hyeunung/FSAP/docs/concept/images/mat_coil_notches.png

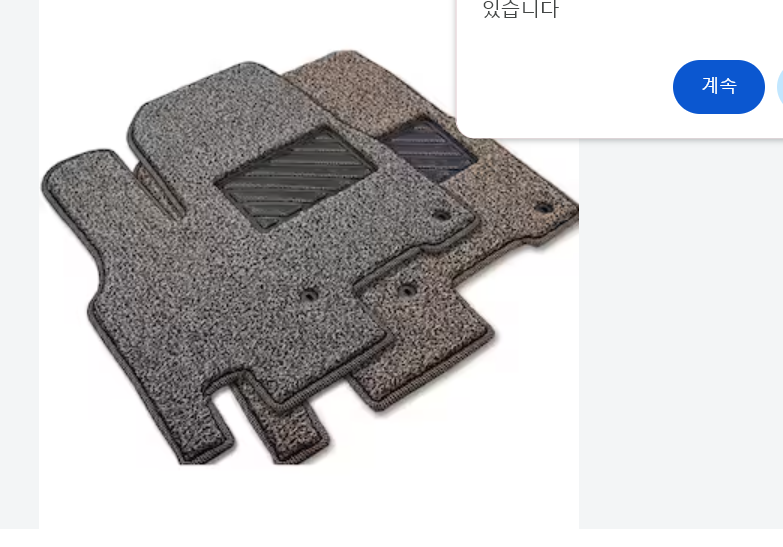
docs/concept/images/mat_coil_notches.png
