hyeunung/FSAP/docs/concept/images/mat_coil_red_pedal_slot.png

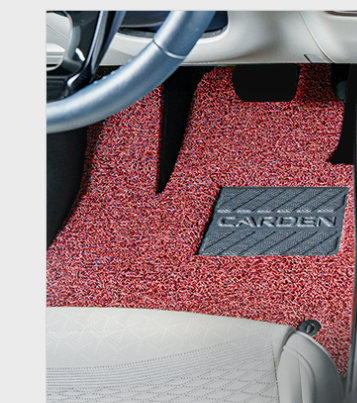
docs/concept/images/mat_coil_red_pedal_slot.png
