hyeunung/FSAP/docs/reports/queue_2026-11-06_5.md

# 과제 목록: 구동 라운드 5회차 (엔진 v3.9.3, 2026-11-06)

과제 정리부(PM). CAD는 열지 않았다(읽기만, 저장 없음). 모델·문서는 고치지 않았다.

## 읽은 것

- 요구서 5절 과제 표: 구동 M00~M08·M04R·M08R 모두 해결. 구동 후보 DC2-01~DC2-08·LITE·STEPSWAP 해결. **미해결: REG-01(구동 후보, 전체 회귀 못 본 범위), REG-02(동작 문제, 사용자 결정 대기).**
- 모델: `tools/config.json` doc = `3D_Modeling/FSAP_v2.6.5.sc`. STEP대기_ 목록은 이 문서에서 뽑은 BOM `docs/bom/FSAP_v2.6.5_purchased.csv`의 STEP대기_ 행으로 봤다(파일 열기 594 s라 이 단계에서 CAD로 다시 열지 않음. 4라운드 동안 형상 변경 0이라 BOM과 모델이 같다).
- `tools/out/step_wait.json`: waiting 6건(F39-LSGF, IR1000-01BG, MHMF022L1U2M, VRXF-PB-60-10, KC-40340, 2400.05.12PZ), login '확인 못 함'.
- runstats: 실행 14개, 가장 긴 열기 594 s(회귀). 240 s를 넘지만 지난 라운드 결과(1회차)에 LITE가 있어(v2.6.5 해결) 다시 넣지 않는다(WF-196).
- 최근 최종 보고 `docs/reports/mechanism/final_mech_2026-11-06_REG-01_3.md`, 회귀 `mech_regression_11.md`: 기준선 밖 겹침 0, 문제 0, 못 본 범위 4건.

## 과제 표

| id | 과제 | 출처 | 등급 | 직렬 | brief | 합격 기준 |
|---|---|---|---|---|---|---|
| REG-01 | 전체 회귀 못 본 범위 (U7@26 KDM10S-06_M08 F_STATES) | 구동 후보 | S | 아니오(과제 1개라 어차피 직렬) | 개념 유닛 U7 테이프(다관 커넥터 KDM10S-06_M08, U7@26) ↔ U5 대차(M03 풀리 HTPA60S5M150-A-N30). 형상 변경 없는 회귀 과제. 4라운드 동안 못 본 범위가 줄었다(2회차 F_STATES 4~34 전부 → 4회차 U7@26만). 남은 것: ① 1/128 조각 86·87·88·90 상태 0 — 한 점 > 470 s 패닉이 2라운드 이어짐(3회차 1/8 조각, 4회차 1/128로 쪼개도 같음). 네 조각에 공통인 것은 HTPA60 풀리 바디(FLANGE1·FLANGE2·HUB·SET2, mech_regression_11.md 38~42행). 같은 방법으로 다시 쪼개지 않는다(WF-123): 풀리 바디 4개를 KDM10S-06_M08과 **한 바디씩 단독**으로 근처로 좁힌 `inspect.clearance`(앱 짧은 확인 범위)로 먼저 재고, 나머지 조각은 풀리를 뺀 묶음으로 본다. ② 1/32 조각 6 상태 2~34, 조각 8 상태 1~34 ③ 가벼운 조각 상태 26~34 — 둘 다 전체 상한 때문(줄 맨 뒤). 이번 회귀는 이 범위를 줄 맨 앞에 둔다. POSE 8·9는 REG-02 사용자 결정 대기로 판정에서 뺀다 | 못 본 범위(①②③) 과제 범위 간섭 0, 못 본 범위 0(POSE 8·9 제외), 형상·부품 수 변경 0 |

STEPWAIT는 넣지 않는다: 형번이 정해진 STEP대기_(867-392342, MHMF022L1U2M, VRXF-PB-60-10, IR1000-01BG, F39-LSGF, KC-40340, 2400.05.12PZ)는 모두 step_wait.json waiting에 있고 이유가 로그인·사이트에 없음·기종 미정이다 → user_wait. 형번 미정 STEP대기_(BALL_D25, LEVELER_M8, INSERT_M3, SETSCREW·NUT·WASHER DC204, S-M5-2)는 형번 결정이 먼저라 step_wait에 세지 않는다(디테일·자료대기 D-96·D-118·D-119·D-122·D-125·D-127·D-128).

## open 표

| 항목 | 수 | 내용 |
|---|---|---|
| 열린 구동 과제 | 0 | M00~M08·M04R·M08R 해결 |
| 구동 후보 | 1 | REG-01 |
| 동작 문제 | 0 | REG-02는 사용자 결정 대기라 user_wait로 뺌 |
| 디테일 | 0 | 구동 라운드 중 0으로 둔다 |
| STEP 대기(형번 정해짐) | 0 | 남은 것은 모두 로그인·사이트에 없음 → user_wait |

## user_wait 표

| 항목 | 사용자가 줄 것 | 구동 막음 |
|---|---|---|
| D-10 재봉 헤드 기종(867-392342 STEP대기_ UPPER·NOSE·LOWER, 아랫축 서보 MHMF042L1U2M) | 견적 비교 뒤 기종 결정 + 그 기종 공식 치수·STEP | 아니오(867 PDF 임시 형상) |
| D-38 납품처 안전 기준 | 납품처 안전 기준 | 아니오 |
| REG-02 POSE 8 U7 안내 ↔ U6 캐리지 291.7 mm³ | 정의 밖 자세로 뺄지 / 높이 한 조정·틈 10 넘게 할지 결정 | 아니오(회귀 판정에서 뺌) |
| MHMF022L1U2M(×3)·MHMF042L1U2M 서보 STEP | 미스미 MSMF로 바꿀지 결정, 또는 파나소닉 CADENAS 가입(규칙 11 금지) | 아니오(임시 형상) |
| VRXF-PB-60-10 감속기 STEP | 니덱 CAD 받기(미스미에 없음) 또는 대체 형번 결정 | 아니오 |
| IR1000-01BG 레귤레이터 STEP | SMC CAD에서 받기(미스미 CAD 없음) | 아니오 |
| F39-LSGF 라이트 커튼 금구 STEP | 옴론 CAD 확인·형번 확정(미스미 미게재) | 아니오 |
| KC-40340 인장 래치 | 제조사 확인(D-121) | 아니오 |
| 2400.05.12PZ igus 끝 브래킷 | igus 형번 확정(D-115) | 아니오 |

## 로그인

구매품 CAD 사이트(미스미) 로그인: **확인 못 함**(지난 라운드 4회차 결과 login '확인 못 함', step_wait.json도 같음).
