hyeunung/FSAP/docs/reports/queue_2026-11-04_6.md

# 과제 정리: 구동 라운드 6회차 (2026-11-06)

요약
- 최신 저장본 `3D_Modeling/FSAP_v2.6.4.sc`(tools/config.json doc). CAD는 열지 않았다. 'STEP대기_' 목록은 BOM `docs/bom/FSAP_v2.6.4_purchased.csv`, `tools/out/step_wait.json`, `mech_step_wait.md`에서 읽었다.
- 요구서 5절의 구동 과제(M00~M08·M04R·M08R)는 모두 해결이다. 구동 후보 중 남은 것은 **REG-01(전체 회귀 못 본 범위)** 하나다.
- 미스미 로그인: **됨**. 사용자가 2026-11-06에 "미스미도 로그인했어 미스미 처리할거 있으면 해 또 로그인 풀리기전에"라고 했다. 그래서 로그인이 풀리기 전에 받을 미스미 표준품을 **STEPWAIT** 과제 하나로 묶어 맨 앞에 둔다.
  - 형번만 정하면 되는 것: D-96·D-118 볼, D-119·D-128 레벨러, D-127 멈춤나사·너트·와셔, D-125 M3 인서트.
  - 제조사 CAD로 다시 시도할 것: IR1000-01BG(SMC CAD), VRXF-PB-60-10(니덱).
- 순서: STEPWAIT(실물 교체) → REG-01(교체한 파일로 회귀). REG-01은 발자국이 기계 전체라 직렬이다.

## 과제 표

| id | 과제 | 출처 | 등급 | 내용·근거 | 합격 기준 |
|---|---|---|---|---|---|
| STEPWAIT | 미스미 표준품 형번 정하기·STEP 받기·실물 교체 | STEP 대기(사용자 2026-11-06 요청) | M | 미스미가 로그인돼 있는 동안 받는다. ① D-96·D-118 볼 827개(`STEP대기_BALL_D25_M04`): 1안 미스미 볼롤러 압입형, 정격 ≥ 203 N, Ø25.4, 꼭대기 Z 0. ② 레벨러: D-119 `STEP대기_LEVELER_M8_M04` ×36, D-128 `STEP대기_LEVELER_M8_M07` ×15(M8 Ø40, 같은 형번이면 함께). ③ D-127 `STEP대기_SETSCREW_M4x25_DC204_1·2`·`NUT_M4_DC204_1·2`·`WASHER_M5_DC204_1·2`. ④ D-125 `STEP대기_INSERT_M3_M06_1·_2`. ⑤ IR1000-01BG ×3(D-132, SMC CAD), VRXF-PB-60-10 ×3(D-113, 니덱 CAD). ①~④는 미스미 표기를 찾아 자료대기·결정로그에 적는다(실행 규칙 11). ⑤는 회원가입·로그인이 필요하면 멈추고 자료대기에 남긴다. 받기 전에 PartsLibrary를 먼저 본다. | 받은 형번의 STEP대기_ 0, 교체 뒤 과제 범위 새 겹침 0, 볼 꼭대기 Z 0 ± 0.1 유지, 볼 정격 ≥ 203 N |
| REG-01 | 전체 회귀 못 본 범위 이어 보기 | 구동 후보 | S | v2.6.3~v2.6.4 누계 겹침 0(mech_REG-01_model.md 4절, mech_regression_6.md 4절). 남은 범위: CYCLE_S 363~450(88), CYCLE_G1 0~514, CYCLE_G2 0~630, POSE 8~182, F_STATES 0~34. 자세는 세션을 따로 둔다(WF-183). STEPWAIT에서 바뀐 바디 둘레도 본다. | 못 본 범위 기준선 밖 겹침 0, truncated 0, 행정 막힘 0 |

## open 표

| 항목 | 수 | 내용 |
|---|---|---|
| 열린 구동 과제 | 0 | 5절 구동 행 모두 해결 |
| 구동 후보 | 1 | REG-01 |
| 회귀 동작 문제 | 0 | 본 범위 겹침 0. 못 본 범위는 REG-01이 본다 |
| 디테일 | 0 | 구동 라운드 중에는 세지 않는다 |
| 형번이 정해졌는데 STEP대기_ | 2 | IR1000-01BG ×3(미스미 CAD 없음, SMC CAD를 아직 안 봄), VRXF-PB-60-10 ×3(니덱 CAD를 아직 안 봄). STEPWAIT ⑤에서 다시 시도한다 |

- 형번이 아직 안 정해진 STEP대기_는 step_wait에 세지 않았다(STEPWAIT ①~④에서 정한다). 볼 D-96, 레벨러, DC2-04 체결품, M3 인서트, 2400.05.12PZ(임시), KC-40340, S-M5-2, F39-LSGF(기억값)가 여기에 든다.

## user_wait 표

| 항목 | 사용자가 줄 것 | 구동을 막나 |
|---|---|---|
| 재봉 헤드 기종 D-10·D-109 (`STEP대기_867-392342_UPPER·_NOSE·_LOWER`) | 견적 비교 뒤 기종 결정 + 그 기종 공식 치수·STEP | 아니오(867 임시 형상으로 진행) |
| 서보 MHMF022L1U2M ×3 (D-112·D-115) | 파나소닉 CADENAS 개인정보 입력·STEP 받기(사용자가 직접) | 아니오(□60×L80 임시) |
| 납품처 안전 기준 D-38 | 안전 거리·정지 시간 기준 | 아니오(ISO 13855 참고 임시) |
| 특허 KR102139457B1 D-102 | 변리사 확인 여부 결정 | 아니오 |

## 워크플로우 메모
- 계산된 지시는 STEPWAIT를 "형번이 정해졌고 step_wait.json waiting에 없는 STEP대기_"가 있을 때만 넣으라고 한다. 그런데 남은 STEP대기_는 모두 waiting에 있거나 형번 미정이다. 사용자 요청("미스미 처리할거 있으면 해")에 따라 형번을 정해 받는 일도 STEPWAIT에 넣었다. waiting의 not_found(미스미에 CAD 없음)가 제조사 CAD를 시도했는지와 구분되지 않아, 다시 시도할 기회가 사라진다.
