hyeunung/FSAP/docs/reports/queue_2026-11-04_2.md

# 과제 정리 — 구동 라운드 2회차 (2026-11-05)

기준 문서 `3D_Modeling/FSAP_v2.5.5.sc`(tools/config.json doc). STEP대기_ 목록은 CLI `assembly.bom`(읽기만, `tools/out/queue2/bom_out.json`)으로 뽑았다.
미스미 로그인: **됨**(사용자 2026-11-05 "미스미도 로그인했어" — 브라우저로는 아직 확인 안 함, 라운드 시작 구매부가 머리 확인). 지난 라운드 최종 확인은 풀림(2026-11-05 07:00).

## 과제 표

| id | 과제 | 출처 | 등급 | 유닛 | 합격 기준 | 직렬 |
|---|---|---|---|---|---|---|
| STEPWAIT | STEP대기_ 실물 교체 + 남은 형번 받기 | STEP 대기 | M | U1~U8 여기저기 | 받은 STEP 13형번 STEP대기_ 0, 못 받은 것 자료대기 이유, 과제 범위 간섭 0 | 라운드 시작 단계 |
| DC2-07 | U8 밸브 묶음 실물 포트 방향 (SS5Y3-20-06 + SY3120-5LZD-M5 ×6) | 구동 후보 | M | U8 | 실물 STEP 넣고 피팅·관·볼트 과제 범위 간섭 0, 피팅 서로 겹침 0, 관 11줄 + TU0805 3줄 끝이 실물 포트에 | 아니오 |
| REG-01 | 전체 회귀 못 본 범위 | 구동 후보 | S | 전체(검사만) | 못 본 범위(STATES 24-34, 연속 연구, POSE 0-182, 체결·관·둘레 바디) 간섭 0, 상한 30분 묶음 나눔 | 예 |

STEPWAIT 대상(STEP 이미 있음 — `purchased-step/`·PartsLibrary): 6200ZZ, CB3-10, CB4-12, CB4-20(M08 밸브 묶음 볼트 — DC2-07에서 같이), CB6-20, HFS8-80160-1090, HTPA60S5M150-A-N16, KDM10-06, KQ2L08-01AS, LR6-302WJBW-RYG, MGPM25-40Z, MSTH6-20, FHS-M5-10 → SFB5-10(D-117). SS5Y3-20-06·SY3120-5LZD-M5는 DC2-07이 바꾼다.
STEPWAIT 받기 시도(미스미 로그인 됨, 제조사 CAD 허용): IR1000-01BG(SMC), F3SG-4RA1520-14(옴론), HTBNS5M150-3960, KC-40340, S-M5-2, VRXF-PB-60-10(감속기 제조사), 2400.05.12PZ(igus), 형재 마감캡·HFS8-80160-1482·HFC8-80160-B.

## open 표

| 항목 | 수 | 내용 |
|---|---|---|
| 구동 과제 | 0 | M00~M08·M04R 모두 해결 |
| 구동 후보 | 2 | DC2-07, REG-01 |
| 회귀 동작 문제 | 0 | 지난 전체 회귀 문제 0(본 범위 일부 — REG-01) |
| 디테일 | 0 | 구동 라운드 중이라 0으로 둠(실제 남은 디테일 18건은 디테일링 몫) |
| STEP대기(형번 정해짐) | 22 | 위 STEP 있음 15(SS5Y3·SY3120 포함) + 받기 시도 7 |

형번 미정이라 세지 않음: BALL_D25(D-96·D-118, 827개), LEVELER, INSERT, NUT, SETSCREW, WASHER, F3SG-BRKT.

## user_wait 표

| 항목 | 필요한 것 | 구동 막나 |
|---|---|---|
| 재봉 헤드 867-392342 임시 형상(D-10·D-109) | 기종 확정·실물 도면/STEP | 아니오(임시 형상으로 진행) |
| 서보 MHMF022L1U2M STEP | 파나소닉 CADENAS 개인정보 입력은 사용자가(또는 STEP 파일 전달) | 아니오 |
| 납품처 안전 기준 D-38 (라이트 커튼 안전 거리 D-130) | 납품처 기준 | 아니오 |
| 특허 KR102139457B1 변리사 확인 D-102 | 사용자 결정 | 아니오 |
