hyeunung/FSAP/docs/reports/mechanism/mech_RX-11_fea.md

# 구동 RX-11 해석 — U5 먼 쪽 바퀴 밑 받침 X축 자유 롤러 2줄 (C-45)

## 요약

- 판정: **불합격(동작 문제 1)**. 대상 `3D_Modeling/FSAP_v2.17.0.sc`의 임시 STEP 5개(`tools/out/mech_RX-11/stepout/`). CAD 안 씀. **FEA 못 함 — 환경 없음(자료대기 D-16)**, 전부 손계산(`fea/cases/mech_RX-11_handcalc.py` → `fea/results/mech_RX-11_handcalc.json`).
- **동작 1: 새들 `P_RX11_SADDLE` ×8이 지정 조임 3 N·m(예압 3,000 N)에서 항복한다.** 볼트가 가운데를 누르고 귀 두 곳이 받치는 3점 굽힘에서 축 홈 포켓 자리(바닥 살 + 가운데 벽 2 mm) 위쪽 압축 231 ~ 250 MPa > A5052 195 → **SF 0.78 ~ 0.84**(H34 215로도 0.86 ~ 0.93). 소성 붕괴 SF는 1.67이라 부러지지는 않지만 벽 위끝이 눌려 영구 변형한다. 설계 손계산은 귀 뿌리 단면(14 × 6, 40 MPa)만 봤다.
- 고치는 법(형상 그대로): `CB5-20_RX11` ×8 조임 토크 **0.6 N·m 지정 + 중강도 나사 고정제**(DC2-05 누름판과 같은 처리). 새들 SF 3.91 ~ 4.22(+30 % 흩어짐 0.78 N·m에서 3.01), 클램프 SF 7.7, 축 자리 내려앉음 0.059 → 0.012 mm.
- 완료 판정 ④: 롤러 처짐 **0.0051 mm**(46.54 N) · **0.0143 mm**(130 N) ≤ 0.1. 696ZZ 정적 SF **14.4 · 5.15** ≥ 3 · 2(C0r 670 N 임시 — 절반이어도 7.2 · 2.58). 만족.
- 완료 판정 ⑤: `machine.json _timing` U4+U5 키를 띠 항 없이 다시 셈 — L 4.5 s **1.228**, G2 3.0 s 1.262, G1 바닥 0.8 s 1.281, V 입구1 3.0 s **1.146**(최저), 꼭짓점 1.5 s 1.175 · 1.0 s 1.237, 입구2 1.9 s 1.148. 설계 표와 9구간 모두 같음. SF ≥ 1 만족.
- 받침 합 처짐(롤러 + 축 + 판 살) 46.54 N **0.013 ~ 0.065 mm** ≤ 0.1. 130 N은 0.037 ~ 0.181(뿌리가 돌 때 상한, 디테일 기록).
- 가로대 통과 홈: STEP 윤곽 적분으로 홈 자리 남은 단면 I 419,481 mm⁴(온 단면 723,619의 58 %), 6.46 MPa **SF 22.4**. 판 W2 긴 홈 살 SF 21.3(운전) · 7.6(오설정), E2 끝 새들 SF 8.8 · 3.15 · 손 100 N 2.34.
- 모델 바꿈 2건(E-18): 판 W2 레일 사이 = 경간 160 판 → 외팔 57 두 장, 가로대 = I 하한 1.5e5 통짜 → STEP 단면. 옛 모델 값도 4·5절에 남김.
- completion_met **false**: ④·⑤는 만족이나 ②(롤러 윗면 Z 0 ± 0.1)가 새들 항복·내려앉음(3 N·m에서 탄성만 0.059 mm)에 걸려 있다. 토크 0.6 N·m로 고치면 0.012 mm.

## 근거 규칙 (원문)

- 지시문: "부러짐·영구 변형(SF < 1.2)·동작을 망가뜨리는 처짐만 kind='동작'이고, 기준 근처 미달(SF·처짐·정밀 체인)은 kind='디테일'이다." → 새들 SF 0.78은 영구 변형이라 '동작'.
- E-18: "완료 판정에 강도 항목이 있거나 하중 경로의 단면이 바뀌면 등급 S도 FEA를 돌린다 … 손계산은 형상 가정을 그대로 믿어 응력이 몰리는 실제 이음·좁은 단면을 못 본다. 손계산의 단면은 가정하지 말고 측정 자료의 최소 단면으로 쓴다." → FEA 환경이 없어 손계산이지만 단면은 STEP 글자 파싱 값(스크립트 `assert`)으로 썼다.
- E-18: "해석 모델은 부품별 표(`<fea>/models.json`)에 고정한다 … 바꾸면 이유를 적고 옛 모델도 같은 형상으로 풀어 차이를 남긴다."
- M-09: "필요 SF — 일반 3, 오조작 하중 2", "SF가 필요치의 3배 이상 남으면 과사양 결함으로 보고". 요구서 6-1 "기본값 — M-09", 6-2 "미정 — … 납품처 기준(D-08)".
- M-06: "카탈로그 허용치를 확인하고 보고서에 수치로 적는다."
- E-02(지시문): "강도 여유·정밀 체인·새 볼트 렌치 접근·판금 규칙은 디테일로 기록만 하고 수정 회차를 쓰지 않는다."
- 실행 환경(지시문): "강도는 손계산으로 하고 해석은 '해석 못 함 — 환경 없음(자료대기 D-16)'으로 기록한다."

## 1. 대상·하중·기준

| 항목 | 값 | 출처 |
|---|---|---|
| 바퀴 누름(운전) | 46.54 N | 과제 완료 판정 ④ |
| 오설정 바닥 | 130 N | 완료 판정 ④, 결정로그 RX-07-D1 |
| 손(오조작) | 100 N | `fea/models.json` P_M04_PANEL_W2(M04R) |
| 볼트 예압 | T / (0.2 · d): 3 N·m → 3,000 N | 설계·모델 보고 '죔 3 N·m' |
| 자중 | × 3 g | 지시문 |
| 재질 항복 | A5052 195, SUS304 205, A6063-T5 145 MPa | `handcalc.py` BASE, 앞 과제와 같음 |
| 기준 | 운전 SF 3, 오조작 SF 2, 영구 변형 선 1.2, 롤러 처짐 ≤ 0.1 mm | M-09, 완료 판정 ④ |

STEP에서 읽은 단면(스크립트가 `assert`로 대조):

| 부품 | 읽은 값 |
|---|---|
| `P_RX11_SADDLE` | X 두께 14(−1845 ~ −1831), 포켓 깊이 6 × 2 · 가운데 벽 2(−1839 ~ −1837), 축 홈 Y 7.9 ~ 14.1 · R 3.1 중심 Z −9.9(바닥 Z −13.0), 몸통 \|Y\| ≤ 22.5 Z −16 ~ −2, 귀 \|Y\| ≤ 26.5 Z −8 ~ −2, 구멍 Ø5.5 + 카운터보어 Ø9.5(바닥 Z −8) |
| `P_RX11_CLAMP` | 14 × 60 × 19, 가운데 윗면 Z −16.5(높이 14.5), 기둥 \|Y\| 23.5 ~ 30, 탭 밑구멍 Ø4.2 |
| `P_M04_PANEL_W2` | t 4(Z −12 ~ −8), 홈 \|Y\| ≤ 23 · X −1847 ~ −410, 볼 구멍 Ø36 Y ±50 X 피치 100, 접시 M5 Y ±100 X 피치 300 |
| `P_M04_PANEL_E2` | 홈 X −410 ~ −317, 볼 구멍 (−350, ±50), 접시 M5 X −400 Y ±50·±150·±250 |
| `HFS8-4080-560_M04_NOTCH` | 40(X) × 80(Z −92 ~ −12) × 560, 통과 홈 \|Y\| ≤ 24 · Z −23 위 |

## 2. 롤러·베어링·축 (완료 판정 ④, 구매품 몫 M-06)

| 항목 | 식·단면 | 46.54 N | 130 N | 기준 | 판정 |
|---|---|---|---|---|---|
| 롤러 처짐 | 스틸 파이프 Ø20 / Ø12(I 6,836 mm⁴), 베어링 중심 사이 195, 롤러 하나가 다 받고 가운데 | **0.0051 mm** | **0.0143 mm** | ≤ 0.1 | 합격 |
| 롤러 굽힘 | M = F · 195 / 4 | 3.3 MPa | 9.3 MPa | — | — |
| 696ZZ 정적 SF | C0r 670 N(임시), 베어링 하나가 다 받음 | **14.4** | **5.15** | 3 · 2 | 합격 |
| 같음, C0r이 절반(335 N)이라도 | | 7.2 | 2.58 | 3 · 2 | 합격 |
| 축 Ø6 굽힘 | 팔 6.25(베어링 중심 2.5 + 틈 1.0 + 물림 5.5 / 2) | 13.7 MPa | 38.3 MPa | — | — |
| 축 ↔ 홈 Hertz | R 3 ↔ R 3.1(오목), 길이 5.5 | 41.1 MPa | 68.7 MPa | 1.67 × 195 | SF 7.9 · 4.7 |
| 수명 L10 | Cr 1,730 N(임시) | 51,364 × 10⁶ 회전 | — | — | — |

- 696ZZ 정격은 NSK 치수표 기억 값(D-200 임시)이다. 정격이 절반이어도 기준을 넘는다. 카탈로그 확인은 구매부 몫으로 남는다.
- 과사양(M-09): 베어링 SF 14.4 ≥ 9. `RORLM20`의 가장 작은 축 구멍(d 6)이라 줄일 형번이 없다 — 문제로 세지 않음.

## 3. 새들·클램프 — 볼트 예압이 만드는 3점 굽힘 (동작 문제)

힘의 길: `CB5-20` 머리가 새들 카운터보어 바닥(Y 0)을 아래로 누르고, 새들 귀(\|Y\| 23 ~ 26.5)가 판 윗면에서 받친다. 클램프는 가운데 탭이 위로 당겨지고 기둥(\|Y\| 23.5 ~ 30)이 판 밑면을 받친다. 새들은 위가 압축인 3점 굽힘이다.

새들 단면(STEP):

| 자리 | 단면 | I mm⁴ | 위끝 거리 | 소성 계수 mm³ |
|---|---|---|---|---|
| Y 0 | (14 − 5.5) × 8 + (14 − 9.5) × 6 | 1,390.7 | 8.01 | 303.6 |
| Y 7.9 포켓 안쪽 끝 | 14 × 6.1 + 벽 2 × 7.9 | 999.2 | 9.86 | 235.6 |
| Y 11 포켓 가장 깊은 곳 | 14 × 3.0 + 벽 2 × 11.0 | 960.8 | 10.09 | 176.9 |
| Y 14.1 ~ 22.5 | 14 × 14 | 3,201.3 | 7.0 | 686.0 |
| 귀 뿌리 | 14 × 6 | 252.0 | 3.0 | — |

조임 3 N·m(예압 3,000 N), 반력 자리 Y 24.75(귀 받침 가운데) / 23.5(판 홈 가장자리 쪽):

| 자리 | 위 압축 MPa | 밑 인장 MPa | SF(195) | 소성 붕괴 SF |
|---|---|---|---|---|
| Y 0 | 194.6 / 183.8 | 145.5 / 137.4 | 1.00 / 1.06 | 1.86(유리 쪽) |
| **Y 7.9 포켓 안쪽 끝** | **249.5 / 231.0** | 104.7 / 96.9 | **0.78 / 0.84** | 1.82 / 1.96 |
| Y 11 | 216.7 / 197.0 | 83.9 / 76.2 | 0.90 / 0.99 | 1.67 / 1.84 |
| Y 14.1 | 157.7 / 139.2 | 66.1 / 58.4 | 1.24 / 1.40 | — |
| 귀 뿌리 | 40.2 / 17.9 | 같음 | 4.85 / 10.9 | — |

조임 토크별(반력 Y 24.75 / 23.5):

| 토크 N·m | 예압 N | 새들 최저 SF | 클램프 SF | 축 자리(Y 11) 내려앉음 mm | 머리 좌면 MPa | X 미끄럼 SF 운전 23.6 N / 손 100 N(귀만 ~ 귀 + 기둥) | 판정 |
|---|---|---|---|---|---|---|---|
| **3.0(지정)** | 3,000 | **0.78 / 0.84** | 1.53 / 1.74 | 0.059 | 90.9 | 19.0 ~ 38.1 / 4.5 ~ 9.0 | **동작(항복)** |
| 1.0 | 1,000 | 2.34 / 2.53 | 4.60 / 5.23 | 0.020 | 30.3 | 6.4 ~ 12.7 / 1.5 ~ 3.0 | 디테일(< 3) |
| 0.78(0.6 + 30 %) | 780 | 3.01 / 3.25 | 5.89 / 6.71 | 0.015 | 23.6 | 5.0 ~ 9.9 / 1.17 ~ 2.34 | 합격 |
| **0.6(권고)** | 600 | **3.91 / 4.22** | 7.66 / 8.72 | 0.012 | 18.2 | 3.8 ~ 7.6 / 0.9 ~ 1.8 | 합격 |
| 0.42(0.6 − 30 %) | 420 | 5.58 | 10.95 / 12.46 | 0.008 | 12.7 | 2.7 ~ 5.3 / 0.63 ~ 1.26 | 합격 |

- 볼트(`handcalc.calc`, M5 12.9, 물림 11.5 = 2.3d, A5052 탭): 3 N·m에서 볼트 4.69 · 좌면 2.31 · 암나사 2.64(모두 ≥ 1). 0.6 N·m에서 23.4 · 11.6 · 13.2. 외력 인장은 없다(바퀴 누름은 귀 → 판으로 간다).
- 클램프 가운데 단면 (14 − 5) × 14.5: 3 N·m에서 111.8 ~ 127.2 MPa, SF 1.53 ~ 1.74(설계 값 127.2 MPa와 같음. 설계는 항복 215로 1.69).
- 바퀴 누름만으로 새들이 받는 값은 130 N에서 10.8 MPa, 축 자리 내려앉음 0.0026 mm다. 새들을 정하는 것은 예압이다.
- 축 자리 내려앉음은 귀 받침 대비 Y 11 자리의 굽힘 + 전단 처짐(단면을 Y로 적분)이다. 롤러 윗면이 그만큼 낮아진다(완료 판정 ②의 ± 0.1 가운데 3 N·m 0.059, 0.6 N·m 0.012).
- 필요한 죔: 새들을 X로 미는 힘은 매트가 X로 미끄러질 때 롤러 2개 몫 상한 23.6 N(μ 0.5)뿐이다. 0.6 N·m에서 버팀 90 N(귀만, μ 0.15) ~ 180 N. 손으로 롤러를 축 방향 100 N으로 밀면 귀만 셀 때 SF 0.9지만 새들은 롤러 끝 틈 1.0 · 홈 끝 틈 2.0에서 멈춘다(모델 보고 RX-11-D5).

## 4. 판 W2 긴 홈 살 · E2 끝 새들 (모델 바꿈)

모델 바꿈 이유: v2.4.0 표는 '레일 ±100 사이 맑은 경간 160 긴 판'이었다. 긴 홈(\|Y\| ≤ 23)이 그 사이를 끊어 레일 안쪽 면(Y 80)에서 나온 **외팔 57 두 장**이 됐다. 새들 귀가 그 끝(Y 24.75)에 얹힌다.

| 항목 | 식 | 46.54 N(바퀴가 새들 바로 위) | 130 N | 기준 |
|---|---|---|---|---|
| 한쪽 살 몫 | F / 2 | 23.27 N | 65 N | — |
| 살 끝 처짐, 뿌리 고정 | 무한 폭 외팔판 끝 점하중 0.168 P a² / D ÷ 살 비 0.64 / 폭 50 외팔보 | 0.017 / 0.025 mm | 0.046 / 0.071 mm | — |
| 뿌리 회전 몫 | 접시 볼트 줄(Y 100)이 잡음 / 안 잡고 먼 레일(Y 300)까지 돎 | 0.009 / 0.037 mm | 0.026 / 0.102 mm | — |
| 살 끝 처짐 범위 | | 0.017 ~ 0.062 mm | 0.046 ~ 0.173 mm | — |
| 볼 구멍 줄에 선 새들(X −1838 · −758 · −542) 덧처짐 | 살 9 × t4가 구멍 36을 건넘, 고정 ~ 단순 | 0.0006 ~ 0.0024 mm | 0.0017 ~ 0.0068 mm | — |
| 뿌리 응력 | 0.509 P ÷ 0.64 / 폭 50 보 | 6.9 / 9.6 MPa, **SF 21.3** | 19.4 / 26.9 MPa, **SF 7.6** | 3 · 2 |
| 살 9 굽힘 | P · 36 / 4 | 8.7 MPa, SF 23.5 | 24.4 MPa, SF 8.4 | 3 · 2 |

손 100 N이 홈 옆 볼(Y 50) 하나에 몰릴 때:

| 모델 | σ MPa | SF | 처짐 mm |
|---|---|---|---|
| 새(외팔판, 뿌리 모멘트 계수 0.509 — 끝 하중 값이라 불리) | 19.3 | **10.6** | 0.014(뿌리에서 30) ~ 0.049 |
| 옛(경간 160 긴 판, `mech_M04R_handcalc.json`) | 13.95 | 14.69 | 0.077 |

차이: 응력 +39 %. 옛 모델은 홈으로 끊긴 형상에 맞지 않아 새 모델로 바꾼다. SF는 기준 2의 5배다.

E2 끝 새들(X −326): 귀에서 가장 가까운 받침은 가로대 CM1 +X 면(X −380)이고, 그 길에 볼 구멍(−350, ±50)이 있다. 구멍 밖 판은 세지 않고 살 9 × t4 · 길이 42 외팔로 본 상한이다. 바퀴는 X −407.5까지만 오므로(J 1380) 이 새들 몫은 57 %다.

| 하중 | 귀 하나 N | 처짐 상한 mm | σ 상한 MPa | SF | 기준 |
|---|---|---|---|---|---|
| 운전 46.54 N × 0.57 | 13.3 | 0.036 | 23.3 | 8.8 | 3 |
| 오설정 130 N × 0.57 | 37.2 | 0.099 | 65.0 | 3.15 | 2 |
| 손 100 N 새들 바로 위 | 50 | 0.133 | 87.5 | 2.34 | 2 |

받침 합 처짐(완료 판정 ④ 참고 값):

| 하중 | 롤러 가운데 | 판 살(새들 위) | 받침 합(바퀴가 롤러 가운데 ~ 새들 위) | 기준 |
|---|---|---|---|---|
| 46.54 N | 0.0051 | 0.017 ~ 0.062 | **0.013 ~ 0.065 mm** | ≤ 0.1 |
| 130 N | 0.0143 | 0.046 ~ 0.173 | 0.037 ~ 0.181 mm | 기록 |

- 130 N 상한 0.181은 판 뿌리가 레일 위에서 자유롭게 돈다고 본 값이다. 매트 없이 내린 바퀴는 롤러에서 0.859 떠 있어(검도 실측) 이 하중이 롤러에 실리지 않는다. 디테일로 기록한다(검도 RX-11-V3와 같은 항목).

## 5. 가로대 CM1 통과 홈 `HFS8-4080-560_M04_NOTCH` (모델 바꿈)

모델 바꿈 이유: 옛 표는 단면 표를 못 봐 'I 하한 1.5e5 mm⁴ 통짜'였다. 통과 홈(\|Y\| ≤ 24, Z −23 위)이 경간 가운데 윗 플랜지를 자르므로 실제 단면이 필요하다. STEP 끝면(Y −280)과 홈 벽면(Y 24) 윤곽을 적분했다(호는 유리 B-스플라인을 풀어 꺾은선으로).

| 단면 | A mm² | 도심 Z | I mm⁴ | 확인 |
|---|---|---|---|---|
| 온 단면 | 1,115.5 | −52.00 | 723,619 | A × 560 = 624,663 ↔ 모델 부피 624,561(0.02 %) |
| 홈에서 잘린 것(Z −23 위) | 202.0 | — | — | A × 48 = 9,698 ↔ 모델 홈 부피 9,713(0.15 %) |
| 홈 자리 남은 단면(Z −92 ~ −23) | 913.4 | −59.74 | **419,481**(58 %) | Z_위 11,419 · Z_밑 13,001 mm³ |

하중: 옛 모델과 같은 보수 하중(E2 전부 + W2 1/4 질량 × 3 g 등분포 747.6 N) + 가운데 점하중 153.1 N(오설정 130 N + RX-11 부품 × 3 g). 경간 560 단순보, 가운데 M 73.77 N·m.

| 모델 | I mm⁴ | σ MPa | SF(145) | 기준 |
|---|---|---|---|---|
| 새: STEP 홈 자리 남은 단면 | 419,481 | 6.46 | **22.4** | 2 |
| 온 단면(STEP, 홈 없음) | 723,619 | 4.08 | 35.6 | 2 |
| 옛: I 하한 1.5e5 · c 40 통짜 | 150,000 | 19.67 | 7.37 | 2 |

- 운전(자중 × 3 g + 46.54 N): 5.44 MPa, SF 26.7. 처짐 상한 0.078 mm(남은 단면이 온 길이라고 볼 때).
- 판 E2 접시 볼트(X −400, Y ±50)의 T너트 자리는 홈 밖 26 mm라 T홈이 남는다.
- 과사양(M-09): SF 22는 기준의 3배를 넘지만 볼 테이블 공용 형재(HFS8-4080)라 줄이지 않는다 — 문제로 세지 않음.

## 6. 회전 시간 키·SF (완료 판정 ⑤)

식: have = μ 0.4 × (F4 40 N × d₁ 0.1 + F5 40 N × d₂) / need = 볼 구름 0.02 · Rg + 원판 끌림 0.048 + 노루발 끌림 0.096 + 바퀴 밑 롤러 구름 0.05 × 40 N × d₂ + 바퀴 밖 롤러 0.18 N × Σ\|x\| × 2줄 + (I_매트 + I_원판 0.0217 + 2 × 0.219 kg × d₂²) × 4θ / t². 띠 항 μs 0.30 × 40 N × d₂는 없다. I_매트 · Rg는 앞 과제 값(`rx11design.json`), 키는 `tools/machine.json _timing`에서 읽었다. 롤러 질량 0.322 kg · 둘레 환산 0.219 kg은 다시 셈.

| 구간(U4+U5) | 키 s | SF | 설계 SF | 롤러 구름 0.10이면 | 롤러 14개가 다 매트 밑이면 | 옛 띠 키 · SF |
|---|---|---|---|---|---|---|
| CYCLE_L 모서리 90° | 4.5 | **1.228** | 1.228 | 1.077 | 1.228 | 7.5 · 1.009 |
| CYCLE_G2 모서리 90° | 3.0 | 1.262 | 1.262 | 1.107 | 1.197 | 4.5 · 1.037 |
| CYCLE_G1 출구 9.5° | 1.2 | 1.924 | 1.924 | 1.585 | 1.664 | 1.2 · 1.044 |
| CYCLE_G1 바닥 12° | 0.8 | 1.281 | 1.281 | 1.121 | 1.160 | 1.2 · 1.047 |
| CYCLE_G1 바닥 3° | 0.6 | 1.926 | 1.926 | 1.586 | 1.666 | 0.6 |
| CYCLE_V 입구1 75° | 3.0 | **1.146** | 1.146 | 1.026 | 0.992 | 4.4 · 1.027 |
| CYCLE_V 꼭짓점 25° | 1.5 | 1.175 | 1.175 | 1.050 | 1.014 | 2.0 · 1.009 |
| CYCLE_V 꼭짓점 10° | 1.0 | 1.237 | 1.237 | 1.098 | 1.059 | 1.3 · 1.022 |
| CYCLE_V 입구2 30° | 1.9 | 1.148 | 1.148 | 1.028 | 0.994 | 2.7 · 1.015 |
| CYCLE_W 4구간(임시 키 4.1 · 4.2 · 2.8 · 1.6) | — | 1.465 · 1.458 · 1.468 · 1.451 | — | 1.264 ~ 1.277 | 1.314 ~ 1.328 | RX-12-C4 |

- 9구간 모두 SF ≥ 1, 최저 1.146(V 입구1). 설계·검도 값과 같다.
- 민감도: V 매트가 X 1.5 m 밖 롤러(중심 \|x\| 1.514 · 1.73)까지 덮는다고 보면 V 입구1 · 입구2가 0.992 · 0.994다. 바퀴 밖 롤러 항은 '롤러가 안 돌고 매트가 μ 0.5로 미끄러짐' 상한이라 실제는 이보다 작다. V 매트 닿는 거리 1.50 m는 설계 값 그대로 썼다(7절 시제품에서 롤러 구름 저항과 함께 확인할 것).

## 7. 문제 목록

| 번호 | kind | 무엇 | 어디 | 수치 | 고치는 방법 | 외부 |
|---|---|---|---|---|---|---|
| RX-11-F1 | **동작** | 지정 조임 3 N·m에서 새들이 항복(위쪽 압축) | `P_RX11_SADDLE` ×8, 축 홈 포켓 Y ±7.9 ~ 11(가운데 벽 2 mm 위끝) · Y 0 카운터보어 테 | 231 ~ 250 MPa, SF 0.78 ~ 0.84(Y 0은 1.00 ~ 1.06), 축 자리 내려앉음 0.059 mm + 영구 변형 | 형상 그대로. `CB5-20_RX11` ×8 조임 토크 **0.6 N·m 지정 + 중강도 나사 고정제**를 BOM 비고·설계검토서·조립 순서에 적는다(SF 3.91, +30 % 흩어짐 3.01). 3 N·m를 꼭 써야 하면 새들을 통짜 강(S45C)으로 바꿔도 SF 1.4 ~ 1.5라 기준 3에 못 미친다 | 아니오 |
| RX-11-F2 | 디테일 | 클램프 굽힘 SF가 3 N·m에서 기준 3 미달 | `P_RX11_CLAMP` ×8 가운데 단면 9 × 14.5 | 111.8 ~ 127.2 MPa, SF 1.53 ~ 1.74 | F1의 토크 0.6 N·m로 SF 7.7 ~ 8.7(따로 고칠 것 없음) | 아니오 |
| RX-11-F3 | 디테일 | 0.6 N·m에서 손이 롤러를 축 방향 100 N으로 밀 때 새들 X 미끄럼 버팀이 오조작 2 미달 | 새들 귀 ↔ 판 윗면 | SF 0.9(귀만) ~ 1.8(귀 + 클램프 기둥). 운전 23.6 N에는 3.8 ~ 7.6 | 기록. 밀려도 롤러 끝 틈 1.0 · 홈 끝 틈 2.0에서 멈춘다. 디테일링에서 필요하면 토크 0.78 N·m(새들 SF 3.01, 흩어짐 여유 없음) 또는 새들 위치 핀 | 아니오 |
| RX-11-F4 | 디테일 | 받침 합 처짐 130 N 상한이 0.1을 넘음(판 뿌리 회전을 다 허용한 값) | `P_M04_PANEL_W2` 긴 홈 살(외팔 57) | 46.54 N 0.013 ~ 0.065 mm(합격), 130 N 0.037 ~ 0.181 mm | 기록(검도 RX-11-V3와 같음). 해석 환경이 생기면 판 W2 살 + 새들 + 클램프 접촉 FEA로 좁힌다 | 아니오 |
| RX-11-F5 | 디테일 | 696ZZ 정격(C0r 670 · Cr 1,730 N) · 롤러 외경 공차·흔들림이 임시 값 | `STEP대기_RORLM20-6-L200` ×14 | 정격 절반이어도 SF 7.2 · 2.58 | 구매부가 카탈로그 값으로 D-200에 적는다 | 예 |
| RX-11-F6 | 디테일 | FEA 못 함 — 환경 없음. 새들 포켓 모서리 응력 집중·판 살 2차원 거동은 손계산이 못 본다 | 새들·판 W2·E2 | — | 환경(D-16)이 생기면 임시 STEP 5개로 다시 푼다 | 예 |

과사양 note(문제 아님): 696ZZ SF 14.4(줄일 형번 없음), 가로대 SF 22.4 · 판 SF 21.3(공용 형재·판 t4, 다른 기능이 정함).

## 8. 완료 판정 (해석 몫)

| 항목 | 만족 | 근거 |
|---|---|---|
| ② 롤러 윗면 Z 0 ± 0.1 | 조건부(3 N·m에서는 보장 못 함) | 모델 값은 검도 −0.0002. 조임 3 N·m에서 새들 축 자리가 탄성만 0.059 mm 내려앉고 항복분이 더해진다. 0.6 N·m에서는 0.012 mm |
| ④ 롤러 처짐·베어링 | 예 | 0.0051 · 0.0143 mm ≤ 0.1, 696ZZ SF 14.4 · 5.15 ≥ 3 · 2 |
| ⑤ 시간·SF ≥ 1 | 예 | 9구간 최저 1.146, `machine.json _timing` 값과 대조 |
| ①·③·⑥ | 검도 몫 | `mech_RX-11_verify.md` |

completion_met false(②가 F1에 걸림). 등급 M은 맞다.

## 9. 문서 담당·다음 회차에 넘길 것

- BOM 비고·설계검토서·조립 순서: `CB5-20_RX11` ×8 조임 0.6 N·m + 중강도 나사 고정제(지금 '죔 3 N·m').
- 자료대기 D-200 '쓰는 곳': 696ZZ C0r 670 · Cr 1,730 N 임시 → 정적 SF 14.4 · 5.15, 롤러 파이프 안지름 12(스틸) → 처짐 0.0051 mm. D-16: RX-11 해석 못 함 — 손계산.
- 요구서 7절: 롤러 구름 저항(바퀴 밑 0.05 임시), V 매트가 덮는 롤러 범위, 조임 0.6 N·m에서 새들 풀림.
- `fea/models.json`: `P_RX11_SADDLE` · `P_RX11_CLAMP` · `CB5-20_RX11 x8` · 롤러·축(구매품 몫) · `HFS8-4080-560_M04_NOTCH` 새 행, `P_M04_PANEL_W2` · `E2`에 `v2.17.0_RX-11` 칸, `P_DC205_STRIP` · `DISC`에 '걷어 냄' 표시(고침 스크립트 `tools/out/mech_RX-11/fea_models_patch.py`).

## 10. 시간 (E-23)

| 항목 | 값 |
|---|---|
| 통로 | 없음(CAD 안 씀, STEP 글자 파싱) |
| CAD 호출 · 파일 열기 · 브라우저 | 0 · 0 · 0 |
| 손계산 실행 | 2회(수 초) |

## 워크플로우 메모

- 설계부·모델링부·검도부 세 부서가 '새들 귀 14 × 6'과 '클램프 9 × 14.5'만 다시 셈해 같은 값을 냈다. 볼트 예압이 지나는 부품은 '예압 힘의 길을 따라 가장 약한 단면'을 설계 단계 손계산 항목으로 두면 해석부까지 오지 않고 걸린다(DC2-05 누름판과 같은 유형이 두 번째다).
- SolidCraft STEP은 호를 유리 B-스플라인으로 내보내고 `FACE_OUTER_BOUND`가 없다. 형재 단면 I를 STEP 끝면 윤곽에서 바로 적분하는 도우미(이번 스크립트의 `section_faces2`)가 엔진 도구에 있으면 'I 하한 가정'을 없앨 수 있다.
- `handcalc.py`에 3점 굽힘·단면 조합(T형) 계산이 없어 케이스 스크립트에 넣었다.
