hyeunung/FSAP/docs/reports/mechanism/mech_RX-11_model1.md

# 구동 RX-11 모델링 수정 1회차 — 새들 볼트 조임 토크 3 → 0.6 N·m (형상 그대로)

## 요약

- 지적(검증·해석 RX-11-F1, kind 동작): `CB5-20_RX11` ×8을 지정 조임 3 N·m(예압 3,000 N)로 죄면 새들 `P_RX11_SADDLE` 축 홈 포켓 위쪽 압축이 231 ~ 250 MPa로 A5052 항복 195 MPa를 넘는다(SF 0.78 ~ 0.84).
- 고친 것: **형상·위치·재질·조인트는 그대로.** 볼트 컴포넌트 `CB5-20_RX11`(8 occurrence)의 부품 속성에 조임 토크 **0.6 N·m**(예압 약 600 N) + **중강도 나사 고정제(Loctite 243 상당)**, "3 N·m·표준 토크 금지"를 적었다(description의 "(3 N.m)"를 지우고 고쳐 씀, properties 조임토크·나사고정제·근거 3개 새로).
- 저장: `3D_Modeling/FSAP_v2.17.1.sc`(v2.17.0에서 마지막 자리 +1, 수정 1회차 — E-05·WF-179). `tools/config.json` doc · `tools/machine.json` doc 바꿈. 통로 MCP(앱). v2.17.0 파일은 덮어쓰지 않음.
- 형상 변화 0 확인: 저장 전 앱에서 RX-11 새·바뀐 바디 57개 bbox·부피가 서명 표와 같음. 저장본 CLI 전수 3,224바디 ↔ 서명 표 다른 것 1(`REF_NEEDLE_AXIS_MARK` 부피 반올림 0.0004 mm³ — 앞 회차와 같은 것, 안 건드림). 조인트 587 · 링크 35 · floating 0 · 오류 0 · 경고 53(v2.17.0과 같음).
- 넘기기 전 확인(E-22, 해석부와 같은 단면·받침): 0.6 N·m에서 새들 위 압축 49.9 MPa → **SF 3.91**(기준 3), 운전 누름 46.54 N을 겹쳐도 3.63, 오설정 130 N을 겹쳐 3.21(기준 2). 3 N·m는 249.4 MPa → 0.78(지적과 같음).
- `tools/machine.json`: doc와 이력 한 줄만. 조인트·행정·상태·연구·_timing 변화 없음(changed_joints false).
- 문서 담당에게: BOM 비고·설계검토서·조립 순서의 "죔 3 N·m"를 "0.6 N·m + 중강도 나사 고정제"로(6절 문장). BOM은 `CB5-20_RX11` ×8을 **따로 행**으로 둔다(다른 CB5-20에 0.6 N·m가 번지면 안 됨, 워크플로우 메모).
- 미완: 없음. 외부 조건: STEP 대기 2종(RORLM20-6-L200 · SFJ6-213) 임시 형상 그대로. FEA 못 함 — 환경 없음(D-16), 강도는 손계산.

## 근거 규칙 (원문)

- 지시문: "문제마다 원인을 고치고(형상·위치·행정·볼트), 다른 부분은 건드리지 않는다." — 원인은 조임력(예압)이므로 볼트 조임 지정만 바꿈.
- 검증 지적 fix: "형상 그대로. CB5-20_RX11 x8 조임 토크를 0.6 N·m로 지정 + 중강도 나사 고정제(DC2-05 누름판과 같은 처리)를 BOM 비고·설계검토서·조립 순서에 적는다." — 그대로 따름. 같은 처리의 앞 사례는 결정로그 DC2-05-M3(`mech_DC2-05_model1.md`: 볼트 컴포넌트 속성에 적고 BOM 비고는 문서 단계가 옮김).
- E-05: "이미 저장·커밋된 버전 파일은 덮어쓰지 않는다 … 과제 안 수정 회차도 같은 과제의 작은 변경이므로 마지막 자리 +1 새 파일로 저장한다." — v2.17.1.
- E-02: "기능이 깨지는 수준(부러짐·영구 변형·동작 중 걸림)은 동작 문제다." — 새들 항복은 영구 변형이라 이번 회차에 고침.
- E-18: "체결(볼트 지름·길이)만 바뀐 자리는 FEA 대신 손계산 표 … 손계산의 단면은 가정하지 말고 측정 자료의 최소 단면으로 쓴다." — 해석부가 STEP에서 잰 단면(Y 7.9 포켓 끝 I 999.18 mm⁴, c 9.86)을 그대로 씀.
- E-22: "모델링부는 저장 전에 검증부·해석부와 같은 도구, 같은 하중 위치·경계조건으로 바뀐 것만 먼저 본다."
- E-17: "다음 검사는 원장과 서명이 다른 것과 그 이웃 … 만 다시 본다." — 형상 서명이 바뀐 바디 0이라 틈·동작 검사는 다시 돌리지 않음(앞 회차 결과가 그대로 유효).
- 실행 규칙 2: "모델링부는 SolidCraft MCP로 그린다 … `save {}`(덮어쓰기)는 쓰지 않는다 … 저장 전에 문서 이름을 새 버전 이름으로". 실행 규칙 19: 저장 전 조인트·스케치 표시 숨김.

## 1. 바뀐 것 (전 → 후)

| 대상 | 전(v2.17.0) | 후(v2.17.1) | 이유(문제 수치 → 결과 수치) |
|---|---|---|---|
| `CB5-20_RX11` description | "Misumi CB5-20 STEP, RX-11 saddle to clamp through panel slot (3 N.m)" | "… slot. THESE 8 ONLY (CB5-20_RX11): tightening torque 0.6 N*m (preload approx 600 N; NOT 3 N*m or standard torque - saddle yields), medium-strength threadlocker (Loctite 243 equiv.)" | 3 N·m 새들 SF 0.78 ~ 0.84 → 0.6 N·m SF 3.91 ~ 4.22 |
| `CB5-20_RX11` properties | 없음 | 조임토크 "CB5-20_RX11 ×8(RX-11 새들 볼트)만: 0.6 N·m (예압 약 600 N). 3 N·m·표준 토크 금지 — … 다른 CB5-20에는 해당 없음" · 나사고정제 "CB5-20_RX11 ×8만: 중강도 (Loctite 243 상당)" · 근거(수정 1회차 수치, `fea/results/mech_RX-11_handcalc.json`) | 풀림은 예압 대신 나사 고정제로 막음 |
| 문서 이름 · 설명 | `FSAP_v2.17.0` | `FSAP_v2.17.1` · "RX-11 mechanism fix1: CB5-20_RX11 x8 tightening torque 3 -> 0.6 N.m + medium threadlocker (saddle yield), no shape change" | 실행 규칙 2 |
| `tools/config.json` doc · `tools/machine.json` doc | v2.17.0 | v2.17.1 | E-05 |
| `tools/machine.json` 이력 | — | "2026-11-13 RX-11 수정1 v2.17.1: 형상·조인트·행정·상태·연구·_timing 변화 없음. CB5-20_RX11 ×8 조임 토크 지정 3 → 0.6 N·m …" 한 줄 | E-15 기록 |
| 형상 · 좌표 · 재질 · 조인트 · 동작 연구 · _timing | — | **바뀜 없음** | — |

- 그대로인 자리(다시 적음): 새들 `P_RX11_SADDLE` ×8 X −1838 · −1622 · −1406 · −1190 · −974 · −758 · −542 · −326(14 × 53 × 14, 부피 7,338.96 mm³), 클램프 `P_RX11_CLAMP` ×8, 볼트 `CB5-20_RX11` ×8 머리 밑 Z −8 · 끝 Z −28 · 탭 물림 11.5, 롤러 14 윗면 Z 0.000.
- 0.6 N·m 근거: 예압 F ≈ T / (K d) = 0.6 / (0.2 × 0.005) = 600 N. 볼트에는 외력 인장이 없다(바퀴 누름은 새들 귀 → 판으로 감). 볼트가 할 일은 새들 X 자리 잡기뿐이고 운전 중 X로 미는 힘 상한 23.6 N에 버팀 90 ~ 180 N(해석 보고 3절).
- 형상을 바꾸지 않은 이유: 지적의 fix가 형상 그대로이고, 재질을 S45C로 바꿔 3 N·m를 유지해도 SF 1.4 ~ 1.5로 기준 3 미달(검증 근거). 새들을 두껍게 하면 판 홈·롤러 틈·클램프까지 따라 바뀌어 더 큰 변경이다.

## 2. 통로·순서

| 항목 | 값 |
|---|---|
| 통로 | MCP(앱 --control 27878). `running` 빈 목록 확인 뒤 시작. 큰 응답은 `tools/out/mech_RX-11/model/mcp_send.py`로 받아 파일에 둠 |
| 문서 확인 | 앱에 v2.17.0이 열려 있음(path 일치), dirty false, 피처 3,687 · 오류 0 · 경고 53. 다시 열지 않음(file_opens 0 — 같은 경로 open은 디스크를 다시 읽지 않는다) |
| 원복(E-08) | 수정 회차라 하지 않음(첫 회차만). `edit.checkpoint` 68을 편집 전에 찍음 |
| 순서 | `edit.checkpoint` → `motion.play REST 0`(moved false) → `component.rename` 루트 `FSAP_v2.17.1` · `document.metadata.set` 설명 → `save {path: v2.17.1}` → 열린 문서 path = v2.17.1 확인 → config · machine doc → `component.metadata.set`(볼트 속성) → 저장 전 검사 → `motion.play REST 0` · 조인트·스케치 표시 숨김 → `save {path: v2.17.1}` → dirty false → 저장본 CLI 확인 → 서명 고침 |
| 저장을 한 번 더 함 | 속성 문구를 한 번 고쳤다: 처음 저장한 뒤 `assembly.bom`(flat)이 품번 CB5-20 22개 컴포넌트(49개)를 한 줄로 묶으며 이 컴포넌트의 properties를 그 줄에 실어 보여 주는 것을 봤다. 0.6 N·m가 다른 CB5-20 41개의 지정처럼 읽히지 않게 값 앞에 "CB5-20_RX11 ×8만"을 넣고 같은 경로로 다시 `save {path}`. 마지막 저장 뒤에는 편집하지 않음. 먼저 돌리던 저장본 CLI 확인은 멈추고 마지막 저장본으로 다시 돌림 |
| 원본 | `tools/out/mech_RX-11/model1/` — `stage_0_name.json` · `stage_1_torque.json` · `stage_9_presave.json`(보낸 명령), `r01_inspect.json` · `r02_presave.json` · `r04_final.json`(앱 결과), `savecheck_out.json` · `savecheck_summary.json`(저장본 CLI), `fix1calc.json`(손계산), `sig_parts.json` · `sig_bolts.json`(서명 조각) |

## 3. 검사 (수치)

| 검사 | 방법 | 결과 |
|---|---|---|
| 형상 변화 0(저장 전, 앱) | `measure` RX-11 새 것 52 + 판 2 + 가로대 3(따낸 것 1 · 안 건드린 두 자리 2) = 57바디(측정 65회) ↔ `tools/out/signatures.json` | bbox(0.05) · 부피(1e-4) 다른 것 **0**. 새들 7,338.9649 mm³, bbox X −1845 ~ −1831 · Y ±26.5 · Z −16 ~ −2 |
| 속성 되읽기 | `component.metadata {CB5-20_RX11}` | description · properties 3개가 1절 값과 같음, part_number CB5-20 · bom_type purchased 그대로 |
| 리지드 그룹·안 묶인 부품(E-11) | `joint.list` | joints 587 · links 35 · fixed 2 · **floating 0** · conflicts 0 · errors 0 (v2.17.0과 같음) |
| 타임라인 | `inspect_design` | 피처 3,687 · 오류 0 · 경고 53 · 정의 바디 876 (v2.17.0과 같음) |
| 숨김(E-11) | `inspect_design` bodies visible false | 98개, 이름 목록이 v2.17.0 저장 때(`model/r33_dirty.json`)와 **같음**(새로 숨기거나 켠 것 0) |
| 재질(E-09) | `matcheck.py`(`out/mach_props.json`, 재질 명령 없음) | 앞 회차와 같음: 불일치 2건은 작업 전부터 있던 `P_M02/M03_WHEEL_TREAD` 표기(Urethane_A70 ↔ '우레탄 A70'), `P_RX11_SADDLE` · `P_RX11_CLAMP`는 'BOM에 없는 부품'(BOM은 문서 담당이 v2.17.1로 씀). 새들·클램프 A5052 그대로 |
| 저장 상태 | `motion.play REST 0` → moved false, `browser.visibility` joints · sketches false | 대기 자세, 조인트·스케치 표시 숨김 |
| 저장 확인(앱) | 마지막 `save {path}` 뒤 `inspect_design` | name `FSAP_v2.17.1`, path `…/3D_Modeling/FSAP_v2.17.1.sc`, **dirty false**, 5,667,858 바이트 |
| 저장 확인(저장본 CLI) | `solidcraft-cli run model1/savecheck_probe.json --in 3D_Modeling/FSAP_v2.17.1.sc --results`(저장 안 함, 백그라운드 1,013(열기 약 909 + 계산 104) s) | ① `inspect.measure` 전수 **3,224바디** ↔ 서명 표 3,224: 없는 것 0 · 남는 것 0 · bbox(0.05)·부피(1e-4) 다른 것 1 = `REF_NEEDLE_AXIS_MARK`(부피 차 0.0004 mm³, 서명 반올림 자리 — 앞 회차 저장 확인에서도 같은 1건, 이번에 안 건드림) → **형상·위치 변화 0** ② `joint.list` joints 587 · links 35 · floating 0 · errors 0 ③ `component.metadata {CB5-20_RX11}`: 조임토크·나사고정제·근거 속성과 고친 description이 저장본에 들어 있음 ④ `document.metadata` 설명 = fix1 문구 |
| 볼트 검사(안내서 '볼트 검사') | 저장본 CLI, 프로브 Ø8.5 × 30(머리 윗면 Z −3 → Z 27, 볼트 1 · 4 · 8) | 34쌍, truncated false, unchecked 0. 기계 부품과 겹침 **0**. 겹친 9쌍은 모두 로딩 자리의 매트·테이프 모형(`MAT_L·G·V·W`, `TP_V_20a`·`TP_G_21a`)으로 앞 회차와 같음(매트를 내리면 위가 열림). 프로브 ↔ 새들 카운터보어 벽 0.5(Ø9.5 − Ø8.5). 볼트 자리·길이·방향은 그대로라 삽입 길·렌치 접근·물림 11.5(2.3d) 판정은 앞 회차 그대로 |
| 조인트 자기 점검 · 과제 범위 틈(E-15 · E-22) | 다시 돌리지 않음 | 형상 서명이 바뀐 바디 0, 조인트 변화 0 → 앞 회차 값이 그대로 유효(REST 새 것 × 주변 475쌍 겹침 0, J_U5_X 5점 × LIFT −10 트레드 ↔ 롤러 0.859, LIFT 30 40.55 — `mech_RX-11_model.md` 5절, 검도 `mech_RX-11_verify.md`) |
| 스크린샷 | 새로 찍지 않음 | 겉모양이 같아 `tools/out/mech_RX-11/shot_v2.17.0_model.png`가 그대로 유효(열어 보지 않음, E-16) |

## 4. 넘기기 전 확인 — 새들 3점 굽힘 손계산 (E-22)

해석부와 같은 모델: 볼트 예압 F가 가운데를 누르고 귀 두 곳(받침 가운데 Y ±24.75, 불리한 쪽)이 받친다. 단면은 해석부가 STEP에서 잰 Y 7.9 포켓 끝(I 999.18 mm⁴, c_위 9.86 mm). σ_위 = (F / 2) × (24.75 − 7.9) × c / I. 항복 195 MPa(A5052, 해석부와 같은 값). 바퀴 누름 항은 해석부 '새들 — 바퀴 누름 130 N만' 최대 10.8 MPa를 자리와 상관없이 더했다(불리). 원본 `tools/out/mech_RX-11/model1/fix1calc.json`.

| 조임 N·m | 예압 N | M N·mm | σ_위 MPa | SF(예압만) | SF(+ 운전 누름 46.54 N) | SF(+ 오설정 130 N) | 판정 |
|---|---|---|---|---|---|---|---|
| 3.0(앞 지정) | 3,000 | 25,275 | 249.4 | **0.78** | 0.77 | 0.75 | 항복(지적과 같음) |
| 0.78(0.6 + 30 %) | 780 | 6,572 | 64.8 | 3.01 | 2.84 | 2.58 | 흩어짐 위쪽 끝, 아래 디테일 |
| **0.6(지정)** | 600 | 5,055 | 49.9 | **3.91** | **3.63** | **3.21** | 합격(운전 기준 3 · 오설정 기준 2) |
| 0.42(0.6 − 30 %) | 420 | 3,539 | 34.9 | 5.58 | 5.03 | 4.27 | 합격 |

- 해석부 값과 대조: 0.6 N·m 최저 SF 3.91(Y 24.75 받침) ~ 4.22(Y 23.5 받침), 클램프 가운데 굽힘 25.4 MPa SF 7.66, 축 자리(Y 11) 내려앉음 0.0118 mm(완료 판정 ② ±0.1 안), 머리 좌면 18.2 MPa, 볼트 `handcalc.calc` 조임 볼트 응력 23.43 · 좌면 11.55 · 암나사 전단 13.21(`fea/results/mech_RX-11_handcalc.json` '조임 0.60 N·m'). 내 계산 3.91과 같다.
- 디테일(기록만, E-02): 토크가 +30 % 흩어지고(0.78 N·m) 운전 누름까지 겹치면 SF 2.84로 기준 3에 5 % 모자란다(항복까지는 2.8배 여유, 영구 변형 아님). 손 조임보다 흩어짐이 작은 토크 드라이버(0.6 N·m 설정)로 죄게 한다. 설계검토서 조립 순서에 '토크 드라이버' 한마디를 넣는다 → 디테일 후보 **RX-11-D(토크 흩어짐)**.
- 디테일(해석 RX-11-F3 그대로): 0.6 N·m에서 손이 롤러를 축 방향 100 N으로 밀면 새들 X 미끄럼 버팀 SF 0.9(귀만) ~ 1.8. 밀려도 롤러 끝 틈 1.0 · 홈 끝 틈 2.0에서 멈춘다. 기록만.

## 5. 서명·기록

| 항목 | 값 |
|---|---|
| 서명 고침(E-17) | 마지막 저장 뒤 `ledger.py sigpatch --project tools --parts model1/sig_parts.json --bolts model1/sig_bolts.json` → "서명 고침: 바뀜 8, 없어짐 0, 전체 3224"(볼트 8개를 저장본 측정값으로 다시 씀 — 값은 그대로). 서명 doc = `3D_Modeling/FSAP_v2.17.1.sc`, doc_hash `0d1cc33a3dfa49ed`, bolts_stale 없음. `ledger.py sigcheck` → reuse("문서·해시가 같다"). `ledger.py scope`(원장 대비) → 바뀜 0 · 새로 0 · 없어짐 0 · 이웃 0(`model1/scope_after.json`). `tools/out/bolts.json` 1,219개 중 `CB5-20_RX11` 8개 torque_Nm 0.6 |
| 바뀐 체결 | `tools/out/mech_RX-11/model1/sig_bolts.json`: `CB5-20_RX11` 8개 torque_Nm 3 → **0.6**, preload_N 600, threadlocker '중강도(Loctite 243 상당)'. 위치·축·물림 11.5는 그대로 |
| 명령 기록(E-25 재료) | `tools/out/mech_RX-11/edit.json` 7단계(이번 회차: 이름·설명 3 + 속성 1 + 저장 전 3), `edit_meta.json` {base v2.17.0, result v2.17.1}. 앞 회차 기록은 `edit_r0.json` · `edit_meta_r0.json`(v2.16.0 → v2.17.0, 131단계)로 남김 |
| 임시 STEP(해석용) | 다시 내보내지 않음 — 형상이 같아 앞 회차 파일이 그대로 유효: `tools/out/mech_RX-11/stepout/P_RX11_SADDLE.step` · `P_RX11_CLAMP.step` · `P_M04_PANEL_W2.step` · `P_M04_PANEL_E2.step` · `HFS8-4080-560_M04_NOTCH.step`. 해석부는 하중 조건만 예압 600 N(0.6 N·m)으로 |

## 6. 문서 담당·해석부에 넘길 것

- BOM(v2.17.1, 구매품): `CB5-20` RX-11 몫 8개를 **따로 행**으로(`CB5-20_RX11`), 비고 "RX-11: 새로. 이 8개만 조임 0.6 N·m + 중강도 나사 고정제(Loctite 243 상당), 3 N·m·표준 토크 금지(새들 항복). X −1838 · −1622 · −1406 · −1190 · −974 · −758 · −542 · −326, Y 0" — DC2-05 때 `CB5-12_DC205` 행과 같은 방식.
- 설계검토서 조립 순서(앞 보고 `mech_RX-11_model.md` 192행의 "죔 3 N·m"를 대신함): "판·형재 → 새들을 위에서 끼우고 밑에서 클램프를 대어 CB5-20을 **토크 드라이버 0.6 N·m + 중강도 나사 고정제**로 죔(3 N·m 금지 — 새들 항복) → 롤러에 축을 꿰어 위에서 내려놓음 → 새들 X를 맞춰 죔. 롤러 교체는 그 롤러만 위로 든다(M-02)."
- 결정로그: RX-11 수정 1회차 — 결정 "CB5-20_RX11 ×8 조임 0.6 N·m + 중강도 나사 고정제, 형상 그대로", 이유 "3 N·m에서 새들 SF 0.78 ~ 0.84(항복) → 0.6 N·m SF 3.91 ~ 4.22, 클램프 7.7, 축 자리 내려앉음 0.059 → 0.012 mm. S45C로 바꿔도 3 N·m에서 1.4 ~ 1.5", 근거 `fea/results/mech_RX-11_handcalc.json` · `tools/out/mech_RX-11/model1/fix1calc.json` · 이 보고서.
- 제어 순서 제약(U-09): 새로 없음. 앞 회차 것 그대로(U4+U5 회전 시간 키, U5는 매트 위에서만 내림 — 매트 없이 내리면 롤러 위 0.86에서 멈춤).
- 요구서 7절 기록에 더할 것: 조임 0.6 N·m + 나사 고정제에서 새들 풀림·X 밀림(진동·롤러 교체 반복 뒤).
- 못 한 것(앞 회차 그대로): STEP 대기 2종(RORLM20-6-L200 · SFJ6-213), 가격, 롤러 외경 공차·흔들림, FEA(D-16).
- 자료대기: 바뀐 것 없음(D-200 · D-97은 앞 회차 문구 그대로).

## 7. 미완·못 한 것

- 미완(unfinished): 없음.
- 외부 조건: `STEP대기_RORLM20-6-L200` ×14 · `STEP대기_SFJ6-213` ×14는 실물 STEP 미수령(임시 형상 유지, 이번 회차에 받기를 다시 시도하지 않음 — 실행 규칙 10).
- FEA 못 함 — 환경 없음(D-16). 강도는 손계산(4절).

## 8. 시간 (E-23)

| 항목 | 값 |
|---|---|
| 걸린 시간 | 약 23분(1374 s). 그 가운데 저장본 CLI 확인 기다림이 약 22분(첫 확인 약 5분은 속성 문구를 고치며 버림 + 다시 돌린 것 1,013 s). 그리기·저장은 2분 안쪽 |
| CAD 호출 | MCP 22(앱) + CLI 2 |
| 파일 열기 | 앱 0(이미 열려 있던 v2.17.0에서 이어 함) + 저장본 CLI 2(첫 것은 속성 문구를 고치며 멈춤) |
| 가장 긴 저장본 열기 | 약 909 s(저장본 CLI, 5.67 MB). 상한 240 s를 넘음 — 앞 회차 약 785 s와 같은 수준(모델 무게, E-04 WF-196. LITE는 실행 지시 (f)로 이번 실행에 넣지 않음) |
| 앱 다시 켬 | 없음 |

## 워크플로우 메모

- 수정 회차의 고칠 것이 '형상 그대로, 조임 토크 지정'일 때도 지시문은 새 번호 파일 + version_bump 'last'를 요구하고 'none'이면 위반으로 올린다. 형상이 같은 새 버전 파일(5.7 MB)과 저장본 CLI 확인 약 14분이 든다 · 근거: 이 회차(바뀐 것은 부품 속성 한 곳), DC2-05 수정 1회차도 같았다 · 검증 문제의 fix가 문서·지정만이면 모델링부 대신 문서 담당으로 보내거나(`docs_only`), 속성만 바뀐 저장은 'none'을 허용하는 갈래가 있으면 좋겠다.
- 조임 토크·나사 고정제를 담을 자리가 서명 표에 없다(체결 기록 `sig_bolts.json` torque_Nm과 부품 속성으로만 전달) · 근거: DC2-05 수정 1회차 메모와 같음(반복) · 체결 목록(`bolts.json`)의 torque_Nm을 검도·문서가 읽는 정식 칸으로 두면 좋겠다.
- `assembly.bom`(flat)은 품번으로 묶으면서 한 컴포넌트의 properties를 묶인 줄 전체에 싣는다(CB5-20 49개 줄에 RX11 8개의 조임토크가 보임) · 근거: `model1/r02_presave.json` bom · 특정 자리에만 해당하는 지정은 값 안에 대상을 적거나, BOM을 컴포넌트별로 뽑아 문서 담당이 따로 행으로 쓴다.
- MCP `batch`에 `motion.play`를 넣으면 `verbose: false`여도 조인트 값 전체(수천 줄)가 응답으로 온다 · 근거: 이 회차 첫 batch · 큰 응답이 나는 명령은 `mcp_send.py`처럼 파일로 받는 길을 안내서에 적어 두면 좋겠다.
