hyeunung/FSAP/docs/reports/mechanism/mech_RX-12_donecheck.md

# 구동 RX-12 원칙 감사 — 완료 판정 확인 (설계안 RX-12-D1)

## 요약

- 판정: **합격(ok = true)**. 완료 판정 ①~⑤ 모두 설계 단계에서 요구되는 만큼 만족한다. 고칠 자리 없음.
- 방법: CAD를 쓰지 않고 설계안의 자세 파일(`cycle_w.json` 1,169자세)·연구 키·서명(`tools/out/signatures.json`, v2.15.2)·측정부 `motion_list.json`을 감사 스크립트(`tools/out/mech_RX-12/donecheck/audit.py`, 격자 5 mm·꼭짓점 계산 — 설계자의 다각형 자르기와 다른 방법)로 다시 계산했다.
- 다시 계산한 값: X 최대 1052.1(W1 488), +X 넓이 550,000 mm²(W1 439), 볼 받침 밖 323,625(설계 323,536, 격자 오차 0.03 %, W1 425), 포켓 282,550(설계 282,556, W1 420), +X 기둥까지 104.1(W1 482), 범위 X −1646.7~1052.1 · Y ±1493.5 — 설계안과 같다.
- 매트 높이 층(Z 0~10)에서 휘두름 범위(X −1650~1055 · Y ±1495) 안에 걸치는 기계 바디(서명 REST, 작업 대상 제외)는 `TL_FEED` 하나뿐(기준선 75 mm³).
- 기존 연구 9개의 기존 키 변화 0(측정부 `motion_list.json`과 점·값 대조 차이 0), 더해진 것은 `J_WP_W_X·Y·ROT` 0 키뿐.
- 남는 것(문제 아님, 검도가 볼 것): 새 매트의 CAD 전 구간 `motion.interference`(truncated false), 볼록 모서리 앞뒤 50 mm 안의 직선 간격이 25 mm인 것(아래 ① 메모).

## 항목별 확인

| 항목 | 판정 | 다시 계산한 근거 |
|---|---|---|
| ① 새 매트 한 사이클 전 구간 과제 범위 간섭 0(간격 6-4) | 만족(설계 근거. CAD 전 구간은 모델링 뒤 검도) | 바늘 점이 땀 길(외곽 안쪽 6.5) 위를 벗어난 자세 0 / 1,169. 이웃 자세 사이 최대 이동 25.0 mm · 최대 회전 1.0°, 오목 모서리 4곳 둘레 50 mm 안에서 5 mm 넘는 걸음 0. 서명에서 Z 0~10 · 휘두름 범위에 걸치는 기계 바디 = `TL_FEED`(X −2.5~7.5 · Y −9~−1.5 · Z −1~11, machine.json baseline_overlaps에 있음) 1개뿐, +X 기둥(X 1150~1230 · Y 120~320)은 범위 밖 최소 104.1. 바늘 −30 꿰뚫음도 기준선(machine.json "U3_NEEDLE_PIN(-30)") |
| ② 뒷면이 전 구간 받침 위(아니면 넓이·자리를 후보로) | 만족(후보로 올림) | 받침(볼 중심 + 50: X −2100~400 · Y ±1500, X 400~900 · Y −200~1500) 밖 최대 323,625 mm²(W1 425), 포켓(X > 400 · Y < −300) 282,550(W1 420), X > 900 73,850 · X > 975 21,325(격자 5 mm 값, 설계 정확값 74,550 · 22,050 = 31.5 × 700과 맞음). 결정로그 RX-12-C1·C2에 좌표·넓이가 적혀 있다(4145~4146행) |
| ③ +X 최대(X 좌표·넓이)를 결정로그에 | 만족 | 결정로그 RX-12-S1(4134행): X 1052.1 · 550,000 mm²(61.1 %). 다시 계산값과 같음. 손 확인: W1 439(ROT 270)에서 매트가 X −493.5~1006.5, X > 6.5 넓이 = 1000 × 700 − 오목 500 × 300 = 550,000 |
| ④ 0-8-5 고칠 안(결과 수치 포함) | 만족(설계 단계 몫) | 보고서 7절·결정로그 RX-12-S4(4137행)에 문장과 수치(1052.1 · 550,000 · 323,536 · 282,556). 설계검토서·요구서 반영은 문서 담당 몫으로 미완에 적혀 있다 |
| ⑤ machine.json에 새 매트, 기존 연구 키 변화 0 | 만족(지시서) | 지시서 6절 7에 joints·units·studies·states·workpiece_stages·baseline. `study_others.json` 9개 연구를 `motion_list.json`과 대조: 단계 수 같음, 기존 키 점·값 차이 0, 더해진 키는 `J_WP_W_X·Y·ROT` 0뿐. `CYCLE_W1`(583)·`W2`(585) 키를 걸음마다 보간한 값과 자세 파일의 차이 최대 0.0001(X·Y·ROT·U5 LIFT·U5 X·바늘·노루발) — 회전 구간 X·Y 키가 1°마다 있어 호를 벗어나지 않는다. 키 조인트 31개 = `CYCLE_V`의 기계 조인트 28 + 새 3(다른 매트 조각 `J_TP_*`를 안 넣는 것은 `CYCLE_V`와 같은 약속) |

### 바퀴 접점(0-8-2 ③ "내리는 조건: 바퀴 밑에 매트가 있고 …")

- U4(d₁ 100, 폭 25 · Y ±3 9점): 노루발 내린 전 자세에서 매트 밖 0.
- U5(d₂ 440): `J_U5_LIFT` < 30인 866자세에서 매트 밖 0. 가장자리 여유 최소 3.5(볼록 모서리에서 Y 쪽: e 6.5 − 3, 기존 매트와 같은 값), 들기·내림 정지 자세의 여유 47.0(W1 84~85, W2 499~500) · 71.4(W1 516→517 ROT 225, W2 66→67 ROT 135). 대차가 움직이는 동안(`J_U5_X` ≠ 1360) 내린 자세 0.

### ① 메모(검도에 넘김, 수정 요구 아님)

- 요구서 6-4 "바늘 둘레 반경 50 mm 안·홈 안·모서리 회전 구간은 5 mm·1°". 설계안은 회전은 모두 1°, 오목 모서리 4곳 앞뒤 50 mm는 5 mm이지만 **볼록 모서리 4곳 앞뒤 50 mm의 직선 걸음은 약 24.5 mm**(16걸음, 예: W1 102~103, 198~199)다. 그 구간에서 매트 높이 층에 새로 들어오는 기계 바디가 없고(위 서명 확인) 기존 `CYCLE_L`·`V`와 같은 약속이라 완료 판정 미달로 보지 않았다. 검도가 CAD 전 구간 결과에서 이 구간을 따로 볼 필요는 없다.
- 이 감사는 평면 계산 + 서명(REST 자세) 확인이다. 움직이는 바디(U4·U5 바퀴, 노루발, 슈)가 매트 윗면에 닿는 값은 기존 연구와 같은 키라 기준선으로 보았고, CAD 값은 검도가 낸다.

## 워크플로우 메모

- 과제 문구의 문서 버전(v2.13.0)과 config.json doc(v2.15.2)가 다르다. 설계안·서명 모두 v2.15.2 기준이라 그대로 따랐다.
- 완료 판정 ⑤ "기존 연구 5개"는 지금 9개다(REST·MAINT·SEAM 포함). 9개 모두 대조했다.

## 파일

- `tools/out/mech_RX-12/donecheck/audit.py` · `audit.json` — 감사 계산과 결과
