hyeunung/FSAP/docs/reports/mechanism/mech_RX-06-C2_model1.md

# RX-06-C2 모델링 수정 1회차 — 카세트 관 브래킷 볼트 CB5-16 → CB5-12 (모델링부, 2026-11-13)

요약(10줄 안):
- 저장: `FSAP_v2.15.1.sc` → **`3D_Modeling/FSAP_v2.15.2.sc`**(마지막 자리 +1, 수정 1회차, 새로 생기거나 없어진 컴포넌트 0). 통로 MCP(앱). `tools/config.json` doc 고침. 저장 상태 REST step 0, 조인트·스케치 숨김, 문서 이름 FSAP_v2.15.2.
- **고친 것(검도 지적 1건):** 관 브래킷 `P_M08_TUBE_BRKT_CST_V`를 카세트 판에 무는 볼트 `CB5-16_M05_1:2 · :3`(끝 X 46~50이 고정부 `P_M05_HOLDER` +X 벽 살을 뚫음, 계산 78.5 mm³ × 2)을 지우고 같은 머리 자리에 **`CB5-12_M05_7:2 · :3`**(CB5-12 실물 STEP의 occurrence)을 놓았다.
- 새 볼트: 받침면 X 62(그대로) · Y −152.5 · Z 304 / 320, bbox X **50.0**~67.0, 부피 476.413 mm³. 끝 X 50.0 = 판 뒷면. 물림 = 판 두께 8 mm = 1.6d ≥ 1.5d(M-01).
- **HOLDER와 겹침 0**(앱 REST · J_U7_HGT 5점 · MAINT_U7 6단계, 저장본 CLI REST). HOLDER 쌍은 이제 unchecked가 아니라 계산된 맞닿음 0.0이다.
- `CB5-16_M05_1:4 · :5`(끝 X 48~50, 판 뒷면 밖 2 mm): 끝 자리에 다른 바디 없음(가장 가까운 것 관 24.4 mm) → **그대로 둠**.
- 형상 값 변화 0: 피처 3,709 그대로(피처 목록 · 컴포넌트 682 · 조인트 584 · 재질 · 숨김이 v2.15.1과 같음). 바뀐 것은 occurrence 2개 지움 + 2개 더함뿐. 타임라인 error 0 · warning 54 → 54.
- BOM: CB5-16 492 → 490(−2), CB5-12 +2(`assembly.bom` 행 77 → 79).
- 디테일 2건(기록만, E-02): 볼트 끝이 판 뒷면과 같은 면(여유 0), 위 볼트 머리 앞 접근 프로브가 관 `TU0604_M08P_U7C_FEED_A`와 66.9 mm³ 겹침(머리 자리는 앞 버전과 같음).
- 미완 없음. 예외 요청 없음. 조인트·행정·기계 정의 변화 없음.

## 0. 근거 규칙

| 규칙 | 원문 | 이번 |
|---|---|---|
| M-01 | "상대 부품의 탭 또는 너트가 실제로 있음, 물림 ≥ 1.5d" · "모델에 볼트를 꽂아만 두는 것은 결함이다" | 볼트 끝 4 mm가 탭·구멍 없는 HOLDER 벽 살에 들어가 있었다 → 길이를 12로. 판 관통 탭 물림 8 = 1.6d |
| M-08 | "정상 겹침: 볼트 나사부의 탭 물림" | 남은 unchecked 2쌍은 새 볼트 ↔ `P_M05_CST_PLATE`(Ø4.2 탭 구멍에 Ø5 자루, 물림 자리)뿐 |
| E-03 | "과제 안 = 과제 범위 간섭 0" | 완료 판정 ④ 미달이던 쌍(볼트 ↔ HOLDER)을 없앰. 5절 |
| E-05 | "이미 저장·커밋된 버전 파일은 덮어쓰지 않는다 … 과제 안 수정 회차도 … 마지막 자리 +1 새 파일" | v2.15.2 새 파일. v2.15.1은 5,632,661 B · 12:49 그대로 |
| E-10 · U-07 | "구매품은 구매처에서 받은 실제 STEP을 기준으로" | CB5-12 실물 STEP(stepcheck '있음')으로 들어와 있는 `CB5-12_M05_7`의 occurrence를 더함. CB5-14는 stepcheck '없음'이라 쓰지 않음 |
| E-15 | "기계의 모든 움직임은 CAD 조인트로" | 자세는 `joint.drive` · `motion.play`(MAINT_U7 · REST)로만 |
| E-02 | "구동 단계에서 새로 본 디테일은 기록만 하고 수정 회차를 쓰지 않는다" | 6절 디테일 2건 |
| 실행 규칙 2 | "모델링부는 SolidCraft MCP로 그린다" · "`save {}`(덮어쓰기)는 쓰지 않는다" · "저장 뒤에는 편집하지 않는다" | MCP. `save {path: v2.15.2}` 한 번, 그 뒤 편집 0 |

## 1. 문서 확인

- `running` 빈 목록. 앱에 `FSAP_v2.15.1`이 열려 있었다(`inspect_design`: path v2.15.1, **dirty false**, 피처 3,709, error 0, warning 54). `open`은 다시 부르지 않았다(안내서 '원복' "같은 경로를 다시 `open`해도 디스크에서 다시 읽지 않는다").
- 편집 전 `edit.checkpoint` 58. 동작 상태 초기화는 `motion.play REST 0`.
- stepcheck: CB5-12 있음 · CB5-16 있음 · CB5-14 없음.
- 절차 2의 "먼저 다른 이름으로 저장 → 그 파일에서 고치고 끝에 save"는 실행 규칙 2("저장 뒤에는 편집하지 않는다", "`save {}`는 쓰지 않는다")와 맞지 않아, 앞 회차와 같이 **편집 → `save {path: 새 번호}` 한 번**으로 했다. v2.15.1을 덮어쓰지 않는다는 기준(E-05)은 같다.

## 2. 고친 것

| 전 | 후 | 바꾼 이유(문제 수치 → 결과 수치) |
|---|---|---|
| `CB5-16_M05_1:2`(occurrence 96424) bbox X 46.0~67.0 · Y −156.75~−148.25 · Z 299.75~308.25, 554.85 mm³ | `CB5-12_M05_7:2`(occurrence 98293) bbox X **50.0**~67.0 · Y −156.75~−148.25 · Z 299.75~308.25, 476.413 mm³, SCM435 | 끝 X 46~50이 HOLDER +X 벽(X 46~50) 살과 겹침(계산 π·2.5²·4 ≈ 78.5 mm³) → 끝 X 50.0, HOLDER와 맞닿음 0.0 · 겹침 0 |
| `CB5-16_M05_1:3`(occurrence 96426) Z 315.75~324.25 | `CB5-12_M05_7:3`(occurrence 98294) bbox X 50.0~67.0 · Y −156.75~−148.25 · Z 315.75~324.25, 476.413 mm³ | 같음 |

- 방법: `selection.delete {occurrences: [96424, 96426]}` → `occurrence.copy {occurrence: "CB5-12_M05_7:1", parent: "U7_CASSETTE", in_place: true, translate: [1, −12.5, 42]}` · `[1, −12.5, 58]`.
- 원본 `CB5-12_M05_7:1`: 자루 원통 원점 (61, −140, 262) · 축 −X · 길이 12(`body_topology`), 머리 X 61~66. 옮긴 뒤 받침면 (62, −152.5, 304) · (62, −152.5, 320) = 지운 볼트의 받침면과 같다(`tools/out/bolts.json` 옛 값 pos [62, −152.5, 304 · 320]).
- 체결 사슬(X): 머리 62~67 → 브래킷 `P_M08_TUBE_BRKT_CST_V` 58~62(t4) → 판 `P_M05_CST_PLATE` 50~58(M5 관통 탭 8) → 끝 50.0. 물림 8 mm = 1.6d. 판 탭 물림 길이는 CB5-16일 때와 같다(판 두께 전부).
- 리지드: 새 occurrence의 부모는 U7_CASSETTE(지운 것과 같음). `joint.list` floating 0, 조인트 584개가 편집 전 목록과 이름·값 차이 0.
- 만든 가공품 · 지운 가공품 없음. 구멍·탭 변화 없음(판 탭 `TAP_P_M05_CST_PLATE_1·2`와 브래킷 구멍 그대로 씀 → 빈 구멍 0).

### 지시 2: CB5-16_M05_1:4 · :5 확인 — 그대로 둠

| 볼트 | bbox | 끝 자리(X 48~50)의 가장 가까운 바디 | 판정 |
|---|---|---|---|
| `CB5-16_M05_1:4` | X 48~69 · Y −195.75~−187.25 · Z 157.75~166.25 | 판(물림) · 브래킷 `P_M08_TUBE_BRKT_CST_O`(머리 자리 0.0) 다음이 `TU0604_M08P_U7C_TUCK_A` 24.39 mm | 닿는 것 없음 |
| `CB5-16_M05_1:5` | Z 193.75~202.25 | 같음, 다음이 `TU0604_M08P_U7C_CUT_A` 26.91 mm | 닿는 것 없음 |

- 앱 `inspect.clearance {clearance 2, nearest 4}`(16.1 s), overlaps 0. 측정 표(서명) bbox로 끝 자리 X 46~50 · Y −195.75~−187.25 · Z ±4.25 둘레 1 mm 안을 찾아도 판 · 자기 자신 · bbox가 큰 관 4개뿐이다(관 실거리는 위 값).
- 끝이 판 뒷면 밖으로 2 mm 나오지만 그 자리는 빈 공간이다(HOLDER는 Z 285~334에만 있음). CB5-12로 바꾸면 귀 t6 + 판 8 = 14 > 12라 물림 6 mm = 1.2d가 되므로 바꾸지 않는다.

## 3. 저장 전 검사

| 항목 | 결과 |
|---|---|
| 타임라인 | 피처 3,709 → 3,709(id 순서까지 같음), error 0, warning 54 → 54(새 것 0 · 없어진 것 0 · 글 바뀐 것 0), suppressed 0 |
| 바디 | 앱 정의 바디 879 그대로. occurrence 2,918 → 2,918(−2 +2) |
| 숨김(E-11) | 숨긴 바디 97 · occurrence 0 · 조인트 771 · 스케치 304(앞 버전과 같음) |
| 리지드 그룹 · 안 묶인 부품(E-11) | `joint.list` floating 0, errors 0, conflicts 0 |
| 재질(E-09) | 새 볼트 SCM435(원본 바디의 재질 그대로). 재질 표 · 컴포넌트가 v2.15.1 `document.json`과 같음 → 새 불일치 0(가공품 변화 없음) |
| BOM(`assembly.bom` flat) | CB5-16 490(v2.15.1 492), CB5-12 행 79(같은 컴포넌트의 v2.15.1 occurrence 77) |
| 조인트 자기 점검(E-15) | J_U7_HGT −4 → 6, MAINT_U7 2 → 13 모두 요청 값 = 도달 값, errors 0 · conflicts 0. 조인트 · 행정 · 스토퍼는 안 바꿈 |

## 4. 넘기기 전 확인(E-22) — 새 볼트 2 × 이웃 (`inspect.clearance`)

### 4-1. REST (앱, 14.6 s) — 상대 13: HOLDER · CST_PLATE · TUBE_BRKT_CST_V · CB5-12_M05_9 · _10 · 카세트 관 5 · U8 관 3

| 쌍 | 결과 |
|---|---|
| 새 볼트 ↔ `P_M05_HOLDER` | **겹침 0, 거리 0.0(끝 면 X 50 = 벽 면 X 50 맞닿음), unchecked 아님** |
| 새 볼트 ↔ `P_M08_TUBE_BRKT_CST_V` | 겹침 0, 거리 0.0(머리 받침면 X 62) |
| 새 볼트 ↔ `P_M05_CST_PLATE` | unchecked 2("boolean Intersect: no result") — 탭 Ø4.2에 자루 Ø5가 물린 자리(M-08 나사 물림, 겹침 계산값 π(2.5² − 2.1²)·8 ≈ 46.2 mm³) |
| 새 볼트 ↔ `CB5-12_M05_10` | 6.74 mm(:2) · 4.47 mm(:3) |
| overlaps | 0, truncated false |

### 4-2. 자세(앱) — 상대 5: HOLDER · U8 관 `TU0604_M08P_U7_4_A · 5_A · 6_A` · 걸쇠 `STEP대기_KC-40340_M05_HOOK` (측정 표 bbox로 볼트가 지나는 길 3 mm 안의 함께 안 움직이는 바디)

| 자세 | 겹침 | HOLDER까지 | 그다음 가까운 것 |
|---|---|---|---|
| J_U7_HGT −4 · −1.5 · 1 · 3.5 · 6 (0 · 25 · 50 · 75 · 100 %) | 0 · 0 · 0 · 0 · 0 | 0.0(함께 오르내림) | HOOK 10.52(:3) · 21.56(:2) |
| MAINT_U7 2단계(CST_X 12.5) | 0 | 12.5 | HOOK 18.25 |
| MAINT_U7 3단계(CST_X 25) | 0 | 25.0 | HOOK 18.25 |
| MAINT_U7 6 · 8 · 11 · 13단계(CST_Y … 250) | 0 · 0 · 0 · 0 | 35.4 · 79.1 · 152.1 · 201.6 | HOOK 18.25 |

- unchecked 0, truncated false(모든 자세). 걸린 시간 자세마다 0.02~0.45 s.
- 새 볼트는 옛 볼트 자리(X 46~67)의 안쪽(X 50~67)이라 어느 자세에서도 옛 볼트보다 새로 닿을 것이 없다.
- 끝난 뒤 `motion.play REST 0` · `joint.drive J_U7_HGT 0` · `J_U4_X 0`으로 되돌렸다.

### 4-3. 볼트 검사(안내서 '볼트 검사', 저장본 CLI — 원본은 안 바뀜)

| 볼트 | 삽입·접근 프로브(머리 위 +X, Ø8.5 × 30 = max(30, 12 + 5)) | 결과 |
|---|---|---|
| `CB5-12_M05_7:2`(Z 304) | X 67~97 | 겹침 0. 가장 가까운 것 관 `TU0604_M08P_U7C_FEED_A` 0.70 mm, 브래킷 5.0 mm |
| `CB5-12_M05_7:3`(Z 320) | X 67~97 | **관 `TU0604_M08P_U7C_FEED_A`와 66.905 mm³ 겹침**(Ø6 유연 관). 그 밖 0 |

- 머리 자리(X 62~67)는 지운 CB5-16과 같아 이 접근 상태는 앞 버전과 같다(이번 변경이 만든 것이 아님). 구동 라운드 지시("새 볼트 렌치 접근 … 은 디테일로 기록만")에 따라 6절 디테일로 남긴다.
- 상대 탭: 판 M5 관통 탭 있음, 물림 8 = 1.6d. 빈 구멍 0, 같은 자리 중복 볼트 0(지운 2 · 더한 2).

## 5. 저장 · 저장 확인

| 항목 | 값 |
|---|---|
| 순서 | 편집 → `component.rename {0, FSAP_v2.15.2}` → `document.metadata.set` 설명 → `motion.play REST 0` → `joint.drive J_U7_HGT 0` · `J_U4_X 0` → 조인트 · 스케치 숨김 → `save {path}` |
| 저장 응답 | 5,632,607 B, name FSAP_v2.15.2, path `3D_Modeling/FSAP_v2.15.2.sc` |
| 저장 뒤 앱 | name FSAP_v2.15.2, path v2.15.2, **dirty false**, 피처 3,709, error 0, warning 54. 저장 뒤 편집 0 |
| v2.15.1 | 5,632,661 B · 2026-11-13 12:49 그대로(덮어쓰지 않음) |
| 저장본 대조(`document.json`, v2.15.1 ↔ v2.15.2) | appearances · assembly(조인트 584 · 링크 35 · 연구 9) · components · features · materials · visibility 등 **모두 같음**. 다른 것은 name · 설명 · occurrences(없어짐 96424 · 96426, 새로 98293 · 98294, 나머지 2,916개 변환 포함 같음)뿐 → 부품 위치 · 대기 포즈 그대로 |
| 저장본 CLI 측정(`fix1/saved_a_out.json`) | 바디 3,188개. 측정 표(서명)와 이름이 안 맞는 것은 지운 2 · 더한 2뿐, 나머지 3,186개는 부피(상대 1e-4) · bbox(0.05 mm) 차이 0. 새 볼트 bbox X 50.0~67.0 · 476.413 mm³ ×2. 새 볼트 × 13 상대 clearance: overlaps 0, HOLDER 0.0 맞닿음, unchecked는 판 ↔ 새 볼트 2쌍(나사 물림)뿐 |
| 측정 표(서명) · 체결 목록 | `ledger.py sigpatch --parts fix1/sig_changed.json --removed <옛 볼트 2 + 옛 체결 이름 2> --bolts fix1/bolts_changed.json`: 바뀜 2 · 없어짐 4 · 전체 3,188, 문서 · 해시 v2.15.2. `sigcheck` reuse, bolts_stale 없음. `tools/out/bolts.json` 1,219개(옛 `CB5-16_M05_1_PNEU01_52 · 53` → `CB5-12_M05_7:2 · :3`, engage 8). 이 뒤 저장 안 함 |
| 변경 범위(`ledger.py scope`) | 새로 2 · 없어짐 2 · 이웃 11, "이동 유닛 부품이 바뀜: U7_TAPE" |
| 다시 실행 재료(E-25) | `tools/out/mech_RX-06-C2/edit.json`(명령 10개: 편집 3 + 마무리 7) · `edit_meta.json`(base v2.15.1 → result v2.15.2) · `model/stage_fix1_1 · 2.json`. 생성기 `tools/gen_rx06c2_fix1.py`. 앞 회차 기록은 `edit_r0.json` · `edit_meta_r0.json` |
| 임시 STEP | 없음. 새로 힘을 받는 가공품 없음(가공품 형상 값 변화 0) |
| 스크린샷 | `tools/out/mech_RX-06-C2/shot_v2152_iso.png`(저장본 CLI snapshot 700 × 500, 사람용 — 열어 보지 않음) |

## 6. 디테일(기록만, E-02 — 수정 회차 대상 아님)

| id | 무엇 | 자리 | 근거 | 고칠 것 |
|---|---|---|---|---|
| RX-06-C2-D1 | 새 볼트 끝이 판 뒷면과 같은 면(X 50.0)이라 HOLDER 벽과 여유 0. 볼트 길이 · 판 · 브래킷 두께 공차가 + 쪽이면 끝이 나와 카세트 판이 HOLDER 벽에 덜 붙을 수 있다(볼트 길이 공차 값은 확인 못 함 — 규격표 확인 필요) | `CB5-12_M05_7:2 · :3` 끝 (50, −152.5, 304 · 320) ↔ `P_M05_HOLDER` +X 벽 | 앱 · 저장본 clearance 거리 0.0, 겹침 0 | 디테일링에서 HOLDER 벽에 릴리프 구멍(이웃 볼트 `CB5-12_M05_9 · 10` 자리 Y −180 · −164 · Z 314에는 이미 구멍이 있음 — 검도 `holder_topology.json`) 또는 머리 밑 평 와셔 + 탭 물림 재확인. HOLDER는 이번 과제 완료 판정 ①(형상 값 변화 0) 대상이라 이번에 손대지 않음 |
| RX-06-C2-D2 | 위 볼트 머리 앞 접근 프로브(Ø8.5 × 30, +X)가 유연 관과 겹침. 아래 볼트는 틈 0.70 mm | `CB5-12_M05_7:3` 머리 앞 X 67~97 ↔ `TU0604_M08P_U7C_FEED_A` | 66.905 mm³(저장본 CLI). 머리 자리는 PNEU-01 수정 2회차(v2.8.8)부터 같음 | 관 길을 머리 축에서 Ø8.5 밖으로 비키거나 관 클램프 자리 조정(M-01 렌치 접근) |

## 7. 못 한 것

없음.

| 검도 지적 · 완료 판정 | 결과 |
|---|---|
| CB5-16_M05_1:2 · :3 → CB5-12, HOLDER와 겹침 0 확인 | 함(2 · 4절) |
| CB5-16_M05_1:4 · :5 끝 자리 확인, 닿으면 교체 | 확인함 — 닿는 것 없음, 그대로(2절) |
| ① REST에서 대상 바디 부피 · bbox 변화 0 | 가공품 · 피처 변화 0(`document.json` features 같음, 저장본 측정 차이 0) |
| ② 끝 자세에서 부피 같고 bbox가 강체 이동 | 앞 회차 그대로(피처 · 조인트 변화 0). 새 볼트는 카세트를 따라감(MAINT_U7에서 HOLDER까지 12.5 → 201.6으로 멀어짐) |
| ③ 타임라인 error 0 · 새 warning 0, Box326 · Combine41 없음 | 만족(피처 목록이 v2.15.1과 같음) |
| ④ 과제 범위 간섭 0 | 볼트 ↔ HOLDER 겹침 없어짐. 남은 unchecked는 판 탭 물림뿐 |

## 8. 문서 담당에게 넘길 것

- BOM(구매품): CB5-16 **−2**, CB5-12 **+2**(카세트 관 브래킷 `P_M08_TUBE_BRKT_CST_V` 고정 볼트). 형번 · STEP 새로 받을 것 없음.
- 결정로그: RX-06-C2 수정 1회차 — 검도가 찾은 볼트 끝 ↔ HOLDER 겹침(v2.8.8부터)과 고친 방법, `CB5-16_M05_1:4 · :5`는 닿는 것이 없어 그대로 둔 것. 디테일 RX-06-C2-D1 · D2.
- 판정 기억(`tools/out/judged.json`): 옛 쌍 `P_M05_HOLDER ↔ CB5-16_M05_1:2 · :3`(나사 물림으로 적혀 있었다면)은 틀린 판정이었다 — 검도가 지우거나 다시 판정.
- 설계검토서: 조인트 · 행정 · 기계 정의(`tools/machine.json`) 변화 없음.

## 9. 시간

| 항목 | 값 |
|---|---|
| 통로 | MCP(편집 · 자세 · 측정 · 저장) + 저장본 CLI(읽기 3 + 실패 1) |
| 파일 열기 | MCP `open` 0(이미 열려 있었음), CLI 4(확인 1번 실패 뒤 2개로 나눠 다시 + 스냅샷). 가장 긴 열기 약 1,010 s(CLI 3개 동시), 혼자 돌 때 약 780 s |
| 앱 편집 시간 | 지우기 + 놓기 3단계 0.73 s(occurrence만 바꿔 타임라인 재계산 없음) |
| 앱 막힘 · 재시작 | 없음 |
| 걸린 시간 | 약 44분(예산 120분, 등급 S 예상 30분의 2배 안). 앱 작업은 약 6분, 나머지는 저장본 CLI 열기를 기다린 시간 |
| 예상보다 긴 이유 | 저장본 CLI 확인이 한 번 실패(프로브 바디 이름을 `name`으로 줌 — `body_name`이어야 함, 실패하면 앞 단계 결과도 안 나옴)해 열기 약 15분을 한 번 더 씀 |

## 워크플로우 메모

- 모델링 지시문 절차 2("먼저 다른 이름으로 저장해 새 파일을 만든다 … 그 파일에서 고치고 끝에 save")가 프로젝트 실행 규칙 2("저장 뒤에는 편집하지 않는다", "`save {}`는 쓰지 않는다")와 SolidCraft 안내서 '원복'("저장 뒤에는 편집하지 않는다")에 맞지 않는다 → SolidCraft일 때는 "편집 → `save {path: 새 번호}` 한 번"으로 적으면 좋겠다.
- `solidcraft-cli run … --results`는 한 단계가 실패하면 앞 단계 결과를 하나도 내지 않는다(열기 15분을 잃음). 저장 확인 측정과 프로브 검사를 스크립트 둘로 나누거나, 스크립트를 가벼운 파일에 먼저 시험하면 좋겠다. `solid.cylinder`의 새 바디 이름은 `name`(피처 이름)이 아니라 `body_name`이다 — 안내서 '볼트 검사' 3에 적으면 좋겠다.
- `selection.delete {occurrences}`는 지워도 `deleted: []`를 돌려준다(dry_run도 같음). 지워졌는지는 `occurrence.properties`가 "no occurrence"를 내는지로 확인했다.
- `inspect.clearance`의 unchecked("boolean Intersect: no result")를 '탭 물림'으로 읽어 온 쌍 가운데 실제로는 탭이 없는 살을 뚫은 것이 있었다(이번 건, v2.8.8부터). unchecked 쌍은 상대 바디에 그 자리 구멍이 있는지(`body_topology` 원통 목록)까지 봐야 물림으로 판정할 수 있다 — 검도 · 체결 절차에 넣으면 좋겠다.
- 볼트가 한 컴포넌트의 여러 occurrence일 때 측정 표(서명) 키(`… (U7_CASSETTE:1/CB5-12_M05_7:2)`)와 체결 목록 이름(`CB5-12_M05_7:2`, 옛 것은 `CB5-16_M05_1_PNEU01_52`)이 서로 달라 `sigpatch --removed`에 두 이름을 다 줘야 했다.
