hyeunung/FSAP/docs/reports/mechanism/mech_M02R_model.md

# M02R 모델링 4회차 — U4 그네 잔재 정리(스프링 탭 볼트·빈 컴포넌트·팔에 떨어진 조각) (모델링부, 2026-11-13)

요약(10줄 안):
- 저장: `3D_Modeling/FSAP_v2.13.0.sc` → **`FSAP_v2.14.0.sc`**(컴포넌트 22개가 없어져 가운데 자리 +1, E-05). 통로 MCP(앱), 저장본 확인만 CLI. `tools/config.json` doc·`tools/machine.json`·서명 표·체결 목록 고침.
- ① 스프링 탭 볼트 `CB5-12_M02S_BASE_5~8` X −302·−288·−192·−178 → **−307·−283·−197·−173**(s±12), 탭 `P_M02S_SPRING_TAB_1·_2` 날개 X s±12 → **s±16.5**(33 × 20 × t4), 탭 구멍 Ø5.5·base M5 탭 4개도 같은 자리(피처 정의를 고쳐 메운 자국 없음). 윗고리 ↔ 볼트 머리 **틈 1.75·2.75 mm, 겹침 0**.
- ② 옛 크랭크 U4 빈 컴포넌트 **21개 + `CB5-12_M02_2` = 22개 지움**(컴포넌트 704 → 682, 피처 3,742 → 3,717). `joint.list` **floating 0·errors 0·conflicts 0**.
- ③ 팔에 떨어진 조각의 원인은 '메움·탭 피처를 들림 자세(13.006°)에서 θ0 좌표로 만들어 13° 빗나간 것'이었다. 메움 4개·옆판 P 탭 2개를 θ0 좌표로 바로잡고, 탭이 없는 ARM_TIE 메움 2개는 지웠다. `P_M02_ARM_SIDE_N·_P·ARM_TIE` **셸 3·2·3 → 1·1·1**, 타임라인 'joined piece doesn't touch' 5건 없어짐(경고 61 → 55, 오류 0).
- 같이 드러나 고친 것: 옆판 P에 그네 볼트 `CB5-16_M02S_1·_2`의 M5 탭이 없었다(빗나간 자리에 있었음) → 볼트 자리 (−300, Z 100)·(−166, Z 120)(θ0)에 탭이 생김. 옆판 P의 빗나간 메움 혹(그네 세운 판 자리로 튀어나옴)도 없어짐.
- 바뀐 바디는 10개뿐: 전 바디 3,195개를 다시 재서 서명 표와 대조, 나머지 3,185개 bbox ≤ 0.05 mm·부피 ≤ 1e-4 그대로.
- 손계산: 볼트 물림 8 mm(1.6d), 날개 가장자리 살 X 1.75·Y 7.25 mm, 탭 굽힘 3.4 MPa(SF 60). 그네 값은 팔 무게 모멘트 +2.25 N·mm → 접지 힘 +0.019 N(0.05 %): 회전 SF 1.013·1.047·1.079, 누름 SF 1.96, 들기 SF 1.79 그대로(자국 SF 두께 16은 1.0128 → 1.0124).
- 자세 검사: REST(13.006)는 앱에서 겹침 0. 3.751·0·0.95+STOP 20·−4.11은 저장본 CLI — 저장본 CLI에서 모두 겹침 0(5절).
- 미완·알릴 것: 날개 가장자리 살 1.75 mm < M-03 기본 2.5(예외 요청), 남은 빈 컴포넌트 20개는 조인트 받침·STEP 하위 노드·복사 원본(`CB5-12_M02_1`)이라 지우지 않음(2절).

## 0. 근거 규칙·번호

| 규칙 | 원문 | 이번 |
|---|---|---|
| E-05 | "이번 저장에서 새 컴포넌트(유닛·부품 묶음)가 생기거나 없어졌으면 가운데 +1·마지막 0", "이미 저장·커밋된 버전 파일은 덮어쓰지 않는다 … 예외는 앞 과제가 형상을 바꾸지 못하고 새 이름으로만 저장한 빈 버전(직전 번호와 형상이 같다)" | 컴포넌트 22개 없어짐 → **v2.14.0**. 지시 절차 2는 'v2.13.0에 그대로 save'라 했으나 v2.13.0은 RX-07 형상(IR1000 :2)이 든 저장본이라 빈 버전이 아니다 → 실행 규칙 3 "이미 있는 버전 파일은 덮어쓰지 않는다"대로 새 번호 |
| 결정로그 M02R-E03 | "빈 컴포넌트 21개 … 다른 과제로 미루지도 않는다. M02R 수정 회차에서 지운다" | 21개 모두 지움(+ 같은 성격 1개) |
| E-11 | "보이는 부품은 모두 접지·부모에 접지·리지드 그룹·조인트로 바닥(root)까지 이어져야 한다" | floating 2묶음 → 0. 옮긴 볼트 4개는 U4_WHEEL_N에 다시 강체(조인트 98231~98234) |
| M-01 | "상대 부품의 탭 또는 너트가 실제로 있음, 물림 ≥ 1.5d" | 탭 볼트 8 mm = 1.6d. 옆판 P의 그네 볼트 탭이 없던 것을 바로잡음 |
| M-03 | "구멍에서 바깥면까지 살은 2.5 mm 이상을 기본으로 둔다" | 지시 치수(s±16.5)로는 X 쪽 살 1.75 mm → 스스로 정하지 않고 예외 요청(E-14) |
| U-10 | "금지: 덧대기(국부 혹·귀) … 메운 구멍 자국" | 옛 탭을 메우지 않고 탭 피처의 자리를 고침. 옆판 P의 혹 없어짐. 메운 구멍은 판 면에 테두리 면이 남지 않음(면 수 31 → 23) |
| E-15 | "조인트·행정·유닛이 바뀌면 기계 정의를 같이 고친다" | 조인트·행정·상태 변화 없음. `machine.json` U4_WHEEL_N에서 없어진 부품 접두 4·컴포넌트 2만 뺌 |
| 실행 규칙 19 | 저장 전 조인트·스케치 숨김 | joints 587·sketches 298 숨김 |

## 1. 스프링 탭 볼트(지시 1)

먼저 잰 것(지시 "옮긴 자리가 RX-06·RX-08이 낸 구멍과 겹치지 않는지"): `P_M02_BASE`의 Y 50 줄 구멍은 X −302·−288·−232·−215·−192·−178·−150(모두 r 2.1). 새 자리 −307·−283·−197·−173에서 가장 가까운 남의 구멍은 (−215, 50)로 중심 거리 18(살 13.8), base 끝(X −330)까지 23. 주변 바디(bbox 5 mm 안): base, 스프링 윗조각, 그네, `P_RX06_CARRIAGE`, 관 U4_B·U6·RX08_B_U4, `P_RX08_STOP_BRKT`.

| 부품 | 전 → 후 | 방법 | 잰 값(v2.14.0) |
|---|---|---|---|
| `CB5-12_M02S_BASE_5·_6·_7·_8` | X −302·−288·−192·−178 → **−307·−283·−197·−173**(Y 50, 머리 Z 233~238) | 리지드 조인트 97861~97864 지움 → `occurrence.move` ±5 → U4_WHEEL_N과 `joint.rigid_group`(98231~98234) | bbox X −311.25~−302.75 · −287.25~−278.75 · −201.25~−192.75 · −177.25~−168.75, 부피 476.36 그대로 |
| `P_M02S_SPRING_TAB_1` | 판 X −307~−283(24) → **−311.5~−278.5(33)**, 볼트 구멍 Ø5.5 X −302·−288 → −307·−283. 다리(X −297~−293)·고리 구멍 Ø4.5 그대로 | `timeline.edit` Box330(97729)·Cylinder1351·1352(97732·97733) | 부피 2,146.35 → **2,866.35**(계산 2,866.31), 22.73 g, SUS304, 셸 1 |
| `P_M02S_SPRING_TAB_2` | 판 X −197~−173 → **−201.5~−168.5**, 구멍 −192·−178 → −197·−173 | Box332(97740)·Cylinder1360·1361(97743·97744) | 2,866.35, 셸 1 |
| `P_M02_BASE` M5 탭 4개 | (−302·−288·−192·−178, 50) → **(−307·−283·−197·−173, 50)**, Ø4.2 관통(Z 242~250). 옛 탭은 피처째 옮겨 남지 않음 | Cylinder1322~1325(97686~97689) | 면 재기: Ø4.2 중심 (−307, 50)·(−197, 50)·(−173, 50), 부피 380,841.9 → 380,844.1(+2.2 mm³, Box342 불리언 재시도 경고가 없어진 차이·서명 허용 안), 셸 1 |

틈(앱 `inspect.clearance`, REST): 윗고리 ↔ BASE_5 **1.75**, ↔ BASE_7 **1.75**, ↔ BASE_6 **2.75**, ↔ BASE_8 **2.75** mm(검도 때 0·겹침). 탭 ↔ 윗조각 1.0(그대로), 탭 ↔ base 0(맞닿음), 볼트 머리 ↔ 탭 0(좌면), BASE_7·_8 끝 ↔ `P_RX06_CARRIAGE` 밑면 0(Z 250 맞닿음 — 옛 자리에서도 같음, 볼트 끝 = base 윗면), 탭 2 ↔ 관 RX08_B_U4 7.0, 탭 1 ↔ 관 U6 18.5. 겹침 0. base ↔ 볼트 4쌍은 불리언 실패(나사부가 탭에 든 물림, 기준선)로 `unchecked`.

## 2. 빈 컴포넌트(지시 2)

큰 파일에서 피처 하나를 고치거나 지우면 그 뒤 피처를 모두 다시 계산한다(실측: Box330 고침 1번에 뒤 235개·130 s, 앞쪽 피처면 약 30분). 그래서 **타임라인 마커를 가장 앞 피처(위치 277, `CDM2C20-25Z` import) 앞으로 내려 놓고**(`timeline.rollback`, 0.3 s) 고침·지우기를 모두 한 뒤 한 번만 끝까지 올렸다. 마커 뒤에서는 `timeline.edit` 1.4~4.2 s, `component.delete` 0.6~1.9 s. 지시의 '사본에서 1개 시간 재기'는 이 방법에서 1.4 s로 재서(첫 `component.delete`) 나머지 12개를 한 번에 보냈다.

| 지운 것 | 내용 |
|---|---|
| 옛 바디를 지운 피처 | `Remove83`(97670, 옛 U4 구매품 바디 21개) — 지시대로 먼저 `timeline.delete` |
| 옛 관 피처 | `SK_TU0604_M08P_U4C_B_M02R`·`Pipe107`·`BodyTransfer549`, `SK_…U4C_A_M02R`·`Pipe108`·`BodyTransfer550`(97620~97622·97625~97627) |
| 컴포넌트 21 | `CDM2C20-25Z`(밑 `U4_CYL`·`U4_CYL_CLEVIS`·`U4_ROD`·`U4_ROD_NUT`·`KQ2L06-01AS_M08_U4_1·_2`·`TU0604_M08P_U4C_A·_B`), `I-020B_M02`, `CB5-16_M02R_1~4`, `CB5-20_M02R_1·2`, `CB4-12_M02R_CLV·_CRK`, `CB4-12_M02_PIV`, `CB5-12_M02_PIV`, `CB5-16_M02_10` — import 피처 15개와 리지드 조인트 16개가 함께 없어짐 |
| 같은 성격 1 | `CB5-12_M02_2`(M02R 1회차 빈 컴포넌트, 설명 "empty component kept - delete refused"). `Remove76`의 대상에서 빼고(`P_M02_CYLBRKT`·`CB5-12_M02_1`만 남김) 지움 |

결과: 컴포넌트 704 → 682, occurrence 2,944 → 2,921, 조인트 604 → 587(없어진 17 + 볼트 4 다시), dof 2,945 → 2,922, `joint.list` floating **[]**·errors **[]**·conflicts **[]**, 구동 조인트 값 변화 0, 동작 연구 9개 그대로.

남은 '바디 0' 잎 컴포넌트 20개(지우지 않음):

| 이름 | 수 | 왜 남겼나 |
|---|---|---|
| `WP_L_X·_Y`, `WP_S_X·_Y`, `WP_G_X·_Y`, `WP_V_X·_Y`, `U7_CST_STAGE`, `U7_TAPE` | 10 | 조인트 사이 받침(매트 X·Y·회전, 카세트 X·Y). 지우면 동작이 끊김 |
| `2026_11_03_12_31_49_0588` 등 | 8 | 받은 STEP(케이블 베어)의 하위 조립 노드 |
| `SS5Y3-20-06_M08` | 1 | U6S(v2.9.0)가 phantom으로 둔 것 — 이 과제 범위 밖 |
| `CB5-12_M02_1` | 1 | M02R 1회차 잔재이나 `Move1`(4708)이 이 바디를 복사해 `CB5-12_DC205`를 만든다. 지우면 그 볼트가 없어짐 → 디테일 후보(DC205를 따로 넣고 지우기) |

## 3. 팔에 떨어진 조각 RX-06-C1(지시 3)

원인: 다섯 피처는 모두 U4_PRESS(컴포넌트 32) 안의 '구멍 메움'이다. 지시 좌표는 θ0(J_U4_PRESS 0) 기준인데 피처가 들림 자세에서 만들어져, 컴포넌트 좌표로는 축이 (0, 0.974, 0.225)(= 13.006°)로 기울고 자리가 빗나갔다(v2.13.0 실측: 옆판 N의 r 9 구멍은 θ0 (−300, Y −37~−31, Z 70)인데 메움은 (−300, −17.2, 36.5)). 같은 때 만든 옆판 P 메움 1개·탭 2개도 같은 식으로 빗나가 있었다. U4_PRESS 컴포넌트 좌표 = θ0 세계 좌표(실측으로 확인)라 정의를 θ0 값으로 고쳤다.

| 피처 | 대상 | 전(컴포넌트 좌표) → 후 | 결과 |
|---|---|---|---|
| Cylinder1208(97613) r 4.6 h 6 | ARM_SIDE_N | 밑 (−160, −28.9, 87.1)·축 기움 → **(−160, −37, 122)·축 +Y** | r 4.5 구멍(옛 핀 구멍, 쓰는 부품 없음) 메워짐 |
| Cylinder1213(97614) r 4.6 h 6 | ARM_SIDE_P | (−160, 37.3, 102.4) → **(−160, 31, 122)·+Y** | r 4.5 구멍 메워짐. 빗나간 메움은 옆판 바깥(θ0 Y 37.3~43.3)으로 튀어나온 혹이었고 X −164.6~−161 구간이 그네 세운 판(Y 37~45, X −320~−161) 자리와 겹쳤다(좌표 계산, 같은 컴포넌트라 검사에 안 잡힘) → 없어짐 |
| Cylinder1314(97678) r 9.05 h 6 | ARM_SIDE_N | (−300, −17.2, 36.5) → **(−300, −37, 70)·+Y** | 옛 부시 구멍 r 9 메워짐 |
| Cylinder1315(97679) r 9.05 h 6 | ARM_SIDE_P | (−300, 49.0, 51.8) → **(−300, 31, 70)·+Y** | 옛 부시 구멍 r 9 메워짐 |
| Cylinder1316·1317(97680·97681) r 2.15 h 12 | ARM_TIE | **지움** | ARM_TIE에는 크랭크 탭이 없다(원통 면은 길이 62 r 2.1 하나뿐) → 메울 것이 없는 잔재 |
| Cylinder1328(97692) r 2.1 빼기 | ARM_SIDE_P | (−300, 48.2, 82.4) → **(−300, 37.1, 100)·−Y** | `CB5-16_M02S_1`의 M5 탭(전에는 살을 못 만나 없었음) |
| Cylinder1329(97693) r 2.1 빼기 | ARM_SIDE_P | (−166, 43.7, 101.9) → **(−166, 37.1, 120)·−Y** | `CB5-16_M02S_2`의 M5 탭 |

| 바디 | 셸 | 부피 mm³ 전 → 후(계산) | 질량 g | 원통 면 |
|---|---|---|---|---|
| `P_M02_ARM_SIDE_N` | 3 → **1** | 77,694.36 → 77,660.19(77,660.19) | 615.85 | r 2.75 ×3, r 3 ×2(r 4.5·r 9 없어짐) |
| `P_M02_ARM_SIDE_P` | 2 → **1** | 77,685.37 → 77,494.02(77,493.94) | 614.53 | 위 + M5 탭 r 2.1 ×2: REST 좌표 (−300, 24.28, 121.06)·(−166, 28.78, 140.54), 축은 그네 구멍 Ø5.5와 같은 선 |
| `P_M02_ARM_TIE` | 3 → **1** | 24,816.02 → 24,467.55(24,467.50) | 65.57 | r 2.1 길이 62 하나 |

앱 `inspect.clearance`(팔 3 ↔ 그네·FRONT·센서 브래킷·감속기·모터·볼트 19바디, REST): 새 겹침 0. 옆판 P ↔ 그네 0(맞닿음). `ARM_SIDE_N ↔ P_M02_FRONT` 0.17 mm³(면 1,513 mm²에 걸친 맞닿음 수치 잔차, X −132~−120 — 이번에 안 바꾼 자리). 옆판 P ↔ `CB5-16_M02S_1·_2`, TIE ↔ `CB5-16_M02_9`·`CB5-20_M02S_1`은 나사부 물림이라 불리언 실패 `unchecked`(기준선).

## 4. 저장 전 검사(E-22, 수치)

| 항목 | 결과 |
|---|---|
| 타임라인 | 피처 3,742 → 3,717(지운 25: import 16·관 6·Remove83·메움 2), 오류 0, 경고 61 → 55(없어진 것: doesn't touch 5 + Box342 불리언 재시도 1). 남은 doesn't touch 1건은 `P_M05_FEED_CARR`(Box132, 이 과제 밖) |
| 전 바디 대조 | 3,195개 `measure`(요약) ↔ 서명 표: 다른 것 **10**(탭 2·볼트 4·팔 3 + base 부피 +2.2 mm³), 나머지 그대로. 바디 수 882 그대로(없어진 컴포넌트는 바디 0이었음) |
| 숨김(E-11) | 숨긴 바디 97(전과 같은 목록: 매트·테이프·이음매 모형), 숨긴 occurrence 0 |
| 리지드·안 묶인 부품 | floating 0, errors 0 |
| 재질(E-09) | 바뀐 가공품: 탭 SUS304·팔 옆판 SUS304·TIE A5052·base SUS304 — BOM 재질과 같음. `matcheck` 불일치 2건은 전부터 있던 이름 표기 차이(`Urethane_A70` ↔ '우레탄 A70', 바퀴 트레드 2), 'BOM에 없는 부품' 탭 2·`P_M04_INSERT`는 문서 담당 몫 |
| 조인트 자기 점검 | 구동 조인트·행정·연구는 안 바꿈(값 차이 0). 옮긴 볼트 4개는 U4_WHEEL_N 강체(J_U4_X를 따라감) |
| 볼트(바꾼 것만) | 5절 손계산. 렌치: 머리가 아래(Z 233), 아래 그네 윗판까지 약 80 mm — 전과 같음. 새 자리에서 머리 옆 윗고리까지 1.75 mm라 L렌치는 밑에서 곧게 꽂는다(디테일: 렌치 접근 프로브는 체결부) |
| 저장 | 대기 자세(`motion.play REST 0`, moved false) → 조인트·스케치 숨김 → 루트 이름 `FSAP_v2.14.0` → `save {path}`. 저장 뒤 앱 `dirty false`·경로 v2.14.0. 저장본 `document.json` 직접 대조: 피처 3,717·컴포넌트 681(+루트)·조인트 587, 조인트 값 차이 0, occurrence 변환이 바뀐 것은 볼트 4개뿐, 연구 9개 같음 |

## 5. 손계산(완료 판정 ④·⑤) — `tools/out/mech_M02R/handcalc6.json`

| 항목 | 값 | 판정 |
|---|---|---|
| 볼트 물림 | CB5-12: 머리 5 + 탭 판 t4(Ø5.5 통과) + base t8 M5 탭 → **8 mm = 1.6d** | ≥ 1.5d(M-01) |
| 날개 가장자리 | 볼트 중심 → 날개 끝 4.5 mm, 구멍 Ø5.5 살 **X 1.75**·Y 7.25 mm. 머리 Ø8.5는 날개 안(여유 0.25) | 살 1.75 < M-03 기본 2.5 → 예외 요청. 볼트는 인장만 받아 찢김 하중 없음 |
| 머리 ↔ 윗고리 | 머리 안쪽 끝 s±7.75, 고리·몸 s±6 → **1.75 mm**(CAD 1.75·2.75) | > 0 |
| base 탭 | 가장 가까운 구멍 (−215, 50) 살 13.8, 끝까지 23 | - |
| 탭 굽힘 | 스프링 하나 최대 30.4 N(내림 끝 합 60.8), 볼트 사이 24 단순보 가운데 하중: M 182 N·mm, Z 53.3 mm³ → **3.4 MPa**(전 14 스팬 2.0), SUS304 205 → SF 60 | 여유 큼 |
| 볼트 인장·나사산 | 볼트당 15.2 N → 1.1 MPa(SF ≈ 900), base 나사산 전단 0.24 MPa | - |
| 그네 값(⑤) | 스프링 닿는 자리(탭 다리·고리 구멍·그네 귀) 그대로 → 스프링 힘 변화 0. 팔 3바디 질량 616.12·616.05·66.51 → 615.85·614.53·65.57 g, 축 둘레 무게 모멘트 **+229.7 g·mm(+2.25 N·mm)** → 접지 힘 **+0.019 N**(25.80 → 25.82 N) | 회전 SF 1.0127·1.0466·1.0789 → 1.0132·1.0471·1.0794(표기 1.013·1.047·1.079 그대로), 누름 SF 1.961 그대로, 들기 SF 1.79 그대로, 자국 SF(두께 16) 1.0128 → 1.0124 |

해석: 못 함 — 환경 없음(자료대기 D-16). 임시 STEP은 `tools/out/mech_M02R/stepout/`에 6개(탭 2·옆판 2·TIE·base).

자세별 과제 범위 검사(바뀐 9바디 ↔ 주변 21바디, `inspect.clearance`):

| 자세 | J_U4_PRESS | J_U4_STOP | 통로 | 겹침 | 가장 가까운 쌍(맞닿음 0 빼고) | truncated |
|---|---|---|---|---|---|---|
| 들림(REST) | 13.006 | 0 | 앱 MCP + 저장본 CLI | **0** | 팔 옆판 P ↔ CB5-20_M02S_1 0.25(통과 구멍), 탭 ↔ 윗조각 1.0, 윗고리 ↔ BASE_5·_7 **1.75**, ↔ BASE_6·_8 **2.75** | false |
| 두께 16 | 3.751 | 0 | 저장본 CLI | **0** | 위와 같음 | false |
| θ0(두께 10) | 0 | 0 | 저장본 CLI | **0** | 위와 같음 | false |
| 중간 높이 스토퍼 | 0.95 | 20 | 저장본 CLI | **0** | 위와 같음 | false |
| 내림 끝 | −4.11 | 0 | 저장본 CLI | **0** | 위와 같음 | false |

- 저장본 `FSAP_v2.14.0.sc`에 대고 `solidcraft-cli run cli_pose.json --results`(저장 안 함) 한 번: 열기 약 13분, 명령 13단계 118 s(`joint.drive` 0.1~0.2 s, `inspect.clearance` 23 s씩). 대상 9바디(탭 2·볼트 4·팔 3) ↔ 21바디(base·스프링 위아래 조각 4·그네·캐리지·관 4·RX08 브래킷·블록·볼트·너트·피벗 브래킷 2·실린더 브래킷·그네 볼트 3), 자세마다 35~36쌍.
- 자세가 바뀌어도 가까운 쌍이 같다: 탭·볼트·윗고리는 모두 U4_WHEEL_N(고정 쪽)이고, 움직이는 그네·아래 스프링 조각은 어느 자세에서도 탭·볼트에서 3 mm 밖이다. 팔 3바디는 U4_PRESS 안에서 구멍을 메운 것이라 바깥 틈이 바뀌지 않았다.
- `unchecked` 7쌍(자세마다 같음)은 모두 나사부가 탭에 든 물림(불리언 실패, 기준선): base ↔ BASE_5~8, 옆판 P ↔ CB5-16_M02S_1·_2, TIE ↔ CB5-20_M02S_1.
- 같은 호출의 `measure`로 저장 확인: 저장본의 탭·볼트·팔·base bbox·부피가 앱에서 잰 값과 같고, 안 바꾼 `P_M07_BEAM`(34,452,386)·`P_M02S_SWING`(279,581.8)·`P_M02_WHEEL`(197,622.3)도 그대로.
- 전 사이클 `motion.interference`는 돌리지 않았다(E-17 과제 안 검사 범위, 라운드 끝 회귀 몫).

## 6. 고친 기록·다시 만들기

- 생성기 `tools/gen_m02r_cleanup.py` → `tools/out/mech_M02R/model6/stage_0~6.json`, `edit.json`(48단계), `edit_meta.json`(base v2.13.0 → result v2.14.0). 옛 3회차 기록은 `edit_v2103.json`·`edit_meta_v2103.json`.
- `tools/machine.json`: 유닛 U4_WHEEL_N parts에서 `CDM2C20-25Z_`·`I-020B_M02`·`KQ2L06-01AS_M08_U4`·`TU0604_M08_U4C`, components에서 `U4_CYL`·`U4_ROD`를 뺌(없어진 컴포넌트). 조인트·상태·연구 변화 없음.
- 서명 `tools/out/signatures.json`: 바뀜 10·없어짐 0(sigpatch, 저장본 해시 기준, sigcheck reuse), 체결 `tools/out/bolts.json`: BASE_5~8 자리 고침.
- 측정 원본: `tools/out/mech_M02R/model6/measure_all_after.json`·`jointlist_after.json`·`complist_after.json`·`cli_pose_out.json`.

## 미완

- 지시·완료 판정 항목 가운데 못 끝낸 것 없음.
- 해석: 못 함 — 환경 없음(자료대기 D-16). 강도는 5절 손계산, 임시 STEP 6개만 냄.
- 스크린샷: 저장하지 않음(카메라 지정 렌더가 엉뚱한 곳을 잡아 지움, 외관은 사용자가 앱에서 봄 — v2.14.0이 앱에 열려 있음).
- BOM·설계검토서·결정로그·CHANGELOG·요구서 5절 M02R 칸은 문서 담당 몫(BOM에 탭 2개가 없음, 옛 U4 구매품 21개 줄 정리).

## 디테일로 남긴 것(E-02, 수정 회차 안 씀)

| 번호 | 내용 | 근거 | 고칠 안 |
|---|---|---|---|
| M02R-D1 | 탭 날개 볼트 구멍 살 X 1.75 mm < M-03 기본 2.5 | 날개 s±16.5, 구멍 Ø5.5 @ s±12 | 날개 s±17.25 이상(예외 요청에 올림) |
| M02R-D2 | 빈 컴포넌트 `CB5-12_M02_1`(복사 원본) | `Move1`(4708) copy → `CB5-12_DC205` | DC205를 실물 STEP으로 따로 넣고 원본 지우기 |
| M02R-D3 | 옛 부품을 만든 피처가 타임라인에 남음(P_M02R_CYLBRKT·CRANK 등 + Remove76·82, 옛 U4C 관 Pipe20·21·63·64) | 바디는 없음, 열기 시간만 차지 | 디테일링 때 마커를 내려 한 번에 지움(이번 방법) |
| M02R-D4 | 설계 속성 description이 RX-06 문구 그대로 | `document.metadata` | 다음 저장 때 고침 |
| M02R-D5 | 그네 볼트 `CB5-16_M02S_1·_2`의 옆판 P 물림 6 mm = 1.2d < 1.5d(M-01) | 옆판 t6에 M5 탭, 볼트는 그네 판 t8을 지나 옆판을 2 mm 넘김 | 옆판 안쪽에 너트 또는 탭 자리 두께 7.5 이상 |

## 워크플로우 메모

- 지시 절차 2('직전 과제가 형상을 바꾸지 못하고 새 이름으로만 저장 → 그대로 save')가 실제와 달랐다(v2.13.0은 RX-07 형상이 든 저장본, '이미 됨' 판정은 저장을 하지 않음). RX-07 모델링 보고서 메모와 같은 문제 — '이미 됨'으로 건너뛴 과제 뒤에는 '빈 버전' 문구를 넣지 않아야 한다.
- 큰 파일의 타임라인 고침은 '마커를 내리고 → 고침·지우기 → 한 번에 올리기'가 맞다. 마커 뒤에서는 고침·지우기가 1~4 s이고 다시 계산은 한 번(이번 30~35분, 피처 약 3,440개)이다. 피처마다 다시 계산하면 꼬리 235개 130 s, 앞쪽 피처는 한 번에 약 30분이라 13개 지우기가 몇 시간이 된다(M02R-E03 시험이 30분 상한을 넘긴 이유). 안내서 'MCP 편집 묶음'에 이 방법이 있으면 좋겠다.
- `timeline.dependents`는 읽기 명령처럼 보이지만 피처마다 뒤를 다시 계산해 보는 듯하다: 3개를 넣은 batch가 약 16분 앱을 붙잡았다(MCP 응답은 5분에 끊김). 큰 파일에서는 쓰지 말고 저장본 `document.json`(.sc는 zip)을 읽어 참조를 찾는 편이 빠르다(이번에 그렇게 함).
- 조인트로 움직이는 컴포넌트 안의 바디에 세계 좌표로 피처를 만들 때는 그때의 자세가 좌표에 들어간다. M02R 3회차는 θ0 좌표를 들림 자세에서 넣어 메움·탭이 13° 빗나갔고, 같은 컴포넌트 안이라 `skip_within: component` 검사에 잡히지 않았다. 움직이는 유닛에 피처를 넣는 지시서는 '컴포넌트 좌표'로 쓰거나, 넣은 뒤 구멍·보스 위치를 `body_topology`로 확인하는 단계가 있어야 한다.
- `joint.delete`·`joint.rigid_group`·`motion.play` 응답에 전 조인트 dof·값 목록이 붙어 호출마다 90~600 KB다. `verbose: false`로도 줄지 않는다.
