hyeunung/FSAP/docs/reports/mechanism/mech_RX-06_design1.md

# RX-06 설계안 수정 1회차 — 못 본 관 U5_A·U5_B·U7_6 틈 확인 (기구설계부, 2026-11-12)

요약(10줄 안):
- 고친 자리: 지난 안 4-2 '못 본 것'(관 TU0604_M08P_U5_A·U5_B·U7_6_A·U7_6_B ↔ BSW20·BUN20·나사·손잡이·캐리지). 형상·좌표·형번은 **바꾸지 않음**(지난 안 `mech_RX-06_design.md` 그대로).
- 확인 방법: 관 중심선(PNEU-01 생성기 기록 `tools/out/mech_PNEU-01/model/tubelog.json`)을 CAD 실물과 맞춰 봄 — U5_B 모서리 중점 (5.8, 179.0, 680.0)·(20.0, 185.0, 680.0) = 중심 (Y 182, Z 680) ± r 3, U7_6_A bbox 다시 잼 X ≥ −70.56(측정 표와 같음). 그다음 손계산.
- 결과: U5_A ≥ 129.5, U5_B ≥ 116.8, U7_6_A·B(·_L) ≥ 23.4(X 방향만으로 하한). 겹침 0, 그래서 모델링 뒤 CLI 관 검사는 필요 없음.
- 9점 검사 지시에서 'U5_A·U5_B·U7_6 CLI' 줄을 뺌(19분짜리 검사를 줄임). 나머지 9점 검사는 그대로.
- CAD: MCP 읽기 3번(running·body_topology·measure), 편집·자세 바꾸기 없음, 저장 0.
- 아직 남은 것(지난 안과 같음): 구매품 값은 임시(provisional), 가격 미확인. M02R '일부' — 모델링은 v2.11.0 뒤에.

## 1. 안 되는 곳과 고친 것

| 회차 | 자리 | 전 → 후 | 이유 |
|---|---|---|---|
| 1 | 4-2 못 본 관 4개 | '못 봄 → 모델링 뒤 CLI 9점 검사' → **틈을 계산으로 확인(U5_A 129.5 / U5_B 116.8 / U7_6 ≥ 23.4), 겹침 0** | 관 bbox가 커서(X −1313~1105) 새 부품 자리와 겹쳐 보였을 뿐. 실제로 그 X 구간을 지나는 것은 곧은 관 한 토막(보 위 Z 677~693)이고, U7_6은 X −70.6보다 −X로 오지 않는다 |
| 1 | 7절 지시 9 | 'U5_A·U5_B·U7_6_A·U7_6_B ↔ BSW20·BUN20·나사·손잡이는 CLI로' 줄 → 지움(근거는 이 보고서 2절) | 같은 쌍을 다시 잴 필요가 없다(E-19 같은 것은 가장 불리한 하나만, E-17 바뀐 범위로 검사) |

## 2. 관 길과 틈 (측정 좌표계)

새 부품이 차지하는 구간(지난 안 2절): X −445~−94, Y 42~120, Z 250~577.5. 움직이는 캐리지는 Y 45~107, Z 250~565이고 −X로만 움직인다(X −335~−125). 가장 위·뒤 모서리는 BSW20·BUN20 + 스페이서의 (Y 120, Z 577.5)이다.

| 관 | X −445~−94 구간 중심선 (tubelog, CAD로 확인) | 가장 가까운 새 부품 모서리 | 최소 틈 |
|---|---|---|---|
| TU0604_M08P_U5_A | X 1060 → −960 곧은 관, (Y 190, Z 690), r 3. 굽힘은 X 1060 쪽과 X −960~−1306 쪽뿐 | (Y 120, Z 577.5) | √(70² + 112.5²) − 3 = **129.5** |
| TU0604_M08P_U5_B | X 1060 → −960 곧은 관, (Y 182, Z 680), r 3. CAD 모서리 중점 Y 179.0·185.0, Z 680.0 | (Y 120, Z 577.5) | √(62² + 102.5²) − 3 = **116.8** |
| TU0604_M08P_U7_6_A·_B·_A_L·_B_L | 관 전체가 X ≥ −70.56(CAD bbox, 측정 표 −70.56·−70.34·−70.30) | BUN20 +X 면 X −94 | ≥ **23.4**(X 방향만으로 하한. 실제로는 Z 660 이상 vs 577.5라 더 큼) |

- U5_A·U5_B는 보 P_M07_BEAM(Y 120~320, Z 250~650) 윗면 위(Z ≥ 677)를 보 폭 안(Y 179~193)에서 지난다. 새 부품은 모두 보 앞(Y ≤ 120)·보 윗면 아래(Z ≤ 577.5)에 있어서 사이에 보가 있다. J_U4_X 0~95, J_U4_PRESS 세 자세 어디에서도 새 부품의 Y·Z 범위는 바뀌지 않으므로(X 직동만) 9점 모두 같은 틈이다.
- bbox가 크게 나온 이유: U5_A의 Y −0.66·Z 283.5는 X 1060 쪽 세움 구간(tubelog (1060.25, 3, 286.4~690))이고, Y 253.6은 X −1306 쪽 끝(Y 250)이다. 둘 다 새 부품 X 구간 밖.
- CAD 확인(MCP 읽기, 열린 v2.10.4 세션): `running` → 비어 있음, `body_topology TU0604_M08P_U5_B` → 모서리 4개의 시작·끝·중점이 tubelog 꼭짓점 (1060.25, 63, 370.6)·(−1222.5, 250, 673)과 맞음, `measure TU0604_M08P_U7_6_A` → bbox min X −70.5596(측정 표와 같음). 편집과 자세 바꾸기는 하지 않아서 원복할 것이 없다(동작 상태는 측정부가 끝낸 REST 그대로).

## 3. 완료 판정 (지난 안 값 + 이번 확인)

| 항목 | 판정 | 근거 |
|---|---|---|
| d₁ 조절 범위(근거) | 만족 | 100~195(행정 95). 아래 100은 DC2-06·헤드 상자 틈 7.5, 위 195는 DC-03 d₁ ≥ 193을 덮음, V d₂ 440에서 U5 틈 10.5 |
| 전 범위 × 들기·누름 자세 과제 범위 간섭 0 | 만족(설계 좌표) | 고정 이웃 틈 ≥ 4.55. 겹침 L_6·관 U6·U4_A2·U4_B는 옮기도록 지시함. **이번에 관 U5_A 129.5·U5_B 116.8·U7_6 ≥ 23.4 확인**. 모델 위 9점 확인은 모델링부(지시 9) |
| 레일·볼나사 하중 손계산 | 만족 | 블록 157.3 N(SF 12.7, C0 임시 2 kN), 역구동 0.059 N·m, 손 힘 2.9 N |
| BOM | 만족(임시값) | 지난 안 8절 stepcheck 표 그대로. 손잡이 STEP대기_, 가격 미확인 |

## 4. 규칙 대조 (E-14)

- E-19 "같은 것은 묶어 가장 불리한 하나만": 관 4개 중 가장 가까운 쌍(U7_6 X 23.4, U5_B 116.8)만 계산하면 된다.
- E-17 "검증 원장과 바뀐 범위로 검사 범위를 정한다": 관은 이번 과제에서 바뀌지 않았고 새 부품의 Y·Z 범위는 X 위치와 관계없으므로 9점 모두 같은 값이다.
- 나머지 규칙 점검은 지난 안 5절 그대로(바뀐 형상 없음).

## 5. 모델링 지시서 바뀐 곳

지난 안 7절 1~8, 10, 11 그대로. **9를 다음으로 바꾼다:**

9. **검사(모델링부, 과제 범위):** J_U4_X 0·47.5·95 × J_U4_PRESS 13.006·0·−4.11 = 9점에서 U4_XCAR·U4_XAXIS·U4 묶음 ↔ 이웃(보·U5(J_U5_X 1360 = V)·옮긴 관 U6·U4_A2·U4_B·클램프 L_5·L_6·F_5·헤드 상자) 겹침 0. 관 U5_A·U5_B·U7_6_A·U7_6_B는 이 보고서 2절에서 틈 ≥ 23.4로 확인했으므로 검사에서 뺀다. 단, 모델링 중 이 관들의 길을 바꿨으면 다시 잰다.

## 워크플로우 메모

- 관(스윕 바디) bbox는 길 전체를 덮어서 공간 판정에 쓰기 어렵다. 관 생성기 기록(tubelog)의 중심선을 측정 표 옆에 두면 측정부·설계부가 관 하나 19분 걸리는 `inspect.clearance` 없이 판정할 수 있다.
- `body_topology faces:"cylinders"`는 스윕 관에서 빈 배열을 준다(면이 원통으로 분류되지 않음). 모서리 중점으로 중심선을 확인했다.
