hyeunung/FSAP/docs/reports/mechanism/mech_SIM-01_donecheck1.md

# SIM-01 완료 판정 확인 1회차 — 원칙 감사 (2026-11-11)

요약(10줄 안):
- 대상 설계안 SIM-01-A 수정 1회차(`mech_SIM-01_design1.md`), 측정 `mech_SIM-01_measure.md`, `tools/out/mech_SIM-01/unwind.json`·`anim_probe/CYCLE_L.gif`(9,826 bytes 있음 확인). CAD 사용 0, 파일 열기 0.
- 판정: **ok = true**. 완료 판정 4항목 모두 설계안 근거 수치로 다시 계산해 맞음.
- 다시 계산: 비틀림 가장자리 늘어남 0.505 %(≤ 1 %, D-169), 출구 장력 2·e^(0.3·7.16) = 17.14 N(+6 % → 18.1 N ≤ 20 N, SF 1.66), 필렛 접선 3·tan31° = 1.80 ≤ 면 높이 2.0(R 상한 3.33), 풀림 차 0.68 mm/mm × 22.06 / 5,960 = 0.252 %(≤ 1 %, D-168).
- 간섭 항목은 프레임 고정 줄(측정 S1+S2·S3B·TAPEWAY_V·설계 프로브 TWIST·LOW·FEED 겹침 0) + 조각 = 전체 TAPE_* 부분집합 논리로 성립. 전 단계 CLI 확인은 모델링 지시서 7항(U5 포함 against, 숨김 켜기, truncated 확인)으로 정해짐.
- 남길 주의(고칠 것 아님): ① D-167 근거는 카탈로그가 아니라 제품 접힘 R≈3 유추 — 테이프 기종(D-06) 정해지면 확인 ② TL_FEED↔매트 회전 중 기준선은 TL_FEED 바디(225 mm³) 안으로 한정 ③ 영상 300 samples의 호출 시간 어림이 없음 — 8분 넘으면 samples를 나눠 부를 것(E-04).
- 미완(모델링·검도 몫): 전 단계 motion.interference, 영상 10개 생성·첨부.

## 1. 항목별 확인

| 완료 판정 항목 | 설계안 근거 | 다시 계산·반박 시도 | 판정 |
|---|---|---|---|
| CYCLE_L·S·G1·G2·V 전 단계 테이프 줄·붙은 테이프 ↔ U4·U5 바퀴·슈·대차·묶음·매트 간섭 0 | 줄 프레임 고정(J_U7_FEED·CUT·TUCK·CST·HGT 사이클 중 0), 가장 불리 SHIFT 0에서 겹침 0, 최소 틈 HOLDER 1.5·바인더 0.77·캐리지 3.2·바늘판 홈 0.4·바늘 0.7. 붙은 조각 ⊂ TAPE_*, 대기 Z 2000 | 위 구간 롤→G1→TOP은 측정 S1+S2 겹침 0(롤 0.002·TOP 롤러 0.004). 대기 조각 Z 2000 − 최고점 915.5 = 1,084.5 띄움. U5 바퀴 X ≤ −400은 줄(X ≥ −11)과 멀지만 **붙은 테이프와는 같은 매트 위**라 측정 4자세 against에서 빠져 있었음 — 그러나 조각은 기존 전체 띠의 부분집합이고 U5 누름 키는 이미 띠 기준(FLOAT 11 = 테이프 위, VGR-01에서 띠 1 mm 겹침을 찾아 고친 기록, machine.json `_u5_far_off`)이라 조각으로 나누면 겹침은 줄기만 함. 지시서 7항 against에 U5 바퀴·대차가 들어 있음. 바디 수: 조각 약 117 + SEAM, 연구당 occurrences 약 45 + against ≤ 80 → 190 아래 | 맞음(전 단계 CLI 수치는 모델링·검도에서) |
| 안내점 꺾임각 ≤ 기준(새 D-번호, 테이프 카탈로그·문헌 근거) | D-167: 굽힘 R ≥ 3(안쪽 면) + 출구 장력 ≤ 20 N. G1 r19·TOP r19·가이드 출구 필렛 R3 | 각도만으로는 굽힘 정도가 정해지지 않으므로 반지름 기준으로 바꾼 것은 타당. 필렛 R3: 접선 3·tan31° = 1.80 ≤ 면 23 높이 2.0, 상한 2/tan31° = 3.33. 장력 2·e^(0.3·7.16) = 17.14 N, 롤러 핀 +6 % → 18.1 N ≤ 30/1.5 = 20 N, SF 1.66(롤러 감김까지 고정면 마찰로 넣어 보수적). 근거는 카탈로그가 아니라 제품 접힘(가장 얇은 매트 6 → R≈3) 유추 — 테이프 기종 D-06 미정이라 카탈로그를 받을 수 없고 D-167 '받을 것'에 테이프 판매처 최소 굽힘 반지름이 적혀 있음(E-12) | 맞음(근거 확인 대기는 D-167) |
| 롤 풀림량–봉제 길이 차 ≤ 기준(새 D-번호, 임시 1 %) | D-168 ≤ 1 %, ≤ 0.25 % | dR = 5,960/(2π·43) = 22.06(빈 심 L 매트, 가장 불리), 경간 변화 0.68 × 22.06 = 15.0 mm → 0.252 %. R150에서 0.072 % | 맞음 |
| 사이클 영상(화면 캡처 연속) 보고서 첨부 | 지시서 8항: 연구 5 × (GIF + 바늘 근처 PNG 프레임), samples = min(단계+1, 300), 합격 frames·bytes·stopped null, CYCLE_L 시험 GIF 3프레임 | 시험 파일 `tools/out/mech_SIM-01/anim_probe/CYCLE_L.gif` 9,826 bytes 있음. 명령·경로·카메라·합격 조건이 실행 가능하게 정해짐. 시험 호출 시간이 기록되지 않아 300프레임 호출이 E-04 "한 번의 도구 호출은 8분 안"을 넘을지 모름 → 넘으면 samples를 나눠(또는 백그라운드) 부르면 됨, 형상과 무관 | 맞음(생성·첨부는 모델링 산출물) |

## 2. 주의(problems 아님, 모델링·검도 참고)

- TL_FEED ↔ WP_MAT_* 회전 중 겹침을 기준선으로 둔 것: 강체 테이프 모형의 한계(유연 거동은 요구서 7절, CLAUDE.md "모델로 판정하지 않고 7절에 기록만")로 타당. 기준선은 TL_FEED 바디(X −2.5~7.5 · Y −9~−1.5 · Z −1~11, 225 mm³)와 그 연구 매트 쌍에만 걸고, 단계별 최대 부피를 기록한다. 다른 TL_*↔매트 겹침은 기준선이 아니다.
- 영상: 시험에서 1프레임당 시간을 재어 300 samples 호출이 8분을 넘으면 연구를 단계 범위로 나눠 내보낸다.

## 3. 규칙 근거

- E-02 "구동부 → 브래킷 → 디테일": 볼트·두께는 보지 않음(새 볼트 0).
- E-12: 모르는 값은 자료대기 D-번호 임시값으로 계속 — D-167·D-168·D-169.
- E-16 "판정은 수치로만": 영상은 첨부물, 판정은 7항 수치.
- 실행 규칙 2·16: 긴 동작 간섭은 CLI, regrun 상한 30분 — 지시서 7항이 따름.
