hyeunung/FSAP/docs/reports/mechanism/mech_drive_check.md

# 구동 후보 점검부 — FSAP_v2.8.13 (2026-11-11, 엔진 v3.9.3)

요약
- 대상은 `3D_Modeling/FSAP_v2.8.13.sc`(config doc)다. 읽기만 했고 저장 0, 바뀐 부품 0이다. **CAD 호출 0, 파일 열기 0**(E-21). 지난 점검(v2.8.12) 사본은 `tools/out/mech_drive_check/mech_drive_check_v2812.md`에 있다.
- v2.8.12 → v2.8.13에서 바뀐 것
  - DC-04: 동작 연구 5개의 `J_U3_PRESSER` 키, machine.json states 13개·`_timing` 9곳. 형상·구매품·조인트·행정은 바뀌지 않았다.
  - DC-03: 문서만 고쳤다(C-38, L·G 모서리는 U4+U5 그대로).
  - BOM v2.8.12 ↔ v2.8.13 made·purchased diff 0.
- 지난 후보 2개는 닫혔다.
  - DC-03: 요구서 5절 '해결(문서만, v2.8.13)'.
  - DC-04: '해결 v2.8.13'. 바늘 옆힘은 노루발 없이 셈해도 ≤ 17.8 N ≤ 20 N, F4 ≤ 15.86 N ≤ 18 N, SF ≥ 1.009, 회전 자세 간섭 0.
- 새로 본 것은 C-39 '노루발 누름 2단'이 공압 밸브를 하나 더 부를 때 U8 밸브 묶음에 자리가 있는지다.
  - 지금 6스테이션이 모두 쓰이고 있다.
  - 매니폴드 +X 끝(1117)에서 가장 가까운 이웃까지 31 mm가 빈다(같은 Z 대역에는 이웃이 없다).
  - 스테이션 하나는 10.5 mm라 배치를 바꾸지 않아도 들어간다. 그래서 후보가 아니다.
- **구동 후보 0개.** 다섯 항목 모두 0이다.
- 넘길 것(후보 아님, 지난 점검과 같음): BOM 수량 어긋남 6행(문서 몫), D-155 체인 채움(전장 뒤), 회귀 21의 못 본 범위(동작 문제 확인 몫), DC04-D3 피벗 누름 실제값(D-10·7절).
- 미완: 없음. 외부 값은 D-10(바늘 굵기·피벗 누름 실제값·노루발 2단을 헤드가 낼지)과 7절(μ)이다. 새 외장 단계 과제는 없다.

## 1. 근거 규칙 (원문)
- 실행 규칙 13(E-02): "구동 라운드는 디테일링이 낼 만한 구동 후보도 미리 찾는다. 높이 사슬, 볼트 렌치 접근을 막는 배치, 구매품 수량·외형처럼 배치를 바꿔야 풀리는 것은 구동 단계에서 끝낸다."
- 실행 규칙 14(E-24): "옆·뒤 커버, 가드 판넬, 외장 판금, 정비 문은 구동 과제·구동 후보로 만들지 않는다."
- E-21: "다시 부르면 이전 결과 파일부터 읽고 남은 것만." E-16: "판정은 수치로만." E-17: 검사 범위는 "검증 원장과 바뀐 범위로" 정한다.
- 지시문(점검부): "기구 동작·배치를 바꿔야 고칠 수 있는 것만 candidates에 넣는다. 볼트 지름·두께 다듬기·과사양은 넣지 않는다(디테일링 몫)."
- C-38: "L 1500 모서리는 U4+U5 유지, U4 혼자는 U5가 매트 밖인 짧은 구간만".
- C-39: "회전(피벗) 중 노루발을 다 들지 않고 낮은 누름으로 둔다 … 꼭 들어야 하는 곳은 들고, 그때는 U4 혼자 회전 금지". 헤드 견적 조건(D-10)은 바늘 Nm ≥ 180~200, 옆힘 ≥ 20 N, 노루발 누름 2단이다.

## 2. 통로·바뀐 범위
| 과제 | 바뀐 것 | 앞 부서가 이미 잰 결과 |
|---|---|---|
| DC-03 (C-38) | 문서만. machine.json `_timing` CYCLE_L 모서리 7.5 s·CYCLE_G2 4.5 s(U4+U5) 그대로 | L SF 1.014(DC-04 끌림 포함 1.009) |
| DC-04 (C-39) v2.8.13 | 연구 CYCLE_L·S·G1·G2·V `J_U3_PRESSER` 회전 구간 20 → 0. 들림 20은 로딩 0~12·배출 끝뿐이고 그동안 회전 0° | 다른 26개 키 차 0. 간섭은 모델링 7점·검도 12점·측정 30점 모두 겹침 0, 최소 틈 NOSE 0.5 mm. 손계산 결과 바이트 같음 |
| BOM | v2.8.12 ↔ v2.8.13 made·purchased diff 0 | — |
- CAD를 열지 않은 이유
  - 형상이 v2.8.12와 같다(바디 수·bbox 변경 0, 모델링·검도 보고서).
  - 노루발 자세 간섭은 앞 부서 세 곳에서 49점을 쟀다.
  - 새로 볼 것(밸브 자리)은 회귀 dump `tools/out/mech_regrun/reg23/bodies_v2812.json`의 bbox로 충분하다. 형상이 같으므로 v2.8.13에도 그대로 맞다.
  - 앱에 문서를 열지 않았으므로 원복할 것이 없다(E-08).

## 3. 다섯 항목 판정
1. **높이 사슬**: 후보 0.
   - 높이를 바꾼 부품이 없다.
   - 노루발 키 0은 봉제 높이다(한계 −4~20 안). 0-8-2 ① '매트 위 높이 여유(≥ 매트 두께 + 노루발 들림 20 + 여유)'는 들림 20 기준이고, 들림은 로딩·배출에서 그대로 쓰므로 사슬이 바뀌지 않는다.
2. **공구 접근 배치**: 후보 0.
   - 지난 선별(관 35줄 × 볼트 610) 그대로다. CB5-20_M03_10 하나는 연질 관을 2 mm 비키면 풀려 디테일(DCK-D1)이다.
   - 관 경로 변경은 0이다.
3. **구매품 수량·외형**: 후보 0.
   - BOM·바디는 바뀌지 않았다. 어긋남 6행은 6절과 같고, 모두 문서나 캡 추가로 풀린다.
   - 노루발 누름 2단 자리(아래 4-1)는 배치를 바꾸지 않고 들어간다.
4. **연결부 방향**: 후보 0.
   - J_U5_X를 건너는 관 2줄은 체인 안에 있다(v2.8.9 판정 그대로).
   - 헤드(U3)는 고정이라 누름 2단 공급관을 단다면 움직이지 않는 길이다.
5. **구동 위치**: 후보 0.
   - DC-03은 L·G 모서리를 U4+U5로 남겨 U4 혼자 L 36.6 N 경우가 판정 밖이 되었다.
   - DC-04는 U4 혼자 구간 전부(19구간)에서 바늘 옆힘 ≤ 17.8 N ≤ 20 N(노루발 몫을 빼지 않은 값), F4 ≤ 15.86 N ≤ 18 N이다.
   - 피벗 반력까지 셈에 들어가 있어 지난 점검의 '토크만 본 셈' 지적이 닫혔다.

### 4-1. 새로 본 것: 노루발 누름 2단 밸브 자리(C-39, D-10)
- 노루발 누름 2단(봉제 / 피벗 낮은 누름)은 헤드 견적 조건이다. 헤드가 자체로 내지 못하면 이쪽 U8에 밸브 1개와 정밀 레귤레이터 1개가 더 필요하다.
- 지금 밸브 묶음(`bodies_v2812.json`)
  - SS5Y3-20-06_M08 bb X 1035.0~1117.0 · Y 100~120 · Z 325.5~374.5
  - SY3120 ×6: X 1044.0~1108.0, 피치 10.5. 1 U4, 2 U5, 3 U6, 4~6 U7로 빈 스테이션이 없다.
- 끝쪽 여유
  - +X 쪽: P_M08_AIR_IN_BRKT X 1148부터다. Z 256~304라 매니폴드 Z 대역(325.5~)과 겹치지도 않는다. **빈 길이 ≥ 31 mm**로 스테이션 하나 10.5 mm(SS5Y3-20-07)보다 길다.
  - −X 쪽: TU0805_M08P_P X ~1020까지라 15 mm가 빈다.
- 레귤레이터 IR1000(W25)은 기존 2개 옆 판에 하나를 더 다는 것이다. 위치만 정하면 되는 디테일 몫이다.
- 판정: 배치를 바꾸지 않고 들어가므로 **후보가 아니다**. 헤드 견적(D-10)에서 2단을 헤드가 내는지 확인한 뒤 형번 행을 더한다. 자료대기 D-10 '쓰는 곳'에 이미 누름 2단이 적혀 있다.

## 5. 확인한 숫자 근거
- DC-04 손계산은 `tools/out/mech_DC-04/design/dc04design.json`에서 가져왔다(검도가 다시 돌렸고 바이트 같음).
  - V 입구2 U4만 12.5 s: need 1.586 N·m, SF 1.009, F4 15.86 N.
  - V 입구2 U4+U5 2.7 s: SF 1.015.
- 회전 구간 목록은 `tools/out/mech_DC-04/rot_segments.json`(19구간)이다. 노루발 0, 들림 구간 회전 0이다.
- 밸브 bbox는 4-1의 숫자다.

## 6. 넘길 것(후보 아님)
- BOM v2.8.13 수량 대 바디. BOM과 바디가 지난 점검과 같아서 결과도 같다.
  - KQ2L06-M5A: 29 대 18
  - HFC8-4080-B: 64 대 58(캡이 빠진 것인지 BOM 오류인지 확인, U-19·C-11)
  - HNTT8-5: 496 대 463
  - CB5-16: 575 대 473, CB5-12: 239 대 66
  - AS2201F-01-06SA: 바디 이름이 `STEP대기_AS2201F-01-06S_*`라 이름이 맞지 않는다(D-157). 다음 BOM 담당 몫이다.
- 회귀 21 못 본 범위: POSE 0·10·20·30, B_·H_, MAINT_U7 3~12. 동작 문제 확인 몫이다.
- 디테일 DC04-D3: 피벗 누름 실제값 ≤ 20 N(SF 여유가 얇음, 조건 ≤ 22.9 N). 외부 값 D-10·7절이다.
- 7절(기록만): 회전 중 노루발 낮은 누름으로 매트 겉면이 비틀려 끌릴 때 자국이 남는지(C-03). 유연물이라 모델로 판정하지 않는다.
- D-155(체인 채움, 전장 뒤)와 STEP대기 목록은 지난 점검 그대로다.

## 7. 외장
'외장 단계 과제'에 새로 적을 것은 없다.

## 8. 시간
- 약 3분(CAD 0, 브라우저 0)이다. 등급 S 예상 10분 안에 들었다.

## 워크플로우 메모
- 지난 메모(회전 셈에 피벗 반력 줄을 넣는 안)는 DC-04 설계에서 `dc04design.py`가 반력을 셈하는 것으로 실제로 반영되었다. 엔진의 기본 식 후보로는 그대로 남긴다(회고 몫).
- 헤드 견적 조건처럼 '헤드가 내지 못하면 이쪽 구매품이 늘어나는' 조건부 항목은 점검부 입력에 '조건부 구매품'으로 넘겨 주면 자리 확인을 빠뜨리지 않는다.
