hyeunung/FSAP/docs/reports/mechanism/mech_LITE_design.md

# 기구설계부 — LITE 2회째 설계안 (2026-11-10, 기준 v2.8.9 → 새 번호 v2.8.10)

**요약**
- 형상 변경 0으로 무거운 바디 세 개의 피처 이력만 바꾼다. 구매품·사본·조인트·부품 수는 그대로다(부품 순 증감 0).
- P_M07_BEAM: `Combine40`(탭 공구 42개를 cut 한 번)을 지운다. 대신 탭 42개를 하나씩 cut으로 넣는다. 자리는 속 빼기 `Extrude52` 바로 뒤다.
  - 옛 탭 4자리(공구 16·17·42·43)는 처음부터 새 탭 자리(−106/−94, Z 462 · 1159, Z 261/299)로 옮긴다.
  - 그래서 메움 join `Cylinder1281·1283·1284·1285`와 새 탭 cut `Cylinder1289~1292`가 필요 없어 지운다.
  - 옛 메움이 보 속(Y 128 넘는 곳)에 남긴 핀 4개(r 2.4, 길이 2.5·4.5)는 지금 형상과 같게 join으로 남긴다. 벽 안 Y 124에서 시작하므로 같은 평면이 없다.
- P_M02_FRONT·P_M03_FRONT:
  - X 구멍은 옛 cut의 r 2.75를 r 2.1로 고친다. 메움 r 2.85와 다시 뚫기 r 2.1을 지운다(판 두께 12를 관통한 결과가 같다).
  - Y 탭은 옛 cut을 남은 공동 길이 2.6(Y −21.6~−19 / 19~21.6)으로 줄이고 메움 4개를 지운다. 새 탭 cut은 그대로 둔다.
- 빈 설계 실측 비교. 같은 보에 탭 42개를 넣었다.
  - Combine으로 한 번에 넣으면 46.4~47.6 s, 공구 시작을 Y 119로 옮기면 66.0 s였다.
  - 하나씩 cut하면 Y 탭 36개가 2.1 s, Z 탭 6개가 0.2 s, 핀 4개가 0.44 s였다.
  - 원인은 '많은 공구 Combine'이다. 같은 평면은 원인이 아니었다(첫 가설 기각).
- 열기 어림: 844 s × (1,021.5 − 655 + 약 8 − 59.0 − 71.1)/1,021.5 ≈ **202 s**(상한 240 s).
- **미완:** v2.8.9에 대고 저장하지 않고 돌린 확인(`tools/out/mech_LITE/design2/try.*`)이 이 보고 시점에 아직 돌고 있다(열기만 약 844 s). 모델링부가 그 결과부터 읽는다.

## 1. 근거 (측정 mech_LITE_measure.md 1-4, v289_document.json)
| 바디 | 지금 | 바꾼 뒤 |
|---|---|---|
| P_M07_BEAM | Box16 (−2380,120,250) 3610×200×400. 속 Y 128~312·Z 258~642 R4. 끝판 Box147·148 X −2379·1221. Combine40 335.9 s(retry 44). 메움 4개 92.3 s, 새 탭 4개 226.8 s | 개별 cut 42개 + 핀 join 4개. 빈 설계 실측 약 2.8 s |
| P_M02_FRONT | Box64 (−132,−31,30) 12×62×80. 메움 8개 53.6 s, 다시 뚫기 X 4개 5.4 s | 옛 cut 8개 고침(0.02~0.14 s), 메움·다시 뚫기 지움 |
| P_M03_FRONT | Box87 (−1832,−31,30) 12×62×80. 메움 8개 65.1 s, 다시 뚫기 6.0 s | 같은 방법 |

- 형상이 같다는 근거. 보는 Y120 h10이 Y119 h11과 같고(구멍 끝 Y130/132 그대로), 핀은 메움 중 속에 남은 부분과 같다.
- 앞판 X 구멍: 메움 r 2.85(X −132~−120)가 옛 구멍 r 2.75를 판 두께 전체에서 채운다. 다시 뚫은 구멍이 r 2.1이므로 결과는 r 2.1 관통 구멍이다.
- 앞판 Y 탭: 메움 h 9.4는 옛 탭 깊이 12보다 짧다. 그래서 2.6 길이 공동이 남아 있고, 새 탭(Z 51)과 0.2 mm 겹친다. 이것도 그대로 남긴다.
- 얼굴(face) 이름으로 세 바디를 참조하는 피처는 `Fillet1`(1118, 바꾼 자리 앞) 하나뿐이다. 조인트에는 이 바디 이름이 없다(assembly 0건). 그래서 순서를 바꿔도 깨질 참조가 없다.
- 보의 nudge 7.27e-3 mm(Combine40)가 없어지면 탭 자리가 공칭으로 돌아온다. bbox 차이는 0이다(탭은 bbox 안쪽이다).

## 2. 모델링 지시서
- 명령 기록: `tools/out/mech_LITE/design2/edit_lite2.json`(생성기 `mk_edit.py`). 순서는 이렇다.
  1. `timeline.delete` 75개를 한 번에 지운다. Combine40, Cylinder1179~1220, 1281·1283·1284·1285, 1289~1292, 앞판 메움·다시 뚫기 24개다.
  2. `roll_to Cylinder221`.
  3. 앞판 옛 cut 16개를 `timeline.edit`로 고친다.
  4. `roll_to Extrude52`.
  5. 탭 cut 42개와 핀 join 4개를 넣는다.
  6. `roll_to {}`.
  7. `inspect.measure`.
- 그 뒤는 실행 규칙대로 한다.
  - `motion.play` 대기 step 0
  - `browser.visibility` joints·sketches 숨김(규칙 19)
  - 문서 이름 FSAP_v2.8.10
  - 새 번호 저장(앱이 dirty면 CLI `run --in FSAP_v2.8.9.sc --save FSAP_v2.8.10.sc`)
  - config.json doc 바꾸기
  - 열기 시간과 lite_check after 재기
- 다음 경우에는 그 자리를 옮긴다.
  - 확인에서 탭 cut 하나가 2 s를 넘으면 그 탭 묶음을 `Fillet1` 앞으로 옮기지 않는다. 핀 join은 반드시 Extrude52 뒤다. 대신 그 자리를 `Box148` 뒤로 옮겨 다시 잰다.
  - 피처가 실패하면 그 바디만 되돌리고 보고한다.
- lite_check 허용치:
  - 보: bbox ≤ 0.013, 무게중심 ≤ 0.05, 부피는 이전 값 34,452,828.9 ± 50 mm³
  - 앞판: bbox ≤ 0.01, 부피 ≤ 0.1. 0.1~1이면 테셀레이션 잡음으로 보고 기록한다.
  - BOM 179행/2,616, 바디 2,969 같음

## 3. 디테일로 남길 것(E-02, 기록만)
| 무엇 | 어디 | 고칠 것 |
|---|---|---|
| 보 속 잔여 핀 4개(r 2.4, 합 약 253 mm³) | P_M07_BEAM (−126/−114, Z 462), (1159, Z 273/287) | 디테일링에서 지움 |
| 앞판 Y 탭 옆 잔여 공동 2.6 mm, 새 탭과 0.2 mm 겹침 | P_M02/M03_FRONT Z 55·85 | 디테일링에서 메움 |
| Cylinder989 19.95 s(nudge) | P_M07_BEAM (1000,166) | 이번에는 둠 |

## 워크플로우 메모
- 엔진 안내서 '모델 무게'는 사본 묶기를 주로 말한다. 이 기계에서는 두 번 모두 원인이 '무거운 바디의 boolean'이었다. 이번에는 Combine 공구가 많은 것과 메움 join이 원인이었다.
- 개선후보: 모델링부가 무거운 바디에 탭을 넣을 때는 '공구 바디 + Combine' 대신 개별 cut을 쓴다. 메움 join 대신 옛 cut을 고친다.
