hyeunung/FSAP/docs/reports/mechanism/mech_LITE_design1.md

# 기구설계부 — LITE 2회째 수정 1회차 (2026-11-10, 기준 v2.8.9 → 새 번호 v2.8.10)

**요약**
- 고친 곳은 하나다. 완료 판정 '열기 240 s 이하 또는 줄인 만큼(전후 실측)'에 **실모델 근거**를 붙였다.
- 1회째 지시서(`design2/edit_lite2.json`)를 v2.8.9에 대고 저장 없이 돌렸더니 멈췄다(try, 1,280 s). 첫 Y 탭 cut(944,119,462)에서 `boolean Cut: no result`가 났다.
- 고친 명령 기록 `tools/out/mech_LITE/design3/edit_lite3.json`(66단계)은 실모델 try4에서 **rc 0으로 끝까지 통과**했다.
  - 보 부피 34,452,826.3 mm³(전 34,452,828.9, 차 −2.6 mm³, 허용 ±50)
  - 앞판 M02 34,586.57 / M03 30,123.22 mm³(전 34,586.6 / 30,123.2)
  - 세 바디 bbox가 전과 같다. 형상 변경 0이다.
- 바꾼 자리는 세 곳이다.
  - 보 탭 37개 + Cylinder989: `Box16` 바로 뒤에서 스케치 3장 + extrude cut 3번으로 넣는다.
  - 필렛 띠 탭 4개: 이력 끝에서 4공구 `solid.combine`으로 한다.
  - 앞판: X 구멍만 단순화하고, Y 탭 쪽은 지금 이력 그대로 둔다(try3에서 실패한 자리).
- 열기: 844 s → **약 360~430 s(−49~57 %)**. 근거는 try4 편집 뒤 재계산 실측 432 s다. 상한 240 s는 못 맞춘다. 그래서 판정은 '줄인 만큼'이고, 저장 뒤 열기 실측은 모델링부가 v2.8.10에서 잰다.
- 남은 무게: 필렛 띠 탭 Combine 119 s, Cylinder1291 21.5 s, 앞판 Y 메움 51 s. 형상을 바꿔야(탭을 띠 밖으로) 줄어들므로 디테일로 넘긴다.

## 1. 실모델 확인 (v2.8.9에 대고 `solidcraft-cli run --results --timings`, 저장 없음)
| 실행 | 결과 | 자료 |
|---|---|---|
| try (edit_lite2, 1회째) | rc 1, 1,280 s. step 26 첫 Y 탭 cut(Extrude52 뒤) no result | design2/try.* |
| try3 (edit_lite3 첫 판) | rc 1, 1,454 s. **보는 통과**. 앞판 새 탭 Cylinder860·861·870·871·880·881·890·891·Box213 실패 | design3/try3.* |
| try4 (edit_lite3 지금 판) | **rc 0**, 1,499 s(열기 약 849 + 편집 650.4) | design3/try4.* |

- try3 실패 원인: 옛 Y cut을 공동 길이 2.6(Y −21.6~−19)으로 줄이고 메움을 지웠다. 그러자 새 탭(Z51·Z89, r2.1)과 0.2 mm 겹치는 곳에서 'cut이 도구 밖을 지운다'로 거부됐다. 자리는 (−126.555, −21.087, 83.447)이다.
  - 메움 join이 남긴 면과 한 cut의 면은 위상이 달라서 같은 결과가 나오지 않는다. 그래서 앞판 Y 쪽은 지금 이력(옛 cut 13 + 메움 r2.2 h9.4 + 새 탭) 그대로 둔다.
- 보 단독 재현 모형(`design3/repro_*.json`: 기존 구멍 20·HB/HK/HT·R12 Fillet·속 빼기)으로 1회째 실패를 찾았다.
  - R12 필렛 뒤 Y120 면 boolean이 기존 구멍 있을 때 실패한다(repro_base. 실모델과 같은 탭에서 실패).
  - 구멍이 없으면 통과하지만 157 s 걸렸다(repro_noprior).
  - 탭을 Box16 바로 뒤로 옮기면 43.7 s에 통과했다(repro_sk_early).
  - 필렛 띠(Y120 면 Z250~262·638~650)에 걸리는 탭 5개를 필렛 앞에 두면 Fillet1이 실패했다(repro_beforefillet·sk_lowlate).

### try4 단계별 시간 (s)
| 단계 | s |
|---|---|
| timeline.delete 63개 | 174.3 |
| 앞판 X 옛 cut r2.1로 고치기 8개 | 8.8씩 |
| roll_to Box16 + 탭 스케치 cut 3 | 각 2 미만 |
| roll_to Extrude52 | 64.7 |
| 핀 join 4 | 3.9~4.0씩 |
| roll_to {} (Extrude52 뒤 전부) | 232.5 |
| 필렛 띠 탭 4공구 Combine | 119.2 |
| 합(편집) | 650.4 |

- 편집 뒤 모델을 Box16부터 끝까지 다시 계산한 시간: 64.7 + 16 + 232.5 + 119.2 ≈ **432 s**. 같은 CLI로 v2.8.9를 연 시간 844 s와 같은 잣대다.
- 앱 재계산 표로 다시 어림하면 다음과 같다(feat_cost289, 비율 0.826).
  - 보: 679.6 → 약 180(남은 이력 25 + 띠 Combine 119 + 1291 21.5 + 핀 16)
  - 앞판: 143.9 → 65(X 메움·다시 뚫기 78.8 줄임)
  - 그 밖: 198
  - 합 443 → 열기 약 366 s
- 그래서 저장 뒤 열기는 **약 360~430 s**로 본다.

## 2. 고친 설계 (형상 변경 0, 부품 순 0)
| 바디 | 1회째 | 수정 1회차 |
|---|---|---|
| P_M07_BEAM 탭 37 + Cylinder989 | Extrude52 뒤 개별 cut | **Box16 바로 뒤** 스케치 3장 extrude cut |
| └ 스케치 Y (원 30 깊이 → Y130, 원 1 = 1159/Z299 → Y132) | - | 평면 origin (0,119,0), x_dir +Z, y_dir +X(법선 +Y). r 2.1, 원 중심 (Z, X). cut 11 / 13 |
| └ 스케치 Z (원 7: 탭 6 + Cylinder989 (1000,166)) | - | 평면 origin (0,0,650.1), x_dir +X, y_dir −Y(법선 −Z). r 2.1, cut 10(→Z640.1) |
| 필렛 띠 탭 4 (1046/1106 Z638, 944/976 Z262) | 개별 cut | 공구 Cylinder1209~1212 그대로, 이력 끝 `solid.combine` cut |
| 1159/Z261(옛 공구 42 새 자리) | 개별 cut | 공구 42(Cylinder1219) 지우고 `Cylinder1291` 그대로 |
| 메움 1281·1283·1284·1285, 새 cut 1289·1290·1292 | 지움 | 같음(1291은 남김) |
| 속 잔여 핀 4 | Extrude52 뒤 join | 같음 |
| P_M02/M03_FRONT X 구멍 | 옛 cut r2.75 → r2.1, 메움 8·다시 뚫기 8 지움 | 같음(try4 통과) |
| P_M02/M03_FRONT Y 탭 | 옛 cut 줄이고 메움 8 지움 | **지금 이력 그대로**(try3 실패) |

- Fillet1 참조: 앞에 구멍이 38개 늘어도 try4에서 Fillet1은 그대로 통과했다. 부피와 bbox가 같다.

## 3. 모델링 지시서
- 명령 기록: `tools/out/mech_LITE/design3/edit_lite3.json`(생성기 `mk_edit3.py`, 66단계). try4에서 v2.8.9에 대고 통과한 것 그대로다. 순서는 이렇다.
  1. `timeline.delete` 63개: Combine40, 공구 38(Cylinder1179~1220 중 1209~1212 빼고), 1281·1283·1284·1285·1289·1290·1292·989, 앞판 X 메움 782~785·794~797, 다시 뚫기 786~789·798~801
  2. `roll_to Cylinder221` → `timeline.edit` 8개(Cylinder65~68·214~217 radius 2.1)
  3. `roll_to Box16` → 스케치 Y10·Y12·Z → 각각 extrude cut
  4. `roll_to Extrude52` → 핀 join 4
  5. `roll_to {}` → `solid.combine` P_M07_BEAM cut, 공구 TAP_P_M07_BEAM_32·33·34·35 → `inspect.measure`
- 그 뒤는 실행 규칙대로 한다.
  - `motion.play` step 0
  - `browser.visibility` joints·sketches 숨김(규칙 19, 새 스케치 3장 포함)
  - 문서 이름 FSAP_v2.8.10
  - 새 번호 저장: 앱에 연 v2.8.9가 dirty(undo 200)이면 CLI `solidcraft-cli run edit_lite3.json(+숨김·이름 단계) --in FSAP_v2.8.9.sc --save FSAP_v2.8.10.sc`. 이유를 보고서에 적는다.
  - config.json doc 바꾸기
  - 열기 실측(v2.8.9 844.4 s와 같은 CLI 잣대), lite_check after
- lite_check 허용치:
  - 보: bbox ≤ 0.013, 부피 34,452,828.9 ± 50 mm³(try4 −2.6)
  - 앞판: bbox ≤ 0.01, 부피 ≤ 0.1(try4 M02 −0.03, M03 +0.02)
  - BOM 179행/2,616, 바디 2,969 같음(공구 4는 Combine에서 소비)

## 4. 디테일로 남길 것(E-02, 기록만)
| 무엇 | 어디 | 고칠 것 |
|---|---|---|
| 필렛 띠 탭 5개(Z262 ×2, Z638 ×2, 1159/Z261). Combine 119 s + 1291 21.5 s | P_M07_BEAM Y120 면 | 탭을 띠 밖(Z ≥ 264.1, ≤ 635.9)으로 옮기면 Box16 뒤 스케치로 넣을 수 있다(형상 변경) |
| 앞판 Y 탭 메움 8개(51 s), 잔여 공동 2.6 mm·새 탭과 0.2 mm 겹침 | P_M02/M03_FRONT | 탭 자리 정리(형상 변경) |
| 보 속 잔여 핀 4개 | P_M07_BEAM | 지움 |
| P_M08_TUBE_COMB_KDM 22.6 s(cut 37) | U8 | 같은 스케치 한 번 cut |

## 워크플로우 메모
- 설계부가 빈 설계 모형만으로 이력 바꾸기 시간을 재면 틀린다. 1회째는 필렛·기존 구멍 없는 상자로 2.8 s를 쟀고, 실모델에서는 실패했다.
  - 개선후보: 재현 모형에는 바꿀 자리 앞의 같은 바디 이력(구멍·필렛·속 빼기)을 모두 넣는다.
  - 개선후보: 실모델 try는 보고 전에 결과를 확인한다(열기 약 850 s + 편집).
- 같은 결과라도 '메움 join + 옛 cut'과 '짧은 cut 하나'는 위상이 달라, 뒤 피처의 boolean이 실패할 수 있다(try3 앞판).
- 이번 설계부 시간은 실모델 try 3번(각 21~25분)으로 예상(25분)의 몇 배다.
