hyeunung/FSAP/docs/reports/mechanism/mech_PNEU-01_fea1.md

# PNEU-01 해석부 — 관 고정품 강도 손계산 (v2.8.7, 2026-11-10)

## 요약 (10줄)
- 대상: 새 하중 부품 관 고정품 30(대표 9바디 STEP `tools/out/mech_PNEU-01/stepout/P_M08_TUBE_FIXTURES_fix1.step`) + 새 CB5-16 볼트. 치수는 생성기 `tools/gen_v2_pneu01_fix1.py` fixtures() 상자 좌표와 서명(받침 부품 bbox).
- 해석 못 함 — 환경 없음(자료대기 D-16). 모두 손계산 `fea/cases/mech_PNEU-01_fea1_handcalc.py` → `fea/results/mech_PNEU-01_fea1_handcalc.json`. 해석 모델 표 `fea/models.json`에 2행 더함.
- **동작 문제 1**: `P_M08_TUBE_BRKT_CST_V` t4 세움 띠(폭 13, 카세트 판 윗끝 Z328 위로 외팔 192)가 관 1줄 손 당김 50 N(+X)에 σ 277 MPa, **SF 0.70**(< 1.2, 영구 변형). 35 N에서 항복. 운전은 SF 4.84이지만 처짐 3.5 mm, 강성 2.06 N/mm.
- 고치는 법: 띠를 가로판 폭(Y −160~−127, 33)으로 넓히고 t5(SF 2.79) 또는 t4 + 굽힘 날개 15(L 단면, SF 4.52). t4 폭 33만으로는 1.79(기준 2 미달).
- 그 밖 고정품 10곳 묶음(RISER·SO·KDM 빗·KDM 판·CAR·ARM_1·2·U6·블록류): 오조작 SF 14.8~253, 운전 SF ≥ 64 — 동작·디테일 문제 0. 과사양(M-09 기준의 3배 넘음)은 관 구멍 길이·볼트 자리로 정해진 두께라 note만.
- 볼트 CB5-16(가장 불리 CST_V 420 N, le 8 A5052): 외력 SF ≥ 10.7, 조임 암나사 전단 1.23 — handcalc ok. 체인 팔(SUS304) le 10에서 1.61.
- CST_V 곁가지: 가로판 끝 Z 하중이 띠 두께 방향으로 굽힘, 오조작 SF 1.69 — 기준 2 미달 디테일(위 고침으로 같이 풀림: 띠가 넓어지면 두께 방향 단면 계수 같이 커짐).
- 임시값: 오조작 50 N(근거 없음, D-38 전), 압력 펴짐 1줄 0.5 MPa × 안지름 넓이(6.3·9.8 N), 관 자중 ×3 g(300 mm 몫), M5 조임 4.5 N·m. D-16 '쓰는 곳'에 적음.
- completion_met: 이 부서 판정 범위(강도)에서 동작 문제 1이 남아 false.

## 1. 일의 크기(E-18)와 모델
- 새로 만든 하중 부품: 고정품 30(형상·하중 경로 새로). 체결만 바뀐 자리 없음. 해석 환경이 없어 FEA는 처음부터 못 하고, 얇은 판(t/L < 0.1)인 CST_V 띠(4/192 = 0.021)는 엔진 `handcalc.py beam`, 나머지는 단면 굽힘·지렛대 볼트 힘 손계산.
- 같은 꼴 묶음(E-19): COMB_ML 7개·CLAMP_F 5·CLAMP_L 6는 꽉 찬 블록 → 가장 높고 얇은 COMB_ML(높이 48·두께 16) 하나. RISER 1·2 → 외팔이 같은(127) RISER_1. SO_2·3 → 외팔 긴 SO_2.
- 모델(`fea/models.json` 새 행 `P_M08_TUBE_BRKT_CST_V`, `P_M08_TUBE_FIXTURES(...)`): 귀 = 받침 면에 볼트로 묶인 고정, 귀 끝 모서리가 지렛대 받침점(압축만), 관 구멍은 보수로 뿌리 단면에 둠. 옛 모델 없음(새 부품) → 바꾼 모델 없음.
- 기준(요구서 6-1 "기본값 — M-09", M-09 "필요 SF 일반 3, 오조작 하중 2"): 운전 SF 3, 오조작 SF 2. A5052 항복 195 MPa(앞 과제 `fea/models.json`과 같은 값), E 70 GPa. 6-2 변위는 미정(D-08) → 처짐은 기록만.

## 2. 하중(요구서 2-4·6-1)
| 경우 | 값 | 근거 |
|---|---|---|
| 운전 자중 | TU0604 18.8 g/m, TU0805 36.8 g/m × 300 mm 몫 × 3 g | PU 1.2 g/cm³, 자유 구간 ≤ 300(모델링부 실측 최대 300.0) |
| 운전 압력 펴짐 | 고정품마다 1줄이 한 방향으로 다 민다: 0.5 MPa × Ø4 넓이 = 6.3 N(TU0805 Ø5 = 9.8 N) | 요구서 0-6 공급 0.5 MPa(운전 압력 미정 2-4), 보수(실제는 관 굽힘 강성만큼, 0.01 N 수준) |
| 오조작 | 관 1줄 손 당김 50 N, 가장 먼 관 구멍, X·Y·Z 중 가장 불리 | 임시값 — 원터치 이음에서 관이 빠지기 전 손 힘 수준. 정비·카세트 교체(C-20) 때 손이 관에 걸리는 경우 |
| 볼트 | M5 조임 4.5 N·m, K 0.2(예압 4,500 N) | 앞 과제 M5 대 A5052와 같은 값 |

## 3. 결과
### 3-1. 부품 단면(가장 불리한 방향)
| 부품 | 단면 | 운전 σ / SF | 오조작 σ / SF | 판정 |
|---|---|---|---|---|
| **P_M08_TUBE_BRKT_CST_V 띠 +X** | 13 × t4, 판 윗끝 Z328 → 윗 가로판 Z520(외팔 192) | 40.3 / 4.84 | **276.9 / 0.70** | **동작**(SF < 1.2) |
| CST_V 띠 Z 하중(가로판 팔 80) | 13 × t4 두께 방향 | 16.8 / 11.6 | 115.4 / 1.69 | 디테일(기준 2 미달) |
| CST_V 띠 Y | 13 폭 방향 | 12.4 / 15.7 | 85.2 / 2.29 | 됨 |
| CST_V 가로판 뿌리 | 33 − 구멍 2 × t4 | 10.9 / 17.9 | 75.0 / 2.60 | 됨 |
| RISER_COMB_1·2 판 | 72 − 구멍 3 × t8, 외팔 127 | 3.0 / 64.6 | 12.8 / 15.2 | 됨(과사양 note) |
| CLAMP_SO_2·3 판 | 20 − 구멍 × t8, 외팔 38 | 1.7 / 115 | 13.2 / 14.8 | 됨 |
| COMB_KDM 팔 Y·웹 X | t8, 팔 56·웹 72 | ≥ 226 | 3.9·5.9 / 49.8·32.9 | 됨 |
| BRKT_KDM 판 | 80 − 구멍 2 × t8, 외팔 84 | 228 | 5.9 / 33.2 | 됨 |
| CLAMP_CAR 판 | 35 − 구멍 2 × t8, 외팔 32 | 216 | 6.8 / 28.6 | 됨 |
| BRKT_ARM_1 판 Z·귀 X·귀 비틀림 | t8 외팔 40 / 귀 t6 Y80 단면 / τ | ≥ 200 | 26.5 / 46.8 / 31.4 | 됨 |
| BRKT_ARM_2 판 Y | 36 − 구멍 × t8 | 232 | 30.7 | 됨 |
| BRKT_U6 귀 | 32 × t8 | 607 | 78.3 | 됨 |
| COMB_ML 블록(F·L 블록 대표) | 73 × 16, 높이 48 | 1,662 | 253 | 됨 |

- CST_V 띠: 강성 2.06 N/mm, 운전 처짐 3.5 mm(압력 펴짐 6.3 N를 다 받는 보수), 오조작 50 N 처짐 24 mm(탄성 보 계산, 실제는 그 전에 항복). 항복 힘 35.2 N. 서명 `P_M05_CST_PLATE` bbox Z 20~328 — 띠 Z 328~530은 아무 받침 없이 서 있다.
- 엔진 `handcalc.py beam --t 4 --b 13 --length 192 --load 50`: σ 276.92, sf 0.70, thin true, needs_fea false(기준에서 멀어 FEA로 판정이 갈리지 않음).

### 3-2. 볼트(새 CB5-16, 가장 불리 하나씩)
| 자리 | 오조작 외력(볼트 하나) | 물림 · 모재 | 외력 SF 최소 | 조임 최소 | ok |
|---|---|---|---|---|---|
| CST_V → 카세트 판(+X 당김, 받침점 Z296, 팔 8·24) | 420 N | 8 · A5052 | 10.7(분리) | 1.23 암나사 전단 | 됨 |
| COMB_ML → 보 윗면 | 300 N | 9.9 · SS400 | 15.0 | 1.90 | 됨 |
| SO_1 → 보 앞면 | 168 N | 8 · A5052 | 26.9 | 1.23 | 됨 |
| COMB_KDM → 보 앞면 | 158 N | 8 · A5052 | 28.4 | 1.23 | 됨 |
| BRKT_KDM → KDM 받침 | 131 N | 8 · A5052 | 34.3 | 1.23 | 됨 |
| ARM_1 → 체인 팔 | 125 N | 10 · SUS304(모델링부 물림 10) | 36.0 | 1.61 | 됨 |
| RISER → 보 앞면 | 122 N | 8 · A5052 | 36.9 | 1.23 | 됨 |

## 4. 문제와 고치는 법
| # | kind | 무엇·어디 | 수치 | 고치는 법 |
|---|---|---|---|---|
| F1 | 동작 | `P_M08_TUBE_BRKT_CST_V` 세움 띠 13 × t4가 카세트 판 윗끝 Z328 위로 192 외팔 | 관 1줄 50 N(+X) σ 277 MPa, SF 0.70 < 1.2(영구 변형), 항복 35 N | 띠를 Y −160~−127(가로판 폭 33)로 넓히고 **t5**(SF 2.79), 또는 t4 판금 그대로 띠 끝에 **굽힘 날개 15(L 단면)**(SF 4.52, 굽힘 하나 더 — 판금 규칙은 디테일). 아니면 띠 위끝(Z 520 근처)을 KDM 받침·카세트 다른 판에 한 점 더 묶어 외팔을 없앤다. 카세트 판 Y −159~−127 자리와 J_U7_HGT 행정 이웃 간섭은 모델링부가 다시 본다 |
| F2 | 디테일 | 같은 띠, 가로판 끝 Z 하중이 띠 두께 방향으로 굽힘(팔 80) | 오조작 SF 1.69 < 2 | F1 고침(폭 33·t5 → Z 137.5 mm³)으로 SF 6.7이 되어 같이 풀림 |

- 과사양 note(M-09 "SF가 필요치의 3배 이상 남으면 과사양"): RISER(15.2)·KDM 빗(32.9)·KDM 판(33.2)·CAR(28.6)·ARM(26.5~46.8)·U6(78)·블록류(253). 두께는 관 구멍 길이(관 받침 길이)·M5 자리파기·볼트 물림으로 정해졌고 가공품 몇십 g이라 줄여도 원가 차이 없음 → 다운사이징 안 없음(문제로 세지 않음).

## 5. 검사 범위·못 본 것
- CST_V 띠 폭을 바꾸면 J_U7_HGT 행정에서 이웃(카세트 판·KDM 받침·U7C 관)과의 틈을 다시 봐야 한다 — CAD 부서 일(이 부서 CAD 금지).
- 관 통구멍(r + 0.25)은 관을 축 방향으로 잡지 않는다. 체인 양 끝(CLAMP_CAR·ARM, 체인 고정 끝)이 관 축 힘을 받지 않으므로 강도 문제는 없지만, 케이블 체인 관은 양 끝 고정(당김 풀림)이 일반적이다 — 기능 판정은 검도부 몫으로 남김(여기서는 문제로 세지 않음).
- 관 자체(TU 우레탄)의 내압·굽힘 반경은 카탈로그 판정(모델링부·검도부). 유연한 관 거동은 요구서 7절.

## 6. 시간(E-23)
- 해석 15/40/60분(L 60분). 실제 약 9분. CAD 0, 파일 열기 0, 브라우저 0.

## 워크플로우 메모
- 지시문의 '새 하중 부품 STEP'은 대표 9바디라 블록류(COMB_ML·CLAMP_F·L)는 빠져 있다. 해석 환경 없는 컴퓨터에서는 STEP 대신 생성기 상자 좌표가 손계산 입력으로 더 빠르다(이번에 그렇게 함).
