hyeunung/FSAP/docs/reports/mechanism/mech_regfix_2.md

# 모델링부(회귀 수정) — POSE 8 P_M05_GUIDE ↔ P_M06_CARR 겹침 (v2.6.5, 고치지 않음, 2026-11-06)

## 요약
- **바뀐 부품: 없음. 저장 없음(version_bump none), config.json doc 그대로 `../3D_Modeling/FSAP_v2.6.5.sc`.**
- 멈춘 이유 둘: ① 앱에 열린 설계가 `FSAP_v2.6.4`, **dirty true, path null**, revision 635(LITE·REG-01 r4 때와 같음) — 안내서 '문서 확인' "dirty면 open 전에 멈추고 보고한다 … 버리지 않는다". ② 문제의 고침 자체가 "사용자·선정부 결정"(가·나 중 고르기)이고 (가)는 규칙 예외(E-14), (나)는 두 유닛 사이 구조 판단이다 — 모델링부가 스스로 정하지 않는다.
- CLI 읽기 확인(저장 안 함): HGT 0·SHIFT −60(REST)에서 GUIDE ↔ CARR·센서·슈 겹침 0, 4가지 HGT 엇갈림(+6/−4, +4/0, 0/−4, +2/−2)도 SHIFT −60에서는 bbox부터 떨어져 겹침 0. 겹침은 SHIFT 0일 때만 생긴다.
- 손계산 어림: 겹침 상자 Z 34~42(8 mm)를 엇갈림 10 mm로 만들었으니 같은 높이에서 둘 사이 Z 틈은 약 2 mm. 겹침 평면 X 12~18 · Y −107~−100(6×7 mm), 291.7 / 42 ≈ 6.9 mm 깊이와도 맞는다.
- SHIFT 0에서 틈·반대 엇갈림을 재는 두 번째 CLI 확인은 590 s 상한에서 끊겨 결과 없음(센서 쌍 boolean 실패로 보임, r4와 같은 쌍).
- 미완: POSE 8 동작 문제 1건 그대로. 결정이 나면 다음 회귀 수정이 고친다.

## 근거 규칙
- 안내서 '문서 확인': "앱에 연결돼 있고 열린 설계가 `dirty`(저장 안 된 변경)면 `open` 전에 멈추고 보고한다 … 그 변경은 사람이 한 것으로 보고 버리지 않는다(E-01·E-04)". 예외는 '앱 막힘' 재시작뿐이고, `running`이 빈 목록이라 막힘이 아니다.
- 안내서 '연결'(WF-121): "앱이 켜져 있으면 모델링부는 반드시 MCP로 그린다". 앱은 켜져 있고 MCP 호출은 실패하지 않았다 — CLI `run --save` 우회 조건이 아니다. 그래서 CLI로도 그리지 않았다.
- E-14: 규칙 예외는 스스로 주지 않고 올린다.
- 프로젝트 CLAUDE.md: "승인 뒤 재확인하지 않는다. 예외: 구조를 바꾸는 판단, 돈이 드는 선택, 문서에 없는 결정".
- 실행 규칙 3 "형상이 바뀌면 항상 새 번호로 저장" — 형상이 안 바뀌어 저장하지 않음.

## 1. 문서 확인·통로
- MCP `running` → `[]`(막힘 없음). `inspect_design`(joints·measure·sketches false): name `FSAP_v2.6.4`, dirty true, path null, revision 635, undo 0. open·편집·저장 하지 않음.
- 읽기 확인만 CLI(`solidcraft-cli run … --results`, `--save` 없음)로 v2.6.5 디스크 파일에 대고 2번. 앱 문서는 건드리지 않았다. 다른 부서 solidcraft-cli 프로세스는 건드리지 않았다.

## 2. CLI 읽기 확인
폴더 `tools/out/mech_regfix/r2/`.

| 스크립트 | 내용 | 결과 |
|---|---|---|
| `probe.json` → `probe_out.json`(559 s) | REST(SHIFT −60) bbox + GUIDE vs CARR·E32 센서·SHOE, HGT (0,0)(+6,−4)(+4,0)(0,−4)(+2,−2) | 겹침 0, 쌍 모두 bbox에서 걸러짐(pairs_pruned 3), truncated false |
| `probe2.json`(SHIFT 0, nearest 20, 7조합) | 같은 쌍의 틈·반대 엇갈림 | 590 s 상한에서 끊김(rc 124), 결과 없음 |

REST bbox(mm): P_M05_GUIDE X 12~50 · Y −122~−96 · Z 38~270(PA12). P_M06_CARR(SHIFT −60) X −120~−42 · Y −185~−100 · Z 21~156(PET-CF) → SHIFT 0이면 X −60~18로 GUIDE와 X 6 mm 겹친다.

## 3. 결정에 쓸 수치(손계산 어림, 실측 아님)
- 같은 높이(HGT 같은 값)에서 CARR 윗부분과 GUIDE 밑면 사이 Z 틈 약 2 mm(X 12~18 · Y −107~−100).
- 두 장공이 따로 −4~+6이라 실물에서 엇갈림은 최대 10 mm까지 가능하다(U6 +6 · U7 −4). 틈 2 mm면 엇갈림 2 mm 넘게 맞추면 SHIFT 0(작동)에서 닿는다.
- (나)안 크기: 틈을 10 mm + 여유 2 mm = 12 mm 이상으로 하려면 그 자리에서 약 10 mm를 더 비워야 한다(GUIDE 밑면을 X 12~20 · Y −109~−98 구역만 Z 48 이상으로 따내거나, CARR의 X 10 이상 부분 윗면을 10 mm 낮춤). GUIDE 밑끝은 테이프 홈·턱 인서트(M05-X9 벽 0.6) 자리라 테이프 안내 기능을 먼저 봐야 하고, CARR 쪽은 센서 E32-D36P1(X −17.5~17.5 · Y −112~−107)과 겹치는 자리라 센서 붙임을 함께 봐야 한다. 어느 쪽이든 실측(SHIFT 0)부터 다시 한다.
- (나′)안: U6·U7 높이를 한 조정으로 묶기(예: P_M06_BASE를 P_M05_HOLDER에 붙여 HGT 하나로) — 엇갈림 자체가 없어져 틈을 키울 필요 없음. 구조 변경이라 선정부·사용자 결정.

## 4. 저장 전 검사
| 항목 | 결과 |
|---|---|
| 겹침·숨김·리지드 그룹·재질 | 편집 없음 — 해당 없음 |
| 볼트·강도·임시 STEP | 새로 만들거나 옮긴 부품 없음 — exported_steps 없음 |
| 저장·커밋 | 없음(실행 규칙 4) |

## 5. 규칙 예외 요청(E-14)
- 규칙: REG-01 완료 판정 "기준선 밖 겹침 0", M-08 기준선, machine.json J_U6_HGT·J_U7_HGT "두 조인트는 같은 값".
- 자리: POSE 8(J_U6_HGT +6, J_U7_HGT −4, J_U6_SHIFT 0, 노루발 20), `P_M05_GUIDE ↔ P_M06_CARR` 291.7 mm³.
- 안: (가) 두 HGT가 다른 자세(POSE 8·9)를 정의 밖으로 보고 회귀 목록에서 빼고, 제품 교체 표준 작업(C5)에 "U6·U7 높이는 같은 눈금으로" 적기. (나) 틈 12 mm 이상(3절) 또는 (나′) 한 조정으로 묶기 — 구동 후보로.

## 6. 사람이 확인할 것
- 앱에 열린 `FSAP_v2.6.4`(dirty, path null)가 LITE부터 남아 있다. 저장할지 버릴지 사용자가 정해야 모델링부가 MCP로 다시 그릴 수 있다.

## 워크플로우 메모
- 지시서가 "문제마다 원인을 고친다"인데 넘겨받은 문제의 fix가 "사용자·선정부 결정"이다. 결정이 안 난 문제는 회귀 수정부로 보내지 말고 선정부·사용자 확인으로 먼저 보내면 이 부서 열기 시간(CLI 2회 약 19분)을 아낀다.
- 앱 dirty 문서가 세 부서째 남아 MCP 모델링 통로를 막고 있다. 최종 보고 맨 위에 올려야 한다.
- CLI `inspect.clearance … nearest 20`에 E32-D36P1 센서를 넣은 7조합 스크립트가 590 s 안에 끝나지 않았다(r4의 boolean 실패 쌍과 같음). 센서는 따로 묶거나 빼고 재야 한다.
