hyeunung/FSAP/docs/design-requirements.md

# MAT-RS-001 설계 요구서

- 양식: MechDesign_Engine `templates/design-requirements-template.md`(칸 번호를 바꾸지 않는다. 워크플로우 지시문이 이 번호로 가리킨다).
- 상태: **초안(2026-10-30, 대화 단계).** "모델링 해줘" 전까지 대화로 빈칸을 채운다.
- 비운 칸·"기본값"은 엔진 `rules/`의 규칙 번호를 따른다. 이 문서가 정한 값은 L3보다 앞선다.
- "D-nn"은 [자료대기](waiting-list.md), "C-nn"은 [결정로그](decision-log.md).

---

## 0. 무엇을 만드나

| 칸 | 내용 |
|---|---|
| 0-1 이름·한 줄 목적 | MAT-RS-001 자동차 매트 랏빠 자동 봉제기(Automotive Mat Edge Binding Sewing System). 자동차 매트 가장자리 전체에 랏빠(바인딩) 테이프를 감싸 자동으로 봉제한다. 벤치마크 RI.MA.C. R375X(C-01) |
| 0-2 작업 대상 | 자동차 **카펫** 매트(코일 매트는 범위 밖, 사용자 2026-11-03). **차종마다 형상이 다르다**(C-08). 외곽에 좁고 깊은 V자·U자 홈, 물결형 오목·볼록, 계단형 오목 모서리, 둥근 볼록 모서리가 있다. 표면 결이 두툼한 파일이라 눌리면 자국이 남을 수 있다. 크기 범위 D-01, 홈 치수 D-02·D-03, 두께·뒷면·파일 종류 D-04, 차종(형상) 수 D-11. 힐패드·고정 단추는 이 기계 범위 밖(C-05) |
| 0-3 한 사이클 동작 순서 | ① 작업자가 매트를 올리고 시작 → ② 가장자리 센서가 시작점을 찾고 매트 가장자리를 바인더에 물림 → ③ 매트를 돌리며 외곽 한 바퀴 봉제(홈 안 포함, 급하게 꺾이는 곳은 바늘을 내린 채 노루발을 낮은 누름으로 두고 회전(C-39)) → ④ 시작·끝 이음매 처리, 테이프·실 절단 → ⑤ 배출. ②~⑤는 사람 손 없이(C-05). 이음매 방식 D-07, 배출 방식 D-13 **v1.0: 0-8-4가 이 순서를 유닛별로 풀어 쓴다(헤드 이송, 이음매 겹쳐 물림·끝 접어 넣기, C-13·C-19).** |
| 0-4 생산 목표 | 미정 — D-12. 참고: R375A 앞좌석 매트 45~50초(로딩 제외). 운전: 작업자 수동 로딩, 이후 자동(C-05) |
| 0-5 크기·설치 | 미정 — 매트 최대 크기(D-01)에 매트 회전 공간을 더해 정한다. 사람이 서는 쪽: 로딩하는 쪽 하나(배치는 구상에서) **v1.0: 매트 300×200~1500×1500(C-16), 매트가 휘두르는 영역 최대 약 2.1×3.0 m(0-8-5).** |
| 0-6 사용 환경 | 미정 — 기본값 실내, 공압 0.5 MPa 공급으로 진행. 참고: R375X 220 V 50/60 Hz, 2000 W, 6 bar |
| 0-7 참고물 | R375X·R375A, 비슷한 기계·만료 특허([benchmark.md](benchmark.md)), 매트 사진(사용자 2026-10-30), 전임 의뢰 기계(퇴짜, 남아 있는지 D-09) |

### 0-8 전체 구동 개념 (모델링 시작 조건, 엔진 E-01)

**상태: 확립(v2.0, 2026-11-03, 0-8-6).** 대화 과정·이유·계산은 [v2.0 구동 개념 초안](concept/v2-drive-concept-draft.md). v1.0 개념(진공 원판 + 자유 회전 조향 + X·Y 따라가기 받침 + 에어 테이블, US6557478)은 R375X 사진을 보기 전에 세운 것이라 버리고(결정로그 C-27), R375X·R375A 제품 사진 판독([benchmark.md](benchmark.md) 「제품 사진 판독」)으로 다시 세웠다. v1.0 개념·과제는 `archive_v1/`. 대상은 **카펫 매트**(코일 매트는 범위 밖).

| 칸 | 내용 |
|---|---|
| 0-8-1 핵심 원리 | **매트를 끄는 것은 재봉 헤드다**(C-13). 헤드는 고정, 3중 이송이 가장자리 띠를 한 땀씩 끈다. **매트는 볼 트랜스퍼 테이블 위에 그냥 놓인다**(수지 볼, 잡는 장치 없음, R375X 사진). **봉제 중 매트는 늘 약한 힘으로 잡혀 있어야 한다**(사용자 "랏빠를 잘 치려면 결국 매트를 어느정도의 힘으로는 잡아주고 있어야하거든 누른 자국안날정도로") — 볼 위 매트는 너무 자유로워 잡지 않으면 테이프가 고르게 안 감긴다. 잡기·방향은 **서보 바퀴 2개**(돌리기 전동 서보, 누르기 공압)가 매트 윗면을 약하게 눌러 한다: **바늘 옆 바퀴(+ 슈)는 늘 잡고, 먼 쪽 바퀴(전폭 X 대차)는 필요할 때 뒤를 잡는다**(사용자 "바늘옆에서 하나가 잡지만 뒤도 필요시엔 잡아주는게 좋지 않아?"). 두 바퀴는 **바늘을 지나는 X선 위**에 있고(사진: 같은 Y 줄) 바퀴 속도 = **v + ω·d**(v 헤드 이송, ω 회전, d 바늘–바퀴 거리). **바퀴는 미는 장치가 아니다**: 직선은 헤드와 같은 속도로 돌며 잡기만, 곡선은 속도 차이로 방향만, 헤드가 멈춘 모서리에서만 바늘을 축으로 회전력. 바퀴는 축 방향(X)으로 잘 안 밀려 매트가 옆으로 흐르는 것을 막는다. **가장자리를 바인더에 꽉 넣기**: 바늘 옆 바퀴를 헤드보다 아주 살짝 빠르게 돌려 들어오는 가장자리가 바인더 쪽(+X)으로 붙게 하고, 바늘 앞 슈 위 가장자리 센서가 깊이를 맞춘다(C-02, US5367966 비례 조향. 사용자 "살짝 눌러 잡고 전동모터로 랏빠쪽 꽉끼게하려고 살짝 미나?"). 보조안: 바퀴 몇 도 틀기(각도 조절 자리). **모서리·홈 바닥**: 바늘 꽂고 멈춤 → 노루발 낮은 누름(C-39, 꼭 넘겨야 하는 곳만 들기) → 바퀴로 바늘 중심 회전 → 센서가 가장자리를 다시 잡으면 재개(US5367966, US5493980A). 바늘 옆 바퀴 밑은 볼 없는 자유 회전 원판(사진 약 Ø250, 볼 점자국 방지). **헤드**: 3중 이송 헤드(C-25, 기종은 견적 뒤)를 기둥 없게 — 윗헤드는 보에 매달고 아랫유닛(가마·톱니)은 테이블 밑(C-18, R375X도 기둥 없이 매달린 것으로 보임) |
| 0-8-2 간섭을 푸는 방법 | ① 테이블 윗면(볼 윗면) = 바늘판 윗면. 그 위에는 바늘 둘레 헤드 묶음·슈·두 바퀴만, 보·윗헤드 몸체·대차는 매트 위 높이 여유(임시 ≥ 매트 두께 + 노루발 들림 20 + 여유) 위. ② **좁은 U홈(폭 25, D-02·D-14)**: 홈 안을 박을 때 바늘 옆 바퀴가 홈 빈 공간 위에 오면 든다(공압), 그 구간 방향은 먼 쪽 바퀴 + 헤드 이송, 바퀴 묶음에 매트 유무 센서. 노루발·바인더 끝·슈 묶음 폭 < 가장 좁은 홈 폭, 홈 바닥 180° 회전 중 반대 벽과 틈 > 0. ③ 먼 쪽 대차: 바퀴를 들고 X를 옮긴 뒤 내림, 매트 회전 중 대차·기둥이 매트와 간섭 0. 내리는 조건: 바퀴 밑에 매트가 있고 d₂ ≥ 2·d₁ + 바퀴 묶음 폭(임시). ④ 테이프 길(롤 → 바인더)은 윗헤드 높이로 지나가 매트와 만나지 않는다. ⑤ 툴 카세트(바인더·안내·절단·접기)는 위치 결정 핀 + 원터치 클램프(C-20) |
| 0-8-3 유닛 나누기·배치 | 아래 유닛 표. 좌표: 바늘점 원점, 테이블 면 Z 0, 매트 이송 방향 +Y(작업자 반대쪽), 작업자 −Y, 매트 몸통은 −X 쪽 |
| 0-8-4 한 사이클 타이밍 | ① 작업자가 매트를 볼 테이블에 올리고 직선 구간 가장자리를 노루발 밑 표시에 맞춘 뒤 시작(C-19) → ② 노루발·바늘 옆 바퀴·슈 내림, 먼 쪽 대차는 프로그램(매트 크기)의 d₂로 X 이동해 필요하면 내림, 센서 확인 → ③ 봉제: 헤드 이송이 끌고 두 바퀴가 잡기·방향, 테이프는 바인더가 공급 → ④ 모서리·홈 바닥마다 멈춤·노루발 낮은 누름(C-39)·바퀴로 회전·재개, 좁은 홈에서는 바늘 옆 바퀴 들기 → ⑤ 끝나기 전 테이프 절단·끝 접기 → 시작부 위로 겹쳐 박기 → 자동 사절, 새 앞끝은 바인더에 남음(US6044783A·US4688499) → ⑥ 노루발·바퀴·슈 들기, 작업자가 꺼냄. 사이클 목표 D-12(참고 R375A 45~50 s) |
| 0-8-5 된다는 근거 | 상용 기계 R375X가 이 구조로 카매트를 박는다(사진). 바퀴 차동 회전은 US5493980A(소멸)·CN106757804A·CN112726042A(거절)에 있다. 매트 몸통이 바늘의 −X 쪽에만 있는 것은 볼록 외곽을 박을 때뿐이다(+X로 9.2 mm, 1500×1500이면 그 구간 휘두름 X 약 2.1 m × Y 약 3.0 m). **오목·홈을 박을 때는 큰 부분이 +X로 넘어간다(RX-12 v2.16.0, C-47, 결정로그 RX-12-R2)**: 좁은 U홈 X 929.4 · 1,095,000 mm², V홈 914.7 · 935,308 mm², 긴 매트 + 넓은 오목(임시 1500×700, 오목 500×300, D-01·D-02) X 1052.1 · 550,000 mm². 휘두름 영역 X 약 −2112~+1052(3.2 m) × Y ±1494. 볼 테이블은 +X에서 X ≤ 900(패널 975)이고 X > 400은 Y ≥ −200뿐이라 오목 벽을 박는 동안 최대 323,536 mm²가 받침 밖이다(구동 후보 RX-12-C1·C2). **먼 쪽 바퀴가 필요한 이유(개략, 가정 매트 6 kg/1.44 m², 볼 마찰 무시, 모서리 90°를 약 1 s)**: 120×120 바늘(모서리) 중심 관성 약 5.8 kg·m² → 토크 약 36 N·m → 바늘 옆 바퀴(d ≈ 0.1 m) 약 360 N(파일 면 미끄럼·자국) vs 먼 쪽 바퀴(d ≈ 0.8 m) 약 45 N. 30×20은 약 0.1 N·m로 바늘 옆 바퀴만으로 충분. 회전 시간을 늘리면 필요한 힘은 시간 제곱에 반비례. 헤드 수치(Dürkopp 867 공식 PDF, 기종 확정 전 임시 C-25): 3000 땀/분, 땀 길이 ≤ 12, 들림 20, 가마 Ø32, 암 밑 335×125. 사이클 개략: 둘레 6 m, 땀 4 mm·2000 rpm → 8 m/min → 봉제 약 45 s + 모서리. **모르는 것(자료대기 D-92~)**: 매트를 잡는 힘 범위(고르게 감기는 최소 ~ 자국 안 나는 최대), 바퀴 재질·경도·지름·누름 힘, 바인더 쪽으로 붙이는 세기(속도 차이 %·틀기 각도), 바퀴–매트 미끄럼, 볼 유닛 형번·피치·저항, 먼 쪽 바퀴 밑 받침, 두 바퀴 역할 분담(사진 추정 — 같은 Y 줄인지, 봉제 중 대차가 움직이는지; R375X 영상으로 확인), 바늘 옆 바퀴 매달기 방식, 보 앞 볼나사 X축 + 3위치 실린더 용도, 테이블 밑 아랫유닛, 분리형 헤드 구매·개조(D-10), 좁은 홈 실제 마감(7절) |
| 0-8-6 확립(사용자 동의) | **확립 2026-11-03, 사용자(hyeunung).** 원문: "응, 시작" — 질문 "이 초안대로 0-8을 확립하고 v2.0.0을 시작할까요?"에 대한 답. 그 앞 대화: "R375X방식이 맞다", 사진 판독(세션 "Rimac R375X 분석": "진공원판 안해도 되는거 아닌가...", "r375x 보니까 밑에 롤러를 두면서 조금만 롤러가 살짝 누르면서 돌아도 쉽게 이동하도록 아래 볼롤을 둬서 자국안나고 잘도나보다"), 위 0-8-1에 적은 바퀴 역할 발언들. 안을 낸 쪽: Claude(사진 판독·특허·개략 계산), 원칙·요구는 사용자. 초안에서 정한 작은 결정(좁은 홈 = 바늘 옆 바퀴 들기 + 먼 쪽 바퀴, C-03 고침, v1.0.x 동결)은 결정로그 C-27~C-30. 특허 KR102139457B1 변리사 확인은 사용자 결정 대기(D-102) |

0-8-3 유닛 표:

**원칙: 벤치마크를 거의 그대로 쓴다**(사용자 2026-11-03 "최대한 벤치마킹한거 다써야해 거진 그대로만드는 방향으로 가야 최대한 쉽지"). 벤치마크는 R375X 제품 사진(판독은 [benchmark.md](benchmark.md)), 새로 하는 것은 사진으로 안 보이는 곳·벤치마크에 없는 경우(좁은 홈)만.

| 유닛 | 하는 일 | 대략 위치·공간(mm) | 맞닿는 유닛 | 그대로 가져오는 벤치마크(출처) | 새로 하는 것(벤치마크로 안 되는 이유) |
|---|---|---|---|---|---|
| U1 프레임 + 보 | 전폭 보(브리지), 양옆 기둥, 전체 받침. 윗헤드·먼 쪽 대차 가이드를 단다 | 매트 휘두름 영역(X 약 2.1 × Y 약 3.0 m) 밖에 기둥, 보는 바늘을 지나는 X선 근처 위 | U2, U3, U5, U8 | **R375X 전체 사진**(파란 전폭 보, 양옆 기둥, 전폭 약 2.5 m) | 치수 — 1500×1500 매트(C-16) |
| U2 볼 테이블 | 매트를 받침. 타공 스테인리스 판 + 수지 볼 트랜스퍼, 윗면 = 바늘판 높이 | 휘두름 영역 전체(아랫유닛·바늘 옆 바퀴 밑 원판 자리 빼고) | U1, U3(바늘판), U4(밑 원판) | **R375X 사진**(흰 수지 볼, 타공판). 볼 유닛 후보 미스미 수지 볼 계열·Alwayse 폴리아마이드 25.4(형번 D-96) | 바늘 옆 바퀴 밑 자유 회전 원판 자리(약 Ø250) — 사진에 판은 보이나 회전 구조는 안 보임 |
| U3 재봉 헤드 | 바늘·3중 이송·노루발 들기 20·자동 사절·바인더. 윗헤드 매달기 + 아랫유닛(가마·톱니) 분리 | 바늘점 원점. 867 암 밑 335×125(공식 PDF, 임시), 테이블 위는 바늘 둘레 묶음만 | U1(매달림), U2, U4·U6(노루발 옆·앞), U7 | **R375X 사진**(M-TYPE 헤드, 기둥 없이 보에 매달림 추정), **867 공식 PDF**(임시 치수, C-25) | 분리 개조 — 사진에 테이블 밑 구조가 없음, 기종은 견적 뒤(D-10) |
| U4 바늘 옆 바퀴 | 늘 잡기 + 방향 + 가장자리를 바인더 쪽으로 붙이기 + 작은 매트 회전. 서보 + 감속기 + 고무 바퀴, 스윙 암, 공압 누름·들기, 밑 원판 | 바늘을 지나는 X선 위, 바늘에서 −X d₁(임시 약 100) | U2, U3, U6, U8 | **R375X 사진**(서보 직결 바퀴, 핀 스윙 암, 세로 공압 실린더, 바퀴 밑 원판), **CN106757804A**(노루발 옆 보조 바퀴) | 좁은 홈 들기 + 매트 유무 센서(벤치마크에 좁은 홈 없음), 바퀴 각도 조절 자리 |
| U5 먼 쪽 바퀴 | 필요할 때 뒤를 잡음(큰 매트 회전, 긴 매트 끝 흐름, 좁은 홈, 프로그램 지정). 전폭 X 가이드 + 서보 대차(d₂를 앎), 공압 승강, 서보 바퀴(토크 제어 보조) | 바늘을 지나는 X선을 따라 −X 쪽 전폭, 대차 행정 약 1.5 m(1500 매트) | U1, U2, U8 | **R375X 전체 사진**(노란 눈금 띠 전폭 가이드, 대차, 서보 + 붉은 바퀴, 보 위 케이블 체인, 작은 매트일 때 매트 밖), **CN112726042A**(먼 쪽 핀치 바퀴) | d₂ 규칙(매트 크기별), 바퀴 밑 매트 유무 센서, 토크 제어 — 사진으로 제어가 안 보임 |
| U6 가장자리 센서 + 슈 | 바늘 앞 가장자리 위치, 매트를 바늘 앞에서 평평하게 | 바늘 앞(+Y), 바퀴와 바늘 사이 | U3, U4, U8 | **R375X 사진**(스테인리스 슈 + 슈 위 광센서 블록, 비키는 가로 실린더), **US5367966**(비례 조향) | 없음 |
| U7 테이프 | 롤 → 안내 → 바인더, 절단·끝 접기, 앞끝 남기기 | 윗헤드 옆·위, 테이블 위 높이 여유 안 | U1, U3, U8 | **R375X**(테이프 커팅 유닛·열절단 옵션, 헤드 위 실린더), **867 바인더**, **US6044783A**, **US4688499** | 툴 카세트 원터치 교체·식별(C-20, 공개 사례 없음) |
| U8 공압·안전 | 레귤레이터 3개(바퀴 2·슈), 밸브, 라이트 커튼, 경광등, HMI 자리 | 보 앞판(레귤레이터), 기계 양옆(라이트 커튼) | U1, U4, U5, U6 | **R375X 사진**(게이지 달린 레귤레이터 3, 솔레노이드, 노란 라이트 커튼, 경광등, 터치패널) | 없음(제어·전장은 기구 뒤, U-09) |

빠진 것(v1.0): 진공 원판·이젝터·진공관, 조향 회전축, X·Y 따라가기 받침(볼나사·서보·케이블 베어), 에어 테이블·송풍기·사슬 보관. 로딩(v1.0 U9)은 U2 위 올리는 표시로 M00에서 다룬다.

## 1. 우선순위 (충돌하면 위가 이긴다)

| 칸 | 내용 |
|---|---|
| 1-1 비용보다 앞서는 것 | ① **좁은 홈·오목 모서리를 포함한 외곽 전체의 마감 품질**(대기업 납품 제품, 사용자 2026-10-30) ② **영구 눌림자국 없음**(눌렸다 복원되면 OK, 전임 기계 퇴짜 사유, C-03·C-04). 판정 기준은 납품처 기준·한도견본(D-08) ③ **이음매가 최대한 티 안 나게**: 시작·끝이 겹쳐 물리고 끝의 자른 면은 접어 넣음(C-19) ④ 좁고 깊은 U홈까지(C-17) ⑤ 테이프 폭 툴 교체로 여러 아이템(C-20). |
| 1-2 과사양 기준 | 기본값 — U-05, U-02 |
| 1-3 비교 방식 | 기본값 — M-10, U-06 |
| 1-4 작업 순서 | 엔진 규칙(E-02·E-03). 이 기계에서 먼저 끝낼 구동 과제: T01 매트 잡기·회전, T02 헤드 묶음 홈 진입(가장 좁은 홈이 헤드 주변 크기의 한계를 정한다) |
| 1-5 마감 기준 | 기본값 — U-10, U-11. 추가: **알루미늄 프로파일(형재)을 쓰면 열린 끝마다 마감캡을 단다**(사용자 2026-10-30 "프로파일 사용시 항상 마감캡 써줬으면 좋겠어", C-11). 다른 부품·브래킷에 맞대 막힌 끝은 빼고, 캡은 미스미 형번으로 BOM에 넣는다 |

## 2. 만드는 법

| 칸 | 내용 |
|---|---|
| 2-1 가공 방식 | 기본값 — U-05, U-18. 판금 재질 미정 — 접목기 값 SUS304로 진행 |
| 2-2 체결 정책 | 기본값 — U-12. 지름 미정 — 접목기 값 M5로 진행 |
| 2-3 정비성 | 기본값 — M-02. 바늘·노루발·바인더·테이프 롤처럼 자주 바꾸는 것은 브래킷을 떼지 않고 바꾼다 |
| 2-4 공압·구동 | 매트 회전·이송, 헤드 회전처럼 가장자리 센서를 따라 위치를 계속 바꾸는 축은 전동(서보·스텝, C-02). 들어 올리기·누르기·자르기 같은 끝점 동작은 기본값 U-05(둥근 실린더). 운전 압력 미정 |

## 3. 사는 곳

| 칸 | 내용 |
|---|---|
| 3-1 구매처·가격 기준 | 기본값 — U-08(미스미 표준가, 모르면 "미확인"). 재봉 헤드·바인더는 미스미에 없다 → 기종·구매처 D-10 |
| 3-2 STEP | 크롬(Claude in Chrome)에 미스미 로그인이 돼 있다(사용자 2026-10-30 "크롬에 misumi 로그인해놨다 참고"). **에이전트의 미스미 STEP 다운로드와 CAD 약관 동의를 허락한다**(사용자 2026-10-30 "받아도돼", "무조건 받아도돼"). 크롬에서 받아 `purchased-step/<형번>/`에 둔다. 주문·결제는 하지 않는다. **STEP 받기에 돈이 드는 것(유료 CAD·유료 회원 전용·포인트 차감 등)은 받지 않는다**(사용자 2026-10-30 "step파일 받는데 돈드느건 그냥 하지마") — 무료 STEP과 같게 E-10 임시 형상 + 자료대기 D-번호로 두고 "유료"라고 적는다. 로그인이 풀리면 다시 로그인하지 않고(비밀번호 입력 안 함) 못 받은 형번을 자료대기에 D-번호로 남긴다. 못 받으면 E-10 임시 형상(`STEP대기_<형번>`)으로 진행하고 자료대기에 적는다 |
| 3-3 재사용 | 전임 의뢰 기계 부품 재사용 여부 미정 — D-09 |

## 4. 하지 말 것

| 칸 | 내용 |
|---|---|
| 4-1 금지 부품·방식 | 기본값 — U-14, U-12. 추가: **매트 파일 면을 롤러·바퀴로 세게 눌러 잡거나 끄는 방식**(전임 기계 실패, C-03 → C-28). 바퀴 자체는 금지하지 않는다 — v2.0은 서보 바퀴 2개가 약하게(공압 조절) 눌러 잡고, 자국 한도는 시제품에서 정한다 |
| 4-2 손대지 말 것 | 없음 |

## 5. 과제 목록

구동 과제를 먼저 둔다(1-4). 구동 과제마다 0-8의 유닛(U1~U8, 0-8-3 유닛 표)에 속한다. 0-8에 없는 유닛·원리(커버·외장 포함)는 구동 과제로 두지 않는다. 합격 기준의 수치 중 측정이 필요한 것은 D-번호로 가리키고, 값이 들어오기 전에는 임시값으로 진행한다(E-12).

**v2.0 과제(2026-11-03, 0-8 v2 확립).** v1.0 과제 N00~N08·DC-01~DC-08은 `archive_v1/docs/task-list-v1.md`(참고만).

| id | 과제 | 무엇이 돼야 하나(brief) | 합격 기준(수치) | 종류 | 상태 |
|---|---|---|---|---|---|
| M00 | 전체 골격 (U1~U8) | 빈 파일에서 시작. 0-8-3 유닛 8개를 차지 공간 상자로 한 파일에 놓고(위치·공간은 0-8-3 표·0-8-5), 조인트(바늘 옆 바퀴 회전·누름, 먼 쪽 대차 X·승강·바퀴 회전, 노루발 들기, 바늘)와 매트 모형 3장(1500×1500, 300×200, 좁은 U홈 매트 — 자료대기 0절 임시값)을 넣는다. 매트는 볼 위 평면 운동(모형용 X·Y·회전, 기계 축 아님)으로 0-8-4 한 사이클을 동작 연구로. 기계 전체 크기, 보 높이, 볼 테이블 크기, d₁, 대차 행정, 작업면 높이를 정한다. 저장 `FSAP_v2.0.0.sc` | 매트 3장 한 사이클 전체 간섭 0(전체 회귀), 휘두름 영역 안에 U1 기둥 없음, 대차 행정이 1500 매트의 d₂ 범위를 덮음, 정한 치수를 결정로그에 | 구동 | 해결 v2.0.1(과제 범위 간섭 0, 전체 회귀는 라운드 끝. 디테일 M00-X6) |
| M01 | U3 헤드 개조 + 좁은 홈 묶음 | 3중 이송 헤드(C-25, 기종 확정 전 867 공식 PDF 치수로 `STEP대기_`) 윗헤드 매달기 + 아랫유닛(가마·톱니) 분리, 테이블 위는 바늘 둘레 묶음만. 노루발·바인더 끝·슈 자리가 가장 좁은 홈(폭 25·R12.5 임시)에 들어가게. v1.0 N01(`archive_v1/`)은 참고 | 좁은 U홈 매트로 홈 전 구간 간섭 0, 홈 바닥 바늘 중심 180° 회전 중 반대 벽과 틈 > 0, 홈 건너편 매트 몸통이 헤드 밑을 지남(간섭 0) | 구동 | 해결 v2.0.2(과제 범위 간섭 0, 전체 회귀는 라운드 끝. 디테일 M01-X4·F1~F4, STEP대기 D-109·D-110) |
| M02 | U4 바늘 옆 바퀴 | R375X 사진 그대로: 서보 + 감속기 + 고무 바퀴, 핀 스윙 암, 세로 공압 누름·들기, 바퀴 밑 자유 회전 원판(약 Ø250). 바늘을 지나는 X선 위 d₁. 매트 유무 센서 자리, 바퀴 각도 조절 자리(몇 도) | 매트 3장 전 구간 간섭 0, 좁은 홈에서 바퀴 든 자세 간섭 0, 누름 힘 범위(D-92 임시)로 실린더 크기 손계산, 작은 매트 모서리 회전 토크 손계산(0-8-5) | 구동 | 해결 v2.1.0(매트 3장 과제 범위 간섭 0, 홈 들림 간섭 0, 실린더 Ø20 SF 1.42, 작은 매트 모서리 0.296 N·m. 디테일 M02-X1~X9·F1~F6) |
| M03 | U5 먼 쪽 바퀴 대차 | R375X 사진 그대로: 바늘을 지나는 X선을 따라가는 전폭 가이드(행정 약 1.5 m) + 서보 대차, 공압 승강, 서보 바퀴, 대차 케이블 체인. 매트 유무 센서 자리 | d₂ 전 범위·매트 3장 회전 중 간섭 0, 120×120 모서리 회전 토크 손계산(0-8-5, 미끄럼 SF), 바퀴 든 자세에서 매트와 틈 > 0 | 구동 | 해결(v2.1.2, 디테일 M03-V1~V7·X1~X9) |
| M04 | U2 볼 테이블 | 타공 스테인리스 판 + 수지 볼 트랜스퍼(형번 D-96), 윗면 = 바늘판 높이, 바늘 옆 원판·아랫유닛 자리, 받침 | 휘두름 영역 전체를 덮음, 매트 3장 전 구간 뒷면이 볼 위, 판 처짐 손계산(매트 + 바퀴 누름) | 구동 | 해결(v2.1.5, 설계검토서 FSAP_v2.1.5_review.md. 디테일 M04-F2~F5·X2·X9·X10 남음) |
| M05 | U7 테이프 툴 카세트 | 바인더 + 안내 + 절단(R375X 커팅) + 끝 접어 넣기(US6044783A) + 앞끝 남기기(US4688499)를 한 덩어리, 원터치 교체 | 이음매 단계(0-8-4 ⑤) 동작 간섭 0, 카세트 탈착 길 확보, 좁은 홈 묶음(M01) 안에 듦 | 구동 | 해결(v2.2.0, 2026-11-04; 이음매·탈착 겹침 0, 디테일 M05-X1~X14, STEP대기 MSTH6-20·KC-40340·S-M5-2 D-120~D-122) |
| M06 | U6 센서 + 슈, U7 롤 걸이 | R375X 사진 그대로: 바늘 앞 스테인리스 슈 + 슈 위 광센서, 비키는 실린더. 테이프 롤 걸이·안내 | 직선·모서리·홈 안에서 센서 시야가 가장자리에 걸림, 슈 비킨 자세 간섭 0, 테이프 길이 매트와 간섭 0 | 구동 | 해결(v2.3.0, 2026-11-04. 작은 매트 시작 구간은 시작점 규칙 D-123, 디테일 M06-D1~D4) |
| M07 | U1 프레임 + 보 | 전폭 보·양옆 기둥, 윗헤드·대차 가이드 붙는 자리, 기둥은 휘두름 영역 밖 | 전 구간 간섭 0, 바늘점 흔들림·보 처짐 손계산(끌림·누름 하중, D-08 임시) | 구동 | 해결(v2.3.4) — 디테일 M07-D9·F1. 구동 후보 M07-K1 해결(v2.5.3, 디테일 M07K-D1~D5) |
| M08 | U8 공압·안전 자리 | 레귤레이터 3개·밸브·라이트 커튼·경광등·HMI 자리, 배관 길 | 작업자 손 닿는 범위, 라이트 커튼 시야가 로딩 면을 덮음, 간섭 0 | 구동 | 해결(v2.5.2, 2026-11-05 `docs/review/FSAP_v2.5.2_review.md` — v2.5.0 모델·v2.5.1 수정 1·v2.5.2 움직인 자세 측정, 최종 판정 pass, 디테일 M08-X1~X7, STEP 대기 D-132~D-141) |
| M04R | U2 볼 테이블 사진대로 다시 (C-31) | 사용자 2026-11-04 지적("매트에 볼 너무 많은거 아니야", "가운데 저 네모난판은 뭐야? 사진엔 저런거 없었잖아"). R375X 사진(benchmark 39·43·70행: 타공 스테인리스 판에 흰 볼 **수백 개**, 바늘 옆 둥근 원판 둘레는 회색 테두리 틈 다음 바로 볼)대로: ① 볼 피치 50(2,624개, D-96 임시·근거 없음)을 줄여 수백 개로 — 임시 피치 100 격자(약 650개), 사진 비례 실측 전까지 D-96 임시값 ② 센터판 `P_M04_INSERT`(A5052 t40, 525×600)를 빼고 원판 테두리 바로 밖까지 볼 ③ 먼 쪽 바퀴 길 받침 띠(DC2-05 `P_DC205_STRIP`)와 고하중 볼 줄은 그 자리 유지(필요하면 피치 맞춰 조정) ④ 매트 모형 WP_MAT_*·WP_TAPE_* 등 작업 대상 모형은 기계와 구분해 기본 숨김 | 매트 3장 전 구간 뒷면 받침(볼·원판·바늘판·받침 띠 위, 작은 매트는 원판 + 둘레 볼 — 볼 0개 자세는 받침 면적 비율로 판정하고 결과를 결정로그에), 볼 하나 하중 손계산(바퀴 누름 D-92 임시), 사진과 같은 구성(사각 센터판 없음), 간섭 0 | 구동 | 해결(v2.4.0, 설계검토서 FSAP_v2.4.0_review.md. 볼 827·센터판 0. 디테일 M04R-V1·V2·F1·H1·H2, STEP대기 D-117·D-118) |
| DC2-01 | 윗헤드 매달기 공구 접근 | 매달기 판이 헤드·보 사이 틈 0으로 끼어 체결·정렬 조정 공구 불가(열린 띠 Z 560~650 90뿐). 매달기를 헤드 윗면 위 브래킷으로 하거나 보와 헤드 사이를 렌치 길만큼 띄움 | 체결·조정 나사에 위·앞에서 공구 닿음, 간섭 0 | 구동 후보 | 해결(확인 2026-11-03, mech_DC2-01_measure.md) — v2.0.2 M01 매달기 L판 + 헤드 뒤–보 틈 Y 90~120, 렌치 길 10개 막힘 0 |
| DC2-02 | 레귤레이터 앞 롤 가림 | U8_REG 앞을 U7_ROLL이 가림(X 55 %·Z 83 %, Y 틈 20). 레귤레이터 X 830~1150로 또는 롤을 Z ≥ 560 | 손잡이·게이지·배관 구에 손 닿음, 롤 교체 길 | 구동 후보 | 해결(확인 2026-11-03, v2.3.2 — M06 v2.3.0에서 롤 Z 600~900. 손 길·롤 교체 길 겹침 0 mm³, mech_DC2-02_measure.md) |
| DC2-03 | 아랫유닛 북 교체 길 | 가마·북 칸 사방 막힘. −Y 서랍 + U2_SUB·U1_BASE 앞 개구, 또는 바늘판 +X 끼움판 | 북 빼는 길 간섭 0 | 구동 후보 | **해결(FSAP_v2.5.5)**: LOWER −Y 북 문, 받이 판 P_DC203_TRAY 양끝 받침, 포켓 바닥 비움. 디테일 DC203-D1~D6(결정로그 '구동 DC2-03 결과') |
| DC2-04 | 매트 두께 높이 사슬 | 바퀴 내림 끝·슈·바인더·노루발 바닥이 두께 10에 고정. 누름 행정 = 두께 범위 + 들림 여유, 접촉 추종, 슈·바인더 높이 조절 자리. M00-X6 함께 | 두께 범위(D-04) 전체에서 누름 > 0·걸림 0 | 구동 후보 | 해결(v2.3.2, 임시 두께 6~16 D-04, 디테일 DC2-04-T1~T6) |
| DC2-05 | 먼 쪽 바퀴 밑 받침 | 바퀴 폭 25 < 볼 피치 50 → 볼 0~1개에 누름 약 90 N 몰림(C-03 자국 위험). 바퀴 길 밑 저마찰 평판 띠 또는 촘촘한 볼 띠 | 바퀴 길 전 구간 받침 연속 | 구동 후보 | 해결(v2.2.0, 2026-11-03; A5052 평판 띠 P_DC205_STRIP t8 + 누름판 + CB5-12 ×8(0.6 N·m), 바퀴 길 전 구간 받침 연속·간섭 0, 디테일 4건, 띠 마찰은 7절) |
| DC2-06 | 바늘 옆 바퀴 마운트 ↔ 머리판 | U4_MOUNT가 헤드 −X 면과 틈 10 → 머리판·바늘대 조정 길 막힘. 통째 떼는 마운트 또는 약 60 띄움(d₁ 100 유지) | 머리판 탈착 길 간섭 0 | 구동 후보 | 해결 v2.1.1(정비 상태 MAINT_HEAD, 머리판 통로 간섭 0·틈 1.14, d₁ 100. 디테일 DC2-06-D1·D2, 머리판 실치수 D-10) |
| DC2-07 | 밸브 묶음 실물 포트 방향 | 6스테이션 밸브 묶음(SS5Y3-20-06 + SY3120-5LZD-M5 ×6) 실물은 밸브가 매니폴드 위로 32.8 더 나가고 A·B 포트 간격 10 — 임시 엘보 KQ2L06-M5A 11개(18.5 > 10, 8.5 겹침)·관 11줄 재배치. 받침 L판 + 밸브 길이 방향 Z, A +Z·B −Z 또는 스트레이트 KQ2H06-M5A | 실물 STEP 넣고 피팅·관 간섭 0 | 구동 후보 | 해결(확인 2026-11-04, v2.5.7 — STEPSWAP SW-R1·R4·R5, mech_DC2-07_measure.md) |
| DC2-08 | 다관 커넥터 소켓 J_U7_HGT 따라가기 | KDM10 소켓·받침은 U8 고정, 플러그는 J_U7_HGT(−4~+6)로 움직여 두께 6·16에서 Z 4~6 어긋남. 소켓 받침을 U7_FIXED(HOLDER) 위로 | J_U7_HGT −4·0·+6 × CST_X 0·25 짝 축 어긋남 0, 과제 범위 간섭 0(관 TU0604_M08K_U7 포함), 받침 체결 공구 막힘 0 | 구동 후보 | 해결(v2.6.2, 설계검토서 FSAP_v2.6.2_review.md. 디테일 DC2-08-X1~X6) |
| REG-01 | 전체 회귀 못 본 범위 | v2.5.5 전체 회귀가 상한에 끊김: STATES 24-34(THICK_6·16, SEAM_U7, MAINT_U7, J_U5_X 1380), 연속 연구 CYCLE_*·SEAM/MAINT, POSE 0-182, 체결 169·관 44·둘레 29 바디 미검사 | 못 본 범위 간섭 0 | 구동 후보 | 해결(확인 2026-11-08, mech_REG-01_measure.md·결정로그 REG-01-C1) — `FSAP_v2.6.7.sc` 형상 변경 없음. 마지막 못 본 범위 F_STATES U7@26 35상태 겹침 0·unchecked 0. 이전: 미해결 — v2.6.3: 연구 U7 키 넣어 넘어옴 0, CYCLE_L 79~634 등 593단계 겹침 0. 못 본 범위(CYCLE_L 0~78·635~716 일부, G1·G2·S, STATES, MAINT, POSE, F_STATES)는 다음 회귀(mech_REG-01_model1.md 3절). v2.6.4 r3: CYCLE_S 43~362·STATES 25·33·34·POSE 0~7 겹침 0. 못 본 범위 CYCLE_S 363~450, G1 0~514, G2 0~630, MAINT_U7 9, POSE 8~182, F_STATES 0~34(mech_REG-01_model.md 4절) |
| STEPSWAP | STEP대기 실물 교체 | HTPA60S5M150-A-N16·6200ZZ·HTBO-S5M150-792·MGPM25-40Z·CB6-20·SFB5-10·SFB5-12·MSTH6-20·CB3-10·HFS8-80160-1090·KQ2L08-01AS·SS5Y3-20-06·SY3120-5LZD-M5·LR6-302WJBW-RYG·KDM10-06·CB4-20·CB4-12 STEP대기_를 실물로 | 이 형번들의 STEP대기_ 0, 교체 뒤 새 겹침 0 | 구매품 실물 교체 | **해결(v2.5.7)** — 결정로그 SW-R1~R12, 디테일 SW-D1~D8; r2 CB6-16·CB4-25 **해결(v2.5.9)** SW3-R1, 디테일 SW3-D1·D2; r3 CB5-6 **해결(v2.6.4)**, 디테일 M08R-D1(기존); r4 IR1000-01BG **해결(v2.6.8)**, 디테일 SW4-D1·D2 |
| LITE | 모델 무게 줄이기 (WF-196) | 열기 493 s(상한 240 s). 무거운 바디 피처 이력 정리, 형상·부품 수·BOM 그대로 | 열기 ≤ 240 s, lite_check 전후 같음 | 구동 후보(모델 표현) | **해결(v2.6.5) → 다시 무거워져 v2.8.10에서 다시 함: 해결(줄인 만큼)** — 열기 844 → 397 s(−53 %, 상한 240 s 못 맞춤·판정 '줄인 만큼'), 바디 2,969·BOM 179행/2,616·bbox 차 0, 형상 변경 0. 남은 무게(필렛 띠 Combine 약 118 s)는 디테일(mech_LITE_model.md·verify.md, FSAP_v2.8.10_review.md) |
| REG-02 | POSE 8 U7 안내 ↔ U6 캐리지 겹침 | 전체 회귀(REG-01 r4)에서 POSE 8(J_U6_HGT +6, J_U7_HGT −4, 노루발 20) P_M05_GUIDE ↔ P_M06_CARR 291.7 mm³(X 12~18·Y −107~−100·Z 34~42). 두 HGT 다른 맞춤 잘못 자세 | 결정로그 C-34: J_U6_HGT·J_U7_HGT를 한 높이 조정으로 묶음(같은 값만 가능), POSE 8 같은 어긋난 자세는 정의에서 뺌. −4·0·+6 전부 겹침 0·GUIDE↔CARR 정적 틈 ≥ 2(REG02-E01) | 동작 문제 | 해결 — `FSAP_v2.6.7.sc`(C-34, REG02-E01·F01·R01) |
| RGSEE | 구동 회귀 못 본 범위 확인 | 지난 전체 회귀가 상한·오류로 못 본 범위(POSE 0-7·12-180, CYCLE_L·S·G1·G2·SEAM_U7·MAINT_HEAD·MAINT_U7, F_STATES U3~U7) | 못 본 범위 새 겹침 0, 라운드 끝 전체 회귀 못 본 범위 0 | 구동 후보 | 해결(확인 2026-11-08, mech_RGSEE_measure.md·결정로그 RGSEE-C1) — `FSAP_v2.6.7.sc` 형상 변경 없음. 직접 230점 겹침 0, 나머지 쌍 같음(E-17). 라운드 끝 회귀는 쌍 재사용을 본 범위로 센다(RGSEE-C2) |
| M08R | 라이트 커튼 짧게 (C-32) | 사용자 2026-11-05 "쓸데없이 올라온 기둥같은 프로파일들 다 제거해 길이 맞추던지 필요없는거면 없애" → "커튼 짧게". F3SG-4RA1520-14는 없는 형번(미스미 -14형: 0320·0800·1040·1120·1200·1280·1360). 앞·옆 커튼 2쌍을 실제 있는 짧은 형번(1안 F3SG-4RA0800-14)으로 바꾸고 기둥 3개(HFS8-4080-2370_M08_FL·1900_M08_FR·1900_M08_R)를 커튼 위끝에 맞춰 줄인다. 커튼 위로 손이 넘어 들어가는지 ISO 13855(넘어 닿기 거리 C_RO) 손계산 | 실제 있는 형번, 기둥 위끝 ≤ 커튼 위끝 + 캡, 넘어 닿기 판정 손계산을 결정로그에, 간섭 0 | 구동 | 해결(v2.6.0, 디테일 M08R-D1·STEP대기 F39-LSGF·CB5-6 남음) |
| MOT-01 | 모터·감속기 체결 빠짐 | 사용자 2026-11-09 "모터쪽에 나사빠진것도 많고". U3 아랫축 서보, U4 바늘 옆 바퀴 서보·감속기 VRXF, U5 대차 X·먼 쪽 바퀴 서보·감속기, 그 밖 구동기(실린더·풀리·벨트 클램프)의 플랜지·브래킷 체결을 하나씩 세어 빠진 볼트·와셔·너트·키·멈춤나사를 넣는다. 볼트 수·크기·자리는 형번 카탈로그 외형도(서보 □60 플랜지 4-Ø5.5 P.C.D 70 등 공식 도면) 그대로, 체결 길이·물림은 엔진 체결 규칙. **서보·감속기를 C-36 형번으로 바꾼다(STEP 받아 둠, purchased-step)**: MHMF022L1U2M ×3 → 미쓰비시 HG-KR23, 아랫축 MHMF042L1U2M → HG-KR43, 감속기 VRXF-PB-60-10 → ATG PGX62-H-10. STEP대기_ 바디를 실물로 바꾸고 바뀐 외형도(PGX62-H-1_drawing.pdf 등)대로 플랜지·어댑터 체결. 관성비·토크·회전수는 FUNC-01 ③에서 확인(안 맞으면 감속비·출력 조정) | 구동기 체결 자리 전부에 체결 부품 있음(빈 구멍·빈 탭 0), 물림 ≥ 엔진 기준, 공구 닿음, 간섭 0, BOM 반영 | 구동 | 일부(v2.7.0 — 디테일 MOT-01-D1·D2) |
| COLOR-01 | 모델 색 통일 | 사용자 2026-11-09 "컬러도 대부분 다 통일해서 넣어줘 볼트 그리고 흑색으로 하지마". 재질·역할별 색표 하나를 정해(예: 형재·알루미늄 판 = 은회색, 스테인리스 = 밝은 은색, 가공 강철 = 회색, 수지 = 흰색·연회색, 구매 기구품 = 받은 STEP 색 유지 또는 회색, 공압 관 = 반투명 파랑, 안전 = 노랑) 모든 바디에 적용. **볼트·너트·와셔 등 체결 부품은 흑색 금지** — 밝은 금속 회색(아연 도금·스테인리스 느낌) 하나로 통일. 색표는 결정로그에 | 색표 밖 색 바디 0(구매품 STEP 원색 예외는 목록), 체결 부품 흑색 0, 형상·BOM 변화 없음 | 구동 후보(모델 표현) | 해결(v2.8.2, 디테일 COLOR-D1) |
| PNEU-01 | 공압 연질 튜브 연결·고정 | 사용자 2026-11-09 "에어 호스 연결 끊긴것도 있고 고정어떻게 해야할지도… 모델링처럼 저렇게 직각으로 못하잖아". 공압은 경질 배관이 아니라 **연질 우레탄 튜브(예: SMC TU 계열 Ø4·Ø6·Ø8) + 원터치 피팅**으로 한다(사용자 2026-11-09 "그냥 연질 그 튜브"). 레귤레이터·밸브 → 실린더·진공·바인더 카세트까지 모든 호스를 하나씩 따라가 ① 양 끝이 실제 피팅(원터치 이음·스피드 컨트롤러 포트)에 꽂혀 있게(끊긴 곳·빈 포트 0) ② 꺾임은 호스 형번의 최소 굽힘 반경 이상(카탈로그 값, 직각 꺾임 금지) — 필요하면 엘보 피팅으로 ③ 고정: 튜브 클립·케이블 타이 마운트(형재 T홈용)·스파이럴/튜브 묶음를 일정 간격으로 형재·판에 두고, 움직이는 축(대차·승강·회전)을 건너는 호스는 케이블 체인 안 또는 늘어짐 고리로 행정 전 구간에서 당김·꺾임·간섭 0 ④ 호스 지름·길이·피팅·고정품을 BOM에. 형번은 미스미·SMC STEP 우선 | 끊긴 호스·빈 포트 0, 굽힘 반경 미달 0, 고정 간격 기준(카탈로그·엔진 규칙) 충족, 행정 전 구간 간섭 0, BOM 반영 | 구동 | 일부 v2.8.8(관–구멍 벽 겹침 2쌍 0.06·0.03 남음, 디테일 6 — 결정로그 '구동 PNEU-01 결과') |
| VGR-01 | 좁은 V자 홈 검증 | 요구서 0-2·1-1(좁은 V자 홈 마감)인데 시험 매트는 U홈(폭 25·R12.5)뿐이라 V홈은 한 번도 검사하지 않았다. 사용자 2026-11-09 "v모양의 좁은거 하는것도 문제 없다는거지?". 실측 V 각도·바닥 반경이 없으니(D-02·D-03) 문헌·사진 근거 있는 불리한 가정(좁은 각도, 바닥 반경 작게)을 D-번호로 잡아 V홈 시험 매트를 모델에 넣는다(같이: FUNC-01 구동 후보 F01-C1 — 시험 매트 땀–가장자리 e 0 → 6.5). ① 입구·꼭짓점·출구에서 바늘 꽂고 회전(0-8-1 절차) 중 묶음·바퀴·매트 간섭 0, 반대 벽 틈 > 0 ② 꼭짓점에서 남는 테이프 안쪽 날개(T05 계산 r0 꺾임당 약 15.7)를 어떻게 처리하는지(꼭짓점 접어 넣기·땀 간격·바인더 동작) 기구·순서로 정하고 손계산 ③ 바늘 옆 바퀴 들기·먼 쪽 바퀴 방향 유지 힘(FUNC-01 ⑥ 방식). **C-37(2026-11-10) 고쳐 적음:** U5가 매트 밖·테이프 띠 위인 꼭짓점 −35→−75(40°)·입구2 −75→−30(45°)은 U4 혼자 — d₁ 100 그대로, 볼 구름 ≤ 0.02(D-96 선정 조건), 땀 피벗(정지→정지) 단위로 셈 — 꼭짓점 땀마다 25° 피벗: U4+U5 75→−35 피벗 1.2 s×4 + 10° 1.0 s(최저 SF 1.291), ROT −35에서 U5 들기(수정 2회차: U5 접지면이 −37부터 테이프 띠 10 안, `design/vsweep2b.json`), U4만 −35→−50 15° 3.5 s(1.056)·−50→−75 25° 4.5 s(1.053), 입구2 U4만 −75→−30 9 s(1.028, 피벗 I 6.146)·U4+U5 −30→0 1.5 s(1.227), 입구1 2.5 s(1.336). U4 혼자 각가속도 ≤ 0.1039(꼭짓점)·0.0459(입구2) rad/s², 각속도 ≤ 11.1 °/s(`tools/out/mech_VGR-01/design/c37design1.json`, 수정 1회차 — 2회차의 연속 회전 셈 6 s SF 1.115·4 s SF 2.52는 피벗으로 나누면 0.932·0.689라 대체). **수정 1회차(모델링, 2026-11-10, 검도 지적):** U5 바퀴 밑 고정 PTFE 띠(P_DC205_STRIP) 미끄럼 μs·40 N·0.44(D-97 높은 쪽 0.30)와 U4 밑 원판 끌림을 넣어 U4+U5 시간 키를 늘림 — 입구1 75° 2.5→4.1 s, 꼭짓점 25° 1.2→2.0 s ×4, 10° 1.0→1.3 s, 입구2 30° 1.5→2.6 s, 입구2 U4만 9.0→9.5 s(원판 끌림 포함 최소 9.1). 최저 SF 1.009(입구1 m2 피벗), U4 혼자 1.012~1.022(`tools/out/mech_VGR-01/fix1calc.json`). 형상 변경 없음(v2.8.5) | V홈 매트로 ①~③ 성립(여유율)·간섭 0, 테이프 처리 방법이 결정로그에. 실제 주름·뭉침은 7절(시제품) | 구동 | 모델 반영(v2.8.4 — WP_V·J_WP_V_X·Y·ROT·CYCLE_V 486단계, 30자세 새 겹침 0, 바늘–벽 틈 5.7, U4 혼자 8.0·9.0 s SF ≥ 1.028; 검도 v2.8.4 487자세 새 겹침 0 · 반대 벽 틈 ≥ 5.7; 수정 1회차 v2.8.5 시간 키만 — U5 밑 띠 μs 0.30 넣어 최저 SF 1.009) — **해결(v2.8.5, 2026-11-10)**: 검도 487자세 새 겹침 0·반대 벽 틈 ≥ 5.7, U4 혼자 SF ≥ 1.044, U4+U5 ≥ 2.673 |
| FUNC-01 | 기능 이론 검증 — 매트가 돌고 랏빠가 감기는 게 이론상 성립하나 | 사용자 2026-11-09 "이론상으로도 존나 잘될거같이 해야한다", "이론상으로라도". 간섭 0만으로는 '된다'가 아니다. 지금 모델(v2.6.7)의 실제 부품 치수·형번으로 0-8-1·0-8-4 한 사이클의 각 기능이 물리적으로 성립하는지 손계산·기하로 따진다. 모르는 값(D-92~D-96 등)은 근거 있는 문헌·카탈로그 범위로 상·하한을 잡고 **불리한 쪽**으로 본다(지어내지 않음, 가정은 D-번호로). ① 잡기 vs 자국: 바퀴·슈·노루발 접촉 면압(누름 힘 / 접촉 면적, 바퀴 지름·폭·경도) ≤ 파일 면 허용 면압 가정 상한, 동시에 테이프가 고르게 감길 최소 잡는 힘 이상 — 두 사이 창이 레귤레이터(IR1000 0.005~0.2 MPa) 조정 범위 안 ② 미끄럼: 바퀴 마찰력(μ 하한 × 누름) ≥ 필요한 접선력(볼 구름 저항 × 매트 무게 + 가속 + 모서리 회전력), 모서리 회전은 큰 매트 먼 쪽 바퀴·작은 매트 바늘 옆 바퀴 각각. **DC-02(2026-11-10) 고쳐 적음:** 큰 매트 모서리 옛 "4.5 s 1.15 성립"은 U5 밑 띠 미끄럼이 빠진 셈(넣으면 0.823) → U4+U5 7.5 s, U5 밑 띠 μs 0.30·원판 포함 SF 1.014(DC-02, `tools/out/mech_DC-02/design/dc02design.json`). G 1200 보통 모서리는 U4+U5 4.5 s(SF 1.045). **DC-03(C-38, 2026-11-11) 고쳐 적음:** 큰·긴 매트 모서리(L 1500·G 1200)는 U4+U5로 돌리고, U4 혼자는 U5가 매트 밖인 짧은 구간(G1 바닥·출구, V 꼭짓점·입구2)만이다 — DC-03 설계의 G 안(U4 혼자 12.0 s, μ ≥ 0.5 선정 조건)과 L U4 혼자(정적 SF 0.518)는 쓰지 않는다. 그 구간 성립은 7절 실측 구름 c ≤ c_max(지금 키, μ 0.4·면밀도 6에서 0.0202~0.0207, `tools/out/mech_DC-03/close/dc03close.json`)로 판정 ③ 속도 동기: 바퀴 속도 v + ω·d가 최고 봉제 속도(3000 땀/분·땀 길이)에서 서보 회전수·감속비·바퀴 지름으로 나오고, 엔코더 분해능이 땀 길이보다 충분히 작음 ④ 가장자리 추종: 센서–바늘 거리 ÷ 최고 속도 ≥ 센서·제어·서보 응답 시간 합, 바인더 깊이 허용차 대비 센서 분해능, 볼록·오목 모서리 최소 반경에서 따라감 ⑤ 테이프 길·바인더: 테이프 사양 D-06이 없으니 흔한 카매트 바인딩 테이프 범위(폭·두께·소재, 판매처·문헌 근거)로 가정하고(C-35) 지금 임시 상자인 867 바인더를 실제로 테이프를 U자로 접는 형상(입구 폭·접는 깔때기 단면·출구–바늘 거리)으로 설계해 모델에 넣는다. 롤 → 안내 → 바인더 굽힘 반경·꺾임 각이 테이프 두께·폭에 무리 없음, 롤 브레이크 장력 범위, 땀당 공급 길이 = 3중 이송 길이, 절단·끝 접기·겹쳐 박기 타이밍이 0-8-4 ⑤ 순서로 성립 ⑥ 좁은 U홈(폭 25): 홈 안 바퀴 든 구간에서 먼 쪽 바퀴 + 헤드 이송만으로 방향 유지 가능한 힘·거리. **C-37(2026-11-10) 고쳐 적음:** 옛 SF 1.43은 U5가 회전 내내 닿는 가정이었다. CYCLE_G1 바닥 마지막 69°(ROT −21→−90)는 U5가 매트 밖이라 U4 혼자 — 구름 ≤ 0.02(D-96)·μ 0.4·40 N에서 땀 피벗(r 19에서 12°/땀) 단위로 −21→−30 9° 3.0 s·−30→−90 12°×5 각 3.4 s, U4 혼자 합 20 s에서 최저 SF 1.057(각가속도 ≤ 0.0902 rad/s²), U4+U5 90→−21 피벗 0.8 s SF 1.908(VGR-01 수정 1회차 `c37design1.json`; 2회차 연속 69° 8 s SF 1.048은 대체) ⑦ 사이클 시간: 둘레·모서리 수·회전 시간 합 vs D-12(참고 45~50 s). **DC-02 고쳐 적음:** 최대 1500×1500 73.0 → 85.0 s(모서리 4 × 8.5 s). **DC-04(2026-11-10, C-39) 고쳐 적음:** ② 회전(피벗) 중 노루발은 봉제 높이에 낮은 누름 Fp ≤ 20 N(임시, 2단의 피벗 쪽)으로 남아 끌림 T_f = 0.8 × 20 × 0.006 = 0.096 N·m(위·아래 두 면 μ 0.4, 평균 반경 6.0)를 회전 need에 더한다. U4 혼자 시간 키 V 꼭짓점 3.5→4.0·4.5→5.2 s, V 입구2 9.5→12.5 s, G1 바닥 3.0→3.4·3.4→4.0 s ×5, G1 출구 11.0→14.5 s, U4+U5 V 입구1 4.1→4.4 s·V 입구2 −30→0 2.6→2.7 s(수정 1회차, 끌림 포함 0.998→1.015) — 끌림 포함 최저 SF 1.009(U4 혼자)·1.009(U4+U5 L·V 꼭짓점 25°), U4 혼자 F4 ≤ 15.9 N(≤ 18 N 제어 제약), 피벗 옆힘 합 ≤ 17.8 N 중 노루발 몫 8 N·바늘 ≤ 9.8 N(노루발 없으면 ≤ 17.8 N, 둘 다 ≤ 견적 조건 20 N). ⑦ CYCLE_V +4.6 s·CYCLE_G1 +6.9 s(`tools/out/mech_DC-04/design/dc04design.json`). **⑦ DC-03(C-38, 2026-11-11):** 사이클 변화 0 — L 85.0 s(모서리 U4+U5 7.5 s ×4) 그대로, G2 모서리 4.5 s ×4 그대로, DC-03 설계의 홈 매트 160.8 s(G 모서리 U4 혼자 14.0 s ×5)는 채택 안 함, G1 출구는 DC-03 설계 11.0 s가 아니라 DC-04 14.5 s. **②·⑥·⑦ RX-11(C-45, v2.17.1, 2026-11-13):** U5 밑 띠를 롤러 2줄로 바꿔 띠 미끄럼 항(μs 0.30 × 40 N × d₂)이 없어지고 롤러 항(구름 0.05 × 40 N × d₂ + 바퀴 밖 롤러 0.18 N × Σ\|x\| × 2줄 + 롤러 관성)이 들어감 — U4+U5 시간 키 L 모서리 7.5 → 4.5 s(SF 1.228), G2 모서리 4.5 → 3.0(1.262), G1 바닥 1.2 → 0.8 ×9(1.281), V 입구1 4.4 → 3.0(1.146)·꼭짓점 2.0 ×4·1.3 → 1.5 ×4·1.0(1.175·1.237)·입구2 2.7 → 1.9(1.148). 사이클 L 85.0 → 73.0 s · G2 −6.0 · G1 −3.6 · V −4.5 s. U4 혼자 구간 키는 그대로(결정로그 RX-11-R3, `machine.json _timing`). 성립 안 하는 항목은 모델·형번을 고친다(구조 바꿈은 결정로그에 이유) | ①~⑦ 각각 성립(여유율 수치)·근거·가정 D-번호를 결정로그와 `docs/reports/mechanism/mech_FUNC-01_calc.md`에. 불성립 항목 0(고친 뒤), 고친 모델 간섭 0. 유연물 실제 거동은 계속 7절(시제품) | 구동 | 일부(v2.8.1 — 불성립 0, 디테일 F01-D1~D8; 구동 후보 F01-C1 해결 v2.8.3 — 매트 가장자리 바늘 +X 6.5, 새 겹침 0) |
| DC-01 (VGR) | 매트 끝 300 안 홈 회전 중 먼 쪽 바퀴(U5)가 매트 밖 — U4 혼자 회전력 모자람 | 2026-11-09 구동 후보 점검. CYCLE_G1 321단계~(바닥 마지막 69°), V30 꼭짓점 35°·입구2 45°(d2 440). U4 40 N×μ0.4×0.1 m = 1.60 N·m < 구름 저항 2.80 N·m(정적 SF 0.57, 자국 한도 51.6 N에서도 0.74). 사용자 결정 D-154: (가) d1 100 → ≥ 175(U4 묶음 이동, 추천) (나) 먼 쪽 바퀴 X선 밖도 잡기(0-8-1 변경) (다) 볼 구름 저항 ≤ 0.02 + 회전 ≥ 6 s | 그 구간 회전 SF ≥ 1(가속 포함)·간섭 0, FUNC-01 ⑥ 고쳐 적음 | 구동 후보 | 설계 반영(VGR-01 2회차) — C-37(다): d₁ 100 유지, 구름 ≤ 0.02(D-96), U4 혼자 회전을 땀 피벗 단위로 꼭짓점 10° 3.0 s·25° 4.5 s(SF 1.082·1.054)·입구2 45° 9 s(1.028)·G1 바닥 12° 3.4 s ×5 + 9° 3.0 s(최저 1.057), U4+U5 피벗 최저 1.227(가속 포함, 수정 1회차 c37design1.json), FUNC-01 ⑥·VGR-01 ③ 고쳐 적음. CYCLE_V 간섭 0은 모델링·검도 뒤. VGR-01 수정 1회차(v2.8.5): U5 밑 PTFE 띠 미끄럼 μs 0.30을 넣어 CYCLE_V U4+U5 키 4.1·2.0×4·1.3·2.6 s, 입구2 U4만 9.5 s — 최저 SF 1.009. CYCLE_G1·L·S·G 모서리의 같은 띠 저항은 구동 후보(해석부 VGR-01) → **해결(DC-01 v2.8.9, 2026-11-10, 검도 동작 문제 0 — 디테일 1건 D-96 여유 문구는 고쳐 적음, 검토서 FSAP_v2.8.9_review.md)**: CYCLE_G1 바닥(연구 210~390, ROT 1°/단계) U4 혼자 321~390(−21→−90, 69°) 시간 키 3.0 + 3.4×5 = 20 s 그대로 — 구름 0.02 판정 조건 SF 1.057, U4 밑 원판 끌림 포함 1.024. 같은 바닥의 U4+U5 피벗 키 0.8 → 1.2 s(띠 μs 0.30 포함 SF 0.836 → 1.054). 자세 그대로, 과제 범위 5점(321·338·356·373·390) 새 겹침 0. 계산 `tools/out/mech_DC-01/g1calc.json`, FUNC-01 ⑥·⑦ 고쳐 적음 |
| DC-02 | 보통 모서리 U5 밑 PTFE 띠 미끄럼 | 2026-11-10 구동 후보 점검. CYCLE_L·G 보통 모서리 U4+U5 회전에 U5 밑 고정 띠 P_DC205_STRIP 미끄럼(μs·40 N·d₂)이 빠짐. 구름 0.02·μs 0.30: L SF 0.823(SF1 7.12 s), G 0.847(4.04 s). (가, 추천) 시간 키 L 4.5→≥7.2 s·G 3.0→≥4.1 s, FUNC-01 ②·⑦ 고쳐 적음 (나) 띠 μs ≤ 0.15(D-97) (다) 자유 회전 원판 | 모서리 회전 SF ≥ 1(가속 포함)·간섭 0 | 구동 후보 | 모델 반영(시간 키만, 2026-11-10 — .sc 변경 없음, v2.8.10 그대로): L 모서리 U4+U5 4.5 → 7.5 s SF 1.014(SF1 7.12 s), G 보통 모서리 3.0 → 4.5 s SF 1.045(DC-03 G 안 반영 때는 U5 들림이라 띠 항 없음 → 닫음), `machine.json _timing.CYCLE_L_모서리·CYCLE_G2_모서리`, FUNC-01 ②·⑦ 고쳐 적음. **RX-11(v2.17.1, 2026-11-13): 띠를 롤러 2줄로 바꿔 띠 항이 없어짐 — L 모서리 7.5 → 4.5 s SF 1.228, G2 4.5 → 3.0 s SF 1.262(결정로그 RX-11-R3).** **일부(v2.8.10, 2026-11-10 문서 확정)** — 검도 동작 문제 0·SF 1.014/1.045 재계산 일치, 최종 판정 미합격(외부: 구름·띠 μs 실측 전 손계산, 디테일 DC02-D1·7절). L U4 혼자는 DC-03(사용자 "긴것도 혼자") 쪽 |
| DC-03 | 긴 매트도 U4 혼자 회전(사용자 "긴것도 혼자") | L 1500 모서리 U4 혼자: 잡는 1.60 < 구름 3.04 N·m, 정적 SF 0.518. SF1: 구름 ≤ 0.0102 또는 d₁ ≥ 193(누름 77 N은 C-03 자국 한도 초과로 제외). G 1200 0.997. 사용자 결정: (가) R375X 근거 말씀이면 닫음 (나) U4 d₁ ≥ 193 + 볼 구름 ≤ 0.01 | 사용자 결정 뒤 SF ≥ 1·간섭 0 | 구동 후보 | **해결(문서만, v2.8.13 그대로, 2026-11-11) — 사용자 결정 C-38(2026-11-10): (1)+(4).** L 1500 모서리 ×4는 U4+U5 7.5 s 그대로(구름 0.02·띠 μs 0.30 SF 1.014, DC-04 노루발 끌림 포함 1.009), G 1200 보통 모서리도 U4+U5 4.5 s 그대로(DC-03 설계 G 안 'U4 혼자 12.0 s·μ ≥ 0.5'는 채택 안 함). U4 혼자는 U5가 매트 밖인 짧은 구간(U홈 끝 300 안 G1 바닥 69°·G1 출구 71°, V 꼭짓점 40°·입구2 45°)만 — 지금 키(DC-04)에서 구름 0.02·μ 0.4·면밀도 6 SF 1.009~1.025. 판정 선(7절 실측): 그 구간 c ≤ c_max 0.0202~0.0207(μ 0.5면 0.026~0.028, 면밀도 2.5면 0.051~0.057), L U4+U5는 c ≤ 0.021(띠 μs 0.30). 형상·조인트·연구 키 변화 0, machine.json `_timing` 메모·`한계` c_max만(`tools/out/mech_DC-03/close/dc03close.json`, 보고서 mech_DC-03_model.md). '긴것도 혼자'는 R375X 근거였지 L 모서리 U4 혼자 요구가 아니다(C-38) 이전: 개념 재검토(2026-11-10 final_mech_2026-11-10_LITE-DC-03-DC-02-PNEU-01R-STEPWAIT.md: 구름 0.02에서 L 정적 SF 0.518, 12 s SF 1에 구름 ≤ 0.0044~0.0097 필요. 선택 (1) U4+U5 유지 (2) 휘두름 영역 강구 볼 (3) d₁ ≥ 193 (4) 7절 실측 조건부, 추천 (4)) |
| DC-04 | U4 혼자 회전 중 바늘 피벗 옆힘 | 2026-11-10 구동 후보 점검. 바퀴 하나(U4)는 짝힘이 아닌 힘이라 피벗인 바늘이 옆힘을 받는다: G 1200 12 s 최대 17.8 N, L 구름 0.02 36.6 N, 지금 모델 G1 바닥·V 약 13~15 N(어림). 바늘 Ø1.6 외팔 25에 15 N이면 933 MPa(D-10 임시). (가, 추천) 회전 중 노루발 낮은 누름 유지 — 0-8-1 순서 변경, 사용자 결정 (나) 헤드 사양에 바늘 Nm ≥ 180~200·옆힘 ≥ 20 N, F4 ≤ 18 N 제어 제약 (다) U4 혼자 구간 줄임(DC-03과 맞섬) | U4 혼자 구간 바늘 옆힘 ≤ 허용(근거 있는 값)·간섭 0, 찢김은 7절 | 구동 후보 | 미해결 — **사용자 결정 C-39(2026-11-10): (가)+(나)** 회전 중 노루발 낮은 누름(바늘+노루발 피벗, 0-8-1·0-8-4 순서 고침, 노루발 누름 2단 자리), 헤드 견적 조건 바늘 Nm ≥ 180~200·옆힘 ≥ 20 N(D-10), 제어 제약 U4 혼자 F4 ≤ 18 N. 노루발이 받는 옆힘·끌림 손계산, 연구 키(노루발 들기 값) 고침 · **모델링 v2.8.13(2026-11-11)**: 연구 CYCLE_L·S·G1·G2·V 노루발 키(회전 중 0, 들림 20은 로딩·배출만, 그동안 회전 0), states 13개, _timing 9곳 반영. 회전 자세 7점 겹침 0. **해결 v2.8.13(2026-11-11)** — 동작 문제 0, 디테일 DC04-D3(피벗 누름 ≤ 20 N 견적 조건, 외부 D-10·7절) |
| PNEU-01R | 관–구멍 벽 겹침 2쌍 | v2.8.8 남은 동작 문제: COMB_U5_2/TU0604_M08P_U5_A 0.06 mm, RISER_COMB_1/TU0604_M08P_U4_B 0.03 mm. 구멍 r 3.25→3.5 또는 꼭짓점 이동 | 관–구멍 겹침 0 | 구동 | 해결 v2.8.12(세 쌍 겹침 0, 과제 범위 간섭 0. 디테일 PNEU01R-D1) |
| M02R | U4 바퀴 누름: 보에 고정한 사각 실린더 + 그네식 스윙 브래킷(R375X) | 사용자 2026-11-11 R375X 사진 정정: "P_M07_BEAM에 사각 실린더? 엑추에이터? 사각형 저게 붙어서 심이 Y축으로 나오면서 움직이잖아 그렇게 저 롤러를 브라켓에 달아서 그네처럼 기울이면서 누르는형식" · "실린더가 앞뒤로 움직이면서 저 모터를 축연결해서 아래위로". **v2.10.2의 '모터 위 누운 실린더(X축) + 크랭크'는 틀린 해석이라 걷어 낸다**(C-41): `P_M02R_CYLBRKT`·`P_M02R_CRANK`·`_CRANK_PIN`·모터 위 CDM2C20 묶음과 J_U4_CYL_PIN·J_U4_CYL_ROD·J_U4_ROD_PIN. U8 회로 고침(1번 밸브 급기 = 주 공급, IR1000을 누름 쪽 관 사이 — 들기 SF 3.55)은 맞으니 그대로 둔다. 새 구조: ① **사각(박형) 실린더 몸을 보 `P_M07_BEAM`(Y 120~320 · Z 250~650)에 고정**, 로드가 **Y축(−Y, U4 쪽)**으로 나온다 ② 서보·감속기·바퀴를 **스윙 브래킷에 매달아**(피벗은 바퀴 위쪽, 축은 Y에 수직 — X축) ③ 로드 끝을 브래킷에 핀/축 연결 → 로드가 앞뒤(Y)로 움직이면 브래킷이 **그네처럼 기울며** 바퀴가 내려가 매트를 누르고, 반대로 가면 든다. 피벗 위치·축 방향·로드 연결점은 사진과 지금 U4 자리(바늘 X선 위 d₁, 모터 위 Z ≤ 보 밑 250)에 맞게 정한다. 실린더 형번은 보유 CDM2C20 재사용 또는 사각 박형(CQ2·CDQ2 등) — 미스미·SMC STEP. 기울면 바퀴 접지점이 Y로 움직이고 바퀴 면이 기우는 것을 손계산·자세로 확인(접지 이동량·바퀴 기울기각이 회전 SF·자국에 주는 영향). 바퀴 옆 가로 실린더(D-163)는 ② 스토퍼 자리만 | 레버비(로드 힘 → 바퀴 누름 40 N이 IR1000 0.005~0.2 MPa 안, 0.05~0.14 MPa 조정 폭), 실린더 행정 안·SF ≥ 1.5, 들기 SF, 들기·누름·낮은 누름(C-39) 전 자세 × 매트 3장·V홈 과제 범위 간섭 0, 모터 위 최고 Z ≤ 보 밑, 관 끊김·빈 포트 0·굽힘 반경 ≥ 최소, 걷어 낸 부품 잔재 0 | 구동 | **해결**(v2.14.0, 2026-11-13, `docs/review/FSAP_v2.14.0_review.md`) — v2.10.3 그네 구조 적용 뒤 남은 동작 문제 2와 구동 후보 RX-06-C1을 4회차에서 고침: 윗고리–탭 볼트 틈 1.75·2.75 mm, 빈 컴포넌트 22개 지움(floating 0), 팔 3바디 셸 1. 디테일 M02R-D1~D14(탭 날개 살 1.75 < 2.5는 예외 기각 — 열린 디테일 D5) |
| U6S | U6 슈 누름 방식·눌림자국 | 사용자 2026-11-11 R375X 사진: 바퀴 옆 파란 관 뒤 소형 실린더 → 세로 판 → 아래 은색 슈가 매트를 누르는 것으로 보임("아래 매트 누르는 저것도 무슨 실린더에 연결되어 있는거 같은데"). M06은 슈를 '비키는 실린더'로만 둠. 슈가 실린더 힘으로 매트를 누르는 경우를 넣어 ① 슈 구동 방식(세로 누름·들기 / 가로 비킴, D-164) 정하기 — 모르면 세로 누름·들기 + 누름 힘 조절(레귤레이터) 자리 ② 슈 누름 힘 범위 손계산: 바늘 앞 매트 평평하게 잡는 힘 ≥ 필요, 눌림자국(C-03, FUNC-01 ① Winkler 방식) SF ≥ 기준, 매트 움직일 때 슈 끌림이 회전력(C-37·C-39 SF)에 주는 손해 ③ 슈 들기·누름 자세 간섭 0 | 슈 누름 힘 범위가 잡음·자국 둘 다 만족(여유율), 회전 SF 다시 셈 ≥ 1, 간섭 0. 실제 자국은 7절 | 구동 | 일부 v2.9.0(세로 누름·들기 J_U6_PRESS, 잡음 1.344, 회전 SF 1.009~1.047, 과제 범위 간섭 0. 기울기 자국 SF 1.35 < 2 등 디테일 U6S-D1~D9) |
| SIM-01 | 봉제 진행 테이프 시뮬레이션 | 사용자 2026-11-11 "매트 랏빠 다 넣고 시뮬레이션도 해봐야할거같아". 지금 시험 매트 테이프(TAPE_L·S·G·V)는 처음부터 둘레 전체에 붙은 강체이고 숨김이라, 봉제 진행 중 테이프 거동은 본 적 없다. 동작 연구 CYCLE_L·S·G1·G2·V에 ① 붙은 테이프 구간을 봉제 진행(땀 위치)에 따라 단계별로 늘리고(구간 바디 표시 켜기/끄기 또는 단계별 바디) ② 롤 → 안내 롤러 → 바인더 → 바늘로 이어지는 **테이프 줄**(두께·폭 실제, 경로는 각 단계 자세에서 안내점을 잇는 직선·호)을 넣어 ③ 한 사이클 전 단계에서 테이프 줄·붙은 테이프와 바퀴(U4·U5)·슈·대차·묶음·매트 간섭 0, 테이프 줄 꺾임각이 안내점에서 기준 안(D-번호), 롤 쪽 줄 길이 변화(풀림량 = 봉제 길이) 일치 확인. 사이클 영상(화면 캡처 연속)을 보고서에 남긴다. 테이프 늘어남·주름·뭉침은 7절 | 전 단계 간섭 0, 풀림량–봉제 길이 차 ≤ 기준, 영상 | 구동 | 해결(v2.10.4, 검도 2회차 U4 묶음 5연구 겹침 0·truncated false, 영상 5연구) |
| RX-01 | 주 공기 차단·잔압 배기 밸브 + 압력 스위치 | 사용자 2026-11-11 "왜 넌 5개만? 지금 하려는건 엄청 많잖아" — R375X 사진 재판독(`docs/benchmark.md` 'R375X 사진 6장 다시 판독'·'모르는 것의 용도 추정', 번호 사진 `docs/images/r375x/annot_*.jpg`)에서 우리와 다른 것 전부. 용도는 추정(신뢰 적음) — 근거 사진 번호를 보고서에 적는다. R375X 사진1 ②·③(보 앞 DIN 코일 밸브 + 황동 소음기, 황동 이음 은색 블록, D-185). 주 공급 입구(티 앞)에 3포트 차단·배기 밸브(예: SMC VP/VHS 계열)와 압력 스위치(예: ISE 계열), 소음기. 비상정지·전원 끊김 때 잔압 배기, 압력 낮음 감지 | 형번·카탈로그 값, 회로도(포트 표) 빈 포트 0, 관 굽힘 ≥ 최소, 간섭 0, BOM | 구동 | 미해결 |
| RX-02 | 바늘 냉각 공기 노즐 | 사용자 2026-11-11 "왜 넌 5개만? 지금 하려는건 엄청 많잖아" — R375X 사진 재판독(`docs/benchmark.md` 'R375X 사진 6장 다시 판독'·'모르는 것의 용도 추정', 번호 사진 `docs/images/r375x/annot_*.jpg`)에서 우리와 다른 것 전부. 용도는 추정(신뢰 적음) — 근거 사진 번호를 보고서에 적는다. 사진1 ⑫(파란 관 끝 노즐이 바늘 쪽, D-182). 노즐(예: 굽힘 가능 냉각 노즐) + 관 + 밸브 1구(매니폴드 빈 자리) + 속도 조절. 노즐 끝이 바늘·노루발·테이프 길·매트와 간섭 0 | 노즐 위치(바늘 끝 향함)·간섭 0, 회로 빈 포트 0, BOM | 구동 | 미해결 |
| RX-03 | 테이프 감지 센서 | 사용자 2026-11-11 "왜 넌 5개만? 지금 하려는건 엄청 많잖아" — R375X 사진 재판독(`docs/benchmark.md` 'R375X 사진 6장 다시 판독'·'모르는 것의 용도 추정', 번호 사진 `docs/images/r375x/annot_*.jpg`)에서 우리와 다른 것 전부. 용도는 추정(신뢰 적음) — 근거 사진 번호를 보고서에 적는다. 사진1 ⑪(헤드 앞 오른쪽 원통형 가로 센서, D-183). 바인더 → 바늘 사이 테이프 길을 보는 원통형 광센서(M12·M18 등) + 브래킷: 테이프 있음/끝, 한 바퀴 돌아 시작점 겹침 시점. 센서 시야가 테이프 길에 걸리고 매트·노루발과 간섭 0 | 센서 형번·시야 거리 안, 브래킷 간섭 0, 테이프 줄(SIM-01) 전 단계 시야 확인, BOM | 구동 | 보류(C-48, 2026-11-13: 근거였던 R375X 원통 센서는 접촉식 가장자리 감지용 — 사용자 판독. 테이프 떨어짐 감지가 우리 필요로 정해지면 다시 연다) |
| RX-04 | 바늘 둘레 LED 조명 | 사용자 2026-11-11 "왜 넌 5개만? 지금 하려는건 엄청 많잖아" — R375X 사진 재판독(`docs/benchmark.md` 'R375X 사진 6장 다시 판독'·'모르는 것의 용도 추정', 번호 사진 `docs/images/r375x/annot_*.jpg`)에서 우리와 다른 것 전부. 용도는 추정(신뢰 적음) — 근거 사진 번호를 보고서에 적는다. 사진1·2(노루발 밑 흰 LED). 소형 LED 조명 + 브래킷. 가장자리 센서(E32) 시야를 가리지 않고 작업자 눈부심 없는 방향 | 간섭 0, 센서 시야 가림 0, BOM | 구동 | 미해결 |
| RX-05 | U5 대차 홈 솔 덮개 | 사용자 2026-11-11 "왜 넌 5개만? 지금 하려는건 엄청 많잖아" — R375X 사진 재판독(`docs/benchmark.md` 'R375X 사진 6장 다시 판독'·'모르는 것의 용도 추정', 번호 사진 `docs/images/r375x/annot_*.jpg`)에서 우리와 다른 것 전부. 용도는 추정(신뢰 적음) — 근거 사진 번호를 보고서에 적는다. 사진1 ⑥·사진2 ④(보 밑 전폭 솔 띠, D-186). U5 대차 가이드·구동부가 드러난 곳을 솔 띠(브러시 실)로 덮어 먼지·실밥·손 끼임 막기. 대차 전 행정에서 기둥이 솔 사이를 지나감 | 대차 전 행정 간섭 0(솔 통과 부위 제외), 덮인 길이 = 행정, BOM | 구동 | 미해결 |
| RX-06 | U4 X 위치 조절축(레일 + 볼나사) | 사용자 2026-11-11 "왜 넌 5개만? 지금 하려는건 엄청 많잖아" — R375X 사진 재판독(`docs/benchmark.md` 'R375X 사진 6장 다시 판독'·'모르는 것의 용도 추정', 번호 사진 `docs/images/r375x/annot_*.jpg`)에서 우리와 다른 것 전부. 용도는 추정(신뢰 적음) — 근거 사진 번호를 보고서에 적는다. 사진1 ④·⑤(보 앞 X 볼나사·4볼트 플랜지 베어링), 사진2 ②·③(매달기 위 좌우 빨간 블록 = 가이드 블록 추정, D-181·D-184). M02R 그네 매달기 윗판을 X 레일 블록 2개에 얹고 볼나사로 X 이동 → d₁(바늘–바퀴 거리) 조절. 구동은 손잡이 수동 또는 서보 — d₁을 봉제 중 바꿀 필요가 있는지 0-8 절차로 판단해 정하고 이유를 결정로그에. **M02R이 끝난 뒤**(같은 부품을 고침) | d₁ 조절 범위(근거), 전 범위 × 들기·누름 자세 간섭 0, 레일·볼나사 하중 손계산, BOM | 구동 | 해결(v2.11.1, `docs/review/FSAP_v2.11.1_review.md`; 레일·축 STEP 교체 E4·E5와 디테일 7건 남음) |
| RX-07 | 레귤레이터 3개 — U5 누름 공압 조절 검토 | 사용자 2026-11-11 "왜 넌 5개만? 지금 하려는건 엄청 많잖아" — R375X 사진 재판독(`docs/benchmark.md` 'R375X 사진 6장 다시 판독'·'모르는 것의 용도 추정', 번호 사진 `docs/images/r375x/annot_*.jpg`)에서 우리와 다른 것 전부. 용도는 추정(신뢰 적음) — 근거 사진 번호를 보고서에 적는다. 사진1 ①·사진2 ①(레귤레이터 3개). 지금 2개(U4·U6 슈). R375X는 매트를 누르는 세 곳(U4·U5·슈)을 공압으로 조절하는 것으로 추정. 지금 U5는 스프링 플로트 44 N(F01-S2, 승강은 주 공급). U5 누름을 레귤레이터로 조절하는 안과 지금 스프링 안을 비교(힘 범위·자국 SF·조정 쉬움·부품 수)해 정하고, 공압 쪽이면 IR1000 3번째를 되살린다 | 두 안 비교표, 고른 안의 힘 범위가 자국·잡음 기준 안, 회로 빈 포트 0, 간섭 0 | 구동 | 해결(확인 2026-11-13, 결정로그 '구동 RX-07 확인' RX-07-C1~C7·`docs/reports/mechanism/mech_RX-07_measure.md`, v2.13.0) — 매트 누름은 스프링 플로트 그대로, IR1000 :2를 U5 승강 내림(머리) 관 U5_A1·U5_A2 사이에 되살려 레귤레이터 3개(U4 :1·U5 :2·U6 :3). 결정로그 RX-07-D1, `docs/reports/mechanism/mech_RX-07_design1.md`·`mech_RX-07_model.md` |
| RX-08 | U4 중간 높이 스토퍼 실린더 | 사용자 2026-11-11 "왜 넌 5개만? 지금 하려는건 엄청 많잖아" — R375X 사진 재판독(`docs/benchmark.md` 'R375X 사진 6장 다시 판독'·'모르는 것의 용도 추정', 번호 사진 `docs/images/r375x/annot_*.jpg`)에서 우리와 다른 것 전부. 용도는 추정(신뢰 적음) — 근거 사진 번호를 보고서에 적는다. 사용자 사진(U4 옆 벽에서 가로로 나오는 소형 실린더, D-163). M02R이 남긴 스토퍼 자리에 실제 소형 실린더 + 멈춤 블록: 로드가 나오면 그네가 그 각도까지만 내려감(좁은 홈·U4 혼자 구간 살짝 띄우기). **M02R 뒤** | 스토퍼 각도·바퀴 띄움 높이 근거, 실린더 힘 ≥ 누름 반력 × SF, 간섭 0, 회로 빈 포트 0 | 구동 | 해결(v2.12.2, 디테일 4 — RX-08-D1~D4) |
| RX-09 | 캐스터 | 사용자 2026-11-11 "왜 넌 5개만? 지금 하려는건 엄청 많잖아" — R375X 사진 재판독(`docs/benchmark.md` 'R375X 사진 6장 다시 판독'·'모르는 것의 용도 추정', 번호 사진 `docs/images/r375x/annot_*.jpg`)에서 우리와 다른 것 전부. 용도는 추정(신뢰 적음) — 근거 사진 번호를 보고서에 적는다. 전체 사진(캐비닛 밑 바퀴 + 레벨러). 지금은 레벨러만. 이동용 캐스터를 레벨러 옆에(설치 뒤 레벨러로 들어 고정) | 하중 손계산, 바닥 높이·레벨러 행정과 맞음, BOM | 구동 | 취소(C-49, 2026-11-13: R375X 전체 사진을 다시 보니 캐스터가 없고 레벨링 패드뿐 — 근거였던 판독이 틀림) |
| RX-10 | U6 슈 바닥 길이 늘리기(R375X 슈 크기) | 사용자 2026-11-12 모델 스샷 "사이트 이미지 보면 저기가 꽤나 넓던데 왜저렇게 작게 해놨지", "답도 없이 넓게는 또 하지말고". R375X 슈(`docs/images/r375x/annot_2_U4_hanger_shoe.jpg` ⑩)는 길쭉한 넓은 발판인데 지금 `P_M06_SHOE` 바닥은 X 23(−22~1) × Y 90(−205~−115), 닿는 면 1,506.6 mm²(유효 폭 16.7)로 작다. 해석부가 이미 미달로 남김(U6S-D6: 끌림 기울기 자국 SF 1.35 < 2, 고치는 법 "길이 ≥ 121 또는 유효 폭 ≥ 24.7"). 정할 것: ① **X 폭은 23 그대로**(0-8-2② 슈 묶음 폭 < 좁은 홈 25 — 폭으로는 못 푼다). ② **Y 길이 90 → 130**(손계산 `fea/cases/mech_U6S_handcalc.py` 식, μ 0.4·F_hi 21.59 N: 유효 폭 16.7에서 L 120 SF 1.97, 130 SF 2.19, 140 2.40 — 기준 2를 넘는 가장 짧은 10 단위). 바닥 평탄부를 넓혀 유효 폭 18 이상이 되면 L 120(SF 2.13)도 된다 — 더 길게는 하지 않는다. ③ 늘리는 쪽(−Y 끝 또는 +Y 끝)은 E32 센서(Y −112~−107)·캐리지·U7 안내·U4 바퀴와 간섭, J_U6_SHIFT −60·0 × J_U6_PRESS 끝값, 좁은 U홈 매트 전 구간(M01 판정과 같은 조건)으로 고른다. 입술 20°·장공·윗날개 탭 그대로 따라 옮김 | 자국 SF ≥ 2(μ 0.4, F_hi), 슈 X 폭 ≤ 23, 좁은 U홈 전 구간·SHIFT·PRESS 자세 간섭 0, 슈 들기 힘·잡음 비 다시 계산(무게 늘어남), BOM | 구동 | **일부**(v2.17.2, 2026-11-14, `docs/review/FSAP_v2.17.2_review.md`) — 슈 −Y로 40 늘림(Y −245~−115, 닿는 면 2,266.6 mm², X 폭 23.0), 누름 실린더 축 Y −152 → −166 · 포트 +Y, IR1000 :3 0.19 MPa(창 0.184~0.200). 완료 판정 6항목 만족: 자국 SF 2.285(0.19 MPa 2.151), 16자세 기계 부품 겹침 0, 잡음 비 1.052 · 들기 SF 5.34, E32 3.606 그대로. **남은 동작 문제 RX-10-F1**: 슈 끝에 손 100 N을 걸면 누름 실린더 로드 Ø4가 굽음(붕괴 63.9~102.6 N, SF 0.64~1.03 < 1.2) — 로드–윗날개 이음을 Z 힘만 전하게(Y 장공 ±1.8 이상 + 너트 축 틈 ≥ 0.5 또는 핀) + 슈 −Y 쪽 위 멈춤(팔 ≥ 60, 틈 0.5)으로 탭 힘 ≤ 136 N(결정로그 RX-10-R2). 디테일 RX-10-V1~V4·F2~F5 |
| RX-11 | U5 먼 쪽 바퀴 밑 받침을 롤러 2줄로 (C-45) | 사용자 2026-11-13 "2줄로가 r375x도 그렇게 되어 있잖아". R375X 사진(`docs/images/r375x/decisions/q1_u5_rollers.png`, `crops/crop_detail5_table_rollers.png`): 원판 왼쪽 테이블의 X로 긴 홈에 둥근 봉 2줄(자유 롤러로 보임, 신뢰 중간)이 원판·바퀴와 같은 Y 줄로 깔려 있다. 지금 `P_DC205_STRIP`(A5052 t8 PTFE 함침 고정 띠, D-97)을 X 축 자유 롤러 2줄(U5 바퀴가 두 롤러 사이 위에 얹힘)로 바꾼다. 롤러 지름·길이·베어링·나눔은 사진으로 모름 → 구매품에서 고르고 자료대기. 윗면 = 볼 꼭대기 높이, U5 행정 전 구간, 원판 쪽 끝 받침 | U5 행정 전 구간 받침 연속, 매트 3장 + RX-12 매트 전 구간 간섭 0, 롤러 처짐·베어링 하중 손계산(바퀴 누름), DC-02 회전 시간·SF를 띠 미끄럼 항 없이 다시 계산, BOM | 구동 | **해결**(v2.17.1, 2026-11-13, `docs/review/FSAP_v2.17.1_review.md`) — 띠 묶음 17바디 걷고 `RORLM20-6-L200` 7개 × 2줄(Ø20 × 200, Y ±11, 윗면 Z −0.0002, 나눔 틈 16 < 트레드 25) + 축 `SFJ6-213` ×14 + 새들·클램프 ×8 + `CB5-20_RX11` ×8(조임 0.6 N·m + 나사 고정제). 과제 범위 간섭 0, 롤러 처짐 0.0051 mm, 696ZZ SF 14.4, 시간 키 L 7.5 → 4.5 s(SF 1.228)·G2 3.0·G1 바닥 0.8·V 3.0/1.5·1.0/1.9(최저 SF 1.146). STEP 대기 2종(D-208·D-209), 롤러 치수 임시(D-200). 디테일 RX-11-V1-1·V1-2·F3~F8·D1·D3~D6 |
| RX-12 | 시험 매트 추가: 긴 매트 + 넓은 오목 — 매트가 바늘 오른쪽(+X)으로 넘어가는 경우 (C-47) | 사용자 2026-11-13 "오른쪽도 결국 매트가 긴 경우에는 저쪽으로 가야해서", "V자 좁은 것도 좁은 곳을 돌 때 매트가 반대로 가니까", "확인해야해". 0-8-5의 "매트는 늘 바늘의 −X 쪽"은 볼록 외곽에만 맞고, 오목·홈을 박을 때는 매트의 큰 부분이 +X로 넘어간다. 지금 시험 매트(큰 사각·작은 사각·끝 300 안 좁은 U홈·V홈)에는 R375X 사진(`decisions/q3_test_mat.png`) 같은 긴 매트 가운데 넓은 오목이 없다. 그 형상의 매트 모형과 동작 연구를 더해 +X 쪽 테이블 넓이, +X 쪽 우리 부품(카세트·테이프 걸이·기둥·HMI)과 매트의 간섭을 본다. 오목 치수는 실물이 없어 임시값(D-01·D-02) | 새 매트 전 구간 간섭 0, 뒷면이 전 구간 볼·롤러 위, +X로 넘어가는 최대 넓이를 결정로그에 적고 0-8-5 문장을 그 결과로 고침 | 구동 | **해결**(v2.16.0, 2026-11-13, `docs/review/FSAP_v2.16.0_review.md`) — 시험 매트 `MAT_W` 1500×700(오목 500×300, 임시) + `J_WP_W_X·Y·ROT` + `CYCLE_W1`·`W2`. 전 구간 간섭 0(truncated false, 겹침은 기준선 바늘 20.1 · `TL_FEED` ≤ 75.0 mm³뿐), +X 최대 X 1052.1 · 550,000 mm², 0-8-5 고침. 받침 밖 최대 323,536 mm²(포켓 282,556)는 구동 후보 RX-12-C1·C2로. 디테일 RX-12-D1(처리함) |
| RX-12-C1 | +X·−Y 포켓(작업자 자리) 위로 나가는 매트 받침 | RX-12 결과(`mech_RX-12_design.md`, 결정로그 RX-12-R3). 긴 매트의 넓은 오목 벽을 박는 동안 매트가 볼·패널이 없는 포켓(X > 400 · Y < −300, D-107) 위로 나간다: 최대 282,556 mm²(패널 기준)·323,536 mm²(볼 기준), W1 348~564. 쓸고 간 자리 X 400~1026 · Y −1146~−200(468,800 mm²). 매트 깊이 1500이면 723,858(어림). 작업자 자리와 겹치므로 받치는 방법(접이·빼는 받침, 볼 줄 늘리기 등)은 구상에서 | RX-12 매트 전 구간 받침 밖 넓이 0(또는 처짐을 7절로 넘길 근거), 작업자 로딩 자리 유지, 기존 매트 4장 간섭 0 | 구동 후보 | 미해결 |
| RX-12-C2 | 테이블 +X 끝 늘리기, +X 기둥 여유 | RX-12 결과(결정로그 RX-12-R3). 매트 X 최대 1052.1이 볼 받침 900 · 패널 975를 넘는다: X > 975 22,050 mm², 쓸고 간 자리 X 900~1052 · Y −200~805(119,600 mm²). +X 기둥(X 1150~1230 · Y 120~320)까지 104.1 — 오목 폭 700이면 1.9, 오목이 한쪽으로 치우치면(다리 300 / 700) X 1244.8로 기둥과 10,537~11,300 mm² 겹침. 실제 매트 치수(D-01·D-02)에 달림 | X > 900 받침 밖 넓이 0, 가장 불리한 오목 형상에서 기둥과 틈 > 0, HMI·보 간섭 0 | 구동 후보 | 미해결 |
| RX-12-C3 | 새 매트 `MAT_W`의 테이프 띠·조각 모형(SIM-01 방식) | RX-12에서 만들지 않음(과제 지시, 결정로그 RX-12-S6). 가공 뒤 형상 검사는 L·S·G·V만 된다 | `WP_TAPE_W`·`J_TP_W_*`·이음매, CYCLE_W1·W2 전 구간 기준선 밖 겹침 0 | 구동 후보 | 미해결 |
| RX-12-C4 | 새 매트 회전 시간 키·SF 정식 계산 | RX-12 임시 키(볼록 4.1·4.2 · 오목 입구 2.8 · 안 모서리 1.6·2.8 s, SF 약 1.05, `handcalc_w.json`)에는 받침 밖 끌림이 없다. RX-11(띠 → 롤러) 뒤 띠 미끄럼 항 없이 다시 계산 | 회전마다 미끄럼 SF·시간, `machine.json _timing`에 CYCLE_W | 구동 후보 | 미해결 |
| RX-06R | U4 X축에서 볼나사·손잡이 빼기 (C-46) | 사용자 2026-11-13 "응"(질문 `decisions/q4_u4_xaxis.png`). R375X 보 앞 볼나사·레일 2줄은 U4가 아니라 헤드 위 대차 쪽으로 이어진다(사진 추정, 신뢰 중간~높음). U4가 X 레일 블록 위에 있다는 것은 형제 기종 사진이 뒷받침한다. RX-06(v2.11.x)의 볼나사 BSS2020·지지 유닛·손잡이·너트를 걷어 내고, 레일 + 블록 + 고정(잠금)만 남긴다. d₁ 조절 범위와 고정 방식(볼트 잠금/클램프)은 설계안에서 | 걷어 낸 뒤 전 범위 × 들기·누름·스토퍼 자세 간섭 0, 고정부가 누름 반력·바퀴 구동 반력을 받음(손계산), 관(RX-08 U4 쪽 관) 따라감 그대로, BOM | 구동 | **해결**(v2.15.0, 2026-11-13, `docs/review/FSAP_v2.15.0_review.md`) — 볼나사 축·너트·BSW20·BUN20·스페이서 2·손잡이·너트 볼트 4와 J_U4_XSCREW·링크를 걷어 내고 레일 SSEB13-220(실물 STEP) 2줄 + 블록 4 + 볼트 잠금(잠금 날 SUS304 t2 + 누름 판 t3 + CB5-16 ×2, 3 N·m)만 남김. d₁ 100~195 그대로(J_U4_X 0~95, 손으로 밀기). 24자세 과제 범위 새 겹침 0, 잠금 유지력 SF 8.21(204.3 N)·3.03(553.1 N). 디테일 RX-06R-D1~D8(날 조임 굽힘 SF 2.26 < 3 → t1.2 권고 등) |
| RX-13 | U4 누름 실린더를 보 앞면 앞·모터 바로 위로 옮기기 (C-50) | 사용자 2026-11-13 "파랗게 면 표기한 저쪽에서 실린더가 나와서 저 모터를 아래로 내리는 용도로 쓰던데 넌 왤케 뒤에 놔뒀어"(보 앞면을 고른 화면 + R375X 사진에 빨간 상자로 실린더 몸 표시). R375X: 사각 실린더 몸이 보 앞면 쪽에서 앞(−Y)으로 나와 서보·감속기 바로 위에 있다(`docs/images/r375x/crops/crop_detail1_u4_cylinder_redblock.png`). 우리: M02R 설계에서 몸을 보 밑면에 L 브래킷 `P_M02S_CYL_BRKT`로 매달아 Y 177.9~222.4 · Z 205~241(보 앞면 Y 120보다 58~102 뒤, 설계값 — 지금 값은 측정부가 잰다). 그네 원리·로드 Y축(C-41)은 그대로, 실린더 몸·브래킷·핀 받는 자리만 앞으로. 사진에서 못 읽는 치수는 지어내지 않고 자료대기로 | 실린더 몸이 보 앞면보다 앞(−Y)·모터 위에 있고 앞에서 보임(사진과 나란히 비교한 그림), 누름 힘 창·자국 SF·회전 SF·행정 여유는 M02R 기준 그대로 다시 계산, J_U4_X 전 범위 × 들기·누름·스토퍼 자세 과제 범위 간섭 0, RX-08 스토퍼·관·U6 따라감 그대로, 회로 빈 포트 0, 옛 브래킷 잔재 0, BOM | 구동 | 미해결 |
| RX-06-C2 | 움직이는 컴포넌트 바디를 고치는 루트 피처를 그 컴포넌트로 옮기기 (U5_CAR·U7_CASSETTE·U4_WHEEL_N) | `mech_RX-06_verify1.md` 5절·결정로그 '구동 RX-06 결과' 디테일 3. 움직이는 컴포넌트의 바디를 루트 피처(탭 구멍 cut 등)가 고치면 조인트로 움직인 자세에서 그 피처가 제자리에 남아 형상이 틀린다. 대상 U5_CAR Combine43·44, U7_CASSETTE Cylinder351·352·Combine45, U4_WHEEL_N Box326·Combine41(빈 피처) | ① REST 대상 바디 부피·bbox 변화 0 ② J_U5_X·J_U7_CST_X·Y·J_U7_HGT 끝 자세에서 부피 = REST, bbox = 강체 이동 ③ 타임라인 error 0·새 warning 0, Box326·Combine41 없음 ④ 과제 범위 간섭 0 | 구동 후보 | **해결**(v2.15.2, 2026-11-13, `docs/review/FSAP_v2.15.2_review.md`) — 루트 피처를 컴포넌트로 옮김(Combine은 지우고 Cylinder cut 10개로 다시), 같은 꼴 7피처(CST_O·U7_FIXED·U6_SENSOR) 함께, 빈 피처 지움. 형상 값 변화 0, 끝 자세에서 구멍이 따라감, `joint.drive` J_U4_X 465~574 s → 0.36 s. 수정 1회차: 관 브래킷 볼트 CB5-16 ×2 → CB5-12(끝이 `P_M05_HOLDER` 벽을 4 mm 뚫던 것). 디테일 RX-06-C2-D1·D2 |
| RX-06-C3 | 같은 꼴 남은 것: 테이프 모형 Split·U6_SHOE 피처·루트 Move14 | RX-06-C2 모델링·검도가 찾음(`mech_RX-06-C2_model.md` 6절, `_verify.md`). ① 매트와 함께 움직이는 테이프 모형 `WP_TAPE_S·L·G·V` 바디를 루트 Split 27개가 자름(J_WP_*) — 움직인 자세에서 조각 형상이 맞는지 재지 않음 ② U6_SHOE 피처가 U6_PRESS 바디를 고쳐 J_U6_PRESS 구동 한 번 395·460 s(형상은 맞게 따라감) ③ 루트 Move14(U3_NEEDLE_PIN) | CYCLE 연구 한 단계에서 테이프 조각(TP_S_07a 등) 부피 = REST(다르면 Split을 WP_TAPE_*로), J_U6_PRESS 구동 시간 1 s 안팎, 형상 값 변화 0, 타임라인 error 0·새 warning 0 | 구동 후보 | 미해결 |

순서(C-22 방식): M00 → M01 → M02·M03·M04 → M05 → M06 → M07·M08 → M04R(2026-11-04 추가, M08과 겹치지 않으면 동시). 겹치지 않는 과제는 동시에(E-25).

## 6. 판정 수치

| 칸 | 내용 |
|---|---|
| 6-1 강도 | 기본값 — M-09 |
| 6-2 변위·정밀 | 미정 — 봉제점에서 매트 가장자리까지 위치 오차 한도는 납품처 기준(D-08)에서 정한다 |
| 6-3 질량·하중 한도 | 기본값 — M-06 |
| 6-4 동작 검사 범위 | 기본값 E-03에 따라 대상 매트 3가지: 가장 큰 매트, 가장 작은 매트, 가장 좁은 홈이 있는 매트(실물 형상 D-01·D-02). 상태: 직선, 볼록 모서리, 오목 모서리, 홈 입구, 홈 바닥 꺾임, 시작·끝 이음매. **검사 간격(v1.0, 사용자 2026-11-03 시간 줄이기):** 이송 행정(X·Y) 25 mm, 원판 회전 5°, 바늘 둘레 반경 50 mm 안·홈 안·모서리 회전 구간은 5 mm·1°, 짧은 행정(노루발·바늘 등 15 mm 이하)은 양 끝 + 가운데. **전체 회귀 상한 30분**(엔진 v3.7.0 E-17, `regrun.py`) |

## 7. 모델로 못 잡는 것(시제품 확인)

- 소재별 허용 접촉압과 눌림 복원(D-05)
- 오목 곡선에서 테이프 날개 늘어남, 볼록 모서리에서 주름
- 봉제 품질: 땀 간격·위치, 테이프 들뜸, 이음매 마감
  - 이음매 마감(T06, v0.5.0): 겹 구간 테이프 두 겹(두께 2)이 침판 위에 앉는 모양과 매트 가장자리 들뜸, 꼬리 6.8 들뜸·앞끝 38 깔림, 절단면 품질과 칼–침판 홈 맞날 틈 0.1, 끌어내기 D 30/40 맞춤(T06-S07·T06-X01·T06-D04)
- 파일 결에서 가장자리 센서 검출 안정성
- 봉제 중 매트 미끄럼·밀림
- v2.0 바퀴(C-28): 매트를 잡는 힘 범위(테이프가 고르게 감기는 최소 ~ 파일 면 자국이 안 나는 최대, D-92), 바퀴 재질·경도별 자국, 바퀴–매트 미끄럼(직선 속도 어긋남, 모서리 회전력), 가장자리를 바인더에 붙이는 세기(바퀴 속도 차이 %·틀기 각도, D-94), 볼 테이블 볼 점자국, 작은 매트 끝 흔들림(먼 쪽 바퀴 없이)
- 진공 배관 회전부 건너기(T17, v0.8.5): Ø6 관 ±180° 반복 꼬임 수명, C클립 미끄럼 마모, Y판 밑 처짐 h15가 매번 되돌아오는지 / 꼬임 구간에서 T17 관(r15~22)과 T11 묶음(r ≤ 10)이 함께 꼬일 때 비빔 / 링1 굴림 고리 옆 흔들림(T17-S 선정 8절)
- N04-T2 에어 테이블 사슬(N04 수정 2회차, v1.0.15): 슬랫 사슬의 꺾임(Y ±915)·보관 U턴 R 21.75 굽힘·드럼 감김 형상·처짐, 꼬리 러그(6×3)가 옆벽 홈을 지나는 마찰·걸림, 안쪽 끝 막대 러그가 판 벽 홈(폭 1.5)에 물리는 소리·마모, NP 홈이 윗면에 남기는 폭 1.5 틈과 PN 옆 홈의 매트 자국 여부(영구 눌림자국 금지 C-03). 모델은 프로브 상자(N04-E02)로 자리만 본다
- DC-03 U4 혼자 구간 판정(C-38, 2026-11-11): 매트 면밀도(D-04·D-145), 바퀴–파일 μ(D-95), 볼 테이블 위 매트 구름 저항 계수 c(D-96, 저울로 끄는 힘 ÷ 무게)를 재서, U5가 매트 밖인 U4 혼자 구간(G1 바닥·출구, V 꼭짓점·입구2) c ≤ c_max(μ 0.4·면밀도 6에서 0.0202, μ·면밀도별 표 `tools/machine.json _timing.한계.U4혼자_구름_c_max`)인지 본다. 넘으면 그 구간 시간 키를 늘리거나(c_max는 시간에 약하게만 늘어남) U4 누름·d₁을 다시 따진다. L·G 모서리 U4+U5는 c ≤ 0.021(띠 μs 0.30)
- PNEU-01 통구멍 관 고정품(결정로그 PNEU01-E03, v2.8.8): 틈 0.25 통구멍에서 우레탄 관이 축 방향으로 밀려 움직이는 축 여유 고리(J_U4_PRESS·J_U7_HGT·U5 승강) 길이가 바뀌는지, 관 꿰기 쉬움(조립: 블록 볼트 조임 → 관 꿰기 → 원터치 이음 꽂기 / 정비: 이음 2개 빼고 관을 당겨 뺌). 모델로 판정하지 않는다
- M02R 그네 누름(C-41, v2.10.3): 바퀴 접지점 Y 이동(두께 6 +1.19·16 −4.32 mm, 바퀴 면 기울기각 0°)이 만드는 옆 미끄럼(90° 모서리당 1.9·6.8 mm)과 그 자국, 실린더 패킹 정지 마찰 f 실측(임시 CDQ2YA20-25DMZ f ≤ 9.42 N 가정, D-188)과 그에 따른 실제 내려앉은 바퀴 힘(설계 두께 6 40.6·10 41.5·16 44.7 N, 마찰 풀리면 명목 47.2·48.0·51.0 N ≤ 51.6), 스프링 초장력 실측(D-189). 모델로 판정하지 않는다
- RX-12 긴 매트 + 넓은 오목(C-47, v2.16.0): ① 받침 밖으로 나간 매트(오목 벽을 박는 동안 +X·−Y 포켓 위 최대 282,556 mm², X > 975 22,050 mm²)의 처짐·끌림과 그 때문에 생기는 땀 어긋남 — 구조는 구동 후보 RX-12-C1·C2 ② R 0 오목 안 모서리에서 테이프 굽음: 모서리 앞 직선 20 mm와 바늘 빼기 단계에서도 바늘 앞 테이프 조각 모형 `TL_FEED`가 매트 옆면과 겹친다(최대 75.0 mm³, 딱딱한 바인더는 3.0 위) — 실제 오목 모서리 반경(D-03)에서 테이프가 주름 없이 감기는지 ③ U5를 든 U4 혼자 구간(오목 뒤 가운데·오목 바닥)의 방향 유지
- RX-11 U5 밑 롤러 2줄(C-45, v2.17.1): ① 받침선 간격 22(롤러 꼭대기 선 Y ±11)에서 바퀴 누름 46.54 N이 만드는 매트 눌림·자국(영구 눌림자국 금지, C-03) ② 두 롤러 사이 틈 2·나눔 틈 16에 파일·테이프 끼임 ③ 롤러 구름 저항 실측(임시 계수 0.05, 바퀴 밖 롤러 0.18 N)과 매트의 X 방향 미끄럼 — 시간 키(L 모서리 4.5 s 등)의 전제 ④ 모서리 회전 끝 자세(매트 끝 Y 6.5): +Y 줄 롤러 꼭대기 선(Y 11)이 매트 밖이라 바퀴 밑 받침이 −Y 줄 한 줄 — 매트 끝 처짐(닿을 때까지 최대 1.07)·자국·바퀴 접지(검도 RX-11-V1, 문제면 롤러 2줄 가운데를 Y −6으로 옮기는 구동 과제) ⑤ 새들 볼트 0.6 N·m + 나사 고정제의 풀림(진동) ⑥ 롤러 외경 흔들림이 윗면 Z 0 ± 0.1 안인지(D-200)
- RX-10 U6 슈 바닥 130(C-43, v2.17.2): ① 슈 자국 — 직선 끌림(손계산 SF 2.15~2.29, 허용 30 kPa 임시 D-165)과 슈를 누른 채 매트가 바늘 둘레로 도는 곡선 구간 가로 끌림(손계산 45° 1.93~2.28, 90° 1.62~1.86, 디테일 RX-10-F2) ② 매트 가장자리 말림을 잡는 데 필요한 누름 힘 실측(임시 9.36 N, D-164) — IR1000 :3 설정 0.19 MPa(창 0.184~0.200)가 맞는지

## 8. 작업 규칙

| 칸 | 내용 |
|---|---|
| 8-1 언어 | 기본값 — U-17(한글, 폴더·파일 이름 영문) |
| 8-2 버전·저장 | SolidCraft 설계 파일 `3D_Modeling/FSAP_v<주>.<부>.<수>.sc`(사용자가 앱에서 만든 이름·폴더). **v0.0.0에서 시작**(빈 설계, 사용자 2026-10-30 "v0.0.0부터 시작해보자"). 잠금 파일 `.~*.lock`은 깃 제외. 형상이 바뀌면 다른 이름으로 저장(E-05): 작은 변경은 수 번호 +1, 구동 방식·개념 교체는 부 번호 +1. BOM은 `docs/bom/`, 설계검토서는 `docs/review/`, 파일 이름에 같은 버전 번호 |
| 8-3 출력 | `deliverables/<문서 번호>/`. 완성본일 때만(E-06) |
| 8-4 묻는 것 | 기본값 — E-01(큰 돈이 드는 선택, 이 문서에 없는 구조 결정만. 모아서 최종 보고에) |
| 8-5 기록 | 결정로그 `docs/decision-log.md`. Git: **설계 버전이 바뀔 때만(새 번호 .sc를 저장했을 때) 커밋하고 푸시한다**(사용자 2026-10-30 "깃은 버전 바뀔때만 커밋 푸시 하면되고"). 그 커밋에 그 버전의 .sc와 함께 바뀐 문서(BOM·설계검토서·결정로그·보고서)를 넣는다. 버전이 바뀌지 않은 문서만의 변경은 다음 버전 커밋에 함께 넣는다. 브랜치는 작업 브랜치 `modeling/mat-rs-001`(`main` 직접 커밋 금지), 푸시는 그 브랜치로 |
| 8-6 환경 | **CAD: SolidCraft**(사용자 2026-10-30, C-09). 방법은 엔진 `engine/cad/solidcraft.md`. 설계 파일은 8-2, `tools/config.json`의 `cad`·`doc`. 동작 상태 초기화: 설계 안 대기 동작 연구의 0단계(`motion.play`, 워크플로우 인자 `resetCall`). 실행 컴퓨터 준비 상태는 D-16 |
