hyeunung/FSAP/reports/매트 바인딩기 벤치마크 조사.md

# 만료 특허를 엮어 새 매트 바인딩기를 그린다

조사일 2026-11-03. 공개 웹 자료만 썼다(회사 문의·카탈로그 입수 없음). 표기: 본문에서 출처를 붙인 문장은 **확인된 사실**이고, "(추정)"을 붙인 문장은 이 보고서의 판단이다. "[검색요약]"은 원 페이지가 403 등으로 열리지 않아 검색엔진 요약으로만 본 내용이라 원문 대조가 필요하다. 특허 권리 상태는 Google Patents 표시값이며 Google 스스로 법적 결론이 아니라고 적는다. 이 보고서는 FTO(실시 자유) 판단이 아니다.

공개 자료로 보면 새 기계(헤드 고정, 매트가 헤드 밑을 지나며 회전, 바늘 앞 센서 추종, 파일 면 롤러 누름 금지, 시작·끝이 겹치고 자른 면이 숨는 이음매)의 **구동 개념은 거의 전부 만료·소멸 특허에 이미 공개돼 있다**. 매트를 끄는 힘은 재봉 헤드 자체 이송이 내고 매트 받침은 자유 회전·부유하며 따라가는 구조(US6557478, US5367966)가 있다. 코너에서는 바늘을 꽂은 채 노루발을 들고 돌린 뒤 센서가 가장자리를 다시 잡으면 재개한다(US5367966). 이음매는 테이프를 약 1인치 길게 잘라 폭 방향으로 접어 넣고 앞끝 위에 꿰매는 자동 시퀀스(US6044783A)가 있다. 하지만 **상용 기계와 특허 어디에도 안쪽 반경 30 mm보다 좁은 V·U 홈을 테이프로 감싼 공개 사례가 없다**. 공개된 최소값은 Van de Wiele TITAN 2530AG의 안쪽 반경 30 mm다([검색요약] [DirectIndustry](https://www.directindustry.com/prod/van-de-wiele/product-172691-2046145.html)). 벤치마크 R375X는 이송·잡기·회전 기구, 센서 종류, 홈 처리를 하나도 공개하지 않는다([rimac.it R375X](https://www.rimac.it/en/products/r375x/)). 그래서 새 기계의 진짜 설계 과제는 셋으로 좁혀진다. 롤러 없이 매트를 잡고 바늘 둘레로 돌리는 받침, 좁은 홈에서 바인더·노루발·센서가 들어갈 공간, 테이프 폭이 바뀌어도 바인더·커터·접이 기구를 한 묶음으로 바꾸는 툴 교체다. 나머지는 검증된 공지 기술을 조합하면 된다.

## R375X는 무엇을 하는지만 밝히고 어떻게 하는지는 숨긴다

벤치마크 RI.MA.C. R375X는 외곽 판독(profile reading)과 자동 매트 회전을 함께 써서 복잡한 형상을 처리하고, 재봉 헤드 구조를 고쳐 봉제 중 매트가 자유롭게 움직이게 했으며, "modified feeding system"과 새 테이프 커팅 유닛으로 매트가 헤드 밑을 지나가 회전 공간을 늘렸다고 적는다([rimac.it R375X](https://www.rimac.it/en/products/r375x/)). 공개 수치는 **매트 20×30~120×120 cm(요청 시 150×150), 최대 2000 rpm, 220 V·2000 W, 공기 6 bar**이고, 작업자가 손으로 올려 시작하며 한 사람이 최대 3대를 본다. 형상별 프로그램이 필요 없고, 열절단(Hot tape cutting)은 올 풀림 테이프용 옵션이다([rimac.it R375X](https://www.rimac.it/en/products/r375x/)). 이송 기구의 종류, 잡는 방식, 회전 중심, 센서 종류·위치, 테이프 폭, 사이클, 홈 처리는 공개되지 않았다. 브로셔·영상도 찾지 못했다.

이전 모델 R375A는 정보가 조금 더 있다. 헤드는 **Durkopp 867-290342를 바인딩용으로 개조**했고 2000 rpm, 매트 최대 80×60 cm, 사이클은 봉제만 **앞좌석 약 45~50 s, 뒷좌석 약 35~40 s**다. R375A는 기계 뒤로 자동 배출하고 R375A-SC는 수동 배출이며, 옵션으로 테이프 열절단과 누벅 테이프 장력을 줄여 매트를 평평하게 하는 "Habraken system"이 있다([rimac.it R375](https://www.rimac.it/en/products/r375/)). Dürkopp Adler 품번 규칙상 867-290xxx는 2본침이고([DA 867-M ECO PDF](https://partner.duerkopp-adler.com/commons/download/public/867-M/DA_867-M-ECO_deen_12-2020.pdf)), 중고 매물에도 "2 Nadeln"으로 나온다([maschinensucher](https://www.maschinensucher.de/d%C3%BCrkopp+adler-867-290342-100/i-20729477)). 그래서 R375A 헤드는 2본침 평판으로 보인다(추정, 신뢰 높음). DA 공식 서브클래스 페이지는 404라 원래 사양은 확인하지 못했다.

다른 상용기는 기구를 조금씩 드러낸다. 아래 표는 수치가 있는 기계만 모았다.

| 기계 | 공정 | 이송·잡기 | 코너·오목 | 시작·끝 | 공개 수치 | 출처 |
|---|---|---|---|---|---|---|
| RI.MA.C. R375X | 테이프 바인딩 | 미공개("modified feeding system") | 미공개 | 테이프 커팅 유닛, 열절단 옵션 | 위 본문 | [rimac.it](https://www.rimac.it/en/products/r375x/) |
| RI.MA.C. R375A / -SC | 테이프 바인딩 | "edge reading and car-mat moving", 헤드 867-290342 개조 | 미공개 | 열절단 옵션 | 위 본문 | [rimac.it](https://www.rimac.it/en/products/r375/) |
| Richpeace 자동 매트 바인딩기 | 바인딩·라벨 | 공급 트레이 자동 상승 + 매니퓰레이터 로딩, 가변 센서 신호로 **상하 프레스 휠**이 방향 제어 | 미공개 | 자동 트리머, 라벨 길이 당김·절단 | 6 kW 3상 380 V, 설치 4300×2400×2300 mm, 2000 rpm | [richpeace.com](https://www.richpeace.com/cnc_sewing_for_hometextile-show-1286.html) |
| Van de Wiele TITAN 2530AG/AHC | 카매트 테이프 바인딩 | 미공개 | 안팎 코너 모두 테이프, **최소 안쪽 반경 30 mm**, 코너마다 노루발·바늘 올려 정지 | 미공개 | 테이프 최대 32 mm(2530AHC) 또는 35 mm(2530AG 목록) | [검색요약] [DirectIndustry 2530AG](https://www.directindustry.com/prod/van-de-wiele/product-172691-2046145.html), [2530AHC PDF](https://pdf.directindustry.com/pdf/vandewiele/titan-2530ahc/172691-1134622.html) |
| Van de Wiele 테이프 바인딩군 | 카펫 테이프 바인딩 | — | — | — | 테이프 22~150 mm | [vandewiele.com](https://vandewiele.com/textile-solutions/sewing/tape-binding) |
| TITAN DK4640S / 5540 | 오버에징(실 감침) | 매트를 **에어 테이블**에 놓고 로봇 팔이 헤드로 공급, 형상 프로그램 없이 매트를 찾아 시작 | 안팎 곡선 | 로봇이 매트를 당기고 실을 자른 뒤 **마지막 땀을 뒷면에서 초음파 용착** | DK4640S 60×100 cm, 3200 땀/분 | [검색요약] [wotol](https://www.wotol.com/product/titan-dk4650-60-x-100-cm-automatic-overedging-system-for-car-mats/1810328), [5540 PDF](https://pdf.directindustry.com/pdf/vandewiele/titan-5540/172691-1134635.html) |
| 중국 무명 전자동 매트 오버에징기 | 오버에징 | 미공개 | — | — | 350 pcs/h, 380 V 5 kW, 900×200×200 cm, 1450 kg, US$93,400~98,070 | [검색요약] [china.org.ru](https://china.org.ru/product/60663811226) |

이 표에서 두 가지가 드러난다. 첫째, TITAN 로봇형과 중국 무명기는 오버에징이라 테이프 공급·이음매 문제가 없다(추정). 테이프 바인딩을 완전 자동으로 공개한 상용기는 R375 계열과 Richpeace뿐이다. 둘째, Richpeace의 "상하 프레스 휠"은 매트를 위아래로 무는 휠로 읽히므로 파일 면을 누를 가능성이 높다(추정). 전임 기계가 퇴짜맞은 방식(결정로그 C-03)과 같은 계열이다. 한국에서는 상용 자동 카매트 바인딩기를 찾지 못했다. Willems(네덜란드)와 Handsaeme(벨기에) 자동기는 페이지를 열지 못했다.

## 특허 22건 중 유효로 확인된 것은 미국·유럽 3건뿐이다(한국·중국 일부 미확인)

요청받은 7건은 모두 소멸 또는 미등록이다. 추가로 찾은 특허 가운데 권리가 살아 있을 수 있는 것은 Maples US7533621B2(2027-02-02 예상 만료), ACG Kinna EP4051489B1(2025-05-28 등록), Atlanta Attachment US7383780B1(2026-11-23 조정 만료, 조사일 기준 20일 남음), 그리고 상태를 확인하지 못한 한국 픽스로봇 계열이다. 중국 쑤저우 업체의 발명 출원은 대부분 공개 후 거절됐다.

| 특허 | 권리자(출원인) | 대상 | 핵심 기구 | 상태(Google Patents 표시) | 만료·종료 |
|---|---|---|---|---|---|
| [US6557478B2](https://patents.google.com/patent/US6557478B2/en) | Sherwin(개인) | 카펫 패드·러그·**자동차 매트** 바인딩 | 자유회전 진공 원판 + 헤드 쪽 직선 밀기 + 헤드 회전 테이블, 스프링 감지 암 2개 | 소멸(Expired - Fee Related) | 2007-05-06 연차료 미납 소멸(예상 만료 2021-10-12) |
| [US5367966A](https://patents.google.com/patent/US5367966A/en) | Charles Stark Draper Lab | 자동차 시트 표피 가장자리 | 상하 판 클램프, 무게중심 자유 회전 + 직선 부유, 바늘축 조향, 바늘 앞 재귀반사 센서 | 소멸(Fee Related) | 2006 연차료 미납(예상 만료 2014-06-08) |
| [US5216969A](https://patents.google.com/patent/US5216969A/en) | L&P Products | 카펫 샘플 4변 바인딩 | 펜스 정렬, 로봇 패드 누름, 스플라인 휠, 90° 회전 기구, 공압 가위 | 소멸(Fee Related) | 2001-06-08(예상 만료 2011-12-23) |
| [US5209171A](https://patents.google.com/patent/US5209171A/en) | Anderson → National Flooring Equipment | 휴대형 카펫 바인더 | 파일 면 톱니 구동 롤러, 테이프 포머 | 만료(Expired - Lifetime) | 2012-04-21 |
| [CN207958657U](https://patents.google.com/patent/CN207958657U/zh) | 苏州工匠智能科技 | 자동 바인딩 봉합 | 흡착 공급, 작두식 테이프 절단, 나팔구·곡관 접기, 서보 벨트 공급, 라벨 접기 | 소멸(Fee Related) | 연차료 미납 종료(종료일 표기 애매, 예상 만료 2027-12-28) |
| [CN215051175U](https://patents.google.com/patent/CN215051175U/zh) | 东莞市赐宏机械 | 가방·장갑 등 바인딩(매트 언급 없음) | XY 갠트리 + 누름판 + 회전 스테핑모터 | 소멸(Fee Related) | 2024-08-02 연차료 미납(예상 만료 2031-08-11) |
| [WO1996023626A1](https://patents.google.com/patent/WO1996023626A1/en) | USM España / BUSM | 신발 갑피 가장자리 감지 | 레이저 라인 + 경사 카메라, 저장 경로 전체 보정 | Ceased(유럽 단계 미진입 1998) | 국내 등록 확인 안 됨 |
| [US5493980A](https://patents.google.com/patent/US5493980A/en) | Matsuka(일본) | **바닥 매트** 가장자리 봉제 | C자 스윙암 + 로터리 엔코더 센서, 정·역회전 이송 롤러, 3위치 누름 롤러 | 소멸(Fee Related) | 2000-02-27 |
| [KR102139457B1](https://patents.google.com/patent/KR102139457B1/en) | 픽스로봇(한국) | 매트용 스티치 | 감지봉 + 스프링 + 엔코더, 위아래 롤러 4개 속도차 조향 | **상태 미확인**(같은 계열 KR102459825B1 등 다수) | 확인 필요 |
| [US4688499A](https://patents.google.com/patent/US4688499A/en) | Collins & Aikman | 욕실 러그 자동 제작 | 로봇 진공 흡착헤드로 들고 회전, V자 칼, 360° 넘게 돌아 끝이 시작부 덮음 | 만료(Lifetime) | 2006-12-01 |
| [US7533621B2](https://patents.google.com/patent/US7533621B2/en) | Maples Industries | 러그 봉제 | 갠트리 + 템플릿, 테이프 끝 접어 넣는 폴더, 초음파 절단·봉함(약 20 kHz) | **유효(Active)** | 2027-02-02 예상 |
| [US6848378B2](https://patents.google.com/patent/US6848378B2/en) | Jet Sew | 재료 가장자리 바인딩 | 스풀 브레이크, 핸드휠 연동 테이프 구동, 가열 칼날 절단·융착 | 소멸(Fee Related) | 2009-02-01 |
| [US6044783A](https://patents.google.com/patent/US6044783A/en) | Klear-Vu | 카펫·러그·방석 테이프 끝 자동 마감 | 길게 자른 끝을 폭 방향으로 접어 플로우에 밀어 넣기 | 소멸(Fee Related) | 2004-04-04 |
| [WO2021083570A1](https://patents.google.com/patent/WO2021083570A1/en) / EP4051489B1 | ACG Kinna(스웨덴) | 직물 제품 가장자리 바인딩 | 회전 없이 직선 운동, 모서리 테이프 끝 열봉함(초음파 선호) | WO Ceased, **EP4051489B1 등록(2025-05-28)**, CA·ES 대응 | EP 유효로 보임(존속기간 확인 필요) |
| [US7383780B1](https://patents.google.com/patent/US7383780) | Atlanta Attachment | 매트리스 테이프 에지 | 상류 센서 + 땀 수로 모서리 도착 계산, 회전암 약 90° | **유효(Active)** | 2026-11-23 조정 만료 |
| [US4062307A](https://patents.google.com/patent/US4062307A/en) | Janser | 휴대형 카펫 바인더 | 원뿔 누름 롤러를 바늘 쪽으로 옮겨 작은 R | 만료 | — |
| [CN209114134U](https://patents.google.com/patent/CN209114134U/en) | 苏州工匠 계열 | 바닥매트 테이핑 | 서보 롤러 프레임 고무 벨트가 매트 면 누름, 바늘 중심 회전 레버, 헤링본 날 절단 후 두 겹 접기 | 소멸 | 2018 출원 |
| [CN106436044A](https://patents.google.com/patent/CN106436044A/en) | 苏州工匠 | **자동차 매트** 자동 바인딩 | 흡착 적재, 하강 회전모터가 매트 눌러 회전, XY 프로그램 경로 | 표시 Pending, 2023-06-09 공개 후 **거절** 기록 | — |
| [CN106757804A](https://patents.google.com/patent/CN106757804A/en) | 苏州工匠/匠博 | 바닥 매트 오버로크 | 노루발 옆 보조 밀기 바퀴 역회전으로 바늘 둘레 회전, 초음파 실 태우기 | 공개 후 거절 | — |
| [CN108118461A](https://patents.google.com/patent/CN108118461A/en) | 같은 출원인 | 발매트 자동 조향 감지 | 확산반사 스위치 3개로 직선·안쪽 호·바깥 호 판정 | 2024-09-10 거절(실용신안 짝 CN207958680U 상태 미확인) | — |
| [CN112726042A](https://patents.google.com/patent/CN112726042A/en) | 苏州琼派瑞特 | 비정형 바닥매트 바인딩 | 회전 디스크 + 핀치 롤러 역회전 90°, 회전 중 롤러 살짝 들기 | 2025-10-14 거절(짝 CN215051172U 상태 미확인) | — |
| [WO2025035577A1](https://patents.google.com/patent/WO2025035577A1/en) | 苏州穹派瑞特 | 2헤드 회전 바인딩 | 회전 누름판 360°, 테이프 꼬리 안쪽 접어 넣기, 초음파 모서리 라운딩 | Ceased 표시(중국 대응 출원 미확인) | 2023 우선일, 확인 필요 |

이 표가 주는 실무 결론은 간단하다. 새 기계가 쓰려는 핵심 개념인 진공 원판·자유 회전·바늘 앞 센서·바늘 내림 코너 회전·테이프 끝 접어 넣기는 소멸 특허에 공개돼 있다. 그래서 이 문서들은 권리 장애가 아니라 공지기술 근거가 된다(추정). 주의할 것은 네 갈래다. 하나는 Maples US7533621B2의 "테이프 끝 접어 넣기 폴더 + 초음파 절단·봉함" 조합이다. 둘째는 ACG Kinna EP4051489B1의 모서리 열봉함이고, 셋째는 한국 픽스로봇 계열(KR102139457B1, KR102093407B1, KR102110255B1, KR102459825B1, KR102465016B1, KR102907791B1, [유사문헌 목록](https://patents.google.com/patent/KR102139457B1/en))이다. 넷째는 상태를 보지 못한 중국 실용신안 짝들이다. 한국 실시를 전제로 한 청구항 대조는 변리사 확인 과제로 남는다.

## 매트를 끄는 힘은 헤드가 내고, 받침은 따라가며 버틴다

### 이송 주체: 헤드 자체 이송 + 수동 부유 받침이 롤러 없는 유일한 선례다

매트를 누가 움직이는지에서 공개 사례는 세 갈래로 나뉜다. 첫째 갈래는 **재봉 헤드 자체 이송이 매트를 끌고 기계 축은 위치만 맞추는** 방식이다. US6557478은 매트를 도는 구동이 아예 없다. 원판이 자유 회전하고, 바늘과 노루발이 매트를 끌어당기는 힘으로 매트가 원판 위에서 돈다. 직선 액추에이터는 원판을 헤드 쪽으로 밀어 가장자리를 감지 암 영점에 붙잡아 둘 뿐이다([US6557478](https://patents.google.com/patent/US6557478B2/en)). US5367966도 피드독과 노루발이 작업물을 보내고, 클램프 조립체는 무게중심 축 둘레를 수동 회전하며 바늘축 방향으로 수동 직선 이동(float)한다([US5367966](https://patents.google.com/patent/US5367966A/en)). 둘째 갈래는 **롤러·벨트·바퀴가 매트 면을 물어 끄는** 방식이다. Matsuka US5493980의 정·역회전 이송 롤러와 누름 롤러([US5493980A](https://patents.google.com/patent/US5493980A/en)), 픽스로봇의 위아래 롤러 4개([KR102139457B1](https://patents.google.com/patent/KR102139457B1/en)), CN209114134U의 고무 벨트가 여기 속한다. CN209114134U의 벨트는 "매트 원단 면에 직접 눌린다"고 적혀 있다([CN209114134U](https://patents.google.com/patent/CN209114134U/en)). 셋째 갈래는 **로봇·갠트리가 물건을 쥐고 움직이는** 방식이다. US4688499의 진공 흡착헤드 로봇([US4688499A](https://patents.google.com/patent/US4688499A/en)), CN215051175U의 누름판 갠트리([CN215051175U](https://patents.google.com/patent/CN215051175U/zh)), TITAN 로봇 팔([검색요약] [TITAN 5540 PDF](https://pdf.directindustry.com/pdf/vandewiele/titan-5540/172691-1134635.html))이 그 예다.

새 기계는 둘째 갈래를 쓸 수 없다(C-03). 셋째 갈래 중 누름판형은 파일 면을 판으로 누르므로 압력·면적·시간을 검증해야 한다. 그래서 **첫째 갈래, 곧 헤드 이송이 접선 방향 힘을 내고 매트 받침은 배킹 면 진공으로 잡은 채 자유 회전·반경 방향 부유로 따라가는 구조**가 C-03과 R375X 구조(C-01)를 둘 다 만족하는 유일한 공개 선례다(추정). DA 867 매트 바인딩 사양의 이송은 하송·바늘이송·교대 노루발 상송의 3중 이송이고, 교대 노루발 행정은 최대 9 mm다([DA 867-M SPECIALS PDF](https://cdn.shopify.com/s/files/1/0719/8408/7323/files/Castle_Sewing.pdf)). 노루발이 누르는 곳은 테이프가 덮일 가장자리 띠라서 노출 파일 면 누름과는 다른 문제다(추정). 다만 노루발 압력과 밑면 형상 자료는 찾지 못했으므로 노루발 자국은 시제품 확인 항목이다. 퓰러(바늘 뒤 홈 롤러)는 원리상 소재를 물고 누른다([US5875723](https://patents.google.com/patent/US5875723)). DA 매트 바인딩 사양의 장비 표에는 퓰러 항목이 없다([DA 867-M SPECIALS PDF](https://cdn.shopify.com/s/files/1/0719/8408/7323/files/Castle_Sewing.pdf)). 포럼 실무 의견도 자동차 카펫에 퓰러가 늘 필요하지는 않다고 본다([Leatherworker.net](https://leatherworker.net/forum/topic/92952-sewing-machine-models-for-carpet-bindingauto-upholstery)). 퓰러는 쓰지 않는 쪽이 맞다(추정).

남는 위험은 큰 매트(120×120 cm급)의 관성과 마찰을 헤드 이송만으로 끌 수 있느냐다. 공개 자료에서 찾은 대책은 셋이다. US6557478은 매트 위에 추를 올릴 수 있다고 적는다. US6155186은 매트와 봉제면 사이에 마찰 저감 부재를 둔다([검색요약] [US6155186 PDF](https://image-ppubs.uspto.gov/dirsearch-public/print/downloadPdf/6155186)). TITAN은 에어 테이블을 쓴다([검색요약] [TITAN 5540 PDF](https://pdf.directindustry.com/pdf/vandewiele/titan-5540/172691-1134635.html)). 큰 매트에서 순수 수동 받침이 버티지 못하면, 받침 회전축과 반경축을 서보로 하되 토크·위치를 헤드 이송에 동기시켜 "끌림을 돕는" 능동 추종으로 가는 것이 자연스러운 확장이다(추정). ACG Kinna는 반대로 큰 물건을 돌리면 크기에 비례해 느려진다고 보고 회전을 아예 없앴다([WO2021083570A1](https://patents.google.com/patent/WO2021083570A1/en)). 새 기계는 회전을 전제로 하므로 사이클 비교 기준은 R375A의 앞좌석 45~50 s다(추정).

### 잡기: 배킹 면 진공이 파일 면을 지키는 공개 해법이다

잡는 방식을 공개한 사례 가운데 파일 면을 건드리지 않는 것은 진공 흡착뿐이다. US6557478은 원판에 구멍을 뚫어 진공펌프로 매트를 흡착하고, 대안으로 솔레노이드 가압 암을 적는다. 작업자는 매트를 테이블 중심에서 **3~4 in 이내**로 대충 놓고 양손 버튼을 누른다. 그러면 1초 뒤 진공이 켜지고 액추에이터가 전진한다. 360° 검출 스위치가 원판을 원점으로 돌리면 진공이 풀린다([US6557478](https://patents.google.com/patent/US6557478B2/en)). "작업자는 매트만 올리고 이후 자동"이라는 요구와 가장 가깝다. US4688499는 로봇 흡착헤드로 러그를 들고 돈다([US4688499A](https://patents.google.com/patent/US4688499A/en)). 다만 이번 조사에서 "진공 테이블 자체가 바늘 둘레로 돌며 봉제"를 청구한 특허는 찾지 못했다. 흡착 받침과 바늘 중심 회전의 결합은 새 기계의 차별점 후보다(추정). 롤러 쪽 특허 출원인들도 약점을 알았다. Matsuka는 국부 응력을 줄이려 누름 롤러 대신 볼을 쓰는 변형을 두고([US5493980A](https://patents.google.com/patent/US5493980A/en)), CN112726042A는 회전 중 핀치 롤러를 살짝 들어 주름을 막는다([CN112726042A](https://patents.google.com/patent/CN112726042A/en)).

### 베드와 받침의 공간 나누기: 평판 베드 위에 받침이 같은 높이로 붙고 바늘 둘레를 비운다

DA 867 매트 바인딩 사양은 **평판(flatbed) 본봉**이다. 공식 표의 수치는 암 밑 공간 **335 mm(폭)×125 mm(높이)**, 노루발 밑 통과 높이 **봉제 중 최대 10 mm·들었을 때 최대 20 mm**(공압)다. 훅은 **수직 XXL Ø 32 mm로 바늘 왼쪽**에 있고, 헤드 무게는 55~58 kg, 공기는 6 bar다([DA 867-M SPECIALS PDF](https://cdn.shopify.com/s/files/1/0719/8408/7323/files/Castle_Sewing.pdf), [DA 867-M ECO PDF](https://partner.duerkopp-adler.com/commons/download/public/867-M/DA_867-M-ECO_deen_12-2020.pdf)). 공식 사진을 보면 이동식(차동) 바인더는 노루발 바로 앞 오른쪽 **베드판 위**에 있다. 테이프는 베드판 오른쪽 뒤의 세로 핀 4~5개짜리 가이드를 거쳐 들어간다. 2본침 세트는 베드판 위 회전 레일(swivel rail)로 바인더를 젖혀 뺀다([DA 867-M SPECIALS PDF](https://cdn.shopify.com/s/files/1/0719/8408/7323/files/Castle_Sewing.pdf), [DA Binding PDF](https://partner.duerkopp-adler.com/commons/news/downloads/Duerkopp-Adler_Binding_DIN-A4_EN.pdf)). **베드판 외형, 테이블 위 베드 높이, 바늘에서 베드 끝까지 거리, 바늘판 크기는 세 공식 PDF 어디에도 없다.** 사용설명서의 테이블 가공도나 대리점 도면으로 받아야 한다(자료대기 대상).

이 사실에서 나오는 공간 구성은 다음과 같다(추정). 평판 베드에서는 바늘판 밑에 훅·이송 톱니가 깔리므로 베드가 홈 안으로 들어갈 수 없다. 홈 안으로 들어갈 수 있는 것은 바늘·노루발·바인더 끝뿐이다. 매트 받침(진공판)은 바늘판 면과 같은 높이이거나 그보다 조금 낮게 겹쳐야 한다. 바늘판·톱니 영역과 바인더 아래 날개가 지나는 길은 받침 가장자리가 비켜야 한다. 사진상 바인더·테이프 가이드·회전 레일이 바늘 오른쪽 앞·뒤를 차지한다. 그러니 매트 본체와 받침 회전 영역은 그 반대쪽에 놓인다. 바늘 앞 가장자리 센서는 바인더 몸체와 같은 좁은 공간을 다툰다. R375X가 굳이 "헤드 구조를 고쳤다"고 쓴 것도 표준 평판 헤드 주변 공간이 매트 회전에 모자랐기 때문으로 보인다(추정, 근거는 문구뿐). 포스트베드(DA 868-M)는 바늘 밑이 기둥으로 좁아져 받침과 공간을 나누기에 원리상 유리하다. 그러나 DA는 868-M을 시트커버·대시보드용으로만 적고 매트 바인딩용으로 내지 않는다([Babylock DA868-M 카탈로그](https://corporate.babylock.co.jp/wp-content/uploads/2022/04/DA868-M　カタログ.pdf)). 기둥 치수도 찾지 못했다. 평판 기준으로 공간을 잡고 포스트베드는 대안으로만 두는 편이 근거에 맞다(추정).

## 코너는 풀렸고, 좁은 홈은 아무도 공개하지 않았다

### 바깥 모서리: 바늘을 꽂고 노루발을 든 채 돌리는 순서가 이미 정해져 있다

US5367966은 코너 시퀀스를 그대로 적는다. 코너 센서(일반 재귀반사 광전센서)가 다가오는 코너를 보는 동안 카운터가 증가하고, 그 솔기의 저장된 코너 값에 이르면 재봉·조향 모터가 정지한다. 이어 바늘을 내려 꽂은 채 노루발을 들고, 가장자리 센서가 만족될 때까지 작업물을 반시계로 돌린 뒤 다음 솔기를 박는다([US5367966](https://patents.google.com/patent/US5367966A/en)). Atlanta Attachment는 바늘 상류 센서가 모서리를 본 뒤 땀 수로 바늘 도착 시점을 계산해 회전암을 돌리고, 회전 중 봉제를 늦춘다([US7383780B1](https://patents.google.com/patent/US7383780)). Matsuka는 볼록 모서리에서 이송 피치를 줄이고 이송 롤러를 역회전해 바늘 둘레로 약 90° 돌린다. 작업자가 모서리 수(실시예 5개)를 넣고, 마지막 모서리 뒤에는 타이머로 멈춘다([US5493980A](https://patents.google.com/patent/US5493980A/en)). US6557478은 별도 코너 루틴 없이 연속 추종하고, 작은 반경에서 센서 신호로 속도만 낮춘다([US6557478](https://patents.google.com/patent/US6557478B2/en)). TITAN 2530AG의 "코너마다 노루발·바늘을 올린 채 자동 정지"([검색요약] [DirectIndustry](https://www.directindustry.com/prod/van-de-wiele/product-172691-2046145.html))는 작업자가 매트를 돌리는 반자동 동작으로 읽힌다(추정).

새 기계에 주는 함의는 회전 중심이다(추정). 바늘을 꽂은 채 돌리면 실제 회전 중심은 바늘이다. 그런데 받침 원판의 회전축은 매트 중심 근처에 있다. US5367966은 이 차이를 수동 회전과 반경 방향 직선 부유로 흡수한다. 받침 회전을 능동 서보로 하면 바늘 둘레 회전을 만들기 위해 반경·접선 직선축을 동시에 보정해야 한다. CN215051175U의 "누름판 + 회전 스테핑모터 + XY 갠트리"는 회전 중심을 임의 점으로 옮길 수 있는 구조의 공개 예다([CN215051175U](https://patents.google.com/patent/CN215051175U/zh)). 받침이 θ와 XY를 갖되 코너에서는 수동 부유(클러치 해제)로 바뀌는 혼합 방식도 가능하다(추정). 어느 쪽이 맞는지는 공개 자료로 판정할 수 없다.

### 센서: 접촉 암은 홈에 못 들어가고, 광센서는 파일에 속는다

센서 선택은 좁은 홈과 직결된다. Matsuka는 쓰러진 파일이 광센서를 헷갈리게 해서 **기계식 스윙암을 주 센서로 하고 광센서는 보조**로 둔다고 적는다([US5493980A](https://patents.google.com/patent/US5493980A/en)). 픽스로봇도 감지봉 + 스프링 + 엔코더를 쓴다. 감지봉과 봉제 유닛의 간격은 감지와 조향 사이 지연을 감안해 정한다([KR102139457B1](https://patents.google.com/patent/KR102139457B1/en)). 1970년대 특허는 센서를 바늘보다 **약 한 땀 앞**에 두라고 한다([검색요약] [US3609373A](https://patents.google.com/patent/US3609373A/enExample), [US3693561A](https://patents.google.com/patent/US3693561A/OSRAM)). US5367966은 아날로그 재귀반사 센서(예 Datalogic RTO-0-3)에 원통렌즈로 길쭉한 시야를 만들고, 반사 매체를 바늘축 바로 앞 베이스에 둔다. 학습 모드에서 만든 룩업 테이블과 비교해 비례 조향한다([US5367966](https://patents.google.com/patent/US5367966A/en)). WO1996023626은 3 mW 레이저 라인과 45° 경사 카메라로 높이 단차가 만드는 선의 불연속을 본다. 반사율이 아니라 단차를 보므로 표면 색에 덜 민감하다. 실측 가장자리로 저장 경로 전체를 보정해 지그재그 땀을 막는다([WO1996023626](https://patents.google.com/patent/WO1996023626A1/en)). 어떤 특허도 센서-바늘 거리 수치를 주지 않는다.

정리하면 이렇다(추정). 접촉 암은 파일에 강하지만 좁은 V·U 홈 안으로 들어가기 어렵다. 위에서 보는 반사형 광센서는 파일과 검정 고무 배킹에 약하다. US5367966식으로 베드 쪽 반사 매체를 매트가 가리는 비율을 아래에서 읽는 투과·차폐형이나, WO1996023626식 레이저 단차 측정이 두 약점을 피하는 후보다. 좁은 홈처럼 센서가 가장자리를 순간 놓치는 구간은 "사전 스캔으로 경로를 만들고 봉제 중 보정"하는 2단 구조로 덮을 수 있다. 다만 요구서가 정한 "바늘 앞 센서로 봉제 중 추종"(C-02)을 바꾸는 것이 아니라 보조로 두는 것이다.

### 오목 모서리와 좁은 홈: 공개 최소는 안쪽 반경 30 mm다

오목 처리에 대해 공개된 것은 속도·피치 조절 수준이다. Matsuka 청구항 14는 "볼록 = 작은 피치·느린 회전, 오목 = 큰 피치·빠른 회전"이다([US5493980A](https://patents.google.com/patent/US5493980A/en)). CN112726042A는 안쪽 필렛에서 가속한다([CN112726042A](https://patents.google.com/patent/CN112726042A/en)). US4062307A는 원뿔 누름 롤러를 바늘 쪽으로 옮겨 작은 안팎 R을 돈다([US4062307A](https://patents.google.com/patent/US4062307A/en)). DA 867-392342는 좁은 안팎 R에서 고른 땀을 내려고 **두 번째 땀길이를 미리 선택**하게 한다. 차동 이동식 바인더로 안쪽·바깥쪽 곡선에서 테이프 장력을 낮게 유지한다([DA 867-392342](https://partner.duerkopp-adler.com/en/main/products/MS_01_flatbed_1_specials/0867-392342.html)). 상용 전용기의 공개 한계는 TITAN 2530AG/AHC의 **최소 안쪽 반경 30 mm**다([검색요약] [DirectIndustry](https://www.directindustry.com/prod/van-de-wiele/product-172691-2046145.html), [2530AHC PDF](https://pdf.directindustry.com/pdf/vandewiele/titan-2530ahc/172691-1134622.html)). TITAN 4510AHC는 "좁은 안쪽 곡선용"이라는 문구만 있다([검색요약] [DirectIndustry 4510AHC](https://www.directindustry.com/prod/vandewiele/product-172691-2826734.html)). R375X의 최소 오목 반경은 공개되지 않았다(자료대기 D-14 그대로).

좁은 홈 바닥에서 테이프를 접어 겹치는 방법(미터링), 회전 중 테이프 공급량을 보정하는 방법은 공개 자료가 없다. 안쪽 R에서 테이프 바깥 날개와 안쪽 날개의 둘레 길이가 달라져 생기는 주름·늘어남에 대한 대책도 찾지 못했다. 따라서 **좁은 V·U 홈 마감은 업계 공개 범위 밖의 과제**다(추정). 기구 쪽에서 할 수 있는 일은 공간을 남기는 것이다. 바인더 출구와 노루발 앞끝을 홈 폭보다 작게 만들고, 바늘 둘레 회전 시 받침·센서가 홈 벽에 닿지 않게 하며, 두 번째 땀길이·속도 저하·차동 바인더 조정을 제어 쪽에 넘긴다. 실제 마감 품질은 요구서 7절 시제품 확인으로 가야 한다. 한편 공개 선례가 없다는 점은 특허 출원 후보라는 뜻이기도 하다(추정).

## 테이프 공급과 이음매는 만료 특허의 시퀀스로 조립된다

### 공급·장력·절단: 무장력 차동 바인더와 봉제 동기 공급이 기준이다

DA 867 매트 사양의 핵심은 **장력 없는 테이프 공급을 위한 차동 이동식 바인더**다. 버튼으로 차동 단계를 고르고, 한쪽·양쪽 접힘 테이프와 오픈엣지 테이프를 받는다. 실 트리머와 자동 되박음이 있다([DA 867-392342](https://partner.duerkopp-adler.com/en/main/products/MS_01_flatbed_1_specials/0867-392342.html)). 867-394342는 바인더 바로 앞에서 소재 가장자리를 다듬는 전환식 커터를 단다([DA 867-M SPECIALS PDF](https://cdn.shopify.com/s/files/1/0719/8408/7323/files/Castle_Sewing.pdf)). Jet Sew는 공급 쪽을 자세히 적었다. 스풀 브레이크는 헤드가 관성으로 멈출 때 테이프가 더 풀리지 않게 하고, 구동 롤러는 헤드 핸드휠에 연동돼 봉제 중에만 테이프를 낸다. 텐셔너가 물림력, 곧 공급량을 정한다([US6848378B2](https://patents.google.com/patent/US6848378B2/en)). CN207958657U는 모터 롤러 송출 → 누름 실린더가 날 앞에서 테이프를 폄 → 크랭크 회전날의 작두식 절단 → 나팔구·곡관 접기 → 서보 벨트가 테이프를 가이드 홈에 눌러 밀어 이송 속도를 정하는 흐름이다([CN207958657U](https://patents.google.com/patent/CN207958657U/zh)). RI.MA.C.은 열절단과 누벅 테이프 장력 저감(Habraken)을 옵션으로 둔다([rimac.it R375](https://www.rimac.it/en/products/r375/)).

새 기계에서는 테이프 공급을 헤드 이송에 전자적으로 동기시키고, 코너·홈에서 차동 단계를 바꾸는 구성이 이 근거들의 합이다(추정). 테이프 장력의 구체적 제어 수치는 어느 자료에도 없다. 늘어남·주름 판정은 모델로 하지 않고 7절 시제품 항목으로 둔다(CLAUDE.md 규칙과 같음).

### 이음매: "길게 잘라 → 폭 방향으로 접어 → 앞끝 위에 꿰매기"가 요구서와 정확히 맞는다

요구서의 이음매 조건은 시작·끝이 겹쳐 물리고 자른 면이 보이지 않는 것이다. 이에 가장 직접 맞는 공개 기술은 **Klear-Vu US6044783A(2004 소멸)**다. 이 특허가 푸는 문제부터 같다. 롤에서 자른 테이프는 양 끝이 날것이라 끝을 앞끝 위에 꿰매면 앞끝은 숨지만 끝은 드러난다. 시퀀스는 이렇다. 가장자리 대부분을 꿰맨 뒤 트리머가 테이프를 **가장자리보다 약 1인치 길게** 자른다. 수평 공압 실린더가 가이드를 플로우 입구로 내밀어, 잘린 끝을 나온 막대 둘레로 감아 폭 방향으로 자기 위에 접으며 입구에 넣는다. 막대가 빠지면 가이드가 접힌 끝을 붙잡아 플로우를 통과시킨다. 그러면 접힌 끝이 앞끝 위에 꿰매져 마감된 가장자리만 보인다([US6044783A](https://patents.google.com/patent/US6044783A/en)). 다만 앞끝을 다시 꿰는 일은 작업자가 하고, 길이를 재는 센서·계산은 적혀 있지 않다.

빈 곳은 다른 특허가 메운다. 앞끝 자동 재삽입은 Collins & Aikman의 방법이 가장 가깝다. 공압 V자 칼이 테이프 가운데 일부를 남기고 잘라, 물건에 닿을 때 장력으로 끊기게 한다. 그래서 앞끝은 가이드에 남아 다음 조각에 이어진다. 로봇이 **360°보다 조금 더 돌아** 여분 테이프가 봉제 시작부를 덮는다([US4688499A](https://patents.google.com/patent/US4688499A/en)). 절단 시점은 Atlanta Attachment의 "센서에서 바늘까지를 땀 수로 환산" 방식으로 계산할 수 있다([US7383780B1](https://patents.google.com/patent/US7383780)). Matsuka의 "모서리 수 + 마지막 모서리 뒤 타이머"도 끝 판정 방법이다([US5493980A](https://patents.google.com/patent/US5493980A/en)). Atlanta는 봉제를 첫 변 중간에서 시작한다. US6044783A도 직선 구간에서 끝나는 경우를 전제로 한다. 따라서 **이음 위치는 직선 구간에 둔다**는 것이 접어 넣기 이음의 전제 조건이다(추정). 형상 추종으로 직선 구간을 찾아 시작점을 고르는 판단이 제어 쪽 요구가 된다.

열·초음파 처리는 대안이자 보조다. Maples는 위 앤빌 + 아래 초음파 분리·봉함기(약 20 kHz)로 자르면서 녹여 봉해 테이프와 실 체인이 풀리지 않게 한다. 폴더로 U자 테이프의 끝을 접어 넣어 "clean finish"를 낸다([US7533621B2](https://patents.google.com/patent/US7533621B2/en)). 이 특허는 **2027-02-02까지 유효로 표시**되므로 같은 조합을 미국에서 쓰려면 확인이 필요하다. Jet Sew는 가열 칼날 **약 750~850°F(800°F 선호)**로 테이프와 실을 한 번에 자르고 녹여 붙인다. 낮으면 실오라기가 남고 높으면 테이프가 탄다([US6848378B2](https://patents.google.com/patent/US6848378B2/en)). ACG Kinna는 모서리마다 돌출 테이프 끝을 두 블록 사이 제한 슬롯으로 당겨 초음파로 봉하고 잘라, 봉함부 돌출을 **약 2 mm 미만(바람직하게 1 mm 미만)**으로 한다([WO2021083570A1](https://patents.google.com/patent/WO2021083570A1/en)). TITAN 로봇은 마지막 땀을 뒷면에서 초음파 용착으로 고정한다([검색요약] [wotol](https://www.wotol.com/product/titan-dk4650-60-x-100-cm-automatic-overedging-system-for-car-mats/1810328)). 그러나 초음파·열절단 끝은 날 끝이 보이는 맞대기·겹침이다. 대기업 납품 외관 기준에서는 "접어 넣은 끝"이 주 방식이고, 열절단은 접히는 끝의 올 풀림을 막는 보조로 쓰는 것이 요구서에 맞다(추정). 테이프가 열가소성이 아니면 열 처리는 효과가 없으므로 테이프 재질 확인이 먼저다.

이를 하나로 엮으면 새 기계의 이음 시퀀스 후보가 된다(추정). 첫째, 앞끝이 바인더에 꿰인 채 직선 구간 중간에서 봉제를 시작한다. 둘째, 둘레 추종 뒤 땀 수로 남은 길이를 계산해 겹침 여유를 두고 절단한다(필요하면 열절단). 셋째, 잘린 끝을 폭 방향으로 접어 바인더 입구에 밀어 넣는다. 넷째, 시작부 위를 겹쳐 꿰매고 되박음·실 트리밍으로 끝낸다. 다섯째, 다음 매트용 앞끝은 V자 부분 절단처럼 바인더에 남긴다. 겹침 길이는 특허 실시예 값(약 1인치)뿐이므로 테이프 폭·두께별 값은 시제품으로 정한다.

## 툴 교체는 바인더 하나가 아니라 테이프 경로 전체를 한 카세트로 바꾸는 일이다

테이프 폭별 대응을 직접 다룬 공개 자료는 적다. DA는 테이프와 소재 구조에 맞춘 **표준 바인딩 어태치먼트 여러 종과 맞춤 어태치먼트**를 낸다([DA 867-392342](https://partner.duerkopp-adler.com/en/main/products/MS_01_flatbed_1_specials/0867-392342.html)). 2본침 세트는 바늘 간격 4 mm(0867 V92772)·6 mm(0867 V92789)로 나뉘고, 회전 레일로 빠르게 전환한다([DA Binding PDF](https://partner.duerkopp-adler.com/commons/news/downloads/Duerkopp-Adler_Binding_DIN-A4_EN.pdf)). Van de Wiele 제품군은 테이프 22~150 mm를 다룬다([vandewiele.com](https://vandewiele.com/textile-solutions/sewing/tape-binding)). CN207958657U의 테이프 조립체는 2층 직선가이드로 X·Y를 조정한다([CN207958657U](https://patents.google.com/patent/CN207958657U/zh)). 일반 바인더는 헤드 쪽이나 베드 쪽 장착 구멍에 붙인다([US985257](https://patents.google.com/patent/US985257)). Sailrite는 바인더를 노루발에 최대한 가깝게 두라고 권한다([검색요약] [Sailrite](https://www.sailrite.com/Tips-for-Binding-Curves-on-Carpet-and-Flooring)). R375X의 테이프 폭과 교체 방식은 공개되지 않았다.

새 기계에서 테이프 폭이 바뀌면 영향받는 부품은 바인더(깔때기)만이 아니다. 테이프 가이드, 공급 롤러·벨트 폭, 커터 날 폭, 이음 접이 기구(막대·가이드), 그리고 2본침이면 바늘판·노루발·바늘 간격까지 바뀐다(추정). 그래서 이들을 **베드판 위 기준 레일에 위치 결정 핀으로 한 번에 앉는 카세트**로 묶고, 바늘 기준 위치를 카세트 쪽에 두는 것이 툴 교체의 기본 개념이 된다(추정). DA의 회전 레일은 바인더를 젖혀 빼는 공개 선례로 쓸 수 있다. 센서 위치도 테이프 폭에 따라 가장자리 기준선이 바뀌므로, 카세트에 센서 기준을 함께 넣거나 소프트웨어 오프셋으로 처리해야 한다(추정).

## 결론

조사가 바꾼 그림은 이렇다. 처음에는 R375X를 따라잡는 것이 목표처럼 보였지만, R375X는 기구를 공개하지 않는다. 대신 Sherwin·Draper·Klear-Vu·Collins & Aikman의 소멸 특허가 받침(진공 자유 회전 + 반경 부유), 코너(바늘 꽂고 노루발 들어 회전), 이음매(길게 잘라 폭 방향 접어 넣기, 360° 넘겨 덮기, 앞끝 남기기)를 이미 다 공개했다. 그래서 새 기계는 "남의 기계 역설계"가 아니라 "공지 기술의 조합 + 좁은 홈이라는 빈칸 하나"의 문제다. 조합 자체는 권리 장애가 낮다. 다만 Maples(초음파 절단 + 끝 접기 폴더, 2027-02 만료 예상), ACG Kinna EP4051489B1(모서리 열봉함), 한국 픽스로봇 계열은 실시 전에 청구항을 봐야 한다.

구동 개념 설계에 바로 넘길 판단은 넷이다(모두 추정). 첫째, 이송의 주체는 헤드 3중 이송이고, 받침은 배킹 진공으로 잡되 수동 부유를 기본으로 하며 큰 매트용 능동 보조를 옵션으로 둔다. 둘째, 베드는 평판 867급을 기준으로 받침을 같은 높이에 붙이고, 바인더·테이프 경로·센서를 바늘 한쪽에 몰아 받침 회전 영역과 나눈다. 이를 위해 867 베드판·테이블 컷아웃 도면을 자료대기로 받아야 한다. 셋째, 이음은 접어 넣기를 주 방식으로 하고 열절단은 보조로 둔다. 이음 위치는 직선 구간으로 제어 요구에 넘긴다. 넷째, 테이프 폭 교체는 바인더·가이드·커터·접이 기구를 한 카세트로 묶는다. 좁은 V·U 홈은 공개 한계(안쪽 R 30 mm) 밖이므로 기구는 공간 여유만 확보하고 판정은 7절 시제품으로 넘긴다. 이 빈칸이 기술 위험이자 특허 출원 후보라는 점을 결정로그에 남겨 둘 가치가 있다.
