hyeunung/FSAP/docs/reports/engine-candidates.md

# 엔진 개선 후보 (FSAP에서 발견, 엔진에 옮기기 전)

엔진 폴더는 읽기만 한다(사용자 2026-10-30). 엔진 `engine/improvement-candidates.md` "미반영" 표와 같은 형식이다. 번호는 엔진 표의 마지막(WF-050) 다음부터.

## 미반영

| ID | 우선 | 제목 | 반복 | 영향 | 제안 수정 | 증거 |
|---|---|---|---|---|---|---|
| WF-051 | 신규 | **준비부 지시가 서로 어긋나 다 만들고도 실행이 멈춤** — 준비 지시 "요구서에 값이 없으면 지어내지 말고 자료대기에 남기고 done=false"와 실행 추가 규칙 (6) "D-번호 임시값으로 진행"이 함께 주어짐 | 1 | 준비 점검이 빠졌다고 한 11가지를 모두 만들어 v0.1.0 저장했는데 결과는 "준비 못 함", T01~T07 7과제 0건 진행 | modeling-round "준비" 단계 지시와 E-08(자료대기) 사이에 한 문장: "D-번호 임시값으로 만든 준비물은 done=true(임시값 목록 첨부)로 내고 과제를 돌린다. done=false는 만들 수 없을 때만" | FSAP MAT-RS-001 `docs/reports/mechanism/mech_prep.md:133`, 커밋 6c52b0e, 발견: 엔진 v2.3.0, FSAP MAT-RS-001, mech_2026-10-30_T01-T02-T03-T04-T05-T06-T07(중단: 준비 못 함) |
| WF-052 | 신규 | **작업 대상 수치(요구서 0-2)가 비어 있는 채 "모델링 해줘"가 시작됨**(E-01 시작 질문의 빈칸) | 1 | D-01~D-07 전부 미정, 작업 대상 모형 치수 대부분이 근거 없는 자리값 | 시작 질문 목록(templates)의 0-2 항목에 "모르면 대략값(±)으로라도"를 넣고, 0-2가 비면 시작 전에 한 번 묻는다 | FSAP MAT-RS-001 `mech_prep.md:132`, 발견: 엔진 v2.3.0, FSAP MAT-RS-001, mech_2026-10-30_T01-T02-T03-T04-T05-T06-T07(중단: 준비 못 함) |
| WF-053 | 신규 | **요구서 양식 6-4 상태 목록이 0-3 사이클 전 단계를 덮는지 확인하는 안내가 없음** | 1 | 6-4가 0-3의 ③·④ 이음매만 덮어 동작 연구 단계를 준비부가 추정 | 요구서 양식 6-4에 "0-3 각 단계가 6-4 상태 하나 이상에 대응"을 넣고 대화 단계에서 확인 | FSAP MAT-RS-001 `mech_prep_check.md:84`, 발견: 엔진 v2.3.0, FSAP MAT-RS-001, mech_2026-10-30_T01-T02-T03-T04-T05-T06-T07(중단: 준비 못 함) |
| WF-054 | 신규 | **동작 상태 초기화 인자가 대기 동작 연구가 없는 설계에도 그대로 주어짐** | 1 | 준비 점검 끝 초기화(`motion.play` step 0) 대상 없음 | 안내서 `engine/cad/solidcraft.md` '동작 상태 초기화'와 스크립트 resetCall 단계에 "연구가 없으면 건너뛰고 적는다" | FSAP MAT-RS-001 `mech_prep_check.md:81`, 발견: 엔진 v2.3.0, FSAP MAT-RS-001, mech_2026-10-30_T01-T02-T03-T04-T05-T06-T07(중단: 준비 못 함) |
| WF-055 | 신규 | **SolidCraft 안내서에 CLI 0.26.1 함정이 빠짐** — `motion.interference` 기본 예산에서 끊김(`truncated: true`), 슬라이더 방향은 원점 z(`flip`), `sketch.offset` 체인·호 붕괴, `eval --json-out`은 마지막 측정만(단계별은 `run --results`), `timeline.inspect`는 빈 설계에서 못 부름 | 1 | 각 부서가 같은 함정을 따로 시험해 찾음(준비부·준비 점검부 각각) | 안내서 '동작 검사'(budget_s 필수, 슬라이더 z), '연결'(eval vs run --results), '문서 확인'(document.inspect), 모델링 함정(sketch.offset) 줄 추가 | FSAP MAT-RS-001 `mech_prep.md:134-137`, `mech_prep_check.md:82-83`, 발견: 엔진 v2.3.0, FSAP MAT-RS-001, mech_2026-10-30_T01-T02-T03-T04-T05-T06-T07(중단: 준비 못 함) |
| WF-056 | 신규 | **matcheck.py가 가공품 BOM이 없으면 예외로 멈춤** | 1 | 첫 실행(가공품 0개)에서 재질 점검 결과 없음 | 가공품 0개면 "검사 대상 없음"으로 통과·보고 | FSAP MAT-RS-001 `mech_prep.md:136`(RuntimeError 가공품 BOM이 없다), 발견: 엔진 v2.3.0, FSAP MAT-RS-001, mech_2026-10-30_T01-T02-T03-T04-T05-T06-T07(중단: 준비 못 함) |
| WF-080 | 신규 | **구매부가 미스미 로그인 풀림을 조용히 넘김** — 로그인이 풀리면 재로그인 금지(요구서 3-2)라 `STEP대기_` 임시 형상으로 진행하는데, 사용자는 실행이 끝나도 그 사실을 모름 | 2 | T04 화이버 머리 E32-D36P1, T05 CJ2B10-15·PSFJ16-100·CB5 볼트 STEP 못 받음(미스미 화면 '로그인 / 회원가입') | 구매부 결과 스키마에 `login`(true/false)을 넣고, 최종 보고 맨 위에 "미스미 로그인: 됨/풀림 + 로그인 문제로 못 받은 형번"을 쓰게 한다. 실행 시작 전에도 한 번 확인 | FSAP `docs/decision-log.md` "구동 T04 결과"(E32-D36P1 로그인 풀림), T05 구매부 결과, 사용자 2026-10-31 "플로우 마지막에 항상 로그인되어있나 확인해줘", 발견: 엔진 v3.2.1, FSAP MAT-RS-001, 실행 wf_d0aef4d2-9be(T05 뒤 사용자 요청으로 중단); mech_2026-10-31_S01-T06-T07-S02: 로그인 풀림(login: false)을 T06·T07·S02 구매부가 매번 보고했으나 S02 모델링 수정 회차가 다시 돌아 할 일 없이 끝남(mech_S02_model1.md 워크플로우 메모, 커밋 13af9e3), FSAP MAT-RS-001 |
| WF-081 | 신규 | **`STEP대기_` 임시 형상을 다시 실물로 바꾸는 단계가 없음** — 구매품은 그 과제의 `needs_step`만 받는다. 앞 과제에서 못 받은 형번은 다음 과제·다음 실행에서 다시 찾지 않는다 | 1 | T01 이후 SV2R20 레일·CJ2B16·DGM200R·ZH10DS 등이 계속 임시 형상. v0.3.1 교체는 따로 한 작업. 실물 치수가 다르면(LHFR16 L42→37, 레일 높이) 앞 과제 검증을 다시 해야 함 | 실행 마지막(또는 각 과제 구매품 단계)에 "STEP 대기 재시도"를 둔다: 모델의 `STEP대기_` 목록을 stepcheck로 대조해 받을 수 있으면 받고 교체·간섭 재검사. 없으면 건너뜀 | FSAP `docs/waiting-list.md` D-18~D-34, 결정로그 V031-01~05, 이번 우회: `tools/workflow-args.json` 과제 T08·T09, 발견: 엔진 v3.2.1, FSAP MAT-RS-001, 실행 wf_d0aef4d2-9be |
| WF-082 | 신규 | **SolidCraft 앱이 켜져 있어도 모델링부가 MCP 대신 CLI(`run --save`)로 그림** — 엔진은 "모델링부만 MCP"(L1 '부서 지시문', 안내서 '연결')인데, 실행 인자(shellNote)의 CLI 편집 안내와 "앱에 연 파일 덮어쓰지 않기"가 겹치자 모델링부가 CLI를 골랐다. 사용자는 모델링을 화면으로 보지 못함 | 2 | T04·T05 모델링부 MCP 호출 0회(T04 에이전트 기록에는 MCP 도구 이름도 없음) | 모델링부 지시문에 "MCP Backend가 앱이면 반드시 MCP로 open → 그림 → save {path: 새 번호}. CLI `run --save`는 MCP가 없을 때만"을 명시하고, 모델링 보고서에 쓴 통로(MCP/CLI)를 적게 한다 | 실행 wf_d0aef4d2-9be 에이전트 기록(T04·T05 모델링부 Bash만), 사용자 2026-10-31 "왜 모델링 하는게 실시간으로 안보이지", 발견: 엔진 v3.2.1, FSAP MAT-RS-001; mech_2026-10-31_S01-T06-T07-S02: T06·S02 모델링부는 MCP 안내 'Backend: headless'를 보고 CLI로 그렸고, T07에서는 같은 안내인데 호출이 앱으로 이어짐 — headless 판정을 안내문으로 하면 틀림(mech_T06_model.md·mech_T07_model.md·mech_S02_model.md 워크플로우 메모), FSAP MAT-RS-001 |
| WF-083 | 신규 | **과제 문서·커밋이 다음 과제 측정과 동시에 돌아, 실행을 과제 경계에서 멈추면 앞 과제 문서가 끊김** | 2 | T06 측정 시작 때 멈췄더니 T05 문서·커밋(설계검토서 v0.4.1·결정로그 "T05 결과"·요구서 상태)이 중간에 끊김. 최종 보고·회고·실행 기록도 남지 않음 | 실행을 멈출 수 있는 지점(과제 경계)에서 앞 과제 문서 job을 기다린 뒤 다음 과제로 가거나, 다음 실행 시작 때 "문서 안 된 과제"를 찾아 문서부터 돌린다(E-21 이어서 재시도와 묶기) | 실행 wf_d0aef4d2-9be journal(T05 문서·커밋 started, result 없음), 발견: 엔진 v3.2.1, FSAP MAT-RS-001; mech_2026-10-31_S01-T06-T07-S02: T06-X03(v0.5.1) 지정 수정이 남은 채 T07 측정·구상이 v0.5.0으로 돎(mech_T07_select.md 워크플로우 메모, 커밋 0eedf44에 T07 보고서 함께), FSAP MAT-RS-001 |
| WF-084 | 신규 | **외부 조건(로그인 풀림) 때문에 남은 문제에도 모델링 수정 회차를 돌림** — 모델링부가 다시 불려도 할 일이 없음 | 1 | S02 수정 1회차가 STEP 4종 미수령으로 같은 결과(open_problems 5건 '이번 회차에 끝낸다' 그대로) | 검도/PM이 open_problems의 원인이 login:false·STEP 미수령이면 수정 회차를 건너뛰고 '사람이 할 일'로 넘긴다(구동부 워크플로우 수정 루프 진입 조건, E-21) | mech_S02_model1.md 워크플로우 메모, 결과 JSON S02 open_problems, 발견: 엔진 v3.2.1, FSAP MAT-RS-001, mech_2026-10-31_S01-T06-T07-S02 |
| WF-085 | 신규 | **엔진 파이썬 도구가 Windows 콘솔(cp1252/cp949)에서 한글 출력 중 UnicodeEncodeError로 멈춤** | 1 | excerpt·stepcheck·ledger·brief·handcalc 모두, 이번 실행 보고서 13개 이상이 같은 메모(부서마다 우회 시도) | 엔진 tools/*.py 시작부에 sys.stdout.reconfigure(encoding='utf-8'), 또는 실행 환경 줄에 PYTHONIOENCODING=utf-8 | mech_T06_concept1~3·T06_fea·T07_concept1·T07_fea·T07_verify·S02_measure·S02_concept1~3·S02_model1.md 워크플로우 메모, 발견: 엔진 v3.2.1, FSAP MAT-RS-001, mech_2026-10-31_S01-T06-T07-S02 |
| WF-086 | 신규 | **지시문이 기계 정의 tools/machine.json(E-15)을 가리키지만 이 프로젝트에 없음** | 1 | T06·T07·S02 측정·구상·검도가 매번 motion_states.json으로 대신함, ledger.py scope 유닛 판정이 machine.json을 읽음 | 준비 점검부가 machine.json 유무를 확인해 없으면 만들거나, 지시문 기계 정의 경로를 config로 받는다(E-15) | mech_T06_measure·T06_concept3·T06_verify·S02_measure·S02_select·mech_regression.md 워크플로우 메모, 발견: 엔진 v3.2.1, FSAP MAT-RS-001, mech_2026-10-31_S01-T06-T07-S02 |
| WF-087 | 신규 | **motion.interference 표본 상한 1000·단계 범위 인자 없음 → 1000단계 넘는 연구를 전 단계로 못 봄** | 1 | S01 open_problems: 4개 연구 전 단계 미완(직렬 추정 약 3시간), 수정 1회차에서 20병렬 약 56분으로 메움. T07 검도는 clearance 청크 약 25분 | 안내서 '동작 검사'에 '1000단계 초과 연구는 occurrences 분할 병렬 또는 inspect.clearance 청크'를 적고, 검도 단계 기본 절차로 둔다 | mech_S01_model1·T06_model·T07_model·T07_verify·S02_model·mech_regression.md 워크플로우 메모, 발견: 엔진 v3.2.1, FSAP MAT-RS-001, mech_2026-10-31_S01-T06-T07-S02 |
| WF-088 | 신규 | **구상 지시가 'python -B -I로 gmsh bbox'를 전제하나 이 컴퓨터에 gmsh가 없음** | 2 | T06·T07·S02 구상 7개 부서가 ModuleNotFoundError, 앞 보고서 값으로 대신. T06 선정이 축 끝 탭·플랜지 구멍을 놓침 | 준비 점검에서 gmsh 유무를 확인해 지시문을 '측정부 r_out.json bbox/부피 표 사용'으로 바꾸고, 측정 요약에 bbox 표 경로를 넣는다 | mech_T06_concept1~3·T06_select·T07_concept1·T07_concept3·S02_concept1~3.md 워크플로우 메모, 발견: 엔진 v3.2.1, FSAP MAT-RS-001, mech_2026-10-31_S01-T06-T07-S02 / FSAP MAT-RS-001 mech_2026-11-10_DC-04-DC-03-STEPWAIT(엔진 v4.0.0): mech_STEPLITE_model.md:77 — gmsh 없어 stepinfo measure·compare 못 돌림 |
| WF-089 | 신규 | **구매품 STEP bbox가 실제보다 크게 나와 측정·구상이 외곽을 잘못 잡음**(엔진 WF-017 계열) | 1 | HFS8-4080-1900 bbox ±1425 대 실제 ±950, 측정·구상 셋이 BASE·배출 자리를 틀리게 잡았다가 선정에서 부피로 바로잡음 | 측정부 안내에 '구매품 STEP은 bbox 대신 부피÷단면 또는 끝면 프로브로 길이 확인'을 넣는다 | mech_T07_select·T07_concept1~3·S02_measure.md 워크플로우 메모, 발견: 엔진 v3.2.1, FSAP MAT-RS-001, mech_2026-10-31_S01-T06-T07-S02 |
| WF-090 | 신규 | **예외 판정 PM이 CAD로 그릴 수 있는지 확인하지 않고 승인** | 1 | T07-X02(캡 끼움 자리 비움) 승인 → 캡 STEP 불리언 'no result'로 그대로 못 그려 S02에서 상자 축소로 바꿈(커밋 3dbd4ed) | 예외 판정 PM 단계에서 승인 전 CLI 시험 1회(불리언 성공 여부)를 거치게 한다(E-14) | mech_S02_select.md 워크플로우 메모, 결정로그 T07-X02, 발견: 엔진 v3.2.1, FSAP MAT-RS-001, mech_2026-10-31_S01-T06-T07-S02 |
| WF-091 | 신규 | **버전 저장 뒤 ledger.py commit이 빠져 다음 과제 검사 범위가 부풀음** | 1 | S01(v0.4.2) 뒤 commit 없음 → T06 scope에 S01 부품 100여 개가 새로·없어짐으로 올라옴. signatures.json에 T05 바디도 빠짐 | 버전을 저장하는 단계(모델링 끝 또는 최종 회귀)에 ledger.py commit을 필수 단계로 넣는다(E-17) | mech_T06_verify·T06_measure·T07_measure.md 워크플로우 메모, 발견: 엔진 v3.2.1, FSAP MAT-RS-001, mech_2026-10-31_S01-T06-T07-S02 |
| WF-170 | 신규 | **과제 지시문의 '현재 상태'가 준비부가 끝난 뒤의 설계 상태로 다시 만들어지지 않음** — 준비부가 이미 저장·커밋한 버전 파일을 '아직 없음, 새로 만들라'로 적어 측정·구상 3안·선정·모델링 6개 부서가 따로 어긋남을 판단 | 2 | 6개 부서 보고서가 같은 어긋남을 적음, 저장 번호를 선정이 바꿔 지시 | 과제 정리 단계(modeling_round.js)에서 '현재 상태'를 준비부 결과 뒤 config doc·원장으로 다시 계산해 넣고, 측정 요약과 다르면 측정 요약을 우선한다고 L1 부서 지시문에 적기 | mech_N00_measure.md:162, mech_N00_concept1.md:191, concept2.md:199, concept3.md:146, mech_N00_select.md:182, mech_N00_model.md:90 (발견: 엔진 v3.7.1, FSAP MAT-RS-001, mech_2026-11-03_N00); mech_M00_design.md·mech_M00_measure.md·mech_M00_model.md·mech_M00_donecheck.md 워크플로우 메모: 준비부가 저장·커밋한 v2.0.0을 지시문이 아직 없음·new_design으로 적음, 완료 판정 문구도 같은 어긋남 (발견: 엔진 v3.8.1, FSAP MAT-RS-001, mech_2026-11-03_M00) |
| WF-171 | 신규 | **joint.sweep 접촉 없음 판정이 같은 사슬의 움직이는 컴포넌트끼리 겹침을 못 봄** — 회귀가 놓친 겹침을 뒤의 구동 점검이 clearance로 잡음 | 1 | 행정 끝에서 겹침 2곳(구동 점검이 찾음) | E-17 회귀 절차: 스윕 뒤 행정 양 끝 자세에서 움직이는 바디끼리 inspect.clearance를 한 번 더, 스윕은 기준선 바디를 빼고 부르기(첫 접촉에서 멈춤) | mech_drive_check.md:77, mech_regression.md:64 (발견: 엔진 v3.7.1, FSAP MAT-RS-001, mech_2026-11-03_N00) |
| WF-172 | 신규 | **batch 안에서 만든 edit.checkpoint가 다음 호출에서 사라짐** — 읽기 부서의 원복 절차(실행 규칙 '원복 주의')가 동작하지 않음 | 5 | 측정·검도 2개 부서에서 no checkpoint; FSAP MAT-RS-001 mech_2026-11-08: checkpoint 16개 한도로 첫 checkpoint 복원 실패(mech_MOT-01_verify.md:78) | engine/cad/solidcraft.md '연결': 읽기 부서는 대기 포즈 step 0 + dirty 확인으로 원복, checkpoint는 같은 호출 안에서만 유효하다고 적기 | mech_N00_measure.md:163, mech_N00_verify.md:71 (발견: 엔진 v3.7.1, FSAP MAT-RS-001, mech_2026-11-03_N00); mech_M00_verify.md 워크플로우 메모: batch 안 joint.sweep 실패 뒤 rollback이 edit.checkpoint까지 되돌려 restore 시 no checkpoint (발견: 엔진 v3.8.1, FSAP MAT-RS-001, mech_2026-11-03_M00); FSAP MAT-RS-001 mech_REG-02_model1.md:76, mech_REG-02_verify1.md:62 체크포인트 최근 16개만 남고 느린 joint.drive가 여러 개 써서 처음 체크포인트가 사라짐(모델링·검도 2부서) — 엔진 v3.9.3, mech_2026-11-08_STEPWAIT-REG-02-REG-01 / FSAP MAT-RS-001 mech_2026-11-10_VGR-01-PNEU-01-DC-01-STEPWAIT(엔진 v3.9.3): PNEU-01 측정부: 묶음 안 체크포인트가 묶음이 끊기면 남지 않아 restore 실패(mech_PNEU-01_measure.md 워크플로우 메모) |
| WF-173 | 신규 | **머리말의 공통 블록(STEP 대기 임시 형상 등)이 그 과제에 해당 없을 때도 붙어 과제 지시와 부딪힘** | 1 | 모델링부가 선정 지시와 머리말 중 판단 | 지시문 조립(workflows/*.js)에서 그 과제 needs_step이 있을 때만 블록을 붙이기 | mech_N00_model.md:91 (발견: 엔진 v3.7.1, FSAP MAT-RS-001, mech_2026-11-03_N00) |
| WF-174 | 신규 | **선정 단계가 규칙 예외(움직이는 것을 바디·조인트 없이 계산 판정)를 원문 인용·예외 요청 없이 스스로 정함 — CAD 검사가 못 보고 검도 프로브로만 겹침이 나와 예외 판정이 한 과제에 몰림** | 1 | N04 사슬 길 겹침 29,670·2,040 mm³가 CAD 검사 2,279단계·25자세에 안 나옴, 같은 과제에서 E-15 예외 판정 6건(기각 3·승인 2·고침 1), 수정 회차 추가 | 선정 지시문(modeling_round 선정 단계)에 '움직이는 부품을 그리지 않거나 조인트 없이 두려면 E-14 예외 요청을 내고 규칙 원문을 인용한다'를 넣고, 선정 산출 점검에서 조인트·바디 없는 움직임 항목을 찾아 예외 판정 PM으로 먼저 보낸다(E-14·E-15) | mech_N04_select.md 125·205행, 결정로그 '구동 N04 예외 판정 (2026-11-03)' N04-E01~E07, 최종 보고서 '규칙 예외 판정 (N04)', 발견: 엔진 v3.7.2, FSAP MAT-RS-001, mech_2026-11-03_N01-DC-05-DC-04-N02-DC-02-DC-06-N03-DC-03-N04-DC-01 |
| WF-175 | 신규 | **새 조인트·동작 연구를 만드는 과제가 M으로 매겨져 실행 중 L로 재판정됨** | 2 | 이번 실행 과제 2개(DC-04·N04) 모두 M→L 재판정, 검사 범위를 실행 중에 넓힘; FSAP MAT-RS-001 mech_2026-11-08: FUNC-01 M→L 재판정(새 조인트·유닛 4개, 최종 보고 결과 JSON) | 과제 정리·구상 단계에서 구상안이 새 조인트·연구를 내면 E-18 표대로 등급을 자동으로 L로 올리고 지시문 검사 범위도 그때 정한다(E-18·E-17) | 결과 JSON regrade DC-04·N04, 발견: 엔진 v3.7.2, FSAP MAT-RS-001, mech_2026-11-03_N01-DC-05-DC-04-N02-DC-02-DC-06-N03-DC-03-N04-DC-01 |
| WF-176 | 신규 | **motion.play·넓은 inspect.clearance 결과가 단계마다 전체 자세·근접 목록을 돌려줘 MCP 응답 한도를 넘음** — 부서마다 결과를 파일로 받아 요약 스크립트를 따로 씀 | 2 | 응답 62 KB(측정), 5점 묶음 10만 자 넘음(검도), clearance batch 37만 자 넘어 잘림(모델링) — 3개 부서; FSAP MAT-RS-001 mech_2026-11-08: motion.play 1.2 MB·inspect.measure 약 1 MB(mech_MOT-01_verify.md:79, mech_MOT-01_design.md:137) | engine/cad/solidcraft.md '연결': 자세·근접 목록이 긴 명령은 요약 인자(또는 결과 파일+엔진 요약 도구)로 부르라고 적고, 엔진 도구에 공통 요약기(자세·clearance 결과 → 15줄)를 둔다(E-20) | mech_M00_measure.md·mech_M00_model.md·mech_M00_verify.md 워크플로우 메모 (발견: 엔진 v3.8.1, FSAP MAT-RS-001, mech_2026-11-03_M00) |
| WF-177 | 신규 | **기계 정의의 기준선 겹침(의도된 접촉) 값을 준비부가 실측 없이 적어 검도 실측과 맞지 않음** | 1 | 기준선 '깊이 1 mm·부피 0' 대 실측 87~234 mm³·깊이 2 mm, 기준선에 없던 쌍 포함 12쌍을 검도가 paircache 판정으로 따로 남김, 디테일 1건 | 준비 단계(기계 정의 만들 때)에 기준선 쌍을 대기·사이클 대표 자세에서 inspect.interference로 재 부피·깊이·쌍 목록을 실측값으로 적게 하고, 검도는 기준선 대비 초과만 판정(E-15·E-17) | 결과 JSON detail_items(machine.json baseline_overlaps), final_mech_2026-11-03_M00.md (발견: 엔진 v3.8.1, FSAP MAT-RS-001, mech_2026-11-03_M00) |
| WF-178 | 신규 | **전체 회귀 실행기가 묶음마다 설계 파일을 새로 열어, 파일 열기 시간이 회귀 시간 상한을 먹는다** | 5 | FSAP MAT-RS-001 final_mech_2026-11-04_M04R-M08-M07-K1-DC2-03-STEPWAIT.md:13-36·:128 — 단계당 연구 5.1 s·자세 17.5 s에 비해 파일 열기 230 s(저장 캐시 거부), 시험 4번 1,560 s 중 timeout 5묶음, 못 본 범위 STATES 24-34·연속 연구 대부분. 발견: 엔진 v3.9.2, FSAP MAT-RS-001, mech_2026-11-04_M04R-M08-M07-K1-DC2-03-STEPWAIT; FSAP MAT-RS-001 mech_2026-11-08_STEPWAIT final 5절: 전체 회귀 열기 12회·open_s 370, 본 범위 361점뿐(상한 30분, 어림 4시간)으로 못 본 범위 남음 | 상한 30분 중 묶음당 230 s가 열기로 감, 호출 7개 끊김 | regrun.py: 시험 단계에서 파일 열기 시간을 따로 재어 어림·묶음 크기에 넣고, 열기가 단계 몫보다 크면 묶음 수를 줄이거나 한 세션에서 연속 실행(캐시 거부 원인을 결과에 적기). E-17 '전체 회귀 실행 절차'에 열기 시간 포함 명시; FSAP MAT-RS-001 final_mech_2026-11-04_STEPWAIT-REG-01_2.md:33-48 — REG-01 모델링부 설계 파일 10번 열기·2,800 s, 전체 회귀 세션 8개·상한 1,801 s에 2,481단계 중 283단계만 봄(mech_2026-11-04_STEPWAIT-REG-01); FSAP MAT-RS-001 final_mech_2026-11-06_REG-01.md:13 전체 회귀 파일 열기 18회 — 발견 엔진 v3.9.3, FSAP MAT-RS-001, mech_2026-11-06_REG-01 |
| WF-181 | 신규 | **저장·전체 회귀 권한이 없는 부서에 회귀 과제(못 본 범위 0)가 주어져, 완료 판정을 채우려고 이름만 바꾼 후보를 등록했다가 다음 회차에 되돌림** | 1 | 수정 회차 1회가 등록·삭제 왕복에 쓰였고 과제는 수정 상한으로 미달 | 과제 정리 단계: 회귀 과제는 회귀 실행 부서(저장본에 대고 regrun)로 보내고, 저장 권한 없는 부서에는 주지 않는다. 완료 판정 '또는 구동 후보로 등록' 문구에 '같은 범위를 이름만 바꾼 후보는 등록으로 치지 않는다'(실행 규칙 13 취지)를 L1 E-03 판정 칸에 명시 | FSAP MAT-RS-001 final_mech_2026-11-04_STEPWAIT-DC2-07-REG-01 결과 JSON REG-01 revisions 1·2(REG-01-X2 등록 → 삭제). 발견: 엔진 v3.9.2, FSAP MAT-RS-001, mech_2026-11-04_STEPWAIT-DC2-07-REG-01 | 반복 근거: FSAP MAT-RS-001 mech_2026-11-04_STEPWAIT-DC2-07-REG-01 REG-01 2회차 — 열기 254~420 s로 호출이 480 s를 넘어 묶음을 (480 − 열기 − 여유) ÷ 2.5069 s/단계로 손으로 다시 셈, 남은 1,655단계 실행 1~2.5시간 어림 |
| WF-182 | 신규 | **최종 보고 지시의 커밋 대상·시점이 프로젝트 요구서의 커밋 규칙과 어긋남** — 지시문은 문서 커밋을 고정 문구로 시키나, 요구서는 설계 버전이 바뀔 때만 커밋하고 문서만의 변경은 다음 버전 커밋에 넣는다 | 1 | 최종 보고 담당이 판정 갈림을 직접 풀어야 함, 보고서가 작업본에 미커밋으로 남음(최종 보고서 1건·측정 보고 2건) | 워크플로우 최종 보고·회고 단계 지시문의 커밋 문구를 고정하지 말고 "커밋·푸시는 요구서 8-5(버전 변경 시만)를 따르고, 새 버전이 없으면 다음 버전 커밋으로 미룬다"로 바꾼다(L1 E-06·Git 칸) | FSAP MAT-RS-001 `docs/reports/mechanism/final_mech_2026-11-04_STEPWAIT-M08R-DC2-08.md` '## 워크플로우 메모'·'## 커밋', 발견: 엔진 v3.9.3, FSAP MAT-RS-001, mech_2026-11-04_STEPWAIT-M08R-DC2-08 |
| WF-183 | 신규 | **전체 회귀 실행기가 한 세션을 연구·자세 묶음에 이어 쓰면서, 앞 묶음이 움직인 조인트(연구 키가 아닌 손 조정 조인트)가 다음 묶음에 남아 거짓 겹침·넘어옴이 생김** — 묶음 앞에 연구 키가 아닌 조인트를 대기값으로 되돌리는 절차가 없고, 묶음 결과에 세션 표시가 없어 오염 원인을 호출 시간 대조로만 찾음 | 1 | 같은 꼴의 넘어옴이 두 회귀(4·5)에 걸쳐 나와 원인 추적과 재실행에 회차를 씀, 상한 30분 안에 282단계만 봄 | regrun.py: 묶음마다 '연구 키가 아닌 모든 조인트를 대기값으로' 모는 단계를 기본으로 넣거나 명세에 '묶음 앞 대기값으로 몰 조인트' 칸을 두고, 자세 묶음은 연구와 다른 세션으로 돌림. 묶음 summary에 세션 포트를 적음(E-17 '전체 회귀 실행 절차') | FSAP MAT-RS-001 docs/reports/mechanism/mech_regression_5.md:66-68(mech_regression_4와 같은 꼴, 묶음 도구가 두 조인트만 수동으로 대기값 처리). 발견: 엔진 v3.9.3, FSAP MAT-RS-001, mech_2026-11-04_STEPWAIT-REG-01 |
| WF-184 | 신규 | **구매품 실물 교체로 컴포넌트가 생기거나 없어졌는데 버전 번호를 마지막 자리로 올림** — 교체 과제의 번호 결정에 컴포넌트 수 변화 확인이 없다 | 3 | 버전 규칙 위반 1건(최종 보고서가 사후에 잡음), 형상 변경 크기를 버전으로 못 읽음 | modeling_round 모델링부(교체 과제) 저장 전: 저장본과 이전본의 컴포넌트 이름 목록 차이를 세어 0이 아니면 가운데 자리로 올리도록 E-05 판정을 지시문·점검 스크립트에 넣는다 | FSAP MAT-RS-001 final_mech_2026-11-04_STEPWAIT-REG-01_2.md:35-37, 커밋 334d03e(v2.6.4) — 발견 엔진 v3.9.3, mech_2026-11-04_STEPWAIT-REG-01; FSAP MAT-RS-001 final_mech_2026-11-08_STEPWAIT-REG-02-REG-01.md:144 컴포넌트 더하고 뺐는데 마지막 자리 올림(v2.6.6·v2.6.7) — 엔진 v3.9.3, mech_2026-11-08_STEPWAIT-REG-02-REG-01 / FSAP MAT-RS-001 mech_2026-11-10_VGR-01-PNEU-01-DC-01-STEPWAIT(엔진 v3.9.3): VGR-01(컴포넌트 추가)·PNEU-01(관·피팅·고정품 컴포넌트 37개 추가) 모두 마지막 자리로 올림 — final_mech_2026-11-10_…STEPWAIT.md '규칙을 어긴 통로 사용' |
| WF-179 | 반영(엔진 v3.9.3) | **앱(MCP)에 끝나지 않는 요청이 걸리면 모든 부서가 CLI로 우회해 큰 파일을 반복해서 연다** — 막힌 요청을 감지·정리하는 절차가 없다. 우회는 MCP 우선 원칙을 깨고, 열기 시간 때문에 과제 하나가 몇 시간으로 늘어난다 | 1 | STEPSWAP 모델링부 2시간 24분·수정1 1시간 30분. 앱에 다른 연결의 engine.batch가 4.7~7.1시간 실행 중, CLI로 v2.5.7(피처 1,978, 열기 약 9분)을 6번 열었다. 그 뒤 앱 다운 | ① MCP 사용 전 `running` 확인 ② 다른 요청이 상한(예: 30분)을 넘으면 앱을 다시 켜고 최신 저장본을 열어 MCP로 이어 감 ③ MCP batch 크기 상한(약 5분) ④ 보고서에 막힘·재시작 기록 | mech_STEPSWAP_model1.md, 실행 wf_e0381f55-c8d, 사용자 2026-11-05 "이거 또 발생하면 문제가 좀 심각한거 같은데", 발견: 엔진 v3.9.2, FSAP MAT-RS-001 |
| WF-180 | 반영(엔진 v3.9.3) | **같은 구매품 사본이 많은 모델에서 전체 정적 간섭 검사가 예산을 넘기고, 모델 열기도 느려진다** — 사본마다 따로 재고(볼 827·볼트 수백), 모델 무게를 재거나 줄이는 단계가 없다 | 1 | STEPSWAP 전체 inspect.interference 1,800 s 예산 초과 2회 → 수정1에서 사본 125개 × 이웃 514쌍을 따로 잼. v2.5.7 열기 약 9분 | ① 과제 안 검사는 scope + neighbors만, clearance 먼저 ② 같은 부품 사본은 대표 1개 + 이웃과 bbox가 닿는 사본만 ③ 보고서 timing에 열기 시간 ④ 열기 시간이 상한을 넘으면 같은 부품을 바디 하나 + 패턴으로 묶는 과제를 만든다 | mech_STEPSWAP_model.md·model1.md, FSAP 실행 규칙 21·과제 LITE-01, 발견: 엔진 v3.9.2, FSAP MAT-RS-001 |
| WF-131 | 반영(엔진 v3.4.0 WF-132) | **측정부가 앱이 켜져 있어도 CLI로 저장본을 여러 번 다시 열어 잰다** — 호출마다 큰 설계 파일을 처음부터 불러와서 측정 한 번이 수십 분 걸린다. MCP 우선 규칙(WF-121)은 모델링부에만 걸려 있고, L1 '부서 지시문'은 그 밖의 부서를 CLI로 정해 두었다(프로젝트 규칙 파일도 그대로 따랐다) | 1 | 엔진 v3.3.0 full_run 첫 과제 측정부 26분, CLI 호출 16회(12 MB 파일, 호출마다 다시 읽기). 그동안 모델링 0 | 읽기만 하는 부서(측정·검도)도 앱이 켜져 있으면 MCP 한 세션에서 연속으로 재거나, CLI라면 잴 것을 한 스크립트로 묶어 한 번만 불러온다. 측정 보고서에 호출 횟수·걸린 시간을 적게 한다 | mech_T18_measure.md, 실행 wf_520fe448-efa 측정부 기록, 사용자 2026-11-01 "구동부 모델링을 왜안하고 있는거냐고", 발견: 엔진 v3.3.0, FSAP MAT-RS-001 |
| WF-132 | 반영(엔진 v3.4.0 WF-134) | **선정 PM이 구상 뒤에 구매품 카탈로그를 새로 조사한다** — 구상 3안이 형번·규격을 확정하지 않고 넘겨서 선정 단계가 사이트를 수십 번 연다. 구상(병렬)에서 할 일이 직렬 단계로 밀린다 | 1 | 선정 PM 브라우저 호출 약 40회(이동 16·스크립트 15), 12분 이상. 측정+구상+선정까지 과제 하나에 약 1시간, 그린 형상 0 | 구상부 결과 스키마에 구매품 형번·카탈로그 허용치(출처 URL)를 필수로 넣고, 선정은 비교·판정만 한다. 빠진 값은 선정이 조사하지 말고 임시값(E-12)으로 판정 | 실행 wf_520fe448-efa 'T18 PM·감사 선정' 기록, 발견: 엔진 v3.3.0, FSAP MAT-RS-001 |
| WF-153 | 반영(엔진 v3.7.0 WF-153·WF-154) | **라운드 끝 전체 회귀가 범위·시간 상한 없이 3시간 넘게 돈다** — 지시문의 '행정 5 mm 간격'이 행정 길이와 상관없이 모든 연구·모든 조인트 전 행정에 걸려 단계 수가 수만이 되고, '호출마다 8분 안'은 지켜지지 않으며(호출 하나 95분), CAD 커널 패닉으로 묶음이 다 실패해도 끝날 때까지 기다린다. 시험 실행·전체 상한·오류 즉시 확인이 없다 | 1 | v0.10.1 전체 회귀: 5 mm 보충 약 47,000단계 5묶음, 95분 뒤 전 묶음 `panicked`(tolerance 1e-6) 실패 → 줄인 판 다시 31~55분, 3시간 지나 사용자가 멈춤 | ① 간격을 행정 길이·좁은 곳에 따라 나눔(요구서 6-4가 정함) ② 묶음 띄우기 전 앞 20단계 시험·시간 어림 ③ 호출 8분 넘으면 끊고 반으로 ④ err의 패닉을 바로 보고 그 단계만 뺌 ⑤ 전체 상한(예: 30분) 넘으면 본 범위·못 본 범위를 보고하고 라운드를 넘김 |
| WF-185 | 신규 | **검증 과제의 기구설계부 완료 판정에 회귀 결과 항목(겹침 0·끊김 0·막힘 0)이 들어가, 회귀를 돌리지 않는 부서가 수정 회차로 채울 수 없다** | 2 | 수정 회차 2회 모두 상한까지 쓰고 '설계 미달(수정 상한)' | modeling_round 과제 정리·기구설계부 판정: 검증 과제는 설계부 합격을 '판정 도구·범위가 정해지고 측정 범위와 같은가'로, 결과 항목은 회귀 담당 판정으로 나눈다(E-03·E-17) | FSAP MAT-RS-001 mech_REG-01_design1.md:34-35, mech_REG-01_design2.md:36-37(같은 메모 2회) — 발견 엔진 v3.9.3, mech_2026-11-04_STEPWAIT-REG-01; FSAP MAT-RS-001 mech_REG-02_fea.md:59, mech_REG-02_fea1.md:63 해석부 completion_met에 해석 밖 항목(틈·공구 막힘)이 섞여 남의 측정을 옮겨 적음 — 엔진 v3.9.3, mech_2026-11-08_STEPWAIT-REG-02-REG-01 |
| WF-186 | 신규 | **이전 실행이 남긴 저장 안 된 문서가 CAD 앱에 열려 있어 읽기 부서가 MCP로 열지 못하고 CLI로 우회** | 3 | 읽기 한 번 CLI 240 s | 워크플로우 시작 단계: 앱 열린 문서 dirty 확인 후 처리 지시(버릴지)를 한 번 정해 모든 부서에 전달; 끝 부서는 실행 종료 때 열린 문서를 저장본으로 되돌린다(engine/cad/solidcraft.md '연결') | FSAP MAT-RS-001 mech_REG-01_design.md:88-90 — 발견 엔진 v3.9.3, mech_2026-11-04_STEPWAIT-REG-01; FSAP MAT-RS-001 mech_REG-01_model.md·mech_regfix_2.md 워크플로우 메모 — dirty 문서(path null)가 LITE부터 세 부서째 남아 MCP 모델링 통로를 막음, 발견 엔진 v3.9.3, mech_2026-11-06_LITE-STEPWAIT-REG-01 / FSAP MAT-RS-001 mech_2026-11-10_DC-04-DC-03-STEPWAIT(엔진 v4.0.0): mech_DC-03_measure.md:164·mech_DC-03_design.md:131 — dirty 문서 남아 측정·구상 CLI 우회 |
| WF-197 | 신규 | **전체 회귀 실행기의 시험 단계가 세션 첫 점(열기·데우기 포함)으로 단계 시간을 어림해 4~5배 크게 잡고, 상한 안에서 볼 수 있는 범위를 미리 잘라 버림** | 2 | 자세 시험 280~369 s/점 대 정상 44~75 s/점, 자세 묶음 상한 30분 중 1,096~1,267 s만 쓰고 끝남 | engine/tools/regrun.py 시험: 첫 점을 빼고 2점째 이후로 per_step을 재거나, 실행 중 실측으로 어림을 고쳐 남은 시간을 채운다(E-17 전체 회귀 실행 절차) | FSAP MAT-RS-001 mech_REG-01_model.md·mech_regression_8.md 워크플로우 메모, final_mech_2026-11-06_LITE-STEPWAIT-REG-01.md:10 — 발견 엔진 v3.9.3, FSAP MAT-RS-001, mech_2026-11-06_LITE-STEPWAIT-REG-01; FSAP MAT-RS-001 final_mech_2026-11-06_REG-01.md:14·21 어림 5,136 s 대 실제 1,801 s, 시험 1점 65~235 s — 발견 엔진 v3.9.3, FSAP MAT-RS-001, mech_2026-11-06_REG-01 |
| WF-198 | 신규 | **수정안이 사용자·선정 결정에 달린 문제를 회귀 수정부로 보내, 고칠 수 없는 부서가 설계 파일만 열고 끝남** | 1 | 회귀 수정부 CLI 열기 2회 약 19분, 결과 빈 저장(empty_save) | modeling_round 회귀 문제 배분 단계: 문제의 fix가 결정 필요이면 수정부로 보내지 말고 사용자 결정 목록·선정부로 먼저 보낸다(E-01·E-14) | FSAP MAT-RS-001 mech_regfix_2.md 워크플로우 메모, 결과 JSON REG-01 empty_save:true — 발견 엔진 v3.9.3, FSAP MAT-RS-001, mech_2026-11-06_LITE-STEPWAIT-REG-01 |
| WF-199 | 신규 | **병렬 CAD worker를 띄우는 실행 스크립트가 셸 전체 wait·끝 quit에 걸려 멈춤** — 데우기 뒤 wait가 worker 끝까지 기다리고, 끝 quit가 끝나지 않아 프로세스를 손으로 골라 멈춤 | 1 | 회귀 시작 약 10분 지연, quit 5분 넘게 멈춤 → worker 24개 PID로 수동 정리 | engine/tools/regrun.py(또는 worker 실행 틀): PID 목록으로만 wait, quit에 시간 상한·강제 종료, 자기 PID만 정리(engine/cad/solidcraft.md 연결) | FSAP MAT-RS-001 mech_regression_8.md·mech_REG-01_model.md 워크플로우 메모 — 발견 엔진 v3.9.3, FSAP MAT-RS-001, mech_2026-11-06_LITE-STEPWAIT-REG-01 |
| WF-200 | 신규 | **점검부가 넘긴 문서 문제(BOM 중복 합산)를 문서부가 받는 길이 없어 두 실행째 그대로 남음** | 1 | BOM 중복 5형번, 점검부 지적 2회 | 점검부 결과의 문서 결함을 다음 문서 단계 입력(JSON 항목)으로 자동 연결하고, 처리 안 되면 최종 보고 남은 문제에 올린다 | FSAP MAT-RS-001 mech_drive_check.md 워크플로우 메모 — 발견 엔진 v3.9.3, FSAP MAT-RS-001, mech_2026-11-06_LITE-STEPWAIT-REG-01 |
| WF-201 | 신규 | **전체 회귀 실행기가 묶음 크기를 바디 수와 상관없이 잡아, 한 점이 호출 상한(8분)을 넘는 묶음은 끊기기만 하고 못 본 범위로 남는다** | 5 | 끊은 호출 9, 전체 475단계 중 308조각 못 봄 / FSAP MAT-RS-001 mech_2026-11-06_REG-01(3회째): U7@26 조각 4개 각 472 s panic, 못 본 범위 4 | engine/tools/regrun.py: 시험에서 묶음별 점 시간을 재 8분을 넘으면 occurrences를 바디 수 기준으로 더 잘게 나눠 다시 묶는다(E-17 전체 회귀 실행 절차, E-04) | FSAP MAT-RS-001 final_mech_2026-11-06_REG-01.md:22·92·98 — 발견 엔진 v3.9.3, FSAP MAT-RS-001, mech_2026-11-06_REG-01; FSAP MAT-RS-001 final_mech_2026-11-06_REG-01_2.md:21-22 한 점 >470 s 묶음 7개 다시 끊김(같은 범위 2실행째) — 엔진 v3.9.3, mech_2026-11-06_REG-01 재시작; FSAP MAT-RS-001 final_mech_2026-11-08_STEPWAIT-REG-02-REG-01.md:146 회귀 호출 3건 8분 끊김, 시험 어림이 실제보다 작음 — 엔진 v3.9.3, mech_2026-11-08_STEPWAIT-REG-02-REG-01 / FSAP MAT-RS-001 mech_2026-11-10_VGR-01-PNEU-01-DC-01-STEPWAIT(엔진 v3.9.3): 전체 회귀 MAINT_U7.H 3(8조각) 470 s timeout, run2 시험 POSE 0·CYCLE_V 20도 470 s timeout, 끊은 호출 10 — 같은 보고서 '전체 회귀 범위와 시간' |
| WF-202 | 신규 | **전체 회귀 실행기가 끊긴 호출의 세션을 다음 묶음에 다시 주고, 소켓 시간 초과를 커널 패닉으로 센다** | 2 | 끊긴 세션을 받은 묶음도 밀림(cut 6) | engine/tools/regrun.py: 끊은 세션은 죽음으로 표시하고 새로 띄우며, 시간 초과와 패닉을 따로 센다(E-17) | FSAP MAT-RS-001 mech_REG-01_model.md:66-67 워크플로우 메모 — 발견 엔진 v3.9.3, FSAP MAT-RS-001, mech_2026-11-06_REG-01; FSAP MAT-RS-001 final_mech_2026-11-06_REG-01_2.md:21-22 호출 상한 끊김을 panic으로 표기 — 엔진 v3.9.3, mech_2026-11-06_REG-01 재시작 |
| WF-203 | 신규 | **최종 보고 부서에 브라우저 도구가 없어 프로젝트 규칙이 시킨 사이트 로그인 확인을 못 한다** | 4 | 로그인 확인 못 함 1회(browser_calls 0) / FSAP MAT-RS-001 mech_2026-11-06_REG-01(3회째): 최종 보고 로그인 확인 못 함 | workflows 최종 보고 단계: 프로젝트 규칙에 사이트 확인이 있으면 브라우저 도구를 주거나 구매부 결과의 login 값을 넘긴다(E-13) | FSAP MAT-RS-001 final_mech_2026-11-06_REG-01.md:12·99 — 발견 엔진 v3.9.3, FSAP MAT-RS-001, mech_2026-11-06_REG-01; FSAP MAT-RS-001 final_mech_2026-11-06_REG-01_2.md:4 로그인 확인 못 함 2회째 — 엔진 v3.9.3, mech_2026-11-06_REG-01 재시작 ; FSAP MAT-RS-001 final_mech_2026-11-08_STEPWAIT_4.md:3 — 브라우저 확장 응답 시간 초과로 로그인 확인 못 함, 엔진 v3.9.3, mech_2026-11-08_STEPWAIT |
| WF-204 | 신규 | **형상 변경이 없는 회귀 이어 보기 과제를 모델링부로 보내, 빈 저장으로 새 버전 번호를 만들고 큰 설계 파일 열기를 반복한다** | 4 | 모델링부 2500 s·파일 열기 20(가장 긴 594 s), 형상 변경 0인 새 버전 1개 / FSAP MAT-RS-001 mech_2026-11-06_REG-01(3회째): 빈 저장 v2.6.5, 모델링부 file_opens 16 | workflows 과제 배정: 수정안이 "못 본 범위 이어 보기"뿐이면 모델링부를 건너뛰고 전체 회귀 실행기(regrun)에 남은 범위만 넘긴다; 형상 변경이 없으면 새 번호 저장·커밋을 하지 않는다(E-05, E-17, E-04) | FSAP MAT-RS-001 final_mech_2026-11-06_REG-01_2.md:39·54·62 (empty_save true, v2.6.5) — 발견 엔진 v3.9.3, FSAP MAT-RS-001, mech_2026-11-06_REG-01; FSAP MAT-RS-001 final_mech_2026-11-08_RGSEE.md:4·15 — 이미 해결 확인뿐인 과제에 측정부가 설계 파일 8번 엶, 발견 엔진 v3.9.3, mech_2026-11-08_RGSEE / FSAP MAT-RS-001 mech_2026-11-10_DC-04-DC-03-STEPWAIT(엔진 v4.0.0): mech_DC-03_model.md:60 — 형상 변경 0 과제에 다른 이름 저장 단계 고정, STEPLITE empty_save true |
| WF-205 | 신규 | **CAD MCP 응답 제한(약 300 s)을 넘는 batch는 결과가 사라지고 pending으로도 못 받아, 느린 조인트 구동이 섞인 검사가 통째로 다시 돌아간다** | 2 | 느린 구동 1회 60~85 s, 측정부 파일 열기 3회(앱 막혀 재시작) | engine/cad/solidcraft.md '연결'·L1 E-04: MCP batch는 어림 시간(구동 수×구동 시간)이 응답 제한의 절반을 넘으면 나누거나 CLI로 보내게 적고, 지시문에 구동 시간 실측을 넘긴다 | FSAP MAT-RS-001 mech_REG-02_verify.md:77, final_mech_2026-11-08_STEPWAIT-REG-02-REG-01.md:139·145 — 발견 엔진 v3.9.3, FSAP MAT-RS-001, mech_2026-11-08_STEPWAIT-REG-02-REG-01 / FSAP MAT-RS-001 mech_2026-11-10_VGR-01-PNEU-01-DC-01-STEPWAIT(엔진 v3.9.3): PNEU-01 모델링 수정1: MCP 호출 약 5분에 응답 끊김, 탭 cut 묶음 약 10분은 따로 보내야 했음(mech_PNEU-01_model1.md 워크플로우 메모), 측정부 joint.drive 수 분·undo 236 s(mech_PNEU-01_measure.md) |
| WF-206 | 신규 | **과제 결정(완료 판정)에 근거 규칙·사용자 말에 없는 수치 기준이 들어가, 구조로 이미 막힌 위험 몫인데도 두 부서가 같은 예외 요청을 올렸다** | 1 | 같은 규칙 예외 요청 2건(설계 변경 없이 기준만 바꿔 승인·같은 요청 기각) | modeling_round 과제 정리·결정 기록 단계: 완료 판정 수치마다 출처(규칙 번호·요구서 칸·사용자 원문)를 적게 하고 출처 없는 수치는 '임시 기준'으로 표시; 같은 과제의 같은 규칙 예외 요청은 한 번에 모아 판정(E-14·E-19) | FSAP MAT-RS-001 결과 JSON REG-02 exception_requests 2건·decisions(REG02-E01 승인, 안 ② 기각) — 발견 엔진 v3.9.3, FSAP MAT-RS-001, mech_2026-11-08_STEPWAIT-REG-02-REG-01 |
| WF-207 | 신규 | **루트 타임라인에서 다른 컴포넌트 바디에 원기둥 cut을 하면 구멍이 세계 좌표에 남아 조인트로 움직일 때 따라가지 않았는데, 0 자세 검사로는 안 보였다** | 1 | 0이 아닌 자세에서 겹침 50.3 mm³ 1건, 수정 회차 1 | engine/cad/solidcraft.md 모델링 주의: 움직이는 부품의 구멍은 그 컴포넌트 안에서 만들고(피처 옮기기), 구멍↔끼움 부품은 조인트 양 끝 자세에서 다시 잰다; 부품을 지울 때 이어진 피처(dependents)를 함께 본다 | FSAP MAT-RS-001 mech_REG-02_model.md:94-95 — 발견 엔진 v3.9.3, FSAP MAT-RS-001, mech_2026-11-08_STEPWAIT-REG-02-REG-01 |
| WF-208 | 신규 | **라운드 끝 전체 회귀가 시험 단계 전 세션 열기에서 끊겨 본 범위 0으로 끝나도, 다시 시도 없이 최종 보고로 넘어간다** | 1 | 전체 회귀 실제 0 s, 2,853단계 전부 못 본 범위, 완료 판정 불가 | workflows 전체 회귀 단계·regrun: 세션 열기 실패는 앱/CLI 재시작 뒤 한 번 다시 시도하고, 그래도 실패하면 원인(열기 시간·오류)을 결과에 남긴다(E-17, E-03) | FSAP MAT-RS-001 final_mech_2026-11-08_RGSEE.md:7·14 — 발견 엔진 v3.9.3, FSAP MAT-RS-001, mech_2026-11-08_RGSEE |
| WF-210 | 신규 | **전체 회귀에서 무거운 자세 하나가 CAD 세션을 죽이면 그 뒤 자세가 전부 못 본 범위로 남고, 다음 실행도 같은 순서로 돌아 같은 곳에서 멈춘다** | 4 | 회귀 2회 연속 본 범위 13점에서 멈춤; 3회째 184점이나 세션 첫 자세 호출 315~473 s로 18조각 상한 끊김(호출 8분 넘김) | regrun·전체 회귀 단계: 세션을 죽인 자세를 원장에 표시해 다음 실행은 맨 뒤 별도 세션(또는 나눈 바디 묶음)으로 돌리고, 나머지 자세는 새 세션에서 이어 본다(E-17) | FSAP MAT-RS-001 final_mech_2026-11-08_STEPWAIT_2.md:100-101, mech_regression_15·16 — 발견 엔진 v3.9.3, FSAP MAT-RS-001, mech_2026-11-08_STEPWAIT; 3회째: final_mech_2026-11-08_STEPWAIT_3.md:8,36, mech_regression_17.md — '무거운 점'은 세션마다 첫 자세 호출이 느린 것(다음 조각 10~60 s), 제안 보탬: 세션마다 가벼운 자세로 데운 뒤 무거운 점을 넣고 첫 호출 시간을 시험 단계 어림에 따로 넣는다 ; 4회째: final_mech_2026-11-08_STEPWAIT_4.md:5,40-44 — 같은 무거운 자세(POSE.H 130·132·137 등)가 다시 470 s 넘김·패닉 4, 엔진 v3.9.3, mech_2026-11-08_STEPWAIT / FSAP MAT-RS-001 mech_2026-11-10_VGR-01-PNEU-01-DC-01-STEPWAIT(엔진 v3.9.3): 전체 회귀 MAINT_U7 3·6·9·12에서 세션 5개 사망, 나머지 자세 못 본 범위 — 같은 보고서 |
| WF-209 | 신규 | **간격 검사에서 불리언 실패(unchecked)로 남은 쌍을 다음 단계가 겹침 없음처럼 넘겨, 공구 접근 막힘이 검도에서야 드러남** | 3 | FSAP MAT-RS-001 mech_2026-11-08 (엔진 v3.9.3): mech_MOT-01_measure.md:104 unchecked 9~10쌍, 최종 보고 MOT-01 디테일(탐침 boolean 실패 unchecked, bbox 겹침) | 같은 과제 디테일 1건 늦게 발견 | 측정·검도 지시문(E-16)에 unchecked 쌍은 bbox 겹침이면 "미판정"으로 따로 세고, 다른 방법(탐침 바꿈·단면 거리)으로 다시 재기 전엔 합격 처리 금지 / FSAP MAT-RS-001 mech_2026-11-10_VGR-01-PNEU-01-DC-01-STEPWAIT(엔진 v3.9.3): PNEU-01 옮긴 볼트 4 ↔ 보 inspect.clearance unchecked 4건(boolean Intersect no result)이 디테일로만 남음 — 결과 JSON detail_items / FSAP MAT-RS-001 mech_2026-11-10_LITE-DC-03-DC-02-PNEU-01R-STEPWAIT(엔진 v3.9.3): LITE 보 ↔ 볼트 26쌍 inspect.interference budget 420 s 안에 모두 not checked, 손계산으로 판정하고 디테일로 남김 |
| WF-211 | 신규 | **이전 실행에서 이미 적용·저장된 과제가 실행 지시문에 남은 과제로 다시 실려, 부서들이 빈 결과로 돌고 지시문과 실제 상태가 어긋난다** | 1 | 과제 결과 빈 배열, 이미 적용된 과제 1건 재지시 | 실행 시작 단계: 과제 목록을 지시문 요약이 아니라 결정로그·설계 버전 이력에서 다시 읽어, 저장본에 이미 반영된 과제는 "해결됨"으로 빼고 시작한다(E-21, E-01) | FSAP MAT-RS-001 final_mech_2026-11-08_STEPWAIT_4.md:7 (REG-02 이미 v2.6.6 적용) — 발견 엔진 v3.9.3, FSAP MAT-RS-001, mech_2026-11-08_STEPWAIT |
| WF-212 | 신규 | **저장 전 화면 표시 정리(보조 형상 숨김)가 저장 단계의 검사 항목이 아니라, 보조 형상이 켜진 채 저장돼 사용자가 잡았다** | 1 | 사용자 지적 1건, 저장본 표시만 다시 저장 1회(형상 변화 없음) | 모델링 저장 단계(L1 저장 절차·engine/cad/solidcraft.md): 저장 직전 조인트·스케치 등 보조 표시 폴더를 숨기고, inspect로 보이는 보조 형상 수 0을 확인한 뒤 저장한다 | FSAP MAT-RS-001 실행 지시문 (a)(v2.8.2 스케치 숨겨 다시 저장), run-rules 19 — 발견 엔진 v3.9.3, FSAP MAT-RS-001, mech_2026-11-09_F01-C1-VGR-01-STEPWAIT |
| WF-213 | 신규 | **배관·배선처럼 줄 수가 많은 과제를 L 하나로 두어, 모델링 한 회차 예산 안에 다 들어가지 않고 수정 회차가 길어진다** | 1 | PNEU-01(관 26줄·고정품 35·볼트 62·체인 행정 모형) 모델링부 10,800 s, 수정1 6,300 s, 결과 '모델 반영·문제 남음' | 과제 정리 단계(L1 E-02·크기 매김)에서 줄 수·고정품 수가 기준을 넘는 배관·배선 과제는 '경로·이음'과 '고정품·이동 축 건넘'으로 나눠 과제를 만든다 | FSAP MAT-RS-001 mech_2026-11-10_VGR-01-PNEU-01-DC-01-STEPWAIT(엔진 v3.9.3): mech_PNEU-01_model.md 워크플로우 메모('한 회차 180분에 다 들어가지 않는다'), final 보고서 '가장 오래 걸린 단계 셋' |
| WF-214 | 신규 | **판을 비스듬히 지나는 관·축의 구멍을 bbox로 판정·지시해, 겹침이 없는데 겹쳐 보이거나 지시 기준을 기하상 못 맞춰 예외 요청이 생긴다** | 1 | PNEU-01 수정 회차 2회, 예외 요청·결정 2건(구멍 bbox ±0.5), 같은 지적이 설계안2·완료 판정1·2 메모에 반복 | 설계안·완료 판정 지시 양식(E-03 판정)에 비스듬한 구멍은 '구멍 중심 ±허용 + 채운 단면 교집합/윤곽 거리'로 판정하라고 적고, 관–구멍 감사 도구는 판의 면 영역으로 걸러 같은 관이 두 번 지나는 자국을 섞지 않게 한다. 관 굽힘 원호가 고정품 두께 안에 드는지도 같은 도구로 본다 | FSAP MAT-RS-001 mech_2026-11-10_VGR-01-PNEU-01-DC-01-STEPWAIT(엔진 v3.9.3): mech_PNEU-01_design2.md:77, mech_PNEU-01_donecheck1.md:82, mech_PNEU-01_donecheck2.md:74·90, 결과 JSON PNEU-01 decisions(PNEU01-E02)·open_problems 2(굽힘 원호가 구멍 벽과 겹침) |
| WF-215 | 신규 | **검도·체결 부서가 설계 파일을 여러 번 다시 열어 E-04(부서마다 한 번)를 어긴다** | 2 | VGR-01 검도·체결 22번, PNEU-01 검도·체결1 7번 열기 | 검도·체결 지시문에 잴 것을 스크립트 하나로 묶어 MCP 세션 한 번(또는 CLI 한 번)으로 재라고 명시하고, E-23 file_opens가 1을 넘으면 최종 보고가 아니라 그 부서 끝에서 경고한다 | FSAP MAT-RS-001 mech_2026-11-10_VGR-01-PNEU-01-DC-01-STEPWAIT(엔진 v3.9.3): final 보고서 '규칙을 어긴 통로 사용'; 반복 근거: FSAP MAT-RS-001 mech_2026-11-11_M02R-SIM-01-STEPWAIT 구상 부서(SIM-01 수정1)가 CLI로 설계 파일 11번 열기(final 보고 워크플로우 메모) |
| WF-216 | 신규 | **간격 검사(clearance)에 시간 예산이 없어 한 호출이 수십 분 끝나지 않고 손으로 중단해야 함** — 8분 상한(E-04)이 도구 쪽에서 강제되지 않는다 | 1 | 한 호출 45분 넘게 진행 후 수동 중단, 결과 없음 | engine/cad/solidcraft.md 연결·측정 지시문: clearance에도 budget_s 필수, 상한 넘으면 쌍을 나눠 재거나 미판정으로 기록 | FSAP MAT-RS-001 최종 보고 LITE detail_items(inspect.clearance vA 45분 넘게 끝나지 않아 중단), 발견 엔진 v3.9.3, FSAP MAT-RS-001, mech_2026-11-10_LITE-DC-03-DC-02-PNEU-01R-STEPWAIT |
| WF-217 | 신규 | **과제 지시서의 완료 기준 수치가 같은 실행 앞 과제가 갱신한 값을 따라가지 않아, 낡은 기준과 새 값이 섞임** | 1 | 완료 판정 기준 1건 혼동(문서 정정 필요) | workflows 과제 지시 생성: 앞 과제 결과 JSON의 갱신 수치를 다음 과제 완료 기준에 다시 넣거나, 기준을 "앞 과제 최신 값"으로 참조(E-21) | FSAP MAT-RS-001 mech_DC-03_model.md:61 — 발견 엔진 v4.0.0, FSAP MAT-RS-001, mech_2026-11-10_DC-04-DC-03-STEPWAIT |
| WF-218 | 신규 | **결정로그 방안 id를 과제 번호만으로 매겨, 새 시작(버전 재시작) 뒤 같은 과제 번호의 옛 행과 id가 겹침** | 1 | 중복 id 3쌍, 문서 정정 디테일 1건 | 결정로그 id 규칙(L1 결정 기록)에 버전 구간 접두 또는 기존 id grep 확인을 넣고, 문서 부서 점검에 중복 id 검사 추가 | FSAP MAT-RS-001 결과 JSON DC-03 detail_items(decision-log.md 줄 1974~1976 vs 3661~3664) — 발견 엔진 v4.0.0, FSAP MAT-RS-001, mech_2026-11-10_DC-04-DC-03-STEPWAIT |

| WF-219 | 신규 | **기구설계 1회차 점검표에 구매품 내부 저항(패킹 마찰 등 카탈로그 값) 항목이 없어, 여유가 거의 0인 힘 판정을 완료 판정이 마지막 회차에야 뒤집음** | 1 | M02R 수정 2회 모두 상한까지 쓰고 설계 미달, 회전 SF 1.001 → f 반영 시 0.727 | modeling_round 기구설계부 지시·완료 판정: 힘 균형에 들어가는 구매품마다 카탈로그 마찰·최저 사용 압력을 1회차 필수 입력으로(M-06), 여유 < 5 % 판정은 그 항목 근거 없으면 합격 불가(L2) | FSAP MAT-RS-001 final_mech_2026-11-11_M02R-SIM-01-STEPWAIT.md:113, 결과 JSON M02R open_problems. 발견: 엔진 v4.0.0, FSAP MAT-RS-001, mech_2026-11-11_M02R-SIM-01-STEPWAIT |
| WF-220 | 신규 | **벤치마크 사진에서 읽은 구동 배치를 사용자 확인 없이 모델링·커밋까지 진행해, 다음 실행에서 사용자 정정으로 통째로 걷어 냄** | 1 | 저장·커밋된 1개 버전(v2.10.2) 구동 형상 폐기, 과제 재실행 1회 | L1 E-01 시작 질문·modeling_round 구상 단계: 벤치마크 사진 해석으로 정한 매다는 방식·축 방향은 구상 끝에 그림 한 장으로 사용자 확인을 받고, 확인 전에는 결정로그에 "사진 해석, 미확인"으로 표시 | FSAP MAT-RS-001 커밋 5bfc23e → 결정로그 C-41(사용자 정정). 발견: 엔진 v4.0.0, FSAP MAT-RS-001, mech_2026-11-11_M02R-SIM-01-STEPWAIT |
