hyeunung/FSAP/docs/reports/queue_2026-11-11_1.md

# 과제 정리 — 구동 라운드 1회차 (2026-11-11 3차 실행)

엔진 v3.9.3 이후 · 최신 문서 `3D_Modeling/FSAP_v2.10.2.sc`(tools/config.json doc, 커밋 5bfc23e) · 구매품 CAD 사이트 로그인: **확인 못 함**(step_wait.json에는 '됨'이지만 2026-11-10 확인값이고, 13:05 Windows 재부팅 뒤 다시 확인하지 않음 — 실행 지시 (d))

## 읽은 것
- 요구서 5절: 해결이 아닌 구동 행은 **M02R(다시, C-41)**과 **SIM-01(미해결)** 두 개. U6S·MOT-01·PNEU-01·FUNC-01은 '일부'다. '일부'는 구동이 끝난 것이고, 남은 미달은 디테일링 몫이라(WF-169) 과제로 다시 넣지 않는다. 남은 미달은 U6S-D1~D9, MOT-01-D1·D2, PNEU-01 디테일 6, F01-D1~D8이다. DC-04는 해결 v2.8.13. 구동 후보 행은 모두 해결됐다. 커버·외장 행은 없다.
- 모델 STEP대기_ 목록: CLI로 열면 약 10~11.5분이 걸려(M02R·SIM-01 모델링 보고) CAD를 열지 않았다. v2.9.0 구매 BOM(모델에서 뽑은 것)에 그 뒤 모델링 보고에 적힌 변화를 더해 읽었다. SIM-01(v2.10.0·v2.10.1)은 새 구매품이 0이고, M02R(v2.10.2)은 `STEP대기_KQ2R06-08A_2`를 넣었다(D-170).
- `tools/out/step_wait.json`(v2.10.1 재확인)의 waiting에는 9개 형번(로그인과 무관하게 '구매부로 넘김')과 F39-LSGF·KC-40340(not_found)이 있다. **SS5Y3-20-07(D-166)과 KQ2R06-08A(D-170)는 waiting에 없다.** 아직 다시 받아 보지 않은 것이라 STEPWAIT 과제로 넣는다.
- runstats: 실행 25개, 가장 긴 열기 1,575 s(회귀). LITE는 v2.6.5·v2.8.10에서 두 번 했는데도 넘는다. 규칙상 LITE를 다시 넣지 않는다. STEPLITE도 실행 지시 (c)에 따라 넣지 않는다.
- 지난 전체 회귀(라운드 3, v2.8.13)는 ok이고 동작 문제는 0이다. U6S(v2.9.0)·SIM-01(v2.10.x)·M02R 뒤의 라운드 끝 전체 회귀는 아직 돌지 않았다.

## 과제 표 (E-02 순서: 구동)

| id | 과제 | 유닛 | 등급 | 출처 | 합격 기준(요약) | 발자국 상자 [x0,x1,y0,y1,z0,z1] mm | 구매품 종류 |
|---|---|---|---|---|---|---|---|
| M02R | U4 누름: 보 고정 사각 실린더 + 그네식 스윙 브래킷(C-41) | U4(+U8 연결) | L | 요구서 과제 | 걷어 낸 부품 잔재 0, 레버비 손계산(40 N이 IR1000 0.005~0.2 MPa 안·0.05~0.14 MPa 조정 폭), 실린더 행정 안·SF ≥ 1.5, 들기 SF ≥ 1.5, 기울기 손계산(접지점 Y 이동·바퀴 기울기각 → 회전 SF ≥ 1·자국 SF), 들기·누름·낮은 누름 × 매트 3장·V홈 과제 범위 간섭 0, 모터 위 최고 Z ≤ 보 밑 250, 관 끊김·빈 포트 0·굽힘 R ≥ 15 | [-450,1130,-200,330,-15,650] | 공압 실린더(사각 박형, 또는 보유 CDM2C20 재사용), 로드 끝 클레비스·핀·부시, 스윙 피벗 축·베어링(플랜지 부시), 원터치 피팅 |
| SIM-01 | 봉제 진행 테이프 시뮬레이션 — 검도·완료 판정 | U7(+U4·U5·U6 확인) | L | 요구서 과제 | 5연구 전 단계 테이프 줄·조각 과제 범위 간섭 0(TL_FEED↔매트 기준선 225 mm³ 제외), 굽힘 R ≥ 3(D-167), 풀림 차 ≤ 1 %(D-168), 비틀림 ≤ 1 %(D-169), 영상 5연구 | [-2100,830,-1600,1500,0,2011] | 없음 |
| STEPWAIT | SS5Y3-20-07·KQ2R06-08A 실물 STEP 받기·교체 | U8 | S | STEP 대기 | 실물 바디로 바꿈, 매니폴드 장착 구멍·밸브 7 자리·줄임 이음–티2·REG1_SUP 맞음, 과제 범위 겹침 0 | [830,1130,95,125,270,380] | 매니폴드, 원터치 피팅(줄임) |

- **M02R**: 기준은 `FSAP_v2.10.2.sc`다. 걷어 낼 것은 `P_M02R_CYLBRKT`·`P_M02R_CRANK`·`P_M02R_CRANK_PIN`·`P_M02R_CRANK_WASHER`, 모터 위 CDM2C20-25Z 묶음(BODY·CLEVIS·ROD·NUT)·I-020B_M02·포트 엘보, CB5-16 ×4·CB5-20 ×2·CB4-12 ×2, 관 U4C_A·U4C_B, 조인트 J_U4_CYL_PIN·J_U4_CYL_ROD·J_U4_ROD_PIN이다(mech_M02R_model.md). U8 쪽(KQ2L06-01AS_M08R_IN_1, STEP대기_KQ2R06-08A_2, 관 U4_A1·U4_A2·U4_B·REG1_SUP, 클램프 F_6)은 C-41에 따라 그대로 둔다. 다만 U4_A2·U4_B는 새 실린더 포트까지 다시 잇는다. 새 구조는 사각 실린더 몸을 `P_M07_BEAM`(Y 120~320 · Z 250~650)에 고정하고, 로드가 −Y로 나와 스윙 브래킷(서보·감속기·바퀴를 매단 것, 바퀴 위쪽 X축 피벗)을 기울이는 것이다. 피벗 위치·로드 연결점은 바늘 X선 위 d₁ 100과 모터 위 Z ≤ 250에 맞춘다. 바퀴 옆 가로 실린더(D-163)는 스토퍼 자리만 둔다. 앞의 설계안(mech_M02R_design*.md)은 틀린 해석이라 instructions는 비운다(설계부터). 같은 이유로 막힌 것이 아니라 사용자 정정으로 다시 하는 것이다(WF-123 해당 없음).
- **SIM-01**: v2.10.0 모델링과 v2.10.1 고침은 끝났고, 완료 판정 확인 1회차는 ok다(mech_SIM-01_donecheck1.md). 남은 것은 전 단계 `motion.interference`(U5 포함, 숨김 켜기, truncated 확인)와 영상 5연구다. M02R이 U4를 바꾸므로 **M02R 저장본에 대고** 검도한다.
- **STEPWAIT**: `STEP대기_SS5Y3-20-07_M08`(D-166)과 `STEP대기_KQ2R06-08A_2`(D-170)를 받는다. 받기 전에 PartsLibrary/index.csv를 먼저 본다(지금 SS5Y3-20-06만 있음). 로그인이 풀려 있으면 임시 형상을 그대로 두고 지나간다.
- **직렬 권장**: M02R과 SIM-01은 U4·바늘 근처에서 상자가 겹친다. SIM-01 검도가 M02R 결과를 기준으로 하므로 M02R → SIM-01 순서다. STEPWAIT 상자도 M02R 상자(U8 관 연결) 안에 들어 M02R 뒤로 둔다.

## open 표

| 항목 | 수 | 내용 |
|---|---|---|
| 열린 구동 과제 | 2 | M02R, SIM-01 |
| 구동 후보 | 0 | — |
| 회귀 동작 문제 | 0 | 지난 전체 회귀 ok. 이번 라운드 끝 회귀가 U6S·SIM-01·M02R 연구 키를 처음 본다 |
| 디테일 | 0 | 구동 라운드 중이라 0 |
| STEP 대기(형번 정해짐) | 11 | waiting 9(SCXW46-14-15, AS2201F-01-06SA, SY30M-38-1A-C6, KQ2E08-00A, KQ2T08-00A, KQ2H08-01AS, AN110-01, M-5P, KQ2P-06 — 로그인 문제 아님, 구매부로 넘김)에 새로 생긴 SS5Y3-20-07·KQ2R06-08A(STEPWAIT 과제)를 더한 수 |

형번이 정해지지 않아 세지 않은 것: PSCS16, 2400.05.12PZ, TPH-01, S-M5-2, BALL(D-96), LEVELER, 체결품(INSERT·SETSCREW·NUT·WASHER·FH4·SPRING), 867-392342(D-10), F3SG-BRKT. TU0604·TU0805는 관이라 STEP이 없다. 다른 일부 과제(U6S·MOT-01·PNEU-01·FUNC-01)의 남은 미달은 디테일링 몫이라 열린 구동 과제로 세지 않는다.

## user_wait 표

| 항목 | 사용자가 줄 것 | 구동을 막나 |
|---|---|---|
| 재봉 헤드 기종 D-10(C-25, 867 임시, 견적 조건 C-39) | 견적 뒤 기종·실치수 | 아니오 |
| 납품처 안전 기준 D-38 | 납품처 기준 | 아니오(외장·안전 단계) |
| F39-LSGF(D-135) STEP | 옴론 CAD 확인(미스미에 없음) | 아니오 |
| KC-40340(D-121) STEP | 제조사 확인(사이트에 없음) | 아니오 |
| R375X 바퀴 옆 가로 실린더 용도 D-163 | 영상·사진 | 아니오(M02R은 스토퍼 자리만) |
| R375X 슈 구동 방식·누름 힘 D-164 | 영상·사진·실물 | 아니오 |
| 7절 실측: 면밀도·μ·구름 c(D-04·D-95·D-96·D-145) | 시제품 실측 | 아니오(C-38 조건부) |
| 테이프 기종 D-06(D-167 굽힘 R 근거) | 테이프 판매처 최소 굽힘 반지름 | 아니오(R ≥ 3 임시) |
| 특허 KR102139457B1 변리사 확인 D-102 | 사용자 결정 | 아니오 |

## 워크플로우 메모
- 실행 지시 (c)는 MOT-01·FUNC-01·PNEU-01 '일부'를 '완료 판정까지'라고 적었다. 그러나 과제 정리 규칙(WF-169)은 '일부'를 구동이 끝난 것으로 보고 다시 넣지 않는다. 그래서 이 셋은 과제로 넣지 않았고, 남은 미달은 디테일링 몫으로 둔다. U6S도 같다.
- STEP대기_ 목록은 CAD를 열지 않고 BOM과 모델링 보고로 맞췄다. v2.10.2의 구매 BOM이 아직 없기 때문이다(v2.9.0이 마지막).
- 사용자 원문 "이거 안보이냐고;;"는 M02R 사진 판독(C-41)에 대한 지적으로 읽었다. 모터 위 실린더 안을 버리고, 보 고정 사각 실린더 + 그네식 스윙 브래킷을 첫 과제로 둔다.
