hyeunung/FSAP/docs/reports/queue_2026-11-11_2.md

# 과제 정리 — 구동 라운드 2회차 (2026-11-11 3차 실행)

최신 문서 `3D_Modeling/FSAP_v2.10.2.sc`(tools/config.json doc, 커밋 5bfc23e) — 1회차는 새 저장본 없음 · 구매품 CAD 사이트 로그인: **확인 못 함**(지난 라운드 결과 login '확인 못 함', 재부팅 뒤 미확인)

## 읽은 것
- 지난 라운드(1회차): M02R·SIM-01 모두 '설계 미달(수정 상한)', 저장본 없음, 전체 회귀 안 돌림, regrade·serial_next 없음, 구동 후보 없음.
- 요구서 5절: 해결이 아닌 구동 행 = **M02R(다시, C-41)**, **SIM-01(미해결)**, 그리고 1회차 과제 정리 뒤 새로 들어온 **RX-01~RX-09(미해결, C-42 — R375X 사진 재판독에서 우리와 다른 것 전부)**. U6S·MOT-01·PNEU-01·FUNC-01은 '일부' — 구동은 끝났고 남은 미달은 디테일링 몫(WF-169)이라 넣지 않는다. DC-04는 해결 v2.8.13, 구동 후보 행은 모두 해결·반영. 종류 '구동 아님(외장·안전)' 행은 없다. RX-05(U5 대차 홈 솔 덮개)는 C-42에서 사용자가 종류 '구동'으로 넣은 행이라 그대로 넣는다(대차 가이드 보호, 대차 전 행정 간섭이 합격 기준).
- 모델 STEP대기_ 목록: 1회차에 저장본이 바뀌지 않아 v2.10.2 그대로다. CLI 열기 약 10~17분이라 CAD는 다시 열지 않고 v2.9.0 구매 BOM + 이후 모델링 보고(SIM-01 새 구매품 0, M02R v2.10.2가 `STEP대기_KQ2R06-08A_2` 추가)로 맞췄다.
- `tools/out/step_wait.json`(3차 재확인, '이전 목록 유지'): waiting 9개(로그인 문제 아님, 구매부로 넘김) + F39-LSGF·KC-40340(not_found) + TU0604·TU0805(관). **SS5Y3-20-07(D-166)·KQ2R06-08A(D-170)는 여전히 waiting에 없다**(1회차 STEPWAIT 재시도 60 s, 받기 시도 없음) → STEPWAIT 과제로 다시 넣는다.
- runstats: 실행 26개, 가장 긴 열기 1,575 s(회귀). LITE는 v2.6.5·v2.8.10에 두 번 했는데도 넘어 다시 넣지 않는다. STEPLITE는 실행 지시 (c)로 넣지 않는다.
- 남은 회귀 동작 문제: 지난 전체 회귀(v2.8.13) ok, 0건. U6S·SIM-01·M02R 뒤 라운드 끝 전체 회귀는 아직 안 돌았다.

## 과제 표 (E-02 순서: 구동, 직렬 권장)

| 순서 | id | 과제 | 유닛 | 등급 | 출처 | 합격 기준(요약) | 발자국 상자 [x0,x1,y0,y1,z0,z1] mm | 구매품 종류 |
|---|---|---|---|---|---|---|---|---|
| 1 | M02R | U4 누름: 보 고정 사각 실린더 + 그네식 스윙 브래킷(C-41) — 마찰 f 넣어 다시 | U4(+U8) | L | 요구서 과제 | 잔재 0, f 넣은 회전 SF ≥ 1(두께 6·10·16), 누름 SF ≥ 1.5, 자국 N ≤ 51.6, 들기 SF ≥ 1.5, 행정 안, 모터 위 Z ≤ 250, 과제 범위 간섭 0, 관 끊김·빈 포트 0·R ≥ 15 | [-450,1130,-200,330,-15,650] | 공압 실린더(사각 박형, 저마찰 사양 후보), 인장 스프링, 피벗 축·부시, 원터치 피팅 |
| 2 | STEPWAIT | SS5Y3-20-07·KQ2R06-08A 실물 STEP | U8 | S | STEP 대기 | 실물 바디, 장착 구멍·밸브 7 자리·REG1_SUP 맞음, 과제 범위 겹침 0 | [830,1130,95,125,270,380] | 매니폴드, 원터치 피팅 |
| 3 | SIM-01 | 봉제 진행 테이프 시뮬레이션 — M02R 저장본에서 검도·영상 | U7(+U4·U5·U6) | L | 요구서 과제 | 5연구 전 단계 과제 범위 간섭 0(truncated false), R ≥ 3(D-167), 풀림 차 ≤ 1 %(D-168), 비틀림 ≤ 1 %(D-169), 영상 5연구 | [-2100,830,-1600,1500,0,2011] | 없음 |
| 4 | RX-06 | U4 X 위치 조절축(레일 + 볼나사) | U4 | L | 요구서 과제 | d₁ 조절 범위 근거, 전 범위 × 들기·누름 간섭 0, 레일·볼나사 하중 손계산 | (모름 — 직렬) | 직동 가이드, 볼나사·지지 유닛, 손잡이 또는 서보 |
| 5 | RX-08 | U4 중간 높이 스토퍼 실린더 | U4(+U8) | M | 요구서 과제 | 스토퍼 각도·띄움 높이 근거, 실린더 힘 ≥ 반력 × SF, 간섭 0, 빈 포트 0 | (모름 — 직렬) | 소형 공압 실린더, 멈춤 블록, 원터치 피팅 |
| 6 | RX-07 | 레귤레이터 3개 — U5 누름 공압 조절 검토 | U5·U8 | M | 요구서 과제 | 두 안 비교표, 힘 범위가 자국·잡음 기준 안, 빈 포트 0, 간섭 0 | (모름 — 직렬) | 정밀 레귤레이터, 원터치 피팅 |
| 7 | RX-01 | 주 공기 차단·잔압 배기 밸브 + 압력 스위치 | U8 | M | 요구서 과제 | 형번·카탈로그 값, 포트 표 빈 포트 0, 관 R ≥ 최소, 간섭 0, BOM | (모름 — 직렬) | 3포트 차단·배기 밸브, 압력 스위치, 소음기, 피팅 |
| 8 | RX-02 | 바늘 냉각 공기 노즐 | U3·U8 | M | 요구서 과제 | 노즐이 바늘 끝 향함, 간섭 0, 빈 포트 0, BOM | (모름 — 직렬) | 굽힘 노즐, 속도 조절 이음, 솔레노이드 밸브(매니폴드 빈 자리) |
| 9 | RX-03 | 테이프 감지 센서 | U7 | M | 요구서 과제 | 시야 거리 안, 브래킷 간섭 0, SIM-01 테이프 줄 전 단계 시야, BOM | (모름 — 직렬) | 원통형 광센서, 센서 브래킷 |
| 10 | RX-04 | 바늘 둘레 LED 조명 | U3 | S | 요구서 과제 | 간섭 0, E32 시야 가림 0, BOM | (모름 — 직렬) | 소형 LED 조명 |
| 11 | RX-05 | U5 대차 홈 솔 덮개 | U5 | M | 요구서 과제 | 대차 전 행정 간섭 0(솔 통과 제외), 덮인 길이 = 행정, BOM | (모름 — 직렬) | 브러시 실(솔 띠) |
| 12 | RX-09 | 캐스터 | U1 | M | 요구서 과제 | 하중 손계산, 바닥 높이·레벨러 행정 맞음, BOM | (모름 — 직렬) | 캐스터, 레벨러 |

- **M02R**: 같은 이유로 그대로 다시 넣는 것이 아니다(WF-123). 1회차 완료 판정(mech_M02R_donecheck2.md 3절)이 고칠 자리를 정했다 — 회전 SF 식에 로드 마찰 f를 넣고(N_land = N_free + (N/MPa)·p − g·f), (a)(b)(c) 세 조건을 함께 맞춘다. f는 카탈로그 값(M-06), 없으면 새 D-번호 임시값. CDQ2A20-25DMZ의 최저 사용 압력 0.05 MPa(f 15.7 N)면 창이 닫히므로 같은 외형의 저마찰 사양(최저 사용 압력 ≤ 0.03 MPa급, f ≤ 9.4 N)을 임시 형번으로 두고 진행한다(E-12). 형번 변경은 돈이 드는 선택이라 user_wait에 결정 항목으로 남긴다(구동은 막지 않음). 걷어 낼 것 목록·U8 회로 유지는 1회차 정리(queue_2026-11-11_1.md)와 같다. 바퀴 기울기(접지점 Y 이동·기울기각)가 회전 SF·자국에 주는 영향은 손계산하고 7절에 적는다.
- **SIM-01**: 1회차는 M02R 저장본이 없어 막혔다. M02R이 이번에 저장되면 풀리므로 M02R 뒤 직렬로 둔다. 남은 일은 check4(U4 묶음 against, budget_s 600)와 영상 5연구(frames ≥ 150)뿐이다. 구상 부서는 설계 파일을 한 번만 연다(1회차 11번, E-04 위반).
- **RX-06·RX-08**은 요구서에 'M02R 뒤'(같은 부품)라 적혀 있다. RX-03은 SIM-01 테이프 줄로 시야를 본다. RX 과제 발자국(바디·상자)은 모델 목록에서 확인하지 못해 bodies를 비웠다 — 모두 직렬.
- 사용자 원문 "이거 안보이냐고;;": 1회차가 새 형상을 그리지 못해 앱에는 옛 크랭크 U4(v2.10.2)가 그대로 보인다. 이번 라운드 첫 과제 M02R을 앱(MCP)에서 그려 저장해야 사용자 화면에 정정이 보인다.

## open 표

| 항목 | 수 | 내용 |
|---|---|---|
| 열린 구동 과제 | 11 | M02R, SIM-01, RX-01~RX-09 |
| 구동 후보 | 0 | — |
| 회귀 동작 문제 | 0 | 지난 전체 회귀(v2.8.13) ok. 이번 라운드 끝 회귀가 U6S·SIM-01·M02R 키를 처음 본다 |
| 디테일 | 0 | 구동 라운드 중이라 0 |
| STEP 대기(형번 정해짐) | 11 | waiting 9(SCXW46-14-15, AS2201F-01-06SA, SY30M-38-1A-C6, KQ2E08-00A, KQ2T08-00A, KQ2H08-01AS, AN110-01, M-5P, KQ2P-06 — 로그인 문제 아님) + STEPWAIT 2(SS5Y3-20-07, KQ2R06-08A) |

세지 않은 것: 형번 미정(PSCS16, 2400.05.12PZ, TPH-01, S-M5-2, BALL D-96, LEVELER, 체결품, 867-392342 D-10, F3SG-BRKT), 관 TU0604·TU0805, 사이트에 없는 F39-LSGF·KC-40340(user_wait). '일부' 과제(U6S·MOT-01·PNEU-01·FUNC-01)의 남은 미달은 디테일링 몫.

## user_wait 표

| 항목 | 사용자가 줄 것 | 구동을 막나 |
|---|---|---|
| M02R 실린더 사양: CDQ2A20-25DMZ 유지(마찰 근거 없음) 또는 저마찰 사양 형번 변경 | 형번 결정, 패킹 정지 마찰(최저 작동 압력) 카탈로그 값 | 아니오(임시 저마찰 사양으로 진행) |
| 재봉 헤드 기종 D-10(C-25, 867 임시) | 견적 뒤 기종·실치수 | 아니오 |
| 납품처 안전 기준 D-38 | 납품처 기준 | 아니오 |
| F39-LSGF STEP(D-135) | 옴론 CAD 확인(미스미에 없음) | 아니오 |
| KC-40340 STEP(D-121) | 제조사 확인 | 아니오 |
| 미스미 로그인 상태(재부팅 뒤 미확인) | 로그인 확인(풀렸으면 사용자가 로그인) | 아니오(STEP대기_ 임시 형상) |
| R375X 부품 용도 D-163·D-181~D-187(RX 과제 근거, 신뢰 적음) | 영상·실물·사용자 확인 | 아니오(추정 용도로 진행) |
| R375X 슈 구동 방식·힘 D-164 | 영상·사진·실물 | 아니오 |
| 7절 실측 D-04·D-95·D-96·D-145 | 시제품 실측 | 아니오 |
| 테이프 기종 D-06(D-167 굽힘 R 근거) | 최소 굽힘 반지름 | 아니오 |
| 특허 KR102139457B1 변리사 확인 D-102 | 사용자 결정 | 아니오 |

## 워크플로우 메모
- 1회차 과제 정리 뒤 요구서 5절에 RX-01~09(C-42)가 들어와 열린 구동 과제가 2 → 11로 늘었다. 과제 정리가 라운드 사이에 요구서를 다시 읽어 잡았다.
- STEP대기_ 목록은 저장본이 그대로라 CAD를 열지 않고 BOM·보고서로 맞췄다(v2.10.2 구매 BOM 없음, v2.9.0이 마지막).
- RX 과제는 모델 바디 이름을 확인하지 못해 발자국을 비웠다 — 동시 묶음 없이 직렬.
