hyeunung/FSAP/docs/reports/queue_2026-11-10_2.md

# 과제 정리 — 구동 라운드 2회차 (2026-11-10 2차 실행, 다시 정리 2026-11-11)

엔진 v3.9.3 · 최신 문서 `3D_Modeling/FSAP_v2.10.1.sc`(tools/config.json doc, **아직 커밋 안 됨** — git: config.json·machine.json 수정, v2.10.1 추적 안 됨) · 구매품 CAD 사이트 로그인: **됨**(지난 라운드 결과 login, step_wait.json login 됨)

같은 이름으로 02:20에 만든 정리(v2.8.13 기준, M02R·U6S·SIM-01)를 지금 상태로 바꿔 쓴다. 그 뒤 U6S가 v2.9.0, SIM-01이 v2.10.0(+ v2.10.1 고침)으로 모델링됐고 M02R은 앱 dirty로 멈췄다.

## 읽은 것
- 요구서 5절: 해결이 아닌 구동 행 **M02R(미해결)·U6S(일부 v2.9.0)·SIM-01(미해결)**, 그리고 MOT-01·PNEU-01·FUNC-01·DC-02 '일부'. '일부'는 구동이 끝난 것이고 남은 미달은 디테일링 몫이라(WF-169) 다시 넣지 않는다 — U6S도 여기에 든다(디테일 U6S-D1~D9). DC-03·DC-04·PNEU-01R 해결. 커버·외장 행 없음.
- 모델 STEP대기_ 목록: 앱·CLI로 v2.10.1을 열지 않았다(CLI 열기 약 11.5분, SIM-01 모델링 보고). v2.9.0 BOM(`docs/bom/FSAP_v2.9.0_purchased.csv`, 모델에서 뽑은 것)으로 읽었다. v2.10.0·v2.10.1은 새 구매품 0(mech_SIM-01_model.md)이라 목록이 같다.
- `tools/out/step_wait.json`(2026-11-11 02:23, v2.8.13 기준), `docs/waiting-list.md` D-121·D-135·D-143·D-157·D-163·D-164·D-166~D-169.
- runstats: 실행 25개, 가장 긴 열기 1,575 s(회귀). LITE는 v2.6.5·v2.8.10에서 두 번 했고 그래도 넘음 → 규칙대로 LITE를 다시 넣지 않는다.
- 지난 라운드 전체 회귀: ok, 동작 문제 0. 이번 라운드(M02R·U6S·SIM-01) 끝 전체 회귀는 아직 안 돌았다.

## 과제 표 (E-02 순서: 구동)

| id | 과제 | 유닛 | 등급 | 출처 | 합격 기준(요약) | 발자국 상자 [x0,x1,y0,y1,z0,z1] mm | 구매품 종류 |
|---|---|---|---|---|---|---|---|
| M02R | U4 바퀴 누름을 R375X식 누운 실린더 + 핀 축 레버로 (C-40) | U4(+U8 회로) | L | 요구서 과제 | 레버 비율·실린더 지름 손계산(누름 힘 범위 ⊂ IR1000 조정 범위, SF), 들기·누름·낮은 누름 × 매트 3장·V홈 과제 범위 간섭 0, 모터 위 높이 ≤ 지금, 관 연결 PNEU-01 기준 | [-320,1070,-200,210,-15,500] | 공압 실린더(소형·클레비스), 클레비스 핀·부시, 원터치 피팅·줄임 이음 |
| SIM-01 | 봉제 진행 테이프 시뮬레이션 — v2.10.1 검도·완료 판정 | U7(+U4·U5·U6 확인) | L | 요구서 과제 | 5연구 전 단계 테이프 줄·조각 과제 범위 간섭 0(TL_FEED↔매트 기준선 제외), 굽힘 R ≥ 3(D-167), 풀림 차 ≤ 1 %(D-168), 비틀림 ≤ 1 %(D-169), 영상 5연구 | [-2100,830,-1600,1500,0,2011] | 없음 |
| STEPWAIT | SS5Y3-20-07 실물 STEP 받기·교체 | U8 | S | STEP 대기 | 실물 바디로 바꿈, 장착 구멍·밸브 7 자리 맞음, 과제 범위 겹침 0 | [1030,1130,95,125,320,380] | 매니폴드 |

- M02R: 지난번 막힌 이유는 앱 문서 dirty(mech_M02R_model.md)였다. 그 뒤 SIM-01 모델링부가 v2.9.0을 dirty false로 열어 저장했으므로 같은 이유가 아니다(WF-123 해당 없음). 단 설계안(mech_M02R_design.md·design1.md)은 v2.8.13 기준이고 U6S가 U8 회로(7번 밸브·SS5Y3-20-07·U6P 관)를 바꿨으므로 수정안을 그대로 쓰지 않고 v2.10.1에서 차이를 다시 잰다(instructions 비움).
- SIM-01: v2.10.0 모델링 끝(5연구 겹침 0, 영상 167 samples), v2.10.1에서 L 조각 16을 16·16B로 나눔(machine.json J_TP_L_16B). 검도·완료 판정이 남았다. 붙은 조각 대기 Z 2000~2011이 발자국 상자에 든다.
- M02R과 SIM-01은 U4·바늘 근처에서 상자가 겹치고, SIM-01은 연구 CYCLE_* 키, M02R은 J_U4_PRESS 키를 바꿔 연구가 겹친다 → 직렬 권장(E-25 판단은 라운드 시작 단계).

## open 표

| 항목 | 수 | 내용 |
|---|---|---|
| 열린 구동 과제 | 2 | M02R, SIM-01 |
| 구동 후보 | 0 | — |
| 회귀 동작 문제 | 0 | 지난 전체 회귀 ok(못 본 범위는 문제 아님). 이번 라운드 끝 회귀가 새 연구 키로 다시 봄 |
| 디테일 | 0 | 구동 라운드 중이라 0 |
| STEP 대기(형번 정해짐) | 10 | step_wait.json waiting 9(SCXW46-14-15, AS2201F-01-06SA, SY30M-38-1A-C6, KQ2E08-00A, KQ2T08-00A, KQ2H08-01AS, AN110-01, M-5P, KQ2P-06 — 이유 '구매부로 넘김', 로그인 아님) + 새 SS5Y3-20-07(U6S, D-166, 아직 재시도 안 함 → STEPWAIT 과제) |

형번 미정이라 빼고 센 것: TPH-01, BALL-D25.4(D-96), LEVELER-M8, S-M5-2, PSCS16(임시), 스프링, 인서트 M3, 867-392342(D-10) 등. M02R이 넣을 KQ2R06-08A는 아직 모델에 없다. TU0604·TU0805는 관이라 STEP 없음.

## user_wait 표

| 항목 | 사용자가 줄 것 | 구동을 막나 |
|---|---|---|
| 재봉 헤드 기종 D-10(C-25, 867 임시, 견적 조건 C-39) | 견적 뒤 기종·실치수 | 아니오 |
| 납품처 안전 기준 D-38 | 납품처 기준 | 아니오(외장·안전 단계) |
| F39-LSGF(D-135) STEP | 옴론 CAD 확인(미스미에 없음) | 아니오 |
| KC-40340(D-121) STEP | 제조사 확인(사이트에 없음) | 아니오 |
| R375X 바퀴 옆 가로 실린더 용도 D-163 | 영상·사진 | 아니오 |
| R375X 슈 구동 방식·누름 힘 D-164 | 영상·사진·실물 | 아니오 |
| 7절 실측: 면밀도·μ·구름 c(D-04·D-95·D-96·D-145) | 시제품 실측 | 아니오(C-38 조건부) |
| 테이프 기종 D-06(D-167 굽힘 R 근거) | 테이프 판매처 최소 굽힘 반지름 | 아니오(R ≥ 3 임시) |

## 워크플로우 메모
- 실행 인자 (a)는 'v2.8.12에서 이어서'인데 실제 최신은 v2.10.1이다. 이 정리는 config.json doc(v2.10.1) 기준이다. v2.10.1은 아직 커밋 전이라 모델링부가 이어 쓰기 전에 버전 커밋(규칙 4)을 확인해야 한다.
- STEPLITE에 대해(사용자 질문 "step lite를 진행하는게 의미가 없다는거야?"): 의미가 없다는 뜻이 아니다. 지난 STEPLITE는 F3SG 라이트 커튼 STEP을 간이 형상으로 바꾸는 과제였는데, 그 부품이 열기 시간에서 차지하는 몫이 약 0.1 %여서 '모델 무게를 줄이는 효과'가 거의 없다고 보고 다시 넣지 않은 것이다. 지금 무거운 곳은 다른 데다: 보 필렛 띠 Combine 약 118 s(LITE v2.8.10 보고), SIM-01 테이프 조각 122 컴포넌트 이후 CLI 열기 약 11.5분. 무게를 줄이려면 이쪽을 노리는 LITE가 맞고, 규칙상 LITE는 두 번 해서 다시 넣지 않았으므로 할지는 사용자가 정한다.
- runstats '가장 긴 열기'는 회귀 CLI 열기(1,575 s)라 LITE 기준(240 s)과 통로가 다르다.
