hyeunung/FSAP/docs/reports/queue_2026-11-10_1.md

# 과제 목록 — 구동 라운드 1회차 (2026-11-10 2차 실행, 엔진 v4.0.0)

엔진이 v4.0.0으로 바뀌었다(사용자 "엔진 바꿨어"). 과제 정리에 닿는 것은 WF-218 간이 형상 하나다: 원본 그대로 들어간 무거운 구매품 STEP(2 MB 또는 면 2,000 넘음)은 라운드 시작 'STEP 대기 재시도'가 찾아 과제 STEPLITE(10형번씩)로 만든다. 과제 정리부가 만드는 과제가 아니라 이 표에는 넣지 않았다. 가장 긴 열기 1575 s가 240 s를 넘는 데 STEPLITE가 도움이 될 수 있다(첫 실행에서 열기·회귀 시간 변화를 잰다). STEPWAIT로 받는 STEP도 무거우면 `LITE_<형번>`으로 넣는다.

기준 모델 `3D_Modeling/FSAP_v2.8.12.sc`(tools/config.json doc). 과제 정리부라서 CAD는 열지 않았다. STEP대기_ 목록은 BOM `docs/bom/FSAP_v2.8.9_purchased.csv`의 STEP대기_ 행으로 봤다(v2.8.9 → v2.8.12 바디 이름·수 변화 0, 회귀 21 `compare23.json`).
읽은 것은 다음과 같다.
- 요구서 5절, 결정로그 C-38·C-39
- `tools/out/step_wait.json`(login 풀림, 2026-11-10 라운드 2)
- runstats(실행 24개, 가장 긴 열기 1575 s)
- 최종 보고 `final_full_2026-11-10.md`, 전체 회귀 21회차 `mech_regression_21.md`

사용자 결정 2026-11-10 '추천대로'는 두 가지다.
- C-38(DC-03): L 모서리는 U4+U5 유지, U4 혼자는 U5가 매트 밖인 짧은 구간만, 7절 실측 조건부. 형상 변경 0, 문서만 고쳐 닫는다.
- C-39(DC-04): 회전 중 노루발 낮은 누름, 헤드 견적 조건, F4 ≤ 18 N.

## 과제 표 (순서 E-02)

| 순서 | id | 과제 | 유닛 | 출처 | 등급 | 합격 기준 | 직렬 |
|---|---|---|---|---|---|---|---|
| 1 | DC-04 | U4 혼자 회전 중 바늘 피벗 옆힘 — 노루발 낮은 누름(C-39) | U3(노루발 J_U3_PRESSER)·U4 | 구동 후보 | M | 연구 회전 구간 노루발 값 = 봉제 높이(들림 20 아님, 꼭 들 곳만 20이고 그때 U4 혼자 0), 바늘 옆힘 ≤ 20 N·U4 혼자 F4 ≤ 18 N 손계산, 노루발 끌림을 넣어도 회전 SF ≥ 1, 과제 범위 간섭 0 | 아니오 |
| 2 | DC-03 | 긴 매트 모서리 — C-38대로 문서 닫기 | U4·U5 | 구동 후보 | S | 형상 변경 0. 요구서·FUNC-01 ②·⑦·D-96(c_max)·7절·machine.json _timing(G1 출구 11.0 s 포함) 고쳐 적음, U4 혼자 구간 SF ≥ 1 | 예(발자국 없음, machine.json을 DC-04와 같이 씀) |
| 3 | STEPWAIT | STEP대기 실물 교체(로그인 다시 확인 뒤, 무거우면 간이 형상 WF-218) | U3·U8 | STEP 대기 | S | 받은 형번 STEP대기_ 0, 교체 뒤 새 겹침 0, LITE_로 넣은 것은 `out/lite/<형번>.json` pass | 라운드 시작 단계 |

다시 넣지 않은 것은 아래와 같다.
- MOT-01·FUNC-01·PNEU-01·DC-02: 지난 결과가 '일부'다. 남은 미달은 디테일링 몫이다(WF-169).
- VGR-01·DC-01·PNEU-01R: 해결됐다.
- LITE: v2.6.5와 v2.8.10에 이미 두 번 했다. 열기가 1575 s(회귀 20)에서 598~678 s(회귀 21)로 줄었지만 240 s는 못 맞췄다. 규칙('한 번 했는데도 넘으면 다시 넣지 않는다')대로 넣지 않는다.
- 디테일 과제 전부, 커버·외장.

STEPWAIT 받을 것: 9형번(아래 open 표) + 이번 실행 지시 (d)의 TU0604·TU0805. 관 두 가지는 모델에서 pipe(경로 관)라 STEP은 받아 purchased-step·PartsLibrary에 두기만 하고 관 형상은 그대로(BOM D-162).

STEPWAIT를 넣은 이유: step_wait.json은 이 형번들을 login 이유로 waiting에 두고 있다. 이번 실행 지시 (d)는 미스미 로그인이 화면상 유지된다고 한다(2026-11-10 확인). 그래서 로그인 때문에 아직 다시 받아 보지 않은 것으로 보고 과제로 넣었다. 구매부는 받기 전에 머리 '로그인 / 회원가입'을 먼저 본다. 풀려 있으면 받지 않고 임시 형상을 유지한다(규칙 12).

## open 표

| 칸 | 수 | 내용 |
|---|---|---|
| 열린 구동 과제 | 0 | M00~M08·M04R·M08R·PNEU-01R 해결, MOT-01·FUNC-01·PNEU-01 일부(디테일링 몫) |
| 구동 후보 | 2 | DC-03(결정 C-38, 문서로 닫기), DC-04(결정 C-39) |
| 회귀 동작 문제 | 0 | 회귀 21 본 범위 85점에서 새 겹침 0(못 본 범위는 아래 참고) |
| 디테일 | 0 | 구동 라운드 중에는 세지 않는다 |
| STEP 대기(형번 정해짐) | 9 | SCXW46-14-15, AS2201F-01-06SA, SY30M-38-1A-C6, KQ2E08-00A, KQ2T08-00A, KQ2H08-01AS, AN110-01, M-5P, KQ2P-06 |

참고(회귀 21이 못 본 범위): 다음은 상한(30분) 또는 470 s timeout으로 못 봤다. 라운드 끝 회귀가 against를 나눠 다시 본다.
- POSE 0·10·20·30(470 s timeout)
- 연구 20·10단계 오프셋 209점
- SEAM_U7 4·12·20·28
- H_·Y_·B_(보 P_M07_BEAM 대 움직이는 것, 한 점 250 s)
- MAINT_U7

## user_wait 표

| 항목 | 사용자가 줄 것 | 구동 막음 |
|---|---|---|
| 재봉 헤드 기종(STEP대기_867-392342, D-10·D-109) | 분리형 3중 이송 헤드 견적·기종. C-39 견적 조건: 바늘 Nm ≥ 180~200, 회전 중 옆힘 ≥ 20 N, 노루발 누름 2단 | 아니오(867 임시 형상) |
| 납품처 안전 기준(D-38) | 기준 문서 | 아니오 |
| 사이트에 CAD 없음: F39-LSGF(D-135, 옴론 CAD), KC-40340(D-121, 제조사 미확인) | 제조사 CAD 또는 대체 형번 | 아니오 |
| 미스미 로그인(다시 풀리면) — STEPWAIT 형번, TPH-01(형번 임시) | 미스미 재로그인 | 아니오(임시 형상) |
| 형번 미정 구매품: 볼 D-96, 레벨러 D-119·D-128, PSCS16 D-147, 스프링 D-149, S-M5-2 D-122, 2400.05.12PZ D-115, 인서트·멈춤나사·너트·와셔·스터드 D-125·D-127·D-142 | 형번 확정(대부분 디테일링 몫) | 아니오 |
| 7절 실측: 매트 면밀도·바퀴–파일 μ·볼 구름 c(C-38 판정 선 c ≤ c_max), U5 밑 띠 μs(D-97) | 시제품 실측값 | 아니오(불리 가정으로 진행) |

구매품 CAD 사이트 로그인: step_wait.json 기준 '풀림'(라운드 2). 이번 실행 지시는 '화면상 유지'라고 하므로 라운드 시작 구매부가 다시 확인한다.
