hyeunung/FSAP/docs/reports/final_full_2026-11-10.md

# 전체 최종 보고 2026-11-10 — "잘 도는데 긴것도 혼자"

**상태: 구동 개념 재검토 — DC-03**

미스미 로그인: **풀림** (라운드 2 구매부 확인 기준. 재로그인은 하지 않았다)

## 1. 개념 재검토 (사용자가 정함, E-02)

| 과제 | 개념의 무엇 | 왜 |
|---|---|---|
| DC-03 (DC-03-S1) | 0-8-3 U5 역할 '큰 매트 회전', 0-8-5 '먼 쪽 바퀴가 필요한 이유', 0-8-1 '수지 볼' | L 1500 모서리를 U4 혼자(d₁ 100, 누름 40 N) 돌리면 근거 있는 선정 조건으로 SF ≥ 1이 안 된다. 불리 가정(면밀도 6 kg/m², 원판 끌림·가속 포함)에서 필요한 볼 구름 저항은 정적 ≤ 0.0102(μ 0.4)~0.0155(μ 0.6), 12 s 회전이면 ≤ 0.0044~0.0097. 수지 볼 문헌값은 0.01~0.03이고, 선정 조건 0.02에서는 μ 0.6에서도 정적 SF 0.777 |

고를 수 있는 안:

| 안 | 내용 | 영향 |
|---|---|---|
| (1) 현행 유지 | L 모서리는 U4+U5 | '긴 것도 혼자'는 못 맞춤 |
| (2) 볼 바꿈 | 휘두름 영역 수지 볼 → 강구+베어링 지지형(c ≤ 0.005) | μ 0.5면 10.3 s, μ 0.6이면 8.9 s. 매트 뒷면 점자국 위험(C-03), 볼 827개 형번·비용 바뀜 |
| (3) d₁ ≥ 193 | C-37 (가), 구조 변경 | 이번 지시(C-37 (다))로 하지 않음 |
| (4) 7절 실측 조건부 허용 | 면밀도·μ·c 실측값으로 판정. 12 s에서 c ≤ c_max(실측) | 예로 4 kg/m²·μ 0.6이면 c ≤ 0.0174. R375X가 실제로 도는 것은 실물 값이 이쪽에 있다는 뜻으로 볼 수 있음. 실측이 못 넘으면 U4+U5 7.5 s로 되돌림 |

## 2. 사용자 자료 대기

| 무엇 | 사용자가 줄 것 | 구동을 막나 |
|---|---|---|
| 재봉 헤드 기종(STEP대기_867-392342, D-10·D-109) | 분리형 3중 이송 헤드 견적·기종 | 아니오 |
| 납품처 안전 기준(D-38) | 기준 문서 | 아니오 |
| 미스미 로그인 풀림: AS2201F-01-06SA·AS2201F-01-06S·TPH-01·KQ2E08-00A·KQ2H08-01AS·AN110-01·SY30M-38-1A-C6·KQ2P-06 STEP 못 받음 | 미스미 재로그인 | 아니오 |
| 사이트에 CAD 없음: SCXW46-14-15(D-143), F39-LSGF(D-135) | 제조사 CAD 또는 대체 형번 확인 | 아니오 |
| 형번 미정 구매품(볼 D-96, 레벨러 D-119·D-128, PSCS16 D-147, 스프링 D-149, KC-40340 D-121, S-M5-2 D-122, 2400.05.12PZ D-115, 인서트·멈춤나사·너트·와셔·스터드 D-125·D-127·D-142) | 형번 확정 | 아니오 |
| DC-03 구조 변경 d₁ ≥ 193 | 구조 변경 승인(C-37 재결정) | 아니오 |

## 3. 구매품 CAD 사이트 로그인

| 라운드 | 상태 | 로그인 문제로 못 받은 형번 |
|---|---|---|
| 1 | 풀림 | TU0604, TU0805, AS2201F-01-06SA, AS2201F-01-06S, TPH-01, KQ2E08-00A, KQ2H08-01AS, AN110-01, SY30M-38-1A-C6, KQ2P-06 |
| 2 | 풀림 | SCXW46-14-15, AS2201F-01-06SA, SY30M-38-1A-C6, KQ2E08-00A, KQ2T08-00A, KQ2H08-01AS, AN110-01, M-5P, KQ2P-06, F39-LSGF, KC-40340 |

## 4. 남은 것

| 칸 | 수 | 항목 |
|---|---|---|
| 열린 구동 과제 | 1 | DC-03(개념 재검토) |
| 구동 후보 | 2 | DC-03, DC-04 |
| 동작 문제 | 2 | 공압 관–구멍 겹침(PNEU-01R은 라운드 2에서 v2.8.12로 해결, 다음 회귀로 확인) |
| 디테일 | 0 | — (구동 끝난 뒤 한 번) |
| STEP대기(형번 정해짐) | 2 | KQ2T08-00A, M-5P (로그인 풀림) |

DC-02(보통 모서리 U5 밑 PTFE 띠)는 라운드 2에서 '모델 반영·해석 못 함'. DC-03 결정에 따라 남는 모서리만 다시 판정한다.

### 구동 후보

| id | 무엇 | 근거 | 제안 |
|---|---|---|---|
| DC-03 | L 1500 모서리 U4 혼자는 회전력 모자람. G 1200 U4 혼자 안(12.0 s, μ ≥ 0.5)은 설계만, 모델 키(CYCLE_G2_모서리)는 아직 U4+U5 4.5 s | L 정적 잡는 1.60 N·m 대 필요 3.09 N·m, SF 0.518 (dc03design.json) | (가, 추천) 7절 실측 조건부 허용, 실측 미달이면 U4+U5 7.5 s. 형상 변경 0. (나) 강구 볼 L 10.3 s. (다) d₁ ≥ 193은 C-37에서 안 하기로 함 |
| DC-04 | U4 혼자 회전 때 피벗인 바늘이 바퀴 힘을 옆힘으로 받음(지금까지 셈에 빠짐) | G 1200 12 s 바늘 옆힘 최대 17.8 N, L 구름 0.02이면 36.6 N. 바늘 Ø1.6 외팔 25 mm·15 N이면 933 MPa, 처짐 1.16 mm (check_v2812.json, 바늘 굵기 임시 D-10) | (가, 추천) 회전 중 노루발을 낮은 누름으로 두어 바늘+노루발 함께 피벗(0-8-1 순서 바뀜, 사용자 결정). (나) 헤드 사양에 바늘 Nm ≥ 180~200·옆힘 ≥ 20 N, 회전 F4 ≤ 18 N. (다) U4 혼자 구간을 줄임(DC-03 요청과 맞섬) |

### 전체 회귀가 못 본 범위 (WF-153)

| 라운드 | 못 본 범위 |
|---|---|
| 1 | MAINT_U7 3 8조각(470 s 넘음, 세션 사망) / MAINT_U7 6·9·12 못 돌림 |
| 1 | POSE 0·CYCLE_V 20: 시험 timeout 470 s |
| 1 | CYCLE_V 1~486, CYCLE_L 0~716, CYCLE_S 0~450, CYCLE_G1 0~514, CYCLE_G2 0~630, SEAM_U7 0~32, MAINT_HEAD 0~1: 전체 상한 |
| 1 | X_CYCLE_L·S·G1·G2·V, X_POSE(바뀐 관·체인·고정품 대 움직이는 것): 전체 상한 |
| 1 | POSE 0~180(9 제외): 전체 상한 |
| 1 | 명세에서 뺌: F_STATES 0~34, MAINT_U7 1·2·4·5·7·8·10·11·13, 연구 10단계 사이 조밀 범위 |
| 1 | U7 묶음 움직임 판정(dump22): 1,500 s 끊김, 이름 규칙만 씀 |
| 2 | POSE 0·10·20·30: 470 s timeout(세션 사망 3) |
| 2 | 연구 20·10단계 오프셋: CYCLE_V 36, CYCLE_L 54, CYCLE_S 33, CYCLE_G1 39, CYCLE_G2 47점 — 전체 상한 |
| 2 | SEAM_U7 4·12·20·28 — 전체 상한 |
| 2 | POSE 1~180(9 빼고) — 전체 상한·어림 초과 |
| 2 | H_(관 고정품 25 대 움직이는 것) 연구 5개×3점 — 전체 상한(겹침 수 미기록) |
| 2 | Y_(바뀐 바디 5) 연구 5개 양 끝, Y_POSE 0~180 20간격 — 전체 상한 |
| 2 | B_(P_M07_BEAM 대 움직이는 것) CYCLE_V 0·CYCLE_L 358·CYCLE_G2 315 ×8조각 — 어림 초과 |
| 2 | MAINT_U7 3·6·9·12 16조각 — 어림 초과 |
| 2 | 명세에서 뺌: F_STATES 0~34, MAINT_U7 1·2·4·5·7·8·10·11·13, 연구 10단계 사이 조밀 범위 |

## 5. 라운드별 결과

| 라운드 | 과제 | 결과 | 출력 토큰 | 최종 보고 |
|---|---|---|---|---|
| 1 | VGR-01, PNEU-01, DC-01, STEPWAIT | VGR-01 완료(v2.8.5), PNEU-01 모델 반영·문제 남음(v2.8.8), DC-01 모델 반영·해석 못 함(v2.8.9), 회귀 ok | 1,735,951 | docs/reports/mechanism/final_mech_2026-11-10_VGR-01-PNEU-01-DC-01-STEPWAIT.md |
| 2 | LITE, DC-03, DC-02, PNEU-01R, STEPWAIT | LITE 완료(v2.8.10), DC-03 개념 재검토, DC-02 모델 반영·해석 못 함(새 저장 없음), PNEU-01R 완료(v2.8.12), 회귀 ok | 500,857 | docs/reports/mechanism/final_mech_2026-11-10_LITE-DC-03-DC-02-PNEU-01R-STEPWAIT.md |

부서별 시간·토큰: `runs/mech_2026-11-10_VGR-01-PNEU-01-DC-01-STEPWAIT/summary.json`, `runs/mech_2026-11-10_LITE-DC-03-DC-02-PNEU-01R-STEPWAIT/summary.json`. 디테일링: 돌지 않음(구동 미완, 규칙 13).

최신 설계: `3D_Modeling/FSAP_v2.8.12.sc`.

## 6. 사용자 결정

| 항목 | 고를 것 | 추천 |
|---|---|---|
| DC-03 긴 매트 U4 혼자 | (1) 현행 U4+U5 / (2) 강구 볼 / (3) d₁ ≥ 193 / (4) 7절 실측 조건부 | (4) |
| DC-04 회전 중 피벗 옆힘 | (가) 노루발 낮은 누름 유지 / (나) 헤드 사양 조건+F4 제한 / (다) U4 혼자 구간 축소 | (가) |
| 볼 재질(D-96) | 수지 유지 또는 휘두름 영역 강구 | DC-03 결정에 따름 |

## 사람이 할 일

| 할 일 | 왜 |
|---|---|
| 미스미 재로그인 | 공압 피팅 등 11개 형번 STEP 받기 |
| 7절 저울 시험: 매트 면밀도·바퀴 μ·볼 구름 저항 c 실측 | DC-03 (4) 판정 선 |
| 재봉 헤드 견적(D-10), 바늘 굵기·옆힘 조건 포함 | DC-04, 헤드 STEP |
| 납품처 안전 기준(D-38) 전달 | 외장 단계 |
| SCXW46-14-15·F39-LSGF 대체 형번 또는 제조사 CAD 확인 | STEP 없음 |
