hyeunung/FSAP/docs/reports/final_full_2026-11-09.md

# 전체 최종 보고 — 2026-11-09 (엔진 v3.9.3)

**미스미 로그인: 확인 못 함** (2026-11-10 새 탭으로 열었으나 봇 확인 페이지가 떠 넘기지 않음. 라운드 결과도 '확인 못 함'). 로그인 문제로 못 받은 형번: 없음(기록된 것 없음).

## 1. 상태

**구동 개념 재검토 — VGR-01**

| 과제 | 개념의 무엇을 | 왜 |
|---|---|---|
| VGR-01 (VGR-01-S1) | 0-8-1·0-8-5: 큰 매트 회전을 먼 쪽 바퀴(U5, 바늘을 지나는 X선 위)에 맡김 | 매트 끝에서 300 안의 홈에서는 회전 일부(V30 꼭짓점 ROT −40→−75 35°, 입구2 −75→−30 45°, U홈 CYCLE_G1 바닥 마지막 69°) 동안 X선이 매트 끝으로 빠진다. d₂ 420~1800 어디서도 U5가 매트 밖이고(d2scan), d₂ < 420 자리에는 U4 묶음(X −330~−50)이 있다. 그 구간은 U4 혼자 돌려야 하는데 40 N × μ0.4 × d₁ 0.1 = 1.60 N·m, 구름 저항 2.80 N·m(정적 SF 0.57). 자국 한도 51.6 N(C-03)까지 눌러도 2.06 N·m(SF 0.74). d₂ 440으로 구간을 줄일 수는 있지만 없애지 못한다 |

개념을 고치는 것은 사용자다(E-02). 결정 D-154는 6절.

## 2. 사용자 자료 대기

| 무엇 | 사용자가 줄 것 | 구동을 막나 |
|---|---|---|
| 재봉 헤드 기종 D-10(C-25), 아랫축 실치수 D-143 | 견적 뒤 기종·STEP·아랫축 치수 | 아니오 |
| 납품처 안전 기준 D-38 | 안전 기준 문서 | 아니오 |
| 실제 좁은 V홈·U홈 치수 D-02·D-03 | 가장 좁은 홈 매트 실측(각도·바닥 반경·폭) | 아니오 |
| KC-40340 인장 래치 STEP D-121 | 제조사 확인 또는 STEP | 아니오 |
| F39-LSGF 라이트 커튼 금구 STEP D-135 | 옴론 CAD(로그인 필요하면 사용자) | 아니오 |
| 2400.05.12PZ igus 체인 끝 브래킷 D-115 | igus 형번 확정·STEP | 아니오 |

## 3. 구매품 CAD 사이트 로그인

| 사이트 | 상태 | 로그인 문제로 못 받은 형번 |
|---|---|---|
| 미스미 | 확인 못 함(봇 확인 페이지) | 없음(기록 없음) |

## 4. 남은 것

| 칸 | 수 | 항목 |
|---|---|---|
| 열린 구동 과제 | 1 | VGR-01(개념 재검토, D-154) |
| 구동 후보 | 1 | DC-01 |
| 동작 문제(회귀) | 0 | — |
| 디테일 | 0 | — |
| STEP대기(형번 정해짐) | 2 | STEP대기_SCXW46-14-15(D-143), STEP대기_PSCS16 ×4(D-147) — STEPWAIT 진전 없음 |

### 구동 후보

| id | 종류 | 무엇 | 어디 | 근거 | 제안 |
|---|---|---|---|---|---|
| DC-01 | 구동 위치 | 매트 끝 300 안 홈 바닥 회전 중 U5가 매트 밖으로 나가 U4 혼자 돌려야 하는데 회전력이 모자람. FUNC-01 ⑥은 이 구간을 따로 보지 않음 | U4_WHEEL_N ↔ MAT_G. CYCLE_G1 321단계(ROT −21°)부터 U5_LIFT 30, 바닥 마지막 69°. V홈은 꼭짓점 35°·입구2 45°(d₂ 440) | SF 정적 0.57, 자국 한도 0.74, 가속(4 s) 0.43~0.46. SF 1 조건: U4 70.1 N(자국 한도 넘음) 또는 d₁ ≥ 0.136 m(51.6 N)·0.175 m(40 N) 또는 구름 저항 ≤ 0.0285. tools/out/mech_VGR-01/design/vcalc.json, mech_VGR-01_measure.md | D-154로 VGR-01 ③과 함께. 점검부 추천 (가) d₁ ≥ 175. FUNC-01 ⑥ 판정에 이 구간을 더해 고쳐 적음 |

### 전체 회귀가 못 본 범위 (WF-153)

| 범위 | 이유 |
|---|---|
| MAINT_U7 3·6·9·12 | 오류(패닉 471 s, 4회 연속) |
| POSE 0·4·6·7·8·11~14 | 한 단계가 호출 상한을 넘김 |
| POSE 2·10 | 오류 단계 |
| POSE 16·17·20·45~129·131·134·141~153·156~180 | 전체 상한 |
| F_STATES 0~34 전 유닛 | 명세에서 뺌(시작 전) |
| POSE 133·135·136·138·139·140·154·155 | 명세에서 뺌(v2.8.2에서 봄) |
| MAINT_U7 1·2·4·5·7·8·10·11·13 | 명세에서 뺌 |
| 연구 조밀(10단계 사이) CYCLE_L 644·S 405·G1 462·G2 567·SEAM_U7 24단계 | 명세에서 뺌 |

## 5. 라운드

| 라운드 | 과제 | 결과 | 출력 토큰 | 시간 | 최종 보고 |
|---|---|---|---|---|---|
| 1 | F01-C1 | 끝남 — v2.8.3 저장(3D_Modeling/FSAP_v2.8.3.sc) | 446,170(라운드) / 471,037(실행 전체) | 9,421 s(실행 전체, 21부서) | docs/reports/mechanism/final_mech_2026-11-09_F01-C1-VGR-01-STEPWAIT.md |
| 1 | VGR-01 | 개념 재검토(D-154) | | | 〃 |
| 1 | STEPWAIT | 진전 없음(STEP대기 2 남음) | | | 〃 |

부서별 시간·토큰: runs/mech_2026-11-09_F01-C1-VGR-01-STEPWAIT/summary.json. 디테일링: 하지 않음(구동 미완, 규칙 13).

## 6. 사용자 결정

| id | 무엇 | 선택지 |
|---|---|---|
| D-154 | VGR-01-S1·DC-01: 매트 끝 300 안 회전에서 U4 혼자 회전력 부족 | (가) d₁ 100 → ≥ 175 — U4 묶음 전체 이동(구조 변경, 점검부 추천) / (나) 먼 쪽 바퀴가 회전 중 X선 밖(Y로 비킨 자리)도 잡게 — 0-8-1 변경 / (다) 볼 유닛 구름 저항 ≤ 0.02 선정 조건 + 회전 ≥ 6 s(SF 1.05~1.12, 실측 필요) |

## 사람이 할 일

| 할 일 | 이유 |
|---|---|
| D-154 선택 | 구동 개념 변경은 사용자 결정(E-02) |
| 미스미 로그인 상태 확인(봇 확인 페이지 통과) | 자동으로 넘기지 않음 |
| 2절 자료 제공 | 사용자 자료로만 풀림 |
