hyeunung/FSAP/docs/reports/queue_2026-11-08_5.md

# 과제 목록: 구동 라운드 5회차 (2026-11-09, 엔진 v3.9.3)

- 기준 모델: `3D_Modeling/FSAP_v2.8.2.sc` (tools/config.json doc). 지시문의 "최신 v2.6.5"는 지난 기록이다. v2.6.7(REG-02)·v2.6.8(STEPSWAP)·v2.7.0(MOT-01)·v2.8.0~v2.8.1(FUNC-01)·v2.8.2(COLOR-01)가 그 뒤에 저장됐다.
- STEP대기_ 목록: BOM `docs/bom/FSAP_v2.8.2_purchased.csv`의 '모델 바디' 칸에서 읽었다(PM은 CAD를 열지 않음. 이 파일은 v2.8.2 모델링부가 모델 목록으로 만든 것).
- 구매품 CAD 사이트 로그인: **풀림**(지난 라운드 결과 login 값). 사용자가 2026-11-08 미스미에 다시 로그인했다고 했으므로 라운드 시작 STEP 재시도가 받기 전에 화면 머리로 다시 확인한다.
- REG-02: 해결(v2.6.7, 결정로그 C-34 — J_U6_HGT·J_U7_HGT 한 높이 조정, POSE 8 정의에서 뺌). 사용자의 "가장 이상적인 방향"은 이 C-34로 이미 반영돼 있다. 다시 넣지 않는다.
- REG-01·RGSEE: 해결(확인). 지난 라운드 전체 회귀는 regression_ok, 본 범위 겹침 0. 못 본 범위는 라운드 끝 전체 회귀(regrun, 상한 30분, RGSEE-C2)가 본다. 같은 이유로 다시 넣지 않는다(WF-123).
- MOT-01·FUNC-01: '일부(완료 판정 미달)' — 구동은 끝났고 남은 미달(MOT-01-D1·D2, F01-D1~D8)은 디테일링 몫(E-02, WF-169). 다시 넣지 않는다.
- LITE: 넣지 않음. runstats 가장 긴 열기 711 s(회귀) > 240 s이나 LITE는 이미 한 번 함(v2.6.5, 요구서 5절) — "한 번 했는데도 넘으면 다시 넣지 않는다".
- 서보(지시 f): BOM v2.8.2에서 MHMF022L1U2M·MHMF042L1U2M는 이미 C-36으로 HG-KR23 ×3·HG-KR43 ×1 실물 STEP으로 바뀌어 있다. MSMF 결정은 더 이상 모델을 막지 않는다.

## 1. 과제 표 (순서 E-02)

| id | 제목 | 유닛 | 등급 | 출처 | 합격 기준 |
|---|---|---|---|---|---|
| STEPWAIT | STEP대기 재시도: SCXW46-14-15 (+ PSCS16·AS2201F-01-06SA 미스미 표기 확인) | U3 아랫축 커플링, U5 플로트 | S | STEP 대기 | 형번 정해진 STEP대기_ 중 받은 것 0 남음, 교체 뒤 과제 범위 간섭 0, BOM·자료대기 반영 |

- SCXW46-14-15: `STEP대기_SCXW46-14-15` Ø46×44, X 368~412·축 (Y 0, Z −90)(D-143, v2.7.0). 지난 라운드 로그인 풀림으로 못 받음, step_wait.json waiting에 없음 → 재시도.
- PSCS16(형번 임시, D-147): `STEP대기_PSCS16_F01_HANG_N/P`·`_TOP_N/P` Ø32/Ø16 t12, U5_FLOAT. 미스미 고정 칼라 Ø16 t12 표기를 찾아 정해지면 받는다.
- AS2201F-01-06SA(후보, D-148): 바디 없음(지금 이음 자리). 받으면 그 자리에 넣는다.
- 형번 미정 STEP대기_(볼 D-96·레벨러 D-119·D-128·인서트 D-125·멈춤나사·너트·와셔 D-127·스터드·너트 D-142·스프링 D-149·S-M5-2 D-122)는 형번이 정해지지 않아 세지 않는다(디테일링에서 형번 확정).

## 2. open 표

| 항목 | 수 | 내용 |
|---|---|---|
| 열린 구동 과제 | 0 | 요구서 5절 구동 행 모두 해결 또는 '일부'(디테일 몫) |
| 구동 후보 | 0 | DC2-01~08·REG-01·RGSEE·LITE·COLOR-01 해결, 지난 라운드 새 후보 없음 |
| 동작 문제(회귀) | 0 | REG-02 해결(C-34), 지난 라운드 regression_ok·본 범위 겹침 0 |
| 디테일 | 0 | 구동 라운드 중 0으로 둠 |
| STEP대기(형번 정함, 재시도 전) | 1 | SCXW46-14-15 (STEPWAIT) |

## 3. user_wait 표

| 항목 | 사용자가 줄 것 | 구동을 막나 |
|---|---|---|
| 재봉 헤드 기종 D-10(C-25) — STEP대기_867-392342_UPPER·_NOSE·_LOWER, 아랫축 축선·지름(D-143) | 견적 뒤 기종·STEP·머리판·아랫축 실치수 | 아니오(867 PDF 임시 형상) |
| 납품처 안전 기준 D-38 | 안전 기준 문서 | 아니오 |
| KC-40340 인장 래치 STEP (D-121) | 제조사 확인 또는 STEP | 아니오 |
| F39-LSGF 라이트 커튼 금구 STEP (D-135) | 옴론 CAD(로그인 필요 시 사용자) | 아니오 |
| 2400.05.12PZ igus 체인 끝 브래킷 (D-115) | igus 형번 확정·STEP | 아니오 |
| 미스미 로그인 상태 | 풀렸으면 재로그인(사용자) | 아니오(풀리면 임시 형상 유지) |
