hyeunung/FSAP/docs/reports/queue_2026-11-09_1.md

# 과제 목록: 구동 라운드 1회차 (2026-11-09, 엔진 v3.9.3)

- 기준 모델: `3D_Modeling/FSAP_v2.8.2.sc`(tools/config.json doc). 스케치 전부 숨겨 같은 이름으로 저장됨, 형상 변화 없음. PM은 CAD를 열지 않았다. STEP대기_ 목록은 BOM `docs/bom/FSAP_v2.8.2_purchased.csv`의 모델 바디 칸으로 읽었다(안내서 '목록·볼트 집계'의 BOM 경로).
- 지난 라운드 결과(JSON): 없음(이번 실행 첫 라운드).
- 새 구동 과제 VGR-01(요구서 5절, 미해결)과 FUNC-01의 구동 후보 F01-C1을 넣는다.
- MOT-01·FUNC-01은 요구서 5절에서 '일부(완료 판정 미달)'다. 구동은 끝났고 남은 미달(MOT-01-D1·D2, F01-D1~D8)은 디테일링 몫이다(E-02, WF-169). 그래서 다시 넣지 않고 세지 않는다. 디테일링에서 완료 판정까지 이어 간다.
- STEPWAIT: 모델에 형번이 정해진 `STEP대기_SCXW46-14-15`(D-143)와 `STEP대기_PSCS16_F01_*` ×4(D-147)가 있다. 둘 다 `tools/out/step_wait.json` waiting에 없다(waiting은 v2.6.8 때 목록이다. MHMF·VRXF는 C-36에서 이미 실물로 바뀌었다). 그래서 STEPWAIT를 넣는다. `purchased-step/`·PartsLibrary에는 SCXW46-12-19·SCXW46-15-19만 있다.
- LITE: 넣지 않음. runstats '가장 긴 열기'는 764 s(회귀)로 240 s를 넘지만, LITE는 이미 한 번 했다(v2.6.5). 한 번 했는데도 넘으면 다시 넣지 않는다.
- 회귀 동작 문제: 0. 지난 회귀가 못 본 범위는 회귀 실행기 문제다(무거운 자세 호출이 470 s를 넘김, WF-210). 이번 라운드 끝 전체 회귀는 470 s 넘는 점(POSE 130·132·137, CYCLE_L 106)의 against를 나눠 본다(지시 g).
- 커버·외장은 넣지 않음(규칙 14).

## 1. 과제 표 (순서 E-02)

| id | 제목 | 유닛 | 등급 | 출처 | 합격 기준 |
|---|---|---|---|---|---|
| F01-C1 | 작업 대상 모형 땀–가장자리 거리 e 0 → 6.5 | 작업 대상(WP_L·S·G), U3·U6·U7 관계 | M | 구동 후보 | 매트 3장 모형 가장자리가 바늘 +X 6.5(D-144). 연구 CYCLE_L·S·G1·G2·SEAM_U7을 옮긴 모형에 맞춤. 과제 범위 간섭 0. 회귀 기준선(baseline_overlaps) 갱신. machine.json 갱신 |
| VGR-01 | 좁은 V자 홈 검증 | U3 바늘 둘레 묶음·U4·U5·U6·U7, 작업 대상 V홈 매트 | L | 요구서 과제 | V홈 시험 매트(불리한 가정 D-번호, e 6.5): ① 입구·꼭짓점·출구에서 바늘을 꽂고 회전하는 동안 과제 범위 간섭 0, 반대 벽과 틈 > 0 ② 꼭짓점에서 남는 테이프 날개(r0 꺾임당 약 15.7) 처리 방법을 기구·순서로 정하고 손계산(여유율), 결정로그에 기록 ③ 바늘 옆 바퀴 들기, 먼 쪽 바퀴 방향 유지 힘 SF ≥ 1(FUNC-01 ⑥ 방식). 실제 주름은 7절 |
| STEPWAIT | STEP대기 재시도: SCXW46-14-15, PSCS16, AS2201F-01-06SA, 스프링 | U3 아랫축 커플링, U5 플로트 | S | STEP 대기 | 받은 형번의 STEP대기_ 0. 교체 뒤 과제 범위 간섭 0. BOM·자료대기(D-143·D-147·D-148·D-149) 반영. step_wait.json을 v2.8.2 BOM 기준으로 다시 씀 |

- F01-C1 근거: `mech_FUNC-01_design.md` 151행, `mech_FUNC-01_calc.md` 101행. 지금 모형(D-78 e 0)은 바늘이 접힘선에 꽂혀 테이프가 감기지 않는 자리다. VGR-01 V홈 매트도 e 6.5로 만들어야 하므로 F01-C1을 먼저 한다(발자국이 겹쳐 직렬).
- VGR-01 근거: 요구서 0-2·1-1, 5절 VGR-01, D-02·D-03(U홈만 있음, V 각도·바닥 반경 실측 없음 → 새 D-150~: 좁은 각도·작은 바닥 반경의 불리한 가정, 근거 문헌·사진). 새 작업 대상 WP_V(MAT_V·TAPE_V·SEAM_V), 조인트 J_WP_V_X·Y·ROT(모형용), 새 연구(예: CYCLE_V). 모서리 절차는 0-8-1(바늘 꽂고 → 노루발 들기 → 바퀴로 바늘 중심 회전 → 재개), 테이프 날개 15.7은 T05 계산(D-03).
- STEPWAIT: 받기 전 `PartsLibrary/index.csv`를 먼저 본다. 미스미 화면 머리에서 로그인을 확인하고, 풀려 있으면 임시 형상을 유지한다. 봇 확인 페이지는 넘기지 않는다. SCXW46 14–15 구멍 조합이 없으면 같은 사양의 미스미 표기를 자료대기에 적는다. AS2201F는 지금 바디가 없으니 받으면 U5 승강 실린더 이음 자리에 넣는다. 스프링은 형번부터 정해야 한다(D-149, 특주 가능).

## 2. open 표

| 항목 | 수 | 내용 |
|---|---|---|
| 열린 구동 과제 | 1 | VGR-01 |
| 구동 후보 | 1 | F01-C1 |
| 동작 문제(회귀) | 0 | 회귀 18까지 본 범위에서 새 겹침 0. 못 본 범위는 라운드 끝 회귀가 본다 |
| 디테일 | 0 | 구동 라운드 중이라 0으로 둠(MOT-01-D1·D2, F01-D1~D8 등은 디테일링 몫) |
| STEP대기(형번 정함, 재시도 전) | 2 | SCXW46-14-15, PSCS16 (AS2201F는 바디가 없고 스프링은 형번 미정이라 세지 않음) |

## 3. user_wait 표

| 항목 | 사용자가 줄 것 | 구동을 막나 |
|---|---|---|
| 재봉 헤드 기종 D-10(C-25), 아랫축 실치수 D-143 | 견적 뒤 기종·STEP·아랫축 치수 | 아니오(867 PDF 임시 형상) |
| 납품처 안전 기준 D-38 | 안전 기준 문서 | 아니오 |
| 실제 V홈·U홈 치수 D-02·D-03(VGR-01) | 가장 좁은 홈 매트 실측(각도·바닥 반경·폭) | 아니오(불리한 가정 임시값) |
| KC-40340 인장 래치 STEP (D-121) | 제조사 확인 또는 STEP | 아니오 |
| F39-LSGF 라이트 커튼 금구 STEP (D-135) | 옴론 CAD(로그인 필요하면 사용자) | 아니오 |
| 2400.05.12PZ igus 체인 끝 브래킷 (D-115) | igus 형번 확정·STEP | 아니오 |

- 미스미 로그인: step_wait.json 값은 '확인 못 함'이다. 이번 실행 지시에는 사용자가 2026-11-09 다시 로그인했다고 적혀 있다. 구매부가 받기 전에 화면 머리로 확인한다.
- step_wait.json의 MHMF022/042·VRXF-PB-60-10은 C-36에서 HG-KR·PGX62 실물로 바뀌어 모델에 없다. 그래서 대기에서 뺀다.

## 워크플로우 메모

- step_wait.json이 v2.6.8 목록(이미 바뀐 MHMF·VRXF 포함) 그대로다. 그런데 source 문구는 'v2.8.2 BOM'이라 최신처럼 보인다. 재시도 단계는 config doc의 BOM으로 목록을 다시 만들어야 한다(지난 실행 5~7회차 반복).
