hyeunung/FSAP/docs/reports/final_full_2026-11-08.md

# 전체 최종 보고 — 2026-11-08 실행 (엔진 v3.9.3)

**상태: 미완 — 같은 과제(STEPWAIT)가 세 라운드를 돌아도 안 풀림 — 진전 없음**

- 최신 설계: `3D_Modeling/FSAP_v2.8.2.sc` (tools/config.json doc)
- REG-02(POSE 8 겹침): 결정로그 C-34대로 J_U6_HGT·J_U7_HGT를 한 높이 조정으로 묶어 v2.6.7에서 처리.

## 1. 사용자 자료 대기

| 무엇 | 사용자가 줄 것 | 구동을 막나 |
|---|---|---|
| 재봉 헤드 기종 D-10(C-25), 아랫축 실치수 D-143 | 견적 뒤 기종·STEP·아랫축 치수 | 아니오 |
| 납품처 안전 기준 D-38 | 안전 기준 문서 | 아니오 |
| KC-40340 인장 래치 STEP D-121 | 제조사 확인 또는 STEP | 아니오 |
| F39-LSGF 라이트 커튼 금구 STEP D-135 | 옴론 CAD(로그인 필요 시 사용자) | 아니오 |
| 2400.05.12PZ igus 체인 끝 브래킷 D-115 | igus 형번 확정·STEP | 아니오 |
| 서보 MSMF 대체 여부 | 사용자 결정 | 아니오 |
| 미스미 로그인 상태 | 재로그인(사용자) | 아니오 |

## 2. 구매품 CAD 사이트 로그인

| 사이트 | 상태(2026-11-09 Chrome 새 탭 확인) |
|---|---|
| 미스미(kr.misumi-ec.com) | **풀림** — 머리에 '로그인 / 회원가입' 표시 |

로그인 문제로 못 받은 형번:

| 형번 | 쓰는 곳 | 지금 |
|---|---|---|
| SCXW46-14-15 | U3 아랫축 커플링(D-143) | STEP대기_ 임시 형상 |
| PSCS16(형번 임시) ×4 | U5 플로트 고정 칼라(D-147) | STEP대기_ 임시 형상 |
| AS2201F-01-06SA | U5 승강 실린더 이음(D-148) | 바디 없음 |
| SPRING_d1.6_OD44_L132(형번 미정) | U5 플로트 스프링 | STEP대기_ 임시 형상 |

5~7회차 STEPWAIT는 낡은 step_wait.json(v2.6.8 목록)을 다시 써서 받기 시도가 0이었다. 다음 STEPWAIT는 `docs/bom/FSAP_v2.8.2_purchased.csv`로 목록을 새로 만든다.

## 3. 남은 것

| 칸 | 수 | 항목 |
|---|---|---|
| 열린 구동 과제 | 0 | — |
| 구동 후보 | 0 | — |
| 동작 문제(회귀) | 0 | — |
| 디테일 | 0 | 디테일링은 아직 돌지 않음 |
| STEP대기 | 2 | SCXW46-14-15, PSCS16 (+ AS2201F-01-06SA 바디 없음) |

### 전체 회귀가 못 본 범위 (마지막 라운드 7 기준, WF-153)

| 이유 | 범위 |
|---|---|
| 오류·호출 상한(데운 세션에서도 470 s 넘김) | POSE.H 130 H0~H2, 132 H0~H2, 137 H1; CYCLE_L 106 H1; POSE 1; MAINT_U7 3; F_STATES U7_TAPE#4/8 0 |
| 전체 상한·세션 부족 | MAINT_U7 6·9·12·13; F_STATES 0~3 남은 칸(U3·U4·U5·U7#0~#7 일부) |
| 어림 초과(시작 전) | F_STATES 4~34 전 유닛; MAINT_U7 1·2·4·5·7·8·10·11; POSE 15~21·23~41·43~123·125·128·129·134; 연구 조밀 CYCLE_L 646·CYCLE_S 426·G1 488·G2 598·SEAM_U7 24단계 |

v2.8.1(FUNC-01)·v2.8.2(COLOR-01) 뒤 바뀐 유닛(U3·U5·U7·U8)의 POSE·연구 전 구간은 아직 다시 보지 못했다.

## 4. 라운드별 결과

| 라운드 | 과제 | 결과 | 설계 파일 | 출력 토큰 | 최종 보고 |
|---|---|---|---|---|---|
| 1 | STEPWAIT·REG-02·REG-01 | REG-02 처리, REG-01 이미 해결(확인) | v2.6.7 | 516,026 | docs/reports/mechanism/final_mech_2026-11-08_STEPWAIT-REG-02-REG-01.md |
| 2 | RGSEE | 이미 해결(확인) | — | 89,220 | docs/reports/mechanism/final_mech_2026-11-08_RGSEE.md |
| 3 | STEPWAIT | STEPSWAP 처리 | v2.6.8 | 232,060 | docs/reports/mechanism/final_mech_2026-11-08_STEPWAIT.md |
| 4 | MOT-01·FUNC-01·COLOR-01 | MOT-01·FUNC-01 일부(판정 미달, FUNC-01 M→L), COLOR-01 처리 | v2.7.0·v2.8.1·v2.8.2 | 1,450,869 | docs/reports/mechanism/final_mech_2026-11-08_MOT-01-FUNC-01-COLOR-01.md |
| 5 | STEPWAIT | 결과 없음(받기 시도 0) | — | 62,217 | docs/reports/mechanism/final_mech_2026-11-08_STEPWAIT_2.md |
| 6 | STEPWAIT | 결과 없음 | — | 56,700 | docs/reports/mechanism/final_mech_2026-11-08_STEPWAIT_3.md |
| 7 | STEPWAIT | 결과 없음 | — | 66,208 | docs/reports/mechanism/final_mech_2026-11-08_STEPWAIT_4.md |
| 합계 | | | | 2,473,300 | |

부서별 시간·토큰: `runs/<실행>/summary.json` (예: runs/mech_2026-11-08_STEPWAIT).

## 5. 사용자 결정

| 결정 | 선택지 | 막는 것 |
|---|---|---|
| 서보 MHMF022L1U2M·MHMF042L1U2M → 미스미 MSMF 대체 | 대체 / 유지(파나소닉 CADENAS) | STEP 교체만 |
| 대차 벨트 재질 HTBO(폴리우레탄) vs HTBOG(고무) | 기본값 폴리우레탄 유지 / 변경 | 없음 |
| 특허 KR102139457B1 변리사 확인(D-102) | — | 없음 |

## 6. 사람이 할 일

| 할 일 | 이유 |
|---|---|
| 미스미 재로그인 | 2026-11-09 확인 시 풀려 있음 — STEPWAIT 3형번이 이것 때문에 못 받음 |
| 재봉 헤드 견적·기종 확정(D-10, D-143) | 헤드·아랫축 실물 치수 |
| 납품처 안전 기준 문서(D-38) | 외장·안전 단계 |
| KC-40340·F39-LSGF·2400.05.12PZ STEP 확보 | 사이트 로그인·제조사 확인 필요 |
