hyeunung/FSAP/docs/reports/queue_2026-11-08_4.md

# 과제 목록: 구동 라운드 4회차 (2026-11-09, 엔진 v3.9.3)

- 기준 모델: `3D_Modeling/FSAP_v2.6.8.sc` (tools/config.json doc)
- 구매품 CAD 사이트 로그인: 확인 못 함 (지난 라운드 결과 login 값. 사용자는 2026-11-08 미스미 재로그인했다고 함, 라운드 끝 최종 보고가 Chrome으로 다시 확인)
- REG-02: 해결(v2.6.7, 결정로그 C-34 — J_U6_HGT·J_U7_HGT 한 높이 조정, POSE 8 정의에서 뺌). 다시 넣지 않는다.
- REG-01·RGSEE: 해결(확인). 회귀 못 본 범위는 라운드 끝 전체 회귀(regrun, 상한 30분, RGSEE-C2)가 본다. 같은 이유로 다시 넣지 않는다(WF-123).
- LITE: 넣지 않음. runstats 가장 긴 열기 594 s(회귀) > 240 s이나 LITE는 이미 한 번 함(v2.6.5, mech_LITE_model.md) — "한 번 했는데도 넘으면 다시 넣지 않는다".
- STEPWAIT: 넣지 않음. 형번이 정해진 STEP대기_ 중 MHMF022L1U2M·MHMF042L1U2M·VRXF-PB-60-10은 C-36으로 HG-KR23·HG-KR43·PGX62-H-10으로 바꾸고 STEP을 받아 둠(purchased-step·PartsLibrary 2026-11-09) → MOT-01에서 실물 교체. 나머지(KC-40340·F39-LSGF·2400.05.12PZ)는 step_wait.json waiting에 not_found(사이트에 없음) → 사용자 자료 대기. 형번 미정 STEP대기_(볼·레벨러·인서트·와셔·너트·스터드)는 형번이 정해지지 않아 세지 않음.

## 1. 과제 표 (순서 E-02)

| id | 제목 | 유닛 | 등급 | 출처 | 합격 기준 |
|---|---|---|---|---|---|
| MOT-01 | 모터·감속기 체결 빠짐 + 서보·감속기 C-36 실물 교체 | U3(아랫축)·U4·U5 | M | 요구서 과제 | STEP대기_MHMF·VRXF 0, 구동기 체결 자리 빈 구멍·빈 탭 0, 물림 ≥ 엔진 기준, 공구 닿음, 과제 범위 간섭 0, BOM 반영 |
| FUNC-01 | 기능 이론 검증(①~⑦) + 바인더 실제 접는 형상 | U3·U4·U5·U6·U7 | M | 요구서 과제 | ①~⑦ 성립(여유율 수치)·근거·가정 D-번호, 불성립 0(고친 뒤), 바인더 형상 모델에, 과제 범위 간섭 0 |
| COLOR-01 | 모델 색 통일(체결 부품 흑색 금지) | 전체(모델 표현) | S | 구동 후보 | 색표 밖 색 바디 0(구매품 원색 예외 목록), 체결 부품 흑색 0, 형상·BOM·바디 수 변화 0 |

동시 묶음: MOT-01과 FUNC-01은 U4 바퀴 축(속도 동기 ③이 HG-KR23·PGX62-H-10 형번에 기댐)이 겹쳐 MOT-01 먼저. COLOR-01은 전체 바디를 건드려 마지막에 직렬.

## 2. open 표

| 항목 | 수 | 내용 |
|---|---|---|
| 열린 구동 과제 | 2 | MOT-01, FUNC-01 |
| 구동 후보 | 1 | COLOR-01 |
| 동작 문제(회귀) | 0 | REG-02 해결(C-34), 지난 라운드 regression_ok, 기준선 밖 새 겹침 0 |
| 디테일 | 0 | 구동 라운드 중 0으로 둠 |
| STEP대기(형번 정함, 재시도 전) | 0 | MHMF·VRXF는 MOT-01 안 |

## 3. user_wait 표

| 항목 | 사용자가 줄 것 | 구동을 막나 |
|---|---|---|
| 재봉 헤드 기종 D-10(C-25) — STEP대기_867-392342_UPPER·_NOSE·_LOWER | 견적 뒤 기종·STEP·머리판 실치수 | 아니오(867 PDF 임시 형상) |
| 납품처 안전 기준 D-38 | 안전 기준 문서 | 아니오 |
| KC-40340 인장 래치 STEP (D-121) | 제조사 확인 또는 STEP | 아니오 |
| F39-LSGF 라이트 커튼 금구 STEP (D-135) | 옴론 CAD(로그인 필요 시 사용자) | 아니오 |
| 2400.05.12PZ igus 체인 끝 브래킷 (D-115) | igus 형번 확정·STEP | 아니오 |
| 미스미 로그인 상태 | 풀렸으면 재로그인(사용자) | 아니오 |
