hyeunung/FSAP/docs/reports/queue_2026-11-08_2.md

# 과제 정리 — 구동 라운드 2회차 앞 (2026-11-08 실행, 엔진 v3.9.3)

대상: `3D_Modeling/FSAP_v2.6.7.sc`(tools/config.json doc). CAD는 열지 않았다. 형번 목록은 BOM `docs/bom/FSAP_v2.6.7_purchased.csv`의 `STEP대기_` 행으로 읽었다. 이 BOM은 원장(2,660바디)과 맞춰 본 것이다(mech_drive_check.md). 모델·문서는 고치지 않았다.

## 요약
- **다음 구동 라운드 과제 0개.**
- 요구서 5절에서 구동·브래킷·구동 후보 행은 모두 '해결'이다. M00~M08, M04R, M08R, DC2-01~08, REG-01·REG-02, STEPSWAP, LITE가 여기에 든다.
- 구동 후보 점검(mech_drive_check.md, v2.6.7)에서 새 후보는 0개였다.
- 지난 라운드 결과
  - REG-02: 완료(v2.6.7)
  - REG-01: 이미 해결된 것을 확인
  - regrade 없음, serial_next 없음
- 라운드 끝 전체 회귀(mech_regression_12.md): 동작 문제 0, 외부 조건 문제 0. **못 본 범위가 남았다**(아래 표).
  - 이 범위는 E-17·E-24에 따라 다음 라운드의 회귀가 먼저 본다.
  - `full_run`이 확인 과제 RGSEE로 만든다(L1 E-24 "못 본 범위만 남았으면 확인 과제(RGSEE…)를 만들어").
  - 그래서 여기서 REG-01을 다시 넣지 않았다. 같은 이유로 막힌 과제를 다시 넣지 않는다는 규칙(WF-123)도 따랐다.
- LITE는 넣지 않았다(WF-196). runstats의 가장 긴 열기는 594초(회귀)로 240초를 넘었다. 그러나 LITE는 이미 한 번 했다(mech_2026-11-06_LITE-STEPWAIT-REG-01, v2.6.5). 한 번 했는데도 넘으면 다시 넣지 않는다.
- STEPWAIT는 넣지 않았다. 형번이 정해진 `STEP대기_` 6형번이 모두 `tools/out/step_wait.json`의 waiting에 있다. 이유는 사이트 로그인이거나 사이트에 없는 것이라서 user_wait로 보냈다.
  - 형번이 '미정·임시'인 것은 STEP 대기로 세지 않는다. 형번 확정은 디테일·구매 몫이다. 해당: BALL-D25.4, LEVELER-M8 ×2종, S-M5-2, M3 인서트, DC2-04·REG-02 멈춤나사·너트·와셔·스터드.
  - 867 헤드는 D-10(기종 미정)이다.
- 미스미·CAD 사이트 로그인: **확인 못 함**(지난 라운드 결과 login).
  - 사용자는 2026-11-08에 미스미에 다시 로그인했다고 했다. 하지만 지난 최종 확인 때는 봇 확인 페이지가 떠서 상태를 볼 수 없었다.

## 과제 표

| id | 과제 | 출처 | 등급 | 직렬 |
|---|---|---|---|---|
| (없음) | — | — | — | — |

## open 표

| 항목 | 수 | 근거 |
|---|---|---|
| 열린 구동 과제 | 0 | 요구서 5절 구동 행 모두 해결 |
| 구동 후보 | 0 | mech_drive_check.md(v2.6.7) |
| 회귀 동작 문제 | 0 | mech_regression_12.md: 기준선 밖 겹침 0 |
| 디테일 | 0 | 구동 라운드 중이라 0으로 둠 |
| 형번이 정해졌는데 STEP대기_ | 0 | 6형번 모두 waiting(로그인·사이트에 없음) → user_wait |

참고: 못 본 범위는 동작 문제가 아니지만 완료(1차 완료 = 못 본 범위 0)를 막는다.

| 못 본 범위(다음 회귀가 먼저) |
|---|
| POSE 전체 검사 0-7·12-180 |
| 연구 전체 검사 CYCLE_L 23-716, CYCLE_S 0-450, CYCLE_G1 0-514, CYCLE_G2 0-630, SEAM_U7 0-32, MAINT_HEAD 0-1, MAINT_U7 0-13 |
| F_STATES U6_SENSOR·U6_SHOE·U7#0~#4/8 12-34, U7#5~#7/8 11-34 |
| F_STATES U3_HEAD·U4_WHEEL_N 1-34, U5_WHEEL_F 0-34 |

## user_wait 표

| 항목 | 사용자가 줄 것 | 구동을 막나 |
|---|---|---|
| 재봉 헤드 기종 D-10(STEP대기_867-392342_UPPER·NOSE·LOWER) | 분리형 3중 이송 헤드 기종 확정·견적·STEP(C-25) | 아니오(867 PDF 임시 형상) |
| 서보 MHMF022L1U2M ×3 (·MHMF042 계열) D-111·D-112·D-115 | 미스미 MSMF로 대체할지 결정, 아니면 파나소닉 CADENAS 가입(규칙 11 금지) | 아니오(□60×L80 임시) |
| 감속기 VRXF-PB-60-10 ×3 D-113 | 니덱 CAD STEP(미스미 아님) | 아니오 |
| 정밀 레귤레이터 IR1000-01BG ×3 D-129·D-132 | SMC CAD STEP(미스미 CAD 없음) | 아니오 |
| 라이트 커튼 금구 F39-LSGF ×8 D-135 | 옴론 CAD STEP(미스미 미게재) | 아니오 |
| 인장 래치 KC-40340 D-121 | 제조사·STEP | 아니오 |
| igus 체인 끝 브래킷 2400.05.12PZ D-115 | igus 형번 확정·STEP | 아니오 |
| 납품처 안전 기준 D-38 | 납품처 안전 기준 | 아니오(외장·안전은 구동 뒤) |
| 미스미 로그인 상태 | 봇 확인 페이지가 아닌 상태로 로그인 유지(최종 확인 담당이 다시 봄) | 아니오 |

## 워크플로우 메모
- 과제 0개 + 못 본 범위만 남은 경우, 과제 정리부 지시문에는 '못 본 범위를 과제로 넣을지'가 없다. E-24는 full_run이 RGSEE를 만든다고 한다. 그래서 여기서는 넣지 않고 표로만 넘겼다.
- runstats의 가장 긴 열기 594초는 회귀 CLI 세션 12병렬에서 나왔다. 모델 무게(LITE)와 병렬 열기 경합을 runstats가 나눠 보이지 않는다.
