hyeunung/FSAP/docs/reports/queue_2026-11-08_3.md

# 과제 정리 — 구동 라운드 3회차 앞 (2026-11-09 실행, 엔진 v3.9.3)

대상은 `3D_Modeling/FSAP_v2.6.7.sc`(tools/config.json doc)다. CAD는 열지 않았다. 형번 목록은 원장 `tools/out/ledger.json`(2,660바디)과 BOM `docs/bom/FSAP_v2.6.7_purchased.csv`의 `STEP대기_` 행으로 읽었다. 모델과 문서는 고치지 않았다.

## 요약
- **다음 구동 라운드 과제는 1개(STEPWAIT)다.**
  - `IR1000-01BG` 실물 STEP이 2026-11-09 00:51에 들어왔다. 받은 곳은 한국SMC CAD System(CADENAS)이다. 파일은 `purchased-step/IR1000-01BG/IR1000-01BG.stp`이고 PartsLibrary `index.csv` 80행에도 올라 있다.
  - `tools/out/step_wait.json`(00:27)은 그보다 먼저 만들어져 이 형번을 아직 waiting(not_found)으로 적고 있다. 대기 이유가 없어졌으므로 이 형번은 '다시 받아 보지 않은 것'과 같이 보고 STEPWAIT로 넣는다. 라운드 시작 단계는 받지 말고, 이미 있는 파일로 바꿔 끼우기만 하면 된다.
- 요구서 5절의 구동·브래킷·구동 후보 행은 모두 '해결'이다. M00~M08, M04R, M08R, DC2-01~08, REG-01, REG-02, RGSEE, STEPSWAP, LITE가 여기에 든다.
- 구동 후보 점검(mech_drive_check.md, v2.6.7, 2026-11-09 재호출)에서 새 후보는 0개였다.
- 지난 라운드 결과
  - REG-02는 완료됐다(v2.6.7, C-34, REG02-E01). 틈 기준 ≥ 10은 '정적 틈 ≥ 2이고 겹침 0'으로 바뀌어 승인됐다.
  - REG-01과 RGSEE는 이미 해결된 것을 확인했다.
  - regrade와 serial_next는 없다.
- 회귀 동작 문제는 0이다(mech_regression_12). 회귀 13은 세션을 여는 중에 끊겨 새로 본 범위가 0이다. **못 본 범위가 남았다.**
  - 지난 라운드처럼 이 범위는 E-24에 따라 full_run의 확인 과제나 라운드 끝 regrun이 본다.
  - 같은 이유로 막힌 과제를 다시 넣지 않는다(WF-123). 그래서 REG-01과 RGSEE는 다시 넣지 않았다.
  - 회귀 13의 준비물(`tools/out/mech_regrun/reg15/spec15.json`)은 그대로 쓰면 된다.
- LITE는 넣지 않았다. runstats의 가장 긴 열기는 594초(회귀)로 240초를 넘지만, LITE는 v2.6.5에서 한 번 했다(WF-196 "한 번 했는데도 넘으면 다시 넣지 않는다").
- 구매품 CAD 사이트 로그인은 **확인 못 함**이다. 지난 라운드 결과 login과 step_wait.json login이 모두 '확인 못 함'이다.
  - 사용자는 2026-11-08에 미스미에 다시 로그인했다고 했다.
  - IR1000 STEP이 로그인이 필요한 SMC CAD에서 받아진 것으로 보아, 그 뒤 로그인 상태는 좋았던 것으로 보인다. 다만 이번 부서는 브라우저를 열지 않았다.

## 과제 표

| id | 과제 | 출처 | 등급 | 직렬 | 합격 기준 |
|---|---|---|---|---|---|
| STEPWAIT | `STEP대기_IR1000-01BG_M08_N/F/S`(+`_BRKT`) ×3 → 실물 STEP | STEP 대기 | M | 아니오 | 임시 6바디 → 실물 3개, 과제 범위 간섭 0, 게이지 시선 틈 다시 잼(M08-X6), BOM·자료대기 D-132 갱신 |

STEPWAIT 상세
- 개념 유닛은 U8 공압·안전(0-8-3, 보 앞판 레귤레이터 3개: 바퀴 N·F·슈)이다.
- 지금 임시 형상의 bbox(원장 기준)
  - N: X 686~714 · Y 47.6~117.6 · Z 475~565
  - F: X 786~814
  - S: X 886~914
  - 브래킷 3개(_BRKT): Y 117.6~119.9, Z 475~535
- 받은 STEP은 브래킷이 붙은 것이다. 그러니 임시 _BRKT 바디는 실물 브래킷으로 대신한다. 장착 구멍과 볼트 자리는 실물에 맞추고, 포트 피팅·관 길(KQ2 계열)도 실물 포트 방향에 따른다.
- 발자국 상자(여유 포함)는 X 660~940 · Y 30~140 · Z 460~580이다.

## open 표

| 항목 | 수 | 근거 |
|---|---|---|
| 열린 구동 과제 | 0 | 요구서 5절 구동 행이 모두 해결이다 |
| 구동 후보 | 0 | mech_drive_check.md(v2.6.7, 11-09 재호출) |
| 회귀 동작 문제 | 0 | mech_regression_12.md: 기준선 밖 겹침 0. 회귀 13은 새로 본 것 0 |
| 디테일 | 0 | 구동 라운드 중이라 0으로 둔다 |
| 형번이 정해졌는데 STEP대기_ | 1 | IR1000-01BG(STEP 있음 → STEPWAIT). 나머지 5형번은 user_wait |

참고로 못 본 범위는 동작 문제가 아니다. 그래도 완료(못 본 범위 0)를 막는다.

| 못 본 범위(다음 회귀가 먼저 본다) |
|---|
| POSE 전체 검사 0-7·12-180 |
| 연구 전체 검사 CYCLE_L 23-716, CYCLE_S 0-450, CYCLE_G1 0-514, CYCLE_G2 0-630, SEAM_U7 0-32, MAINT_HEAD 0-1, MAINT_U7 0-13 |
| F_STATES U6_SENSOR·U6_SHOE·U7#0~#4/8 12-34, U7#5~#7/8 11-34 |
| F_STATES U3_HEAD·U4_WHEEL_N 1-34, U5_WHEEL_F 0-34 |

## user_wait 표

| 항목 | 사용자가 줄 것 | 구동을 막나 |
|---|---|---|
| 재봉 헤드 기종 D-10(STEP대기_867-392342_UPPER·NOSE·LOWER) | 분리형 3중 이송 헤드의 기종 확정·견적·STEP(C-25) | 아니오(867 PDF 임시 형상) |
| 서보 MHMF022L1U2M ×3(·MHMF042 계열) D-111·D-112·D-115 | 미스미 MSMF로 바꿀지 결정. 아니면 파나소닉 CADENAS 가입이 필요한데, 가입은 규칙 11로 금지다 | 아니오(□60×L80 임시) |
| 감속기 VRXF-PB-60-10 ×3 D-113 | 니덱 CAD STEP(미스미 아님) | 아니오 |
| 라이트 커튼 금구 F39-LSGF ×8 D-135 | 옴론 CAD STEP(미스미 미게재) | 아니오 |
| 인장 래치 KC-40340 D-121 | 제조사와 STEP | 아니오 |
| igus 체인 끝 브래킷 2400.05.12PZ D-115 | igus 형번 확정과 STEP | 아니오 |
| 납품처 안전 기준 D-38 | 납품처 안전 기준 | 아니오(외장·안전은 구동 뒤) |
| 구매품 CAD 사이트 로그인 상태 | 최종 보고 담당이 새 탭으로 다시 확인한다. 봇 확인 페이지는 넘기지 않는다 | 아니오 |

## 워크플로우 메모
- step_wait.json(00:27)보다 늦게(00:51) 받은 STEP이 있었다. 그런데 waiting 목록이 갱신되지 않아, 지시문 규칙대로라면 user_wait로 빠질 뻔했다. 과제 정리부가 stepcheck(`purchased-step/<형번>/` 유무)를 step_wait.json보다 먼저 보게 하는 안이 회고 몫이다.
