hyeunung/FSAP/docs/reports/queue_2026-11-06_2.md

# 과제 정리: 구동 라운드 2회차 (엔진 v3.9.3, 2026-11-06)

요약
- 최신 저장본: `3D_Modeling/FSAP_v2.6.5.sc`(tools/config.json doc). 과제 정리부는 CAD를 열지 않았다. 'STEP대기_' 목록은 같은 저장본의 BOM `docs/bom/FSAP_v2.6.5_purchased.csv`로 읽었다. 구동 후보 점검부(`mech_drive_check.md`)의 lite_check 결과로 v2.6.4 → v2.6.5에서 구매품·배치가 그대로임을 확인했다.
- 요구서 5절: 구동 과제 M00~M08·M04R·M08R, 구동 후보 DC2-01~DC2-08·LITE·STEPSWAP은 모두 해결이다. 남은 것은 두 가지다.
  - **REG-01**(구동 후보, 전체 회귀 못 본 범위): 미해결.
  - **REG-02**(동작 문제, POSE 8 GUIDE↔CARR): 사용자 결정 대기.
- 지난 라운드 결과
  - LITE 완료(v2.6.5). REG-01 '모델링 안 됨'(읽기 전용 회귀, 막힌 것은 아니고 범위가 늘었다).
  - regrade·serial_next 없음. 그래서 등급 재조정·직렬 복귀 과제는 없다.
- **LITE(모델 무게):** runstats 가장 긴 열기 493 s는 지난 실행 기록 값이다. 지난 라운드 history에 LITE가 있어 다시 넣지 않는다(열기 242 → 약 100 s).
- **STEPWAIT:** 넣지 않는다.
  - 형번이 정해진 `STEP대기_` 구매품은 모두 `tools/out/step_wait.json` waiting에 있다: MHMF022L1U2M, VRXF-PB-60-10, IR1000-01BG, F39-LSGF, KC-40340, 2400.05.12PZ. 867 헤드는 D-10이다.
  - waiting 이유는 로그인 풀림 또는 사이트 미게재이므로 user_wait로 보낸다.
  - 형번 미정 STEP대기는 볼·레벨러 2종·인서트·멈춤나사·너트·와셔·S-M5-2다. 지난 라운드 STEPWAIT가 로그인 풀림으로 진전이 없었고 지금도 로그인이 풀린 상태라, 같은 이유로 다시 넣지 않는다(WF-123).
- **과제는 REG-01 하나다.** 구동 과제가 0이므로 이 회차는 회귀 이어 보기만 한다.

## 과제 표

| 순서 | id | 과제 | 출처 | 등급 | 유닛(0-8-3) | 내용·근거 | 합격 기준 |
|---|---|---|---|---|---|---|---|
| 1 | REG-01 | 전체 회귀 못 본 범위 이어 보기 | 구동 후보 | S | 기계 전체(U1~U8, 읽기만) | 아래 'REG-01 상세' | 못 본 범위의 기준선 밖 새 겹침 0, truncated·unmoved·stopped 0. POSE 8·9(REG-02)는 판정에서 뺀다 |

### REG-01 상세

지금 상태(누계 v2.6.3~v2.6.5, `mech_regression_8.md` 4절, `mech_REG-01_model.md`)
- 다 본 범위(새 겹침 0): CYCLE_L, CYCLE_S, CYCLE_G1 0~514, STATES, MAINT(MAINT_U7 9 빼고), POSE 0~82 중 대부분.
- 예외: POSE 8에서 P_M05_GUIDE ↔ P_M06_CARR 291.7 mm³ → REG-02(사용자 결정 대기).
- 못 본 범위:
  - CYCLE_G2 254·258~259·263~264·268~269·273~274·278~279·283~284·288~289·293~294·297~299·301~422(전체 상한에 걸림)
  - CYCLE_G2 423~630, MAINT_U7 9(어림 초과, 시작 전)
  - POSE 83~167·169~171·173~175·177~181(96점), F_STATES 0~34(어림 초과, 시작 전)
- 지난 회귀 실측: 연구 약 54 s/단계(12병렬 → 실효 4.5 s/단계), 자세 280 s/점, 상한 30분(요구서 6-4).

instructions
- 구상·수정 회차 없이 회귀만 한다(WF-185).
- 저장본은 `FSAP_v2.6.5.sc`이고 형상을 바꾸지 않는다(저장 0).
- `engine/tools/regrun.py run`으로 못 본 범위만 앞에서부터 본다. 순서는 G2 띄엄 단계 → G2 301~630 → MAINT_U7 9 → POSE 83~181 → F_STATES. 상한은 30분.
- 이미 본 줄(G1 전부, G2 0~300 본 단계, POSE 0~82)은 다시 보지 않는다(E-17·E-21).
- 어림은 지난 회귀 실측(54 s/단계 12병렬, 280 s/점)으로 잡는다. 세션 첫 점 과대 어림은 쓰지 않는다(WF-197).
- POSE 8·9의 GUIDE↔CARR 겹침은 REG-02로 이미 올라가 있다. 회귀 수정부로 보내지 않는다(WF-198).
- 이 과제가 곧 이번 라운드의 회귀다. 라운드 끝 전체 회귀가 같은 범위를 다시 열지 않게, 결과(본·못 본 범위)를 원장에 남긴다.

## open 표

| 항목 | 수 | 내용 |
|---|---|---|
| 열린 구동 과제 | 0 | M00~M08·M04R·M08R 모두 해결 |
| 구동 후보 | 1 | REG-01 |
| 동작 문제 | 0 | REG-02는 사용자 결정으로만 풀려 user_wait로 뺐다 |
| 디테일 | 0 | 구동 라운드 중이라 0으로 둔다 |
| 형번 정해진 STEP대기 | 0 | 모두 step_wait waiting(로그인·사이트 미게재) → user_wait |

## user_wait 표

| 건 | 사용자가 줄 것 | 구동을 막나 |
|---|---|---|
| REG-02 POSE 8·9(J_U6_HGT +6·J_U7_HGT −4) P_M05_GUIDE↔P_M06_CARR 291.7 mm³ | (가) 정의 밖 자세로 회귀 목록에서 뺌, 또는 (나) U6·U7 높이를 한 조정으로 묶거나 GUIDE↔CARR 틈 10 mm 넘게(구조 변경) | 예 — 동작 문제 종결에 결정 필요 |
| 서보 MHMF022L1U2M ×3(MHMF042L1U2M 포함) | 미스미 MSMF로 바꿀지 결정, 또는 파나소닉 CADENAS 가입해 STEP 받기 | 아니오(□60×L80 임시 형상) |
| F39-LSGF ×8(D-135) | 미스미 재로그인 또는 옴론 CAD STEP | 아니오 |
| IR1000-01BG ×3(D-129) | 미스미 재로그인/SMC CAD STEP | 아니오 |
| VRXF-PB-60-10 ×3(D-113) | 니덱 CAD STEP(미스미 아님) | 아니오 |
| KC-40340(D-121) | 제조사·형번 확인 | 아니오 |
| 2400.05.12PZ ×2(D-115) | igus 형번 확정·STEP | 아니오 |
| 형번 미정 STEP대기: 볼 Ø25.4 ×827(D-96·D-118), 레벨러 M8 ×36·×15(D-119·D-128), M3 인서트(D-125), 멈춤나사·너트·와셔(D-127), S-M5-2(D-122) | 미스미 로그인 상태에서 형번 표기 확정·STEP 받기 | 아니오(임시 형상) |
| 재봉 헤드 867 분리 개조(D-10·C-25) | 기종 견적 | 아니오(867 PDF 임시 형상) |
| 납품처 안전 기준(D-38) | 기준 문서 | 아니오(외장 단계) |
| 미스미 로그인 | 재로그인(지난 라운드 끝 '풀림') | 아니오 |

구매품 CAD 사이트 로그인: **풀림**(지난 라운드 결과 login).
