hyeunung/FSAP/docs/reports/queue_2026-11-06_3.md

# 과제 정리: 구동 라운드 3회차 (엔진 v3.9.3, 2026-11-06)

요약
- 최신 저장본은 `3D_Modeling/FSAP_v2.6.5.sc`다(tools/config.json doc). 지난 두 라운드 모두 형상 변경이 0이었다.
  - 과제 정리부는 CAD를 열지 않았다.
  - 'STEP대기_' 목록은 같은 저장본의 BOM `docs/bom/FSAP_v2.6.5_purchased.csv`로 읽었다.
- 요구서 5절 상태
  - 구동 과제 M00~M08·M04R·M08R, 구동 후보 DC2-01~DC2-08·LITE는 모두 해결이다.
  - **REG-01**(구동 후보, 전체 회귀 못 본 범위)은 미해결이다.
  - **REG-02**(동작 문제, POSE 8·9 GUIDE↔CARR)는 사용자 결정을 기다린다.
- 지난 라운드(2회차) 결과
  - REG-01은 '모델링 안 됨'이다. 읽기 전용 회귀라 형상은 그대로다.
  - 범위는 늘었다. POSE 0~181을 다 봤다(POSE 8·9는 REG-02라 판정에서 뺐다). CYCLE_G2·MAINT_U7 9도 다 봤다. 본 범위에서 새 겹침은 0이다.
  - **남은 못 본 범위는 F_STATES(체결 자세)뿐이다.**
  - regrade·serial_next는 없다. 그래서 등급 재조정·직렬 복귀 과제도 없다.
- **LITE(모델 무게):** runstats의 '가장 긴 열기'는 571 s로 240 s를 넘는다. 그래도 넣지 않는다.
  - 1회차 history에 LITE가 있다(완료 v2.6.5, 열기 242 → 약 100 s).
  - 한 번 한 과제는 넘어도 다시 넣지 않는다.
  - 571 s는 REG-01 모델링부의 열기 합이다(20회 열기).
- **STEPWAIT:** 넣지 않는다.
  - 형번이 정해진 `STEP대기_` 구매품은 모두 `tools/out/step_wait.json` waiting에 있다: MHMF022L1U2M, VRXF-PB-60-10, IR1000-01BG, F39-LSGF, KC-40340, 2400.05.12PZ.
  - 이유는 둘 중 하나다: 사이트 가입 필요, 또는 미스미 미게재·제조사·형번 미확인. 그래서 user_wait로 보낸다.
  - MHMF042L1U2M은 v2.6.5 BOM에 STEP대기 행이 없다.
  - 867 헤드는 D-10이다.
  - 형번 미정 `STEP대기_`는 디테일링 몫(구매품 형번 고르기)이라 open에 세지 않는다: 볼 Ø25.4, 레벨러 M8 2종, M3 인서트, 멈춤나사·너트·와셔, S-M5-2.
- **과제는 REG-01 하나다.** 열린 구동 과제가 0이라 이번 회차는 F_STATES 회귀만 이어 본다.

## 과제 표

| 순서 | id | 과제 | 출처 | 등급 | 유닛(0-8-3) | 내용·근거 | 합격 기준 |
|---|---|---|---|---|---|---|---|
| 1 | REG-01 | 전체 회귀 못 본 범위(F_STATES) 이어 보기 | 구동 후보 | S | 기계 전체(U1~U8 체결 자세, 읽기만) | 아래 'REG-01 상세' | 1. F_STATES 못 본 범위에서 기준선 밖 새 겹침 0<br>2. truncated·unmoved·stopped 0<br>3. 호출 하나 ≤ 8분<br>4. POSE 8·9(REG-02)는 판정에서 뺀다 |

### REG-01 상세

지금 상태(누계 v2.6.5, 출처는 `mech_regression_9.md` 3절과 `final_mech_2026-11-06_REG-01.md` 1절)

다 본 범위(새 겹침 0)
- CYCLE_L, CYCLE_S, CYCLE_G1, CYCLE_G2
- STATES, MAINT
- POSE 0~181(8·9 빼고)
- F_STATES 일부:
  - U4·U5·U6_SHOE·U6_SENSOR 0~3
  - U3_HEAD 0~2
  - U7 조각 #1·#3·#4·#5·#7 0~2
  - U7 조각 #0 0·1·3, #6 0·2

못 본 범위

| 범위 | 못 본 이유 |
|---|---|
| F_STATES 0~3 U7_TAPE 조각#2 | 바디 약 7개. 호출 하나가 8분을 넘어 4번 끊김 |
| F_STATES 0~3 일부(U3_HEAD 3, U7#0 2, #6 1·3, #1·#3·#4·#5·#7 3) | 전체 상한·끊김 |
| F_STATES 4~34 모든 유닛 | 어림 초과로 시작 전에 뺌 |

실측(회귀 9)
- 점당 시간: U5 267 s, U3 145 s, U6 42~44 s, U4 19 s, U7 조각 0.3~56 s, U7#2는 480 s를 넘음.
- 한 상태(13조각)는 1,200 s를 넘는다. 35상태를 5병렬로 돌리면 약 2.3시간이다.
- 따라서 이번 상한 30분 안에 F_STATES를 다 볼 수는 없다. 여러 라운드에 걸쳐 앞에서부터 이어 본다.

instructions(지난 라운드와 막힌 이유가 다르게 방법을 바꾼다, WF-123)
- 구상·수정 회차 없이 회귀만 한다(WF-185).
- 저장본은 `FSAP_v2.6.5.sc`다. 형상을 바꾸지 않는다(저장 0).
- `engine/tools/regrun.py run`으로 F_STATES 못 본 범위만 앞에서부터 본다.
- 순서
  1. F_STATES 0~3의 남은 점
  2. U7_TAPE 조각#2를 바디 1~2개씩 더 잘게 나눈 것(`chunk8.py` 나누기 기준만 바꿈, 검사 내용 같음)
  3. F_STATES 4~34
- 조각 크기는 실측 점당 시간으로 정한다. 호출 하나의 어림이 480 s 안에 들게 자른다(WF-201).
- 회귀 시험 어림은 회귀 9 실측 점당 시간으로 잡는다. 세션 첫 점 과대 어림은 쓰지 않는다(WF-197).
- 상한은 30분(요구서 6-4).
- 이미 본 줄은 다시 보지 않는다(E-17·E-21): CYCLE_*·STATES·MAINT·POSE 전부, 위 F_STATES 본 조각.
  - 못 본 범위는 지시문이 아니라 `ledger.json`의 최신 통과 항목으로 다시 센다(회귀 9 워크플로우 메모).
- 끊긴 세션은 다시 쓰지 않고 새로 연다. 시간 초과는 패닉으로 세지 않는다(WF-202).
- POSE 8·9의 GUIDE↔CARR 겹침은 REG-02로 이미 올라가 있다. 회귀 수정부로 보내지 않는다(WF-198).
- 이 과제가 곧 이번 라운드의 회귀다.
  - 결과(본 범위·못 본 범위)는 `ledger.py commit`으로 원장에 남긴다.
  - 라운드 끝 전체 회귀는 같은 범위를 다시 열지 않는다.
- 참고(검사 범위): STATES 0~25·31~34는 일반 검사(움직이는 바디 둘레)로 이미 겹침 0을 봤다. F_STATES 빠른 검사가 상한과 맞지 않는 점은 회귀 9 워크플로우 메모에 있다.
  - 검사 정의를 줄이는 것은 문서에 없는 결정이다. 그래서 이 과제에서 정하지 않고, 지금 정의 그대로 이어 본다.

## open 표

| 항목 | 수 | 내용 |
|---|---|---|
| 열린 구동 과제 | 0 | M00~M08·M04R·M08R 모두 해결 |
| 구동 후보 | 1 | REG-01(F_STATES 못 본 범위) |
| 동작 문제 | 0 | REG-02는 사용자 결정으로만 풀린다. 그래서 user_wait로 뺐다 |
| 디테일 | 0 | 구동 라운드 중이라 0으로 둔다 |
| 형번 정해진 STEP대기 | 0 | 모두 step_wait waiting(가입 필요·사이트 미게재·형번 미확인) → user_wait |

## user_wait 표

| 건 | 사용자가 줄 것 | 구동을 막나 |
|---|---|---|
| REG-02 POSE 8·9(J_U6_HGT +6·J_U7_HGT −4)<br>P_M05_GUIDE↔P_M06_CARR 291.7 mm³ | 둘 중 하나를 정한다.<br>(가) 정의 밖 자세로 보고 회귀 목록에서 뺀다<br>(나) U6·U7 높이를 한 조정으로 묶거나 GUIDE↔CARR 틈을 10 mm 넘게 둔다(구조 변경) | 예 — 동작 문제를 닫으려면 결정이 필요 |
| 서보 MHMF022L1U2M ×3(D-111·D-112·D-115) | 미스미 MSMF로 바꿀지 결정, 또는 파나소닉 CADENAS에 가입해 STEP 받기 | 아니오(□60×L80 임시 형상) |
| F39-LSGF ×8(D-135) | 옴론 CAD STEP(미스미 미게재) | 아니오 |
| IR1000-01BG ×3(D-129) | SMC CAD STEP(미스미 CAD 없음) | 아니오 |
| VRXF-PB-60-10 ×3(D-113) | 니덱 CAD STEP(미스미 아님) | 아니오 |
| KC-40340(D-121) | 제조사·형번 확인 | 아니오 |
| 2400.05.12PZ ×2(D-115) | igus 형번 확정·STEP | 아니오 |
| 재봉 헤드 867 분리 개조(D-10·C-25) | 기종 견적 | 아니오(867 PDF 임시 형상) |
| 납품처 안전 기준(D-38) | 기준 문서 | 아니오(외장 단계) |

구매품 CAD 사이트 로그인: **확인 못 함**.
- 지난 라운드 결과의 login이 '확인 못 함'이다.
- 실행 지시 (c)에 따르면 2026-11-06에 사용자가 미스미에 로그인해 두었다. 실제 상태는 최종 보고 담당이 확인한다.
