hyeunung/FSAP/docs/reports/queue_2026-11-06_4.md

# 과제 정리: 구동 라운드 4회차 (엔진 v3.9.3, 2026-11-06)

요약
- 최신 저장본은 `3D_Modeling/FSAP_v2.6.5.sc`다(tools/config.json doc). 2·3회차 모두 형상 변경 0이다. 과제 정리부는 CAD를 열지 않았다(STEP대기_ 목록은 3회차 정리와 같은 저장본·BOM `docs/bom/FSAP_v2.6.5_purchased.csv` 기준).
- 요구서 5절: 구동 과제 M00~M08·M04R·M08R, 구동 후보 DC2-01~DC2-08·LITE 모두 해결. **REG-01**(구동 후보, 회귀 못 본 범위) 미해결, **REG-02**(동작 문제 POSE 8·9) 사용자 결정 대기.
- 3회차 결과: REG-01 '모델링 안 됨'(읽기 전용 회귀), regrade·serial_next 없음 → 등급 재조정·직렬 복귀 과제 없음. 본 범위 새 겹침 0. 남은 못 본 범위는 F_STATES 일부뿐이다.
- **LITE:** runstats '가장 긴 열기' 594 s > 240 s지만 1회차 history에 LITE가 있다(v2.6.5 완료). 한 번 한 과제라 다시 넣지 않는다.
- **STEPWAIT:** 넣지 않는다. 형번 정해진 `STEP대기_`(MHMF022L1U2M, VRXF-PB-60-10, IR1000-01BG, F39-LSGF, KC-40340, 2400.05.12PZ)는 모두 `tools/out/step_wait.json` waiting에 있고 이유가 사이트 가입·사이트 미게재·형번 미확인이다 → user_wait.
- **과제는 REG-01 하나.** 3회차와 같은 이유(한 점 > 470 s)로 막혔으므로 나누는 방법을 바꿔 넣는다(WF-123).

## 과제 표

| 순서 | id | 과제 | 출처 | 등급 | 유닛(0-8-3) | 내용·근거 | 합격 기준 |
|---|---|---|---|---|---|---|---|
| 1 | REG-01 | 전체 회귀 못 본 범위(F_STATES 남은 것) 이어 보기 | 구동 후보 | S | 기계 전체 체결 자세(U5·U7 중심, 읽기만) | 아래 'REG-01 상세' | 1. 못 본 범위에서 기준선 밖 새 겹침 0<br>2. truncated·unmoved·stopped 0<br>3. 호출 하나 ≤ 8분<br>4. POSE 8·9(REG-02)는 판정에서 뺀다 |

### REG-01 상세

누계(v2.6.5, `final_mech_2026-11-06_REG-01_2.md`, `mech_regression_10.md`)
- 다 봄(겹침 0): CYCLE_L·S·G1·G2, STATES, MAINT, POSE 0~181(8·9 빼고), F_STATES 0~32의 대부분 유닛.
- 못 본 범위
  | 범위 | 3회차 못 본 이유 |
  |---|---|
  | F_STATES U7@26(KDM10S-06_M08) 0~34 | against 1/8 조각 0·2·6·7 한 점 > 470 s, 상태 1~34 전체 상한 |
  | F_STATES U5_WHEEL_F 24·25·26 | 한 점 > 470 s |
  | F_STATES U5_WHEEL_F 32 | 전체 상한 끊김 |
  | F_STATES 모든 유닛 33·34 | 전체 상한 |

instructions(방법 바꿈, WF-123)
- 구상·수정 없이 회귀만(WF-185). 저장본 `FSAP_v2.6.5.sc`, 저장 0.
- 못 본 범위는 `ledger.json` 최신 통과 항목으로 다시 센다(회귀 9·10 메모).
- 순서: ① 모든 유닛 33·34와 U5 32(점당 시간이 상한 안인 것 먼저) ② U5_WHEEL_F 24~26을 against 바디 묶음으로 나눔 ③ U7@26 against를 1/8 → 1/32로 더 잘게(검사 내용 같고 나누기 기준만 바꿈).
- regrun 시험은 묶음 id(유닛)마다 한 점씩 재서 어림을 잡는다(회귀 10 메모, WF-178). 호출 하나 어림 ≤ 480 s(WF-201). 상한 30분(요구서 6-4). 끊긴 세션은 새로 연다, 시간 초과는 패닉으로 세지 않는다(WF-202).
- 결과는 `ledger.py commit`. 이 과제가 곧 라운드 회귀다(같은 범위 다시 열지 않음).
- 참고: U7@26 35상태 × 32조각 규모는 한 라운드 30분에 다 못 본다. F_STATES(빠른 검사)를 완료 판정에 넣을지는 검사 범위 결정(문서에 없는 결정)이라 이 과제에서 정하지 않고 user_wait에 올린다. STATES(일반 검사)는 0~25·31~34를 이미 겹침 0으로 봤다.

## open 표

| 항목 | 수 | 내용 |
|---|---|---|
| 열린 구동 과제 | 0 | M00~M08·M04R·M08R 해결 |
| 구동 후보 | 1 | REG-01(F_STATES 남은 범위) |
| 동작 문제 | 0 | REG-02는 사용자 결정으로만 풀림 → user_wait |
| 디테일 | 0 | 구동 라운드 중 |
| 형번 정해진 STEP대기 | 0 | 모두 step_wait waiting(가입·미게재·형번 미확인) → user_wait |

## user_wait 표

| 건 | 사용자가 줄 것 | 구동을 막나 |
|---|---|---|
| REG-02 POSE 8·9 P_M05_GUIDE↔P_M06_CARR 291.7 mm³ | (가) 정의 밖 자세로 회귀에서 뺀다 / (나) U6·U7 높이 한 조정 또는 틈 10 넘게(구조 변경) | 예 |
| F_STATES 빠른 검사를 완료 판정에 넣을지(U7@26·U5 한 점이 호출 상한을 넘어 여러 라운드 걸림) | 검사 범위 결정: 그대로 이어 보기 / STATES 일반 검사로 갈음 | 아니오(이어 보기는 진행) |
| 서보 MHMF022L1U2M·MHMF042L1U2M | 미스미 MSMF로 바꿀지, 또는 파나소닉 CADENAS 가입 | 아니오(임시 형상) |
| F39-LSGF(D-135) | 옴론 CAD STEP | 아니오 |
| IR1000-01BG(D-129) | SMC CAD STEP | 아니오 |
| VRXF-PB-60-10(D-113) | 니덱 CAD STEP | 아니오 |
| KC-40340(D-121) | 제조사·형번 확인 | 아니오 |
| 2400.05.12PZ(D-115) | igus 형번 확정·STEP | 아니오 |
| 재봉 헤드 867 분리 개조(D-10·C-25) | 기종 견적 | 아니오(867 PDF 임시 형상) |
| 납품처 안전 기준(D-38) | 기준 문서 | 아니오(외장 단계) |

구매품 CAD 사이트 로그인: **확인 못 함**(3회차 결과 login). 실행 지시 (c)대로 사용자가 2026-11-06 미스미에 로그인해 두었고, 실제 상태는 최종 보고 담당이 확인한다.
