hyeunung/FSAP/docs/reports/queue_2026-11-08_1.md

# 과제 목록: 구동 라운드 1회차 (엔진 v3.9.3, 2026-11-08)

과제 정리부(PM). CAD는 열지 않았다(읽기만, 저장 없음). 모델·문서는 고치지 않았다.

## 읽은 것

- 요구서 5절: 구동 M00~M08·M04R·M08R 모두 해결. 구동 후보 DC2-01~DC2-08·LITE·STEPSWAP 해결. **미해결: REG-01(구동 후보, 전체 회귀 못 본 범위), REG-02(동작 문제 — 2026-11-08 사용자 결정으로 결정로그 C-34, 모델 반영 대기).**
- 결정로그 C-34: J_U6_HGT·J_U7_HGT를 한 높이 조정(공통 판·장공 하나, 값 = 두께 − 10, −4~+6)으로 묶고, 두 값이 어긋난 자세(POSE 8 등)는 회귀 자세 정의에서 뺀다. −4·0·+6에서 P_M05_GUIDE ↔ P_M06_CARR 틈 ≥ 10.
- `tools/machine.json`: J_U6_HGT 원점 (−51, −90, 180), P_M06_BASE 장공 Z 174~184, CB5-12_M06_1·2. J_U7_HGT 원점 (27, −90, 310), P_M05_HOLDER 날개 A 장공 Z 304~314, CB5-12_M05_11·12, 미는 볼트 M4×25 ×2(DC2-04 수정 1). KDM10 소켓·받침(DC2-08)은 U7_FIXED 자식이라 J_U7_HGT를 따라간다.
- 모델: `tools/config.json` doc = `3D_Modeling/FSAP_v2.6.5.sc`. STEP대기_ 목록은 이 문서의 BOM `docs/bom/FSAP_v2.6.5_purchased.csv` STEP대기_ 행으로 봤다(열기 594 s, 지난 4라운드 형상 변경 0이라 BOM = 모델).
- `tools/out/step_wait.json`(2026-11-06): waiting 6건, login '확인 못 함'. 다만 2026-11-06 최종 보고는 같은 형번을 '로그인 문제로 못 받은 형번'으로 적었고, 사용자가 2026-11-08 미스미에 다시 로그인했다 → 막힌 이유가 바뀌었으니 한 번 다시 받아 본다(WF-123 아님).
- runstats: 실행 14개, 가장 긴 열기 594 s(회귀). 240 s를 넘지만 LITE는 2026-11-06에 이미 했다(v2.6.5) → 다시 넣지 않는다(WF-196).
- 최근 최종 보고 `docs/reports/final_full_2026-11-06.md`: REG-01 4라운드 '모델링 안 됨', 못 본 범위는 F_STATES U7@26만 남음. 다음 방법으로 'HTPA60 풀리 바디 단독 clearance' 제안.

## 과제 표 (순서: REG-02 → REG-01, STEPWAIT는 라운드 시작 단계)

| id | 과제 | 출처 | 등급 | 직렬 | brief | 합격 기준 |
|---|---|---|---|---|---|---|
| STEPWAIT | STEP대기 실물 교체 재시도 | STEP 대기 | S | 아니오 | 미스미 재로그인(2026-11-08) 뒤 다시 받아 봄: F39-LSGF(U8, 옴론), IR1000-01BG(U8, SMC), VRXF-PB-60-10(U4·U5, 니덱). PartsLibrary/index.csv 먼저. 미스미에 없으면 제조사 CAD(로그인 없이)까지. 못 받으면 STEP대기_ 유지하고 기다리지 않음 | 받은 형번 STEP대기_ 0, 교체 뒤 새 겹침 0 |
| REG-02 | U6·U7 높이 조정 하나로 묶기 (C-34) | 회귀 동작 문제 | M | 아니오 | U6 센서+슈·U7 카세트 걸이. 지금 J_U6_HGT(P_M06_BASE 장공 Z 174~184)·J_U7_HGT(P_M05_HOLDER 장공 Z 304~314) 따로. POSE 8(U6 +6·U7 −4)에서 P_M05_GUIDE ↔ P_M06_CARR 291.7 mm³(X 12~18·Y −107~−100·Z 34~42) | J_U6_HGT·J_U7_HGT −4·0·+6 같은 값에서 과제 범위 간섭 0, GUIDE↔CARR 틈 ≥ 10, 두 값이 다를 수 없음, 회귀 자세 정의에 어긋난 자세 0, 체결 공구 막힘 0 |
| REG-01 | 전체 회귀 못 본 범위 (U7@26 KDM10S-06_M08 F_STATES) | 구동 후보 | S | 예 | 형상 변경 없음. REG-02가 U7_FIXED(KDM10 소켓 부모)를 바꾸므로 그 뒤 직렬. 지난 방법(조각 쪼개기)은 다시 안 씀(WF-123): HTPA60 풀리 바디 4개(FLANGE1·FLANGE2·HUB·SET2) ↔ KDM10S-06_M08 단독 근처 clearance 먼저, 남은 조각은 regrun 줄 맨 앞 | 못 본 범위 과제 범위 간섭 0, 못 본 범위 0, 형상·부품 수 변경 0 |

## open 표

| 항목 | 수 | 내용 |
|---|---|---|
| 열린 구동 과제 | 0 | M00~M08·M04R·M08R 해결 |
| 구동 후보 | 1 | REG-01 |
| 동작 문제 | 1 | REG-02(사용자 결정 C-34로 풀림, 모델 반영) |
| 디테일 | 0 | 구동 라운드 중 0 |
| STEP 대기(형번 정해짐) | 3 | F39-LSGF, IR1000-01BG, VRXF-PB-60-10 |

## user_wait 표

| 항목 | 사용자가 줄 것 | 구동 막음 |
|---|---|---|
| D-10 재봉 헤드 기종(867-392342 STEP대기_, 아랫축 서보 MHMF042L1U2M) | 견적 뒤 기종 결정 + 공식 치수·STEP | 아니오(867 PDF 임시 형상) |
| D-38 납품처 안전 기준 | 납품처 안전 기준 | 아니오 |
| MHMF022L1U2M(×3)·MHMF042L1U2M 서보 STEP | 미스미 MSMF 대체 결정(또는 파나소닉 CADENAS 가입 — 규칙 11 금지) | 아니오(임시 형상) |
| KC-40340 인장 래치 | 제조사 확인(D-121) | 아니오 |
| 2400.05.12PZ igus 끝 브래킷 | igus 형번 확정(D-115) | 아니오 |

형번 미정 STEP대기_(BALL_D25, LEVELER_M8, INSERT_M3, DC204 멈춤나사·너트·와셔, S-M5-2)는 형번 결정이 먼저라 STEP 대기로 세지 않는다(D-96·D-118·D-119·D-122·D-125·D-127·D-128).

## 로그인

구매품 CAD 사이트(미스미): **확인 못 함**(step_wait.json login '확인 못 함'). 사용자가 2026-11-08 다시 로그인했다고 알림 — 구매부가 받기 전에 화면 머리로 확인한다.
