hyeunung/FSAP/docs/reports/final_full_2026-11-06.md

# 전체 최종 보고 — 2026-11-06 (엔진 v3.9.3 다시 켬)

**상태: 미완 — 같은 과제(REG-01)가 세 라운드를 돌아도 안 풀림 — 진전 없음**

최신 설계: `3D_Modeling/FSAP_v2.6.5.sc` (라운드 1 LITE에서 v2.6.4 → v2.6.5)

## 1. 사용자 자료 대기

| 항목 | 사용자가 줄 것 | 구동을 막나 |
|---|---|---|
| D-10 재봉 헤드 기종 (867-392342 STEP대기_, 아랫축 서보 MHMF042L1U2M) | 견적 비교 뒤 기종 결정 + 공식 치수·STEP | 아니오 |
| D-38 납품처 안전 기준 | 납품처 안전 기준 | 아니오 |
| REG-02 POSE 8 U7 안내 ↔ U6 캐리지 291.7 mm³ | 정의 밖 자세로 뺄지 / 높이 한 조정·틈 10 넘게 할지 결정 | 아니오 |
| MHMF022L1U2M·MHMF042L1U2M 서보 STEP | 미스미 MSMF 대체 결정 (파나소닉 CADENAS 가입 필요) | 아니오 |
| VRXF-PB-60-10 감속기 STEP | 니덱 CAD 자료 또는 대체 형번 결정 | 아니오 |
| IR1000-01BG 레귤레이터 STEP | SMC CAD 자료 (미스미 CAD 없음) | 아니오 |
| F39-LSGF 라이트 커튼 금구 STEP | 옴론 CAD 확인·형번 확정 | 아니오 |
| KC-40340 인장 래치 | 제조사 확인 (D-121) | 아니오 |
| 2400.05.12PZ igus 끝 브래킷 | igus 형번 확정 (D-115) | 아니오 |

## 2. 구매품 CAD 사이트 로그인

| 항목 | 내용 |
|---|---|
| 미스미 로그인 (최종 확인, Chrome 새 탭 2026-11-06) | **풀림** (머리에 '로그인 / 회원가입' 표시) |
| 로그인 문제로 못 받은 형번 (라운드 1) | F39-LSGF, IR1000-01BG, MHMF022L1U2M, MHMF042L1U2M, VRXF-PB-60-10, KC-40340, 2400.05.12PZ |
| 라운드 2~4 | 확인 못 함 (STEP 받기 과제 없음) |

## 3. 남은 것

| 칸 | 수 | 항목 |
|---|---|---|
| 열린 구동 과제 | 0 | — |
| 구동 후보 | 1 | REG-01 |
| 동작 문제(회귀) | 0 | — |
| 디테일 | 0 | — |
| STEP대기 (형번 정해짐) | 0 | (위 형번들은 사용자 자료 대기로 분류) |

### 구동 후보

| id | 제목 | 할 것 | 완료 기준 |
|---|---|---|---|
| REG-01 | 전체 회귀 못 본 범위 (U7@26 KDM10S-06_M08 F_STATES) | 형상 변경 없음. HTPA60 풀리 바디 4개(FLANGE1·FLANGE2·HUB·SET2) ↔ KDM10S-06_M08 단독 근처 clearance 먼저, 그다음 남은 조각을 regrun 줄 맨 앞에. 같은 방법으로 다시 쪼개지 않음(WF-123) | 못 본 범위 간섭 0, 못 본 범위 0(POSE 8·9 제외), 형상·부품 수 변경 0 |

### 전체 회귀 못 본 범위 (마지막 라운드 4 기준)

| 범위 | 이유 |
|---|---|
| F_STATES U7@26 1/128 조각 86·87·88·90 상태 0 | 한 점 > 470 s (HTPA60 풀리 바디 추정), 2라운드 연속 |
| F_STATES U7@26 1/32 조각 6 상태 2~34, 조각 8 상태 1~34 | 전체 상한 |
| F_STATES U7@26 가벼운 조각 상태 26~34 | 전체 상한, 어림 초과 |
| POSE 8·9 | REG-02 사용자 결정 대기, 판정에서 뺌 |

라운드별 못 본 범위 변화: R1 CYCLE_G2·MAINT_U7·POSE·F_STATES 넓게 → R2 F_STATES 일부 → R3 U7@26·U5 일부 → R4 U7@26만. 범위는 줄었으나 REG-01 자체는 4라운드 모두 '모델링 안 됨'.

## 4. 라운드별

| 라운드 | 과제 | 결과 | 회귀 ok | 출력 토큰 | 최종 보고 | 실행 기록 (summary.json) |
|---|---|---|---|---|---|---|
| 1 | LITE, STEPWAIT, REG-01 | LITE 완료(v2.6.5), REG-01 모델링 안 됨 | 아니오 | 264,282 | docs/reports/mechanism/final_mech_2026-11-06_LITE-STEPWAIT-REG-01.md | runs/mech_2026-11-06_LITE-STEPWAIT-REG-01 |
| 2 | REG-01 | 모델링 안 됨 | 예 | 91,697 | docs/reports/mechanism/final_mech_2026-11-06_REG-01.md | runs/mech_2026-11-06_REG-01 |
| 3 | REG-01 | 모델링 안 됨 | 예 | 86,997 | docs/reports/mechanism/final_mech_2026-11-06_REG-01_2.md | runs/mech_2026-11-06_REG-01_2 |
| 4 | REG-01 | 모델링 안 됨 | 예 | 83,640 | docs/reports/mechanism/final_mech_2026-11-06_REG-01_3.md | runs/mech_2026-11-06_REG-01_3 |
| 합계 | | | | 526,616 | | |

디테일링: 돌지 않음 (구동 후보가 남아 규칙 13 순서대로 보류).

## 5. 사용자 결정

| 결정 | 선택지 | 막는 것 |
|---|---|---|
| REG-02 POSE 8 | 정의 밖 자세로 뺌 / 높이 조정·틈 10 넘게 | POSE 8·9 회귀 판정 |
| 서보 MHMF → MSMF 대체 | 미스미 MSMF로 바꿈 / 파나소닉 가입해 MHMF STEP | 서보 STEP 실물 교체 |
| VRXF-PB-60-10 감속기 | 니덱 자료 / 대체 형번 | 감속기 STEP |
| D-10 재봉 헤드 기종 | 견적 비교 뒤 결정 | 헤드 실물 형상 |
| REG-01 진행 방식 | 다음 라운드에 풀리 단독 clearance 방식으로 한 번 더 / 남은 U7@26 범위를 위험 수용 | 구동 '완료' 판정 |

## 6. 사람이 할 일

| 할 일 | 이유 |
|---|---|
| 미스미 다시 로그인 | 최종 확인에서 풀림. 재로그인은 사람이 함 |
| SMC·옴론·igus·제조사 CAD 자료 확인 (IR1000-01BG, F39-LSGF, 2400.05.12PZ, KC-40340) | 회원가입·로그인 없이 받을 STEP 없음 |
| 납품처 안전 기준(D-38) 받기 | 외장·안전 단계 조건 |
