hyeunung/FSAP/docs/reports/queue_2026-11-04_7.md

# 과제 정리: 구동 라운드 7회차 (2026-11-06)

요약
- 최신 저장본은 `3D_Modeling/FSAP_v2.6.4.sc`(tools/config.json doc)이다. 6회차에는 형상이 바뀌지 않았다. CAD는 열지 않았다.
- 'STEP대기_' 목록의 출처: BOM `docs/bom/FSAP_v2.6.4_purchased.csv`, `tools/out/step_wait.json`, `mech_step_wait.md`, PartsLibrary `index.csv`.
- 요구서 5절의 구동 과제(M00~M08·M04R·M08R)와 구동 후보 DC2-01~DC2-08은 모두 해결이다. 남은 구동 후보는 **REG-01(전체 회귀 못 본 범위)** 하나다.
- 미스미 로그인: **됨**. 근거는 사용자 말이다(2026-11-06 "미스미도 로그인했어 미스미 처리할거 있으면 해 또 로그인 풀리기전에"). 과제 정리부는 브라우저로 확인하지 않았고, 구매부가 받기 전에 머리 표시로 다시 확인한다.
- 6회차 STEP 재시도(로그인 풀림)에서 못 받은 것과 형번 미정 표준품을 **STEPWAIT** 하나로 묶어 맨 앞에 둔다.
- 순서는 STEPWAIT(실물 교체, 새 버전) → REG-01(교체한 파일로 못 본 범위만 회귀). REG-01은 발자국이 기계 전체라 직렬이다.
- REG-01은 6회차에 '설계 미달(수정 상한)'로 끝났다. 남은 항목이 회귀 결과로만 풀리기 때문이다(WF-185). 같은 이유로 막히지 않게 이번에는 구상·수정 회차 없이 회귀 실행만 하도록 instructions를 정했다(WF-123).

## 과제 표

| id | 과제 | 출처 | 등급 | 유닛 | 내용·근거 | 합격 기준 |
|---|---|---|---|---|---|---|
| STEPWAIT | 미스미 로그인 중 STEP 받기·형번 정하기·실물 교체 | STEP 대기(사용자 2026-11-06 요청) | M | U2·U4·U5·U5·U6·U8 | 받기 전에 PartsLibrary를 먼저 본다. 미스미 머리에 '로그인 / 회원가입'이 떠 있으면 받지 않고 임시 형상을 유지한다(실행 규칙 10·12). 항목은 아래 ①~⑥. | 받은 형번의 STEP대기_ 0, 교체 뒤 과제 범위 새 겹침 0, 볼 꼭대기 Z 0 ± 0.1 유지, 볼 정격 ≥ 203 N, 레벨러 물림 ≥ 5.5 유지 |
| REG-01 | 전체 회귀 못 본 범위 이어 보기 | 구동 후보 | S | 기계 전체 | 6회차까지 본 범위는 모두 겹침 0이다: v2.6.3 CYCLE_L·STATES·MAINT, v2.6.4 CYCLE_S 43~450·CYCLE_G1 0~128·STATES 24. 남은 범위는 아래 'REG-01 남은 범위'. | 못 본 범위 기준선 밖 겹침 0, truncated 0, unmoved 0, 행정 막힘 0 |

STEPWAIT 항목

| 번호 | 형번(자료대기) | 모델 바디 | 할 일 |
|---|---|---|---|
| ① | 볼 트랜스퍼 Ø25.4 압입형 ×827(D-96·D-118) | `STEP대기_BALL_D25_M04` | 1안 미스미 볼롤러 압입형, 정격 ≥ 203 N |
| ② | 레벨러 M8 Ø40(D-119 ×36, D-128 ×15) | `STEP대기_LEVELER_M8_M04`, `STEP대기_LEVELER_M8_M07` | 같은 형번이면 함께 |
| ③ | 멈춤나사 M4×25·너트 M4·와셔 M5(D-127) | `STEP대기_SETSCREW_M4x25_DC204_1·2`, `STEP대기_NUT_M4_DC204_1·2`, `STEP대기_WASHER_M5_DC204_1·2` | 미스미 표기로 형번 정함 |
| ④ | M3 열압입 인서트(D-125) | `STEP대기_INSERT_M3_M06_1·_2` | 미스미 표기로 형번 정함 |
| ⑤ | F39-LSGF ×8(D-135) | `STEP대기_F39-LSGF_M08_*` | 지난번은 로그인 풀림으로 못 봄. 미스미에 없으면 옴론 CAD |
| ⑥ | IR1000-01BG ×3(D-129·D-132), VRXF-PB-60-10 ×3(D-113) | `STEP대기_IR1000-01BG_M08_N/F/S`, `STEP대기_VRXF-PB-60-10`·`_U5X`·`_U5W` | 제조사 CAD로 받기(SMC CAD, 니덱) |

- ①~④는 정한 미스미 표기를 자료대기·결정로그에 적는다(실행 규칙 11).
- 회원가입·로그인·개인정보 입력이 필요하면 멈추고 자료대기에 남긴다.

REG-01 남은 범위

| 범위 | 근거 |
|---|---|
| CYCLE_G1 129~514, CYCLE_G2 0~630 | 어림 초과로 시작 전에 뺌 |
| STATES 33·34, POSE 0~182 | 자세. 점당 300 s라 따로 묶는다 |
| F_STATES 0~34 | 명세에서 뺐다 |
| STEPWAIT에서 바뀐 바디 둘레 | STEPWAIT 결과에 따라 정한다 |

- 근거 문서: `final_mech_2026-11-04_STEPWAIT-REG-01_3.md`, `mech_REG-01_model.md` 4절, `mech_regression_7.md`.

REG-01 instructions: 구상·수정 회차는 없다. 회귀 실행만 한다. 6회차 도구 `tools/out/mech_REG-01/r4/chunk7.py`·`judge.py`로 못 본 범위만 묶음별 호출 ≤ 480 s로 나누고 regrun 상한 30분 안에서 앞에서부터 이어 본다. 합격 여부는 judge.py가 bad·truncated·unmoved·stopped 0으로 기계적으로 낸다. 이번에도 못 본 범위가 남으면 그 범위만 다음 회귀로 넘긴다.

## open 표

| 항목 | 수 | 내용 |
|---|---|---|
| 열린 구동 과제 | 0 | 5절 구동 행 모두 해결 |
| 구동 후보 | 1 | REG-01 |
| 회귀 동작 문제 | 0 | 본 범위 겹침 0. 못 본 범위는 REG-01이 본다 |
| 디테일 | 0 | 구동 라운드 중에는 세지 않는다 |
| 형번이 정해졌는데 STEP대기_ | 3 | F39-LSGF ×8: 로그인 풀림 사유가 사용자 로그인으로 풀려 다시 시도한다. IR1000-01BG ×3: SMC CAD를 아직 안 봄. VRXF-PB-60-10 ×3: 니덱 CAD를 아직 안 봄. 셋 다 STEPWAIT ⑤·⑥에서 다시 시도한다 |

- 형번 미정이라 step_wait에 세지 않은 STEP대기_
  - STEPWAIT ①~④에서 정할 것: 볼 D-96, 레벨러 D-119·D-128, DC2-04 체결품 D-127, M3 인서트 D-125.
  - 아직 정하지 않는 것: KC-40340(제조사 미확인 D-121), S-M5-2(D-122), 2400.05.12PZ(igus 형번 임시 D-115), 867 헤드(D-10).
- MHMF022L1U2M ×3은 user_wait로 뺐다.

## user_wait 표

| 항목 | 사용자가 줄 것 | 구동을 막나 |
|---|---|---|
| 재봉 헤드 기종 D-10·D-109 (`STEP대기_867-392342_UPPER·_NOSE·_LOWER`) | 견적 비교 뒤 기종 결정 + 그 기종 공식 치수·STEP | 아니오(867 임시 형상으로 진행) |
| 서보 MHMF022L1U2M ×3 (D-111·D-112·D-115) | 파나소닉 CADENAS 개인정보 입력·STEP 받기(사용자가 직접) | 아니오(□60×L80 임시) |
| 납품처 안전 기준 D-38 | 안전 거리·정지 시간 기준 | 아니오(ISO 13855 참고 임시) |
| 특허 KR102139457B1 D-102 | 변리사 확인 여부 결정 | 아니오 |

## 워크플로우 메모
- 계산된 지시에 따르면 login은 지난 라운드 결과(풀림)에서 가져와야 한다. 사용자가 로그인했다고 알려 '됨'으로 적었다. 결과 JSON의 login이 사용자 알림보다 오래된 값일 때 무엇을 쓸지 정해 둔 규칙이 없다.
- REG-01처럼 검증만 하는 과제가 설계부 수정 회차를 거치면 '설계 미달(수정 상한)'로 끝난다(WF-185 반복). 이번에는 instructions로 회귀 실행만 하게 했다.
