hyeunung/FSAP/docs/reports/queue_2026-11-06_1.md

# 과제 정리: 구동 라운드 1회차 (엔진 v3.9.3 다시 켬, 2026-11-06)

요약
- 최신 저장본은 `3D_Modeling/FSAP_v2.6.4.sc`(tools/config.json doc)이다. 과제 정리부는 CAD를 열지 않았다. 열기만 약 8분(실행 기록 가장 긴 열기 493초)이라, 'STEP대기_' 목록은 같은 저장본의 BOM `docs/bom/FSAP_v2.6.4_purchased.csv`로 갈음했다. 지난 STEP 재시도(`mech_step_wait.md`)도 같은 방법이었다.
- 요구서 5절의 구동 과제(M00~M08·M04R·M08R)와 구동 후보 DC2-01~DC2-08은 모두 해결이다. 남은 구동 후보는 **REG-01(전체 회귀 못 본 범위)** 하나다.
- 지난 실행(v3.9.2)은 '미완 — REG-01·STEPWAIT 진전 없음'으로 끝났다(`final_full_2026-11-04.md`). 같은 이유로 다시 막히지 않게(WF-123) 이번에는 두 가지가 다르다.
  - **LITE(모델 무게)를 맨 앞에 둔다.** 엔진 v3.9.3 WF-196의 새 과제다. 지난 회귀가 느렸던 원인은 세션 열기 377~429 s, 단계당 60 s였다. 열기를 줄이면 REG-01이 한 회차에 보는 범위가 늘어난다.
  - **STEPWAIT.** 2026-11-06 사용자가 미스미에 로그인해 두었다(실행 지시 (c)). 지난번 막힌 이유(로그인 풀림)가 사라졌다.
- 순서: LITE → STEPWAIT → REG-01. 세 과제 모두 기계 전체에 걸쳐 바디가 겹치므로 직렬이다.
- 지난 라운드 결과 JSON이 비어 있다(`[]`). 등급 재조정·직렬 복귀는 없다.

## 과제 표

| 순서 | id | 과제 | 출처 | 등급 | 유닛(0-8-3) | 내용·근거 | 합격 기준 |
|---|---|---|---|---|---|---|---|
| 1 | LITE | 모델 무게 줄이기 | 모델 무게 | M | U1·U2(사본 많은 구매품) | 아래 'LITE 상세' | 아래 'LITE 상세' |
| 2 | STEPWAIT | 형번 정하기·STEP 받기·실물 교체 | STEP 대기 | M | U2·U1·U4·U5·U6·U8 | 아래 'STEPWAIT 상세' | 받은 형번의 STEP대기_ 0, 교체 뒤 과제 범위 새 겹침 0, 볼 꼭대기 Z 0 ± 0.1 유지, 볼 정격 ≥ 203 N, 레벨러 물림 ≥ 5.5 유지 |
| 3 | REG-01 | 전체 회귀 못 본 범위 이어 보기 | 구동 후보 | S | 기계 전체(읽기만) | 아래 'REG-01 상세' | 못 본 범위의 기준선 밖 겹침 0, truncated·unmoved·stopped 0 |

### LITE 상세

내용·근거
- **열기 시간:** runstats 가장 긴 열기 493초(모델링). 지난 회귀 세션 8개 열기 377~429 s. 상한 240 s(엔진 안내서 '연결' 모델 무게, WF-196). 지난 실행 기록(history)에 LITE가 없다.
- **사본이 많은 구매품(서명 무리, BOM v2.6.4):**

| 형번 | 사본 수 | 모델 바디 |
|---|---|---|
| 볼 트랜스퍼 | 827 | `STEP대기_BALL_D25_M04` |
| CB5-16 | 310 | `CB5-16_M07K_*` 110, `CB5-16_M04K_*` 188 등 |
| HNTT8-5 | 188 + 168 + 132 | `HNTT8-5_M04K_*`, `HNTT8-5_M07_*`, `HNTT8-5_M04` |
| SFB5-10 | 102 | `SFB5-10_M04`·`_M04R` |
| HFC8-4080-B | 48 | |
| CB5-12 | 각 37~40 | M03·M05·M06·DC205 |
| 레벨러 | 36 + 15 | `HNTT8-8_M04`(레벨러 너트 36) 포함 |
| 판금 L 브래킷(가공품) | 72 + 42 + 22 | `P_M04_LBRKC_*`, `P_M07_LBRK_*`, `P_M04_LBRK_*` |

할 일
- ① 열기 시간을 무엇이 차지하는지 잰다.
- ② 같은 구매품 사본을 바디 하나 + 패턴, 또는 한 컴포넌트의 여러 occurrence로 바꾼다.
- 조인트로 따로 움직이는 사본은 occurrence로 둔다.
- 볼은 다음 STEPWAIT에서 실물로 바뀐다. 묶을 때 씨앗 바디 하나만 바꾸면 되게 해 둔다.

합격 기준
- 열기 240초 이하. 못 미치면 줄인 만큼을 보고한다.
- 부품 수·자리·`assembly.bom` 수량·사본별 bbox·무게중심, 모델 전체 bbox가 전후로 같아야 한다(`tools/out/lite_check.json`).
- 새 번호로 저장한다(v2.6.5).

### STEPWAIT 상세

모델 바디·형번은 BOM v2.6.4 기준이다. 형번 미정인 ①~④는 `step_wait.json` waiting에 없다(지난 재시도에서 형번 미정이라 뺐다). 그래서 다시 받아 보지 않은 것으로 보고 과제로 넣는다.

| 번호 | 형번(자료대기) | 모델 바디 | 할 일 |
|---|---|---|---|
| ① | 볼 트랜스퍼 Ø25.4 압입형 ×827(D-96·D-118) | `STEP대기_BALL_D25_M04` | 미스미 볼롤러 압입형 표기를 정한다. 정격 ≥ 203 N |
| ② | 레벨러 M8 Ø40(D-119 ×36, D-128 ×15) | `STEP대기_LEVELER_M8_M04`, `STEP대기_LEVELER_M8_M07` | 같은 형번이면 함께 정한다 |
| ③ | 멈춤나사 M4×25·너트 M4·와셔 M5(D-127) | `STEP대기_SETSCREW_M4x25_DC204_1·2`, `STEP대기_NUT_M4_DC204_1·2`, `STEP대기_WASHER_M5_DC204_1·2` | 미스미 표기로 형번을 정한다 |
| ④ | M3 열압입 인서트(D-125) | `STEP대기_INSERT_M3_M06_1·_2` | 미스미 표기로 형번을 정한다 |
| ⑤ | F39-LSGF ×8(D-135) | `STEP대기_F39-LSGF_M08_*` | step_wait waiting(미스미 미게재). 라운드 시작 STEP 재시도가 옴론 CAD로 본다 |
| ⑥ | IR1000-01BG ×3(D-129), VRXF-PB-60-10 ×3(D-113) | `STEP대기_IR1000-01BG_M08_N/F/S`, `STEP대기_VRXF-PB-60-10`·`_U5X`·`_U5W` | step_wait waiting. SMC CAD·니덱 CAD는 아직 안 봤다(실행 규칙 11로 허용) |

- 받기 전에 PartsLibrary `index.csv`를 먼저 본다.
- 미스미 머리에 '로그인 / 회원가입'이 떠 있으면 받지 않는다. 그때는 카탈로그 치수로 임시 형상을 유지하고 계속한다(실행 규칙 10·12).
- 회원가입·개인정보 입력·봇 확인 페이지가 나오면 넘기지 않고 자료대기에 남긴다.
- 정한 미스미 표기는 자료대기·결정로그에 적는다.
- LITE로 묶은 사본은 씨앗 바디만 바꿔 묶음을 유지한다.

### REG-01 상세

내용·근거
- v2.6.4에서 본 범위는 모두 기준선 밖 겹침 0이다: CYCLE_S 43~450, CYCLE_G1 0~128, STATES 24·25·33·34 일부, POSE 0~7. v2.6.3에서는 CYCLE_L·STATES·MAINT를 다 봤다(`mech_regression_7.md`, `mech_REG-01_model.md` 4절).
- 못 본 범위:
  - CYCLE_G1 129~514, CYCLE_G2 0~630
  - STATES 33·34, POSE 8~182(자세, 점당 300 s)
  - F_STATES 0~34(명세에서 뺐다)
  - MAINT_U7 일부
  - LITE·STEPWAIT로 바뀐 바디의 둘레

instructions
- 구상·수정 회차 없이 회귀 실행만 한다(WF-185).
- LITE·STEPWAIT를 반영한 새 저장본에 `mech_regrun8` 도구·`spec9.json`을 쓴다. 이미 본 줄을 빼고, 못 본 범위만 앞에서부터 regrun 상한 30분 안에서 이어 본다. 순서는 바뀐 바디 둘레 → G1 → G2 → 자세.
- 합격은 judge가 bad·truncated·unmoved·stopped 0으로 기계적으로 낸다.
- 남은 범위는 다음 회귀로 넘긴다.

## open 표

| 항목 | 수 | 내용 |
|---|---|---|
| 열린 구동 과제 | 0 | 5절 구동 행이 모두 해결 |
| 구동 후보 | 1 | REG-01 |
| 회귀 동작 문제 | 0 | 본 범위 겹침 0. 못 본 범위는 REG-01이 본다 |
| 디테일 | 0 | 구동 라운드 중에는 세지 않는다 |
| 형번이 정해졌는데 STEP대기_ | 3 | F39-LSGF ×8, IR1000-01BG ×3, VRXF-PB-60-10 ×3. step_wait waiting에 있다. 이유가 미스미 미게재라도 제조사 CAD(옴론·SMC·니덱)는 아직 안 봤다. 사용자 자료로만 풀리는 것이 아니어서 open에 센다 |

- LITE는 open에 세지 않는다(WF-196).
- 형번 미정·임시라 step_wait에 세지 않은 것
  - STEPWAIT ①~④에서 정할 것: 볼, 레벨러, DC2-04 체결품, M3 인서트.
  - 아직 정하지 않는 것: KC-40340(제조사 미확인 D-121), S-M5-2(D-122), 2400.05.12PZ(igus 형번 임시 D-115), 867 헤드(D-10).

## user_wait 표

| 항목 | 사용자가 줄 것 | 구동을 막나 |
|---|---|---|
| 재봉 헤드 기종 D-10·D-109 (`STEP대기_867-392342_UPPER·_NOSE·_LOWER`) | 견적 비교 뒤 기종 결정 + 그 기종 공식 치수·STEP | 아니오(867 임시 형상) |
| 서보 MHMF022L1U2M ×3·MHMF042L1U2M (D-111·D-112·D-115) | 파나소닉 CADENAS 가입 뒤 STEP을 직접 받거나, 미스미 MSMF로 바꿀지 결정 | 아니오(□60×L80 임시) |
| 납품처 안전 기준 D-38 | 안전 거리·정지 시간 기준 | 아니오(ISO 13855 참고 임시) |
| 특허 KR102139457B1 D-102 | 변리사 확인 여부 결정 | 아니오 |
| REG-01 자세 범위(POSE·F_STATES) 진행 방식 | 30분 상한 안에서 자세(점당 300 s)를 이어 볼지, 자세만 따로 도는 실행·상한 조정을 할지 | 아니오(LITE 뒤 회귀로 이어 본다) |

## 미스미 로그인

- 결과 값은 **풀림**이다. 지난 라운드 결과가 없어서 `tools/out/step_wait.json`의 login 값(2026-11-06 10:32 확인)을 규칙대로 썼다.
- 실행 지시 (c)에는 그 뒤 사용자가 로그인해 두었다고 되어 있다. 과제 정리부는 브라우저로 확인하지 않았다. 구매부가 받기 전에 머리 표시로 다시 확인한다.

## 워크플로우 메모

- 규칙대로 login을 step_wait.json(풀림)에서 가져오면, 그 뒤 사용자가 다시 로그인한 사실이 반영되지 않는다. 지난 정리부와 같은 메모로, 반복이다.
- 'STEP대기_ 목록은 모델에서 읽기만'은 열기가 8분인 모델에서 정리부 시간을 크게 쓴다. 같은 저장본의 BOM으로 갈음해도 되는지 기준이 없다.
