hyeunung/FSAP/docs/reports/final_full_2026-11-04.md

# 전체 최종 보고 — MAT-RS-001 구동 라운드 (엔진 v3.9.2, 2026-11-04~06)

**상태: 미완 — 같은 과제(REG-01, STEPWAIT)가 세 라운드를 돌아도 안 풀림 — 진전 없음**

최신 설계 파일: `3D_Modeling/FSAP_v2.6.4.sc`

## 1. 사용자 자료 대기

| 항목 | 사용자가 줄 것 | 구동을 막나 |
|---|---|---|
| 재봉 헤드 기종 D-10·D-109 (STEP대기_867-392342_UPPER·_NOSE·_LOWER) | 견적 비교 뒤 기종 결정, 그 기종 공식 치수·STEP | 아니오 |
| 서보 MHMF022L1U2M ×3 (D-111·D-112·D-115) | 파나소닉 CADENAS에서 개인정보 입력 뒤 STEP 받기(직접) | 아니오 |
| 납품처 안전 기준 D-38 | 안전 거리·정지 시간 기준 | 아니오 |
| 특허 KR102139457B1 D-102 | 변리사 확인 여부 결정 | 아니오 |

## 2. 구매품 CAD 사이트 로그인

| 사이트 | 상태 (보고 시각 Chrome 새 탭 확인) |
|---|---|
| 미스미 | **풀림** — 머리에 '로그인 / 회원가입'이 떠 있음 (2026-11-06 확인) |

라운드별 로그인 문제로 못 받은 형번:

| 라운드 | 로그인 | 못 받은 형번(missing) | 막힘(blocked) |
|---|---|---|---|
| 1 | 풀림 | 볼 트랜스퍼 Ø25.4 압입형(D-96), FHS-M5-10(SFB5-10), IR1000-01BG, SS5Y3-20-06, SY3120-5LZD-M5, F3SG-4RA1520-14, LR6-302WJBW-RYG, KDM10-06, KQ2L08-01AS, HFS8-4080-2370, CB4-20, CB4-12 | MHMF022L1U2M |
| 2 | 됨 | — | — |
| 3 | 풀림 | F39-LSGF, CB5-6, HFS8-4080-1650, HFS8-4080-1175 | IR1000-01BG |
| 4 | 확인 못 함 | — | CB5-6, IR1000-01BG |
| 5 | 됨 | — | — |
| 6 | 풀림 | F39-LSGF, IR1000-01BG, MHMF022L1U2M, VRXF-PB-60-10, KC-40340, 2400.05.12PZ | — |

## 3. 남은 것

| 칸 | 수 | 항목 |
|---|---|---|
| 열린 구동 과제 | 0 | — |
| 구동 후보 | 1 | REG-01 전체 회귀 못 본 범위 이어 보기 |
| 동작 문제 | 0 | — |
| 디테일 | 0 | (디테일링 아직 안 함) |
| STEP대기 구매품 | 3 | F39-LSGF, IR1000-01BG, VRXF-PB-60-10 (그 밖 STEPWAIT 대상: 볼 Ø25.4 ×827, 레벨러 M8 ×51, 멈춤나사·너트·와셔 DC2-04, 인서트 M3 M06) |

다음 과제(정리부 안): STEPWAIT(M) — 미스미 로그인 중 STEP 받기·실물 교체 / REG-01(S) — 못 본 범위만 회귀.

구동 후보:

| id | 무엇 | 끝 조건 |
|---|---|---|
| REG-01 | 6회차 '설계 미달(수정 상한)'. 본 범위는 모두 겹침 0. 못 본 범위만 남음 | 못 본 범위 겹침 0, truncated·unmoved·행정 막힘 0 |

전체 회귀가 못 본 범위(마지막 라운드 6 기준):

| 범위 | 이유 |
|---|---|
| CYCLE_G1 129~514 | 어림 초과(시작 전) |
| CYCLE_G2 0~630 | 어림 초과(시작 전) |
| STATES 33·34, POSE 0~182 | 자세 어림 초과(점당 300 s) |
| CYCLE_L 0~716, STATES 0~23·31~32, MAINT_HEAD 0~1, MAINT_U7 0~8·10~13 | v2.6.4 어림 초과 (v2.6.3에서 다 봤고 겹침 0, 차이는 U8 고정 볼트 2개) |
| F_STATES 0~34 | 명세에서 뺌(자세) |
| STEPWAIT로 바뀐 바디 둘레 | 다음 교체 뒤 |

## 4. 라운드별 결과

| 라운드 | 과제 | 결과 | 출력 토큰 | 최종 보고 |
|---|---|---|---|---|
| 1 | M04R, M08, M07-K1, DC2-03, STEPWAIT | M04R 완료(v2.4.0), M08 완료(v2.5.2), M07-K1 완료(v2.5.3), DC2-03 완료(v2.5.5, 크기 M→L). 후보 DC2-07 | 2,025,041 | `docs/reports/mechanism/final_mech_2026-11-04_M04R-M08-M07-K1-DC2-03-STEPWAIT.md` |
| 2 | STEPWAIT, DC2-07, REG-01 | STEPSWAP 완료(v2.5.7), DC2-07 이미 해결, REG-01 설계 미달. 후보 DC2-08 | 703,247 | `docs/reports/mechanism/final_mech_2026-11-04_STEPWAIT-DC2-07-REG-01.md` |
| 3 | STEPWAIT, M08R, DC2-08 | STEPSWAP 완료(v2.5.9), M08R 완료(v2.6.0), DC2-08 완료(v2.6.2) | 666,665 | `docs/reports/mechanism/final_mech_2026-11-04_STEPWAIT-M08R-DC2-08.md` |
| 4 | STEPWAIT, REG-01 | REG-01 모델 반영·문제 남음(v2.6.3) | 184,552 | `docs/reports/mechanism/final_mech_2026-11-04_STEPWAIT-REG-01.md` |
| 5 | STEPWAIT, REG-01 | STEPSWAP 완료(v2.6.4), REG-01 모델링 안 됨 | 140,457 | `docs/reports/mechanism/final_mech_2026-11-04_STEPWAIT-REG-01_2.md` |
| 6 | STEPWAIT, REG-01 | REG-01 설계 미달(수정 상한) | 93,956 | `docs/reports/mechanism/final_mech_2026-11-04_STEPWAIT-REG-01_3.md` |

합계 출력 토큰 3,813,918. 부서별 시간·토큰은 `runs/<실행>/summary.json`. 디테일링: 안 함(구동 미완).

## 5. 사용자 결정

| 결정 | 내용 |
|---|---|
| REG-01 진행 방식 | 회귀 결과로만 풀리는 과제가 세 라운드 반복됨. 못 본 범위를 회귀 전용 실행으로만 이어 볼지, 자세(POSE·F_STATES) 범위를 이 기계 회귀에서 뺄지 |
| 재봉 헤드 기종 | D-10 견적 비교 뒤 결정 |
| 특허 D-102 | 변리사 확인 여부 |

## 6. 사람이 할 일

| 할 일 | 이유 |
|---|---|
| 미스미 다시 로그인 | 보고 시각 로그인 풀림. STEPWAIT(볼·레벨러·F39-LSGF 등) 받기에 필요 |
| 파나소닉 CADENAS에서 MHMF022L1U2M STEP 받기 | 개인정보 입력 필요 |
| 오리엔탈모터·니덱 등 로그인 필요한 사이트 STEP | 로그인 필요 형번(VRXF-PB-60-10 등) |
| 납품처 안전 기준 D-38 전달 | 외장·안전 단계 |
