hyeunung/FSAP/docs/reports/queue_2026-11-04_5.md

# 과제 정리 — 구동 라운드 5회차 앞 (2026-11-06)

대상 문서 `3D_Modeling/FSAP_v2.6.3.sc`(tools/config.json doc). 과제 정리부는 CAD를 열지 않았다. STEP대기_ 목록은 전체 회귀가 같은 파일에서 뽑은 바디 표 `tools/out/mech_regrun6/bodies_v263.json`(2,649바디)에서 읽었다. v2.6.2와 형상이 같다(`compare_v262_v263.json`, 추가·삭제·이동 0). 저장한 것은 없다.

## 요약
- 요구서 5절의 구동 과제 M00~M08·M04R·M08R은 모두 해결됐다. 구동 후보 DC2-01~DC2-08도 해결됐다. **남은 구동 후보는 REG-01(전체 회귀 못 본 범위) 하나다.**
- 4회차 REG-01은 '모델 반영·문제 남음'이다. 동작 문제는 0이고, 못 본 범위만 남았다.
  - v2.6.3에서 CYCLE_L 0~716 전 구간은 겹침 0으로 다 봤다(mech_regression_5.md).
  - 지난 라운드 결과에 등급 재조정·직렬 복귀는 없다. 구동 후보 점검(mech_drive_check.md, v2.6.3)이 낸 새 후보도 0이다.
- 형번이 정해졌는데 `STEP대기_`로 남은 구매품은 두 형번이다.
  - CB5-6 ×2
  - IR1000-01BG ×3(+ 받침 3)
  - 둘 다 step_wait.json의 waiting에 있다. 사유는 blocked(미스미 봇 확인 페이지)이고, 로그인이나 사이트에 없는 것이 이유가 아니다. 그래서 open.step_wait에 2로 센다.
- 사용자가 이번 요청에서 "미스미도 로그인했어 미스미 처리할거 있으면 해 또 로그인 풀리기전에"라고 했다. 그래서 STEPWAIT 과제를 넣어 라운드 시작에 바로 받게 한다. 사용자 요청이 우선이다.
- 미스미 로그인은 **됨**이다(사용자 알림, 4회차 최종 보고도 됨). 라운드 시작 구매부가 화면 머리에서 다시 확인한다(실행 규칙 12).

## 과제 표

| id | 과제 | 출처 | 등급 | 직렬 | 합격 기준 |
|---|---|---|---|---|---|
| STEPWAIT | STEP대기 실물 교체 r5: CB5-6 ×2, IR1000-01BG ×3(+받침). 받을 수 있으면 함께: KC-40340, F39-LSGF 형번 확인 | STEP 대기 | M | 아니오 | 받은 형번의 STEP대기_ 0, 교체 뒤 과제 범위 새 겹침 0, IR1000 실물로 게이지 시선 틈 다시 잼(M08-X6) |
| REG-01 | 전체 회귀 못 본 범위 r3: CYCLE_S 나머지 → G1 → G2 → MAINT_U7 9 → 자세 | 구동 후보 | M | 아니오(모델 안 바꾸는 검증, 발자국 빈칸이라 사실상 혼자) | 본 범위 기준선 밖 겹침 0·truncated 0·행정 막힘 0, 손 조정 조인트 오염 0 |

### STEPWAIT
- 유닛: U8 공압·안전(0-8-3 표)
  - 보 앞판 레귤레이터 3개: `STEP대기_IR1000-01BG_M08_N/F/S` + `_BRKT`. X 675~925 · Y 47.6~119.9 · Z 475~565, D-132.
  - 옆 라이트 커튼 2E 금구 볼트: `STEP대기_CB5-6_M08_PY_LC2F` ×2. X −2319~−2311 · Y −1566~−1555 · Z 96~104 / 696~704, D-135.
- 지난 시도(4회차, mech_step_wait.md): 미스미 검색에 봇 확인 페이지가 떠서 넘기지 않았다. 로그인이 된 지금 다시 받는다. 봇 페이지가 다시 뜨면 넘기지 않고 waiting에 남긴다. 임시 형상은 그대로 둔다(실행 규칙 10).
- 공용 창고: PartsLibrary `index.csv`·`STEP/`에 CB5-6·IR1000-01BG가 없다(2026-11-06 확인).
  - 같은 시각 별도 작업이 받은 형번이 들어와 있을 수 있다. 받기 전에 다시 본다.
  - 새로 받으면 `purchased-step/<형번>/`에 넣는다. PartsLibrary에도 복사하고 index.csv에 한 줄을 더해 커밋·푸시한다.
- 받을 수 있으면 함께 볼 것(open에는 세지 않는다)
  - `STEP대기_KC-40340_M05`·`_HOOK`(D-121): 4회차에서 '형번 미정'으로 뺐다. 미스미·제조사에서 같은 형번이 나오면 받는다. 갈고리는 J_U7_LATCH를 유지한다.
  - `STEP대기_F39-LSGF_M08_*` ×8(D-135): 형번이 기억값이다. 옴론 CAD에서 F3SG-4RA0800-14 기본 금구 형번을 확인한다.
  - BALL(D-96·D-118)과 LEVELER(D-119): 형번이 아직 정해지지 않았다. 미스미 1안 후보 형번만 자료대기에 적고, 모델 교체는 하지 않는다. 827개·51개라 돈이 드는 선택이다.
- 근거: `tools/out/step_wait.json`, mech_step_wait.md, final_mech_2026-11-04_STEPWAIT-REG-01.md '남은 문제', 자료대기 D-132·D-135.

### REG-01
- 유닛: 기계 전체(0-8-3 U1~U8). 개념을 바꾸지 않는다. 0-8-4 한 사이클 동작 연구의 검증이다.
- 현재 상태(mech_regression_5.md)
  - 본 범위: CYCLE_L 0~716 전부, CYCLE_S 0~42 일부, STATES 0~24·31·32, MAINT_HEAD 0~1, MAINT_U7 0·3·4·7·8·12·13. 모두 겹침 0.
  - 못 본 범위
    - CYCLE_S 43~44·49·53~54·58~59·62~64·67~69·71~450
    - CYCLE_G1 0~514, CYCLE_G2 0~630
    - MAINT_U7 9
    - STATES 25·33·34, POSE 0~182, F_STATES 0~34
- 이번에 다르게 하는 것(WF-123: 같은 이유로 막히지 않게)
  - 지난 회귀의 명세(`tools/out/mech_regrun6/spec6.json`)에서 다 본 줄(CYCLE_L·STATES 연구·MAINT_HEAD)을 뺀다. 묶음 순서는 CYCLE_S 43~450 → CYCLE_G1 → CYCLE_G2 → MAINT_U7 9 → 자세다.
  - 세션을 다시 쓰는 묶음은 `chunk7.py` 방식을 쓴다. 단계 앞에 연구 키가 아닌 손 조정 조인트 J_U6_HGT·J_U7_HGT를 0으로 몬다. 자세 묶음은 따로 세션을 둔다(WF-183 오염).
  - 상한 30분(요구서 6-4) 회귀 한 번에 약 300단계를 본다. 남은 연구 약 1,540단계와 자세 186점(점당 300 s)은 이번에도 다 못 볼 수 있다. 그러면 남은 것을 못 본 범위로 적고 다음 라운드로 넘긴다. 상한은 넘기지 않는다.
- 근거: mech_regression_5.md 5절, 요구서 5절 REG-01 행, 요구서 6-4.

## open 표

| 항목 | 수 | 내용 |
|---|---|---|
| 열린 구동 과제 | 0 | M00~M08·M04R·M08R 모두 해결 |
| 구동 후보 | 1 | REG-01 |
| 회귀 동작 문제 | 0 | v2.6.3 회귀 본 범위 겹침 0·행정 막힘 0. 오염 24단계는 다시 재서 0. 못 본 범위는 REG-01 몫 |
| 디테일 | 0 | 구동 라운드 중이라 0으로 둔다(디테일링 몫) |
| 형번 정해진 STEP대기_ | 2 | CB5-6 ×2, IR1000-01BG ×3. 둘 다 봇 확인 페이지로 막혔고, 이번 STEPWAIT에서 재시도 |

## user_wait 표

| 항목 | 사용자가 줄 것 | 구동을 막나 |
|---|---|---|
| 재봉 헤드 기종 D-10(`STEP대기_867-392342` UPPER·NOSE·LOWER 임시) | 분리 개조 3중 이송 헤드 견적·기종·STEP | 아니오(867 PDF 임시 형상) |
| 납품처 안전 기준 D-38(라이트 커튼·외장) | 납품처 안전 규격 | 아니오 |
| MHMF022L1U2M ×3(파나소닉 CADENAS) | 개인정보 입력이 필요한 사이트라 사용자가 직접 받기 | 아니오(□60×L80 임시) |
| VRXF-PB-60-10 ×3(니덱, 미스미 아님) | 니덱 CAD에서 STEP 받기 또는 형번 확인 | 아니오(□60 L75 임시) |
| 2400.05.12PZ ×2(igus 끝 브래킷, 형번 임시) | igus 형번 확인·STEP | 아니오 |
