hyeunung/FSAP/docs/reports/queue_2026-11-04_4.md

# 과제 정리 — 구동 라운드 4회차 앞 (2026-11-06)

대상 문서 `3D_Modeling/FSAP_v2.6.2.sc`(tools/config.json doc). 과제 정리부는 CAD를 열지 않았다. STEP대기_ 목록은 전체 회귀가 같은 파일에서 뽑은 바디 표 `tools/out/mech_regrun5/bodies_v262.json`(2,649바디)에서 읽었다. 저장한 것은 없다.

## 요약
- 요구서 5절의 구동 과제 M00~M08·M04R·M08R은 모두 해결됐다. 구동 후보 DC2-01~DC2-08도 해결됐다. **남은 구동 후보는 REG-01(전체 회귀 못 본 범위) 하나다.**
- 지난 라운드 결과에는 등급 재조정이 없고(DC2-03은 1회차에서 L로 처리), 직렬 복귀도 없다. 구동 후보 점검(mech_drive_check.md, v2.6.2)이 낸 새 후보도 0이다.
- 형번이 정해졌는데 `STEP대기_`로 남은 구매품은 CB5-6 ×2(미스미, step_wait.json의 waiting에 없음)와 IR1000-01BG ×3(waiting, 사유 blocked: 봇 확인 페이지)이다. 그래서 STEPWAIT 과제를 넣는다.
- 미스미 로그인: 지난 라운드 끝에는 **풀림**이었다. 그 뒤 사용자가 "미스미도 로그인했어"라고 알렸으므로 **됨**으로 적는다. 라운드 시작 구매부가 화면 머리에서 다시 확인한다(실행 규칙 12).

## 과제 표

| id | 과제 | 출처 | 등급 | 직렬 | 합격 기준 |
|---|---|---|---|---|---|
| STEPWAIT | STEP대기 실물 교체 r4: CB5-6 ×2, IR1000-01BG ×3(+F39-LSGF 형번 확인, HFS8-4080-1650·1175 실물) | STEP 대기 | M | 아니오 | 받은 형번의 STEP대기_ 0, 교체 뒤 과제 범위 새 겹침 0 |
| REG-01 | 전체 회귀 못 본 범위: 사이클 연구에 U7 조인트 키 넣고 못 본 범위 보기 | 구동 후보 | M | 아니오(발자국 빈칸이라 사실상 혼자) | 못 본 범위 간섭 0, U7 상태 넘어옴 0 |

### STEPWAIT
- 유닛: U8 공압·안전(0-8-3 표, 보 앞판 레귤레이터 3개·기계 옆 라이트 커튼).
- 현재 상태
  - `STEP대기_CB5-6_M08_PY_LC2F:1·:2`(M5×6, 옆 커튼 LC2F 판 → F39 탭 판, 머리 −Y, Y −1630~−1566, 물림 3, 디테일 M08R-D1). 지난 라운드에 로그인이 풀려 못 받았다.
  - `STEP대기_IR1000-01BG_M08_N/F/S`(+`_BRKT`)(W25×D45×H90 + 게이지 Ø26, 몸통 Z 475~547, D-132). 2026-11-05에 Akamai 봇 확인 페이지가 떠서 받지 않았다. 봇 페이지가 다시 뜨면 넘기지 않고 다시 waiting에 둔다.
- 같이 볼 것(받을 수 있으면)
  - `STEP대기_F39-LSGF_M08_*` ×8: 형번이 기억값이다(D-135). 옴론 CAD에서 F3SG-4RA0800-14용 기본 금구 형번을 확인하고 STEP을 받는다(실행 규칙 11, 제조사 사이트 허용). 확인하지 못하면 임시 형상을 유지한다.
  - HFS8-4080-1650_M08_FL·1175_M08_FR·_R: 지금은 1900 STEP 끝면을 오프셋해 만들었다(실행 규칙 18). 실물 STEP을 받을 수 있으면 받는다. 못 받아도 열린 수에 세지 않는다.
- 공용 창고: PartsLibrary에 CB5-6·IR1000-01BG·F39-LSGF·HFS8-4080-1650/1175가 없는 것을 확인했다(2026-11-06). 새로 받으면 PartsLibrary에 복사하고 index.csv에 한 줄을 더한다.
- 근거: BOM `docs/bom/FSAP_v2.6.2_purchased.csv` 109·110행, `tools/out/step_wait.json`, final_mech_2026-11-04_STEPWAIT-M08R-DC2-08.md 맨 위 요약, mech_drive_check.md 2-3.

### REG-01
- 유닛: 기계 전체(0-8-3 U1~U8). 개념을 바꾸는 과제가 아니다. 0-8-4 한 사이클 동작 연구가 대기 자세에서 맞게 도는지 보는 검증이다.
- 현재 상태: 요구서 5절 기준 미해결. 2회차는 수정 상한에서 '설계 미달'로 끝났다. 3회차 회귀(mech_regression_4.md, v2.6.2)에서 본 범위는 겹침 0·동작 문제 0이다. 하지만 못 본 범위가 크다.
  - 자세: POSE 0~182, STATES 24·25·33·34, F_STATES 0~34
  - 사이클: CYCLE_L 79~694, CYCLE_G1 0~514, CYCLE_G2 0~630, CYCLE_S 0~450
  - 그 밖: STATES 6~23·32, MAINT_U7 0·3·4·7~9·12·13
  - 의심 범위 117단계의 U7 바디
- 이번에 다르게 하는 것(WF-123: 같은 이유로 다시 막히지 않게)
  - 3회차 회귀가 원인을 찾았다. CYCLE_L·S·G1·G2·MAINT_HEAD 연구는 U7 조인트 6개(CST_X·CST_Y·CUT·TUCK·FEED·LATCH, 5004~5009)를 키로 잡지 않는다. 그래서 같은 세션에서 앞 연구(SEAM_U7·MAINT_U7)의 값이 넘어온다.
  - ① 모델링: 이 연구들에 U7 조인트 6개를 대기값 0 키로 넣는다. 반대로 SEAM_U7·MAINT_U7에는 서로 잡지 않는 U7 조인트를 0 키로 넣는다. 형상·조인트 정의는 바꾸지 않는다. 새 번호로 저장한다.
  - ② 회귀: 실측 단계당 시간(40~60 s, 자세 135~265 s)으로 시험 단계 수와 묶음을 정한다. 상한 30분 안에서 못 본 범위를 먼저 본다(사이클 연구 우선). 그래도 남는 범위는 못 본 범위로 적는다.
- 근거: mech_regression_4.md 3·5절, 요구서 5절 REG-01 행, 요구서 6-4.

## open 표

| 항목 | 수 | 내용 |
|---|---|---|
| 열린 구동 과제 | 0 | M00~M08·M04R·M08R 모두 해결 |
| 구동 후보 | 1 | REG-01 |
| 회귀 동작 문제 | 0 | v2.6.2 회귀 본 범위 겹침 0·행정 막힘 0. 못 본 범위는 REG-01 몫 |
| 디테일 | 0 | 구동 라운드 중이라 0으로 둔다(디테일링 몫) |
| 형번 정해진 STEP대기_ | 2 | CB5-6 ×2(아직 다시 받아 보지 않음), IR1000-01BG ×3(봇 확인 페이지로 막힘) |

## user_wait 표

| 항목 | 사용자가 줄 것 | 구동을 막나 |
|---|---|---|
| 재봉 헤드 기종 D-10(867-392342 UPPER·NOSE·LOWER 임시) | 분리 개조 3중 이송 헤드 견적·기종·STEP | 아니오(867 PDF 임시 형상) |
| 납품처 안전 기준 D-38(라이트 커튼·외장) | 납품처 안전 규격 | 아니오 |
| MHMF022L1U2M ×3(파나소닉 CADENAS) | 개인정보 입력이 필요한 사이트라 사용자가 직접 받기 | 아니오(□60×L80 임시) |
| VRXF-PB-60-10 ×3(니덱, 미스미 아님) | 니덱 CAD에서 STEP 받기 또는 형번 확인 | 아니오(□60 L75 임시) |
| 2400.05.12PZ ×2(igus 끝 브래킷, 형번 임시) | igus 형번 확인·STEP | 아니오 |
| 볼 트랜스퍼 D-96·D-118 ×827(형번 미확정) | 형번 결정(1안 미스미 볼롤러 압입형, 정격 ≥ 203 N). 돈이 드는 선택 | 아니오(임시 외형) |
| 특허 KR102139457B1 D-102 | 변리사 확인 여부 결정 | 아니오 |

형번이 아직 정해지지 않은 STEP대기_(LEVELER_M8 D-119·D-128, INSERT_M3 D-125, KC-40340 D-121, S-M5-2 D-122, SETSCREW·NUT·WASHER D-127)는 open.step_wait에 세지 않는다. 형번을 고르는 것은 디테일링 몫이다.

## 워크플로우 메모
- 지시문은 로그인 상태를 지난 라운드 결과에서 가져오라고 한다. 이번에는 사용자가 실행 직전에 "미스미도 로그인했어"라고 알렸다. 사용자 말이 더 최근이라 그것을 따랐다.
