hyeunung/FSAP/docs/reports/queue_2026-11-04_3.md

# 과제 정리 — 구동 라운드 3회차 (2026-11-05)

과제 정리부(PM). 읽기만 했다(CAD 열지 않음, 모델·문서 수정 없음). 최신 문서 `3D_Modeling/FSAP_v2.5.8.sc`(tools/config.json doc).

**미스미 로그인: 됨** (지난 라운드 결과 login 됨, 2026-11-04 23시 확인. 사용자도 이번 실행 앞에 로그인했다고 알림).

## 읽은 것
- 요구서 5절 과제 표: 해결 아닌 구동 행은 **M08R**(라이트 커튼 짧게, C-32) 하나. 구동 후보 행 REG-01은 '미해결'로 남아 있으나 결정로그 REG-02(2026-11-04)가 못 본 범위 약 1,900단계를 디테일로 넘기고 다음 회귀에서 보게 했다. DC2-03·DC2-07·STEPSWAP은 해결.
- 구동 후보: `docs/reports/mechanism/mech_drive_check.md`(v2.5.8, 2026-11-05)의 **DC2-08** — 요구서 표에 아직 행이 없다.
- 모델의 `STEP대기_` 목록: CAD를 다시 열지 않고 같은 파일의 회귀 바디 덤프 `tools/out/mech_regrun4/bodies_v258.json`(2,641바디, v2.5.7→v2.5.8 바디 변화 0)에서 셌다.
- `tools/out/step_wait.json`: waiting = MHMF022L1U2M(login), VRXF-PB-60-10(not_found, 니덱 CAD), IR1000-01BG(not_found, 브라우저 안 씀), F3SG-4RA1520-14(not_found).
- runstats: 실행 6개, 직전 8.2 h. 시간 큰 부서 모델링 39 %.
- 최종 보고 `final_mech_2026-11-04_STEPWAIT-DC2-07-REG-01.md`: 본 범위 문제 0, 남은 회귀 동작 문제 0.

## 과제 표
| id | 과제 | 출처 | 등급 | 유닛(0-8-3) | 합격 기준 | 직렬 |
|---|---|---|---|---|---|---|
| STEPWAIT | STEP대기 실물 교체 | STEP 대기 | S | U5·U7·U8 | 아래 형번 STEP대기_ 0, 교체 뒤 과제 범위 새 겹침 0 | 아니오 |
| M08R | 라이트 커튼 짧게 + 기둥 줄임 (C-32) | 요구서 과제 | M | U8 | 실제 있는 형번(F3SG-4RA0800-14 실물 STEP), 기둥 위끝 ≤ 커튼 위끝 + 캡, ISO 13855 넘어 닿기 손계산 결정로그에, 과제 범위 간섭 0 | 아니오 |
| DC2-08 | KDM10 소켓을 높이 조정 따라가게 | 구동 후보 | M | U7·U8 | J_U7_HGT −4·0·+6 × J_U7_CST_X 0·25에서 플러그–소켓 짝 축 어긋남 0, 과제 범위 간섭 0 | 아니오 |

STEPWAIT 형번(step_wait.json waiting에 없음, 형번 정해짐):
- CB6-16 ×2(`STEP대기_CB6-16_M03_1·2`), CB4-25 ×4(`STEP대기_CB4-25_M08`): 실물 STEP이 `purchased-step/`·PartsLibrary에 있다(외형 같음, 교체만).
- KC-40340(`STEP대기_KC-40340_M05`·`_HOOK`, D-121), igus 2400.05.12PZ(`STEP대기_2400.05.12PZ_F·_M`): 저장소에 없음 — 로그인 된 지금 받는다.
- 덧붙여 재시도: IR1000-01BG ×3(waiting 이유가 '브라우저 안 씀'이라 지금 미스미/SMC CAD로 받을 수 있음), VRXF-PB-60-10 ×3(니덱 CAD).

## open 표
| 칸 | 수 | 내용 |
|---|---|---|
| 구동 과제 | 1 | M08R |
| 구동 후보 | 1 | DC2-08 |
| 회귀 동작 문제 | 0 | 본 범위 문제 0. REG-01 못 본 범위는 REG-02로 디테일·다음 라운드 끝 전체 회귀 몫 |
| 디테일 | 0 | 구동 라운드 중 0으로 둔다 |
| STEP 대기 | 6 | CB6-16, CB4-25, KC-40340, 2400.05.12PZ, IR1000-01BG, VRXF-PB-60-10 (F3SG-4RA1520-14는 없는 형번이라 M08R로 대체) |

## user_wait 표
| 항목 | 사용자가 줄 것 | 구동 막음 |
|---|---|---|
| 재봉 헤드 기종 D-10(STEP대기_867-392342 UPPER·NOSE·LOWER) | 견적 뒤 기종·실물 치수·STEP | 아니오(867 PDF 임시 형상) |
| 납품처 안전 기준 D-38(라이트 커튼 안전 거리·외장) | 납품처 기준 | 아니오(ISO 13855 참고 임시) |
| MHMF022L1U2M ×3 STEP(파나소닉 CADENAS 개인정보 입력) | 직접 받기 또는 입력 허락 | 아니오 |
| 규칙 18의 STEP 없는 형번(CRBH5013AUUC1 IKO 502, AZM66AC-PS25·VB-004-E2 로그인) — v2.0에서 쓰일 때만 | 사이트 로그인·받은 파일 | 아니오 |
| 볼 트랜스퍼 형번 D-96·D-118(STEP대기_BALL_D25 ×827), 레벨링 패드 D-119(×51) | 형번 확정(사진 비례·카탈로그) | 아니오 |
| 특허 KR102139457B1 변리사 확인 D-102 | 사용자 결정 | 아니오 |

## 메모
- REG-01은 같은 이유(호출 시간·상한)로 막혀 다시 넣지 않았다(WF-123). 라운드 끝 전체 회귀가 v2.5.8 spec_v258_A1·A2/B1~B6로 남은 범위를 이어 본다.
- DC2-08은 요구서 5절 표에 행이 없다 — 이번 라운드 문서 담당이 '구동 후보' 행으로 넣는다.
- M08R 실물 단면 38.7 × 42.5 × 866.5(임시 30 × 30 × 1560보다 굵음): 금구 `STEP대기_F3SG-BRKT_M08_*` 8개도 실물 금구로 바꾸고 기둥 HFS8-4080 면 자리를 다시 본다.
- M08R과 DC2-08은 공간 상자가 겹친다(DC2-08 X 10~142가 M08R X −2343~400 안). 실제 바디는 떨어져 있으나(M08R 기둥·커튼 X ≤ −2230 또는 ≥ 330), 상자로만 보면 동시 묶음에서 직렬로 갈 수 있다.
