hyeunung/FSAP/docs/reports/queue_2026-11-04_1.md

# 과제 정리 — 구동 라운드 1회차 (2026-11-04, 엔진 v3.9.2)

- 기준 모델: `3D_Modeling/FSAP_v2.3.4.sc`(tools/config.json doc). 읽기만(CLI `document.inspect`, 바디 4,141개, 저장 안 함, 결과 `tools/out/queue_1104/inspect_out.json`).
- 미스미 로그인: **됨** — 사용자 메시지("미스미도 로그인했어") 기준. 지난 라운드 결과 없음, `tools/out/step_wait.json`은 v2.0.1 때 것이라 '확인 못 함'으로 남아 있음. 구매부는 받기 전에 머리의 '로그인 / 회원가입'을 다시 본다(실행 규칙 12).
- runstats: 실행 4개, 최근 M00(v3.8.1) 1.2 h. M01~M07 실행 기록은 runs에 없음. 시간 큰 부서는 모델링 27 %, 기구설계 18 %, 회귀 12 %.
- 남은 회귀 동작 문제: 없음(M07-Z04 "실패·남은 동작 문제: 없음"). 라운드 끝 전체 회귀는 아직 안 함.
- `tools/out/mech_M08/`(지난 실행 중간 산출물, catalog.md·cand.json 프로브)은 참고만 한다. M08은 처음부터 다시.

## 과제 표

| id | 과제 | 유닛(0-8-3) | 출처 | 등급 | 직렬 | 합격 기준 |
|---|---|---|---|---|---|---|
| M04R | U2 볼 테이블 사진대로 다시(C-31) | U2 | 요구서 과제 | M | 아니오 | 볼 피치 100 격자(약 650개, D-96 임시), `P_M04_INSERT` 없음, 받침 띠 `P_DC205_STRIP` 유지, 매트 3장 전 구간 뒷면 받침(볼 0개 자세는 받침 면적 비율로 판정하고 결정로그에 적음), 볼 하나 하중 손계산(D-92 임시 누름) SF ≥ 2, WP_* 기본 숨김, 과제 범위 간섭 0 |
| M08 | U8 공압·안전 자리 | U8 | 요구서 과제 | M | 아니오 | 레귤레이터 3·밸브·라이트 커튼 2쌍·경광등·HMI 자리, 손잡이·게이지까지 손 거리 ≤ 600(D-82), 라이트 커튼 시야가 로딩 면(Y −1605~−1555) 전폭·높이를 덮음, 배관 길 막힘 0, 과제 범위 간섭 0 |
| M07-K1 | 받침틀 브래킷 교체(M5, 렌치 길) | U1(+U2 받침) | 구동 후보 | M | 아니오 | HBLFSN8_M07 ×55 → 판금 L SUS304 t6 + CB5-16 + HNTT8-5, M04 HBLFSN8 ×88·CB8-16 ×176 같은 기준 확인·교체, 새 볼트 빼는 길 max(30, L+5)×머리 지름 겹침 0, 물림 ≥ 1.5d, 손계산 SF ≥ 2, 과제 범위 간섭 0, floating 0 |
| DC2-03 | 아랫유닛 북 교체 길 | U3(+U2) | 직렬 복귀 | M | 예 | 북 빼는 길·떨어뜨림 길·팔 길 겹침 0, 손 거리 ≤ 600(D-82), 테이블 윗면 이음 추가 없음, 과제 범위 간섭 0 |
| STEPWAIT | STEP대기_ 실물 교체 | U1·U3·U4·U5·U6·U7 | STEP 대기 | S | 아니오 | 받은 형번의 STEP대기_ 바디 0, 바꾼 바디 위치·자리 이전과 같음(겹침 0), 못 받은 것은 이유와 함께 step_wait.json waiting |

### 과제별 메모

- **M04R**: 지금 볼 2,596 + 고하중 28(실측: `STEP대기_BALL_D25H_M04` 1개 바디 + D-118 기록 28), 패널 `P_M04_PANEL_E1~E3·W1~W3`(Z −12~−8), 센터판 `P_M04_INSERT` X −400~125·Y ±315·Z −40~0, 접시머리 `STEP대기_FHS-M5-10_M04` ×108, 받침 띠 X −1826~−391·Y ±25. 생성기 `tools/gen_v2_m04.py`. 센터판이 빠지면 DC2-03 북 길 자리가 바뀌므로 DC2-03을 그 뒤에 직렬로 둔다.
- **M08**: 자리 상자 `U8_REG`(X 600~1000·Y 40~120·Z 300~600), `U8_LC_L`·`U8_LC_R`, `U8_LAMP`, `U8_HMI`. 후보 형번(지난 중간 카탈로그, 임시): SMC AW20-02BG-A ×3, SY3120-5LZD-M5 ×3 + SS5Y3-20-05, Omron F3SG-4RA1520-14 ×2, PATLITE LR6 계열. 안전 거리 기준은 D-38 임시(ISO 13855 참고). 커버·가드 판넬은 넣지 않는다(실행 규칙 14).
- **M07-K1**: 결정로그 '구동 후보 M07-K1' 1~5항이 수정안이다(instructions에 옮김).
- **DC2-03**: 지난 안(mech_DC2-03_design.md)은 v2.0.2의 `U2_SUB`·`U2_PLATE` 기준인데, 지금은 M04 패널·센터판으로 바뀌었다. M04R 뒤 형상에 맞춰 다시 잡는다.
- **STEPWAIT**: step_wait.json(v2.0.1 때)의 waiting이 비어 있어 아직 다시 받아 보지 않은 것으로 본다. 형번이 정해진 것 13종: 2400.05.12PZ(F·M), 6200ZZ ×2, CB3-10 ×2, CB6-20 ×8, CB8-15 ×8, CB8-16 ×176(M07-K1이 CB5-16으로 바꾸면 빠짐), HFS8-80160-1090 ×2, HTBNS5M150-3960, HTPA60S5M150-A-N16, KC-40340, MGPM25-40Z, MSTH6-20 ×2, VRXF-PB-60-10 ×3. 표기 확인 필요: FHS-M5-10(D-117), S-M5-2(D-122). 형번 미정이지만 미스미에서 고를 수 있는 것: 레벨링 패드 M8(D-119), M3 열압입 인서트(D-125), M4 멈춤나사·너트·M5 와셔(D-127). 같은 시각 별도 작업이 HTPA60S5M150-A-N16·6200ZZ·HTBNS5M150-3960·MGPM25-40Z·CB6-20·CB8-16·CB8-15·CB3-10·MSTH6-20·HFS8-80160-1090을 받는 중이라, PartsLibrary를 먼저 본다(이 정리 시각에는 아직 들어오지 않음).

## open 표

| 항목 | 수 | 무엇 |
|---|---|---|
| 열린 구동 과제 | 2 | M08, M04R |
| 구동 후보 | 2 | DC2-03(직렬), M07-K1 |
| 회귀 동작 문제 | 0 | M07-Z04 |
| 디테일 | 0 | 구동 라운드 중이라 세지 않음 |
| STEP대기(형번 정해짐) | 13 | STEPWAIT 표 |

## user_wait 표

| 항목 | 사용자가 줄 것 | 구동을 막나 |
|---|---|---|
| 재봉 헤드 기종 D-10(STEP대기_867-392342_*, 아랫유닛 D-101) | 견적 뒤 기종·STEP·머리판 실치수 | 아니오(867 PDF 임시 형상) |
| 납품처 안전 기준 D-38(M08 라이트 커튼 거리·검출 능력) | 납품처 안전 기준 | 아니오(ISO 13855 참고 임시) |
| 파나소닉 서보 MHMF022L1U2M ×3·MHMF042L1U2M STEP | CADENAS 개인정보 입력은 사용자가 직접 | 아니오(임시 형상) |
| 볼 트랜스퍼 형번 D-96(STEP대기_BALL_D25*) | 형번·피치 결정 또는 R375X 사진 실측 | 아니오(피치 100 임시) |
| 특허 KR102139457B1 확인 D-102 | 변리사 확인 여부 | 아니오 |
