hyeunung/FSAP/docs/reports/queue_2026-11-03_2.md

# 과제 정리 — v2.0 구동 라운드 2회차 앞 (2026-11-03)

- 기준 설계: `tools/config.json` doc = `3D_Modeling/FSAP_v2.0.1.sc` (M00 결과, 44바디)
- 읽은 것: 요구서 0-8(구동 개념 v2)·5절, 최종 보고 `docs/reports/mechanism/final_mech_2026-11-03_M00.md`, `tools/out/step_wait.json`, `docs/waiting-list.md`, `tools/machine.json`(조인트 16), runstats(실행 4개, M00 1.2 h·수정 0·실패 0)
- 모델 목록: CLI `solidcraft-cli eval`(assembly.bom flat, document.inspect — 읽기만, 저장 없음) → `tools/out/queue_r2v2/bom_out.json`·`doc_out.json`. 앱(MCP)은 건드리지 않았다
- STEP대기_ 바디: **0**(44바디 모두 U1~U8 차지 상자·매트 모형). step_wait.json waiting 비어 있음 → STEPWAIT 과제 없음
- 지난 라운드: M00 완료(해결 v2.0.1), regrade 0, serial_next 0, '일부' 0. 전체 회귀 ok(2484단계, 동작 문제 0, 못 본 범위 없음)
- 이전 v1.0 큐(같은 파일 이름)는 v1.0 과제(DC-07·N05~N08)였다. v2.0은 규칙 20대로 새로 시작해 그 내용은 가져오지 않았다(기록은 `archive_v1/`)

## 과제 표 (순서 E-02: M01 → M02·M03·M04 → M05 → M06 → M07·M08, 구동 후보는 해당 과제 옆)

| 순서 | id | 출처 | 유닛(0-8-3) | 등급 | 무엇 | 합격 기준 |
|---|---|---|---|---|---|---|
| 1 | M01 | 요구서 과제 | U3 헤드 | L | 윗헤드 매달기 + 아랫유닛 분리, 867 공식 PDF 치수 `STEP대기_` 임시 형상, 테이블 위는 바늘 둘레 묶음만, 좁은 홈 묶음 | 좁은 U홈 매트 홈 전 구간 과제 범위 간섭 0, 홈 바닥 바늘 중심 180° 회전 중 반대 벽 틈 > 0, 노루발·바인더 끝·슈 묶음 폭 < 25(D-02·D-14 임시) |
| 2 | DC2-01 | 구동 후보 | U3↔U1 매달기 | M | 매달기 판 틈 0 → 헤드 윗면 위 브래킷(보 앞면 Z 560~650·보 윗면 체결) 또는 보–헤드 렌치 길 | 체결·조정 나사 전부 위·앞 공구 길 겹침 0, 과제 범위 간섭 0 |
| 3 | DC2-03 | 구동 후보 | U3 아랫유닛↔U2·U1 | M | 북 교체·가마 정비 길(−Y 서랍 + U2_SUB·U1_BASE 앞 개구 X 40~520) | 북 빼는 길 과제 범위 간섭 0, 손·공구 길 열린 단면 ≥ 북 케이스+여유 |
| 4 | M02 | 요구서 과제 | U4 바늘 옆 바퀴 | L | R375X 그대로: 서보+감속기+고무 바퀴, 핀 스윙 암, 세로 공압 누름·들기, 밑 원판 Ø250, 매트 유무 센서·각도 조절 자리 | 매트 3장 과제 범위 간섭 0, 좁은 홈 든 자세 간섭 0, 실린더 크기 손계산(D-92 30~100 N), 작은 매트 모서리 토크 손계산 |
| 5 | DC2-06 | 구동 후보 | U4↔U3 머리판 | M | U4 마운트를 위치핀+원터치로 통째 떼거나 헤드 −X 면에서 약 60 띄움(d₁ 100 유지) | 머리판 탈착 길 과제 범위 간섭 0, d₁ 100 ± 0 |
| 6 | M03 | 요구서 과제 | U5 먼 쪽 바퀴 대차 | L | 전폭 X 가이드(J_U5_X 0~1380) + 서보 대차, 공압 승강, 서보 바퀴, 케이블 체인, 매트 유무 센서 | d₂ 420~1800·매트 3장 회전 중 과제 범위 간섭 0, 120×120 모서리 토크 손계산(미끄럼 SF ≥ 1.5, μ 0.5 D-95), 든 자세 매트 틈 > 0 |
| 7 | M04 | 요구서 과제 | U2 볼 테이블 | M | 타공 스테인리스 판 + 수지 볼(D-96 임시 Ø25.4·피치 50), 윗면 = 바늘판, 원판·아랫유닛 자리, 받침 | 휘두름 영역 전체 덮음, 매트 3장 전 구간 뒷면 볼 위, 판 처짐 손계산(매트+바퀴 누름 100 N) ≤ 0.2 mm(임시) |
| 8 | DC2-05 | 구동 후보 | U2↔U5 바퀴 길 | M | 먼 쪽 바퀴 길(Y ±30·X −1830~−390) 밑 저마찰 평판 띠 또는 촘촘한 볼 띠 | 바퀴 길 전 구간 받침 연속(빈 띠 0), 띠 윗면 = 볼 윗면 ± 0.1, 과제 범위 간섭 0 |
| 9 | M05 | 요구서 과제 | U7 테이프 툴 카세트 | L | 바인더+안내+절단+끝 접기+앞끝 남기기 한 덩어리, 핀+원터치 | 이음매 단계(0-8-4 ⑤) 과제 범위 간섭 0, 카세트 탈착 길 간섭 0, 좁은 홈 묶음(M01) 폭 안 |
| 10 | M06 | 요구서 과제 | U6 센서+슈, U7 롤 걸이 | L | 바늘 앞 슈+광센서, 비키는 실린더, 롤 걸이·안내 | 직선·모서리·홈 안 자세 센서 시야가 가장자리에 걸림, 슈 비킨 자세 간섭 0, 테이프 길↔매트 간섭 0 |
| 11 | DC2-04 | 구동 후보 | U3·U4·U5·U6·U7 높이 사슬 | M | 누름 행정 = 두께 범위 + 들림 여유, 내림 끝을 가장 얇은 매트 윗면 아래로(접촉 추종), 슈·바인더 높이 조절 자리, M00-X6 함께 | D-04 임시 두께 범위 양 끝 매트 모형에서 두 바퀴 누름 접촉 > 0, 슈·바인더·노루발 걸림 0, machine.json 기준선 바퀴↔테이프 겹침 정리 |
| 12 | DC2-02 | 구동 후보 | U8↔U7 롤 | M | 레귤레이터를 X 830~1150로 또는 롤을 Z ≥ 560 | 손잡이·게이지·배관 구 앞 손 길 겹침 0, 롤 교체 길 간섭 0 |
| 13 | M07 | 요구서 과제 | U1 프레임+보 | M | 전폭 보·양옆 기둥·바닥틀을 상자 → 형재·판 실물(마감캡), 윗헤드·대차 가이드 자리 | 과제 범위 간섭 0, 기둥 휘두름 영역 밖(틈 ≥ 177), 바늘점 흔들림·보 처짐 손계산(D-08 임시) |
| 14 | M08 | 요구서 과제 | U8 공압·안전 자리 | M | 레귤레이터 3·밸브·라이트 커튼·경광등·HMI 자리, 배관 길 | 작업자 손 닿는 범위 안, 라이트 커튼 시야가 로딩 면 덮음(D-38 임시), 과제 범위 간섭 0 |

## open 표 (R2 완료 조건)

| 항목 | 수 | 내용 |
|---|---|---|
| 열린 구동 과제 | 8 | M01~M08 |
| 구동 후보 | 6 | DC2-01~DC2-06 |
| 회귀 동작 문제 | 0 | M00 전체 회귀 ok |
| 디테일 | 0 | 구동 라운드 중(M00-X6은 DC2-04에서 함께) |
| 형번 정해진 STEP대기_ | 0 | 모델에 STEP대기_ 바디 없음 |

## user_wait 표 (사용자 자료로만 풀림, open에서 뺌)

| 항목 | 필요한 것 | 구동 막음 |
|---|---|---|
| D-10 재봉 헤드 기종·STEP | 견적 뒤 기종 확정·헤드 STEP·머리판 체결 방향 | 아니오(867 PDF 임시 형상) |
| D-101 아랫유닛 구조·동기 | 기종 확정 뒤 가마 방향·동기 방식 | 아니오(임시 상자) |
| D-04 매트 두께 범위 | 납품 매트 두께 최소~최대 | 아니오(임시 범위) |
| D-97 먼 쪽 바퀴 밑 받침 | 볼 위 그대로/평판 띠 선택 확인 | 아니오(DC2-05 임시안) |
| D-38 납품처 안전 기준 | 안전 거리·커튼 검출 능력 | 아니오(ISO 13855 참고 임시) |
| D-92·D-95 잡는 힘·미끄럼 | 시제품 시험값 | 아니오(임시 30~100 N, μ 0.5) |
| 미스미 로그인 | 로그인 상태(확인 못 함) | 아니오(STEP대기_ 임시 형상) |
