hyeunung/FSAP/docs/reports/queue_2026-11-03_1.md

# 과제 정리 — 구동 라운드 1회차 (v2.0 첫 실행, 2026-11-03)

과제 정리부(PM). CAD는 열지 않았다(아래 '모델' 참고). 모델·요구서·결정로그·자료대기는 고치지 않았다. 이 파일은 같은 날 v1.0 실행의 같은 이름 과제표를 v2.0 첫 실행 것으로 바꿔 쓴 것이다(v1.0 것은 git 이력 `9233d89` 이전 커밋에 있다).

## 읽은 것

- 요구서 0-8: v2.0 확립(2026-11-03, 0-8-6 사용자 "응, 시작"). 볼 테이블 + 서보 바퀴 2개 + 매단 헤드, 유닛 U1~U8.
- 요구서 5절: v2.0 과제 M00~M08, 모두 '구동'·미해결. '구동 아님(외장·안전)' 행 없음. 구동 후보 행 없음(v1.0 DC-01~DC-08은 실행 규칙 20에 따라 가져오지 않음). 디테일 과제 없음.
- 모델: `tools/config.json` doc = `3D_Modeling/FSAP_v2.0.0.sc` — **아직 없음**(`3D_Modeling/`에는 남은 잠금 파일 `.~FSAP_v0.7.0.sc.lock`뿐, 손대지 않음). M00이 빈 설계(`new_design`)로 처음 만든다. 그래서 `STEP대기_` 목록·볼트 집계는 0(읽을 파일 없음).
- `tools/out/step_wait.json`: 없음. 지난 라운드 결과: 빈 배열 → 구매품 CAD 사이트 로그인 '확인 못 함'.
- 자료대기: v2.0 D-92~D-103(바퀴 힘·재질·볼 유닛·대차·매달기 등)은 모두 임시값이 있어 진행을 막지 않음(E-12). D-10(헤드 기종)은 867 공식 PDF 임시 치수로 진행. D-80·D-88·D-90·D-91은 v1.0 모델의 STEP 대기라 v2.0에서 쓰일 때만 적용(규칙 20).
- runstats: 실행 3개(v0.x 14.1 h, v1.0 N00 1.9 h, v1.0 N01~ 묶음 18.9 h). 모두 v2.0 이전 모델의 실행 → **v2.0 남은 회귀 동작 문제 0**.

## 이번 라운드 과제

순서(요구서 5절, 실행 지시 (a)): **M00 하나.** M01 이하는 M00이 저장한 `FSAP_v2.0.0.sc`에서 이어 번호를 올리므로 다음 라운드부터. 단독 과제라 발자국 겹침 판정은 필요 없음(직렬과 같음).

| id | 과제 | 유닛 | 출처 | 등급 | 합격 기준 |
|---|---|---|---|---|---|
| M00 | 전체 골격 (U1~U8) | U1~U8 전부 | 요구서 과제 | L | 매트 3장(1500×1500, 300×200, 좁은 U홈 25) 0-8-4 한 사이클 과제 범위 간섭 0, 휘두름 영역(약 X 2.1 × Y 3.0 m) 안 U1 기둥 0개, 먼 쪽 대차 행정이 1500 매트 d₂ 범위(약 1.5 m)를 덮음, d₂ ≥ 2·d₁ + 바퀴 묶음 폭(임시), 보·윗헤드·대차 밑 높이 ≥ 매트 두께 + 노루발 들림 20 + 여유, 볼 윗면 = 바늘판 윗면(Z 0), 정한 치수(기계 크기·보 높이·볼 테이블 크기·d₁·대차 행정·작업면 높이)를 결정로그에, `FSAP_v2.0.0.sc` 저장·문서 이름 FSAP_v2.0.0 |

발자국(E-25): 바디 `U1_FRAME`·`U2_TABLE`·`U3_HEAD`·`U4_WHEEL_N`·`U5_WHEEL_F`·`U6_SENSOR`·`U7_TAPE`·`U8_PNEU`(새로 만듦), 매트 모형 3장. 공간: 기계 전체(개략 X −2300~+500, Y −1600~+1600, Z −900~+1300, 0-8-3·0-8-5의 휘두름 영역 2.1×3.0 m + 기둥·보, 정확한 값은 M00이 정함). 조인트: 바늘 옆 바퀴 회전·누름, 먼 쪽 대차 X·승강·바퀴 회전, 노루발 들기, 바늘, 매트 모형 평면 운동 X·Y·회전(모형용). 구매품: 없음(차지 공간 상자).

## open 표

| 항목 | 수 | 내용 |
|---|---|---|
| 열린 구동 과제 | 9 | M00~M08 모두 미해결(이번 라운드는 M00) |
| 구동 후보 | 0 | v2.0 후보 아직 없음 |
| 회귀 동작 문제 | 0 | v2.0 회귀 아직 없음 |
| 디테일 | 0 | 구동 라운드 중이라 0 |
| STEP 대기(형번 정해짐) | 0 | v2.0 모델 아직 없음 |

## user_wait 표 (사용자 자료로만 풀림, open에서 뺌)

| 항목 | 사용자가 줄 것 | 구동을 막나 |
|---|---|---|
| D-10 재봉 헤드 기종(3중 이송, 분리 개조) | 대리점 견적 비교 뒤 기종 결정(C-25) | 아니오 — 867 공식 PDF 치수로 `STEP대기_` 임시 형상 |
| D-38 납품처 안전 기준 | 안전 거리·정지 시간·커튼 검출 능력 기준 | 아니오 — M08은 자리만, 외장은 뒤 |
| D-98 두 바퀴 역할 분담 확인 | R375X 동작 영상(Rimac 요청) | 아니오 — 사진 추정 임시값 |
| D-102 특허 KR102139457B1 청구항 | 변리사 확인 여부 결정(비용) | 아니오 — 납품 전 확인 |
| 구매품 CAD 사이트 로그인 | 미스미 로그인 상태 확인(재로그인은 사용자) | 아니오 — 상자·임시 형상으로 진행 |

미스미 로그인: 확인 못 함(step_wait.json 없음, 지난 라운드 결과 없음).
