hyeunung/FSAP/docs/concept/v1-drive-concept-discussion.md

# v1.0 구동 개념 대화 기록 (2026-11-02~03)

이 문서는 v1.0 전체 구동 개념(요구서 0-8)을 세운 대화의 **과정과 이유**를 남긴다. 결론은 요구서 0-8과 결정로그 C-12~C-24, 조사 원문은 [벤치마크 보고서](../../reports/매트%20바인딩기%20벤치마크%20조사.md)와 `research_notes/매트 바인딩기 벤치마크 조사/`(노트 4개)에 있다. 세션이 끊기면 이 문서부터 읽고 이어간다.

## 0. 이어가는 법

1. 이 문서 → 요구서 0-8(상태 칸: 동의 전/확립) → 결정로그 C-12~C-24 → 자료대기 0절(v1.0 임시값).
2. 0-8-6에 동의가 없으면 엔진을 돌리지 않는다(엔진 E-01). 사용자에게 0-8 초안을 보여 주고 동의를 받는다.
3. 동의 뒤 할 일: v0.x 파일을 보관 폴더로, 요구서 5절 과제 목록을 T00 전체 골격 + 유닛 과제로 바꿈, v1.0.0 시작(C-22).

## 1. 왜 v0.x를 버렸나 (C-12)

- v0.1.0~v0.10.1은 전체 구동 개념 없이 과제를 하나씩 풀었다. 과제를 풀 때마다 다음 과제(볼나사·캐리어·배관·바닥 다리·헤드 받침)가 생겼다.
- 핵심 가정이 틀렸다: T02 과제에서 엔진이 헤드 조건에 **"이송 없음"**을 달았고(결정로그 T02-S03 U-T02-1), 그래서 기계가 X·Y·회전 볼나사 서보로 매트를 한 땀씩 옮기는 구조가 됐다. 벤치마크(R375A·US6557478)는 반대로 **헤드가 매트를 끈다**.
- 사용자: "처음부터 뭔가 잘못된느낌인데 지금까지 모델링한걸 싹 다 지워야할까?" → 파일은 지우지 않고 보관, v1.0.0을 빈 파일에서 새로(git 이력 그대로).
- 기성품 STEP 36형번은 지우지 않고 공용 창고 PartsLibrary로(C-24).

## 2. 목표 (사용자와 정한 것)

| 목표 | 사용자 말 | 기록 |
|---|---|---|
| 마감 품질 최우선, 영구 눌림자국 없음 | (10-30) 대기업 납품 | 1-1 ①② |
| 이음매 최대한 티 안 나게 | "최대한 티안나고 깔끔해야해 대기업납품이라" | C-19 |
| 시작·끝이 한 번 물린 채 마감 | "끝과끝이 한번 물린채로 마감되어야하겠지?" | C-19 |
| 테이프 폭 고정 안 함, 툴 교체로 여러 아이템 | "툴형식으로 교체해서 여러아이템에도 쓸 수있도록" | C-20 |
| 2열 매트처럼 큰 것도, R375X 기준 | "R375X기준으로 해줘", "2열처럼 큰것도 되지않아?" | C-16 |
| 사진 같은 좁은 홈까지 | "저런 좁은곳도 되야하는데"(사진) | C-17 |
| 카펫 매트만, 코일은 나중 | "일단 카펫매트라 생각하고 진행하자" | C-15 |
| 벤치마크를 거의 그대로 | "거진 그대로만드는 방향으로 가야 최대한 쉽지" | C-14 |

아직 안 정한 목표: 사이클 타임(D-12, 참고 R375A 45~50 s), 작업자 1명당 대수, 납품처 합격 기준(D-08), 몇 대·예산, 일정.

## 3. 재봉기가 매트를 끄는 원리 (C-13)

Dürkopp 867(R375A가 개조한 헤드)은 **3중 이송**이다(867 공식 PDF: 아래 톱니 + 바늘 이송 + 교대 노루발).

한 땀 동안:
1. 바늘이 매트를 뚫고 내려온다.
2. 아래 톱니가 바늘판 구멍으로 올라와 매트 밑면을 물고 한 땀만큼 뒤로 간다.
3. 바늘도 꽂힌 채 같이 간다(바늘 이송).
4. 위 안쪽 노루발도 누른 채 같이 간다(교대 노루발) → 위·아래·바늘이 샌드위치로 물고 함께 밀어 두꺼운 매트도 위아래가 따로 놀지 않는다.
5. 바늘이 빠지고 톱니는 내려가고 안쪽 노루발은 들리며, 바깥 노루발이 매트를 제자리에 잡는다.
6. 톱니·안쪽 노루발이 앞으로 돌아간다. 분당 최대 3000번.

이 기계에서 중요한 점:
- 물리는 곳은 **바늘 옆 1~2 cm, 테이프로 감싸는 가장자리 띠뿐**이다. 노루발은 테이프 위를, 톱니는 뒷면 가장자리를 문다 → 넓은 파일 면에 눌림자국이 생기지 않는다(전임 기계의 롤러 방식과 다름, C-03).
- 매트 몸통은 진공 원판이 받치고, 원판은 **따로 돌리지 않고 자유롭게** 둔다(US6557478). 헤드가 끌면 원판이 따라 돈다.
- 기계가 하는 일: ① 센서를 보고 원판을 살짝 돌려 방향 잡기(조향, R375X "자동 회전") ② 큰 매트일 때 따라가는 힘 보조.
- "헤드 고정"(몸체가 안 움직임)과 "헤드 자체 이송"(톱니가 원단을 밈)은 다른 말이다. R375X도 헤드는 고정이고, 매트를 보내는 힘은 헤드 이송에서 나온다(사용자 질문 "r375x도 헤드 안움직이는거 아니야?"에 대한 답).

## 4. 매트 잡기: 왜 작은 진공 원판 + 에어 테이블인가 (C-21)

- 원판 하나를 크게 만들면 안 된다: 원판은 늘 매트 안쪽에 숨어 있어야 한다. 작은 매트(300×200)일 때 큰 원판이 매트 밖으로 나와 바늘 밑 베드와 부딪힌다.
- 그래서: **가운데 작은 진공 원판**(가장 작은 매트에 맞춤) + **둘레 전체 에어 테이블**(바늘판 높이, 바닥 구멍에서 공기 → 매트 뒷면을 살짝 띄움).
  - 큰 매트도 거의 마찰 없이 미끄러져 헤드가 끌 수 있다.
  - 공기는 뒷면에만 닿아 파일 면 자국 없음.
  - 벤치마크: Van de Wiele TITAN이 매트를 에어 테이블에 올려 다룬다.
- 판 교체 없이 300×200~1500×1500을 한 기계로.
- 코일 매트는 뒷면이 막혀 있지 않으면 진공이 새서 못 잡는다 → 코일은 범위 밖(C-15), 나중에 따로.

## 5. 크기·행정 계산 (C-16)

계산: `tools/concept/sweep.py`(결과 `tools/concept/sweep_result.txt`). 가정: 사각 매트, 바늘 = 원점, 이송 방향 +Y, 매트 몸은 바늘 왼쪽, 직선 구간은 헤드가 끌고 모서리는 바늘 중심 90° 회전.

| 매트 | 원판 중심 범위 X × Y | 매트가 휘두르는 영역 |
|---|---|---|
| 300×200 | 80 × 300 mm | 0.36 × 0.6 m |
| 1200×500(2열형) | 400 × 1200 mm | 1.3 × 2.4 m |
| 1500×600(2열형, 같은 식으로 어림) | 약 510 × 1500 mm | 약 1.6 × 3.0 m |
| 1200×1200(R375X 기본 최대) | 250 × 1200 mm | 1.7 × 2.4 m |
| 1500×1500(R375X 요청 최대) | 310 × 1500 mm | 2.1 × 3.0 m |

읽는 법: X·Y 받침은 앞뒤(Y)로 매트 한 변 길이만큼(최대 1.5 m), 좌우(X)는 0.3~0.5 m. 원판은 한 사이클에 360° 돈다. 기계는 바닥에서 대략 3 m 안팎(참고 Richpeace 설치 4.3×2.4 m).

사이클 개략: 150×150 둘레 6 m, 땀 4 mm(임시)·2000 rpm → 8 m/min → 봉제 약 45 s + 모서리. R375A 45~50 s와 비슷.

## 6. 좁은 홈과 기둥 없는 헤드 (C-17, C-18)

사용자 사진: `images/mat_carpet_narrow_u_slot.webp`(카펫 매트, 위쪽에 길고 좁은 U홈, 오른쪽 계단형 오목 모서리, 고정 단추 구멍), `images/mat_coil_red_pedal_slot.png`·`images/mat_coil_black_closeup.webp`·`images/mat_coil_notches.png`(코일 매트, 페달 쪽 홈·파임).

- 사진 비율로 추정한 가장 좁은 U홈: 폭 2~4 cm, 깊이 10~20 cm, 바닥 반원 → 임시 폭 25·깊이 150·R12.5(D-02·D-03, 실측 필요). 공개 기계 최소는 TITAN 2530AG 안쪽 R30(검색 요약) → 우리 목표가 더 좁을 수 있음 = 차별점이자 최대 위험(시제품 확인).
- **문제:** 직선 가장자리에서는 매트가 바늘 한쪽에만 있다. 홈 안을 박을 때는 **홈 건너편 매트도 바늘 반대쪽, 헤드 암 밑으로** 들어간다. 홈 바닥을 돌아 나오면 반대가 된다 → 홈 양쪽 매트가 한 번씩 다 암 밑을 지나야 한다.

```
   매트 A쪽 │ 홈 │ 매트 B쪽 ─────────────→ (B쪽이 계속 이어짐)
   (박는 쪽) │ ● │            헤드 암 ══════════╗
             │바늘│                              ║ 기둥 ← B쪽 매트가 부딪힘
```

- 사진의 왼쪽 혀(발판 쪽) 안벽을 박을 때 홈 건너편 매트 몸통 50~60 cm 이상이 암 밑으로 간다. 867은 바늘–기둥 335(암 밑 335×125, 공식 PDF) → 부딪힘. v0.x에서 엔진이 "바늘–기둥 ≥ 620"을 단 것도 이 때문이지만 620으로도 큰 매트는 못 막는다.
- **해결: 작업면에 기둥이 없게.** 윗헤드(바늘·노루발·위 이송·바인더)는 위 브리지에 매달고, 아랫유닛(가마·톱니)은 바늘 밑 작은 받침에만, 위아래 동기. R375X 설명 "재봉 헤드 구조를 고쳐 매트가 헤드 밑을 지나며 자유롭게 움직이고 회전 공간이 늘었다"가 바로 이것으로 본다(추정). 갠트리 퀼팅기가 윗헤드와 아랫가마를 따로 돌리는 예.
- 대가: 상용 헤드를 그대로 못 쓰고 개조(또는 분리형). 사진 같은 홈을 하려면 피할 수 없다고 판단.
- 홈 폭이 정하는 것: 홈 안에서 노루발·바인더 끝·센서가 홈 폭 안에 다 들어가야 하고, 홈 바닥 반원에서 바늘 중심 180° 회전 중 반대 벽에 닿으면 안 된다 → **가장 좁은 홈 폭이 헤드 묶음 크기의 상한**.

## 7. 모서리·홈 바닥 순서 (US5367966)

바늘을 꽂은 채 멈춤 → 노루발 들기 → 매트를 **바늘 중심으로** 회전(이때만 X·Y·회전 위치 모드: 판 중심이 아니라 바늘 중심이어야 해서 X·Y가 회전과 함께 움직임) → 가장자리 센서가 다시 잡으면 재개. 원문에 이 순서가 적혀 있다(코너 센서로 땀 수를 세다 정지).

## 8. 테이프 길과 툴 카세트 (C-20)

처음 제안(서보 공급 롤러 + 장력 댄서)은 벤치마크 원칙(C-14)에 따라 뺐다. **Dürkopp 867-392342 차 매트 바인딩 모델의 바인더가 테이프를 장력 없이 공급하고 안·밖 곡선을 차동 조절**한다(공식 PDF) → 그대로 쓴다.

길: 테이프 롤(롤 걸이) → 867 테이프 안내(베드 뒤 오른쪽 세운 핀, 사진 판독) → 867 바인더 → 바늘.

툴 카세트(테이프 폭별 교체): 바인더 + 테이프 안내 + 절단 + 접기를 한 덩어리로, 위치 결정 핀 + 원터치 클램프, 툴 식별(기계가 어떤 툴인지 알게). 기계 쪽(헤드·매트 잡기·롤 걸이)은 고정, 폭 범위 안에서 조절만.

바인더 접기: 4번 접기(테이프 옆면 자른 끝까지 안으로)가 마감에 좋다. 867 바인더는 한쪽 접힘·양쪽 접힘·열린 끝 테이프를 다 받는다(공식).

## 9. 이음매 (C-19)

검토한 방식:

| 방식 | 어떻게 | 장점 | 단점 |
|---|---|---|---|
| ① 겹쳐 박기 | 끝이 시작 위로 20~40 mm 겹쳐 박고 자름 | 단순, 자동화 쉬움 | 겹친 곳 두툼, 자른 면 보임 |
| ② 겹쳐 박기 + 열절단 | ①을 열로 잘라 끝을 녹여 막음 | 올 안 풀림, R375X 옵션 | 녹은 자국 |
| ③ 끝 접어 넣기 | 끝을 안으로 접어 자른 면 숨기고 겹쳐 박음 | 가장 깔끔 | 자동이 어려움 |
| ④ 맞대기 | 딱 맞대고 박음 | 두께 차 없음 | 틈 벌어지기 쉬움 → 대기업용 위험 |

정한 것: **시작과 끝이 한 번 겹쳐 물림(①/③), 끝의 자른 면만 접어 넣음.**
- 시작 끝은 한 바퀴 돌아온 끝 테이프가 덮으므로 따로 접지 않는다 → 접기는 끝 한 곳만.
- 겹침 구간은 두 겹을 같이 박아 물리게, 끝에서 되박음 또는 땀 겹침 후 자동 사절.
- 조건: 겹침 구간 두 겹 두께를 바인더·노루발이 넘김, 끝 테이프를 '겹침 + 접어 넣는 길이'로 정확히 남겨 자름 → 바인더 앞에서 미리 자르는 방식, 남은 둘레 계산 필요. 겹침 길이 임시 20~30 mm(D-07, 시제품).
- 벤치마크: **US6044783A**(Klear-Vu, 만료) 테이프를 가장자리보다 약 1인치 길게 잘라, 공압 안내가 끝을 막대에 감아 폭 방향으로 접고 깔때기 폴더로 밀어 넣어 시작부 위에 박음 — 우리 조건과 정확히 맞음. **US4688499**(만료) 360°보다 조금 더 돌아 끝이 시작을 덮고, V날로 테이프를 잘라 다음 앞끝을 안내에 남김. 대안: 열절단(R375X 옵션), 초음파(US7533621B2는 2027-02 만료 전 유효 → 피하거나 확인).
- 이음매 위치: 눈에 안 띄는 직선 구간(작업자가 매트를 표시에 맞춰 올림).

## 10. 가장자리 센서

- 처음 제안(위에서 레이저 단차 측정, WO1996023626)은 벤치마크 원칙에 따라 **US5367966 방식으로 바꿈**: 아날로그 재귀반사형 광센서 + 바늘 바로 앞 반사면, 원통렌즈로 시야를 길쭉하게, 비례 조향 + 학습 모드 룩업 테이블.
- 참고: 접촉식 스윙 암(US5493980, KR 픽스로봇)은 좁은 홈에 못 들어감. 위에서 보는 광센서는 눌린 파일에 속을 수 있다(US5493980 원문 지적).

## 11. 벤치마크 → 유닛 대응 (C-14)

| 유닛 | 그대로 가져오는 것 | 새로 하는 것 |
|---|---|---|
| U1 재봉 헤드 | Dürkopp 867-392342 차 매트 바인딩 모델(3중 이송, 공압 들기 20, 사절, 바인더). R375A가 867 개조 | 기둥 없게 개조(C-18) |
| U2 브리지·틀 | — | 브리지 |
| U3 진공 원판 + 회전 | US6557478(자유 회전 진공 원판, 원판을 헤드 쪽으로 미는 직선 액추에이터), US5367966(받침 쪽 조향) | 조향 서보 |
| U4 X·Y 따라가기 받침 | US5367966(받침 자유 회전 + 직선 이동) | 행정 X 0.5·Y 1.5 m |
| U5 에어 테이블 | Van de Wiele TITAN | — |
| U6 가장자리 센서 | US5367966 재귀반사 | — |
| U7 테이프 공급 | 867 바인더 자체 공급(차동) | 롤 걸이 |
| U8 툴 카세트 | 867 바인더, R375X 커팅·열절단, US6044783A, US4688499 | 원터치 교체·식별 |
| U9 로딩 | R375X 수동 로딩 | 올리는 표시 |

쓰면 안 되는 벤치마크: US5209171(톱니 롤러가 파일 면을 눌러 끎), US5216969(스펀지 패드 판으로 눌러 이동), 중국 특허들의 누름판·누름 휠(CN215051175U 등), Richpeace 상하 프레스 휠 → 모두 파일 면을 누름(C-03).

## 12. 배치 그림 (위에서, 개략)

- 헤드: 바늘점 고정. (867 그대로면 기둥이 오른쪽, 암 밑 335 — v1.0에서는 기둥을 작업면에서 치움, C-18)
- 매트: 바늘 한쪽(그림에서는 왼쪽)에 몸통, 가장자리만 바늘 밑. 이송 방향은 작업자 반대쪽(+Y).
- 진공 원판(매트 가운데) 밑에 X·Y 따라가기 받침, 둘레 에어 테이블.
- 테이프: 롤 → 안내 → 바인더(노루발 앞).
- 작업자: 앞(−Y)에서 올리고 꺼냄.
- 정할 것: 매트가 바늘 어느 쪽인지(867 바인더 방향 그대로), 원판–바늘 최소 거리(베드판 치수 D-10), 기계 전체 크기(5절 휘두름 영역).

## 13. 모델링 순서 (C-22)

1. **T00 전체 골격**: 9유닛을 상자(차지 공간)로 한 파일에, 축(원판 회전·X·Y·노루발·바늘)과 매트 모형 3장(최대·최소·좁은 홈)으로 한 사이클 간섭 → 기계 크기·브리지 높이·원판–바늘 거리 결정.
2. 위험 큰 유닛부터 실물로: U1 헤드 개조 + 좁은 홈 묶음 → U3·U4·U5 매트 잡기 → U8 툴 카세트 → U6·U7 → U2·U9. 겹치지 않는 유닛은 동시에.
3. 유닛 과제는 0-8을 바꾸지 못한다(엔진 v3.6.0). 바꿔야만 풀리면 엔진이 멈추고 보고 → 대화로.
4. 0-8에 없는 유닛(커버·외장)은 구동 과제로 만들지 않는다.

## 14. 실행 시간 문제와 엔진 (C-23)

- v0.10.1 라운드 끝 전체 회귀가 3시간 넘게 돎(2026-11-02 20:41~23:43, 사용자가 멈춤). 원인: 모든 연구·모든 조인트 전 행정 5 mm 간격 약 47,000단계 5묶음, 호출 하나 95분(안내서 8분 넘김), CAD 커널 패닉 `tolerance must be no less than 1e-6`으로 5묶음 모두 실패한 것을 95분 뒤에야 앎, 줄인 판 다시 31~55분. 기록: `tools/out/mech_regression_v0101/`(times.txt, times2.txt, res/).
- FSAP에서 막음: 요구서 6-4 간격(X·Y 25 mm, 회전 5°, 좁은 곳 5 mm·1°), 실행 규칙 16(시험 실행, 호출 8분, 패닉 즉시, 전체 30분).
- 엔진 근본 수정은 엔진 세션에 요청 → **엔진 v3.7.0에 반영**(2026-11-03, `regrun.py`가 시험·호출 8분·패닉 즉시·전체 상한 강제, 0-8-3 벤치마크 두 칸). 요청문: `docs/reports/engine-change-prompt_regression.md`(개선 후보 WF-153). 사용자 "다른데서도 이 엔진을 쓰니까 근본적인곳에 문제가 있으면 엔진을 고쳐야해서".

## 15. 남은 질문

| 무엇 | 왜 필요한가 | 지금 임시 |
|---|---|---|
| 가장 좁은 홈 폭·깊이·바닥 반경 실측 | 헤드 묶음 크기 상한 | 25·150·R12.5(사진 추정) |
| 카펫 매트 두께·뒷면(막힘 여부) | 진공 잡기, 노루발 밑 10 mm 안인지 | 뒷면 막힘 가정 |
| Dürkopp 867 베드판 치수·바늘–베드 끝 거리 | 원판–바늘 최소 거리 | 미확인(판매점·DA 도면 요청) |
| 헤드 이송이 원판·받침을 끄는 힘 | 따라가기 저항 한도, 서보 보조 여부 | 계산 예정 |
| 사이클 타임 목표, 작업자당 대수 | 속도·자동화 수준 | R375A 45~50 s |
| 테이프 폭 범위, 다른 아이템 종류 | 툴 카세트 범위 | 미정 |
| 납품처 합격 기준·한도견본 | 마감 판정 | D-08 |
| 이음매 사진(사람이 박은 것) | 이음매 목표 모양 | 미정 |

작은 결정(0-8 동의 때 같이): 센서 = US5367966 그대로 / 이음매 위치 = 작업자가 표시에 맞춰 올려 직선 구간에서 시작 / 매트 도는 방향 = 867 바인더 방향 그대로.
