hyeunung/FSAP/docs/reports/queue_2026-11-02_1.md

# 과제 정리 — 구동 라운드 1회차 (2026-11-02, 엔진 v3.4.0, v0.8.2)

- 모델: `3D_Modeling/FSAP_v0.8.2.sc`(tools/config.json doc). 읽기만 했다. CAD는 새로 열지 않았다. 바디 목록은 멈춘 실행의 측정부가 v0.8.2에 대고 뽑은 `tools/out/mech_T17/bodies.json`(387바디)을 썼다. 파일 SHA256 `4df86211…ce19d22`가 `tools/out/mech_T17/sha_after.txt`와 같아서 그대로 쓸 수 있다.
- 지난 실행(엔진 v3.3.0, wf_520fe448-efa)에서 T18은 v0.8.0에서 일부, T15는 v0.8.1에서 일부, T14는 v0.8.2에서 해결됐다. T17은 측정 도중에 멈췄다. T18·T15의 '일부'로 남은 항목은 이번에 과제로 다시 올렸다(실행 메모 a).
- 지난 라운드 결과는 없다([]). 그래서 등급 재조정·직렬 복귀 과제도 없다. runstats에는 실행 1개(mech_2026-10-31_S01-T06-T07-S02, v3.2.1, 완료)만 있다. wf_520fe448 실행은 `runs/`에 기록되지 않았다.
- 미스미 로그인: **확인 못 함**. 지난 라운드 결과가 없어서 `tools/out/step_wait.json`의 login 값을 그대로 옮겼다. 그 값은 봇 확인 페이지 때문에 확인하지 못했다는 뜻이다.
- 커버·가드·라이트 커튼·외장(T12, X-01·X-02)은 과제로 넣지 않았다(규칙 14).

## 과제 표 (E-02 순서: 구매품 실물 → 구동 유닛 → 배관·케이블 길 → 받침)

| 순서 | id | 과제 | 등급 | 근거·현재 상태(v0.8.2) | 합격 기준 | 출처 |
|---|---|---|---|---|---|---|
| 0 | STEPWAIT | 아직 다시 받아 보지 않은 형번이 정해진 STEP대기_ 4형번 | M | 바디 `STEP대기_BSS2020-1240`(X 75~95·Y −964.5~275.5·Z −458~−438), `STEP대기_BSS2520-1443`(X −616~827·Y −422.5~−397.5·Z −567.5~−542.5), `STEP대기_CB8-35_T18_BSW15_1·2/BUN15_1·2`, `STEP대기_CB8-25_T18_XNUT_1~4`. 넷 다 step_wait.json의 waiting에 없다. 자료대기는 D-53·D-56, 결정은 T18-X02·T18-R04 | 받은 것은 실물 STEP으로 바꾼다. 축단 스냅 링 홈·어깨를 유닛에 맞추고, 지지 간격은 Y 1181.5·X 1366 ≤ 1370. 못 받은 것은 형번과 이유를 step_wait.json에 남긴다. 과제 범위 간섭 0 | STEP 대기 |
| 1 | T18 | X·Y 이송 너트 하중 경로 강화(T18-X04) | M | 오조작 2364 N(서보 최대)에서 `P_T18_YNB`(X 50~120·Y −678~−610·Z −476~−370, MAT_Y) SF 0.72, `P_T18_XNP`(X 170~178·Y −460~−360·Z −581~−408, MAT_X) SF 0.89. CB5-16→Y판 0.66, CB8-25→XNP 0.71. v0.8.0~0.8.2에 강화가 들어가지 않았다(T18-R03) | 2364 N에서 YNB·XNP와 체결(YNB→Y판, YNUT 물림 ≥ 7.5, X 너트 CB8-25 물림 ≥ 12, XNP→1300_R) 모두 손계산 SF ≥ 2. XNP +X 두께 증가 0, 행정 끝 틈 X 6·5, Y 109·65.5 유지. J_MAT_X −620~620·J_MAT_Y −860~40 그대로. YNB 볼트 끝–받침 틈 ≥ 2.0(T14-S03). 새·옮긴 볼트 렌치 M-01·M-02 결함 0. 덧댄 리브·용접 없음. 과제 범위 간섭 0 | 요구서 과제(회귀 동작 문제 T18-R03) |
| 2 | T15 | T05 SNJ 스패너 자리 최종 판정 재확인 | S | v0.8.1의 `P_T05_GUIDE`(X −152~−80·Y 553~612·Z 36~89.5)·`P_T05_PAD`에서 스패너 21×4 겹침 0, SF 3.80. 최종 판정은 joint.sweep J_T05_PAD 결과가 없어 미합격이었다. 수정 1회차의 임시 분리 sweep에서는 −12.5→0 막힘이 없었다(최소 0.30, mech_T15_model1.md) | J_T05_PAD −12.5→0 전 구간 막힘 0(최소 틈 ≥ 0.30). 스패너 21×4 겹침 0. 패드 안내 틈 0.3/0.3/0.0 유지. 과제 범위 간섭 0. 판정 pass | 요구서 과제(회귀 동작 문제 T15-R03) |
| 3 | T17 | 진공 배관 회전부 건너기 | L | 측정 결과(mech_T17_measure.md, v0.8.2): 진공 길이 없다. 원판 가운데가 막혀 있고 링1에는 포트가 없다. 이젝터 `ZH10DSA-06-06-08_T1/T2`(BASE, Y 300~361.7·Z −672~−639.6)의 VAC Ø6은 어디에도 이어지지 않았다. 통로로 쓸 수 있는 곳: 기둥 속 r10~19.9, Z −420~−241 꼬임 고리. 피할 곳: r ≥ 70에서 Z > −59(작은매트 사이클에서 SEWHEAD와 겹침), 허브 볼트 머리 r77.5, Y판 밑 +Y 길(Z ≤ −400에서 Y ≤ −497). 이젝터를 옮길 자리는 MAT_Y 위 X 105~195·Y −940~−460·Z −359.5~−245. 측정에서 끊긴 곳(이젝터 포트 면 위치)은 다시 잰다 | 원판 진공 면(또는 링1)까지 진공 길을 연다. 진공 밀봉면 유지. J_MAT_ROT −360~0에서 꼬임 늘음 ≤ 관 길이 여유. 관 굽힘 반경 ≥ D-46 임시 R10, Ø6은 새 자료대기 임시값으로 기록. 위 금지 구역 침범 0. 과제 범위 간섭 0 | 구동 후보(T11-S07) |
| 4 | T16 | X·Y 이송 배관·케이블 캐리어(분기·밸브 자리) | L | T11-S07·S03의 후보다. 출발점은 Y판 결속 (±10, −590)이고, K_T16 예약 상자는 모델에 없다. 실을 것: 링 관 6줄(또는 MAT_Y 밸브 + 공급 1줄), DGM 모터 케이블, T18 서보 케이블 2(`STEP대기_MHMF082L1U2M_X/Y`), 진공 2줄(T17). 경로를 정하지 않아 건드릴 바디를 모른다 → 직렬 | X·Y 행정 전 구간에서 캐리어 굽힘 반경 ≥ 카탈로그 최소. 관·케이블 길이 여유 ≥ 0. 분기 KQ2T04-00A·밸브 자리 확정. 캐리어는 실물 STEP. 과제 범위 간섭 0 | 구동 후보(T11-S07) |
| 5 | T19 | 바닥틀 다리·조절발(X 레일 받침) | M | T18이 가로 이음 `HFS8-4080-1140_T18_XM`(X −607~−527)·`_XP`(X 796~876)를 넣었다(Y −980~160·Z −640~−600, HBLFSN8 ×8). 그 볼트가 없는 것은 디테일 #5다. Z −680 아래에는 바디가 없다. 다리·조절발이 없다(T07-S04, D-39). 형재 끝은 X ±950 | 다리·조절발을 D-39 임시 작업 높이로 둔다(값은 자료대기에 기록). X 레일 두 줄 높이 차는 SV2RL28 허용치 안. 다리 손계산 SF ≥ 2. 렌치 결함 0. 새 형재는 실물 STEP과 마감캡. 과제 범위 간섭 0 | 구동 후보(지난 queue) |
| 6 | T13 | 헤드 받침 강성·배치 | M | 기둥 `HFS8-4080-460_P1/P2`(X ±(50~90)·Y 700~780·Z −600~−140)가 `580_T1/T2`(Y 200~780·Z −680~−600)에 얹혀 있다. 580은 `1900_B`(Y 160~200)에서 외팔로 나와 있다. 참고값(v0.7.1, mech_T13_measure): 흔들림 2.970, 기준 0.657의 4.5배. 안 ② X ±170은 0.504, ④+②는 0.245. 이젝터(T17)를 피하고, T19 다리와 함께 본다. 외장 형재에는 기대지 않는다 | 끌림 20 N에서 바늘점 X 흔들림 ≤ 0.657(D-08 임시, 580 굽힘 포함 손계산). 브래킷은 실물 STEP. 과제 범위 간섭 0 | 요구서 과제 |

## STEP 대기(형번 정해짐, v0.8.2 바디 실측)

| 형번 | 바디 수 | 자료대기 | 상태 |
|---|---|---|---|
| BSS2020-1240 | 1 | D-53 | 다시 받아 보지 않음 → STEPWAIT |
| BSS2520-1443 | 1 | D-53 | 다시 받아 보지 않음 → STEPWAIT |
| CB8-35 | 4 | D-56 | 다시 받아 보지 않음 → STEPWAIT |
| CB8-25 | 4 | D-56 | 다시 받아 보지 않음 → STEPWAIT(T18과 겹침) |
| CB3-8 | 8 | D-37·D-43 | step_wait waiting(봇 확인 페이지) |
| CB3-10 | 5 | — | 같음 |
| CB4-16 | 24 | D-37 | 같음 |
| CB5-18 | 12 | — | 같음 |
| CB6-18 | 6 | — | 같음 |
| CJ2B16-30SZ | 2 | D-37 | 같음, SMC CAD 대안 |
| HNTT8-5 | 8 | D-41 | 같음, 미스미 표기 확인 |
| KQ2L04-M5A | 6 | D-45 | 같음 |
| LBNR5 | 2 | D-37 | 같음 |
| NTJ-015C | 1 | D-37 | 같음 |
| PSFJT16-150-M5 | 6 | D-21 | 같음 |
| SSE2BZ12-120 | 3 | D-44 | 같음, 미스미 표기 확인 |
| MHMF082L1U2M | 2 | D-55 | 미스미 판매 없음, 파나소닉 CAD는 개인정보 양식 → user_wait |

- waiting 12형번은 막힌 이유가 봇 확인 페이지다. 로그인이 풀린 것도, 사이트에 없는 것도 아니어서 open.step_wait에 셌다. 다음 재시도 때 다시 받는다.
- step_wait.json waiting 중 PSFJT16-100-M5·LBNR4·MS3-8·HFS8-4080-1580/2850/680은 v0.8.2에 바디가 없어서 세지 않았다.
- SEWHEAD(본체·노루발대·바늘대)·NEEDLE은 형번 미정(D-10)이라 user_wait로 보냈다.

## open 표

| 항목 | 수 | 메모 |
|---|---|---|
| 구동 과제 | 3 | T13(열림), T15(일부), T18(일부) |
| 구동 후보 | 3 | T16·T17(T11-S07), T19(바닥틀 다리) |
| 회귀 동작 문제 | 2 | T18-R03(오조작 항복), T15-R03(sweep 판정 재확인). 각각 T18·T15 과제에서 푼다 |
| 디테일 | 0 | 구동 라운드 중이라 0으로 둔다 |
| STEP 대기(형번 정해짐) | 16 | STEPWAIT 4 + waiting 12. MHMF는 user_wait |

## user_wait 표

| 항목 | 사용자가 줄 것 | 구동을 막나 |
|---|---|---|
| 재봉 헤드 기종 D-10(`STEP대기_SEWHEAD`·`_PRESSERBAR`·`_NEEDLEBAR`·`STEP대기_NEEDLE`) | 기종·바인더·STEP | 아니오(E-10 임시 형상) |
| 서보 `MHMF082L1U2M` ×2 STEP(D-55) | 파나소닉/CADENAS 양식(개인정보)으로 받은 STEP, 또는 다른 서보 지정 | 아니오(임시 형상 80각) |
| 빈 이동 속도 280 / 300 mm/s(D-52) | (a) 280 유지 / (b) 비표준 축단 견적 / (c) 랙·피니언 중 선택 | 아니오(280으로 진행) |
| 바늘점 흔들림 한도 D-08(T13 기준) | 납품처 품질 기준 | 아니오(0.657 임시) |
| 작업 높이 D-39(T19·T13) | 바닥 ↔ 매트면 높이 | 아니오(임시 높이) |
| 가장자리 센서 구매처 U-T04-1·D-32 | 구매처 또는 안 선택 | 아니오 |
| 생산 목표 사이클 D-12 | 매트 한 장 사이클 타임 | 아니오(임시값) |
| 납품처 안전 기준 D-38 | 안전 거리·정지 시간 | 아니오(외장 단계 몫, 구동 아님) |
| 미스미 봇 확인 페이지 | 사용자가 브라우저에서 통과하거나 로그인 확인 | 아니오(STEP대기_ 임시 형상으로 진행) |

## 넣지 않은 것

- T12 옆·뒤 커버, T07 가드틀·라이트 커튼(X-01·X-02): 외장이라 넣지 않았다(규칙 14).
- 디테일 과제(T18 디테일 14건 중 구동 몫인 #11·#12를 뺀 나머지, T14 디테일 3건, DL-D40 등): 디테일링 몫이다.
- T14-C1(링1 포켓): DG 허용 관성(D-17)이 모자랄 때만 다시 여는 조건부 후보다. 지금은 그 조건이 아니어서 넣지 않았다.
- `mech_STEPSWAP_model.md`는 실행 메모 (b)대로 무시했다.

## 워크플로우 메모

- 멈춘 실행 wf_520fe448의 결과가 `runs/`에 없어서 runstats에 나오지 않는다. 멈춘 실행도 기록이 남으면 다음 과제 정리부가 진행 상태를 덜 추측하게 된다.
- T19(바닥틀 이음·다리)는 지난 queue에서 후보로 올렸지만 요구서 5절·결정로그에 행이 없다. 후보를 요구서 표에 올리는 단계가 빠졌다.
