hyeunung/FSAP/docs/reports/queue_2026-11-01_1.md

# 과제 정리 — 구동 라운드 1회차 (2026-11-01, v0.7.2)

- 모델: `3D_Modeling/FSAP_v0.7.2.sc`(tools/config.json doc). 읽기만 했다. CLI `solidcraft-cli eval`로 `document.inspect`만 불렀고(약 3분 20초), 결과는 `tools/out/queue2/insp_out.json`에 있다. 바디 279개, 저장하지 않았다. MCP는 쓰지 않았다.
- 사용자 지시로 외장을 뺐다. v0.7.1에서 T12 옆·뒤 커버(V071-01~04), v0.7.2에서 T07 고정 가드틀(V072-01~03)을 뺐다. 그래서 T12, D-41·D-48·D-49, 가드·라이트 커튼 자리는 과제로 넣지 않았다(실행 규칙 14).
- 이 파일의 예전 판(v0.7.1 기준)은 이 판으로 바꿨다. v0.7.2에서 다르게 본 것은 네 가지다. (1) T07 형재(2850·680·1580)가 빠져서 STEP 대기 형번이 12종이 됐다. (2) step_wait.json이 생겨서 STEPWAIT 과제를 넣지 않았다. (3) X·Y 이송 구동이 모델에 없다. (4) 바닥틀에 가로 이음과 다리가 없다. (3)과 (4)는 새 구동 후보 T18·T19로 올렸다.
- 지난 라운드 결과는 없다([]). runstats는 실행 1개(mech_2026-10-31_S01-T06-T07-S02, 완료)를 보여 준다. 남은 회귀 동작 문제는 T11-R03·T12-R03 기준으로 0이다. v0.7.1·v0.7.2는 부품을 뺀 것뿐이고 조인트·연구는 그대로다.
- 미스미 로그인: **됨**. `tools/out/step_wait.json`의 login 값이고, 실행 메모 (d)의 2026-11-01 사용자 확인과도 같다.

## 과제 표 (E-02 순서: 구동 유닛 → 배관·케이블 길 → 받침)

| 순서 | id | 과제 | 근거·현재 상태 | 합격 기준 | 출처 |
|---|---|---|---|---|---|
| 1 | T18 | X·Y 이송 구동 유닛(볼나사·지지 유닛·너트 받침·커플링·서보·모터 브래킷) | 결정로그 S-03은 "볼나사 지지·너트 브래킷·커플링·서보·모터 브래킷(형번 미정 12개)은 공간만 비운다"고 했다. D-24·D-25: BSS2020-1100(Y)·-1450(X)의 STEP은 `purchased-step/`에 있지만 짝 부품 형번이 미정이라 모델에 없다. v0.7.2 바디 279개 중 X·Y 볼나사·모터가 0개다. 비워 둔 공간: Y 축 X +85·Z −440, 너트 받침 X 48~122·MAT_Y 로컬 Y +30~+100·Z −477~−370, 지지 유닛은 460_F·_B 윗면 X 47.5~122.5·Y −977~−937 / 203~243·Z −478~−400(S01-S02·T08-M07). 비울 공간: DGM 모터 쓸림 X ±42.5·Z ≥ −419, 커넥터 케이블 X ±20·Z −478~−419. X 볼나사 공간은 T01-X01 그대로다. 속도·가속은 D-12 임시값(빈 이동 300 mm/s)을 쓴다 | J_MAT_X −620~620·J_MAT_Y −860~40 행정이 그대로일 것. 볼나사 위험 속도·좌굴, 서보 토크·관성비를 카탈로그 허용치와 비교한 손계산 SF ≥ 2(M-09, 허용치가 없으면 임시값을 자료대기에 적는다). 새 구매품은 처음부터 실물 STEP으로 넣는다. 지지 유닛·브래킷 볼트 렌치 접근 M-01·M-02 결함 0. 동작 연구 전 구간 간섭 0 | 구동 후보 |
| 2 | T15 | T05 SNJ 스패너 자리 | 요구서 T15가 열려 있다(T05-W1·T10-S05·T10-M04). `CJ2B10-15Z_T05_SNJ`는 X −133.3~−120.5·Y 567~578·Z 81.5~85.5, `P_T05_GUIDE`는 X −152~−80·Y 553~612·Z 36~89.5에 있다(v0.7.2 실측). 스패너 판 21×4가 앞벽 뿌리 R3과 91.94 mm³ 겹친다. 주머니 벽은 Y 562.2/582.8이다. 고치면 앞벽 오조작B(417.5 N, SF 2.96, DP-3)를 다시 따져야 한다 | 스패너 판 21×4 겹침 0(M-01·M-02). 패드 안내 틈 유지. 앞벽 오조작 손계산 SF ≥ 2. 간섭 0. 옮긴 DP-3 체결도 함께 옮긴다 | 요구서 과제 |
| 3 | T14 | 회전부 높이 사슬 | 요구서 T14가 열려 있다(DF-13·스파이더, DL-X02 "링1·Y판·원판 두께 — 구동 과제 후보 예"). v0.7.2 실측: 링1 Z −10.5~−0.5(t10), 링2 Z −7~−2(t5), 원판 Z −12.5~−0.5, Y판 Z −370~−355(t15), 허브 Z −241~−233(t8), 스파이더 Z −233~−95.5, 너트판 Z −104.5~−98.5. 매트 밑면은 Z 0이다 | 매트 높이 기준(매트 밑면 Z 0) 변화 0. 진공 밀봉면 유지. 줄인 부재 손계산 SF ≥ 2(M-09). 동작 연구 전 구간 간섭 0. 옮겨지는 DP-1~3 체결(너트판·CB4-16·PSFJT16 등)도 함께 옮긴다 | 요구서 과제 |
| 4 | T17 | 진공 배관 회전부 건너기 | 결정로그 T11-S07의 구동 후보다. 진공 이젝터 `ZH10DSA-06-06-08_T1/T2`는 BASE 580 안쪽 X ±(33.4~50)·Y 300~361.7·Z −672~−639.6에 있다(v0.7.2 실측). 여기서 MAT_X·MAT_Y를 거쳐 원판(기둥 위끝)과 링1로 가야 한다. 회전 J_MAT_ROT −360~0. 기둥 속 Ø40 중 T11 묶음 r10 밖 r10~19.9가 남아 있다(mech_T11_select 180행). T13에서 이젝터를 옮길 수 있으니 자리를 함께 본다 | 회전 전 구간 진공 배관 꼬임·당김이 허용치 안일 것(로터리 조인트 또는 꼬임 구간, 관 굽힘 반경 D-46 임시 R10 등 임시값 기록). 진공 밀봉면 유지. 간섭 0 | 구동 후보 |
| 5 | T16 | X·Y 이송 배관·케이블 캐리어(분기·밸브 자리 포함) | 결정로그 T11-S07·T11-R03의 구동 후보다. 출발점은 Y판 결속 (±10, −590)이다. T11 예약 K_T16(MAT_Y, X −10~10·Y −590~−450·Z −385~−370)은 저장하지 않은 프로브라 v0.7.2에 없다. T12의 `K_T12_T16_L/R`도 커버와 함께 빠졌다. 실을 것: 링1·링2 관 6줄(또는 MAT_Y에 밸브를 실어 공급 1줄), DGM 모터 케이블, T18 서보 케이블, 진공 2줄(T17). 분기 `KQ2T04-00A`·밸브 자리도 여기서 정한다(T11-S03). 관 TU0425 굽힘 반경 D-46 임시 R10 | X·Y 행정 전 구간에서 캐리어 굽힘 반경 ≥ 카탈로그 최소(없으면 임시값 기록). 배관·케이블 길이 여유 ≥ 0. 분기·밸브 자리 확정. 캐리어는 실물 STEP으로 넣는다. 동작 연구 전 구간 간섭 0 | 구동 후보 |
| 6 | T19 | 바닥틀 가로 이음·다리(X 레일 받침) | `HFS8-4080-1900_F`(Y −1020~−980)와 `_B`(Y 160~200)를 서로 잇는 형재가 v0.7.2에 없다. Z −680 아래에도 바디가 없다(가장 낮은 바디가 1900·580 밑면 −680, v0.7.2 실측). 두 형재 위에 X 레일 SV2RL28-1800 F·B가 따로 얹혀 있다. 결정로그 T07-S04는 "BASE에도 다리가 없다 … 받침은 BASE 다리와 함께 D-39에서 정한다"고 했다. 그때 묶어 주던 T07 틀은 v0.7.2에서 빠졌다. 작업 높이는 D-39 임시값으로 진행한다(E-12). 형재 실제 끝은 X ±950이다(bbox ±1425는 WF-128) | 1900_F·_B를 형재 가로 이음으로 묶는다(새 형재는 실물 STEP과 마감캡). 다리·조절발은 D-39 임시 높이로 둔다. X 레일 두 줄 평행·높이 차는 SV2RL28 카탈로그 허용치 안(없으면 임시값 기록). 다리·이음 손계산 SF ≥ 2(M-09). 체결 렌치 접근 결함 0. 동작 연구 전 구간 간섭 0 | 구동 후보 |
| 7 | T13 | 헤드 받침 강성·배치 | 요구서 T13이 열려 있다. 기둥 `HFS8-4080-460_P1/P2`는 X ±(50~90)·Y 700~780·Z −600~−140, 밑 `580_T1/T2`는 Y 200~780·Z −680~−600이다. 이 580이 `1900_B`(Y 160~200)에서 외팔로 나와 있다(v0.7.2 실측, T02 그대로). 참고(mech_T13_measure, v0.7.1): 580 굽힘을 넣은 흔들림 2.970이고 기준 0.657의 4.5배다. ② 기둥 X ±170은 0.504, ①+② X ±170은 0.354, ④+② 580 뒤끝 다리+X ±150은 0.245다. 넓힐 때는 ZH10DSA 이젝터(T17)를 피한다. 움직이는 것은 Y ≤ 460.4에 있다. 실행 메모 (b)대로 v0.7.2에서 측정부터 다시 한다. 커버·가드 형재에는 기대지 않는다. T19 바닥틀·다리와 함께 본다. HBLFSN8 STEP은 `purchased-step/`에 있다(D-31) | 끌림 20 N에서 바늘점 X 흔들림(580 굽힘 포함 손계산) ≤ 0.657(T02 D3 값, D-08 임시). 헤드·매트 동작 전 구간 간섭 0. 커버·외장 형재에 기대지 않는다. 브래킷은 실물 STEP으로 넣는다 | 요구서 과제 |

- STEPWAIT 과제는 넣지 않았다. 형번이 정해진 STEP대기_ 12종이 모두 `step_wait.json`의 waiting에 있다(아래 표). 이유는 "로그인은 됨 — 이번 재시도에서 받지 못함(받기 대상)"이다. 로그인이나 사이트에 없는 것 때문이 아니므로 open.step_wait에 센다. 실행 규칙 11대로 구매부가 라운드마다 이어 받는다.
- step_wait.json의 swap 12종(DGM200R·HFS8 1300/1900/460/580·LHFR16·PSFJ16·CJ2B10-15Z·CJ2B16-60SZ·SV2RL28)은 v0.7.2 바디 이름에 이미 STEP대기_가 없다. 실물로 들어가 있고, document.json 이력에만 옛 이름이 남은 것이다. 그래서 세지 않았다.
- S02(일부): 남은 것은 위 STEP 대기와 같다. T07의 2850·680·1580은 가드틀과 함께 빠졌다. 따로 과제로 넣지 않았다.

## STEP 대기(형번 정해짐, v0.7.2 바디 실측)

| 형번 | 바디 수 | 자료대기 | step_wait 이유 |
|---|---|---|---|
| CB3-8 | 8 | D-37·D-43 | 받기 대상, 이번 재시도에서 못 받음 |
| CB3-10 | 5 | — | 같음 |
| CB4-16 | 24 | D-37 | 같음 |
| CB5-18 | 12 | — | 같음 |
| CB6-18 | 6 | — | 같음 |
| CJ2B16-30SZ | 2(몸통·로드) | D-37 | 같음, SMC 웹카탈로그 오류 페이지 |
| HNTT8-5 | 8 | D-41(보류 행에 있음, T08 몫은 남음) | 같음, 미스미 표기 확인 |
| KQ2L04-M5A | 6 | D-45 | 같음 |
| LBNR5 | 2 | D-37 | 같음 |
| NTJ-015C | 1 | D-37 | 같음 |
| PSFJT16-150-M5 | 6 | D-21·DL-D12 | 같음 |
| SSE2BZ12-120 | 3(레일+블록 2) | D-44 | 같음, 미스미 표기 확인 |

SEWHEAD(본체·노루발대·바늘대)·NEEDLE은 형번 미정(D-10)이라 user_wait로 보냈다.

## open 표

| 항목 | 수 | 메모 |
|---|---|---|
| 구동 과제 | 3 | T13·T14·T15 |
| 구동 후보 | 4 | T16·T17(T11-S07), T18(X·Y 이송 구동, S-03·D-24·D-25), T19(바닥틀 이음·다리, T07-S04·D-39) |
| 회귀 동작 문제 | 0 | T11-R03·T12-R03. v0.7.1·v0.7.2는 부품을 뺀 것뿐이다 |
| 디테일 | 0 | 구동 라운드 중이라 0으로 둔다 |
| STEP 대기(형번 정해짐) | 12 | 위 표. 형번 종류 수. 재봉 헤드·바늘(D-10)은 뺐다 |

## user_wait 표

| 항목 | 사용자가 줄 것 | 구동을 막나 |
|---|---|---|
| 재봉 헤드 기종 D-10(`STEP대기_SEWHEAD`·`_PRESSERBAR`·`_NEEDLEBAR`·`STEP대기_NEEDLE`) | 기종·바인더·STEP | 아니오(E-10 임시 형상) |
| 바늘점 흔들림·땀 위치 한도 D-08(T13 기준) | 납품처 품질 기준·한도견본 | 아니오(T02 값 0.657 임시) |
| 작업 높이·다리·조절발 D-39(T19·T13) | 바닥 ↔ 매트면 작업 높이 | 아니오(임시 높이로 진행) |
| 가장자리 센서 형번·구매처 U-T04-1·D-32 | 다른 구매처 / 차순위 C1 / C3 옆 열림 주머니 중 선택(돈·구조) | 아니오(C2 주머니로 진행 중, E-10) |
| 생산 목표 사이클 D-12(T18 서보·볼나사 선정) | 매트 한 장 사이클 타임 | 아니오(빈 이동 300 mm/s 등 임시값) |
| 납품처 안전 기준 D-38(T12 커버·T07 가드·라이트 커튼, 외장 단계) | 안전 거리·정지 시간 기준 | 아니오(커버·가드는 구동 아님) |

## 넣지 않은 것

- T12 옆·뒤 커버, T07 가드틀·라이트 커튼 자리, D-41·D-48·D-49: 구동이 아니라 외장·안전이다. 보류(규칙 14, V071·V072).
- 디테일 과제(T08·T09 등에 남은 디테일, DL-D40·DL-D49 등): 디테일링 몫이다.
- `mech_STEPSWAP_model.md`: 실행 메모 (e)대로 쓰지 않았다.

## 워크플로우 메모

- 모델 STEP대기_ 목록을 document.json 문자열로 뽑으면 이력(타임라인 primitive·material 표)에 남은 옛 이름까지 잡힌다. 그 결과가 step_wait.json의 swap 12종이고, 이미 실물인 부품이다. 바디 목록(`document.inspect` bodies)으로 세야 맞다.
- `assembly.bom` 대신 `document.inspect`를 썼고 약 200초 걸렸다.
