hyeunung/FSAP/docs/reports/engine-change-prompt_standalone.md

엔진 작업이다. MechDesign_Engine(v3.2.1)을 고친다. 아래 내용은 실제 프로젝트 실행(자동 봉제기 기구 개발)에서 나온 문제다. 프로젝트 파일은 이 PC에 없으니 찾지 말고, 아래 내용만으로 엔진을 고친다.

## 1. 완료될 때까지 스스로 이어 돌기 (roadmap R3·R2·R1)

배경: modeling_round(mechanism)가 끝나면 실행이 멈췄다. roadmap R3에 "R3 보류: 구동부 워크플로우가 끝나면 멈추고, 사용자가 '디테일링 시작해'라고 하면 시작"이라고 되어 있기 때문이다. 요구서 과제는 전부 '해결'이었지만 디테일 30건 이상, 구동 후보 여러 건, STEP대기_ 10개가 남아 제품으로 낼 상태가 아니었다. 사용자: "구동부 끝이라는게 완전히 완료되는거 말하는거야 제품으로 나가도되겠다 이프로젝트의 구동부가 100%끝났다".

- R3: 보류를 푼다. "모델링 해줘"를 받으면 구동부를 먼저 100% 끝낸다.
  - modeling_round(mechanism)를 구동 과제·구동 후보가 0이 될 때까지 거듭 부른다.
  - 그다음에 detailing_round를 한 번 부른다.
  - 구동 ↔ 디테일링을 번갈아 돌지 않는다. 사용자: "구동부 하나 하고 디테일링하고 또 구동부 하나 하고 디테일링하고 이것도 하지 말라고 했잖아. 구동부 다 완료가 되고 나면 디테일링을 하라니까".
  - 합친 스크립트든 세션 절차든 된다. 라운드마다 사용량은 보고하되 멈추지 않는다.
- mechanism 라운드의 측정·검증이 디테일링에서나 드러나던 구동 후보를 미리 찾게 한다.
  - 배치 때문에 막히는 볼트 렌치 접근
  - 구매품 수량·외형이 BOM과 맞는지(예: 레일마다 블록 2개인 BOM인데 모델엔 1개)
  - 높이 사슬(레일·블록·받침·판 두께 누적)
  - 이번 실행에서 디테일링이 구동 후보 7건을 냈다: X 받침 볼트 렌치 접근 불가, 레일 블록 수, 레일 높이 사슬, 칼 팔 축 위치, 패드 위치, 옆·뒤 커버, 공압 포트 방향. 구동 단계가 놓친 것이다.
- R2 완료(출시 가능) 조건: 아래가 모두 0.
  1. 요구서 5절 열린 구동 과제
  2. 디테일링이 낸 구동 후보(motion_task_candidate)
  3. 마지막 전체 회귀의 동작 문제
  4. 디테일(SF·체결·빈 구멍·판금)
  5. 형번이 정해졌는데 STEP대기_로 남은 구매품
  - 사용자 자료로만 풀리는 것(기종 미정, 납품처 안전 기준, 사이트 로그인)만 남으면 '사용자 자료 대기'로 멈추고 그 목록을 최종 보고 맨 위에 적는다. '완료'라고 쓰지 않는다.
- R1: tasks를 args JSON으로 손으로 쓰지 않는다. 요구서 5절 과제 목록, 디테일링 구동 후보, 모델의 STEP대기_ 목록을 워크플로우가 직접 읽어 다음 라운드 과제를 만든다.
- E-02 순서(구동 → 브래킷 → 디테일)는 그대로 둔다.

## 2. 프로젝트 규칙 파일 인자 rulesFile

배경: 프로젝트 고정 규칙(엔진 읽기만, MCP/CLI 나눔, 새 번호 저장, Git, 구매 사이트 규칙, 로그인 확인, 완료 기준 등 13개, 약 5천 자)을 매 실행 shellNote에 통째로 복사했다.

- modeling_round·detailing_round 둘 다 인자 rulesFile(예: <root>/tools/run-rules.md)을 받아 그 내용을 모든 부서 지시문 머리에 붙인다.
- shellNote는 실행마다 바뀌는 것(과제, 그 실행만의 기본값)만 받는다. 둘 다 주면 둘 다 붙인다.
- rulesFile을 줬는데 파일이 없으면 시작하지 않고 알린다.
- templates/project-layout.md 인자 표에 추가하고, 프로젝트 템플릿에 tools/run-rules.md 자리를 둔다.

## 3. 개선후보 반영

각 항목을 고친 뒤 engine/improvement-candidates.md '반영' 표로 옮긴다.

| ID | 문제 | 고칠 것 |
|---|---|---|
| WF-080 (반복 3) | 구매부가 미스미 로그인 풀림을 조용히 넘긴다. 재로그인 금지라 STEP대기_ 임시 형상으로 가는데 사용자는 끝나도 모른다 | 구매부 결과 스키마에 login(true/false). 받기 전에 화면 머리 '로그인 / 회원가입'을 먼저 확인. 최종 보고 맨 위에 "미스미 로그인: 됨/풀림 + 로그인 문제로 못 받은 형번" |
| WF-081 (반복 2) | STEP대기_ 임시 형상을 실물로 다시 바꾸는 단계가 없다. 앞 과제에서 못 받은 형번은 다시 찾지 않는다. 실물 치수가 달라 앞 검증을 다시 해야 한 적도 있다 | 라운드 시작 또는 끝에 "STEP 대기 재시도": 모델의 STEP대기_ 목록을 모아 다시 받고, 받으면 실물로 바꾸고 치수가 달라진 곳을 회귀 대상으로 |
| WF-082 (반복 3) | SolidCraft 앱이 켜져 있어도 모델링부가 CLI(run --save)로 그린다. MCP backend 판정을 안내문 기준으로 해서 틀린다. 사용자가 실시간으로 못 본다 | 판정을 실제 연결 상태(mcp running/inspect)로. 앱이 켜져 있으면 모델링부는 반드시 MCP: open 이전 버전 → inspect_design(dirty면 멈춤) → 그림 → 대기 포즈 → save {path: 새 번호}. 덮어쓰기 save {} 금지 |
| WF-083 (반복 3) | 과제 문서·커밋이 다음 과제 측정과 동시에 돌아, 과제 경계에서 멈추면 앞 과제 문서가 끊긴다 | 과제 경계에서 앞 과제 문서 job을 기다린 뒤 다음 과제로. 또는 다음 실행 시작 때 "문서 안 된 과제"를 찾아 문서부터 |
| WF-084 | 로그인 풀림·STEP 미수령 같은 외부 조건이 원인인 남은 문제에도 모델링 수정 회차를 돌려 헛돈다 | 검도/PM이 open_problems 원인이 login:false·STEP 미수령이면 수정 회차를 건너뛰고 '사람이 할 일'로 넘김 |
| WF-085 | 엔진 tools/*.py가 Windows 콘솔(cp949)에서 한글 출력 중 UnicodeEncodeError로 멈춘다(excerpt·stepcheck·ledger·brief·handcalc) | 각 도구 시작부에 sys.stdout.reconfigure(encoding='utf-8'), 실행 환경 줄에 PYTHONIOENCODING=utf-8 |
| WF-086 | 지시문은 tools/machine.json(E-15)을 가리키는데 프로젝트엔 motion_states.json만 있다. ledger.py scope도 machine.json을 읽는다 | 준비 점검부가 machine.json 유무를 확인해 없으면 만들거나, 기계 정의 경로를 config로 받는다. 없으면 motion_states.json으로 대신 |
| WF-087 | motion.interference 표본 상한 1000·단계 범위 인자 없음 → 1000단계 넘는 연구를 전 단계로 못 본다(직렬 약 3시간) | 안내서 '동작 검사'에 "1000단계 초과 연구는 occurrences 분할 병렬 또는 inspect.clearance 청크"를 적고 검도 기본 절차로 |
| WF-088 | 구상 지시가 python -I로 gmsh bbox를 전제하나 gmsh가 없는 PC가 있다 | 준비 점검에서 gmsh 유무 확인, 없으면 '측정부 bbox/부피 표 사용'으로 지시 변경. 측정 요약에 bbox 표 경로 |
| WF-089 | 구매품 STEP bbox가 실제보다 크게 나온다(예: 길이 ±1425 대 실제 ±950) | 측정부 안내에 "구매품 STEP은 bbox 대신 부피÷단면 또는 끝면 프로브로 길이 확인" |
| WF-090 | 예외 판정 PM이 CAD로 그릴 수 있는지 확인하지 않고 승인한다(캡 STEP 불리언 'no result'로 못 그림) | 예외 승인 전 CLI 시험 1회(불리언 성공 여부) 필수(E-14) |
| WF-091 | 버전 저장 뒤 ledger.py commit이 빠져 다음 과제 scope에 앞 과제 부품 100여 개가 새로·없어짐으로 올라온다 | 버전 저장 단계(모델링 끝 또는 최종 회귀)에 ledger.py commit 필수(E-17) |
| WF-051 | 준비부 지시 "값이 없으면 자료대기에 남기고 done=false"와 "D-번호 임시값으로 진행"이 충돌해, 다 만들고도 "준비 못 함"으로 멈췄다 | "D-번호 임시값으로 만든 준비물은 ready=true, done=true(임시값 목록 첨부). false는 아예 만들 수 없을 때만" |
| WF-052 | 요구서 0-2(작업 대상 수치)가 비어 있는 채 "모델링 해줘"가 시작됐다 | 시작 질문 템플릿 0-2에 "모르면 대략값(±)으로라도", 0-2가 비면 시작 전에 한 번 묻기 |
| WF-053 | 요구서 6-4 상태 목록이 0-3 사이클 전 단계를 덮는지 확인 안내가 없다 | 양식 6-4에 "0-3 각 단계가 6-4 상태 하나 이상에 대응"을 넣고 대화 단계에서 확인 |
| WF-054 | 동작 상태 초기화(motion.play step 0)가 동작 연구 없는 설계에도 주어진다 | 안내서 '동작 상태 초기화'와 resetCall 단계에 "연구가 없으면 건너뛰고 적는다" |
| WF-055 | SolidCraft 안내서에 CLI 함정이 빠짐 | 안내서에 추가: motion.interference는 budget_s 필수·truncated 확인 / 슬라이더 방향은 원점 z, flip 없으면 뒤집힘 / sketch.offset은 체인을 다 못 잡고 시계 방향 호가 섞이면 붕괴 → 직접 계산 / eval --json-out은 마지막 측정만, 단계별은 run --results(--save 없이) / timeline.inspect는 빈 설계에서 못 부름 → document.inspect / motion.study 회전 키는 도(°) / 바깥면이 같은 평면인 상자 둘 join은 거부 → 한 스케치로 |
| WF-056 | matcheck.py가 가공품 BOM이 없으면 예외로 멈춘다 | 가공품 0개면 "검사 대상 없음(BOM 없음)"으로 통과·보고 |

## 4. 마무리

- 엔진 버전을 올리고 engine/CHANGELOG.md에 적는다.
- 가짜 에이전트 시험 `node workflows/run_tests_node.js`를 통과시킨다. R3 이어 돌기(구동 후보가 있으면 구동 라운드 반복, 0이면 디테일링 1회)와 rulesFile 붙이기에 시험 사례를 추가한다.
