hyeunung/FSAP/docs/reports/engine-change-request_2026-11-01.md

# 엔진 수정 요청 — FSAP에서 (2026-11-01)

엔진 MechDesign_Engine v3.2.1을 고칠 때 가져갈 정리다. FSAP 세션은 엔진을 건드리지 않았다(CLAUDE.md). 각 개선후보의 자세한 증거는 `docs/reports/engine-candidates.md`에 있다.

## 1. 왜 고치나

- **사용자가 지적한 것(2026-11-01):**
  - "왜 계속 안해 끝났어?"
  - "계속 엔진 돌려야지 지금 그럼 니가 모델링한걸로 제품출시해도돼?"
  - "구동부 끝이라는게 완전히 완료되는거 말하는거야 제품으로 나가도되겠다 이프로젝트의 구동부가 100%끝났다"
- **실제로 일어난 일:**
  - S01·T06·T07·S02 구동 라운드(`modeling_round` mechanism)가 끝나고 실행이 멈췄다. 요구서 5절 과제는 전부 '해결'이었다.
  - 그런데 남은 것이 있었다.
    - 디테일 30건 이상: 빈 구멍 15, 칼 팔 SF 1.22, 체결 없는 판 등
    - 구동 후보 4건: 옆·뒤 커버, 칼 팔 축 이동, T05 패드 위치, 링2 포트 방향
    - STEP대기_ 10개
  - 제품으로 낼 수 있는 상태가 아니었다.
- **원인:** 엔진 `engine/roadmap.md` R3에 "R3 보류(사용자 2026-10-30): 구동부 워크플로우가 끝나면 멈추고, 사용자가 '디테일링 시작해'라고 하면 시작"이라고 되어 있다. 단계 사이를 사람이 잇게 되어 있다.

## 2. 핵심 수정 — 완료될 때까지 스스로 이어 돌기

| 로드맵 | 지금 | 바꿀 것 |
|---|---|---|
| **R3 상위 실행 규칙** | 보류. 구동 → 디테일링을 사람이 잇는다 | 보류를 푼다. "모델링 해줘"를 받은 세션이 구동 → 디테일링 → 구동 후보가 있으면 다시 구동 → 디테일링 … 을 아래 완료 조건까지 차례로 부른다. 하나로 합친 스크립트로 해도 되고, 세션 절차로 해도 된다. 토큰 한도를 보려면 라운드마다 사용량을 보고하는 정도로 둔다. 멈추지는 않는다 |
| **R2 완료 조건 명문화** | '구동 확정' = 요구서 과제가 전부 '해결' | **완료(출시 가능) = 아래가 모두 0**<br>① 요구서 5절 열린 구동 과제<br>② 디테일링이 낸 구동 후보(`motion_task_candidate`)<br>③ 마지막 전체 회귀의 동작 문제<br>④ 디테일(SF·체결·빈 구멍·판금)<br>⑤ 형번이 정해졌는데 STEP대기_로 남은 구매품<br>사용자 자료가 있어야 풀리는 것(재봉 헤드 기종, 납품처 안전 기준, 사이트 로그인)만 남으면 "사용자 자료 대기로 멈춤"이다. 이때 무엇이 남았는지를 최종 보고 맨 위에 적는다. '완료'라고 쓰지 않는다 |
| **R1 과제 대기열** | `tasks`를 사람이 손으로 쓴다(args JSON) | 요구서 5절 과제 목록, 디테일링 구동 후보, STEP대기_ 목록을 워크플로우가 직접 읽어 다음 라운드 과제를 만든다 |

E-02 순서(구동 → 브래킷 → 디테일)는 그대로 둔다. 바뀌는 것은 단계마다 사람이 시작 신호를 주지 않아도 된다는 점뿐이다.

**구동과 디테일링을 번갈아 돌지 않는다.** 사용자 2026-11-01: "구동부 하나 하고 디테일링하고 또 구동부 하나 하고 디테일링하고 이것도 하지 말라고 했잖아. 구동부 다 완료가 되고 나면 디테일링을 하라니까". 구동 라운드를 구동 과제·구동 후보가 0이 될 때까지 거듭하고, 그 뒤에 디테일링을 한 번 한다.

- 이번 FSAP 디테일링에서 구동 후보 7건이 나왔다(`docs/reports/detailing/detail_plan.md` 5절).
  - X 받침 볼트 렌치 접근 불가
  - 레일 블록이 레일마다 1개뿐
  - 레일 높이 사슬
  - 칼 팔 축 위치
  - T05 패드 위치
  - 옆·뒤 커버
  - 링2 포트 방향
- 이것들은 구동 단계에서 찾았어야 했다. mechanism 라운드의 측정·검증에 다음을 미리 보는 항목을 넣는다.
  - 배치 때문에 막히는 렌치 접근
  - 구매품 수량·외형이 BOM과 맞는지
  - 높이 사슬

## 3. 함께 고칠 것 — 이번 실행들에서 반복된 문제

| ID | 문제(한 줄) | 반복 |
|---|---|---|
| WF-080 | 구매부가 미스미 로그인 풀림을 조용히 넘긴다. 실행 끝에 로그인 상태와 못 받은 형번을 보고하는 단계가 엔진에 없다(FSAP는 shellNote 규칙 12로 땜질했다) | 3 |
| WF-081 | STEP대기_ 임시 형상을 다시 실물로 바꾸는 단계가 없다. 앞 과제에서 못 받은 형번은 다시 찾지 않는다(FSAP는 S01·S02 과제를 손으로 넣었다) | 2 |
| WF-082 | SolidCraft 앱이 켜져 있어도 모델링부가 CLI로 그린다. MCP backend 판정이 안내문 기준이라 틀린다. 사용자가 실시간으로 못 본다 | 3 |
| WF-083 | 문서·커밋이 다음 과제 측정과 동시에 돌아서, 실행을 멈추면 앞 과제 문서가 끊긴다 | 3 |
| WF-084 | 로그인 풀림 같은 외부 조건으로 남은 문제에도 모델링 수정 회차를 돌린다(헛돈다) | 1 |
| WF-085 | 엔진 파이썬 도구가 Windows 콘솔에서 한글을 출력하다 UnicodeEncodeError로 멈춘다. `sys.stdout.reconfigure(encoding='utf-8')`나 PYTHONIOENCODING으로 고친다 | 1 |
| WF-086 | 지시문은 `tools/machine.json`(E-15)을 가리키는데 프로젝트에는 `motion_states.json`만 있다 | 1 |
| WF-087 | `motion.interference` 표본 상한 1000이고 단계 범위 인자가 없어서, 1000단계가 넘는 연구를 전 단계로 못 본다 | 1 |
| WF-088 | 구상 지시가 gmsh를 전제하는데 이 컴퓨터에 없다 | 1 |
| WF-089 | 구매품 STEP bbox가 실제보다 크게 나와 외곽을 잘못 잡는다 | 1 |
| WF-090 | 예외 판정 PM이 CAD로 그릴 수 있는지 확인하지 않고 승인한다 | 1 |
| WF-091 | 버전 저장 뒤 `ledger.py commit`이 빠져서 다음 과제 검사 범위가 부풀어 오른다 | 1 |
| WF-051~056 | 준비부 지시 모순, 0-2 빈칸 시작, 6-4 상태 목록, 초기화 대상 없음, CLI 함정, matcheck BOM 없음 | 1 |

## 4. 덧붙여 — 실행 인자 다루기

- 이번 실행들의 `shellNote`는 약 5천 자다. 규칙 (1)~(13)은 사실상 프로젝트 고정 규칙인데 매 실행 손으로 복사했다.
  - 프로젝트 규칙: 엔진 읽기만, MCP/CLI 나눔, 새 번호 저장, Git, 미스미 규칙, 로그인 확인
  - 실행마다 바뀌는 것: 과제·기본값
- 제안:
  - 엔진이 프로젝트 파일(예: `tools/run-rules.md`)을 읽어 지시문 머리에 붙이게 한다.
  - 실행마다 바뀌는 것만 인자로 받는다.
  - `modeling_round`과 `detailing_round`가 같은 파일을 쓴다.

## 5. FSAP 쪽 현재 상태(참고)

- 최신 모델: v0.6.10.
  - 디테일링 DP-1~DP-3은 v0.6.4~v0.6.10으로 끝났다.
  - 구동 후보가 남은 채 디테일링을 띄운 것이 잘못이었다. 그래서 DP-4에서 멈췄다.
- 지금 구동 라운드(wf_199b1477-323)가 돈다. 디테일링이 낸 구동 후보 7건을 요구서 5절 T08~T14로 넣었고, STEP 교체 S03도 함께 돈다.
- 엔진을 고치기 전까지는 FSAP 세션이 지금 엔진으로 라운드를 손으로 잇는다. 구동 라운드를 구동 과제·후보가 0이 될 때까지 거듭하고, 그 뒤 디테일링을 한 번 한다(메모리 "구동부 100% 완료까지 계속").
- 규칙 전문은 이제 shellNote에 붙여 넣지 않는다. shellNote에 "`tools/run-rules.md`를 먼저 읽어라"라고만 쓴다. 엔진의 `rulesFile` 인자가 생기면 그것으로 바꾼다.
- 사용자 자료 대기:
  - 재봉 헤드 기종 D-10
  - 미스미 재로그인(STEP 10개): CJ2B16-30SZ, HFS8-4080-2850·680·1580, HNTT8-5, CB4-16, LBNR4, LBNR5, PSFJT16-100-M□, NTJ-015C
  - 납품처 안전 기준 D-38
