hyeunung/FSAP/docs/reports/mechanism/mech_RX-10_design.md

# RX-10 설계안 — U6 슈 바닥 Y 90 → 130 + 누름 실린더 작용점 맞춤 (기구설계부, 2026-11-13)

요약(10줄 안):
- 기준 `tools/config.json` doc(FSAP_v2.17.1), 측정 `mech_RX-10_measure.md`. 출발점: 0-8-3 U6 "R375X 사진(스테인리스 슈 + 슈 위 광센서 블록)" + 결정로그 C-43(Y 130, X 23 그대로).
- 슈 `P_M06_SHOE`: −Y 끝으로만 40 늘림(단면 그대로, 벽·윗날개도 같은 길이). bbox X −82~−59 · **Y −245~−115** · Z 17~54.5, 평탄 19.0 × 119.295 = **2,266.6 mm²**, 약 139.8 g(+46.9).
- **측정부가 넘긴 '로드 편심 22.65'는 그대로 두면 안 된다**: 슈는 칼라 2개가 같은 Z라 기울기가 자유(U6S 해석부 모델) → 로드가 Y −152에 있으면 닿는 면만 늘려도 실제 미끄럼 SF 1.53~1.72(정지 1.38) < 2. 그래서 **누름 실린더 축을 Y −152 → −166(−Y 14)**으로 옮긴다(편심 22.65 → 8.65, SF 2.07~2.90).
- 실린더를 −Y로 옮기면 포트 −Y 쪽 피팅이 SHIFT 0에서 U7 고정 관 `TU0604_M08P_U7C_CUT_A`(Y −184.9~−178.9 · Z 97~103)에 걸린다(CAD: 겹침 985.6 mm³). → **실린더를 180° 돌려 포트를 +Y로**, 피팅 2개는 옛 실린더 자리로, 관 2개는 새 길로(CAD 프로브 겹침 0, 4 mm 안 없음).
- 브래킷 `P_M06_PCYL_BRKT` Y −176~−122 → −184.5~−122, 벽 볼트 Y −170 → **−177**(−128 그대로), 캐리지 인서트 자리 같이 옮김. 옛 미달 U6S-D1(볼트 렌치 길이 피팅에 막힘)이 같이 풀린다.
- 완료 판정: ① 같은 식 SF **2.285**(F_hi 21.59)·2.151(0.19 MPa F_hi 22.94) ② X 23.0 ③ 프로브 겹침 0 ④ 잡음 비 0.975(0.18) → **IR1000 :3 설정 0.19 MPa에서 1.052**, 들기 SF 5.34, 창 0.184~0.200 ⑤ +Y 끝 Y −115 그대로 → 가림 0 ⑥ BOM 값 9절.
- 새 구매품 0, 부품 수 변화 0, 조인트·행정·연구 키 변화 0. 바뀌거나 옮기는 바디 14(가공품 3 + 구매품 사본 9 + 관 2).
- 미완: 관 2개 새 길은 프로브 상자(겹침 0)까지만 확인 — 실제 관 바디의 틈은 모델링부 자기 점검. 매트 연구 자세는 CAD로 돌리지 않음(슈–매트는 Z 관계뿐, 측정 3절).

## 0. 통로·원복·시간

| 항목 | 값 |
|---|---|
| 통로 | MCP(앱에 v2.17.1 dirty false로 열려 있어 다시 열지 않음, 파일 열기 0). 읽기만, 저장 0 |
| 잰 것 | `body_topology` 5(브래킷·캐리지 원통면, 관 3), `sketch.inspect` 2(관 A·B 길), 프로브 `batch` 6(상자 40개 + `inspect.clearance` 11), `document.inspect` 3 |
| 원복(E-08) | `edit.checkpoint` 92 → 프로브 → `restore` true, 95 → 프로브 → `restore` true. 끝: dirty false · 바디 876 · 타임라인 3,687 · PRB 0 · `motion.play REST 0` moved false · sigcheck `reuse` |
| 앱 막힘 | 첫 `batch`(상자 15 + clearance 2)가 MCP 응답 한도(약 300 s)를 넘겨 연결이 끊김. `running`으로 기다려 약 9분에 끝남 → 같은 clearance를 다시 불러 읽음(pairs_reused, 43 ms). 앱 재시작 없음, 버린 것 없음 |
| 결과 파일 | `tools/out/mech_RX-10/design/probe_design.json`(프로브), `handcalc_design.py`·`.json`(손계산), `prefilter.json`(bbox 거르기) |

좌표는 모두 REST(J_U6_SHIFT −60, J_U6_PRESS +4.5, J_U7_HGT 0). 작동 자세(SHIFT 0)는 U6_SHOE·U6_PRESS 묶음 X +60.

## 1. 왜 실린더까지 옮기나 (작용점)

측정부 요약: "−Y로만 늘리면 로드(Y −152)가 평탄 중심에서 22.65 편심 … 구상이 로드 구멍·실린더 자리를 그대로 둘지 정할 때 쓸 수치다."

- 슈 안내는 칼라 2개(같은 Z 32.5)와 세로 장공이다. U6S 해석부(`mech_U6S_fea.md` 2-1): "팔 20.5 mm의 모멘트 F_d·20.5는 칼라가 받지 못한다(같은 Z라 짝힘 없음, 장공이 Z로 열려 있음). 로드 Ø4는 부시 틈(약 0.006 rad)이 … 커서 거의 받지 않는다. 그래서 모멘트는 바닥 압력 기울기로만 받는다." → 슈는 기울기가 자유라 **압력 중심 = 로드 자리 − μ·20.5(끌림)**이다. 로드가 닿는 면 중심에서 벗어난 만큼 압력이 한쪽으로 몰린다.
- 완료 판정 ①의 식(1 + 6·μ·h/L)은 로드가 닿는 면 중심 가까이 있을 때(지금 편심 2.65)의 식이다. 로드를 두고 −Y로만 40 늘리면 식은 2.285가 나오지만 실제 분포는 아래와 같다(`handcalc_design.json`, 평탄 길이 119.295, F_hi 22.94 N @0.19 MPa, 허용 30 kPa).

| 경우 | 편심 e | 정지 SF | 끌림 μ 0.2 | μ 0.3 | μ 0.4 |
|---|---|---|---|---|---|
| 지금(L 90, 로드 −152, 21.59 N) | 2.65 | 1.744 | 1.886 | 1.655 | 1.474 |
| L 130, 로드 −152 그대로 | 22.65(들뜸) | **1.379** | **1.534** | 1.620 | 1.717 |
| **L 130, 로드 −166(이 안)** | 8.65 | 2.066 | 2.413 | 2.634 | 2.899 |
| 같음, 레귤레이터 최대 0.20 MPa(23.79 N) | 8.65 | 1.992 | 2.326 | 2.539 | 2.795 |

- 로드를 그대로 두면 최저 SF가 1.47 → 1.53으로 거의 안 오른다(μ 0.2에서는 1.89 → 1.53으로 내려간다). 길이를 늘린 효과를 받으려면 작용점이 닿는 면 중심(Y −174.65)에서 +Y로 0~8.2(= μ·h) 안팎에 있어야 한다. 정지 자국은 미끄럼 한도(30 kPa, D-165)가 아니라 짧은 접촉 한도(100 kPa, D-145) 쪽이라 정지 1.99~2.07은 참고 값이다.
- 규칙: 실행 규칙 13 "구동 라운드는 디테일링이 낼 만한 구동 후보도 미리 찾는다", E-24 "구동 후보 점검부가 … 구동 축·작용점 위치를 미리 찾는다". 요구서 1-1 ② "영구 눌림자국 없음".

옮기는 양 −14를 고른 이유(CAD 수치):

| 걸리는 것 | 수치 | 정한 값 |
|---|---|---|
| U7 고정 관 `U7C_CUT_A`(SHIFT 0에서 실린더 바로 −Y, 겉 Y −178.9) | −Y 20이면 실린더 상자와 틈 1.65 | −Y 14 → 틈 약 7.6 |
| 포트 방향 −Y 그대로 | 피팅 :2 끝 Y −176.7 ↔ 관 겉 −178.9 = 2.2 → 2.2 넘게 못 옮김, −Y 20은 겹침 985.6 mm³ | 포트 +Y(실린더 180° 돌림) |
| 브래킷 볼트 | 포트 +Y면 피팅 :2(Y −163~−141.3 · Z 81~100)가 Y −156 볼트 렌치 길을 막음 | 볼트 Y −177·−128(실린더 양옆), 렌치 길 겹침 0 |
| 캐리지 끝 Y −185 | 인서트 Ø6.8 @ −177 → 끝까지 살 4.6, 브래킷 끝 −184.5(구멍–끝 4.75 ≥ 1.5t 4.5) | 볼트 −177. 실린더 −15면 볼트 머리 자리와 몸통이 0.25 겹쳐 −14 |
| 편심 | −14 → e 8.65(끌림 0.45~4.55), −9 미만이면 μ 0.2 끌림 SF < 2 | −14 |

## 2. 설계안

### 2-1. 구동 방식·행정·순서 (바뀌지 않음)

- 슈 세로 누름·들기 `J_U6_PRESS`(slide Z, −5.0~+4.5, 대기 +4.5), 가로 비킴 `J_U6_SHIFT`(−60 대기 · 0 작동). 조인트·행정·동작 연구 키는 그대로.
- 순서(U6S-Q1~Q3 그대로): 피벗 전 슈 들기, 누름은 SHIFT 0 뒤, 들기 뒤 SHIFT −60.
- 바뀌는 것은 레귤레이터 IR1000-01BG :3 설정 0.18 → **0.19 MPa**(창 0.184~0.200)뿐.

### 2-2. 부품 (REST 좌표)

| 부품 | 전 | 후 | 만드는 법(잠정) |
|---|---|---|---|
| `P_M06_SHOE`(U6_PRESS, SUS304 t2) | bbox Y −205~−115, 평탄 Y −194.29~−115(79.29), 벽·윗날개 Y −195~−115, 로드 구멍 Ø6 (−68, −152), 92.9 g | bbox **Y −245~−115**, 평탄 X −78~−59 · Y −234.295~−115(119.295), 입술(R 안 2 + 20° 올림) Y −245~−234.295, 벽 X −82~−80 · Y −235~−115 · Z 21~50.5, 윗날개 X −78~−62 · Y −235~−115 · Z 52.5~54.5, 로드 구멍 Ø6 **(−68, −166)**, 장공 7.1 × 17.1 ×2 그대로(Y −135·−175), 약 139.8 g | 판금(레이저 + 굽힘 4, 지금과 같음) |
| `P_M06_PCYL_BRKT`(U6_SHOE, SUS304 t3) | Y −176~−122, Ø8.5 (−68, −152), Ø5.5 Y −170·−128(Z 86) | **Y −184.5~−122**(62.5), Ø8.5 **(−68, −166)**, Ø5.5 **Y −177**·−128(Z 86). 단면(판 Z 74.3~77.3, 벽 X −82~−79 · Z ~94, 굽힘 R 안 3) 그대로, 약 51.9 g | 판금 |
| `P_M06_CARR`(U6_SHOE, PET-CF) | 인서트 자리 (Y −170, Z 86)·(Y −128, Z 86) | (Y −170, Z 86) 자리를 **(Y −177, Z 86)**으로(Ø6.8 × 8 + Ø5.2 × 3, 면 X −82). 옛 자리 구멍은 남기지 않는다 | 3D 출력 |
| `CJ2B10-15Z_M06P` 몸 + `_NUT_MNT` | 축 (−68, −152), 포트 −Y | 축 **(−68, −166)**, **포트 +Y**(Z 축으로 180°). 몸 X −74~−62 · Y −172~−160 · Z 69.3~138.3 | 구매품(있는 것) |
| `_ROD` + `_NUT_ROD` ×2 (U6_PRESS) | Y −157~−147 | Y −171~−161(평행 이동 −14) | 구매품 |
| `KQ2L06-M5A_M06` :2(로드 쪽, 출구 +Z) | Y −176.7~−155 | X −73.2~−62.8 · **Y −163~−141.3** · Z 81.2~99.7, 출구 (−68, −146.5, 99.7) | 구매품 |
| `KQ2L06-M5A_M06` :3(머리 쪽, 출구 +X) | Y −176.7~−155 | X −72~−53.5 · **Y −163~−141.3** · Z 130~140.4, 출구 (−53.5, −146.5, 135.2) | 구매품 |
| `CB5-12_M06_3` :2 + `MBIS5-6.5-8_M06_1` :2 | Y −170 | **Y −177**(Z 86 그대로) | 구매품 |
| `TU0604_M08P_U6P_A`·`_B` | 시작 Y −171.5 | 새 길(3절 6) — 끝점·끝 방향은 그대로 | 관(그림) |

- 실린더 몸·피팅 2개의 새 자리는 지금 자리를 평면 **Y = −159**에 거울로 옮긴 것과 같다(몸은 축 대칭, 피팅은 나사 축 둘레로 돌릴 수 있어 실물로 같은 자세가 된다).
- 캐리지·센서·칼라·칼라 볼트·장공·`J_U6_SHIFT` 실린더는 그대로.

### 2-3. 손계산 (`tools/out/mech_RX-10/design/handcalc_design.py`)

식은 `fea/cases/mech_U6S_handcalc.py` 1절과 `tools/out/mech_U6S/model/u6s_calc_model.json`의 누름 띠 그대로. 닿는 면은 측정부가 잰 평탄 폭 19.0 × (L − 10.705).

| 항목 | 값 |
|---|---|
| 닿는 면 | 19.0 × 119.295 = 2,266.6 mm² (지금 1,506.6) |
| 슈 질량 | 92.883 → 139.78 g(끝면 단면 147.85 mm² × 40 × 7.93e-3 = +46.9 g), 움직이는 무게 1.010 → 1.470 N |
| **자국 SF(같은 식, μ 0.4, F_hi 21.59 N)** | 30 ÷ (21.59 ÷ 2,266.6 × 1.378) = **2.285** (지금 1.354) |
| 잡음 필요 힘 | 3·EI·δ/a³ × 0.130 = 9.36 N (지금 6.48, D-164 임시값) |

| P MPa | F_lo N | F_hi N | 잡음 비 | 자국 SF(같은 식) | 직선 끌림 N(μ 0.4) |
|---|---|---|---|---|---|
| 0.18(지금 설정) | 9.13 | 22.08 | **0.975** | 2.234 | 8.83 |
| 0.184 | 9.42 | 22.43 | 1.006 | 2.200 | 8.97 |
| **0.19(새 설정)** | 9.85 | 22.94 | **1.052** | **2.151** | 9.18 |
| 0.20(IR1000 상한) | 10.56 | 23.79 | 1.129 | 2.073 | 9.52 |

- 설정 창: 잡음 비 ≥ 1 최저 0.1832 MPa ~ 자국 SF ≥ 2 최고 0.2102(레귤레이터 상한 0.20이 먼저) → **0.184~0.200, 설정 0.19**. IR1000-01BG 범위 0.005~0.2 MPa 안.
- 레귤레이터를 끝까지 올려도(0.20) 자국 SF 2.07 → 옛 미달 U6S-D8("레귤레이터 최대 0.2 MPa 평균 SF 1.94")이 같이 없어진다.
- 들기: 0.5 MPa 32.99 N ÷ (1.470 + 4.71) = **SF 5.34**(지금 5.77).
- 직선 끌림 ÷ U4 견인: 0.54 → 0.574(1 미만).
- 브래킷 볼트(옮긴 것, 손 100 N 오조작, 축 X −68 ↔ 벽면 X −82 팔 14): 인장 합 175 N(받침 Z 94, 팔 8) → 가까운 볼트가 다 받아도 인서트 뽑힘 임시 1,000 N ÷ 175 = SF 5.7(운전 들기 57.7 N SF 17). 전단은 양쪽 볼트 사이 하중(11 : 38) → 가까운 볼트 77.6 N, 인서트 받음 1.49 MPa. 벽 굽힘 853 N·mm ÷ (3 × 13.7² ÷ 6) = 9.1 MPa(SF 22.6).
- 슈 윗날개 탭·바닥 판: 단면과 팔(벽 X −80 → 로드 X −68)이 그대로라 U6S 값 그대로.
- 해석: FEA 못 함 — 환경 없음(D-16). 완료 판정 ①은 접촉 압력 손계산(같은 식 +14 %, 기준 ±10 % 밖 — E-18 "손계산 값이 기준 ±10% 안이면 그때만 FEA로 다시 확인").

### 2-4. 상태별 틈 (CAD 프로브, 5절)

| 상태 | 무엇 | 틈 |
|---|---|---|
| SHIFT −60·0, PRESS −5.0~+4.5 | 슈 늘린 자리 Y −245~−205 | 겹침 0, 15 mm 안 기계 부품 0(측정부) |
| 같음 | 슈 +Y 끝 ↔ E32 감지면 | 3.606 그대로(끝 Y −115 안 바뀜) |
| SHIFT −60 | 새 실린더 기둥 ↔ 칼라 볼트 `CB5-12_M06_3` | 3.22 (칼라 4.64) |
| SHIFT −60~0 쓸림 | 새 실린더·피팅 ↔ BASE·HGT_PLATE·UPPER·U7 부품 | 5 mm 안 없음 |
| SHIFT 0 | 새 실린더 ↔ `U7C_CUT_A` 관 | 약 7.6(−Y 20 실측 1.65 + 6) |
| SHIFT −60 | 관 A·B 새 길 ↔ BASE 가로 날개(Z 148~151) | 관 윗면 138.2 → 9.8 |
| SHIFT 0 | 관 B 낮은 길(Z 112~118) ↔ `P_M05_CYL_BRKT`(X ≥ 14, Z ≤ 110) | 4.0 |
| SHIFT 0 | 관 A·B 새 길 ↔ U7C 관 4개 | 4 mm 안 없음 |
| 매트 | 슈 바닥 Z 12.1(누름 키) ↔ 이음매 윗면 12.0 | 0.1 그대로. 좁은 U홈 회전은 PRESS +4.5(매트 위 5.0 이상), X 폭 그대로 |

## 3. 모델링 지시서

대기 자세(REST)에서 그린다. 수치는 REST 월드 좌표. 관 스케치는 U6_SHOE 안 좌표(= 월드 X + 60).

1. **`P_M06_SHOE`** — 판금 기능 그대로 고친다(다시 그리지 않는다, U-10 "덧대지 말고 처음부터 한 덩어리로").
   - 바닥 스케치 `SK_M06_SHOE`의 −Y 변을 Y −194.2947 → **−234.2947**(평탄 X −78~−59 그대로). 벽(`EdgeFlange4`)·입술(`EdgeFlange5`)·윗날개(`U6S_SHOE_TOP`)는 바닥 변을 따라 같은 길이로 늘어나야 한다. 안 따라오면 그 피처 너비를 같은 Y 범위로 맞춘다.
   - 장공 2개(`Extrude42`·`U6S_SHOE_SLOT`)는 Y −135·−175, Z 중심 32~42 그대로(움직이지 않는다).
   - 윗날개 로드 구멍 Ø6: (X −68, Y −152) → **(X −68, Y −166)**.
   - 기대값: bbox X −82~−59 · Y −245~−115 · Z 17~54.5(±0.05), 바닥 평탄 면 2,266.6 mm²(±1), 부피 약 17,627 mm³·질량 약 139.8 g(±1 %), 재질 SUS304. `sheet.flat_pattern`이 전개돼야 한다.
2. **실린더 묶음** — 지금 자리를 평면 Y = −159에 거울로 옮긴 자리(= 축 −Y 14 + Z 축 180°).
   - `CJ2B10-15Z_M06P`: 축 (−68, −166), 포트 +Y, bbox X −74~−62 · Y −172~−160 · Z 69.3~138.3. `_NUT_MNT`: Y −172.4~−159.6 · Z 70.3~74.3.
   - `_ROD`(U6_PRESS): X −73~−63 · Y −171~−161 · Z 49.3~109.8. `_NUT_ROD` ×2: Y −170~−162, Z 54.5~57.7 · 49.3~52.5.
   - `KQ2L06-M5A_M06` :2 bbox X −73.2~−62.8 · Y −163~−141.3 · Z 81.2~99.7, :3 bbox X −72~−53.5 · Y −163~−141.3 · Z 130~140.4.
3. **`P_M06_PCYL_BRKT`** — 스케치 `SK_M06_PCYL_BRKT`의 −Y 변 −176 → **−184.5**(+Y 변 −122 그대로), `SK_M06_PCYL_BRKT_H`의 Ø8.5 중심 Y −152 → **−166**, 벽 구멍 Ø5.5 Y −170 → **−177**(Z 86, −128 그대로). 기대 bbox X −82~−60 · Y −184.5~−122 · Z 74.3~94.
4. **`P_M06_CARR`** — 인서트 자리(Ø6.8 깊이 8 + Ø5.2 깊이 3, 면 X −82에서 −X) (Y −170, Z 86) → **(Y −177, Z 86)**. 그 구멍 피처의 자리를 바꾼다(옛 구멍을 메우고 새로 뚫지 않는다 — U-10 "메운 구멍 자국" 금지). (Y −128, Z 86)·칼라 자리는 그대로.
5. **볼트·인서트** — `CB5-12_M06_3` :2 → 기대 bbox X −91~−74 · Y −181.2~−172.8 · Z 81.8~90.2, `MBIS5-6.5-8_M06_1` :2 → X −90~−82 · Y −180.4~−173.6 · Z 82.6~89.4. 축 −X, 머리 +X 쪽. U6_SHOE 리지드 그룹 그대로.
6. **관**(U6_SHOE 스케치 좌표, R 15, Ø6) — 시작점은 옮긴 피팅 출구 중심으로 맞춘다(±1 안에서 고쳐도 된다). 끝점·끝 방향은 지금 그대로.
   - `SK_TU0604_M08P_U6P_A`: (6.5, −146.5, 135.2)에서 +X → 호(중심 (6.5, −161.5, 135.2), 90°) → (21.5, −161.5, 135.2) → 곧게 (21.5, −186.5, 135.2) → 지금 길 그대로[호 중심 (21.5, −186.5, 150.2) → (21.5, −201.5, 150.2) → (21.5, −201.5, 200) → 호 → (6.5, −201.5, 215) → (−40, −201.5, 215)].
   - `SK_TU0604_M08P_U6P_B`: (−8, −146.5, 99.7) → (−8, −146.5, 100) → 호 1(세운 평면, 방향 (0.7071, −0.7071, 0), 중심 (2.607, −157.107, 100), 90°) → (2.607, −157.107, 115) → 호 2(Z 115 평면, 중심 (−8, −167.713, 115), 45°) → (7, −167.713, 115) → 곧게 (7, −171, 115) → 호 3(중심 (7, −171, 130), 90°) → (7, −186, 130) → 곧게 (7, −186, 200) → 호 4(중심 (−8, −186, 200), 90°) → (−8, −186, 215) → 곧게 (−40, −186, 215).
   - 지킬 것(길을 고칠 때의 기준): 굽힘 R ≥ 15, 이웃과 틈 ≥ 3(SHIFT −60·0 둘 다), 관 중심 Z ≤ 142인 채로 Y −172보다 −Y로 빠져나온 뒤 올린다(BASE 가로 날개 Z 148~151 · Y ≥ −172), SHIFT 0 월드 X ≥ 12 쪽(U7 부품)으로 나가지 않는다, `U7C_CUT_A` 첫 구간(월드 SHIFT 0: X −7~14.5 · Y −181.9 · Z 100.25, Ø6)은 Z 110 위로 넘는다, 새 실린더 몸(Ø12, 축 (−8, −166) 스케치 좌표)과 틈 ≥ 3(권장 길 4.3).
7. **조인트·묶음** — 새 조인트 없음. `J_U6_PRESS`·`J_U6_SHIFT` 정의·한계 그대로(M-07 "조인트·리지드 그룹은 실제로 함께 움직이는 관계대로"). 옮긴 뒤 `joint.inspect J_U6_PRESS`가 풀리는지, `J_U6_PRESS` −5.0~+4.5에서 따라 움직이는 것이 슈 + 로드 + 로드 너트 2개뿐인지 본다(E-15). 몸·마운트 너트·피팅·관·볼트·인서트는 U6_SHOE.
8. **자기 점검(저장 전)** — 바뀐·옮긴 14바디를 SHIFT −60·0 × PRESS −5.0·+4.5에서 이웃(`tools/out/mech_RX-10/neighbors.json` against + `P_M06_BASE`·`P_REG02_HGT_PLATE`·`STEP대기_867-392342_UPPER`·U7C 관 4개)과 `inspect.clearance`. 겹침 0(슈 윗날개 ↔ 로드 통과 구멍, 볼트 ↔ 인서트 나사 물림 같은 뜻한 맞닿음 제외). 좁은 U홈 매트(MAT_G·TP_G)도 넣는다. 재질 검사(E-09), 안 묶인 부품 0(E-11).
9. **문서 담당에 넘길 값(BOM 가공품)** — `P_M06_SHOE`: 치수 X −22~1 · Y −245~−115(SHIFT 0 표기), 로드 구멍 Y −166, 질량 모델 값. `P_M06_PCYL_BRKT`: Y −184.5~−122, 구멍 Ø8.5 (Y −166) + Ø5.5 ×2(Y −177·−128). `P_M06_CARR` 비고: 인서트 자리 Y −177·−128. 구매품 수량 변화 0.
10. **기계 정의·설계검토서(U-09)** — `tools/machine.json` `J_U6_PRESS._note`: 실린더 축 Y −166, IR1000-01BG(:3) 설정 0.19 MPa(창 0.184~0.200), 누름 띠 9.85~22.94 N. 제어 순서 제약 U6S-Q1~Q3은 그대로 두고 Q3의 압력 창만 0.167~0.192 → 0.184~0.200으로 고친다.
11. **저장** — 대기 포즈(`motion.play` REST 0), 조인트·스케치 표시 숨김, 새 번호로(컴포넌트 신설·삭제 없음).

stepcheck(`python -B engine/tools/stepcheck.py --project tools …`):

| 형번 | 판정 | 근거 |
|---|---|---|
| CB5-12 | 있음 | CB5-12\CB5-12.stp |
| MBIS5-6.5-8 | 있음 | MBIS5-6.5-8\MBIS5-6.5-8.stp |
| CJ2B10-15Z | 있음 | CJ2B10-15Z\CJ2B10-15Z.stp |
| KQ2L06-M5A | 있음 | KQ2L06-M5A\KQ2L06-M5A.stp |
| IR1000-01BG | 있음 | IR1000-01BG\IR1000-01BG.stp |
| TU0604 | 없음 | 관은 STEP이 아니라 모델 안 파이프 피처(지금도 같음) — 새로 넣는 것 아님 |

새로 사는 것·새로 넣는 STEP은 없다(모두 모델에 있는 바디를 옮긴다). needs_step 없음.

## 4. 규칙 자기 점검

| 규칙(원문) | 판정 | 근거 |
|---|---|---|
| E-03 "작업 대상을 넣은 전 구간 동작과 간섭 0" | 과제 범위 만족(프로브) | 2-4 표. 전체 사이클은 라운드 끝 회귀 |
| 0-8-2 ② "노루발·바인더 끝·슈 묶음 폭 < 가장 좁은 홈 폭" | 만족 | 슈 X 폭 23.0 그대로 < 25 |
| C-43 "Y 길이 90 → 130 … X 폭 23은 그대로", 사용자 "답도 없이 넓게는 또 하지말고" | 만족 | 130에서 멈춤. 더 길게 하지 않음 |
| M-06 "카탈로그 허용치를 확인하고 보고서에 수치로" | 임시값으로 판정 | CJ2B10 Ø10·로드 Ø4(누름 78.54 · 들기 65.97 mm²), 최저 사용 압력 0.06 MPa → 마찰 띠 ±4.71 N(D-165 임시). IR1000-01BG 0.005~0.2 MPa. 새 값 없음 |
| U-14 "로봇까지 할 건 아니야 절대" | 해당 없음 | 로봇 부품 없음 |
| U-12 "평범한 육각 렌치 볼트 하나의 지름으로" | 만족 | 옮기는 볼트 CB5-12(M5) 그대로 |
| M-01 "렌치 접근: 머리 위 축 방향 빈 공간 ≥ 볼트 길이 + 5 mm" | 만족(옮긴 볼트) | Y −177 볼트 머리 + 17 mm 길 겹침 0, 새 실린더 몸과 Y 0.75. Y −128 볼트는 새 피팅(Y ≤ −141.3)과 9.0 |
| M-02 "조립 순서 제약으로만 풀리는 볼트는 결함" | 좋아짐 | 옛 U6S-D1(피팅이 Y −170 볼트 렌치 길을 막아 조립 순서로만 풂)이 없어짐 |
| M-03 "구멍에서 바깥면까지 살은 2.5 mm 이상" | 만족 | 인서트 자리 Ø6.8 @ Y −177 → 캐리지 끝 Y −185까지 4.6 |
| M-04 "구멍–판 끝 ≥ 1.5t" · "억지 판금" 금지 | 새 구멍 만족 | 브래킷 Ø5.5 @ −177 → 끝 −184.5 4.75 ≥ 4.5, Ø8.5 → 끝 14.25. 슈는 단면·굽힘 그대로(길이만). 옛 미달 U6S-D2(벽 구멍–굽힘선)는 Z 86을 안 바꿔 그대로 남음(디테일) |
| U-10 "덧대기 … 단차 … 메운 구멍 자국" 금지 | 만족 | 슈는 같은 단면으로 전체 길이, 캐리지 옛 인서트 구멍은 자리 이동(남기지 않음) |
| U-07·E-10 "추정 형상 금지" | 만족 | 새 구매품·임시 형상 없음 |
| U-01 "핵심 기능의 정밀도는 비용으로 깎지 않는다" | 만족 | 자국(요구서 1-1 ②) 때문에 실린더 재배치까지 함. 비용 줄이려 빼지 않음 |
| M-12 "끼우는 길" | 만족(순서) | 슈 + 칼라 2 → 브래킷 볼트 2(+X에서) → 실린더를 브래킷 구멍에 위에서 + 마운트 너트 → 로드를 윗날개 구멍에 + 너트 2 → 피팅 2(+Y에서) → 관. 뒤 순서가 앞 볼트를 막지 않는다 |
| E-14 예외 | 없음 | exception_request 0 |

## 5. CAD 확인(feasibility) 요약

`tools/out/mech_RX-10/design/probe_design.json`. 프로브 = `solid.box` + `inspect.clearance`(clearance 4~5), REST 상자와 X +60 쓸림 상자.

| 확인 | 결과 |
|---|---|
| 새 실린더 기둥(X −74~−62 · Y −173.4~−160.6 · Z 39.8~138.3) | 겹침 = 슈 윗날개 307.2 mm³(로드 지나는 자리)뿐. 칼라 볼트 3.22, BASE·캐리지·HGT_PLATE·UPPER 5 mm 안 없음. 쓸림 상자도 없음 |
| 새 피팅 자리 2곳(Y −164~−142.3) | REST·쓸림 겹침 0, 5 mm 안 없음 |
| 새 인서트 자리(Y −180.4~−173.6, X −93~−82) | 캐리지 안 508.64 mm³ = 상자 전체(살 있음). 붙임면 뒤(Y −184~−176) 115.2 = 전체 |
| 새 볼트 머리 + 렌치 길 17 mm | 겹침 0 |
| 브래킷 늘린 자리(Y −184.5~−176) | 겹침 0, 캐리지 붙임면과 0.0 |
| 관 A 새 길 상자·관 B 낮은 길·세운 길 상자 | 겹침 0(BASE 날개와는 상자 모서리 Y −172~−171만 — 관은 그 높이에서 Y −189~−183). `P_M05_CYL_BRKT` 4.0, U7C 관 4개 4 mm 안 없음 |
| 지시 좌표 ↔ 실제 면 | 브래킷 구멍 (−68, −152)·Y −170·−128 @ Z 86, 굽힘 축 (X −76, Z 80.3), 캐리지 인서트 Ø6.8 × 8 + Ø5.2 × 3 @ 면 X −82 — `body_topology`로 읽은 값과 지시서 '전' 값 일치. 관 길은 `sketch.inspect` 값 |
| 높이 사슬 | 실린더·브래킷·슈 Z 치수 변화 0(Y로만 옮김) |
| 구매품 수량·외형·연결부 방향 | 수량 변화 0. 포트 +Y, 피팅 :2 출구 +Z · :3 출구 +X(지금과 같은 방향) |

## 6. 완료 판정

| 항목 | 만족 | 근거 |
|---|---|---|
| ① 자국 SF ≥ 2(μ 0.4, F_hi, 같은 식, 잰 면) | 예 | 2.285(F_hi 21.59 N, 면 2,266.6 mm² — 모델링 뒤 다시 잼). 새 설정 0.19 MPa F_hi 22.94 N에서도 2.151, 레귤레이터 최대 2.073. 작용점 편심을 넣은 모델로도 2.07~2.90(1절) |
| ② 슈 X 폭 ≤ 23 | 예 | 23.0(안 바뀜) |
| ③ 좁은 U홈·SHIFT −60·0 × PRESS −5.0·+4.5 과제 범위 간섭 0 | 예(프로브) | 2-4·5절. 매트와는 Z 관계(누름 12.1 ↔ 12.0), 홈 회전은 +4.5. 실제 바디는 모델링 자기 점검·검도 |
| ④ 들기 힘·잡음 비·IR1000 :3 다시 계산 | 예 | W 1.470 N, 0.18 MPa면 0.975 → **설정 0.19 MPa: 잡음 비 1.052**, 들기 SF 5.34, 창 0.184~0.200(상한 0.2 안) |
| ⑤ E32 시야 가림 0 | 예 | 슈 +Y 끝 Y −115 그대로(센서 앞 3.606). 늘린 것은 −Y뿐 |
| ⑥ BOM(가공품) 고침 | 예(값 지시) | 3절 9. 고치는 것은 문서 담당 |

## 7. 부품 수·비용

- 부품 수 증감 0(더한 것 0, 뺀 것 0). 컴포넌트 신설·삭제 없음.
- 세트 비용: 슈 판금 재료 +46.9 g(SUS304 t2 전개 약 +40 × 74 mm), 브래킷 +7 g, 굽힘 수·구멍 수·볼트·구매품 그대로. 가격 미확인(가격표에 가공품 단가 없음).
- 만드는 법 4가지 비교(M-13)·판금성 표는 디테일링에서.

## 8. 위험·남는 것

- 관 A·B 새 길은 상자 프로브까지만 확인했다. 실제 파이프 바디의 틈(특히 관 B ↔ 새 실린더 몸 4.3, ↔ `P_M05_CYL_BRKT` 4.0)은 모델링부가 잰다. 안 맞으면 3절 6의 기준 안에서 길을 고친다.
- Y −177 볼트 머리 자리와 새 실린더 몸 사이 Y 0.75(겹침은 아님) — 디테일 기록.
- 잡음 필요 힘 9.36 N은 D-164 임시값(EI·δ·a)과 "슈 길이에 비례" 가정이다. 설정이 0.19 MPa로 레귤레이터 상한(0.2)의 95 %다. 실제 필요 힘이 더 크면 상한에 걸린다 → 시제품 확인(요구서 7절, 눌림·잡음은 모델로 판정하지 않음).
- 자국 허용 30 kPa(D-165)·μ 0.2~0.4는 임시값.
- 옛 디테일 U6S-D2(브래킷 벽 구멍–굽힘선), U6S-D3(고정 쪽 관 길 미완), U6S-D7·D9는 그대로 남는다. U6S-D1·D6·D8은 이 안으로 없어진다(검도·해석 확인 뒤 닫음).

## 워크플로우 메모

- 과제가 '가공품 하나 길이 수정(등급 S)'로 정해졌지만, 누름 작용점이 닿는 면 중심에서 벗어나면 완료 판정 식(중심 하중 가정)이 실제와 달라진다. 바뀌는 바디가 14개(실린더·브래킷·캐리지·피팅·관)로 등급 M에 가깝다. 과제 정리부가 '닿는 면을 한쪽으로 늘리는' 과제를 낼 때 작용점 위치를 완료 판정에 넣으면 등급이 처음부터 맞는다.
- 지시문 (a)·(g)는 대상을 v2.13.0이라고 적었지만 `config.json` doc와 앱에 열린 것은 v2.17.1이다(측정 보고서도 v2.17.1). config.json을 따랐다.
- MCP `batch` 하나(상자 15 + clearance 2)가 응답 한도를 넘겨 연결이 끊기고 결과를 잃었다. 다시 부른 같은 clearance는 43 ms(pairs_reused)라 어느 쌍이 느렸는지 알 수 없다. `batch`가 끝난 요청의 결과를 `pending`으로 다시 받을 수 있으면(끊긴 연결 것 포함) 다시 재지 않아도 된다.
- `edit.restore_checkpoint`·`motion.play`·`document.inspect` 응답이 1.3~1.4 MB라 결과가 파일로만 온다(측정부 메모와 같은 것, 반복).
