hyeunung/FSAP/docs/reports/mechanism/mech_RX-10_donecheck.md

# RX-10 완료 판정 확인 — 원칙 감사 (2026-11-13)

요약(10줄 안):
- 대상 설계안 RX-10-S1(슈 −Y로 40 늘림 Y −245~−115, 누름 실린더 축 Y −152 → −166 · 포트 +Y, IR1000 :3 설정 0.19 MPa). 기준 문서 v2.17.1(config.json doc). CAD는 쓰지 않았다(파일 읽기·손계산만).
- 완료 판정 6항목을 설계안 수치로 따로 다시 계산했다. **6항목 모두 만족, ok = true.** 고칠 자리 없음.
- ① 자국 SF(같은 식, μ 0.4, 면 19.0 × 119.295 = 2,266.6 mm²): F_hi 21.59 N **2.285**, 새 설정 0.19 MPa F_hi 22.94 N **2.151**, 레귤레이터 최대 0.20 MPa 23.79 N 2.073. 식의 L을 평탄 길이 119.295로 바꿔 불리하게 봐도 2.230·2.099·2.024 ≥ 2.
- 작용점 편심 모델(로드 −166, e 8.65 < L/6 19.88 → 들뜸 없음): 정지 2.066, 끌림 μ 0.4 2.899 — 설계안 값과 같다. 끌림이 압력 중심을 −Y로 옮긴다는 방향도 모멘트 평형으로 확인(매트 +Y 이송, 입술이 −Y 끝).
- ④ W 1.010 → 1.470 N, 0.18 MPa 잡음 비 0.975 < 1 → 0.19 MPa F_lo 9.85 N ÷ 9.36 N = **1.052**, 들기 SF 5.34, 창 0.1832~0.200(식 상한 0.2102, IR1000-01BG 범위 0.005~0.2 안).
- ② X 23.0 그대로, ⑤ +Y 끝 Y −115 그대로(E32 앞 3.606), ⑥ BOM 값은 지시서 9항에 있음(고치는 것은 문서 담당).
- ③ 프로브 수치로 겹침 0. 좌표 산술(거울 Y −159, 볼트 머리 ↔ 실린더 3.0, 인서트 살 4.6, 브래킷 ↔ U7C 관 Z 19.7)도 맞다.
- 남는 위험(완료 판정 밖, 기록만): 설정 창 폭 ±0.006~0.010 MPa로 좁다(4절). 슈 늘린 자리의 SHIFT 중간 쓸림 띠 X −44~−37은 프로브 15 mm 범위 밖 — 검도가 `joint.sweep`으로 본다. 관 2개 실제 바디 틈은 모델링 자기 점검.

## 0. 근거 규칙

| 규칙 | 원문 | 이번 |
|---|---|---|
| E-02 | "구동부 → 브래킷 → 디테일" | 동작·간섭·완료 판정 수치만 봤다. 볼트·두께 다듬기는 보지 않았다 |
| E-03 | "작업 대상을 넣은 전 구간 동작과 간섭 0" | 과제 범위(SHIFT −60·0 × PRESS −5.0·+4.5)는 프로브 수치, 전체 사이클은 라운드 끝 회귀 |
| E-16 | 판정은 수치로만 | 아래 표는 모두 다시 계산한 수치 |
| E-18 | "손계산 값이 기준 ±10% 안이면 그때만 FEA로 다시 확인" | ① 2.285는 기준 +14 %. 0.19 MPa 값 2.151은 +7.6 %지만 FEA 환경 없음(D-16) — 해석부 기록 사항 |
| M-06 | "카탈로그 허용치를 확인하고 보고서에 수치로" | IR1000-01BG 설정 범위 0.005~0.2 MPa, 새 설정 0.19(95 %) |
| 요구서 5절 RX-10 | "자국 SF ≥ 2(μ 0.4, F_hi), 슈 X 폭 ≤ 23, 좁은 U홈 전 구간·SHIFT·PRESS 자세 간섭 0, 슈 들기 힘·잡음 비 다시 계산(무게 늘어남), BOM" | 완료 판정 원문 |
| 0-8-2 ② | "슈 묶음 폭 < 가장 좁은 홈 폭" | X 23 < 25 |

## 1. 항목별 재계산

입력: `tools/out/mech_U6S/model/u6s_calc_model.json`(A_head 78.54 mm², 마찰 띠 4.71 N, μ_g·μ_s 0.08, W 1.01 N, 들기 32.99 N), 식 `fea/cases/mech_U6S_handcalc.py` 1절, 측정 `mech_RX-10_measure.md`(평탄 폭 19.0, 입술 10.705).

| 완료 판정 | 다시 계산한 값 | 판정 |
|---|---|---|
| ① 자국 SF ≥ 2 | 면 19.0 × (130 − 10.705) = 2,266.6 mm². 기울기 계수 1 + 6·0.4·20.5/130 = 1.3785. F_hi 21.59 N: 9.525 kPa × 1.3785 = 13.13 kPa → 30/13.13 = **2.285**. 0.19 MPa: F_hi = (0.19·78.54 + 1.470 + 4.71)/0.92 = 22.94 N → 10.12 × 1.3785 = 13.95 → **2.151**. 0.20 MPa 23.79 N → 2.073 | 만족 |
| ② X 폭 ≤ 23 | 단면 그대로, X −82~−59 = 23.0 | 만족 |
| ③ 과제 범위 간섭 0 | 2절 | 만족(프로브) |
| ④ 들기·잡음·설정 | 늘어난 질량 147.85 × 40 × 7.93e-3 = 46.90 g → W 1.010 + 0.460 = 1.470 N. F_need 72 N/m × 0.130 = 9.36 N. 0.18 MPa: F_hi 22.08, F_lo 14.137 + 1.47 − 4.71 − 0.08·22.08 = 9.13 → 0.975. 0.19 MPa: F_lo 14.923 + 1.47 − 4.71 − 0.08·22.94 = 9.85 → **1.052 ≥ 1**. 들기 32.99/(1.470 + 4.71) = 5.34. 창 아래 끝 P = 13.137/71.71 = 0.1832, 식 위 끝 (24.67·0.92 − 6.18)/78.54 = 0.2102 → 레귤레이터 상한 0.20 | 만족 |
| ⑤ E32 시야 가림 0 | 늘린 쪽은 −Y 끝뿐, +Y 끝 Y −115 그대로 → 감지면(Y −112~−107) 앞 3.606 그대로. +Y 쪽은 측정에서 막힘 확인(센서 146~1,039 mm³)이라 −Y 선택이 맞다 | 만족 |
| ⑥ BOM | 지시서 9항: P_M06_SHOE(Y −245~−115, 로드 구멍 Y −166, 질량), P_M06_PCYL_BRKT(Y −184.5~−122, Ø8.5 Y −166, Ø5.5 Y −177·−128), P_M06_CARR(인서트 Y −177·−128), 구매품 수량 변화 0 | 만족(값 지시, 고침은 문서 담당) |

### ① 반박해 본 것

| 의심 | 계산 | 결과 |
|---|---|---|
| 식의 L을 전체 길이 130이 아니라 실제 닿는 평탄 길이 119.295로 | 계수 1 + 49.2/119.295 = 1.4124 → 21.59 N 2.230, 22.94 N 2.099, 23.79 N 2.024 | 모두 ≥ 2 |
| 무게가 늘어 F_hi가 커진다(판정 문구 F_hi 21.59는 옛 값) | 새 F_hi 22.94 N으로 2.151 | ≥ 2 |
| 로드 편심(−166, 평탄 중심 −174.6475) | e 8.6475 < L/6 19.88(들뜸 없음). 정지 10.12 × (1 + 6·8.6475/119.295) = 14.52 kPa → 2.066. 끌림 μ 0.4: e 0.4475 → 10.35 kPa → 2.899, μ 0.2: e 4.5475 → 12.43 → 2.413 | ≥ 2 |
| 끌림이 압력 중심을 반대(+Y)로 옮기면 e 16.85 → SF 1.61 | 모멘트 평형: 바닥에 +Y 마찰, 칼라(위 h)에 −Y 반력 → 압력 중심 이동 d = −μ·h(−Y, 매트가 들어오는 쪽). 매트는 바늘(Y 0) 쪽 +Y로 이송, 입술이 −Y 끝. 회전 구간은 슈 들림(U6S-Q1) | 설계안 방향이 맞다 |
| 로드를 −152에 그대로 두면 | e 22.65 > 19.88(들뜸): 2·22.94/(3·19·(59.65 − 22.65)) = 21.75 kPa → 1.379 | 실린더를 옮긴 이유가 수치로 맞다 |

## 2. ③ 간섭 — 좌표 산술 확인

| 자리 | 계산 | 결과 |
|---|---|---|
| 슈 늘린 자리 Y −245~−205 | 측정부 프로브 10개(SHIFT −60·0, Z 7.5~59): 겹침 0, 15 mm 안 기계 부품 0 | 0 |
| 실린더·피팅 새 자리 | 평면 Y −159 거울: 축 −152 → −166, 피팅 −176.7~−155 → −163~−141.3 | 지시서 값과 같다 |
| 새 실린더 기둥(Z 39.8~138.3 = 로드 끝 49.3 − 9.5 포함) | 겹침은 슈 윗날개 307.2 mm³(로드 구멍 자리)뿐, 칼라 볼트 3.22, 칼라 4.64, 쓸림 상자 5 mm 안 없음 | 0 |
| 볼트 머리(Y −177, Ø8.5, X −79~−74) ↔ 실린더 몸(Ø12, 축 (−68, −166)) | √(6² + 6.75²) − 6 = 3.03 | 겹침 없음 |
| 볼트 Y −128 ↔ 피팅 :2(Y ≤ −141.3) | 141.3 − 132.25 = 9.05 | 겹침 없음 |
| 인서트 Ø6.8 @ −177 ↔ 캐리지 끝 −185 | 185 − 180.4 = 4.6(프로브: 상자 전체가 살 안) | 살 있음 |
| 브래킷 늘린 자리(SHIFT 0) ↔ U7C_CUT_A(Z 97~103) | 판 윗면 77.3 → 19.7, 벽(X −22~−19)은 관 첫 구간 X −7~14.5 밖. 프로브 쓸림 겹침 0 | 0 |
| 실린더(Y ≥ −172.4) ↔ U7C_CUT_A 겉(Y −178.9) | Y로 6.5 이상(설계안 약 7.6) | ≥ 3 |
| 슈 ↔ 매트 | Z 관계뿐: 누름 12.1 ↔ 이음매 12.0, 들림 17.0(+5.0). 좁은 U홈 회전은 들린 채. X 폭 그대로 | 변화 0 |

프로브가 못 본 것(완료 판정 밖, 다음 부서 몫):
- 관 `TU0604_M08P_U6P_A`·`_B` 새 길은 상자까지만 — 실제 바디 틈(실린더 몸 4.3, `P_M05_CYL_BRKT` 4.0)은 모델링 자기 점검.
- 슈 늘린 자리의 SHIFT 중간 쓸림: 두 끝 자세 상자의 15 mm 범위가 X −97~−44와 −37~16이라 X −44~−37 띠(폭 7, Y −245~−205)는 범위 밖. 판정 문구는 끝 자세(−60·0)라 미달이 아니다. 검도가 `joint.sweep J_U6_SHIFT`로 한 번 본다.

## 3. 판정

| 항목 | 만족 |
|---|---|
| ① 자국 SF ≥ 2 | 예 (2.285 / 2.151 / 2.073) |
| ② 슈 X 폭 ≤ 23 | 예 (23.0) |
| ③ 과제 범위 간섭 0 | 예 (프로브 겹침 0) |
| ④ 들기·잡음 비·IR1000 :3 | 예 (1.052, 5.34, 0.19 MPa) |
| ⑤ E32 가림 0 | 예 |
| ⑥ BOM | 예 (값 지시) |

**ok = true. problems 없음.**

## 4. 남는 위험 (기록만, 수정 회차 아님)

- 설정 창이 좁다: 잡음 비 ≥ 1 아래 끝 0.1832, 위 끝은 레귤레이터 상한 0.20 → 설정 0.19에서 −0.007 / +0.010 MPa. 압력계 눈금 오차가 이 폭과 비슷할 수 있다. 조정 절차(압력계 등급)는 디테일·시제품에서.
- 잡음 비 1.052는 U6S 해석부가 쓴 권장 기준 1.2(`mech_U6S_handcalc.py` 'criterion': 1.2)에 못 미친다(0.20 MPa에서도 1.129). 이번 완료 판정 문구는 "여유율 ≥ 1"이라 만족. 잡음 필요 힘 9.36 N은 D-164 임시값 + "슈 길이 비례" 가정이라 실제는 요구서 7절 시제품 확인.
- 자국 허용 30 kPa(D-165)·μ 0.2~0.4·CJ2B10 마찰 띠(D-165)·인서트 뽑힘 1,000 N은 임시값.
- 정지 SF 2.066(0.20 MPa 1.992)은 미끄럼 한도 30 kPa 기준이다. 정지 자국은 짧은 접촉 한도 100 kPa(D-145) 쪽이라 참고 값.

## 워크플로우 메모

- 완료 판정 ①의 "F_hi"가 옛 값(21.59 N)인지 무게·설정이 바뀐 뒤 값(22.94 N)인지 문구로는 갈린다. 이번에는 둘 다 ≥ 2라 판정이 같았다. 과제 정리부가 하중이 과제 안에서 바뀌는 경우 "바뀐 뒤 값으로"라고 적으면 갈리지 않는다.
- 지시문 (a)·(g)의 대상 v2.13.0과 config.json doc(v2.17.1)이 다르다(설계부 메모와 같은 것, 반복).
