hyeunung/FSAP/docs/reports/mechanism/mech_RX-10_fea.md

# 구동 RX-10 해석 — U6 슈 바닥 Y 90 → 130 (해석부, 2026-11-14, v2.17.2)

## 요약

- 해석 못 함 — 환경 없음(D-16, `engine/fea/.venv`·numpy·gmsh 없음). 손계산 `fea/cases/mech_RX-10_handcalc.py` → `fea/results/mech_RX-10_handcalc.json`. CAD 안 씀. 형상은 임시 STEP 3개에서 면·원통을 직접 읽었다(바닥 평탄 면 19.0 × 119.295 = **2,266.599 mm²** = 모델링부 실측, 로드 구멍 (−68, −166), 편심 e_y +8.647 · e_x +0.5).
- 완료 판정 ① 자국 SF(같은 식, μ 0.4, 잰 면): F_hi 21.59 N **2.285**, 새 설정 0.19 MPa(22.94 N) **2.151**, 레귤레이터 상한 0.20 MPa **2.073** — 모두 ≥ 2(옛 형상 1.354). 식의 L을 평탄 길이 119.3으로 엄격히 넣어도 2.230 · 2.099 · 2.024.
- 완료 판정 ④ 0.19 MPa: 누름 띠 9.85~22.94 N, 잡음 비 **1.052**(≥ 1), 들기 SF 5.34(안내 마찰 넣으면 4.12). IR1000-01BG :3 창 **0.184~0.200 MPa**, 설정 0.19.
- 실제 분포(로드 자리 편심 + 가로 편심, 강체 판 기울기 자유): 직선 끌림 μ 0.2~0.4에서 최저 **2.21**(0.19) · **2.14**(0.20) ≥ 2. 강체 판·기울기 자유 가정은 수치로 맞음(슈 처짐 0.0001~0.002 mm ≪ 파일 눌림 0.21 mm).
- **동작 문제 1건(RX-10-F1) → pass false.** 해석 모델에 하중 경우를 하나 더했다(아래 '해석 모델을 바꾼 것'): 오조작 손 100 N을 **슈 끝(입술 모서리)**에 걸면 슈 앞뒤 기울기를 꽉 물린 누름 실린더 로드 Ø4가 굽힘으로 받는다. 붕괴 손 힘 64~103 N(SF **0.64~1.03 < 1.2**), 첫 항복 33~46 N. 옛 형상은 95~153 N(0.95~1.53)이었다 — 슈가 −Y로 40 길어져 팔이 53 → 79가 된 만큼 내려갔다.
- 바뀐 하중 부품(옛 모델 = 손 힘이 로드 선으로): 브래킷 판 오조작 SF 4.88, 벽 볼트 인서트 5.71, 슈 윗날개 탭 2.72 — 통과.
- 디테일 3건(기록만): 곡선 구간 가로 끌림 자국 SF 1.62~1.93(k 0.05), 잡음 비·압력 창 여유(아래 6.8 kPa), 들림 자세 매달린 무게가 로드에 거는 모멘트 15.2 N·mm(M-06 허용 옆하중 미확인). 외부 1건: FEA 못 함.
- 미완: 30 kPa·μ·k·손 100 N은 임시값(D-165·D-145·D-79). 실제 자국은 요구서 7절.

### 해석 모델을 바꾼 것(이유, 옛 모델 값)

- 바꾼 것: `fea/models.json` `P_M06_SHOE`의 오조작 하중에 **(b) 입술 모서리 점하중**(M06 때부터 표에 있던 경우)을 U6S 뒤의 받침(칼라 2개 + 로드)으로 다시 풀었다. U6S 해석은 손 100 N이 **로드 선으로** 들어온다고만 봤다(`load_U6S` "손 100 N(오조작)").
- 이유: 슈가 길어지면 끝에 걸린 힘의 팔이 커진다(이 과제가 바꾼 것). 칼라 2개가 같은 Z(32.5)라 앞뒤 기울기는 자유이고(`contact_U6S` "칼라 2개가 같은 Z, 장공이 Z로 열림"), 그 기울기를 막는 것은 너트 2개로 윗날개에 꽉 물린 로드뿐이다.
- 옛 모델(손 100 N 로드 선, 같은 새 형상): 탭 SF 2.72, 브래킷 판 4.88, 인서트 5.71 — 통과. 새 경우: 로드 굽힘 SF 0.64~1.03(붕괴). 차이는 4절.
- 자국은 모델을 바꾸지 않았다(U6S의 Winkler 강체 판 그대로). 편심·가로 끌림은 같은 모델에 실제 로드 자리·칼라 틈을 넣은 검토다.

## 0. 근거·지시

| 항목 | 값 |
|---|---|
| 과제 | RX-10, 등급 S. 완료 판정 ① "자국 SF ≥ 2(μ 0.4, F_hi — 같은 손계산 식, 닿는 면은 모델에서 잰 값)" ④ "슈 무게 늘어난 값으로 들기 힘·잡음 비(여유율 ≥ 1, 지금 1.344)·IR1000 :3 설정 다시 계산" |
| 입력 | STEP `tools/out/mech_RX-10/stepout/P_M06_SHOE.step`(bbox X −82~−59 · Y −245~−115 · Z 17~54.5) · `P_M06_PCYL_BRKT.step`(X −82~−60 · Y −184.5~−122 · Z 74.3~94) · `P_M06_CARR.step`(X −120~−42 · Y −185~−100 · Z 21~156), 모두 REST 자세. 누름 띠 식·임시값 `tools/out/mech_U6S/model/u6s_calc_model.json`. 모델링부 실측(면 2,266.599 mm², 139.782 g), 검도 요약 |
| 해석 환경 | 없음 → 손계산. '해석 못 함 — 환경 없음(D-16)' |
| 판정 기준 | 요구서 6-1(M-09 기본값) 운전 SF 3 · 오조작 SF 2(SUS304 205, PET-CF 60). 자국 30 kPa(D-165 임시)에 SF ≥ 2. 영구 변형 선 1.2 |
| 해석 모델 표 | `fea/models.json`: `P_M06_SHOE`·`P_M06_PCYL_BRKT`·`P_M06_CARR`에 `*_RX-10` 칸 더함 |

규칙 원문:
- E-18 "완료 판정에 강도 항목이 있거나 하중 경로의 단면이 바뀌면 등급 S도 FEA를 돌린다", "손계산 값이 기준 ±10% 안이면 그때만 FEA로 다시 확인한다", "손계산의 단면은 가정하지 말고 측정 자료의 최소 단면으로 쓴다" → 환경이 없어 손계산, 치수는 STEP에서 읽음.
- E-02 "구동 단계에서 새로 본 디테일은 기록만 하고 수정 회차를 쓰지 않는다. 단 기능이 깨지는 수준(부러짐·영구 변형·동작 중 걸림)은 동작 문제다."
- M-09 "필요 SF | 일반 3, 오조작 하중 2", "하중은 운전 힘과 오조작 힘을 따로 둔다". M-06 "카탈로그 허용치를 확인하고 보고서에 수치로 적는다."
- 지시 "모델을 바꿔야 하면 이유를 보고서 맨 위에 적고 옛 모델도 같은 형상으로 풀어 차이를 남긴다."

## 1. 자국 (완료 판정 ①)

### 1-1. 같은 식 — 30 ÷ (F ÷ A × (1 + 6·μ·h ÷ L)), μ 0.4 · h 20.5 · A 2,266.599

| 힘 | F N | 평균 kPa | SF(L 130, 판정) | SF(L = 평탄 119.295) | SF(평균, 옛 모델) |
|---|---|---|---|---|---|
| F_hi 21.59(과제 문구, 0.18 MPa 옛 띠) | 21.59 | 9.53 | **2.285** | 2.230 | 3.150 |
| 0.18 MPa, 새 무게 | 22.08 | 9.74 | 2.234 | 2.180 | 3.079 |
| **0.19 MPa(새 설정)** | 22.94 | 10.12 | **2.151** | 2.099 | 2.964 |
| 0.20 MPa(레귤레이터 상한) | 23.79 | 10.50 | **2.073** | 2.024 | 2.858 |
| 옛 형상(L 90, 면 1,506.6, 21.59 N) | 21.59 | 14.33 | 1.354 | — | 2.09 |

- 판정 ①: 2.285(문구의 F_hi), 새 설정에서도 2.151 ≥ 2 → **만족**. 기준 대비 +3.7~+14 %로 ±10 % 안에 걸친다 → E-18로는 FEA 확인 대상이나 환경 없음(RX-10-F5).
- 옛 미달 U6S-D6(1.35)·U6S-D8(레귤레이터 최대 평균 1.94)은 이 형상에서 2.073 이상으로 없어진다.

### 1-2. 실제 분포 — 로드 자리 편심 + 가로 편심 (강체 판, 기울기 자유)

압력 중심 = 로드 자리 − μ·20.5(끌림, +Y 이송). 가로(X)는 로드 X 편심 +0.5, 안내 마찰(벽 X −81 선), 무게 중심(X −75)의 합.

| 경우 | F N | e_y mm | e_x mm | SF(Y만, 설계 표) | SF(Y + X) | 필요 기울기 rad(k 0.05 / 0.02) |
|---|---|---|---|---|---|---|
| 0.19 정지 | 21.10 | 8.65 | 0.0 | 2.246 | 2.243(100 kPa 한도로는 7.48) | 0.0014 / 0.0034 |
| 0.19 끌림 μ 0.2 | 21.98 | 4.55 | −0.50 | 2.518 | 2.229 | 0.0007 / 0.0019 |
| 0.19 끌림 μ 0.3 | 22.45 | 2.50 | −0.75 | 2.691 | 2.221 | 0.0004 / 0.0010 |
| 0.19 끌림 μ 0.4 | 22.94 | 0.45 | −1.00 | 2.899 | **2.213** | 0.0001 / 0.0002 |
| 0.20 끌림 μ 0.4 | 23.79 | 0.45 | −0.99 | 2.795 | **2.142** | — |

- 최저 2.14 ≥ 2. 설계 표(Y만 2.41~2.90)보다 낮은 것은 가로 편심(안내 마찰이 벽 선에 걸림) 때문이다.
- 가정 확인(4-0): 필요한 앞뒤 기울기 ≤ 0.0035 rad → 로드 끝 옆 이동 0.07 mm ≤ 틈 0.15 mm(칼라 ±0.05 + 부시 0.006 rad × 16.5). 운전 중에는 로드에 굽힘이 안 걸린다.

### 1-3. 곡선 구간 가로 끌림 (상한 검토, 0.19 MPa · μ 0.4) — 디테일 RX-10-F2

슈를 누른 채 매트가 바늘 둘레로 돌면 끌림에 X 성분이 생긴다. 가로 기울기는 칼라 축 틈 0.1(벽 2.0 / 축 2.1) ÷ 턱 Ø12 = 0.0083 rad에서 막히므로 가장자리 압력 더하기는 k × 0.0083 × 9.5까지다.

| 끌림 방향 | k 0.05 (더하기 3.96 kPa) | k 0.02 (1.58 kPa) |
|---|---|---|
| 0°(직선) | 2.899 | 2.899 |
| 45°(곡선 반경이 슈 거리 175 안팎) | **1.932** | 2.281 |
| 90°(순수 가로) | **1.623** | 1.863 |

- 지금 시험 매트(모서리 R 0)는 피벗 전에 슈를 들기 때문에(U6S-Q1) 이 경우가 없다. 실제 매트가 완만한 곡선을 누른 채 박을 때의 값이다(D-01~D-03). 옛 형상(L 90)도 같은 항이 있었고 값은 더 낮다. 기록만.

## 2. 누름 띠·잡음 비·레귤레이터·들기 (완료 판정 ④)

움직이는 무게 1.010 → **1.470 N**(슈 92.883 → 139.782 g). 잡음 필요 힘 3·EI·δ/a³ × 0.130 = **9.36 N**(D-164 임시).

| P MPa | F_lo N | F_hi N | 잡음 비 | 자국 SF(같은 식) | 자국 SF(L 평탄) | 직선 끌림 N |
|---|---|---|---|---|---|---|
| 0.18(옛 설정) | 9.13 | 22.08 | 0.975 | 2.234 | 2.180 | 8.83 |
| 0.184 | 9.42 | 22.43 | 1.006 | 2.200 | 2.147 | 8.97 |
| **0.19** | 9.85 | 22.94 | **1.052** | **2.151** | 2.099 | 9.18 |
| 0.195 | 10.21 | 23.36 | 1.090 | 2.111 | 2.061 | 9.35 |
| 0.20(상한) | 10.56 | 23.79 | 1.129 | 2.073 | 2.024 | 9.52 |

- 창: 잡음 비 ≥ 1 최저 0.1832 ~ 자국 SF ≥ 2 최고 0.2102(L 평탄 0.2032) → IR1000-01BG 상한 0.20이 먼저. **0.184~0.200, 설정 0.19** — 모델링부·검도 값과 같다. 판정 ④ **만족**.
- 들기 0.5 MPa 32.98 N: SF 5.34(무게 + 패킹), 안내 마찰까지 4.12(옛 5.76 · 4.43).
- 직선 끌림 ÷ U4 견인 0.54 → 0.574.
- 기록(RX-10-F3): 설정에서 창 아래 끝까지 6.8 kPa(3.6 %), 위는 레귤레이터 상한까지 10 kPa. 잡음 비 1.2(U6S 때 기준)는 0.2094 MPa가 필요해 이 레귤레이터로는 못 낸다(이 과제 기준은 ≥ 1).

## 3. 바뀐 하중 부품 (옛 모델 — 힘이 로드 선으로)

### 3-0. 가정 확인

| 확인 | 값 |
|---|---|
| 슈 세로 보 처짐(단면 I 23,918 mm⁴, 긴 쪽 68.3) | 0.00012 mm |
| 바닥 판 가로 외팔 처짐(팔 22) | 0.0024 mm |
| 파일 눌림(k 0.05, 0.20 MPa) | 0.21 mm → 처짐 ≪ 눌림, 강체 판 맞음 |

### 3-1. `P_M06_PCYL_BRKT` 판 (SUS304 t3, 외팔 13, 유효 폭 28, 굽힘 계수 1.3)

축 ~ 판 −Y 끝 18.5 ≥ 반쪽 14 → 유효 폭 그대로.

| 경우 | F N | σ MPa | SF | 기준 |
|---|---|---|---|---|
| 운전 들기 0.5 MPa | 37.4 | 15.0 | 13.62 | 3 |
| 운전 누름 멈춤 0.20 MPa | 20.1 | 8.1 | 25.32 | 3 |
| 오조작 레귤레이터 우회 | 43.7 | 17.6 | 11.66 | 2 |
| 오조작 손 100 N | 104.4 | 42.0 | **4.88** | 2 |

- note(과사양 아님, 지배 4.88 < 6): t2로 줄이면 오조작 2.17(U6S 때와 같음).

### 3-2. 벽 볼트 `CB5-12_M06_3` ×2 → MBIS5 인서트 (Y −177 · −128, Z 86, 축에서 11 : 38, 벽면 ~ 축 팔 14)

| 경우 | 인장 합 N(위 / 아래 지렛대) | 인서트 뽑힘 SF(임시 1,000 N, 가까운 볼트가 다 받음) | 가까운 볼트 전단 N | PET-CF 받음 SF |
|---|---|---|---|---|
| 운전 들기 | 57.7 / 39.5 | 17.3 | 25.6 | 122 |
| 오조작 손 100 N | 175.0 / 119.7 | **5.71** | 77.6 | 40.2 |
| 오조작 우회 | 68.7 / 47.0 | 14.6 | 30.5 | 102 |

- 벽 굽힘(볼트 사이 단순보, 손 100 N): 853 N·mm, 9.1 MPa, SF 22.6.
- `P_M06_CARR`: 인서트 구멍 Ø6.8(Y −177) ~ 캐리지 −Y 끝 살 **4.6 mm**(STEP). 다리 단면·C턱은 그대로(M06 값). 인서트 뽑힘 1,000 N은 임시값 그대로.

### 3-3. `P_M06_SHOE` 윗날개 탭 (t2, 벽 안쪽 면 X −80 → 로드 X −68 팔 12, 유효 폭 31)

| 경우 | F N | SF | 기준 |
|---|---|---|---|
| 운전 들기 | 33.0 | 8.23 | 3 |
| 운전 누름 F_hi 0.20 MPa | 23.8 | 11.42 | 3 |
| 오조작 우회 | 39.3 | 6.92 | 2 |
| 오조작 손 100 N(로드 선) | 100 | **2.72** | 2 |

- 입술 모서리 판 굽힘(M06-D4, SF 1.82): 벽 끝 밖 내밈 10이 그대로라 값도 그대로(전부터 있던 디테일).

## 4. 오조작 — 슈 끝에 손 힘 (RX-10-F1, 동작)

받침: 칼라 2개(Y −135 · −175, 같은 Z 32.5)는 Y만 잡고 앞뒤 기울기는 놓아준다. 로드 Ø4(끝 M4)는 너트 2개로 윗날개에 꽉 물려 있어, 슈가 θ 기울면 로드 끝이 **각 θ + 옆 이동 25.2·θ**(너트 윗면이 칼라 선 위 25.2)를 강제로 받는다.

| 값 | 수치 |
|---|---|
| 로드 굽힘 한도(SUS304 205 가정) | Ø4: 항복 1,288 · 소성 2,187 N·mm / M4 골 Ø3.14: 624 · 1,059 N·mm |
| 들림 자세(내민 길이 11.6): 버팀 모멘트(칼라 선 둘레) | 첫 항복 3,633 N·mm(틈 뒤 0.0003 rad) · 소성 붕괴 8,109 N·mm(옆힘 280 N) |
| 누름 자세(내민 길이 16.5) | 첫 항복 2,612 · 붕괴 5,052 N·mm |
| 끝을 눌러 평탄 끝이 매트에 닿는 기울기 | 0.0705 rad → 로드 끝 옆 이동 1.78 mm(틈 0.12) |
| 끝을 들어 −Y 칼라 장공 아래 끝(틈 0.6)에 닿는 기울기 | 0.0667 rad |

| 자세 · 방향 | 팔 mm | 첫 항복 손 힘 N | 붕괴 손 힘 N | SF 붕괴(손 100 N) | 옛 형상(로드 −152, 끝 −205) 붕괴 N |
|---|---|---|---|---|---|
| 들림 · 끝 들기 | 79 | 46.0 | 102.6 | **1.03** | 153.0(팔 53) |
| 들림 · 끝 누르기(+Y 칼라 둘레, 공기 붙듦 8.9 N 포함) | 110 | 41.9 | 82.6 | **0.83** | 123.5(팔 70) |
| 누름 · 끝 들기 | 79 | 33.1 | 63.9 | **0.64** | 95.3 |

- 판정: 붕괴 기준으로도 SF 0.64~1.03 < 1.2, 첫 항복은 0.33~0.46 → 손 100 N(D-79 임시)에서 로드가 영구히 굽는다. 굽은 로드는 패킹 마찰 띠(±4.71 N)를 키워 누름 띠(자국·잡음 창 16.8 kPa)를 깬다. 손 힘을 50 N으로 봐도 붕괴 SF 1.3~2.1, 첫 항복 0.66~0.92.
- 옛 형상은 들림 자세 1.23~1.53(누름 자세 0.95)이었다. 이 과제가 팔을 53 → 79, 70 → 110으로 늘려 약 1/3 내려갔다.
- 가정: 부시를 고정단으로 봄(주변 강체) — 탄성 기울기는 실제보다 작게 나오지만 붕괴 힘(소성 힌지 2개)은 주변 강성과 무관하다. 가공 경화는 넣지 않았다(실제 붕괴 힘은 더 높을 수 있으나 첫 항복 뒤 영구 굽음은 남는다). 로드 재질·허용 옆하중은 SMC 카탈로그 미확인.
- 이음만 풀어서는(뜬 이음) 끝 들기가 안 풀린다: 로드(후퇴 끝) ↔ −Y 칼라 팔이 9 mm(Y −166 ↔ −175)라 손 100 N에 칼라 878 N · 로드 축 978 N, 윗날개 탭 SF 0.28. 옛 형상은 팔 23(330 N, 탭 0.82).

## 5. 문제·고칠 것

| id | kind | 무엇 | 어디 | 근거 | 고치는 법 |
|---|---|---|---|---|---|
| RX-10-F1 | 동작 | 오조작 손 100 N을 슈 끝에 걸면 누름 실린더 로드 Ø4가 영구히 굽음 | `CJ2B10-15Z_M06P_ROD` ↔ `P_M06_SHOE` 윗날개(너트 2개 꽉 물림, 로드 Y −166), 슈 끝 Y −245 | 붕괴 손 힘 63.9~102.6 N(SF 0.64~1.03 < 1.2), 첫 항복 33.1~46.0 N. 옛 형상 95.3~153.0 N. `mech_RX-10_handcalc.json` `misuse_rod` | ① 로드–윗날개 이음을 Z 힘만 전하게(윗날개 구멍 Ø6 → Y 장공 ±1.8 이상 + 너트 축 틈 합 ≥ 0.5, 또는 핀 + Y 장공) — 로드 굽힘 없앰 ② 끝 들기 짝힘 팔 9 mm를 같이 풀 것: 슈 −Y 쪽 위 멈춤(로드에서 팔 ≥ 60, 틈 0.5)이나 +Y 끝이 먼저 받치는 배치 — 탭이 받는 힘 ≤ 136 N(SF 2)이 목표. 고친 뒤 4절 표를 다시 셈 |
| RX-10-F2 | 디테일 | 곡선 구간 가로 끌림에서 자국 SF 1.62~1.93(k 0.05), 1.86~2.28(k 0.02) | `P_M06_SHOE` 바닥 가장자리, 칼라 축 틈 0.1 | 1-3 표 | 요구서 7절 시제품 확인. 필요하면 칼라 축 길이 2.1 → 2.05(가로 기울기 상한 절반) |
| RX-10-F3 | 디테일 | 잡음 비 1.052, 설정에서 창 아래 끝까지 6.8 kPa(3.6 %) | IR1000-01BG :3(0.19 MPa) | 2절 표. 잡음 비 1.2는 0.2094 MPa(레귤레이터 범위 밖) | 게이지 급수 확인, 설정 잠금·표시. F_need 9.36 N은 D-164 임시 — 시제품에서 잼 |
| RX-10-F4 | 디테일 | 들림 자세에서 매달린 슈 무게가 로드에 15.2 N·mm(옆힘 어림 0.61 N, 옛 4.2 N·mm) | 로드 Y −166 ↔ 슈 무게 중심 Y −177.1 | `hang`. CJ2B10 허용 옆하중 미확인(M-06) | F1 ①을 하면 없어짐. 카탈로그 값을 자료대기에 |
| RX-10-F5 (외부) | 디테일 | FEA 못 함 — 환경 없음(D-16). 자국 SF가 기준 +3.7~+14 %, 접촉 압력 실제 분포·로드 굽힘은 손계산 | `P_M06_SHOE`·로드 | 엔진 해석 환경 없음 | 환경이 생기면 임시 STEP 3개로 접촉 FEA |

- 과사양: 없음(브래킷 판 지배 SF 4.88, t2면 2.17 — note).
- 예외 요청: 없음.

## 6. 완료 판정 (해석부 몫)

| 항목 | 값 | 판정 |
|---|---|---|
| ① 자국 SF ≥ 2(같은 식, 잰 면) | 2.285(F_hi 21.59) · 2.151(0.19 MPa) · 2.073(0.20 MPa) | 만족 |
| ④ 들기 힘·잡음 비 ≥ 1·IR1000 :3 | 들기 SF 5.34 · 잡음 비 1.052 · 설정 0.19(창 0.184~0.200) | 만족 |
| ②③⑤ | 검도 값 그대로(X 폭 23.0, 자세 점 간섭 0, E32 3.606) | 검도 몫 |
| ⑥ BOM | 문서 담당 몫 | — |

- completion_met true(해석부가 보는 ①·④). pass false(동작 RX-10-F1).
- 등급 S는 맞다(새 구매품·조인트 변화 없음). 작용점이 옮겨져 E-18 강도 조건에 걸리지만 환경이 없어 손계산으로 했다.

## 7. 기록

- 임시값: 자국 허용 30 kPa · μs 0.2~0.4 · μg 0.2 · 패킹 띠 4.71 N(D-165), 파일 강성 0.02~0.05 N/mm³(D-145), 잡음 필요 힘(D-164), 손 100 N(D-79), 인서트 뽑힘 1,000 N, 로드 SUS304 205 · 부시 틈 0.006 rad(U6S 값).
- 요구서 7절에 올릴 것: 슈 자국(직선·곡선 끌림), 잡음 필요 힘 실측.
- 파일: `fea/cases/mech_RX-10_handcalc.py`, `fea/results/mech_RX-10_handcalc.json`, `fea/models.json`(`*_RX-10` 칸).

## 워크플로우 메모

- U6S 해석이 손 100 N을 로드 선으로만 넣어 입술 모서리 경우(`P_M06_SHOE` load (b))가 받침이 바뀐 뒤 다시 풀리지 않았다. 받침(고정) 칸이 바뀐 부품은 표에 있던 하중 경우를 모두 다시 푸는 확인이 있으면 좋겠다.
- 이 STEP(SolidCraft)은 면 고리를 모두 `FACE_BOUND`로 쓴다(`FACE_OUTER_BOUND` 없음). 면 넓이를 STEP에서 읽을 때 가장 큰 고리를 바깥으로 봤다.
- 걸린 시간 약 21분(등급 S 예상 15분, 2배 안). 해석 환경이 없어 손계산 스크립트를 STEP 읽기부터 새로 짰다.
