hyeunung/FSAP/docs/reports/mechanism/mech_RX-10_model.md

# 구동 RX-10 모델링 — U6 슈 바닥 Y 90 → 130 + 누름 실린더 작용점 맞춤 (모델링부, 2026-11-13~14)

## 요약

- 저장: `3D_Modeling/FSAP_v2.17.2.sc`(v2.17.1에서 마지막 자리 +1 — 컴포넌트 신설·삭제 없음, E-05). `tools/config.json` doc · `tools/machine.json` doc 바꿈. 통로 MCP(앱), 저장 확인만 CLI 1번.
- 고친 것 14바디(새로 0 · 지움 0): 가공품 3(`P_M06_SHOE` · `P_M06_PCYL_BRKT` · `P_M06_CARR`) + 구매품 사본 9(실린더 몸·마운트 너트·로드·로드 너트 2·피팅 2·벽 볼트 1·인서트 1) + 관 2(`TU0604_M08P_U6P_A`·`_B`).
- 슈: bbox X −82~−59 · **Y −245~−115** · Z 17~54.5(REST), 바닥 평탄 면 **2,266.599 mm²**, 부피 17,626.997 mm³, **139.782 g**(SUS304), X 폭 23.0, 전개됨(굽힘 3). 지시 기대값과 모두 일치.
- 실린더 축 Y −152 → **−166**, 포트 +Y(포트 면 Y −160.433). 브래킷 Y −184.5~−122, 벽 볼트·인서트·캐리지 인서트 자리 Y −170 → **−177**. 관 2개 지시 길 그대로.
- 틈(앱, 저장 전): SHIFT −60·−45·−30·−15·0 × PRESS +4.5, SHIFT −60·0 × PRESS −5.0, SHIFT 0 × PRESS −0.4(누름 키) 8자세 — 기계 부품끼리 **겹침 0**, 관은 자기 피팅 말고 3 mm 안 없음. PRESS −5.0(매트 없을 때만 가는 아래 끝)에서만 매트 모형 `MAT_G` 5,465.9 · `TP_G_34a` 1,144.1 mm³(슈 바닥 Z 7.5 < 매트 윗면 10).
- 완료 판정 입력(잰 값으로 같은 식): ① 자국 SF **2.285**(F_hi 21.59 N) ② X 폭 23.0 ④ 0.19 MPa에서 잡음 비 1.052 · 자국 SF 2.151 · 들기 SF 5.34 ⑤ 슈 ↔ E32 3.606(그대로).
- 조인트 587 · 링크 35 · 떠 있는 부품 0 그대로, 타임라인 오류 0 · 경고 53 그대로, `J_U6_PRESS`·`J_U6_SHIFT` 정의·한계·연구 키 그대로.
- 저장본 CLI 확인: 3,224바디 전부 서명 표와 같음(다른 것 0), REST 자세. 서명 14바디·체결 1 고침, `sigcheck` reuse.
- 미완·한계: PRESS 25 % · 75 % 점과 좁은 U홈 매트 전 구간은 재지 않음(4절 — `J_U6_PRESS` 구동 한 번이 이력 742피처를 다시 계산해 약 13분, 구동 후보 RX-06-C3 ②). FEA 못 함 — 환경 없음(D-16).

## 근거 규칙 (원문)

- E-05: "작은 형상 변경은 마지막 자리 +1 … 부품 묶음 신설·삭제는 가운데 자리를 올린다".
- E-15: "저장 전에 바꾼 유닛의 조인트를 전 행정 구동해(자기 점검) 따라 움직인 부품이 그 유닛 부품 전부인지 … 수치로 확인한다".
- E-16: "판정은 수치로만". E-22: "저장 전에 검증부·해석부와 같은 도구, 같은 하중 위치·경계조건으로 바뀐 것만 먼저 본다".
- U-10(지시서 인용): "덧대지 말고 처음부터 한 덩어리로", "메운 구멍 자국" 금지 — 슈는 판금 기능 그대로 바닥 스케치를 늘렸고, 캐리지 인서트 구멍은 피처 자리를 옮겼다.
- 요구서 0-8-2 ②: "노루발·바인더 끝·슈 묶음 폭 < 가장 좁은 홈 폭" — 슈 X 폭 23.0 그대로.
- 실행 규칙 2: "모델링부는 SolidCraft MCP로 그린다 … `save {}`(덮어쓰기)는 쓰지 않는다". 실행 규칙 19: 저장 전 조인트·스케치 표시 숨김.

## 1. 통로·순서·시간

| 항목 | 값 |
|---|---|
| 통로 | MCP(앱 --control 27878). 큰 응답은 `tools/out/mech_RX-10/model/mcp_send.py`(MCP 서버를 표준 입출력으로 띄워 결과를 파일로 받음, RX-11·RX-12와 같은 방법) |
| 문서 확인 | 처음: v2.17.1 열려 있음, dirty false, 피처 3,687 · 바디 876 · 오류 0 · 경고 53. 다시 열지 않음(MCP open 0) |
| 순서 | `edit.checkpoint` → `motion.play REST 0` → 이름 `FSAP_v2.17.2`·설명 → `save {path: v2.17.2}` → config doc → 편집(아래) → 검사 → 임시 STEP → REST·표시 숨김 → `save {path: v2.17.2}` → 서명 고침 → 저장본 CLI 확인 |
| 편집 순서(다시 계산을 한 번으로) | marker를 `EdgeFlange5` 뒤(913)로 내림(0.5 s) → 슈 스케치·입술 변 → marker를 `BodyTransfer398` 뒤(2970)로 올림(약 12분) → 로드 구멍·브래킷·캐리지·관·occurrence 옮김(각 0.5~2.7 s) → marker 끝으로(약 13분) |
| 앱 막힘 | 다른 연결 막힘 없음, 재시작 0. 이 부서 요청이 MCP 응답 한도를 넘긴 것 7번(이력 다시 계산) — `running`으로 끝을 기다림: 첫 시험 편집 약 10분, marker 올리기 2번(약 12분·13분), `joint.drive J_U6_PRESS` 4번(−5.0 · +4.5 · −0.4 · +4.5, 약 13 · 13 · 14 · 9분) |
| 걸린 시간 | 약 115분(예산 180분). 그 가운데 이력 다시 계산 기다림 약 75분 |

## 2. 고친 것 (전 → 후, REST 월드 좌표 mm)

REST = J_U6_SHIFT −60 · J_U6_PRESS +4.5 · J_U7_HGT 0. 작동 자세(SHIFT 0)는 X +60. 피처·2D 스케치 좌표는 U6_SHOE 안 좌표(= 월드 X + 60).

| 대상 | 한 것 | 전 → 후 |
|---|---|---|
| `P_M06_SHOE`(U6_PRESS, SUS304 t2 판금) | `SK_M06_SHOE` 점 `l1.start`·`l1.end` Y −195 → −235(스케치 좌표, 평탄 X −22~1 그대로). 벽 `EdgeFlange4`·윗날개 `U6S_SHOE_TOP`은 그대로 따라 늘어남. 입술 `EdgeFlange5`도 따라왔고 집는 점을 (−9, −195, 14.5) → (−9, −235, 14.5)로 맞춤. 로드 구멍 `Cylinder789` base (−8, −152, 46.5) → (−8, −166, 46.5). 장공 스케치 2개는 안 건드림 | bbox Y −205~−115 → **−245~−115**, 부피 11,712.865 → **17,626.997**, 92.883 → **139.782 g**, 면 40 |
| `P_M06_PCYL_BRKT`(U6_SHOE, SUS304 t3 판금) | `SK_M06_PCYL_BRKT` 점 `p1`·`p2` Y −176 → −184.5, `Cylinder800` base (−8, −152, 74) → (−8, −166, 74), `SK_M06_PCYL_BRKT_H` `c1` 중심 (−170, 86) → (−177, 86) | bbox Y −176~−122 → **−184.5~−122**, 부피 5,643.657 → **6,581.238**, 44.754 → **52.189 g** |
| `P_M06_CARR`(U6_SHOE, PET-CF) | `Cylinder801`(Ø6.8 × 8) base (−30, −170, 86) → (−30, −177, 86), `Cylinder1179`(Ø5.2 × 3) base (−33, −170, 86) → (−33, −177, 86) — 구멍 피처 자리 이동(옛 구멍 없음) | bbox·부피 190,110.727 · 256.649 g 그대로(자리만 바뀜) |
| `CJ2B10-15Z_M06P` 몸 + `_NUT_MNT` | `occurrence.move` 96789: Z축 180°, 원점 (−68, −159) | 몸 Y −158~−146 → **−172~−160**(X −74~−62 · Z 69.3~138.3), 너트 Y −172.351~−159.649 · Z 70.3~74.3. 포트 면 Y −160.433(+Y 쪽), 포트 Z 85.3 · 133.3 |
| `_ROD` + `_NUT_ROD` ×2(U6_PRESS) | `occurrence.move` 96793·96795·96796: Y −14 | 로드 X −73~−63 · Y −171~−161 · Z 49.3~109.8, 너트 Y −170.041~−161.959 · Z 54.5~57.7 / 49.3~52.5 |
| `KQ2L06-M5A_M06` :2(출구 +Z) | `occurrence.move` 96811: Z축 180°, 원점 (−68, −159) | X −73.2~−62.8 · **Y −163~−141.3** · Z 81.159~99.7, 출구 (−68, −146.5, 99.7) |
| `KQ2L06-M5A_M06` :3(출구 +X) | `occurrence.move` 96812: X축 180°, 원점 (Y −159, Z 135.2) | X −72.041~−53.5 · **Y −163~−141.3** · Z 130~140.4, 출구 (−53.5, −146.5, 135.2) |
| `CB5-12_M06_3` :2 · `MBIS5-6.5-8_M06_1` :2 | `occurrence.move` 96805·96807: Y −7 | 볼트 X −91~−74 · Y −181.25~−172.75 · Z 81.75~90.25, 인서트 X −90~−82 · Y −180.4~−173.6 · Z 82.6~89.4 |
| `TU0604_M08P_U6P_A` | 스케치 `w1` 지우고 호(중심 (6.5, −161.5, 135.2), 90°) + 곧은 선 (21.5, −161.5) → (21.5, −186.5) 그림, `Pipe105` path = [새 2, w2~w5] | bbox X −100.127~−35.5 · Y −204.504~**−143.5** · Z 132.2~218.0, 부피 4,718.167 → 5,422.977 |
| `TU0604_M08P_U6P_B` | 스케치 `w1~w7` 지우고 지시 길 8구간(곧은 선 4 + 호 4, R 15) 그림, `Pipe106` path = 새 8 | bbox X −100.104~−49.999 · Y −189.001~**−143.498** · Z 99.7~218.0, 부피 4,114.772 → 5,313.49 |

- 관 스케치로 읽은 호: A 새 호 반지름 15.000, B 호 1 반지름 15.000 · 90.000°, 호 2 14.9997 · 45.001°, 호 3·4 15.000 · 90.000°. 끝점 A (−40, −201.5, 215) · B (−40, −186, 215)(스케치 좌표) 그대로.
- 컴포넌트 691개 그대로(신설·삭제 0), 바디 876 그대로, BOM 수량 변화 0(`CJ2B10-15Z` 3 · `KQ2L06-M5A` 24 · `MBIS5-6.5-8` 19 그대로).
- 생성기: `tools/gen_rx10.py` → `tools/out/mech_RX-10/edit.json`(명령 53개).

## 3. 검증 수치 (모델에서 읽은 값)

| 확인 | 값 | 판정 |
|---|---|---|
| 슈 바닥 평탄 면(법선 −Z, Z 17) | 2,266.599 mm²(중심 Y −174.647) — 지시 2,266.6 ± 1 | 맞음 |
| 슈 벽·윗날개 길이 | 벽 끝면 Y −235 · −115, 윗날개 끝면 Y −235 · −115, 입술 Y −245~−234.295(20°) | 맞음 |
| 슈 장공 | 원통면 축 Y −135 · −175(반지름 3.55), 안 움직임 | 맞음 |
| 슈 로드 구멍 Ø6 | 축 (−68, −166) | 맞음 |
| 슈 전개 `sheet.flat_pattern` | 굽힘 3(벽 90° 길이 119.295, 입술 20° 길이 19.0, 윗날개 90°), 규칙 SUS304_t2 | 전개됨 |
| 브래킷 구멍 | Ø8.5 축 (−68, −166), Ø5.5 (Y −177, Z 86) · (Y −128, Z 86), 굽힘 R 안 3 축 (X −76, Z 80.3) | 맞음 |
| 브래킷 전개 | 굽힘 1(90°, 길이 62.5), 규칙 SUS304_t3 | 전개됨 |
| 캐리지 인서트 자리 | Ø6.8 축 (Y −177, Z 86) · (Y −128, Z 86), Ø5.2 같은 축. Y −170 구멍 없음(빈 구멍 0) | 맞음 |
| 볼트·인서트 동축 | 볼트·인서트 중심 (Y −177, Z 86) = 브래킷 구멍 = 캐리지 자리 | 맞음 |
| 재질(E-09) | 슈·브래킷 SUS304, 캐리지 PET-CF(BOM과 같음). `matcheck`: 이 과제 부품 불일치 0(남은 2건은 전부터 있던 바퀴 트레드 표기 `Urethane_A70` ↔ '우레탄 A70') | 맞음 |
| 타임라인 | 피처 3,687, 오류 0, 경고 53(전과 같음), 스케치 풀림 정상 | 맞음 |

## 4. 간섭·틈 (앱, `inspect.clearance` clearance 3)

대상 = 바뀐 14바디, against = `neighbors.json` 67 + `P_M06_BASE` · `P_REG02_HGT_PLATE` · `STEP대기_867-392342_UPPER` · U7C 관 4개 + 바뀐 14바디끼리(77) + 좁은 U홈 매트 모형 `MAT_G` · `TP_G_33a·34a·35a`. 원본 `tools/out/mech_RX-10/model/r20_static.json` · `r22_poses.json` · `r24_poses.json` · `r34_pressed.json`.

| 자세(SHIFT, PRESS) | 잰 쌍 | 겹침 | 새로 가까워진 쌍(REST와 다른 것) |
|---|---|---|---|
| −60, +4.5 (REST) | 72 | 0 | — |
| −45 · −30 · −15, +4.5 | 73 · 75 · 79 | 0 | — |
| 0, +4.5 | 95 | 0 | `P_M05_GUIDE` ↔ `P_M06_CARR` 2.0(캐리지 겉은 안 바뀜 — 전부터 있던 틈) |
| 0, −0.4 (누름 키) | 98 | 0 | 슈 ↔ `TP_G_34a` 1.1, 슈 ↔ `MAT_G` 2.1(누름 자세의 뜻한 틈), 위와 같은 2.0 |
| −60, −5.0 | 74 | 매트 모형 1: `MAT_G` 5,465.9 mm³ | — |
| 0, −5.0 | 99 | 매트 모형 2: `MAT_G` 5,465.9 · `TP_G_34a` 1,144.1 mm³ | 위와 같은 2.0 |

- PRESS −5.0의 겹침은 매트 모형뿐이다(슈 바닥 Z 7.5 < 매트 윗면 Z 10 · 테이프 윗면 Z 11). `machine.json` J_U6_PRESS: "−5.0 = 칼라가 장공 윗끝(매트 없을 때만)", 실제 접촉 −2.5 · 모형 누름 키 −0.4. 기계 부품과는 겹침 0.
- 계산 못 한 쌍 6(모든 자세 같음, 뜻한 나사 물림·동축 끼움): 로드 ↔ 로드 너트 2, 벽 볼트 ↔ 인서트, 피팅 2 ↔ 실린더 포트, 실린더 ↔ 마운트 너트("boolean Intersect … no result").
- 뜻한 맞닿음(0.0): 브래킷 ↔ 캐리지 면, 브래킷 ↔ 볼트 머리·인서트·실린더 어깨·마운트 너트, 로드 ↔ 실린더, 관 ↔ 자기 피팅.
- 관 A·B: 자기 피팅 말고 3 mm 안 쌍 없음(8자세 모두) — 새 실린더 몸, `P_M05_CYL_BRKT`, `P_M06_BASE` 가로 날개, U7C 관 4개와 모두 3 이상.
- 가까운 쌍(값이 자세마다 같음): 벽 볼트 :2 ↔ 새 실린더 몸 2.371, 슈 ↔ 로드 1.0(Ø4 로드 ↔ Ø6 구멍), 슈 ↔ 로드 너트 0.03, 슈 ↔ 칼라 0.05, 슈 ↔ `CB5-12_M06_3·_4` 머리 1.05, 슈 ↔ `MBIS5` 0.335, 브래킷 ↔ 로드 2.25.
- 슈 ↔ `E32-D36P1_2M_M06`: 3.606(PRESS +4.5), 3.905(−0.4) — 슈 +Y 끝 Y −115 그대로라 가림 변화 없음.
- 볼트 검사(옮긴 `CB5-12_M06_3` :2): 머리 윗면 X −74에서 +X로 Ø8.5 × 30 프로브 — 겹침 0, 가장 가까운 것 새 실린더 몸 **0.75**. 프로브는 지움(바디 876 그대로).
- 숨김(E-11): 숨긴 바디 98개(다른 매트·테이프 모형, 전과 같음). `inspect.clearance`는 숨긴 `MAT_G`도 쟀다.

**재지 않은 것:** ① `J_U6_PRESS` 25 %(−2.625)·75 %(+2.125) 점 — 앱에서 이 조인트를 한 번 몰 때마다 `U6S_SHOE_SLOT`부터 뒤 742피처가 다시 계산돼 약 13분 걸린다(요구서 5절 구동 후보 RX-06-C3 ② "U6_SHOE 피처가 U6_PRESS 바디를 고쳐 J_U6_PRESS 구동 한 번 395·460 s"). `joint.sweep J_U6_PRESS`는 "motion exceeds contact sweep collision budget"으로 거부됐다(간격 2.375 · 0.25 · 기본값 모두). 그래서 0 %(−5.0) · 약 50 %(−0.4) · 100 %(+4.5) 세 점만 쟀다. ② 좁은 U홈 매트 전 구간(연구 CYCLE_G1·G2)은 지시 6-1대로 돌리지 않았다(검도·라운드 끝 회귀).

## 5. 조인트 자기 점검·묶음

| 확인 | 값 |
|---|---|
| `joint.inspect J_U6_PRESS` | a(U6_SHOE)·b(U6_PRESS) 모두 resolves true, errors 0, 한계 −5.0~+4.5, 값 +4.5. 원점은 점 스냅 (−8, −152, 69.3)이라 실린더를 옮겨도 안 바뀜(지시: 정의 그대로) |
| PRESS +4.5 → −5.0에서 따라 움직인 것 | 슈·로드·로드 너트 2개(Z −9.5: 슈 Z 17~54.5 → 7.5~45.0, 로드 49.3~109.8 → 39.8~100.3). 실린더 몸·마운트 너트·피팅·관·볼트·인서트·브래킷은 Z 그대로 |
| SHIFT −60 → 0에서 따라 움직인 것 | U6_SHOE 27바디 + U6_PRESS 4바디 모두 X +60(예: 실린더 X −74~−62 → −14~−2, 슈 −82~−59 → −22~1) |
| `joint.list` | 조인트 587 · 링크 35 · floating 0 · errors 0 — 편집 전과 한 줄도 다르지 않음 |
| 묶음 | 옮긴 구매품은 전과 같은 부모(실린더·피팅·볼트·인서트·관 = U6_SHOE 아래, 로드·로드 너트 = U6_PRESS 아래). 새 조인트 0 |
| 끝 자세 | `motion.play REST 0` moved false, SHIFT −60 · PRESS +4.5 · HGT 0 |

## 6. 완료 판정 입력 (잰 값으로 같은 식, `tools/out/mech_RX-10/model/handcalc_model.py`)

식은 설계 `handcalc_design.py`와 같다(자국 = 30 kPa ÷ (F ÷ A × (1 + 6·μ·h ÷ L)), μ 0.4 · h 20.5 · L 130). 넣은 값: 닿는 면 2,266.599 mm², 슈 질량 139.782 g → 움직이는 무게 1.470 N.

| 항목 | 값 | 기준 |
|---|---|---|
| ① 자국 SF(F_hi 21.59 N) | **2.285** | ≥ 2 |
| ② 슈 X 폭 | 23.0(−82~−59) | ≤ 23 |
| ④ 0.18 MPa(지금 설정) | F_lo 9.13 · F_hi 22.08 N, 잡음 비 0.975, 자국 SF 2.234 | 잡음 비 < 1 → 설정 올림 |
| ④ **0.19 MPa(새 설정)** | F_lo 9.85 · F_hi 22.94 N, 잡음 비 **1.052**, 자국 SF **2.151** | 둘 다 만족 |
| ④ 0.184 / 0.20 MPa(창 끝) | 잡음 비 1.006 / 1.129, 자국 SF 2.200 / 2.073 | 창 0.184~0.200 |
| ④ 들기 SF(0.5 MPa 32.99 N) | 5.34 | — |
| ⑤ E32 시야 | 슈 ↔ 센서 3.606 그대로 | 가림 0 |

해석: FEA 못 함 — 환경 없음(D-16). 임시 STEP은 7절.

## 7. 저장·확인·기록

| 항목 | 값 |
|---|---|
| 저장 | `save {path: FSAP_v2.17.2.sc}` 5,671,380 bytes, dirty false, 문서 이름 `FSAP_v2.17.2`, 설명 "RX-10 mechanism: U6 shoe sole Y 90 -> 130 (-Y end), press cylinder axis Y -152 -> -166 turned 180 deg, bracket/insert/tubes follow" |
| 저장 횟수 | 같은 새 번호 파일에 4번(처음 이름 저장, 검사 전 중간 저장, 검사 뒤 저장, 누름 자세 검사 뒤 마지막 저장). 뒤 두 저장본은 sha1이 같다(e6927e24…) |
| 저장본 CLI 확인 | `solidcraft-cli run model/savecheck_probe.json --in FSAP_v2.17.2.sc --results` 1,123 s(앱 다시 계산과 겹침, 열기 약 1,020 s): `inspect.measure` 3,224바디를 서명 표와 대조 — bbox(0.05)·부피(1e-4) 다른 것 0, 서명에 없는 바디 0, 조인트 587 · floating 0, SHIFT −60 · PRESS +4.5 |
| 서명(E-17) | `ledger.py sigpatch --parts model/sig_parts.json --bolts model/sig_bolts.json` → 바뀜 14, 없어짐 0, 전체 3,224. 마지막 저장 뒤 `sigcheck` reuse. `P_M06_CARR`는 bbox·부피가 같아 서명 값은 그대로다(인서트 자리만 옮김) |
| 임시 STEP(E-06 예외) | `tools/out/mech_RX-10/stepout/P_M06_SHOE.step` · `P_M06_PCYL_BRKT.step` · `P_M06_CARR.step`(REST 자세) |
| 스크린샷 | `tools/out/mech_RX-10/rx10_model_v2.17.2.png`(저장만) |
| 다시 실행 기록(E-25) | `tools/out/mech_RX-10/edit.json` · `edit_meta.json`(base v2.17.1 → result v2.17.2). 실제 실행에서는 관 A 스케치에 좌표를 한 번 잘못 넣어 지운 선(w6·w7)이 있어 새 선 id가 w8·w9다. 기록은 깨끗이 다시 돌릴 때의 id(w6·w7)로 적었다 |
| 기계 정의(E-15) | `tools/machine.json`: doc v2.17.2, `J_U6_PRESS._note`(실린더 축 Y −166, IR1000-01BG :3 설정 0.19 MPa · 창 0.184~0.200, 누름 띠 9.85~22.94 N, Q3 압력 창), `_history` 한 줄. 조인트·행정·상태·연구 키는 그대로(`model/patch_machine.py`) |

## 8. 문서 담당에 넘길 값

- BOM 가공품: `P_M06_SHOE` 치수 X −22~1 · Y −245~−115(SHIFT 0 표기) · Z 12.5~50(PRESS 0), 로드 구멍 Ø6 Y −166, 질량 139.8 g / `P_M06_PCYL_BRKT` Y −184.5~−122, Ø8.5 (Y −166) + Ø5.5 ×2(Y −177 · −128), 52.2 g / `P_M06_CARR` 비고 인서트 자리 Y −177 · −128. 구매품 수량 변화 0.
- 설계검토서(제어 순서 제약): U6S-Q1~Q3 그대로, Q3 압력 창 0.167~0.192 → 0.184~0.200, IR1000-01BG(:3) 설정 0.19 MPa.
- `tools/out/bolts.json`: `CB5-12_M06_3` :2 자리 (−19, −177, 86)(SHIFT 0 표기)로 고침.

## 9. 지시와 다른 것·디테일 기록·미완

| 종류 | 내용 |
|---|---|
| 지시와 다른 것 | ① 지시 "바닥 스케치 −Y 변 Y −194.2947 → −234.2947": 실제 `SK_M06_SHOE`는 23 × 80 사각(−195~−115)이고 −194.29는 입술 굽힘이 시작되는 평탄 끝이다. 스케치 변을 −195 → −235로 옮겼고 평탄 끝이 −234.295가 됐다(지시 기대값과 같음) ② 3D 스케치 명령(`sketch.line3d`·`arc3d`)은 월드 좌표를 받는다 — 지시의 스케치 좌표에서 X 60을 빼서 넣었다(읽은 값은 지시와 같음) |
| 디테일(기록만) | ① 벽 볼트 :2 렌치 길(Ø8.5 × 30) ↔ 새 실린더 몸 0.75(겹침 0, 설계 8절과 같음) ② 피팅 :3 나사 축 Z 135.2 ↔ 실린더 머리 쪽 포트 Z 133.3, 어긋남 1.9 — 옮기기 전에도 같았던 것(거울 자리 그대로). 관 A 시작 Z 135.2는 피팅 출구에 맞음 ③ 브래킷 벽 구멍–굽힘선(옛 U6S-D2)은 Z 86을 안 바꿔 그대로 |
| 미완 | PRESS 25 % · 75 % 점 미측정(4절, RX-06-C3 ②와 `joint.sweep` 거부). 좁은 U홈 매트 전 구간은 검도·회귀 몫 |
| 외부 조건 | 없음(새 STEP 0) |

## 워크플로우 메모

1. **`J_U6_PRESS`를 앱에서 한 번 몰 때마다 742피처가 다시 계산된다(이번 4번: 피처 계산 합 801 s, 기다린 시간 약 13 · 13 · 14 · 9분).** 구동 후보 RX-06-C3 ②가 아직 열려 있어, 이 유닛을 고치는 과제의 과제 안 검사(0·25·50·75·100 % 점)는 점마다 13분이다. 검도가 같은 값에 걸린다 — RX-06-C3을 U6_PRESS를 건드리는 과제보다 먼저 두면 좋겠다.
2. **`joint.sweep`이 "motion exceeds contact sweep collision budget"으로 거부됐다**(occurrence 하나 ↔ 둘, 간격을 줄여도 같음). 안내서 '조인트 자기 점검'이 이 명령을 기본으로 적는데, 이 크기 모델에서는 못 쓴다. 대신 쓸 방법(끝값 `joint.drive` + `inspect.clearance`)을 안내서에 적으면 시도를 줄인다.
3. **이력 앞쪽 피처 하나를 고치면 뒤 전체가 다시 계산된다(3,687개 가운데 909번째 → 약 25분).** `timeline.roll_to`로 marker를 내려 고치고 한 번에 올리면 다시 계산이 한 번이다(내리기 0.5 s, marker 뒤 피처 편집은 0.5~2.7 s). 처음에 끝에서 피처 하나(`Cylinder801`)를 시험으로 고쳐 10분을 썼다 — 안내서 'MCP 편집 묶음'에 "여러 피처를 고칠 때는 가장 앞 피처 앞으로 marker를 내리고 고친 뒤 한 번 올린다"를 적으면 좋겠다.
4. **3D 스케치 그리기 명령은 월드 좌표, `sketch.inspect`는 스케치(컴포넌트) 좌표로 답한다.** 움직이는 컴포넌트 안 관 스케치를 대기 자세에서 고칠 때 X 60이 어긋났다(한 번 잘못 그리고 지움). 설계안 지시서가 "스케치 좌표"를 줄 때 넣는 좌표계를 같이 적으면 좋겠다.
5. 과제 등급 S(예상 30분)로 왔지만 바뀐 바디 14 · 이력 다시 계산 기다림 약 75분으로 M~L이었다(설계 보고서 메모와 같은 것, 반복).
