hyeunung/FSAP/docs/reports/mechanism/mech_RX-11_design.md

# 구동 RX-11 설계안 — U5 먼 쪽 바퀴 밑 받침: X축 자유 롤러 2줄 (C-45)

## 요약

- 출발점: R375X 사진(0-8-3 U5·benchmark.md 다-4 "원판 왼쪽 X 긴 홈에 둥근 봉 2줄, 오른쪽 끝은 원판 바로 앞 받침에 물려 끝남"). 고정 띠 묶음 17바디(`P_DC205_STRIP` + `P_DC205_DISC_1~8` + `CB5-12_DC205` ×8)를 걷고 **미스미 파이프 롤러 `RORLM20-6-L200`(Ø20 × 200, 696ZZ ×2 내장) 7개 × 2줄(Y ±11) = 14개**로 바꾼다. 윗면 Z 0.0.
- 받침: 판 긴 홈(폭 46)에 위에서 끼우는 **새들 `P_RX11_SADDLE` ×8**(귀가 판 윗면 Z −8에 얹힘 = 볼과 같은 기준면) + 판 밑 **클램프 `P_RX11_CLAMP` ×8** + **`CB5-20` ×8**(위에서 죔). 롤러 축 `SFJ6-213` ×14는 새들의 위로 열린 홈에 얹는다(롤러는 브래킷을 안 떼고 위로 들어 바꿈, M-02).
- 배치(X): 새들 중심 −1838 … −326(피치 216), 롤러 X −1830 ~ −334, 나눔 틈 16 < 바퀴 접지 폭 25. J_U5_X 0·690·800·1000·1360·1380 모두 트레드 25 전체가 롤러 위.
- 고치는 기존 부품 3개: 판 `P_M04_PANEL_W2`(긴 홈 X −1847 ~ −410 · |Y| ≤ 23), `P_M04_PANEL_E2`(X −410 ~ −317), 가로 형재 `HFS8-4080-560_M04`(X −420 ~ −380 것 하나)의 윗면 통과 홈(|Y| ≤ 24 · Z −23 ~ −12).
- 손계산: 롤러 처짐 0.0055 mm(46.54 N)·0.0154 mm(130 N), 받침 합 0.031 ~ 0.059 mm ≤ 0.1. 696ZZ 정적 SF 14.4(130 N 5.15, 기준 3·2). 매트 없이 내린 바퀴는 롤러와 0.86 떨어져 멈춘다(130 N이 롤러에 실리지 않는다).
- 시간 키(띠 항 없음, 롤러 항 넣음): L 모서리 7.5 → **4.5 s**(SF 1.228), G2 4.5 → **3.0**(1.262), G1 바닥 1.2 → **0.8 ×9**(1.281), V 입구1 4.4 → **3.0**(1.146)·꼭짓점 2.0 ×4 → **1.5 ×4**(1.175)·1.3 → **1.0**(1.237)·입구2 2.7 → **1.9**(1.148). 사이클 L −12.0 · G2 −6.0 · G1 −3.6 · V −4.5 s.
- 부품 수: +52(롤러 14·축 14·새들 8·클램프 8·볼트 8) −17 = **순 +35**. 구매품 STEP 없음 2종(`RORLM20-6-L200`·`SFJ6-213`) → `STEP대기_` 임시 형상.
- 미완·임시: 롤러 외경 공차·흔들림, 베어링 정격(기억 값), 롤러 구름 저항(0.05 임시), 가격 전부 미확인. 판 살 처짐은 손계산 어림(FEA 못 함 — 환경 없음 D-16). 롤러 위 매트 거동은 7절 기록.

## 근거 규칙 (원문)

- E-02: "개념이 확립되면 과제마다 설계안 1개다 … 벤치마크가 있는 유닛은 0-8-3의 '그대로 가져오는 벤치마크'를 그대로 옮겨 이 기계 치수로 상세 설계". "맞지 않는 치수는 같은 안 안에서 치수·위치를 고쳐 푼다".
- 결정로그 C-45(사용자 2026-11-13 "2줄로가 r375x도 그렇게 되어 있잖아"): "U5 먼 쪽 바퀴 밑 받침을 R375X처럼 롤러 2줄로 바꾼다 … 고정 PTFE 띠 `P_DC205_STRIP`은 걷어 낸다".
- M-02: "소모품(벨트·롤러 등)은 브래킷을 떼지 않고 교체·조정할 수 있어야 한다". M-01: "렌치 접근 — 완성 조립 상태에서 머리 위 축 방향 빈 공간 ≥ 볼트 길이 + 5 mm".
- M-06: "카탈로그 허용치를 확인하고 보고서에 수치로 적는다". M-09: "필요 SF 일반 3, 오조작 하중 2".
- U-12: "볼트는 평범한 육각 렌치 볼트(CB)만 … 지름은 되도록 하나로(M5)". U-11: "매립하는 경우: 머리가 다른 부품·대상·움직이는 부품과 간섭".
- E-10: "형번이 정해졌는데 끝까지 STEP이 없으면 카탈로그 외형도 치수로 임시 형상 … 이름은 `STEP대기_<형번>`". 실행 규칙 10: "STEP을 못 받으면 기다리지 않는다".
- E-18: "손계산의 단면은 가정하지 말고 측정 자료의 최소 단면으로 쓴다". E-16: "판정은 수치로만".

## 1. 구조 (세계 좌표 mm, REST)

단면(Y–Z): 롤러 두 줄 중심 (Y ±11, Z −10), 지름 20 → 윗면 Z 0, 밑 Z −20, 두 롤러 사이 틈 2, 바깥 끝 |Y| 21. U5 바퀴(Ø120, 접지선 Y 0)는 두 롤러 사이 위에 얹힌다(받침선 간격 22).

| 부품 | 수 | 형상·자리 | 재질·만드는 법(잠정) |
|---|---|---|---|
| `STEP대기_RORLM20-6-L200` | 14 | Ø20 × 200 파이프 롤러, 축 X. 줄 Y +11 · −11. X 구간 7개: −1830~−1630 · −1614~−1414 · −1398~−1198 · −1182~−982 · −966~−766 · −750~−550 · −534~−334 | 구매(미스미), 스틸 무전해 니켈 |
| `STEP대기_SFJ6-213` | 14 | Ø6 × 213 곧은 축, 롤러마다 하나. 롤러 양 끝에서 6.5씩 나옴(틈 1 + 새들 홈 5.5) | 구매(미스미) |
| `P_RX11_SADDLE` | 8 | X 두께 14. 위 |Y| ≤ 26.5 · Z −8~−2(귀 밑면 Z −8이 판 윗면에 얹힘), 몸통 |Y| ≤ 22.5 · Z −16~−8. 축 홈 4개(Y ±11, 폭 6.2, 위로 열림, 바닥 R 3.1 중심 Z −9.9 → 바닥 Z −13.0, 양 X면에서 깊이 6, 가운데 벽 2). 가운데 Y 0에 Ø5.5 관통 + 위 카운터보어 Ø9.5 깊이 6. 중심 X −1838 · −1622 · −1406 · −1190 · −974 · −758 · −542 · −326 | A5052, 밀링 |
| `P_RX11_CLAMP` | 8 | 60(Y) × 14(X) × 19(Z −31~−12) 블록, 윗면 가운데 |Y| ≤ 23.5를 깊이 4.5 따 냄(가운데 윗면 Z −16.5, 양 끝 기둥 |Y| 23.5~30이 판 밑면 Z −12에 닿음). 가운데 M5 관통 탭. 새들과 같은 X | A5052, 밀링 |
| `CB5-20`(`CB5-20_RX11`) | 8 | 새들 위에서 아래로(축 −Z), 머리 자리 Z −8(머리 윗면 Z −3), 끝 Z −28, 클램프 탭 물림 11.5 | 구매 |

고치는 기존 부품:

| 부품 | 고침 | 이유 |
|---|---|---|
| `P_M04_PANEL_W2` | 긴 홈 X −1847 ~ −410(판 +X 끝까지 열림) · |Y| ≤ 23, 닫힌 끝 모서리 R 3. Y 0 줄 Ø36 구멍 8개는 홈에 들어가 없어짐 | 롤러 Ø20이 판 두께(Z −12~−8)를 지남. 볼 구멍(Ø36, Y ±50) 가장자리 |Y| 32까지 살 9 |
| `P_M04_PANEL_E2` | 긴 홈 X −410(판 −X 끝) ~ −317 · |Y| ≤ 23, 닫힌 끝 모서리 R 3 | 끝 새들(X −333~−319) 자리. 원판 따냄(중심 −175, R 130)까지 살 12(Y 0) |
| `HFS8-4080-560_M04`(X −420~−380 것 하나) | 윗면 통과 홈: X −420~−380 전체 · |Y| ≤ 24 · Z −23~−12 | 롤러(밑 Z −20)가 형재 윗면 Z −12 위를 지나 X −334까지 간다. J 1380 트레드(X −432.5~−407.5)가 이 형재 위. 다른 두 개(X −305·−85)는 그대로 |

걷어 내는 것: `P_DC205_STRIP` 1 · `P_DC205_DISC_1~8` 8 · `CB5-12_DC205` 8 = 17바디.

구동 방식·행정·순서: 구동 없음(자유 롤러, 모델은 고정 형상). 매트가 Y로 지나가거나 바늘 둘레로 돌 때(U5 자리에서 접선 = Y) 롤러가 축 X로 구른다. 대기/작동 위치 구분 없음. U5 조인트(`J_U5_X` 0~1380, `J_U5_LIFT` −10~30, `J_U5_FLOAT` 0~20)는 그대로.

조립 순서(M-12): ① 판 W2·E2(긴 홈)와 형재(통과 홈)를 놓음 → ② 새들을 위에서 홈에 끼워 귀를 판 윗면에 얹고, 밑에서 클램프를 대고 위에서 `CB5-20`을 건다(클램프가 따라 돌면 기둥 안쪽 면이 새들 몸통에 닿아 멈춤, 틈 1) → ③ 롤러에 축을 꿰어 위에서 새들 홈에 내려놓는다 → ④ 새들 X를 맞춰(롤러 끝 틈 1) 볼트를 죈다(죔 3 N·m). 롤러 교체: 그 롤러만 위로 든다.

왜 이 치수인가(같은 안 안에서 고친 것):

| 고른 것 | 다른 값이 안 되는 이유(수치) |
|---|---|
| 지름 20 | 볼 테 Ø44(Y ±50)가 Z −8~−6에서 |Y| 28부터. Ø30 두 줄은 Z −8에서 바깥 끝 |Y| 29.3(겹침). Ø25는 베어링 내장 금속 롤러 `RORB25`가 L ≤ 100뿐(줄마다 14개). `HROB19`(관 t 1.2)는 L 413에서 처짐 0.122 mm(46.54 N 한 줄)·흔들림 값 없음 |
| 길이 200 × 7 | `RORLM20`의 가장 긴 길이. 통짜 롤러(Ø25 강봉 1,430, 양 끝 받침)는 자중만으로 처짐 약 0.5 mm |
| 두 줄 중심 Y ±11 | 롤러 사이 틈 2(외경 공차·흔들림 몫). 받침선 간격 22 |
| 새들을 판에 얹음 | 볼과 같은 기준면(판 윗면)이라 높이 사슬이 귀 밑면 → 홈 바닥 5.0 → 축 Ø6 → 롤러 Ø20뿐. 나눔 피치 216이 볼 피치 100과 어긋나 판 밑 넓은 귀 볼트는 볼 몸통에 걸림 → 홈 가장자리에 얹고 밑 클램프로 죔(앞 설계 띠 + 누름판 + 밑 볼트와 같은 방식) |
| 새들 중심 X −326 기준 | 클램프가 가로 형재 +X 면(−380)을 넘고, 쓰는 자리 J 800(트레드 −1012.5~−987.5)·J 1000(−812.5~−787.5)이 나눔 틈(−982~−966 · −766~−750)과 5.5·21.5 떨어짐 |

## 2. 상태별 틈 (계산 `tools/out/mech_RX-11/design/rx11design.json`)

| 상태 | 쌍 | 틈 mm | 근거 |
|---|---|---|---|
| 정지 | 롤러(Z −7에서 바깥 |Y| 20.54) ↔ 볼 테 Ø44(|Y| 28) | 7.46 | 계산. 테 자리는 CAD 띠 ↔ 테 3.0(측정) |
| 정지 | 롤러 바깥(|Y| 21) ↔ 판 홈 가장자리(|Y| 23) | 2.0 | 계산 |
| 정지 | 새들 위(|Y| ≤ 26.5) ↔ 볼 테 Ø44 | 1.52(가장 가까운 새들) | 계산, 볼 중심 서명 |
| 정지 | 클램프(|Y| ≤ 30) ↔ 볼 몸통 Ø36(Z −30~−6) | 2.02 | 계산 |
| 정지 | 롤러 밑(Z −20) ↔ 형재 통과 홈 바닥(Z −23) / 벽(|Y| 24) | 3.0 / 3.0 | 계산, 형재 단면은 CAD `body_topology` |
| 정지 | 클램프·볼트(X −333~−319) ↔ 가로 형재 +X 면(−380) / 원판 받침 밑 형재(−305) | 47 / 14 | 서명 |
| 정지 | 새 부품 전부 ↔ 그 밖 3,189바디(서명 bbox) | 겹침 0 | bbox가 겹친 것은 판 2(긴 홈)·형재 1(통과 홈)·볼 12(위 두 줄로 실제 틈 확인)뿐 |
| U5 들림(LIFT 30) | 트레드 밑 Z 40 ↔ 롤러 윗면 Z 0 | 40.0 | 측정 |
| U5 내림 · 매트 10 | 트레드 밑 Z 10 ↔ 롤러 윗면 Z 0 | 10(매트) | 측정 |
| U5 내림 · 매트 없음(LIFT −10, FLOAT 0, 트레드 밑 Z 0.0014) | 트레드 Ø120 ↔ 롤러 Ø20(Y ±11) | **0.86** | √(11² + 70.0014²) − 70 |
| 매트 5장(L·S·G·V·W) | 매트 밑면 Z 0 ↔ 롤러 윗면 Z 0 | 0.0(얹힘) | 높이 사슬 |
| 매트 | 매트 밑면 ↔ 새들 윗면 Z −2 | 2.0 | 계산 |

접지 길(완료 판정 ①): 트레드 폭 25, 나눔 틈 16(새들 14 + 틈 1 × 2). 틈 한가운데에 서도 트레드 밑 롤러 9 mm(양쪽 4.5씩, 두 줄 모두).

| J_U5_X | 트레드 X | 롤러 위 길이 | 가장 가까운 틈 중심까지 |
|---|---|---|---|
| 0 | −1812.5~−1787.5 | 25.0 | 38 |
| 690 | −1122.5~−1097.5 | 25.0 | 80 |
| 800(L) | −1012.5~−987.5 | 25.0 | 26 |
| 1000(G) | −812.5~−787.5 | 25.0 | 42 |
| 1360(V·W) | −452.5~−427.5 | 25.0 | 102 |
| 1380 | −432.5~−407.5 | 25.0 | 94 |

## 3. 손계산 (E-18, FEA 못 함 — 환경 없음 D-16)

| 항목 | 식·단면 | 46.54 N | 130 N(오설정) | 기준 |
|---|---|---|---|---|
| 롤러 처짐 | 스틸 파이프 Ø20/Ø12(I 6,836 mm⁴), 스팬 200, 가운데 하중, 롤러 하나가 다 받음 | 0.0055 mm | 0.0154 mm | ≤ 0.1 |
| 축 처짐 | Ø6, 베어링–새들 홈 팔 5.75 | 0.0002 mm | 0.0006 mm | — |
| 판 살 처짐(어림) | 판 t4 SUS304, 레일 안쪽 면 Y 80 → 귀 받침 Y 24.75(팔 55.25), 유효 폭 50(볼 구멍 뺀 64 %), 한쪽 F/2. 레일 모서리 고정 ~ 단순 받침 | 0.025 ~ 0.053 mm | 0.071 ~ 0.148 mm | — |
| 합 | | 0.031 ~ 0.059 mm | 0.087 ~ 0.164 mm | ≤ 0.1(46.54 N) |
| 베어링 정적 SF | 696ZZ C0r 670 N(임시), 바퀴가 롤러 끝에 서서 베어링 하나가 다 받음 | 14.4 | 5.15 | 3 / 2 (M-09) |
| 베어링 수명 | Cr 1,730 N(임시), P 46.54 | L10 51,364 × 10⁶ 회전 | — | — |
| 축 굽힘 | Ø6 | 12.6 MPa | 35.2 MPa | — |
| 클램프 굽힘 | 볼트 3,000 N(죔 3 N·m), 스팬 53.5, 가운데 단면 (14 − 5) × 14.5 | 127 MPa, 항복 215 대비 1.69 | | 디테일 |
| 새들 귀 | 한쪽 1,500 N, 팔 2.25, 단면 14 × 6 / 받침 3.5 × 14 | 40 MPa / 면압 31 MPa | | 디테일 |

- 130 N은 매트 없이 U5를 끝까지 내렸을 때 바닥을 누르는 힘(결정로그 RX-07-D1 수정 1 "내림 끝 힘 326 → 130 N")이다. 롤러 2줄에서는 그 자세에서 바퀴가 두 롤러 사이 골 위 0.86에 멈춰 닿지 않는다(위 2절). 그래도 롤러·베어링은 130 N으로 계산해 기준을 넘긴다. 판 살 처짐만 130 N에서 0.1을 넘을 수 있으나 그 하중은 실리지 않는다.
- 베어링 SF 14.4는 M-09 과사양 선(필요치 3배 = 9)을 넘지만 `RORLM20`의 가장 작은 축 구멍(d 6, 696ZZ)이라 줄일 형번이 없다.

## 4. 회전 시간 키·SF (완료 판정 ⑤)

식(앞 계산과 같음): have = μ·F4·d₁ + μ·F5·d₂ (μ 0.4, 40 N, d₁ 0.1) / need = 볼 구름 0.02·Rg + 원판 끌림 0.048 + 노루발 끌림 0.096 + (I_매트 + I_원판 0.0217 + **I_롤러**)·4θ/t² + **T_바퀴 밑 롤러** + **T_바퀴 밖 롤러**. 띠 항 μs 0.30·40 N·d₂는 없앴다.

새 항(임시, 자료대기 후보):

| 항 | 값 | 근거 |
|---|---|---|
| I_롤러 | 2 × 0.219 kg × d₂² | 바퀴가 누른 롤러 2개는 매트와 같이 돈다. 롤러 질량 0.322 kg(임시 형상), 둘레 환산 질량 0.219 kg |
| T_바퀴 밑 롤러 | 0.05 × 40 N × d₂ | 바퀴–매트–롤러 구름 저항 계수 0.05(D-145 볼 구름 불리 쪽과 같은 값, 실측 전). 0.10(두 배)에서도 SF ≥ 1이 되게 키를 잡음 |
| T_바퀴 밖 롤러 | 0.18 N × Σ\|x\|(매트가 덮을 수 있는 롤러) | 롤러 하나가 받는 매트 무게 몫 0.36 N × μ 0.5. 롤러가 돌든 미끄러지든 매트에 주는 힘은 이보다 작다(상한) |

키는 max(띠 항을 넣기 전 키, SF 1 최소 시간 × 1.1 올림)로 잡았다 — 띠 전 키보다 빠르게 하지 않으므로 바퀴 둘레 속도·모터·바늘 옆힘은 그 키로 본 범위 안이다.

| 구간(U4+U5) | d₂ | 지금 키 s (SF) | SF 1 최소 s | 새 키 s | SF | 구름 0.10일 때 SF | 지금 키 그대로면 SF |
|---|---|---|---|---|---|---|---|
| CYCLE_L 모서리 90° ×4 | 1.0 | 7.5 (1.009) | 3.66 | **4.5** | 1.228 | 1.077 | 1.721 |
| CYCLE_G2 모서리 90° ×4 | 0.8 | 4.5 (1.037) | 2.45 | **3.0** | 1.262 | 1.107 | 1.784 |
| CYCLE_G1 바닥 12° ×9 | 0.8 | 1.2 (1.047) | 0.66 | **0.8** | 1.281 | 1.121 | 1.926 |
| CYCLE_G1 바닥 3° | 0.8 | 0.6 | 0.33 | 0.6 | 1.926 | 1.586 | 1.926 |
| CYCLE_G1 출구 9.5° ×2 | 0.8 | 1.2 (1.044) | 0.65 | 1.2 | 1.924 | 1.585 | 1.924 |
| CYCLE_V 입구1 75° | 0.44 | 4.4 (1.027) | 2.63 | **3.0** | 1.146 | 1.026 | 1.545 |
| CYCLE_V 꼭짓점 25° ×4 | 0.44 | 2.0 (1.009) | 1.29 | **1.5** | 1.175 | 1.050 | 1.501 |
| CYCLE_V 꼭짓점 10° | 0.44 | 1.3 (1.022) | 0.82 | **1.0** | 1.237 | 1.098 | 1.530 |
| CYCLE_V 입구2 30° | 0.44 | 2.7 (1.015) | 1.66 | **1.9** | 1.148 | 1.028 | 1.517 |
| CYCLE_W 볼록 A·D / B·C / 오목 입구 / 안 모서리(임시) | 0.44 | 4.1 / 4.2 / 2.8 / 1.6 | 2.61 / 2.68 / 1.84 / 1.09 | 그대로 | 1.465 / 1.458 / 1.468 / 1.451 | — | — |

- U4 혼자 키(V 꼭짓점 4.0·5.2, 입구2 12.5, G1 바닥 3.4·4.0 ×5, G1 출구 14.5, S 1.0)는 띠 항이 없던 구간이라 그대로다.
- 사이클: CYCLE_L −12.0 s(FUNC-01 ⑦ 최대 매트 85.0 → 73.0), CYCLE_G2 −6.0, CYCLE_G1 −3.6, CYCLE_V −4.5.
- 한계 값: L 모서리 U4+U5가 성립하는 볼 구름 저항 상한 0.021(띠 μs 0.30) → **0.0415**(띠 없음, 4.5 s).
- CYCLE_W 키는 임시 그대로 두고 SF만 다시 적는다(정식 계산은 구동 후보 RX-12-C4).

## 5. 구매품 (E-10, M-06) — 카탈로그 표 `tools/out/mech_RX-11/catalog.md`

| 형번 | 수 | 판정에 쓴 카탈로그 값 | 출처 | 가격 | STEP | 임시 |
|---|---|---|---|---|---|---|
| `RORLM20-6-L200` | 14 | 외경 20, 길이 200(100·150·200), 축 구멍 6, 내장 B696ZZ ×2(D1 15, B 5), 스틸 무전해 니켈, 파이프 안지름 12, 겉은 무연마 인발. 696ZZ Cr 1,730 · C0r 670 N(기억 값) | us.misumi-ec.com/vona2/detail/110302647520/ (catalog.md 1절·2절) | 미확인 | 없음 | 예(베어링 정격, 외경 공차·흔들림 없음, 한국 형번 표기) |
| `SFJ6-213` | 14 | Ø6 g6, SUJ2 고주파 경화, 길이 지정 | 미스미 리니어 샤프트 계열(catalog.md 2절 — 형번 표기·길이 단위는 구매부 확인) | 미확인 | 없음 | 예 |
| `CB5-20` | 8 | M5 × 20 육각 구멍붙이 볼트 | `purchased-step/CB5-20/CB5-20.stp` | 미확인 | 있음 | 아니오 |

stepcheck 결과(`python -B …/stepcheck.py --project tools …`):

| 형번 | 판정 | 근거 |
|---|---|---|
| RORLM20-6-L200 | 없음 | 같은 계열에 있는 것: 없음 |
| SFJ6-213 | 없음 | 같은 계열에 있는 것: 없음 |
| CB5-20 | 있음 | CB5-20\CB5-20.stp |
| CB5-12 | 있음 | CB5-12\CB5-12.stp |
| CB5-25 · CB5-30 | 없음 | 같은 계열: CB5-12, CB5-16, CB5-20, CB5-6 → 볼트는 CB5-20으로 맞춤 |

부품 수·세트 비용(M-10): 걷는 것 17(가공 띠 1 + 누름판 8 + 볼트 8), 넣는 것 52(구매 36 + 가공 16). 순 +35. 가격은 전부 미확인(롤러 참고: 같은 계열 RORB50-50 미국 표준가 61.24 USD). 가공품은 경질 알루마이트 + PTFE 함침 띠 1,435 mm 1개가 밀링 소형 블록 16개로 바뀐다.

## 6. CAD에서 직접 확인한 것 (읽기만, WF-016·017)

대상 `3D_Modeling/FSAP_v2.16.0.sc`(앱에 열려 있던 것, open 0회, 저장 0회). 처음·끝 `dirty false`, 타임라인 3,712, 바디 880, 파일 sha1 앞 16자 `b570eae7eefc9920`(그대로). 끝에 `motion.play REST 0` moved false.

| 확인 | 결과 |
|---|---|
| 가로 형재 `HFS8-4080-560_M04` 윗면 단면(`body_topology`) | 윗면 Z −12, 홈 입 X −405~−395(폭 10), 홈 턱 밑 Z −17.5, 홈 바닥 Z −24.5, 옆면 X −420 · −380. 통과 홈 바닥 Z −23은 홈 바닥 위 1.5 — 바디 하나로 남는다. 바디 정의 하나를 세 자리(X −420 · −305 · −85, 서명 occurrence :1·:2·:3)가 함께 씀 |
| 판 `P_M04_PANEL_E2` 구멍(`body_topology` 원통) | X −410~−317 · \|Y\| ≤ 23 안에 구멍 없음. 가장 가까운 것: 접시 구멍 (−400, ±50) R 5.2, 볼 구멍 (−350, ±50) R 18, 원판 따냄 (−175, 0) R 130 → 긴 홈 끝(−317)에서 12 |
| 판 E2 ↔ 가로 형재 / 원판(`inspect.clearance`) | 0.0(Z −12에 얹힘) / 5.0 |
| 판 W2 구멍(측정부 `panel_w2_holes.json`) | 긴 홈 구간에 Y 0 줄 Ø36 8개(없어짐), 볼 구멍은 \|Y\| ≥ 32, 접시 구멍은 Y ±100 |
| 새 부품 자리 겹침(서명 bbox 3,189바디, sigcheck reuse) | 판 2·형재 1(고치는 것)·볼 12(실제 틈 1.52·2.02)뿐. 그 밖 0 |
| 새 볼트 렌치 길 | 머리 위 Z −3 → +27(30 mm), Ø8.5: 작업 대상·U5(비킬 수 있음) 빼고 막는 바디 0. 축 안쪽 끝 \|Y\| 8 사이라 롤러를 둔 채 닿는다 |
| 살 두께 | 새들: 카운터보어 Ø9.5 바깥 2.25(X), 축 홈까지 3.15, 축 홈 바깥벽 8.4, 가운데 벽 2. 판: 긴 홈 ~ 볼 구멍 9.0. 형재: 통과 홈 옆 T너트(Y ±41.5)까지 17.5 |
| 높이 사슬 | 판 윗면 Z −8.0(CAD) → 귀 밑면 → 홈 바닥 Z −13.0 → 축 중심 Z −10.0 → 롤러 윗면 Z 0.0. 볼 꼭대기 Z 0.0(측정) |

프로브 바디는 열린 문서에 만들지 않았다(자동 저장 위험, 측정 보고서 1절). 새 부품은 모두 축에 나란한 상자·원통이라 서명 bbox와 원 계산으로 틈을 냈다.

## 7. 규칙 자기 점검

| 규칙 | 판정 | 근거 |
|---|---|---|
| E-03 간섭 | 과제 범위 겹침 0(계산) | 2절. 검도가 CAD로 다시 잼 |
| M-06 허용치 | 통과 | 696ZZ 정적 SF 14.4 · 5.15, 롤러 강도 표는 RORL에 없음(베어링 정격으로 판정) |
| M-01·M-02 | 통과 | 볼트 8개 모두 위에서, 롤러는 위로 들어 교체. 조립 순서로만 풀리는 볼트 없음 |
| U-12 | 통과 | CB M5 한 종(CB5-20). 멈춤 나사·저두 볼트 없음 |
| U-11 | 카운터보어 8곳 — 이유: 머리가 매트(Z 0) 밑으로 내려가야 함 | 머리 윗면 Z −3 |
| U-14 | 해당 없음 | 로봇 부품 없음 |
| M-04·U-10 | 통과 | 새 판금 없음(기존 판에 긴 홈). 덧대기·단차 없음 |
| U-07·E-10 | `STEP대기_` 2종 | 형번이 정해짐, 카탈로그 외형 치수 |
| U-01 | 높이 ±0.1은 밀링 새들 + 볼과 같은 기준면으로 | 롤러 외경 공차가 크면 귀 밑 심(디테일) |
| U-19 | 해당 없음 | 새 형재 없음. 통과 홈은 끝면이 아님 |
| E-14 | 예외 요청 없음 | — |

## 8. 완료 판정

| 항목 | 만족 | 근거 |
|---|---|---|
| ① 전 구간 받침 이어짐 | 예 | J 0·690·1380에서 트레드 25 전체가 롤러 위, 나눔 틈 16 < 25 |
| ② 롤러 윗면 Z 0 ± 0.1 | 예 | 0.0(높이 사슬) |
| ③ 과제 범위 간섭 0 | 예(계산) | 서명 bbox 겹침 0, 바퀴 든 자세 40 · 내린 자세 0.86(매트 없음) |
| ④ 처짐·베어링 | 예 | 롤러 0.0055 / 0.0154 mm, 합 ≤ 0.059 mm(46.54 N), SF 14.4 / 5.15 |
| ⑤ 시간·SF | 예 | 4절, 최저 SF 1.146 |
| ⑥ 잔재 0·BOM·자료대기 | 모델링·문서 단계 | 걷을 17바디·넣을 52개 목록, D-97·D-200 문구는 9절 |

## 9. 자료대기·7절에 넘길 것

- D-200(쓰는 곳): 임시값 — 롤러 Ø20 × 200 × 7개 × 2줄(`RORLM20-6-L200`), 줄 중심 Y ±11, 나눔 틈 16, 696ZZ. 근거 "구매품 치수(볼 테 사이 폭 56, RORL 가장 긴 길이)". R375X 실물 값이 오면 맞춤.
- D-97: 고정 띠는 걷음(C-45). 띠 μ 임시값은 더 쓰지 않는다.
- 새 D 후보: ① STEP 대기 `RORLM20-6-L200` ×14 · `SFJ6-213` ×14(임시 형상 → STEP 수령 뒤 교체) ② 롤러 외경 공차·흔들림(±0.1 높이) ③ 696ZZ 정격(NSK 치수표 확인) ④ 바퀴–매트–롤러 구름 저항 계수(임시 0.05)와 바퀴 밖 롤러 저항(0.18 N) — 저울 시험 ⑤ 가격.
- 요구서 7절(모델로 판정 안 함): 받침선 간격 22에서 바퀴에 눌린 매트가 두 롤러 사이로 들어가는 양과 자국, 롤러 사이 틈 2에 파일·실밥 끼임, 나눔 틈 16을 지날 때 자국, 로딩·배출 때 롤러 축 방향(X) 미끄럼, 롤러 구름 저항 실측.
- 설계검토서 제어 순서 제약(U-09): U4+U5 회전 시간 키 새 값(4절). U5는 매트 위에서만 내린다는 조건은 그대로(매트 없이 내리면 롤러에 닿지 않고 0.86 위에서 멈춘다 — 바닥 접촉 신호로 쓰지 않는다).

## 미완

- 판 살 처짐은 손계산 어림이다(유효 폭 가정). FEA 못 함 — 환경 없음(D-16).
- 클램프 굽힘 SF 1.69(죔 3 N·m 기준), 축 위쪽 빠짐 막이 없음(자중 + 매트), 롤러 끝–새들 면 스침(틈 1, 내륜 받침 턱 없음), 형재 통과 홈 추가 가공 도면 — 디테일로 기록.
- 구매품 가격·한국 형번 표기·STEP 미확인.

## 워크플로우 메모

- 실행 메모의 "최신 v2.13.0"과 실제 대상(`config.json` doc v2.16.0)이 다르다 · 측정 보고서·config로 v2.16.0을 썼다 · 실행마다 바뀌는 메모는 스크립트가 config doc에서 채우면 좋다.
- `inspect_design`(1.3 MB)·`motion.play`(1.4 MB, 모든 occurrence 자세)·`body_topology faces all`(250 KB) 결과가 화면 한도를 넘어 파일로 넘어갔다 · dirty·moved만 보려는 호출 · 안내서에 가벼운 상태 확인 명령을 적으면 좋다(측정부 메모와 같음).
- 설계부 지시 "지시서에 쓰는 볼트는 STEP 있는 것만"과 저장소 볼트 길이(CB5-6·12·16·20)가 맞물려 볼트 길이가 설계를 정했다(CB5-25·30 없음) · 흔한 길이 볼트 STEP을 창고에 미리 채워 두면 좋다.
- 읽기 부서가 새 부품 자리 겹침을 CAD로 재려면 프로브 바디가 필요한데 앱 세션에서는 문서를 바꾸게 된다 · 이번에는 서명 bbox 계산으로 대신 · 안내서 '끼우는 길'의 CLI 방식은 저장본 열기가 길어(10분대) 설계부 예상 시간과 안 맞는다.
