hyeunung/FSAP/docs/reports/mechanism/mech_RX-11_donecheck.md

# 구동 RX-11 완료 판정 확인(원칙 감사) — 설계안 RX-11-S1

## 요약

- 판정: **ok(완료 판정 ①~⑥ 모두 만족, 고칠 자리 없음).** CAD는 쓰지 않았다(서명 `tools/out/signatures.json` v2.16.0과 설계안 수치로 다시 계산).
- ① 접지: J_U5_X 0~1380을 0.1 간격으로 훑어 트레드(폭 25) 밑 롤러 길이 최소 **9.0 mm**(나눔 틈 16 < 25). 0이 되는 자리 없음.
- ② 높이 사슬: 판 윗면 −8.0 → 홈 바닥 −13.0 → 축 중심 −10.0 → 롤러 윗면 **0.0**.
- ③ 자리: X −1850~−315 · |Y| ≤ 31 · Z −32~0.5 안의 바디를 서명 bbox로 다시 뽑음 → 걷을 17바디, 고칠 판 2·형재 1, 볼 bbox, 매트·테이프(Z ≥ 0)뿐. 볼 실제 틈 1.52·2.0 다시 계산해 같음. 바퀴 내림(매트 없음) 0.86 같음.
- ④ 롤러 처짐 0.0055 mm(46.54 N)·0.0154(130 N), 받침 합 0.031~0.059 mm, 696ZZ 정적 SF 14.4·5.15(기준 3·2) — 다시 계산해 같음.
- ⑤ L 모서리 4.5 s SF 1.228, V 입구1 3.0 s SF 1.146을 손으로 다시 계산해 같음. 최저 1.146 ≥ 1.
- ⑥ 걷을 17바디·넣을 52개 목록과 D-97·D-200 문구가 설계안에 있음(실행은 모델링·문서).
- 미완(판정 밖, 기록): 간섭은 계산값이라 검도가 CAD로 다시 잰다. 베어링 정격·롤러 외경 공차·구름 저항 0.05는 임시값.

## 근거 규칙 (원문)

- E-02: "강도 여유·정밀 체인·새 볼트 렌치 접근·판금 규칙은 디테일로 기록만". 디테일은 보지 않았다.
- E-16: "판정은 수치로만". M-06: "카탈로그 허용치를 확인하고 보고서에 수치로 적는다. 허용치를 넘으면 결함이다". M-09: "필요 SF 일반 3, 오조작 하중 2".
- 요구서 5절 RX-11 완료 판정: "U5 행정 전 구간 받침 연속, 매트 3장 + RX-12 매트 전 구간 간섭 0, 롤러 처짐·베어링 하중 손계산(바퀴 누름), DC-02 회전 시간·SF를 띠 미끄럼 항 없이 다시 계산, BOM".

## 항목별 다시 계산

| 항목 | 다시 계산 | 설계안 값 | 판정 |
|---|---|---|---|
| ① 받침 이어짐 | 새들 중심 −326 − 216k, 롤러 7구간 −1830~−334. 트레드 중심 −1800 + J, J 0~1380(0.1 간격 13,801점) 롤러 위 길이 최소 9.0. J 0 트레드 −1812.5~−1787.5(1번 롤러 안), J 1380 −432.5~−407.5(7번 롤러 안) | 최소 9, 끝 자리 25 | 만족 |
| ② 윗면 Z 0 ± 0.1 | −8 − 5.0(홈 바닥) + 3(축 반지름) + 10(롤러 반지름) = 0.0. 볼 bbox 윗면 0.0(서명) | 0.0 | 만족(공칭). 롤러 외경 공차는 자료대기 |
| ③ 간섭 0 | 서명 bbox 구역 조회: 뜻밖의 바디 0. 형재 :1 Z −92~−12(통과 홈 대상), :2·:3은 X −305~−265·−85~−45 · Z −132~−52라 클램프(X ≤ −319, Z ≥ −31)와 14 떨어짐. 볼 (−550, ±50) 테 R 22 ↔ 새들 귀(X −549~−535, \|Y\| 26.5): 50 − √(22² − 1²) − 26.5 = 1.52. 볼 몸통 R 18 ↔ 클램프 \|Y\| 30: 2.0. 바퀴 Ø120 ↔ 롤러 Ø20: √(11² + 70.0014²) − 70 = 0.86. 롤러 ↔ 형재 통과 홈 3.0·3.0, 판 홈 2.0. 축 끝 ↔ 새들 가운데 벽 0.5 | 같음 | 만족(계산) |
| ④ 처짐·베어링 | I = π(20⁴ − 12⁴)/64 = 6,836. δ = 46.54·200³/(48·206,000·6,836) = 0.0055, 130 N 0.0154. 판 살 외팔보 23.27·55.25³/(3·193,000·266.7) = 0.0254(고정)~0.053. 합 0.031~0.059. 670/46.54 = 14.4, 670/130 = 5.15 | 같음 | 만족 |
| ⑤ 시간·SF | L: have 17.6, 볼 3.04 + 0.048 + 0.096 + 바퀴 밑 2.0 + 바퀴 밖 2.727 + 관성 20.71·4·(π/2)/4.5² 6.426 = 14.337 → 1.228. V 입구1: have 8.64, need 3.901 + 3.637 = 7.538 → 1.146. 띠 항 포함 옛 식으로 지금 키 SF 1.009가 재현돼 식이 앞 계산과 같음 | 같음 | 만족 |
| ⑥ 잔재·BOM·자료대기 | 서명에 DC205 17바디(띠 1·누름판 8·볼트 8) 확인, 설계안 목록과 같음 | 17 / 52 | 설계 단계 몫 만족 |

## 기록만(문제 아님)

- 130 N에서 받침 합 처짐 상한 0.164 mm(판 살 단순 받침 가정)는 0.1을 넘는다. 완료 판정은 '롤러 처짐'(0.0154 mm)이라 만족이고, 매트 없이 내리면 바퀴가 롤러에 닿지 않는다(0.86). 얇은 매트 + 압력 오설정이면 이 하중이 실릴 수 있으니 검도·디테일에서 판 살을 다시 본다.
- 베어링 정적 SF 14.4는 M-09 과사양 선(9)을 넘지만 계열 최소 형번이라 줄일 것이 없다(설계안 3절).
- 간섭 ③은 정지 자세 bbox·원 계산이다. 검도가 저장본에서 CAD로 잰다.

## 워크플로우 메모

- 실행 메모의 '최신 v2.13.0'과 config doc(v2.16.0)이 다르다 · 설계·측정은 v2.16.0 기준 · 감사도 서명 v2.16.0을 썼다.
