hyeunung/FSAP/docs/reports/mechanism/mech_RX-11_fea1.md

# 구동 RX-11 해석 (수정 1회차) — 새들 볼트 조임 0.6 N·m 확인

## 요약

- 판정: **합격(동작 문제 0)**. 대상 `3D_Modeling/FSAP_v2.17.1.sc`(형상은 v2.17.0과 같음 — 임시 STEP 5개 그대로, 해시 1절). CAD 안 씀. **FEA 못 함 — 환경 없음(자료대기 D-16)**, 손계산 `fea/cases/mech_RX-11_fea1_handcalc.py` → `fea/results/mech_RX-11_fea1_handcalc.json`.
- 지난 동작 문제 RX-11-F1(3 N·m에서 새들 항복) **없어짐**: 지정 0.6 N·m(예압 600 N)에서 새들 `P_RX11_SADDLE` 위쪽 압축 **51.9 MPa → SF 3.76**(유리한 받침 4.06) ≥ 3. 운전 누름 46.54 N을 겹쳐 3.46, 오설정 130 N 3.03 · 손 100 N 3.17(기준 2).
- 앞 회차 값 고침: 새들 단면을 Y 전 구간(0.02 간격)으로 훑으니 가장 약한 자리는 Y 7.9가 아니라 **Y 8.15 ~ 8.2**(홈 바닥 호가 내려가 살이 얇아지는 곳)다. 3 N·m는 259.6 MPa SF 0.75(앞 표 0.78), 0.6 N·m는 3.76(앞 표 3.91). 4 % 차이, 판정은 같다.
- 클램프 SF 7.66 ~ 8.72, 볼트 23.4 · 좌면 11.6 · 암나사 13.2. 지난 디테일 F2(클램프 SF 1.53)도 없어짐.
- 새로 본 것: 귀 반력 자리(판 윗면)와 클램프 기둥 반력 자리(판 밑면)가 Y로 어긋나면 판 살에 짝힘이 걸려 새들이 내려앉는다. 0.6 N·m에서 0 ~ 0.018(뿌리 고정) ~ 0.035 mm(상한).
- 완료 판정 ② 사슬(무부하 롤러 윗면 낮아짐 = 모델 0.0002 + 새들 축 자리 0.012 + 판 살 짝힘): **0.012 ~ 0.047 mm ≤ 0.1**. 3 N·m였으면 0.059 ~ 0.233이었다.
- 완료 판정 ④·⑤: 앞 회차 케이스를 다시 돌려 **다른 값 0**(STEP 같음, `machine.json _timing` 같음). 롤러 처짐 0.0051 · 0.0143 mm, 696ZZ SF 14.4 · 5.15, 시간 키 최저 SF 1.146(V 입구1).
- 디테일 6건(수정 회차 안 씀): 예압 흩어짐에서 새들 SF 2.25 ~ 2.89(F7), 판 살 짝힘(F8), 앞 회차 F3 ~ F6 그대로.
- completion_met **true**(해석 몫 ②·④·⑤ 만족). ⑥의 BOM·자료대기 문구는 문서 담당 차례.

## 근거 규칙 (원문)

- E-21: "이전 시도가 남긴 결과 파일(…해석 결과 json…)을 먼저 읽고 남은 것만 한다." → 앞 회차 케이스를 같은 입력으로 다시 돌려 재현만 확인하고, 바뀐 조임값에 걸리는 것만 새로 셈.
- E-18: "체결(볼트 지름·길이)만 바뀐 자리는 FEA 대신 손계산 표 … 손계산 값이 기준 ±10% 안이면 그때만 FEA로 다시 확인한다." "손계산의 단면은 가정하지 말고 측정 자료의 최소 단면으로 쓴다." → 단면을 전 구간으로 훑어 최소 자리를 다시 찾음. 지정값 SF 3.76은 기준 3보다 25 % 위.
- E-18: "해석 모델은 부품별 표(`<fea>/models.json`)에 고정한다 … 바꾸면 이유를 적고 옛 모델도 같은 형상으로 풀어 차이를 남긴다." → `fea/models.json` RX-11 행에 `v2.17.1_RX-11 수정1` 칸을 더함(옛 칸 그대로).
- M-09: "필요 SF — 일반 3, 오조작 하중 2", "SF가 필요치의 3배 이상 남으면 과사양". 요구서 6-1 "기본값 — M-09", 6-2 "미정 — … 납품처 기준(D-08)".
- 지시문: "부러짐·영구 변형(SF < 1.2)·동작을 망가뜨리는 처짐만 kind='동작'이고, 기준 근처 미달(SF·처짐·정밀 체인)은 kind='디테일'이다."
- E-02(지시문): "강도 여유·정밀 체인·새 볼트 렌치 접근·판금 규칙은 디테일로 기록만 하고 수정 회차를 쓰지 않는다."

## 1. 앞 회차 재현 (E-21)

| 확인 | 결과 |
|---|---|
| 임시 STEP 5개 sha256 앞 16자 | SADDLE 33b1bae37f61b332 · CLAMP f26c38da8846da90 · PANEL_W2 2fc5b994e6098ef7 · PANEL_E2 23e2900fb0deb239 · NOTCH a4da892cf5398316 (2026-11-13 20:49 내보낸 것 그대로. 모델링 수정 1회차·검도 1회차가 '형상 서명 다른 것 0' 확인) |
| `tools/machine.json` doc | `../3D_Modeling/FSAP_v2.17.1.sc` |
| `mech_RX-11_handcalc.py` 다시 실행 ↔ 앞 회차 json | **다른 값 0** (롤러·베어링, 판 W2·E2, 가로대 통과 홈, 회전 시간 키 9구간 + W 4구간 모두) |

그래서 앞 보고서(`mech_RX-11_fea.md`) 2·4·5·6절 값은 그대로 유효하다.

## 2. 새들 — 지정 0.6 N·m (예압 600 N)

단면을 Y −y_r ~ +y_r 전 구간 0.02 간격으로 훑었다. 하중은 볼트 머리 좌면(고리 도심 Y ±2.23) 예압 + 바퀴 누름(축 홈 Y ±11). 모두 위 압축 굽힘이라 더해진다.

| 하중 | σ 최대 MPa(받침 Y 24.75 불리) | 자리 | SF | 받침 Y 23.5(유리) SF | 기준 |
|---|---|---|---|---|---|
| 예압만 | **51.9** | Y 8.15 위 | **3.76** | 4.06 | 3 |
| + 운전 46.54 N(두 줄 반씩) | 55.2 | Y 8.15 | 3.53 | 3.82 | 3 |
| + 운전 46.54 N(한 줄이 다) | 56.3 | Y 8.17 | 3.46 | 3.74 | 3 |
| + 오설정 130 N(두 줄 반씩) | 61.2 | Y 8.17 | 3.18 | 3.45 | 2 |
| + 오설정 130 N(한 줄이 다) | 64.3 | Y 8.21 | 3.03 | 3.28 | 2 |
| + 손 100 N(한 줄이 다) | 61.5 | Y 8.19 | 3.17 | 3.43 | 2 |

- 같은 훑기로 3 N·m(예압 3,000 N): 259.6 MPa SF **0.75**(유리 0.81) — 앞 회차 표(Y 7.9 자리 0.78 ~ 0.84)보다 4 % 낮다. 앞 회차는 여섯 자리(Y 0 · 4 · 7.9 · 11 · 14.1 · 22.5)만 봤다.
- 과사양 아님(SF 3.76 < 9).

예압 흩어짐(받침 불리):

| 경우 | 예압 N | 새들 SF 예압만 | + 운전(한 줄) | + 오설정 130 N | 클램프 SF | 축 자리 내려앉음 mm |
|---|---|---|---|---|---|---|
| K 0.25(마른 면) | 480 | 4.70 | 4.24 | 3.61 | 9.58 | 0.009 |
| **K 0.20(지정 계산값)** | 600 | **3.76** | 3.46 | 3.03 | 7.66 | 0.012 |
| K 0.15 | 800 | 2.82 | 2.65 | 2.39 | 5.75 | 0.016 |
| K 0.12(나사 고정제가 윤활할 때, 가정) | 1,000 | 2.25 | 2.14 | 1.97 | 4.60 | 0.020 |
| 토크 +30 %(0.78 N·m) | 780 | 2.89 | 2.71 | 2.44 | 5.89 | 0.015 |
| 토크 +30 % · K 0.15 | 1,040 | 2.17 | 2.07 | 1.90 | 4.42 | 0.020 |

한계(새들, 예압만): SF 3 = 751 N(K 0.2로 0.75 N·m) · SF 2 = 1,127 N · **SF 1.2 = 1,878 N(1.88 N·m, K 0.12면 1.13 N·m)** · 항복 = 2,254 N(2.25 N·m, K 0.12면 1.35 N·m). 흩어짐을 다 겹쳐도 영구 변형 선 1.2 위(최저 1.90)다. M5 표준 토크(약 3 ~ 5.7 N·m)로 죄면 항복하므로 부품 속성·BOM의 '이 8개만 0.6 N·m' 문구가 지켜져야 한다.

볼트(`handcalc.calc`, M5 12.9, 물림 11.5 = 2.3d, A5052 탭, 0.6 N·m): 볼트 23.43 · 좌면 11.55 · 암나사 13.21, 외력 인장 없음. X 미끄럼 버팀은 앞 회차 값 그대로(90 ~ 180 N: 운전 23.6 N에 3.8 ~ 7.6, 손 100 N에 0.9 ~ 1.8).

## 3. 판 살에 걸리는 짝힘 (새로 본 것)

새들 귀는 판 윗면 \|Y\| 23 ~ 26.5(도심 24.75)를 아래로, 클램프 기둥은 판 밑면 \|Y\| 23.5 ~ 30(고른 면압 도심 26.75)을 위로 민다. 힘은 같고 방향이 반대라 판 살(레일 안쪽 면 Y 80에서 나온 외팔 57, SUS304 t 4)에 알짜 힘은 없지만, 두 도심이 e만큼 어긋나면 짝힘 P/2 × e가 남아 살 끝이 내려간다. 클램프가 굽으면 기둥 안쪽 끝(23.5)이 더 세게 닿으므로 e는 0 ~ 2.0 사이다. 모델은 앞 회차와 같은 '폭 50 외팔보'(상한)다.

| 예압 | 짝힘 N·mm(e 2.0) | 새들 자리 내려앉음 mm: 뿌리 고정 | 뿌리 회전 몫(볼트 줄이 잡음 / 안 잡음) | 상한 | 판 살 굽힘 MPa |
|---|---|---|---|---|---|
| 600 N(0.6 N·m) | 600 | 0.018 | 0.004 / 0.017 | **0.035** | 4.5 |
| 800 N(K 0.15) | 800 | 0.024 | 0.006 / 0.023 | 0.047 | 6.0 |
| 1,000 N(K 0.12 가정) | 1,000 | 0.030 | 0.007 / 0.029 | 0.058 | 7.5 |
| 3,000 N(앞 지정 3 N·m) | 3,000 | 0.089 | 0.022 / 0.085 | 0.174 | 22.5 |

- 귀 면압 6.1 MPa · 기둥 면압 3.3 MPa(600 N).
- E2 끝 새들(X −326)은 받침 길이 X 방향이라 이 짝힘이 살 9 × t 4를 비튼다: 0.0025 rad, 귀 자리 0.009 mm(긴 홈 닫힌 끝을 안 센 상한).

## 4. 완료 판정 ② 사슬 — 롤러 윗면 Z 0 ± 0.1

무부하에서 롤러 윗면이 낮아지는 양 = 모델 값 0.0002(검도 `mech_RX-11_verify1.md`) + 새들 축 자리 내려앉음 + 판 살 짝힘 몫.

| 조임 | 하한(짝힘 0) | 뿌리 고정 | 상한 | 한도 | 판정 |
|---|---|---|---|---|---|
| **0.6 N·m K 0.20** | 0.012 | 0.030 | **0.047** | 0.1 | 만족 |
| 0.6 N·m K 0.15 | 0.016 | 0.040 | 0.062 | 0.1 | 만족 |
| 0.6 N·m K 0.12(가정) | 0.020 | 0.049 | 0.078 | 0.1 | 만족 |
| 3 N·m(앞 지정, 탄성분만) | 0.059 | 0.148 | 0.233 | 0.1 | 미달(+ 항복분) |

바퀴가 누를 때의 받침 합 처짐(46.54 N 0.013 ~ 0.065 mm, 130 N 0.037 ~ 0.181 mm)은 앞 회차 값 그대로다(F4).

## 5. 문제 목록

| 번호 | kind | 무엇 | 어디 | 수치 | 고치는 방법 | 외부 |
|---|---|---|---|---|---|---|
| RX-11-F1 | (없어짐) | 3 N·m 새들 항복 | `P_RX11_SADDLE` ×8 | 0.6 N·m에서 SF 3.76 ~ 4.06 | — | — |
| RX-11-F2 | (없어짐) | 클램프 SF 1.53 | `P_RX11_CLAMP` ×8 | 0.6 N·m에서 SF 7.66 ~ 8.72 | — | — |
| RX-11-F3 | 디테일 | 손이 롤러를 축 방향 100 N으로 밀 때 새들 X 미끄럼(앞 회차 그대로, 검도 V1-2) | 새들 귀 ↔ 판 윗면 | SF 0.9 ~ 1.8, 운전 23.6 N에는 3.8 ~ 7.6 | 기록. 틈 1.0 · 2.0에서 멈춤. 디테일링에서 위치 핀 Ø3 또는 맞댐 턱 | 아니오 |
| RX-11-F4 | 디테일 | 받침 합 처짐 130 N 상한이 0.1을 넘음(앞 회차 그대로) | `P_M04_PANEL_W2` 긴 홈 살 | 46.54 N 0.013 ~ 0.065(만족), 130 N 0.037 ~ 0.181 mm | 기록. 해석 환경이 생기면 접촉 FEA | 아니오 |
| RX-11-F5 | 디테일 | 696ZZ 정격·롤러 공차 임시(앞 회차 그대로) | `STEP대기_RORLM20-6-L200` ×14 | 정격 절반이어도 SF 7.2 · 2.58 | 구매부가 카탈로그 값으로 D-200에 | 예 |
| RX-11-F6 | 디테일 | FEA 못 함 — 환경 없음 | 새들 포켓 모서리·판 살 | — | D-16 환경이 생기면 임시 STEP 5개로 다시 풂 | 예 |
| RX-11-F7 | 디테일 | 예압 흩어짐에서 새들 SF가 기준 3 미달(검도 V1-1과 같은 항목, 값 고침) | `P_RX11_SADDLE` ×8 축 홈 포켓 Y 8.15 ~ 8.2 | K 0.15 2.82(+ 운전 2.65), K 0.12 가정 2.25, 토크 +30 % 2.89, 둘 겹쳐 2.17(+ 오설정 1.90). 항복은 2,254 N(2.25 N·m) | 기록. 디테일링에서 ① 홈 바닥 살 +1 mm(새들 밑면 Z −16 → −17, 클램프와 틈 0.5라 클램프 윗면도 같이) 또는 ② 지정 0.5 N·m. 조립은 토크 드라이버로 | 아니오 |
| RX-11-F8 | 디테일 | 귀 ↔ 기둥 반력 자리 어긋남으로 판 살에 짝힘, 롤러 윗면이 더 낮아짐 | `P_M04_PANEL_W2` 긴 홈 살 ↔ `P_RX11_CLAMP` 기둥(\|Y\| 23.5 ~ 30) | 0.6 N·m 0 ~ 0.035 mm, 사슬 합 0.012 ~ 0.047(K 0.12 가정 0.078) ≤ 0.1 | 기록. 디테일링에서 클램프 기둥 닿는 면을 귀와 같은 \|Y\| 23.5 ~ 26.5로 줄이면(바깥 3.5는 0.2 낮춤) 도심이 맞아 짝힘이 없어진다 | 아니오 |

과사양 note(문제 아님, 앞 회차 그대로): 696ZZ SF 14.4(줄일 형번 없음), 가로대 SF 22.4 · 판 SF 21.3(공용 형재·판 t 4).

## 6. 완료 판정 (해석 몫)

| 항목 | 만족 | 근거 |
|---|---|---|
| ② 롤러 윗면 Z 0 ± 0.1 | 예 | 모델 −0.0002(검도). 0.6 N·m 조임 뒤 낮아짐 0.012 ~ 0.047 mm, 항복 없음(SF 3.76) |
| ④ 롤러 처짐·베어링 | 예 | 0.0051 · 0.0143 mm ≤ 0.1, 696ZZ SF 14.4 · 5.15 ≥ 3 · 2 (재현, 다른 값 0) |
| ⑤ 시간·SF ≥ 1 | 예 | 9구간 최저 1.146(V 입구1), `machine.json _timing` 그대로 (재현, 다른 값 0) |
| ①·③ | 검도 몫 | `mech_RX-11_verify1.md` 합격 |
| ⑥ | 문서 담당 차례 | BOM·자료대기 D-97·D-200 문구 |

completion_met true. 등급 M 맞음.

## 7. 문서 담당에게 넘길 것

- BOM: `CB5-20_RX11` ×8을 따로 행으로, 비고 "조임 0.6 N·m(토크 드라이버) + 중강도 나사 고정제. 표준 토크 금지 — 2.25 N·m에서 새들 항복".
- 설계검토서: 새들 SF **3.76**(0.6 N·m, 앞 문서 값 3.91은 Y 7.9 자리 값), 클램프 7.66, 롤러 윗면 조임 뒤 낮아짐 0.012 ~ 0.047 mm.
- 요구서 7절(시제품 확인): 조임 0.6 N·m에서 새들 풀림·밀림, 조임 뒤 롤러 윗면 높이(볼 꼭대기 대비) 실측.
- 자료대기: D-200 '쓰는 곳'(696ZZ C0r 670 · Cr 1,730 N 임시), D-16(RX-11 수정 1회차 해석 못 함 — 손계산).
- `fea/models.json`: `P_RX11_SADDLE` · `P_RX11_CLAMP` · `CB5-20_RX11 x8` · `P_M04_PANEL_W2`에 `v2.17.1_RX-11 수정1` 칸을 더했다(`tools/out/mech_RX-11/fea1_models_patch.py`).

## 8. 시간 (E-23)

| 항목 | 값 |
|---|---|
| 통로 | 없음(CAD 안 씀) |
| CAD 호출 · 파일 열기 · 브라우저 | 0 · 0 · 0 |
| 손계산 실행 | 3회(수 초) |
| 예상(해석 M 40분) | 안쪽 |

## 워크플로우 메모

- 앞 회차 손계산이 단면을 '눈에 띄는 자리 여섯 곳'만 봐서 최대 자리(홈 바닥 호 초입)를 4 % 놓쳤다. 손계산 도구에 '단면 함수를 주면 전 구간을 훑어 최대 자리를 내는' 도우미가 있으면 자리 고르기 실수가 없어진다(`handcalc.py`에 없음, 이번 스크립트의 `sweep`).
- 볼트로 판을 사이에 끼워 죄는 두 부품(새들 귀 · 클램프 기둥)은 닿는 면의 도심이 어긋나면 판에 짝힘이 남는다. 설계 단계 자기 점검 항목으로 '끼워 죄는 두 면의 도심 차'를 두면 해석부까지 오지 않는다.
- 조임 토크처럼 형상이 안 바뀌는 수정 회차는 모델링·검도·해석이 같은 식을 세 번 다시 셈한다. 해석부 케이스 스크립트에 토크 인자만 주고 한 번 돌려 세 부서가 같은 json을 읽게 하면 줄어든다.
