hyeunung/FSAP/docs/reports/mechanism/mech_RX-11_model.md

# 구동 RX-11 모델링 — U5 먼 쪽 바퀴 밑 받침을 X축 자유 롤러 2줄로 (C-45)

## 요약

- 저장: `3D_Modeling/FSAP_v2.17.0.sc`(v2.16.0에서 가운데 자리 +1 — 부품 묶음 신설·삭제, E-05). `tools/config.json` doc · `tools/machine.json` doc 바꿈. 통로 MCP(앱).
- 지움 17바디(잔재 0): `P_DC205_STRIP` 1 · `P_DC205_DISC_1~8` 8 · `CB5-12_DC205` ×8(컴포넌트째). 피처 49개 지움, 이름에 DC205가 든 바디·피처·컴포넌트 0.
- 새로 52: `STEP대기_RORLM20-6-L200` ×14(윗면 Z 0.000 14/14) · `STEP대기_SFJ6-213` ×14 · `P_RX11_SADDLE` ×8 · `P_RX11_CLAMP` ×8 · `CB5-20_RX11` ×8. 모두 `U2_TABLE` 아래.
- 고침 3: 판 `P_M04_PANEL_W2`(긴 홈 X −1847~−410 · Y ±23, −231,835 mm³) · `P_M04_PANEL_E2`(X −410~−317, −17,096 mm³) · 가로대 X −420 자리 → 따로 정의 `HFS8-4080-560_M04_NOTCH`(윗면 통과 홈, −9,713 mm³, 한 덩어리). 다른 두 자리(X −305·−85)는 bbox·부피 624,561.05 mm³ 그대로.
- 검사(앱, 저장 전): REST 새 것 × 새 것·판·형재 232쌍 + 새 것 × 주변 243쌍 **겹침 0**. J_U5_X 0·345·690·1035·1380 × J_U5_LIFT −10: 트레드 ↔ 롤러 **0.859**(5점 모두), 새 부품과 겹침 0. LIFT 30: 40.55. 떠 있는 부품 0, 조인트 587 · 링크 35 그대로, 타임라인 오류 0 · 경고 54 → 53.
- 지시와 달리 한 것: ① 가로대 나누기는 `component.paste_new`가 거부돼 `component.copy_bodies`로 함(2절) ② 롤러 ↔ 볼 테 틈 실측 7.12(지시 ≥ 7.4 — 설계 계산 자리 차이, 4절).
- `tools/machine.json` _timing U4+U5 키를 띠 항 없이 고침(L 4.5 · G2 3.0 · G1 바닥 0.8 ×9 · V 3.0 / 1.5 ×4·1.0 / 1.9), 조인트·연구는 그대로.
- 저장본 CLI 확인: 3,224바디가 서명 표와 같음, 조인트 587 · floating 0, 볼트 프로브 겹침 0(6절). 미완: STEP 대기 2종(RORLM20-6-L200·SFJ6-213)은 임시 형상(외부 조건). FEA 못 함 — 환경 없음(D-16).
- 시간: 약 60분이 앱 막힘·다시 계산(`timeline.dependents` 30분 → 앱 재시작 → 다시 열기 약 15분 → `timeline.delete` 약 13분). 그리기 자체는 약 1.5분.

## 근거 규칙 (원문)

- E-05: "형상이 바뀐 저장은 같은 문서에 덮어쓰지 않고 다른 이름으로 저장 … 부품 묶음 신설·삭제는 가운데 자리를 올린다".
- E-10: "형번이 정해졌는데 끝까지 STEP이 없으면 카탈로그 외형도 치수로 임시 형상 … 이름은 `STEP대기_<형번>`".
- E-11: "새로 넣거나 옮긴 볼트·부품을 그 유닛의 리지드 그룹에 넣고 … 안 묶인 부품 0".
- E-15: "저장 전에 바꾼 유닛의 조인트를 전 행정 구동해(자기 점검)". E-16: "판정은 수치로만". E-22: "넘기기 전에 스스로 확인".
- U-11: "매립하는 경우: 머리가 다른 부품·대상·움직이는 부품과 간섭" — `CB5-20_RX11` 머리(윗면 Z −3)는 매트 밑면 Z 0 아래에 있어야 해서 새들에 카운터보어 Ø9.5 × 6.
- 실행 규칙 2: "모델링부는 SolidCraft MCP로 그린다 … `save {}`(덮어쓰기)는 쓰지 않는다". 실행 규칙 19: 저장 전 조인트·스케치 표시 숨김.

## 1. 통로·순서·시간

| 항목 | 값 |
|---|---|
| 통로 | MCP(앱 --control 27878). 큰 응답·단계 묶음은 `tools/out/mech_RX-11/model/mcp_send.py`(MCP 서버를 표준 입출력으로 띄워 파일을 그대로 보냄, RX-12와 같은 방법)로 보내고 결과를 파일에 받음 |
| 문서 확인 | 처음: v2.16.0 열려 있음, dirty false, 피처 3,712 · 바디 880 · 오류 0 · 경고 54. 다시 연 뒤에도 같음 |
| 순서 | `edit.checkpoint` → `motion.play REST 0`(moved false) → 이름 `FSAP_v2.17.0`·설명 → `save {path: v2.17.0}` → config doc → 지우기 → 판 홈 → 가로대 → 새들 → 클램프 → 볼트 → 롤러 → 축 → 검사 → 임시 STEP → REST·표시 숨김 → `save {path: v2.17.0}`(dirty false) → 서명 고침 |
| 그린 시간 | 판 홈 7.8 s(18단계) · 가로대 7.5 s · 새들 12.5 s(31단계) · 클램프 6.5 s · 볼트 24.0 s · 롤러 4.1 s · 축 3.1 s |
| 지우기 | `timeline.delete` 49피처 + `component.delete` — 약 9~13분(앞쪽 피처라 그 뒤 전체가 다시 계산됨, 응답은 280 s에서 끊기고 `running`으로 끝을 확인) |
| 앱 막힘 | 아래 표 |

앱 막힘·재시작(안내서 '연결' 앱 막힘, WF-195):

| 항목 | 내용 |
|---|---|
| 막은 요청 | 이 부서가 보낸 `batch` 7단계(`edit.checkpoint` · `motion.play` · **`timeline.dependents` ×4**(4661·4662·4708·4681) · `material.list`), 연결 606 · id 15932. 300 s에서 MCP 응답이 끊겼고(os error 10060) `pending`은 "nothing is running", `running`에는 계속 돎 |
| 기다린 시간 | running_s 1,800 s(30분)까지 `running`으로 확인(303 → 559 → 848 → 1,238 → 1,526 → 1,800). 앱 메모리 13.6 GB |
| 원인 | `timeline.dependents`가 앞쪽 피처(이력 3,712개 중 앞)에서는 그 뒤 전체를 다시 계산해 보는 것으로 보임. 다시 연 뒤 `edit.checkpoint` 0.1 ms · `motion.play` 177 ms였으므로 나머지 단계 탓이 아님 |
| 재시작 | 2026-11-13 20:15:27, `Stop-Process -Name solidcraft -Force` → `solidcraft.exe --control 27878`. `solidcraft-cli` 2개(pid 19340·38084)는 그대로 둠 |
| 버린 것 | 없음(막힌 요청은 읽기·체크포인트뿐, 설계는 dirty false였음) |
| 다시 연 저장본 | `open FSAP_v2.16.0.sc` — 544 s에 진행 중, 약 890 s 뒤 확인 때 끝나 있었음(피처 3,712 · 오류 0, 피처 계산 합 847 s) |

## 2. 만든·지운·고친 것 (세계 좌표 mm, REST)

### 지운 것

| 대상 | 방법 | 확인 |
|---|---|---|
| `P_DC205_STRIP`(스케치 3 · 돌출 3 · 보스 8 · 나사 8) · `P_DC205_DISC_1~8`(원통 16) · 옮김 9 · 볼트 복사·옮김 2 = 피처 49 | `timeline.delete {features: [4661~4672, 95001~95010, 4681~4705, 4708, 4709]}` 한 번 | 지운 뒤 피처 3,663 · 바디 870, 오류 0, 그 뒤 실패 피처 0, 경고 54 → 53(띠 끝 절삭 Extrude30 경고가 같이 없어짐) |
| 컴포넌트 `CB5-12_DC205`(occurrence 8) | `component.delete` | `component.metadata CB5-12_DC205` → "no component" |
| 잔재 | — | 이름에 DC205가 든 바디 0 · 피처 0 · 컴포넌트 0. BOM `CB5-12` 수량은 8 줄어듦 |

### 고친 기존 부품

| 부품 | 한 것 | 전 → 후 |
|---|---|---|
| `P_M04_PANEL_W2`(SUS304 t4) | `U2_TABLE` 활성 → 스케치 `SK_RX11_SLOT_W2`(Z −13 평면, X −1847~−405 · Y ±23, 닫힌 끝 모서리 R 3) → `RX11_SLOT_W2` cut 6. Y 0 줄 Ø36 구멍 8개는 홈 안에 들어가 없어짐 | 부피 3,785,401.19 → **3,553,566.06**(−231,835.1, 기대 −231,820.5와 차 14.6 = 원 8개 넓이 계산 차 0.0004 %). bbox 그대로(−2175~−410 · ±300 · −12~−8), 면 150, 28,179.8 g |
| `P_M04_PANEL_E2`(SUS304 t4) | 스케치 `SK_RX11_SLOT_E2`(X −415~−317 · Y ±23, 닫힌 끝 R 3) → `RX11_SLOT_E2` cut 6 | 2,680,301.20 → **2,663,204.74**(−17,096.5, 기대 −17,096.55). bbox 그대로, 면 116, 21,119.2 g |
| 가로대 X −420 자리 | 새 컴포넌트 `HFS8-4080-560_M04_NOTCH`(`U2_TABLE` 아래)에 남는 자리 `:2`(X −305)의 바디를 `component.copy_bodies`로 복사 → `body.rename` → `occurrence.move` (−115, 0, +40) → 옛 `HFS8-4080-560_M04:1`(occurrence 5953) `selection.delete` → 루트에서 `solid.box` cut(`RX11_HFS_NOTCH`: X −421~−379 · Y −24~+24 · Z −23~−11) | bbox −420~−380 · ±280 · −92~−12 그대로, 부피 624,561.05 → **614,847.63**(−9,713.4), shells 1(한 덩어리), 면 154 → 190, 1,660.1 g(Aluminum). 형번 `HFS8-4080-560` 그대로, 설명에 추가 가공(윗면 통과 홈 48 × 11) |
| 가로대 다른 두 자리 | 안 건드림 | X −305~−265 · Z −132~−52, X −85~−45 · Z −132~−52, 부피 624,561.05 둘 다 그대로. BOM `HFS8-4080-560` 3개 그대로(2 + NOTCH 1) |

- 지시와 다른 점(가로대): `component.paste_new {component: HFS8-4080-560_M04, occurrence: :1, in_place}`는 **"copy geometry differs for body HFS8-4080-560_M04"**로 거부됐다(STEP 넣기 + 끝면 오프셋 이력을 다시 만든 형상이 원본과 다름). 그래서 바디 복사로 따로 정의를 만들었다. 복사 원본은 지우지 않는 자리(`:2`)로 잡았다.
- 이름 주의: 옛 첫 자리(`:1`)를 지워서, 바디 이름 `HFS8-4080-560_M04`(괄호 없는 첫 자리)가 이제 **X −305 자리**를 가리킨다(옛 `…(U2_TABLE:1/HFS8-4080-560_M04:2)`). 서명 표에도 그렇게 고쳤다(7절) — `ledger.py scope`의 '바뀜 `HFS8-4080-560_M04`'는 이 이름 옮김이고 형상·자리는 그대로다.
- 참고(지시 좌표): 다른 두 자리의 Z는 지시문의 '−92~−12'가 아니라 −132~−52다(작업 전부터, M04R `CM_PLACES`).

### 새 부품 (모두 `U2_TABLE` 아래 컴포넌트, 한 정의 + occurrence)

| 컴포넌트(바디) | 수 | 형상·자리 | 실측 | 재질 |
|---|---|---|---|---|
| `P_RX11_SADDLE` | 8 | 단면 스케치(Y–Z) 한 번에 민 T자: 귀 Y ±26.5 · Z −8~−2, 몸통 Y ±22.5 · Z −16~−8, X 두께 14. 축 홈 4(Y ±11, 폭 6.2, 양쪽 X면에서 깊이 6, 바닥 R 3.1 중심 Z −9.9, 가운데 벽 2). 볼트 구멍 Ø5.5 관통 + 카운터보어 Ø9.5 × 6(자리 면 Z −8). X 중심 −1838 + 216k | bbox 14 × 53 × 14(첫 −1845~−1831, 여덟째 −333~−319), **7,338.96 mm³**(기대 7,339), 19.67 g, 면 29, shells 1 | A5052(밀링 잠정) |
| `P_RX11_CLAMP` | 8 | 단면 한 번에 민 ㄷ자: Y ±30 · Z −31~−12, 윗면 가운데 Y ±23.5를 Z −16.5까지 낮춤, X 두께 14. 가운데 M5 탭 관통(밑구멍 Ø4.2 + 나사 표시 M5) | bbox 14 × 60 × 19, **12,798.14 mm³**(기대 12,999 − 200.9 = 12,798.1), 34.30 g, 면 11 | A5052(밀링 잠정) |
| `CB5-20_RX11` | 8 | `purchased-step/CB5-20/CB5-20.stp`, 축 −Z, 머리 밑 Z −8(머리 윗면 Z −3), 끝 Z −28. 새들 X 중심 · Y 0 | bbox Ø8.5 · Z −28~−3, 633.48 mm³, 4.97 g, 면 19 | SCM435 |
| `STEP대기_RORLM20-6-L200` | 14 | 임시 형상(E-10): 외경 20 × 200, 축 X, 속 Ø12 관통, 양 끝 5 구간만 Ø6. 축 중심 (Y ±11, Z −10). X 구간 −1830~−1630 … −534~−334(피치 216) | bbox Y 1~21 / −21~−1 · **Z −20~−0.0**(14개 모두 윗면 Z 0.000), **41,059.23 mm³**(기대 41,061), 322.3 g, shells 1 | Steel |
| `STEP대기_SFJ6-213` | 14 | 임시 형상: Ø6 × 213, 축 X, 롤러와 같은 중심선, 롤러 양 끝에서 6.5(첫 축 X −1836.5~−1623.5) | bbox Ø6 · Z −13~−7, 6,021.23 mm³, 47.27 g | Steel |

- 임시 형상 치수 출처(E-10): 카탈로그부 표 `tools/out/mech_RX-11/catalog.md` — RORLM20-6-L200(미스미 금속 파이프 롤러 베어링붙이, D 20 · L 200 · 축 구멍 d 6 · 베어링 B696ZZ(D1 15, B 5) · 스틸 파이프 안지름 12, us.misumi-ec.com/vona2/detail/110302647520/), SFJ6(리니어 샤프트 스트레이트 Ø6 g6, 길이 지정 213). 모델의 끝 5 구간 안지름 6은 베어링 안지름 자리다(베어링 겉모양 Ø15는 그리지 않음).
- 구매품 메타: 부품 번호 `RORLM20-6-L200` · `SFJ6-213` · `CB5-20` · `HFS8-4080-560`(bom_type purchased), 가공품 `P_RX11_SADDLE` · `P_RX11_CLAMP`. `assembly.bom`(flat): 새들 8 · 클램프 8 · 롤러 14 · 축 14 · CB5-20 41 → 49 · HFS8-4080-560 3.
- 간이 형상(LITE) 판정: 새로 넣은 STEP은 볼트(CB5-20)뿐이라 원본 그대로(E-10 "볼트·너트·와셔·핀은 원본 그대로").
- 조인트: 새로 만들거나 바꾼 것 없음(자유 롤러는 고정 형상). 새 occurrence 53개(52 + NOTCH 1)는 `U2_TABLE:1`의 자식으로 따라간다(`CB5-12_DC205`·볼 등 기존 U2 부품과 같은 묶음 방식). `joint.list`: floating **0**, 충돌 0, 오류 0, 조인트 587 · 링크 35(작업 전과 같음).

## 3. 저장 전 자기 점검 — 치수·맞닿음 (지시서 [9])

| 항목 | 지시 | 실측 | 판정 |
|---|---|---|---|
| 롤러 14개 윗면 | Z 0.000 | bbox zmax −0.0(14/14) | 합격(완료 판정 ② Z 0 ± 0.1) |
| 새들 귀 밑면 ↔ 판 윗면 Z −8 | 닿음 | 0.000(W2 ×7, E2 ×1) | 합격 |
| 클램프 기둥 ↔ 판 밑면 Z −12 | 닿음 | 0.000(W2 ×7, E2 ×1) | 합격 |
| 볼트 머리 좌면 ↔ 카운터보어 바닥 | 닿음 | 0.000(×8) | 합격 |
| 새들 ↔ 클램프 | 0.5 | 0.500(×8) | 합격 |
| 롤러 ↔ 판 홈 가장자리 | 2.0 | 2.000(W2 14쌍, E2 2쌍) | 합격 |
| 롤러 ↔ 롤러(두 줄 사이) | 2 | 2.000(×7) | 합격 |
| 롤러 끝 ↔ 새들 면 | 1.0 | 1.000(28쌍). 롤러 ↔ 클램프도 1.000 | 합격 |
| 롤러 밑 ↔ 형재 통과 홈 바닥 | 3.0 | 3.000(×2) | 합격 |
| 새들 ↔ 볼 테 | ≥ 1.5 | 1.521 | 합격 |
| 클램프 ↔ 볼 몸통 | ≥ 2.0 | 2.025 | 합격 |
| 롤러 ↔ 볼 테 | ≥ 7.4 | **7.117** | 지시 수치보다 0.28 작음 — 아래 |
| 끝 클램프(X −333~−319) ↔ 가로 형재 | 47 | 3.5 안에 없음(bbox로 −380 ↔ −333 = 47) | 합격 |
| 축 ↔ 축(이웃, 새들 가운데 벽 사이) | 3(벽 2 + 0.5 × 2) | 3.000(12쌍), 축 ↔ 클램프 3.5 | 합격 |
| 매트 밑면 Z 0 ↔ 롤러 윗면 | 0.0(얹힘) | MAT_L·G·V·W ↔ 롤러 0.010(면 조각 거리, 겹침 0) | 합격 |
| 매트 ↔ 새들 윗면 · 볼트 머리 | — | 2.000 · 3.000 | 매트에 안 닿음 |

- 롤러 ↔ 볼 테 7.117: 볼 테 Ø44의 아랫모서리(Y 28, Z −8) ↔ 롤러 축(Y 11, Z −10) 거리 √(17² + 2²) − 10 = 7.117. 설계 계산(7.46)은 Z −7 높이의 반폭으로 잰 값이다. 틈이 7 mm대라 기능 차이는 없다(겹침·끼임 아님). 지시 수치와 다르므로 적는다.

## 4. 저장 전 자기 점검 — 겹침 (앱 `inspect.clearance`, 검도 과제 안 검사와 같은 도구)

| 자세 | 대상 × against | 쌍(가지치기) | overlaps | unchecked | 결과 |
|---|---|---|---|---|---|
| REST | 새 52 + 판 2 + NOTCH(55바디끼리) | 232(1,253) | **0** | 36 | 아래 |
| REST | 새 52 + 판 2 + NOTCH × 주변 42(볼 32 · 매트 4 · 테이프 조각 5 · 가로대 X −305) | 243(2,067) | **0** | 0 | 합격 |
| LIFT −10 · J_U5_X 0 | U5 바퀴 4바디(트레드·휠·센서 브래킷·센서) × 새 55 + 주변 42 | 40 | **0** | 0 | 트레드 ↔ 롤러 **0.859** ×2, 트레드 ↔ 축 7.859, 트레드 ↔ 판 W2 11.78 |
| LIFT −10 · 345 | 같음 | 50 | 1 | 0 | 트레드 ↔ 롤러 0.859 ×4. 겹침 = 트레드 ↔ MAT_L 11,250.9 mm³(아래) |
| LIFT −10 · 690 | 같음 | 44 | 3 | 0 | 트레드 ↔ 롤러 0.859. 겹침 = 트레드 ↔ MAT_L·G·V |
| LIFT −10 · 1035 | 같음 | 62 | 3 | 0 | 트레드 ↔ 롤러 0.859 ×4, 트레드 ↔ 새들 2.000. 겹침 = 트레드 ↔ MAT_L·G·V |
| LIFT −10 · 1380 | 같음 | 51 | 4 | 0 | 트레드 ↔ 롤러 0.859. 겹침 = 트레드 ↔ MAT_L·G·V·W |
| LIFT 30 · 1380 | 같음 | 22 | **0** | 0 | 트레드 ↔ 매트 30.0 |
| LIFT 30 · 0 (REST) | 같음 | 8 | **0** | 0 | 트레드 ↔ 롤러 **40.549**(지시 40.0은 수직 거리, 롤러 축이 Y ±11이라 빗거리 40.55) |

- unchecked 36 = ① 새들 ↔ 축 28쌍("facets pass through each other" — 축 Ø6(중심 Z −10)이 홈 바닥 R 3.1(중심 Z −9.9)에 안쪽으로 접하는 선 접촉이라 면 조각이 서로 지나가 계산이 안 됨. 식으로 중심 거리 0.1 = 반지름 차 0.1 → 접함, 옆 틈 0.1 × 2) ② 클램프 ↔ 볼트 8쌍("boolean Intersect no result" — Ø5 축 ↔ Ø4.2 탭 나사 물림 11.5). 둘 다 지시서의 의도된 맞닿음이고 `machine.json` baseline_overlaps에 더했다(M-08).
- 축 ↔ 롤러 0.000 ×14: 축 Ø6 ↔ 롤러 끝 안지름 6(내장 베어링 안지름) 동축 맞닿음, 부피 0. 같은 기준선 줄에 넣음.
- LIFT −10에서 트레드 ↔ 매트 11,250.9 mm³: 이 자세는 '매트 없이 내림'(FLOAT 0)인데 매트 모형이 로딩 자리에 그대로 있어서 생긴 것이다(운전 때는 FLOAT가 매트 두께 10만큼 올라감, baseline 'U4_WHEEL·U5_WHEEL ↔ WP_MAT_* 윗면'). 새 부품과의 겹침은 5점 모두 0.
- 매트가 움직이는 자세(MAT_L·S·G·V·W, RX-12 CYCLE_W 포함): 앱에서 연구 자세로 가는 `motion.play`가 한 번에 약 9분이라(RX-12 실측) 돌리지 않았다. 대신 수치로: 새 부품의 가장 높은 곳이 롤러 윗면 Z 0.000(새들 −2, 볼트 머리 −3)이고 매트·테이프 모형은 Z ≥ 0에서 평면 운동만 하므로 어느 X·Y·회전 자세에서도 겹침 부피는 0이다(맞닿음만). 검도의 과제 범위 검사에서 연구 단계 몇 점으로 확인할 것.
- 나눔 틈 위 자세(완료 판정 ①): 롤러 나눔 틈 16(예: X −1630~−1614) < 트레드 폭 25. 측정 5점은 모두 트레드 25 전체가 롤러 위다(설계 표와 같음). 트레드 가운데가 틈 가운데에 오는 자세(J_U5_X 178 등)는 앱에서 따로 놓지 않았다 — bbox로 양쪽 롤러에 4.5씩 걸친다.
- 조인트 자기 점검(E-15): 바꾼 유닛 U2_TABLE은 고정이라 구동 조인트가 없다. 이웃 U5는 `joint.drive` J_U5_X 0~1380 · J_U5_LIFT −10~30 양 끝까지 held 없이 감(위 표). 끝나고 LIFT 30 · X 0으로 되돌린 뒤 `motion.play REST 0` moved false.

### 새 볼트 CB5-20_RX11 ×8 (M-01~M-03, 같은 묶음 — E-19)

| 항목 | 값 | 판정 |
|---|---|---|
| 상대 | `P_RX11_CLAMP` M5 관통 탭(Z −31~−16.5), 볼트 끝 Z −28 → 물림 **11.5** ≥ 1.5d 7.5 | 합격 |
| 방향 | 위에서 아래(−Z), 탭 방향과 같음 | 합격 |
| 빈 구멍·중복 | 새들 구멍 8 · 클램프 탭 8에 볼트 8, 같은 자리 중복 0. 옛 띠 볼트 구멍(판 W2 Ø36 ×8)은 긴 홈에 들어가 없어짐 | 합격 |
| 삽입 길·렌치 | 프로브 Ø8.5 × 30(= max(30, 20 + 5), 머리 윗면 Z −3 → Z 27, 볼트 1·4·8): 기계 부품과 겹침 **0**, 프로브 ↔ 롤러 4.408. 겹친 것은 로딩 자리의 매트·테이프 모형뿐(매트를 내리고 U5 바퀴를 옮기면 위가 열림). 위에서 4 mm 육각 렌치(6절 저장본 CLI) | 합격 |
| 카운터보어 살 | Ø9.5 ↔ 새들 X면 (14 − 9.5)/2 = **2.25**(≥ 1 합격, 기본 2.5보다 0.25 작음 → 디테일 기록), ↔ 축 홈 3.15 | 기록 |
| 판 물림 | 판(t4)은 새들 귀 밑면(Z −8)과 클램프 기둥 윗면(Z −12) 사이에 물림. 새들 몸통 ↔ 클램프 가운데 틈 0.5 | — |

## 5. 손계산·시간 키 (완료 판정 ④·⑤, 설계 값 그대로 — 형상이 지시와 같음)

| 항목 | 값(설계 `tools/out/mech_RX-11/design/rx11design.json`) | 기준 | 판정 |
|---|---|---|---|
| 롤러 처짐(가운데 하중) | 46.54 N 0.0055 mm · 130 N 0.0154 mm (모델링부 다시 셈: 관 Ø20/Ø12 I 6,836 mm⁴, 받침 195 → 0.0051 mm) | ≤ 0.1 | 합격 |
| 받침 합(롤러 + 축 + 판 살) | 46.54 N 0.031~0.059 mm · 130 N 0.087~0.164 mm | ≤ 0.1(누름 46.54 N) | 합격(130 N은 매트 없이 내리면 바퀴가 롤러에 0.859 떠서 실리지 않음) |
| 696ZZ 정적 SF(C0r 670 N 임시) | 가장 불리(한 베어링이 다 받음) 14.4 · 130 N 5.15 | 3 · 2(M-09) | 합격 |
| 축 굽힘 | 12.6 MPa · 130 N 35.2 MPa | — | — |
| 클램프(볼트 3 kN 가정) | 127.2 MPa, A5052-H34 항복 215 → SF 1.69 | 디테일 기록(E-02) | 기록 |
| FEA | 못 함 — 환경 없음(자료대기 D-16) | — | — |

`tools/machine.json` 고친 것(동작 연구는 단계만이라 그대로, 조인트·상태 변화 없음):

| 키 | 전 → 후 | SF |
|---|---|---|
| doc | v2.16.0 → v2.17.0 | — |
| `_timing.CYCLE_L_모서리.U4+U5` | 7.5 → **4.5** s | 1.228 |
| `_timing.CYCLE_G2_모서리.U4+U5` | 4.5 → **3.0** s | 1.262 |
| `_timing.CYCLE_G1_바닥.U4+U5` | "12° 피벗 1.2 ×9 + 3° 0.6" → "12° 피벗 **0.8** ×9 + 3° 0.6" | 1.281 · 1.926(G1 출구 19° 1.2 ×2 그대로 1.924) |
| `_timing.CYCLE_V.입구1_U4+U5` | 4.4 → **3.0** | 1.146 |
| `_timing.CYCLE_V.꼭짓점_U4+U5` | [2.0 ×4, 1.3] → **[1.5 ×4, 1.0]** | 1.175 · 1.237 |
| `_timing.CYCLE_V.입구2_U4+U5` | 2.7 → **1.9** | 1.148 |
| `_timing.CYCLE_W` | 키 그대로(임시), 근거에 '띠 없음 SF 1.465 · 1.458 · 1.468 · 1.451, 정식 계산은 RX-12-C4' | — |
| `_timing.한계` | `U4+U5_t_min_s_mus0.30` → `U4+U5_t_min_s_띠없음`(입구1 2.63 · 꼭짓점 25° 1.29 · 10° 0.82 · 입구2 1.66, 옛 값은 설명에), `L모서리_U4+U5_구름_c_max`에 띠없음 0.0415 | — |
| `_timing._note` | 식과 롤러 항(바퀴 밑 롤러 관성 2 × 0.219 kg × d₂², 구름 0.05 × 40 N × d₂, 바퀴 밖 롤러 0.18 N × Σ|x|), 원본 경로 | — |
| `units.U2_TABLE.parts` · `_note` | `P_RX11_` · `CB5-20_RX11` · `STEP대기_RORLM20-6-L200` · `STEP대기_SFJ6-213` 더함 | — |
| `baseline_overlaps` | RX-11 의도된 맞닿음 한 줄(볼트 ↔ 클램프 탭, 축 ↔ 새들 홈 바닥, 축 ↔ 롤러 안지름, 새들·클램프 ↔ 판, 매트 ↔ 롤러 윗면) | — |
| `_history` | RX-11 한 줄 | — |

고침 스크립트: `tools/out/mech_RX-11/model/patch_machine.py`.

## 6. 저장·저장본 확인

| 항목 | 값 |
|---|---|
| 저장 상태 | `motion.play REST 0`, 조인트·스케치 표시 숨김(`browser.visibility` joints·sketches false), 문서 이름 `FSAP_v2.17.0`, 설명 "RX-11 mechanism: U5 under-wheel support = 2 rows of free rollers on X (C-45), PTFE strip set removed" |
| 저장 | `save {path: 3D_Modeling/FSAP_v2.17.0.sc}` 5,667,133 바이트. 저장 뒤 `inspect_design`: **dirty false**, 피처 3,687 · 바디 정의 876 · 오류 0 · 경고 53 · 되감긴 피처 0. 저장 뒤 편집 없음 |
| 숨김(E-11) | 숨긴 바디 98 → 98(작업 전과 같은 목록 — 매트·테이프 조각 모형). 새 부품 숨김 0 |
| 재질(E-09) | 새 가공품 `P_RX11_SADDLE`·`P_RX11_CLAMP` A5052(기본 재질 아님), 판 SUS304 그대로. `matcheck.py`: 불일치 2건은 작업 전부터 있던 `P_M02/M03_WHEEL_TREAD`(Urethane_A70 ↔ '우레탄 A70' 표기), 새 부품 2종은 'BOM에 없는 부품'(BOM은 문서 담당이 v2.17.0에 올림) |
| 임시 STEP(해석용) | `tools/out/mech_RX-11/stepout/` `P_RX11_SADDLE.step` · `P_RX11_CLAMP.step` · `P_M04_PANEL_W2.step` · `P_M04_PANEL_E2.step` · `HFS8-4080-560_M04_NOTCH.step` |
| 스크린샷 | `tools/out/mech_RX-11/shot_v2.17.0_model.png`(사람용, 열어 보지 않음) |
| 저장본 CLI 확인 | `solidcraft-cli run model/savecheck_probe.json --in 3D_Modeling/FSAP_v2.17.0.sc --results`(저장 안 함, 백그라운드 880 s = 열기 약 785 s + 계산 95 s). ① `inspect.measure` 전수 **3,224바디**를 서명 표와 대조: bbox(0.05)·부피(1e-4) 다른 것 1 = `REF_NEEDLE_AXIS_MARK`(부피 3.14135 ↔ 서명 3.141, 반올림 자리 — 이번에 안 건드린 표시점), 서명에 없는 바디 0 · 파일에 없는 서명 0 → 바꾸지 않은 부품 위치 그대로 ② `joint.list`: 조인트 587 · 링크 35 · floating 0 · 오류 0 · 충돌 0 ③ 볼트 프로브(Ø8.5 × 30, 머리 윗면 Z −3에서 위로, 볼트 1·4·8): 기계 부품과 겹침 **0** — 겹친 것은 로딩 자리에 놓인 매트·테이프 모형(MAT_L·G·V·W, TP_V_20a·TP_G_21a)뿐, 프로브 ↔ 롤러 4.408, ↔ 새들 카운터보어 벽 0.5(반지름 4.75 − 4.25), unchecked 0 — `model/savecheck_out.json` |

## 7. 서명·기록

- 서명(E-17): 저장 뒤 `ledger.py sigpatch --parts model/sig_parts.json --removed … --bolts model/sig_bolts.json` → 바뀜·새로 56, 없어짐 18(띠 묶음 17 + 가로대 `:2` 이름 1), 전체 3,224. `sigcheck`: **reuse**(문서·해시 71841ecb19e068fa 같음). `tools/out/bolts.json` 1,219(띠 볼트 8 빼고 `CB5-20_RX11` 8 넣음). 고치기 전 사본 `model/signatures_before.json`·`bolts_before.json`.
- 범위(`ledger.py scope`, `model/scope_after.json`): 바뀜 3(판 W2·E2, 이름 옮긴 가로대) · 새로 53 · 없어짐 18 · 이웃 247. 도구는 '전체 검사 아니오'로 냈지만 롤러 윗면은 매트가 얹히는 면(작업 대상 길)이다 — 검도는 매트 모형을 대상에 넣을 것(E-17 "작업 대상 길에 닿는 부품이 바뀌었으면 작업 대상 모형도 넣는다").
- 다시 실행 재료(E-25): `tools/out/mech_RX-11/edit.json`(131명령, 최종 길만) · `edit_meta.json`(base v2.16.0 → result v2.17.0). 생성기 `tools/gen_rx11.py` → `tools/out/mech_RX-11/model/stage_0~9_*.json`.
- 점검 원본: `tools/out/mech_RX-11/model/` — `r03_slots.json` · `r04_parts.json` · `r05_parts.json`(그리기·측정), `measured_new.json`(57바디 bbox·부피), `rest_new_x_new+panels.json` · `rest_new_x_neighbors.json` · `r22_drive.json`(틈), `jointlist_after.json`, `r30_presave.json`(조인트·이력·BOM), `savecheck_out.json`(저장본 CLI).

## 8. 문서 담당에게 넘길 것 (지시서 [12], U-09·E-10)

- 제어 순서 제약: U4+U5 회전 시간 키 새 값(5절 표). U5는 매트 위에서만 내린다는 조건 그대로 — 매트 없이 내리면 바퀴가 롤러에 닿지 않고 0.859 위에서 멈추므로 바닥 접촉을 신호로 쓰지 않는다.
- 조립 순서: 판·형재 → 새들을 위에서 끼우고 밑에서 클램프를 대어 CB5-20(죔 3 N·m) → 롤러에 축을 꿰어 위에서 내려놓음 → 새들 X를 맞춰 죔. 롤러 교체는 그 롤러만 위로 든다(M-02).
- BOM: 가공품 `P_RX11_SADDLE` ×8 · `P_RX11_CLAMP` ×8(A5052 밀링 잠정) 더함, `P_DC205_STRIP` · `P_DC205_DISC` ×8 뺌. 구매품 `RORLM20-6-L200` ×14 · `SFJ6-213` ×14(STEP 대기, 가격 미확인) · `CB5-20` +8 · `CB5-12` −8, `HFS8-4080-560` 3개 중 1개 추가 가공(윗면 통과 홈 48 × 11). 판 W2·E2 긴 홈 가공.
- 자료대기: D-200 '쓰는 곳'에 임시값(Ø20 × 200 × 7 × 2줄, Y ±11, 나눔 틈 16, 696ZZ) + `STEP대기_RORLM20-6-L200` · `STEP대기_SFJ6-213`(풀리는 조건: STEP 수령 → 바디 교체), D-97에 '띠 걷음(C-45)'.
- 요구서 7절 기록: 받침선 간격 22에서 매트 눌림·자국, 롤러 사이 틈 2 끼임, 나눔 틈 16, X 방향 미끄럼, 롤러 구름 저항 실측.
- 못 한 것: STEP 대기 2종, 가격, 롤러 외경 공차·흔들림, 판 살 처짐 FEA(D-16).

## 9. 디테일 기록 (수정 회차 안 씀, E-02)

| 번호 | 내용 | 수치 |
|---|---|---|
| RX-11-D1 | 새들 카운터보어 바깥 살(X 방향) | 2.25(M-03 합격선 1, 기본 2.5) |
| RX-11-D2 | 클램프 굽힘(볼트 3 kN 가정) | SF 1.69(설계 값) |
| RX-11-D3 | 판 E2 긴 홈 닫힌 끝 ↔ 원판 따냄 살 | 12(설계 값), 홈 가장자리 ↔ 볼 구멍 살 9.0 |
| RX-11-D4 | 새들 ↔ 볼 테 틈 | 1.52(조립 여유) |
| RX-11-D5 | 축 들림 막이 없음(홈이 위로 열림 — 롤러 교체를 위한 설계, 자중으로 앉음). X 방향은 새들 가운데 벽(틈 0.5 × 2)·새들 면(롤러 끝 틈 1.0 × 2)이 막음. 롤러 내장 베어링은 압입 아님(카탈로그 주) | 틈 0.5 · 1.0 |
| RX-11-D6 | 가로대 통과 홈 바닥 ↔ T홈 바닥 남는 살 | 1.5(설계 값), 바디 한 덩어리 확인 |

## 미완

| 항목 | 상태 | 이유 |
|---|---|---|
| `RORLM20-6-L200` · `SFJ6-213` 실물 STEP | 임시 형상 | 구매부가 못 받음(외부 조건, 실행 규칙 10) |
| FEA(새들·클램프·판 살) | 못 함 | 환경 없음(자료대기 D-16). 임시 STEP은 냄 |
| 매트 연구 자세(CYCLE_L·G·V·W)에서의 틈 실측 | 수치 논리로만(4절) | 앱 `motion.play` 약 9분/자세. 검도 과제 범위 검사·라운드 끝 회귀 몫 |

## 워크플로우 메모

1. **`timeline.dependents`가 큰 파일의 앞쪽 피처에서 30분 넘게 돌았다**(이력 3,712개, 4번 부름). 편집 스킬이 "Deleting: `timeline.dependents {feature}` first"라고 안내하는데, 이 파일에서는 그 한 줄이 앱을 30분 막고 재시작(다시 열기 약 15분)까지 갔다. 안내서 '원복'·'MCP 편집 묶음'에 "큰 파일에서는 `timeline.dependents`를 부르지 않는다 — `timeline.delete`의 `failing`과 지운 뒤 오류 수로 확인한다"를 적으면 좋겠다.
2. **앞쪽 피처를 지우면 그 뒤 전체가 다시 계산된다**(49피처 `timeline.delete` 9~13분, RX-06R의 끝쪽 22피처는 37 s). 지시서가 '지울 것'을 줄 때 그 피처의 이력 자리(앞·끝)를 보고 시간을 어림하게 하면 좋겠다.
3. **자기 요청이 응답 없이 도는 경우의 규칙이 없다.** 안내서 '앱 막힘'은 '다른 연결의 요청이 30분'만 재시작 조건으로 적는다. 이번처럼 이 부서의 요청이 MCP 응답만 끊기고(os error 10060, `pending`은 비어 있음) 앱에서 계속 도는 경우에도 같은 상한을 쓰는지 적어 두면 좋겠다(이번에는 30분에서 재시작).
4. **`component.paste_new`가 STEP + 끝면 오프셋 부품에서 "copy geometry differs"로 거부**됐다. 여러 자리가 한 정의를 쓰는 구매품 가운데 한 자리만 추가 가공할 때의 방법(`component.copy_bodies` → 옮김 → 옛 자리 지움)을 안내서에 적으면 다음에 시도 한 번을 줄인다. 이때 첫 자리를 지우면 괄호 없는 바디 이름이 다음 자리로 옮겨 가 서명 표의 '바뀜'으로 잡힌다.
5. **`motion.play`는 `quiet: true`여도 MCP 도구 응답이 2,000줄을 넘는다**(RX-12 메모와 같음, 세 번째). 이번에도 첫 호출에서 그대로 들어왔다 — 큰 응답 명령은 파일로 받는 통로를 엔진 도구로 두면 좋겠다.
