hyeunung/FSAP/docs/reports/mechanism/mech_RX-12_design.md

# 구동 RX-12 설계안 — 시험 매트 '긴 매트 + 넓은 오목'(WP_W, CYCLE_W1·W2)

## 요약

- **새로 만드는 것**: 작업 대상 모형 `MAT_W` 1500×700×10(긴 변 가운데 오목 500×300, 모서리 R 0 — 모두 임시 D-01·D-02·D-03), 컴포넌트 `WP_W_X`·`WP_W_Y`·`WP_MAT_W`, 모형용 조인트 `J_WP_W_X·Y·ROT`, 연구 `CYCLE_W1` 583단계 · `CYCLE_W2` 585단계(한 사이클 1,168단계를 오목 바닥 가운데에서 나눔, WF-126). 기계 부품·구매품·볼트 변경 0.
- **결과(평면 강체 계산 전 구간 + CAD 5자세 확인)**: +X로 넘어가는 최대 **X 1052.1**(W1 488단계, 오목 안 모서리2 회전 ROT 253°), +X 넓이 최대 **550,000 mm²**(매트 900,000의 61.1 %, W1 439). 매트 높이 층의 고정 바디 14개와 겹침 0, +X 기둥까지 최소 **104.1**, 라이트커튼 1R·기둥 FR까지 325.4.
- **테이블이 모자란다(구동 후보)**: 볼 받침 밖 최대 **323,536 mm²**, 그 가운데 +X·−Y 포켓(작업자 자리) 위 **282,556 mm²**(W1 420~425, 오목 입구2 회전), X > 975(패널 끝 밖) 22,050 mm². 한 사이클 동안 받침 밖을 쓸고 가는 자리: 포켓 X 400~1026 · Y −1146~−200(468,800 mm²), +X 끝 X 900~1052 · Y −200~805(119,600 mm²). 이 과제에서는 고치지 않고 **RX-12-C1·C2**로 올린다.
- **먼 쪽 바퀴(U5)**: d₂ 440(J_U5_X 1360) 하나로 돈다. 오목 뒤 가운데 500 구간(매트 깊이 393.5 < d₂ 하한 420)과 오목 바닥에서는 매트 밖이라 들고, 오목 안 모서리 두 곳은 회전 45°에서 정지해 들기·내림(연구 정지 단계 W1 85·517, W2 67·500). 바늘 옆 바퀴(U4)는 전 구간 매트 위(들 일 없음).
- **0-8-5 고칠 안**: "매트는 늘 바늘의 −X 쪽"을 "볼록 외곽에서만 −X, 오목·홈에서는 +X로 최대 X 1052·넓이 55만~110만 mm²"로(7절).
- CAD 확인(읽기만, v2.15.2, MCP 14회): 이름 충돌 0, `MAT_L` 판을 새 매트 5자세에 덮어 놓은 틈 검사 겹침은 `TL_FEED` 75 mm³(기준선)뿐, 운동 약속(bbox) 계산값과 같음. 원복 뒤 dirty false · sha1 같음.
- 미완: 새 매트의 CAD 전 구간 간섭(모델링 뒤 검도), 테이프 조각 모형(RX-12-C3), 회전 시간 키 정식 계산(RX-12-C4, RX-11 뒤).

## 1. 출발점과 범위

| 항목 | 내용 |
|---|---|
| 출발점(basis) | 벤치마크 없음 — 작업 대상 모형은 0-8-3 유닛이 아니다. 형상 비례만 R375X 사진 `docs/images/r375x/decisions/q3_test_mat.png`(길이 : 깊이 약 2.3 : 1, 오목 폭 약 1/3, 오목 깊이 약 0.45 — 측정 보고서 4-2)을 임시값의 근거로 쓴다(실행 규칙 6 "경쟁 기계 사양을 우리 사양처럼 쓰지 않는다" → 자료대기 D-01·D-02 '쓰는 곳'). 모형·조인트·연구를 만드는 법은 앞 과제 VGR-01(`tools/gen_v2_vgr01.py`)·v2.15.2의 `CYCLE_V`·`CYCLE_L` 키 약속 그대로 |
| 구동 개념(0-8) | 바꾸지 않는다. 0-8-4 순서 그대로: ① 로딩 → ② 내림 → ③ 봉제 → ④ 모서리마다 바늘 꽂고 멈춤·노루발 낮은 누름(C-39)·바늘 중심 회전 → ⑤ 겹쳐 박기 → ⑥ 들기·배출. 0-8-2 ③ "내리는 조건: 바퀴 밑에 매트가 있고 d₂ ≥ 2·d₁ + 바퀴 묶음 폭" 그대로 |
| 하지 않는 것 | 테이블·포켓·기둥 구조 수정(과제 지시 "구조를 고치지 않고 구동 후보로"), 덮개(실행 규칙 14), 테이프 띠·조각 모형(과제 지시 "만들지 않아도 된다"), 구매품 |
| 규칙 | E-15 "기계의 모든 움직임은 CAD 조인트(슬라이드·회전)…로 정의한다", E-03 "동작 검사에는 항상 실제 작업 대상 모형…을 넣고", E-12 "모델로 확인할 수 없는 것(요구서 7)은 결함으로 붙잡지 않고 시제품 확인 항목으로 기록만", 요구서 6-4 "이송 행정(X·Y) 25 mm … 모서리 회전 구간은 5 mm·1°" |

## 2. 매트 형상(임시값)

매트 좌표(중심 원점, th 0에서 세계와 나란함). 대기 중심 **PARK (−343.5, −300)** — 시작 변(오목 없는 긴 변)이 X +6.5(땀–가장자리 e 6.5, D-78·D-144), 로딩 자리는 시작점에서 −Y 300(D-106).

| 항목 | 값 | 근거·임시 |
|---|---|---|
| 바깥 | 매트 x ±350(깊이 700) × y ±750(길이 1500), 두께 10 | 길이 1500 = D-01 최대, 깊이 700 = 사진 비례 2.3 : 1 가까운 값(1500 ÷ 2.3 = 652 → 700). 두께 D-04 |
| 오목 | 매트 −x 변 가운데, y ±250(폭 500) × x −350~−50(깊이 300), 모서리 R 0 | 폭 = 길이의 1/3, 깊이 = 매트 깊이의 0.43. R 0은 휘두름이 넉넉한 쪽(D-03 임시 볼록 R30·오목 R10보다 불리) |
| 다리 | 양쪽 500×300(오목 옆), 몸통 깊이 400 | 위에서 따라 나옴 |
| REST bbox | X −693.5~6.5 · Y −1050~450 · Z 0~10, 부피 9,000,000 mm³, 넓이 900,000 mm² | `MAT_L` REST(X −1493.5~6.5 · Y −1050~450) 안에 들어간다 — 로딩 자리는 새 문제 없음 |
| 오목 빈 곳(REST) | X −693.5~−393.5 · Y −550~−50 | |
| 땀 점(매트 좌표) | 시작 S0 (343.5, 0) → S2 (343.5, −743.5) → S3 (−343.5, −743.5) → S4 (−343.5, −256.5) → S5 (−43.5, −256.5) → 나눔 (−43.5, 0) → S6 (−43.5, 256.5) → S7 (−343.5, 256.5) → S8 (−343.5, 743.5) → S1 (343.5, 743.5) → 끝 (343.5, −30) | 외곽 안쪽 6.5. 땀 길이 4,978 mm(겹침 30 포함) |

민감도(측정 보고서 4-2, 같은 계산): 오목 폭 700이면 X 최대 1148.1(기둥 X 1150까지 1.9), 오목이 한쪽으로 치우치면(다리 300 / 700) X 최대 1244.8로 +X 기둥과 10,537~11,300 mm² 겹친다. 이 안은 가운데 오목 하나만 모형으로 넣고, 치우친 경우는 RX-12-C2의 수치로 남긴다.

## 3. 구동 방식·순서·자세

- 구동: 모형용 조인트 3개(`J_WP_W_X` 슬라이드 → `J_WP_W_Y` 슬라이드 → `J_WP_W_ROT` 회전, 원점 PARK, 한계 ±3000 mm · −360~720°, `model_only`). 매트 중심 c = −R(ROT)·p(p = 바늘 밑 땀 점), X = c_x + 343.5, Y = c_y + 300. 시계 방향으로 돈다(볼록 +90°, 오목 −90°): ROT 0 → 90 → 180 → 270 → 180 → 90 → 180 → 270 → 360.
- 단계 간격: 직선 25 mm, 오목 모서리 4곳(입구 2·안 모서리 2) 앞뒤 50 mm는 5 mm, 회전은 모두 1°(요구서 6-4).
- 다른 조인트 키는 v2.15.2 `CYCLE_V`와 같은 약속: 노루발 20 → 0(12~14) 뒤 끝까지 0(피벗 중에도 낮은 누름, C-39), 바늘 피벗 중 −30, `J_U6_PRESS` 봉제 −0.4 / 피벗 4.5, `J_U6_SHIFT` 0, `J_U4_PRESS` 0(전 구간), `J_U5_X` 1360, `J_U5_LIFT`·`FLOAT` 내림 −10·10 / 들림 30·0, `J_U7_*` 0, 다른 매트 `J_WP_L·S·G·V_*` 0.

| 연구 · 단계 | 구간 | ROT | X 최대 | +X 넓이 | 볼 받침 밖 | 포켓(X>400, Y<−300) | U5 |
|---|---|---|---|---|---|---|---|
| W1 0~12 | ① 로딩 → 시작(Y +300) | 0 | 6.5 | 0 | 0 | 0 | 들림 |
| W1 13~16 | ② 노루발·슈·U4 내림 | 0 | 6.5 | 0 | 0 | 0 | 들림 |
| W1 17~71 | ② 먼 쪽 대차 → J_U5_X 1360(바퀴는 든 채) | 0 | 6.5 | 0 | 0 | 0 | 들림 |
| W1 72~83 | ③ 뒤 긴 변 앞 반(오목 뒤 300) | 0 | 6.5 | 0 | 0 | 0 | 들림(밑이 오목 빈 곳) |
| W1 84~85 | 정지·U5 내림 | 0 | | | | | 내림 |
| W1 86~103 | ③ 뒤 긴 변(다리2 뒤 443.5) | 0 | 6.5 | 0 | 0 | 0 | 내림 |
| W1 104~197 | ④ 볼록 모서리 A | 0→90 | 9.2 | 7 | 0 | 0 | 내림 |
| W1 198~225 | ③ 옆 변 A 687 | 90 | 6.5 | 0 | 0 | 0 | 내림 |
| W1 226~319 | ④ 볼록 모서리 B | 90→180 | 9.2 | 7 | 0 | 0 | 내림 |
| W1 320~347 | ③ 다리2 끝 변 487 | 180 | 6.5 | 0 | 0 | 0 | 내림 |
| W1 348~441 | ④ 오목 입구2(볼록) | 180→270 | 1006.5 | **550,000** | **323,536** | **282,556** | 내림 |
| W1 442~469 | ③ 오목 벽2 300 | 270 | 1006.5 | 550,000 | 309,375 | 235,625 | 내림 |
| W1 470~516 | ④ 오목 안 모서리2 앞 45° | 270→225 | **1052.1** | 549,468 | 275,909 | 234,804 | 내림 |
| W1 517 | 정지·U5 들기(ROT 225) | 225 | 928.4 | 517,665 | 244,106 | 222,391 | 들기 |
| W1 518~564 | ④ 오목 안 모서리2 뒤 45°(U4 혼자) | 225→180 | 919.7 | 516,468 | 237,869 | 218,144 | 들림 |
| W1 565~583 | ③ 오목 바닥 앞 반 256.5 | 180 | 306.5 | 300,000 | 0 | 0 | 들림 |
| W2 0~19 | ③ 오목 바닥 뒤 반 256.5 | 180 | 306.5 | 300,000 | 0 | 0 | 들림 |
| W2 20~66 | ④ 오목 안 모서리1 앞 45°(U4 혼자) | 180→135 | 928.4 | 517,665 | 808 | 0 | 들림 |
| W2 67 | 정지·U5 내림(ROT 135) | 135 | | | | | 내림 |
| W2 68~114 | ④ 오목 안 모서리1 뒤 45° | 135→90 | 1052.1 | 550,000 | 116,458 | 3,250 | 내림 |
| W2 115~142 | ③ 오목 벽1 300 | 90 | 1006.5 | 550,000 | 114,490 | 750 | 내림 |
| W2 143~236 | ④ 오목 입구1(볼록) | 90→180 | 1006.5 | 550,000 | 74,550 | 0 | 내림 |
| W2 237~264 | ③ 다리1 끝 변 487 | 180 | 6.5 | 0 | 0 | 0 | 내림 |
| W2 265~358 | ④ 볼록 모서리 C | 180→270 | 9.2 | 7 | 0 | 0 | 내림 |
| W2 359~386 | ③ 옆 변 B 687 | 270 | 6.5 | 0 | 0 | 0 | 내림 |
| W2 387~480 | ④ 볼록 모서리 D | 270→360 | 9.2 | 7 | 0 | 0 | 내림 |
| W2 481~498 | ③ 뒤 긴 변(다리1 뒤 443.5) | 360 | 6.5 | 0 | 0 | 0 | 내림 |
| W2 499~500 | 정지·U5 들기 | 360 | | | | | 들기 |
| W2 501~514 | ③⑤ 뒤 긴 변(오목 뒤 300) + 겹쳐 박기 30 | 360 | 6.5 | 0 | 0 | 0 | 들림 |
| W2 515~518 | ⑥ 노루발·슈·U4 들기 | 360 | | | | | 들림 |
| W2 519~573 | ⑥ 먼 쪽 대차 → 0 | 360 | | | | | 들림 |
| W2 574~585 | ⑥ 배출(−Y 300) | 360 | 6.5 | 0 | 0 | 0 | 들림 |

넓이 단위 mm². 전체 범위: X −1646.7(W1 170)~1052.1(W1 488), Y −1493.5(W1 317)~1493.5(W1 103). 원본 `tools/out/mech_RX-12/design/envelope_w.json`(자세마다), `cycle_w.json`(자세·구간).

## 4. 근거 계산

### 4-1. 매트 ↔ 매트 높이 층 고정 바디(평면, 전 1,169자세)

매트(Z 0~10)에 닿을 수 있는 기계 바디는 측정 보고서 3-2의 14개(Z 0.5~18 층)뿐이다. 그 가운데 서 있는 기둥류 6묶음과 매트 외곽(5 mm 간격 점)의 최소 거리:

| 바디(평면 자리) | 겹침 mm² | 최소 거리 mm | 그 자세 |
|---|---|---|---|
| U1 기둥 +X `HFS8-80160-1090_M07:2` + `HFS8-4080-1090_M07_PX`(X 1150~1230 · Y 120~320) | 0 | **104.1** | W1 482(오목 안 모서리2, ROT 259) |
| U8 라이트커튼 `1R` + 기둥 `FR`(X 325~400 · Y −1640~−1560) | 0 | 325.4 | W1 317(볼록 모서리 B 끝) |
| U8 라이트커튼 `2R` + 기둥 `R`(X −2340~−2295 · Y 5~120) | 0 | 648.3 | W1 170 |
| U1 기둥 −X(X −2380~−2300 · Y 120~320) | 0 | 656.5 | W1 249 |
| U8 라이트커튼 `1E` + 기둥 `FL` · `2E` | 0 | 1070.7 · 1106.2 | W1 287 · 285 |

바늘 둘레: 바인더 Z 13(매트 윗면에서 3.0), 슈·노루발·바퀴는 매트 윗면 Z 10 맞닿음(기준선). `TL_FEED` ↔ 매트는 회전 중 75 mm³(기준선 "TL_FEED ↔ WP_MAT_* 회전·피벗 중").

### 4-2. 받침(완료 판정 ②)

| 정의 | 최대 넓이 mm² | 그 자세 | 한 사이클 동안 쓸고 간 자리(10 mm 격자) |
|---|---|---|---|
| 볼 받침 밖(볼 중심 + 반 피치 50) | **323,536** | W1 425(오목 입구2, ROT 256) | 588,400 mm², X 400~1052 · Y −1146~805 |
| 그 가운데 포켓(X > 400 · Y < −200, 볼 없음) | 323,536 | W1 425 | **468,800 mm²**, X 400~1026 · Y −1146~−200 |
| 포켓(X > 400 · Y < −300, 패널도 없음) | **282,556** | W1 420(ROT 251) | |
| 그 가운데 +X 끝(X > 900 · Y ≥ −200) | 116,458(W2 68~114) | W2 112 | 119,600 mm², X 900~1052 · Y −200~805 |
| X > 900 | 74,550 | W1 439 | |
| X > 975(패널·프레임 끝 밖) | 22,050 | W1 439 | |

받침 밖은 0이 아니다 → 과제 지시대로 구조를 고치지 않고 구동 후보 RX-12-C1(포켓)·C2(+X 끝)로 올린다(9절). 받침 없는 매트의 처짐·끌림은 모델로 판정하지 않는다(요구서 7절 기록, E-12).

### 4-3. 바퀴 접점이 매트 위인가

접점 선(바퀴 폭 25 = X −d ± 12.5, Y ± 3)의 9점이 모두 매트 안인지 전 자세에서 봤다(`cycle_w.json`).

| 바퀴 | 결과 | 근거 |
|---|---|---|
| U4(d₁ 100) | 내린 전 구간 매트 위(밖 0자세) | 오목 바닥에서도 몸통 깊이 393.5 > 112.5 |
| U5(d₂ 440) | 내린 전 구간 매트 위(밖 0자세). 든 구간: W1 0~84, W1 517~W2 66, W2 500~ | 오목 뒤 가운데 500 구간·오목 바닥은 매트 깊이 393.5 < d₂ 하한 420(J_U5_X 최대 1380)이라 어떤 d₂로도 매트 밖. 다리 쪽은 가장자리까지 41(493.5 − 452.5) |
| 정지 단계 | W1 85(시작 변, 땀 점이 오목 벽 선에서 50 지난 곳), W1 517(ROT 225), W2 67(ROT 135), W2 500(벽 선 50 앞) | 오목 안 모서리에서 U5 접점은 회전 약 63°에서 뒤 변을 넘는다(sin⁻¹(393.5 ÷ 440)) → 45°에서 들기, 반대쪽도 약 27°부터 매트 위 → 45°에서 내림 |

### 4-4. 회전력 손계산(참고 — 완료 판정 항목 아님)

식은 `tools/out/mech_VGR-01/fix1calc.py`와 같다(면밀도 6 kg/m², 바퀴 μ 0.4, U4 40 N·0.1 m, U5 40 N·0.44 m, 볼 구름 0.02, U5 밑 띠 μs 0.30, 원판 끌림·관성, 노루발 끌림 0.096 N·m, 정지→정지 삼각 속도). 매트 5.4 kg. `handcalc_w.json`.

| 회전 | 바퀴 | 땀 점 둘레 관성 kg·m² | 남는 토크 N·m | SF 1 최소 시간 s | 띠 없을 때(RX-11 뒤) s | 임시 시간 키(×1.1, SF 약 1.05) s |
|---|---|---|---|---|---|---|
| 볼록 모서리 A·D 90° | U4+U5 | 4.876 | 2.308 | 3.65 | 2.01 | 4.1 |
| 볼록 모서리 B·C 90° | U4+U5 | 5.123 | 2.279 | 3.77 | 2.07 | 4.2 |
| 오목 입구2·1 90° | U4+U5 | 2.493 | 2.542 | 2.49 | 1.42 | 2.8 |
| 오목 안 모서리 45°(U5 내린 쪽) | U4+U5 | 1.758 | 2.677 | 1.45 | 0.84 | 1.6 |
| 오목 안 모서리 45°(U4 혼자) | U4 | 1.758 | 0.917 | 2.47 | 2.47 | 2.8 |

회전 합 약 31.0 s, 봉제 4,978 mm ÷ 133 mm/s 약 37 s. 형상·하중 경로가 바뀐 가공품이 없어 FEA 대상 없음(E-18), 환경도 없음(D-16). 받침 밖으로 나간 넓이(최대 36 %)의 끌림은 이 식에 없다 → 시간 키는 임시이고 RX-12-C4로 올린다.

## 5. CAD에서 직접 확인한 것(읽기만, WF-016·017)

대상 `3D_Modeling/FSAP_v2.15.2.sc`(config.json doc, 앱에 열려 있던 것 — 같은 경로라 `open`은 다시 부르지 않음), MCP 14회(명령 목록 5 · 조회 5 · 체크포인트 1 · 측정 묶음 1 · 원복 2), 파일 열기 0.

| 확인 | 결과 |
|---|---|
| 문서 | 처음: name `FSAP_v2.15.2`, dirty false, 타임라인 3,709(오류 0), `running` 빈 목록 |
| 이름 충돌 | `MAT_W`·`WP_W_*`·`WP_MAT_W`·`J_WP_W_*`·`CYCLE_W*` 0건(설계 조회 1.3 MB·`motion_list.json` 검색) |
| 운동 약속 | `MAT_L`을 `J_WP_L_X·Y·ROT` (1000, −443.5, 270)에 → bbox X −493.5~1006.5 · Y −1493.5~6.5(계산과 같음), (859.125, −199.115, 253) → X −820.9~**1052.13**(계산 1052.1) |
| 틈 검사 5자세 | `MAT_L`(1500×1500 — 새 매트를 매트 x +400 치우쳐 덮는 판)을 W1 439 · W1 488 · W2 112 · W1 170 · W1 317 자세에 놓고 `inspect.clearance {bodies:[MAT_L], against: 40바디, clearance: 30}`. 쌍 31~36, unchecked 0. **겹침은 `TL_FEED` 75.0 mm³(X 6.5~7.5 · Y −9~−1.5, 기준선) 3자세뿐, 나머지 2자세 0.** 맞닿음 0.0: `P_DC205_STRIP`·`STEP대기_867-392342_LOWER`·`P_M02_DISK`(밑면 Z 0). 가까운 것: 원판 볼트 0.5(아래), **바인더 3.0**, 슈 7.0(REST), 바늘 9.0(REST), **카세트 판 10.0** — 측정부 값과 같다 |
| against 40 | 서명(v2.15.2)에서 5자세 판 bbox + 30 · Z −1~40에 걸치는 볼·작업 대상 아닌 바디 전부(`probe_plan.json`): +X 기둥 2, 라이트커튼 1R·FR, 바늘 둘레 36 |
| 원복(E-08) | `joint.drive` 0 복귀 → `edit.restore_checkpoint 64` restored true → `motion.play REST 0` **moved false**. 끝 조회: dirty **false**, 타임라인 3,709, 바디 정의 879, 파일 sha1 `1aa0397a928ba8bd…` 그대로 |
| 새 볼트·살 두께·렌치 길 | 해당 없음(기계 부품·볼트 0) |

원본 `tools/out/mech_RX-12/design/probe_design_v2152.json`. 판이 새 매트보다 넓어(오목과 뒤쪽 800을 덮음) 이 검사는 넉넉한 쪽이다. 새 매트 자체의 전 구간 CAD 간섭은 모델링 뒤 검도가 본다.

## 6. 모델링 지시서

구매품·볼트 형번: **없음**(stepcheck 대상 0, needs_step 없음). 가공품: 없음. 새 컴포넌트 3개(`WP_W_X`·`WP_W_Y`·`WP_MAT_W`)가 생긴다.

1. **생성기**: `tools/out/mech_RX-12/design/rx12_design.py`를 `tools/gen_rx12.py`로 옮겨(출력 폴더 `tools/out/mech_RX-12/model/`, `rx12_common.py` 경로만 고침) 돌린다. 돌리기 전에 지금 문서의 `motion.list`를 `motion_list_before.json`으로 받아 `study_others.json`을 그 값으로 다시 만든다(연구 키는 통째로 갈아 끼워진다).
2. **바디**(`stage_1_bodies.json`): `solid.box` 700×1500×10, corner (−693.5, −1050, 0), 이름 `MAT_W` → `solid.box` cut 301×500×12, corner (−694.5, −550, −1), target `MAT_W`. 기대: bbox X −693.5~6.5 · Y −1050~450 · Z 0~10, 부피 **9,000,000 mm³**, 오목 빈 곳 X −693.5~−393.5 · Y −550~−50. 재질 Default(모형), 색·표시는 `MAT_V`와 같게.
3. **컴포넌트·조인트**(`stage_2_joints.json`): 루트에 `WP_W_X`·`WP_W_Y`·`WP_MAT_W`, `MAT_W`를 `WP_MAT_W`로 옮김. `J_WP_W_X` slider `U1_FRAME:1` → `WP_W_X:1` z [1,0,0], `J_WP_W_Y` slider `WP_W_X:1` → `WP_W_Y:1` z [0,1,0], `J_WP_W_ROT` revolute `WP_W_Y:1` → `WP_MAT_W:1` z [0,0,1]. 원점 모두 (−343.5, −300, 0), `flip: true`, 한계 ±3000 · ±3000 · −360~720(실행 규칙 8 "flip을 안 주면 뒤집힌다").
4. **연구**: `motion.study` `CYCLE_W1`(583단계) · `CYCLE_W2`(585단계)를 `study_CYCLE_W1.json`·`study_CYCLE_W2.json`대로. 기존 연구 9개는 `study_others.json`(기존 키 그대로 + `J_WP_W_X·Y·ROT` 0 키)으로 — VGR-01 `_keys_WP_V`와 같은 방식. 완료 판정 ⑤ '기존 연구 5개 키 변화 0'은 **기존 키의 점·값 변화 0**으로 읽고, 적용 전후 `motion.list`를 대조해 차이가 `J_WP_W_*` 추가뿐인지 수치로 남긴다.
5. **자기 점검(E-15)**: `motion.play` 뒤 `MAT_W` bbox가 아래와 같은지(`check_poses_w.json`).

| 연구·단계 | J_WP_W_X · Y · ROT | bbox X · Y |
|---|---|---|
| W1 0 | 0 · 0 · 0 | −693.5~6.5 · −1050~450 |
| W1 85 | 0 · 600 · 0 | −693.5~6.5 · −450~1050 |
| W1 170 | −475.5092 · 302.9 · 65 | −1646.7~8.6 · −631.3~637.1 |
| W1 420 | 474.1929 · −108.2939 · 251 | −692.4~953.8 · −983.4~166.8 |
| W1 439 | 600 · −43.5 · 270 | −493.5~1006.5 · −693.5~6.5 |
| W1 488 | 576.074 · 183.4074 · 253 | −587.0~**1052.1** · −670.6~437.4 |
| W1 583 = W2 0 | 300 · 300 · 180 | −393.5~306.5 · −750~750 |
| W2 67 | 494.1137 · 512.132 · 135 | −627.2~928.4 · −565.7~989.9 |
| W2 112 | 600 · 343.5 · 90 | −493.5~1006.5 · −306.5~393.5 |
| W2 585 | 0 · 30 · 360 | −693.5~6.5 · −1020~480 |

   회전 방향 확인(W1 439는 bbox가 좌우 대칭이라 bbox로는 뒤집힘을 못 본다): W1 439에서 오목 빈 곳이 **바늘 +X 옆(X 6.5~506.5 · Y −293.5~6.5)** 에 와야 한다 → `MAT_W` ↔ `P_M05_CST_PLATE`(X 50~58 · Y −200~−40 · Z 20~) 거리가 **44.6**(√(43.5² + 10²))이어야 한다. 회전이 뒤집혔으면 매트가 판 밑에 있어 10.0이 나온다. W1 488 bbox(비대칭)도 함께 본다.
6. **과제 범위 간섭(E-17, 저장본에 CLI)**: `motion.interference` `CYCLE_W1`·`CYCLE_W2`, occurrences [`WP_MAT_W:1`], against = 작업 대상(`WP_*`) 아닌 기계 occurrence 전부, samples 단계 + 1(584 · 586), `budget_s` 넉넉히, **truncated false 확인**(실행 규칙 8). 기대: `TL_FEED` ≤ 75 mm³(회전·피벗 중, 기준선), `U3_NEEDLE_PIN` ↔ `MAT_W` 약 20 mm³(바늘 −30, 기준선), 그 밖 0. 오래 걸리면 against를 유닛 묶음으로 나눈다.
7. **machine.json**(완료 판정 ⑤): `joints`에 `J_WP_W_X·Y·ROT`(slide·slide·rotate, unit `WP_W`, origin [−343.5, −300, 0], rest 0, 한계 위와 같음, `model_only: true`), `units.WP_W`(parts [`MAT_W`], moving, workpiece), `studies.CYCLE_W1`·`CYCLE_W2`(steps, workpiece [`WP_MAT_W:1`], mat "1500x700 오목 500x300 가운데(D-01·D-02 임시)", d2 440, 구간 단계는 3절 표), 기존 연구에 `_keys_WP_W` 메모, `states`에 W1 85 · 420 · 439 · 488 · 516 · 517 · 583, W2 66 · 67 · 112 · 500 · 585, `workpiece_stages`에 "WP_W: before = MAT_W만(테이프 띠·조각 없음, RX-12-C3)", `baseline_overlaps`의 "WP_*_L·S·G·V ↔ 다른 WP_*" 줄에 W 더함, `temp_values`에 이 형상, `_timing.CYCLE_W`(4-4 표의 임시 시간 키, '임시 — RX-12-C4'), `doc`를 새 버전으로.
8. **저장 상태**: `motion.play REST 0`, 조인트·스케치 표시 숨김(실행 규칙 19), `WP_MAT_W` 표시는 `WP_MAT_V`와 같게, 문서 이름을 새 버전 이름으로. 서명 `ledger.py sigpatch`(새 바디 `MAT_W` 1개).
9. **하지 않는다**: U2 테이블·패널·포켓·기둥·HMI 수정, `TAPE_W`·`SEAM_W`·`J_TP_W_*`, 구매품 추가.

### 설계검토서에 남길 제어 순서 제약(U-09 "PLC에 넘길 동작 순서 제약…은 설계검토서에 기록")

- 먼 쪽 바퀴는 접점(X −d₂ ± 12.5)이 매트 가장자리에서 안쪽으로 있을 때만 내린다. 이 매트에서 d₂ 440이면 **오목 뒤 가운데 500 구간과 오목 바닥에서는 내리지 않는다**(매트 깊이 393.5 < d₂ 하한 420).
- 오목 안 모서리(−90°): 들어갈 때 회전 45°에서 멈춰 먼 쪽 바퀴를 든 뒤 나머지 45°는 바늘 옆 바퀴 혼자, 나올 때는 45°까지 혼자 돈 뒤 멈춰 내린다.
- 오목 벽을 박는 동안(W1 348~564, W2 68~236) 매트가 +X·−Y 포켓과 X 900 밖으로 나간다 — 그 자리에 사람·물건이 있으면 안 된다(RX-12-C1이 풀릴 때까지).

## 7. 0-8-5 고칠 안(완료 판정 ④)

지금: "매트는 늘 바늘의 −X 쪽: 1500×1500이면 휘두름 영역 X 약 2.1 m × Y 약 3.0 m = 볼 테이블 크기."

고칠 안: "**매트 몸통이 바늘의 −X 쪽에만 있는 것은 볼록 외곽(직선·볼록 모서리)을 박을 때뿐이다**(+X로는 모서리 회전 중 9.2 mm). **오목·홈을 박을 때는 매트의 큰 부분이 바늘 +X로 넘어간다**(C-47): 좁은 U홈 매트(1200×1200)는 홈 바닥을 돈 뒤 X 최대 929.4 · +X 넓이 1,095,000 mm²(매트의 76 %), V홈 매트 914.7 · 935,308 mm², 긴 매트 + 넓은 오목(임시 1500×700, 오목 500×300)은 **X 최대 1052.1 · +X 넓이 550,000 mm²(61 %)**. 휘두름 영역은 X 약 −2112~+1052(3.2 m) × Y ±1494(3.0 m). 볼 테이블은 +X 쪽에서 볼 X ≤ 900(패널 975), X > 400에서는 Y ≥ −200까지뿐이라, 오목 벽을 박는 동안 매트 최대 323,536 mm²가 받침 밖(+X·−Y 작업자 포켓 위 282,556 mm²)에 놓인다 → 구동 후보 RX-12-C1·C2." U홈·V홈 값은 측정 보고서 4-1(연구 키 계산), 새 매트 값은 이 보고서 3·4절. 검도가 CAD 전 구간으로 확인한 값으로 문서 담당이 요구서·설계검토서에 옮긴다.

## 8. 규칙 자기 점검(E-14)

| 규칙(원문) | 판정 | 근거 |
|---|---|---|
| E-03 "작업 대상·떨어진 조각·이웃 유닛과 겹치지 않고" | 맞음 | 4-1 겹침 0·최소 104.1, 5절 CAD 5자세 겹침 = 기준선뿐. 떨어지는 조각 없음(`workpiece_stages.fragments`) |
| E-15 "부품 이름 목록으로 위치를 직접 옮기지 않는다" | 맞음 | 조인트 3개 + 연구 키 |
| E-02 "핵심 원리·간섭 푸는 방법·유닛 나누기·배치·타이밍은 바꾸지 않는다" | 맞음 | 기계 부품 0. 받침 부족은 고치지 않고 후보 |
| M-06 "카탈로그 허용치를 확인하고" · U-08 · U-07 · E-10 | 해당 없음 | 구매품 0(catalog.md rows 0) |
| U-14 "로봇·로봇용 기성 유닛…은 후보로도 꺼내지 않는다" · U-12 · M-04 · U-10 | 해당 없음 | 가공품·볼트 0 |
| U-01 "핵심 기능…정밀도는 비용보다 앞선다" | 해당 없음 | 모형 |
| M-07 "조인트…는 실제로 함께 움직이는 관계대로" | 맞음 | 매트 조인트는 모형용(`model_only`, 실행 규칙 20 "모형용, 기계 축 아님") |
| 실행 규칙 6 "경쟁 기계 사양을 우리 사양처럼 쓰지 않는다" | 맞음 | 사진 비례는 임시값 근거로만, 자료대기에 적음 |
| E-12 "모델로 확인할 수 없는 것…은 … 기록만" | 맞음 | 받침 밖 매트 처짐·오목 모서리 R 0에서 테이프 굽음 → 9절 7절 기록 |

## 9. 구동 후보·7절 기록·임시값

| id | 무엇 | 자리·수치 | 지금 있는 것 |
|---|---|---|---|
| **RX-12-C1** | +X·−Y 포켓 위로 매트가 나간다(받침 없음, 작업자 자리와 겹침) | 최대 282,556 mm²(패널 기준) / 323,536 mm²(볼 기준), W1 348~564(오목 입구2 회전 ~ 벽2 ~ 안 모서리2). 쓸고 간 자리 X 400~1026 · Y −1146~−200, 468,800 mm². 측정부 어림: 1500×1500 깊이면 723,858, 1000×500이어도 58,493 | 볼·패널 없음(작업자 자리 D-107 "포켓 X 400~1160 Y ≤ −250"), 밑 가로대 `HFS8-4080-1720_M04` Z −172~−92 |
| **RX-12-C2** | 테이블 +X 끝이 모자라고 +X 기둥이 가깝다 | X 최대 1052.1(볼 받침 900에서 152.1, 패널 975에서 77.1 밖), X > 900 넓이 74,550 · X > 975 22,050 mm², 쓸고 간 자리 X 900~1052 · Y −200~805. +X 기둥까지 104.1. 오목 폭 700이면 1.9, 치우친 오목이면 겹침 10,537~11,300 mm²(측정 4-2) | 볼 중심 X ≤ 850, 패널 ≤ 975, 기둥 X 1150~1230 · Y 120~320 |
| RX-12-C3 | 새 매트의 테이프 띠·조각 모형(가공 뒤 형상, SIM-01 방식) 없음 | E-03 "가공 뒤 형상…포함" 가운데 이 매트만 before 형상 | `WP_TAPE_L·S·G·V`만 |
| RX-12-C4 | 새 매트 회전 시간 키·SF 정식 계산 | 4-4 임시 키(4.1 · 4.2 · 2.8 · 1.6 · 2.8 s). 받침 밖 끌림·RX-11 롤러(띠 μs 항 없음) 반영 필요 | `_timing`에 CYCLE_W 없음 |

요구서 7절에 더할 기록: ① 받침 밖(포켓·X > 900)으로 나간 매트의 처짐·가장자리 끌림과 그때 바늘 둘레 매트 높이 ② 날카로운 오목 안 모서리(R 0)에서 바인더가 테이프를 감는 모양(모형은 `TL_FEED` 75 mm³ 겹침으로만 나옴) ③ 오목 뒤 가운데 500 구간을 바늘 옆 바퀴 혼자 잡고 박을 때 긴 매트 끝 흐름.

임시값(자료대기에 적음): 매트 1500×700×10 · 오목 500×300 가운데 · R 0(D-01·D-02·D-03), e 6.5(D-78·D-144), d₂ 440(D-152), 로딩 −Y 300(D-106), 받침 = 볼 중심 + 반 피치 50(D-96), 회전력 손계산 값(D-95·D-96·D-97·D-145).

## 10. 부품 수·비용

| 항목 | 값 |
|---|---|
| 기계 부품 | 더함 0 · 뺌 0(순 0) |
| 모형 | 바디 +1(`MAT_W`), 컴포넌트 +3, 조인트 +3, 연구 +2 |
| 세트 비용 | 변화 없음(구매품·가공품 0) |

## 11. 완료 판정

| 항목 | 만족 | 근거 |
|---|---|---|
| ① 새 매트 한 사이클 전 구간 과제 범위 간섭 0 | 예(설계 근거, CAD 전 구간은 검도) | 평면 전 1,169자세 고정 바디 겹침 0(최소 104.1), CAD 5자세 판 검사 겹침 = `TL_FEED` 75 mm³ 기준선뿐. 간격: 직선 25 · 오목 모서리 둘레 5 mm · 회전 1° |
| ② 뒷면이 전 구간 볼·롤러·원판 위(아니면 넓이·자리를 후보로) | 예(후보로 올림) | 받침 밖 0 아님: 최대 323,536 mm², 포켓 282,556, X > 975 22,050 → RX-12-C1·C2에 좌표·넓이 |
| ③ +X 최대 넓이를 결정로그에 | 예 | X 최대 1052.1, 넓이 550,000 mm²(61.1 %) — 결정로그 '구동 RX-12 설계안' |
| ④ 0-8-5 고칠 안 | 예 | 7절, 결정로그 |
| ⑤ machine.json에 새 매트, 기존 연구 키 변화 0 | 예(지시서) | 6절 7. `study_others.json`: 기존 키 점·값 그대로(`other_studies_existing_keys_unchanged: true`) + `J_WP_W_*` 0 키 |

## 미완

- 새 매트의 CAD 전 구간 간섭(`motion.interference`)은 모형이 생긴 뒤 검도가 한다. 이 보고서의 전 구간 값은 평면 강체 계산이다.
- 설계검토서·요구서 0-8-5·7절·5절 반영은 문서 담당.
- 회전 시간 키는 임시(4-4).

## 워크플로우 메모

- 과제 지시의 '+X 쪽 부품 자리'·문서 기준이 v2.13.0 값이다(실제 최신 v2.15.2). 측정부와 같이 config.json doc를 따랐다.
- `motion.play`는 `quiet: true`·`verbose: false`여도 키 조인트 153개 값을 다 돌려준다(원복 한 번에 약 2,000줄). 값 목록을 끄는 인자가 필요하다.
- `inspect_design`이 1.3 MB라 dirty 하나를 보려고 두 번 파일로 받았다(측정부와 같은 지적). `document.revision`은 dirty·경로를 주지 않는다.
- 완료 판정 ⑤ "기존 연구 5개 키 변화 0"과 앞 과제 약속(새 매트 조인트 0 키를 다른 연구에 더함)이 글자로는 부딪힌다. '기존 키의 점·값 변화 0'으로 읽었다 — 과제 정리부가 문구를 그렇게 쓰면 다시 판단하지 않아도 된다.
- 작업 대상 모형만 더하는 과제에도 구매품·볼트·렌치 접근 점검 지시가 그대로 붙는다(대상 0).

## 파일

| 파일 | 내용 |
|---|---|
| `tools/out/mech_RX-12/design/rx12_design.py` | 설계 계산·생성기 초안(자세·키·넓이·손계산) |
| `…/design/stage_1_bodies.json` · `stage_2_joints.json` | 바디·컴포넌트·조인트 명령 |
| `…/design/study_CYCLE_W1.json` · `study_CYCLE_W2.json` · `study_others.json` | 연구 키 |
| `…/design/cycle_w.json` · `envelope_w.json` · `swept_out_w.json` · `handcalc_w.json` · `check_poses_w.json` | 자세·구간, 넓이, 쓸고 간 자리, 회전력, 점검 자세 |
| `…/design/probe_plan.json` · `probe_design_v2152.json` | CAD 틈 검사 계획·결과 |
