hyeunung/FSAP/docs/reports/mechanism/mech_RX-12_model.md

# 구동 RX-12 모델링 — 시험 매트 '긴 매트 + 넓은 오목'(WP_W, CYCLE_W1·W2) v2.15.2 → v2.16.0

## 요약

- **저장**: `3D_Modeling/FSAP_v2.16.0.sc`(5,666,022 B, sha1 `b570eae7eefc9920…`). 새 컴포넌트 3개(`WP_W_X`·`WP_W_Y`·`WP_MAT_W`)라 가운데 자리 +1(E-05). 통로 MCP(앱), 저장 1회.
- **만든 것**: 바디 `MAT_W` 1500×700×10 − 오목 500×300(부피 9,000,000 mm³, REST bbox X −693.5~6.5 · Y −1050~450 · Z 0~10), 조인트 `J_WP_W_X·Y·ROT`, 연구 `CYCLE_W1` 583단계 · `CYCLE_W2` 585단계. 기계 부품·볼트·구매품 변경 0.
- **기존 연구 9개**: `J_WP_W_*` 0 키 27개만 더함. 기존 키 537개의 점·값 변화 0(`motion.list` 전후 대조).
- **자기 점검**: 조인트 방향 3개 맞음, 점검 자세 13개의 `MAT_W` bbox가 지시 값과 모두 같음(차 ≤ 0.05), 회전 방향 확인 W1 439 `MAT_W` ↔ `P_M05_CST_PLATE` **44.63**(지시 44.6).
- **틈 검사 13자세**(매트 ↔ 매트 높이 층 44바디): 겹침은 기준선뿐 — `U3_NEEDLE_PIN` 20.1 mm³(바늘 −30), `TL_FEED` 50.0~75.0 mm³(오목 안 모서리 회전 중). 그 밖 겹침 0, 가장 가까운 것 바인더 3.0 · 카세트 판 10.0 · +X 기둥 157.0(W1 488).
- **전 구간 간섭(저장본 CLI)**: 움직이는 유닛(U3~U7, 648바디 4묶음) `motion.interference` W1·W2 **truncated false**, 서 있는 유닛·매트 높이 층 53바디는 1,013자세 `inspect.clearance`. 겹침은 기준선 2종뿐 — 바늘 20.1 mm³, `TL_FEED` ≤ 75.0 mm³. `TL_FEED`는 오목 안 모서리 앞 직선 4단계(W1 466~469, W2 16~19)에도 나온다(기준선 문구 "회전·피벗 중"보다 넓음, 5-2).
- **지시와 다른 것**: `motion.interference`를 기계 전체 against로는 못 돌렸다(648바디부터 `too many bodies`). U1·U2·U8은 자세 훑기로 대신 봤다(5절).
- `tools/machine.json`에 조인트 3·유닛 `WP_W`·연구 2·상태 12 더함, 서명 `sigpatch`(새 바디 1). 안 묶인 부품 0, 타임라인 오류 0.
- 미완: 7절.

## 1. 절차·통로

| 단계 | 한 것 |
|---|---|
| 연결 | `running` 빈 목록. 앱에 `FSAP_v2.15.2`가 열려 있었다(같은 경로라 `open`은 다시 부르지 않음 — 같은 경로 open은 디스크를 다시 읽지 않는다). `inspect_design`: dirty **false**, 타임라인 3,709(오류 0, 경고 54 = 작업 전부터 있던 STEP 볼 미수입·불리언 재시도), 바디 정의 879. 파일 sha1 `1aa0397a928ba8bd…` = 설계부가 적은 값 |
| 이름 충돌 | `MAT_W`·`WP_W_*`·`WP_MAT_W`·`J_WP_W_*`·`CYCLE_W*` 0건 |
| 원복(E-08) | `edit.checkpoint` 65 → `motion.play REST 0` **moved false**(이미 대기) |
| 생성기 | `tools/out/mech_RX-12/design/rx12_design.py` → `tools/gen_rx12.py`(출력 `tools/out/mech_RX-12/model/`, 경로만 고침). 적용 직전 `motion.list` → `motion_list_before.json`(측정부 `motion_list.json`과 같음). 생성기 출력 8개 파일이 설계부 파일과 바이트까지 같다 |
| 그리기 | MCP `batch` 2회(바디 2단계 0.69 s, 이름 바꾸기 2 + 컴포넌트 3 + 옮기기 + 조인트 3) → 연구 11개(`motion.study`, 호출당 0.2~1.5 s) |
| 저장 전 | `joint.drive` W 조인트 0 → `motion.play REST 0`(1.8 s) → `MAT_W` 숨김, 조인트 587·스케치 299 숨김(실행 규칙 19), `document.metadata.set description` |
| 저장 | `save {path: 3D_Modeling/FSAP_v2.16.0.sc}` 한 번. 문서 이름은 경로를 따라 `FSAP_v2.16.0`, 저장 뒤 dirty **false**. `tools/config.json` doc → v2.16.0 |
| 저장 뒤 | 앱 편집 없음(읽기만: `inspect_design`·`component.list`·이름 확인용 `inspect.clearance` 1회·사본에서 도는 `motion.interference` `budget_s: 1` 5회 — 끝 dirty false). 저장본에 CLI 16회(5절), `ledger.py sigpatch` |

- **절차 2 '먼저 다른 이름 저장'과 다르게 한 것**: 실행 규칙 2("저장 전 대기 포즈 → `save {path: 새 번호 .sc}`", "`save {}`(덮어쓰기)는 쓰지 않는다", "저장 뒤에는 편집하지 않는다")와 안내서 '원복'("모델링부는 저장이 마지막 단계")을 따라 **새 번호로 끝에 한 번만** 저장했다. 먼저 저장하면 같은 새 파일에 한 번 더 덮어써야 한다. v2.15.2 파일은 건드리지 않았다(sha1 그대로).
- **연구 키를 보낸 방법**: `motion.study`는 키를 통째로 갈아 끼워서 기존 연구 9개(134 KB)와 새 연구 2개(48 KB)를 인자로 다시 보내야 한다. 손으로 옮겨 적지 않고 `tools/out/mech_RX-12/model/mcp_send.py`로 같은 MCP 서버(`solidcraft-cli mcp --allow-path …`, 앱 27878에 붙음)를 표준 입출력으로 띄워 생성기 파일을 그대로 `batch`로 보냈다. 앱에 열린 설계에 적용되고 화면에 보인다(CLI `run --save`가 아니다). 응답이 큰 읽기(`motion.play`·`motion.list`·`joint.list`·`inspect_design`)도 같은 방법으로 파일에 받았다.

## 2. 만든 것

| 종류 | 이름 | 내용 | 확인 수치 |
|---|---|---|---|
| 바디 | `MAT_W` | `solid.box` 700×1500×10 corner (−693.5, −1050, 0) → `solid.box` cut 301×500×12 corner (−694.5, −550, −1). 피처 `BOX_MAT_W`(98295) · `CUT_MAT_W_NOTCH`(98296) | bbox X −693.5~6.5 · Y −1050~450 · Z 0~10, 부피 **9,000,000.0 mm³**, 면 10, 닫힘. 오목 빈 곳 X −693.5~−393.5 · Y −550~−50 |
| 컴포넌트 | `WP_W_X`(98297) · `WP_W_Y`(98299) · `WP_MAT_W`(98301) | 루트 아래, `MAT_W`를 `WP_MAT_W`로 옮김(피처 98303) | 옮긴 뒤 bbox·부피 그대로 |
| 조인트 | `J_WP_W_X`(98304) | slider `U1_FRAME:1` → `WP_W_X:1`, z [1,0,0], 원점 (−343.5, −300, 0), flip true, 한계 −3000~3000 | +100 → bbox X −593.5~106.5(+100) |
| 조인트 | `J_WP_W_Y`(98305) | slider `WP_W_X:1` → `WP_W_Y:1`, z [0,1,0], 같은 원점, 한계 −3000~3000 | +100 → bbox Y −950~550(+100) |
| 조인트 | `J_WP_W_ROT`(98306) | revolute `WP_W_Y:1` → `WP_MAT_W:1`, z [0,0,1], 같은 원점, 한계 −360~720 | +90° → bbox X −1093.5~406.5 · Y −650~50(반시계, 중심 (−343.5, −300)) |
| 연구 | `CYCLE_W1`(98307) | 583단계, 키 31조인트(`study_CYCLE_W1.json`) | 저장된 키 = 보낸 키(점 수 같음, 값 차 최대 2.3e−13) |
| 연구 | `CYCLE_W2`(98308) | 585단계, 키 31조인트(`study_CYCLE_W2.json`) | 같음(값 차 최대 4.5e−13) |
| 재질·표시 | `MAT_W` | 재질 Default(모형, `MAT_L·S·G·V`와 같음), 색 지정 없음, 표시 숨김(`MAT_V`와 같음) | 숨긴 바디 97 → 98 |

지운 것: 없음. 구매품·볼트·가공품: 없음(stepcheck 대상 0, 임시 STEP 0).

## 3. 연구 대조(완료 판정 ⑤)

`motion_list_before.json` ↔ `motion_list_after.json`.

| 연구 | 단계 | 키 전 → 후 | 기존 키 점·값 변화 | 더한 키 |
|---|---|---|---|---|
| REST | 1 | 153 → 156 | 0 | `J_WP_W_X·Y·ROT` [[0,0],[1,0]] |
| CYCLE_S | 450 | 36 → 39 | 0 | 0 키 3 |
| CYCLE_L | 716 | 72 → 75 | 0 | 0 키 3 |
| CYCLE_G1 | 514 | 64 → 67 | 0 | 0 키 3 |
| CYCLE_G2 | 630 | 64 → 67 | 0 | 0 키 3 |
| MAINT_HEAD | 1 | 28 → 31 | 0 | 0 키 3 |
| SEAM_U7 | 32 | 28 → 31 | 0 | 0 키 3 |
| MAINT_U7 | 13 | 28 → 31 | 0 | 0 키 3 |
| CYCLE_V | 486 | 64 → 67 | 0 | 0 키 3 |
| 합 | | 537 → 564 | **0 / 537** | 27 |

연구 id·단계 수·키 순서도 그대로다. 새 연구 2개만 늘었다(9 → 11). trace 목록 변화 없음.

## 4. 검증 수치

### 4-1. 자기 점검 자세(E-15)

`MAT_W` bbox(X · Y), 기대값은 `check_poses_w.json`. Z는 모든 자세 0~10.

| 자세 | J_WP_W_X · Y · ROT | 잰 bbox X · Y | 기대와 차 | 놓은 방법 |
|---|---|---|---|---|
| W1 0 | 0 · 0 · 0 | −693.5~6.5 · −1050~450 | 0 | `motion.play` |
| W1 12 | 0 · 300 · 0 | −693.5~6.5 · −750~750 | 0 | `motion.play` |
| W1 85 | 0 · 600 · 0 | −693.5~6.5 · −450~1050 | 0 | `motion.play`(약 560 s) |
| W1 170 | −475.5092 · 302.9 · 65 | −1646.7~8.6 · −631.3~637.1 | 0 | `motion.play`(약 550 s) |
| W1 317 | 0 · −443.5 · 180 | −693.5~6.5 · −1493.5~6.5 | 0 | `joint.drive` 3개 |
| W1 420 | 474.1929 · −108.2939 · 251 | −692.4~953.8 · −983.4~166.8 | 0 | `joint.drive` |
| W1 439 | 600 · −43.5 · 270 | −493.5~1006.5 · −693.5~6.5 | 0 | `joint.drive` |
| W1 488 | 576.074 · 183.4074 · 253 | −587.0~**1052.1** · −670.6~437.4 | 0 | `joint.drive` |
| W1 517 | 494.1137 · 87.868 · 225 | −627.2~928.4 · −989.9~565.7 | 0 | `joint.drive` |
| W1 583 = W2 0 | 300 · 300 · 180 | −393.5~306.5 · −750~750 | 0 | `joint.drive` |
| W2 67 | 494.1137 · 512.132 · 135 | −627.2~928.4 · −565.7~989.9 | 0 | `joint.drive` |
| W2 112 | 600 · 343.5 · 90 | −493.5~1006.5 · −306.5~393.5 | 0 | `joint.drive` |
| W2 234 | 0 · 1050 · 180 | −693.5~6.5 · −493.5~1006.5 | 0 | `joint.drive` |
| W2 500 | 0 · 0 · 360 | −693.5~6.5 · −1050~450 | 0 | `joint.drive` |
| W2 585 | 0 · 30 · 360 | −693.5~6.5 · −1020~480 | 0 | `joint.drive` |

- **회전 방향**: W1 439 자세에서 `MAT_W` ↔ `P_M05_CST_PLATE` **44.63**(지시 44.6 = √(43.5² + 10²), 뒤집혔으면 10.0), 바인더 3.0, +X 기둥 `HFS8-80160-1090_M07:2` 184.2 · `HFS8-4080-1090_M07_PX` 309.9. 비대칭 bbox(W1 420·488)도 지시 값과 같다.
- **`motion.play`가 느리다**: W1 85·170으로 가는 재생이 한 번에 약 9분 걸렸다(REST로 돌아오는 재생은 1.8 s, W 조인트만 모는 `joint.drive`는 0.2~1.7 s). 그래서 W1 317부터는 기계를 W1 170 상태(노루발 0 · 바늘 −30 · 슈 4.5 · 바늘 옆 바퀴 내림 · 먼 쪽 대차 1360 · 먼 쪽 바퀴 내림)에 둔 채 매트 조인트 3개만 연구 키 값으로 몰았다. 매트 자리는 연구 키와 같지만, 그 자세의 바늘·슈·먼 쪽 바퀴 승강 상태는 W1 170 것이다(단계마다의 기계 상태는 5절 전 구간 검사가 본다).

### 4-2. 넘기기 전 틈 검사(E-22, `inspect.clearance {bodies: [MAT_W], against: 44, clearance: 30, skip_within: component}`)

against 44 = 서명(v2.15.2)에서 점검 자세 13개의 매트 bbox + 30 · Z −1~40에 걸치는 볼·작업 대상 아닌 바디 36(먼 쪽 대차 유닛은 +1360 옮긴 자리도 봄) + 바퀴 몸통·먼 쪽 바퀴 받침 6 + +X 기둥 2. 쌍 37~42, unchecked 0, truncated false. 원본 `tools/out/mech_RX-12/model/selfcheck_clearance.json`.

| 자세 | 겹침 mm³ | 바인더 | 카세트 판 | 노루발 | 슈 | 바늘 옆 바퀴 띠 | 먼 쪽 바퀴 몸통 |
|---|---|---|---|---|---|---|---|
| W1 85(재생 상태: 바늘 0 · 슈 −0.4) | 0 | 3.00 | > 30 | 2.00 | 2.10 | 0.04 | 10.00 |
| W1 170(재생 상태: 바늘 −30 · 슈 4.5) | 바늘 20.1 | 3.00 | > 30 | 2.00 | 24.35 | 0.01 | 10.00 |
| W1 317 | 바늘 20.1 | 3.00 | > 30 | 2.00 | 7.00 | 0.01 | 10.00 |
| W1 420 | 바늘 20.1 | 3.00 | > 30 | 2.00 | 13.88 | 0.01 | 10.00 |
| W1 439 | 바늘 20.1 | 3.00 | 44.63 | 2.00 | 7.00 | 0.01 | 10.00 |
| W1 488 | 바늘 20.1 · `TL_FEED` 75.0 | 3.00 | 10.00 | 2.00 | 7.00 | 0.01 | 10.00 |
| W1 517 | 바늘 20.1 · `TL_FEED` 75.0 | 3.00 | 10.00 | 2.00 | 7.00 | 0.01 | 10.00 |
| W1 583 | 바늘 20.1 | 3.00 | > 30 | 2.00 | 7.00 | 0.01 | > 30(오목 빈 곳 위) |
| W2 67 | 바늘 20.1 · `TL_FEED` 75.0 | 3.00 | 10.00 | 2.00 | 7.00 | 0.01 | 10.00 |
| W2 112 | 바늘 20.1 · `TL_FEED` 50.0 | 3.00 | > 30 | 2.00 | 7.00 | 0.01 | 10.00 |
| W2 234 | 바늘 20.1 | 3.00 | > 30 | 2.00 | 7.00 | 0.01 | 10.00 |
| W2 500 | 바늘 20.1 | 3.00 | > 30 | 2.00 | 7.00 | 0.01 | 10.00 |
| W2 585 | 바늘 20.1 | 3.00 | > 30 | 2.00 | 7.00 | 0.01 | 10.00 |

- 겹침은 모두 기준선이다(`machine.json` baseline_overlaps "U3_NEEDLE ↔ WP_* 바늘 꽂음 20.1", "TL_FEED ↔ WP_MAT_* 회전·피벗 중"). 지시서 기대(바늘 약 20, `TL_FEED` ≤ 75)와 같다. W1 317부터의 바늘 20.1은 기계를 W1 170(바늘 −30) 상태에 둔 탓이고, 연구의 봉제 단계에서는 바늘이 0이다.
- 맞닿음 0.0(부피 0): `P_DC205_STRIP` · `P_M02_DISK` · `STEP대기_867-392342_LOWER`(매트 밑면 Z 0), `TL_FEED`(회전 0° 자세). 원판 볼트 `CB5-16_M02_19~21` 0.5(매트 아래).
- 새 겹침 0. W1 488 +X 기둥까지 157.0(설계 계산의 최소 104.1은 W1 482 — 전 구간 검사 범위).

### 4-3. 숨김·리지드·안 묶인 부품·재질(E-09·E-11)

| 항목 | 결과 |
|---|---|
| 숨김(E-11) | 숨긴 바디 98 = 작업 전 97(`MAT_S`·`MAT_G`·`MAT_V`, `SEAM_*`, `TP_S·G·V_*` 조각 — 작업 대상 모형, 표시만 끔) + `MAT_W`. 조인트 587 · 스케치 299 숨김(규칙 19). 숨긴 바디도 `inspect.clearance`에 들어간다(4-2가 `MAT_W`를 쟀다) |
| 안 묶인 부품(E-11) | `joint.list` floating **[]**, conflicts [], errors []. 조인트 584 → 587(rigid 393 · slider 185 · revolute 9). `WP_W_X`·`WP_W_Y`·`WP_MAT_W`는 `U1_FRAME:1`(접지)까지 조인트 사슬로 이어진다 |
| 리지드 그룹 | 새 볼트·부품 없음. `WP_MAT_W`에 묶을 테이프 띠 없음(RX-12-C3) |
| 재질(E-09) | 새 가공품 0. `matcheck.py`: 불일치 2건은 작업 전부터 있던 우레탄 표기(`P_M02·M03_WHEEL_TREAD` 'Urethane_A70' ↔ BOM '우레탄 A70'), 'BOM에 없는 부품 `P_M04_INSERT`'도 작업 전 그대로. 새 불일치 0 |
| 타임라인 | 3,709 → 3,712(상자 2 + 바디 옮기기 1), 오류 0, 경고 54(작업 전과 같음) |
| 대기 상태 | 저장 직전 REST: `J_U3_PRESSER` 20 · `J_U4_PRESS` 13.006 · `J_U5_X` 0 · `J_U5_LIFT` 30 · `J_WP_W_X·Y·ROT` 0. 14바디(`MAT_L·S·G·V`, 두 바퀴, 노루발, 바늘, 슈, 카세트 판, `TL_FEED`, 원판 등) bbox·부피가 서명(v2.15.2 REST)과 차 0 |

### 4-4. 저장 확인

| 항목 | 값 |
|---|---|
| 앱 | 저장 뒤 `inspect_design`: name `FSAP_v2.16.0`, path `…/3D_Modeling/FSAP_v2.16.0.sc`, dirty **false**, 타임라인 3,712, 바디 정의 880 |
| 파일 | 5,666,022 B, sha1 `b570eae7eefc9920fd1991749a31c66e5f4285ba`. v2.15.2 sha1 `1aa0397a…` 그대로 |
| 저장본 CLI | 5절 표의 '저장본 측정' 줄 |
| 서명 | `ledger.py sigpatch --parts tools/out/mech_RX-12/model/sig_parts.json` → 바뀜 1(`WP_MAT_W/MAT_W` 새로), 없어짐 0, 전체 3,189. `sigcheck`: reuse(문서·해시 같음). 볼트 변경 없음 |

## 5. 전 구간 간섭 — 저장본 CLI(지시서 6, 완료 판정 ①)

지시서 6은 `motion.interference`를 `WP_MAT_W:1` ↔ 작업 대상 아닌 기계 occurrence 전부로 돌리라고 했다. 한 번에는 안 돼서(아래 5-1) 움직이는 유닛은 `motion.interference`, 서 있는 유닛은 매트 자세 훑기(`inspect.clearance` 청크, 안내서 '동작 검사' WF-126 "`inspect.clearance`를 청크로 돈다")로 나눠 봤다. 모두 저장본 `FSAP_v2.16.0.sc`에 CLI `run --results`(저장 안 함).

### 5-1. 첫 시도 — 유닛 큰 묶음(실패, 결과 없음)

| 묶음 | against | 바디 수 | 결과 |
|---|---|---|---|
| A | U3·U4·U5·U6·U7 루트 occurrence 93개 | 648 | `too many bodies for a contact sweep` |
| B | `U1_FRAME:1` · `U8_PNEU:1` | 712 | 같은 오류 |
| C | `U2_TABLE:1` | 1,681 | 같은 오류 |

W1·W2 × 3묶음 = CLI 6개가 열기 약 25분 뒤 모두 이 오류로 끝났다(실패하면 앞 단계 결과도 안 남는다). 받는 한계를 앱에서 `budget_s: 1`로 물어 확인했다(사본에서 돌고 설계는 안 바뀜, dirty false 그대로): 164바디·209바디 묶음은 받음, 275바디는 거부.

### 5-2. 움직이는 유닛 — `motion.interference` 전 구간(`cli/mi3_CYCLE_W1.json`·`mi3_CYCLE_W2.json`, 결과 `cli/mi3_summary.json`)

occurrences [`WP_MAT_W:1`], samples 584 · 586(단계 + 1), budget_s 1200, 검사 전 `browser.visibility all true`(숨긴 매트도 보이게, 저장 안 함). 묶음 목록 `cli/groups_A.json`.

| 묶음(against) | 바디 | 쌍 | CYCLE_W1 | CYCLE_W2 |
|---|---|---|---|---|
| A1: `U3_HEAD`·`U3_PRESSER`·`U3_NEEDLE`·`U4_WHEEL_N`·`U4_PRESS`·`U4_WHEEL`·`U4_DISK`·U4 X축·M01·M02 볼트 등 38 occurrence | 164 | 37 | truncated **false**, 584표본. `U3_NEEDLE:1` 20.10 mm³(104~196 · 226~318 · 348~440 · 470~563 = 피벗 4곳, 깊이 5.0) | truncated **false**, 586표본. `U3_NEEDLE:1` 20.10 mm³(20~113 · 143~235 · 265~357 · 387~479) |
| A2a: `U5_WHEEL_F:1` | 154 | 1 | truncated false, **clear true** | truncated false, **clear true** |
| A2b: `U5_CAR`·`U5_FLOAT`·`U5_WHEEL`·`U5_LIFT`·레일·벨트·케이블 베어·M03 볼트 등 35 occurrence | 121 | 34 | truncated false, **clear true** | truncated false, **clear true** |
| A3: `U6_SENSOR`·`U6_SHOE`·`U6_PRESS`·`U7_TAPE`·`U7_FIXED`·`U7_CST_STAGE`·`U7_CASSETTE`·`U7_ROLL_MOUNT`·`U7_TAPE_LINE`·`U7_TAPE_FEED`·`U4S_*` 등 19 occurrence | 209 | 17 | truncated **false**. `U7_TAPE_FEED:1`(`TL_FEED`) 겹침 107~163 · 229~285 · 351~407 · 466~564, 가장 깊은 단계(467) 부피 55.0 mm³ | truncated **false**. `U7_TAPE_FEED:1` 16~114 · 146~202 · 268~324 · 390~446, 55.0 mm³(17) |

- 겹친 쌍은 `U3_NEEDLE`(바늘 꽂음 20.1 mm³)과 `TL_FEED` 둘뿐이고 둘 다 기준선이다(지시서 기대 "U3_NEEDLE_PIN ↔ MAT_W 약 20 mm³", "TL_FEED ≤ 75 mm³"). 바퀴·원판·노루발·슈·카세트·바인더·먼 쪽 대차는 전 구간 겹침 0(맞닿음은 충돌로 안 나옴).
- `TL_FEED` 부피는 5-3의 자세별 값이 더 자세하다: 볼록 모서리·오목 입구 회전의 앞 57~62°에서 ≤ 31.0 mm³, 오목 안 모서리 둘레에서 **75.0 mm³**(= `TL_FEED`가 통째로 매트 안).
- **기준선 문구보다 넓은 곳 하나**: `TL_FEED` 겹침이 회전 단계뿐 아니라 오목 안 모서리로 들어가는 **직선 봉제 끝 4단계(W1 466~469, W2 16~19 — 안 모서리 앞 약 20 mm)** 와 바늘 빼기 단계(W1 563~564, W2 113~114)에도 나온다. 바늘 앞 테이프 조각(X 6.5~7.5 · Y −9~−1.5)이 R 0 오목 안 모서리의 가로 벽에 먼저 닿기 때문이다. 기준선 "TL_FEED ↔ WP_MAT_* (회전·피벗 중)"의 뜻(바인더 출구에서 테이프가 굽는 곳, 모델 판정 아님)은 같지만 단계는 '회전·피벗 중' 밖이다 → 검도·문서 담당이 기준선 문구에 '오목 안 모서리 앞 20 mm'를 더할지 정한다(설계 보고서 9절 7절 기록 ② "R 0 오목 안 모서리 테이프 굽음"과 같은 자리). 딱딱한 부품인 바인더(`P_M05_BINDER`)는 전 구간 매트 위 3.0에 있다.

### 5-3. 서 있는 유닛(U1·U2·U8)과 매트 높이 층 전부 — 매트 자세 훑기(`cli/sw_0~5.json`, 결과 `cli/sweep_summary.json`)

- 대상: 한 사이클 1,169단계의 매트 자세(같은 자세가 이어지는 단계를 뺀 **1,013자세**)마다 `joint.drive` `J_WP_W_X·Y·ROT` → `inspect.clearance {bodies: [MAT_W], against: 53, clearance: 5, skip_within: component}`. 6묶음 병렬(열기 약 27분 + 훑기 1~2.5분).
- against 53 = 서명에서 Z −1~40 층에 걸치는 볼·작업 대상 아닌 바디 **전부 47**(U1 기둥 4, U8 라이트커튼·기둥 7, `P_DC205_STRIP`, U3·U4·U6·U7 바늘 둘레 35) + 바퀴 몸통·먼 쪽 바퀴 받침 6. 이 층 밖(Z > 40 또는 < −1)의 U1·U2·U8 바디는 Z 0~10 평판인 매트와 닿을 수 없어 bbox로 뺐다(E-17 "bbox가 닿는 부품"). 볼 827개는 서명 윗면 Z 최대 **0.0**(= 매트 밑면, 맞닿음)이라 뺐다.
- 기계 자세는 대기(REST)다(서 있는 바디는 자세와 무관, 내려오는 부품은 5-2가 단계별로 봄).

| 항목 | 값 |
|---|---|
| 잰 자세 | 1,013 / 1,013(빠진 것 0), `joint.drive` 멈춤(held) 0, unchecked 0, truncated 0 |
| 겹침 | `TL_FEED`뿐 — 560자세, 최대 **75.0 mm³**. W1 106~167 · 228~289 · 350~411(≤ 31.0), 466~469 · 472~516 · 518~562(75.0), W2 16~19 · 22~66 · 68~112(75.0), 145~206 · 267~328 · 389~450(≤ 31.0) |
| 5 mm 안 | 맞닿음 0.0: `P_DC205_STRIP`·`STEP대기_867-392342_LOWER`·`P_M02_DISK`(밑면 Z 0), 원판 볼트 `CB5-16_M02_19~21` 0.5(매트 아래), 바인더 **3.0** |
| 그 밖 47바디 | 전 자세 5 mm 밖 — +X 기둥·라이트커튼·카세트 판(13자세 점검에서 10.0)·U6 포함 |

### 5-4. 저장본 측정(저장 확인, `cli/res_savecheck.json`)

| 항목 | 값 |
|---|---|
| 바디 | 3,189(서명 3,188 + `MAT_W`). 서명과 이름 차이 0 |
| 안 바꾼 부품 위치 | 3,188바디 bbox 최대 차 **0.0005 mm**, 부피 차 0(허용 0.05 mm · 1e−4 밖 0건 — `REF_NEEDLE_AXIS_MARK` 부피 3.1416 ↔ 서명 반올림 3.141 한 건은 반올림 차) |
| `MAT_W` | bbox X −693.5~6.5 · Y −1050~450 · Z 0~10, 부피 9,000,000.0, 닫힘 |
| 연구 | `motion.list` 11개 = 앱에서 받은 `motion_list_after.json`과 같음 |
| 조인트 | 587, floating [], conflicts [], 표시 587개 모두 숨김. 대기 값: `J_U3_PRESSER` 20 · `J_U4_PRESS` 13.006 · `J_U5_X` 0 · `J_U5_LIFT` 30 · `J_U6_SHIFT` −60 · `J_U6_PRESS` 4.5 · `J_WP_W_*` 0 |

### 5-5. 완료 판정에 대는 값

| 완료 판정 | 모델링부가 본 것 | 남은 것 |
|---|---|---|
| ① 새 매트 전 구간 과제 범위 간섭 0 | 움직이는 유닛 4묶음 `motion.interference` W1·W2 truncated false(5-2), 매트 높이 층 53바디 1,013자세(5-3): 겹침 = 기준선 2종뿐 | 검도 판정. U1·U2·U8은 `motion.interference`가 아니라 자세 훑기로 봄(5-1 한계) |
| ② 뒷면이 볼·롤러·원판 위 | 모델로 다시 재지 않음 — 설계 평면 계산(받침 밖 최대 323,536 mm², 포켓 282,556, X > 975 22,050)과 같은 자세가 CAD에 들어감(bbox 13자세 일치) | 구동 후보 RX-12-C1·C2(문서 담당) |
| ③ +X 최대 | CAD: W1 488 `MAT_W` X 최대 **1052.1**, W1 439·W2 112 X 1006.5 | 결정로그(문서 담당) |
| ⑤ machine.json·기존 키 변화 0 | 6절, 3절(0 / 537) | — |

## 6. machine.json(완료 판정 ⑤)

`tools/out/mech_RX-12/model/patch_machine.py`로 더했다(기존 조인트·연구·상태 값은 그대로, 메모만 더함).

| 칸 | 더한 것 |
|---|---|
| doc | `../3D_Modeling/FSAP_v2.16.0.sc`(v2.15.0으로 남아 있던 것을 바로잡음) |
| joints | `J_WP_W_X`·`J_WP_W_Y`(slide) · `J_WP_W_ROT`(rotate): unit `WP_W`, origin [−343.5, −300, 0], rest 0, 한계 ±3000 · ±3000 · −360~720, `model_only: true`. 158 → 161 |
| units | `WP_W`: parts [`MAT_W`], moving, workpiece. 20 → 21 |
| studies | `CYCLE_W1`(steps 583) · `CYCLE_W2`(steps 585): workpiece [`WP_MAT_W:1`], mat "1500x700 오목 500x300 가운데(D-01·D-02 임시)", d2 440, 구간 단계(설계 보고서 3절 표와 같음). 기존 9개에 `_keys_WP_W` 메모. 9 → 11 |
| states | W1 85 · 420 · 439 · 488 · 516 · 517 · 583, W2 66 · 67 · 112 · 500 · 585(조인트 값은 `cycle_w.json` 자세). 32 → 44 |
| workpiece_stages | `WP_W`: "before = MAT_W만(테이프 띠·조각 없음, RX-12-C3)" |
| baseline_overlaps | "WP_*_L·S·G·V ↔ 다른 WP_*" 줄을 `…·W`로, 이유에 WP_W 대기 자리 |
| temp_values | "D-01·D-02·D-03(RX-12)": 이 형상과 근거 |
| _timing | `CYCLE_W`: 볼록 A·D 4.1 · B·C 4.2 · 오목 입구 2.8 · 안 모서리 U4+U5 45° 1.6 · U4 혼자 45° 2.8 s — '임시, RX-12-C4' |
| _history | RX-12 v2.16.0 한 줄 |

## 7. 못 한 것·넘기는 것

| 항목 | 상태 |
|---|---|
| 지시서 6 "against = WP_* 아닌 기계 occurrence 전부" `motion.interference` | **그대로는 못 함** — 648·712·1,681바디 묶음이 `too many bodies for a contact sweep`. 움직이는 유닛(648바디)은 4묶음으로 나눠 `motion.interference` 전 구간(truncated false), 서 있는 U1·U2·U8은 매트 높이 층 바디 전부를 1,013자세 `inspect.clearance`로 대신 봄(5절). U2 볼 827개는 CAD로 재지 않고 서명 윗면 Z 0.0으로 뺌 |
| 자기 점검 자세의 기계 상태 | `motion.play` 한 번이 약 9분이라 W1 85·170만 재생하고 나머지 11자세는 매트 조인트만 몰았다(4-1). 단계별 기계 상태는 5-2 전 구간 검사로 봄 |
| 테이프 띠·조각 모형, 회전 시간 키 정식 계산 | 지시대로 만들지 않음(구동 후보 RX-12-C3·C4) |
| 받침 밖 넓이·테이블 +X 끝 | 구조를 고치지 않음(지시). 구동 후보 RX-12-C1·C2 — 문서 담당 |
| 요구서 0-8-5·7절·설계검토서·결정로그·BOM | 문서 담당 |
| 커밋 | 하지 않음(문서 담당이 버전 커밋) |

외부 조건으로 못 한 것: 없음. 규칙 예외 요청: 없음.

## 8. 규칙 대조

| 규칙(원문) | 한 것 |
|---|---|
| E-05 "새 컴포넌트(유닛·부품 묶음)가 생기거나 없어졌으면 가운데 +1·마지막 0" | 새 컴포넌트 `WP_W_X`·`WP_W_Y`·`WP_MAT_W` → v2.15.2 → **v2.16.0**(지시와 같음). 없어진 컴포넌트 0 |
| E-15 "기계의 모든 움직임은 CAD 조인트…로 정의한다", "부품 이름 목록으로 위치를 직접 옮기지 않는다" | 조인트 3개 + 연구 키. 자기 점검도 `motion.play`·`joint.drive`로만 |
| E-16 "판정은 수치로만" | bbox·거리·부피로만. 스냅샷은 `tools/out/mech_RX-12/`에 저장만 하고 열지 않음 |
| E-08 "편집한 뒤 저장 전에는 절대 원복하지 않는다" | 체크포인트 65는 만들기만 하고 되돌리지 않음 |
| 실행 규칙 2 "`save {}`(덮어쓰기)는 쓰지 않는다", "저장 뒤에는 편집하지 않는다" | `save {path: 새 번호}` 한 번, 저장 뒤 앱은 읽기만 |
| 실행 규칙 2 "오래 걸리는 동작 간섭 검사…는 앱(MCP)에서 돌리지 않는다" | 전 구간 `motion.interference`·자세 훑기는 저장본 CLI(백그라운드). 앱에서는 인자를 받는지만 `budget_s: 1`로 물음(각 1~2 s) |
| 실행 규칙 19 "조인트 글리프를 숨긴다 … 스케치도 같다" | joints 587 · sketches 299 숨김 |
| 실행 규칙 6 "쓴 임시값과 그 근거를 보고서와 자료대기 '쓰는 곳'에 적는다" | 자료대기 'D-01·D-02·D-03 쓰는 곳(RX-12 설계)' 줄(설계부가 만든 줄)에 모델 반영(v2.16.0·생성기)을 덧붙임 |
| 지시서 9 "하지 않는다" | U2 테이블·패널·포켓·기둥·HMI 수정 0, `TAPE_W`·`SEAM_W`·`J_TP_W_*` 0, 구매품 0 |

규칙 예외 요청: 없음.

## 워크플로우 메모

- **`motion.study`가 키를 통째로 갈아 끼워 MCP 인자가 180 KB가 된다**(VGR-01·SIM-01에 이은 세 번째). 이번에는 MCP 서버를 스크립트로 띄워 파일을 그대로 보냈다(`mcp_send.py`, 11연구 약 15 s, 옮겨 적기 오류 0). 엔진에 '파일을 MCP로 보내는 도구'를 두거나 안내서에 이 방법을 적으면 좋겠다. 큰 응답(`motion.play` 2,000줄·`motion.list` 520 KB·`inspect_design` 1.3 MB)도 같은 방법으로 파일에 받아 화면에 요약만 냈다 — 처음 `motion.play`를 MCP 도구로 바로 불렀을 때는 응답 약 2,000줄이 그대로 들어왔다.
- **`motion.play`가 봉제 자세로 갈 때 한 번에 약 9분**(REST → W1 85 약 560 s, W1 85 → 170 약 550 s; REST로 돌아오기 1.8 s, 매트 조인트 `joint.drive` 0.2~1.7 s). MCP 응답 제한(약 300 s)을 넘어 결과를 못 받고 `running`으로 끝나기를 기다렸다(WF-205와 같은 문제). 반대로 `motion.interference`는 같은 연구를 앱에서 초당 18~23표본으로 돈다(`budget_s: 1` 확인). 자기 점검은 `motion.play` 대신 관련 조인트만 `joint.drive`로 놓게 지시하면 9분 × 자세 수가 없어진다.
- **지시서 6(전 구간 `motion.interference`를 모델링부가)과 절차 6-1("전 사이클 motion.interference는 돌리지 않는다")이 부딪힌다.** 설계 보고서는 '검도가 본다'고 적었다. 이번에는 CAD를 쓰는 부서가 혼자라 저장 뒤 CLI로 돌려 결과를 남겼다 — 검도가 `cli/mi3_summary.json`·`sweep_summary.json`을 읽으면 다시 열지 않아도 된다.
- **`motion.interference`의 바디 수 한계가 안내서에 없다**: 209바디 묶음은 되고 275바디는 `too many bodies for a contact sweep`. 파일을 다 연 뒤(이번 약 25분)에야 오류가 나고 앞 단계 결과도 안 남아 CLI 6개가 통째로 헛돌았다. 안내서 '동작 검사'에 "against 묶음은 약 200바디 이하, 먼저 앱에서 `budget_s: 1`로 받는지 확인"을 적으면 막을 수 있다. 한 occurrence가 1,681바디인 U2_TABLE은 이 명령으로 못 본다(자세 훑기로 대신).
- **저장본 CLI 열기가 병렬 수에 따라 15~27분**: 2개 동시 약 15분, 7개 동시 25~27분. 검사 자체는 1~2.5분(자세 169개 × 4명령)·전 구간 간섭 4묶음 약 1분이었다 — 시간의 90 %가 열기다(WF-196 '모델 무게' 상한 240 s의 4~7배). 앱에서 읽기만 하는 검사(사본에서 도는 `motion.interference`)를 100단계 넘어도 `budget_s`로 묶어 허용하면 이 과제의 저장 뒤 검사 약 70분이 몇 분으로 준다.
- 절차 2 "먼저 다른 이름으로 저장"은 SolidCraft에서 실행 규칙 2(저장은 끝에 한 번, 저장 뒤 편집 금지)와 맞지 않는다. 지시문이 CAD에 따라 "끝에 새 번호로 한 번"으로 나오면 좋겠다.
- 과제 지시의 '+X 쪽 부품 자리'·'이어서 v2.13.0' 문구가 옛 버전이다(실제 기준 v2.15.2). config.json doc와 설계 지시서를 따랐다.
- `tools/machine.json` doc가 v2.15.0으로 남아 있었다(v2.15.1·v2.15.2에서 안 고침). 이번에 v2.16.0으로 맞췄다.

## 파일

| 파일 | 내용 |
|---|---|
| `3D_Modeling/FSAP_v2.16.0.sc` | 저장본 |
| `tools/gen_rx12.py` | 생성기(바디·조인트·연구 키·넓이·손계산) |
| `tools/out/mech_RX-12/model/stage_1_bodies.json` · `stage_2_joints.json` · `stage_3_finish.json` · `study_CYCLE_W1.json` · `study_CYCLE_W2.json` · `study_others.json` | 보낸 명령 |
| `tools/out/mech_RX-12/edit.json` · `edit_meta.json` | 다시 실행 기록(27명령) · 작업 전·저장 문서 |
| `tools/out/mech_RX-12/model/motion_list_before.json` · `motion_list_after.json` | 연구 대조 |
| `tools/out/mech_RX-12/model/r20_selfcheck.json` · `r21_a.json` · `r22_drive.json` · `r23_dir_rest.json` · `selfcheck_clearance.json` | 자기 점검·틈 검사 원본 |
| `tools/out/mech_RX-12/model/inspect_presave.json` · `joint_list_edit.json` · `component_list.json` | 저장 전 설계 조회·조인트·컴포넌트 |
| `tools/out/mech_RX-12/model/cli/` | 저장본 CLI 스크립트(`mi_<연구>_<묶음>.json`)·결과(`res_*.json`)·시간(`time_*.txt`)·묶음(`groups.json`) |
| `tools/out/mech_RX-12/model/mcp_send.py` · `patch_machine.py` · `sig_parts.json` | MCP 보내기 도구 · machine.json 고치기 · 서명 조각 |
| `tools/out/mech_RX-12/snap_v2.16.0_W1_439_top.png` | 사람용 스냅샷(W1 439 자세, 위에서) |
