hyeunung/FSAP/docs/reports/mechanism/mech_RX-06R_design.md

# RX-06R 설계안 — U4 X축에서 볼나사·손잡이 빼기, 레일 + 블록 + 잠금 (기구설계부, 2026-11-13)

요약(10줄 안):
- 대상 `3D_Modeling/FSAP_v2.14.0.sc`(config.json doc, 앱에 열려 있음, 읽기만). 설계안 1개(E-02). 구동 개념(0-8)은 그대로, concept_conflict 없음.
- **걷어 냄**: 볼나사 축·너트·BSW20·BUN20·스페이서 F·S·손잡이·너트 볼트 CB6-20 ×4(15바디), 조인트 `J_U4_XSCREW`·motion link, 캐리지 웹 윗부분(Z 482~565)과 너트 귀.
- **잠금(새로)**: 보 앞면에 고정한 **잠금 날**(SUS304 t2 판금 Z자, 긴 구멍 X 183)을 캐리지 웹 앞면과 **누름 판**(SUS304 t3) 사이에 물리고 **CB5-16 ×2**(웹 M5 탭, 조임 3 N·m)로 조인다. 얇은 날이 Y로 휘어 레일 블록에 조임 힘이 실리지 않는다(블록 추가 하중 ≤ 39 N).
- **d₁ 조절 범위는 그대로 100~195**(J_U4_X 0~95, 긴 구멍이 전 범위를 끊김 없이 덮음). 손으로 밀어 옮기고 볼트 2개로 고정(4 mm 육각 렌치 하나).
- 손계산: 잠금 유지력 1,800 N — 운전 X 28.6 N SF 62.9, 손 오조작 100 N SF 18, 스토퍼 받침 반력을 X로 본 보수 204.3 N SF 8.8·553.1 N SF 3.25(M-09 기준 3·2 이상). 볼트 조임 SF 2.31~4.69.
- **레일 실물 STEP(E4)**: CAD에서 직접 해 봄 — `Remove86` 지움 → `Chamfer2` 자르기 → 그린 상자 지움 → 이름 바꿈 → `component.move_bodies`로 RAIL 컴포넌트에. 두 배치 모두 X −335~−115 · 17,180.23 mm³, 블록 4개와 겹침 **0**. 결정로그 E4의 가정(Chamfer2가 RAIL 컴포넌트 안)은 실제와 달라 **move_bodies 단계가 더 필요**하다.
- 새 구매품 없음(CB5-16·CB5-12·SSEB13-570 모두 STEP 있음). 부품 수 −10 +8 = **−2**, 바디 −15 +8.
- CAD 확인 뒤 원복: 타임라인 3,717 · 바디 882 · dirty false · PRB 0 · `motion.play REST 0` moved false. 저장 0.
- 미완: J_U4_X를 구동한 자세 검사는 하지 않음(모델링부 자기 점검·검도 몫). 해석 환경 없음(D-16) — 손계산만.

## 1. 출발점(basis)과 정한 것

| 항목 | 내용 | 근거 |
|---|---|---|
| 벤치마크 | 0-8-3 U4 "R375X 사진(서보 직결 바퀴, 핀 스윙 암, 세로 공압 실린더, 바퀴 밑 원판)" + C-46 "U4가 X 레일 블록에 실린 것은 형제 기종 R375G 사진이 뒷받침한다" — **레일 + 블록**을 그대로 가져온다 | 요구서 0-8-3, 결정로그 C-46 |
| 새로 하는 것 | 잠금(고정) 방식. 사진으로 잠금 부품은 안 보인다(benchmark.md 다-5·마-1) | C-46 "레일 블록 + 고정만 남긴다" |
| d₁ 조절 범위 | **100~195 그대로**(J_U4_X 0~95). 아래 100 = 헤드 임시 상자와 트레드 틈 7.5, 위 195 = U4 혼자 회전 SF 후보(d₁ ≥ 175·≥ 193)·V 매트 d₂ 440에서 U5 틈·원판 한계 287.5 안 | 결정로그 '구동 RX-06 설계안' — 근거가 볼나사와 무관해 그대로 유효. 범위를 바꾸면 끝 멈춤·레일·조인트 한계를 다시 정해야 하는데 바꿀 근거가 없다 |
| 조절 방법 | 손으로 밀기(셋업 축, 봉제 중 안 바꿈 — RX-06-M1 그대로). 캐리지 묶음 13.5 kg, 블록 구름 저항은 전 설계 손 힘 2.9 N 수준 | 결정로그 RX-06-M1, 측정 1-3절 |
| 고정 방식 | **볼트 잠금(얇은 날 물기)**. 레일 클램퍼 SECK13은 유지력 70 N이라 탈락, 클램프 레버 CLCM6-25-C는 STEP 없음·값 임시라 쓰지 않음 | catalog.md 표·주의 1, E-22 "구매품·볼트 형번은 … STEP이 있는 것만 고른다" |

### 왜 '얇은 날'인가 (같은 안 안에서 고친 것)

처음 생각한 형상은 레일 사이(측정 통로 ① Y 107~120, 깊이 13)에 두꺼운 고정 바를 두고 웹을 직접 조이는 것이었다. 손계산에서 걸렸다: 웹 뒷면 = 블록 윗면(Y 107)이라 고정 바 두께가 0.1 mm만 달라도 웹(t12, 블록 사이 147)을 휘어야 닿고, 그 힘이 볼트 하나에 1,520 N — 블록 4개에 760 N씩 실려 블록 SF가 5.73 → **1.8**(C0 보수 임시 2 kN)로 떨어진다(`design_calc.json` rejected_rigid_bar). 또 깊이 13 안에서는 M5 물림 1.5d(M-01)를 맞추려면 긴 구멍을 웹(폭 115)에 내야 해 조절이 끊긴다. 그래서 같은 볼트 잠금을 **Y로 잘 휘는 얇은 판(날)**으로 바꾸고 자리를 웹 윗부분 앞(Z 457~482, 관이 없는 곳)으로 옮겼다. 긴 구멍은 고정 날에, 탭은 웹(t12, 물림 10.3)에 있어 전 범위가 끊김 없이 조절된다.

## 2. 구동 방식·행정·위치·순서

| 항목 | 값 |
|---|---|
| 조인트 | `J_U4_X` 직동(축 −X) 0~95 그대로, d₁ = 100 + J. `J_U4_XSCREW`와 motion link(18°/mm)는 지움 |
| 대기 위치 | J_U4_X 0(d₁ 100), 잠금 볼트 조인 상태 |
| 조절 순서 | ① 바퀴 든 상태(J_U4_PRESS 13.006)에서 ② 잠금 볼트 2개를 1~2바퀴 풂(빼지 않음) ③ 캐리지를 손으로 밀어 d₁ 맞춤(끝 멈춤 P_RX06_STOP_A·B가 0·95에서 블록을 받음) ④ 볼트 2개 3 N·m로 조임 |
| 동작 연구 | J_U4_X 키 없음(셋업 축) 그대로. 새 조인트·새 연구 없음 |
| 제어에 넘길 제약(U-09 "PLC에 넘길 동작 순서 제약 … 은 설계검토서에 기록") | d₁ 바꾸기는 바퀴 든 상태에서만 / d₂ ≥ d₁ + 240(기존, U5 틈) / 잠금 풀림 감지 센서 없음 — d₁을 바꾼 뒤 HMI에 d₁ 값 입력(바퀴 속도 v + ω·d의 d) |

## 3. 부품별 치수·좌표 (월드, REST J_U4_X 0, 측정 좌표계)

### 3-1. 새 부품

| 부품(제작 방법 잠정, E-09) | 묶임 | X | Y | Z | 구멍·기타 | 부피·질량(어림) |
|---|---|---|---|---|---|---|
| `P_RX06R_LOCK_BLADE_판금` SUS304 t2, Z자(굽힘 2, 안쪽 R2) | U4_XAXIS(고정) | −335~−122 (213) | 매달린 다리 92.5~94.5 / 선반 92.5~120 / 고정 플랜지 118~120 | 다리 457~545 / 선반 543~545 / 플랜지 543~577 | 긴 구멍 폭 5.5, 중심 Z 468, 호 중심 X −321.5~−138.5(전체 −324.25~−135.75). 고정 구멍 Ø5.5 ×4 @ X −315·−255·−195·−135, Z 562 | 약 59,700 mm³ · 0.47 kg |
| `P_RX06R_LOCK_CLAMP_레이저` SUS304 t3 | U4_XCAR(따라감) | −237.5~−127.5 (110) | 89.3~92.3 | 458~478 | Ø5.5 ×2 @ X −225·−140, Z 468 | 6,457.5 mm³ · 51 g |
| `CB5-16_RX06R_LOCK_1·_2`(잠금 볼트) | U4_XCAR에 강체 | 중심 −225 · −140 | 머리 84.3~89.3, 끝 105.3(머리가 −Y, 작업자 쪽) | 468 | 누름 판 3 + 틈 0.2 + 날 2 + 틈 0.5 → 웹 물림 10.3(2.06d), 조이면 11.0 | — |
| `CB5-12_RX06R_BLADE_1~4`(날 고정 볼트) | U1_FRAME 쪽 강체 | −315 · −255 · −195 · −135 | 머리 113~118, 끝 130 | 562 | 플랜지 2 + 보 벽 t8 물림 8(1.6d), 관 안으로 2 나옴 | — |

- 날 다리 뒷면 Y 94.5 ↔ 웹 앞면 Y 95: **틈 0.5**(풀었을 때 미끄럼 여유, 굽힘 너머 공차 ±0.3 — M-04 "굽힘을 건넌 치수는 공차가 크다(기본 ±0.3 mm)"). 누름 판 ↔ 날 앞면 틈 0.2. 조이면 날이 0.5 휘어 웹에 붙는다.
- 긴 구멍 범위: 볼트 X = −225 − J, −140 − J (J 0~95) → −320~−140. 호 중심 −321.5~−138.5로 양 끝 1.5 여유.

### 3-2. 고치는 부품

| 부품 | 전 → 후 | 이유 |
|---|---|---|
| `P_RX06_CARRIAGE`(A5052 밀링) | 웹 윗끝 Z 565 → **482**(스케치 `SK_RX06_CARRIAGE` 점 2개), 너트 귀 `Box336`과 구멍 5개(Cylinder1388~1392) 지움, M5 탭(Ø4.2 관통) 2개 @ (X −225·−140, Z 468) 축 Y. bbox X −240~−125 · Y 45~107 · Z 250~482, 부피 514,612.3 → **383,446.3 mm³**(−349 g) | 웹 Z 453.5 위는 너트 귀만 받쳤다(측정 1-2). 덧대거나 잘라 내지 않고 스케치를 고쳐 한 덩어리로(U-10 "덧대지 말고 처음부터 한 덩어리로 다시 그린다") |
| 레일 ×2 | 그린 상자 `SSEB13-570_RX06_RAIL`(12 × 7.5 × 210) → 실물 STEP을 자른 `SSEB13-220_RX06_RAIL`(X −335~−115, 구멍 9, 17,180.23 mm³) | 완료 판정 ⑤, RX-06-E1·E4, U-07 "구매품은 구매처에서 받은 실제 STEP을 기준으로 넣는다" |
| `P_M07_BEAM` | 앞벽(Y 120~128)에 M5 탭(Ø4.2 관통) 4개 @ X −315·−255·−195·−135, Z 562 | 날 고정 |

### 3-3. 지울 것

| 무엇 | id |
|---|---|
| motion link(J_U4_X → J_U4_XSCREW, 18°/mm) | link index 35 |
| 조인트 `J_U4_XSCREW` | 98014 |
| 강체 조인트 | 97992·97993(BSW20·BUN20), 97999(너트), 98000~98003(CB6-20 :5~:8), 98012(손잡이) |
| occurrence만(컴포넌트 8723과 :1~:4는 남김, RX-06-D6) | `CB6-20_M03_CAR:5~:8` = 97906·97981·97982·97983 |
| 피처 | `RX06_SCREW_PARTS`(97905), BodyTransfer578~580(97915~97917), Cylinder1385(97918), BodyTransfer581(97919), Cylinder1386·1387(97920·97921), BodyTransfer582(97922), Box338·339(97942·97943)와 그 BodyTransfer585·586 |
| 빈 컴포넌트(M02R-E03 기준 — 남기지 않음) | `BSW20_RX06`(97903), `BUN20_RX06`(97907), `BSS2020-1100_RX06`(97909), `BSS2020-1100_RX06_NUT`(97911), `STEP대기_HANDLE_D50`(97913) |
| 캐리지 피처 | Box336(97928), Cylinder1388~1392(97929~97933) |
| 레일 | Remove86(97923), Box335(97924), BodyTransfer583(97925) — 5절 순서대로 |

## 4. 손계산 (`tools/out/mech_RX-06R/design/design_calc.py` → `design_calc.json`, `handcalc.py`)

하중은 측정 6절 값. 누름·스토퍼·무게는 Y·Z 힘이라 레일 블록이 받고 잠금은 X 힘만 받는다. 완료 판정 ③이 스토퍼 받침 반력을 들었으므로 그 값이 통째로 X로 걸린 경우도 보수로 셈했다.

| 항목 | 계산 | 값 | 기준(M-09 "필요 SF: 일반 3, 오조작 하중 2") | 판정 |
|---|---|---|---|---|
| 볼트 축력 | T/(0.2·d) = 3 N·m/(0.2 × 5 mm) | 3,000 N/개 | — | 임시 계수(catalog.md) |
| 잠금 유지력 | 면 2 × μ 0.15 × 2개 × 3,000 | **1,800 N** | — | — |
| 운전 X(바퀴 축 방향 마찰 0.4 × 71.5) | 1,800 / 28.6 | SF 62.9 | 3 | 합격 |
| 오조작 X(0.5 × 134.9) / 손 100 N | 1,800 / 67.5 · / 100 | SF 26.7 · 18.0 | 2 | 합격 |
| 보수: 스토퍼 받침 반력 204.3 N(1 g·0.2 MPa)을 X로 | 1,800 / 204.3 | SF 8.81 | 3 | 합격 |
| 보수: 받침 반력 오조작 553.1 N을 X로 | 1,800 / 553.1 | SF 3.25 | 2 | 합격 (볼트 1개면 1.63 → 2개가 필요한 근거) |
| 바퀴 구동 반력 18 N(접선 Y) | 블록이 받음(레일 직각). 날 면 수직이라 잠금에 안 걸림 | — | — | 블록 하중은 기존 값에 포함 |
| 잠금 볼트 조임(M5 12.9, 물림 10.3, A5052) | `handcalc.py --d 5 --pitch 0.8 --le 10.3 --torque 3 --base A5052 --dw 8.5 --dh 5.5` | 볼트 응력 SF 4.69, 좌면 2.31, 암나사 전단 2.37, ok true | 도구 판정 | 합격 |
| 날 휨 강성(다리 t2 × 213, 선반~볼트 75) | 3EI/L³ | 194.9 N/mm | — | — |
| 조일 때 블록에 더 실리는 힘 | 194.9 × 0.5(기준)·0.8(공차 끝) ÷ 4 | 24.4 · 39.0 N/블록 | — | — |
| 블록 SF(C0 보수 임시 2 kN) | 2,000 / (349.2 + 39.0) · 2,000 / (549.9 + 39.0) | 5.15 · 3.40 | 3 · 2 | 합격 (전 5.73 · 3.64) |
| 날 뿌리 굽힘(강제 변위 0.5 · 0.8) | 3Etδ/(2L²) | 51.5 · 82.3 MPa → SF 3.98 · 2.49(항복 205) | 3 · 2 | 합격 |
| 날 면내(553.1 N이 볼트 줄에서 X로) | 굽힘 2.74 MPa, 긴 구멍 띠 인장 17.8 MPa, 띠 좌굴 1,274 N | SF ≥ 2.3(좌굴) | 2 | 합격 |
| 날 고정 볼트 CB5-12 ×4(4 N·m, 보 t8 탭) | 미끄럼 600 N/개 ÷ 138.3 N/개 | SF 4.34 | 2 | 합격 |
| 캐리지 | 하중 길 단면(웹 뿌리 115 × 12) 그대로 — 12.5 MPa SF 15.6/2(mech_RX-06_fea.md). 잘라 낸 곳은 위 블록 위(하중 길 밖), 매달린 질량 13.54 → 약 13.2 kg | 그대로 | — | 합격 |

- 과사양 메모(M-09 "SF가 필요치의 3배 이상 남으면 과사양"): 운전 SF 62.9는 크지만 볼트를 M5 아래로 내릴 수 없고(요구서 2-2 기본 M5, U-12 "지름은 되도록 하나로"), 2개는 보수 오조작 SF ≥ 2 때문에 필요하다. 조임 토크를 1.02 N·m까지 낮춰도 보수 운전 SF 3이 된다 — 토크 지정은 디테일.
- 해석: **해석 못 함 — 환경 없음(자료대기 D-16)**. 새 하중 부품(날)은 판 두께/길이 2/75 = 0.027 < 0.1이라 보 공식 대상(E-18 "얇은 판·스프링(두께/길이 < 0.1)은 보 공식을 먼저 본다").

## 5. CAD에서 직접 확인한 것 (feasibility, 읽기만 — WF-016·017)

통로 MCP(앱 127.0.0.1:27878, `running` 빈 목록 확인 뒤). 문서 `FSAP_v2.14.0`, dirty false, 타임라인 3,717(오류 0·경고 55), 바디 882. 저장본 열기 0번(이미 열려 있음).

### 5-1. 새 부품 자리 — 프로브 6개 × 이웃 8바디 (`inspect.clearance`, truncated false, unchecked 0)

프로브는 선반을 Z 528에 둔 형상으로 쟀다(뒤에 날 굽힘 응력 때문에 선반을 Z 543으로 15 올림 — 올린 자리 Z 543~577은 측정부 프로브 Z1(482.5~577.5)·Z11(565~600)이 빈 것을 확인한 띠 안이고 보 앞면은 같은 평면이다).

| 프로브 | X / Y / Z | 결과 | 읽기 |
|---|---|---|---|
| 날 다리 | −335~−122 / 92.5~94.5 / 457~530 | 캐리지와 겹침 737.56 mm³ — 자리 X −174.5~−162.5 · Z 497~530 = **너트 귀**(지울 것). 웹과는 겹침 없음. 아이들러 브래킷 `P_M03_IDLER_BRKT`와 8.60(X 5.0) | 귀를 지우면 0 |
| 날 선반 | −335~−122 / 94.5~120 / 528~530 | 보 앞면과 거리 **0.0**(Y 120.0 맞닿음). 캐리지와 2,772 mm³ = 지금 웹 윗부분(Z 482 위, 자를 곳) | 웹을 482로 내리면 0 |
| 날 고정 플랜지 | −335~−122 / 118~120 / 530~562 | 보와 0.0(맞닿음), 캐리지와 11.0(Y) | 보 앞면이 Y 120 평면임을 확인 |
| 누름 판 쓸림(J 0~95) | −332.5~−127.5 / 89.3~92.3 / 458~478 | 겹침 0. 웹 앞면까지 **2.70**(= 날 2 + 틈 0.5 + 0.2), 아이들러 브래킷 10.97 | 웹 앞면 Y 95.0 확인 |
| 잠금 볼트 머리 + 렌치 길(J 0~95, 머리 위 21) | −324.25~−135.75 / 63.3~89.3 / 463.75~472.25 | 겹침 0, 웹까지 5.70 | M-01 "머리 위 축 방향 빈 공간 ≥ 볼트 길이 + 5 mm" 만족(16 + 5 = 21) |
| 날 고정 볼트 머리 + 렌치 길(머리 위 17) | −319.25~−130.75 / 96~118 / 543.75~552.25 | 캐리지와 10,214.9 mm³ = 지금 웹 윗부분(자를 곳), 보까지 2.0 | 웹을 내리면 0 (12 + 5 = 17) |

- F_5 클램프(X −112~−88 · Y 102~120 · Z 420~470)·`CB5-16_M08_PY:18`·위 레일·위 블록 2개는 12 mm 안에 없음(날 +X 끝 −122 ↔ F_5 −112: X 10).
- 관은 중심선으로 봄(`tube_paths.json`): 날·누름 판 X 범위(≤ −122)에서 관은 U4_B Z 430·U4_A2 Z 440(겉 Z ≤ 443, Y 67~82)이 가장 높다 → 날 밑 Z 457과 **14**, Y로도 10.5 떨어짐. U5_A2·U5_B는 Y 182·190, Z 673 위.
- 앞으로 넣을 블록 볼트(RX-06-D1, 블록 탭 Z 430·450) 머리는 Z ≤ 452.75 → 날 밑 457과 4.25, 누름 판 밑 458.

### 5-2. 레일 실물 STEP — 실제로 해 봄 (완료 판정 ⑤)

| 단계 | 명령 | 결과 |
|---|---|---|
| 1 | `timeline.delete {features:[97923]}` (Remove86) | 됨, 38.2 s |
| 2 | `component.activate {component:"RAIL_SSEB13-570", occurrence:"RAIL_SSEB13-570:1"}` → `solid.box {corner:[-115,130,280], length:400, width:40, height:40, operation:"cut", targets:["Chamfer2"]}` → `component.activate {component:0}` | changed_bodies `Chamfer2`, 0.47 s |
| 3 | `timeline.delete {features:[97925, 97924]}` (그린 상자) | 됨, 38.2 s |
| 확인 | `measure Chamfer2` | bbox X −335.0~−115.0 · Y 112.5~120.0 · Z 260~272, **17,180.23 mm³**, 면 53 |
| **가정과 다른 점** | `occurrence.properties RAIL_SSEB13-570:1 · :2` | **둘 다 바디 0** — `Chamfer2`는 RAIL 컴포넌트가 아니라 바깥에 한 번만 놓여 있다(결정로그 RX-06-E4는 '두 배치'를 기대) |
| 4 | `body.rename {body:"Chamfer2", name:"SSEB13-220_RX06_RAIL"}` (1.2 s) → `component.move_bodies {bodies:["SSEB13-220_RX06_RAIL"], component:"RAIL_SSEB13-570", component_path:[97895, 97897]}` (0.34 s, 피처 98242) | :1 = X −335~−115 · Z 260~272, :2 = Z 434~446, 각 17,180.23 mm³ · 22.16 g. `component_path`는 문자열이 아니라 **occurrence id 목록** |
| 5 | `inspect.clearance {bodies: 레일 2, against: 블록 4 · F_5 · PY:18 · 캐리지 · 멈춤 A·B}` | **overlaps 0**, unchecked 0, truncated false (15.2 s). 지금 기준선 178.87 · 178.99 ×2는 없어진다 |

### 5-3. 원복(E-08)

`edit.restore_checkpoint 15`(레일 시험 되돌림) → `undo` ×6(프로브 상자) → `motion.play REST 0`(moved false). 끝 상태 `inspect_design`: dirty **false**, 타임라인 3,717, 바디 882, PRB 0, Remove86·Box335·BodyTransfer583 그대로, 오류 0·경고 55. 저장하지 않음.

## 6. 구매품·볼트 (stepcheck, E-10)

`python -B stepcheck.py --project tools CB5-12 CB5-16 CB5-20 SSEB13-570 SSEB13-220`

| 형번 | 판정 | 근거 | 쓰임 |
|---|---|---|---|
| CB5-12 | 있음 | CB5-12\CB5-12.stp | 날 고정 ×4 |
| CB5-16 | 있음 | CB5-16\CB5-16.stp | 잠금 ×2 |
| CB5-20 | 있음 | CB5-20\CB5-20.stp | (안 씀) |
| SSEB13-570 | 있음 | SSEB13-570\SSEB13-570.stp | 레일 — 모델 안 원본을 잘라 씀(새로 넣지 않음) |
| SSEB13-220 | 없음 — 같은 계열 SSEB13-570 | 실행 규칙 18 "길이는 자르면 되는거" | BOM 형번(비고 "STEP SSEB13-570을 잘라 씀") |

| 구매품 | 수량 | 판정에 쓴 카탈로그 값 | 출처 | 임시 |
|---|---|---|---|---|
| CB5-16 | 2 | M5 12.9 응력 단면 14.2 mm², 3 N·m → 축력 3 kN(토크 계수 0.2), μ 0.15 | catalog.md '잠금 — 볼트(작은 쪽)', JIS B 1176 일반값 | 예(축력·μ) |
| CB5-12 | 4 | 같음, 4 N·m → 4 kN | 같음 | 예 |
| SSEB13-220(STEP SSEB13-570 자름) | 레일 2 + 블록 4(그대로) | 조립 높이 13, 레일 12 × 7.5, 구멍 피치 25·끝 10, C0 6 kN(표)·판정은 보수 임시 2 kN | catalog.md '직동 가이드', `sseb13_step_parse.json` | 예(정격) |

- 쓰지 않은 것: SECK13(유지력 70 N — 2개 140 N도 손 오조작 100 N에 SF 1.4), CLCM6-25-C(STEP 없음, 값 임시).
- 가격: 모두 미확인(요구서 3-1 가격표에 없음, catalog.md). 빠지는 BSS2020-1100·BSW20·BUN20·손잡이도 미확인.
- 소멸: RX-06-E5(BSW15·BUN15 교체), D-190(손잡이 STEP), D-191(축 끝 가공), RX-06-D3(지지 유닛 볼트), RX-06-D6(너트 볼트 컴포넌트 공유) — 자료대기·BOM·결정로그에 '소멸(C-46)'로.
- 자료대기 후보: SSEB13 계열 '27년 판매종료 예정'(catalog.md 주의 4) 대체 형번.

## 7. 부품 수·비용 (M-10)

| | 빠짐 | 더함 |
|---|---|---|
| 구매품 | BSS2020-1100(축 + 너트) 1, BSW20 1, BUN20 1, 손잡이(HDLC-D50 임시) 1, CB6-20 4 | CB5-16 2, CB5-12 4 |
| 가공품 | P_RX06_SPACER_F 1, _S 1 (A5052 블록 52 × 20 × 95 · 26 × 20 × 95) | P_RX06R_LOCK_BLADE(SUS304 t2 판금, 굽힘 2) 1, P_RX06R_LOCK_CLAMP(SUS304 t3 레이저) 1 |
| 합 | 10 (바디 15) | 8 (바디 8) |

순증 **−2**. 세트 비용: 금액은 미확인이지만 볼나사 + 지지 유닛 2 + 손잡이 + 밀링 블록 2가 빠지고 판금 1 + 레이저 판 1 + 볼트 6이 들어가므로 준다. 정렬 조정(볼나사 축–레일 평행) 자리도 없어진다. 만드는 법 4가지 비교·금액(M-13), 판금성 표(M-04)는 디테일링.

## 8. 규칙 자기 점검 (E-14, 원문 대조)

| 규칙 | 원문 | 이 안 | 판정 |
|---|---|---|---|
| E-03 | "작업 대상을 넣은 전 구간 동작과 간섭 0" | 새 부품은 Z 457 위·보 앞면. 매트 Z 0~10과 447 떨어짐, 떨어지는 조각 없음. 이웃 틈: 아이들러 브래킷 5.0(X), F_5 10, 관 14, U5 대차 최대 +X(X ≤ −445)와 110 | 걸리지 않음 |
| M-06 | "카탈로그 허용치를 확인하고 보고서에 수치로 적는다" | 블록 SF 5.15/3.40(C0 보수 2 kN), 행정 95 그대로(블록 끝 ↔ 멈춤 0.05) | 합격 |
| M-01 | "물림 ≥ 1.5d", "머리 위 축 방향 빈 공간 ≥ 볼트 길이 + 5 mm" | 잠금 10.3(2.06d), 날 고정 8(1.6d). 렌치 길 프로브 겹침 0 | 합격 |
| M-02 | "조립 순서 제약으로만 풀리는 볼트는 결함" | 볼트 6개 모두 앞(−Y)에서, 다른 부품을 떼지 않고 풀린다. 날을 떼도 캐리지는 그대로 | 합격 |
| U-12 | "평범한 육각 렌치 볼트(CB)만", "지름(M 규격)은 되도록 하나로" | CB5만(M6 CB6-20 4개가 빠져 U4 X축이 M5 하나로) | 합격 |
| U-11 | "기본은 매립하지 않는다" | 카운터보어 0 | 합격 |
| U-14 | "로봇·로봇용 기성 유닛 … 은 후보로도 꺼내지 않는다" | 없음 | 합격 |
| M-04 | "판금이 얇아 힘을 못 받으면 억지로 판금하지 말고", "구멍–굽힘선 ≥ 2t + R", "최소 플랜지 ≥ 4t", "나란한 두 굽힘 사이 ≥ 4t" | 날은 일부러 얇아야 하는 부품(휘어야 함), 힘은 면내로 받음(17.8 MPa). 구멍–굽힘 12.25·70.25(≥ 6), 플랜지 32·88(≥ 8), 굽힘 사이 27.5(≥ 8), 굽힘 2번 Z자(펀치 갇힘 없음) | 합격(판금 기능·전개 확인은 디테일링) |
| U-10 | "덧대기 … 계단식 브래킷, 단차 … 금지" | 캐리지는 스케치를 고쳐 한 덩어리, 날·누름 판은 두께 일정한 판 | 합격 |
| U-07·E-10 | "구매품은 … 실제 STEP을 기준으로", "추정 바디 … 금지" | 새 구매품은 STEP 있는 볼트뿐, 레일은 원본 STEP을 자름, `STEP대기_` 1개(손잡이)가 없어짐 | 합격 |
| U-01 | "핵심 기능 … 정밀도는 비용보다 앞선다" | d₁은 셋업 값(바퀴 속도 식의 상수). 잠금은 마찰이라 봉제 중 밀리지 않으면 됨 — SF 8.8 이상. 날이 Y로 휘어 레일 정밀을 건드리지 않음 | 해당 없음·영향 없음 |
| U-06 | "절감이 작으면 조립 쉬운 쪽" | 부품 −2, 정렬 조정 자리 없어짐 | 합격 |
| U-09 | "PLC에 넘길 동작 순서 제약 … 은 설계검토서에 기록" | 2절 제약 3건 | 기록 |
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
