hyeunung/FSAP/docs/reports/mechanism/mech_RX-06R_donecheck.md

# RX-06R 완료 판정 확인 — 설계안 RX-06R-1 (원칙 감사, 2026-11-13)

요약(10줄 안):
- 대상: 설계안 RX-06R-1(`mech_RX-06R_design.md`, 손계산 `tools/out/mech_RX-06R/design/design_calc.py·json`), 측정 `mech_RX-06R_measure.md`. CAD는 쓰지 않았다(파일 열기 0). 근거 수치로 다시 셈했다.
- **판정: 완료 판정 ①~⑥ 모두 만족(ok = true).** 고칠 자리 없음.
- 다시 셈해 맞은 것: 잠금 유지력 1,800 N(면 2 × 0.15 × 2 × 3,000), SF 62.9·26.7·18.0·8.81·3.25, 날 강성 194.9 N/mm, 뿌리 굽힘 51.5·82.3 MPa, 블록 SF 5.15·3.40, 캐리지 부피 383,446.3 mm³, 긴 구멍 범위(볼트 X −320~−140, 양 끝 1.5).
- 설계안 값과 다른 것 1건(판정은 그대로 합격): 날 고정 볼트 CB5-12 ×4 미끄럼 SF는 4.34가 아니라 **2.04**(보수 오조작 553.1 N, 볼트 줄 Z 562와 잠금 줄 Z 468의 어긋남 94 mm가 만드는 모멘트를 더하면). 기준 2 이상이라 합격, 운전 보수 204.3 N은 5.5(기준 3).
- 넘길 것(문제 아님): machine.json `U4_XAXIS` _note(3673줄 "축·손잡이는 J_U4_XSCREW로 돈다")·`J_U4_X` _note의 '볼나사 너트' 문구도 같이 고칠 것. 볼트 ↔ 탭(Ø4.2) 나사 겹침은 T19-M05 관례대로 의도된 겹침으로 뺀다.
- 미완(설계안이 밝힌 그대로): J_U4_X를 구동한 자세 검사와 선반을 Z 543으로 올린 뒤 형상 프로브는 모델링부·검도 몫. 해석 못 함 — 환경 없음(D-16).

## 1. 항목별 다시 계산

기준: M-09 "필요 SF: 일반 3, 오조작 하중 2", M-06 "카탈로그 허용치를 확인하고 보고서에 수치로 적는다. 허용치를 넘으면 결함이다", E-03 "작업 대상을 넣은 전 구간 동작과 간섭 0".
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
