hyeunung/FSAP/docs/reports/mechanism/mech_RX-06R_fea1.md

# RX-06R 해석 보고 — 1회차 (해석부, 2026-11-13)

요약(10줄 안):
- **판정: 합격(동작 문제 0).** 대상 `3D_Modeling/FSAP_v2.15.0.sc`의 새 하중 부품 STEP 3개(`P_RX06R_LOCK_BLADE`·`P_RX06R_LOCK_CLAMP`·`P_RX06_CARRIAGE`). CAD는 쓰지 않았다(STEP 글자 파싱 + 손계산).
- **해석 못 함 — 환경 없음(자료대기 D-16).** `engine/fea/.venv`가 없어 고체 FEA는 돌리지 않았다. 손계산 `fea/cases/mech_RX-06R_handcalc.py` → `fea/results/mech_RX-06R_handcalc.json`(판정 35개).
- 완료 판정 ③: 잠금 미끄럼 유지력 1,678 N(날 복원력을 뺀 값) — 스토퍼 받침 반력 204.3 N을 통째로 X로 봐도 **SF 8.21**(기준 3), 오조작 553.1 N **SF 3.03**(기준 2), 실제 X 힘(바퀴 축 방향 마찰 28.6 N) SF 58.7. 잠금 볼트·날 고정 볼트 `handcalc.py` ok true. **③ 만족.**
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
