hyeunung/FSAP/docs/concept/images/mat_carpet_narrow_u_slot.webp

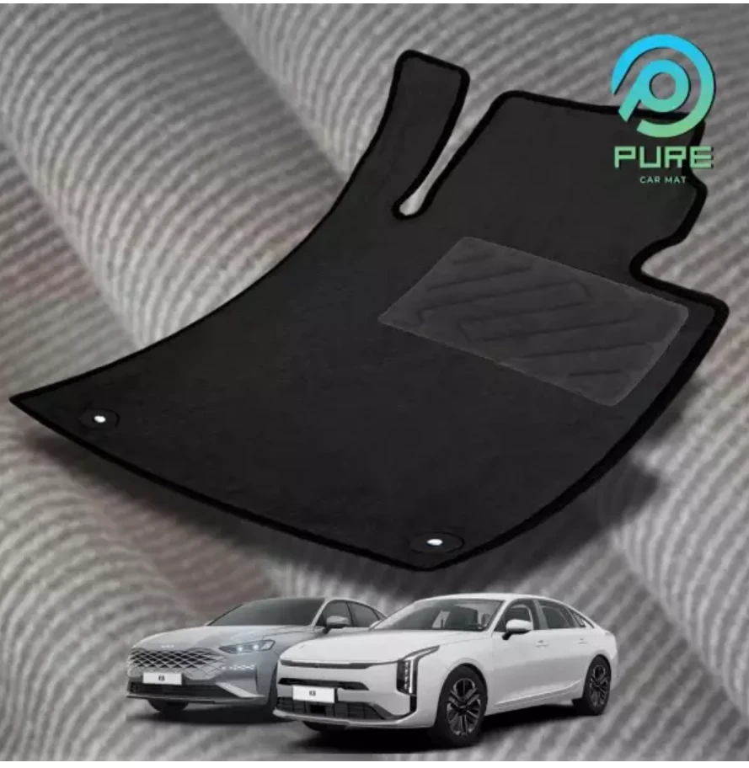
docs/concept/images/mat_carpet_narrow_u_slot.webp
