hyeunung/FSAP/docs/concept/images/mat_coil_black_closeup.webp

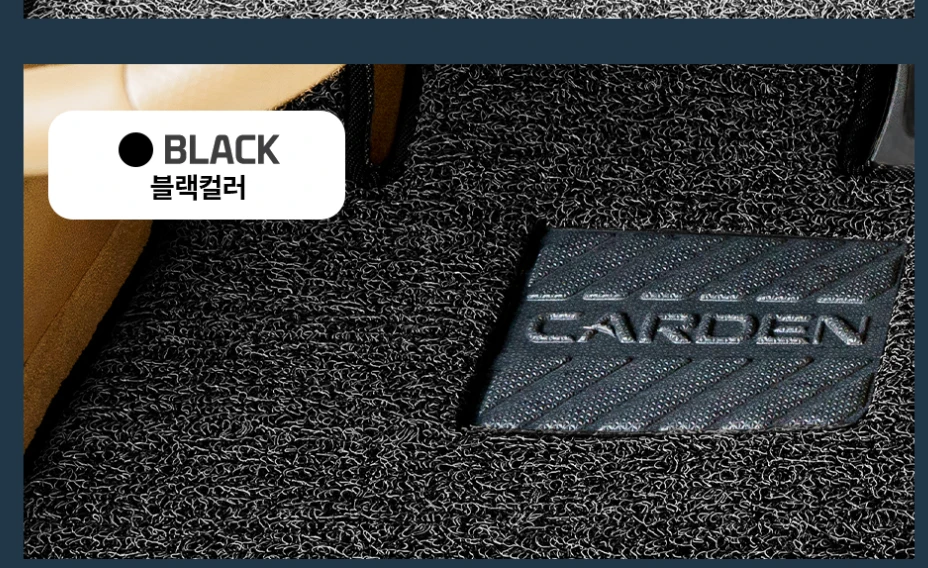
docs/concept/images/mat_coil_black_closeup.webp
