hyeunung/FSAP/docs/images/r375x/annot_1_beam_U4.jpg

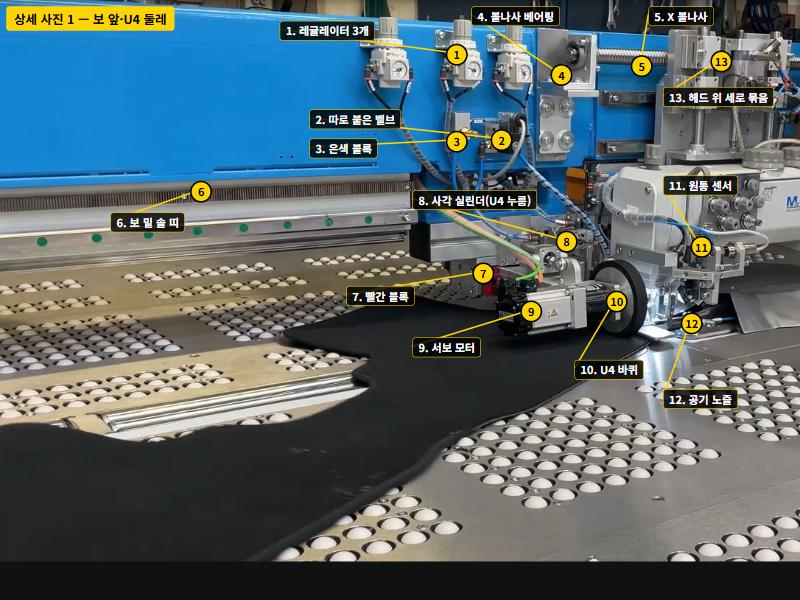
docs/images/r375x/annot_1_beam_U4.jpg
