hyeunung/FSAP/docs/images/r375x/annot_2_U4_hanger_shoe.jpg

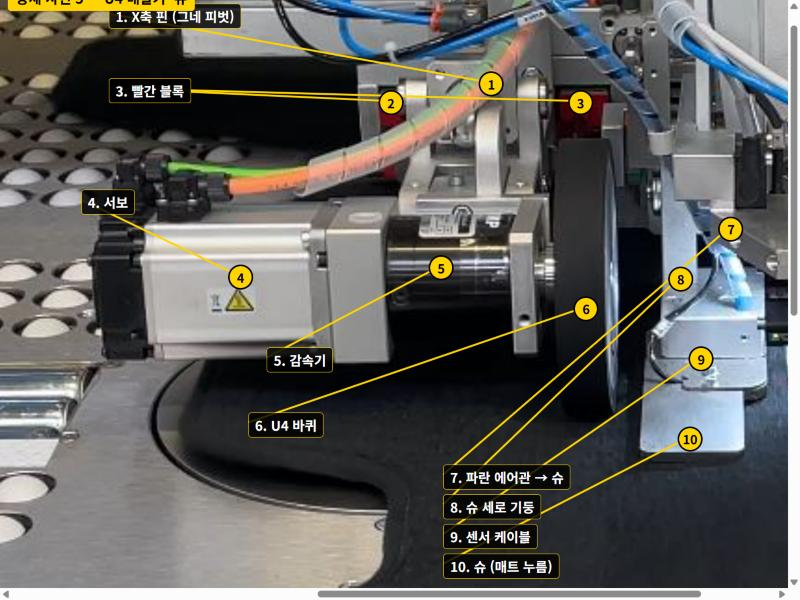
docs/images/r375x/annot_2_U4_hanger_shoe.jpg
