hyeunung/FSAP/docs/images/r375x/annot_3_needle_disc_panel.jpg

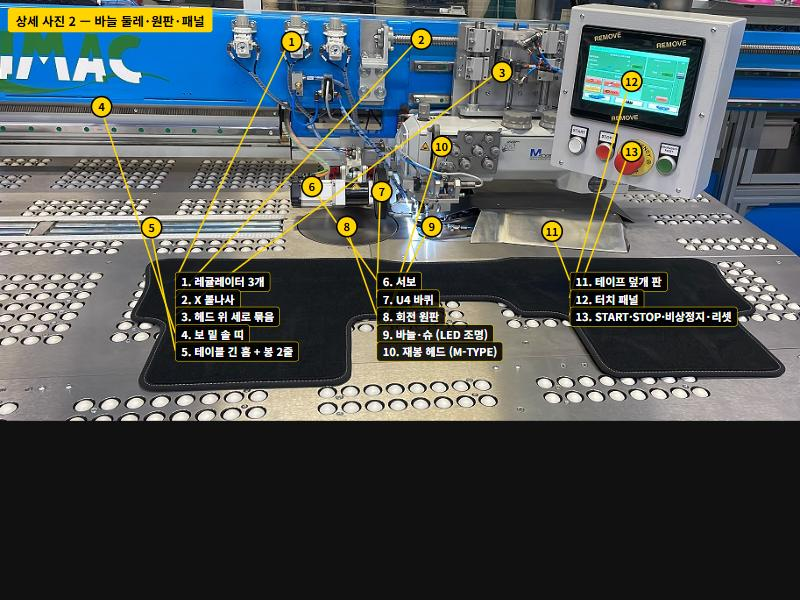
docs/images/r375x/annot_3_needle_disc_panel.jpg
