hyeunung/FSAP/docs/bom/FSAP_v2.17.2_made.csv

품번 | 이름 | 컴포넌트 | 수량 | 재질 | 만드는 법 | 가공법 | 형상 | 질량 g(1개) | 가격 | 비고
P_M01_FOOT | 노루발(좁은 홈용) | U3_PRESSER | 1 | S45C | 가공 | 밀링·드릴 | 발바닥 t2 X −10~3.5·Y −8~6·Z 12~14 + 노루발대 Ø6 Z 14~80·바늘 구멍 Ø3 | 17.2 | 미확인 | M01: 새로(옛 U3_PRESSER_BOX 대체). 867 순정 노루발 치수 오면 바꿈(D-10·D-108). 디테일 M01-F4 발바닥 t3
P_M01_HANGER | 윗헤드 매달기 L판 | U3_HEAD | 1 | SUS304 | 판금 | 레이저·굽힘 90° R8 | t8 L 400×(선반 Y −90~120 + 세운 판 Z 560~650) 장공 Ø5.5×11 ×10 | 7240 | 미확인 | M01: 새로(옛 U3_HANGER 차지 상자 대체). 전개 400×286.1. 디테일 M01-F1 강성 / M08: 윗판 M5 탭 ×2(다관 커넥터 고정 반쪽) 더함 — 물림 6, 디테일 M08-X4
P_M02_BASE | 바늘 옆 바퀴 받침 L판 | U4_WHEEL_N | 1 | SUS304 | 용접·가공 | 레이저·밀링(판금 기능 미사용) | t8 L 보 밑 다리 X −330~−140·Y −60~200 + 세운 다리 45×t8 Z 50~250 · 원호 장공 ±5° 4 · 피벗 Ø12 | 미확인 | 미확인 | M02: 새로(U4_MOUNT 상자 대체). 디테일 M02-X1·X7·F3 / MOT-01(v2.7.0): 다리 M4 탭 ×2(X −300±9, 피벗 핀 머리 CB4-12) / RX-06(v2.11.0): 보 밑 연장 X −275~−205·Y 199~266(t6, 브래킷 받침), Y≥116 윗면 248(보와 틈 2), 캐리지 볼트 M5 탭 6·브래킷 볼트 M5 탭 2, 관 장공 8×18(−161, 66~84), 옛 관 구멍(−161,94)·BASE_4 구멍 메움, BASE_4 탭 (−159,110). 보 볼트 4 없앰(캐리지에 매닮) / M02R(v2.14.0): 스프링 탭 볼트 M5 탭 4개 자리 (−302·−288·−192·−178, Y 50) → (−307·−283·−197·−173, Y 50), Ø4.2 관통 Z 242~250. 탭 피처째 옮겨 메운 자국 없음. 가장 가까운 남의 구멍 (−215, 50) 살 13.8
P_M02_CYLBRKT | 실린더 위 핀 브래킷 | U4_WHEEL_N | 1 | SUS304 | 용접 | 레이저·용접 | t4 밑판 40×60 + 귀 2 Z 253~336 · 핀 Ø9 (−161.006 325.72) | 미확인 | 미확인 | M02: 새로. 실물 실린더 길이에 맞춰 키 큰 귀(M02-M1). 디테일 M02-X6
P_M02_ARM_SIDE_N | 레버 옆판(−Y) | U4_PRESS | 1 | SUS304 | 가공 | 레이저 | t6 X −320~−120·Z 40~132 · 부시 Ø16 · 로드 핀 Ø9 | 615.85 | 미확인 | M02: 새로(U4_HOLDER 대체) / MOT-01(v2.7.0): 안면 깊이 2 홈 s −82~−2·t −30(열림)~+34·위 모서리 R3, 피벗 구멍 Ø16 → Ø18 H7(MPFZ12-10), 옆면 볼트 구멍 Z ±15 → ±19 / M02R(v2.14.0): 빗나가 있던 옛 구멍 메움 2개(핀 r 4.5 @ (−160, Z 122), 부시 r 9 @ (−300, Z 70), θ0 좌표)를 제자리로 — 셸 3 → 1, 77,660.19 mm³
P_M02_ARM_SIDE_P | 레버 옆판(+Y) | U4_PRESS | 1 | SUS304 | 가공 | 레이저 | ARM_SIDE_N 대칭 | 614.53 | 미확인 | M02: 새로 / MOT-01(v2.7.0): ARM_SIDE_N과 같음 / M02R(v2.14.0): 옛 구멍 메움 2개 제자리로(바깥으로 튀어나온 혹 없어짐), 그네 볼트 CB5-16_M02S_1·_2의 M5 탭 2개 (−300, Z 100)·(−166, Z 120)(θ0)에 생김(전에는 빗나가 없었음) — 셸 2 → 1, 77,494.02 mm³. 탭 물림 6 = 1.2d(디테일 M02R-D7), 조임 3 N·m(M02R-D10)
P_M02_FRONT | 감속기 앞판 | U4_PRESS | 1 | SUS304 | 가공 | 밀링·드릴 | t12 62×80 · 파일럿 Ø50 · 축 Ø18 · CB5 4 P.C.D 70 | 미확인 | 미확인 | M02: 새로 / MOT-01(v2.7.0): Ø50×3 자리파기·Ø18 → Ø50 H8 관통, Ø5.5 ×4 → M5 관통 탭(PCD 70), 옆면 M5 탭 Z 70±15 → ±19·깊이 10.5(Y ±20.5~±31) / LITE(v2.8.10): X 구멍 메움·다시 뚫기 지움(옛 cut r2.1로), 부피·bbox 같음
P_M02_ARM_TIE | 레버 뒤 막대 | U4_PRESS | 1 | A5052 | 가공 | 절단·탭 | □20 L62 양끝 M5 | 65.57 | 미확인 | M02: 새로 / M02R(v2.14.0): 탭이 없는 자리의 잔재 메움 2개 지움 — 셸 3 → 1, 24,467.55 mm³
P_M02_WHEEL | 바퀴 허브 | U4_WHEEL | 1 | A6061 | 가공 | 선반 | Ø100×25 + 보스 Ø36 · 축 Ø16 | 미확인 | 미확인 | M02: 새로(U4_WHEEL_TIRE 대체). 토크 체결 미정(M02-X5·F6) / MOT-01(v2.7.0): Ø16 관통 → Ø16 H7 막힌 구멍 깊이 23 + 키홈 5 JS9×2.3, 막벽 Ø5.5 + 자리파기 Ø9.5×5(CB5-12)
P_M02_WHEEL_TREAD | 바퀴 트레드 | U4_WHEEL | 1 | 우레탄 A70 | 가공 | 주형·접착 | Ø120/Ø100 ×25 | 미확인 | 미확인 | M02: 새로. 재질·경도 D-93
P_M02_SNS_BRKT | 매트 유무 센서 브래킷 | U4_PRESS | 1 | SUS304 | 판금 | 레이저·굽힘 | t2 L + 탭(M3 2) | 미확인 | 미확인 | M02: 새로. 센서 M3 나사 미모델(M02-X9) / MOT-01(v2.7.0): 볼트 구멍 Z 55/85 → 51/89
P_M02_DISK | 자유 회전 원판 | U4_DISK | 1 | A5052 | 가공 | 선반 | Ø250 t12 · 중앙 Ø20 · 카운터보어 3 | 미확인 | 미확인 | M02: 새로(U4_DISK 상자 대체). 관성 J 0.0122 kg·m²(M02-F2, t8+포켓 검토)
P_M02_DISK_SHAFT | 원판 축 | U4_DISK | 1 | S45C | 가공 | 선반·탭 | Ø20 L60 + 플랜지 Ø50 t10(M5 탭 3) | 미확인 | 미확인 | M02: 새로
P_M02_DISK_HSG | 원판 베어링 하우징 | U4_WHEEL_N | 1 | A5052 | 가공 | 선반 | 플랜지 Ø90 t8 + 보스 Ø60 · 구멍 Ø42 | 미확인 | 미확인 | M02: 새로(U4_DISK_BRG 대체)
P_M02_DISK_BASE | 원판 받침판 | U4_WHEEL_N | 1 | SUS304 | 가공 | 레이저·탭 | t8 250×270 · 중앙 Ø62 · M5 탭 4 | 미확인 | 미확인 | M02: 새로. U2_PLATE 밑면 체결
P_M03_DRV_BRKT | X 구동 브래킷(서보·감속기) | U5_WHEEL_F | 1 | SUS304 | 판금 | 레이저·굽힘 | t4 ㄷ X −2280~−2160 · 웨브 Y 86~90 파일럿 Ø50 · CB5 4 P.C.D 70 · 발 Z 314~334·446~466 | 미확인 | 미확인 | M03: 새로(U5_DRIVE 상자 대체). 감속기 볼트 렌치 길 막힘(디테일 M03-V1) / MOT-01(v2.7.0): 웨브 Y 86 → 82(t4 → t8), Ø50×? → Ø50 H8 관통, Ø5.5 ×4 → M5 관통 탭(웨브 t8, 물림 8)
P_M03_IDLER_BRKT | 아이들러 브래킷 | U5_WHEEL_F | 1 | SUS304 | 판금 | 레이저·굽힘 | t4 ㄷ X −440~−340 · 장공 ±5 ×4 · 축 Ø10.5 | 미확인 | 미확인 | M03: 새로. 미는 볼트 자리 미모델(M03-X5)
P_M03_IDLER_SHAFT | 아이들러 축 | U5_WHEEL_F | 1 | S45C | 가공 | 선반 | M10 Ø10 Y 82~94 + 어깨 Ø14 + 베어링 자리 Ø10 L20 | 미확인 | 미확인 | M03: 새로. 너트·멈춤링 미모델(M03-X2) / MOT-01(v2.7.0): Y 82~117 → 90~115, 양 끝 M5 탭(DP10·DP12)
P_M03_CAR_PLATE | 대차판 | U5_CAR | 1 | A5052 | 가공 | 밀링·드릴·탭 | t12 X −2045~−1825 · Z 160~420 · 블록 Ø5.5 4 · 클램프 Ø5.5 4 · MGP 통과 Ø6.6 4(X −1937/−1903 · Z 197/241) · 윗면 M5 탭 2 | 미확인 | 미확인 | M03: 새로(U5_CARRIAGE 상자 대체) / STEPSWAP: MGP 실물 장착으로 M6 탭 4 → Ø6.6 통과 4(뒤에서 CB6-20) / RX-06-C2(v2.15.1): 형상 값 변화 0. 이 바디를 고치던 루트 피처(탭·구멍 cut)를 이 부품의 컴포넌트 피처로 옮김(조인트로 움직일 때 구멍이 따라감)
P_M03_BELT_CLAMP_BASE | 벨트 클램프 아래 턱 | U5_CAR | 1 | PET-CF | 3D 출력 | 출력·인서트 | X −2040~−2010 · Y 92~117 · Z 325~339.35 · MBIS5 Ø6.8 2 | 미확인 | 미확인 | M03: 새로. 조임 볼트·이 홈 없음(M03-X3), 인서트 벽 3.15(M03-X6)
P_M03_BELT_CLAMP_CAP | 벨트 클램프 위 턱 | U5_CAR | 1 | PET-CF | 3D 출력 | 출력·인서트 | Z 342.75~360 · MBIS5 Ø6.8 2 | 미확인 | 미확인 | M03: 새로
P_M03_CHAIN_ARM | 체인 팔 | U5_CAR | 1 | SUS304 | 판금 | 레이저·굽힘 | t3 Z자 X −1950~−1910 · Z 420~848 · Y 80~275 | 미확인 | 미확인 | M03: 새로 / RX-06-C2(v2.15.1): 형상 값 변화 0. 이 바디를 고치던 루트 피처(탭·구멍 cut)를 이 부품의 컴포넌트 피처로 옮김(조인트로 움직일 때 구멍이 따라감)
P_M03_LIFT_TOP | 승강 윗판 | U5_LIFT | 1 | SUS304 | 가공 | 레이저·탭 | t8 X −1990~−1820 · Y −55~78 · Ø6.6 4 · M5 탭 4 | 미확인 | 미확인 | M03: 새로(U5_HOLDER 상자 대체). 옆판 볼트 물림 6 → 조임 3.5 N·m 이하(M03-V7) / STEPSWAP: Ø6.6 4 자리 MGP 끝판 탭으로(X −1959/−1881 · Y 46/72) / FUNC-01(v2.8.0): 새 U5_LIFT로. 서보 창 X −1990~−1876·Y ±33, −Y로 −70까지 넓힘, 축 구멍 Ø16.5 ×2, 옛 탭 4개 메움
P_M03_LIFT_SIDE_N | 승강 옆판(−Y) | U5_FLOAT | 1 | SUS304 | 판금 | 레이저·굽힘 | t6 L Z 30~126 · 플랜지 Y −55~−37 | 미확인 | 미확인 | M03: 새로 / MOT-01(v2.7.0): 안면 깊이 2 홈 X −1914~−1834·Z 30(열림)~104(승강 0 기준), 옆면 볼트 구멍 Z ±15 → ±19 / FUNC-01(v2.8.0): U5_FLOAT로. 위 플랜지 Z 156 → 130~136(REST), 플랜지 Ø16 H7 / FUNC-01(v2.8.1): 웹 축 여유 구멍 Ø16.5 (−1847, ±43) Z 115~130, 웹 6 → 3.75 남음(디테일 F01-D7)
P_M03_LIFT_SIDE_P | 승강 옆판(+Y) | U5_FLOAT | 1 | SUS304 | 판금 | 레이저·굽힘 | LIFT_SIDE_N 대칭 | 미확인 | 미확인 | M03: 새로 / STEPSWAP: 플랜지에 Ø6.6 2 더함(X −1959/−1881 · Y 46, CB6-20 통과) / MOT-01(v2.7.0): LIFT_SIDE_N과 같음 / FUNC-01(v2.8.0): U5_FLOAT로. 위 플랜지 Z 156 → 130~136(REST), 플랜지 Ø16 H7, CB6-20 머리 비킴 Ø12 ×2 / FUNC-01(v2.8.1): 웹 축 여유 구멍 Ø16.5 (−1847, ±43) Z 115~130, 웹 6 → 3.75 남음(디테일 F01-D7)
P_M03_FRONT | 바퀴 감속기 앞판 | U5_FLOAT | 1 | SUS304 | 가공 | 밀링·드릴 | P_M02_FRONT와 같음(X −1832~−1820) | 미확인 | 미확인 | M03: 새로(P_M02 형상 X −1700 복사) / MOT-01(v2.7.0): P_M02_FRONT와 같음 / FUNC-01(v2.8.0): U5_FLOAT로. 윗면 Z 140 → 134 / LITE(v2.8.10): P_M02_FRONT와 같음
P_M03_SNS_BRKT | 매트 유무 센서 브래킷 | U5_LIFT | 1 | SUS304 | 판금 | 레이저·굽힘 | P_M02_SNS_BRKT와 같음 | 미확인 | 미확인 | M03: 새로 / MOT-01(v2.7.0): P_M02_SNS_BRKT와 같음
P_M03_WHEEL | 바퀴 허브 | U5_WHEEL | 1 | A6061 | 가공 | 선반 | Ø100×25 · 중심 (−1800 0 70) | 미확인 | 미확인 | M03: 새로(U5_WHEEL_TIRE 대체). 감속기 볼트 렌치 길 막힘 → 공구 구멍(M03-V2) / MOT-01(v2.7.0): P_M02_WHEEL과 같음
P_M03_WHEEL_TREAD | 바퀴 트레드 | U5_WHEEL | 1 | 우레탄 A70 | 가공 | 주형·접착 | Ø120/Ø100 ×25 | 미확인 | 미확인 | M03: 새로. 재질·경도 D-93
P_M04_PANEL_W1 | 타공 판 W1 | U2_TABLE | 1 | SUS304 | 판금 | 레이저 | t4 Z −12~−8 · 압입 구멍 Ø36 ×680 · M5 자리 | 미확인 | 미확인 | M04: 새로. 볼 압입 구멍 수 = design_check.json ball_ok / M04R: 볼 구멍 Ø36 피치 100 반 칸 격자로 다시(C-31, D-96 임시)
P_M04_PANEL_W2 | 타공 판 W2 | U2_TABLE | 1 | SUS304 | 판금 | 레이저 | t4 Z −12~−8 · X −2175~−410 · 압입 구멍 Ø36 피치 100 · 롤러 긴 홈 X −1847~−410 × Y ±23(닫힌 끝 R 3, 옛 띠 보스 구멍 Ø36 ×8은 홈에 들어가 없어짐) · M5 자리 12 | 28179.8 | 미확인 | M04: 새로. 볼 압입 구멍 수 = design_check.json ball_ok. 디테일 M04-F2(바퀴 길 SF 운전 2.48·오조작 1.33) / M04R: 볼 구멍 Ø36 피치 100 반 칸 격자로 다시(C-31, D-96 임시) / RX-11(v2.17.0): 띠 보스 구멍 ×8 대신 롤러 긴 홈 가공(부피 3,785,401 → 3,553,566 mm³, bbox 그대로). 새들 귀가 홈 가장자리 윗면에 얹힘. 디테일 RX-11-F4·F8(홈 살 외팔 57 처짐·짝힘)
P_M04_PANEL_W3 | 타공 판 W3 | U2_TABLE | 1 | SUS304 | 판금 | 레이저 | t4 Z −12~−8 · 압입 구멍 Ø36 ×680 · M5 자리 | 미확인 | 미확인 | M04: 새로. 볼 압입 구멍 수 = design_check.json ball_ok / M04R: 볼 구멍 Ø36 피치 100 반 칸 격자로 다시(C-31, D-96 임시)
P_M04_PANEL_E1 | 타공 판 E1 | U2_TABLE | 1 | SUS304 | 판금 | 레이저 | t4 Z −12~−8 · 압입 구멍 Ø36 ×300 · M5 자리 | 미확인 | 미확인 | M04: 새로. 볼 압입 구멍 수 = design_check.json ball_ok. 디테일 M04-F3(판 끝 얹힘 4.5) / M04R: 볼 구멍 Ø36 피치 100 반 칸 격자로 다시(C-31, D-96 임시). 센터판 홈 메움
P_M04_PANEL_E2 | 타공 판 E2 | U2_TABLE | 1 | SUS304 | 판금 | 레이저 | t4 Z −12~−8 · X −410~975 · 원판 구멍 r130 (−175,0) · 아랫유닛 구멍 X −55~45·Y ±65 · 압입 구멍 Ø36 ×65 · M5 자리 10 · 롤러 긴 홈 X −410~−317 × Y ±23(닫힌 끝 R 3) | 21119.2 | 미확인 | M04: 새로. 볼 압입 구멍 수 = design_check.json ball_ok. 센터판 쪽 끝 X 105.05 / M04R: 볼 구멍 Ø36 피치 100 반 칸 격자로 다시(C-31, D-96 임시). 센터판 자리까지 넓힘, 21.3 kg. 디테일 M04R-F1(손 100 N 처짐 2.19) / RX-11(v2.17.0): 롤러 긴 홈 가공(부피 2,680,301 → 2,663,205 mm³, bbox 그대로). 디테일 RX-11-D3(홈 닫힌 끝 ↔ 원판 따냄 살 12)
P_M04_PANEL_E3 | 타공 판 E3 | U2_TABLE | 1 | SUS304 | 판금 | 레이저 | t4 Z −12~−8 · 압입 구멍 Ø36 ×520 · M5 자리 | 미확인 | 미확인 | M04: 새로. 볼 압입 구멍 수 = design_check.json ball_ok. 디테일 M04-F3(판 끝 얹힘 4.5) / M04R: 볼 구멍 Ø36 피치 100 반 칸 격자로 다시(C-31, D-96 임시). 센터판 홈 메움
P_M05_CST_PLATE | 카세트 판 | U7_CASSETTE | 1 | A5052 t8 | 가공 | 워터젯 | 모델 참조 | 미확인 | 미확인 | M05: 새로(U7_PATH_V 차지 상자 대체) / RX-06-C2(v2.15.1): 형상 값 변화 0. 이 바디를 고치던 루트 피처(탭·구멍 cut)를 이 부품의 컴포넌트 피처로 옮김(조인트로 움직일 때 구멍이 따라감)
P_M05_BINDER_BRKT | 바인더 브래킷 | U7_CASSETTE | 1 | A5052 | 가공 | 밀링 | 모델 참조 | 미확인 | 미확인 | M05: 새로(U7_PATH_V 차지 상자 대체)
P_M05_GUIDE | 세운 테이프 안내(홈 31×2) | U7_CASSETTE | 1 | PA12 | 출력 | 3D 출력 | 모델 참조 | 미확인 | 미확인 | M05: 새로(U7_PATH_V 차지 상자 대체)
P_M05_CUT_FIX | 고정날 | U7_CASSETTE | 1 | SK5 | 가공 | 연삭 | 모델 참조 | 미확인 | 미확인 | M05: 새로(U7_PATH_V 차지 상자 대체)
P_M05_CYL_BRKT | 칼·접기 실린더 브래킷 | U7_CASSETTE | 1 | SUS304 t3 | 판금 | 레이저·굽힘 | 모델 참조 | 미확인 | 미확인 | M05: 새로(U7_PATH_V 차지 상자 대체)
P_M05_FEED_BRKT | 보내기 실린더 브래킷 | U7_CASSETTE | 1 | SUS304 t3 | 판금 | 레이저·굽힘 | 모델 참조 | 미확인 | 미확인 | M05: 새로(U7_PATH_V 차지 상자 대체)
P_M05_CUT_HOLDER | 칼 홀더 | U7_CUT | 1 | PA12 | 출력 | 3D 출력 | 모델 참조 | 미확인 | 미확인 | M05: 새로(U7_PATH_V 차지 상자 대체)
P_M05_CUT_BLADE | 6° 경사날 | U7_CUT | 1 | SK5 | 가공 | 연삭 | 모델 참조 | 미확인 | 미확인 | M05: 새로(U7_PATH_V 차지 상자 대체)
P_M05_TUCK_HOLDER | 접기 홀더 | U7_TUCK | 1 | PA12 | 출력 | 3D 출력 | 모델 참조 | 미확인 | 미확인 | M05: 새로(U7_PATH_V 차지 상자 대체)
P_M05_TUCK_BLADE | 접기 날 | U7_TUCK | 1 | SUS304 | 가공 | 밀링 | 모델 참조 | 미확인 | 미확인 | M05: 새로(U7_PATH_V 차지 상자 대체)
P_M05_FEED_CARR | 앞끝 보내기 캐리지(휨 발톱) | U7_FEED | 1 | PA12 | 출력 | 3D 출력 | 모델 참조 | 미확인 | 미확인 | M05: 새로(U7_PATH_V 차지 상자 대체)
P_M05_HOLDER | 고정 걸이(UPPER −Y 면) | U7_FIXED | 1 | SUS304 t4 | 판금 | 레이저·굽힘 | 모델 참조 | 미확인 | 미확인 | M05: 새로(U7_PATH_V 차지 상자 대체) / DC2-04: 날개 A Ø5.5 2 → 세로 장공 Z 304~314(J_U7_HGT −4~+6), 아래 끝을 미는 볼트가 받침 / DC2-08: 날개 C 윗면에 M5 탭 관통 2 (X 26·36, Y −184.5) 더함 — 다관 커넥터 받침 발 / REG-02: 날개 A Ø4.0 스터드 구멍 2(X 27, Z 293·325) 더함, 장공 4번 자리 X 36 → 33(v2.6.7)
P_M06_BASE | 슈 실린더 받침(날개·붙임면·탭) | U6_SENSOR | 1 | SUS304 t3 | 판금 | 레이저·굽힘 R3 ×2 | X −142~−22 · Y −172~−90 · Z 120~195, 탭 구멍 Ø10.5 | 미확인 | 미확인 | M06: 새로(차지 상자 U6_SHOE_SENSOR 대체). UPPER −Y 면 CB5-12 ×2. 디테일 M06-D1 탭 구멍–굽힘 영역 3.75 < 2t 6(M-04) / DC2-04: 붙임면 Ø5.5 2 → 세로 장공 Z 174~184(J_U6_HGT −4~+6) / REG-02: 붙임면 Ø4.0 스터드 구멍 2(X −58·−44, Z 179) 더함 — 공통 판에 묶여 J_U6_HGT 없어짐(J_U7_HGT 하나)
P_M06_CARR | 슈 캐리지(C 단면 + 다리 + 센서 팔) | U6_SHOE | 1 | PET-CF | 3D 출력 | FDM·인서트 | X −60~18 · Y −185~−100 · Z 21~156 (J 0) | 미확인 | 미확인 | M06: 새로. J_U6_SHIFT −60~0. MBIS5 ×3·M3 인서트 ×2(D-125) / U6S(v2.9.0): 다리 +X 면 인서트 자리 Ø6.8×8 + Ø5.2×3 ×2(Y −170·−128, Z 86) 더함 / RX-10(v2.17.2): 누름 실린더 브래킷 인서트 자리 Y −170 → −177(Y −128 그대로, 구멍 피처 자리 이동 — 옛 구멍 없음). bbox·부피 190,110.7 mm³ 그대로, −Y 끝까지 살 4.6
P_M06_SHOE | 가장자리 슈(바늘 앞) | U6_PRESS | 1 | SUS304 t2 | 판금 | 레이저·굽힘(벽·입술 20°) | X −22~1 · Y −245~−115 · Z 12.5~50(SHIFT 0 · PRESS 0), 바닥 X 폭 23 × Y 130(평탄 19.0 × 119.295 = 2,266.6 mm²), 입술 20° Y −245~−234.3, 장공 7.1×17.1 ×2(Y −135·−175), 윗날개 X −22~−2 · Z 48~50, 로드 구멍 Ø6 (Y −166) | 139.8 | 미확인 | M06: 새로. 바닥 Z 12.5(이음매 위 0.5). 디테일 M06-D4 입술 모서리 손끝 SF 1.82 < 2 / U6S(v2.9.0): 벽 Z 45 → 50, 판금 윗날개 Y 전체, 장공 7.1×17.1(칼라 안내), 로드 구멍 Ø6. 컴포넌트 U6_PRESS(J_U6_PRESS −5.0~+4.5). 부피 8,433.8 → 11,712.9 mm³. 디테일: 바닥 유효 폭 16.7 → ≥ 24.7(기울기 자국 SF 1.35 < 2) / RX-10(v2.17.2): 바닥 Y 길이 90 → 130(−Y 끝으로만 40, X 폭 23 그대로, C-43). 벽·윗날개·입술 따라 늘어남, 로드 구멍 Y −152 → −166, 장공 그대로. 닿는 면 1,506.6 → 2,266.6 mm², 부피 11,712.9 → 17,627.0 mm³, 92.9 → 139.8 g. 자국 SF 1.354 → 2.285(F_hi 21.59 N)·2.151(0.19 MPa) — 위 U6S 디테일(유효 폭 ≥ 24.7)은 없어짐. 남은 동작 문제 RX-10-F1(슈 끝 손 100 N에 누름 실린더 로드 굽음 SF 0.64~1.03 — 로드 구멍을 Y 장공 + 뜬 이음, −Y 쪽 위 멈춤으로 고칠 것). 디테일: 장공 윗끝–윗굽힘 4.95 < 2t + R 6(전부터), RX-10-F2 곡선 구간 가로 끌림 자국
P_M06_ROLL_POST | 테이프 롤 기둥 | U7_ROLL_MOUNT | 1 | A5052 t10 | 가공 | 워터젯·탭 | X 640~700 · Y 110~120 · Z 605~780 | 미확인 | 미확인 | M06: 새로(차지 상자 U7_ROLL 대체). U1_BEAM 앞면 CB5-20 ×2
P_M06_ROLL_SHAFT | 테이프 롤 축(플랜지붙이) | U7_ROLL_MOUNT | 1 | S45C | 가공 | 선반·탭 | 플랜지 Ø50 Y 102~110, 축 Ø20 Y −142~102, 어깨 Ø25, 앞끝 M5 탭 | 미확인 | 미확인 | M06: 새로. 플랜지 CB5-16 ×3(디테일 M06-D2 렌치 접근)
P_M06_ROLL_HUB | 테이프 롤 허브 | U7_ROLL_MOUNT | 1 | PET-CF | 3D 출력 | FDM | Ø76 Y −142~−78 + 플랜지 Ø110, 베어링 자리 Ø42 ×2 | 미확인 | 미확인 | M06: 새로. 6004ZZ ×2. 롤 심 Ø76(D-124)
P_M06_ROLL_WASHER | 롤 축 끝 누름 와셔 | U7_ROLL_MOUNT | 1 | SUS304 t3 | 판금 | 레이저 | Ø24 t3, Y −145~−142 | 미확인 | 미확인 | M06: 새로. CB5-12_M06_8
P_M06_G1_BRKT | 안내 롤러 G1 브래킷 | U7_ROLL_MOUNT | 1 | SUS304 t3 | 판금 | 레이저·굽힘 L | 세운 판 X 455~530 · Z 560~650, 발 Y −88~−60 | 미확인 | 미확인 | M06: 새로. UPPER 윗면 CB5-12 ×2. 발 구멍–굽힘 영역 5.25(경계, M06-D1)
P_M06_G1_PIN | 안내 롤러 G1 핀 | U7_ROLL_MOUNT | 1 | SUS304 | 가공 | 선반 | 축 Y, (X 505, Z 625) | 미확인 | 미확인 | M06: 새로
P_M06_G1_ROLLER | 안내 롤러 G1 | U7_ROLL_MOUNT | 1 | PET-CF | 3D 출력 | FDM | 턱 Ø38, 안쪽 폭 31, Y −127.4~−91.6 | 미확인 | 미확인 | M06: 새로. 양끝 틈 0.1
P_M06_TOP_BRKT | 꼭대기 롤러 브래킷 | U7_ROLL_MOUNT | 1 | SUS304 t3 | 판금 | 레이저·굽힘 L | X 20~70 · Y −88~−60 · Z 568~620 | 미확인 | 미확인 | M06: 새로. HANGER 선반 구멍 CB5-20 ×2. 발 구멍 경계(M06-D1)
P_M06_TOP_PIN | 꼭대기 롤러 핀 | U7_ROLL_MOUNT | 1 | SUS304 | 가공 | 선반 | (X 44, Z 595) | 미확인 | 미확인 | M06: 새로
P_M06_TOP_ROLLER | 꼭대기 롤러 | U7_ROLL_MOUNT | 1 | PET-CF | 3D 출력 | FDM | G1 롤러와 같은 형식 | 미확인 | 미확인 | M06: 새로
P_DC204_PUSH_BLK | 미는 볼트 받침 블록 | U3_HEAD | 1 | SUS304 | 가공 | 밀링·탭 | UPPER −Y 면 붙임, M4 탭 2(X 14·42, 미는 볼트) · 자리파기 CB5 2(X 28, Z 257·269) | 미확인 | 미확인 | DC2-04: 새로(v2.3.2). 디테일 DC2-04-T1(렌치 접근)·T2(너트 틈)·T4(마찰 비틀림)
U3_NEEDLE_PIN | 바늘 자리 모형 | U3_HEAD | 1 | - | - | - | Z 19~116(+6) | - | - | DC2-04: +Z 6(바늘 위 끝 Z 19, D-10 기종 조건)
P_M07_BEAM | 전폭 보(각관 + 끝판 t8 ×2) | U1_FRAME | 1 | STKR400 | 가공 | 절단·용접·드릴·탭 | 각관 400×200×8 L3610 X −2380~1230 · Y 120~320 · Z 250~650 · 끝판 t8 ×2 · M5 탭 | 270460 | 미확인 | M07: 새로(U1_BEAM 차지 상자 대체). v2.3.4 끝 80이 기둥 윗면 Z 250에 얹힘. 디테일 M07-D9(뒷면 Y 320.0045 retry — LITE에서 공칭 복귀)·M07-F1(얹힘면 편심) / M08: 보 앞면 M5 탭(레귤레이터 브래킷·R3·HMI 받침판·매니폴드 CB4-20 M4) · 윗면 M4 ×3(경광등)·M5 ×4(관 빗) 더함 — 모델은 나사 물림으로 둠, 생성기 반영은 디테일 M08-X3 / LITE: 피처 이력만 바꿈(Box16 제 길이, 외곽 깎기→R12 fillet), bbox 공칭 복귀, +27.8 g / LITE(v2.8.10): 피처 이력만 바꿈(탭 38을 Box16 뒤 스케치 cut 3으로, 앞 공구 Combine40 지움, 필렛 띠 탭 4 끝 Combine), 부피 −2.6 mm³·bbox 차 0, 형상 변경 0 / RX-06R(v2.15.0): 앞벽(Y 120~128)에 M5 탭(Ø4.2 관통) 4 @ X −315·−255·−195·−135 · Z 562(잠금 날 고정). LITE의 앞쪽 탭 스케치 Sketch15에 원 4개로 넣음, 부피 −440.0 mm³(약 −3.5 g)
P_M07_SEAT_NX | 보 받침 L(NX) | U1_FRAME | 1 | SS400 t9 | 판금 | 레이저·굽힘 R9 | 가로 X −2300~−2200 · Y 130~310 · Z 241~250 + 세로 Z 150~250 · Ø5.5 ×10 | 2340 | 미확인 | M07: 새로. 가로 다리 CB5-20 → 보 밑벽 탭 · 세로 다리 CB5-20 → 기둥 홈
P_M07_SEAT_PX | 보 받침 L(PX) | U1_FRAME | 1 | SS400 t9 | 판금 | 레이저·굽힘 R9 | X 1050~1150 대칭 | 2340 | 미확인 | M07: 새로. NX와 대칭
P_M07_SPLICE_NX | 뒤 이음판 L꼴(NX) | U1_FRAME | 1 | SS400 t6 | 판금 | 레이저 | L꼴 X −2380~−2200 · Y 320~326 · Z 150~640 · Ø5.5 ×8 | 3630 | 미확인 | M07: 새로(v2.3.4 L꼴로 다시 그림). 4080 쪽 구멍 Z 175·220
P_M07_SPLICE_PX | 뒤 이음판 L꼴(PX) | U1_FRAME | 1 | SS400 t6 | 판금 | 레이저 | L꼴 X 1060~1230 · Y 320~326 · Z 150~640 · Ø5.5 ×8 | 3450 | 미확인 | M07: 새로(v2.3.4)
P_M04R_DB_SHIM_A | 원판 묶음 받침판 A | U2_TABLE | 1 | SUS304 | 판금 | 레이저 | 40×270×4 · X −285 중심 · Z −52~−48 · Ø5.5 ×2 (Y ±120) | 341 | 미확인 | M04R: 새로. 가로대 CM_A/CM_B 위 높이 맞춤 심, DISK_BASE CB5-20 ×2
P_M04R_DB_SHIM_B | 원판 묶음 받침판 B | U2_TABLE | 1 | SUS304 | 판금 | 레이저 | 40×270×4 · X −65 중심 · Z −52~−48 · Ø5.5 ×2 (Y ±120) | 341 | 미확인 | M04R: 새로. 가로대 CM_A/CM_B 위 높이 맞춤 심, DISK_BASE CB5-20 ×2
P_M08_LC_JOINT_FL_WJ | 커튼 앞왼 기둥 이음판 | U8_PNEU | 1 | A5052 | 가공 | 밀링·드릴 | t6 X −2306~−2300 · Y −1640~−1480 · Z −800~−340, Ø5.5 ×4 | 미확인 | 미확인 | M08: 새로. 앞왼 기둥 HFS8-4080-2370 ↔ 프레임 다리
P_M08_LC_BRKT_FR_SM_1~2 | 커튼 앞오른 기둥 L 브래킷 | U8_PNEU | 2 | SUS304 | 판금 | 레이저·굽힘 90° | L t4 Z −330~−250 / −88~−16, Ø5.5 ×4씩 | 미확인 | 미확인 | M08: 새로. sheet.convert(SUS304_t4)
P_M08_LC2F_BRKT_SM_1~2 | 옆 투광기 L 받침 | U8_PNEU | 2 | SUS304 | 판금 | 레이저·굽힘 90° | L t3 Z 85~115 / 1385~1415, Ø5.5 ×2씩 (날개 Y −1561~−1558) | 미확인 | 미확인 | M08: 새로. 수정 1에서 날개 −Y 3 옮겨 다시 그림
P_M08_LBRK_R1~R3_SM | 뒤 기둥 L 브래킷 | U8_PNEU | 3 | SUS304 | 판금 | 레이저·굽힘 90° | L t6 45(40)×45×폭 30, Z −300·150·600 | 미확인 | 미확인 | M08: 새로. R3는 보 앞면 M5 탭
P_M08_LBRK_H1~H2_SM | HMI 팔 L 브래킷 | U8_PNEU | 2 | SUS304 | 판금 | 레이저·굽힘 90° | L t6, 팔 윗면·밑면 ↔ 받침판 | 미확인 | 미확인 | M08: 새로
P_M08_HMI_PLATE_SM | HMI 패널 받침판(L) | U8_PNEU | 1 | SUS304 | 판금 | 레이저·굽힘 90° | 판 t2 X 1163~1442 · Y −465~−463 · Z 343~557 + 날개 X 1163~1165 · Y −463~−400 | 미확인 | 미확인 | M08: 새로. 수정 1에서 T자→L(판금 접힘)
P_M08_HMI_MOUNT_ML | HMI 팔 보 받침판 | U8_PNEU | 1 | A5052 | 가공 | 밀링·드릴·탭 | X 1160~1225 · Y 110~120 · Z 340~540, Ø5.5 ×4 + M5 탭 ×2 | 미확인 | 미확인 | M08: 새로
P_M08_TUBE_COMB_ML_1~4 | 보 윗면 관 빗 | U8_PNEU | 4 | A5052 | 가공 | 밀링·드릴 | 폭 16 × Y 124~197 × Z 650.1~697, 관 자리 Ø6.6 ×8, CB5-16 자리파기 Ø9.5 | 미확인 | 미확인 | M08: 새로(수정 1). X 250·650·−350·−950
P_M07_LBRK_*(8품번: PY_PX·NY_PX·PY_NX·NY_NX·NZ_PX·NZ_NX·NZ_PY·NZ_NY) | 받침틀 판금 L 브래킷 S형 | U1_FRAME | 42 | SUS304 t6 | 판금 | 레이저·굽힘 L R6 | 45×45×폭 30, 구멍 Ø5.5 ×2 구석에서 30/30, 전개 79.57×30 | 112.1 | 미확인 | M07-K1: 새로(HBLFSN8 대체). sheet.convert SUS304_t6, 굽힘 90° R6. YX 22·LEG 12·LEGY 4. 디테일 M07K-D1(구멍–굽힘 15.25 < 2t+R 18) / DC2-03: −3(PY_PX:7·:8·:9 지움, 포켓 바닥 비움) +7(가로대 730 K0~K6)
P_M07_LBRKT_PX_PZ·NX_PZ | 받침틀 판금 L 브래킷 T형 | U1_FRAME | 11 | SUS304 t6 | 판금 | 레이저·굽힘 L R6 | 75×45×폭 30, 구멍 60/30(Y 부재 옆 홈 Z −270) | 약 160(계산) | 미확인 | M07-K1: 새로(HBLFSN8 대체). sheet.convert SUS304_t6, 굽힘 90° R6. YM 9. 판 SF 2.27(M07K-D1·D3 FEA 권장) / DC2-03: +2(PX_PZ:9·NX_PZ:2, 받이 판 받침 HFS8-4080-300 ↔ 아래 레일 :3). 디테일 DC203-D3 가로 다리 SF 1.77 < 2
P_M07_LBRKC_*(PZ_PX·NZ_PX·PZ_NX·NZ_NX) | 받침틀 판금 L 브래킷 C형(기둥) | U1_FRAME | 8 | SUS304 t6 | 판금 | 레이저·굽힘 L R6 | 45×45×폭 30, 구멍 20/30 | 112.1 | 미확인 | M07-K1: 새로(HBLFSN8 대체). sheet.convert SUS304_t6, 굽힘 90° R6. COL 8. 디테일 M07K-D4 → t3 R3 + CB5-14 예정(M-04 5.25 < 18, 예외 기각 M07K-E01)
P_M04_LBRK_PY_PX·NY_PX | 볼 테이블 가로대 끝 판금 L(S형) | U2_TABLE | 22 | SUS304 t6 | 판금 | 레이저·굽힘 L R6 | 45×45×폭 30, 구멍 30/30 | 112.1 | 미확인 | M07-K1: 새로(HBLFSN8 대체). sheet.convert SUS304_t6, 굽힘 90° R6. M04 XB 16 + M04R 6(가로대 CM). 디테일 M07K-D5(마찰만 SF 1.27, HNTT8-5 허용 하중 D-54)
P_M04_LBRKC_PY_PZ·NY_PZ | 볼 테이블 레일–침목 판금 L(C형) | U2_TABLE | 72 | SUS304 t6 | 판금 | 레이저·굽힘 L R6 | 45×45×폭 30, 구멍 20/30(레일 아래 홈 Z −72 — 위 홈은 볼이 렌치 길 막음) | 112.1 | 미확인 | M07-K1: 새로(HBLFSN8 대체). sheet.convert SUS304_t6, 굽힘 90° R6. 디테일 M07K-D4 → t3 R3 + CB5-14 예정
P_DC203_TRAY | 북 받이 판(사방 테두리 15) | U1_FRAME | 1 | SUS304 t1.5 | 판금 | 레이저·굽힘 90° R1.5 ×4 | X −38~378 · Y −276~−40 · Z −250~−233.5, 전개 443.8×263.8, Ø5.5 ×4 | 1380.8 | 미확인 | DC2-03: 새로. 북 떨어뜨림 받이. 양끝 받침(:6 윗면 X 360 · 받침 HFS8-4080-300 X −18) CB5-12 ×4. 오조작 SF 4.41. 디테일 DC203-D5 국부 SF 1.99
P_M08_KDM_BRKT | 다관 커넥터 받침판 | U7_FIXED | 1 | A5052 | 가공 | 밀링·드릴·탭 | 앞판 X 14~20 · Y −194~−112 · Z 618~742(피팅 창 34×82, M3 탭 4 그대로) + 기둥 X 14~46 · Y −200~−194 · Z 340~742 + 발 X 14~46 · Y −200~−180 · Z 334~340(Ø5.5 ×2, X 26·36 · Y −184.5). A5052 t6 굽힘 2(잠정) | 334.5 | 미확인 | STEPSWAP 수정 1(v2.5.7): 새로. 걸이 윗판 위 외팔(Y −90 밖으로 82) — 강도 손계산 보고서 4절 / DC2-08(v2.6.1): U8_PNEU 고정 → U7_FIXED(J_U7_HGT 따라감), 받침을 HANGER Z 650 외팔에서 HOLDER 날개 C 위 기둥으로 다시 그림. 디테일 DC2-08-X1(기둥 강성)·X3(발 구멍–굽힘선 3.5 < 2t)
P_REG02_HGT_PLATE | 공통 높이 판(U6·U7 한 높이 조정) | U7_FIXED | 1 | SUS304 t5 | 절삭 | 밀링·드릴 | X −80~44 · Y −99~−93 · Z 157~330, 장공 폭 5.5 ×4(Z 174~184 X −70·−32 / Z 304~314 X 18·33), 스터드 구멍 Ø4.5 ×4, 패드 1, R3 | 288.9 | 미확인 | REG-02: 새로(C-34). 부피 36,425 mm³(SUS304 7.93 g/cm³). 장공 4번 X 33(v2.6.7 수정 1)
P_U3_LDRV_BRKT | 아랫축 서보 브래킷 | U3_HEAD | 1 | A6061 | 가공 | 밀링 일체 | 플랜지 판 t12 X 418~430(Ø50 H8·M5 탭 4 PCD 70) + 옆벽 t8 ×2 + 바닥판 t8 X 537~545(Ø5.5 ×4 → 4080 −X면) | 937 | 미확인 | MOT-01: 새로. 축선 Y 0·Z −90 가정(D-143)
P_M02_PIVOT_PIN | 레버 피벗 핀 | U4_WHEEL_N | 0 | S45C | 가공 | 선반 | Ø12 g6 Y −60~40.2 + 머리 Ø24×5(Ø4.5 ×2) + 끝 M5 탭 DP10 | 미확인 | 미확인 | MOT-01: 새로. 외팔 손계산 SF 6.3 / M02R(v2.10.3): 지움(C-41)
P_M02_PIVOT_SPACER | 피벗 스페이서 | U4_WHEEL_N | 1 | S45C | 가공 | 선반 | Ø20/Ø12.5 × 12(Y −52~−40) | 미확인 | 미확인 | MOT-01: 새로
P_M02_PIVOT_WASHER | 피벗 끝 와셔 | U4_WHEEL_N | 1 | SUS304 | 가공 | 선반 | Ø20×3 Ø5.5(Y 40.2~43.2, 부시 플랜지와 0.2) | 미확인 | 미확인 | MOT-01: 새로
P_M02_KNUCKLE_PIN | 실린더 너클 핀 | U4_PRESS | 1 | S45C | 가공 | 선반 | Ø8 f7 Y −37~37 + 머리 Ø14×4 + 끝 M4 탭 DP12 | 미확인 | 미확인 | MOT-01: 새로
P_M02_KNUCKLE_SPACER_N | 너클 스페이서(−Y) | U4_PRESS | 1 | SUS304 | 가공 | 선반 | Ø14/Ø8.5 × 20.8(Y −30.8~−10) | 미확인 | 미확인 | MOT-01: 새로
P_M02_KNUCKLE_SPACER_P | 너클 스페이서(+Y) | U4_PRESS | 1 | SUS304 | 가공 | 선반 | Ø14/Ø8.5 × 20.8(Y 10~30.8) | 미확인 | 미확인 | MOT-01: 새로
P_M02_KNUCKLE_WASHER | 너클 핀 끝 와셔 | U4_PRESS | 1 | SUS304 | 가공 | 선반 | Ø14×2 Ø4.5 | 미확인 | 미확인 | MOT-01: 새로
P_M02_CLEVIS_PIN | 실린더 클레비스 핀 | U4_WHEEL_N | 0 | S45C | 가공 | 선반 | Ø8 f7 Y −19.5~19.5 + 머리 Ø14×4 + 끝 M4 탭 DP12 | 미확인 | 미확인 | MOT-01: 새로 / M02R(v2.10.3): 지움(C-41)
P_M02_CLEVIS_WASHER | 클레비스 핀 끝 와셔 | U4_WHEEL_N | 1 | SUS304 | 가공 | 선반 | Ø12×2 Ø4.5 | 미확인 | 미확인 | MOT-01: 새로
P_M03_IDLER_WASHER_O | 아이들러 축 바깥 와셔 | U5_WHEEL_F | 1 | SUS304 | 가공 | 선반 | Ø20×3 Ø5.5(Y 87~90) | 미확인 | 미확인 | MOT-01: 새로
P_M03_IDLER_WASHER_I | 아이들러 축 안 접시 와셔 | U5_WHEEL_F | 1 | SUS304 | 가공 | 선반 | Ø13×3 Ø5.5 + 접시 90° Ø10(Y 115~118) | 미확인 | 미확인 | MOT-01: 새로
P_F01_SHAFT_HLD_N | 플로트 축 받침 블록(−Y) | U5_FLOAT | 1 | SUS304 | 가공 | 밀링·리머 | X −1861~−1833 · Y −55~−37 · Z 116~130, Ø16 H7, M5 멈춤나사 탭 Ø4.2 | 34.8 | 미확인 | FUNC-01(v2.8.0): 새로(F01-M1, 옆판 L꼴이라 축 물림 낼 살 없음)
P_F01_SHAFT_HLD_P | 플로트 축 받침 블록(+Y) | U5_FLOAT | 1 | SUS304 | 가공 | 밀링·리머 | SHAFT_HLD_N 대칭(Y 37~55) | 34.8 | 미확인 | FUNC-01(v2.8.0): 새로(F01-M1)
P_F01_SPRING_SEAT | 받침 스프링 와셔 | U5_FLOAT | 2 | SUS304 | 가공 | 선반 | Ø44/Ø16.5 t3, Z 247~250 | 31.1 | 미확인 | FUNC-01(v2.8.0): 새로. _N·_P
P_M05_BINDER | 접는 바인더(2단 45° 접기 통로) | U7_CASSETTE | 1 | PA12 | 3D 출력 | SLA Rigid 10K | X −11~45.5 · Y −95~−9 · Z 13~60, 통로 폭 31·틈 1.8, 출구 Y −9, 윗면 M5 탭 ×2 | 159.7 | 미확인 | FUNC-01(v2.8.0): 새로(옛 U7_BINDER 임시 상자 대체). 테이프 가정 D-144(C-35). 혀 끝 R0.6·바닥판 R0.5·출구 R1 생략 — 디테일 F01-D6
P_M08_TUBE_COMB_ML_9 | 공압 관 고정품 | U8_PNEU | 1 | A5052 | 가공 | 밀링·드릴·탭 | bbox [992, 1008, 124, 197, 650.1, 698.0], 관 구멍 Ø6.5(Ø8.5) ×8, CB5-16 ×1 | 130.7 | 미확인 | PNEU-01(v2.8.6·v2.8.7): 새로. 관 고정 간격 ≤ 300(E-12 임시 D-b)
P_M08_TUBE_COMB_ML_5 | 공압 관 고정품 | U8_PNEU | 1 | A5052 | 가공 | 밀링·드릴·탭 | bbox [942, 958, 124, 197, 650.1, 698.0], 관 구멍 Ø6.5(Ø8.5) ×8, CB5-16 ×1 | 130.7 | 미확인 | PNEU-01(v2.8.6·v2.8.7): 새로. 관 고정 간격 ≤ 300(E-12 임시 D-b)
P_M08_TUBE_COMB_ML_6 | 공압 관 고정품 | U8_PNEU | 1 | A5052 | 가공 | 밀링·드릴·탭 | bbox [442, 458, 124, 197, 650.1, 698.0], 관 구멍 Ø6.5(Ø8.5) ×8, CB5-16 ×1 | 130.7 | 미확인 | PNEU-01(v2.8.6·v2.8.7): 새로. 관 고정 간격 ≤ 300(E-12 임시 D-b)
P_M08_TUBE_COMB_ML_7 | 공압 관 고정품 | U8_PNEU | 1 | A5052 | 가공 | 밀링·드릴·탭 | bbox [42, 58, 124, 197, 650.1, 718.0], 관 구멍 Ø6.5(Ø8.5) ×8, CB5-16 ×1 | 189.5 | 미확인 | PNEU-01(v2.8.6·v2.8.7): 새로. 관 고정 간격 ≤ 300(E-12 임시 D-b)
P_M08_TUBE_COMB_ML_8 | 공압 관 고정품 | U8_PNEU | 1 | A5052 | 가공 | 밀링·드릴·탭 | bbox [-658, -642, 158, 197, 650.1, 698.0], 관 구멍 Ø6.5(Ø8.5) ×2, CB5-16 ×1 | 69.4 | 미확인 | PNEU-01(v2.8.6·v2.8.7): 새로. 관 고정 간격 ≤ 300(E-12 임시 D-b)
P_M08_TUBE_COMB_U5_1 | 공압 관 고정품 | U8_PNEU | 1 | A5052 | 가공 | 밀링·드릴·탭 | bbox [-108, -92, 158, 197, 650.1, 698.0], 관 구멍 Ø6.5(Ø8.5) ×2, CB5-16 ×1 | 69.4 | 미확인 | PNEU-01(v2.8.6·v2.8.7): 새로. 관 고정 간격 ≤ 300(E-12 임시 D-b)
P_M08_TUBE_COMB_U5_2 | 공압 관 고정품 | U8_PNEU | 1 | A5052 | 가공 | 밀링·드릴·탭 | bbox [-1253, -1237, 158, 197, 650.1, 697.0], 관 구멍 Ø6.5 ×1·Ø7.0 ×1(Ø8.5), CB5-16 ×1 | 67.9 | 미확인 | PNEU-01(v2.8.6·v2.8.7): 새로. 관 고정 간격 ≤ 300(E-12 임시 D-b) / PNEU-01R(v2.8.11): 구멍 (−1235.5, 190, 661) 축 −X Ø6.5 → Ø7.0, 부피 −84.8 mm³, 관 U5_A 겹침 0
P_M08_TUBE_CLAMP_F_1 | 공압 관 고정품 | U8_PNEU | 1 | A5052 | 가공 | 밀링·드릴·탭 | bbox [938, 962, 102, 120, 420, 470], 관 구멍 Ø6.5(Ø8.5) ×2, CB5-16 ×2 | 48.8 | 미확인 | PNEU-01(v2.8.6·v2.8.7): 새로. 관 고정 간격 ≤ 300(E-12 임시 D-b)
P_M08_TUBE_CLAMP_F_2 | 공압 관 고정품 | U8_PNEU | 1 | A5052 | 가공 | 밀링·드릴·탭 | bbox [638, 662, 102, 120, 420, 470], 관 구멍 Ø6.5(Ø8.5) ×2, CB5-16 ×2 | 48.8 | 미확인 | PNEU-01(v2.8.6·v2.8.7): 새로. 관 고정 간격 ≤ 300(E-12 임시 D-b)
P_M08_TUBE_CLAMP_F_3 | 공압 관 고정품 | U8_PNEU | 1 | A5052 | 가공 | 밀링·드릴·탭 | bbox [338, 362, 102, 120, 420, 470], 관 구멍 Ø6.5(Ø8.5) ×2, CB5-16 ×2 | 48.8 | 미확인 | PNEU-01(v2.8.6·v2.8.7): 새로. 관 고정 간격 ≤ 300(E-12 임시 D-b)
P_M08_TUBE_CLAMP_F_4 | 공압 관 고정품 | U8_PNEU | 1 | A5052 | 가공 | 밀링·드릴·탭 | bbox [38, 62, 102, 120, 420, 470], 관 구멍 Ø6.5(Ø8.5) ×2, CB5-16 ×2 | 48.8 | 미확인 | PNEU-01(v2.8.6·v2.8.7): 새로. 관 고정 간격 ≤ 300(E-12 임시 D-b)
P_M08_TUBE_CLAMP_F_5 | 공압 관 고정품 | U8_PNEU | 1 | A5052 | 가공 | 밀링·드릴·탭 | bbox [-112, -88, 102, 120, 420, 470], 관 구멍 Ø6.5 ×2, CB5-16 ×2 | 48.8 | 미확인 | PNEU-01(v2.8.6·v2.8.7): 새로. 관 고정 간격 ≤ 300(E-12 임시 D-b) / PNEU-01 수정 2(v2.8.8): X -120 → -100(관 꺾임점 X -125 원호 밖 곧은 구간). 볼트 X -106·-94, 보 탭 옮김(옛 탭 메움)
P_M08_TUBE_CLAMP_L_1 | 공압 관 고정품 | U8_PNEU | 1 | A5052 | 가공 | 밀링·드릴·탭 | bbox [1088, 1112, 102, 120, 268, 304], 관 구멍 Ø6.5(Ø8.5) ×1, CB5-16 ×2 | 33.2 | 미확인 | PNEU-01(v2.8.6·v2.8.7): 새로. 관 고정 간격 ≤ 300(E-12 임시 D-b)
P_M08_TUBE_CLAMP_L_2 | 공압 관 고정품 | U8_PNEU | 1 | A5052 | 가공 | 밀링·드릴·탭 | bbox [788, 812, 102, 120, 252, 304], 관 구멍 Ø6.5(Ø8.5) ×2, CB5-16 ×2 | 49.6 | 미확인 | PNEU-01(v2.8.6·v2.8.7): 새로. 관 고정 간격 ≤ 300(E-12 임시 D-b)
P_M08_TUBE_CLAMP_L_3 | 공압 관 고정품 | U8_PNEU | 1 | A5052 | 가공 | 밀링·드릴·탭 | bbox [488, 512, 102, 120, 252, 284], 관 구멍 Ø6.5(Ø8.5) ×1, CB5-16 ×2 | 30.1 | 미확인 | PNEU-01(v2.8.6·v2.8.7): 새로. 관 고정 간격 ≤ 300(E-12 임시 D-b)
P_M08_TUBE_CLAMP_L_4 | 공압 관 고정품 | U8_PNEU | 1 | A5052 | 가공 | 밀링·드릴·탭 | bbox [188, 212, 102, 120, 252, 284], 관 구멍 Ø6.5(Ø8.5) ×1, CB5-16 ×2 | 30.1 | 미확인 | PNEU-01(v2.8.6·v2.8.7): 새로. 관 고정 간격 ≤ 300(E-12 임시 D-b)
P_M08_TUBE_CLAMP_L_5 | 공압 관 고정품 | U8_PNEU | 1 | A5052 | 가공 | 밀링·드릴·탭 | bbox [-112, -88, 102, 120, 252, 284], 관 구멍 Ø6.5(Ø8.5) ×1, CB5-16 ×2 | 30.1 | 미확인 | PNEU-01(v2.8.6·v2.8.7): 새로. 관 고정 간격 ≤ 300(E-12 임시 D-b)
P_M08_TUBE_CLAMP_L_6 | 공압 관 고정품 | U8_PNEU | 1 | A5052 | 가공 | 밀링·드릴·탭 | bbox [-262, -238, 102, 120, 252, 284], 관 구멍 Ø6.5(Ø8.5) ×1, CB5-16 ×2 | 30.1 | 미확인 | PNEU-01(v2.8.6·v2.8.7): 새로. 관 고정 간격 ≤ 300(E-12 임시 D-b)
P_M08_RISER_COMB_1 | 공압 관 고정품 | U8_PNEU | 1 | A5052 | 가공 | 밀링·드릴·탭 | bbox [1040, 1112, -15, 120, 396, 432], 관 구멍 Ø6.5 ×9·Ø7.0 ×1(Ø8.5), CB5-16 ×2 | 243.5 | 미확인 | PNEU-01(v2.8.6·v2.8.7): 새로. 관 고정 간격 ≤ 300(E-12 임시 D-b) / PNEU-01R(v2.8.11): 구멍 (1049.75, 53) 축 Z Ø6.5 → Ø7.0, 부피 −42.4 mm³, 관 U4_B 겹침 0
P_M08_RISER_COMB_2 | 공압 관 고정품 | U8_PNEU | 1 | A5052 | 가공 | 밀링·드릴·탭 | bbox [1040, 1112, -15, 120, 616, 648], 관 구멍 Ø6.5(Ø8.5) ×8, CB5-16 ×2 | 238.7 | 미확인 | PNEU-01(v2.8.6·v2.8.7): 새로. 관 고정 간격 ≤ 300(E-12 임시 D-b)
P_M08_TUBE_CLAMP_SO_1 | 공압 관 고정품 | U8_PNEU | 1 | A5052 | 가공 | 밀링·드릴·탭 | bbox [904, 1003, 45, 120, 232, 272], 관 구멍 Ø6.5 ×3(U6·REG1_OUT X989, REG1_OUT 멍에 X912), CB5-16 ×2 | 188.3 | 미확인 | PNEU-01(v2.8.6·v2.8.7): 새로. 관 고정 간격 ≤ 300(E-12 임시 D-b) / PNEU-01 수정 2(v2.8.8): 블록 X 981~997(U6·REG1_OUT 곧은 구간), 멍에 X 904~920 더함(REG1_OUT 자유 구간 314 → 264), 볼트 X 944·976 그대로
P_M08_TUBE_CLAMP_SO_2 | 공압 관 고정품 | U8_PNEU | 1 | A5052 | 가공 | 밀링·드릴·탭 | bbox [709.1, 749.1, 74.0, 120, 296, 322], 관 구멍 Ø6.5(Ø8.5) ×1, CB5-16 ×2 | 36.9 | 미확인 | PNEU-01(v2.8.6·v2.8.7): 새로. 관 고정 간격 ≤ 300(E-12 임시 D-b)
P_M08_TUBE_CLAMP_SO_3 | 공압 관 고정품 | U8_PNEU | 1 | A5052 | 가공 | 밀링·드릴·탭 | bbox [907.94, 947.94, 87.0, 120, 296, 322], 관 구멍 Ø6.5(Ø8.5) ×1, CB5-16 ×2 | 31.3 | 미확인 | PNEU-01(v2.8.6·v2.8.7): 새로. 관 고정 간격 ≤ 300(E-12 임시 D-b)
P_M08_TUBE_BRKT_U6 | 공압 관 고정품 | U4_WHEEL_N | 1 | A5052 | 가공 | 밀링·드릴·탭 | bbox [-356, -330, -16, 16, 222, 272], 관 구멍 Ø6.5(Ø8.5) ×1, CB5-16 ×2 | 50.8 | 미확인 | PNEU-01(v2.8.6·v2.8.7): 새로. 관 고정 간격 ≤ 300(E-12 임시 D-b)
P_M08_TUBE_COMB_KDM | 공압 관 고정품 | U8_PNEU | 1 | A5052 | 가공 | 밀링·드릴·탭 | bbox [-88, -8, 36, 120, 620, 745], 앞판 Y88~96 + 날개 t6 + 귀, 관 구멍 Ø6.5 ×12, 렌치 구멍 Ø10 ×2, CB5-16 ×2 | 399.8 | 미확인 | PNEU-01(v2.8.6·v2.8.7): 새로. 관 고정 간격 ≤ 300(E-12 임시 D-b) / PNEU-01 수정 2(v2.8.8): 앞판 Y 112~120 → 88~96(관 6줄 R30 원호 밖), 아래 날개·귀로 보 앞면 볼트 자리 그대로, 기운 관 구멍 길이 늘림
P_M08_TUBE_BRKT_KDM | 공압 관 고정품 | U7_FIXED | 1 | A5052 | 가공 | 밀링·드릴·탭 | bbox [-76, 46, -196, -116, 742, 750], 관 구멍 Ø6.5(Ø8.5) ×6, CB5-16 ×2 | 204.0 | 미확인 | PNEU-01(v2.8.6·v2.8.7): 새로. 관 고정 간격 ≤ 300(E-12 임시 D-b)
P_M08_TUBE_CLAMP_CAR | 공압 관 고정품 | U5_CAR | 1 | A5052 | 가공 | 밀링·드릴·탭 | bbox [-1995, -1950, 48, 80, 396, 416], 관 구멍 Ø6.5(Ø8.5) ×2, CB5-16 ×2 | 34.9 | 미확인 | PNEU-01(v2.8.6·v2.8.7): 새로. 관 고정 간격 ≤ 300(E-12 임시 D-b)
P_M08_TUBE_BRKT_ARM_1 | 공압 관 고정품 | U5_CAR | 1 | A5052 | 가공 | 밀링·드릴·탭 | bbox [-1990, -1950, 46, 100, 604, 644], 관 구멍 Ø6.5(Ø8.5) ×2, CB5-16 ×2 | 55.9 | 미확인 | PNEU-01(v2.8.6·v2.8.7): 새로. 관 고정 간격 ≤ 300(E-12 임시 D-b)
P_M08_TUBE_BRKT_ARM_2 | 공압 관 고정품 | U5_CAR | 1 | A5052 | 가공 | 밀링·드릴·탭 | bbox [-1990, -1950, 140, 180, 800, 836], 관 구멍 Ø6.5(Ø8.5) ×2, CB5-16 ×2 | 47.2 | 미확인 | PNEU-01(v2.8.6·v2.8.7): 새로. 관 고정 간격 ≤ 300(E-12 임시 D-b)
P_M08_TUBE_BRKT_CST_V | 공압 관 고정품 | U7_CASSETTE | 1 | A5052 | 판금 | 레이저·굽힘 | bbox [58, 146, -164, -127, 296, 536], 띠 t4 폭 30, 가로판 Z340·Z532, 관 구멍 Ø6.5 ×10 + FEED_A 여유 Ø12, CB5-12 ×2(아래 2) + CB5-16 ×2 | 134.9 | 미확인 | PNEU-01(v2.8.6·v2.8.7): 새로. 관 고정 간격 ≤ 300(E-12 임시 D-b) / PNEU-01 수정 2(v2.8.8): 띠 폭 13 → 30(오조작 SF 0.70 → 1.53), 윗 가로판 Z520 → 532(FEED_B 원호 밖), 아래판 FEED_A는 여유 구멍 / RX-06-C2(v2.15.2): 형상 그대로. 카세트 판에 무는 아래 볼트 2개 CB5-16_M05_1:2·:3 → CB5-12_M05_7:2·:3(끝이 P_M05_HOLDER 벽 살을 4 mm 뚫던 것, 물림 8 = 1.6d)
P_M08_TUBE_BRKT_CST_O | 공압 관 고정품 | U7_CASSETTE | 1 | SPCC | 잠정: 판금 SPCC t6 굽힘 2 — M-04 미달(판 사이 18 < 24, 구멍–끝 3.8 < 9, 구멍 사이 6.24 < 12, 판금 기능 바디 아님), 디테일링 M-13 4가지 비교(밀링 블록·판 둘로 나눔·얇은 판 등)로 정함 | 레이저·굽힘 | bbox [58.0, 88.0, -266.0, -185.0, 92.0, 216.0] | 457.2 | 미확인 | PNEU-01(v2.8.6·v2.8.7): 새로. 관 고정 간격 ≤ 300(E-12 임시 D-b) / PNEU-01 수정 2(v2.8.8): 형상 그대로(결정로그 PNEU01-E01·E02) / RX-06-C2(v2.15.1): 형상 값 변화 0. 이 바디를 고치던 루트 피처(탭·구멍 cut)를 이 부품의 컴포넌트 피처로 옮김(조인트로 움직일 때 구멍이 따라감)
P_M08_AIR_IN_BRKT | 공압 관 고정품 | U8_PNEU | 1 | A5052 | 판금 | 레이저·굽힘 | bbox [1148, 1166, 96, 120, 256, 304], 관 구멍 Ø13.2, CB5-16 ×2 | 17.6 | 미확인 | PNEU-01(v2.8.6·v2.8.7): 새로. 관 고정 간격 ≤ 300(E-12 임시 D-b) / PNEU-01 수정 2(v2.8.8): Z 266~294 → 256~304, 볼트 Z 273·287 → 261·299(KQ2E08 몸과 머리 겹침 29 mm³ 없앰), 보 탭 옮김
P_M06_PCYL_BRKT | 슈 누름 실린더 브래킷(L) | U6_SHOE | 1 | SUS304 t3 | 판금 | 레이저·굽힘 90° R3 | X −22~0 · Y −184.5~−122 · Z 74.3~94, 구멍 Ø8.5 (Y −166) + Ø5.5 ×2(Y −177·−128, Z 86) | 52.2 | 미확인 | U6S(v2.9.0): 새로. CJ2B10-15Z_M06P 장착. 디테일 U6S-D2 M-04 구멍–굽힘선 7.14·6.35 < 9, 구멍–끝 3.25 < 4.5 / RX-10(v2.17.2): 실린더 축 Y −152 → −166을 따라 −Y 끝 −176 → −184.5, Ø8.5 구멍 Y −166, 벽 구멍 Y −170 → −177(−128 그대로). 부피 5,643.7 → 6,581.2 mm³, 44.8 → 52.2 g. 옮긴 구멍–끝 4.75 ≥ 1.5t 4.5(전 3.25). Y −128 구멍–끝 3.25·벽 구멍–굽힘선은 그대로 미달(U6S-D2). 오조작 SF 4.88
P_M06_SLIDE_COLLAR | 슈 안내 턱 칼라 | U6_SHOE | 2 | SUS304 | 가공 | 선반 | 축 Ø7.0×2.1 + 턱 Ø12×1.5, 구멍 Ø5.5 | 미확인 | 미확인 | U6S(v2.9.0): 새로. _1·_2, 슈 장공 안내. 디테일 U6S-D7 조임 ≤ 1.2 N·m + 나사 고정제
P_M02S_SWING | 그네 브래킷(서보·감속기·바퀴 매달기) | U4_PRESS | 1 | A5052 | 가공 | 밀링·드릴 | L 단면 X −320~−161, 보스 Ø26 축 (Y 120, Z 140), 텅 t10 장공 폭 8.2 | 750 | 미확인 | M02R(v2.10.3): 새로(C-41)
P_M02S_CYL_BRKT | 실린더 브래킷(보 밑) | U4S_CYL | 1 | SUS304 | 판금(지금 밀어내기) | 레이저·굽힘 | t6 L, X −265~−215, 다리 Z 205~242 + 윗날개 Z 236~242(윗판 밑), 볼트 머리 홈 2 | 미확인 | 미확인 | M02R(v2.10.3): 새로. 판금 변환은 디테일 / RX-06(v2.11.0): 보 대신 윗판 밑면에 CB5-12 ×2 밑에서(볼트 끝 Z 248). 실린더 볼트 머리 자리 홈 10.5×6
P_M02S_PIVOT_BRKT_A | 피벗 브래킷 A | U4_WHEEL_N | 1 | SUS304 | 판금(지금 밀어내기) | 레이저·굽힘 | t4 L, 구멍 Ø12.1 | 미확인 | 미확인 | M02R(v2.10.3): 새로
P_M02S_PIVOT_BRKT_B | 피벗 브래킷 B | U4_WHEEL_N | 1 | SUS304 | 판금(지금 밀어내기) | 레이저·굽힘 | t4 L, 구멍 Ø12.1 | 미확인 | 미확인 | M02R(v2.10.3): 새로 / RX-06(v2.11.0): 위 탭 (−168,126) 메우고 (−159,110) 새로(BASE_4 옮김)
P_M02S_SPRING_TAB_1 | 스프링 탭 | U4_WHEEL_N | 1 | SUS304 | 판금(지금 밀어내기) | 레이저·굽힘 | t4 날개 33 × 20(X −311.5~−278.5 · Y 40~60 · Z 238~242), 볼트 구멍 Ø5.5 ×2(s±12), 다리 고리 구멍 Ø4.5 | 22.73 | 미확인 | M02R(v2.10.3): 새로 / M02R(v2.14.0): 행을 바디 이름대로 _1·_2로 나눔(수량 합 2 그대로). 날개 X s±12 → s±16.5(24 → 33), 볼트 구멍 s±7 → s±12(윗고리–볼트 머리 겹침 풀기, 틈 1.75·2.75). 2,866.35 mm³. 구멍 살 X 1.75 < 2.5 — 열린 디테일 M02R-D5(디테일링에서 s±18.5·37 × 20, 25.27 g)
P_M02S_SPRING_TAB_2 | 스프링 탭 | U4_WHEEL_N | 1 | SUS304 | 판금(지금 밀어내기) | 레이저·굽힘 | t4 날개 33 × 20(X −201.5~−168.5 · Y 40~60 · Z 238~242), 볼트 구멍 Ø5.5 ×2(s±12), 다리 고리 구멍 Ø4.5 | 22.73 | 미확인 | M02R(v2.10.3): 새로 / M02R(v2.14.0): 행을 바디 이름대로 _1·_2로 나눔(수량 합 2 그대로). 날개 X s±12 → s±16.5(24 → 33), 볼트 구멍 s±7 → s±12(윗고리–볼트 머리 겹침 풀기, 틈 1.75·2.75). 2,866.35 mm³. 구멍 살 X 1.75 < 2.5 — 열린 디테일 M02R-D5(디테일링에서 s±18.5·37 × 20, 25.27 g)
P_RX06_CARRIAGE | U4 X 캐리지(한 덩어리) | U4_XCAR | 1 | A5052 | 가공 | 밀링·드릴·탭 | 웹 X −240~−125·Y 95~107·Z 250~482 + 발 Y 45~107·Z 250~262 + 웹 M5 탭(Ø4.2 관통, 축 Y) 2 @ (X −225·−140, Z 468) + 발 M5 통과 6 + 관 장공 8×18, 383,445.75 mm³ | 1027.6 | 미확인 | RX-06: 새로. 블록 4(M2.6/M3 체결은 디테일), 윗판에 CB5-16 ×6 위에서 / RX-06R(v2.15.0, C-46): 웹 윗끝 Z 565 → 482(스케치 점을 고쳐 한 덩어리 그대로), 볼나사 너트 귀·Ø47 구멍·M6 탭 4 없앰, 잠금 볼트 M5 탭 2 더함(물림 10.3 = 2.06d). 1,379.2 → 1,027.6 g(−351.5). 뿌리 단면 SF 14.0(오조작) — 과사양 메모
P_RX06_STOP_A | 끝 멈춤 A(d1 195) | U4_XAXIS | 1 | SUS304 | 가공 | 밀링 | X −335~−333·Y 108~112.5·Z 260~272 (2×4.5×12), R1 레일 윗면 | 0.9 | 미확인 | RX-06: 새로. 고정법(탭·핀·레일 끝 스토퍼)은 디테일
P_RX06_STOP_B | 끝 멈춤 B(d1 100) | U4_XAXIS | 1 | SUS304 | 가공 | 밀링 | X −127~−125·Y 108~112.5·Z 260~272 | 0.9 | 미확인 | RX-06: 새로 / RX-06R(v2.15.0): 레일이 실물 STEP SSEB13-220(X −335~−115)이 되어 +X 끝이 멈춤 밖으로 10 나옴(겹침 0 | 디테일 RX-06R-D4)
P_RX08_STOP_BRKT | U4 스토퍼 받침(다리·발·립·윗판) | U4_WHEEL_N | 1 | SUS304 | 가공 | 밀링·드릴·탭 | XZ 단면 Y 64~104 밀기, 발 X −268~−140·Z 60~72, 립 Z 72~112, 기둥 X −152~−140·Z 72~242, 윗판 Z 234~242, 키 홈, 립 Ø5.5 ×4·윗판 Ø5.5 ×2, 113,894 mm³ | 903.2 | 미확인 | RX-08: 새로(v2.12.0). 디테일 RX-08 D1 윗판 SF 2.07/1.40 → t12 권고
P_RX08_STOP_BLOCK | U4 멈춤 블록(조절 볼트 자리) | U4_STOP | 1 | SUS304 | 가공 | 밀링·탭 | X −167~−143.5(OFF), M10 탭(로드)·M8 탭(조절 볼트 CB8-20), 22,667 mm³ | 179.8 | 미확인 | RX-08: 새로(v2.12.0). J_U4_STOP 0~20로 X 이동. 디테일 D2 CB8-20 물림 10.28 < 12
P_RX06R_LOCK_BLADE_판금 | U4 X 잠금 날(Z자 판금) | U4_XAXIS | 1 | SUS304 | 판금 | 레이저·굽힘 | t2 Z자(굽힘 2, 안쪽 R2, 90°), X −335~−122(213) · 매달린 다리 Y 92.5~94.5·Z 457~545 · 선반 Z 543~545 · 고정 플랜지 Y 118~120·Z 543~577, 긴 구멍 폭 5.5(X −324.25~−135.75, Z 468) · 고정 구멍 Ø5.5 ×4 @ X −315·−255·−195·−135·Z 562, 전개 142.55 × 213, 58,633.89 mm³ | 465.0 | 미확인 | RX-06R(v2.15.0, C-46): 새로(볼나사·손잡이 대신 d₁ 고정). 보 앞면에 CB5-12 ×4(4 N·m), 캐리지 웹과 누름 판 사이에 물림. 판금 기능으로 그림(전개 확인, M-04 10항목 합격). 날–웹 틈 0.5(굽힘 너머 ±0.3). 디테일 RX-06R-D2·D5·D6(조임 굽힘 SF 2.26 < 3 → t1.2 권고)·D8(눈금)
P_RX06R_LOCK_CLAMP_레이저 | U4 X 잠금 누름 판 | U4_XCAR | 1 | SUS304 | 레이저 | 레이저 | t3 110 × 20, X −237.5~−127.5·Y 89.3~92.3·Z 458~478, Ø5.5 ×2 @ X −225·−140·Z 468, 6,457.47 mm³ | 51.2 | 미확인 | RX-06R(v2.15.0, C-46): 새로. 잠금 볼트 CB5-16 ×2(3 N·m) 머리 밑. 굽힘 SF 5.79·3.62
P_RX11_SADDLE | 롤러 축 새들 | U2_TABLE | 8 | A5052 | 가공 | 밀링·드릴(밀링 잠정) | T자 단면 14 × 53 × 14: 귀 Y ±26.5 · Z −8~−2, 몸통 Y ±22.5 · Z −16~−8, X 두께 14. 축 홈 4(Y ±11, 폭 6.2, 양쪽 X면에서 깊이 6, 바닥 R 3.1, 가운데 벽 2, 위로 열림). 볼트 구멍 Ø5.5 + 카운터보어 Ø9.5 × 6. X 중심 −1838 + 216k(k 0~7) | 19.67 | 미확인 | RX-11(v2.17.0): 새로. 판 긴 홈에 위에서 끼워 귀가 판 윗면 Z −8에 얹힘(볼과 같은 기준면). 7,338.96 mm³. v2.17.1: 볼트 조임 0.6 N·m 지정으로 SF 3.76~3.91(3 N·m면 항복 SF 0.75~0.78). 디테일 RX-11-V1-1·F7(예압 흩어짐 SF 2.17~2.93)·V1-2·F3(손 100 N 미끄럼)·D1(카운터보어 살 2.25)·D4(볼 테 틈 1.52)
P_RX11_CLAMP | 롤러 새들 클램프 | U2_TABLE | 8 | A5052 | 가공 | 밀링·탭(밀링 잠정) | ㄷ자 단면 14 × 60 × 19: Y ±30 · Z −31~−12, 윗면 가운데 Y ±23.5를 Z −16.5까지 낮춤, X 두께 14. 가운데 M5 관통 탭 | 34.30 | 미확인 | RX-11(v2.17.0): 새로. 판 밑면 Z −12에 기둥이 닿아 새들과 판(t4)을 물림. 12,798.14 mm³. 0.6 N·m에서 SF 7.66~8.72. 디테일 RX-11-F8(기둥 닿는 면 |Y| 23.5~30 ↔ 귀 23~26.5 어긋남)
