hyeunung/FSAP/docs/bom/FSAP_v2.17.2_purchased.csv

형번 | 이름 | 구매처 | 수량 | 모델 바디 | 가격 | 자료대기 | 비고
CB5-16 | 육각 구멍붙이 볼트 M5×16 | 미스미 | 28 | CB5-16_M01_1~10 | 미확인 | - | M01: 새로. 실물 STEP. 1~6 매달기 선반→헤드 윗면, 7~10 세운 판→U1_BEAM 앞면. 물림 8(디테일 M01-X4·F2·F3) / M08: +18(브래킷·관 빗 ×4)
867-392342(분리 개조) | 3중 이송 재봉 헤드 Dürkopp 867 임시 | 미확인 | 1 | STEP대기_867-392342_UPPER·_NOSE·_LOWER | 미확인 | D-10·D-109 | M01: 새로. STEP대기 임시 형상(867 공식 PDF 암 밑 335×125·들림 20·가마 Ø32). STEP 수령 → 바디 교체 / DC2-03: LOWER −Y 면 북 문 자리 X ±15·Y −60~−10·Z −41~−12 자름(임시 D-10·D-108) / FUNC-01(v2.8.0): 바늘판 아랫날개 홈 X −4~10 · Y −45~12 · Z −1.4~0(−1,099.6 mm³)
CDM2C20-25Z | 공압 실린더 Ø20 st25 1산 클레비스 | 미스미(SMC) | 0 | CDM2C20-25Z(U4_CYL·U4_CYL_CLEVIS·U4_ROD·U4_ROD_NUT) | 미확인 | D-111 | M02: 새로. 실물 STEP. 설계 형번 CDM2C20-25AZ와 같은 사양의 미스미 표기. 누름 100 N에 0.332 MPa. 포트 ±X(디테일) / M02R(v2.10.3): 지움(C-41, 바디·조인트 지움, 빈 컴포넌트 남음 — v2.11.0에서 정리) / M02R(v2.14.0): 남아 있던 빈 컴포넌트(CDM2C20-25Z 밑 U4_CYL·U4_CYL_CLEVIS·U4_ROD·U4_ROD_NUT)와 import 피처 지움 — 모델에 없음(v2.11.0이 아니라 v2.14.0에서 정리)
I-020B | 로드 끝 1산 클레비스 | 미스미(SMC) | 0 | I-020B_M02 | 미확인 | D-111 | M02: 새로. 실물 STEP(I-020A 대신) / M02R(v2.10.3): 지움(C-41, 바디·조인트 지움, 빈 컴포넌트 남음 — v2.11.0에서 정리) / M02R(v2.14.0): 빈 컴포넌트 I-020B_M02 지움 — 모델에 없음
6004ZZ | 깊은 홈 볼 베어링 | 미스미 | 2 | 6004ZZ_M02_1·_2 | 미확인 | D-111 | M02: 새로. 실물 STEP(볼 바디 빠짐, M02-X8 다시 받기)
E32-D36P1 2M | 매트 유무 화이버 헤드 | 미스미(옴론) | 1 | E32-D36P1_2M_M02 | 미확인 | D-111 | M02: 새로. 실물 STEP
CB5-16 | 육각 구멍붙이 볼트 M5×16 | 미스미 | 36 | CB5-16_M02_1~21 | 미확인 | - | M02: 추가(M01 10과 별도 행). BASE→BEAM 4·옆판→앞판 4·옆판→막대 2·하우징 4·받침판 4·원판 3 / M04R: CB5-16_M02_15~18 4개 지움(센터판 자리 받침판) / M08: +18(브래킷·관 빗 ×4) / MOT-01(v2.7.0): CB5-16_M02_5~8 Z 70±15 → ±19로 옮김(Ø50 H8 관통 구멍과 겹침 풀기), 수량 같음 / RX-06(v2.11.0): BASE→BEAM 4(CB5-16_M02_1~4)를 캐리지 발→윗판으로 옮기고 +2(CB5-16_M02_1:2·:3) — 수량 +2 / M02R(v2.14.0): 빈 컴포넌트 CB5-16_M02_10 지움. 바디는 v2.10.3에서 이미 없어졌는데 수량에 남아 있어 −1(모델 바디 CB5-16_M02_n 18개 = 1~9, 11~14, 19~21, 1:2·1:3 — 서명 표 v2.14.0)
CB5-12 | 육각 구멍붙이 볼트 M5×12 | 미스미 | 25 | CB5-12_M02_1·_2 | 미확인 | - | M02: 새로. CYLBRKT→BASE / M08: +29(이음판·L 브래킷·HMI·커튼 금구·다관 커넥터) / DC2-08: CB5-12_M08_NZ_KDM ×2(옛 받침 → HANGER) 지우고 CB5-12_M08_PZ_KDM ×2(받침 발 → HOLDER 날개 C, 위에서 −Z) 새로 — 수량 증감 0 / STEPSWAP r4(v2.6.8): 레귤레이터 브래킷용 CB5-12_M08_PY:1~6 지움(실물 브래킷 열쇠 구멍 M4) — −6 / M02R(v2.14.0): 빈 컴포넌트 CB5-12_M02_2 지움(바디는 전부터 0, 수량 증감 0). CB5-12_M02_1은 바디 0이지만 CB5-12_DC205의 복사 원본이라 남김(디테일 M02R-D9) / RX-11(v2.17.0): CB5-12_DC205 ×8(띠 누름판 볼트)과 그 행을 지움 — 띠를 롤러 2줄로 바꿈(C-45)
SV2RL28-1800 | LM 가이드 레일 L1800 + 블록 2 | 미스미(THK) | 1 | SV2RL28-1800(RAIL·BLOCK ×2) | 미확인 | D-114 | M03: 새로. 실물 STEP. 레일 보 앞면 Y 104.5~120 · Z 290~310, 블록은 U5_CAR
HTPA60S5M150-A-N16 | S5M 60T 풀리 구멍 Ø16(구동) | 미스미 | 1 | HTPA60S5M150-A-N16_M03(실물 STEP) | 미확인 | - | M03: 새로. N30 STEP을 구멍 Ø16으로 보는 임시 형상. STEP 수령 → 바디 교체 / STEPSWAP(v2.5.6): 실물 STEP으로 교체, 같은 자리(-2220, 95.5~117.5, 390)
HTPA60S5M150-A-N30 | S5M 60T 풀리(아이들러) | 미스미 | 1 | HTPA60S5M150-A-N30_M03 | 미확인 | - | M03: 새로. 실물 STEP
6200ZZ | 깊은 홈 볼 베어링 10×30×9 | 미스미 | 2 | 6200ZZ_M03:1·:2(실물 STEP, 볼은 STEP에 없음) | 미확인 | - | M03: 새로. STEP대기 임시 형상(JIS). STEP 수령 → 바디 교체 / STEPSWAP(v2.5.6): 실물 STEP, Y 97~106·106~115
HTBO-S5M150-792(HTBNS5M150-3960 대체) | S5M 타이밍 벨트 폭 15 오픈 엔드 L3960 | 미스미 | 1 | HTBO-S5M150-792_M03(위 가닥+감긴 반원 2)·_M03_L(아래 가닥, 참고) | 미확인 | - | M03: 새로. 임시 띠(두께 3.4·폭 15). STEP 수령 → 바디 교체 / STEPSWAP(v2.5.6): 실행 규칙 18 대체 형번 HTBO-S5M150-792(폴리우레탄·스틸 코드, 792T=3960). 곧은 STEP을 위·아래 가닥으로 잘라 쓰고 풀리 감긴 반원은 띠 단면 회전(REST 형상)
MGPM25-40Z | 가이드 실린더 Ø25 st40(승강) | 미스미(SMC) | 1 | MGPM25-40Z_M03(몸·플러그 U5_CAR, 끝판+봉 하위 부품 U5_LIFT) | 미확인 | D-114 | M03: 새로. STEP대기 임시 형상(몸 93×42×97). 가이드봉 오조작 SF 1.94(M03-V5). STEP 수령 → 바디 교체 / STEPSWAP(v2.5.6): 실물 STEP. 가운데 X -1940 → -1920(끝판 탭 줄 Y 46이 옆판 플랜지 CB5-12(-1975, 46)와 겹쳐 옮김). 몸 뒤 M6 탭(깊이 12)에 대차판 뒤에서 CB6-20, 끝판 M6 탭(깊이 8.46)에 밑에서 CB6
2400.05.075.0 | igus 케이블 베어(대차) | igus | 1 | 2400.05.075.0 | 미확인 | D-88 | M03: 새로. 실물 STEP 긴 가닥을 잘라 약 22링크(실행 규칙 18) / PNEU-01(v2.8.6·v2.8.7): 23링크 × 46 = 1,058 mm(BOM 22 → 23, 대기 때 아래 가닥 ≥ 46). 모델은 행정 표시 모형(아래 17·위 17·굽힘 5, J_U5_X motion link), 안에 관 2줄
2400.05.12PZ | igus 체인 끝 브래킷 | igus | 2 | STEP대기_2400.05.12PZ_F·_M | 미확인 | D-115 | M03: 새로. 형번 임시(M03-X4). STEP대기 임시 형상. STEP 수령 → 바디 교체 / PNEU-01R(v2.8.12): STEP대기_2400.05.12PZ_F 관 통로 (Y 250, Z 661) Ø6.5 → Ø7.5(임시 형상 가공 자리, 실물 STEP 오면 다시 확인), 관 U5_A 겹침 0
E32-D36P1 2M | 매트 유무 화이버 헤드(먼 쪽) | 미스미(옴론) | 1 | E32-D36P1_2M_M03 | 미확인 | - | M03: 추가 1. 실물 STEP
MBIS5-6.5-8 | M5 열압입 인서트 | 미스미 | 4 | MBIS5-6.5-8 ×4 | 미확인 | - | M03: 새로. 실물 STEP. 벨트 클램프
CB5-16 | 육각 구멍붙이 볼트 M5×16 | 미스미 | 30 | CB5-16_M03 | 미확인 | - | M03: 추가 12(별도 행). 목록 tools/out/mech_M03/model/changed_bolts.json / M08: +18(브래킷·관 빗 ×4) / MOT-01(v2.7.0): CB5-16_M03_9~12 Z 70±15 → ±19로 옮김(같은 이유), 수량 같음
CB5-20 | 육각 구멍붙이 볼트 M5×20 | 미스미 | 8 | CB5-20_M03 | 미확인 | - | M03: 추가 16. 1~4 X 감속기·5~8 바퀴 감속기 렌치 길 막힘(M03-V1·V2) / MOT-01(v2.7.0): CB5-20_M03_1~8 지움(X·바퀴 감속기 자리, PGX 관통 플랜지로 감속기 쪽 CB5-16로 바꿈) — −8
CB5-12 | 육각 구멍붙이 볼트 M5×12 | 미스미 | 35 | CB5-12_M03 | 미확인 | - | M03: 추가 10. 옆판 플랜지 물림 6 → 3.5 N·m 이하(M03-V7) / M08: +29(이음판·L 브래킷·HMI·커튼 금구·다관 커넥터) / FUNC-01(v2.8.0): −4(CB5-12_M03_7~10 지움, 승강판 창)
CB6-20 | 육각 구멍붙이 볼트 M6×20 | 미스미 | 6 | CB6-20_M03_CAR:1~4·CB6-20_M03_LIFT:1~2(실물 STEP) | 미확인 | - | M03: 새로. STEP대기 임시 형상(JIS B1176 머리 Ø10×6). STEP 수령 → 바디 교체 / STEPSWAP(v2.5.6): 실물 STEP. 대차판 뒤 → MGP 몸 ×4(물림 8), 옆판 플랜지+승강판 → MGP 끝판 ×2(물림 6). 끝판 Y 72 줄 2개는 CB6-16으로(별도 행) / RX-06(v2.11.0): +4 BSS2020 너트 플랜지→캐리지 귀(CB6-20_M03_CAR:5~8, 같은 형번 컴포넌트 공유) / RX-06R(v2.15.0, C-46): −4(볼나사 너트 볼트 CB6-20_M03_CAR:5~8 걷어 냄, 모델 6 = CAR:1~4 + LIFT:1~2). 컴포넌트 공유 디테일 RX-06-D6 소멸
CB6-16 | 육각 구멍붙이 볼트 M6×16 | 미스미 | 2 | CB6-16_M03_LIFT:1~2(실물 STEP) | 미확인 | - | STEPSWAP r2(v2.5.9): 실물 STEP으로 바꿈(머리 밑면 Z 156 승강판 밑면 | 같은 자리) / STEPSWAP: 새로. 승강판(t8) → MGP 끝판 M6 탭(깊이 8.46) 물림 8. CB6-20은 바닥에 닿아 못 씀. STEP 없음(이번 실행 Chrome 미스미 탭 로그인 안 됨) → STEP대기 임시 형상(머리 Ø10×6 + 나사 Ø6×16)
HFS8-4080-260 | 알루미늄 형재 40×80 L260 | 미스미 | 8 | HFS8-4080-260_M04 | 미확인 | - | M04: 새로. 실물 STEP(HFS8-4080-1900 끝면 늘이고 줄임, 실행 규칙 18). 레일·침목·가로대
HFS8-4080-430 | 알루미늄 형재 40×80 L430 | 미스미 | 2 | HFS8-4080-430_M04 | 미확인 | - | M04: 새로. 실물 STEP(HFS8-4080-1900 끝면 늘이고 줄임, 실행 규칙 18). 레일·침목·가로대
HFS8-4080-1255 | 알루미늄 형재 40×80 L1255 | 미스미 | 1 | HFS8-4080-1255_M04 | 미확인 | - | M04: 새로. 실물 STEP(HFS8-4080-1900 끝면 늘이고 줄임, 실행 규칙 18). 레일·침목·가로대
HFS8-4080-1260 | 알루미늄 형재 40×80 L1260 | 미스미 | 1 | HFS8-4080-1260_M04 | 미확인 | - | M04: 새로. 실물 STEP(HFS8-4080-1900 끝면 늘이고 줄임, 실행 규칙 18). 레일·침목·가로대
HFS8-4080-1720 | 알루미늄 형재 40×80 L1720 | 미스미 | 2 | HFS8-4080-1720_M04 | 미확인 | - | M04: 새로. 실물 STEP(HFS8-4080-1900 끝면 늘이고 줄임, 실행 규칙 18). 레일·침목·가로대
HFS8-4080-1755 | 알루미늄 형재 40×80 L1755 | 미스미 | 2 | HFS8-4080-1755_M04 | 미확인 | - | M04: 새로. 실물 STEP(HFS8-4080-1900 끝면 늘이고 줄임, 실행 규칙 18). 레일·침목·가로대
HFS8-4080-2555 | 알루미늄 형재 40×80 L2555 | 미스미 | 5 | HFS8-4080-2555_M04 | 미확인 | - | M04: 새로. 실물 STEP(HFS8-4080-1900 끝면 늘이고 줄임, 실행 규칙 18). 레일·침목·가로대
HFS8-4080-3080 | 알루미늄 형재 40×80 L3080 | 미스미 | 4 | HFS8-4080-3080_M04 | 미확인 | - | M04: 새로. 실물 STEP(HFS8-4080-1900 끝면 늘이고 줄임, 실행 규칙 18). 레일·침목·가로대
HFS8-4080-3150 | 알루미늄 형재 40×80 L3150 | 미스미 | 5 | HFS8-4080-3150_M04 | 미확인 | - | M04: 새로. 실물 STEP(HFS8-4080-1900 끝면 늘이고 줄임, 실행 규칙 18). 레일·침목·가로대
HFC8-4080-B | 형재 마감캡 40×80 | 미스미 | 48 | HFC8-4080-B_M04_W/E/S/N | 미확인 | - | M04: 새로. 실물 STEP. 열린 끝 전부(C-11·U-19) / M04R: E:6·8 2개 지움(레일 ±100 끝) / M08: +6(커튼 기둥 3개 위·아래 끝 HFC8-4080-B_M08_T·_B :1~3, U-19)
HNTT8-8 | 후입 T너트 M8 | 미스미 | 36 | HNTT8-8_M04_* (레벨러 36) | 미확인 | - | M04: 새로. 실물 STEP. 브래킷 176 + 레벨러 36 + 센터판 8. 조인 자리(홈 겉면 쪽 3.0), 침목 108은 90° 돌림(M04-M6·M7) / M04R: PZ 8 지움(센터판), 가로대 체결 12 더함(PY:44~46·NY:46~48·PX:17~22) / M07-K1: 브래킷 몫 188 지움(→ HNTT8-5_M04K)
HNTT8-5 | 후입 T너트 M5 | 미스미 | 132 | HNTT8-5_M04 | 미확인 | - | M04: 새로. 실물 STEP. 레일 윗면 접시 M5용 / M04R: :97~106 10개 더함(CM1 윗홈 6·받침판 4, Z축 90° 돌림) / M08: +26(U8 기둥·팔·커튼 금구 T홈)
SFB5-10(FHS-M5-10) | 접시머리 볼트 M5×10 | 미스미 | 102 | SFB5-10_M04 ×96·SFB5-10_M04R ×6(실물 STEP) | 미확인 | - | M04: 새로. STEP대기 임시 형상(ISO 10642 머리 Ø10 90°). STEP 수령 → 바디 교체. 물림 3.5 — 디테일 M04-F5(조임 ≤ 2 N·m 또는 M5×12) / M04R: 판 끝 12 지움, 판 E1·E2 이음 6 더함(새 컴포넌트). 물림 3.5 — 디테일 M04R-V2(SFB5-12). STEP 수령 → 바디 교체 / STEPSWAP(v2.5.6): 미스미 SFB5-10 실물 STEP. 머리 윗면 Z −8 그대로. SFB5-12(디테일 M04R-V2)는 디테일 단계
BALL-D25.4(D-96) | 수지 볼 트랜스퍼 Ø25.4 압입형 | 미확인 | 827 | STEP대기_BALL_D25_M04 | 미확인 | D-96·D-118 | M04: 새로(v2.1.4). 형번 미확인 임시 외형(테 Ø44×2·몸통 Ø36·구 Ø25.4 꼭대기 Z 0). occurrence 복사. STEP 수령 → 바디 교체 / M04R: 2,596 → 827(피치 100 반 칸 격자 (50+100i, 50+100j), C-31). 필요 정격 ≥ 203 N(SF 2, D-96). 1안 미스미 볼롤러 압입형. 형번 확정·STEP 수령 → 바디 교체
LEVELER-M8(형번 미확인) | 레벨링 패드 M8 Ø40 | 미스미 | 36 | STEP대기_LEVELER_M8_M04 | 미확인 | D-119 | M04: 새로. STEP대기 임시 형상(패드 Ø40·기둥 Ø13·스터드 M8). STEP 수령 → 바디 교체. 물림 5.5
CJ2B10-15Z | SMC 둥근 실린더 Ø10 행정 15 | SMC | 2 | CJ2B10-15Z_M05 | 미확인 | D-210 | M05: 새로. 칼·접기. 실물 STEP / RX-10(v2.17.2): 축 Y −152 → −166(Z축 180° 돌려 포트 +Y, 포트 면 Y −160.4). 몸 Y −172~−160. 수량 그대로. 로드 Ø4(끝 M4)가 슈 윗날개에 너트 2개로 꽉 물려 슈 끝 손 100 N에 굽음(동작 문제 RX-10-F1, 붕괴 63.9~102.6 N) — 뜬 이음으로 고칠 것. 로드 재질·허용 옆하중 미확인(D-210)
CDJ2B16-150AZ-B | SMC 둥근 실린더 Ø16 행정 150 | SMC | 1 | CDJ2B16-150AZ-B_M05 | 미확인 | - | M05: 새로. 앞끝 보내기. 실물 STEP
KQ2L06-M5A | SMC 엘보 피팅 Ø6 M5 | SMC | 17 | KQ2L06-M5A_M05 | 미확인 | - | M05: 새로. _3 출구 −Y(M05-M10), 튜브 Y −200 뒤 꺾기(M05-X13) / M08: +11(밸브 A·B 포트 KQ2L06-M5A_M08_NZ ×6·_PZ ×5) / STEPSWAP(v2.5.6): M08 11개는 KQ2L06-M5A_M08S_NZ ×6·_PZ ×5(새 밸브 포트 면 Y 76.5로 옮겨 다시 넣음)
MBIS5-6.5-8 | 수지용 인서트 M5 | 미스미 | 10 | MBIS5-6.5-8_M05 | 미확인 | - | M05: 새로. 실물 STEP
CB5-12 | 육각 구멍붙이 볼트 M5×12 | 미스미 | 40 | CB5-12_M05 | 미확인 | - | M05: 추가 11(별도 행). _5 자리는 CB5-16_M05_10으로 바꿈 / DC2-04: _11·_12 장공 볼트(밑 와셔 M5, −Y 1 이동, 물림 7 — 디테일 DC2-04-T3), M06 _1·_2 포함 장공 볼트 4개 U3_HEAD로 옮김 / M08: +29(이음판·L 브래킷·HMI·커튼 금구·다관 커넥터)
CB5-16 | 육각 구멍붙이 볼트 M5×16 | 미스미 | 28 | CB5-16_M05 | 미확인 | - | M05: 추가 10(별도 행). CB5-16_M05_10은 조임 2.5 N·m 지정(압입 너트 암나사, M05-X14) / M08: +18(브래킷·관 빗 ×4)
MSTH6-20 | 위치 결정 핀 Ø6×20 | 미스미 | 2 | MSTH6-20_M05:1·:2(실물 STEP) | 미확인 | - | M05: 새로. STEP대기 임시 Ø6 h7×20 / STEPSWAP(v2.5.6): 실물 STEP, 같은 자리
KC-40340 | 인장 래치(원터치 걸쇠) | 미확인 | 1 | STEP대기_KC-40340_M05·_HOOK | 미확인 | D-121 | M05: 새로. STEP대기 임시 형상, 갈고리 J_U7_LATCH
S-M5-2(형번 임시) | 판금 압입 너트 M5 | 미확인 | 1 | STEP대기_S-M5-2_M05 | 미확인 | D-122 | M05: 새로. 형번 미확정, STEP대기
CJ2B16-60SZ | SMC 단동 스프링 복귀 실린더 Ø16 st60 | SMC | 1 | CJ2B16-60SZ_M06(+_NUT_MNT·_ROD·_NUT_ROD·_NUT_ROD2) | 미확인 | - | M06: 새로. 실물 STEP. 슈 비킴 J_U6_SHIFT, 공압 끊기면 스프링으로 비킴
KQ2L06-M5A | SMC 엘보 피팅 Ø6 M5 | SMC | 12 | KQ2L06-M5A_M06 | 미확인 | - | M06: 추가 1(별도 행). 출구 −X, 튜브 공간 막힘 0 / M08: +11(밸브 A·B 포트 KQ2L06-M5A_M08_NZ ×6·_PZ ×5) / STEPSWAP(v2.5.6): M08 11개는 KQ2L06-M5A_M08S_NZ ×6·_PZ ×5(새 밸브 포트 면 Y 76.5로 옮겨 다시 넣음)
E32-D36P1_2M | 옴론 면적 반사 화이버 머리 | 옴론 | 1 | E32-D36P1_2M_M06 | 미확인 | D-123 | M06: 새로. 실물 STEP. 앰프 E3NX-FA11_2M은 M08 U8 자리
6004ZZ | 깊은 홈 볼 베어링 | 미스미 | 2 | 6004ZZ_M06_1·_2 | 미확인 | - | M06: 추가 2(별도 행). 롤 허브
MBIS5-6.5-8 | 수지용 인서트 M5 | 미스미 | 3 | MBIS5-6.5-8_M06_1~3 | 미확인 | - | M06: 추가 3. 캐리지
CB5-12 | 육각 구멍붙이 볼트 M5×12 | 미스미 | 34 | CB5-12_M06_1~4·_8~12 | 미확인 | - | M06: 추가 9(_5~_7 번호 비움). 목록 tools/out/mech_M06/changed_bolts.json / M08: +29(이음판·L 브래킷·HMI·커튼 금구·다관 커넥터) / REG-02: −4(CB5-12_M06_1·2·CB5-12_M05_11·12 → CB5-20_REG02_1~4)
CB5-16 | 육각 구멍붙이 볼트 M5×16 | 미스미 | 21 | CB5-16_M06_1~3 | 미확인 | - | M06: 추가 3. 롤 축 플랜지 → 기둥. 렌치 접근 디테일 M06-D2(조립 순서) / M08: +18(브래킷·관 빗 ×4)
CB5-20 | 육각 구멍붙이 볼트 M5×20 | 미스미 | 4 | CB5-20_M06_1~4 | 미확인 | - | M06: 추가 4. 기둥 → 보 2·꼭대기 브래킷 → HANGER 2
CB3-10 | 육각 구멍붙이 볼트 M3×10 | 미스미 | 6 | CB3-10_M06:1·:2(실물 STEP) | 미확인 | - | M06: 새로. STEP대기 임시 형상(머리 Ø5.5×3 + 나사 Ø3×10). STEP 수령 → 바디 교체 / STEPSWAP(v2.5.6): 실물 STEP, 같은 자리 / STEPSWAP 수정 1(v2.5.7): +4 CB3-10_M08_PX_KDM(KDM 소켓 귀 → 받침판, 뒤에서 +X, 물림 4 — 디테일 SW-D6) / DC2-08: CB3-10_M08_PX_KDM ×4 U7_FIXED로 옮김(수량 그대로)
M3 열압입 인서트(형번 미정) | 수지용 인서트 M3 | 미스미 | 2 | STEP대기_INSERT_M3_M06_1·_2 | 미확인 | D-125 | M06: 새로. 형번 미정, STEP대기 임시 형상 Ø4×5. 형번 확정·STEP 수령 → 바디 교체
CB5-12 | 육각 구멍붙이 볼트 M5×12 | 미스미 | 31 | CB5-12_DC204_1·2 | 미확인 | - | DC2-04: 새로. 받침 블록 → UPPER, 조임 4.5 N·m(임시). 실물 STEP / M08: +29(이음판·L 브래킷·HMI·커튼 금구·다관 커넥터)
미정(JIS B 1177 M4×25 평끝) | 육각 구멍붙이 멈춤나사 M4×25 | 미스미 | 2 | STEP대기_SETSCREW_M4x25_DC204_1·2 | 미확인 | D-127 | DC2-04: 새로. 미는 볼트(HOLDER 날개 A 아래 끝 받침)
미정(JIS B 1181 M4 1종) | 육각 너트 M4(잠금) | 미스미 | 2 | STEP대기_NUT_M4_DC204_1·2 | 미확인 | D-127 | DC2-04: 새로
미정(JIS B 1256 M5 소형 SUS t1) | 평 와셔 M5 | 미스미 | 4 | STEP대기_WASHER_M5_DC204_1·2·_REG02_1·2 | 미확인 | D-127 | DC2-04: 새로. CB5-12_M05_11·12 밑 / REG-02: 밑 볼트 CB5-20_REG02_3·4로 바뀜, 판 앞 Y −100~−99로 옮김, _2 X 33. +2(_REG02_1·2, CB5-20_REG02_1·2 밑)
HFS8-80160-1090 | 알루미늄 형재 8계열 80×160 L1090(기둥) | 미스미 | 2 | HFS8-80160-1090_M07:1(NX)·:2(PX)(실물 STEP) | 미확인 | - | M07: 새로(U1_COL 차지 상자 대체). STEP대기 임시 형상(80×160 외곽 + 홈 자리). v2.3.3 L1482 → v2.3.4 L1090. STEP 수령 → 바디 교체 / STEPSWAP(v2.5.6): 실물 STEP, 같은 자리
HFS8-4080-1090 | 알루미늄 형재 8계열 40×80 L1090(기둥 뒤) | 미스미 | 2 | HFS8-4080-1090_M07_NX·_PX | 미확인 | - | M07: 새로. 실물 STEP(HFS8-4080-1140 끝면 줄임). v2.3.3 L1482 → v2.3.4 L1090
HFS8-4080-3450 | 알루미늄 형재 40×80 L3450(받침틀 X 부재) | 미스미 | 2 | HFS8-4080-3450_M07 | 미확인 | - | M07: 새로(U1_BASE 차지 상자 대체). 실물 STEP 길이 맞춤 / DC2-03: 앞 레일 :1 지움 → HFS8-4080-2680 + 165
HFS8-4080-2960 | 알루미늄 형재 40×80 L2960(받침틀 Y 부재) | 미스미 | 7 | HFS8-4080-2960_M07 | 미확인 | - | M07: 새로. 실물 STEP 길이 맞춤 / DC2-03: :7·:8 지움 → HFS8-4080-1740 ×2
HFS8-4080-2680 | 알루미늄 형재 40×80 L2680 | 미스미 | 1 | HFS8-4080-2680_M07 | 미확인 | - | DC2-03: 새로. 실물 STEP(HFS8-4080-1140 끝면 늘이고 줄임, 실행 규칙 18). 앞 레일 X −2300~380(포켓 바닥 비움)
HFS8-4080-165 | 알루미늄 형재 40×80 L165 | 미스미 | 1 | HFS8-4080-165_M07 | 미확인 | - | DC2-03: 새로. 실물 STEP(HFS8-4080-1140 끝면 늘이고 줄임, 실행 규칙 18). 앞 레일 X 985~1150
HFS8-4080-1740 | 알루미늄 형재 40×80 L1740 | 미스미 | 2 | HFS8-4080-1740_M07 | 미확인 | - | DC2-03: 새로. 실물 STEP(HFS8-4080-1140 끝면 늘이고 줄임, 실행 규칙 18). 세로 Y −260~1480(:7·:8 줄임)
HFS8-4080-730 | 알루미늄 형재 40×80 L730 | 미스미 | 1 | HFS8-4080-730_M07 | 미확인 | - | DC2-03: 새로. 실물 STEP(HFS8-4080-1140 끝면 늘이고 줄임, 실행 규칙 18). 가로대 X 380~1110 · Y −300~−260
HFS8-4080-300 | 알루미늄 형재 40×80 L300 | 미스미 | 1 | HFS8-4080-300_DC203 | 미확인 | - | DC2-03: 새로. 실물 STEP(HFS8-4080-1140 끝면 늘이고 줄임, 실행 규칙 18). 받이 판 −X 끝 받침 X −38~2 · Y −280~20 · Z −330~−250, 아래 레일 :3 위
HFS8-4080-510 | 알루미늄 형재 40×80 L510(받침틀 다리) | 미스미 | 6 | HFS8-4080-510_M07 | 미확인 | - | M07: 새로
HFS8-4080-430 | 알루미늄 형재 40×80 L430(받침틀 가운데 다리) | 미스미 | 3 | HFS8-4080-430_M07 | 미확인 | - | M07: 새로
HFC8-4080-B | 형재 마감캡 4080 | 미스미 | 16 | HFC8-4080-B_M07_W·_E | 미확인 | - | M07: 새로(C-11). v2.3.4에서 기둥 위 캡 2는 지움(보가 얹힘) / M08: +6(커튼 기둥 3개 위·아래 끝 HFC8-4080-B_M08_T·_B :1~3, U-19) / DC2-03: +4(앞 레일 끊긴 끝 2 · 받침 HFS8-4080-300 양끝 _DC203_S·_N)
레벨링 풋 M8(ADJ 계열) | 레벨링 풋 M8 패드 Ø40 | 미스미 | 15 | STEP대기_LEVELER_M8_M07 | 미확인 | D-128 | M07: 새로. 형번 미확인 STEP대기 임시 형상(패드 Ø40×10 + 축 Ø8×50). 기둥 6 + 받침틀 9. STEP 수령 → 바디 교체
HNTT8-5 | T너트 8계열 M5 | 미스미 | 168 | HNTT8-5_M07_* | 미확인 | D-54 | M07: 새로. 실물 STEP. 브래킷 110 + 받침 세로 12 + 이음판 8 / M08: +26(U8 기둥·팔·커튼 금구 T홈) / M07-K1: 브래킷 몫 110 지우고 HNTT8-5_M07K 110으로 다시 넣음(수량 같음) / DC2-03: −6 +14 +4 (지운 브래킷 6, S형 7 ×2, LBRKT 2 ×2) = HNTT8-5_M07K +12
CB5-12 | 육각 구멍붙이 볼트 M5×12 | 미스미 | 29 | CB5-12_M07_* | 미확인 | - | M07: 새로. 받침틀 브래킷(물림 0.5~1.3 부족 → M07-K1). v2.3.4에서 20개 → CB5-20·CB5-16 / M08: +29(이음판·L 브래킷·HMI·커튼 금구·다관 커넥터) / M07-K1: 브래킷 몫 110 지움(→ CB5-16_M07K)
CB5-20 | 육각 구멍붙이 볼트 M5×20 | 미스미 | 20 | CB5-20_M07_PZ·_NX·_PX | 미확인 | - | M07: 새로. 받침 가로 다리 8(보 밑벽 탭) + 세로 다리 12(T너트 물림 8.5)
CB5-16 | 육각 구멍붙이 볼트 M5×16 | 미스미 | 34 | CB5-16_M07_NY:1~16 | 미확인 | - | M07: 새로. 이음판 → 보 뒷벽 탭 8 + 4080 뒤 홈 8(물림 7.5) / M08: +18(브래킷·관 빗 ×4)
HFS8-4080-560 | 알루미늄 형재 40×80 L560 | 미스미 | 3 | HFS8-4080-560_M04 ×2(X −305·−85) + HFS8-4080-560_M04_NOTCH ×1(X −420~−380) | 미확인 | - | M04R: 새로. 가로대 CM1(X −400, 판 받침)·CM_A·CM_B(X −285·−65, 원판 묶음 받침). 실물 STEP(HFS8-4080-1900 끝면 줄임). σ SF 7.4~21.4 / RX-11(v2.17.0): 수량 3 그대로. X −420~−380 자리 1개는 추가 가공 — 윗면 통과 홈 48 × 11(X 전폭 · Y ±24 · Z −23~−12, 롤러 밑 틈 3.0), 따로 정의 HFS8-4080-560_M04_NOTCH(614,847.63 mm³, 한 덩어리). 디테일 RX-11-D6(홈 바닥 ↔ T홈 바닥 살 1.5)
CB5-20 | 육각 구멍붙이 볼트 M5×20 | 미스미 | 4 | CB5-20_M04R:1~4 | 미확인 | - | M04R: 새로. 실물 STEP. DISK_BASE → 받침판 → CM 윗홈 T너트. 물림 5.5
IR1000-01BG | SMC 정밀 레귤레이터 0.005~0.2 MPa(게이지 붙음) | SMC/미스미 | 3 | IR1000-01BG_M08:1·:2·:3(실물 STEP) | 미확인 | D-132 | M08: 새로. STEP대기 임시 형상(W25×D45×H90 + 게이지 Ø26, 브래킷 t2.3 포함). 바퀴 N·F·슈. AW20-02BG-A 판매 종료·0.033 MPa 못 맞춤으로 바꿈. STEP 수령 → 바디 교체 / STEPSWAP r4(v2.6.8): SMC 실물 STEP으로 바꿈. 포트 Z 482(임시 511), 손잡이 윗면 Z 565 그대로, 브래킷 뒷면 Y 120 = 보 앞면, 몸 X ±17.5(임시 ±12.5), 게이지 Ø30 앞면 Y 51.5 / FUNC-01(v2.8.0): 3 → 2. F(X 800) 지움 — U5 승강은 주 공급 0.5 MPa(F01-S2 수정 2). 바퀴 N·슈 / RX-07(v2.13.0): 2 → 3. :2(X 800, :1 +X 100)를 U5 승강 내림 쪽 관 U5_A1·U5_A2 사이에 되살림. 설정 0.10 MPa(0.15 초과 금지). 바퀴 N·F·슈 / RX-10(v2.17.2): :3(슈) 설정 0.18 → 0.19 MPa(창 0.184~0.200, 누름 띠 9.85~22.94 N, 잡음 비 1.052). 창 아래 끝까지 6.8 kPa — 설정 잠금·표시(디테일 RX-10-F3)
KQ2L08-01AS | SMC 원터치 엘보 Ø8 R1/8 | SMC/미스미 | 2 | KQ2L08-01AS_M08R_PX/NX:1~3(실물 STEP) | 미확인 | - | M08: 새로. STEP대기 임시 형상. 레귤레이터 입·출구. STEP 수령 → 바디 교체 / STEPSWAP(v2.5.6): 실물 STEP. 포트 면(나사 끝 위 4.0)을 레귤레이터 옆면에. 관 출구 X ±24.1·Z 494.6 → 관 다시 / STEPSWAP r4(v2.6.8): 레귤레이터 실물 포트 면 X ±17.5 · Z 482에 다시 넣음(+-5 X, −29 Z), 관 출구 X ±29.1 · Z 465.6 / FUNC-01(v2.8.0): −2(:2 PX·NX 지움, IR1000 F) / PNEU-01(v2.8.6·v2.8.7): −2(레귤 OUT PX 2개 지움 → KQ2L06-01AS)
SS5Y3-20-08 | SMC SY3000 매니폴드 8스테이션 | SMC | 1 | STEP대기_SS5Y3-20-08_M08 | 미확인 | D-193 | M08: 새로. STEP대기 임시 형상(L96×D70×W40). 지시서 SS5Y3-20-05 → 6스테이션. STEP 수령 → 바디 교체 / STEPSWAP(v2.5.6): 실물 82×49×20. 보 앞면 Y 120에 밑면, X 1035~1117 · Z 325.5~374.5. M4 관통 4 → CB4-25 / U6S(v2.9.0): 06 → 07(7번 밸브 U6 누름). STEP 없음 → STEP대기 임시 상자 L 92.5×20×49, 장착 구멍 Ø4.5 ×4(06 STEP 외형 + 피치 10.5). STEP 수령 → 바디 교체(D-166). 06 바디 지움(빈 컴포넌트 phantom) / RX-08(v2.12.0): 07 → 08(8번 밸브 U4 스토퍼). STEP 없음 → STEP대기 임시 상자 X 1035~1138·Y 100~120·Z 325.5~374.5, Ø4.5 ×4. 07 바디 지움. STEP 수령 → 바디 교체(D-193)
SY3120-5LZD-M5 | SMC 5포트 솔레노이드 밸브 | SMC | 8 | SY3120-5LZD-M5_M08:1~8(실물 STEP) | 미확인 | - | M08: 새로. STEP대기 임시 형상(폭 10.5). 1 U4, 2 U5, 3 U6, 4~6 U7. STEP 수령 → 바디 교체 / STEPSWAP(v2.5.6): 실물 STEP, 베이스 윗면 Y 100, 솔레노이드 아래(−Z), 포트 면 Y 76.5 · A Z 345.9 · B Z 356.1 / U6S(v2.9.0): +1(:7 U6 슈 누름·들기) / RX-08(v2.12.0): +1(:8 U4 스토퍼 실린더, 7번 +X 10.5 복사)
KQ2L06-01AS | SMC 원터치 엘보 Ø6 R1/8 | SMC/미스미 | 5 | KQ2L06-01AS_M08R_IN_1·_2 · KQ2L06-01AS_M08R_OUT_1~3(실물 STEP) | 미확인 | - | M08: 새로(수정 1). 실물 STEP. U4 실린더 포트(Rc1/8 실측 r4.28)·U5 MGPM 포트 / PNEU-01(v2.8.6·v2.8.7): U5 2개는 AS2201F 자리로(−2), 레귤 OUT +2(실물 STEP) / M02R: KQ2L06-01AS_M08_U4_1·_2 지움(모터 위 실린더 포트), 수량 −2 / RX-07(v2.13.0): +2(IN_2·OUT_2, IR1000 :2 입·출구, 위 향함). 수량은 모델 바디 수 5로 맞춤(v2.12.2의 4는 IN_1을 U4_1/2 자리에 세던 값: 모델 3 + 2)
F3SG-4RA0800-14 | 옴론 안전 라이트 커튼(투광·수광 1쌍) | 옴론 | 2 | F3SG-4RA0800-14_M08_1(앞 1E·1R)·_2(옆 2E·2R), 하위 꽂이·캡 포함 세트 1행 | 미확인 | D-130 | M08R: F3SG-4RA1520-14(없는 형번 임시) → F3SG-4RA0800-14 실물 STEP. 몸 38.7×42.5×866.5, Z −45~818. 금구 STEP대기_F39-LSGF_M08_* ×8(D-135)
HFS8-4080-1650 | 알루미늄 형재 40×80 L1650 | 미스미 | 1 | HFS8-4080-1650_M08_FL | 미확인 | - | M08R: 2370 → 1650(Z −840~810). HFS8-4080-1900 실물 STEP 끝면 오프셋(실행 규칙 18). 위 캡 HFC8-4080-B 유지
HFS8-4080-570 | 알루미늄 형재 40×80 L570 | 미스미 | 1 | HFS8-4080-570_M08_HMI | 미확인 | - | M08: 새로. 580 STEP 끝면 −10. HMI 팔. 끝 마감캡은 모델에 없음 — 디테일(U-19)
LR6-302WJBW-RYG | PATLITE 경광등 3단 R·Y·G | PATLITE | 1 | LR6-302WJBW-RYG_M08_1~5(실물 STEP, 대표 형상 LR6-302WJB) | 미확인 | - | M08: 새로. STEP대기 임시 형상 Ø60×H300. 보 윗면 (1190, 270). STEP 수령 → 바디 교체 / STEPSWAP(v2.5.6): 실물 STEP, 밑면 Z 650, 높이 265.5. 볼트 CB4-12 → CB4-20(밑판 11.5 + 보 윗벽 물림 8)
KDM10-06 | 다관 커넥터 10구(소켓 KDM10S-06 + 플러그 KDM10P-06) | SMC(미스미) | 1 | KDM10-06_M08(KDM10S-06 U7_FIXED · KDM10P-06 U7_CASSETTE) | 미확인 | D-137 | M08: 새로 / STEPSWAP 수정 1(v2.5.7): 실물 STEP. 짝 방향 +X(플러그 쪽), 원점 (40, −143.5, 680), 소켓 귀 뒷면 X 20을 받침판 P_M08_KDM_BRKT에 CB3-10 ×4. 10구 중 6구 사용(열 Y −153.5/−133.5 × 줄 Z 663·680·697). CST_X 25에서 빠짐(물림 15) / DC2-08(v2.6.1): 소켓을 U8_PNEU → U7_FIXED로, 위치 그대로. J_U7_HGT −4·0·+6 × CST_X 0·25 짝 축 Y·Z 어긋남 0
CB4-20 | 육각 구멍붙이 볼트 M4×20 | 미스미 | 3 | CB4-20_M08_LAMP:1~3(실물 STEP) | 미확인 | - | M08: 새로. STEP대기 임시 형상(로그인 풀림으로 못 받음). 매니폴드 → 보 앞면. STEP 수령 → 바디 교체 / STEPSWAP(v2.5.6): 매니폴드용 2개는 CB4-25 ×4로 바뀜(베이스 두께 20). 경광등용으로 3개(CB4-12 대체)
CB4-12 | 육각 구멍붙이 볼트 M4×12 | 미스미 | 6 | CB4-12_M08_REG:1~6(실물 STEP) | 미확인 | - | STEPSWAP r4(v2.6.8): 새로. IR1000 브래킷 P36201023 열쇠 구멍 위 끝(X ±14 · Z 527.8, 머리 밑면 Y 118) → 보 앞벽 t8 M4 탭, 물림 8 / FUNC-01(v2.8.0): −2(:3·:4 지움, IR1000 F 브래킷) / RX-07(v2.13.0): +2(:3·:4, IR1000 :2 브래킷, X 786·814). 물림 8 = 2.0d
CB4-25 | 육각 구멍붙이 볼트 M4×25 | 미스미 | 4 | CB4-25_M08:1~4(실물 STEP) | 미확인 | - | STEPSWAP r2(v2.5.9): 실물 STEP으로 바꿈(머리 밑면 Y 100 베이스 윗면 / RX-08(v2.12.0): 매니폴드 08로 +X 10.5 옮김 | 같은 자리) / STEPSWAP: 새로. SS5Y3 베이스(두께 20) → 보 앞벽 M4 탭 물림 5(전과 같음). STEP 없음(로그인) → STEP대기 임시 형상(머리 Ø7×4 + 나사 Ø4×25)
TU0805 | SMC 폴리우레탄 관 Ø8 | SMC | 3줄 0.80 m(주문 1 m) | TU0805_M08P_MAIN_1~3·REG3_IN·P | 미확인 | - | M08: 새로. 3D 스케치 + pipe. 굽힘 R 부족 — 디테일 M08-X5(요구서 7절) / STEPSWAP(v2.5.6): 레귤레이터 이음·매니폴드 실물에 맞춰 다시(입구 줄 Y 56 → 50, 출구 끝 매니폴드 −X 끝면 포트 X 1035 · Y 107.5) / STEPSWAP r4(v2.6.8): 레귤레이터 실물 이음 출구(X ±29.1 · Z 465.6)에서 다시(매니폴드 쪽 끝 그대로) / FUNC-01(v2.8.0): −2줄(IN_2·OUT_2 지움) / PNEU-01(v2.8.6·v2.8.7): 4줄 → 3줄(MAIN·REG3_IN·P), 최소 R 40 ≥ 20, 802 mm. REG OUT 2줄은 TU0604로 / PNEU-01 결과(v2.8.8): 최소 R TU0604 16 ≥ 15 · TU0805 40 ≥ 20 — 위 '굽힘 R 부족' 메모는 옛 것(디테일). STEP대기(D-162, STEP 수령 → 바디 교체)
TU0604 | SMC 폴리우레탄 관 Ø6 | SMC | 23줄 + 체인 안 2줄 = 32.0 m(+0.04)(+0.26 RX-07)(+0.07 RX-10)(주문 35 m) | TU0604_M08P_*(32바디) · 체인 표시 모형 안 2400.05.075.0_U5_LINK_L/U_TA·TB, _BEND_TA·TB | 미확인 | - | M08: 새로(U4C·U5C·U7C는 수정 1). 굽힘 R 부족 — 디테일 M08-X5 / STEPSWAP(v2.5.6): 밸브 쪽 11줄 다시(_M08S_: 피팅 출구 Y 63, 아래로 Z 295까지 내려 입구 줄을 넘음) / STEPSWAP 수정 1(v2.5.7): U7 관 12줄 다시 — 밸브 쪽 _M08K_U7_1~6(소켓 -X 면 X 11.7, X −8~−48로 돌아 들어감), 카세트 쪽 _M08K_U7C_1~6(오름 줄 Y −153.5/−133.5, 플러그 +X 면 X 59) / PNEU-01(v2.8.6·v2.8.7): 옛 21줄 지우고 routes.json 23줄을 접선 원호 굽힘(최소 R 16 ≥ 카탈로그 15)으로 다시 — 29,898 mm. 체인 안 2줄 1,040.7(안쪽 R 69.5)·1,078.4(바깥 R 81.5) — 행정 내내 같은 길이 / PNEU-01 수정 2(v2.8.8): U7_4/5/6_B 위 토막 세로 내림 꺾임 Z 775 → 781, R 30 → 20(카탈로그 최소 R 15 이상) — 1,780.0·1,816.1·1,856.1 mm(+41.3) / PNEU-01 결과(v2.8.8): 최소 R TU0604 16 ≥ 15 · TU0805 40 ≥ 20 — 위 '굽힘 R 부족' 메모는 옛 것(디테일). STEP대기(D-162, STEP 수령 → 바디 교체) / U6S(v2.9.0): +2줄 TU0604_M08P_U6P_A·_B(167.0·145.6 mm, 움직이는 쪽만). 고정 쪽 길·U8 회로 미완(U6S-X1) / RX-08(v2.12.0·v2.12.1): +2줄 TU0604_M08P_RX08_A·_B(스토퍼 실린더), 세움 Z 340에서 U4 쪽 _A_U4·_B_U4(J_U4_X 따라감)와 U8 쪽으로 나눔. 굽힘 R15. 이음 휘는 구간 95 mm 디테일 / RX-07(v2.13.0): U5_A(3,117.3 mm) 지우고 U5_A1(850.2 mm)·U5_A2(2,526.9 mm) 2줄 — +1줄·+259.8 mm, R30 / M02R(v2.14.0): 옛 U4C_A·_B_M02R 관의 스케치·Pipe107·108 피처와 빈 컴포넌트 TU0604_M08P_U4C_A·_B 지움(바디는 전부터 0, 길이 증감 0) / RX-10(v2.17.2): TU0604_M08P_U6P_A·_B 새 길(피팅이 +Y 쪽으로 가서, 끝점 그대로, R15) — 167.0·145.6 → 191.8·187.9 mm(+67.1, 부피 ÷ 단면)
HMI 10인치(기종 미정) | 터치 패널 자리 상자 | 미확인 | 1 | U8_HMI_PANEL | 미확인 | D-131 | M08: 새로. 자리 상자 272×214×57. 기종은 제어 단계(U-09)
HFS8-4080-1175 | 알루미늄 형재 40×80 L1175 | 미스미 | 2 | HFS8-4080-1175_M08_FR·_R | 미확인 | - | M08R: 1900 → 1175(Z −370~805). 1900 실물 STEP 끝면 오프셋(실행 규칙 18). 위 캡 HFC8-4080-B 유지
CB5-16 | 육각 구멍붙이 볼트 M5×16 | 미스미 | 310 | CB5-16_M07K_* 110·CB5-16_M04K_* 188 | 미확인 | - | M07-K1: 새로. 실물 STEP. 판금 L 브래킷 체결(옛 CB5-12 110·CB8-16 188 대체). 판 t6 물림 7.5 = 1.5d. 디테일 M07K-D4: C형 160개는 CB5-14로 바꿀 예정 / DC2-03: −6(지운 브래킷) +14(S형 7) +4(LBRKT 2)
HNTT8-5 | 후입 T너트 M5 | 미스미 | 188 | HNTT8-5_M04K_* | 미확인 | D-54 | M07-K1: 새로. 실물 STEP. M04·M04R 판금 L 브래킷 체결(옛 HNTT8-8 188 대체)
CB5-12 | 육각 구멍붙이 볼트 M5×12 | 미스미 | 4 | CB5-12_DC203:1~4 | 미확인 | - | DC2-03: 새로. 실물 STEP. 받이 판 → :6 윗면(X 360 · Y −230/−110) 2 + 받침 윗면(X −18 · Y −230/−170) 2. 물림 8.0
HNTT8-5 | 후입 T너트 M5 | 미스미 | 4 | HNTT8-5_DC203:1~4 | 미확인 | D-54 | DC2-03: 새로. 실물 STEP. 받이 판 볼트 4
F39-LSGF | 라이트 커튼 금구(형번 기억값) | 옴론 | 8 | STEP대기_F39-LSGF_M08_1E/1R/2E/2R(+_2) | 미확인 | D-135 | M08R: STEP대기_F3SG-BRKT 이름·형번 정함. 위 4개 Z 685~715로 −700. STEP 수령 → 바디 교체
CB5-6 | 육각 구멍붙이 볼트 M5×6 | 미스미 | 2 | CB5-6_M08_PY_LC2F:1·:2(실물 STEP) | 미확인 | D-135 | STEPSWAP r3(v2.6.4): 미스미 CB5-6 실물 STEP으로 바꿈(머리 밑면 Y −1561, 축 +Y, X −2315 · Z 100·700, 끝 Y −1555 = 커튼 면, bbox 임시와 같음) / M08R: 새로(CB5-12_M08_PY_LC2F ×2 대체, 끝이 커튼 몸에 들어감). 물림 3 디테일 M08R-D1. CB5-12 M08 몫 −2
CB5-20 | 육각 구멍붙이 볼트 M5×20 | 미스미 | 4 | CB5-20_REG02_1~4 | 미확인 | - | REG-02: 새로. 실물 STEP. 공통 판 장공 → UPPER 탭(물림 10, 탭 깊이 12). 손계산 조임 암나사 SF 1.92. 4번 X 33(카세트 핀 렌치 길 비킴)
미정(PEM FH4-M4-15 상당, 400계 SUS) | 압입 스터드 M4×15 | 미스미 | 4 | STEP대기_FH4-M4-15_REG02_1~4 | 미확인 | D-142 | REG-02: 새로. 1·2 BASE·3·4 HOLDER를 공통 판에 묶음
미정(JIS B 1181 M4 1종 SUS) | 육각 너트 M4 | 미스미 | 4 | STEP대기_NUT_M4_REG02_1~4 | 미확인 | D-142 | REG-02: 새로. 스터드 너트
HG-KR23 | AC 서보 200 W □60 곧은 축(바늘 옆 바퀴·대차 X·먼 쪽 바퀴) | 미쓰비시(미스미) | 3 | HG-KR23_M02·_M03W·_M03X(실물 STEP) | 미확인 | - | MOT-01: C-36 MHMF022L1U2M ×3 대체. 실물 STEP. 모터→어댑터 CB5-16 ×4/대 물림 9
HG-KR43 | AC 서보 400 W □60 곧은 축(U3 아랫축 전자 동기) | 미쓰비시(미스미) | 1 | HG-KR43_U3(실물 STEP) | 미확인 | D-143 | MOT-01: C-36 MHMF042L1U2M 대체. 실물 STEP. P_U3_LDRV_BRKT에 CB5-16 ×4. 관성비·토크 FUNC-01 ③
PGX62-H-10 | 유성 감속기 □62 1/10(어댑터 HG-KR23용 가공) | 신포(미스미) | 3 | PGX62-H-10_M02·_M03W·_M03X(실물 STEP, 18바디 중 중복 축·키 1벌 지움) | 미확인 | - | MOT-01: C-36 VRXF-PB-60-10 ×3 대체. 출력 플랜지 Ø5.5 관통 → 앞판·브래킷 M5 관통 탭 CB5-16 ×4/대(물림 8). 어댑터 7MP62A 'HG-KR23용 가공'으로 주문
CB5-16 | 육각 구멍붙이 볼트 M5×16 | 미스미 | 32 | CB5-16_M02_MOT:1~8·_M03_MOTW:1~8·_M03_MOTX:1~8·_U3_MOT:1~4·_U3_BRKT:1~4(실물 STEP) | 미확인 | - | MOT-01: 새로. 모터→어댑터 12·U3 모터→브래킷 4·감속기→앞판/브래킷 12·U3 브래킷→4080 홈 4
CB5-12 | 육각 구멍붙이 볼트 M5×12 | 미스미 | 3 | CB5-12_M02_HUB·_M03_HUB·_M03_IDL(실물 STEP) | 미확인 | - | MOT-01: 새로. 바퀴 허브 끝→감속기 축 끝 M5 2·피벗 핀 끝 1·아이들러 축 바깥 끝 1 / M02R(v2.14.0): 빈 컴포넌트 CB5-12_M02_PIV 지움(피벗 핀은 v2.10.3에서 없어짐) — 수량 −1(모델 바디 3)
CB4-12 | 육각 구멍붙이 볼트 M4×12 | 미스미 | 1 | CB4-12_M02_CLV(실물 STEP) | 미확인 | - | MOT-01: 새로. 피벗 핀 머리→BASE 다리 M4 2·너클 핀 끝 1·클레비스 핀 끝 1 / M02R(v2.14.0): 빈 컴포넌트 CB4-12_M02_PIV 지움, CB4-12_M02R_CLV·_CRK(옛 크랭크, 별도 행 없음)도 지움. 피벗 핀·너클 핀 볼트 3개는 바디가 전부터 없어 수량 4 → 1(모델 바디 CB4-12_M02_CLV 하나). 남은 CB4-12_M02_CLV는 물린 상대가 없는 잔재 — 디테일 M02R-D8(지우고 이 행 0)
SFB5-12 | 접시머리 볼트 M5×12 | 미스미 | 1 | SFB5-12_M03_IDL(실물 STEP) | 미확인 | - | MOT-01: 새로. 아이들러 축 안쪽 끝(보 Y 120과 틈 2)
HNTT8-5 | 후입 T너트 M5 | 미스미 | 4 | HNTT8-5_U3_BRKT:1~4(실물 STEP) | 미확인 | D-54 | MOT-01: 새로. P_U3_LDRV_BRKT → HFS8-4080-1720_M04 −X면 홈(Z −112·−152)
MPFZ12-10 | 플랜지 무급유 부시 Ø12 | 미스미 | 2 | MPFZ12-10_M02_N·_P(실물 STEP) | 미확인 | - | MOT-01: 새로. 팔 옆판 피벗 구멍 Ø18 H7, 플랜지 바깥
SCXW46-14-15 | 디스크 커플링 Ø46(모터 Ø14 – 아랫축 Ø15 가정) | 미스미 | 1 | STEP대기_SCXW46-14-15(임시 Ø46×44) | 미확인 | D-143 | MOT-01: 새로. STEP 없음 → E-10 임시 형상(외형 SCXW46-15-19 STEP 실측). 아랫축 지름 D-10 대기
LHFR16 | 플랜지 볼 부시 Ø16(플로트 안내) | 미스미 | 2 | LHFR16_F01_N·_P(실물 STEP) | 미확인 | D-146 | FUNC-01(v2.8.0): 새로. U5_LIFT 리지드, 플랜지 밑 Z 164. 플랜지 볼트는 스프링과 겹쳐 디테일(F01-M2). C0 기억값 1180 N — 오조작 비 1.55 < 2 디테일 F01-D8
PSFJ16-150 | 샤프트 Ø16 L150(플로트) | 미스미 | 2 | PSFJ16-150_F01_N·_P(실물 STEP) | 미확인 | - | FUNC-01(v2.8.0): 새로. U5_FLOAT 리지드, Z 116~266, 물림 20(플랜지 6 + 블록 14)
PSCS16(형번 임시) | 고정 칼라 Ø16 | 미스미 | 4 | STEP대기_PSCS16_F01_HANG_N/P·_TOP_N/P | 미확인 | D-147·D-146 | FUNC-01(v2.8.0): 새로. STEP대기 임시 형상(Ø32/Ø16 t12). STEP 수령 → 바디 교체
미정(압축 스프링 d1.6·OD44·L132) | 플로트 받침 압축 스프링 k 0.2 | 미정 | 2 | STEP대기_SPRING_d1.6_OD44_L132_N/P | 미확인 | D-149·D-146 | FUNC-01(v2.8.0): 새로. STEP대기 임시 형상(Z 172~247). 형번 미정(특주 가능). STEP 수령 → 바디 교체
AS2201F-01-06SA(후보) | SMC 속도 제어 이음(U5 승강 미터 아웃) | SMC/미스미 | 2 | 없음(지금 이음 자리 그대로) | 미확인 | D-148 | FUNC-01(v2.8.0): 새로. 수량 2(복동 양쪽, 임시). STEP 없음 — STEP 수령 → 바디 교체(기존 이음 바꿈)
AS2201F-01-06SA | SMC 미터 아웃 속도 제어 이음 Ø6 R1/8(엘보) | SMC/미스미 | 2 | STEP대기_AS2201F-01-06S_U5_1·_2 | 미확인 | D-c | PNEU-01(v2.8.6·v2.8.7): U5 승강 MGPM 포트(옛 KQ2L06-01AS 자리). STEP 미수령 → 임시 형상(몸 Ø12·목 Ø10·손잡이 Ø8). 접미사 -06S/-06SA 확인 D-c
SY30M-38-1A-C6 | SMC SY3000 개별 급기 스페이서 | SMC | 2 | STEP대기_SY30M-38-1A-C6_1·_3 | 미확인 | D-d | PNEU-01(v2.8.6·v2.8.7): 1·3번 밸브 밑(두께 10 임시)
KQ2E08-00A | SMC 격벽 유니언 Ø8 | SMC/미스미 | 1 | STEP대기_KQ2E08-00A_1 | 미확인 | D-f | PNEU-01(v2.8.6·v2.8.7): 주 공급 입구(P_M08_AIR_IN_BRKT)
KQ2T08-00A | SMC 유니언 티 Ø8 | SMC/미스미 | 2 | STEP대기_KQ2T08-00A_1·_2 | 미확인 | D-f | PNEU-01(v2.8.6·v2.8.7): MAIN 가지
KQ2H08-01AS | SMC 수나사 스트레이트 Ø8 R1/8 | SMC/미스미 | 1 | STEP대기_KQ2H08-01AS_1 | 미확인 | D-e | PNEU-01(v2.8.6·v2.8.7): 매니폴드 −X 끝판 P
AN110-01 | SMC 소음기 R1/8 | SMC/미스미 | 2 | STEP대기_AN110-01_1·_2 | 미확인 | D-e | PNEU-01(v2.8.6·v2.8.7): 매니폴드 −X 끝판 R
TPH-01 | R1/8 막음 플러그(형번 임시) | 미스미 | 3 | STEP대기_TPH-01_1~3 | 미확인 | D-g | PNEU-01(v2.8.6·v2.8.7): 매니폴드 +X 끝판 3구
M-5P | SMC M5 막음 플러그 | SMC/미스미 | 1 | STEP대기_M-5P_1 | 미확인 | D-f | PNEU-01(v2.8.6·v2.8.7): 3번 밸브 B(U6 단동)
KQ2P-06 | SMC 막음 플러그 Ø6 | SMC/미스미 | 8 | STEP대기_KQ2P-06_1~8 | 미확인 | D-f | PNEU-01(v2.8.6·v2.8.7): KDM10 빈 구멍 4 × 2쪽
CB5-16 | 육각 구멍붙이 볼트 M5×16 | 미스미 | 55 | CB5-16_M08_NZ_COMB·_M08_PY·_M08_PX·_M05_1 복사(실물 STEP) | 미확인 | - | PNEU-01(v2.8.6·v2.8.7): 새로(별도 행). 관 고정품 30개 53 + CST_O 2 + AIR_IN_BRKT 2. 받침에 M5 탭(보 42·바퀴 받침 2·KDM 받침 2·대차 판 2·체인 팔 4·카세트 판 4). 쪼갠 뚜껑 클램프용 CB5-20은 쓰지 않음(통구멍 블록으로 바꿈) / PNEU-01 수정 2(v2.8.8): 개수 그대로, F_5·AIR 4개 자리 옮김 / RX-06-C2(v2.15.2): −2(CB5-16_M05_1:2·:3 지움 — 끝 X 46~50이 P_M05_HOLDER +X 벽 살을 뚫음, CB5-12_M05_7:2·:3으로 바꿈). :4·:5는 그대로
TIE-3.6x150 | 나일론 케이블 타이 3.6×150 | 미스미 | 4 | (모델 없음) | 미확인 | - | PNEU-01(v2.8.6·v2.8.7): 체인 끝 12PZ 타이 판, 관 2줄 × 2끝
CJ2B10-15Z | SMC 둥근 실린더 Ø10 행정 15(슈 누름·들기) | SMC | 1 | CJ2B10-15Z_M06P(+_ROD·_NUT_MNT·_NUT_ROD ×2) | 미확인 | D-210 | U6S(v2.9.0): 새로(별도 행). 실물 STEP. 세로 J_U6_PRESS. 재질 Default → 지정 필요(디테일). 들림 확인 스위치 자리 없음 → CDJ2B10-15Z + D-M9 검토(디테일) / RX-10(v2.17.2): 축 Y −152 → −166(Z축 180° 돌려 포트 +Y, 포트 면 Y −160.4). 몸 Y −172~−160. 수량 그대로. 로드 Ø4(끝 M4)가 슈 윗날개에 너트 2개로 꽉 물려 슈 끝 손 100 N에 굽음(동작 문제 RX-10-F1, 붕괴 63.9~102.6 N) — 뜬 이음으로 고칠 것. 로드 재질·허용 옆하중 미확인(D-210)
CB5-12 | 육각 구멍붙이 볼트 M5×12 | 미스미 | 2 | CB5-12_M06_3 :2·:3(실물 STEP 사본) | 미확인 | - | U6S(v2.9.0): 추가 2(별도 행). 브래킷 → 캐리지. :2 렌치 접근 피팅에 막힘(조립 순서, 디테일 U6S-D1). CB5-12_M06_3·_4는 +X 1.6(칼라 턱), 칼라 볼트 조임 ≤ 1.2 N·m / RX-10(v2.17.2): :2를 Y −170 → −177(Z 86)로 옮김, 물림 8 mm(1.6d). 피팅이 옛 실린더 자리로 가서 렌치 길(Ø8.5 × 30) 겹침 0 — U6S-D1 없어짐. 렌치 길 ↔ 실린더 몸 0.75(디테일)
MBIS5-6.5-8 | 수지용 인서트 M5 | 미스미 | 2 | MBIS5-6.5-8_M06_1 :2·:3 | 미확인 | - | U6S(v2.9.0): 추가 2(별도 행). 캐리지 다리 / RX-10(v2.17.2): :2를 Y −170 → −177로 옮김(볼트와 동축)
KQ2L06-M5A | SMC 엘보 피팅 Ø6 M5 | SMC | 4 | KQ2L06-M5A_M06 :2·:3 · KQ2L06-M5A_M08S_NZ :7·_PZ :6 | 미확인 | - | U6S(v2.9.0): 추가 4(별도 행). 슈 실린더 포트 2·7번 밸브 A·B 2 / RX-10(v2.17.2): 슈 실린더 피팅 :2·:3을 실린더와 함께 돌려 Y −163~−141.3(옛 실린더 자리)으로. :2 출구 +Z (−68, −146.5, 99.7), :3 출구 +X (−53.5, −146.5, 135.2). :3 나사 축 Z 135.2 ↔ 포트 Z 133.3 어긋남 1.9(전부터, 디테일)
CDQ2YA20-25DMZ(형번 임시) | SMC 박형 실린더 Ø20 st25 저마찰 임시 | 미스미(SMC) | 1 | STEP대기_CDQ2YA20-25DMZ(U4S_CYL)·_ROD(U4S_ROD) | 미확인 | D-188 | M02R(v2.10.3): 새로. 보 P_M07_BEAM 밑 고정, 로드 −Y. 패킹 f ≤ 9.42 N 가정 — 형번은 사용자 결정(돈)
Y-020B | SMC 너클 조인트 M8 + 핀 | 미스미(SMC) | 1 | STEP대기_Y-020B·_PIN(U4S_ROD) | 미확인 | D-188 | M02R(v2.10.3): 새로. 로드 끝 ↔ 그네 텅 장공 핀 Ø8
PSFJ12-200 | 샤프트 Ø12 L200(그네 피벗) | 미스미 | 1 | STEP대기_PSFJ12-200 | 미확인 | - | M02R(v2.10.3): 새로. 피벗 축 X (Y 120, Z 140)
PSCS12-10 | 고정 칼라 Ø12 | 미스미 | 2 | STEP대기_PSCS12-10_1·_2 | 미확인 | - | M02R(v2.10.3): 새로
AUT12-45(형번 임시) | 인장 스프링(그네 들기 보조) | 미스미 | 2 | STEP대기_AUT12-45_1·2_TOP·_BOT | 미확인 | D-189 | M02R(v2.10.3): 새로. θ0 합 57.4 N 가정(초장력 실측 필요). 윗고리–탭 볼트 머리 겹침 동작 문제(v2.11.0에서 볼트 s±12) / M02R(v2.14.0): 윗고리–탭 볼트 머리 겹침 풀림(볼트 s±12, 틈 1.75·2.75 mm, 5자세 겹침 0). 스프링 자리·힘 변화 0
KQ2L06-M5A | SMC 엘보 피팅 Ø6 M5 | SMC | 2 | KQ2L06-M5A_M02S_ROD·_HEAD(실물 STEP) | 미확인 | - | M02R(v2.10.3): 새로(별도 행). 실린더 포트
CB5-12 | 육각 구멍붙이 볼트 M5×12 | 미스미 | 14 | CB5-12_M02S_*(실물 STEP) | 미확인 | - | M02R(v2.10.3): 새로(별도 행). 브래킷·탭·보 밑. BASE_5~8 위치 v2.11.0에서 옮김 / M02R(v2.14.0): BASE_5~8 X −302·−288·−192·−178 → −307·−283·−197·−173(Y 50, 머리 Z 233~238), U4_WHEEL_N 강체 다시. 물림 8 = 1.6d, 수량 14 그대로. 조임 4 N·m 지정 필요(디테일 M02R-D11), BASE_7·_8 끝이 캐리지 밑면에 맞닿음(M02R-D6)
CB5-16 | 육각 구멍붙이 볼트 M5×16 | 미스미 | 2 | CB5-16_M02S_*(실물 STEP) | 미확인 | - | M02R(v2.10.3): 새로(별도 행) / M02R(v2.14.0): 상대 옆판 P에 M5 탭이 생김(볼트는 그대로). 물림 6 = 1.2d(디테일 M02R-D7), 조임 3 N·m(M02R-D10)
CB5-20 | 육각 구멍붙이 볼트 M5×20 | 미스미 | 1 | CB5-20_M02S_*(실물 STEP) | 미확인 | - | M02R(v2.10.3): 새로(별도 행) / M02R(v2.14.0): 볼트 그대로. ARM_TIE 탭 물림 6 = 1.2d, 조임 3 N·m 또는 CB5-25(디테일 M02R-D10)
SSEB13-220 | 미니어처 가이드(레일 220 ×2, 블록 4) | 미스미 | 2 | SSEB13-220_RX06_RAIL ×2·SSEB13-570_RX06_BLOCK ×4(실물 STEP) | 미확인 | D-207 | RX-06: 새로(SSEB13-570 레일 210 그린 상자) / RX-06R(v2.15.0): 형번 SSEB13-570 → SSEB13-220. 레일을 실물 STEP으로 — STEP SSEB13-570을 X −115에서 잘라 씀(X −335~−115, 구멍 9 피치 25 끝 10, 17,180.23 mm³ ×2), 레일 ↔ 블록 겹침 0(옛 기준선 178.86 mm³ ×4 없어짐, RX-06-E4 해결). 블록은 그대로. 레일 M3 볼트·블록 체결은 디테일 RX-06-D1. C0 카탈로그 미확인(판정은 보수 임시 2 kN)·'27년 판매종료 예정 대체 형번(D-207)
CDQ2A25-20DMZ | SMC 박형 실린더 Ø25 행정 20(복동, 오토스위치 자석) | SMC | 1 | STEP대기_CDQ2A25-20DMZ(+ _ROD 바디, U4_STOP) | 미확인 | D-192 | RX-08: 새로(v2.12.0). STEP대기 임시 형상(E-10) 몸 X −257.5~−210·Y 64~104·Z 72~112, 로드 Ø12 + M10 수나사(설계안 임시값). STEP 수령 → 바디 교체(D-192)
CB8-20 | 육각 구멍붙이 볼트 M8×20(조절 볼트) | 미스미 | 1 | CB8-20_RX08(실물 STEP) | 미확인 | - | RX-08: 새로. 머리 Z 141.72(두께 10 + 2). 물림 10.28 < 12 → 디테일 D2(CB8-25 또는 셋업 조건)
NUT-M8(형번 미정) | 육각 너트 M8(조절 볼트 잠금) | 미스미 | 1 | STEP대기_NUT-M8_RX08 | 미확인 | D-194 | RX-08: 새로. 지시 HNTT8-5(M5 T너트)는 M8에 안 맞아 바꿈. 표준 형상, 형번 정해지면 STEP 교체(D-194)
CB5-16 | 육각 구멍붙이 볼트 M5×16 | 미스미 | 6 | CB5-16_RX08_LIP:1~4·_TOP:1·2(실물 STEP) | 미확인 | - | RX-08: 새로(별도 행). 립 → 실린더 머리 면 4, 윗판 → P_M02_BASE 2
KQ2L06-M5A | SMC 엘보 피팅 Ø6 M5 | SMC | 4 | KQ2L06-M5A_RX08_HEAD·_ROD · KQ2L06-M5A_M08S_NZ:8·PZ:7(실물 STEP) | 미확인 | - | RX-08: 새로(별도 행). 실린더 포트 2 + 8번 밸브 A·B 2
CB5-16 | 육각 구멍붙이 볼트 M5×16 | 미스미 | 2 | CB5-16_RX06R_LOCK_1·_2(실물 STEP) | 미확인 | - | RX-06R(v2.15.0): 새로(별도 행). U4 X 잠금 볼트 — 누름 판 t3 → 날 긴 구멍 → 캐리지 웹 M5 탭(X −225·−140, Z 468, 머리 −Y 작업자 쪽), 물림 10.3 = 2.06d. 조임 3 N·m 지정(유지력 1,800 N, 디테일 RX-06R-D3)
CB5-12 | 육각 구멍붙이 볼트 M5×12 | 미스미 | 4 | CB5-12_RX06R_BLADE_1~4(실물 STEP) | 미확인 | - | RX-06R(v2.15.0): 새로(별도 행). 잠금 날 플랜지 t2 → 보 앞벽 t8 M5 탭(X −315·−255·−195·−135, Z 562), 물림 8 = 1.6d. 조임 4 N·m 지정 — 3 N·m로 낮추지 않는다(미끄럼 SF 2.04 → 1.53, 디테일 RX-06R-D7)
CB5-12 | 육각 구멍붙이 볼트 M5×12 | 미스미 | 2 | CB5-12_M05_7:2·:3(실물 STEP 사본) | 미확인 | - | RX-06-C2(v2.15.2): 새로(별도 행). 관 브래킷 P_M08_TUBE_BRKT_CST_V → 카세트 판 P_M05_CST_PLATE M5 탭(Y −152.5, Z 304·320), 받침면 X 62, 끝 X 50.0 = 판 뒷면, 물림 8 = 1.6d(M-01). 디테일 RX-06-C2-D1(끝–HOLDER 벽 여유 0)·D2(위 볼트 렌치 길에 관 FEED_A)
CB5-20 | 육각 구멍붙이 볼트 M5×20 (RX-11 저토크) | 미스미 | 8 | CB5-20_RX11 ×8(실물 STEP) | 미확인 | - | RX-11(v2.17.0): 새로(별도 행). 새들 → 판 긴 홈 → 클램프 M5 탭, 위에서 −Z, 머리 윗면 Z −3(카운터보어 매립), 물림 11.5 = 2.3d. RX-11 수정 1회차(v2.17.1): **이 8개만 조임 0.6 N·m(예압 약 600 N, 토크 드라이버) + 중강도 나사 고정제(Loctite 243 상당). 3 N·m·표준 토크 금지** — 3 N·m면 새들 항복(SF 0.75~0.78). 다른 CB5-20에는 해당 없음. 디테일 RX-11-V1-1·F7
RORLM20-6-L200 | 금속 파이프 롤러 Ø20 × L200 (베어링 696ZZ ×2 내장, 축 구멍 Ø6) | 미스미 | 14 | STEP대기_RORLM20-6-L200 ×14 | 미확인 | D-208·D-200 | RX-11(v2.17.0): 새로. U5 바퀴 밑 X축 자유 롤러 7개 × 2줄(Y ±11, 윗면 Z 0.000, X −1830~−334, 피치 216, 나눔 틈 16). STEP대기 임시 형상(E-10: 외경 20 × 200, 속 Ø12, 양 끝 5 구간 Ø6 — 카탈로그 표 tools/out/mech_RX-11/catalog.md). STEP 수령 → 바디 교체. 정격 C0r 670 · Cr 1,730 N·외경 공차는 임시 값(디테일 RX-11-F5)
SFJ6-213 | 리니어 샤프트 스트레이트 Ø6 g6 × L213 | 미스미 | 14 | STEP대기_SFJ6-213 ×14 | 미확인 | D-209 | RX-11(v2.17.0): 새로. 롤러 축, 새들의 위로 열린 홈에 얹음(롤러 양 끝에서 6.5씩 나옴, 들림 막이 없음 — 디테일 RX-11-D5). STEP대기 임시 형상(E-10: Ø6 × 213). STEP 수령 → 바디 교체
