hyeunung/FSAP/purchased-step/2400.05.075.0/2400.05.075.0.stp

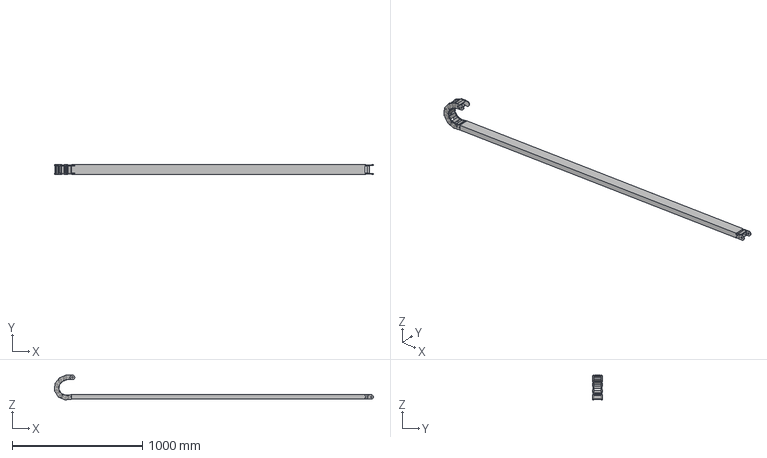
[picture p8: CAD file, 2026-11-03]
purchased-step/2400.05.075.0/2400.05.075.0.stp
2447.7 x 73.0 x 190.1 mm
