hyeunung/FSAP/purchased-step/6004ZZ/6004ZZ.stp

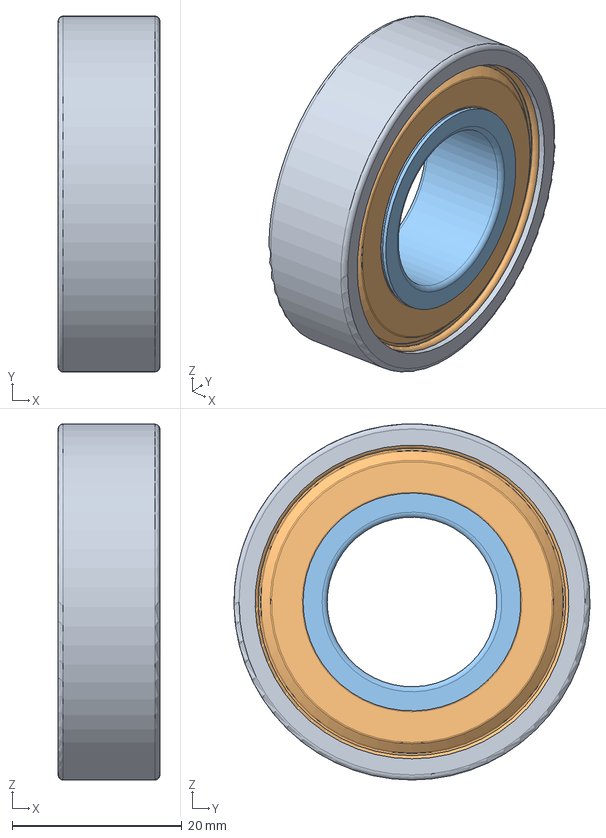
[picture p9: CAD file, 2026-11-03]
purchased-step/6004ZZ/6004ZZ.stp
12.0 x 42.0 x 42.0 mm
6004ZZ Outer ring
6004ZZ Shield1
6004ZZ Inner ring
6004ZZ Ball x 9
6004ZZ Shield2
