hyeunung/FSAP/purchased-step/6200ZZ/6200ZZ.stp

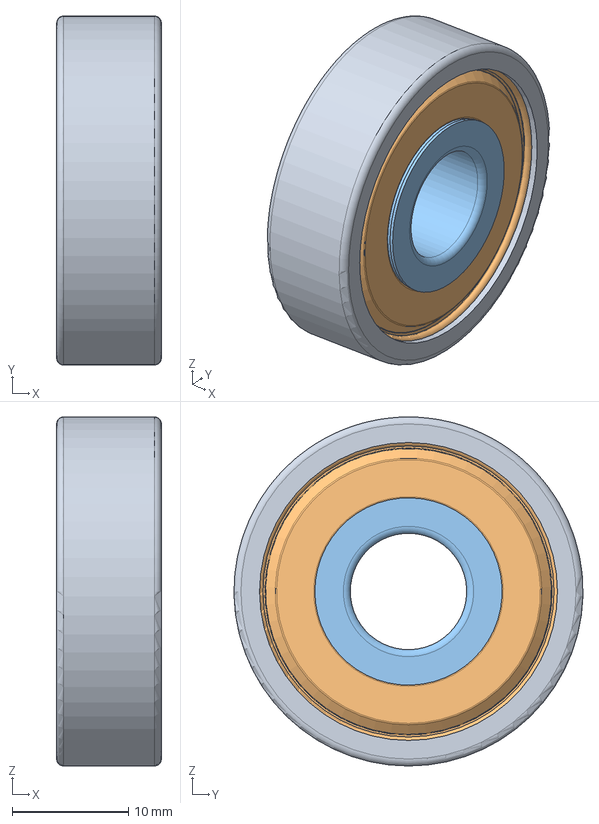
[picture p10: CAD file, 2026-11-05]
purchased-step/6200ZZ/6200ZZ.stp
9.00 x 30.0 x 30.0 mm
6200ZZ Outer ring
6200ZZ Shield1
6200ZZ Inner ring
6200ZZ Ball x 8
6200ZZ Shield2
