hyeunung/FSAP/purchased-step/BSS2020-1100/BSS2020-1100.stp

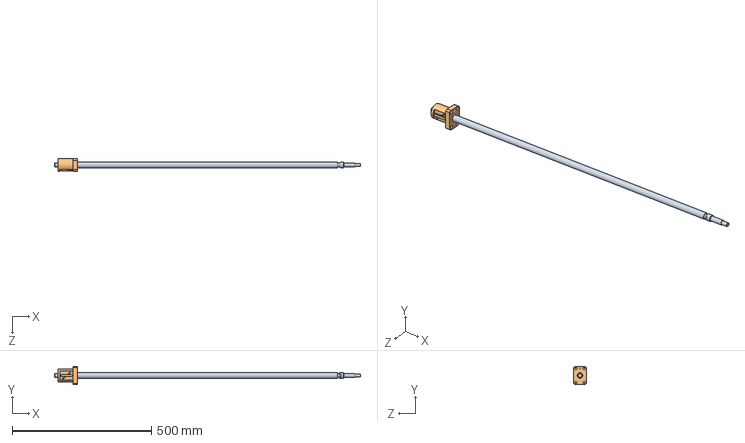
[picture p11: CAD file, 2026-10-30]
purchased-step/BSS2020-1100/BSS2020-1100.stp
1100.0 x 66.0 x 46.0 mm
SHAFT_BSS2020-1100
NAT-3_BSS2020-1100
