hyeunung/FSAP/purchased-step/BSS2020-1258/BSS2020-1258.stp

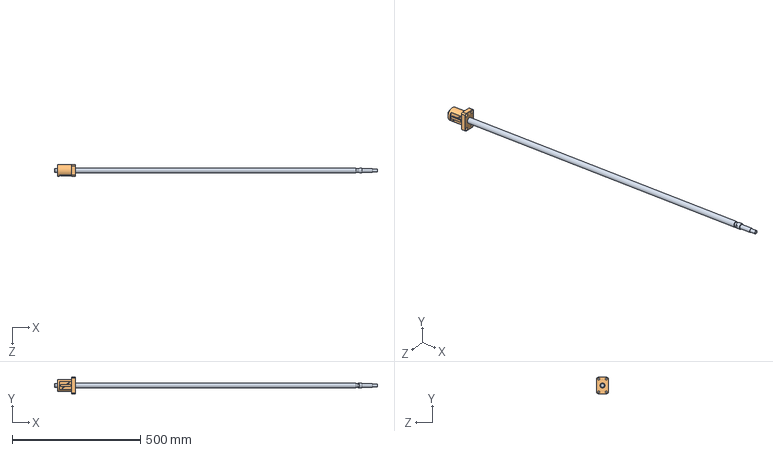
[picture p12: CAD file, 2026-11-01]
purchased-step/BSS2020-1258/BSS2020-1258.stp
1258.0 x 66.0 x 46.0 mm
SHAFT_BSS2020-1258
NAT-3_BSS2020-1258
