hyeunung/FSAP/purchased-step/BSS2020-1450/BSS2020-1450.stp

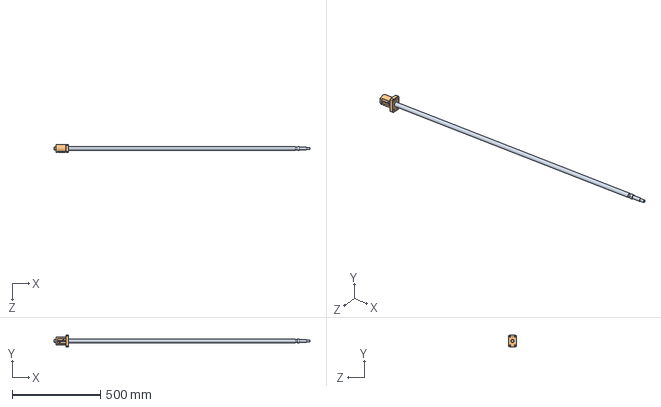
[picture p13: CAD file, 2026-10-30]
purchased-step/BSS2020-1450/BSS2020-1450.stp
1450.0 x 66.0 x 46.0 mm
SHAFT_BSS2020-1450
NAT-3_BSS2020-1450
