hyeunung/FSAP/purchased-step/BSS2520-1475/BSS2520-1475.stp

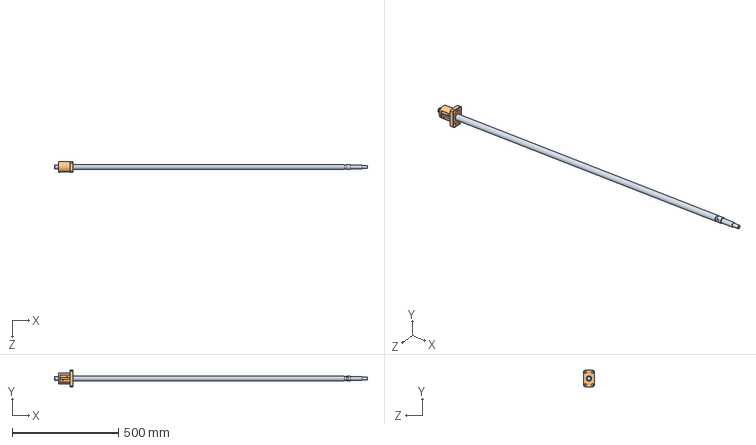
[picture p14: CAD file, 2026-11-01]
purchased-step/BSS2520-1475/BSS2520-1475.stp
1475.0 x 78.0 x 52.0 mm
SHAFT_BSS2520-1475
NAT-3_BSS2520-1475
