hyeunung/FSAP/purchased-step/BSW15/BSW15.stp

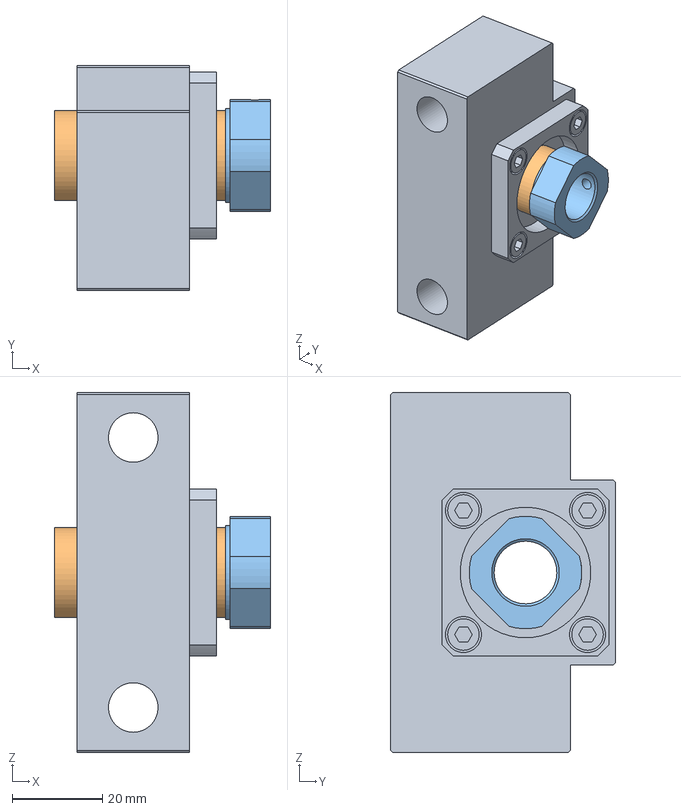
[picture p15: CAD file, 2026-11-01]
purchased-step/BSW15/BSW15.stp
48.0 x 50.0 x 80.0 mm
BSW15_b
BSW15_c x 2
BSW15_n
