hyeunung/FSAP/purchased-step/BSW20/BSW20.stp

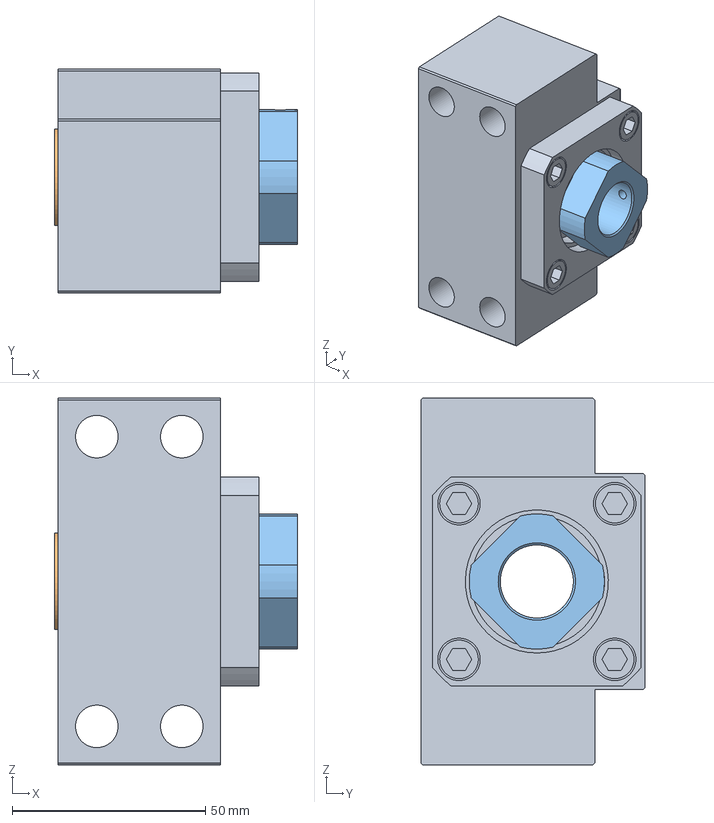
[picture p16: CAD file, 2026-11-01]
purchased-step/BSW20/BSW20.stp
63.0 x 58.0 x 95.0 mm
BSW20_b
BSW20_c x 2
BSW20_n
