hyeunung/FSAP/purchased-step/BUN15/BUN15.stp

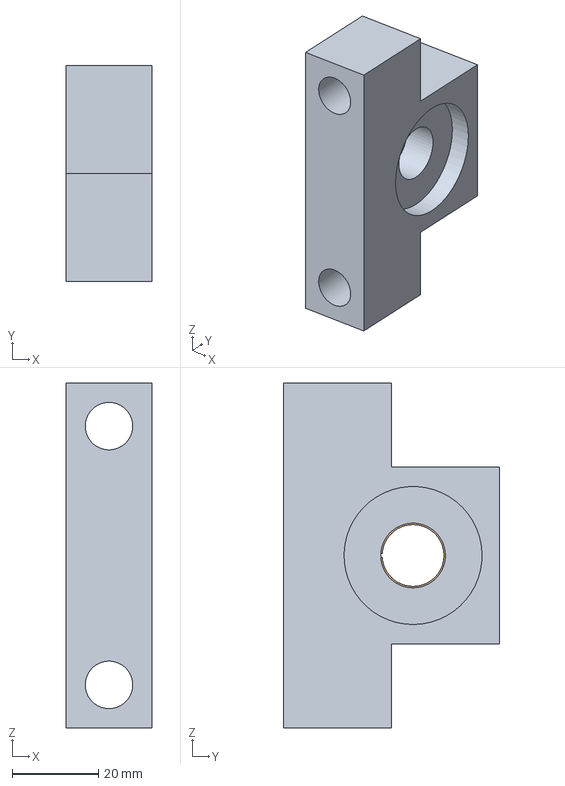
[picture p17: CAD file, 2026-11-01]
purchased-step/BUN15/BUN15.stp
20.0 x 50.0 x 80.0 mm
BUN15_b
RRING-C-EXT-15
