hyeunung/FSAP/purchased-step/BUN20/BUN20.stp

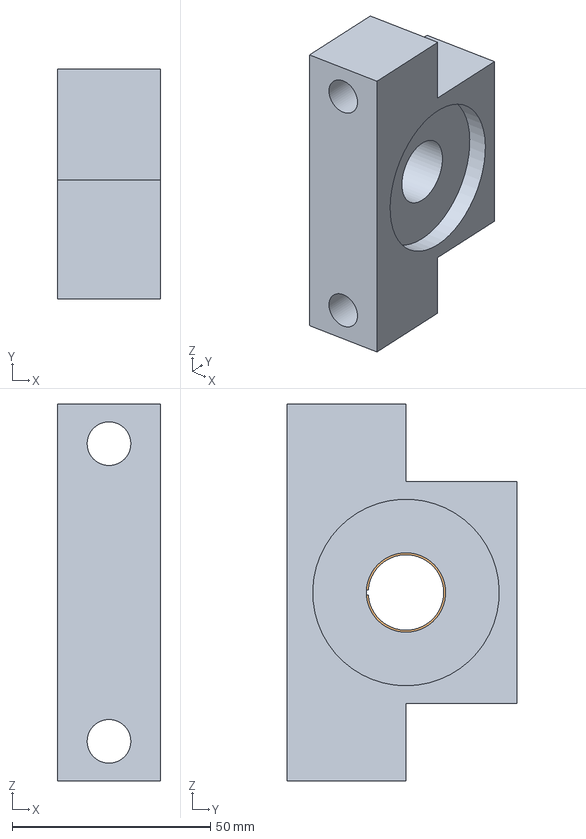
[picture p18: CAD file, 2026-11-01]
purchased-step/BUN20/BUN20.stp
26.0 x 58.0 x 95.0 mm
BUN20_b
RRING-C-EXT-20
