hyeunung/FSAP/purchased-step/CB3-10/CB3-10.stp

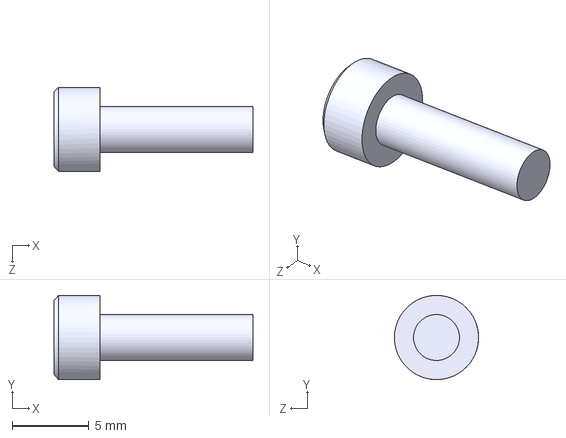
[picture p19: CAD file, 2026-11-05]
purchased-step/CB3-10/CB3-10.stp
13.0 x 5.50 x 5.50 mm
