hyeunung/FSAP/purchased-step/CB4-12/CB4-12.stp

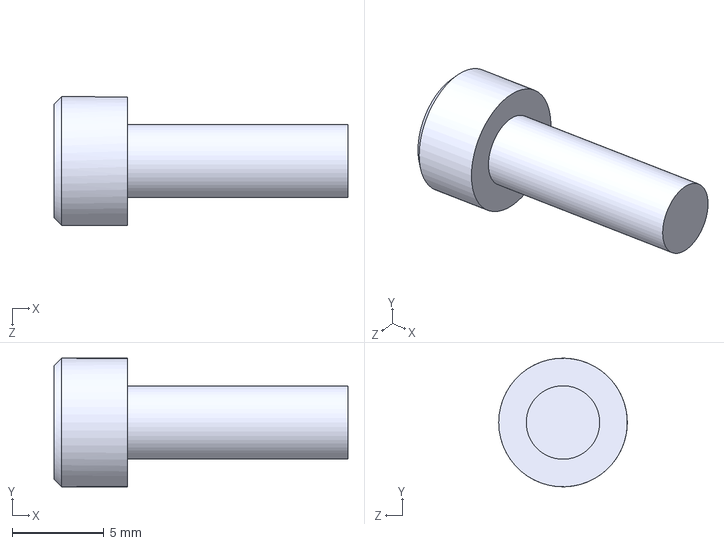
[picture p20: CAD file, 2026-11-05]
purchased-step/CB4-12/CB4-12.stp
16.0 x 7.00 x 7.00 mm
