hyeunung/FSAP/purchased-step/CB4-20/CB4-20.stp

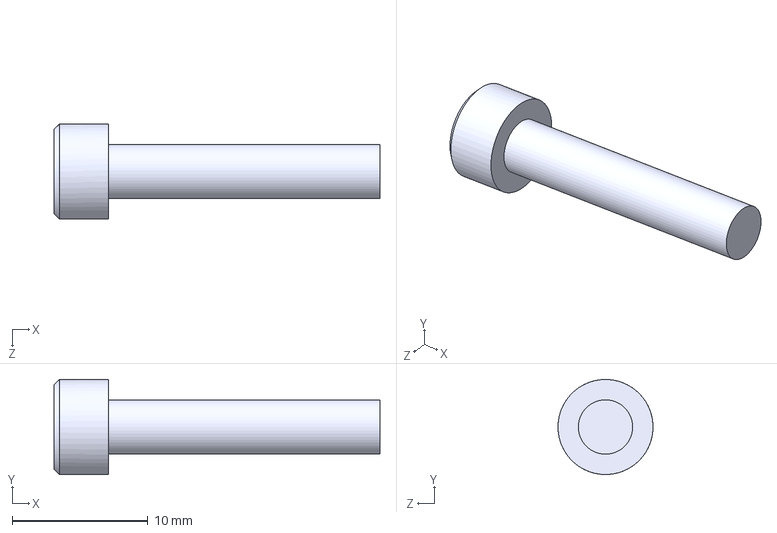
[picture p21: CAD file, 2026-11-05]
purchased-step/CB4-20/CB4-20.stp
24.0 x 7.00 x 7.00 mm
