hyeunung/FSAP/purchased-step/CB4-25/CB4-25.stp

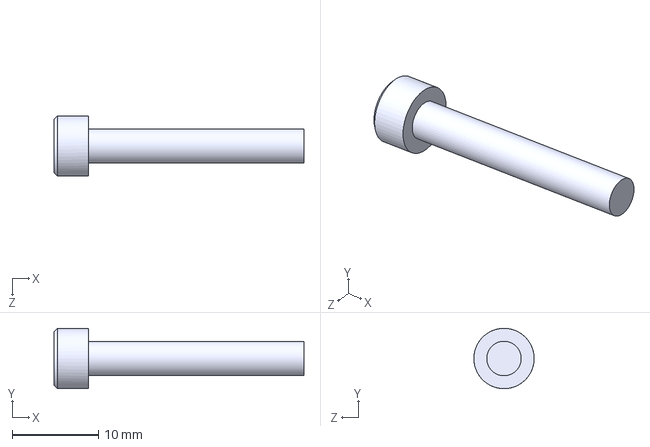
[picture p22: CAD file, 2026-11-05]
purchased-step/CB4-25/CB4-25.stp
29.0 x 7.00 x 7.00 mm
