hyeunung/FSAP/purchased-step/CB5-12/CB5-12.stp

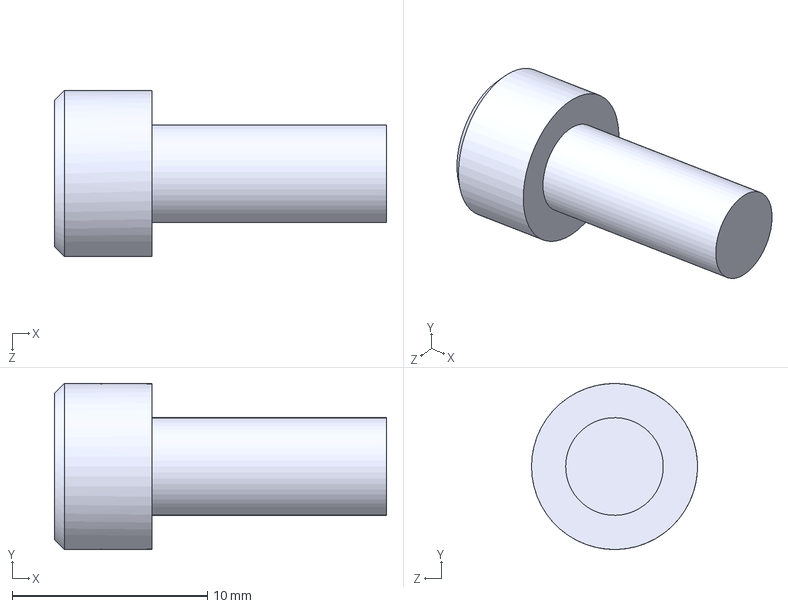
[picture p23: CAD file, 2026-10-30]
purchased-step/CB5-12/CB5-12.stp
17.0 x 8.50 x 8.50 mm
