hyeunung/FSAP/purchased-step/CB5-16/CB5-16.stp

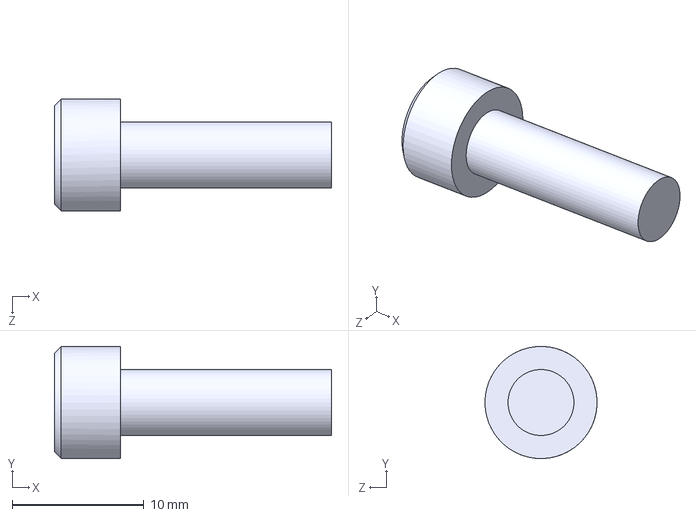
[picture p24: CAD file, 2026-10-30]
purchased-step/CB5-16/CB5-16.stp
21.0 x 8.50 x 8.50 mm
