hyeunung/FSAP/purchased-step/CB5-20/CB5-20.stp

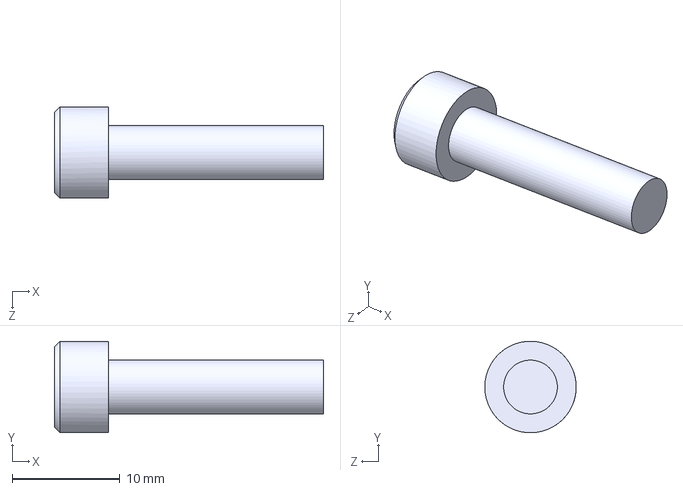
[picture p25: CAD file, 2026-10-30]
purchased-step/CB5-20/CB5-20.stp
25.0 x 8.50 x 8.50 mm
