hyeunung/FSAP/purchased-step/CB5-6/CB5-6.stp

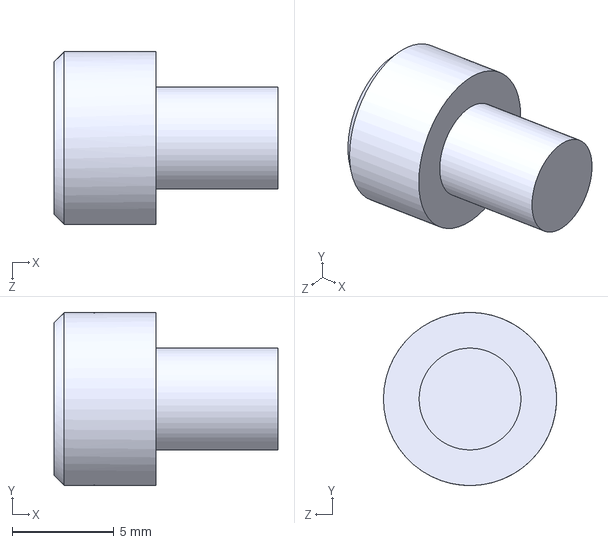
[picture p26: CAD file, 2026-11-05]
purchased-step/CB5-6/CB5-6.stp
11.0 x 8.50 x 8.50 mm
