hyeunung/FSAP/purchased-step/CB6-16/CB6-16.stp

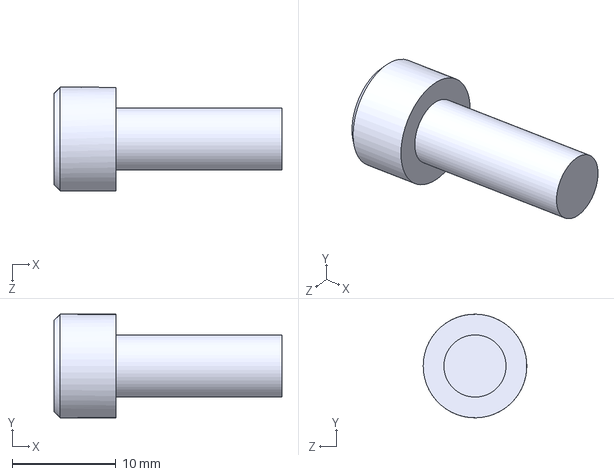
[picture p27: CAD file, 2026-11-05]
purchased-step/CB6-16/CB6-16.stp
22.0 x 10.00 x 10.0 mm
