hyeunung/FSAP/purchased-step/CB6-20/CB6-20.stp

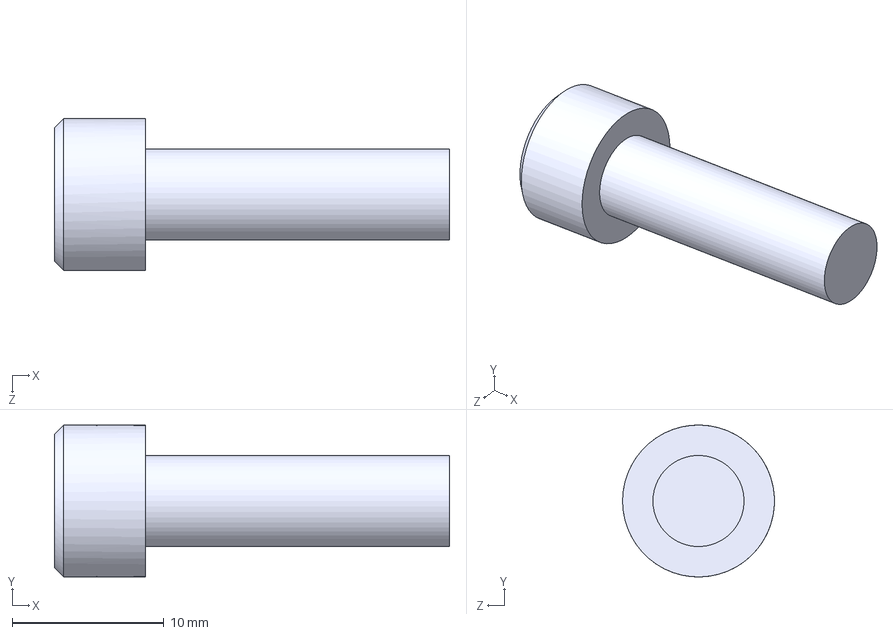
[picture p28: CAD file, 2026-11-05]
purchased-step/CB6-20/CB6-20.stp
26.0 x 10.00 x 10.0 mm
