hyeunung/FSAP/purchased-step/CB8-15/CB8-15.stp

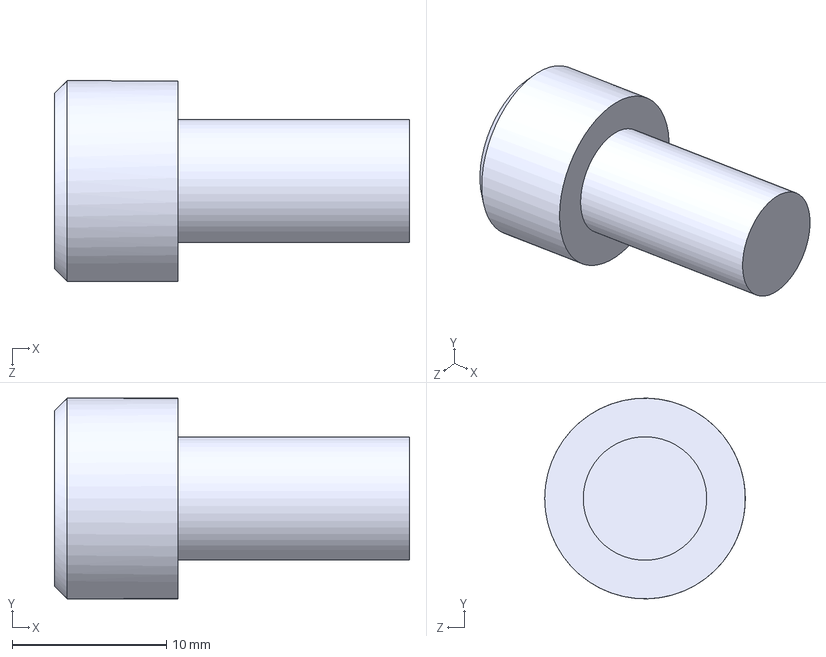
[picture p29: CAD file, 2026-11-05]
purchased-step/CB8-15/CB8-15.stp
23.0 x 13.0 x 13.0 mm
