hyeunung/FSAP/purchased-step/CB8-16/CB8-16.stp

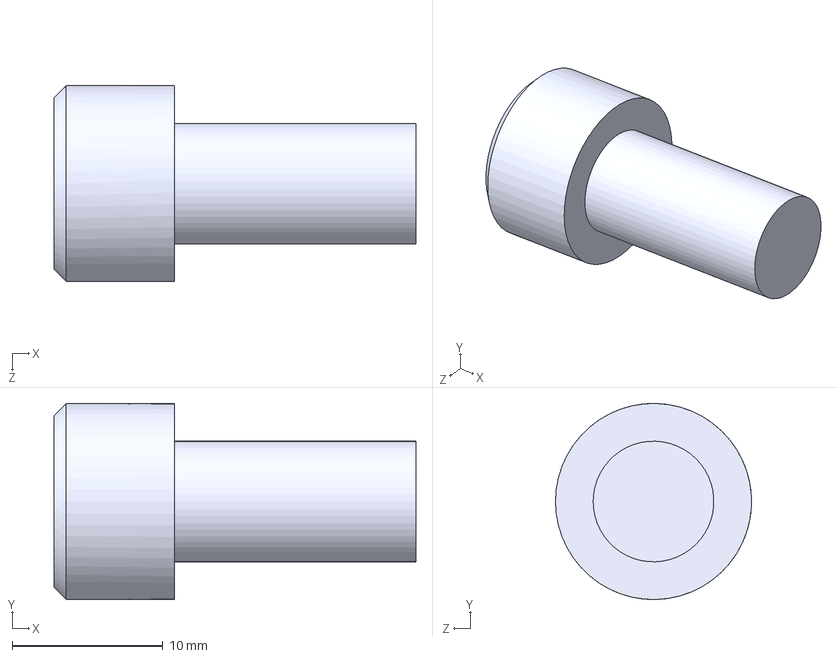
[picture p30: CAD file, 2026-11-04]
purchased-step/CB8-16/CB8-16.stp
24.0 x 13.0 x 13.0 mm
