hyeunung/FSAP/purchased-step/CB8-20/CB8-20.stp

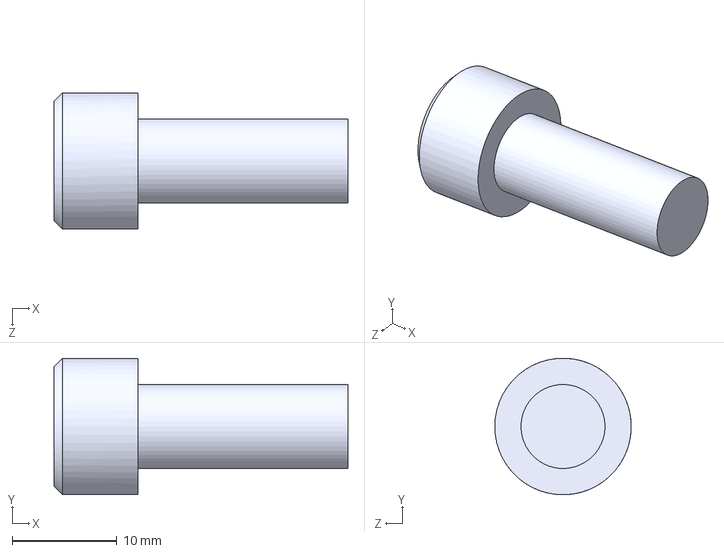
[picture p31: CAD file, 2026-11-05]
purchased-step/CB8-20/CB8-20.stp
28.0 x 13.0 x 13.0 mm
