hyeunung/FSAP/purchased-step/CB8-40/CB8-40.stp

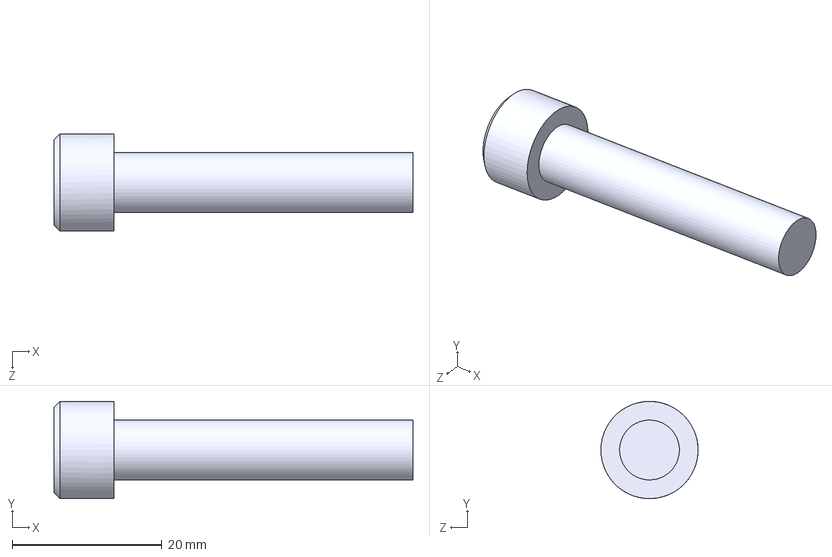
[picture p32: CAD file, 2026-11-01]
purchased-step/CB8-40/CB8-40.stp
48.0 x 13.0 x 13.0 mm
