hyeunung/FSAP/purchased-step/CB8-45/CB8-45.stp

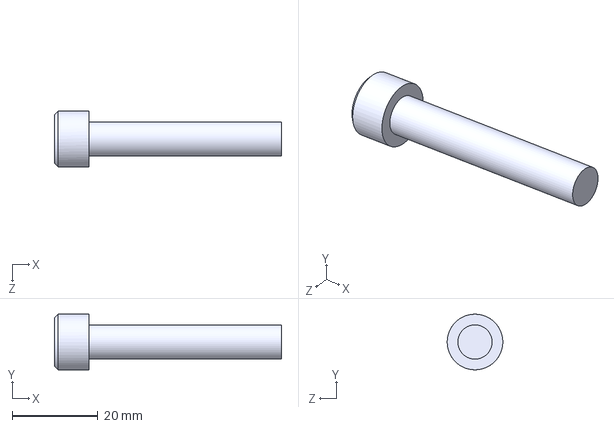
[picture p33: CAD file, 2026-11-01]
purchased-step/CB8-45/CB8-45.stp
53.0 x 13.0 x 13.0 mm
