hyeunung/FSAP/purchased-step/CDJ2B16-110Z-B/CDJ2B16-110Z-B.stp

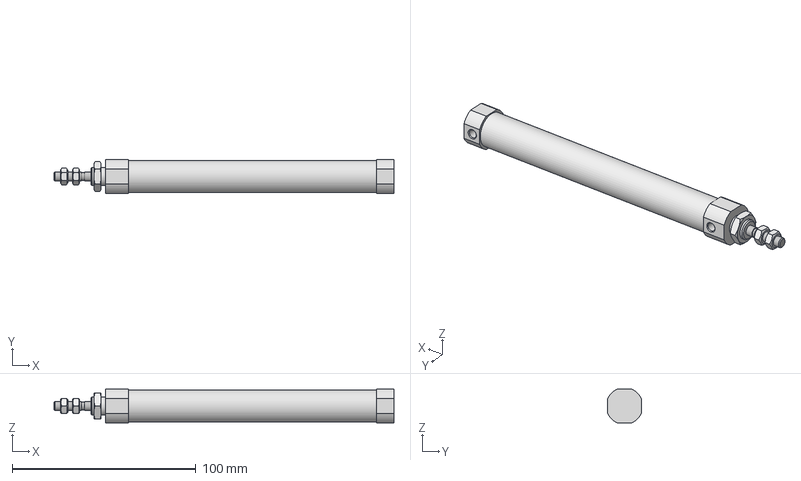
[picture p34: CAD file, 2026-11-03]
purchased-step/CDJ2B16-110Z-B/CDJ2B16-110Z-B.stp
185.0 x 18.3 x 18.3 mm
CJ2B16-110Z-B(1_0)_BODY
CJ2B16-110Z_ROD
NTJ-015C x 2
SNJ-016C
