hyeunung/FSAP/purchased-step/CDJ2B16-150AZ-B/CDJ2B16-150AZ-B.stp

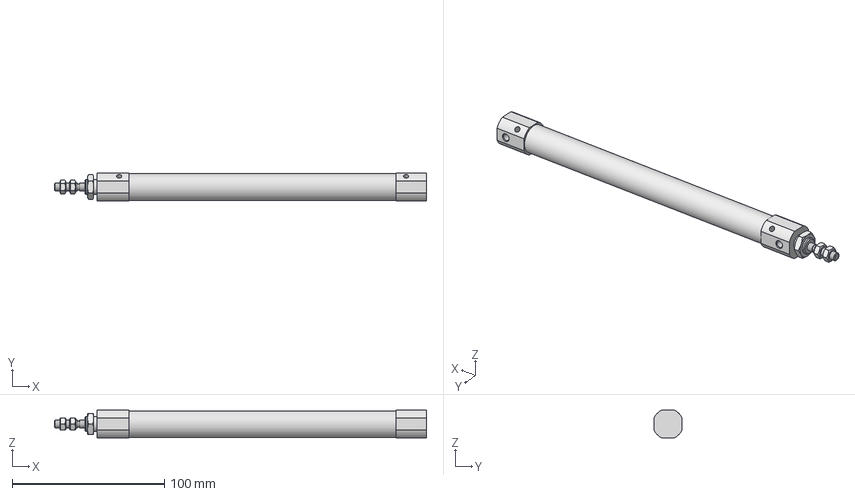
[picture p35: CAD file, 2026-11-03]
purchased-step/CDJ2B16-150AZ-B/CDJ2B16-150AZ-B.stp
244.0 x 18.3 x 18.3 mm
CJ2B16-150AZ-B(1_0)_BODY
CJ2B16-150AZ_ROD
NTJ-015C x 2
SNJ-016C
