hyeunung/FSAP/purchased-step/CDM2C20-25Z/CDM2C20-25Z.stp

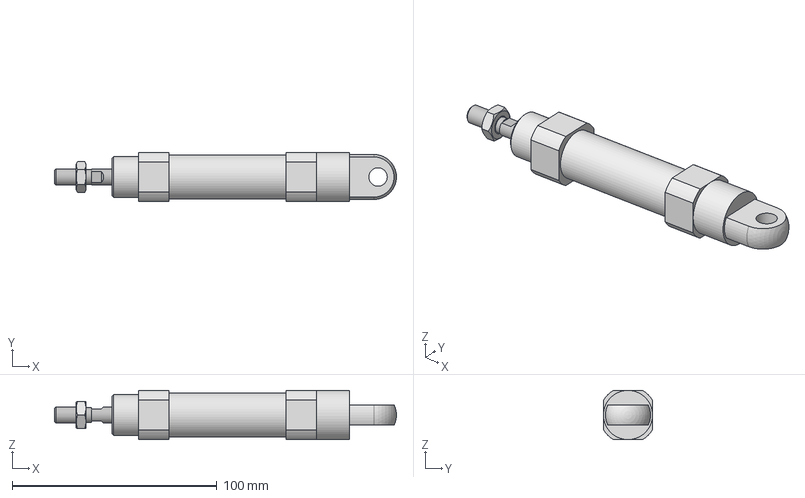
[picture p36: CAD file, 2026-11-03]
purchased-step/CDM2C20-25Z/CDM2C20-25Z.stp
167.0 x 24.0 x 24.0 mm
CDM2C20-25Z(0)_BODY
CM2C20-25Z(0_0)_ROD
NT-02_CM2(20)
CM-C020B_Z(20_C_0_0)_FITTING
