hyeunung/FSAP/purchased-step/CJ2B10-15Z/CJ2B10-15Z.stp

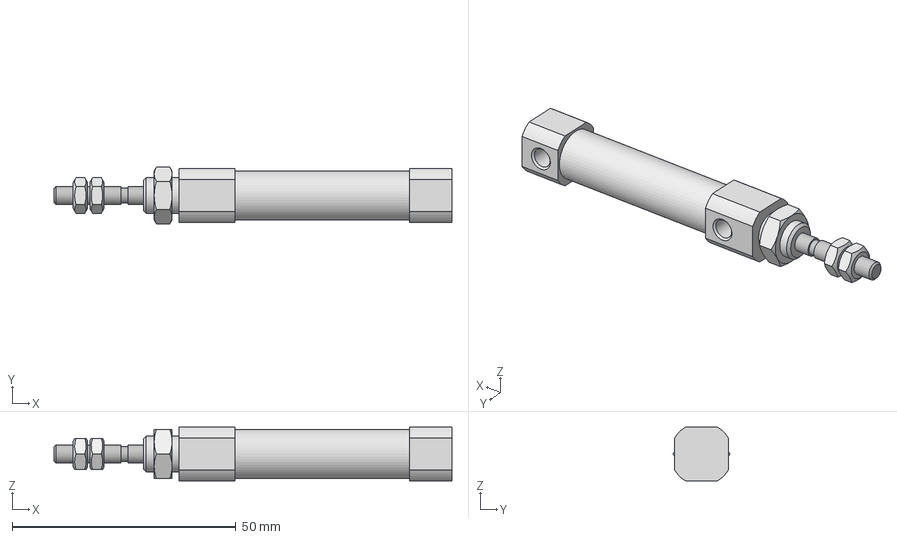
[picture p37: CAD file, 2026-10-30]
purchased-step/CJ2B10-15Z/CJ2B10-15Z.stp
89.0 x 12.7 x 12.0 mm
CJ2B10-15Z(1_0)_BODY
CJ2B10-15Z_ROD
NTJ-010C x 2
SNJ-010C
