hyeunung/FSAP/purchased-step/CJ2B16-60SZ/CJ2B16-60SZ.stp

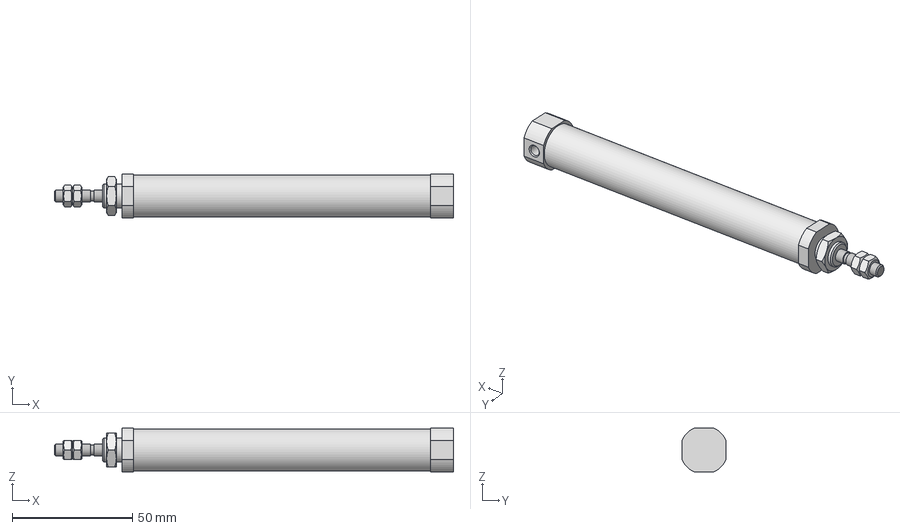
[picture p38: CAD file, 2026-10-30]
purchased-step/CJ2B16-60SZ/CJ2B16-60SZ.stp
166.0 x 18.3 x 18.3 mm
CJ2B16-60SZ(0_0)_BODY
CJ2B16-60SZ_ROD
NTJ-015C x 2
SNJ-016C
