hyeunung/FSAP/purchased-step/DGM200R-AZAC/DGM200R-AZAC.stp

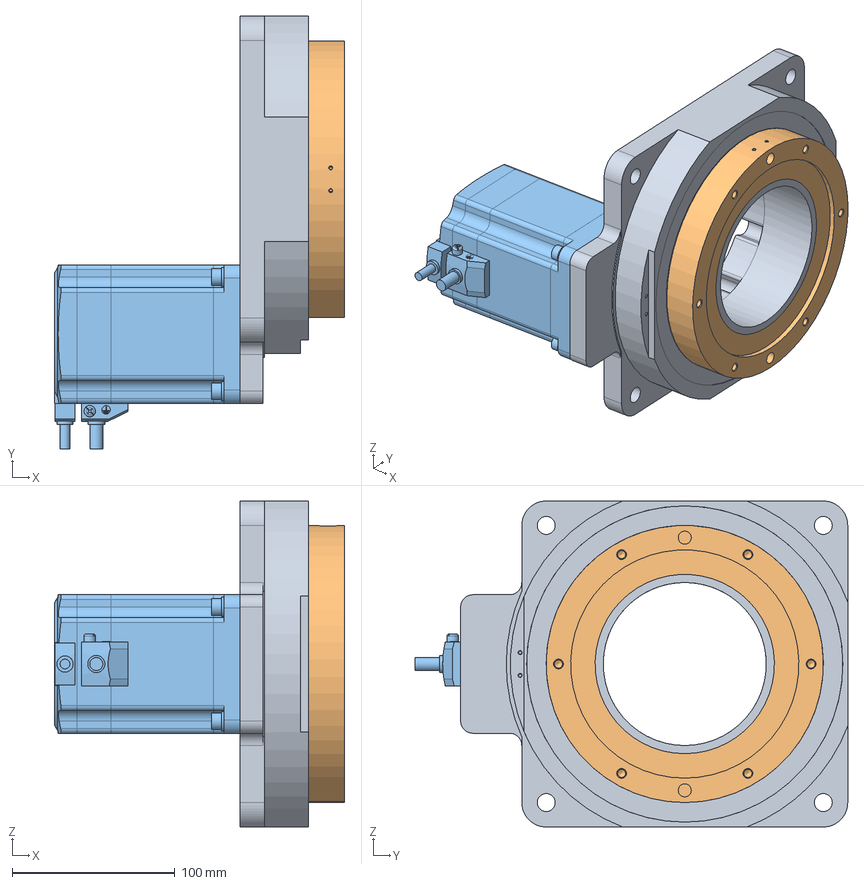
[picture p39: CAD file, 2026-10-30]
purchased-step/DGM200R-AZAC/DGM200R-AZAC.stp
178.0 x 265.4 x 200.0 mm
DG200R-AZACD-1(Single Shaft)_gear2
DGii200_ring
DG200R-AZACD-1(Single Shaft)_body
