hyeunung/FSAP/purchased-step/E32-D36P1_2M/E32-D36P1_2M.stp

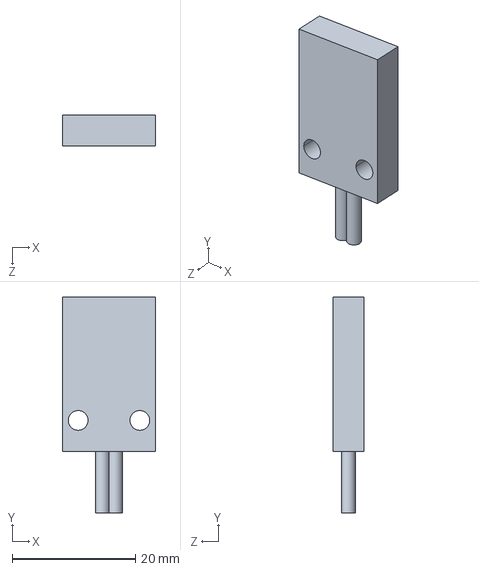
[picture p40: CAD file, 2026-10-30]
purchased-step/E32-D36P1_2M/E32-D36P1_2M.stp
15.0 x 35.0 x 5.00 mm
