hyeunung/FSAP/purchased-step/E3NX-FA11_2M/E3NX-FA11_2M.stp

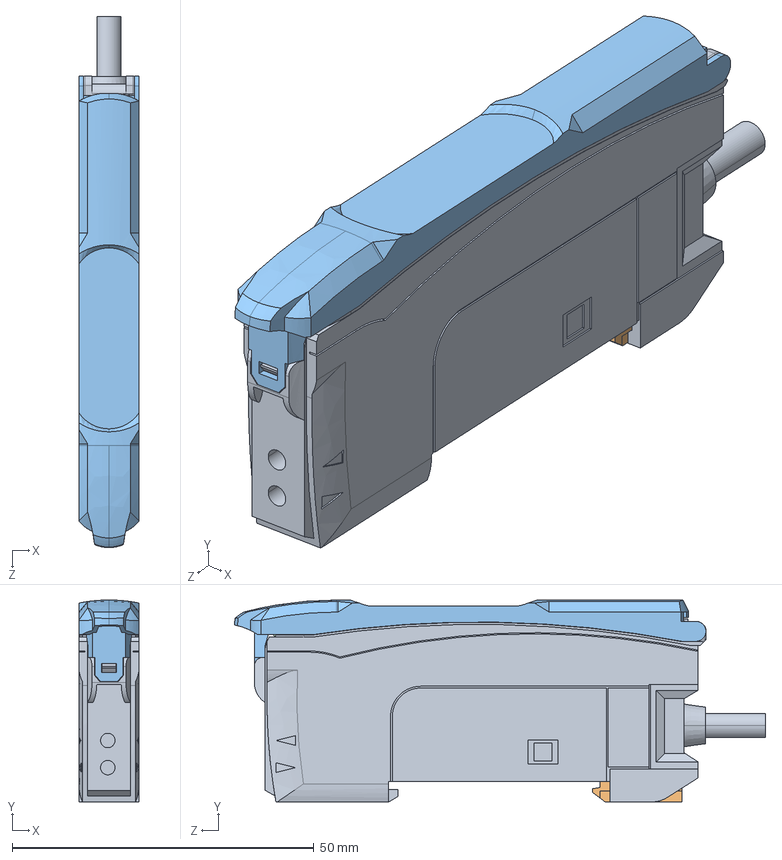
[picture p41: CAD file, 2026-10-30]
purchased-step/E3NX-FA11_2M/E3NX-FA11_2M.stp
10.0 x 33.5 x 88.1 mm
E3NX_FA11_BASE_Default
E3NX_FA11_SLIDE_Default
E3NX_FA11_COVER_Default
E3NX_FA11_LEVER_Default
