hyeunung/FSAP/purchased-step/E4.56.10.150.0/E4.56.10.150.0.stp

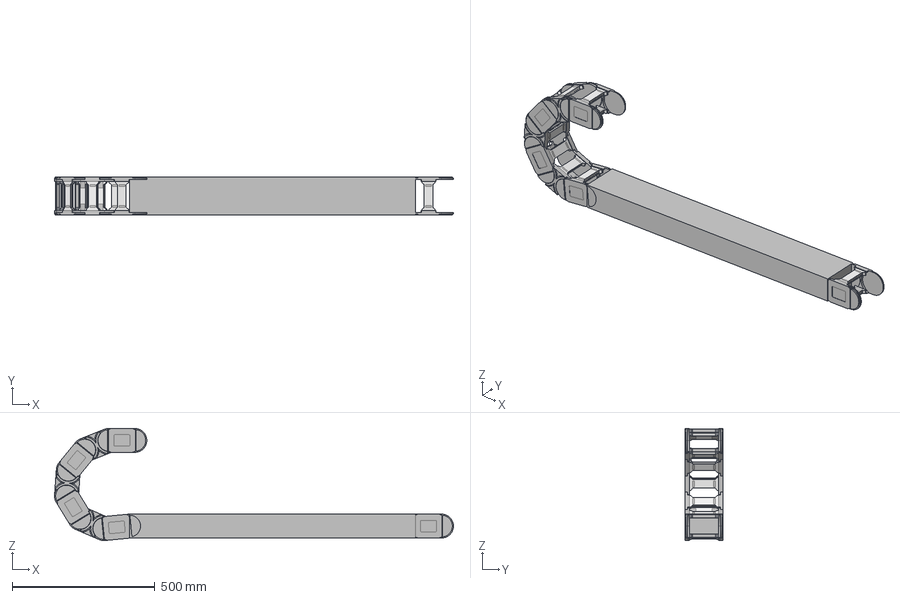
[picture p42: CAD file, 2026-11-03]
purchased-step/E4.56.10.150.0/E4.56.10.150.0.stp
1397.4 x 134.0 x 392.8 mm
