hyeunung/FSAP/purchased-step/F3SG-4RA0800-14/F3SG-4RA0800-14.stp

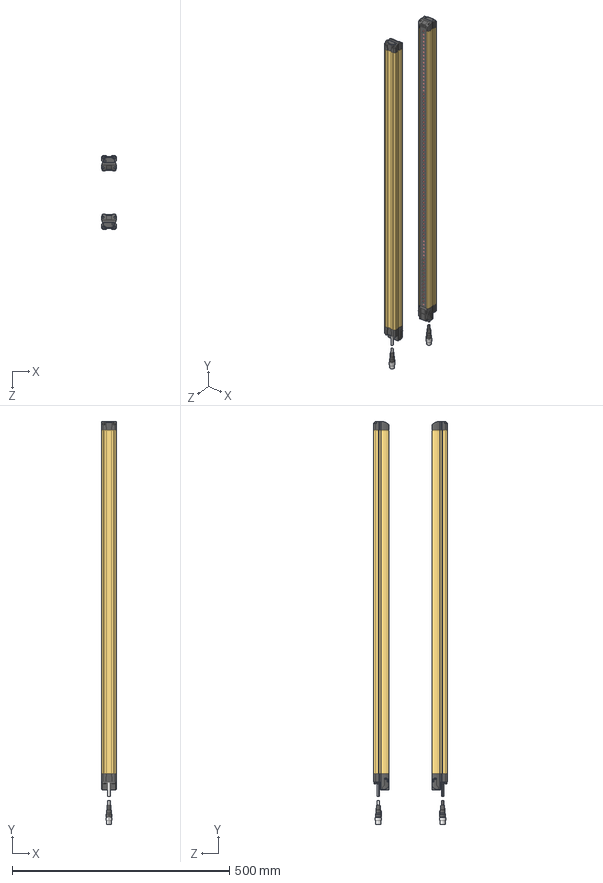
[picture p43: CAD file, 2026-11-05]
purchased-step/F3SG-4RA0800-14/F3SG-4RA0800-14.stp
35.0 x 927.7 x 170.0 mm
F3SG_4RA0800_14_CAP x 2
F3SG_4RA0800_14_D_BASE
F3SG_4RA0800_14_D_CONNECTOR
F3SG_4RA0800_14_L_BASE
F3SG_4RA0800_14_L_CONNECTOR
