hyeunung/FSAP/purchased-step/HBLFSN8/HBLFSN8.stp

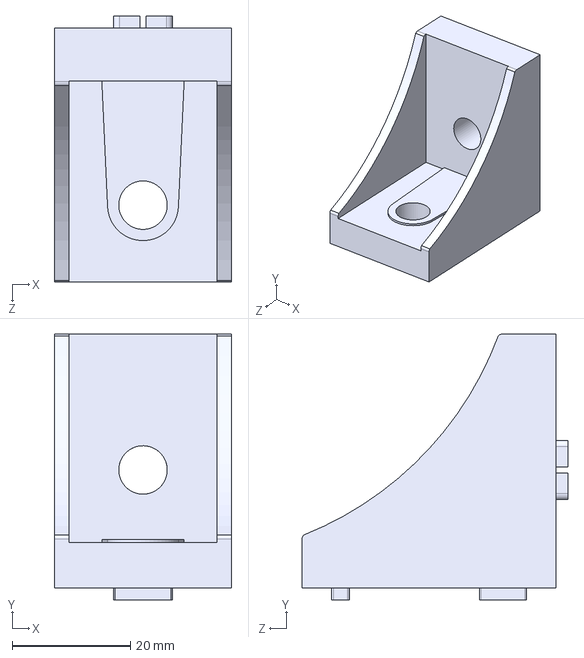
[picture p44: CAD file, 2026-10-30]
purchased-step/HBLFSN8/HBLFSN8.stp
30.0 x 45.0 x 45.0 mm
