hyeunung/FSAP/purchased-step/HFC8-4080-B/HFC8-4080-B.stp

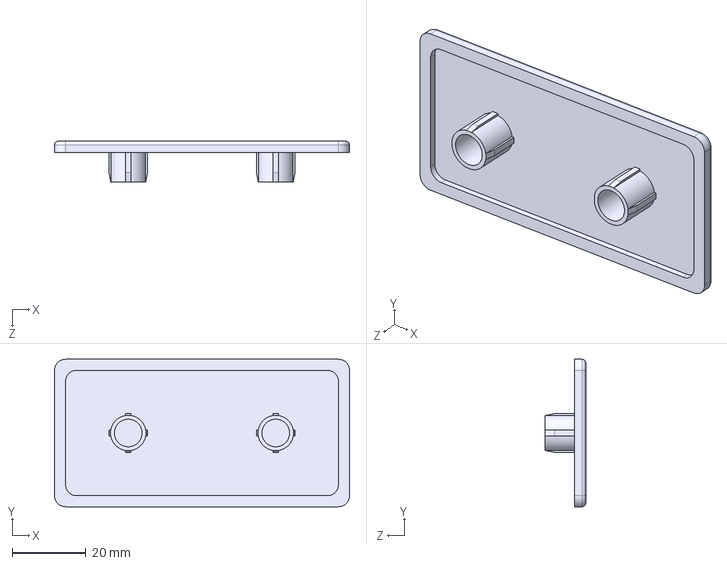
[picture p45: CAD file, 2026-10-30]
purchased-step/HFC8-4080-B/HFC8-4080-B.stp
80.0 x 40.0 x 11.0 mm
