hyeunung/FSAP/purchased-step/HFS8-4080-1140/HFS8-4080-1140.stp

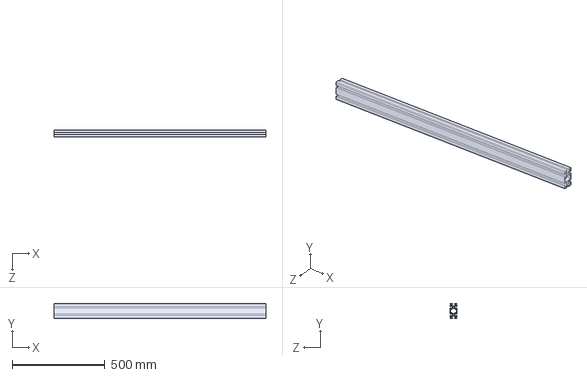
[picture p46: CAD file, 2026-11-01]
purchased-step/HFS8-4080-1140/HFS8-4080-1140.stp
1140.0 x 80.0 x 40.0 mm
