hyeunung/FSAP/purchased-step/HFS8-4080-1300/HFS8-4080-1300.stp

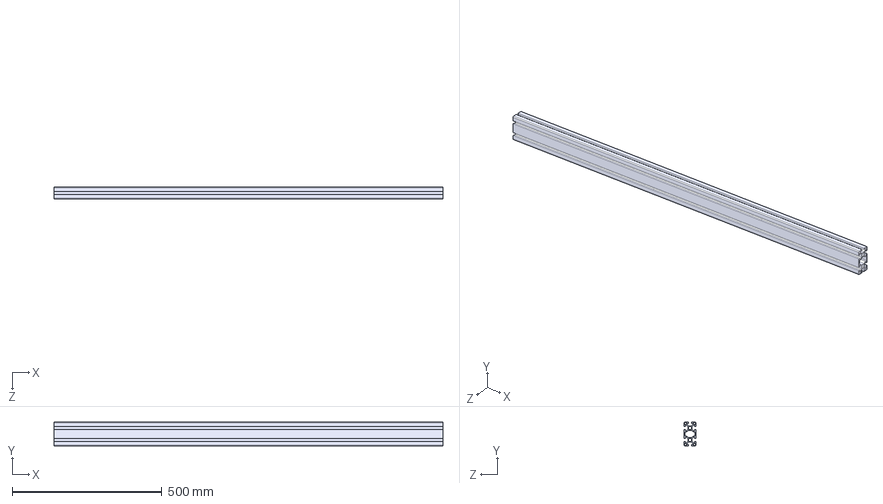
[picture p47: CAD file, 2026-10-30]
purchased-step/HFS8-4080-1300/HFS8-4080-1300.stp
1300.0 x 80.0 x 40.0 mm
