hyeunung/FSAP/purchased-step/HFS8-4080-1900/HFS8-4080-1900.stp

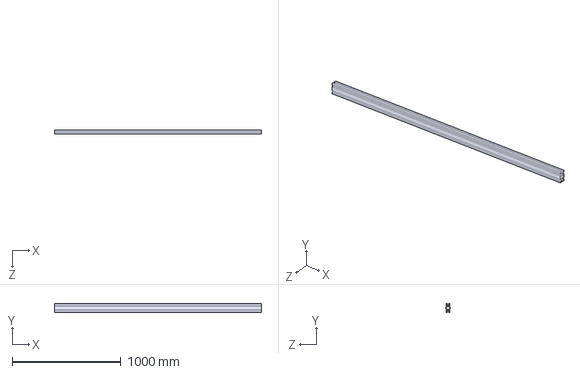
[picture p48: CAD file, 2026-10-30]
purchased-step/HFS8-4080-1900/HFS8-4080-1900.stp
1900.0 x 80.0 x 40.0 mm
