hyeunung/FSAP/purchased-step/HFS8-4080-248/HFS8-4080-248.stp

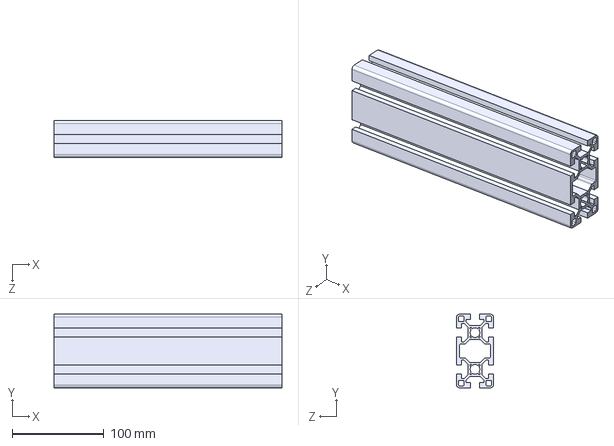
[picture p49: CAD file, 2026-11-03]
purchased-step/HFS8-4080-248/HFS8-4080-248.stp
248.0 x 80.0 x 40.0 mm
