hyeunung/FSAP/purchased-step/HFS8-4080-460/HFS8-4080-460.stp

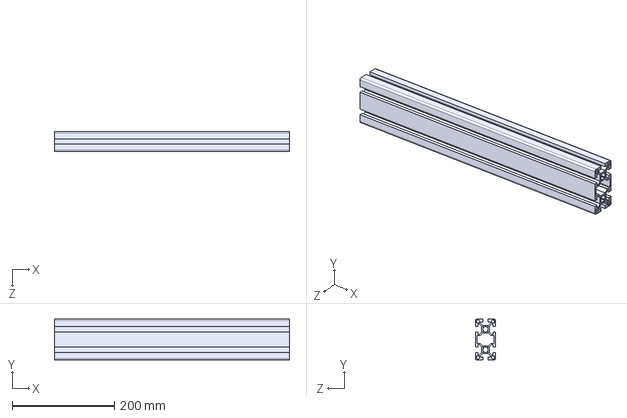
[picture p50: CAD file, 2026-10-30]
purchased-step/HFS8-4080-460/HFS8-4080-460.stp
460.0 x 80.0 x 40.0 mm
