hyeunung/FSAP/purchased-step/HFS8-4080-580/HFS8-4080-580.stp

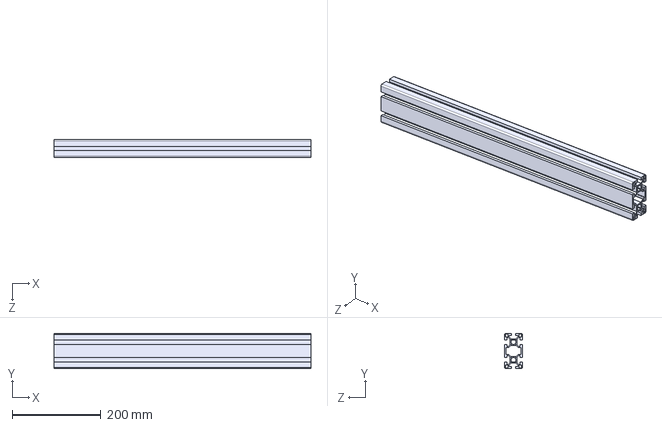
[picture p51: CAD file, 2026-10-30]
purchased-step/HFS8-4080-580/HFS8-4080-580.stp
580.0 x 80.0 x 40.0 mm
