hyeunung/FSAP/purchased-step/HFS8-80160-1090/HFS8-80160-1090.stp

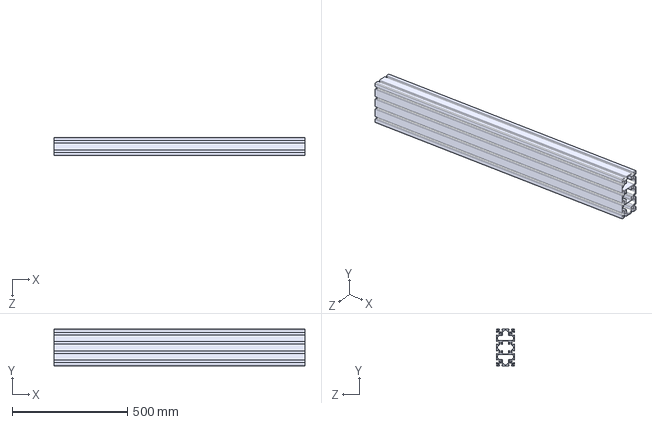
[picture p52: CAD file, 2026-11-05]
purchased-step/HFS8-80160-1090/HFS8-80160-1090.stp
1090.0 x 160.0 x 80.0 mm
