hyeunung/FSAP/purchased-step/HNTT8-5/HNTT8-5.stp

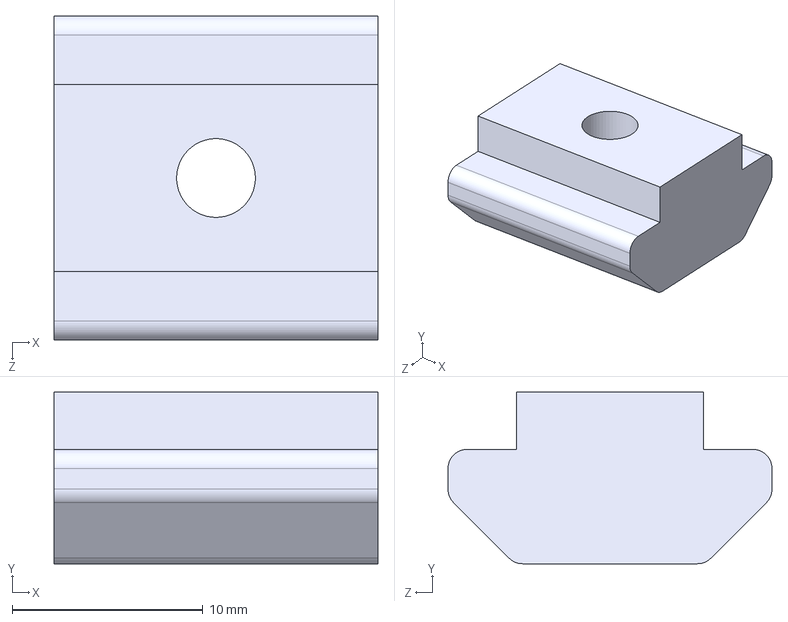
[picture p53: CAD file, 2026-11-01]
purchased-step/HNTT8-5/HNTT8-5.stp
17.0 x 9.00 x 17.0 mm
