hyeunung/FSAP/purchased-step/HNTT8-8/HNTT8-8.stp

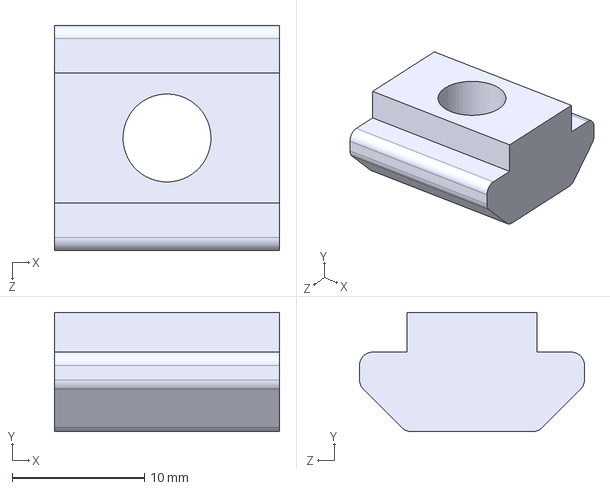
[picture p54: CAD file, 2026-11-01]
purchased-step/HNTT8-8/HNTT8-8.stp
17.0 x 9.00 x 17.0 mm
