hyeunung/FSAP/purchased-step/HTBN625S5M-150/HTBN625S5M-150.stp

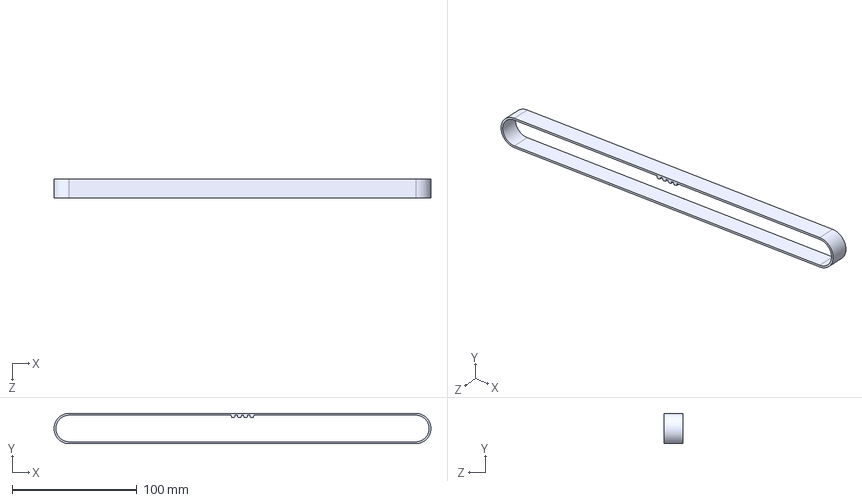
[picture p55: CAD file, 2026-11-03]
purchased-step/HTBN625S5M-150/HTBN625S5M-150.stp
301.8 x 24.3 x 15.0 mm
