hyeunung/FSAP/purchased-step/HTBO-S5M150-792/HTBO-S5M150-792.stp

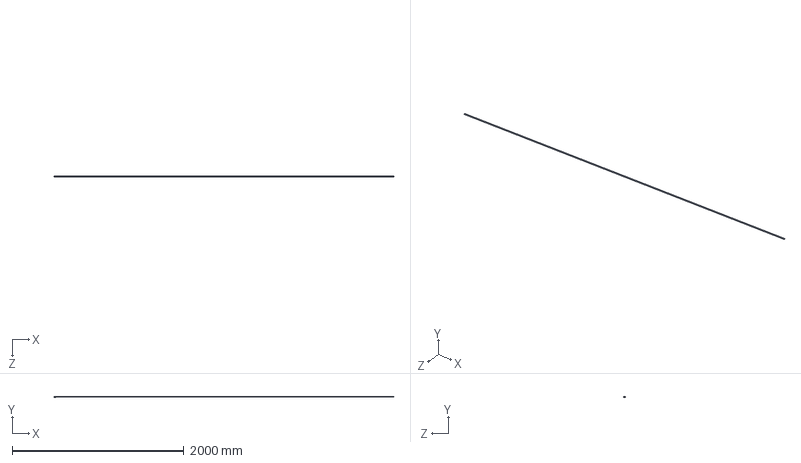
[picture p56: CAD file, 2026-11-05]
purchased-step/HTBO-S5M150-792/HTBO-S5M150-792.stp
3960.0 x 3.20 x 15.0 mm
