hyeunung/FSAP/purchased-step/HTPA20S5M150-A-N12/HTPA20S5M150-A-N12.stp

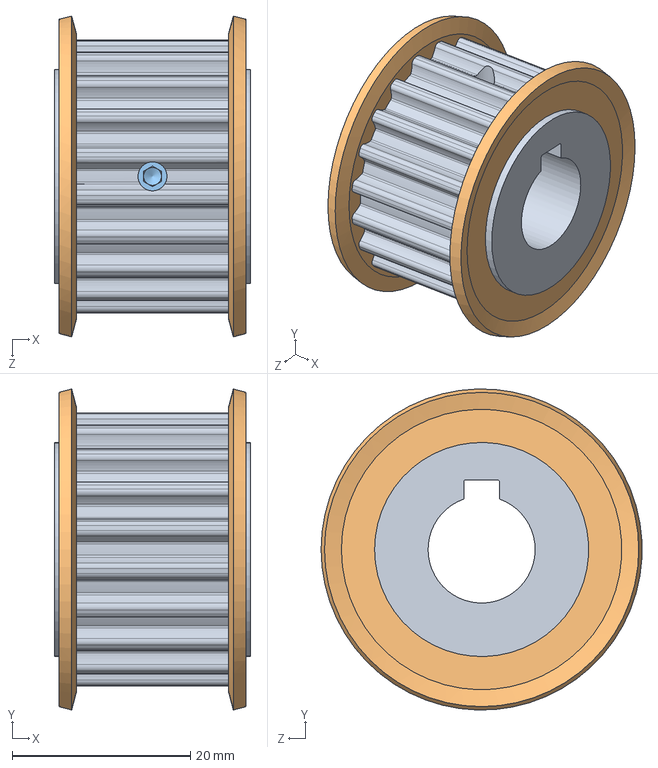
[picture p57: CAD file, 2026-11-03]
purchased-step/HTPA20S5M150-A-N12/HTPA20S5M150-A-N12.stp
22.0 x 36.0 x 36.0 mm
