hyeunung/FSAP/purchased-step/HTPA25S5M150-A-N14/HTPA25S5M150-A-N14.stp

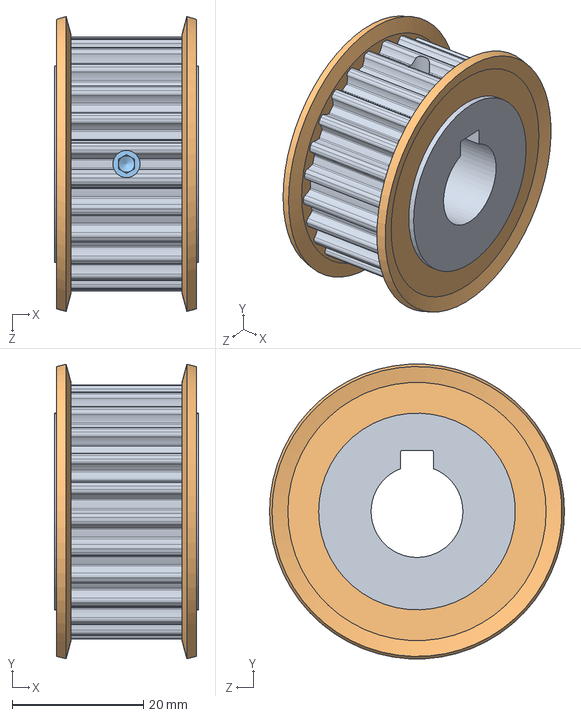
[picture p58: CAD file, 2026-11-03]
purchased-step/HTPA25S5M150-A-N14/HTPA25S5M150-A-N14.stp
22.0 x 44.9 x 45.0 mm
