hyeunung/FSAP/purchased-step/HTPA28S5M250-A-N19/HTPA28S5M250-A-N19.stp

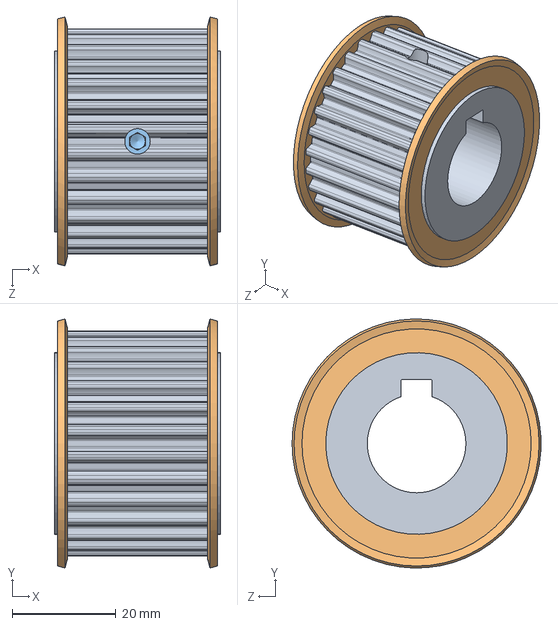
[picture p59: CAD file, 2026-11-03]
purchased-step/HTPA28S5M250-A-N19/HTPA28S5M250-A-N19.stp
32.0 x 48.0 x 48.0 mm
