hyeunung/FSAP/purchased-step/HTPA60S5M150-A-N16/HTPA60S5M150-A-N16.stp

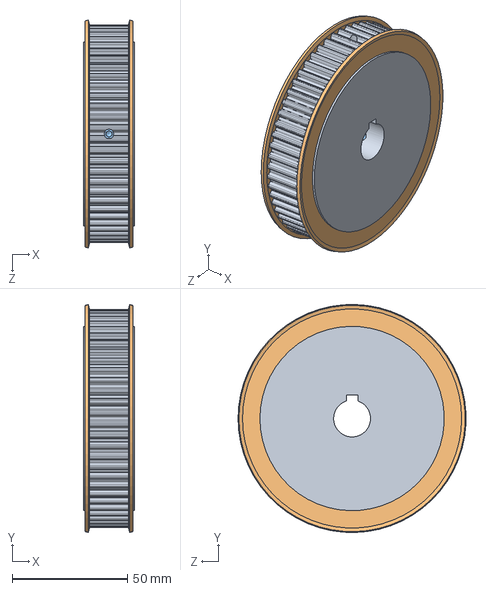
[picture p60: CAD file, 2026-11-05]
purchased-step/HTPA60S5M150-A-N16/HTPA60S5M150-A-N16.stp
22.0 x 99.0 x 98.9 mm
