hyeunung/FSAP/purchased-step/I-020B/I-020B.stp

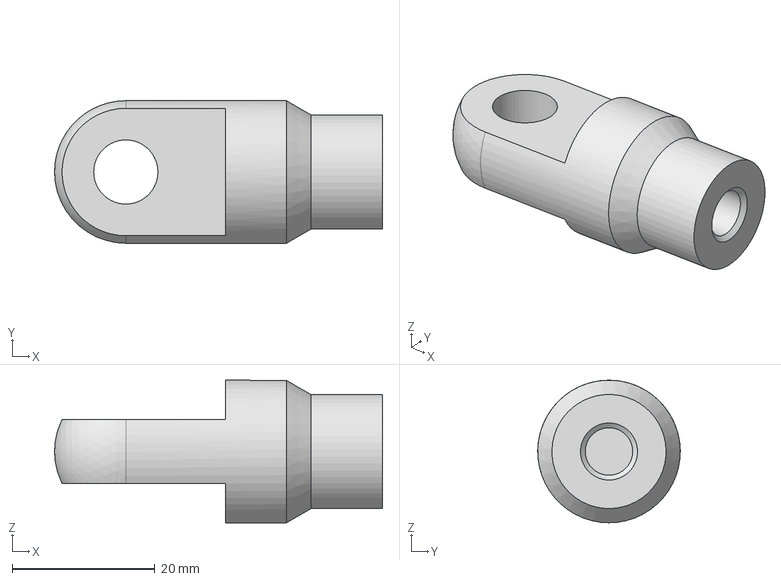
[picture p61: CAD file, 2026-11-03]
purchased-step/I-020B/I-020B.stp
46.0 x 20.0 x 20.0 mm
