hyeunung/FSAP/purchased-step/IR1000-01BG/IR1000-01BG.stp

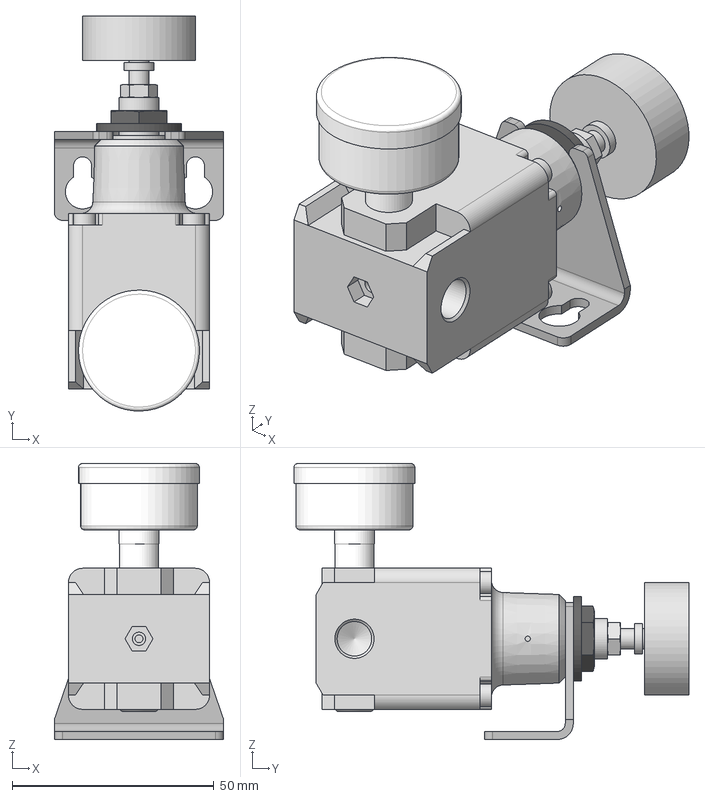
[picture p62: CAD file, 2026-11-08]
purchased-step/IR1000-01BG/IR1000-01BG.stp
42.0 x 98.0 x 68.5 mm
IR1000-01BG(0)_BODY
G33-2-01_IR1000-BG
IR1000(0)_SETNUT
P36201023_IR
