hyeunung/FSAP/purchased-step/KDM10-06/KDM10-06.stp

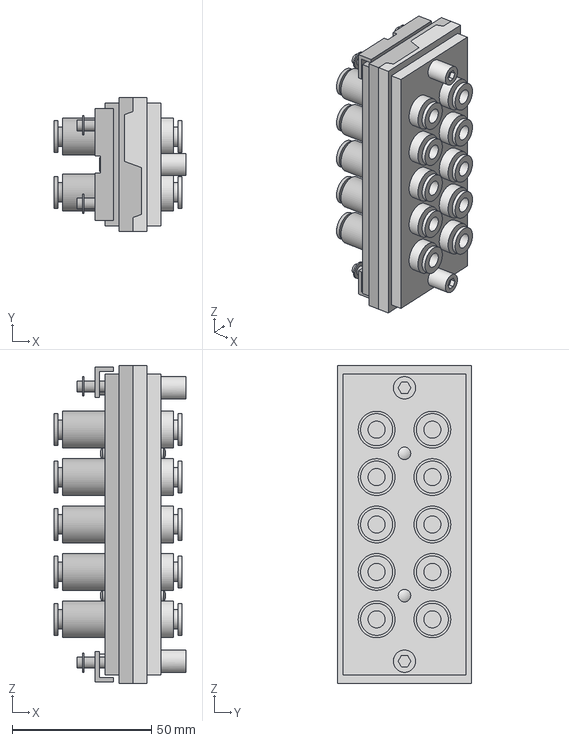
[picture p63: CAD file, 2026-11-05]
purchased-step/KDM10-06/KDM10-06.stp
47.3 x 48.0 x 114.0 mm
KDM10P-06
KDM10S-06
