hyeunung/FSAP/purchased-step/KQ2L06-01AS/KQ2L06-01AS.stp

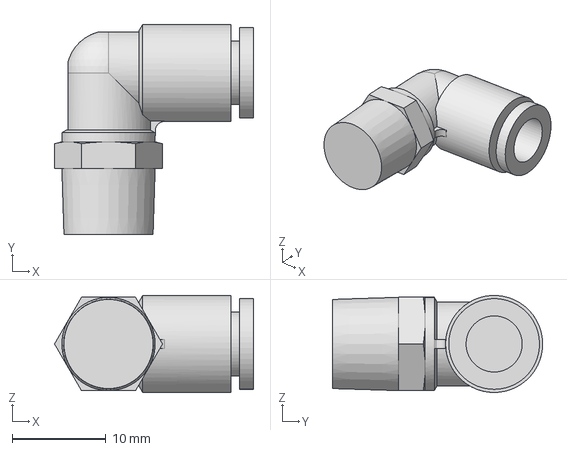
[picture p64: CAD file, 2026-11-03]
purchased-step/KQ2L06-01AS/KQ2L06-01AS.stp
21.3 x 22.5 x 10.4 mm
