hyeunung/FSAP/purchased-step/KQ2L06-M5A/KQ2L06-M5A.stp

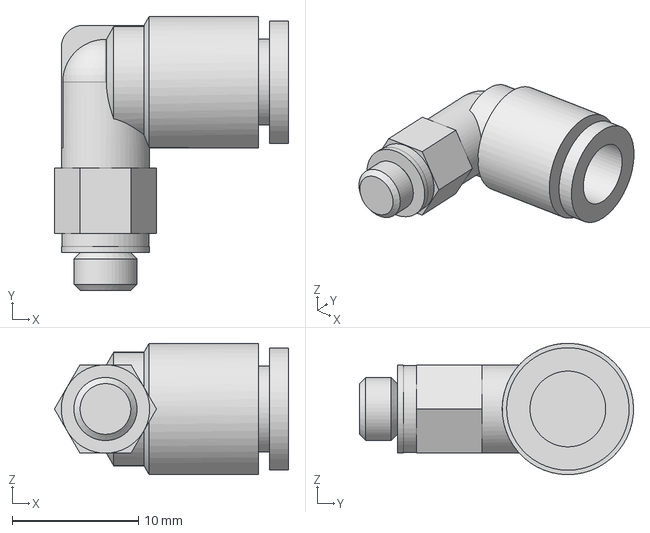
[picture p65: CAD file, 2026-11-03]
purchased-step/KQ2L06-M5A/KQ2L06-M5A.stp
18.5 x 21.7 x 10.4 mm
