hyeunung/FSAP/purchased-step/KQ2L08-01AS/KQ2L08-01AS.stp

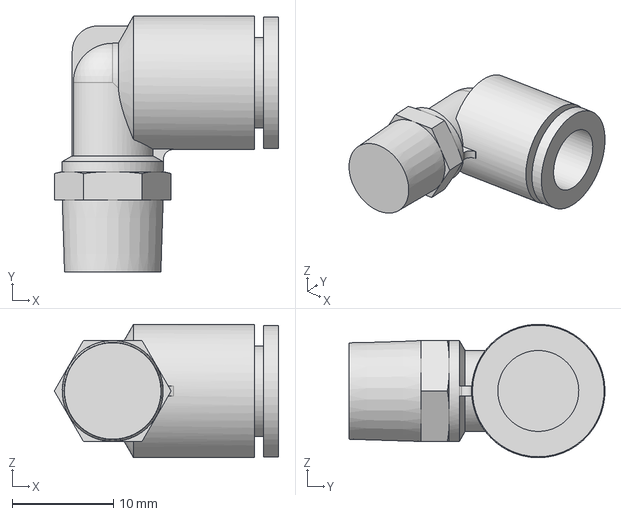
[picture p66: CAD file, 2026-11-05]
purchased-step/KQ2L08-01AS/KQ2L08-01AS.stp
22.2 x 25.3 x 13.2 mm
