hyeunung/FSAP/purchased-step/LHFR16/LHFR16.stp

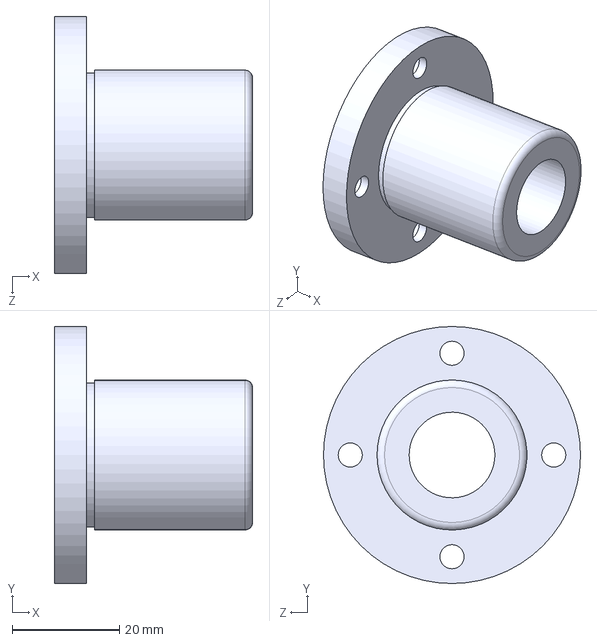
[picture p67: CAD file, 2026-10-30]
purchased-step/LHFR16/LHFR16.stp
37.0 x 48.0 x 48.0 mm
