hyeunung/FSAP/purchased-step/LR6-302WJBW-RYG/LR6-302WJBW-RYG.stp

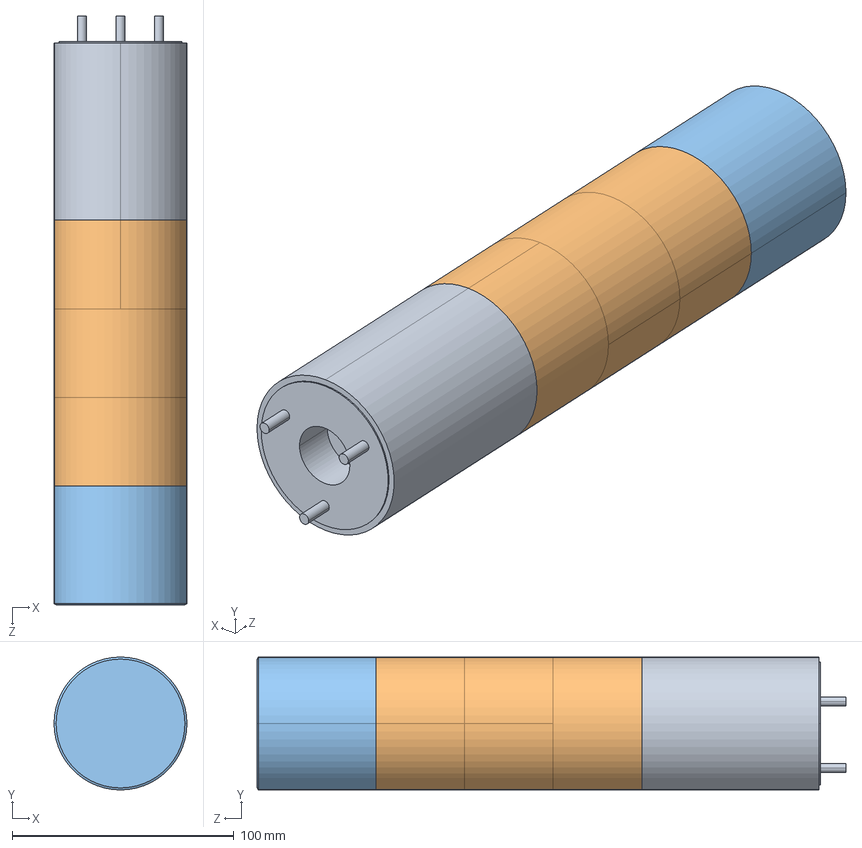
[picture p68: CAD file, 2026-11-05]
purchased-step/LR6-302WJBW-RYG/LR6-302WJBW-RYG.stp
60.0 x 60.0 x 265.5 mm
LED Unit1
LED Unit2
LED Unit3
Buzzer Unit
