hyeunung/FSAP/purchased-step/MBIS5-6.5-8/MBIS5-6.5-8.stp

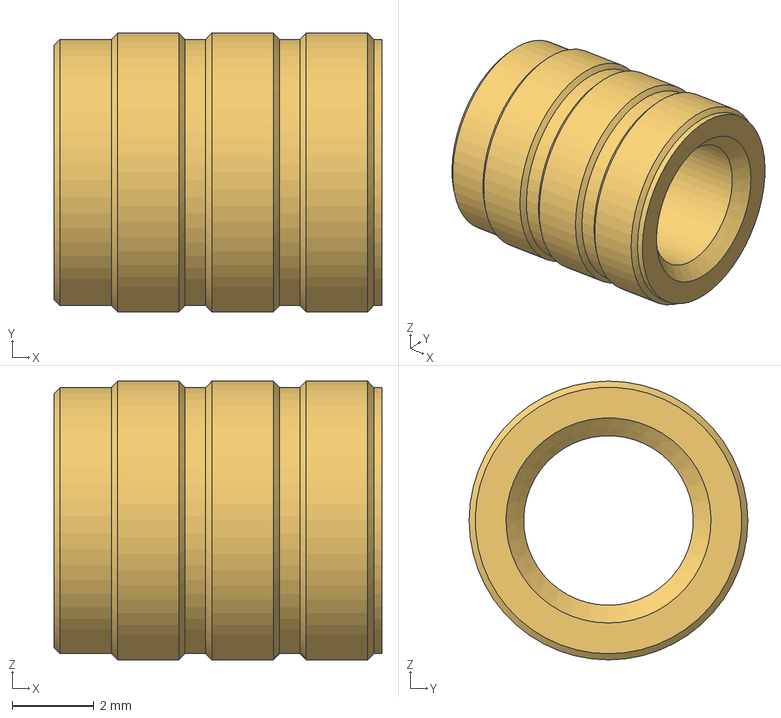
[picture p69: CAD file, 2026-10-30]
purchased-step/MBIS5-6.5-8/MBIS5-6.5-8.stp
8.00 x 6.80 x 6.80 mm
