hyeunung/FSAP/purchased-step/MGPM25-40Z/MGPM25-40Z.stp

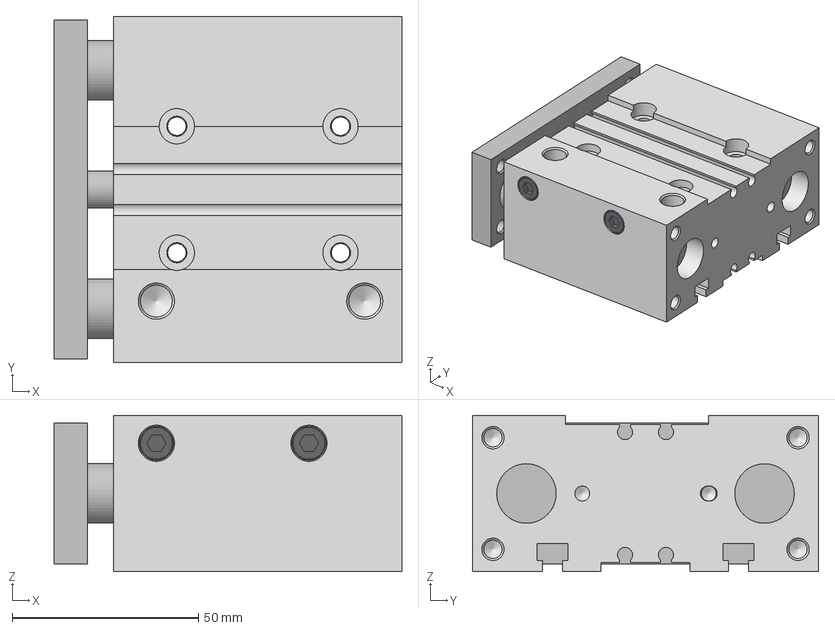
[picture p70: CAD file, 2026-11-05]
purchased-step/MGPM25-40Z/MGPM25-40Z.stp
93.5 x 93.0 x 42.0 mm
MGPM25-40Z(0)_BODY
MGPM25-40Z(0)_ROD
MGP-Z_PLUG_25 x 2
