hyeunung/FSAP/purchased-step/MPFZ12-10/MPFZ12-10.stp

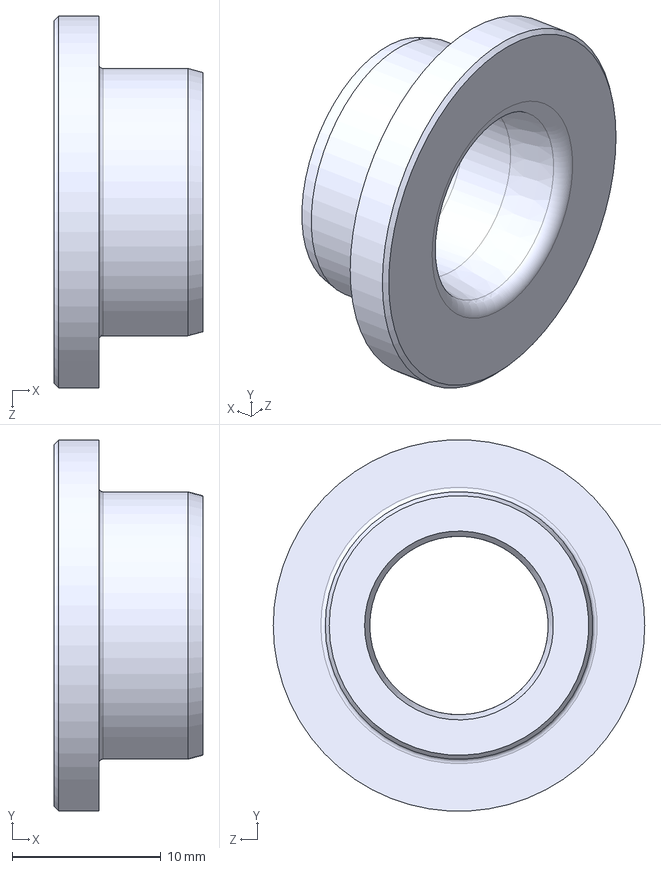
[picture p71: CAD file, 2026-11-03]
purchased-step/MPFZ12-10/MPFZ12-10.stp
10.0 x 25.0 x 25.0 mm
