hyeunung/FSAP/purchased-step/MSTH6-20/MSTH6-20.stp

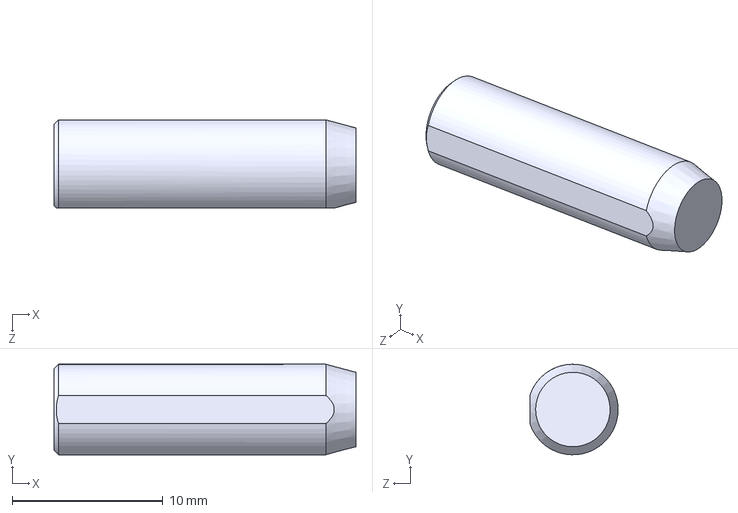
[picture p72: CAD file, 2026-11-05]
purchased-step/MSTH6-20/MSTH6-20.stp
20.0 x 6.00 x 5.85 mm
