hyeunung/FSAP/purchased-step/ORP25/ORP25.stp

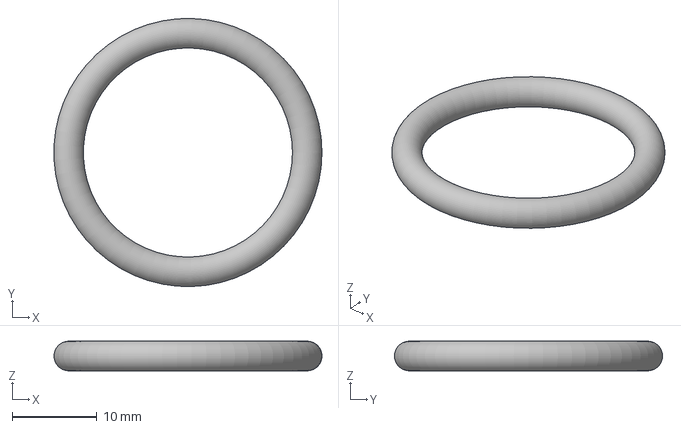
[picture p73: CAD file, 2026-11-03]
purchased-step/ORP25/ORP25.stp
31.7 x 31.7 x 3.50 mm
