hyeunung/FSAP/purchased-step/PGX62-H-10/PGX62-H-10.stp

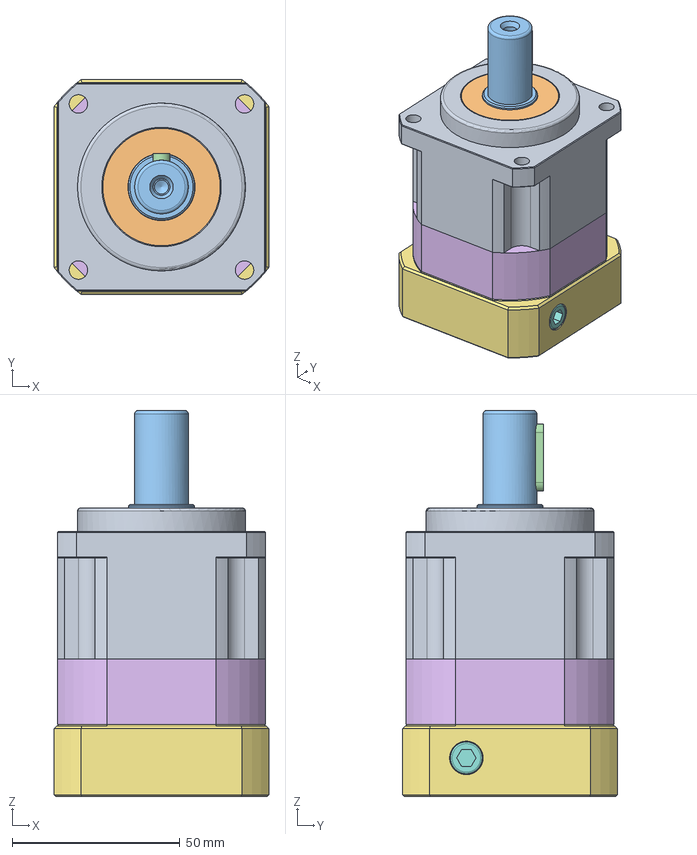
[picture p74: CAD file, 2026-11-08]
purchased-step/PGX62-H-10/PGX62-H-10.stp
64.0 x 64.0 x 115.0 mm
KSB-62-1
62-set collar
