hyeunung/FSAP/purchased-step/PSFJ16-100/PSFJ16-100.stp

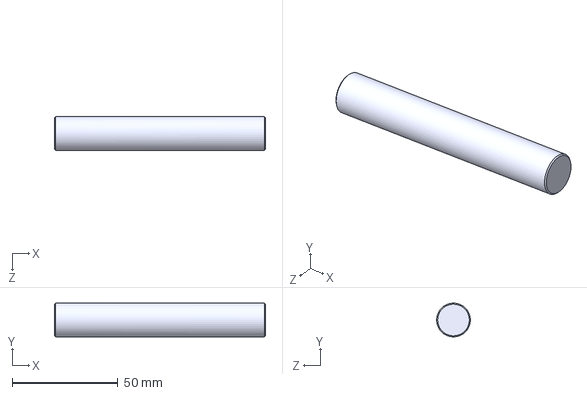
[picture p75: CAD file, 2026-10-30]
purchased-step/PSFJ16-100/PSFJ16-100.stp
100.0 x 16.0 x 16.0 mm
