hyeunung/FSAP/purchased-step/PSFJ16-150/PSFJ16-150.stp

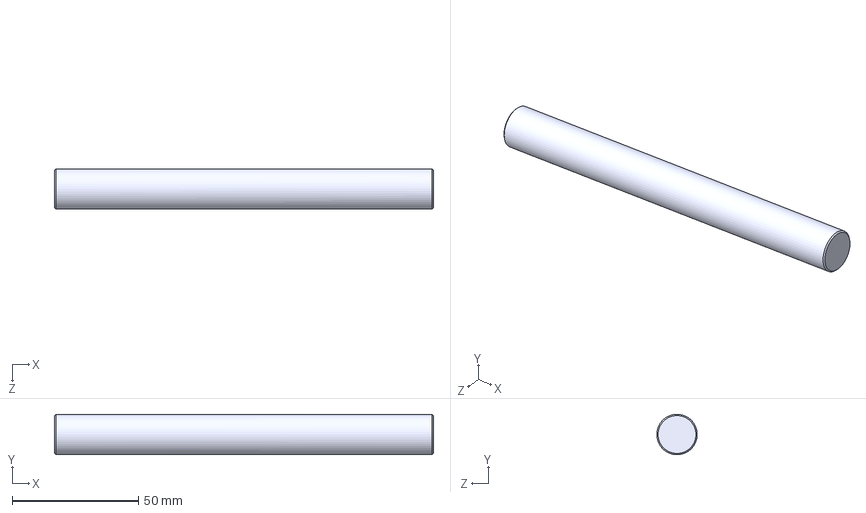
[picture p76: CAD file, 2026-10-30]
purchased-step/PSFJ16-150/PSFJ16-150.stp
150.0 x 16.0 x 16.0 mm
