hyeunung/FSAP/purchased-step/SCXW46-12-19/SCXW46-12-19.stp

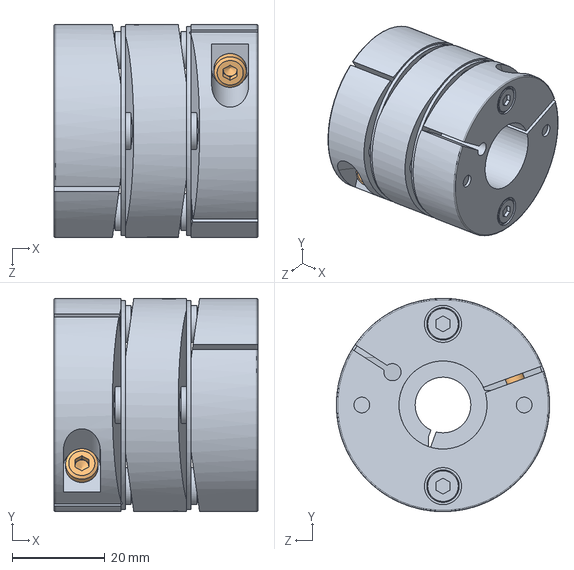
[picture p77: CAD file, 2026-11-01]
purchased-step/SCXW46-12-19/SCXW46-12-19.stp
44.0 x 46.0 x 46.0 mm
BODY_SCXW46-12-19
NEZI-1_SCXW46-12-19 x 2
