hyeunung/FSAP/purchased-step/SFB5-10/SFB5-10.stp

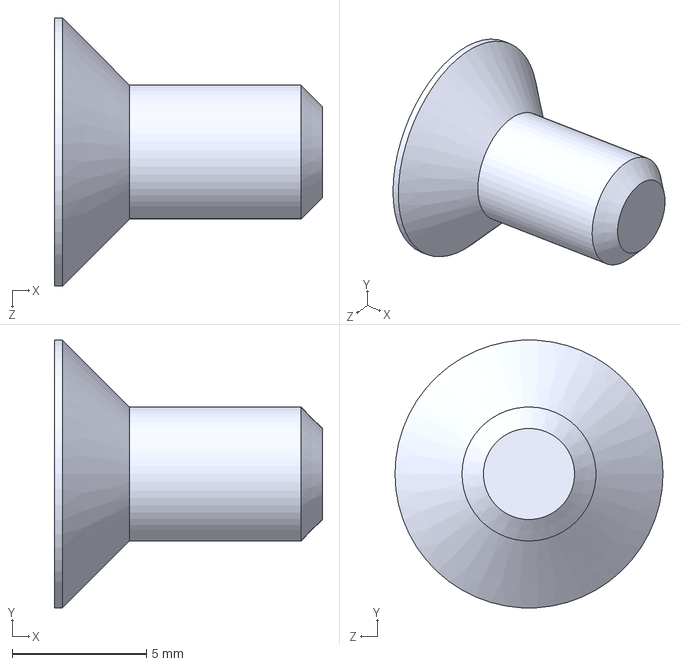
[picture p78: CAD file, 2026-11-05]
purchased-step/SFB5-10/SFB5-10.stp
10.0 x 9.98 x 10.0 mm
