hyeunung/FSAP/purchased-step/SFB5-12/SFB5-12.stp

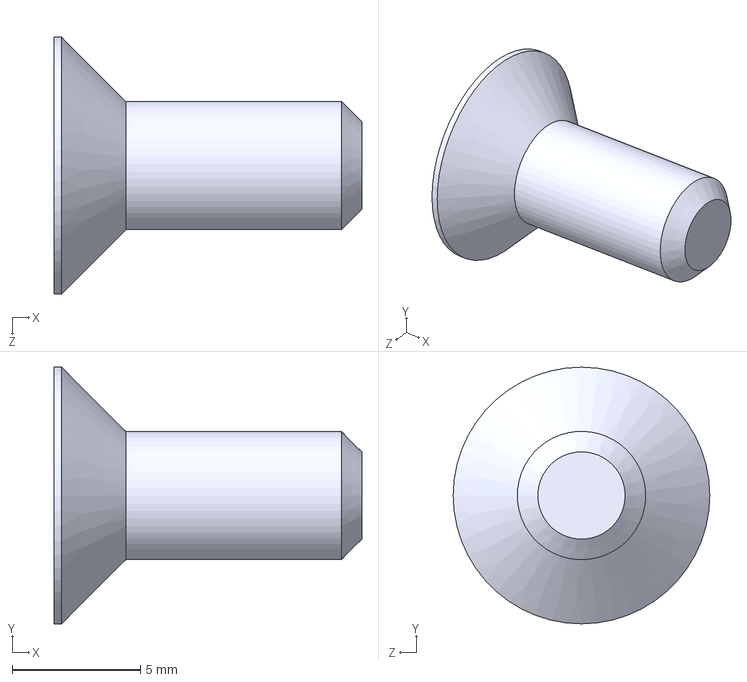
[picture p79: CAD file, 2026-11-05]
purchased-step/SFB5-12/SFB5-12.stp
12.0 x 10.0 x 10.0 mm
