hyeunung/FSAP/purchased-step/SS5Y3-20-06/SS5Y3-20-06.stp

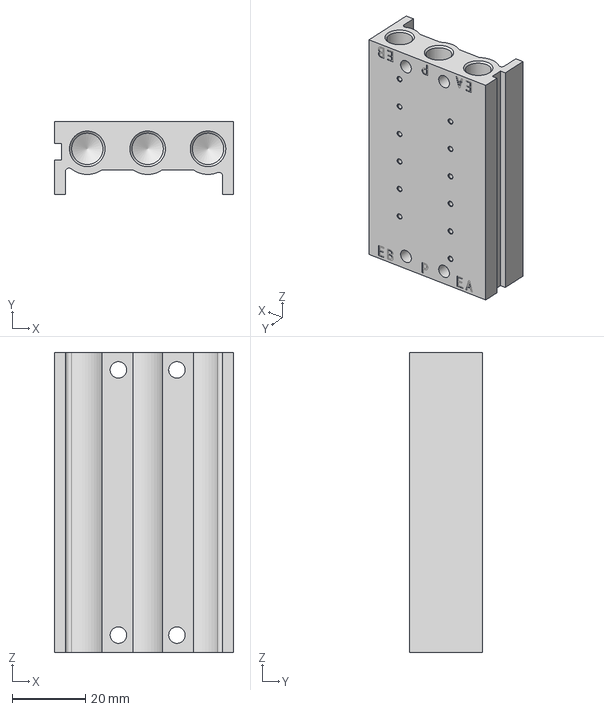
[picture p80: CAD file, 2026-11-05]
purchased-step/SS5Y3-20-06/SS5Y3-20-06.stp
49.0 x 20.0 x 82.0 mm
