hyeunung/FSAP/purchased-step/SSEB13-570/SSEB13-570.stp

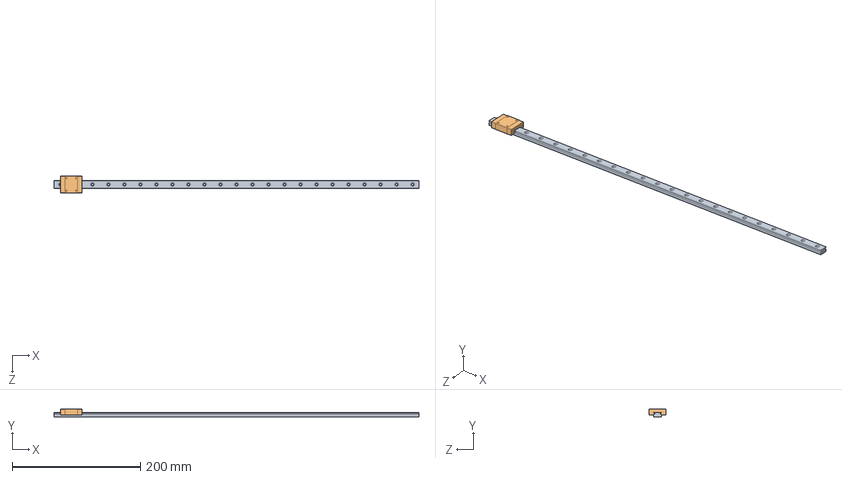
[picture p81: CAD file, 2026-11-03]
purchased-step/SSEB13-570/SSEB13-570.stp
570.0 x 13.0 x 27.0 mm
RAIL_SSEB13-570
BLOCK_SSEB13-570
