hyeunung/FSAP/purchased-step/SV2RL28-1300/SV2RL28-1300.stp

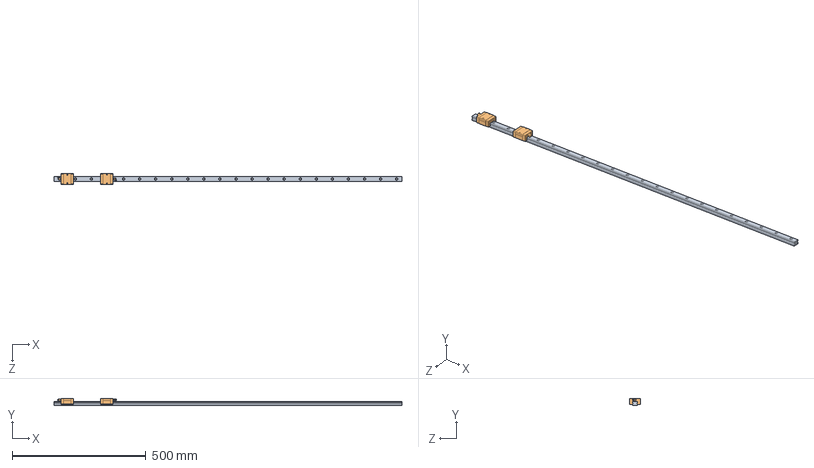
[picture p82: CAD file, 2026-10-30]
purchased-step/SV2RL28-1300/SV2RL28-1300.stp
1300.0 x 28.0 x 42.0 mm
RAIL_SV2RL28-1300
BLOCK_SV2RL28-1300 x 2
