hyeunung/FSAP/purchased-step/SV2RL28-1800/SV2RL28-1800.stp

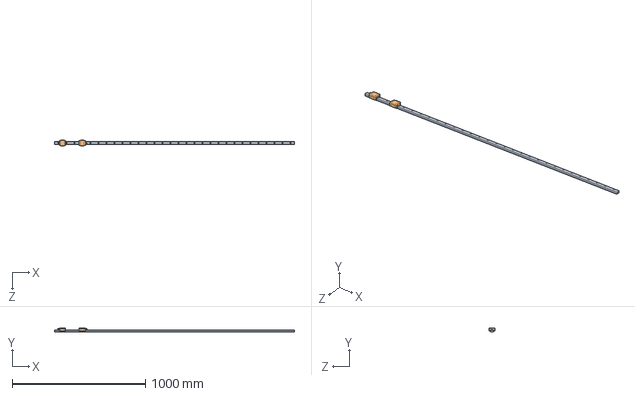
[picture p83: CAD file, 2026-10-30]
purchased-step/SV2RL28-1800/SV2RL28-1800.stp
1800.0 x 28.0 x 42.0 mm
RAIL_SV2RL28-1800
BLOCK_SV2RL28-1800 x 2
