hyeunung/FSAP/purchased-step/SY3120-5LZD-M5/SY3120-5LZD-M5.stp

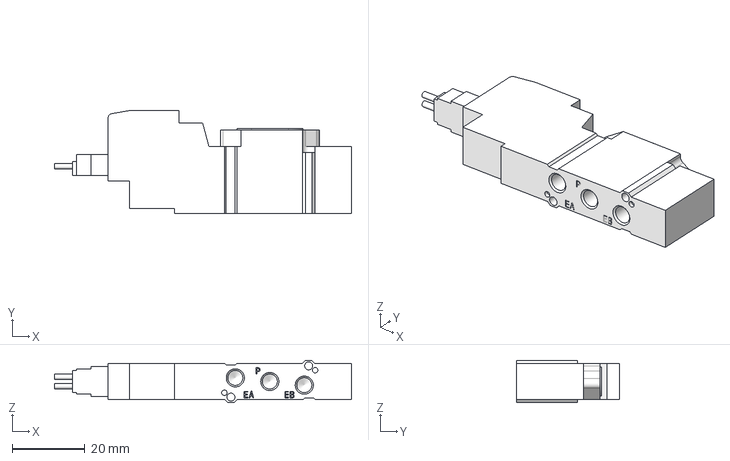
[picture p84: CAD file, 2026-11-05]
purchased-step/SY3120-5LZD-M5/SY3120-5LZD-M5.stp
81.8 x 28.5 x 11.6 mm
