hyeunung/FSAP/purchased-step/ZH10DSA-06-06-08/ZH10DSA-06-06-08.stp

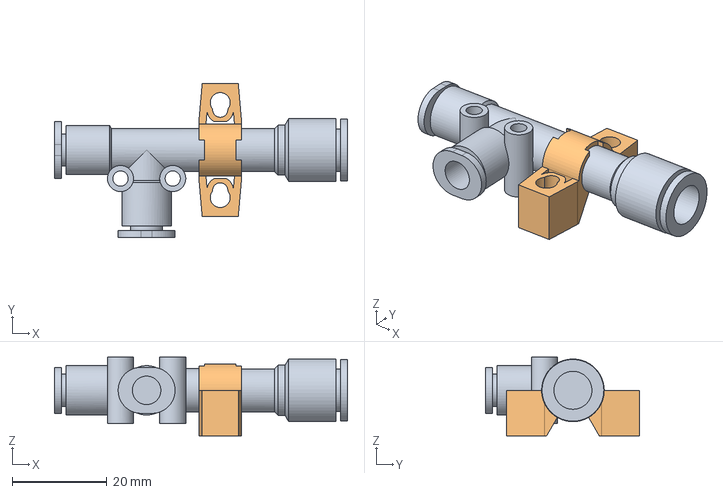
[picture p85: CAD file, 2026-10-30]
purchased-step/ZH10DSA-06-06-08/ZH10DSA-06-06-08.stp
61.7 x 32.4 x 16.6 mm
ZH10DSA-06-06-08(0)_BODY
ZH2-BK1A-1-A_ZH_NEW
