hyeunung/FSAP/tools/out/mech_RX-08/stepout/P_RX08_STOP_BRKT.step

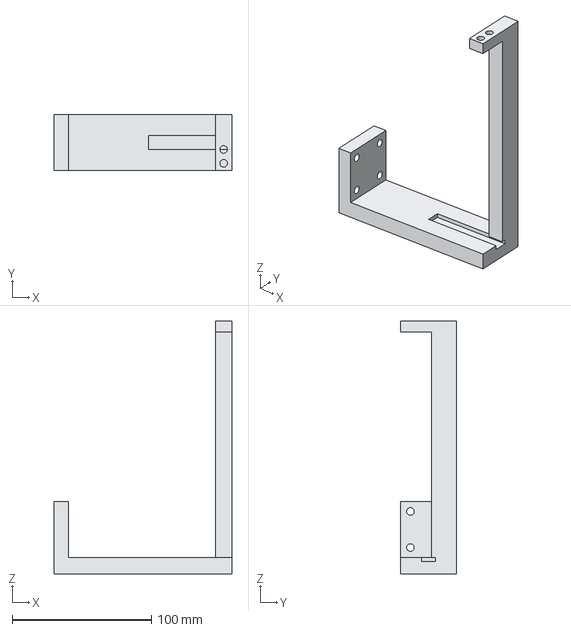
[picture p86: CAD file, 2026-11-12]
tools/out/mech_RX-08/stepout/P_RX08_STOP_BRKT.step
128.0 x 40.0 x 182.0 mm
