hyeunung/FSAP/tools/out/mech_RX-08/stepout/P_RX08_STOP_BLOCK.step

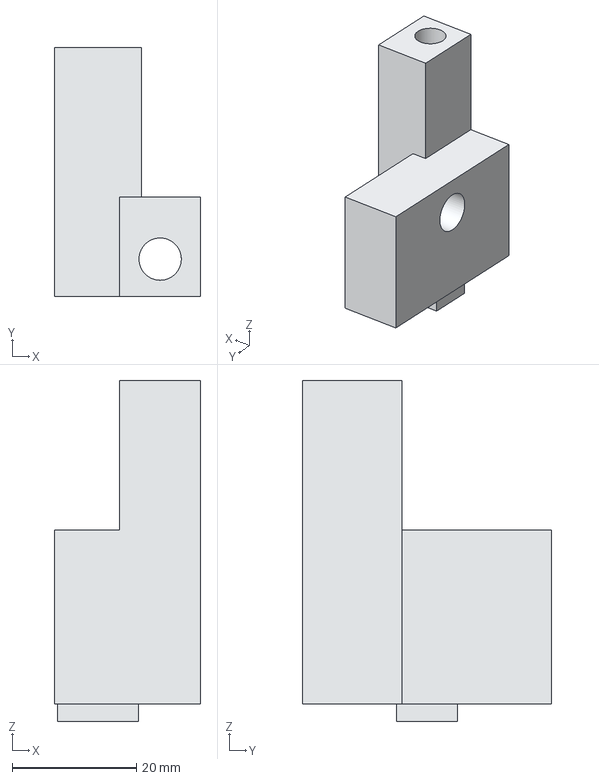
[picture p87: CAD file, 2026-11-12]
tools/out/mech_RX-08/stepout/P_RX08_STOP_BLOCK.step
23.5 x 40.0 x 54.8 mm
