hyeunung/FSAP/tools/out/mech_RX-08/stepout/P_M02_BASE.step

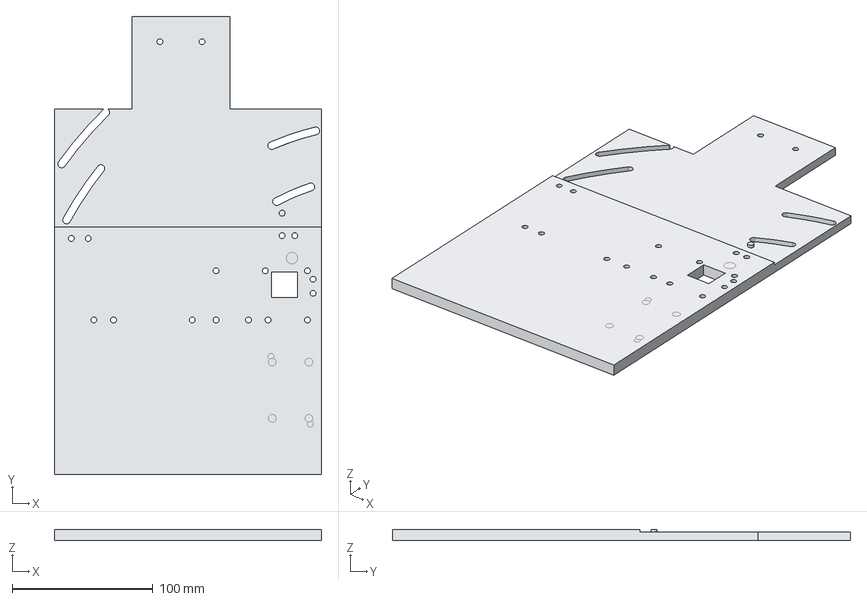
[picture p88: CAD file, 2026-11-12]
tools/out/mech_RX-08/stepout/P_M02_BASE.step
190.0 x 326.0 x 8.00 mm
