hyeunung/FSAP/(list of files, cad)

Other CAD files:
purchased-step/HTPA60S5M150-A-N30/HTPA60S5M150-A-N30.stp
purchased-step/SCXW46-15-19/SCXW46-15-19.stp
