hyeunung/FSAP/docs/reports/mechanism/mech_step_wait.md

# STEP 대기 재시도 (2026-11-12, v2.10.2 기준)

- 바꿀 것(swap): 없음 — stepcheck 11형번 모두 '없음', PartsLibrary/STEP에도 없음
- 로그인: 확인 못 함(브라우저 확인 안 함, 받기는 구매부·최종 보고로)
- 대기 형번 12개: 이전 결과 유지(tools/out/step_wait.json)
- lite: F3SG-4RA0800-14(이전 판정 유지)
- CAD는 열지 않음: 같은 시각 M02R 모델링부가 앱을 쓰고, STEP대기_ 목록은 v2.10.2와 같음
- 미완: 로그인 확인 뒤 받기
