hyeunung/FSAP/docs/reports/mechanism/mech_RX-06-C2_verify1.md

# RX-06-C2 검도·체결 수정 1회차 — 카세트 관 브래킷 볼트 CB5-16 → CB5-12 확인 (검도·체결부, 2026-11-13)

요약(10줄 안):
- 대상 `3D_Modeling/FSAP_v2.15.2.sc`(앱 MCP, 읽기만, 저장 0회). 끝난 뒤 `edit.restore_checkpoint 61` + REST step 0, `dirty` false, 저장본 sha1 `1aa0397a…` 전후 같음.
- **판정: 합격(동작 문제 0). 완료 판정 ① ② ③ ④ 모두 만족.**
- 지난 문제(볼트 `CB5-16_M05_1:2 · :3` 끝 4 mm가 `P_M05_HOLDER` +X 벽 살을 뚫음)는 없어졌다: 그 두 볼트는 없고, 새 `CB5-12_M05_7:2 · :3`은 bbox X **50.0**~67.0(끝 = 판 뒷면), HOLDER와 `overlaps` 0 · 거리 0.0(맞닿음), **unchecked 아님**(REST · J_U7_HGT 5점).
- 남은 unchecked는 새 볼트 ↔ `P_M05_CST_PLATE` 2쌍뿐이고, 판에 그 자리 탭 밑구멍이 실제로 있다(`body_topology`: r 2.1 관통 8 mm, Y −152.5 · Z 304 / 320) → M-08 정상 겹침(탭 물림).
- 물림 = 판 두께 8 mm = 1.6d ≥ 1.5d(M-01). 새 볼트는 J_U7_HGT · MAINT_U7(CST_X 12.5 · 25, CST_Y 75~250)에서 판과 같은 강체 이동(부피 476.413 그대로) → 묶임 확인.
- `CB5-16_M05_1:4 · :5`: 끝 자리 X 48~50에 닿는 바디 없음(판 · 브래킷 밖 가장 가까운 것 관 24.4 · 26.9 mm) → 그대로 둔 것이 맞다.
- ① 대상 8바디 REST 부피 · bbox가 지난 회차 값과 같다. ③ 피처 3,709 · error 0 · warning 54(그대로) · Box326 · Combine41~45 없음 · 바디 879.
- 디테일 2건(기록만): 볼트 끝이 판 뒷면과 같은 면이라 HOLDER 벽과 여유 0, 위 볼트 머리 앞 렌치 길에 유연 관 `TU0604_M08P_U7C_FEED_A`(모델링부 프로브 66.9 mm³).
- 원장 갱신함(`ledger.py commit --date 2026-11-13`: 부품 3,188 · 통과 84). 새 판정 기억 0건. 등급 S 맞음.
- 시간 약 6분(예상 15분 안). CAD 호출 3(묶음 2 + topology 1) + 확인 3, 파일 열기 0(앱에 이미 열려 있음).

## 0. 근거 규칙

| 규칙 | 원문 | 이번 |
|---|---|---|
| E-03 | "과제 안 = 과제 범위 간섭 0(바뀐 것과 그 주변을 관련 조인트의 몇 점에서, E-17)" | 새 볼트 2 × 이웃 13을 REST · HGT 5점 · MAINT_U7 6단계에서 |
| E-17 | "SolidCraft는 관련 조인트 … 를 양 끝·중간(0·25·50·75·100 %)에 놓고 틈·겹침을 재고" | J_U7_HGT −4 · −1.5 · 1 · 3.5 · 6 |
| E-16 | "판정은 수치로만 한다" | bbox · 부피 · overlaps · 구멍 축 |
| M-01 | "상대 부품의 탭 또는 너트가 실제로 있음, 물림 ≥ 1.5d" | 탭 밑구멍 r 2.1 있음, 물림 8 = 1.6d |
| M-08 | "정상 겹침: 볼트 나사부의 탭 물림(채움률 < 0.5)" | unchecked 2쌍 = Ø5 자루 ↔ Ø4.2 밑구멍 |
| 안내서 '간섭' | "`unchecked` … 0을 '겹침 없음'으로 읽지 않는다" | unchecked 쌍마다 따로 봄(2절) |
| 실행 규칙 2 | "혼자 도는 읽기 부서도 MCP로 잰다 … 저장은 하지 않는다" | 앱 MCP, `save` 0회 |

## 1. 범위(E-17)

- `ledger.py scope`: 바뀜 0 · 새로 2(`CB5-12_M05_7:2 · :3`) · 없어짐 2 · 이웃 11, 이동 유닛 U7_TAPE.
- against 13개: scope 이웃 11(`P_M05_CST_PLATE` · `P_M08_TUBE_BRKT_CST_V` · 관 U7C_CUT_A/B · TUCK_A/B · FEED_A · U7_4_A · 5_A · 6_A · `P_M05_HOLDER`) + 측정 표 bbox 5 mm 안의 `CB5-12_M05_10` + `STEP대기_KC-40340_M05_HOOK`.
- 관련 조인트: J_U7_HGT(걸이 + 카세트 통째), J_U7_CST_X · CST_Y(연구 MAINT_U7 — 카세트가 고정부에서 빠짐). J_U5_X · J_U4_X 쪽 바디는 이번 회차에 바뀐 것이 없어 다시 돌리지 않았다(지난 회차 합격, E-21).
- 작업 대상 모형: 볼트는 매트 · 테이프 길에 닿지 않는다(Z 300 위, 판 +X 면) → 넣지 않음. 전체 사이클은 라운드 끝 회귀.
- 판금 · 포트 · LITE: 새 것 0 → 대상 없음.

## 2. 측정(원본 `tools/out/mech_RX-06-C2/verify1/v1_out.json`)

| 자세 | 새 볼트 :2 bbox | overlaps | HOLDER 거리 | unchecked | 가장 가까운 다른 바디 |
|---|---|---|---|---|---|
| REST | X 50.0~67.0 · Y −156.75~−148.25 · Z 299.75~308.25(:3은 Z 315.75~324.25), 476.413 mm³ | 0 | 0.0(맞닿음) | 판 2쌍 | BRKT_CST_V 0.0(머리 받침면) |
| J_U7_HGT −4 · −1.5 · 1 · 3.5 | (함께 이동) | 0 | 0.0 | 판 2쌍 | 같음 |
| J_U7_HGT 6 | Z 305.75~314.25, HOLDER Z 291~340(둘 다 +6) | 0 | 0.0 | 판 2쌍 | 같음 |
| MAINT_U7 2(CST_X 12.5) | X 62.5~79.5, 판 X 62.5~70.5 | 0 | > 1 | 판 2쌍 | CB5-12_M05_10 6.74 / 4.47 |
| MAINT_U7 3(CST_X 25) | X 75~92 | 0 | > 1 | 판 2쌍 | 같음 |
| MAINT_U7 6 · 8 · 11 · 13(CST_Y 75 · 125 · 200 · 250) | Y −231.75 … −406.75, 판 Y −275 … −450(같은 이동) | 0 | > 1 | 판 2쌍 | 같음 |

- 관 6 + U8 관 3 + HOOK: 어느 자세에서도 1 mm 안에 없음(`near` 목록에 없음).
- unchecked 판 2쌍: `P_M05_CST_PLATE` 원통 목록에 r 2.1 · 축 X · 길이 8(관통) 구멍이 (Y −152.5, Z 304) · (Y −152.5, Z 320)에 있다. Ø5 자루 ↔ Ø4.2 밑구멍 = 탭 물림(M-08). boolean 실패 이유는 지난 회차와 같은 꼴(끝 면 X 50 = 판 뒷면 같은 평면).
- `CB5-16_M05_1:4 · :5`(REST): overlaps 0, 맞닿음 = 판(탭 r 2.1 Y −191.5 Z 162 · 198 있음) · `P_M08_TUBE_BRKT_CST_O`뿐, 그다음 TUCK_A 24.4 mm · CUT_A 26.9 mm, HOLDER는 1 mm 밖.
- 완료 판정 ①: REST 8바디 — CAR_PLATE 681,869.510 · CHAIN_ARM 75,195.043 · CST_PLATE 245,781.931 · TUBE_BRKT_CST_O 58,244.264 · KDM_BRKT 124,801.279 · HOLDER 32,632.629 · M06_BASE 40,595.441 · M02_BASE 380,844.131 mm³, bbox 지시문 값과 같음. ②: CST_PLATE가 MAINT_U7에서 부피 그대로 · bbox 강체 이동(X +12.5 · +25, Y −75 … −250), HOLDER HGT 6에서 Z +6. J_U5_X · J_U4_X는 지난 회차 값(바뀐 것 없음).
- ③: `inspect_design` 피처 3,709 · error 0 · warning 54 · 바디 879 · Box326 · Combine41~45 없음.

## 3. 볼트(M-01, 새 2개)

| 항목 | 값 | 판정 |
|---|---|---|
| 상대 탭 | 판 r 2.1 관통 구멍 2(위 좌표) | 있음 |
| 물림 | 판 8 mm = 1.6d | ≥ 1.5d |
| 끝 | X 50.0 = 판 뒷면, HOLDER 벽(X 46~50) 맞닿음 0.0, 겹침 0 | 디테일 D1(여유 0) |
| 삽입 · 렌치 | 머리 X 62~67, +X로 열림. 머리 자리는 v2.15.1과 같음. 유연 관 FEED_A가 프로브에 66.9 mm³(모델링부 값) | 디테일 D2 |
| 묶임(E-11) | HGT · CST_X · CST_Y에서 판과 같은 이동, `joint.drive` conflicts 0 · errors 0 · unmoved 0 | 묶임 |

## 4. 디테일(기록만, E-02)

- D1: `CB5-12_M05_7:2 · :3` 끝이 판 뒷면과 같은 면(X 50.0)이고 그 뒤가 HOLDER 벽이다. 볼트 길이 공차(+쪽)면 닿는다. 디테일링에서 HOLDER 벽에 Ø6 × 1 릴리프 2곳 또는 와셔 1장.
- D2: 위 볼트(Z 320) 머리 앞 렌치 길에 관 `TU0604_M08P_U7C_FEED_A`. 유연 관이라 젖혀서 조인다. 디테일링에서 관 경로 Y로 3 mm 비키기.

## 5. 원복 · 원장

- 편집 전 `edit.checkpoint` 61 → 끝에 `edit.restore_checkpoint {checkpoint: 61}`(restored true) → `motion.play REST 0`. `dirty` false, 경로 v2.15.2, sha1 같음.
- `ledger.py sigcheck` reuse(문서 · 해시 같음), `ledger.py commit --date 2026-11-13`: 부품 3,188 · 통과 84. 허용 겹침 새로 넣은 것 없음.

## 워크플로우 메모

- `edit.restore_checkpoint`는 `checkpoint` id가 필수다(빈 params는 거부). 안내서 '원복' 글에는 id가 안 적혀 있다.
- `inspect_design {measure:false, sketches:false, joints:false}`도 이 모델에서 1.3 MB라 MCP 도구 응답 한도를 넘는다. `dirty` · 피처 수만 주는 가벼운 조회가 있으면 좋다.
