hyeunung/FSAP/docs/reports/mechanism/mech_M02R_verify.md

# M02R 검도·체결 — v2.14.0 U4 그네 잔재 정리(스프링 탭 볼트·빈 컴포넌트·팔에 떨어진 조각) (검도·체결부, 2026-11-13)

요약(10줄 안):
- 대상 `3D_Modeling/FSAP_v2.14.0.sc`. 통로 MCP(앱) + 볼트 프로브만 저장본 CLI 1회. 저장 안 함, 끝에 REST(J_U4_PRESS 13.006·J_U4_X 0·J_U4_STOP 0), 앱 `dirty false`.
- **판정: 합격(동작 문제 0).** 완료 판정 ①~⑤ 모두 만족. 원장 갱신함(아래 '원장' 주의 1건).
- ① 윗고리 ↔ 탭 볼트 머리 틈 **1.75**(BASE_5·_7)·**2.75**(BASE_6·_8) mm, 겹침 0. J_U4_PRESS 13.006·8.727·4.448·3.751·0·−4.11 + (0.95, STOP 20) 7자세, J_U4_X 0·47.5·95 모두 과제 범위 겹침 0(truncated false).
- ② 옛 크랭크 U4 빈 컴포넌트 21개(+`CB5-12_M02_2`) 저장본에서 없음 확인, 앱 `joint.list` floating 0·errors 0·conflicts 0(조인트 587).
- ③ `P_M02_ARM_SIDE_N·_P·ARM_TIE` kernel shells **1·1·1**, 타임라인 오류 0·경고 55, 'doesn't touch'는 `P_M05_FEED_CARR` 1건만(이 과제 밖).
- ④ 볼트 물림 8 mm(1.6d), base M5 탭·탭 구멍이 볼트 자리에 있음(피처 좌표 확인), 삽입·렌치 프로브 Ø8.5 × 30 겹침 0(3자세). 날개 살 X 1.75·Y 7.25 mm.
- ⑤ 그네 손계산 다시 셈: 팔 무게 모멘트 +2.25 N·mm → 접지 힘 +0.019 N. 회전 SF 1.013·1.047·1.079, 누름 1.96, 들기 1.79 그대로.
- 디테일 5건(수정 회차 안 씀): 날개 살 1.75 < 2.5(M-03), 볼트 7·8 끝이 캐리지 밑면에 맞닿음 0, 그네 볼트 물림 1.2d, 허공에 남은 옛 클레비스 볼트 `CB4-12_M02_CLV`, 빈 복사 원본 `CB5-12_M02_1`.
- 앱 막힘 1회: 내 `J_U4_X` 연속 구동 batch가 30분을 넘겨 앱만 다시 켬(버린 편집 없음).

## 0. 근거 규칙

| 규칙 | 원문 | 이번 |
|---|---|---|
| E-03 | "과제 안 = 과제 범위 간섭 0(바뀐 것과 그 주변을 관련 조인트의 몇 점에서, E-17), 라운드 끝 = 전체 사이클 간섭 0" | 바뀐 9바디 ↔ 주변, 관련 조인트 3개의 점에서 겹침 0. 전체 사이클은 돌지 않음 |
| E-17 | 과제 안 검사는 바뀐 바디·주변을 관련 조인트 몇 점에서만 | `ledger.py scope`: 바뀜 9(탭 2·볼트 4·팔 3), 새로 10·없어짐 1은 RX-07 것(U8_PNEU) — 이 과제 대상 아님 |
| M-08 | 의도된 겹침(볼트 나사부)은 기준선으로 뺀다 | 나사 물림 7쌍 + 맞닿음 잔차 1쌍을 판정 기억에 남김(3절) |
| M-01 | "머리 쪽 축 방향으로 볼트 길이 + 5 mm 동안 다른 부품과 겹침 0", "상대 부품의 탭 또는 너트가 실제로 있음, 물림 ≥ 1.5d" | 옮긴 볼트 4개: 프로브 30 mm 겹침 0, 탭 있음, 물림 1.6d |
| M-03 | "구멍에서 바깥면까지 살은 2.5 mm 이상을 기본으로 둔다" | 날개 X 쪽 살 1.75 mm → 디테일 + 예외 요청 |
| E-11 | 리지드 그룹 누락·안 묶인 부품 | floating 0. 옮긴 볼트 4개는 U4_WHEEL_N에 리지드(조인트 98231~98234) |
| E-02 | 강도 여유·새 볼트 렌치 접근 등은 디테일로 기록만 | 디테일 5건, 수정 회차 없음 |

작업 대상(매트·테이프) 모형은 넣지 않았다: 바뀐 부품은 Z 228 이상의 탭·볼트와 팔 안쪽 구멍 메움이라 작업 대상 길(Z 0~18)에 닿지 않는다.

## 1. 과제 범위 동작 검사(앱 MCP)

대상 9바디: `P_M02S_SPRING_TAB_1·_2`, `CB5-12_M02S_BASE_5~8`, `P_M02_ARM_SIDE_N·_P`, `P_M02_ARM_TIE`. 주변은 서명 표 bbox로 다시 골랐다(탭·볼트 10 mm 안 11바디 + 팔이 −4.11~13.006°로 돌 때의 자리·J_U4_X −95까지 5 mm 안) → REST는 59바디, 다른 자세는 팔과 함께 도는 것(감속기·서보·FRONT 등 27바디)을 뺀 32바디(`tools/out/mech_M02R/verify6/sets.json`).

| 조인트 점 | 겹침 | 가장 가까운 쌍(맞닿음 0 빼고) | 확인 쌍 | truncated |
|---|---|---|---|---|
| PRESS 13.006(REST, 100 %) | 0 | 옆판 ↔ CB5-20_M02S_1·CB5-16_M02_5·_7 0.25(통과 구멍), 탭 ↔ 윗조각 1.0, **윗고리 ↔ BASE_5·_7 1.75, ↔ BASE_6·_8 2.75** | 72 | false |
| PRESS 8.727(75 %) | 0 | (틈 목록 생략, 겹침만) | 37 | false |
| PRESS 4.448(50 %) | 0 | 〃 | 37 | false |
| PRESS 3.751(두께 16) | 0 | 〃 | 37 | false |
| PRESS 0(θ0, 24 %) | 0 | REST와 같은 쌍·같은 값 | 43 | false |
| PRESS −4.11(0 %) | 0 | 〃 | 33 | false |
| PRESS 0.95 + STOP 20 | 0 | 〃 | 37 | false |
| J_U4_X 47.5(REST) | 0 | U8 쪽 관 6줄과 12 mm 안 없음 | 8 | false |
| J_U4_X 95(REST) | 0 | 관 `TU0604_M08P_U6` ↔ 볼트 16.6·탭 18.5, `TU0604_M08P_U4_B` ↔ 탭 58.7 | 7 | false |
| J_U4_X 0(REST) | 0 | 관 U4_B ↔ 탭 2 9.37·볼트 8 14.98, 관 U6 ↔ 볼트 16.6 | 20 | false |

- REST의 겹침 목록에 `P_M02_ARM_SIDE_N ↔ P_M02_FRONT` 0.174 mm³가 한 건 나온다. 맞닿는 면 1,513 mm²에 걸친 수치 잔차(평균 두께 1e-4 mm)이고 이번에 안 바꾼 자리(X −132~−120)라 맞닿음으로 판정했다.
- 바뀐 것끼리(볼트 ↔ 탭, 옆판 ↔ TIE)도 따로 쟀다: 겹침 0. 볼트 머리 윗면 = 탭 밑면 Z 238 맞닿음 0, 옆판 ↔ TIE 맞닿음 0.
- `unchecked` 8쌍은 자세마다 같다. 모두 나사부가 탭에 든 물림이다(불리언 실패). base ↔ BASE_5~8, 옆판 P ↔ CB5-16_M02S_1·_2, TIE ↔ CB5-16_M02_9·CB5-20_M02S_1. 탭이 볼트 축에 있는지는 2절에서 따로 확인했다.
- J_U4_X는 25·75 %(23.75·71.25)를 재지 못했다. 앱에서 `joint.drive J_U4_X` 한 번이 약 6~8분 걸린다(볼나사 링크). 대신 0·47.5·95에서 고정 쪽 관까지 거리를 넓게(12~80 mm) 쟀다: 관 U6은 X와 나란히(Y 34·Z 260) 지나 어느 X에서도 16.6 mm, 관 U4_B는 탭 2의 +X·+Y 쪽(X −163, Y 67.6)에 있어 U4가 −X로 갈수록 멀어진다(9.4 → 58.7 mm). U4 묶음 안의 것은 X로 함께 움직여 상대 위치가 안 바뀐다. 못 잰 두 점은 라운드 끝 전체 회귀가 본다.
- 숨긴 바디 97(매트·테이프·이음매 모형, 모델링부 목록과 같음), 숨긴 occurrence 0 — 대상·주변 바디에는 숨긴 것이 없다.

## 2. 완료 판정 항목별

| 항목 | 판정 | 근거(잰 값) |
|---|---|---|
| ① 윗고리 ↔ CB5-12_M02S_BASE_5~8 겹침 0·틈 > 0, 5자세 간섭 0 | 만족 | 틈 1.75·2.75 mm. 1절 7자세 + X 3점 겹침 0 |
| ② 빈 컴포넌트 0, floating 0·errors 0 | 만족 | 저장본 `document.json`에 `U4_CYL`·`U4_CYL_CLEVIS`·`U4_ROD`·`U4_ROD_NUT`·`I-020B_M02`·`CB5-12_M02_2`·`CB4-12_M02R_*`·`KQ2L06-01AS_M08_U4_*`·`TU0604_M08P_U4C_*` 이름 0개. 컴포넌트 681(+루트), 조인트 587. 앱 `joint.list`: floating []·errors []·conflicts [] |
| ③ 팔 3바디 셸 1, 'doesn't touch' 5건 없어짐 | 만족 | `measure` kernel.shells: SIDE_N 1·SIDE_P 1·TIE 1. 부피 77,660.19·77,494.02·24,467.55. 타임라인 3,717피처 오류 0·경고 55, 'doesn't touch'는 Box132(`P_M05_FEED_CARR`) 1건 |
| ④ 탭 볼트 4개 물림·날개 가장자리 손계산 | 만족 | 물림 12 − 4 = 8 mm = 1.6d ≥ 1.5d. 날개 33 × 20, 볼트 s±12 → 살 X 16.5 − 12 − 2.75 = **1.75**, Y 10 − 2.75 = 7.25. 머리 Ø8.5는 날개 안 0.25. 탭 굽힘 M = 30.38 × 24 / 4 = 182.3 N·mm, Z = 20 × 4² / 6 = 53.3 mm³ → 3.42 MPa(SF 60). 볼트 인장 15.2 N / 14.2 mm² = 1.07 MPa |
| ⑤ 그네 손계산 값 변화 없음 | 만족 | 팔 질량 616.12·616.05·66.51 → 615.85·614.53·65.57 g(잰 값과 같음). 축(Y 120) 둘레 모멘트 +229.7 g·mm = +2.25 N·mm, 레버 120 → 접지 +0.019 N(0.07 %). 스프링 닿는 자리는 그대로. 회전 SF 1.013·1.047·1.079, 누름 1.96, 들기 1.79 표기 그대로 |

②의 '빈 컴포넌트 0'은 과제 내용 ②가 가리킨 옛 크랭크 U4 21개로 읽었다. 바디 0인 잎 컴포넌트는 20개가 남아 있다(모델링부 표와 같음: 조인트 받침 10·STEP 하위 노드 8·U6S phantom 1·`CB5-12_M02_1` 1). 앞의 19개는 지우면 동작·구매품이 깨지는 것이고, `CB5-12_M02_1`만 M02R 잔재라 디테일로 적었다(4절 D5).

탭·구멍 자리(저장본 피처 정의): base M5 탭 `Cylinder1322~1325` r 2.1, 밑 (−307·−283·−197·−173, 50, 241.9) 높이 8.2. 탭 판 구멍 `Cylinder1351·1352·1360·1361` r 2.75, 같은 X·Y. 옛 자리(−302·−288·−192·−178)의 피처는 없다(메운 자국 없음, U-10).

옆판 P의 그네 볼트 탭(`body_topology` cylinders, J_U4_X 47.5에서 읽음): r 2.1 두 개, 원점 (−347.5, 24.28, 121.06)·(−213.5, 28.78, 140.54), 축 (0, −0.974, 0.225), 길이 6. `CB5-16_M02S_1·_2` bbox 중심선과 같은 선이다(X −347.5·−213.5) → 물림으로 판정.

## 3. 볼트(옮긴 4개만)·판정 기억

| 볼트 | 자리 | 삽입·렌치(M-01) | 상대 | 묶임(E-11) |
|---|---|---|---|---|
| CB5-12_M02S_BASE_5 | (−307, 50), 머리 Z 233~238 아래 | 프로브 Ø8.5 × 30(Z 203~233) 겹침 0, 가장 가까운 것 윗고리 1.75 | base M5 탭, 물림 8 | U4_WHEEL_N 리지드 98231 |
| CB5-12_M02S_BASE_6 | (−283, 50) | 〃 | 〃 | 98232 |
| CB5-12_M02S_BASE_7 | (−197, 50) | 〃 | 〃 | 98233 |
| CB5-12_M02S_BASE_8 | (−173, 50) | 〃 | 〃 | 98234 |

- 프로브는 저장본에 대고 CLI 한 번(`tools/out/mech_M02R/verify6/cli_probe.json` → `cli_probe_out.json`, 저장 안 함): 열기 888 s, 명령 9단계 2.5 s. 프로브 4개 ↔ 28바디(그네·스프링 위아래 조각·탭·base·스토퍼 브래킷·블록·관 4·피벗 브래킷·실린더 브래킷·캐리지·팔·그네 볼트)를 J_U4_PRESS 13.006·−4.11·0에서 — 겹침 0, truncated false. 접근 길이 30 ≥ 볼트 길이 + 5 = 17.
- 공압 포트·판금·간이 형상(LITE): 이번에 새로 넣은 것 없음 → 해당 없음. 탭 2개는 t4 판 + 다리(상자 join)라 판금 굽힘이 아니다.
- 판정 기억(`tools/out/judged.json`, 208 → 216건): base ↔ BASE_5~8 4건, 옆판 P ↔ CB5-16_M02S_1·_2 2건, TIE ↔ CB5-20_M02S_1 1건(나사 물림), SIDE_N ↔ FRONT 1건(맞닿음 잔차). 키의 서명은 '이름|부피'.

## 4. 디테일(E-02, pass를 막지 않음)

| 번호 | 무엇 | 어디·수치 | 고칠 안 |
|---|---|---|---|
| D1 | 탭 날개 볼트 구멍 살이 M-03 기본보다 작음 | `P_M02S_SPRING_TAB_1·_2` 날개 X s±16.5, 구멍 Ø5.5 @ s±12 → 살 1.75 mm < 2.5. 볼트는 인장만 받아 살을 찢는 하중은 없음 | 날개 s±18.5(길이 37)로 → 살 3.75. 탭 2의 +X 끝이 −166.5가 돼 관 U4_B 틈 9.4 → 약 7.4 mm, base 끝(−330)까지 16.5 남음 |
| D2 | 볼트 끝이 캐리지 밑면에 맞닿음 | `CB5-12_M02S_BASE_7·_8` 끝 Z 250.00 = `P_RX06_CARRIAGE` 밑면 Z 250, 거리 0(겹침 0). 볼트 길이 공차 +면 base 탭을 다 지나 캐리지에 먼저 닿아 탭이 안 조여질 수 있음. 옛 자리(−192·−178)도 같았음 | 캐리지 밑면 두 자리에 Ø6 깊이 2 도피 |
| D3 | 그네 볼트 물림 부족 | `CB5-16_M02S_1·_2` ↔ 옆판 P t6의 M5 탭: 6 mm = 1.2d < 1.5d(M-01). 볼트는 이번에 옮기지 않았고 탭만 바로잡힘 | 옆판 안쪽에 M5 너트(HNTT 아님, 육각 너트) 또는 탭 자리 두께 7.5 이상 |
| D4 | 허공에 남은 옛 볼트 | `CB4-12_M02_CLV`(U4_WHEEL_N 리지드 95416), bbox X −164.5~−157.5 · Y 9.5~25.5 · Z 322~329. 옛 실린더 클레비스 핀 끝 볼트(MOT-01)인데 핀이 M02R 3회차에 없어져 물린 것이 없다. base·캐리지·관 4줄과 20 mm 안에 아무것도 없음 | 컴포넌트·리지드 조인트 지우고 BOM에서 뺌 |
| D5 | 빈 컴포넌트(복사 원본) | `CB5-12_M02_1`(바디 0, `Move1` 4708이 복사해 `CB5-12_DC205`를 만듦) | DC205를 따로 넣은 뒤 지움 |

모델링부가 적은 M02R-D3(옛 부품 피처가 타임라인에 남음)·D4(설계 속성 description이 RX-06 문구 — 저장본에서 확인: "RX-06 mechanism fix1 …")도 그대로 남아 있다.

## 5. 원장·서명

- `ledger.py sigcheck`는 모델링부가 맞춰 둠(서명 표 doc = v2.14.0). 다시 재지 않았고, 앱에서 잰 탭 2·옆판 P·그네 bbox·부피가 서명 표와 같았다.
- `ledger.py commit --date 2026-11-13` 실행(부품 3,195, 통과 항목 84).
- **주의:** commit 전 범위에는 RX-07이 넣은 U8_PNEU 새 바디 10개(IR1000-01BG_M08 :2의 4바디, `CB4-12_M08_REG` :3·:4, `KQ2L06-01AS_M08R_IN_2·OUT_2`, `TU0604_M08P_U5_A1·A2`)와 없어진 1개(`TU0604_M08P_U5_A`)가 들어 있었다. RX-07은 검도 보고서가 아직 없고 나는 그 바디를 보지 않았다. commit이 이것까지 통과로 적어서, 새 바디 10개를 원장 `parts`에서 다시 뺐다(다음 `scope`에 '새로 10'으로 다시 나온다 — 확인함). 없어진 1개는 옛 서명이 없어 되돌리지 못했다. commit 직후 원장·직전 범위는 `tools/out/mech_M02R/verify6/ledger_after_commit_full.json`·`scope_before_commit.json`.

## 6. 시간·통로(E-23)

- 걸린 시간 약 85분(예상 15분, S). CAD 호출: MCP 약 22(측정·구동 batch 12, 그 밖 확인) + CLI 1. 파일 열기 2(앱 다시 켠 뒤 MCP open 1, CLI 1). 가장 긴 열기 888 s(CLI), 앱 open 약 600~860 s.
- 앱 막힘·재시작 1회: 내가 보낸 batch(연결 198, `joint.drive J_U4_X` 5번 + `inspect.clearance nearest:1` 5번, 11단계)가 MCP 응답 5분에서 끊긴 뒤 30분(running_s 1,808)을 넘겨도 끝나지 않았다. 안내서 '앱 막힘' 4대로 05:10에 앱 프로세스만 끄고 같은 포트(27878)로 다시 켠 뒤 v2.14.0을 다시 열었다. 버린 것: 포즈 변경뿐(재시작 전 `dirty false`, 편집 없음). `solidcraft-cli` 프로세스는 건드리지 않았다.
- 다시 켠 뒤 잰 것: `joint.drive J_U4_X` 한 번이 5분 넘게(약 6~8분) 걸린다. `J_U4_PRESS`·`J_U4_STOP`은 0.3~0.6 s(`quiet: true`). `inspect.clearance` 9 ↔ 32~59바디는 26~29 s(대부분 나사 물림 불리언 실패 8쌍).

## 미완

- J_U4_X 25·75 % 점은 못 잼(위 1절, 라운드 끝 회귀 몫).
- 해석: 못 함 — 환경 없음(자료대기 D-16). 강도 항목은 손계산(2절).
- 스크린샷 없음(E-16, 판정은 수치).

## 워크플로우 메모

- `ledger.py commit`은 과제 구분 없이 지금 서명 표 전체를 통과로 적는다. 앞 과제(RX-07)가 검도 없이 저장만 한 채로 다음 과제 검도가 commit하면 앞 과제의 바뀐 범위가 사라진다. 이번에는 손으로 되돌렸다. commit에 과제 범위(부품 목록) 인자가 있거나, 과제 정리부가 검도 안 된 과제를 먼저 돌려야 한다.
- 앱에서 `joint.drive J_U4_X`가 한 번에 6~8분이다(볼나사 motion link 추정). 여러 점을 한 batch에 넣으면 30분 상한을 넘는다. `motion.play REST 0`은 J_U4_X 키가 없어 X를 되돌리지 않는다(REST에 J_U4_X 0 키가 있으면 좋겠다 — 지금은 `joint.drive`로 따로 0).
- `inspect.clearance`의 `nearest`는 큰 파일에서 쓰지 않는 편이 낫다(이번 막힌 batch에 들어 있었음, 원인 분리는 못 함). 거리는 `clearance` 값을 크게 줘서 읽으면 0.02~18 s였다.
- 결과가 큰 응답(`joint.list`·`motion.play`·`inspect_design`)은 `quiet`·`verbose: false`로도 줄지 않아 호출마다 0.5~1.3 MB가 온다.
