hyeunung/FSAP/docs/reports/mechanism/mech_RX-08_verify2.md

# RX-08 검도·체결 수정 2회차 확인 — U4 레일 STEP 원본 잔재(Chamfer2) (2026-11-12)

요약(10줄 안):
- 대상 `3D_Modeling/FSAP_v2.12.2.sc`. MCP로 앱에 열린 문서를 썼다(running 빈 목록, dirty false). 저장하지 않았다. 끝에 REST step 0을 돌렸고 moved false였다(이미 REST).
- **지난 문제 1(Chamfer2가 남아 클램프 L_4·L_5와 1,871.3 mm³씩 겹침, 사용자 "이거 안보이냐고")은 해결됐다.** `measure Chamfer2`가 unknown body name을 낸다. 모델 바디 3,186개 가운데 Chamfer2와 RAIL_SSEB13 원본 바디는 0개다. 타임라인 Remove86(97923)은 error null이고 타임라인 전체에 error가 0이다. 이름 `Chamfer2`는 바디가 아니라 다른 챔퍼 피처(id 1030, ChamferFeature)로만 남아 있다.
- 남은 레일 두 줄 `SSEB13-570_RX06_RAIL`(Z 260~272)과 `…RAIL_SSEB13-570:2`(Z 434~446)는 둘 다 X −335~−125, 18,900 mm³다. 그린 레일 끝 밖으로 나간 바디는 없다.
- 과제 범위 간섭은 0이다. 레일 2개와 이웃 21개(클램프 L_4·5·6, PY:18·19·26~31, 스톱 A·B, 대차, 관 7)를 inspect.clearance로 쟀고 overlaps 0, unchecked 0이다. 가까운 쌍: L_6 9.0, PY:31 11.29, L_5 13.0, PY:28 15.17 mm. 0은 스톱 A·B와 맞닿는 끝면이다(의도).
- 보이는 바디 가운데 이름이 일반 이름(Chamfer·Body·Extrude·Box…)인 STEP 잔재는 0개다.
- 완료 판정 4항목을 모두 만족한다. 동작 문제 0으로 **pass, completion true**. 1회차 디테일 2개(관 휘는 구간, 빈 컴포넌트 floating)는 그대로 남는다. 원장을 갱신했다(부품 3,186, 통과 84).

## 0. 근거 규칙
| 규칙 | 원문 | 이번 |
|---|---|---|
| E-03 | "합격은 동작·간섭" | 레일 ↔ 이웃 clearance |
| E-17 | "과제 안 검사는 바뀐 바디·주변을 관련 조인트 몇 점에서만" | 이번 변경은 정적 바디 하나를 지운 것뿐이다. 지우는 것은 새 겹침을 만들 수 없다. J_U4_X·PRESS·STOP 점은 1회차(v2.12.1) 수치를 그대로 쓴다(그때 겹침은 Chamfer2 2쌍뿐이었다). 레일은 정적이라 REST 한 점에서 쟀다 |
| E-16 | "판정은 수치로만" | 스크린샷은 열지 않았다 |
| 안내서 '간섭' | against는 주변만 | against 21개 |

## 1. 지난 문제 확인
| 항목 | 1회차(v2.12.1) | 2회차(v2.12.2) |
|---|---|---|
| Chamfer2 바디 | X −335~235, 44,563 mm³, 보임 | 없음(unknown body name) |
| Remove86 | `unknown body SSEB13-220_RX06_RAIL` 오류 | error null, 타임라인 오류 0 |
| Chamfer2 ↔ CLAMP_L_4 / L_5 | 1,871.3 / 1,871.3 mm³ | 쌍 없음. 레일–L_5 13.0 mm, L_4는 상자로 제외(X 188, 313 mm 떨어짐) |

## 2. 수치 (inspect.clearance, clearance 20, skip_within component, 44 ms, 16쌍 잼, 26쌍 상자로 제외, truncated false)
- overlaps []와 unchecked []
- near: 스톱 A–레일 0.0, 스톱 B–레일 0.0(끝면 맞닿음), 대차–레일 5.5(두 줄), 레일–L_6 9.0, 레일–PY:31 11.29, 레일–L_5 13.0, 레일–PY:28 15.17.
- 블록 4개: X −237.9~−127(REST). J_U4_X 95에서 −332.9까지 가고 레일(−335) 위에 남는다(1회차에 실측, 겹침 0).
- 전체 바디 측정은 `tools/out/mech_RX-08/verify2_measure_all.json`에 있다.

## 3. 볼트·묶음·포트·간이 형상·판금
- 새로 넣거나 옮긴 볼트는 0이다. 새 바디도 0이다(지우기만 했다). M-01은 대상이 없다.
- 묶음: 바뀐 것 없다. 1회차 결과(관 U4 쪽 강체 98190·98198)가 그대로다.
- 포트는 그대로다. 빈 포트 0. LITE_는 새로 없다. 판금도 아니다.

## 4. 완료 판정
| 항목 | 결과 |
|---|---|
| 스토퍼 각도·바퀴 띄움 높이 근거 | 만족(멈춤각 0.95°, 1회차 실측 0.0147 mm 맞닿음) |
| 실린더 힘 ≥ 누름 반력 × SF | 만족(밀기 SF 1.69 손계산, 해석 못 함 — 환경 없음 D-16) |
| 과제 범위 간섭 0 | **만족(이번 회차에 해결)** |
| 회로 빈 포트 0 | 만족 |

## 5. 문제
- 동작 0.
- 디테일(1회차와 같고, 수정 회차를 쓰지 않는다): ① U4↔U8 관 이음 휘는 구간 95 mm. ② 빈 컴포넌트 U4_CYL·U4_ROD floating(M02R 잔재).
- 등급 M이 맞다. 이번 회차에 새 구매품·조인트 변화가 없다.

## 워크플로우 메모
- 1회차에 측정부·설계부는 Chamfer2 오류를 '과제 밖'으로 넘겼다. 타임라인 오류가 있는 바디는 과제 범위(scope '새로')에 들면 처음부터 동작 문제로 올리는 편이 낫다.
