hyeunung/FSAP/docs/reports/mechanism/mech_RX-08_verify1.md

# RX-08 검도·체결 수정 1회차 확인 — U4 중간 높이 스토퍼 실린더 (2026-11-12)

요약(10줄 안):
- 대상 `3D_Modeling/FSAP_v2.12.1.sc`(앱에 열린 문서, dirty false). 통로는 MCP다. 저장하지 않았고, 끝에 조인트를 REST(J_U4_X 0, J_U4_PRESS 13.006, J_U4_STOP 0)로 돌렸다.
- 지난 문제 1(관이 J_U4_X를 따라가지 않음)은 해결됐다. 강체 `Rigid Group 10:98190`·`10:98198`(U4_WHEEL_N ↔ 관 U4 쪽 2개)가 있고 floating이 아니다. J_U4_X 95 실제 구동 결과는 3절에 있다.
- 지난 문제 2(PRESS를 프로브로 잼)도 해결됐다. J_U4_PRESS를 실제로 구동해 0·25·50·75·100 %(−4.11·0.168·4.448·8.727·13.006) × STOP 0을 쟀고 겹침 0, 머리–그네 최소 4.50이다. STOP 20에서는 13.006 9.29, 4.448 2.72, 0.95 **0.0147 mm**로 겹침 0이다. 0.5°에서는 머리와 그네가 맞닿는다(커널이 겹침 계산에 실패함). 그래서 0.95° 아래로는 내려가지 않는다는 것이 맞다.
- 지난 문제 3(스크린샷)도 해결됐다. `tools/out/mech_RX-08/rx08_iso.png`가 있다(모델링부 확인 398 KB, 열지 않음 E-16).
- **불합격(동작 1): 과제 범위(scope 새로) 바디 `Chamfer2`(RX-06 레일 STEP 원본, X −335~235)가 관 클램프 L_4·L_5와 각 1,871.3 mm³ 겹친다.** 이 바디는 레일 끝보다 +X로 360 mm 튀어나와 보인다. 원인은 Remove86 타임라인 오류다. 사용자 말 "이거 안보이냐고"가 가리키는 것으로 본다. 앞 부서들은 '과제 밖'으로 넘겼다.
- 완료 판정: 각·높이 근거, 힘 SF, 빈 포트 0은 만족한다. '과제 범위 간섭 0'은 위 겹침 때문에 미달이다(completion false).
- 디테일 2개: U4↔U8 관 이음의 휘는 구간(95 mm), 빈 컴포넌트 U4_CYL·U4_ROD floating(M02R 잔재).
- CLI 시도: `solidcraft-cli run`(J_U4_X 47.5·95)은 54분 뒤 타임라인 오류 `Remove86: unknown body SSEB13-220_RX06_RAIL` 때문에 결과를 쓰지 않았다(전부터 있던 오류, `--allow-errors` 필요). 워크플로우 메모에 적는다.

## 0. 근거 규칙
| 규칙 | 원문 | 이번 |
|---|---|---|
| E-03 | 합격은 동작·간섭 | 관련 조인트 점마다 inspect.clearance |
| E-17 | "과제 안 검사는 바뀐 바디·주변을 관련 조인트 몇 점에서만" | scope: 바뀜 7·새로 23·이웃 107, full(조인트 바뀜). 전 사이클은 돌지 않음 |
| E-16 | 판정은 수치로만 | 스크린샷은 열지 않음 |
| E-02 | 강도·관 여유는 디테일로 기록만 | 관 이음 휘는 구간은 디테일 |
| 안내서 '간섭' | against는 주변만 | PRESS 점: 그네 묶음 26, X 점: 이웃 107 |

## 1. 범위 (ledger scope --joints-changed)
- 바뀜 7개: P_M02_BASE, P_RX06_CARRIAGE, CB4-25_M08:3·4, STEP대기_TPH-01_1~3.
- 새로 23개: 스토퍼 실린더·로드·블록·브래킷, CB8-20·너트, CB5-16 LIP 4·TOP 2, 피팅 4, 8번 밸브, 매니폴드, 관 4, Chamfer2.
- 없어짐 1개: STEP대기_SS5Y3-20-07_M08.
- 관련 조인트는 J_U4_PRESS·J_U4_STOP·J_U4_X다. 작업 대상(매트) 길에 닿는 부품은 바뀌지 않아 매트 모형은 넣지 않았다. 띄움 Z 12는 바퀴 아래 높이이고 매트 위 부품이 아니다.

## 2. J_U4_PRESS × J_U4_STOP (실제 joint.drive, MCP)
bodies 16(스토퍼 묶음·볼트·피팅·관 U4 쪽) ↔ against 26(그네·바퀴·암·스프링 탭·누름 실린더·피벗 볼트), skip_within component.

| STOP | PRESS (°) | 겹침 | 가까운 쌍 (mm) |
|---|---|---|---|
| 0 | −4.11 | 0 | 그네–CB8-20 4.50, CB5-16_M02_1:3–TOP:2 2.21(정적 쌍, 전과 같음), 브래킷–CB5-16_M02_1:3 4.00 |
| 0 | 0.168 | 0 | 그네–CB8-20 4.51 |
| 0 | 4.448 | 0 | (5 안 정적 쌍만) |
| 0 | 8.727 | 0 | 〃 |
| 20 | 13.006 | 0 | 그네–CB8-20 9.29, 관 A_U4–CB5-16_M02_1:2 5.28, 브래킷–MPFZ12 6.28, 브래킷–그네 8.54 |
| 20 | 4.448 | 0 | 그네–CB8-20 2.72 |
| 20 | 0.95 | 0 | **그네–CB8-20 0.0147** (닿는 점 (−170, 75.7, 141.72)) |
| 20 | 0.5 | 계산 실패(커널 tolerance 오류) | 맞닿아 들어감 → 0.95° 아래는 기구적으로 막힘 |

- 결과: 행정 0·25·50·75·100 %에서 겹침 0이다. 스토퍼 ON에서 멈춤각 0.95°(모델링부 sweep 0.932°, 메시 공차 0.229)가 손계산 0.95°와 맞는다.
- STOP 20 × PRESS 13.006에서 들린 그네 아래로 블록이 들어간다(겹침 0). 짐 없이 넣는 순서가 성립한다.

## 3. J_U4_X (실제 joint.drive, MCP)
- 구동: J_U4_X 0 → 95, moved true, 약 11분 20초. 끝난 뒤 0으로 되돌렸다.
- 따라감(bbox 실측, 95): 관 A_U4 X −380.0~−261.0(0에서 −285~−166 → −95), B_U4 X −314.5~−261.0, BASE X −425~−235, 스토퍼 브래킷 X −363~−235, 캐리지 X −335~−220. U8 쪽 관 A·B는 X −172 아래로 그대로 있다(정적). → 지난 문제 1이 해결됐다.
- 간섭(inspect.clearance, bodies 30 = 바뀜·새로 전부 ↔ against 107 = scope 이웃, clearance 0.5, skip_within component, 675 s, 79쌍 잼·65쌍 다시 씀·2,199쌍 상자로 제외):
  - RX-08 새 바디(스토퍼 묶음·관 4·피팅·볼트)는 겹침 0이다. 바뀐 BASE·캐리지도 겹침 0이다. 닿음 0.0은 볼트 머리 ↔ 캐리지·BASE 자리면과 BASE ↔ 누름 실린더 브래킷 0.0004로, 모두 장착면이다(의도).
  - unchecked 14쌍은 볼트 ↔ 자리 부품의 불 연산 실패(no result)다. 같은 쌍이 REST(모델링부)에서도 닿음이었고, 장착 볼트 자리라 겹침이 아니다.
  - **겹침 2쌍: `Chamfer2` ↔ `P_M08_TUBE_CLAMP_L_4` 1,871.3 mm³ (X 188~212, Y 112.5~120, Z 260~272), `Chamfer2` ↔ `P_M08_TUBE_CLAMP_L_5` 1,871.3 mm³ (X −112~−88).** 두 쌍 모두 고정된 쌍이라 J_U4_X와 관계없다(REST에서도 같음). 6절 문제 1.
- `Chamfer2`는 RX-06 레일 STEP(SSEB13-570)의 원본 바디다(feature 97900, 보임). X −335~235, Y 112.5~120, Z 260~272, 44,563 mm³이고, 그린 레일 끝 X −125보다 +X로 360 mm 더 나가 헤드 앞을 지난다. 이것을 지우는 Remove86이 이름 `SSEB13-220_RX06_RAIL`을 못 찾아 타임라인 오류가 났고, 그 때문에 바디가 남았다(측정부·설계부가 '과제 밖'으로 적은 것). 사용자 말 "이거 안보이냐고"는 앱에서 눈에 띄는 이 튀어나온 레일·클램프 겹침을 가리키는 것으로 판단한다. 모델에서 보이는 이상은 이것뿐이다.

## 4. 볼트·묶음·포트·간이 형상
- 이번 회차에 새로 넣거나 옮긴 볼트는 없다(관만 나눔). M-01은 대상이 없다.
- 묶음(E-11): 관 U4 쪽 2개는 강체로 U4_WHEEL_N(occ 10)에 묶였다(98190·98198). joint.list floating은 [U4_CYL, U4_CYL_CLEVIS], [U4_ROD, U4_ROD_NUT, I-020B_M02]이다. 둘 다 M02R에서 바디를 지운 빈 컴포넌트이고, v2.10.3부터 있던 것이라 이번 과제 밖이다. 디테일로 적는다(바디가 없어 움직임·간섭에는 영향 없음).
- 포트(M-06)·빈 포트: 8번 밸브 A·B → KQ2L06 PZ·NZ → 관 → 실린더 머리·로드 피팅. 이번 회차에 이음 위치만 바뀌었고 피팅은 그대로다. 빈 포트 0(donecheck 5행).
- LITE_ 간이 형상은 새로 넣지 않았다.
- 판금 아님(M-04 해당 없음).

## 5. 완료 판정
| 항목 | 근거 | 판정 |
|---|---|---|
| 스토퍼 각도·바퀴 띄움 높이 근거 | 손계산 0.95°·바퀴 밑 Z 12(stop_calc.json), CAD 0.0147 mm 접촉 직전·sweep 0.932° | 만족 |
| 실린더 힘 ≥ 반력 × SF | 축방향 반력 0, 짐 진 채 빼기 밀기 SF 2.00(0.5 MPa)·1.60(0.4 MPa), 이번 회차 하중 부품 변화 없음. 해석 못 함 — 환경 없음(D-16) | 만족 |
| 과제 범위 간섭 0 | 2·3절: RX-08 새 바디는 0. scope 새로 바디 Chamfer2 ↔ 클램프 L_4·L_5 각 1,871.3 mm³ | **미달** |
| 회로 빈 포트 0 | 4절 | 만족 |

## 6. 문제
| kind | 무엇 | 어디 | 수치 | 고치는 법 |
|---|---|---|---|---|
| 동작 | 보이는 바디 `Chamfer2`(SSEB13-570 STEP 원본 레일)가 지워지지 않고 남아 그린 레일 끝 X −125보다 +X로 360 mm 나가 있다. 관 클램프 L_4·L_5와 겹친다. 원인: Remove86(97923)의 대상 이름 `SSEB13-220_RX06_RAIL`이 없어 타임라인 오류가 났다(CLI는 이 오류로 run 결과도 버림) | U4_XAXIS 레일 `SSEB13-570_RX06:1/RAIL_SSEB13-570`, 보 앞면 Y 112.5~120, Z 260~272 | 겹침 1,871.3 mm³ × 2(X 188~212, X −112~−88), 바디 X −335~235, 44,563 mm³ | 결정로그 RX-06-E4·mech_RX-06_model1.md 42줄 방법. ① Remove86을 고쳐 Chamfer2를 빼거나 지운다. ② RAIL_SSEB13-570을 활성화한 채 로컬 corner (210, −20, −20), 길이 400·폭 40·높이 40 상자로 cut한다(월드 X ≥ −115 잘림). ③ 그린 상자 레일 SSEB13-570_RX06_RAIL(Box335·BodyTransfer583)을 지운다. ④ Chamfer2 이름을 SSEB13-220_RX06_RAIL로 바꾼다. 기대값: 두 줄 각각 X −335~−115, 17,180 mm³. 클램프 L_4·L_5(X −112~−88, 188~212)와 틈 ≥ 3. 다르게는 Remove86 대상만 Chamfer2로 바꿔 지우는 방법(그린 레일 유지, 가장 작은 변경)도 있다. 고친 뒤 Chamfer2 ↔ 클램프 L_4·L_5·CB5-16_M08_PY:28·29 clearance로 확인 |
| 디테일 | J_U4_X 95에서 U4 쪽 관 끝(X −264)과 U8 쪽 관 끝(X −169)이 떨어진다. 모델은 휘는 관 구간이 없어 끊긴 모양으로 보인다 | 관 RX08 A·B의 Z 340 이음 | 수평 95 mm | 디테일링에서 이음 사이에 여유 고리(관 길이 ≥ 95 + 굽힘 R15 × 2, 약 150 mm)와 클립 자리를 그린다. 기존 U4_A2·U4_B(RX-06 디테일 7)와 함께 케이블 베어나 코일관으로 묶는다 |
| 디테일 | 빈 컴포넌트 U4_CYL·U4_CYL_CLEVIS·U4_ROD·U4_ROD_NUT·I-020B_M02가 floating으로 남아 있다 | M02R 잔재 | 바디 0 | 디테일링에서 빈 컴포넌트를 지운다 |

## 워크플로우 메모
- `solidcraft-cli run --results`(저장 안 함)가 54분(3,229 s) 돈 뒤 기존 타임라인 오류(Remove86)로 "nothing was written" 하며 결과를 버렸다. 읽기 전용 run에도 `--allow-errors`가 필요하다. 오류가 있는 저장본은 시작할 때 미리 알 수 있게 하는 편이 낫다(engine-candidates 후보).
- J_U4_X joint.drive는 앱에서 약 11분 걸린다(모델 바디 3,187). 과제 안 검사의 5점(0·25·50·75·100 %)을 다 돌면 1시간이 넘는다. 이번에는 강체 묶음 확인과 끝점 95로 줄였다(E-19, 가장 불리한 끝).

## 시간(E-23)
- 걸린 시간 약 7348 s. CAD 호출: MCP 약 16회, CLI 1회. 파일 열기는 CLI 1회뿐이고 앱은 이미 열린 v2.12.1을 그대로 썼다.
- 예상(검도 M 30분)의 2배를 넘었다. 이유: J_U4_X joint.drive가 한 번에 약 11~12분 걸렸고, 왕복으로 두 번 돌렸다. 30바디 ↔ 107 clearance가 675 s 걸렸다. MCP 응답 끊김(300 s)으로 결과를 잃은 batch가 2번 있었다. inspect.measure의 body 인자가 무시돼 3,187바디를 다 쟀다. CLI run 54분은 타임라인 오류로 결과를 버렸다.
- 원장 commit은 하지 않았다(pass 아님, E-17).
