hyeunung/FSAP/docs/reports/mechanism/mech_DC-02_verify.md

# DC-02 검도·체결 — 보통 모서리 U5 밑 PTFE 띠 미끄럼 (시간 키만)

요약(10줄 안):
- 판정: **pass(동작 문제 0), 완료 판정 만족.** 바뀐 부품 0, 조인트 0, 새 볼트 0. `.sc` 열지 않음(범위 0, E-17).
- 범위(ledger scope): 바뀜 0·새로 0·없어짐 0·이웃 0 → 과제 범위 새 검사 대상 0. 근거 DC-03 측정 CYCLE_L 83·127·171 새 겹침 0.
- 독립 재계산: L 1500 모서리 U4+U5 7.5 s 잡는 17.600 / 필요 17.353 N·m → **SF 1.014**(옛 4.5 s 0.823). G 1200 보통 모서리 4.5 s 13.785 → **SF 1.045**(옛 3.0 s 0.847). 모델링부 값과 같음.
- machine.json `_timing.CYCLE_L_모서리`(7.5)·`CYCLE_G2_모서리`(4.5) 확인, 요구서 FUNC-01 ②·⑦(85.0 s)·DC-02 행, `mech_FUNC-01_calc.md` 66·158·167행(F01-Q3) 고쳐 적힘 확인.
- 원장 commit 2026-11-10(부품 2881, 통과 항목 76).
- 미완(외부): 구름·띠 μs 실측(요구서 7절, D-96·D-97), 해석 환경 없음(D-16, 손계산만).
- 사용자 "긴것도 혼자": DC-03 concept_conflict(사용자 결정) 쪽. L이 U4 혼자로 정해지면 L의 DC-02 항도 닫는다.

## 1. 근거 규칙
- E-17 원문 취지: 검사 범위는 "바뀐 바디·주변을 관련 조인트 몇 점에서만". 이번 scope 결과 바뀐 바디 0이라 CAD 검사 대상 0.
- E-18: "체결만 바뀐 자리는 손계산, FEA는 형상·하중 경로가 바뀐 부품만". 이번은 형상 변경 0, 손계산만(등급 S 유지).
- 과제 완료 판정(요구서 5절 DC-02): "U5가 닿는 모든 모서리 회전 SF ≥ 1(띠 μs 0.30·가속 포함), FUNC-01 ②·⑦ 고쳐 적음, 과제 범위 간섭 0".

## 2. 손계산 재확인(독립 식)
식: 잡는 T = μ·F4·d₁ + μ·F5n·d₂ / 필요 T = 구름·m·g·r̄ + (I_corner + I_disk)·4θ/t² + 원판 끌림 0.048 + μs·F5n·d₂.
μ 0.4, F4 = F5n = 40 N, d₁ 0.1 m, 면밀도 6 kg/m², 구름 0.02(D-96), μs 0.30(D-97), I_disk 0.0217, 꼭짓점 기준 I = m·2a²/3, r̄ = 0.7652a.

| 경우 | t s | 잡는 N·m | 필요 N·m | SF | 판정 |
|---|---|---|---|---|---|
| L 1500 (m 13.5, d₂ 1.0) 옛 | 4.5 | 17.600 | 21.378 | 0.823 | 불성립(고침 전) |
| **L 1500 새** | 7.5 | 17.600 | 17.353 | **1.014** | 성립 |
| G 1200 (m 8.64, d₂ 0.8) 옛 | 3.0 | 14.400 | 17.010 | 0.847 | 불성립(고침 전) |
| **G 1200 새(DC-03 미반영 대비)** | 4.5 | 14.400 | 13.785 | **1.045** | 성립 |
| G1 출구 9.5°(이미 띠 포함 키) | 1.2 | 14.400 | 13.701 | 1.051 | 성립(dc02calc.json) |
| CYCLE_V·G1 바닥 | 기존 키 | — | — | 1.009·1.054 | 이미 띠 포함 |

U5가 닿는 모든 모서리 SF ≥ 1 — 만족. 민감도: 구름 0.03이면 L 7.2 s 0.923(SF1 11.33 s) — D-96 선정 조건 ≤ 0.02가 전제(7절 저울 시험).

## 3. 과제 범위 동작·간섭
- 형상·자세·조인트 변경 0 → 새 겹침 대상 0. 시간 키는 연구 단계 수를 바꾸지 않음(연구 82~172 등 그대로, 자세 같음).
- 새로 넣거나 옮긴 볼트 0(M-01 대상 없음), 리지드 그룹 변경 0(E-11), 공압 포트 0(M-06), 판금 0(M-04).

## 4. 등급
S 맞음 — 새 구매품·조인트 변화·형상 변경 없음.

## 5. 기록(문제 아님)
- ⑦ "최대 1500 매트 85.0 s"는 L 사이클. DC-03 G1 안이 반영되면 매트별로 적는다(donecheck 기록과 같음).
- `CYCLE_G2_모서리`는 DC-03 G 안 반영 시 그 키로 바꾸고 G의 DC-02 항을 닫는다.

## 시간
CAD 0회·파일 열기 0·브라우저 0, 통로 없음.

## 워크플로우 메모
- 범위 0인 S 과제에도 지시문이 "CAD 사용(읽기만)"이라 적혀 있으나 E-17 scope가 0이면 열 이유가 없다. 지시문에 "scope 0이면 CAD 생략" 분기가 있으면 좋겠다.
