hyeunung/FSAP/docs/reports/mechanism/mech_LITE_verify.md

# 검도·체결부 — LITE 모델 무게 줄이기 검증 (2026-11-10, v2.8.9 → v2.8.10)

**요약**
- 판정: **pass**(동작 문제 0). 완료 판정의 '열기 240 s 이하'는 못 맞췄지만 '또는 줄인 만큼(전후 실측)'으로 충족한다(844.4 → 396.9 s, −53 %). 등급 M 맞음.
- 바뀐 부품: `P_M07_BEAM`(피처 이력. 탭 38개를 Box16 뒤 스케치 cut 3개로 옮김, 핀 메움 4, 탭 공구 Combine), `P_M02_FRONT`·`P_M03_FRONT`(X 메움·다시 뚫기 지움). 조인트·구매품·볼트·바디 수 변화 0.
- 형상: lite_check `ok true`. 바디 2,969/2,969, BOM 179행/2,616 차 0, 모델 bbox 차 0.000. 바뀐 바디는 보 하나이고 부피 −2.6 mm³(34,452,828.9 → 34,452,826.3, 0.000008 %), bbox·무게중심 차 0. 다른 2,968바디는 bbox·무게중심·부피 차 0.
- 새 탭 38개의 중심은 모두 기존 볼트 축과 0.05 mm 안에서 맞는다(38/38). 핀 메움 4곳은 가장 가까운 볼트와 1.35 mm 이상 떨어져 있다.
- CAD 재기(CLI, v2.8.10): 보 ↔ 볼트 27종 `inspect.interference`는 예산 420 s 안에 26쌍 모두 '판정 못 함'(겹침 0개, 수치 없음)이다. 보 ↔ 이웃 76바디 `inspect.clearance` 실행은 45분이 지나도 끝나지 않아 중단했다. 그래서 겹침 판정은 lite_check 전후 비교와 위 손계산으로 했다.
- 원장: `ledger.py commit` 완료(부품 2,881, 통과 항목 76). 허용 겹침 새로 0이라 판정 기억은 남기지 않았다.
- 미완: CAD 겹침 부피 실측이 남았다(보가 무거워 boolean이 끝나지 않음). 라운드 끝 전체 회귀가 다시 본다. 디테일로 남은 무게(필렛 띠 Combine 약 118 s 등)는 모델링부 보고대로다.

## 0. 범위(E-17)
- `ledger.py scope`: 전체 검사 아님, 바뀜 0, 새로 0, 없어짐 0, 이웃 0. 모델링부가 `sigpatch`(바뀜 3)를 먼저 해서 서명이 v2.8.10으로 이미 맞춰져 있었다. 그래서 검사 대상은 지시서의 바뀐 부품 3개와 보의 이웃(bbox 5 mm 안 195바디: 볼트 101, 그 밖 94)으로 직접 정했다(`tools/out/mech_LITE/verify2/nb.json`).
- 작업 대상(매트) 길: 보와 앞판의 바깥 bbox가 그대로이고, 바뀐 곳은 보 벽 속 탭 구멍(Y 119~132, Z 640~650.1)과 핀 메움뿐이다. 매트가 닿는 면은 바뀌지 않아 작업 대상 모형은 넣지 않았다.

## 1~2. 과제 범위 동작 검사(E-03 과제 안)
| 검사 | 통로·시간 | 결과 |
|---|---|---|
| 전후 바디 비교(lite_check, 모델링부) | CLI | 2,968바디 bbox·CoM·부피 차 0, 보 −2.6 mm³·bbox 차 0 |
| 보 ↔ 볼트 27종 `inspect.interference`(REST 0) | CLI `vB.json`, 882 s | 겹침 0개. 단 26쌍이 예산 420 s 안에 끝나지 않아 '판정 못 함' |
| 보 ↔ 이웃 76 `inspect.clearance`(REST 0) + J_U5_X 690·1380에서 움직이는 9바디 | CLI `vA.json` | 45분 넘게 끝나지 않아 중단(결과 없음) |
| 첫 시도(이웃 103 이름 한 번에) | CLI `vchk.json` | 58분 넘게 끝나지 않아 중단 |

- 그래서 겹침 판정은 아래 손계산으로 했다(E-18 '체결만 바뀐 자리는 손계산').
  - **새 탭 자리:** 스케치 cut 3장의 원 38개(Y 평면 Y 119 → +Y 11·13 mm, Z 평면 650.1 → −Z 10 mm, r 2.1 = M5 탭 밑구멍)의 중심을 보 근처 볼트 bbox 중심과 맞대 보았다. 38개 모두 볼트 축과 0.05 mm 안에 있다(`verify2/holes.txt`). 볼트 자리는 lite_check에서 전후 같다. 그래서 탭이 볼트 밖으로 옮겨 볼트가 보 살에 묻히는 일은 없다.
  - **핀 메움 4곳(r 2.4, +Y):** (−126/−114, 124, 462) h 6.5, (1159, 124, 273/287) h 8.5. 가장 가까운 볼트 CB5-16_M08_PY(X −110.2~−101.8)와는 1.35 mm 떨어져 있다. P_M08_TUBE_CLAMP_F_5·KQ2E08·P_M08_AIR_IN_BRKT는 Y 120 앞에서 끝나 핀(Y 124~)에 닿지 않는다. TU0604_M08P_U5_A·B는 휘어 지나는 관이라 bbox만 겹치고, 보 벽 속(Y 124~132)으로 들어가지 않는다. 들어갔다면 v2.8.9에서도 겹쳤을 것이다(보 전후 부피 차 −2.6 mm³).
  - **앞판 M02·M03:** 부피 차 −0.03·+0.02 mm³, bbox 차 0. 다시 뚫은 구멍이 같은 자리다.
  - **움직이는 이웃:** 바뀐 곳은 모두 보 벽 속이다. 보 바깥면은 그대로이므로 J_U5_X·J_U5_LIFT·J_U4_PRESS·J_U3 자세마다 달라지는 틈은 없다. v2.6.5 검증 때 14자세 겹침 0과 같다.
- 끝 처리: 스크립트마다 처음과 끝에 `motion.play REST step 0`을 했다. CLI는 저장하지 않아 저장본은 바뀌지 않았다. 앱(MCP)은 dirty v2.8.9가 열려 있어 건드리지 않았다(안내서 '문서 확인': "dirty면 … 버리지 않는다").

## 3. 볼트(M-01)·리지드 그룹(E-11)·포트(M-06)
- 새로 넣거나 옮긴 볼트는 0개다. 탭 38개는 같은 자리·같은 r 2.1로 이력만 옮겼다. 삽입 경로와 렌치 접근은 전과 같다.
- 리지드 그룹: 바디·컴포넌트 증감이 0이고 lite_check의 바디별 component가 같다. 누락 0.
- 공압 포트: 해당 없음(관·피팅 변경 0).

## 4. 판금(M-04)
- 해당 없음. 보는 각관 가공품이고, 앞판은 판금 피처가 없다.

## 완료 판정 대조
| 항목 | 값 | 판정 |
|---|---|---|
| 열기 240 s 이하 또는 줄인 만큼(전후 실측) | 844.4 → 396.9 s(같은 CLI 잣대, −447.5 s) | 충족('줄인 만큼') |
| 부품 수·자리·BOM 수량 | 바디 2,969 같음, BOM 179행/2,616 차 0 | 충족 |
| 사본 bbox 전후 같음 | 2,968바디 차 0, 모델 bbox 차 0.000 | 충족 |
| 형상 변경 0 | 보 −2.6 mm³(허용 ±50), bbox·CoM 0 | 충족 |

## 등급(E-18)
- M이 맞다. 새 구매품 0, 조인트 변화 0이다. 변경은 고정 부품 세 개의 피처 이력뿐이다.

## 해석
- 대상 없음. 형상·하중 경로 변화가 없다. 해석 환경도 없다(D-16).

## 시간
- 걸린 시간 약 6,030 s. 대부분 CLI 실행 세 번이었다(열기 약 400 s씩, 그리고 끝나지 않은 clearance). 예상 검도 M 30분의 2배를 넘었다. 이유: 보 하나(34.4 L, 피처 많음)를 상대로 한 boolean 판정이 이웃 수와 상관없이 끝나지 않았다.

## 워크플로우 메모
- 모델링부가 `sigpatch`를 검도 전에 하면 `ledger.py scope`가 바뀜 0을 내서 검도 범위가 비게 된다. 검도는 지시서의 바뀐 부품으로 범위를 다시 세워야 했다.
- 무거운 보(P_M07_BEAM)를 상대로 한 `inspect.clearance`에는 시간 예산 인자가 없다. 이웃 76개에서도 45분이 넘게 끝나지 않았다. `inspect.interference`는 예산 420 s 안에 볼트 26쌍을 하나도 끝내지 못했다. 이력만 바꾼 과제는 lite_check(전후 bbox·CoM·부피)와 손계산으로 판정하는 길을 안내서에 두면 좋다.
