hyeunung/FSAP/docs/reports/mechanism/mech_PNEU-01_verify2.md

# PNEU-01 검도 2회차 — v2.8.8 수정 2 확인 (검도·체결부, 2026-11-10)

## 요약 (10줄)
- 대상 `3D_Modeling/FSAP_v2.8.8.sc`(MCP open 1번, 피처 3,082, 오류 0, 앱에 이미 열려 있던 문서). 저장하지 않음, 끝에 `motion.play REST step 0`(moved false — 이미 대기 포즈).
- **판정: 불합격(동작 문제 2, 모두 수정 2와 무관한 수정 1 그대로인 고정품).** COMB_U5_2 ↔ TU0604_M08P_U5_A 겹침 깊이 0.06 mm, RISER_COMB_1 ↔ TU0604_M08P_U4_B 겹침 깊이 0.03 mm. 둘 다 관 굽힘 원호가 고정품 판 안에서 시작한다. 고치는 법은 구멍 하나씩 Ø6.5 → Ø7.0.
- 지난 문제 6건은 **모두 풀렸다**: F_5·SO_1·KDM 관 겹침 0(틈 0.2 = 구멍 벽 0.25 표본값), J_U7_HGT −4·−2·0·+3·+6에서 BRKT_KDM ↔ B 관 틈 ≥ 0.1, AIR 새 볼트 ↔ KQ2E08 3 mm 안에 없음(CAD), CST_V 띠 폭 30(SF 1.53은 모델링부 손계산이고, 이 부서가 다시 계산하지는 않음).
- 이번에는 고정품 31개 전부(수정 1 그대로 + 수정 2)를 관 35줄과 대 보았다. 기하 계산이고 `verify2/geo2.json`에 있다. 0.01 mm 정밀 깊이는 `verify2/fine2.json`. 경계로 남았던 쌍은 판정해서 위 2건으로 냈다.
- CAD `inspect.clearance`: 바뀐 고정품 5 + 옮긴 볼트 4 × 비관 이웃 15에서 **겹침 0**(맞닿음 10, 521 s). 볼트 4 × 자기 고정품·KQ2E08도 겹침 0.
- 굽힘 R: TU0604 최소 16 ≥ 15, TU0805 최소 40 ≥ 20(카탈로그 E-12 임시). B 관 3줄은 R 20. 고정 간격 26줄 ≤ 300(모델링부 spans_model2).
- 움직이는 축: 바뀐 부품 근처에서 상대 운동이 있는 것은 J_U7_HGT뿐이다. 고정품 ↔ 관(U7 대 비U7) 24쌍 × 4점에서 틈 ≥ 0.1이고, B 관과 다른 관 사이는 ≥ 1.45. J_U5_X·J_U4_PRESS·J_U6_HGT의 이웃에는 바뀐 부품이 없다(bbox 10 mm 선별).
- 디테일 4: B ↔ A 관 틈 1.45, BOM 관 행에 지난 메모('굽힘 R 부족')가 남음, 볼트 ↔ 보 CAD 판정 불가(커널), COMB_ML_1~4는 기하 재검 범위 밖(바뀌지 않음).
- 등급 L 맞음. 원장은 불합격이라 commit 안 함.

## 1. 통로·순서(E-04, E-23)
| 단계 | 한 일 | 시간 |
|---|---|---|
| 연결 | `running` 빈 목록 → `open v2.8.8`(errors 0, features 3,082, 즉시) → `document.revision` 2 → `edit.checkpoint` 22 | 수 초 |
| 범위 | `ledger.py scope` → 전체(원장이 PNEU-01 앞 기준이라 바뀜 9·새로 200·이웃 286). 과제 안 대상은 이번 회차에 바뀐 바디 13과 그 이웃(bbox 선별 `verify2/nbr.json`) | — |
| 기하 | `verify2/geo2.py`(고정품 31 × 관 35, REST + J_U7_HGT 4점, B 관 ↔ 관) 254 s, `fine2.py`(경계 쌍 0.01 mm), `csto2.py`(CST_O 기운 구멍) | 약 6분 |
| CAD | `inspect.clearance` 9 × 15(521 s, truncated false), 볼트 4 × 3(0.1 s), `body_topology` COMB_ML_1 | 약 9분 |
| 원복 | 편집 없음(읽기만). checkpoint 22는 앱이 이미 버려 되돌릴 것이 없었다. `motion.play REST step 0` → moved false, revision 3(자세만 바뀜, 저장 안 함) | 수 초 |
- 앱 막힘 0, 재시작 0. 관–구멍 동축 쌍은 CAD로 재지 않았다. 검도 1회차 실측으로 쌍 하나가 5분을 넘는다. 대신 생성 명령(상자 − 구멍)과 tubelog 중심선으로 계산했다. tubelog는 수정 2의 B 관(꺾임 Z 781, R 20)으로 갱신된 것을 확인했고, 생성 상자 bbox와 서명 bbox의 차는 0.0이다.

## 2. 지난 문제 대조(수정 2회차 지시 6건)
| # | 지난 문제 | 이번 결과(수치) | 상태 |
|---|---|---|---|
| 1 | CLAMP_F_5 ↔ U4_B 깊이 1.7 | F_5 X −112~−88 ↔ U4_A·U4_B 틈 0.2(구멍 벽) | 풀림 |
| 2 | CLAMP_SO_1 ↔ REG1_OUT 0.6·U6 0.3 | SO_1 ↔ U6 0.2 · REG1_OUT 0.2 · REG3_OUT 1.0 | 풀림 |
| 3 | COMB_KDM ↔ U7_4~6 6줄 0.4~1.3 | 6줄 모두 0.2 | 풀림 |
| 4 | J_U7_HGT +3·+6 BRKT_KDM ↔ B 관 0.7·1.7 | −4·−2·0·+3·+6 모두 ≥ 0.1(0.25 구멍 벽의 0.1 표본값) | 풀림 |
| 5 | AIR 새 볼트 머리 ↔ KQ2E08 29 mm³ ×2 | CAD 겹침 0. KQ2E08이 볼트 3 mm 안에 없다. 볼트 ↔ AIR는 받침 맞닿음 | 풀림 |
| 6 | CST_V 띠 오조작 SF 0.70 | 폭 30, 모델링부 손계산 SF 1.53 ≥ 1.2(`fea/results/mech_PNEU-01_fix2_handcalc.json`). CAD: CST_V ↔ CST_PLATE·CB5-12_M05_10·KC-40340 겹침 0. J_U7_HGT 4점에서 U8 관과 틈 ≥ 0.1(같은 카세트에 묶여 함께 움직임) | 풀림 |

## 3. 과제 범위 동작 검사(E-03, E-17)
### 3-1. 관 ↔ 고정품 31개 전체(REST, `verify2/geo2.json`)
- 109쌍. 틈 0.2 미만은 6쌍이다.

| 고정품 | 관 | 결과 | 판정 |
|---|---|---|---|
| P_M08_TUBE_COMB_U5_2 | TU0604_M08P_U5_A | **겹침 깊이 0.06 mm**(0.01 단위, 닿는 점 85) | 동작 문제 1 |
| P_M08_RISER_COMB_1 | TU0604_M08P_U4_B | **겹침 깊이 0.03 mm**(닿는 점 34) | 동작 문제 2 |
| P_M08_TUBE_BRKT_KDM | U7_4_B·5_B·6_B | 틈 0.1 | 구멍 벽 0.25의 표본값, 겹침 아님 |
| P_M08_TUBE_COMB_U5_2 | U5_B | 틈 0.1(정밀 점 0) | 겹침 아님 |
- 나머지 고정품(수정 1의 ARM_1·2, CLAMP_CAR, CLAMP_L_1~6, SO_2·3, ML_5~9, U5_1, BRKT_U6 등)과 관 사이 틈은 ≥ 0.2다. 수정 1에서 기운 구멍의 길이가 모자란다는 우려(결정로그 PNEU-01-M9)는 다른 고정품에서 겹침으로 나타나지 않았다. v2.8.6 생성기의 CST_O 기운 구멍 2개도 CUT·TUCK 4줄 0.2(`csto2.json`)다.
- 원인(`fine2.json`):
  - **U5_2**: 구멍은 base (−1235.5, 190, 661), 축 −X, h 19, r 3.25다. U5_A 꼭짓점 (−1240, 190, 661)에서 5.91° 꺾이고 R 30이라 원호가 X −1238.4~−1241.6에 있다. 이 구간과 그 앞의 비스듬한 곧은 구간이 상자 X −1253~−1237 안에 든다. +X 면(X −1237)에서 중심선이 구멍 축보다 약 0.31 떠서 구멍 벽 틈 0.25를 0.06 넘는다.
  - **RISER_1**: 판은 Z 396~404이고 구멍은 (1049.75, 53), 축 Z, Z 394.5~405.5, r 3.25다. U4_B는 Z 430에서 90°로 꺾이고 R 30이라 원호가 Z 400에서 시작한다. 판 안 Z 400~404에서 원호가 0.28만큼 벗어나 틈 0.25를 0.03 넘는다.
- COMB_ML_1~4(v2.8.6 이전에 만든 보 윗면 빗)는 생성 명령 파일이 없어 이 계산에 넣지 못했다. ML_1의 `body_topology`를 보면 구멍은 축 −X, r 3.3이다. 이 4개와 그 자리를 지나는 관은 수정 1·2에서 바뀌지 않았다. 바뀐 B 관 구간은 X −33~−67뿐이고, ML은 X 250·650·−350·−950에 있다. 그래서 과제 안 범위에서 빼고 라운드 끝 회귀에 맡긴다(디테일 D2-4).

### 3-2. 바뀐 고정품·볼트 ↔ 비관 이웃(CAD `inspect.clearance`, REST)
- bodies: F_5, SO_1, KDM, AIR, CST_V, CB5-16_M08_PY:18·19·46·47
- against: P_M07_BEAM, KQ2T08_1, KQ2E08_1, CB5-12_M05_10, P_M05_CST_PLATE, KC-40340_M05, CST_O, BRKT_KDM, F_4, L_5, SO_3, CB5-16_M08_PY:36·37·42·43
- 결과: **overlaps 0**, truncated false, 16쌍 검사(가지치기 119).
  - 0.5 안 맞닿음은 10이다. 보 앞면 4, CST_PLATE 1, KQ2E08 받침 1, 볼트 머리 받침 4.
- unchecked 4는 볼트 :18·19·46·47 ↔ 보다. 커널 Intersect가 'no result'를 냈다. 나사부가 탭에 물리는 정상 겹침 자리(M-08)이고, 탭은 생성기 `stage_Z_taps.json`에서 확인했다. 디테일 D2-3.
- 볼트 4 × [F_5, AIR, KQ2E08] 3 mm 안: 겹침 0, 맞닿음은 받침면뿐이다. KQ2E08은 3 mm 안에 없다.

### 3-3. 움직이는 축(관련 조인트 점)
| 조인트 | 점 | 대상 | 결과 |
|---|---|---|---|
| J_U7_HGT(−4~+6, 손 조정) | −4·−2·0·+3·+6 | U7_* 고정품(BRKT_KDM·CST_V·CST_O) ↔ U8 관, U8 고정품 ↔ U7 관(24쌍 × 4) | 틈 ≥ 0.1, 겹침 0 |
| J_U7_HGT | 같은 점 | B 관 3줄(U8) ↔ 관 35줄(U7 관은 dz 이동) | 다른 관과 ≥ 1.45(A 관, REST 비스듬한 구간), 그 밖은 ≥ 4.0 |
| J_U7_HGT | 같은 점 | B 관 위 토막(끝 Z 736) ↔ `_L`(시작 Z 740), 같은 관 두 토막 | −4에서 끝이 맞닿고(끊김 0), +6에서 같은 축으로 10 mm 겹친다. 한 관을 둘로 나눠 그린 것이라 간섭이 아니다. 행정 전 구간에서 이어짐 = 길이 여유 ≥ 0 |
| J_U5_X·J_U4_PRESS·J_U6_HGT | — | 바뀐 바디의 이웃(bbox 10 mm) 안에 이 유닛의 움직이는 바디 없음 | 해당 없음(검도 1회차 결과 그대로: J_U5_X 5점·J_U4_PRESS 3점 겹침 0) |
- 작업 대상 길(매트·테이프)에 닿는 부품은 바뀌지 않았다. U7_TAPEWAY는 B 관 bbox 이웃에 들지만 바뀐 구간(X −33~−67, Y −50~−134, Z 736~787)의 3 mm 안에는 없다. 그래서 작업 대상 모형은 넣지 않았다.

### 3-4. 새로 옮긴 볼트(M-01, E-11, M-06)
| 볼트 | 자리 | 물림·탭 | 렌치 | 리지드 |
|---|---|---|---|---|
| CB5-16_M08_PY:18·19 | X −106·−94, Y 112, Z 462 | 머리 자리 깊이 10, 판 8 → 보 물림 8 ≥ 1d. 탭 깊이 10(새 cut) | +Y 축 방향 열림(앞쪽 이웃 0) | U8_PNEU 자식 그대로 |
| CB5-16_M08_PY:46·47 | X 1159, Y 116, Z 261·299 | 날개 t4 → 보 물림 12, 탭 깊이 12(강 각관 벽을 뚫음) | 축 방향 열림, KQ2E08까지 7.75 | 그대로 |
- 공압 포트 공간(M-06): KQ2E08은 그대로이고 AIR 판 구멍 Ø13.2도 그대로라 바뀐 것이 없다.
- 판금(M-04): 이번에 바뀐 판금 부품은 없다. CST_V는 절삭·접합 바디이고, 판금 바디가 아니라는 것은 검도 1회차 디테일 D-3 그대로다.

## 4. 문제(고치는 방법·치수)
| # | 종류 | 무엇 | 어디 | 수치 | 고치는 법 |
|---|---|---|---|---|---|
| 1 | 동작 | 관 굽힘(5.91°, R 30)이 빗 상자 안에서 시작해 관이 구멍 벽과 겹친다 | P_M08_TUBE_COMB_U5_2(X −1253~−1237) / TU0604_M08P_U5_A, 구멍 base (−1235.5, 190, 661) 축 −X | 깊이 0.06 mm(`verify2/fine2.json`) | 그 구멍만 r 3.25 → 3.5(Ø7.0, h 19 그대로). 이웃 구멍 (182, 673)과 중심 간격 14.4, 살 7.4. 또는 관 꼭짓점 (−1240, 190, 661) → (−1234, 190, 661)로 원호를 상자 밖(X ≥ −1235.6)에 둔다 |
| 2 | 동작 | 관 90° 굽힘(R 30) 원호가 판 안 Z 400~404에서 시작해 구멍 벽과 겹친다 | P_M08_RISER_COMB_1 판 Z 396~404 / TU0604_M08P_U4_B, 구멍 (1049.75, 53) 축 Z | 깊이 0.03 mm | 그 구멍만 r 3.25 → 3.5(Ø7.0, base Z 394.5, h 11 그대로). 이웃 (1060.25, 63)과 14.5. 또는 U4_B 꼭짓점 Z 430 → 435(원호 시작 Z 405, 판 윗면 404와 1). 관 길이 +10, 이웃 관 틈은 다시 본다 |
| D2-1 | 디테일 | B 관과 A 관이 가깝다 | U7_4_B ↔ U7_4_A, (−33.3, −52.7, 773.5) 비스듬한 구간 끝 | 1.45 mm(5_B 1.86, 6_B 2.23) | 겹침이 아니다. 진동·조립 오차로 맞닿으면 관끼리 쓸리므로, 다음 손볼 때 B 꺾임 Z 781 → 779이면 약 2.5로 벌어진다 |
| D2-2 | 디테일 | BOM 관 행 메모가 옛 내용이다 | `docs/bom/FSAP_v2.8.8_purchased.csv` TU0604·TU0805 행의 '굽힘 R 부족 — 디테일 M08-X5' | 지금 최소 R은 TU0604 16, TU0805 40으로 카탈로그 이상 | 메모를 '최소 R 16 ≥ 15 / 40 ≥ 20'으로 고친다 |
| D2-3 | 디테일 | 볼트 ↔ 보 CAD 겹침 판정 불가 | CB5-16_M08_PY:18·19·46·47 ↔ P_M07_BEAM | Intersect 'no result' 4쌍 | 탭은 생성기에서 확인했다(새 cut r 2.1, 깊이 10·12). 라운드 끝 회귀에서 다시 보고, 그래도 안 되면 탭 원기둥 ↔ 볼트 축 거리로 판정한다. 모델링부가 적은 메움 원기둥이 각관 안으로 약 2.8 나온 것도 같이 본다 |
| D2-4 | 디테일 | COMB_ML_1~4는 기하 재검 범위 밖 | 보 윗면 X 250·650·−350·−950 | 생성 명령 파일 없음, 수정 1·2에서 바뀌지 않음 | 라운드 끝 회귀(regrun)에 관 ↔ ML_1~4를 넣는다 |
- 검도 1회차 디테일(새 볼트 렌치 접근 4 + 헤드 임시 상자 앞 7, CST_O·CST_V 판금 바디 아님, 보 윗면 볼트 물림 6)은 그대로 남아 있다.

## 5. 완료 판정 대조
| 항목 | 결과 |
|---|---|
| 끊긴 튜브·빈 포트 0 | 이번에 바뀐 것은 B 관 3줄 위 토막뿐이고, 양 끝(분기 Z 370.6, 이음 Z 736)은 그대로다. J_U7_HGT 전 구간에서 끊김 0. 검도 1회차 확인 그대로 |
| 굽힘 반경 미달 0 | TU0604 ≥ 16(카탈로그 15), TU0805 ≥ 40(20). 충족 |
| 고정 간격 | 26줄 ≤ 300(모델링부 `spans_model2.json`). 충족 |
| 움직이는 축 길이 여유 ≥ 0·과제 범위 간섭 0 | 길이 여유는 충족. **간섭은 미달**(문제 1·2, 0.06·0.03 mm) |
| BOM 지름·길이·피팅·고정품 | `FSAP_v2.8.8_purchased.csv` TU0604 32.0 m(+0.04), TU0805 0.80 m, 피팅·AS2201F·고정품 행 있음. 충족(메모는 D2-2) |
- **completion_met = false**(간섭 0 미달).

## 6. 등급(E-18)
- L 맞음. 이번 회차에는 새 구매품도 조인트 변화도 없고, 바뀐 유닛은 U1·U7·U8로 지시 범위 안이다.

## 7. 원장·판정 기억
- 불합격이라 `ledger.py commit`은 하지 않았다. 허용으로 판정한 겹침은 없다. B 관 ↔ `_L` 같은 축 겹침은 한 관을 두 바디로 그린 것이라 쌍 판정이 아니다. 판정 기억(paircache)에도 넣지 않았다. 바디가 다시 그려지면 해시가 바뀐다.

## 8. 남은 것(다음 회차가 볼 것)
- 문제 1·2를 고친 뒤 `verify2/fine2.py`를 같은 입력으로 다시 돌린다. 생성 stage에 바뀐 r을 넣으면 된다.
- 라운드 끝 회귀: 관 ↔ COMB_ML_1~4, 볼트 ↔ 보(커널 실패 쌍).

## 시간(E-23)
- 걸린 시간 약 22분(예상 검도 L 60분 안). CAD 호출 9(open 1, batch 3, clearance 2, describe 2, body_topology 1), 파일 열기 1(즉시, 이미 열린 문서), 통로 MCP, 브라우저 0, 앱 재시작 0.

## 워크플로우 메모
- 검도 1회차의 표본(0.5 mm·24점)이 0.06 mm 겹침을 '경계'로 남겼고, 이번 표본(0.25 mm·36점, 정밀 0.01)에서 겹침으로 판정됐다. 관–구멍 기하 판정은 처음부터 정밀 깊이까지 한 번에 내는 편이 회차를 덜 쓴다.
- `inspect.clearance`가 강 각관 보와 볼트 사이에서 커널 Intersect 실패(unchecked)를 낸다. 모델링부의 보 탭 메움 실패와 같은 바디다.
