hyeunung/FSAP/docs/reports/mechanism/mech_PNEU-01_verify1.md

# PNEU-01 검도 1회차 — v2.8.7 관 고정품·볼트·U5 체인·움직이는 축 (검도·체결부, 2026-11-10)

## 요약 (10줄)
- 대상 `3D_Modeling/FSAP_v2.8.7.sc`(MCP open 1번, 피처 2,954, 오류 0). 저장하지 않음, 끝에 체크포인트 원복·대기 포즈.
- **판정: 불합격(동작 문제 5).** 고정품 구멍이 관 굽힘 구간에 걸린 정적 겹침 3곳(CLAMP_F_5 ↔ U4_B 깊이 1.7, CLAMP_SO_1 ↔ REG1_OUT 0.6·U6 0.3, COMB_KDM ↔ U7_4~6 관 6줄 0.4~1.3), J_U7_HGT +3·+6에서 BRKT_KDM ↔ U7_4·5·6_B 겹침 0.7·1.7, AIR_IN_BRKT 새 볼트 2개 머리 ↔ STEP대기_KQ2E08-00A_1 겹침 29.0 mm³ ×2(CAD 측정).
- 지난 문제 8건: 체인 23링크·motion link, 12PZ_F 겹침, 고정 간격 ≤ 300, BOM·D 번호는 풀림. 움직이는 축 검사는 이번에 함(위 J_U7_HGT 문제 새로 나옴). 새 볼트 검사에서 위 AIR_IN 겹침 나옴.
- J_U5_X 0·345·690·1035·1380(0·25·50·75·100 %) 체인·관·고정품 24바디 × 이웃 11~14: **겹침 0**(맞닿음만, 각 0.6 s). J_U4_PRESS −1.867·3.38·8.626 U4C 관 2 × U4 이웃 8: **겹침 0**.
- 관 ↔ 고정품 판정은 CAD가 아니라 생성 명령(상자 − 구멍)과 관 중심선(tubelog, 모델 관 bbox와 차 ≤ 4.0)으로 계산했다. CAD `inspect.clearance` 관–구멍 동축 쌍 하나가 MCP 5분+, CLI `inspect.interference` 쌍 5개가 각 818 s(CPU 30분, 2.5 GB)에도 끝나지 않았다(E-14 예외 요청 아님, 워크플로우 메모).
- 디테일: 새 볼트 렌치 접근 막힘 4개(ARM_2 2·CST_V 1·CST_O 1) + 헤드 임시 상자 앞 7개(D-10), CST_O·CST_V가 판금 기능 바디 아님(M-04 전개 불가), 보 윗면 볼트 물림 6(알루미늄 1.5d 7.5 미달).
- 등급 L 맞음. 원장 commit 안 함(불합격).

## 1. 통로·순서(E-04, E-23)
| 단계 | 한 일 | 시간 |
|---|---|---|
| 연결 | `running` 빈 목록 → `open v2.8.7`(errors 0, features 2,954) → `document.revision` 1 → `edit.checkpoint` 4 | 열기 약 60 s 이하 |
| 범위 | `ledger.py scope --joints-changed` → full(바뀜 9·새로 200·없어짐 51·이웃 286), `tools/out/scope.json` | — |
| 시도 1 | MCP `inspect.clearance` COMB_ML_9 × 보·관 10 → 5분 넘어 응답 끊김(앱은 약 6분 뒤 끝, 결과 잃음) | ~6분 |
| 시도 2 | MCP COMB_ML_9 × TU0604_M08P_U5_A 한 쌍 → 5분 넘어 끊김 | ~5분 |
| 기하 계산 | `tools/out/mech_PNEU-01/verify1_geo.py`·`verify1_depth.py`·`verify1_u7hgt.py`(CAD 없음) | 각 1분 안팎 |
| CLI 확인 시도 | 쌍 5개 `inspect.interference`(F_5·SO_1·KDM·U5_2·BRKT_KDM) 5병렬 → 818 s에 timeout, 프로세스 계속 돌아(CPU 30분) 내 것 5개만 종료 | 약 25분(병행) |
| MCP 짧은 검사 | 볼트 프로브·머리 모형(AIR_IN, CST_O), J_U5_X 345·1035·1380, J_U4_PRESS 3점, 판금 전개 시도 | 각 수 초 |
| 막힘 | J_U7_HGT drive + 관 measure 묶음(10단계)이 8분 넘게 돎 — 이 연결 요청, 다른 연결 막힘 아님 | (아래 '시간') |
| 원복 | `edit.restore_checkpoint 4`(프로브 바디 지움). J_U7_HGT 묶음이 20분 가까이(running_s 1,188) 끝나지 않아 앱만 재시작(07:44, `Stop-Process -Name solidcraft` → `--control 27878`, solidcraft-cli 안 건드림) → v2.8.7 다시 open(약 700 s, errors 0, features 2,954) → `motion.play REST step 0` | 버린 것: 저장 안 된 조인트 자세뿐(읽기 부서, 형상 편집 없음) |

## 2. 지난 문제 대조(수정 1회차 지시 8건)
| # | 지난 문제 | 이번 결과 | 상태 |
|---|---|---|---|
| 1 | U5 체인 23링크·motion link, 체인 안 관 끊김 | J_U5_X 5점 drive: stopped_by_contact null·conflicts 0, 링크·굽힘·관 토막 따라옴. 관 토막 ↔ 12PZ_F 틈 0.25, 겹침 0 | 풀림 |
| 2 | 12PZ_F ↔ U5_A·U5_B 관 끝 222·226 mm³ | 12PZ_F ↔ L_TA·L_TB 0.25(5점 모두) | 풀림 |
| 3 | 고정품 29 — 고정 간격 ≤ 300 | 30개 있음, `model1/spans_model1.json` 26줄 최대 300.0 | 풀림(단 3절 겹침 3곳 새로) |
| 4 | 새 볼트·볼트 검사 | 57개 모두 유닛 컴포넌트 자식(리지드 누락 0, 서명 unit 5종), 탭 있음. AIR_IN 2개 겹침(3-5) | 문제 1 남음 |
| 5 | 움직이는 축 검사·조인트 점검 | J_U5_X·J_U4_PRESS 겹침 0, J_U7_HGT +3·+6 겹침(3-4) | 문제 1 남음 |
| 6 | BOM·자료대기 번호 | `docs/bom/FSAP_v2.8.7_purchased.csv`(134줄, TU0604·TU0805·피팅·CB5-16) · `_made.csv`, D-155~D-161 | 풀림 |
| 7 | CST_O 구멍 bbox ±0.5 초과 | 구멍 Ø6.5 지시대로 — 동작 아님. 디테일 D-4로 | 디테일 |
| 8 | CST_O 굽힘 2·재질 | SPCC 재질 있음(새 재질 7.85). 굽힘 수는 기하 판단, 동작 아님. 판금 바디 아님(D-3) | 디테일 |

## 3. 과제 범위 동작 검사(E-03, E-17)
### 3-1. 범위·방법
- scope: full(조인트·행정 바뀜, 여러 유닛). 대상 = 바뀜·새로 중 이번 회차 부품(고정품 30·볼트 57·체인 묶음·12PZ_F·CST_O·AIR_IN), 이웃 = scope neighbors 중 bbox ±15 안.
- 관(스윕 바디)이 낀 쌍은 CAD가 끝나지 않아(1절) 생성 명령으로 계산: 고정품 = `stage_A_fixtures.json`·`stage_B_extras.json`의 상자(new·join) − 원기둥(cut), 관 = `model/tubelog.json` 꼭짓점 + 접선 원호 R(모델링부 `cross.py`의 sample, 모델 관 35줄 bbox와 차 최대 4.0 — TU0805 끝 피팅 쪽). 관 표면(r)·r+0.2·r−δ 링을 0.25 mm·10~15° 간격으로 찍어 재료 안인지 본다. 깊이 = 재료 안에 드는 가장 안쪽 링(0.1 단위).
- 관이 없는 쌍(체인 링크·관 토막·고정품 ↔ 보·대차·볼트, 프로브 ↔ 피팅·판)은 MCP `inspect.clearance`(틈 0.3).

### 3-2. 정적 REST — 관 ↔ 고정품(`verify1_geo.json`, `verify1_depth.json`)
| 고정품 | 관 | 깊이(겹침) | 원인 |
|---|---|---|---|
| P_M08_TUBE_CLAMP_F_5 (X −132~−108) | TU0604_M08P_U4_B | **1.7** | 관 꺾임점 (−125, 110, 430)(−X → (−161, 100) 쪽 15.5°)이 클램프 안. 구멍은 X축 곧은 Ø6.5(틈 0.25) |
| P_M08_TUBE_CLAMP_SO_1 (X 952~968) | TU0604_M08P_REG1_OUT | **0.6** | 꺾임점 (960, 82, 240) 앞뒤 1.9 mm 호 + 구멍이 비스듬 구간 축(0.9919, 0.1268)으로 X 950.5부터 — X 952에서 축 어긋남 0.78 |
| P_M08_TUBE_CLAMP_SO_1 | TU0604_M08P_U6 | **0.3** | 꺾임점 (950, 53, 262) 호(t 7.7)가 X 957.7부터 클램프 안 |
| P_M08_TUBE_COMB_KDM (앞판 Y 112~120) | TU0604_M08P_U7_4_A·_4_B·_5_A·_5_B·_6_A·_6_B | **1.2·1.3·0.7·0.9·0.4·0.5** | 관이 Y 130 → −Y로 R 30 꺾이는 호(Y 130~100)가 판 Y 112~120을 지남. 구멍은 현 방향 곧은 Ø6.5(호 처짐 ≈ L²/8R 0.5 + 위치) |
| P_M08_TUBE_COMB_U5_2 | TU0604_M08P_U5_A | < 0.1(경계) | 꺾임점 (−1240, 190, 661) 앞 — 판정 경계, 고칠 때 같이 본다 |
| P_M08_TUBE_BRKT_KDM | U7_4·5·6_B | < 0.1(REST) | 3-4 참조 |
- 나머지 고정품 24개 ↔ 관: 겹침 0, 틈 0.2 안 4쌍(U5_2↔U5_B, RISER_1↔U4_B, CST_V↔FEED_A·B — 구멍 안 0.25 동축, 정상).
- 고정품 ↔ 관 아닌 이웃(bbox 선별 32쌍): 31쌍은 받침 면 맞닿음(bbox 겹침 0 또는 −0.1). CST_V ↔ CB5-12_M05_10 bbox 0.25 겹침 1쌍은 CAD 미확인(2절 막힘) — 기존 볼트 머리 옆, 모델링부가 고칠 때 `inspect.clearance` 한 쌍으로 본다.

### 3-3. 움직이는 축(관련 조인트 행정 0·25·50·75·100 %)
| 조인트 | 점 | 대상 × 이웃 | 결과 |
|---|---|---|---|
| J_U5_X | 0·345·690(모델링부)·1035·1380 | 체인 링크 L1·L17·U1·U17·굽힘 K1~K5·관 토막·U5C 관 2·CLAMP_CAR·ARM_1·2 (24) × 보·12PZ_F·12PZ_M·체인 팔·CB5-12 4·COMB_U5_2·ML_4·대차 판(+1380 ML_3·U5_1·ML_8) | 겹침 0, truncated false. 맞닿음: 링크↔보 윗면, 링크↔12PZ_F·M, ARM_1↔체인 팔, CLAMP_CAR↔대차 판. 관 토막↔12PZ_F 0.25. stopped_by_contact null |
| J_U4_PRESS | −1.867·3.38·8.626 | U4C_A·U4C_B × CYLBRKT·CB5-12_M02_1·로드·클레비스·핀·와셔·CB4-12·BRKT_U6 | 겹침 0, near 없음. U4C 관 이음 끝 이동 ≤ 2.3 mm(bbox X −133.57 → −131.33, Z +1.5) — 위쪽 자유 구간(R≈266)이 받음 |
| J_U7_HGT | −4·−2·0·+3·+6 | BRKT_KDM(U7_FIXED) × U7 관 12(기하) | **+3: U7_4·5·6_B 겹침 0.7, +6: 1.7** (3-4). A 관은 모든 점 틈 < 0.3, 겹침 0 |
| J_U7_HGT 꼬리 관 | −4·+6 | _L 꼬리(U7_FIXED) ↔ 본관 세로 다리 | REST 겹침 4.0(A 743.5/747.5, B 736/740) → −4에서 0(맞닿음, 이어짐), +6에서 10. 끊김 0 |
| J_U6 높이 | — | — | 설계에 J_U6_HGT 조인트 없음(`joint.drive` "no joint"). U6_L 꼬리(U6_SENSOR) 겹침 4.0 — 지시문에 J_U6_HGT가 있으나 기계 정의 `machine.json`에도 없다(아래 워크플로우 메모) |
| J_U5_LIFT·J_U5_FLOAT | — | — | U5 관(U5C_1·2)은 대차 MGPM 몸(U5_CAR) 포트로 가서 승강을 건너지 않음(모델링부 4-2와 같음) |

### 3-4. J_U7_HGT — BRKT_KDM ↔ B 관(`verify1_u7hgt.json`)
- B 관 꺾임점 (−33.3, −133.5, 775) −Y → −Z 90°, R 30이면 호가 Z 775 → 745에서 끝난다. 받침판 BRKT_KDM은 Z 742~750(+6이면 748~756). REST에서 호 끝이 판 안(깊이 < 0.1, 구멍을 기운 축으로 맞춤), +3에서 0.7, +6에서 1.7 겹침. 손 조정(setup) 조인트지만 범위 −4~+6 전체가 운전 자세다.

### 3-5. 새 볼트(M-01, E-11, M-06)
| 항목 | 결과 |
|---|---|
| 리지드 그룹 | 57개 모두 유닛 컴포넌트 자식(U8_PNEU·U4_WHEEL_N·U5_CAR·U7_FIXED·U7_CASSETTE), 루트에 남은 것 0 |
| 상대 탭 | 받침 M5 탭 57(보 42·BASE 2·KDM 받침 2·대차 판 2·체인 팔 4·카세트 판 4 + AIR_IN 보 탭) |
| **AIR_IN 볼트 56·57 겹침** | 머리 모형(Ø8.5 × 5, 머리 받침 Y 116에서 −Y, Z 273·287, X 1159) ↔ `STEP대기_KQ2E08-00A_1`(X 1130~1172, Y 101~115, Z 273~287) **29.0 mm³ ×2**(MCP inspect.clearance overlaps). 나사부 Ø5 ↔ AIR_IN 구멍 0.25. 기존 Ø5.5 구멍 자리가 KQ2E08 몸에 걸려 있었다 |
| 물림 | 보 앞면 8, 체인 팔 10, 대차 판 8, KDM 받침 8, 카세트 판 8, **보 윗면 6**(알루미늄 1.5d = 7.5 미달 — 디테일) |
| 렌치 접근(프로브 Ø8.5 × 30, 기하 + CAD) | 43개 막힘 없음. ARM_2 볼트 50·51: U5C 관이 Ø8.5 안 1.25(육각 렌치 Ø4 축은 3.0 띄움 — 렌치 들어감, 소켓 안 됨). CST_V 볼트 53: U7C_FEED_A가 3.94 들어옴(렌치 축 0.31, 막힘). CST_O 볼트 54: TUCK_A 0.64(렌치 들어감). CST_O 볼트 54·55 ↔ CST_O 판 겹침 0(CAD). 보 앞면 클램프 볼트 12~15·22·24·25: 헤드 임시 상자 `STEP대기_867-392342_UPPER`(Y ≤ 90, 꽉 찬 상자) 앞 12 mm만 남음 |
| 포트 공간 | 새 포트 없음(피팅은 v2.8.6 그대로) |

### 3-6. 판금(M-04)
- `sheet.flat_pattern` P_M08_TUBE_BRKT_CST_O·CST_V: "is not a sheet metal body" — 두 부품 모두 판금 기능 바디가 아니라 전개·구멍–굽힘 거리를 잴 수 없다(M-04 '판금 기능으로 안 그린 부품은 결함'). 이 워크플로우에서는 디테일.

## 4. 문제(고치는 방법·치수)
| # | kind | 무엇 | 어디 | 수치 | 고치는 방법 |
|---|---|---|---|---|---|
| A1 | 동작 | 클램프 안에서 관이 꺾여 겹침 | P_M08_TUBE_CLAMP_F_5 ↔ TU0604_M08P_U4_B | 깊이 1.7 | F_5를 X −120 → **−100**(상자 X −112~−88, 볼트 X −106·−94, 보 탭 같이)으로 옮겨 곧은 구간(꺾임 호 X −120.9~−129 밖)에 둔다. 자유 구간: U4_A F_4→F_5 150, F_5→끝 약 200, U4_B F_5→끝 약 195 ≤ 300 |
| A2 | 동작 | 클램프 안 꺾임 | P_M08_TUBE_CLAMP_SO_1 ↔ REG1_OUT 0.6, U6 0.3 | 0.6·0.3 | SO_1을 X 952~968 → **975~991**로(+23). U6는 곧은 구간(X 957.7~1040.75, Y 53, 축 X), REG1_OUT은 비스듬 곧은 구간(X 961.9~1006, 방향 (50, 13, 0)/51.7) — 구멍 축을 그 구간 방향, 중심을 그 구간 위 X 983 점(Y ≈ 87.9)으로 |
| A3 | 동작 | 빗 앞판이 관 굽힘 호를 지남 | P_M08_TUBE_COMB_KDM ↔ U7_4·5·6 A·B | 0.4~1.3 | 앞판을 Y 112~120 → **Y 88~96**(호 끝 Y 100과 4 띄움, 웹 KDM_W에 붙여 보 앞면 볼트는 웹·팔 쪽으로)으로 옮기고 구멍 축 −Y. U7_4_A 다음 꺾임 호 시작 Y 86.6 → 판 앞면 88과 1.4 — 모자라면 판 t 8 → 6. 팔(KDM_A, Y 36~44) 구멍 6개도 곧은 구간인지 `verify1_geo.py`로 다시 본다(지금 U7_6 0.4·0.5 중 일부가 팔) |
| A4 | 동작 | J_U7_HGT +3·+6에서 받침판이 B 관 굽힘 호에 겹침 | P_M08_TUBE_BRKT_KDM ↔ U7_4·5·6_B | +3 0.7, +6 1.7 | B 관 3줄 꺾임점 Z 775 → **781**, 그 굽힘 R 30 → **20**(호 끝 Z 761, +6 판 윗면 756과 5). A 관(Z 790)과 가로 간격 9(틈 3). 또는 받침판 구멍 축을 곧은 구간에 맞게 판을 Z 730대로 내림 |
| A5 | 동작 | 새 볼트 머리가 피팅 몸에 겹침 | CB5-16_M08_PY_PNEU01_56·57(P_M08_AIR_IN_BRKT) ↔ STEP대기_KQ2E08-00A_1 | 29.0 mm³ ×2 | AIR_IN_BRKT를 Z 266~294 → **256~304**로 늘리고 볼트를 Z **261·299**(머리 끝 265.25·294.75, KQ2E08 273·287과 7.75), 보 탭도 같이 옮김 |
| D1 | 디테일 | 새 볼트 렌치 접근 | CB5-16 _50·_51(ARM_2, U5C 관 1.25), _53(CST_V, FEED_A 3.94), _54(CST_O, TUCK_A 0.64) | 프로브 Ø8.5 | _53은 관 FEED_A를 볼트 축에서 5 이상 비키거나 볼트를 Z ±10 옮김. 나머지는 육각 렌치 축 여유 ≥ 2 — 조립 순서(관 넣기 전 조임) 기록 |
| D2 | 디테일(external) | 헤드 임시 상자 앞 볼트 접근 | CB5-16 _12~15·_22·_24·_25(F_3·F_4·L_3·L_4) | 클램프 앞면–헤드 상자 12 | 헤드 기종(D-10) 뒤 실물로 다시 본다 |
| D3 | 디테일 | 판금 기능 바디 아님(M-04) | P_M08_TUBE_BRKT_CST_O·CST_V | 전개 불가 | `sheet.convert` 또는 판금 기능으로 다시 그림(디테일링) |
| D4 | 디테일 | CST_O 구멍 bbox 지시 ±0.5를 0.3 넘음 3곳, 굽힘 2(지시 1) | P_M08_TUBE_BRKT_CST_O | 0.3 | 기하대로 둠, 디테일링에서 판금으로 바꿀 때 정리 |
| D5 | 디테일 | 보 윗면 볼트 물림 6 < 7.5(알루미늄 1.5d) | CB5-16_M08_NZ_COMB 사본 7 | 6 | 기존 COMB_ML_1~4와 같은 꼴 — 디테일링에서 CB5-20 또는 헬리서트 |

## 5. 완료 판정 대조
| 항목 | 상태 |
|---|---|
| 끊긴 튜브·빈 포트 0 | 충족 — 체인 안 2줄 이어짐, _L 꼬리 −4~+6에서 겹침 ≥ 0 |
| 굽힘 반경 미달 0 | 충족(모델링부 표: 최소 R 16 ≥ 15, TU0805 40 ≥ 20, 체인 안 69.5) |
| 고정 간격 기준 | 충족(26줄 최대 300.0) — A1·A2·A3로 자리를 옮기면 다시 계산 |
| 움직이는 축 여유 ≥ 0·과제 범위 간섭 0 | **미충족** — A1~A5 |
| BOM | 충족 |
→ completion_met = false.

## 6. 등급(E-18)
L 맞음(새 구매품 여러 종·움직이는 축·여러 유닛).

## 7. 원장·판정 기억
- 불합격이라 `ledger.py commit` 하지 않음. 허용 겹침 판정 없음(맞닿음만) — `paircache.py judge` 없음.

## 8. 남은 것(다음 회차가 볼 것)
- A1~A5 고친 뒤: `verify1_geo.py`(관–고정품, 1분), `verify1_u7hgt.py`(J_U7_HGT 5점), AIR_IN 머리 모형 ↔ KQ2E08 MCP 한 쌍, CST_V ↔ CB5-12_M05_10 MCP 한 쌍.
- J_U7_HGT를 CAD로 몬 묶음(drive + 관 measure)은 MCP에서 20분 가까이 끝나지 않아 앱을 재시작했다. 기하로 대신했다.
- 모델 무게: 재시작 뒤 열기 약 700 s > 상한 240 s(안내서 '모델 무게') — 과제 정리부가 LITE 과제를 볼 자료.

## 시간(E-23)
| 항목 | 값 |
|---|---|
| 걸린 시간 | 약 3,350 s(검도 L 예상 60분 안) |
| CAD 호출 | MCP 약 17(open 1, batch 9, execute 4, running·pending), CLI 5(쌍 interference, 모두 timeout) |
| 파일 열기 | MCP 2(v2.8.7 처음 약 60 s 이하 — 앱에 이미 있던 문서, 재시작 뒤 약 700 s = open_s, 모델 무게 상한 240 s 넘음), CLI 5(같은 파일, 열기 뒤 계산에서 멈춤) |
| 앱 막힘 | 다른 연결 막힘 0. 이 세션 요청이 5분 MCP 응답 상한을 넘은 것 3번(clearance 2, J_U7_HGT drive+measure 묶음 1 — running_s 1,188에서 앱 재시작) |

## 워크플로우 메모
- SolidCraft 스윕 관(면 'other') ↔ 관이 0.25 틈으로 지나는 구멍 판의 `inspect.clearance`·`inspect.interference`가 쌍 하나에도 MCP 5분+, CLI 13분+(CPU 30분·2.5 GB)로 끝나지 않는다. 같은 검사를 생성 명령(상자 − 원기둥) + 관 중심선으로 1분에 했다. 관 고정품 검사는 기하 계산을 기본으로 하고 CAD는 관 없는 쌍만 쓰는 편이 낫다(엔진 후보).
- Git Bash `timeout`이 solidcraft-cli.exe 자식을 끝내지 못했다(rc=1 뒤에도 프로세스 남음) — PID로 따로 끝내야 한다.
- 지시문의 J_U6_HGT는 설계·`machine.json` 어디에도 없다(J_U7_HGT 노트에만 이름). 과제 정리가 machine.json 조인트 목록으로 관련 조인트를 뽑게 하면 좋겠다.
