hyeunung/FSAP/docs/reports/mechanism/mech_FUNC-01_verify.md

# FUNC-01 검도·체결 — v2.8.0 (U5 플로트·접는 바인더·바늘판 홈)

## 요약 (10줄)
- 대상 `3D_Modeling/FSAP_v2.8.0.sc`. MCP로 한 번 열었다(open 즉시, 피처 2,301, 타임라인 오류 0, dirty false). 저장하지 않았고, 끝에 `motion.play REST step 0`을 했다.
- **동작 문제 1건 → pass false.** 축 `PSFJ16-150_F01_N/P`(Ø16, Z 116~266, 중심 Y ±43)가 옆판 `P_M03_LIFT_SIDE_N/P` 웹(Y ±31~±37)을 Z 116~129 구간에서 2 mm 파고든다. 옆판의 Ø16 구멍이 Z 129~136까지만 뚫려 있다. 겹침은 한쪽 약 185 mm³(활꼴 14.5 mm² × 12.5)다. 커널은 '동축 핀·구멍'이라 부피를 내지 못했고(unchecked), 면 위상으로 확인했다(2-3절).
- 이 겹침을 모델링부 검사가 놓친 까닭: 둘 다 U5_FLOAT 컴포넌트 안이라 `skip_within: component`가 이 쌍을 건너뛰었다.
- 고치는 법: 옆판 N·P의 축 구멍을 Z 129에서 Z 115까지 아래로 늘린다. 중심 (−1847, ±43)에 Ø16.5 여유 구멍(웹에서 깎이는 깊이 2.25)을 내고, 플랜지 Ø16 H7(Z 130~136)은 그대로 둔다.
- 그 밖의 과제 범위 겹침은 0이다. U5는 LIFT/FLOAT 7자세에서 봤다. 바인더·바늘판은 REST, 바늘 −36, HGT −4·+6과 그 사이(10.5 mm 틈 논증), 이음매 L·S·G 겹침 끝(CUT·TUCK 15, FEED 150), 카세트 빼기(LATCH 12, CST_X 12.5·25, CST_Y 125·250)에서 봤다.
- 기준선: HGT −4에서 바인더와 두께 10 매트 모형 MAT_L·MAT_G가 86.9 mm³씩 겹친다. 두께 6 자세를 두께 10 모형에 댄 것이고 모델링부 값과 같다. TAPE_L·G 쌍은 unchecked다.
- 볼트: 새로 넣은 볼트는 없다(지운 것 6개). 새 탭은 바인더 PA12 M5 2개이고 물림 6 = 1.2d라 디테일로 남긴다(인서트 MBIS5-6.5-8). 리지드 누락 0. 새 공압 포트 0.
- 좁은 홈 묶음 폭 13 < 25 (바인더 끝 X −5~8). 바늘판 LOWER는 살만 깎은 변경(−1,099.6 mm³)이라 새 겹침이 생길 수 없다.
- 등급: M → **L**. 새 조인트 J_U5_FLOAT, 새 구매품 LHFR16·PSFJ16, 4개 유닛에 걸친 변경이 있다(E-18).
- 미완: 위 동작 문제 1건(모델링부 수정 회차). 원장 `ledger.py commit`을 이 판정보다 먼저 돌렸다(워크플로우 메모).

## 1. 통로·범위
| 항목 | 값 |
|---|---|
| 통로 | MCP. `running` 빈 목록 → `open` v2.8.0 → `inspect_design`(dirty false, 오류 0, 경고 34는 예전 것) → 자세·측정 → `motion.play REST 0`. 저장 0 |
| 범위(E-17) | `ledger.py scope --joints-changed`: full, 바뀜 1·새로 20·없어짐 21·이웃 37, 유닛 U3·U5_WHEEL_F·U7·U8, 작업 대상 길 바뀜(U7_BINDER) |
| 느린 호출 | `joint.drive J_U7_HGT`·`J_U7_CST_X/Y`가 한 번에 약 250~275 s 걸렸다(나머지 조인트는 0.15~0.25 s). 첫 HGT 묶음(16단계)은 MCP 응답이 끊겨 결과를 잃었다. 앱은 끝까지 돌았고(running 1,100 s 뒤 비워짐) 같은 자세에서 다시 쟀다. 앱을 다시 켜지는 않았다 |

## 2. 과제 범위 동작 검사 (E-03·E-17)

### 2-1 U5 플로트 (bodies 19 = 새·바뀐 U5 바디, against 44 = U5 이웃 + 새 바디 + P_M04_PANEL_E2 + MAT_L·G·S)
| J_U5_LIFT | J_U5_FLOAT | 겹침 | 비고 |
|---|---|---|---|
| 30 | 0 | 0 | 틈 0.5 안: 맞닿음 0인 쌍 7개는 의도한 것이다(매달림 칼라↔LHFR16 윗끝, 와셔↔스프링, LHFR16↔축 구멍, 센서 브래킷↔E32). 축↔승강판 Ø16.5 구멍 0.25 |
| 30 | 20 | 0 | 위 기계 정지(플랜지↔승강판) |
| −10 | 20 / 10 / 0 | 0 | |
| 10 | 5 / 15 | 0 | |

이 검사는 `skip_within: component`로 했기 때문에 같은 컴포넌트 안의 쌍은 보지 않았다. 그래서 같은 컴포넌트 안 쌍을 따로 다시 쟀다(2-3절).

U5_X 0~1380 길: 새 부품 bbox(X −1990~−1820, |Y| ≤ 78, Z 20~290)를 X −440까지 늘린 상자와 닿는 고정 바디는 0이다(서명 bbox로 셈, 닿는 것은 모두 U5 자기 부품).

### 2-2 바인더·바늘판 (bodies P_M05_BINDER·LOWER, against 33 = 머리·노루발·바늘·카세트 이웃·U6·작업 대상 모형 9·패널·테이프 길)
| 자세 | 겹침 | 가장 가까운 것 |
|---|---|---|
| REST(skip 없음, 틈 0.5) | 0 | NOSE 0.5, BINDER_BRKT 맞닿음 0, LOWER↔매트·테이프 Z 0 맞닿음(기준선 M00). unchecked: 바인더↔CB5-12_M05_1·2(나사 물림, 2-4절) |
| HGT +6, 노루발 6 | 0 | NOSE 0.5 |
| HGT −4, 노루발 −4 | MAT_L·MAT_G 각 86.9 mm³ (X −5~0 · Y −27.4~−9 · Z 9~10) | **기준선**(두께 6 자세 ↔ 두께 10 모형, 실제 6 mm 매트와는 3 mm 틈). TAPE_L·G ↔ 바인더 unchecked(같은 원인) |
| HGT −1.5·+1·+3.5 | 0 (논증) | HGT −4에서 바인더와 10.5 mm 안에 있는 바디는 4개뿐이다: NOSE 0.5(Y 방향), FOOT 1.0(Y, 노루발은 HGT와 함께 움직임), 바늘 8.26(Y), LOWER 9.0(Z, 위로 갈수록 멀어짐). Z로 10 mm 옮겨서 새로 닿을 바디가 없다 |
| 바늘 −36, 노루발 0 | 0 | 바늘↔바인더 Y 8.2 (모든 Z에서 같음) |
| 이음매 겹침 끝 L·S·G(WP_*_Y 330, 노루발 0, 바늘 −30) | 0 | |
| 같은 자세 + CUT 15·TUCK 15 | 0 | |
| FEED 150 | 0 | |
| 카세트 LATCH 12, CST_X 12.5·25 | 0 | NOSE 3.04, FOOT 12.6, LOWER 13.0 |
| CST_Y 125·250 | 0 | 2 mm 안 0. 카세트를 빼는 길에 닿는 바디(서명 bbox)는 모두 U7_CASSETTE·U7_TUCK 안이거나 카세트와 함께 움직인다. TU0604_M08K_U7C_3·4는 motion.play에서 카세트와 함께 움직이는 것을 확인했다 |

### 2-3 같은 컴포넌트 안 쌍 (skip_within null, U5 바디 18 ↔ U5 31, 정적)
겹침이 계산된 것은 0이다. unchecked는 6쌍이다.
- `P_M03_LIFT_SIDE_N ↔ PSFJ16-150_F01_N`, `_P ↔ _P`: 커널 메시지 "a pin on one cylinder with its hole…". `inspect.interference`로 다시 재도 unchecked였다. **면 위상으로 판정했다:**
  - 옆판 P의 축 구멍 면 33·34(r 8, 축 (−1847, 43))는 Z 129~136까지만 있고, 바닥 면 32(+Z, Z 129, 넓이 13.45 mm², Y 35.0~37)에서 끝난다. 웹 안쪽 면 0(Y 37 평면, X −1990~−1820 전체, 넓이 11,809)은 그 밑에서 끊기지 않는다.
  - 축 PSFJ16-150_F01_P는 위상상 민 Ø16 원통 하나다(면 1, r 8, Z 116.5~265.5, 끝 모따기 0.5). Z 116~129에서 Y 35~37을 지난다.
  - → 웹 안으로 들어가는 활꼴 높이는 2이고 넓이는 64·acos(0.75) − 6·√28 = 14.5 mm², 길이 12.5다. **겹침은 한쪽 약 181~185 mm³, N·P 합해서 약 370 mm³**다. N은 대칭이다(같은 커널 메시지).
- `P_M03_FRONT ↔ CB5-16_M03_9~12`: 예전 나사 물림이다. 앞판은 윗면만 깎였고(140 → 134) 볼트는 Z 77~123이라 바뀐 것이 없다.

## 3. 문제
| # | kind | 무엇 | 어디 | 수치 | 고치는 법 |
|---|---|---|---|---|---|
| 1 | 동작 | 플로트 축이 옆판 웹과 겹친다(축을 넣을 수 없음) | `PSFJ16-150_F01_N/P` ↔ `P_M03_LIFT_SIDE_N/P`, (−1847, ±43), Z 116~129 | 웹 2 mm 파고듦, 한쪽 ≈ 185 mm³ | 옆판 N·P에 중심 (−1847, ±43)으로 Ø16.5 여유 구멍을 Z 115~130까지 깎는다(웹 활꼴 높이 2.25 제거, 남는 웹 3.75). 플랜지 Ø16 H7(Z 130~136)과 받침 블록 Ø16 H7(Z 116~130)은 그대로 둔다. 안내는 축 물림 20 그대로다. 다른 안: 축 중심을 Y ±45.5로 옮긴다(LHFR16·칼라·스프링·승강판 구멍·블록을 모두 옮겨야 함 — 권하지 않음) |
| 2 | 디테일 | 바인더(PA12 SLA)에 바로 낸 M5 탭 물림 6 = 1.2d. 수지 탭은 2d 이상이거나 인서트가 필요하다(M-01 물림) | `CB5-12_M05_1·2` → `P_M05_BINDER` (15, −80)·(15, −55), Z 52~60 | 물림 6, 바닥 여유 2 | 탭 Ø4.2 깊이 8 대신 Ø6.5 깊이 9 구멍에 MBIS5-6.5-8 열 압입 인서트를 넣는다(카세트에서 이미 쓰는 형번). 볼트는 CB5-12 그대로(물림 = 인서트 8) |
| 3 | 디테일 | (모델링부 기록 이월) LHFR16 플랜지 체결, 받침 블록 체결·멈춤나사 렌치, 바인더 끝 R | F01-D4·D5·D6 | — | 모델링 보고서 7절 그대로 |

판금(M-04): 옆판 N·P는 SUS304 t6 L꼴이다. 플랜지를 Z 130~136으로 옮겼고, 플랜지 Ø16 H7 구멍 가장자리(Y 35)가 꺾임선(웹 안쪽 Y 37)을 넘는다. 문제 1을 고치면 구멍이 웹까지 이어지므로, 이 부품은 굽힘 판금보다 '웹 + 플랜지 맞대기 용접 뒤 가공'(또는 통째 밀링)으로 정하는 것이 맞다. 이것은 디테일 단계의 가공 방법 결정으로 기록만 한다(E-02). 문제 2·3과 판금 기록은 pass를 막지 않는다.

## 4. 볼트·리지드·포트·스프링
- 새로 넣거나 옮긴 볼트: 0. 지운 볼트는 CB5-12_M03_7~10, CB4-12_M08_REG:3·4(bolts.json 1,133 → 1,127)다. 지운 볼트 구멍 4개는 메웠다(모델링 보고서). CB6-16/20_M03_LIFT는 U5_LIFT로 컴포넌트만 옮겼고 자리는 같다(REST (−1959/−1881, 46·72, 170·176)).
- 리지드(E-11): REST 재생에서 PSFJ16_F01_N/P(Z 116), LHFR16_F01_N/P(Z 164), HG-KR23·PGX62·E32·CB5-16_M03_9~12·CB6_M03_LIFT가 LIFT/FLOAT를 따라 움직였다. 새 바디는 모두 U5_FLOAT:1·U5_LIFT:1 컴포넌트 안에 있다. 누락 0.
- 포트(M-06): 새 포트 0. IR1000 F 묶음을 지운 뒤 빈 끝 관·이음은 모델링부 확인대로 0이다.
- 받침 스프링은 강체 모형이라 FLOAT > 0에서 스프링 윗끝과 와셔가 떨어져 보인다. 실제로는 자유 길이 132 > 75 + 20이라 늘 닿는다. 겹침 판정과는 상관이 없다(탄성 변형은 조인트로 못 만든다, 안내서 '동작 검사').

## 5. 완료 판정 대조
| 항목 | 결과 |
|---|---|
| ①~⑦ 성립 여유율·근거·D-번호 | 계산부(mech_FUNC-01_calc.md) 몫이라 이 부서는 보지 않았다. F01-M4(플로트 64.7 N, 자국 SF 1.04)는 계산부 확인 대기다 |
| 불성립 항목 0 | 계산부 몫 |
| 바인더 접는 형상 모델에 들어감 | 됨(P_M05_BINDER, 바깥 X −11~45.5 · Y −95~−9 · Z 13~60) |
| 과제 범위 간섭 0(이음매 단계·카세트 탈착 포함) | **미달** — 문제 1(축↔옆판 웹). 이음매·카세트 단계는 0 |
| 좁은 홈 묶음 폭 < 25 | 13 |

## 6. 등급 (E-18)
지시서 등급은 M('새 조인트 없음')이었다. 실제 변경에는 새 조인트 J_U5_FLOAT, 새 구매품 LHFR16 ×2·PSFJ16-150 ×2(+ STEP대기 PSCS16 ×4·스프링 ×2), 유닛 4개(U3·U5·U7·U8)에 걸친 변경이 있다 → **L**.

## 7. 기록
- 판정 기억(paircache): 남기지 않았다. HGT −4 바인더↔두께 10 모형 겹침은 자세에 달린 기준선이다. 쌍 키에 자세가 담기지 않아서, 남기면 다른 자세의 진짜 겹침까지 덮는다. 대신 `machine.json baseline_overlaps`에 'THICK_6(HGT −4) 바인더↔MAT/TAPE 두께 10 모형'을 한 줄 넣을 것을 권한다(문서 담당·모델링부).
- 원장: `ledger.py commit --date 2026-11-08`(부품 2,729, 통과 53)을 문제 1을 찾기 전에 돌렸다. 수정 회차에서 옆판 N·P 서명이 바뀌면 PSFJ16은 이웃으로 다시 검사 범위에 들어온다.

## 워크플로우 메모
- 과제 안 검사의 `skip_within: component`는 같은 움직이는 컴포넌트 안의 새 부품끼리 쌍(축↔옆판 같은 조립 맞춤)을 빼 버린다. 새 부품이 같은 컴포넌트 안에 들어간 과제는 정적 1자세에서 `skip_within: null`(또는 occurrence)로 한 번 더 재야 한다. 모델링부와 검도 첫 패스가 모두 이것으로 놓쳤다. 안내서 '동작 검사'에 넣을 만하다.
- 동축 '핀·구멍' unchecked는 겹침 0으로 읽으면 안 된다. 면 위상(구멍 면의 Z 범위 ↔ 핀 길이)으로 바로 판정할 수 있었다.
- 큰 설계에서 `J_U7_HGT`·`J_U7_CST_X/Y` `joint.drive`는 한 번에 약 250~275 s였다(다른 조인트 0.2 s). 그래서 MCP 도구 5분 제한에 걸려 묶음 결과를 잃었다. 느린 조인트는 호출 하나에 하나만 몰고, 사이 값은 '틈 논증'(끝점에서 행정 길이 안의 바디 목록)으로 대신했다.
- 원장 commit은 문제를 모두 확인한 뒤에 돌려야 한다(이번에는 순서가 바뀌었다).
- `edit.checkpoint`는 이 세션의 자세 변경 수십 번 뒤에 없어져 있었다(최근 16개만 보관). 읽기 부서의 원복은 `motion.play REST 0`으로 했다.
