hyeunung/FSAP/docs/reports/mechanism/mech_MOT-01_verify.md

# MOT-01 검도·체결 — v2.7.0 (검도·체결부, 2026-11-09)

## 요약 (10줄)
- 대상 `3D_Modeling/FSAP_v2.7.0.sc`. 통로는 MCP(앱 켜짐, 다른 요청 0)로, 저장본을 한 번 열었다. 저장하지 않았다. 시험 탐침 51개는 `timeline.delete`로 지웠고, 끝에 `motion.play REST step 0`을 했다.
- **동작 문제 0 → pass.** 과제 범위 겹침은 모든 자세에서 0이다: REST 전체 101바디 ↔ 163바디, J_U4_PRESS 5점, J_U5_X × J_U5_LIFT 7자세, 바퀴 회전 0·37·90·180·270°.
- 리지드 그룹 누락 0: 볼트 사본 46개가 자세를 바꿔도 자기 유닛 기준 바디와의 거리 변화가 0.0000 mm다. U3·U5X·피벗 볼트는 움직이지 않는다.
- 렌치 접근: 새로 넣거나 옮긴 볼트 49자리 모두에 탐침을 세웠다. 48자리는 막힘이 0이다.
- **디테일 1(완료 판정 미달):** `SFB5-12_M03_IDL` 머리 윗면(Y 118)과 `P_M07_BEAM` 면(Y 120) 사이가 2.0 mm다. 보에 구멍이 없어 완성 상태에서 육각 렌치가 들어가지 않는다.
- 고치는 법: 안쪽 SFB5-12와 접시 와셔를 없앤다. 아이들러 축 Y 112~115에 Ø20 턱을 일체로 깎고, 바깥 CB5-12 하나로 고정한다.
- 기록만: CB4-12_M02_CLV의 공구 길에 에어관 TU0604_M08_U4C_B가 지나간다(머리에서 20.5 mm). 기준 L+5 = 17 mm보다 멀고 손으로 비킬 수 있는 관이다.
- 작업 대상: U3 아랫축 묶음은 Z −200~−50에 있어 매트(Z 0~12)의 길 밖이다.
- 원장: `ledger.py commit` 했다(부품 2730, 통과 항목 53).
- 미완: 위 디테일 1. 해석 못 함 — 환경 없음(D-16).

## 0. 근거 규칙(원문)
- E-03 "합격은 동작·간섭": 과제 범위 겹침 0, 대상 통로 막힘 0.
- E-17 "과제 안 검사는 바뀐 바디·주변을 관련 조인트 몇 점에서만". 전체 사이클은 라운드 끝 회귀가 본다.
- E-19 "같은 것은 묶어 가장 불리한 하나만". 정적 검사에서 같은 이름 사본은 :1만 쟀다. 사본 위치는 4절에서 occurrence별로 확인했다.
- M-01(L2 체결) "완성 조립 상태에서 머리 위 축 방향 빈 공간 ≥ 볼트 길이 + 5 mm, 또는 볼 렌치 30° 접근", "상대 부품의 탭 또는 너트가 실제로 있음, 물림 ≥ 1.5d".
- E-11 "리지드 그룹 누락은 동작 문제".
- E-02 / 워크플로우 머리말: "새 볼트 렌치 접근은 디테일로 기록만". 다만 과제 완료 판정에 "체결 공구 닿음(막힘 0)"이 있으므로 completion_met는 false다(WF-169).

## 1. 범위(E-17)
`ledger.py scope --joints-changed` → full. 바뀜 15, 새로 86, 없어짐 22, 이웃 62. 유닛은 U3_HEAD·U4_PRESS·U4_WHEEL·U4_WHEEL_N·U5_LIFT·U5_WHEEL·U5_WHEEL_F, 근처 유닛은 U1·U2·U8이다.
관련 조인트는 J_U4_PRESS, J_U4_WHEEL_ROT, J_U5_X, J_U5_LIFT, J_U5_WHEEL_ROT이다. 4절 리지드 확인에서는 J_U3_PRESSER·J_U3_NEEDLE도 움직였다.
실측: U5X 구동(HG-KR23_M03X·PGX M03X·P_M03_DRV_BRKT·아이들러·벨트)은 J_U5_X 690에서 bbox가 같다. 즉 고정이다. 대차 쪽(P_M03_FRONT·LIFT_TOP)은 +690 움직였다.

## 2. 과제 범위 동작 검사 (inspect.clearance, clearance 0, skip_within null)
| 자세 | bodies / against | 겹침 | unchecked(의도된 맞물림) |
|---|---|---|---|
| REST 전체 | 101 / 163(바뀜·새로 + 이웃) | 0 | 66쌍: 볼트↔탭, 핀↔부시, 모터 축·파일럿↔PGX 입력·어댑터, PGX 내부 부품. 모두 나사·끼움이다 |
| J_U4_PRESS −1.867·0.756·3.38·6.0(8.626 = REST) | U4 움직이는 22 / 고정 24 | 0 | 피벗 핀↔MPFZ(끼움) |
| (J_U5_X, J_U5_LIFT) = (0,−10)(0,10)(345,0)(690,−10)(1035,20)(1380,−10)(1380,30). J_U4_PRESS −1.867 | U5 승강·대차 19 / 고정·U4·U5X·보·테이블 34 | 0 | 센서 브래킷↔옆면 볼트(구멍 안 0.012 mm 다각형 오차) |
| J_U4·U5_WHEEL_ROT 37·90·180·270° | 도는 쪽 10(바퀴·출력축·키·허브 볼트·트레드) / 고정 31 | 0 | 없음 |

- 키 PGX62-H-10_M02_KEY는 회전마다 축 둘레 r 7.5 위에 있다(중심 Z 63.8 기준 ±7.5). 바퀴와 같이 돈다(M-07).
- 움직인 자세에서 P_M03_FRONT는 shells 1이고 부피 34,587.2로 REST와 같다. MT-07 고침이 유지된다.
- 작업 대상: 바뀐 부품 가운데 작업 대상 길에 닿는 것은 U3_LOWER_DRIVE 묶음뿐이다(Z −200~−50). 매트 모형은 Z 0~12라 통로를 막지 않는다. 모형을 넣은 CAD 검사는 생략했다(서명 bbox 판정).
- 관(U8_PNEU TU0604_M08S_U5_A·B)은 고정 스플라인으로 그려져 있다. 대차 X 행정과의 관계는 기존 기준선이라 이번 범위 밖이다.

## 3. 새로 넣거나 옮긴 볼트 (M-01)
탐침: 머리 자리에서 머리 바깥쪽 축 방향으로 원통을 세웠다. 길이 30, 지름은 머리 지름 − 0.2(M5 8.3, M4 6.8, SFB5 9.8)다. 위치·축은 `tools/out/mech_MOT-01/bolts_changed.json`(REST)에서 가져왔다. against는 1절 163바디다. 탐침 49개, 결과는 아래와 같다.

| 볼트 | 결과 | 판정 |
|---|---|---|
| CB5-16_M02_MOT:5·7(감속기→앞판) | 끝 29.7 mm에서 PGX62-H-10_M02_BUSH와 0.049 mm³ | 빈 길 29.7 ≥ L+5 = 21 → 통과 |
| SFB5-12_M03_IDL | 보 P_M07_BEAM 면 Y 120과 머리 윗면 Y 118 사이 2.0 mm. 보 면은 축 위 (−390, 120, 390)에서 막혀 있다(clearance near) | **막힘 → 디테일 D1** |
| CB4-12_M02_CLV | 머리(Y 21.5)에서 +Y 20.5 mm에 에어관 TU0604_M08_U4C_B(Y 42~48)가 지나간다. Ø3 육각 탐침과 20.5 mm³ 겹친다 | 20.5 ≥ L+5 = 17 → 통과. 관은 손으로 비킨다(기록) |
| 나머지 46자리(모터→어댑터 ×12, U5X 감속기→브래킷 4, U3 모터 4, U3 브래킷 4, 허브 2, 피벗 머리 2·끝 1, 너클 1, 아이들러 바깥 1, 앞판 옆면 8, 감속기→앞판 나머지 6) | 겹침 0. unchecked는 자기 볼트뿐이다 | 통과 |

- 물림·상대 탭: 모델링부 3절·완료 판정 감사 1절의 수치(M5 8~10 ≥ 7.5, M4 7·10 ≥ 6)를 그대로 쓴다. CAD에서 볼트↔탭 쌍은 모두 'unchecked(나사 맞물림)'로 나왔다. 상대 바디가 실제로 있다는 뜻이다. 빈 구멍 0.
- 예외 기록: CB5-16_U3_BRKT 물림은 T너트 두께 5다(디테일 MT-D2, 모델링부 기록, 이번 범위의 새 판정 아님).
- 포트 공간(M-06): 새 공압 포트 없음. 판금(M-04): 새 판금 없음.

## 4. 리지드 그룹(E-11)
occurrence 46개(볼트 사본 38 + T너트 4 + 피벗 볼트 2 + 참조 6)의 무게중심을 두 자세에서 쟀다. REST와 (J_U4_PRESS −1.867, J_U5_X 690, J_U5_LIFT −10, J_U3_PRESSER −4, J_U3_NEEDLE −36)이다.
- U4 모터·감속기 볼트 8: 16.28·30.25 mm 움직였고, HG-KR23_M02·PGX62-H-10_M02와의 거리 변화는 0.0000이다.
- U5W 볼트 8: 691.16 mm 움직였고 거리 변화는 0.0000이다.
- U5X 볼트 8, U3 모터·브래킷 볼트·T너트 12, 피벗 머리 볼트 2: 움직이지 않았다. 고정부와 같다.
- 누락 0.

## 5. 문제
| kind | 무엇 | 어디 | 수치 | 고치는 법 |
|---|---|---|---|---|
| 디테일(완료 판정 '체결 공구 닿음' 미달) | 아이들러 안쪽 접시 볼트의 완성 상태 렌치 접근이 막힌다 | SFB5-12_M03_IDL ↔ P_M07_BEAM, (X −390, Z 390) | 머리 윗면–보 면 2.0 mm < L+5 = 17 | 권장안: 안쪽 SFB5-12_M03_IDL과 P_M03_IDLER_WASHER_I를 없앤다. P_M03_IDLER_SHAFT 끝 Y 112~115를 Ø20 턱으로 일체로 깎아 풀리 안쪽 받침으로 쓰고, 바깥 CB5-12_M03_IDL 하나로 축을 브래킷 벽에 당긴다. 보와의 틈은 5.0을 그대로 둔다. 대안: P_M07_BEAM의 (X −390, Z 390)에 Ø8 공구 구멍을 Y 120부터 관통으로 뚫는다 |

## 6. 판정 기억
허용으로 판정한 겹침이 없다(겹침 0, unchecked는 나사·끼움). 그래서 `paircache.py judge`는 하지 않았다.

## 7. 등급
M이 맞다. 새 구매품 7개는 과제 정리 때 이미 셌고, 새 조인트·동작 연구는 없다.

## 시간
- 약 28분(예상 검도 M 30분). CAD 호출 약 30(MCP), 설계 파일 열기 1(가장 긴 열기 약 30 s 안). 브라우저 0. 앱 재시작 0.
- 오래 걸린 곳: REST 전체 clearance가 717 s 걸렸다(101 × 163, 나사 쌍의 boolean 실패 재시도). 탐침 clearance는 177 s다.

## 워크플로우 메모
- `edit.checkpoint` id는 batch마다 새로 쌓이고 16개만 남는다. 묶음을 여러 번 보낸 뒤에는 처음 checkpoint로 되돌아갈 수 없었다(41·48 모두 'no checkpoint'). 검도부 탐침은 `timeline.delete {features:[…]}` 한 번으로 지웠다(51개, 빠름).
- `motion.play`의 결과는 위치·조인트 전부라 1.2 MB 넘게 나온다. 읽기 부서는 `joint.drive`로 자세를 잡고, `motion.play`는 마지막 한 번만 쓰는 편이 낫다.
- 같은 이름 사본 볼트는 `inspect.clearance`에 이름으로 주면 :1만 잰다. 사본별 확인은 `occurrence.properties {occurrence: "<이름>:n"}`로 했다.
- 결과 파일: `tools/out/MOT-01_verify/`(lists.json, batch*.txt, occ_raw.json).
