hyeunung/FSAP/docs/reports/mechanism/mech_MOT-01_measure.md

# MOT-01 측정 — 모터·감속기 체결 빠짐 + C-36 실물 교체 (측정부, 2026-11-09)

## 요약 (10줄)
- 대상 `3D_Modeling/FSAP_v2.6.8.sc`(config doc). 서명 `sigcheck` = reuse(문서·해시 같음, 2,666바디) → bbox·부피는 `tools/out/signatures.json` 그대로, 과제 자리만 새로 잼.
- 판정 **already_ok = false**: STEP대기_MHMF022L1U2M ×3·MHMF042L1U2M(차지 상자 U3_LOWER_DRIVE)·VRXF-PB-60-10 ×3 그대로, 모터↔감속기 체결 볼트 0개(3자리 × 4 = 12개 빠짐), 바퀴↔감속기 축 고정 0.
- 실물 STEP을 지금 자리(같은 축·출력면)에 임시로 넣어 잼(MCP, 끝나고 체크포인트 원복): **U4·U5W에서 PGX62 모터 어댑터 □64가 팔 옆판 안폭 62(Y ±31)에 양쪽 1 mm 먹힘**(커널 불리언 실패로 부피 미확정, 어림 약 1,300 mm³/쪽), 감속기 몸 □62는 옆판에 맞닿음(틈 0).
- PGX62 출력 파일럿 Ø50 × **7**인데 앞판(P_M02_FRONT·P_M03_FRONT) 자리파기 깊이 **3** → 4 mm 먹힘. 출력축 밑동 Ø19.8 > 앞판 구멍 Ø18.
- PGX62 출력 플랜지 구멍은 **Ø5.5 관통(탭 아님)**, 자리파기는 모터 쪽 → 지금 CB5-20(바퀴 쪽 머리, 감속기 탭에 물리는 방식)은 물릴 나사가 없다(빈 구멍).
- 출력 키 5×5×20이 바퀴 허브(P_M02_WHEEL·P_M03_WHEEL)와 195 mm³ 겹침(허브에 키홈 없음). U5X는 풀리 N16 허브와 맞닿음만(겹침 0), 출력축 끝 Y 122가 P_M07_BEAM(Y 120~)에 2 mm 들어감(불리언 실패, 어림 ≤ 400 mm³).
- 모터 HG-KR23은 세 자리 모두 겹침 0(가장 가까운 틈 0.97 mm: 팔 옆판·ARM_TIE·LIFT_SIDE). 전체 길이(모터 뒤 ~ 출력축 끝)는 지금과 +0.6~+1.6 mm.
- U3 아랫축 HG-KR43은 들어갈 실물 구동계가 없다(U3_LOWER_DRIVE 460×120×140 차지 상자 하나뿐) — 배치 자체가 새 구상.
- 그 밖 구동기 체결: 실린더 5종·벨트 클램프·풀리 멈춤나사는 있음. 빠짐 후보: U5 아이들러 축(P_M03_IDLER_SHAFT) 고정·베어링 멈춤, U4 실린더 CDM2C20 클레비스·너클 핀(핀 바디 이름 없음, 확인 필요).
- 구매품 표 `tools/out/mech_MOT-01/purchased_parts.json`, 이웃 표 `neighbors.json`·`against.json`, STEP 면 `pgx_faces_out.json`.

## 0. 측정 표·통로
- `ledger.py sigcheck` → `{"mode": "reuse", "reason": "문서·해시가 같다", "parts": 2666}` (E-17 "측정 표는 서명을 다시 쓴다").
- 통로: MCP(앱 켜짐, `running` 빈 목록 확인) → `open` 저장본 1회, 읽기만. 편집 전 `edit.checkpoint` 29, 끝에 `edit.restore_checkpoint` 29 + `motion.play {REST, step 0}`, `inspect_design` dirty=false·PROBE 바디 0 확인. 저장 안 함.
- STEP 외형은 MCP `open`(STEP 3개, 설계 열기 전)과 CLI `eval/run`(PGX 면 목록)으로 잼.

## 1. 대상 부품·구동 요소 (REST, 세계 좌표 mm)

| 유닛 | 바디 | bbox [x0,x1,y0,y1,z0,z1] | 부피 mm³ | 지금 체결 | 축 방향·출력면 |
|---|---|---|---|---|---|
| U3 | U3_LOWER_DRIVE (차지 상자) | [40, 500, −60, 60, −200, −60] | 7,728,000 | 없음 | 정해지지 않음. 이웃은 STEP대기_867-392342_LOWER뿐 |
| U4 (U4_PRESS, J_U4_PRESS −1.867~8.626°, 대기 8.626) | STEP대기_VRXF-PB-60-10 | [−212.6, −98.1, −30, 30, 54.3, 124.9] | 278,543 | 앞판에 CB5-20_M02_1~4(PCD 70, 머리 바퀴 쪽) | 축 a = (0.98869, 0, 0.14998), 출력면 중심 (−133.90, 0, 95.20), 몸 75, 파일럿 Ø50×3, 축 Ø16×35 |
| U4 | STEP대기_MHMF022L1U2M | [−291.6, −177.6, −30, 30, 42.3, 113.6] | 290,851 | **0**(CB5-16_M02_9·10은 ARM_TIE↔옆판) | 모터면 (−208.05, 0, 83.95), 몸 80, 축 Ø11×30 |
| U5_LIFT (J_U5_X 0~1380, J_U5_LIFT −10~30) | STEP대기_VRXF-PB-60-10_U5W | [−1907, −1797, −30, 30, 70, 130] | 278,543 | 앞판에 CB5-20_M03_5~8 | +X, 출력면 X −1832 (y 0, z 100) |
| U5_LIFT | STEP대기_MHMF022L1U2M_U5W | [−1987, −1877, −30, 30, 70, 130] | 290,851 | **0** | |
| U5_WHEEL_F (대차 X 구동) | STEP대기_VRXF-PB-60-10_U5X | [−2250, −2190, 11, 117, 360, 420] | 277,739 | P_M03_DRV_BRKT에 CB5-20_M03_1~4 | +Y, 출력면 Y 86 (x −2220, z 390), 풀리 HTPA60S5M150-A-N16 |
| U5_WHEEL_F | STEP대기_MHMF022L1U2M_U5X | [−2250, −2190, −69, 41, 360, 420] | 290,851 | **0** | |

받침 판: P_M02_FRONT(SUS304 t12, 구멍 4×Ø5.5 PCD 70, 가운데 Ø18, 감속기 쪽 자리파기 Ø50×3, 옆면 M5 탭 4 → CB5-16_M02_5~8로 옆판), P_M03_FRONT(같은 형식, CB5-16_M03_9~12), P_M03_DRV_BRKT(CB5-16_M03_1~4로 보). 팔 옆판 P_M02_ARM_SIDE_N/P·P_M03_LIFT_SIDE_N/P 안면 Y ±31.

구매품 길이(WF-128): 임시 상자는 부피÷단면으로 확인 — MHMF 290,851/3,600 = 80.8(몸 80 + 축), VRXF 278,543/3,600 = 77.4(몸 75 + 축). 실물은 `purchased_parts.json`.

### 실물 교체 치수 비교 (축 방향, 출력면 = 0)

| 항목 | 지금(임시) | 실물(C-36) | 차이 |
|---|---|---|---|
| 감속기 단면 | □60 | 몸 □62, 어댑터 □64(모서리 Ø80) | +2 / +4 |
| 출력 파일럿 | Ø50 × 3 | Ø50 × 7 | +4 |
| 출력축 | Ø16 × 35 | Ø16(밑동 Ø19.8) × 36, 키 5×5×20 | +1, 키 생김 |
| 출력 플랜지 볼트 구멍 | M5 탭(감속기 쪽) | Ø5.5 관통, 플랜지 8, 모터 쪽 Ø10 자리파기 | 탭 없음 |
| 모터 장착면 | −75 | −79 | −4 |
| 모터 뒤끝 | −155 | −155.6 | −0.6 |
| 모터 단면 | □60 | □60 + 커넥터 쪽 8.8 | 한쪽 +8.8 |
| 모터↔어댑터 볼트 | 없음 | 4 × M5, PCD 70, 어댑터 탭 깊이 약 11 | 넣어야 함 |
| 어댑터↔감속기 볼트 | — | M5 × 4 STEP에 포함 | — |
| 입력 클램프 공구 | — | 옆 플러그 PT1/8 × 2 (r 28.3) | 옆 공구 길 |

## 2. 통로·이웃 (실물 STEP을 지금 축·출력면에 임시로 넣어 `inspect.clearance` 2 mm/3 mm, REST)

넣은 자리: U4 감속기 행렬 원점 (−133.9, 0, 95.2), 모터 (−212.0, 0, 83.35), 로컬 Y → (−0.15, 0, 0.989)(커넥터 아래쪽). U5W 감속기 (−1832, 0, 100) 모터 (−1911, 0, 100), 커넥터 +Z. U5X 감속기 (−2220, 86, 390) 모터 (−2220, 7, 390), 커넥터 −Z.

| 자리 | 실물 바디 | 이웃 | 결과 |
|---|---|---|---|
| U4 | 감속기 몸 □62 | P_M02_ARM_SIDE_N/P | 맞닿음 0.0 (겹침 0) |
| U4 | 어댑터 □64·PT 플러그 | ARM_SIDE_N/P | **먹힘 1 mm/쪽**, 불리언 실패(unchecked) — 어림 1 × 25.5 × ≈55 ≈ 1,400 mm³/쪽 |
| U4 | 파일럿·KSB 링 | P_M02_FRONT | **4 mm 먹힘**(자리파기 3, 파일럿 7), unchecked(같은 지름 원통) — 어림 4 × π(25²−17.5²) ≈ 4,000 mm³ |
| U4 | 출력축 밑동 Ø19.8 | P_M02_FRONT 구멍 Ø18 | unchecked, 먹힘 추정 |
| U4 | 키 5×5×20 | P_M02_WHEEL | **195.4 mm³** ×2(중복 바디) |
| U4 | 출력 플랜지 구멍 | CB5-20_M02_1~4 | 0.25 (구멍 Ø5.5 안 볼트 Ø5) — 볼트가 관통 구멍만 지나 물림 없음 |
| U4 | HG-KR23 | ARM_TIE·ARM_SIDE | 0.97 (겹침 0) |
| U5W | 감속기 몸 | P_M03_LIFT_SIDE_N/P | 맞닿음 0.0 |
| U5W | 어댑터 □64·PT 플러그 | LIFT_SIDE_N/P | **먹힘 1 mm/쪽**, unchecked |
| U5W | 파일럿·축 | P_M03_FRONT | unchecked(U4와 같은 형식) |
| U5W | 키 | P_M03_WHEEL | **195.4 mm³** |
| U5W | HG-KR23 (2) | LIFT_SIDE | 0.97 |
| U5X | 감속기 몸 | P_M03_DRV_BRKT | 맞닿음 0.0, 겹침 0 |
| U5X | 축·키 | HTPA N16 허브·멈춤나사 | 맞닿음 0 / 0.0025 / 0.30 (겹침 0) |
| U5X | 출력축 끝 Y 122 | P_M07_BEAM (Y 120~) | unchecked, **2 mm 들어감** 추정(키는 2.0 mm 틈) |
| U5X | CB5-20_M03_1~4 | 감속기 몸 | 0.25 — 머리 자리 Y 75, 실물 자리파기 바닥 Y 78 → 머리가 3 mm 떠 있음(볼트 길이·자리 다시) |
| U5X | HG-KR23 (3) | 이웃 없음(3 mm 안) | 겹침 0 |

이웃 가동 범위: U4 모터는 U4_PRESS와 같이 돈다(축 (−300, 0, 70), −Y). 실물 모터 최저점은 REST Z 35.3(X ≈ −279, 축 뒤쪽 커넥터). J_U4_PRESS 최소 −1.867°(10.49° 내림)에서 손계산 Z ≈ 32.1 → 매트 윗면(두께 6~16, 요구서 C-34 값 = 두께 − 10 범위) 위로 ≥ 16. U5 두 자리는 대차·승강과 함께 움직이는 묶음 안이라 상대 위치가 변하지 않는다. 새 조인트·동작 연구 없음(과제 등급 M, E-18).

## 3. 작업 대상
- 매트 3장(WP_MAT_L/S/G)은 REST에서 로딩 자리(−Y 300). 모터·감속기는 매트 위 공간에만 있고, 바뀐 외형 중 매트 쪽으로 내려오는 것은 U4 모터 커넥터(위 Z 32.1 이상)뿐. 떨어지는 조각 없음(이 과제는 가공 없음).

## 4. 관련 결정·기각 요약(같은 실수 막기)
- C-36: MSMF(미스미 CAD 꺼짐), SGM7J(2D만·주문 정지), 니덱 VRL(CAD 없음) 기각 → HG-KR + ATG PGX-H. **HG-KR 실물은 키 축(K) 주문, STEP은 기본 축**. **PGX62-H-1 STEP은 1단 공통 외형, 모터 쪽 어댑터는 발주 때 모터에 맞춰 가공** — 어댑터 탭·클램프 지름은 모델에서 그대로 쓰되 BOM에 '모터 HG-KR23용 가공' 표기.
- C-03: 매트 영구 눌림 금지 — 바퀴 축 체결을 바꿔도 바퀴 외형·누름 하중은 그대로 둘 것.
- 실행 규칙 14: 커버·가드 만들지 않음. 규칙 18: 바깥 형번은 쓰이는 것만.
- 관성비·토크·회전수는 FUNC-01 ③(이 과제 판정 아님).

## 5. 이미 되는지 판정 — **아니다(already_ok = false)**

| 완료 판정 항목 | 지금 수치 |
|---|---|
| STEP대기_MHMF022L1U2M·MHMF042L1U2M·VRXF-PB-60-10 바디 0 | 6바디 + 차지 상자 1 남음 |
| 구동기 체결 빈 구멍·빈 탭 0 | 모터↔감속기 볼트 0/12, 바퀴·허브 축 고정 0/2(U4·U5W), 아이들러 축 고정 0 |
| 실물로 바꾸면 과제 범위 간섭 0 | 아니다: 어댑터↔팔 옆판 1 mm/쪽(U4·U5W), 파일럿↔앞판 4 mm, 키↔바퀴 195 mm³, 축 끝↔보 2 mm(U5X) |

### 구상 부서에 넘길 설계 자료(측정에서 나온 것, 결정은 구상이 한다)
1. 팔 옆판 안폭 62 → 어댑터 □64·클램프 공구 플러그(r 28.3) 들어갈 자리: 안폭 ≥ 66(틈 1 이상) 또는 어댑터 구간(축 방향 −53.5~−79) 옆판 따내기. 감속기 몸 □62는 지금 안폭에 틈 0.
2. 앞판 자리파기 3 → 7 이상(판 12에서 5 남음) 또는 판 두께·스페이서. 가운데 구멍 Ø18 → Ø20 이상.
3. 출력 플랜지 볼트: 관통 Ø5.5 + 모터 쪽 자리파기(플랜지 8). 앞판에 M5 탭을 내고 감속기 쪽에서 CB5-16(물림 8, 판 12)로 넣거나, 지금처럼 바퀴 쪽 머리 + 자리파기 안 너트. 볼트 4개 × 3자리.
4. 모터↔어댑터: M5 × 4(PCD 70) × 3자리 + HG-KR43 1자리. 모터 플랜지 두께는 STEP에서 재서 길이 정함(어댑터 탭 깊이 약 11).
5. 바퀴 허브(U4·U5W): 키홈 5 + 멈춤나사 또는 축 끝 볼트·와셔(출력축 끝 탭 유무는 STEP 면에서 확인). U5X는 풀리 N16 멈춤나사 2(STEP에 있음) — 축 끝이 보에 2 mm 들어가므로 감속기를 −Y로 2 이상 물리거나 풀리 위치 조정.
6. U3 HG-KR43: U3_LOWER_DRIVE 차지 상자(X 40~500, Y ±60, Z −200~−60) 안 배치가 없음 — 아랫축 구동 형식(직결·벨트)부터 구상. 모터 외형 □60 × (98.3 + 축 30), 커넥터 8.8.
7. STEP 안 중복 바디(축·키·KSB 링 2벌)는 넣을 때 하나 지워야 정적 겹침이 안 남는다.

## 워크플로우 메모
- PGX62 STEP을 금형 그대로 넣으면 같은 지름 원통(파일럿↔자리파기, 축↔구멍)과 1 mm 먹힘에서 `inspect.clearance` 불리언 실패(unchecked)가 9~10쌍 나와 부피가 안 나온다. 판정은 bbox·면 좌표 손계산으로 했다.
- `insert_step names:"instance"`는 PGX 바디 이름을 'KSB-62-1:1 (n)'으로 몰아 붙여 구분이 안 된다. 기본(auto)이 낫다.

## 시간
- 약 20분, CAD 호출 약 22(MCP), 설계 파일 열기 1(+ STEP 열기 3, CLI STEP 2), 브라우저 0.
