hyeunung/FSAP/docs/reports/mechanism/mech_STEPSWAP_verify.md

# 검도·체결 — STEPSWAP r4 (v2.6.8, IR1000-01BG ×3 실물 교체)

**요약 (10줄 안)**
- 판정: **pass(동작 문제 0), 완료 판정 충족.** 서명 2,666개 중 `STEP대기_IR1000`은 0개이고 BOM v2.6.8에도 0개다. 교체 뒤 과제 범위에서 새 겹침은 0이다.
- 바뀐 부품 30바디: `IR1000-01BG_M08:1~3`(몸·게이지·세트 너트·브래킷), `CB4-12_M08_REG:1~6`, `KQ2L08-01AS_M08R_PX/NX:1~3`, `TU0805_M08T_REG_IN/OUT_1~3`.
- REST에서 30바디를 주변 42바디와 쟀다(서명 bbox 40 mm 안, scope neighbors 37 포함). 결과는 겹침 0, truncated false, 최소 틈 0.61(관 OUT ↔ SS5Y3 매니폴드 끝면)이다. 30바디끼리도 겹침 0이다.
- unchecked 12쌍은 나사 물림이다: CB4-12 ↔ 보 6쌍, KQ2L08 ↔ 레귤레이터 포트 6쌍. M-08 의도로 보고 판정 기억에 12건을 남겼다.
- U8은 고정 유닛이다. 30바디 근처 40 mm 안에 움직이는 유닛은 없다(U7_ROLL_MOUNT는 고정). 작업 대상 모형은 Z 12 아래이고 이 부품들은 Z 300 위라서 작업 대상 길에 닿지 않는다.
- 새 볼트 CB4-12의 렌치 길을 탐침(Ø3.5 × 113.9, −Y 방향, 볼트 2개)으로 봤다. 겹침 0이고 1 mm 안의 근접도 0이다. 다 조립한 상태에서도 육각 렌치 3이 곧게 들어간다. 모델링부는 '몸을 단 채로는 닿지 않는다'고 적었는데, 재 보니 닿는다.
- 리지드 그룹 15개(95114~95116, 95126~95131, 95142~95147)가 모두 U8 occurrence 18에 묶여 있다. `joint.list` 결과는 floating 0, conflicts 0, errors 0이다.
- 디테일은 지난 회차에서 넘어온 SW4-D1(출구 관 굽힘 R 6.25 < 20)과 SW4-D2(재질 임시) 둘이다. 이번에 새로 나온 디테일은 0이다. 등급 M이 맞다.

## 0. 범위 (E-17)
`ledger.py scope`의 결과: 전체 검사 아니오, 바뀐 쌍만 예. 바뀜 1, 새로 30, 없어짐 24, 이웃 37. 유닛은 U8_PNEU, near_units는 U1_FRAME, states는 없음.
- 대상은 새 30바디다. against는 서명 bbox를 40 mm 띄워 잡은 42바디다(U8 40, U1 P_M07_BEAM, U7_ROLL_MOUNT P_M06_ROLL_POST). scope neighbors 37이 모두 여기에 들어 있다. 목록은 `tools/out/mech_STEPSWAP/r4/verify_sets.json`에 있다.
- 규칙 근거:
  - E-17 "과제 안 검사는 바뀐 바디·주변을 관련 조인트 몇 점에서만"
  - 안내서 '간섭' "against에 모델 전체를 주지 않는다"
  - 전체 사이클은 돌리지 않았다(E-03: 라운드 끝 전체 회귀가 본다).
- 관련 조인트: U8에는 조인트가 없다. 근처 40 mm 안의 유닛도 고정(U1, U7_ROLL_MOUNT)이라 조인트 점은 REST 하나다. machine.json 기준으로 움직이는 유닛의 자리는 이렇다.
  - U3·U4·U6·U7_TAPE는 X −420~100, Z 300 아래쪽이다.
  - U5는 X ≤ −420이고 Z 70 근처다.
  - 매트 모형은 Z ≤ 12다.
  - 그래서 행정 0·25·50·75·100 % 어느 점에서도 30바디 bbox(X 664~1140, Y 46~130, Z 301~565)와 만나지 않는다.

## 1. 과제 범위 동작 검사 (MCP, 저장본 v2.6.8을 한 번 open)

| 검사 | 대상 ↔ against | 겹침 | 근접(≤ 1 mm) | unchecked |
|---|---|---|---|---|
| inspect.clearance(clearance 1), REST | 30 ↔ 42 | **0**. pairs 334, pruned 926, truncated false, 324 s | 0.0: 브래킷 ↔ 보 앞면 ×3(붙임면, 의도). 0.61: TU0805 OUT_1~3 ↔ SS5Y3 끝면 X 1035(관 끝이 매니폴드 포트에 꽂힘). 0.81: TU0604_M08S_U5_A ↔ REG_IN_1(X 1059.8, 전부터 있던 길) | 6: CB4-12 ↔ P_M07_BEAM(boolean no result, 나사 물림) |
| inspect.clearance(clearance 1), REST | 볼트·관·이음 18 ↔ 레귤레이터 12·이음 6 | **0**. pairs 44, truncated false, 149 s | 0.0: 볼트 머리 ↔ 브래킷 ×6, 관 끝 ↔ 이음 출구 ×6(의도) | 6: KQ2L08 ↔ IR1000 몸(R1/8 나사 ↔ Rc1/8 포트) |

- 대상 통로: 작업 대상 길에 닿는 부품이 아니어서 작업 대상 모형은 넣지 않았다. 빠져야 할 조각은 해당 없다.
- 게이지 시선: 모델링부의 손계산 17.9를 롤 실제 윤곽(U7_TAPE_ROLL bbox X 520~820, Z 600~900, 원 R 150)으로 다시 셈했다. X 700에서 롤 밑은 Z 603.0이고, 시선은 Y −140에서 Z 583.1이다. 틈은 약 19.9다. X 800·900은 롤 밖이거나 롤 밑이 더 높다. 동작 판정 항목은 아니다.

## 2. 이웃 유닛 조인트 점
- 이웃 유닛(U1 P_M07_BEAM, U7_ROLL_MOUNT)은 고정이다. 조인트 점은 REST 하나이고 위 1절과 같다. 이웃 겹침은 0이다.

## 3. 새 볼트·리지드·포트

| 항목 | 결과 |
|---|---|
| M-01 삽입 경로 | 머리 밑면 Y 118 = 브래킷 앞면이다. 열쇠 구멍 홈 위 끝 Z 527.8에 걸린다. 나사부는 Y 118~130이고 보 앞벽 t8 안이다. |
| M-01 완성 상태 렌치 | 탐침 Ø3.5 × 113.9(Y 0 → 113.9, (686 / 714, Z 527.8))를 몸·게이지·너트·브래킷·이음·관 8바디와 쟀다. **겹침 0, 1 mm 안 0.** 볼트 :1·:2를 재고 같은 배치인 :3~:6은 같은 결과로 본다(E-19). 탐침은 undo 2번으로 지웠다(바디 없음을 확인함). |
| M-01 물림·상대 탭 | M4 물림 8 ≥ 1.5d(6). 탭은 보 앞벽이다(탭 구멍을 모델에 그리지 않는 기존 방식). |
| E-11 리지드 | 15그룹 모두 suppressed false이고 U8(18)에 묶여 있다. floating 0, conflicts 0. |
| M-06 포트 피팅 공간 | KQ2L08 엘보 6개가 포트 면에 끼워져 있다. 이웃과 겹침 0이고 관 끝은 맞닿음(0.0)이다. |
| M-04 판금 | 해당 없음(브래킷 P36201023은 구매품) |

## 4. 판정 기억 (안내서 '판정 기억')
키는 `ledger.sig_hash`와 `paircache.py key`로 만들었고 `tools/out/judged.json`(201건)에 기록했다. 스크립트는 `tools/out/mech_STEPSWAP/r4/judge.py`다.
- CB4-12_M08_REG:1~6 ↔ P_M07_BEAM: M4 나사 물림 8, M-08 의도(키 8d035244…, f1085777…, 93da9066…, 334b7c65…, 4cdccc9d…, f26540b6…).
- KQ2L08-01AS_M08R_PX/NX:1~3 ↔ IR1000-01BG_M08_BODY:1~3: R1/8 ↔ Rc1/8 물림(키 5091ef4e…, 06c97c39…, 5e063991…, 58f3b927…, 4ec1cf75…, d9e7a567…).

## 5. 원장
`ledger.py commit --date 2026-11-08`의 결과는 부품 2,666, 통과 항목 50이다(`tools/out/ledger.json`).

## 6. 문제
- 동작 문제: 0
- 디테일(지난 회차에서 넘어온 것, 새로 나온 것 0):
  - SW4-D1: 출구 관 TU0805 굽힘 R 6.25가 최소 R 20보다 작다. 다음 디테일링에서 OUT_1~3의 Y 107.5 가로 구간 앞뒤 직선 길이를 각각 20 이상이 되게 다시 잡아 굽힘 R 20을 넣는다(모델링부 기록 SW4-D1).
  - SW4-D2: 구매품 재질이 임시값이다. 디테일링에서 SMC 질량값으로 맞춘다.
- 등급: M이 맞다. 새 형번 3종은 이미 BOM에 있는 부품의 실물이고, 조인트 변화는 없으며, U8 한 유닛 안의 변경이다.

## 7. 원복
- REST step 0 상태다(conflicts 0, moved false). 탐침 2개는 undo로 지웠다. 저장하지 않았다.
- 첫 batch(edit.checkpoint 포함)의 응답이 연결 시간 초과(10060)로 사라져 checkpoint id를 받지 못했다. 그래서 restore_checkpoint 대신 undo로 원복했다.

## 시간
- 약 20분(1,141 s 시점)이다. CAD 호출 10, 파일 열기 1(MCP), 브라우저 0. 앱 재시작 없음.
- 첫 batch가 약 6분 걸렸다(clearance 324 s). MCP 응답이 끊겼지만 앱은 처리를 끝냈다. `running`으로 확인한 뒤 같은 계산을 다시 받았다.

## 워크플로우 메모
- `inspect.clearance` 30 ↔ 42 한 번이 324 s 걸렸다(긴 3D 관 ↔ STEP 몸). MCP 호출 상한(300 s) 근처라서 첫 batch 응답이 10060으로 끊겼고 checkpoint id도 잃었다. 앞으로는 checkpoint를 따로 부르고 id를 받은 뒤에 긴 검사를 보내는 것이 안전하다.
