hyeunung/FSAP/docs/reports/mechanism/mech_STEPSWAP_verify_v2.6.4.md

# 검도·체결 — STEPSWAP r3 (v2.6.4, CB5-6 ×2 실물 교체)

**요약 (10줄 안)**
- 판정: **pass(동작 문제 0), 완료 판정 충족.** `STEP대기_CB5-6`은 서명 2,649개 중 0개다. 교체 뒤 과제 범위에서 새 겹침은 0이다.
- 바뀐 부품: `CB5-6_M08_PY_LC2F:1·:2`(U8_PNEU, 2E 커튼 금구 볼트). bbox는 임시 형상과 같다(X −2319.25~−2310.75, Y −1566~−1555, Z 95.75~104.25 / 695.75~704.25).
- REST에서 이웃 12바디(scope neighbors 5 + 서명 bbox 40 mm 안 7)를 쟀다: 겹침 0, truncated false. unchecked 2쌍은 볼트 ↔ 2E 금구 M5 탭이다(커널 boolean 실패). 탐침으로 탭 구멍이 있음을 확인했고 M-08 나사 물림으로 보아 판정 기억에 남겼다.
- 움직이는 유닛은 쓸린 bbox로 봤다. U5(X 0~1380, 승강 −10~30)·U3·U4·U6·U7·매트 모형 모두 Y로 1,032 mm 넘게 떨어져 있다. 매트·테이프 모형은 Z 12 아래이고 볼트는 Z 95.75 위라 작업 대상 길에 닿지 않는다.
- 렌치 길(Ø8.5 × 30, −Y) 탐침 2개: 겹침 0. 날개 통과 구멍 탐침 Ø5.5에서 겹침 0이어서 구멍이 있다.
- 리지드 그룹 9282·9283(U8 ↔ 볼트)이 있다. `joint.list`: floating 0, conflicts 0, errors 0.
- 공압 포트(M-06)와 판금(M-04)은 해당 없다. 디테일은 기존 M08R-D1(물림 3 mm) 하나뿐이고 새 디테일은 0이다. 등급 M이 맞다.

## 0. 범위 (E-17)
`ledger.py scope`: 전체 검사 아니오, 바뀐 쌍만 예 — 바뀜 0, 새로 2(CB5-6 :1·:2), 없어짐 2(STEP대기_CB5-6 :1·:2), 이웃 5, 유닛 U8_PNEU, near_units 없음, states 없음.
- 대상: 새로 2바디.
- against: neighbors 5개(F3SG-4RA0800-14_M08_2E, P_M08_LC2F_BRKT_SM_1·_2, STEP대기_F39-LSGF_M08_2E·_2)와 서명 bbox 40 mm 안에 드는 7개(CB5-12_M08_PX :9·:10, HNTT8-5_M08_NX_PZ :9·:10, HNTT8-5_M08_PX_PZ_LC :1·:2, HFS8-4080-1650_M08_FL). 합쳐서 12개다. 모두 U8 고정 바디다.
- 규칙 근거:
  - E-17 "과제 안 검사는 바뀐 바디·주변을 관련 조인트 몇 점에서만"
  - 안내서 '간섭' "against에 모델 전체를 주지 않는다"
  - E-03 전체 사이클은 라운드 끝 전체 회귀가 한 번 돈다(여기서는 돌지 않았다).

## 1. 과제 범위 동작 검사 (MCP, 저장본 v2.6.4를 한 번 open)

| 점 | 대상 | against | 겹침 | unchecked |
|---|---|---|---|---|
| REST(`motion.play REST step 0`) | CB5-6 :1·:2 | 이웃 12 | 0(pairs 6, pruned 18, truncated false, 12.1 s) | 2: STEP대기_F39-LSGF_M08_2E(_2) ↔ CB5-6 — boolean Intersect no result(나사부 ↔ 탭) |

움직이는 조인트는 서명 bbox(REST)에 행정을 더한 쓸린 상자로 걸렀다. 결과는 아래 표와 같다.

| 유닛(조인트) | 쓸린 상자 | 볼트까지 틈(X/Y/Z) |
|---|---|---|
| U5_WHEEL_F·U5_CAR·U5_LIFT(J_U5_X 0~1380, J_U5_LIFT −10~30) | X −2280~1040, Y −95~275 | Y 1,460 이상 |
| U3_HEAD(노루발·바늘) | Y −100~128 | Y 1,455 |
| U4_WHEEL_N(누름 ±) | Y −195~260 | Y 1,360 |
| U6_SHOE·U6_SENSOR | Y −205~−90 | Y 1,350 이상 |
| U7_TAPE·CASSETTE·ROLL_MOUNT(CST_Y 250 포함) | Y −523~130 | Y 1,032 이상 |
| 매트·테이프 모형(평면 X·Y·회전, model_only) | Z 0~12 | Z 83.75 |

어느 점에서도 볼트 근처에 오는 움직이는 바디가 없다. 그래서 조인트 점별 clearance는 필요 없다(E-19 "가장 불리한 하나만", E-17). 모델링부가 REST와 J_U5_X 0·690·1380에서 잰 새 겹침 0과도 맞는다.

## 2. 새로 넣은 볼트 (M-01, E-11, M-06)

탐침은 `edit.checkpoint` 뒤 MCP에서 만들고 clearance를 잰 다음 undo 6번으로 지웠다. checkpoint 97은 다음 호출에서 "no checkpoint 97"로 거부돼 undo로 되돌렸다(워크플로우 메모).

| 확인 | 탐침 | 결과 |
|---|---|---|
| 렌치 접근(완성 상태) | Ø8.5(머리 지름) × 30, 머리 윗면 Y −1566.05에서 −Y, Z 100·700 | 이웃 12와 겹침 0. 육각 렌치(대변 4) 길이 막힘 없음. M08R 검도에서 잰 가장 가까운 것은 CB5-12 머리 2.75 mm다. |
| 삽입 경로(날개 통과 구멍) | Ø5.5 × 2.8, Y −1560.9~−1558.1, Z 100 | P_M08_LC2F_BRKT_SM_1과 겹침 0이어서 구멍이 있다. |
| 상대 탭 | Ø4.2 × 2.8, Y −1557.9~−1555.1, Z 100·700 | STEP대기_F39-LSGF 판과 겹침 0이어서 탭 구멍이 있다. |
| 상대 탭(대조) | Ø8 × 2.8 같은 자리 | 판과 101.9 mm³ 겹침(= π/4·(8²−4.2²)·2.8). 판이 그 자리에 있다. |
| 물림 | — | 3 mm(탭 판 t3, 0.6d). 기존 디테일 M08R-D1(동봉 금구 실물로 다시 볼 것)과 같다. 새 디테일이 아니다. |
| 볼트 끝 ↔ 커튼 몸 | clearance | F3SG-4RA0800-14_M08_2E와 겹침 0. 끝 Y −1555 = 커튼 면이다. |
| 리지드 그룹(E-11) | joint.list | Rigid Group 18:9279(id 9282, 원점 (−2315, −1561, 100))와 18:9281(id 9283, Z 700)이 있다. floating 0, conflicts 0, errors 0, fixed 2. |
| 공압 포트(M-06)·판금(M-04) | — | 해당 없다. |

## 3. 판정 기억 (안내서 '판정 기억')
키는 `ledger.sig_hash`로 만든 부품 서명과 `paircache.py key`로 만들었다. 기록 파일은 `tools/out/judged.json`(189건)이다.
- `1d90219f825c11e0ffe2`: STEP대기_F39-LSGF_M08_2E ↔ CB5-6_M08_PY_LC2F — M5 나사 물림(Ø5 ↔ 탭 Ø4.2 깊이 3, M-08 의도).
- `0ccb7eacb683e6251620`: STEP대기_F39-LSGF_M08_2E_2 ↔ CB5-6_M08_PY_LC2F (…:2) — 같은 이유.
- 2E 금구(F39-LSGF)는 아직 STEP대기다. 실물로 바뀌면 서명이 달라지므로 다시 본다.

## 4. 원장
`ledger.py commit --date 2026-11-04`: 부품 2,649, 통과 항목 24.

## 5. 문제
| kind | 무엇 | 어디 | 수치 | 고치는 법 |
|---|---|---|---|---|
| 디테일(기존, 새 것 아님) | M5 나사 물림이 짧다 | CB5-6_M08_PY_LC2F ×2 ↔ 2E 금구 탭 판 t3 | 물림 3 mm(0.6d) | M08R-D1 그대로. 동봉 금구 실물 치수로 다시 본다. 탭 판이 실제로 t3이면 M5 너트 뒤 체결(CB5-10 + 너트)로 바꾼다. 기록만 한다(E-02). |

## 6. 등급·시간
- 등급 M이 맞다. 이미 정한 형번(CB5-6)을 실물로 바꾼 것뿐이고, 새 구매품·조인트 변화는 없고 바뀐 유닛은 U8 하나다.
- 통로는 MCP다. `running`이 빈 목록이었고 열린 문서는 모델링부가 저장한 v2.6.4였다(metadata 설명이 일치). 저장본 v2.6.4를 open했다(오류 0, 피처 1,999). 저장하지 않았다. 끝에 `motion.play REST step 0`을 했다.
- CAD 호출 약 12회, 파일 열기 1회, 브라우저 0회.
- 앞 회차(r2, v2.5.9) 검도 보고서는 `mech_STEPSWAP_verify_v2.5.9.md`로 옮겼다.

## 워크플로우 메모
- batch 안에서 `edit.checkpoint`가 준 id(97)를 다음 호출의 `edit.restore_checkpoint`가 "no checkpoint 97"로 거부했다. 탐침은 undo(만든 단계 수만큼)로 지웠다. checkpoint 수명이 batch를 넘는지 안내서 '원복'에 적혀 있지 않다.
- `inspect.clearance`의 `threshold` 인자를 줘도 `near`·`nearest`가 비어 나왔다. 가장 가까운 거리가 필요하면 인자 이름을 `describe_command`로 확인한다.
- 볼트 첫 사본의 바디 이름은 `이름 (U8_PNEU:1/이름:1)` 꼴로는 잡히지 않고 이름만으로 잡힌다. 두 번째 사본만 경로 꼴이다(서명 키와 같다).
