hyeunung/FSAP/docs/reports/mechanism/mech_REG-02_verify1.md

# REG-02 검도·체결 수정 1회차 — 장공 볼트 CB5-20·4번 볼트 X 33 (v2.6.7)

## 요약 (10줄)
- 대상: `3D_Modeling/FSAP_v2.6.7.sc`. MCP로 한 번 open(오류 0, 피처 2,054). 저장하지 않았다. 끝에 프로브 피처 8개를 지우고 `motion.play REST 0`을 돌렸다. HGT는 0이다.
- 지난 문제(CB5-16 암나사 전단 SF 1.15): 풀렸다. CB5-20_REG02_1~4 bbox는 Y −105~−80이고 UPPER 면은 −90이라 물림이 10이다. 끝 프로브(Ø4, Y −80~−78.1)는 UPPER와 겹침 0이라 탭 바닥이 볼트 끝보다 깊다. 손계산 SF 1.92는 모델링부 값(`tools/out/mech_REG-02/fix1/bolt_fix1.json`)이고 다시 하지 않았다.
- 지난 검도 미충족 2(B4 렌치가 카세트 핀에 걸림): 풀렸다. B4는 X 28.75~37.25, 핀 MSTH6-20_M05:2는 h +6에서 X 38~58 · Z 303~308.85다. 렌치 프로브 4개는 h −4·0·+6에서 겹침 0이고, 0.5 mm 안으로 가까운 쌍도 0이다.
- 과제 범위 간섭(바뀐·새 19바디와 프로브 4개 × 주변 54바디, clearance 0.5): J_U7_HGT −4·0·+6 × SHIFT 0, 그리고 h 0 × SHIFT −60에서 겹침 0, truncated false.
- GUIDE↔CARR 정적 틈은 −4·0·+6에서 모두 2.0이다(X 12 · Y −107). 예외 판정 REG02-E01이 기준을 "정적 틈 ≥ 2"로 바꿨으므로 충족이다.
- KDM10S·P: −4에서 Z 619~733, +6에서 Z 629~743, Y −167.5~−119.5로 같다. 짝 축 어긋남 0.
- 동작 문제 0, 디테일 0. 완료 판정 항목 6개 모두 충족. 등급 M 맞음.
- 원장 갱신: 부품 2,660, 통과 항목 43.

## 1. 범위 (E-17)
- `ledger.py scope`: 전체 검사 예. 바뀜 1, 새로 6, 없어짐 4, 이웃 9. 유닛은 U3_HEAD, 근처 유닛은 U6·U7·U8.
- 대상(B) 19바디: 판, 스터드·너트 ×4, CB5-20 ×4, 와셔 ×4, BASE, HOLDER. 주변(A) 54바디. 목록은 모델링부 `tools/out/mech_REG-02/fix1/sets.json`과 같다(scope 이웃 9개를 모두 담는다).
- 관련 조인트: J_U7_HGT −4·0·+6(0·40·100 %)과 J_U6_SHIFT 0·−60. 25·50·75 % 점(−1.5·1·3.5)은 모델링부가 쟀고 겹침 0이었다. 검도는 끝점과 0만 다시 쟀다. U6·U7은 한 리지드 묶음이고 UPPER에 대한 상대 이동이 Z 직선이라 끝점이 가장 불리하다(E-19). 이 근거는 지난 검도와 같다.
- 작업 대상 모형: 매트·테이프 길에 닿는 부품은 바뀌지 않아 넣지 않았다.

## 2. 과제 범위 동작 검사 (수치)

| 자세 (HGT, SHIFT) | 검사 | 겹침 | unchecked | 비고 |
|---|---|---|---|---|
| +6, 0 | B 19 × A 54 | 0 (90쌍) | 5 | 맞닿음 0.0: UPPER↔BASE·HOLDER·스터드, BASE↔CARR Z 157, HOLDER↔CST_PLATE·핀 |
| +6, 0 | 프로브 B1~B4 × A 54 + 판·너트·BASE·HOLDER | 0 (16쌍) | 0 | 0.5 안 0 |
| +6, 0 | 끝 프로브 T1~T4 × UPPER | 0 | 0 | 탭 바닥 > 볼트 끝 +1.9 |
| −4, 0 | B 19 + 프로브 4 × A 54 | 0 (102쌍) | 5 | BASE↔CARR Z 147 |
| 0, 0 | 같음 | 0 (102쌍) | 5 | BASE↔CARR Z 151 |
| 0, −60 | U6 쪽 10 × 슈·실린더·센서 12 | 0 (18쌍) | 0 | BASE↔CARR X −89.7 |

- unchecked 5쌍은 UPPER↔CB5-20_REG02_1~4(나사 물림, 의도된 겹침 M-08)와 HOLDER↔CB5-12_M08_PZ_KDM(이번에 안 바꾼 KDM 받침 볼트 물림)이다. 모델링부 결과와 같다. 볼트 1~4가 물림 밖으로 UPPER를 파고드는지는 끝 프로브로 따로 확인했고 겹침 0이었다.
- 기준선 밖 새 겹침(M-08)은 0이다.

## 3. 완료 판정 항목별

| 항목 | 결과 | 수치 |
|---|---|---|
| J_U6_HGT = J_U7_HGT만 가능 | 충족 | 조인트는 J_U7_HGT 하나(−4~+6). 구동하면 판·HOLDER·BASE·스터드가 같이 이동한다(BASE↔CARR Z 147·151·157) |
| −4·0·+6 과제 범위 간섭 0 | 충족 | 2절 |
| GUIDE↔CARR 틈(REG02-E01: 정적 ≥ 2) | 충족 | 2.0 / 2.0 / 2.0 |
| 회귀 자세에서 두 값이 다른 자세 0 | 충족 | 자세 정의는 바뀌지 않았다(181점, J_U6_HGT 키 0, 모델링부 3절) |
| 공통 판 체결 공구 막힘 0 | 충족 | 프로브 4 × 3자세에서 겹침 0, 0.5 안 0. B4↔핀 X 0.75 |
| KDM10 짝 축 어긋남 0 | 충족 | S·P의 Z·Y 범위가 같다 |

## 4. 새로 넣거나 옮긴 볼트 (M-01, E-11, M-06, M-04)
- CB5-20_REG02_1~4: 넣는 길은 −Y 방향이고, 머리 앞(Y < −105)에 프로브 30 mm 길이 동안 막는 것 0. 물림 10(2d)은 UPPER 탭 안에 있다. 상대 탭 깊이는 끝 프로브로 1.9 mm 넘게 남는 것을 확인했다.
- 와셔 REG02_1·2, DC204_2: bbox Y −100~−99. X·Z가 볼트 축과 같다(−70/−32 · 180, 33 · 310). U3_HEAD 쪽이라 HGT를 바꿔도 움직이지 않는다. 판·장공과 겹침 0이다.
- 리지드 그룹(E-11): 구동 결과 conflicts 0, errors 0. 고정될 것(볼트·와셔)과 따라갈 것(판·스터드·너트)이 제대로 움직였다. 빠진 것 0.
- 공압 포트(M-06): 바뀐 부품에 포트 없음. 판금(M-04): 이번 수정은 HOLDER 장공을 X로 옮긴 것뿐이다. 굽힘선 거리는 10.25로 2t 이상이다(모델링부 값).

## 5. 문제
없음. 동작 0, 디테일 0.

## 6. 해석
판·HOLDER 형상이 바뀌었다(장공 X 이동). 해석은 못 했다 — 환경 없음(D-16). 하중 경로는 그대로이고, 손계산은 모델링부 `bolt_fix1.json`을 쓴다.

## 7. 통로·시간
- MCP(앱 --control 27878). `running`은 비어 있었다. open 1회, 바로 열렸다. CAD 호출은 약 9회, 재시작 0.
- J_U7_HGT 한 번 구동에 77~78 s 걸렸다. 그래서 batch 하나에 이 구동을 하나만 넣었다(호출 하나 약 100 s).
- 원복: 시작할 때 `edit.checkpoint`를 47로 찍었다. 그런데 joint.drive가 체크포인트를 밀어내 복원이 안 됐다(16개만 남는다). 그래서 프로브 피처 Cylinder781~788을 `timeline.delete`로 지우고 SHIFT 0과 `motion.play REST 0`(REST는 SHIFT −60, HGT 0)을 돌렸다. 저장은 하지 않았다. 앱 문서는 편집 이력 때문에 dirty일 수 있다. 디스크의 v2.6.7은 그대로다.

## 워크플로우 메모
- 느린 joint.drive(약 78 s)가 체크포인트 여러 개를 쓰는 것으로 보인다. 처음에 찍은 체크포인트가 검사 중에 사라진다. 모델링부(fix1)에서도 같았다. 읽기 부서의 원복을 `edit.restore_checkpoint`에만 기대지 말고, 임시 피처 id를 적어 두었다가 지우는 쪽이 확실하다.
