hyeunung/FSAP/docs/reports/mechanism/mech_M08R_verify.md

# 검도·체결부 — M08R 라이트 커튼 짧게 + 기둥 3개 줄임 (C-32) — FSAP_v2.6.0 (2026-11-06)

**요약**
- 판정: **합격(pass)**. 동작 문제 0. 완료 판정 6항목 모두 만족(completion_met true). 등급 M 맞음.
- 대상: `3D_Modeling/FSAP_v2.6.0.sc`(config doc). MCP로 한 번 open(피처 1,984, 오류 0). 저장하지 않음.
- REST 겹침: 바뀐·새 35바디 vs 이웃 57 → 0. 바뀐 것끼리 → CB5-6 ↔ 2E 금구 M5 탭 17.3 mm³ ×2만 남음(나사 물림, 의도). 판정 기억에 남김.
- U5 대차 J_U5_X 0·345·690·1035·1380(0~100 %): 옆 쌍·R 기둥 둘레 겹침 0. 가장 가까움 20.0 mm(R 기둥 ↔ P_M03_DRV_BRKT, 고정물). 움직이는 U5 부품은 모두 그보다 멂.
- 작업 대상(매트 L·S·G와 테이프·이음매) 18자세 vs 커튼 4·기둥 3: 겹침 0. 가장 가까움 172.8 mm(큰 매트 45° 모서리, CYCLE_L 127, TAPE_L ↔ 2R).
- 새 볼트 CB5-6 ×2: 렌치 길(Ø8.5×30, −Y) 막힘 0, 가장 가까움 2.75 mm(옆 CB5-12 머리). 나사 물림 3 mm는 디테일 M08R-D1(기록만).
- 리지드: 새 리지드 조인트 35개(9180~9250)의 occurrence 36개 모두 dof 0. floating 0, conflicts 0.
- 미완: 없음. 외부 요인: F39-LSGF STEP·CB5-6 STEP 아직 없음(STEP대기_, 다음 STEP 재시도). C_RO 표 원문 대조 D-130.

## 0. 통로·시간 (E-04, E-23)
| 항목 | 값 |
|---|---|
| 연결 | `running` 빈 목록 → MCP. 막힘 0, 재시작 0 |
| 열린 문서 | `FSAP_v2.6.0`, dirty false → 저장본 `open {path: FSAP_v2.6.0.sc}`(수 초, 피처 1,984, errors 0) |
| 파일 열기 | 1회. CLI는 쓰지 않음 |
| 큰 결과 | `motion.play`·`joint.drive` 한 번의 응답이 약 1.2 MB다. 22자세 묶음 하나는 연결이 끊겼다(앱은 살아 있었다). 4자세씩 나눠 다시 돌렸다(워크플로우 메모) |
| 원복 | 프로브 원통 2개는 undo 2번으로 지웠다(배치 안 `edit.checkpoint` 57은 배치 뒤 restore가 "no checkpoint"로 거부됨). 끝 자세는 `motion.play REST 0`. 저장 안 함 |
| 걸린 시간 | 약 13분 |

## 1. 범위 (E-17)
`ledger.py scope --joints-changed`의 결과: full, 바뀜 12, 새로 25, 없어짐 17, 이웃 42. 유닛은 U8_PNEU, 가까운 유닛은 U1_FRAME·U2_TABLE이다.
- 대상: 바뀜·새로 중 서명에 있는 37개. 그중 세트 안 캡 사본 2개는 이름이 안 풀려(경로 이름 거부) 첫 사본만 쟀다. 그래서 35개다.
- 주변: 서명 bbox ±30 mm 안의 바디로 따로 골랐다. 고정 57개(U1 기둥·보, U2 테이블 형재·판, U8 다른 금구·볼트·너트·캡)와 U5 고정 2개(P_M03_DRV_BRKT, HTBO 벨트 감김)다. U1 T너트 HNTT8-5_M07_PX_PZ:11·:12는 이름이 안 풀려 뺐다. 볼트 자리 너트라 커튼·기둥과 무관하다.
- 관련 조인트:
  - J_U5_X(조인트 48): 이웃 가동 유닛 U5가 옆 쌍·R 기둥 옆을 지난다.
  - 작업 대상 조인트 J_WP_*: 커튼이 로딩 면 가장자리에 있다.
- 다른 조인트는 보지 않았다(U3·U4·U6·U7·J_U5_LIFT·바퀴 회전). 이 조인트들이 움직이는 바디는 X −2045 이상, Y −95 이상에 있어 바뀐 부품에서 250 mm 넘게 떨어져 있다. 승강·회전은 그 거리를 줄이지 않는다.
- 전체 사이클은 돌지 않았다. 라운드 끝 전체 회귀가 본다.

## 2. 과제 범위 동작 검사 (E-03)
| 검사 | 범위 | 결과 |
|---|---|---|
| A REST 바뀐 vs 주변 | 35 vs 59, clearance 2 | overlaps 0, pairs 45, truncated false. 0.0 맞닿음 28쌍은 모두 붙임면이다(금구·L판·T너트 ↔ 기둥 T홈면, R 기둥 ↔ M07 기둥·보, 금구 ↔ 볼트 머리). unchecked 3: 기둥 ↔ 아래 캡(핀 ↔ 구멍, 전과 같음) |
| B REST 바뀐끼리 | 35 vs 35 | overlaps 2: STEP대기_F39-LSGF_M08_2E ↔ STEP대기_CB5-6:1, _2E_2 ↔ CB5-6:2, 각 17.34 mm³(Ø5 ↔ Ø4.2 탭, Y −1558~−1555). 나사 물림이라 허용(M-08 기준선)하고 판정 기억 2건을 남겼다. 커튼 몸 ↔ 기둥은 X −2260·360, Y 40 면 맞닿음 0.0이다(겹침 아님). 꽂이 ↔ 기둥은 3.8 / 3.5 mm, 2E 꽂이 ↔ 몸은 10.0 mm. unchecked 7: 위 캡 핀 3, 볼트 ↔ T너트 나사 4 |
| C U5 대차 X | J_U5_X 0·345·690·1035·1380 / 옆 15바디 vs U5 바디 X < −1500 82(뒤 4점은 고정·큰 31) | 다섯 점 모두 overlaps 0, near(10 mm 안) 0. 가장 가까움: R 기둥 ↔ P_M03_DRV_BRKT 20.0(고정), 2R ↔ STEP대기_VRXF 감속기 45.0(고정). 대차는 +X로만 멀어진다 |
| D 작업 대상 | 매트·테이프·이음매 3바디 vs 커튼 4·기둥 3, clearance 20 | 18자세 모두 겹침 0. 자세: CYCLE_L 12·50·100·115·121·124·127·130·133·140·150·160·172·668, CYCLE_S 67, CYCLE_G1 133·300, CYCLE_G2 75·315 + REST |
| D 가장 가까움 | 큰 매트 45° 모서리 둘레 | 121: 215.7, 124: 180.2, **127: 172.8**, 130: 212.4. 테이프 L ↔ 2R·R 기둥이다. 커튼이 v2.5.9보다 +X·−Y로 5 mm 나왔지만 여유가 크다 |
| D 다른 매트 | 작은 매트, 홈 매트 | 작은 매트 ≥ 1,463.9, 홈 매트 ≥ 596.7 |
| 통로·빠짐 | — | 떨어지는 조각 없음(machine.json fragments). 매트가 지나는 길에 새 바디 없음 |

## 3. 이웃 유닛 조인트 점의 겹침
2절 C(U5)와 D(작업 대상)가 이웃 가동 조인트의 전부다. 겹침 0.

## 4. 새로 넣거나 옮긴 볼트 (M-01, E-11, M-06)
| 체결 | 삽입·렌치 | 물림·상대 탭 | 리지드 |
|---|---|---|---|
| STEP대기_CB5-6 ×2(새, 2E 금구) | 머리 앞 −Y로 Ø8.5×30 원통 프로브를 대 봤다(Z 100·700). 겹침 0이다. 가장 가까운 것은 CB5-12_PX:9·:10 머리 2.75 mm, LC2F 판 5.1 mm다. 육각 렌치(4)는 머리 지름 안에 들어간다 | 상대 탭은 금구 임시 판 M5(t3)다. 물림 3 mm = 0.6d < 1d로 **디테일**(M08R-D1, 기록만 E-02). 끝 Y −1555 = 커튼 면, 겹침 0 | U8 리지드(9245·9246) dof 0 |
| CB5-12 ×4 + HNTT8-5 ×4(위 금구, Z −700 옮김) | 방향 그대로 Z만 내렸다. 위가 기둥 끝(805~810)까지 비어 있다 | 아래 자리와 같은 T홈 물림(평행 이동) | 9227~9237 dof 0 |

- 리지드 누락(E-11): 9150~9260 리지드 35개 occurrence 36 dof 0, 억제 0이다. joint.list floating 0, conflicts 0, errors 0.
- 공압 포트(M-06): 이번에 바뀐 공압 부품은 없다. 해당 없음.

## 5. 판금 (M-04)
- P_M08_LC2F_BRKT_SM_2는 형상 그대로 Z만 옮겼다. 새 판금이 아니라 보지 않는다.
- STEP대기_F39-LSGF는 구매품 임시 형상이라 해당 없다.

## 6. 완료 판정 대조
| 항목 | 결과 |
|---|---|
| F3SG-4RA0800-14 실물 STEP 4개(앞·옆 2쌍) | 만족. 몸 1E·1R·2E·2R(882,602·882,594 mm³)이 STEP 세트 2개에서 왔다 |
| 기둥 위끝 ≤ 커튼 위끝 + 캡 | 만족. FL 810, 캡 807~818(커튼 위끝 818). FR·R 805, 캡 802~813 ≤ 818. 길이 1650·1175는 25 간격, 열린 끝에 캡 있음(U-19) |
| 금구 실물 또는 형번 정한 STEP대기_ | 만족. `STEP대기_F39-LSGF_M08_*` ×8(형번 F39-LSGF, D-135) |
| ISO 13855 C_RO 손계산·판정 결정로그 | 만족. M08R-S1·S2·S3. 옆 쌍 체인 팔 불성립은 외장 X-04 |
| 검출면이 로딩 면을 덮음 유지 | 만족(실측). 앞 렌즈면은 X −2225~325, 테이블 앞 끝은 X −2175~330이고 +X 5 mm는 수광 몸이 막는다. 옆 렌즈면은 Y −1520~5다. 높이는 검출 Z −6~794 ⊃ 매트 Z 0~10 |
| 과제 범위 간섭 0 | 만족. 남은 겹침은 의도한 나사 물림 2건뿐 |

## 7. 등급 (E-18)
등급 M이 맞다. 구매품 교체(커튼·금구·볼트 1종)와 형재 3개 길이 변경이고, 새 조인트·새 구동 유닛은 없다. 바뀐 유닛은 U8 하나다.

## 8. 문제
| kind | 무엇 | 어디 | 수치 | 고치는 방법 |
|---|---|---|---|---|
| 디테일 | 나사 물림 부족 | STEP대기_CB5-6_M08_PY_LC2F:1·:2 → 2E 금구 M5 탭 판 t3 | 물림 3 mm = 0.6d(권장 ≥ 1d 5 mm, 알루미늄·얇은 판은 1.5d) | F39-LSGF 실물 외형이 오면 다시 본다. 판이 t3 그대로면 너트 붙임(CB5-10 + 너트 M5, 판 뒤 Y −1555 쪽에 커튼 몸과 0.64 mm라 너트 자리 없음 → 금구 탭 판을 t5로 키우거나, 볼트 방향을 바꿔 판 쪽에서 L 날개로 체결) |
| 디테일(외부) | 형번이 정해졌는데 STEP대기_로 남음 | STEP대기_F39-LSGF ×8, STEP대기_CB5-6 ×2 | — | 다음 STEP 재시도: 미스미 CB5-6, Omron F39-LSGF(Omron CAD) |

## 9. 원장·판정 기억
- `ledger.py commit --date 2026-11-04`: 부품 2,657, 통과 항목 14.
- 판정 기억: `paircache judge` 2건(a0f64f05eb60d332dfbc, 9d105360a093aa643a4f). 근거는 M5 나사 물림이다.

## 산출물
- `tools/out/mech_M08R/verify/`: scope.txt, sets.json(대상·주변), wp_*_sum.json(작업 대상 자세별), jl.json(joint.list), judge.py, build_sets.py

## 워크플로우 메모
- 읽기 부서가 MCP `batch`로 `motion.play`·`joint.drive`를 여러 번 부르면 단계마다 위치·조인트 전부를 돌려준다(한 번 약 1.2 MB). 22번 묶음은 응답 약 26 MB로 MCP 연결이 끊겼다. 4번씩 나누면 됐다. 위치 출력을 끄는 인자가 있으면 좋겠다.
- `batch` 안의 `edit.checkpoint`는 배치 뒤 `edit.restore_checkpoint`로 찾을 수 없었다("no checkpoint 57"). 프로브는 undo로 지웠다. 체크포인트는 `execute`로 따로 부르는 것이 안전하다.
- 서명 키 가운데 중첩 경로 이름(`…:1/9157/9159`, `U1_FRAME:1/HNTT8-5_M07_PX_PZ:11`)은 `inspect.clearance` 이름으로 풀리지 않았다. 서명 키와 CAD 바디 이름의 규칙이 다르다.
