hyeunung/FSAP/docs/benchmark.md

# 벤치마크·특허 조사

- 조사일 2026-10-30. 공개 웹 자료만 봤다. 회사에 문의하거나 카탈로그를 받은 것은 없다.
- 결정에 쓴 것은 [결정로그](decision-log.md) C-01·C-02·C-03·C-06.
- **2차 조사(2026-11-03, 개념 재수립용):** [reports/매트 바인딩기 벤치마크 조사.md](../reports/매트%20바인딩기%20벤치마크%20조사.md) — 상용 기계(R375X·R375A·Richpeace·Van de Wiele TITAN), Durkopp 867 헤드·베드 공식 수치, 특허 22건(권리 상태 표), 자동 이음매(접어 넣기·열절단·초음파). 노트는 `research_notes/매트 바인딩기 벤치마크 조사/`. 0-8 개념은 이 2차 조사를 기준으로 세운다.

## 1. RI.MA.C. R375X (벤치마크, C-01)

이탈리아 Cerano의 Ri.Ma.C. SRL. "New generation for car mat binding". https://www.rimac.it/en/products/r375x/

| 항목 | 공개 내용 |
|---|---|
| 동작 | 외곽 판독(profile reading)과 매트 자동 회전을 함께 쓴다. 재봉 헤드 구조를 고쳐 매트가 헤드 밑을 지나며 자유롭게 움직이고, 회전 공간이 늘었다 |
| 헤드 | 이동 여부는 적혀 있지 않다. 설명으로는 고정 |
| 구성 | 개조 재봉 헤드, 새 공급 유닛, 새 테이프 커팅 유닛, 형상 인식, 자동 회전, 터치스크린 |
| 옵션 | 테이프 열절단(Hot tape cutting): 올이 풀리는 테이프용 |
| 운전 | 작업자가 수동으로 올리고 시작, 이후 자동. 형상별 프로그램 불필요. 1명이 최대 3대 |
| HMI | 파라미터를 프로그램으로 저장·불러오기 |
| 수치 | 매트 20×30 ~ 120×120 cm(요청 시 150×150), 최대 2000 rpm, 220 V 50/60 Hz, 2000 W, 압축공기 6 bar |
| 공개 안 된 것 | 무게, 외형, 테이프 폭, 땀 길이, 생산량, 센서 종류, **좁은 홈 처리 여부**(D-14). 영상·브로셔 없음 |

### 같은 회사 이전 모델 R375A

https://www.rimac.it/en/products/r375/

- "a particular system of edge reading and car-mat moving". 센서 종류는 밝히지 않음.
- 재봉 헤드 **Durkopp 867-290342를 바인딩용으로 개조**, 2000 rpm.
- 매트 최대 80×60 cm. 220 V, 2000 W, 6 bar.
- 앞좌석 매트 약 45~50초, 뒷좌석 약 35~40초(로딩 제외).
- R375A는 기계 뒤로 자동 배출, R375A-SC는 수동 배출.
- 옵션: 테이프 열절단, Habraken System(누벅 테이프의 장력을 줄여 매트를 평평하게).

### R375X·R375A 제품 사진 판독 (2026-11-03 추가)

1·2차 조사는 두 페이지의 본문 글만 읽었고 사진은 보지 않았다. 사용자 지적("그림으로 읽을 수 있는게 많은데")으로 다시 봤다. 사진은 R375X 6장(전체 `IMG_6142-Copia.jpg`, 상세 `Particolare-1-1`·`particolare-2`·`Particolare-3`·`particolare-4`·`particolare-5`, 2026/04 업로드)과 R375A 5장(전체 `R375-SITO`, 완성 매트 `R375-CAMPIONE` 1~4)이다. 해상도가 낮아 치수는 읽지 못했다. 아래는 모두 **사진 판독(추정)**이고, 신뢰도를 함께 적는다.

| 항목 | 사진에서 보이는 것 | 신뢰 |
|---|---|---|
| 테이블 | 매트를 올리는 면 전체가 **볼 트랜스퍼 테이블**이다. 스테인리스 판에 흰 플라스틱 볼 유닛 수백 개가 줄지어 박혀 있다. 에어 테이블 구멍·진공 원판·클램프는 보이지 않는다 | 높음 |
| 매트 잡기 | 매트는 볼 위에 **그냥 놓여 있다.** 잡는 장치가 사진에 없다 | 높음 |
| 매트 회전·이송 보조 | 바늘 바로 왼쪽(매트 몸통 쪽)에 **서보 모터 직결 고무 바퀴**(지름 약 100, 폭 약 25로 보임)가 매트 **윗면(파일 면)**을 누른다. 모터 축이 X 방향이라 바퀴는 매트를 Y로 민다. 바늘에서 떨어진 자리를 밀어 바늘 둘레로 매트를 돌리는 방식으로 보인다("automatic piece rotation"의 실체로 추정) | 바퀴·서보는 높음, 역할은 추정 |
| 바퀴 누름 | 바퀴 위에 가이드 봉이 있는 세로 공압 실린더 묶음이 있다(바퀴 올림·내림). 앞판에 정밀 레귤레이터 3개(게이지 달림)가 있어 누르는 힘을 공압으로 조절하는 것으로 보인다 | 중간 |
| 바퀴 밑 판 | 바퀴·바늘 둘레 테이블에 볼이 없는 **둥근 판**(지름 약 250으로 보임)이 따로 있다. 고정 인서트인지 도는 판인지는 알 수 없다 | 판은 높음, 기능 모름 |
| 가장자리 센서 | 바늘 앞 바퀴 옆에 밝은 조명이 비치는 작은 블록, 모터 뒤 빨간 하우징이 보인다. 광학 센서(조명 + 수광)로 추정. 형번 판독 불가 | 낮음 |
| 헤드 | 흰 몸체, 앞쪽에 조절 손잡이 2×3, 확대하면 파란 **"M-TYPE"** 글자가 읽힌다. R375A 전체 사진의 긴 팔 평판 헤드와 배지가 같다. R375A 본문 "Durkopp 867 개조"와 합치면 R375X도 **Dürkopp Adler M-TYPE(867 계열)** | 높음 |
| 헤드 놓임 | 헤드 팔은 바늘 오른쪽(+X)으로 뻗는데, 전체 사진을 크게 보면 **팔 오른쪽 끝 밑에 테이블로 내려오는 기둥이 없고, 팔 밑 테이블에 볼이 그대로 이어진다.** 윗헤드가 파란 보 쪽에 **매달린** 것으로 보인다 → 아랫유닛(가마)은 테이블 밑에 따로 있고 동기하는 **분리형**일 가능성(본문 "modified sewing head structure … move freely under it"과 맞음). 0-8-1의 분리형 헤드 안과 같은 방향 | 중간 |
| 헤드 위 구조물 | 보 앞면 가로 볼나사(왼쪽 고정 쪽 베어링 하우징) + 레일 2줄 위의 판에 **각형 공압 실린더 2개를 위아래로 겹친 묶음**(3위치 실린더 추정)과 세로 가이드 봉, 속도 조절 엘보, 나선 케이블. 가이드 봉이 헤드 윗면 판까지 내려온다 | 윗헤드를 보에 매다는 대차로 추정: 볼나사 = 윗헤드 X 위치(맞춤·정비 시 빼기 또는 아랫유닛과 동기 이동 — 어느 쪽인지 모름), 겹친 실린더 = 윗헤드 승강(작업·조금 들기·완전 들기 3위치 추정) | 낮음 |
| 헤드 이동 여부 | 헤드는 고정으로 보인다. 처음에 헤드 이동의 근거로 본 전폭 케이블 체인은 아래 **왼쪽 둘째 바퀴 대차**용이다. 파란 보 앞면의 가로 볼나사 + 레일 2줄(오른쪽, 헤드 가까이)은 무엇을 X로 옮기는지 사진으로 알 수 없다 | 중간 |
| **둘째 바퀴(왼쪽 대차)** | 전체 사진 왼쪽 끝: 파란 보 앞 **전폭 리니어 가이드(노란 눈금 띠)** 위를 달리는 대차에서 세로 기둥이 내려오고, 끝에 **서보 + 붉은 바퀴**가 매트 몸통(바늘에서 먼 쪽)을 누른다. 대차 케이블은 보 위 전폭 케이블 체인으로 간다. 바늘 옆 바퀴와 같은 축 방향(X)이라 매트를 Y로 민다. 바늘에서 멀리 떨어진 곳을 밀어 큰 회전 모멘트를 작은 힘으로 내는 용도로 추정 — 본문 "car-mat moving"의 실체 후보 | 대차·바퀴는 높음, 역할은 추정 |
| 바늘 옆 바퀴 상세 | 서보 → 원통형 감속기(추정) → 베어링 블록 → 검은 고무 바퀴(폭 약 25). 위쪽에 핀으로 도는 **스윙 암**(옆판 2장)에 달려 있고, 세로 가이드 실린더가 암을 눌러 내리는 구조로 보인다 | 중간 |
| 바늘 앞 슈 | 바퀴와 바늘 사이에 매트 위에 얹힌 **납작한 스테인리스 미끄럼 슈**가 있고, 그 위에 케이블 달린 작은 블록(센서 추정)이 있다. 가장자리 감지 또는 매트를 바늘 앞에서 평평하게 누르는 용도로 추정 | 낮음 |
| 바늘 둘레 | 바늘·노루발 둘레에 흰 LED 조명이 강하게 비친다. 노루발 오른쪽에 작은 공압 실린더와 레버(테이프 절단·잡기 추정), 오른쪽 아래에서 검은 테이프 길이 바늘 쪽으로 들어온다. 오른쪽 테이블 위 구부린 스테인리스 판은 테이프 덮개·안내로 추정 | 낮음~중간 |
| 헤드 위 | 세로 가이드 실린더 두 묶음과 가운데 블록(테이프 커팅 유닛 또는 노루발 들기 추정), 큰 회색 손잡이 2개. 위쪽에 실 콘 2개, 흡입 덕트로 보이는 굽은 알루미늄 관 | 낮음 |
| 테이프 | 바늘 오른쪽에 구부린 스테인리스 판(테이프 안내/바인더 판)이 테이블 위에 있다. 헤드 위 세로 공압 실린더들은 테이프 커팅 유닛으로 추정. R375A는 오른쪽에 **눕힌 원판(빨간 판) 위 테이프 롤**과 실 스탠드가 있다 | 중간 |
| 기계 크기 | R375X는 전폭 약 2.5 m급의 큰 테이블(사람·부품 비례로 짐작), 양옆 라이트 커튼(노란 기둥), 경광등, 오른쪽 터치패널. R375A는 작은 단독 테이블 + 왼쪽 뒤 배출 경사판 | 중간 |
| 오목부 마감 | 상세 3·4는 오목 S곡선과 넓은 홈(폭이 볼 피치 10배 이상)을 보여 준다. 안쪽 반경은 볼 피치 1~2개 정도. **좁고 깊은 U홈 사진은 없다**(D-14 그대로) | 중간 |

#### 바늘 옆 바퀴·슈 묶음 상세 판독 (상세 5 확대, 사용자와 함께 판독)

| 부품 | 보이는 것 | 판독 | 신뢰 |
|---|---|---|---|
| 서보 | 은색 몸통, 검은 뒷 덮개에 꺾인 커넥터 2개, 오렌지(전원)·녹색(신호) 케이블 | 산업용 AC 서보. 몸통·케이블 색이 Siemens 1FL6(V90) 계열과 비슷 | 서보는 높음, 상표 낮음 |
| 동력 길 | 모터 → 회색 사각 플랜지 → 라벨 붙은 반짝이는 원통 → 세운 판(출력 베어링) → 바퀴 허브 | 인라인 유성 감속기 + 출력축 판 지지, 바퀴는 축 끝에 외팔 | 중간 |
| 바퀴 | 검은 고무·우레탄 트레드, 홈 없음, 은색 허브. 지름 ≈ 모터 플랜지의 약 1.9배, 폭 ≈ 플랜지의 약 1/3 | 플랜지 60이면 약 Ø115, 80이면 약 Ø150(비례 추정, 실측 아님) | 낮음 |
| 매달기 | 감속기를 죄는 클램프 블록 위로 핀 달린 갈래(클레비스), 그 위 프레임 좌우에 빨간 끝 실 블록 | 핀으로 바퀴 묶음이 위아래로 흔들림(누름 실린더 연결 추정). 빨간 블록은 좌우 끝에 있어 **X 방향 리니어 가이드 블록**으로 보임 → 보 앞면 볼나사로 바퀴 X 위치를 바꾸는 축일 가능성 | 낮음~중간 |
| 누름 | 실린더는 이 사진 밖. 보의 레귤레이터 3개·솔레노이드 | 돌리기는 전동 서보, 누르기는 공압(힘 = 압력 × 면적, 두께 변화에도 일정) | 중간 |
| 슈 | 바퀴 바로 오른쪽, 세로 브래킷 끝 납작한 스테인리스 발판이 매트 윗면에 얹힘. 매트 가장자리에서 약간 안쪽 | 바늘 앞에서 매트를 평평하게 누르는 판 | 중간 |
| 가장자리 센서 | 슈 위 오른쪽 끝, 매트 가장자리 바로 위에 케이블 달린 작은 검은 블록(파란 나선 피복 케이블) | 반사형 광센서(또는 광섬유 헤드). 검은 매트 ↔ 반짝이는 스테인리스 대비로 가장자리 판정. 슈에 붙어 매트 면과 높이가 늘 같음 | 중간 |
| 슈 이동 | 위쪽 판에 가로 둥근 공압 실린더와 손잡이 너트 달린 나사 | 슈·센서를 X로 옮기거나 비키는 실린더 + 나사 멈춤(바인딩 폭·센서 위치 조정 추정) | 낮음 |
| 테이블 | 얇은 타공 스테인리스 판 + 컵에 앉은 흰 볼, 검은 원판 둘레에 회색 테두리 틈 | 원판은 따로 끼운 부품(회전 추정) | 중간 |

**지금 구동 개념(0-8)과 다른 점** — 결정은 사용자가 한다(구조 변경):
1. R375X는 진공 원판·X·Y 따라가기 받침·조향 서보 회전축이 **없다.** 볼 테이블 + 헤드 이송 + 서보 바퀴 1개로 매트를 돌리는 것으로 보인다. 0-8-1(C-21)보다 훨씬 단순하다.
2. 그 대신 바퀴가 **파일 면을 누른다.** C-03(롤러로 파일 면을 세게·좁게·반복해서 누르지 않는다)과 부딪힌다. 다만 바퀴는 한 점을 한 번 지나가는 구조라 전임 기계의 롤러와 같은지는 모른다(전임 기계 상세 D-09).
3. 바퀴가 **둘**이다. 바늘 옆 고정 바퀴 하나 + 전폭 X 대차에 달린 먼 쪽 바퀴 하나. 헤드는 봉제 중 고정으로 보이나, 윗헤드가 보의 볼나사 X축·승강 실린더에 매달린 것으로 보여 그 용도는 확인 필요.
4. 윗헤드가 기둥 없이 위에 매달린 분리형으로 보인다 → 0-8-1 분리형 헤드 안은 R375X와 같은 방향(이전 대화에서 "Rimac보다 큰 개조"라고 한 판단은 틀림).

#### R375X 사진 6장 다시 판독 — 기구물 하나씩 (2026-11-11, 사용자 요청 "기구물 하나도 놓치지말고")

출처: https://www.rimac.it/en/products/r375x/ 의 사진 6장(`IMG_6142-Copia` 1008×756, `Particolare-1-1` 1086×762, `particolare-2` 913×480, `Particolare-3` 1007×570, `particolare-4` 1008×756, `particolare-5` 841×611). 페이지에 영상은 없다. 원본 해상도까지 키워 구역별로 봤다. **용도가 사진으로 안 보이면 '모름'으로 두고 추측으로 설계하지 않는다**(사용자 2026-11-11 "멋대로 생각해서 하지말고"). 좌표 말은 우리 모델 기준(X = 보 방향, Y = 앞뒤, Z = 위).

**고쳐 적음:** 위 표의 '바퀴 누름'(세로 공압 실린더 묶음)·'바늘 옆 바퀴 상세'(세로 가이드 실린더가 암을 눌러 내림)·'매달기'·'누름'은 틀린 판독이었다. 아래 U4 행이 맞다(사용자 확인, C-41).

| # | 부품 | 사진에서 보이는 것(어느 사진) | 보이는 것으로 확정되는 것 | 모르는 것 | 우리 모델(v2.10.2) | 판정·조치 |
|---|---|---|---|---|---|---|
| 1 | U4 바퀴 묶음 | 서보(검은 뒷덮개, 오렌지·녹색 케이블 나선 피복) → 사각 플랜지 → 원통 감속기(라벨) → 세운 판 → 검은 고무 바퀴·은색 허브(P1·P2·P5) | 모터 축 = 바퀴 축 = X(P2 정면에서 모터가 왼쪽으로 뻗음), 바퀴는 Y로 굴러 매트를 민다. 바퀴는 바늘 바로 왼쪽, 노루발·슈와 바퀴 지름 하나 거리 | 바퀴 지름·폭 실치수 | 같음(바퀴 축 X) | 같음 |
| 2 | U4 매달기 | 감속기 클램프 블록 윗면에 **양귀 U자 브래킷**, 꼭대기에 **X 방향 핀**이 귀 둘을 지남(P5 확대) | 바퀴 묶음이 X축 핀에 **그네처럼 매달림**(피벗이 바퀴 위) | 핀 위 고정부 형상 | **다름**: 피벗 축 Y(J_U4_PRESS [0,−1,0]) | M02R 다시(C-41, 지금 엔진 진행) |
| 3 | U4 누름 실린더 | 보 밑 은색 브래킷 블록에 **사각 플랜지 실린더**, 로드가 앞(−Y 쪽)으로 나옴(P1 확대: 로드 끝이 정면으로 보임) | 실린더 몸은 고정부(보 쪽), 로드 Y. 로드가 매달린 묶음을 밀고 당겨 기울여 누르고 듦(사용자 확인) | 실린더 형번·지름·행정, 로드 끝 연결 방식(너클/클레비스) | **다름**: v2.10.2는 모터 위 X축 누운 실린더 + 크랭크 | M02R 다시(C-41) |
| 4 | U4 옆 작은 가로 실린더 | 큰 실린더 오른쪽 위, 파란 관 달린 소형 실린더가 벽에서 가로로 나옴(사용자 사진) | 있음 | **용도 모름** | 자리만(D-163) | D-163 그대로 |
| 5 | 매달기 위 빨간 블록 | U자 브래킷 뒤 좌우에 빨간 블록 2개(P1·P5) | 있음, 좌우 대칭 | **용도 모름**(리니어 가이드 블록이면 바퀴 X 위치 조정 — 확인 안 됨) | 없음 | D-181 |
| 6 | 회전 원판 | 바퀴 밑 테이블에 볼 없는 **검은 둥근 판**, 둘레 회색 테두리 틈, 테이블 면과 같은 높이(P2·P5). 중심은 바늘이 아니라 바퀴 밑 | 따로 끼운 원판 | 도는지 고정인지 | U4 밑 자유 회전 원판(약 Ø250) | 같음 |
| 7 | 바늘 앞 슈 | 바퀴 오른쪽, **세로 스테인리스 판 기둥** 끝에 발판이 매트를 누름. 기둥 중간 블록에 검은 센서 케이블·작은 이음, **파란 나선 에어관이 슈 쪽으로 내려감**(P1·P5) | 슈는 세로 기둥에 달림, 슈 쪽으로 공기가 간다 | 슈를 누르는/드는 장치가 무엇인지, 에어관이 실린더용인지 불기용인지 | M06 가로 비킴 CJ2B16-60SZ_M06(−X 60) + U6S 세로 누름 CJ2B10-15Z_M06P | D-164 그대로. CJ2B16-60SZ는 2026-11-03 판독 '위쪽 판에 가로 둥근 실린더 + 손잡이 너트 나사'(신뢰 낮음)에서 나왔다 → 사용자 확인 필요 |
| 8 | 바늘 둘레 불기 노즐 | 파란 관이 노루발·슈 아래쪽 작은 노즐로 들어감(P1 확대) | 바늘 둘레에 공기 관 끝이 있다 | **용도 모름**(실·테이프 끝 불기, 먼지, 냉각 등) | 없음 | D-182 |
| 9 | 헤드 오른쪽 가로 센서 | 헤드 앞 오른쪽 브래킷에 **원통형 센서**(케이블 달림)가 왼쪽(바늘 쪽)으로 가로 누움(P1 확대) | 원통형 센서 1개 | 무엇을 감지하는지 | 가장자리 센서 E32-D36P1(슈 위) 말고 없음 | D-183 |
| 10 | 바늘 둘레 조명 | 노루발 밑이 흰 LED로 밝음(P1·P2) | 조명 있음 | 조명 형번 | 없음 | 디테일 후보(센서 대비용일 수 있음 — 모름) D-183에 같이 |
| 11 | 헤드 | 흰 몸체, 파란 "M-TYPE" 글자, 앞면 조절 손잡이 다수(P1·P2) | Dürkopp Adler M-TYPE 계열 | 개조 범위 | U3 헤드(D-10 형번 미정) | 같음 |
| 12 | 헤드 위 세로 묶음 | 세로 봉 2개 × 리니어 부시 블록 4개, 가운데 블록에 속도조절 이음·파란 관, 큰 회색 손잡이 2개(P2 확대) | 헤드 위 공압 세로 이동 묶음 | 움직이는 것이 무엇인지(헤드 승강/커팅/노루발) | U7 커팅·접기 CJ2B10 등 | 2026-11-03 판독(행 47·53) 그대로, 모름 유지 |
| 13 | 보 앞 볼나사 | 보 앞면 X 방향 볼나사, 왼쪽 끝 **4볼트 사각 플랜지 베어링**, 그 밑 판에 둥근 머리 4개(P1·P2) | X 볼나사 있음 | 무엇을 X로 옮기는지 | 없음 | D-184(행 48과 같은 모름) |
| 14 | 레귤레이터 | 보 앞면에 **흰 몸체 게이지 달린 레귤레이터 3개** 나란히, 출구 관이 나선 피복으로 아래로(P1·P2) | 3개 | 각각 어디로 가는지 | **2개**(IR1000:1 U4, :3 U6). :2(U5용)는 FUNC-01 수정 2(F01-S2)에서 지움 — U5 승강을 주 공급 0.5 MPa로 바꿔서 | 사용자 결정 대기(3번째를 무엇에 쓸지) |
| 15 | 보 앞 밸브 | 레귤레이터 밑에 **DIN 코일 솔레노이드 밸브 1개 + 황동 소음기**, 옆에 황동 이음 달린 은색 블록(P1 확대) | 보 앞면에 밸브 1개 따로 | 은색 블록이 무엇인지(압력 스위치/수동 밸브), 나머지 밸브 위치 | 매니폴드 SS5Y3 + SY3120 묶음(보 앞면) | D-185 |
| 16 | 보 밑 솔 띠 | 보 아래 가장자리를 따라 **솔(털) 띠**, 그 밑에 녹색 점 박힌 은색 띠(P1 확대) | 솔 띠 있음 | 용도(틈 막기·먼지·손 끼임), 녹색 점이 무엇인지 | 없음 | D-186 |
| 17 | 테이블 판 | 결 낸(헤어라인) 스테인리스 판 여러 장, 이음선 사선, 접시머리 볼트로 고정(P3·P4) | 판 나눔 + 접시 볼트 | 판 두께 | M04 W·E 판 | 같음(나눔 위치 비교는 디테일) |
| 18 | 볼 유닛 | 흰 플라스틱 볼 + **검은 링 자리**, 판 면과 같은 높이. 무리 지어 박힘, 바늘·바퀴 둘레는 볼 없는 민판(P1~P5) | 볼 무리 + 민판 구역 | 볼 지름 | STEP대기_BALL_D25_M04 | 같음(링 자리 형상은 STEP 받으면) |
| 19 | 테이블 긴 홈 | 원판 왼쪽 테이블에 X 방향 **긴 홈 + 둥근 봉 2줄**(P2·P5) | 있음 | **용도 모름** | 없음 | D-187 |
| 20 | 먼 쪽 바퀴(U5) | 전체 사진 왼쪽, 보 앞 전폭 가이드 위 대차 → 세로 관 묶음 → 서보 + 바퀴(IMG_6142) | 있음, 보 위 전폭 케이블 체인 | 매달기·누름 방식(이 사진 해상도로 안 보임) | U5 대차 + 플로트 | 같음(방식은 확인 못 함) |
| 21 | HMI | 헤드 오른쪽 팔에 터치패널, 버튼 START·STOP·EMERGENCY(빨간 버섯)·EMERGENCY RESET(초록)(P2) | 버튼 4개 | — | U8_HMI_PANEL | 버튼 구성은 제어 단계(U-09) |
| 22 | 실·덕트 | 헤드 위 실 콘 2개(빨강), 굽은 알루미늄 관(IMG_6142) | 있음 | 관 용도 | 없음 | 행 53 그대로 |
| 23 | 테이프 덮개 | 바늘 오른쪽 테이블 위 굽힌 스테인리스 판(P1·P2) | 있음 | 테이프 안내/덮개 | U7 | 행 52·54 그대로 |
| 24 | 프레임·안전 | 알루미늄 형재 틀 + 뒤 투명판, 앞 좌우 노란 라이트 커튼, 경광등, 캐비닛 문 손잡이, 앞 테이블 끝 둥근 모서리, 바퀴(캐스터) + 레벨러(IMG_6142) | 있음 | — | F3SG ×2, LR6, 레벨러(STEP대기), 캐스터 없음 | 캐스터 유무는 디테일 후보 |
| 25 | 완성 매트 | 오목 S곡선·넓은 U 오목에 테이프 폭 일정, 회색 실 땀선(P3·P4) | 마감 기준 사진 | 땀 길이·테이프 폭 실치수 | 7절 | 기준 사진으로만 |

#### 모르는 것의 용도 추정 (2026-11-11, 사용자 "용도를 모르는데 유추를 해보라고")

만드는 기계(테이프 바인딩, 헤드 고정, 매트가 돌며 가장자리 따라감)에서 꼭 필요한 기능에 맞춰 추정한다. **추정이지 확인이 아니다** — 신뢰를 적는다.

| D | 부품 | 추정 용도 | 근거 | 신뢰 |
|---|---|---|---|---|
| D-181 + D-184 | 빨간 블록 2개 + 보 앞 X 볼나사 | **U4 바퀴 묶음의 X 위치 조절축**: 매달기 윗판이 X 레일(빨간 끝 실 블록 = 가이드 블록) 위에 있고, 바로 위 보 앞 볼나사가 그 판을 X로 옮긴다 → 바늘–바퀴 거리 d₁을 매트·테이프·홈에 맞춰 바꾸거나 좁은 홈에서 바퀴를 바늘 쪽으로 붙인다 | 빨간 블록이 핀 축(X) 방향 좌우 대칭으로 고정부에 있다. 볼나사 왼쪽 플랜지 베어링이 U4 바로 위다. 매달기·누름 말고 이 두 부품이 할 일이 U4 근처에 달리 없다 | 중간 |
| D-182 | 바늘 둘레 공기 노즐 | **바늘 냉각 공기**(2000 rpm 합성사 바늘 열) 또는 테이프 절단 뒤 끝 불어 넣기 | Dürkopp 고속 헤드의 흔한 선택품이 바늘 냉각 노즐이다. 관이 바늘 쪽 아래로 향한다 | 중간~낮음 |
| D-183 | 헤드 오른쪽 원통 가로 센서 + LED | **테이프 유무·끝 감지**(테이프가 다 떨어짐, 한 바퀴 돌아 시작점에 왔을 때 겹침 시작 알림) — 센서가 바늘 쪽 테이프 길을 본다. LED는 작업자 시야 또는 센서 대비 | 가장자리 센서는 슈에 따로 있다. 바인딩 자동기는 시작·끝 겹침과 절단 시점을 알아야 한다 | 중간~낮음 |
| D-185 | 보 앞 DIN 코일 밸브 + 황동 이음 은색 블록 | **주 공기 차단·잔압 배기 밸브 + 압력 스위치**(공기 낮으면 정지) | 레귤레이터 묶음 바로 앞(주 공급 쪽)에 따로 있고 소음기가 크다. 비상정지 때 잔압을 빼는 것은 기계 안전 기본(ISO 4414) | 중간 |
| D-186 | 보 밑 솔 띠 | **먼 쪽 바퀴 대차(U5) 구동 홈 덮개**: 전폭 가이드·구동부에 먼지·실밥·손이 들어가지 않게 홈을 솔로 막음. 녹색 점은 레일 볼트 구멍 마개로 보임 | U5 대차가 보 전폭을 달린다(케이블 체인 전폭). 솔 띠가 그 높이를 따라 길게 있다 | 중간 |
| D-187 | 테이블 긴 홈 + 봉 2줄 | 정비용 탈착 판의 이음·손잡이, 또는 매트 밀어내기 바 | 둘 다 근거 약함 | 낮음 — 넣지 않는다 |
| D-163 | U4 옆 작은 가로 실린더 | **중간 높이 스토퍼**: 로드가 나와 그네 묶음이 그 각도까지만 내려가게(좁은 홈·U4 혼자 구간에서 살짝 띄우기) 또는 든 자세 잠금 | 벽(고정부)에서 가로로 나와 매달린 묶음 옆을 향한다 | 중간~낮음 |
| D-164 | 슈 쪽 파란 관 | 슈 세로 누름·들기 실린더(U6S와 같음) | 관이 슈 기둥을 따라 내려간다 | 중간 |
| (#14) | 레귤레이터 3개 | 매트를 누르는 세 곳의 힘: **U4 바퀴, U5 바퀴, 슈** | 매트에 닿아 힘 조절이 필요한 곳이 그 셋이다. 노루발 압은 헤드 자체 조절일 가능성 | 중간 |

## 2. 비슷한 기계

| 기계 | 내용 |
|---|---|
| Richpeace 자동 매트 바인딩기(중국) | 센서가 외곽을 감지해 상하 프레스 휠로 봉제 방향을 잡는다. 공급 트레이 + 매니퓰레이터 로딩, 배출 매니퓰레이터, 자동 트리머·라벨링. 설치 4300×2400×2300 mm, 6 kW, 2000 rpm. https://www.richpeace.com/cnc_sewing_for_hometextile-show-1286.html |

## 3. 특허 (모두 만료·소멸 표시, Google Patents 기준)

Rimac 이름으로 된 특허는 찾지 못했다. 좁은 홈·오목부 처리를 다룬 특허도 찾지 못했다 → 이 기계의 차별점이자 특허 후보.

| 특허 | 매트 잡기·회전 | 가장자리 감지 | 헤드 | 참고할 점 |
|---|---|---|---|---|
| [US6557478](https://patents.google.com/patent/US6557478) 자동 바인딩기(2003, 2007 만료) | 진공 구멍 원판에 빨아들여 잡고, 매트는 원판 위에서 자유 회전. 직선 액추에이터가 원판을 헤드 쪽으로 | 바늘 옆 스프링 감지 암 2개(위치·곡선), 봉제 중 | 재봉기 테이블이 돌아 헤드 최대 180° 회전 | 롤러 없이 잡기(C-03), 매트 회전 + 헤드 회전. 테이프는 사람이 넣고 끝은 사람이 자름 |
| [US5367966](https://patents.google.com/patent/US5367966) 자동 가장자리 봉제(1994, Draper 연구소) | 위아래 판 두 장 사이 클램프, 자유 회전 + 직선 이동 | 바늘 앞 아날로그 반사형 광센서, 봉제 중 실시간 | 고정. 판 쪽 조향 | **코너: 바늘을 내린 채 노루발을 들고 회전, 센서가 다시 잡으면 재개**(T03) |
| [US5216969](https://patents.google.com/patent/US5216969) 자동 카펫 바인딩(1993) | X·Y·Z 로봇이 스펀지 패드 판으로 눌러 이동 | 광섬유 센서로 앞·뒤 끝만 | 고정 | 사각형만. 공압 칼로 테이프 절단, 한 변마다 90° 회전 |
| [US5209171A](https://patents.google.com/patent/US5209171A/en) 카펫 바인딩기(1993) | 톱니 구동 롤러가 파일 면을 눌러 끌고 감 | 없음(사람이 조향) | 기계가 바닥을 굴러감 | **파일 면을 롤러로 누르는 구조 = 전임 기계 실패와 같은 방식**(C-03) |
| [CN207958657U](https://patents.google.com/patent/CN207958657U/zh) 자동 바인딩 봉합(2018) | 흡착 헤드로 집어 올려 공급, 스토퍼 바 정렬 | 센서 없음 | 고정 | 테이프 접힘 칼·나팔 입구·서보 벨트 공급, 라벨 접기, 자동 배출 |
| [CN215051175U](https://patents.google.com/patent/CN215051175U/zh) 전자동 바인딩 재봉기(2021) | 누름판 + 스텝 모터 회전, X·Y 이동 | 감응편(자세히 없음) | 고정 | 기준점 중심 회전 봉제 |
| [WO1996023626A1](https://patents.google.com/patent/WO1996023626A1/en) 가장자리 감지(1996, 신발용) | 팔레트를 X·Y 테이블로 | 레이저 선 + 카메라 | 고정 | 저장된 경로를 실제 가장자리에 맞춰 보정(형상 등록 보조 후보의 참고) |

## 4. 정리: 가져올 것과 앞서야 할 것

| 가져올 것 | 출처 |
|---|---|
| 헤드 고정, 매트가 헤드 밑을 지나며 회전 | R375X, 특허 대부분 |
| 바늘 앞 가장자리 센서로 봉제 중 추적 | R375 계열, US6557478, US5367966, Richpeace |
| 롤러 없이 넓게 잡기(진공 원판·판 클램프) | US6557478, US5367966 |
| 급한 꺾임: 바늘 내림 + 노루발 들고 회전, 필요하면 헤드 회전 | US5367966, US6557478 |
| 테이프 자동 공급·커팅, 열절단 옵션 | R375X, CN207958657U |

| 앞서야 할 것 | 이유 |
|---|---|
| 좁은 V자·U자 홈까지 깔끔한 마감 | 대기업 납품. 벤치마크·특허 어디에도 답이 없다 |
| 영구 눌림자국 없음 | 전임 의뢰 기계 퇴짜 사유 |
| 시작·끝 이음매 자동 처리 | 특허들은 사람이 마무리. 사람 손 없이(C-05) |
