hyeunung/FSAP/docs/reports/mechanism/mech_RX-10_measure.md

# RX-10 측정 — U6 슈 바닥 Y 길이 90 → 130 (측정부, 2026-11-13)

요약(10줄 안):
- 대상 `3D_Modeling/FSAP_v2.17.1.sc`(config.json doc). sigcheck `reuse`(3,224부품) → bbox·부피·질량은 `tools/out/signatures.json` 그대로, 슈 형상·통로 프로브만 새로 잼. 바뀐 부품 0, 저장 0.
- 통로 MCP(앱에 v2.17.1이 dirty false로 열려 있어 다시 열지 않음). 프로브 상자 20개는 `edit.checkpoint 90` → `restore`로 지움(끝: dirty false · 바디 876 · 타임라인 3,687 · PRB 0 · `motion.play REST 0` moved false).
- 지금 슈 `P_M06_SHOE`: bbox X 23 × Y 90.0 × Z 37.5, 바닥 평탄부 **폭 19.0 × 길이 79.29 = 1,506.6 mm²**(CAD 면), −Y 끝에만 입술(굽힘 + 20° 올림, Y 길이 10.71), **+Y 끝은 직각 자름**. 92.883 g.
- **이미 됨? 아니오**(already_ok=false): 완료 판정 ① 자국 SF **1.354 < 2**(L 90, 잰 면 1,506.6, μ 0.4, F_hi 21.59 N). ② X 폭 23 ≤ 23은 지금도 만족, ③ 지금 형상 겹침 0.
- **−Y 끝 밖(Y −245~−205)은 완전히 비어 있다**: SHIFT −60·0 두 자세, PRESS −5.0~+4.5 쓸림(Z 7.5~59) 프로브 10개 겹침 0, 15 mm 안 기계 부품 0(아래 볼 609만 9.97~14.96).
- **+Y 끝 밖(Y −115~−75)은 막혀 있다**: 캐리지 `P_M06_CARR` 73~1,876 mm³, 센서 `E32-D36P1_2M_M06` 146~1,039 mm³(감지면 Z 21 바로 밑 = 시야 가림), SHIFT 0에서는 `P_M05_BINDER` 72~6,552 mm³(Y −95부터).
- 같은 식 손계산(잰 평탄 면): L 120 SF 2.05 · **L 130 SF 2.29** · L 140 2.53. 요구서 행 식(유효 폭 16.74 고정)은 L 130 SF 2.19.
- 구상이 볼 것 2건(완료 판정 ④): (a) 잡음 필요 힘 식이 슈 길이에 비례(U6S 식 b = 0.090) → L 130이면 F_need 9.36 N, **0.18 MPa 그대로면 잡음 비 0.95~0.98 < 1**. 0.19 MPa 1.02~1.05(자국 SF 2.15~2.18), 0.20 MPa(IR1000 최대) 1.10~1.13(SF 2.07~2.10). (b) −Y로만 40 늘리면 누름 로드(Y −152)가 평탄부 중심(Y −174.65)에서 22.65 벗어난다(지금 2.65).
- 구상용 표: `tools/out/mech_RX-10/u6_parts_sig.json`(U6 + 이웃 83바디 bbox·부피·질량), 프로브 `probe_result.json`, 손계산 `handcalc_rx10.py`·`.json`, 슈 면·모서리 `shoe_topology_REST.json`.
- 미완: 매트 연구 자세(CYCLE_G1 등)는 CAD로 돌리지 않았다(슈–매트는 Z 관계뿐이라 서명 Z와 U6S 키 값으로 계산, 3절). 관 `TU0604_M08P_U7C_TUCK_A·B`는 bbox로만 봄(X ≥ 25.9, 슈와 X 틈 ≥ 24.9).

## 0. 측정 표·통로·시간

| 항목 | 값 |
|---|---|
| sigcheck(시작·끝) | `{"mode": "reuse", "reason": "문서·해시가 같다", "parts": 3224}` 두 번 같음 |
| 앱 상태 | `running` 빈 목록. `document.inspect`: 이름 FSAP_v2.17.1, 경로 같음, **dirty false**, 타임라인 3,687(오류 0 · 경고 53), 바디 정의 876 → 다시 열지 않음(파일 열기 0) |
| 앱에서 잰 것 | `body_topology P_M06_SHOE` 1, 프로브 `batch` 1(상자 20개 약 20 s + `inspect.clearance` 10.1 s), `joint.drive J_U6_SHIFT 0` + `inspect.clearance` 9.6 s + `inspect.measure` + 슈 틈 0.2 s, 되돌리기 `batch` 2 |
| 원복(E-08) | `edit.checkpoint` 90 → 프로브·`joint.drive J_U6_SHIFT 0` → −60으로 되돌림 → `edit.restore_checkpoint 90` restored true → `motion.play REST 0` **moved false**. `measure PRB_S0_BN1` unknown body, 끝 `document.inspect`: dirty false · 바디 876 · 타임라인 3,687 · PRB 0 |
| 프로브 방식 | 바닥 띠 B: X 슈 폭 23 × Y 10 조각 × Z 7.5~22.6(PRESS −5.0~+4.5 쓸림, 입술 높이 포함). 윗부분 W: X 벽 쪽 20 × Y 40 × Z 22.6~59. 자세마다 X만 다름(SHIFT −60: X −82~, SHIFT 0: X −22~). against 66바디(슈 둘레 30 mm 안 기계 부품 전부, 관 2개·매트 모형 제외 — `neighbors.json`), `clearance 15` |
| 근거 규칙 | 실행 규칙 2 "혼자 도는 읽기 부서도 MCP로 잰다 … 저장은 하지 않는다(`save` 금지, 끝나면 `motion.play` step 0)", 안내서 '원복' "편집·포즈 변경 전에 `edit.checkpoint`를 한 번 부르고, 끝나면 `edit.restore_checkpoint`", 안내서 '간섭' "`against`에 모델 전체를 주지 않는다" |

## 1. 과제에 걸린 부품·구동 요소

좌표는 REST(J_U6_SHIFT −60, J_U6_PRESS +4.5, J_U7_HGT 0). **작동 자세(SHIFT 0)는 U6_SHOE·U6_PRESS 묶음 X +60.** PRESS 값 = 슈 Z 변위(+4.5 들림 → 바닥 Z 17.0, 0 → 12.5, −0.4 모형 누름 12.1, −5.0 아래 끝 7.5).

### 1-1. 슈 `P_M06_SHOE`(U6_PRESS, SUS304 t2 판금, 92.883 g, 11,712.865 mm³) — `body_topology`·`inspect.measure`

| 부분 | X (REST) | X (SHIFT 0) | Y | Z (PRESS +4.5) | 비고 |
|---|---|---|---|---|---|
| bbox | −82~−59 | −22~1 | −205.0~−115.0 | 17.0~54.5 | 무게중심 (−74.87, −156.49, 34.37) |
| 바닥 평탄부(닿는 면) | −78~−59 (19.0) | −18~1 | −194.29~−115.0 (79.29) | 밑면 17.0, t 2 | **1,506.6 mm²** (면 0·1) |
| 입술(−Y 끝에만) | −78~−59 | −18~1 | −205.0~−194.29 (10.71) | 17.0 → 끝 윗모서리 약 22.6 | 굽힘 R 안 2·밖 4(축 X, Y −194.29 · Z 21) 뒤 20° 올림 면 9.94 × 19 |
| +Y 끝 | | | −115.0 | | **직각 자름, 입술 없음** |
| 아래 굽힘 | −82~−78 | −22~−18 | −194.29~−115 | 17~21 | R 안 2·밖 4(축 Y, X −78 · Z 21) |
| 벽 | −82~−80 | −22~−20 | −195~−115 (80) | 21~50.5 | 장공 7.1 × 17.1 ×2(r 3.55, 중심 Z 32~42, Y −135 · −175) |
| 윗날개 탭 | −78~−62 (16) | −18~−2 | −195~−115 | 52.5~54.5 | 로드 구멍 Ø6 (X −68 / 작동 −8, **Y −152**) |
| 단면 넓이(끝면) | 바닥 38.0 + 굽힘 9.42 + 벽 59.0 + 윗 굽힘 9.42 + 윗날개 32.0 = **147.85 mm²** | | | | 10 mm 늘릴 때 단면 전체 +11.7 g, 바닥(+ 아래 굽힘)만 +3.8 g |

- 유효 폭 16.74 = 1,506.6 ÷ 90(bbox 길이로 나눈 값). 실제 평탄 폭은 19.0이고 길이에서 입술 10.71이 빠진다.
- 입술은 매트가 들어오는 쪽(−Y, 작업자 쪽·이송 +Y의 상류)에만 있다. −Y로 늘리면 입술을 새 끝으로 옮긴다.

### 1-2. 이웃(서명 그대로, REST) — 전체 표 `tools/out/mech_RX-10/u6_parts_sig.json`

| 부품 | 유닛 | X | Y | Z | 비고 |
|---|---|---|---|---|---|
| P_M06_CARR | U6_SHOE | −120~−42 | −185~−100 | 21~156 | PET-CF 256.6 g. 슈와 맞닿음(틈 0.0) |
| E32-D36P1_2M_M06 | U6_SHOE | −77.5~−42.5 (작동 −17.5~17.5) | −112~−107 | 21~36 | 실물 STEP, **감지면 Z 21(밑면)**, 슈 +Y 끝과 3.606 |
| CB3-10_M06 ×2, INSERT_M3_M06_1·2 | U6_SHOE | −60.2~−54.8 | −115~−102 | 20.8~36.2 | 센서 고정 |
| P_M06_SLIDE_COLLAR_1·2 | U6_SHOE | −82~−78.4 | −181~−169 / −141~−129 | 26.5~38.5 | 장공과 틈 0.05 |
| P_M06_PCYL_BRKT | U6_SHOE | −82~−60 | −176~−122 | 74.3~94 | SUS304 t3 |
| CJ2B10-15Z_M06P(몸) | U6_SHOE | −74~−62 | −158~−146 | 69.3~138.3 | 복동 Ø10 행정 15, 슈 윗날개와 14.8 |
| CJ2B10-15Z_M06P_ROD + NUT ×2 | U6_PRESS | −73~−63 | −157~−147 | 49.3~109.8 | 슈와 함께 Z 이동 |
| P_M05_BINDER | U7_TAPE | −11~45.5 | −95~−9 | 13~60 | 슈 X 범위(X −11~1)에서는 밑면 Z 22 |
| P_M05_GUIDE | U7_TAPE | 12~50 | −122~−96 | — | 슈(SHIFT 0)와 14.0 |
| P_M02_WHEEL_TREAD | U4 | — | −63~37 | — | +Y 프로브 W와 15.0 |
| P_M02_DISK · 볼 609 | U2 | | | 윗면 Z 0 | 프로브 밑면 Z 7.5와 7.5~14.96 |

- 조인트(machine.json): `J_U6_SHIFT` slide X, −60(대기, 스프링)~0(작동), CJ2B16-60SZ. `J_U6_PRESS` slide Z, −5.0~+4.5(대기 +4.5), CJ2B10-15Z_M06P, 부모 U6_SHOE. `J_U7_HGT` −4~+6(손 조정, U6·U7 함께). 바꾸지 않는다.
- 새 구매품 없음(등급 S). 길이를 다시 확인할 구매품 없음(WF-128 대상 없음).

## 2. 빈 공간(통로) — CAD 프로브 (`probe_result.json`)

### 2-1. −Y 끝 밖 (Y −245~−205) — 비어 있음

| 프로브 | SHIFT −60 (X −82~−59) | SHIFT 0 (X −22~1) |
|---|---|---|
| 바닥 띠 Y −215~−205 (Z 7.5~22.6) | 겹침 0, 15 mm 안 0 | 겹침 0, 15 mm 안 0 |
| Y −225~−215 | 겹침 0, 볼 609 14.25(아래) | 겹침 0, 15 mm 안 0 |
| Y −235~−225 | 겹침 0, 볼 609 13.5(아래) | 겹침 0, 15 mm 안 0 |
| Y −245~−235 | 겹침 0, 볼 609 9.97(아래) | 겹침 0, 볼 609 14.96(아래) |
| 윗부분 Y −245~−205 (Z 22.6~59, X 벽 쪽 20) | 겹침 0, 15 mm 안 0 | 겹침 0, 15 mm 안 0 |

- SHIFT 가는 길(X −82~1 전체 쓸림, 서명 bbox `bbox_scan.json` transit_N): 기계 부품 0(매트·테이프 모형만).
- 높이 조정 끝(J_U7_HGT −4)·PRESS −5.0(매트 없을 때만): 바닥 Z 3.5 > 테이블 면 Z 0(틈 3.5).
- 카세트 빼기(MAINT_U7, J_U7_CST_X 25 → CST_Y 250)는 바인더가 X 14~70.5로 −Y를 지나간다. 그때 슈는 SHIFT −60(X −82~−59, 연구 키) → X 틈 73.

### 2-2. +Y 끝 밖 (Y −115~−75) — 막힘

| 프로브 | SHIFT −60 | SHIFT 0 |
|---|---|---|
| 바닥 띠 Y −115~−105 | P_M06_CARR 73.47 · **E32 145.68** · INSERT_1 0.13 mm³ (CB3-10_M06 못 잼: boolean no result) | 같음 + P_M05_BINDER 틈 10.0 |
| Y −105~−95 | P_M06_CARR 183.74 · INSERT_1 0.20, CB3-10 틈 0.25 · E32 2.0 | 같음 + P_M05_BINDER 맞닿음 0.0 |
| Y −95~−85 | 겹침 0 (P_M06_CARR 5.0) | **P_M05_BINDER 72.0** |
| Y −85~−75 | 겹침 0 | **P_M05_BINDER 72.0** |
| 윗부분 Y −115~−75 | P_M06_CARR 1,876.0 · E32 1,038.5 | + **P_M05_BINDER 6,552.0**, BINDER_BRKT 틈 2.24 |

- 바닥 띠의 캐리지·센서 겹침은 프로브 Z 21~22.6(입술 높이 몫)에서 난 것이다. 바닥판만(윗면 Z 19 @ +4.5)이면 캐리지·센서 밑면 Z 21과 2.0 떨어지지만, **센서 감지면 바로 밑**을 지난다.
- E32 시야(완료 판정 ⑤): 감지면 X −17.5~17.5 × Y −112~−107(175 mm², SHIFT 0). 슈 바닥을 +Y로 3 mm 넘게(Y −112 넘어) 늘리면 X −17.5~1 × Y 5 = **92.5 mm²(53 %) 가림**. 지금은 슈 끝 Y −115 → 가림 0, 틈 3.606.
- 결론(수치): +Y는 3 mm까지만(센서 앞 Y −112), 그 뒤는 시야 → 바인더(Y −95) 순으로 막힌다. **늘릴 40 mm는 −Y 쪽에만 자리가 있다.**

## 3. 작업 대상(매트)과의 관계

- 매트 모형 Z 0~10, 테이프 조각 Z 0~11, 이음매 윗면 12.0(서명·U6S `heights`). 슈 바닥: 들림 17.0(매트 위 7.0 · 이음매 위 5.0), 모형 누름 키 −0.4 → 12.1(이음매 위 **0.1**), 실제 접촉 −2.5(모형에서 쓰지 않는 값). 슈는 매트 위에서만 움직이므로 Y로 늘려도 모형에서 매트·테이프와의 Z 틈은 그대로다(XY 겹침은 원래 있음: 슈가 매트 위에 얹힘).
- 좁은 U홈(폭 25, 깊이 150, CYCLE_G1·G2): 슈 평탄부 X −18~1은 박는 벽 쪽 매트 위(매트 모형 가장자리 X 6.5보다 안쪽), 홈 빈 곳은 +X 쪽. 홈 바닥 180° 회전·홈 입구 회전은 PRESS +4.5(연구 키, 상태 표 'PRESS 4.5') — 슈가 매트 위 5.0 이상. X 폭이 그대로면 홈 폭 관계(0-8-2 ② "노루발·바인더 끝·슈 묶음 폭 < 가장 좁은 홈 폭")는 바뀌지 않는다.
- 슈가 늘어나는 Y −245~−205 · X −22~1(SHIFT 0) 위(Z > 12)로 연구 중 들어오는 기계 부품: 서명 bbox·프로브로 0. U4 바퀴 Y −63~37 고정, U5 바퀴 길은 X −1830~−334. **+X 옆에 U7 접기 실린더 묶음이 있다**(REST 서명): `CJ2B10-15Z_M05_TUCK` X 23~35 · Y −235~−166 · Z 48.6~60.6, 피팅 `KQ2L06-M5A_M05_4` X 23.8~34.2 · Y −246.4~−227.9 · Z 29.9~51.6, `P_M05_CYL_BRKT` X 14~50 · Y −204~−171 · Z 34~110, 관 `TU0604_M08P_U7C_TUCK_A·B` X ≥ 25.9 — 슈 +X 끝(X 1)과 X 틈 22.8(피팅)·13.0(브래킷, 지금 슈 옆과 같은 값). J_U7_CUT·TUCK은 +Y 15(X 그대로), J_U7_FEED는 −Z(X 70, Y −106)라 이 틈을 줄이지 않는다. X 폭을 그대로 두면 닿지 않는다.
- 매트 연구 자세를 CAD로 돌려 재지는 않았다(위 Z 계산). 모델링 뒤 검도가 과제 범위(SHIFT −60·0 × PRESS −5.0·+4.5, CYCLE_G1 홈 구간)로 잰다.

## 4. 손계산 — 같은 식, 닿는 면은 잰 값 (`handcalc_rx10.py`)

식: `fea/cases/mech_U6S_handcalc.py` 1절 — p_max = F_hi/A × (1 + 6·μ·h/L), SF = 30 kPa ÷ p_max. μ 0.4, h 20.5, F_hi 21.59 N(0.18 MPa). A = 평탄 폭 19.0 × (L − 10.71).

| L | A mm² | 유효 폭 A/L | p_max kPa | **SF(잰 면)** | SF(요구서 행 식, 폭 16.74) | −Y만 늘릴 때 평탄 중심 Y | 로드(Y −152) 편심 | 무게 + g (단면 전체 / 바닥만) |
|---|---|---|---|---|---|---|---|---|
| 90(지금) | 1,506.6 | 16.74 | 22.16 | **1.354** | 1.354 | −154.65 | 2.65 | 0 |
| 110 | 1,886.6 | 17.15 | 16.56 | 1.811 | 1.768 | −164.65 | 12.65 | 23.4 / 7.5 |
| 120 | 2,076.6 | 17.30 | 14.66 | **2.046** | 1.980 | −169.65 | 17.65 | 35.2 / 11.3 |
| 130 | 2,266.6 | 17.44 | 13.13 | **2.285** | 2.194 | −174.65 | 22.65 | 46.9 / 15.0 |
| 140 | 2,456.6 | 17.55 | 11.88 | 2.526 | 2.410 | −179.65 | 27.65 | 58.6 / 18.8 |

- L 120은 잰 면으로 2.046(기준 2의 +2.3 %, E-18 "손계산 값이 기준 ±10% 안이면 그때만 FEA로 다시 확인" 범위 — FEA 환경 없음 D-16). L 130은 +14 %.
- 편심(참고, 완료 판정 식에는 없음): 누름 점이 평탄부 중심에서 벗어나면 강체 판·안내 없음 가정으로 SF가 1.30(L 130)까지 떨어진다(`handcalc_rx10.json` 'SF(편심 포함…)'). 실제로는 장공 + 칼라 2개(Y −135·−175, 틈 0.05)가 기울기를 일부 받는다. 구상이 로드 구멍·실린더 자리를 그대로 둘지 정할 때 쓸 수치다.

잡음 비·레귤레이터(완료 판정 ④, U6S 식 그대로: F_need = 3·EI·δ/a³ × 슈 길이, F_lo·F_hi = band(P), 움직이는 무게 1.01 N + 늘어난 몫):

| L | 늘린 단면 | W N | P MPa | F_lo | F_hi | F_need | **잡음 비** | 자국 SF | 들기 SF(0.5 MPa) |
|---|---|---|---|---|---|---|---|---|---|
| 90 | — | 1.010 | 0.18 | 8.71 | 21.58 | 6.48 | 1.344 | 1.354 | 5.77 |
| 120 | 전체 | 1.355 | 0.18 | 9.03 | 21.96 | 8.64 | 1.045 | 2.012 | 5.44 |
| 130 | 전체 | 1.470 | 0.18 | 9.13 | 22.08 | 9.36 | **0.975** | 2.234 | 5.34 |
| 130 | 전체 | 1.470 | 0.19 | 9.85 | 22.94 | 9.36 | 1.052 | 2.151 | 5.34 |
| 130 | 전체 | 1.470 | 0.20 | 10.56 | 23.79 | 9.36 | 1.129 | 2.073 | 5.34 |
| 130 | 바닥만 | 1.158 | 0.18 | 8.85 | 21.74 | 9.36 | **0.945** | 2.269 | 5.62 |
| 130 | 바닥만 | 1.158 | 0.19 | 9.56 | 22.60 | 9.36 | 1.022 | 2.183 | 5.62 |
| 130 | 바닥만 | 1.158 | 0.20 | 10.28 | 23.45 | 9.36 | 1.098 | 2.103 | 5.62 |

- IR1000-01BG 범위 0.005~0.2 MPa(상한 0.20). L 130에서 잡음 비 ≥ 1과 자국 SF ≥ 2가 함께 서는 설정은 약 0.185~0.20 MPa다. F_need의 EI·δ·a는 D-164 임시값(U6S 설계 그대로), 슈 길이에 비례시키는 것도 그 식의 가정이다.

## 5. 기각 이유·지킬 것(같은 실수 막기)

| 출처 | 내용 |
|---|---|
| 요구서 5절 RX-10 | "X 폭은 23 그대로(0-8-2② 슈 묶음 폭 < 좁은 홈 25 — 폭으로는 못 푼다)", "더 길게는 하지 않는다"(사용자 2026-11-12 "답도 없이 넓게는 또 하지말고") |
| 결정로그 U6S-D6 | "기울기 압력 자국 SF 1.35(μ 0.4)·1.48·1.64 < 2 … 바닥 유효 폭 ≥ 24.7 또는 길이 ≥ 121, UHMW-PE 덧판" — 폭 24.7은 홈 25와 부딪혀 못 씀 |
| 결정로그 U6S 결과 | "피벗 전 들기 필수, 누름은 SHIFT 0 뒤, 레귤레이터 0.167~0.192 MPa"(U6S-Q1~Q3) — 설정을 바꾸면 이 창과 U6S-D8(0.2 MPa 표시·잠금)을 같이 고친다 |
| U6S 측정(v2.8.13) | 캐리지 통째 들기는 P_M05_GUIDE에 막힘, 슈 +X는 X 12부터 M05 — 이번에도 +X·+Y 쪽은 U7이 막는다 |
| 요구서 1-1 ② · C-03 | 영구 눌림자국 금지. 실제 눌림 복원은 모델로 판정하지 않는다(요구서 7절) — 30 kPa는 D-165 임시 한도 |

## 6. 이미 되는지 판정

| 완료 판정 | 지금(v2.17.1) | 판정 |
|---|---|---|
| ① 자국 SF ≥ 2 | 1.354 (A 1,506.6 · L 90) | **미달** |
| ② 슈 X 폭 ≤ 23 | 23.0 | 만족 |
| ③ 과제 범위 간섭 0 | 지금 슈 ↔ 이웃 11바디 겹침 0(SHIFT 0 · PRESS +4.5, 가장 가까움 E32 3.606) | 만족(지금 형상) |
| ④ 들기·잡음 비·IR1000 | 지금 1.344 · 들기 SF 5.77 | 늘린 뒤 다시 계산 필요 |
| ⑤ E32 시야 가림 0 | 0 | 만족(지금 형상) |
| ⑥ BOM | — | 문서 담당 |

**already_ok = false** — ①이 안 된다. 설계·모델링이 필요하다.

## 워크플로우 메모

- `document.inspect`(measure·sketches·joints 모두 false)도 응답이 1.3 MB라 MCP 결과가 파일로만 온다. dirty·바디 수·타임라인 수만 주는 가벼운 조회가 있으면 읽기 부서의 시작·끝 확인이 빨라진다(RX-06R 메모와 같은 것, 반복).
- 프로브 상자 `solid.box` 하나가 약 1 s(기능 계산 5 ms, 나머지는 큰 문서 갱신). 20개 20 s라 문제는 없었다.
- `inspect.clearance`에서 상자 ↔ `CB3-10_M06` 한 쌍이 "boolean Intersect … no result"로 못 잼(같은 자리의 캐리지·센서 겹침으로 판정은 갈리지 않음).
