hyeunung/FSAP/docs/reports/mechanism/mech_RX-10_verify.md

# 구동 RX-10 검도·체결 — U6 슈 바닥 Y 90 → 130 (검도·체결부, 2026-11-14)

## 요약

- 대상 `3D_Modeling/FSAP_v2.17.2.sc`(앱에 열려 있던 것, dirty false, 피처 3,687 · 오류 0 · 경고 53). **동작 문제 0 → pass.**
- 바뀐 14바디 × 이웃 87(모델링부 81 + 서명 bbox로 따로 고른 5 + `SEAM_G`)을 **16자세**에서 `inspect.clearance`(틈 3)로 쟀다: SHIFT −60·−45·−30·−15·0 × PRESS +4.5, SHIFT 0에서 이웃 조인트 끝값 7점(J_U7_HGT −4·+6, J_U7_CUT 15, J_U7_TUCK 15, J_U3_PRESSER −4, J_U4_PRESS −4.11, J_U4_X 95), 모델링부가 못 잰 **PRESS 75 %(+2.125) · 25 %(−2.625)**. 기계 부품끼리 겹침 0(16/16), truncated false.
- PRESS −2.625에서만 매트 모형과 겹침: `MAT_G` 294.6 mm³(깊이 0.125) · `TP_G_34a` 615.2 mm³(깊이 1.125) — 슈가 매트를 누르는 자세(연구 키는 −0.4까지). 판정 기억 2건.
- 좁은 U홈 매트 전 구간(CYCLE_G1·G2): 연구는 돌리지 않았다(과제 안 검사 규칙). 연구 키로 따지면 슈 바닥 최저 Z 12.1 ≥ 매트·테이프·이음매 모형 최고 Z 12.0 → 매트가 어디에 있어도 겹칠 수 없다. 전 구간 `motion.interference`는 라운드 끝 전체 회귀 몫.
- 완료 판정: ① 자국 SF 2.285(≥ 2) ② X 폭 23.0 ③ 자세 점 간섭 0 ④ 0.19 MPa에서 잡음 비 1.052 · 자국 SF 2.151 · 들기 SF 5.34 ⑤ 슈 ↔ E32 3.606 그대로 ⑥ BOM은 문서 담당 몫(v2.17.2 BOM 아직 없음).
- 옮긴 볼트 `CB5-12_M06_3:2`: 물림 8 mm(1.6d), 렌치 길 겹침 0(실린더 몸과 0.75), 옛 구멍 없음. 조인트 587 · floating 0, 14바디 모두 SHIFT에 +60, PRESS에 슈·로드·너트 2만 따라감.
- 디테일 4건(기록만): 렌치 길 틈 0.75, 피팅 :3 축 ↔ 포트 1.9 어긋남(전부터), 브래킷 M-04 남은 미달(U6S-D2, 전부터), 슈 장공–윗굽힘 4.95 < 2t + R 6(전부터).
- 끝 상태: `edit.restore_checkpoint` → dirty false, REST(슈 X −82~−59 · Z 17, 슈 ↔ `MAT_G` 7.0). 원장 갱신(부품 3,224 · 통과 84), 판정 기억 229건.

## 근거 규칙 (원문)

- E-03 "동작·간섭이 최우선이다", 과제 안 검사(E-17): "대상은 `ledger.py scope`의 새로·바뀜·없어짐 바디와 그 주변 … 뿐이다."
- 안내서 '동작 검사': "관련 조인트 … 마다 행정의 0·25·50·75·100 %에 놓고 … `inspect.clearance` … 로 먼저 재고, 겹친 쌍만 `inspect.interference`로 부피를 잰다."
- M-01 "삽입 경로 | 머리 쪽 축 방향으로 볼트 길이 + 5 mm 동안 다른 부품과 겹침 0", "상대 | … 물림 ≥ 1.5d", "빈자리 | 빈 구멍 0".
- M-04 "구멍–굽힘선 거리 ≥ 2t", 표 "구멍–굽힘선 ≥ 2t + R, … 구멍–판 끝 ≥ 1.5t".
- M-08 의도된 맞닿음은 기준선으로 뺀다. 요구서 7절: 매트 눌림은 모델로 판정하지 않는다.

## 1. 통로·범위·시간

| 항목 | 값 |
|---|---|
| 통로 | MCP(앱 --control 27878). 큰 응답은 `tools/out/mech_RX-10/verify/vrun.py`로 파일에 받음. `open` 0(같은 저장본이 열려 있었음), CLI 0 |
| 범위(`ledger.py scope --joints-changed`) | 전체 검사 예, 바뀜 13(서명 값이 같은 `P_M06_CARR`까지 14), 이웃 12, 유닛 U6_PRESS·U6_SHOE, 가까운 유닛 U6_SENSOR |
| against | 모델링부 `c24_poses.json`의 81 + 서명 bbox(바뀐 바디를 SHIFT +60 · PRESS −9.5로 쓸고 5 mm 넓힘)로 따로 고른 5(`P_M02_SNS_BRKT`, `CJ2B16-60SZ_M06_ROD`·`_NUT_ROD`·`_NUT_ROD2`, `MBIS5-6.5-8_M06_3`) + `SEAM_G` = 87. 빠진 이름 0 |
| 걸린 시간 | 약 75분(예상 15분). `joint.drive J_U6_PRESS` 2번 730 s · 530 s, `edit.restore_checkpoint` 860 s(구동 후보 RX-06-C3 ②), `inspect.clearance` 17번 × 약 90 s |
| 원본 | `tools/out/mech_RX-10/verify/` — `plan.py` · `plan_info.json` · `r10_first.json` · `r11.json` · `r20.json` · `r32.json` · `summary.json` |

## 2. 자세 점 틈·겹침 (바뀐 14 × 이웃 87)

| 자세 | 잰 쌍 | 겹침 | REST와 달라진 가까운 쌍 |
|---|---|---|---|
| SHIFT −60 · PRESS +4.5 (REST) | 76 | 0 | — |
| SHIFT −45 / −30 / −15 | 76 / 78 / 82 | 0 | 없음 |
| SHIFT 0 · PRESS +4.5 | 98 | 0 | `P_M05_GUIDE` ↔ `P_M06_CARR` 2.0(캐리지 겉은 안 바뀜) |
| SHIFT 0 · J_U7_HGT −4 | 101 | 0 | 슈 ↔ `TP_G_34a` 2.0, 슈 ↔ `MAT_G` 3.0(유닛이 4 내려감) |
| SHIFT 0 · J_U7_HGT +6 | 98 | 0 | `P_M06_CARR` ↔ `TL_LOW` 1.339 |
| SHIFT 0 · J_U7_CUT 15 / J_U7_TUCK 15 | 98 / 98 | 0 | 없음 |
| SHIFT 0 · J_U3_PRESSER −4 / J_U4_PRESS −4.11 / J_U4_X 95 | 98 × 3 | 0 | 없음 |
| SHIFT 0 · **PRESS +2.125 (75 %)** | 99 | 0 | 슈 ↔ `CB3-10_M06` 2.016이 3 밖으로 |
| SHIFT 0 · **PRESS −2.625 (25 %)** | 101 | 매트 모형 2 | `MAT_G` 294.6 mm³ · `TP_G_34a` 615.2 mm³ |

- PRESS 0 %(−5.0) · 약 50 %(−0.4) · 100 %는 모델링부 값(겹침은 매트 모형뿐, −0.4에서 슈 ↔ 테이프 1.1 · 매트 2.1)을 쓴다. 이번 두 점을 더해 0·25·50·75·100 %가 찼다.
- 값이 모든 자세에서 같은 가까운 쌍(모델링부 값과 같음): 벽 볼트 :2 ↔ 실린더 몸 2.371, 슈 ↔ 로드 1.0, 슈 ↔ 로드 너트 0.03, 슈 ↔ 칼라 0.05, 슈 ↔ `MBIS5` 0.335, 브래킷 ↔ 로드 2.25, 로드 ↔ 피팅 :2 1.0(실린더 안, 옮기기 전과 같은 상대 자리).
- 계산 못 한 쌍 6(모든 자세 같음): 로드 ↔ 로드 너트 2, 벽 볼트 :2 ↔ 인서트, 피팅 2 ↔ 실린더 포트, 실린더 ↔ 마운트 너트 — 나사 물림(M-08 의도).
- 관 `TU0604_M08P_U6P_A·B`: 자기 피팅(0.0) 말고 3 mm 안 쌍 없음(16자세).
- PRESS −2.625의 매트 겹침: 슈 바닥 Z 9.875 < 매트 윗면 10 · 테이프 11. `machine.json` J_U6_PRESS "−0.4 = 모형 누름 키, 실제 매트 접촉 −2.5, −5.0 = 매트 없을 때만". 유연한 매트를 누르는 접촉이라 허용 — `paircache.py judge` `be40b3f73fd9cef768ec`(슈 ↔ MAT_G) · `f7935af5a70230c5f38a`(슈 ↔ TP_G_34a).

## 3. 좁은 U홈 매트 전 구간(완료 판정 ③)

- 연구 키(`motion.list`, v2.16.0부터 그대로): CYCLE_G1·G2에서 J_U6_SHIFT는 −60·0, J_U6_PRESS는 +4.5·−0.4뿐이고 J_U7_HGT 키는 없다(0). SHIFT가 0에 닿은 단계(14) 뒤에 PRESS가 내려가고(14 → 16), PRESS가 +4.5로 오른 단계(574) 뒤에 SHIFT가 빠진다(574 → 576) — 둘이 함께 움직이지 않는다.
- 슈 바닥 최저 Z = 12.5 − 0.4 = 12.1. 매트 모형 최고 Z(서명): `MAT_G` 10.0, `TP_G_*` 11.0, `SEAM_G` 12.0 → 틈 ≥ 0.1. 매트의 X·Y·회전과 관계없다.
- 이 연구에서 바뀐 부품 둘레(SHIFT 0: X −40~18 · Y −245~−100)에 들어오는 다른 유닛은 없다(U4 바퀴 Y −63~37, U5 대차 d₂ 800, 노루발 Y 0 둘레, U7 CUT·TUCK은 SEAM_U7 연구 — 끝값을 2절에서 쟀다).
- 못 본 것: 연구 단계마다의 `motion.interference`(1,144단계). 라운드 끝 전체 회귀가 본다(E-03·E-17).

## 4. 체결·묶음·포트·판금

| 항목 | 값 | 판정 |
|---|---|---|
| 볼트 `CB5-12_M06_3:2` 자리 | bbox X −91~−74 · Y −181.25~−172.75 · Z 81.75~90.25 → 축 (Y −177, Z 86), 머리 X −79~−74 | 브래킷·인서트·캐리지 자리와 동축 |
| 물림(M-01) | 나사부 X −79 → −91, 브래킷 벽 3 + 인서트 `MBIS5-6.5-8` X −90~−82(8 mm) + 끝 1 mm는 Ø5.2 × 3 구멍 | 8 mm = 1.6d ≥ 1.5d |
| 삽입·렌치 길(M-01) | 머리에서 +X로 Ø8.5 × 30 상자(X −74~−44 · Y −181.25~−172.75 · Z 81.75~90.25): 서명 bbox로 실린더 몸 ↔ 0.75, 로드 ↔ 1.75. 모델링부 실제 프로브 겹침 0(`r25_probe.json`). SHIFT 0 자세에서는 `P_M05_CYL_BRKT`·`KQ2L06-M5A_M05_1` bbox가 끝 2 mm에 걸린다 — 정비는 공기 차단 = 스프링 복귀 −60에서 한다 | 통과(틈 0.75는 디테일) |
| 옛 U6S-D1(렌치 길 ↔ 피팅 :2 0.9 mm³) | 실린더를 180° 돌려 피팅이 Y −163~−141.3으로 갔다 | 풀림 |
| 빈 구멍 | `P_M06_CARR` 부피 190,110.727 그대로(구멍 수 변화 0), 모델링부 `body_topology` Y −170 구멍 없음 | 0 |
| 묶음(E-11) | `joint.list` 조인트 587 · 링크 35 · floating 0 · errors 0. SHIFT 0에서 14바디 모두 dX +60.000. PRESS −2.625에서 슈·로드·로드 너트 2만 dZ −7.125, 나머지 10은 0 | 누락 0 |
| 포트 공간(M-06) | 피팅 2개가 포트에 달려 있고 관이 R 15로 나간다. 피팅 ↔ 다른 부품 3 mm 안 없음(로드는 실린더 안) | 통과 |
| 간이 형상 LITE | 새로 넣은 것 0 | 해당 없음 |
| 판금 슈(M-04, SUS304 t2) | 전개됨(굽힘 3, 안쪽 R 2 = t). 로드 구멍 Ø6 가장자리 X −71 ↔ 굽힘 끝 X −78 = 7 ≥ 6, 구멍 ↔ 날개 끝 3.0 ≥ 3. 입술 플랜지 19 ≥ 8. 장공 아래 7.45 ≥ 6, **위 4.95 < 6**(≥ 2t 4, 전부터) | 새 미달 0 |
| 판금 브래킷(M-04, t3) | 전개됨(굽힘 1, R 3). 옮긴 Ø5.5(Y −177) ↔ 끝 Y −184.5 = 4.75 ≥ 4.5(전 3.25). Y −128 ↔ 끝 3.25 < 4.5, 벽 구멍 ↔ 굽힘은 Z를 안 바꿔 그대로(U6S-D2) | 새 미달 0, 하나 나아짐 |

## 5. 완료 판정

| 항목 | 값 | 판정 |
|---|---|---|
| ① 자국 SF ≥ 2(μ 0.4, F_hi 21.59 N) | 30 kPa ÷ (21.59 ÷ 2,266.599 × (1 + 6 × 0.4 × 20.5 ÷ 130)) = **2.285**. 평탄 길이 119.295로 넣어도 2.230 | 예 |
| ② 슈 X 폭 ≤ 23 | 23.000(앱 `inspect.measure` X −82~−59) | 예 |
| ③ 간섭 0 | 2절 16자세 + 모델링부 3자세, 기계 부품 겹침 0. U홈 전 구간은 3절 | 예(연구 전 구간은 회귀) |
| ④ 들기·잡음 비·설정 | 움직이는 무게 1.470 N. 0.18 MPa 잡음 비 0.975 → **0.19 MPa: F_lo 9.85 · F_hi 22.94 N, 잡음 비 1.052, 자국 SF 2.151**, 창 0.184~0.200(1.006~1.129, SF 2.200~2.073), 들기 SF 5.34. 따로 다시 계산해 모델링부 값과 같음 | 예 |
| ⑤ E32 시야 | 슈 +Y 끝 Y −115 그대로, 슈 ↔ `E32-D36P1_2M_M06` 3.606(끝 상태에서 다시 잼) | 예 |
| ⑥ BOM | `docs/bom/`에 v2.17.2 가공품 표 없음 — 문서 담당 몫(넘길 값은 모델 보고서 8절) | 문서 대기 |

등급 S: 새 구매품 0, 조인트 정의·한계·연구 키 그대로. 다만 실린더·브래킷·캐리지·관까지 14바디가 바뀌어 일의 크기는 M이다(모델링 115분, 검도 75분). 등급 규칙(새 구매품·조인트 변화)으로는 S 그대로 둔다.

## 6. 문제 목록

| 번호 | 종류 | 무엇 | 수치 | 고치는 법 |
|---|---|---|---|---|
| V1 | 디테일 | 옮긴 볼트 렌치 길 ↔ 실린더 몸 틈이 작다 | 0.75(Ø8.5 길, 겹침 0) | 벽 구멍·인서트 자리 Y −177 → −179(브래킷 끝 Y −184.5 → −186.5) |
| V2 | 디테일 | 피팅 `KQ2L06-M5A_M06:3` 나사 축 ↔ 실린더 머리 쪽 포트 어긋남(전부터) | Z 135.2 ↔ 133.3, 1.9 | 피팅 :3을 Z −1.9, 관 A 시작 Z 133.3 |
| V3 | 디테일 | `P_M06_PCYL_BRKT` M-04 남은 미달(U6S-D2, 전부터) | Ø5.5(Y −128) ↔ 끝 3.25 < 4.5, 벽 구멍 ↔ 굽힘 | U6S-D2 고치는 법 그대로(폭 Y −119.5까지, 벽 구멍 Z 89) |
| V4 | 디테일 | `P_M06_SHOE` 장공 윗끝 ↔ 윗날개 굽힘(전부터) | 4.95 < 2t + R 6(≥ 2t 4) | 벽 높이 +1.1 또는 장공 중심 Z −1.1 |

## 7. 원장·끝 상태

- `ledger.py commit --date 2026-11-14`: 부품 3,224 · 통과 84(검도 날짜가 11-14라 그 날짜로 적음). `sigcheck` reuse. 판정 기억 229건.
- 끝: `edit.restore_checkpoint {checkpoint: 102}` → dirty false, 경로 v2.17.2, 피처 3,687 · 오류 0 · 경고 53, 슈 X −82 · Z 17(REST). 저장 0.

## 워크플로우 메모

1. `J_U6_PRESS`를 한 번 몰 때 9~14분, `edit.restore_checkpoint`도 14분(RX-06-C3 ②). 모델링부와 같은 메모 — 이 조인트 두 점에 35분을 썼다.
2. `inspect.clearance`의 `skip_within`은 "occurrence"·"component"·null만 받는다. 바뀐 바디끼리도 보려면 인자를 빼야 한다(한 번 거부됨).
3. `edit.restore_checkpoint`는 `checkpoint` id가 꼭 있어야 한다(없이 부르면 거부). 안내서 '원복'에 id를 적으면 좋겠다.
4. 같은 against(87)로 `inspect.clearance` 한 번이 약 90 s다(`pairs_reused`가 많아도 같다). 이웃 조인트 끝값 7점에 약 11분.
