hyeunung/FSAP/docs/reports/mechanism/mech_RX-11_measure.md

# 구동 RX-11 측정 — U5 먼 쪽 바퀴 밑 받침(고정 띠 → X축 자유 롤러 2줄, C-45)

## 요약

- 대상 `3D_Modeling/FSAP_v2.16.0.sc`(config.json doc, 앱에 열려 있던 것 그대로 MCP로 잼, 읽기만 · 저장 0회 · open 0회). 측정 표 `sigcheck` **reuse**(3,189바디).
- **이미 됨 아님(already_ok false).** 바퀴 길 밑은 아직 고정 띠 `P_DC205_STRIP` + 누름판 8 + `CB5-12_DC205` 8이고 롤러 바디가 없다(바디 정의 880개 가운데 U2 받침 롤러 0, DC205 10). 완료 판정 ①·②·④·⑥은 잴 대상이 없고 ⑤는 띠 항이 그대로다(`machine.json _timing`).
- 바퀴 접지 길: Y 0, **X −1812.5~−407.5**(트레드 폭 25, 중심 −1800 + J_U5_X, J 0~1380). 지금 띠는 X −1826~−391 · Y ±25 · 윗면 Z 0.0, CAD 틈: LIFT −10에서 트레드 ↔ 띠 **0.0016**(J 0·690·1380 모두), 허브 ↔ 띠 10.0.
- **판 `P_M04_PANEL_W2`에는 띠 자리 긴 홈이 없다.** 띠는 판 윗면(Z −8)에 얹혀 있고 판에는 Y 0 줄 Ø36 구멍 8개(띠 보스 자리)뿐이다. 판 위 높이는 8뿐이라 Ø8을 넘는 롤러는 판에 긴 홈(X 약 1,420)을 새로 내야 한다.
- **단면 경계(롤러 2줄이 들어갈 폭)**: 옆 줄 볼(Y ±50, X 피치 100)의 테 Ø44가 |Y| 28(Z −8~−6), 몸통 Ø36이 |Y| 32(Z −30~−6)부터다(CAD: 띠 |Y| 25 ↔ 테 **3.0**). 판 밑은 레일 사이 Y −80~80 · Z −92~−12가 비어 있다(막는 것은 걷어 낼 누름판·볼트와 |Y| 35~80의 L 브래킷 4개뿐).
- **+X 끝이 막혀 있다**: 가로 형재 `HFS8-4080-560_M04`(X −420~−380 · Y ±280 · **Z −92~−12**)가 바퀴 길을 가로지르고 판 W2/E2 이음(X −410)을 받친다. 그 위 높이는 12뿐(CAD: J 1380 트레드 ↔ 형재 **12.0**). 판 밑으로 내린 롤러는 X −420에서 끝나야 하는데 J 1380의 트레드는 X −432.5~−407.5라 **폭 25 가운데 12.5가 형재 위**다(접지 중심 X −420 = 형재 −X 면). 연구가 쓰는 자리(J 800·1000·1360)는 트레드 끝이 X −427.5 이하라 형재 앞 7.5에서 끝난다.
- −X 끝은 비어 있다(X −2167~−1826 · |Y| ≤ 28 · Z −92~0에 판 W2뿐). 원판 `P_M02_DISK` 가장자리 X −300, 띠 끝에서 91.0, J 1380 트레드에서 107.5.
- 구상·설계가 쓸 자료: `tools/out/mech_RX-11/`(`measure.json` 핵심 수치, `parts_table.csv`·`.json` 구역 안 350바디 bbox·부피·재질, `probes_bbox.json` 통로 10개, `probe_strip_rest.json` CAD 틈, `panel_w2_holes.json` 판 구멍, `ball_centers.json`, `timing_now.json`).
- 미완: 통로 프로브의 겹침 mm³는 CAD 불리언이 아니라 서명 bbox 계산(상한)이다 — 열린 문서에 프로브 바디를 만들지 않았다(1절). 판 `P_M04_PANEL_E2`의 구멍 배치는 재지 않았다.

## 근거 규칙 (원문)

- E-17: "reuse면 … bbox·부피·질량·유닛을 그대로 쓰고, 과제 영역의 통로·프로브만 새로 잰다". 결과 `{"mode": "reuse", "reason": "문서·해시가 같다", "parts": 3189}`(측정 전후 같음).
- E-04·실행 규칙 2: "혼자 도는 읽기 부서도 MCP로 잰다 … 저장은 하지 않는다(`save` 금지, 끝나면 `motion.play` step 0)".
- 안내서 '원복': "`save {path}` 뒤에도 앱 자동 저장으로 그 뒤 편집이 파일에 들어간 적이 있다" → 열린 문서에 프로브 바디를 만들지 않고, 조인트만 `edit.checkpoint` 안에서 움직였다.
- E-02: "강도 여유·정밀 체인·새 볼트 렌치 접근·판금 규칙은 디테일로 기록만". 롤러 처짐·베어링 SF(완료 판정 ④)는 설계가 계산할 값이고 여기서는 입력 수치만 모았다.
- E-16: "판정은 수치로만". 스크린샷·사진은 열지 않았다.
- 요구서 5절 RX-11 완료 판정: "U5 행정 전 구간 받침 연속, 매트 3장 + RX-12 매트 전 구간 간섭 0, 롤러 처짐·베어링 하중 손계산(바퀴 누름), DC-02 회전 시간·SF를 띠 미끄럼 항 없이 다시 계산, BOM".

## 1. 대상 문서·통로·원복

| 항목 | 값 |
|---|---|
| 문서 | `3D_Modeling/FSAP_v2.16.0.sc`(tools/config.json doc), 5,666,022 B, sha1 앞 16자 `b570eae7eefc9920`(측정 전후 같음, 서명 `doc_hash`와 같음) |
| 앱 상태(처음) | `running` 빈 목록. 열린 설계 name `FSAP_v2.16.0`, path 같음, **dirty false**, 타임라인 3,712(오류 0 · 경고 54), 바디 정의 880, 숨긴 바디 98. 같은 경로라 `open`은 부르지 않았다 |
| 측정 표(E-17) | `ledger.py sigcheck` reuse. bbox·부피·질량·재질은 `tools/out/signatures.json` 그대로 |
| 통로 | MCP. 호출 10(`running` 1 · `inspect_design` 2 · `list_commands` 3 · `body_topology` 2 · `batch` 2 = 16단계, 묶음 걸린 시간 4.6 s + 2.3 s). 파일 열기 0, 브라우저 0 |
| 원복(E-08) | `edit.checkpoint` 80 → `joint.drive` J_U5_LIFT −10, J_U5_X 0 · 690 · 1380 → 0 · 30으로 되돌림 → `edit.restore_checkpoint` restored true → `motion.play REST 0` **moved false**. 끝 `inspect_design`: dirty false · 타임라인 3,712 · 바디 880(처음과 같음) |
| 프로브 방식 | 틈은 기존 바디끼리 `inspect.clearance`(CAD, 정확). 통로 상자의 막는 부품·겹침은 서명 bbox로 계산(`probes_bbox.json`, 상자 부품은 정확, 둥근 부품은 상한) |

## 2. 과제에 걸린 현재 부품·구동 요소 (세계 좌표 mm, REST)

### 2-1. 걷어 낼 것 (유닛 U2_TABLE)

| 바디 | X | Y | Z | 부피 mm³ | 질량 g | 재질 | 형상·체결 |
|---|---|---|---|---|---|---|---|
| `P_DC205_STRIP` | −1826~−391 | ±25 | −11.8~0 | 602,125.7 | 1,613.7 | A5052 | 판 50×8(Z −8~0, 판 W2 윗면에 얹힘) + 보스 Ø35.6 ×8(Z −11.8~−8, 판 구멍 Ø36 안) + M5 탭 ×8. 끝 R 0.5 |
| `P_DC205_DISC_1~8` | 중심 −1750 · −1600 · −1400 · −1250 · −1000 · −800 · −600 · −450 (±25) | ±25 | −16~−12 | 7,758.7 각 | 61.5 각 | SUS304 | Ø50 t4 누름판, 판 밑에서 조임. 띠 보스와 틈 0.2 |
| `CB5-12_DC205` ×8 | 같은 X (±4.2) | ±4.2 | −21~−4 | 476.4 각 | 3.74 각 | SCM435 | 밑에서 위로, 띠 M5 탭에 물림 |

### 2-2. 남는 이웃

| 바디 | X | Y | Z | 부피 mm³ | 재질 | 띠 자리와의 관계 |
|---|---|---|---|---|---|---|
| `P_M04_PANEL_W2` | −2175~−410 | ±300 | −12~−8 | 3,785,401 | SUS304 t4 | 띠 밑 판. **긴 홈 없음.** 구멍(CAD `body_topology`): 볼 구멍 Ø36 102개(X −2050…−450 피치 100 × Y ±50·±150·±250), 띠 보스 구멍 Ø36 8개(Y 0, X는 2-1과 같음), 접시 M5 12개(X −2100…−600 피치 300 × Y ±100) |
| `P_M04_PANEL_E2` | −410~975 | ±300 | −12~−8 | 2,680,301 | SUS304 t4 | X −410부터. 띠 +X 끝 19(X −410~−391)가 이 판 위. 원판 둘레 틈 5.0(CAD) |
| `STEP대기_BALL_D25_M04` (Y ±50 줄) | 중심 −2050…−350 피치 100 (±22) | 28~72 / −72~−28 | −30~0 | 26,641 각 | Nylon(임시 형상) | 테 Ø44 Z −8~−6, 몸통 Ø36 Z −30~−6, 구 꼭대기 Z 0. **Y 0 줄에는 볼이 없다.** 다음 줄은 Y ±150 |
| `HFS8-4080-1755_M04` ×2 (레일) | −2650~200 | 80~120 / −120~−80 | −92~−12 | 1,966,582 각 | Aluminum | 판을 받치는 레일. 안쪽 면 사이 160 |
| `HFS8-4080-3080_M04` ×4 (침목) | −2155~−2115 · −1555~−1515 · −955~−915 · −460~−420 | −2015~1540 | −172~−92 | 3,451,420 | Aluminum | 레일 밑. 윗면 Z −92 |
| **`HFS8-4080-560_M04`** (:1) | **−420~−380** | ±280 | **−92~−12** | 624,561 | Aluminum | 바퀴 길을 가로지름. 판 W2/E2 이음 받침. 윗면 Z −12 |
| `SFB5-10_M04R` ×2 + `HNTT8-5_M04` (:99·:100) | −405~−395 / −408.5~−391.5 | ±(45~55) / ±(41.5~58.5) | −18~−8 / −23.5~−14.5 | 260 / 1,896 | SCM435 / Steel | 판 이음을 위 형재에 고정. \|Y\| ≥ 41.5 |
| `P_M04_LBRKC_NY_PZ` (:15 · :16) | −2150~−2120 · −950~−920 | 35~80 | −92~−47 | 14,140 각 | SUS304 | 침목–레일 L 브래킷(레일 안쪽) |
| `P_M04_LBRKC_PY_PZ` (:15 · :16) | −1550~−1520 · −455~−425 | −80~−35 | −92~−47 | 14,140 각 | SUS304 | 같음. 볼트 `CB5-16_M04K_*`, 너트 `HNTT8-5_M04K_*` |
| `SFB5-10_M04` ×12 + `HNTT8-5_M04` | −2100…−600 피치 300 (±5 / ±8.5) | ±(95~105) / ±(91.5~108.5) | −18~−8 / −23.5~−14.5 | — | SCM435 / Steel | 판 W2 → 레일. 띠 자리 밖 |
| `HFC8-4080-B_M04_W` ×2 (끝 캡) | −2178~−2167 | ±(80~120) | −92~−12 | 6,346 | Default | 레일 −X 끝 |
| `P_M02_DISK` (U4) | −300~−50 (Ø250, 중심 −175) | ±125 | −12~0 | 583,642 | A5052 | 자유 회전 원판, 윗면 Z 0. 띠 끝에서 91.0(CAD) |
| `HFS8-4080-560_M04` (:2) + `P_M04R_DB_SHIM_A` | −305~−265 | ±280 / ±135 | −132~−52 / −52~−48 | 624,561 / 43,010 | Aluminum / SUS304 | 원판 받침 밑 형재 |
| `P_M02_DISK_BASE` (U4) | −300~−50 | ±135 | −48~−40 | 514,645 | SUS304 | 원판 받침 판 |

### 2-3. 구동 요소 (`tools/machine.json`)

| 조인트 | 범위 | 대기 | 쓰는 값 | 받침과의 관계 |
|---|---|---|---|---|
| `J_U5_X` (슬라이드 +X) | 0~1380 | 0 | L 800(d₂ 1000) · G 1000(d₂ 800) · V·W 1360(d₂ 440) · S는 안 내림 | 바퀴 중심 X = −1800 + J. 트레드 X 중심 ± 12.5 |
| `J_U5_LIFT` (MGPM25-40Z) | −10~30 | 30 | 끝점만: 30 들림 · −10 내림 | 30에서 트레드 밑 Z 40.0, −10(FLOAT 0)에서 Z 0.0014 |
| `J_U5_FLOAT` (스프링 플로트) | 0~20 | 0 | 매트 두께만큼 들림(10, 범위 6~16) | 운전 때 트레드 밑 = 매트 윗면 Z 10 |
| `J_U5_WHEEL_ROT` | ±72,000° | 0 | — | 축 X, 매트를 Y로 굴림. 접지선 Y 0 |
| `J_U4_X` (셋업, 손) | 0~95 | 0 | d₁ 100~195 | U4 바퀴만 −X로(원판은 안 움직임). J 1380에서 두 트레드 사이 295.0(CAD, d₁ 100) → d₁ 195면 200.0(계산) |

바퀴(D-93 임시): `P_M03_WHEEL_TREAD` Ø120 × 폭 25, Urethane_A70, 부피 86,398. 허브 `P_M03_WHEEL`은 트레드 밑보다 10 위. U5 유닛 275바디 가운데 가장 낮은 것이 트레드(REST Z 40.0)이고 다음은 허브 50, 센서 브래킷 55다.

바퀴 누름(손계산 입력, 결정로그 RX-07-C3): 매트 45.74 · 테이프 46.14 · 이음매 **46.54 N**, 오설정 바닥(매트 없음, 내림 끝) **130 N**.

### 2-4. 구매품 길이 확인 (WF-128)

| 구매품 | bbox 길이 | 부피 ÷ 단면 | 판정 |
|---|---|---|---|
| `HFS8-4080-1755_M04` | X 2,850 | 1,966,582 ÷ 1,120.6 = 1,755.0 | 이름대로 1,755(bbox는 끊긴 두 덩어리 — DC2-05 측정 기록과 같음). 레일은 \|Y\| ≥ 80이라 판정에 영향 없음 |
| `HFS8-4080-560_M04` | Y 560 | 624,561 ÷ 1,120.6 = 557.3 | 560(가공 구멍 몫 −0.5 %) |
| `HFS8-4080-3080_M04` | Y 3,555 | 3,451,420 ÷ 1,120.6 = 3,080.0 | 이름대로 3,080 |
| `STEP대기_BALL_D25_M04` | Ø44 × 30 | 26,641(임시 형상 계산값) | 임시 형상(형번 D-96) |
| `CB5-12_DC205` | Ø8.5 × 17 | — | 머리 5 + 12 |

## 3. 비어 있는 공간(통로)

### 3-1. 바퀴 길 단면 (Y–Z, 볼 줄 X에서 가장 좁다)

| Z 구간 | 쓸 수 있는 \|Y\| | 경계 | 근거 |
|---|---|---|---|
| 0~10 | — | 매트(두께 10, 범위 6~16). 롤러 윗면은 Z 0 ± 0.1 | 볼 꼭대기 Z 0.0 |
| −6~0 | ≤ 39.2(Z −6) ~ 50(Z 0) | 옆 줄 볼의 구(Ø25.4, 중심 Z −12.7) | 계산 |
| −8~−6 | **≤ 28** | 옆 줄 볼 테 Ø44 | CAD 띠(\|Y\| 25) ↔ 테 3.0 |
| −12~−8 | ≤ 32(판을 따 낸 곳만) | 판 W2 t4(긴 홈 없음), 볼 몸통 Ø36 | `body_topology` |
| −30~−12 | **≤ 32** | 볼 몸통 Ø36 | 서명 bbox |
| −47~−30 | ≤ 80 | 레일 안쪽 면 | 서명 bbox |
| −92~−47 | ≤ 80, 단 L 브래킷 자리 X 4곳은 한쪽이 \|Y\| 35까지 | L 브래킷 4개 | 서명 bbox |
| −92 밑 | 침목 4개(X 2-2) 사이만 | 침목 윗면 Z −92 | 서명 bbox |

볼은 X −2050…−350에 100 간격(±22)이라 그 사이 X 56 구간은 판 밑 \|Y\| ≤ 80까지 비지만, 롤러는 X로 이어지므로 위 표가 경계다.

### 3-2. 통로 상자 (`probes_bbox.json`, 서명 bbox 겹침 — 상자 부품은 정확, 둥근 부품은 상한)

| 통로 | X | Y | Z | 막는 부품 | 겹침 mm³ |
|---|---|---|---|---|---|
| P1 띠 자리(판 위) | −1826~−391 | ±25 | −8~0 | `P_DC205_STRIP`(걷어 냄) · `CB5-12_DC205` 8(걷어 냄) | 574,000 · 2,312 |
| P9 판 위 넓게 | −1826~−391 | ±32 | −8~0 | 위 + 옆 줄 볼 28개(테 \|Y\| 28~32) | + 39,413(상한) |
| P2 판 두께 | −1826~−391 | ±28 | −12~−8 | `P_M04_PANEL_W2` · `P_M04_PANEL_E2`(X −410~−391) · 띠 보스 | 317,184 · 4,256 |
| P3 판 밑 좁은 홈통 | −1826~−420 | ±28 | −60~−12 | `P_DC205_DISC` 8 · `CB5-12_DC205` 8(모두 걷어 냄) | 79,997 · 5,202. **걷으면 0** |
| P4 판 밑 레일 사이 | −2167~−420 | ±80 | −92~−12 | 볼 몸통 34 · L 브래킷 4 · `CB5-16_M04K_*` 8 · (걷어 낼 누름판·볼트) | 1,184,778(상한) · 243,000 · 6,359 |
| P8 롤러 2줄 외곽 예(Ø25 ×2) | −1826~−420 | ±26 | −25~0 | 띠 · 누름판 · 볼트(걷어 냄) · **판 W2** | 판 292,448(= 긴 홈으로 따 낼 몫) |
| P5 +X 끝 형재 위 | −420~−380 | ±28 | −12~0 | 띠 끝 · 판 W2(X −420~−410) · 판 E2(X −410~−380). **밑은 `HFS8-4080-560_M04` 윗면 Z −12** | 17,110 · 2,240 · 6,720 |
| P6 형재 ~ 원판 받침 사이 | −380~−305 | ±45 | −92~0 | 판 E2 · 볼 2개(X −350, Y ±50) | 27,000 · 44,877(상한). \|Y\| ≤ 28 · Z < −12는 비어 있음 |
| P7 −X 끝 연장 | −2167~−1826 | ±28 | −92~0 | 판 W2뿐 | 76,384 |
| P10 매트 층 | −1826~−391 | ±28 | 0~10 | REST 로딩 자리의 `MAT_L`·`G`·`V`·`W`, 테이프 조각 | 맞닿음(매트 밑 Z 0 = 받침 윗면), 정상 |

### 3-3. CAD 틈 (`inspect.clearance`, 정확)

| 자세 | 쌍 | 거리 mm | 자리 |
|---|---|---|---|
| LIFT −10 · J 0 (트레드 X −1812.5~−1787.5) | 트레드 ↔ 띠 | 0.0016 | Z 0 |
| | 허브 ↔ 띠 | 10.0 | |
| | 트레드 ↔ 볼 테(X −1850·−1750, Y ±50) | 24.81 | 테 윗면 Z −6 |
| LIFT −10 · J 690 (X −1122.5~−1097.5) | 트레드 ↔ 띠 | 0.0016 | |
| | 트레드 ↔ 볼(−1150, ±50) / (−1050, ±50) | 18.45 / 32.58 | |
| LIFT −10 · J 1380 (X −432.5~−407.5) | 트레드 ↔ 띠 | 0.0016 | |
| | **트레드 ↔ `HFS8-4080-560_M04`** | **12.0** | X −417, Z 0 → −12 |
| | 트레드 ↔ 볼(−450, ±50) / (−350, ±50) | 14.19 / 41.15 | |
| | 트레드 ↔ `P_M02_DISK` | 107.5 | X −407.5 → −300 |
| | 트레드 ↔ U4 트레드 `P_M02_WHEEL_TREAD` | 295.0 | d₁ 100 |
| REST | 띠 ↔ 볼 테(−450, −50) | 3.0 | Y −25 → −28 |
| | 띠 ↔ `P_DC205_DISC_8` | 0.2 | Z −11.8 → −12 |
| | 띠 ↔ `HFS8-4080-560_M04` | 4.01 | 판 두께 |
| | 띠 −X 끝 ↔ 볼(−1850, −50) | 12.66 | |
| | 띠 +X 끝 ↔ 볼(−350, −50) | 26.02 | |
| | 띠 +X 끝 ↔ `P_M02_DISK` | 91.0 | |
| | 띠 ↔ `MAT_L` · `MAT_W` | 0.0 | 매트 밑면이 띠 윗면에 얹힘 |
| | `P_M02_DISK` ↔ 볼(−350, ±50) | 35.0 | |

겹침은 0쌍, 못 잰 쌍 0.

### 3-4. X 방향 끝

| 끝 | 바퀴 | 받침이 닿아야 하는 X | 막는 것 |
|---|---|---|---|
| −X | J 0: 트레드 −1812.5~−1787.5 | ≤ −1812.5 | 없음. X −2167까지 판 W2뿐. 지금 띠 끝 −1826(여유 13.5) |
| +X | J 1380: 트레드 −432.5~−407.5, 접지 중심 −420 | ≥ −407.5 | **`HFS8-4080-560_M04` X −420~−380, 윗면 Z −12.** 판 밑으로 내린 롤러(지름 > 약 11)는 X ≤ −420에서 끝난다 → J 1380에서 트레드 폭 12.5(50 %)가 롤러 밖 |
| +X (쓰는 자리) | J 1360(V·W): 트레드 −452.5~−427.5 | ≥ −427.5 | 형재 앞 7.5. J ≤ 1367.5(d₂ ≥ 432.5)면 트레드 전체가 X ≤ −420 |

형재 건너편 X −380~−305 · \|Y\| ≤ 28 · Z −92~−12는 비어 있다(P6). 그다음은 원판 받침 밑 형재(X −305~−265, Z −132~−52)와 원판 받침 판(X −300~, Z −48~−40), 원판(X −300~, Z −12~0)이다.

### 3-5. 이웃 가동 유닛의 점유 (상태별, 요구서 6-4 · `machine.json` states)

| 상태 | J_U5_X | LIFT · FLOAT | 트레드 X | 트레드 밑 Z | 받침 위 매트 |
|---|---|---|---|---|---|
| 대기·로딩·배출, 작은 매트 전 구간 | 0 | 30 · 0 | −1812.5~−1787.5 | 40.0 | 로딩 자리 매트(L은 X −1493.5까지) |
| 큰 매트 직선·볼록 모서리·이음매 (`CYCLE_L` 50~668) | 800 | −10 · 10 | −1012.5~−987.5 | 10 | `MAT_L` |
| 홈 매트 입구·안 벽·모서리 (`CYCLE_G1`·`G2`) | 1000 | −10 · 10, 홈 바닥 끝(321~492)은 30 | −812.5~−787.5 | 10 / 40 | `MAT_G` |
| V홈 매트 (`CYCLE_V`) | 1360 | −10 · 10, 꼭짓점 ROT −35~입구2 ROT −30은 30 | −452.5~−427.5 | 10 / 40 | `MAT_V` |
| 긴 매트 + 넓은 오목 (`CYCLE_W1`·`W2`) | 1360 | −10 · 10, 매트 밖 구간은 30 | −452.5~−427.5 | 10 / 40 | `MAT_W` |
| 행정 끝(연구에 없음) | 1380 | — | −432.5~−407.5 | — | — |
| 두께 6 · 16 (`THICK_6`·`THICK_16`) | 800 | −10 · 6 / 16 | −1012.5~−987.5 | 6 / 16 | — |

- U5의 어떤 바디도 Z 0 밑으로 내려오지 않는다(가장 낮은 것이 트레드, 내림 끝 Z 0.0014). 받침은 Z ≤ 0에만 있으므로 U5와는 트레드 밑면에서만 만난다.
- U4: 원판 `P_M02_DISK`는 제자리 회전(X −300~−50), 바퀴는 셋업 `J_U4_X` 0~95로만 X 이동. 받침 구간(X ≤ −391)에는 들어오지 않는다.
- 매트는 Z 0~10 층에서 X 약 −2112~+1052 · Y ±1494를 휘두른다(0-8-5). 받침 윗면이 Z 0을 넘으면 어느 연구에서나 매트 밑면과 겹친다.

## 4. 작업 대상

- 모형: `MAT_L` 1500×1500, `MAT_S` 300×200, `MAT_G` 1200×1200 U홈 25×150, `MAT_V` 1200×1200 V 30°, `MAT_W` 1500×700 오목 500×300(임시 D-01·D-02). 두께 10(범위 6~16, D-04), 테이프 1. 밑면 Z 0.
- 사이클(0-3 · 0-8-4): ① 로딩(−Y 300 자리에 올려 +Y로) → ② U4 내림, U5 대차 이동·내림 → ③ 한 바퀴 봉제(매트가 접지선 Y 0을 Y로 지나가고, 모서리에서는 바늘 둘레로 돈다) → ④ 이음매 → ⑤ 배출(−Y).
- 받침 위에서의 매트 움직임: 직선 봉제는 Y 방향(롤러 축 X와 직각 → 구름), 모서리 회전은 바늘(X 0) 둘레 접선 방향 = U5 자리에서 Y 방향(구름). X 방향 성분은 로딩·배출과 회전 중 접지선 밖 넓이에서만 생긴다(롤러 위 축 방향 미끄럼 — 7절 기록 대상).
- 가공 뒤 형상: 테이프가 감긴 매트. 떨어지는 조각 없음(`workpiece_stages.fragments` 없음). 빠져나갈 길은 배출 −Y, 받침 윗면이 Z 0이면 볼 면과 같은 높이로 지나간다.
- 매트·테이프의 유연한 거동(두 롤러 사이 폭에서 매트가 눌려 들어가는 양, 롤러 자국·끼임)은 모델로 판정하지 않는다(실행 규칙 6, 요구서 7절).

## 5. 앞서 정한 것·기각된 것 (같은 실수 막기)

| 출처 | 내용 |
|---|---|
| 결정로그 C-45 (사용자 2026-11-13) | "U5 먼 쪽 바퀴 밑 받침을 R375X처럼 롤러 2줄로 바꾼다 … 고정 PTFE 띠 `P_DC205_STRIP`은 걷어 낸다". 사용자 원문 "2줄로가 r375x도 그렇게 되어 있잖아". 띠를 남기거나 한 줄·볼 띠로 바꾸는 안은 이 결정과 어긋난다 |
| benchmark.md 다-4 (216~218행) | 확실: 원판 왼쪽 X 긴 홈에 둥근 봉 2줄, "오른쪽 끝은 원판 바로 앞에서 받침에 물려 끝난다", 봉 앞에 흰 띠. 추정(신뢰 중간): 자유 롤러. 모름: 지름·길이·베어링·흰 띠 정체(D-200) |
| 결정로그 M04-M1 → DC2-05 | Y 0 줄 고하중 볼 28개 안은 받침이 점 29개라 빈 구간 28개(바퀴 폭 25 < 볼 피치 50)로 닫지 못했다. 받침은 X로 이어져야 한다 |
| DC2-05 디테일 3 | 띠 밑면 표기 차이(Z −7.99 / 8.00). 새 받침의 높이 사슬은 볼 꼭대기 Z 0에 맞춘다(±0.1) |
| VGR-01-M5 · DC-02 (다) | "U5 접점 밑을 자유 회전 원판으로"는 구조 변경이라 하지 않았고 시간 키만 늘렸다. 이번 과제가 그 구조 변경(구르는 받침)이다 |
| DC-02 · DC-01 · VGR-01 · DC-04 · RX-12 | 시간 키에 띠 미끄럼 μs 0.30 · 40 N · d₂ 항이 들어 있다: `CYCLE_L_모서리` 7.5 s(SF 1.014, 노루발 끌림 포함 1.009), `CYCLE_G2_모서리` 4.5 s(1.045 / 1.039), `CYCLE_G1_바닥` U4+U5 1.2 s ×9(1.054), `CYCLE_V` 입구1 4.4 · 꼭짓점 2.0 ×4 · 1.3 · 입구2 2.7 s(최저 1.009), `CYCLE_W` 임시 4.1 · 4.2 · 2.8 · 1.6 s(RX-12-C4). 원본 `tools/out/mech_RX-11/timing_now.json`, 계산식 `tools/out/mech_VGR-01/fix1calc.py`, `mech_DC-02/design/dc02design.json`, `mech_DC-01/g1calc.json`, `mech_DC-04/design/dc04design.json`, `mech_RX-12/model/handcalc_w.json` |
| 실행 규칙 13·14 | 커버·외장은 구동이 아니다. 받침 롤러는 작업 대상을 다루는 받침이라 구동 과제 범위다 |

## 6. 이미 되는지 판정 (E-17 과제 범위)

| 완료 판정 | 지금 모델 | 결과 |
|---|---|---|
| ① 바퀴 접지점 밑 롤러 받침이 전 구간 이어짐 | 롤러 없음. 고정 띠가 X −1826~−391을 이어 받침(트레드 ↔ 띠 0.0016, J 0·690·1380) | **안 됨**(받침은 이어지나 롤러가 아님) |
| ② 롤러 윗면 Z 0 ± 0.1 | 롤러 없음(띠 윗면 Z 0.0, 볼 꼭대기 Z 0.0) | 대상 없음 |
| ③ 과제 범위 간섭 0 | 지금 모델은 바퀴 3자세에서 겹침 0 · 못 잰 쌍 0 | 롤러를 넣은 뒤 다시 잼 |
| ④ 롤러 처짐 · 베어링 SF 손계산 | 대상 없음 | 대상 없음 |
| ⑤ 시간 · SF를 띠 항 없이 다시 계산 | `_timing`에 띠 μs 0.30 항 그대로 | **안 됨** |
| ⑥ 걷어 낸 부품 잔재 0, BOM · D-97 · D-200 | `P_DC205_STRIP` 1 + `P_DC205_DISC` 8 + `CB5-12_DC205` 8 = 17바디 그대로 | **안 됨** |

→ **already_ok = false.** 설계·모델링이 필요하다.

## 7. 설계가 풀어야 할 제약 (측정에서 나온 사실)

1. 판 `P_M04_PANEL_W2`에 긴 홈이 없다. 롤러 윗면을 Z 0에 두면 롤러 밑이 Z −지름이라, 지름이 8을 넘으면 판에 X 약 −1826~−410(판 +X 끝까지)의 긴 홈이 필요하다. 홈 폭은 옆 줄 볼 구멍(Ø36, 가장자리 \|Y\| 32)과의 살을 봐야 한다. 지금 판에는 Y 0 줄 Ø36 구멍 8개가 이미 있다.
2. 롤러 2줄의 바깥 폭: Z −8~−6에서 \|Y\| ≤ 28, Z −30~−8에서 \|Y\| ≤ 32(볼 테 · 몸통). 예: 지름 25 두 줄을 중심 Y ±13에 두면 Z −8~−6 구간의 바깥 끝이 \|Y\| 23.7~24.7, 중심 높이(Z −12.5)에서 25.5다(계산).
3. 받칠 자리: 판 밑 레일 안쪽 면(Y ±80, X로 이어진 홈)과 침목 윗면(Z −92, X 4곳). 침목 사이 맑은 길이 560 · 560 · 455(X −2115~−1555, −1515~−955, −915~−460). L 브래킷 4개(\|Y\| 35~80 · Z −92~−47)를 피해야 한다.
4. +X 끝: `HFS8-4080-560_M04`(X −420~−380, 윗면 Z −12)가 판 이음을 받치며 길을 막는다. 완료 판정 ①은 J 1380(트레드 X −432.5~−407.5, 접지 중심 −420)에서도 받침을 요구한다. 형재 위에 남는 높이는 12(판을 따 내면), 판 위로는 8이다. 형재를 건드리면 판 W2/E2 이음 고정(`SFB5-10_M04R` ×2, `HNTT8-5_M04` :99·:100, Y ±50)이 걸린다.
5. 나눔: 롤러를 X로 나누면 이음 틈이 바퀴 접지 폭 25보다 작아야 하고(완료 판정 ①), 두 줄의 이음이 같은 X에 오면 그 X에서 두 줄이 함께 빈다.
6. 걷어 낸 뒤 남는 것: 판의 Y 0 줄 Ø36 구멍 8개(긴 홈을 내면 함께 없어짐).

## 미완

- 통로 상자의 겹침 mm³는 서명 bbox 계산이다(CAD 불리언 아님). 둥근 부품(볼 · 볼트)은 상한이고, 볼과의 실제 경계는 3-1 표(테 Ø44 · 몸통 Ø36 · 구 Ø25.4)와 CAD 틈 3.0으로 대신했다.
- `P_M04_PANEL_E2`의 구멍 배치(X −410~−300 구간)는 재지 않았다. 그 구간 볼은 X −350 · Y ±50 두 개(서명).
- 첫 측정 묶음(바퀴 3자세)의 원자료는 파일로 남기지 않고 `measure.json`에 수치만 옮겼다. 둘째 묶음은 `probe_strip_rest.json`.
- 볼 형상은 임시 형상 `STEP대기_BALL_D25_M04`다(D-96). 실물 테 지름이 다르면 3-1 경계가 바뀐다.

## 워크플로우 메모

- `inspect_design {"measure":false,"sketches":false,"joints":false}`가 이 문서에서 1.3 MB(6만 줄)를 돌려준다 · dirty·path·타임라인 수만 보려는 호출이 두 번 다 파일로 넘어갔다 · 안내서 '문서 확인'에 dirty·path만 읽는 가벼운 명령(또는 결과를 파일로 받아 grep 하는 절차)을 적으면 좋다.
- `body_topology {"faces":"cylinders"}`도 구멍이 122개인 판에서 화면 출력이 매우 길다(약 2,400줄) · E-20 "화면엔 15줄 요약"과 어긋난다 · 구멍이 많은 판은 CLI로 파일에 받아 요약만 읽게 안내서에 적으면 좋다.
- 측정부 지시의 "원통·박스 프로브로 재고"는 SolidCraft 앱 세션에서는 프로브 바디를 만들어야 해서 열린 저장본을 바꿀 위험(자동 저장)이 있다 · 이번에는 서명 bbox 계산 + 기존 바디끼리 틈으로 대신했다 · 안내서에 '읽기 부서의 프로브는 서명 bbox 계산 또는 저장본 CLI'라고 통로를 정해 두면 좋다.
