hyeunung/FSAP/docs/reports/mechanism/mech_RX-11_verify.md

# 구동 RX-11 검도·체결 — U5 먼 쪽 바퀴 밑 받침 X축 자유 롤러 2줄 (C-45)

## 요약

- 판정: **합격(동작 문제 0)**. 대상 `3D_Modeling/FSAP_v2.17.0.sc`(앱에 열려 있던 것, dirty false, 저장 안 함). 통로 MCP(앱), 설계 파일 새로 열기 0회.
- REST 정적(기준선 없이, M-08): 새·바뀐 56바디끼리 232쌍 + 주변 83바디 183쌍 + 볼 167개 191쌍 — **겹침 0**, truncated false.
- U5 조인트 점(J_U5_X 0·345·690·1035·1380 + 나눔 틈 가운데 178·610·1258, LIFT −10 / 30): U5 낮은 18바디 × 새 부품·주변 — **겹침 0**, 트레드 ↔ 롤러 0.859(8점 모두), 틈 가운데에서는 양쪽 롤러 4개에 0.859.
- 매트 상태 13점(L 3 · S 1 · G 3 · V 2 · W 4, RX-12 매트 포함): 매트 + U5 × 새 부품 — **겹침 0**, 매트 ↔ 롤러 0.010(얹힘), 매트 ↔ 새들 2.000.
- 완료 판정 ① 받침 이어짐(틈 16 < 트레드 25, 양 끝 여유 17.5·73.5) ② 롤러 윗면 Z −0.0002(14/14), 볼 꼭대기 Z 0.000 ③ 간섭 0 ④ 롤러 처짐 0.005 / 0.014 mm, 696ZZ SF 14.4 / 5.15 ⑤ 시간 키 SF 다시 셈 4구간 일치(최저 1.146) ⑥ DC205 잔재 0 — 모델 몫은 모두 만족. BOM·자료대기 D-97·D-200 문구는 문서 담당 차례(아직 안 고쳐짐).
- 새 볼트 `CB5-20_RX11` ×8: 물림 11.5 ≥ 7.5, 삽입·렌치 길(Ø8.5 × 30)에 기계 부품 0(8개 모두 bbox, 1·4·8은 모델링부 저장본 프로브), 떠 있는 부품 0.
- 디테일 3건(수정 회차 안 씀): V1 모서리 끝 자세에서 매트 끝(Y 6.5)이 +Y 롤러 받침선(Y 11) 밖 — 바퀴 밑 받침이 한 줄(7절 기록·구동 후보로 올릴지 판단 필요), V2 STEP 대기 2종(외부), V3 판 살 처짐 어림.
- 원장 갱신(부품 3,224 · 통과 84), 판정 기억 2건(227건). 끝 상태: `edit.restore_checkpoint` → dirty false, 피처 3,687, 대기 자세.

## 근거 규칙 (원문)

- E-03: "동작·간섭이 최우선이다". E-17(과제 안 검사): "대상은 `ledger.py scope`의 새로·바뀜·없어짐 바디와 그 주변 … 전체 사이클은 라운드 끝 전체 회귀가 한 번".
- E-02: 강도 여유·정밀 체인·렌치 접근·판금은 "디테일로 기록만 하고 수정 회차를 쓰지 않는다".
- M-01: "삽입 경로 — 머리 쪽 축 방향으로 볼트 길이 + 5 mm 동안 다른 부품과 겹침 0", "상대 — 물림 ≥ 1.5d", 프로브 길이 "max(30, 볼트 길이 + 5) mm".
- M-08: "기준선 없이 전 부품 쌍 정적 겹침 전수 … 정상 겹침: 볼트 나사부의 탭 물림, 설계상 압입".
- M-09: "필요 SF — 일반 3, 오조작 하중 2". M-06: "카탈로그 허용치를 확인하고 보고서에 수치로 적는다".
- E-19: "같은 것은 묶어 가장 불리한 하나만". E-11: 안 묶인 부품 0. E-08·안내서 '원복': 읽기 부서는 끝나면 동작 상태 초기화.
- 요구서 0-8-5·프로젝트 규칙: 매트의 유연한 거동은 "모델로 판정하지 않고 요구서 7절에 기록만".

## 1. 범위·통로

| 항목 | 값 |
|---|---|
| 범위(`ledger.py scope`) | 전체 검사 아니오. 바뀜 3(판 W2·E2, 이름 옮긴 가로대 `HFS8-4080-560_M04`) · 새로 53 · 없어짐 18 · 이웃 247(볼 167 · 매트·테이프 8 · 그 밖 72) · 유닛 U2_TABLE · 가까운 유닛 U3·U4·WP |
| 대상에 더한 것 | 작업 대상 모형 MAT_L·S·G·V·W(롤러 윗면이 매트 길), U5 낮은 바디 18(REST zmin < 80), 새 부품 포락 100 mm 안 U4 바디 16(`P_M02_DISK_BASE`·`_HSG`·RX-08 스토퍼 등) |
| 통로 | MCP(앱 --control 27878). `running` 빈 목록 → 열린 문서 `FSAP_v2.17.0` · dirty false · 피처 3,687 · 오류 0 · 경고 53 · 숨긴 바디 98(매트·테이프 모형, 이름으로 직접 지정해 검사됨). 큰 응답은 `tools/out/mech_RX-11/verify/vrun.py`로 파일에 받음 |
| 원복 | 자세 변경 전 `edit.checkpoint`(28) → 끝에 `edit.restore_checkpoint {checkpoint: 28}` restored true. 뒤 확인: dirty false, 피처 3,687, 트레드 X −1812.5~−1787.5 · Z 40~160, MAT_L·S·G·V·W bbox = 서명 표 REST 값. `motion.play REST 0`은 따로 부르지 않음(체크포인트가 대기 자세) |
| 못 본 것 | 전체 사이클(라운드 끝 전체 회귀 몫), J_U6_PRESS·J_U3_*·J_U7_*(새 부품에서 X로 300 mm 넘게 떨어진 유닛, `joint.drive J_U6_PRESS`는 한 번에 8~10분 — RX-12 검도 실측), 테이프 조각 J_TP_* 붙는 단계(조각 zmin ≥ 0, 서명 표) |

## 2. REST 정적 (기준선 없이, `inspect.clearance` 틈 3.0)

| 대상 × against | 쌍(가지치기) | overlaps | unchecked | 가장 가까운 것 |
|---|---|---|---|---|
| 새·바뀐 56바디끼리 | 232(1,308) | **0** | 36 | 맞닿음 0.000: 판 ↔ 새들 8 · 판 ↔ 클램프 8 · 새들 ↔ 볼트 머리 좌면 8 · 롤러 ↔ 축 14. 새들 ↔ 클램프 0.500 ×8, 롤러 끝 ↔ 새들·클램프 1.000 ×56, 롤러 ↔ 판 홈 2.000 ×16 |
| 56 × 주변 83(그 밖 72 + U4 근처 + 매트·테이프 8) | 183(5,137) | **0** | 22 | 형재·T너트·L 브래킷 ↔ 가로대 0.000(기존 맞닿음), 매트 ↔ 롤러 0.010, 매트 ↔ 새들 2.000 |
| 56 × 볼 167 | 191(9,161) | **0** | 0 | 볼 ↔ 판 0.000(얹힘), 볼 ↔ 새들 **1.521**, 볼 ↔ 클램프 2.025 |

- unchecked 36 = 새들 ↔ 축 28("facets pass through") + 클램프 ↔ 볼트 8("boolean Intersect no result"). `inspect.interference`로 한 쌍씩 다시 재도 같은 이유로 계산 안 됨 → `body_topology`로 판정: 새들 홈 원통 R 3.100 · 중심 (Y ±11, Z −9.900), 축 Ø6 bbox Z −12.9999~−7.0001 → 홈 바닥 Z −13.000에 안쪽 선 접촉(부피 0, 옆 틈 0.1). 클램프 구멍 R 2.100(Z −16.5부터), 볼트 Ø5 끝 Z −28 → 나사 물림 11.5(의도된 겹침, M-08). 둘 다 `machine.json` baseline_overlaps에 있고 판정 기억에 남김(5절).
- unchecked 22 = 판 W2·E2 ↔ 접시 볼트 `SFB5-10_M04`·`_M04R`(접시 자리 맞닿음, RX-11 전부터 있던 쌍. 긴 홈 Y ±23 ↔ 접시 구멍 가장자리 Y 44.8, 살 21.8 — 이번에 안 건드림).
- 처음 보낸 호출은 `skip_within: "component"` 때문에 U2_TABLE 안 쌍이 모두 빠져 pairs 0이었다. 그 인자를 빼고 다시 잰 값이 위 표다(워크플로우 메모 1).
- 실측 치수: 롤러 14개 bbox zmax **−0.0002**(원통 면 조각, 14/14 같음) · zmin −19.9998 · Y 1.000~21.000 / −21.000~−1.000 · 부피 41,059.23. 볼 꼭대기 Z 0.000. 새들 7,338.96 · 클램프 12,798.14 · 볼트 633.48 · 축 6,021.23 · 판 W2 3,553,566.06 · E2 2,663,204.74 · 가로대 NOTCH 614,847.63 · 가로대 X −305 자리 624,561.05 mm³ — 모델링 보고 값과 같음.

## 3. 조인트 점 (E-17 과제 안 검사)

### U5 (매트 없이 내림 FLOAT 0, 대상 U5 낮은 18바디 × 새 56 + 주변 83, 트레드·휠 × 볼 167)

| J_U5_X | LIFT | 트레드 X | overlaps | 트레드 ↔ 롤러 | 그 밖 |
|---|---|---|---|---|---|
| 0 (0 %) | −10 | −1812.5~−1787.5 | **0** | 0.859 ×2 | 롤러 1 왼 끝(−1830)까지 17.5 |
| 345 (25 %) | −10 | −1467.5~−1442.5 | **0** | 0.859 ×2 | — |
| 690 (50 %) | −10 | −1122.5~−1097.5 | **0** | 0.859 ×2 | — |
| 1035 (75 %) | −10 | −777.5~−752.5 | **0** | 0.859 ×2 (다음 롤러 2.643 ×2) | 새들 2.000, 볼트 머리 3.000 |
| 1380 (100 %) | −10 | −432.5~−407.5 | **0** | 0.859 ×2 | 롤러 7 오른 끝(−334)까지 73.5 |
| 178 (틈 가운데 X −1622) | −10 | −1634.5~−1609.5 | **0** | 0.859 **×4**(양쪽 롤러 끝에 4.5씩 걸침) | 새들 2.000, 볼트 머리 3.000 |
| 610 (틈 가운데 X −1190) | −10 | −1202.5~−1177.5 | **0** | 0.859 ×4 | 같음 |
| 1258 (틈 가운데 X −542) | −10 | −554.5~−529.5 | **0** | 0.859 ×4 | 같음 |
| 1380 | 30 | Z 40~160 | **0** | 3.0 안에 없음 | — |

- 트레드·휠 ↔ 볼: 9점 모두 3.0 안에 없음(겹침 0). unchecked 0, truncated false.
- 완료 판정 ①: 나눔 틈 16 < 트레드 폭 25. 틈 가운데 3점에서 트레드가 양쪽 롤러 4개 모두에 같은 0.859로 걸친다(실측). 행정 양 끝 트레드는 롤러 구간 안이다.
- 매트 없이 내리면 바퀴가 롤러에 닿지 않고 0.859 위에 선다(설계 값과 같음).

### 매트 상태 13점 (대상 그 매트 + U5 18바디 × 새 56, `joint.drive` J_U5_X·LIFT·FLOAT·J_WP_*_X·Y·ROT = machine.json states 값)

| 상태 | 매트 bbox(X / Y) | 트레드 | overlaps | 매트 ↔ 롤러 | 매트 ↔ 새들 |
|---|---|---|---|---|---|
| 큰 매트 바퀴 내림 d₂ 1000 | −1493.5~6.5 / −750~750 | X −1012.5~−987.5 · Z 10 | **0** | 0.010 ×12 | 2.000 ×6 |
| 큰 매트 볼록 모서리 45° | −2112.1~9.2 / ±1060.7 | 같음 | **0** | 0.010 ×14 | 2.000 ×8 |
| 큰 매트 볼록 모서리 끝 90° | −1493.5~6.5 / −1493.5~**6.5** | Z 11 | **0** | 0.010 ×6, **0.966 ×6** | 2.000 ×6 |
| 작은 매트 직선 봉제 | −293.5~6.5 / −50~150 | 들림 | **0** | 3.0 안에 없음 | — |
| 홈 매트 홈 입구 회전 45° | −1466.9~230.2 / −1069.5~627.6 | X −812.5~−787.5 · Z 10 | **0** | 0.010 ×10 | 2.000 ×5 |
| 홈 매트 홈 안 벽 | −881~319 / −1126.3~73.7 | 같음 | **0** | 0.010 ×6 | 2.000 ×3 |
| 홈 매트 홈 바닥 꺾임 가운데 | −1043.5~156.5 / −300~900 | 같음 | **0** | 0.010 ×8 | 2.000 ×4 |
| V홈 매트 입구1 회전 45° | −1444.0~252.8 / −1098.3~598.5 | X −452.5~−427.5 · Z 10 | **0** | 0.010 ×9 | 2.000 ×5 |
| V홈 매트 꼭짓점 ROT −35 | −1030.0~641.3 / −327.4~1343.9 | 같음 | **0** | 0.010 ×2 | 2.000 ×2 |
| 오목 매트 시작 변 정지 | −693.5~6.5 / −450~1050 | 같음 | **0** | 0.010 ×4 | 2.000 ×2 |
| 오목 매트 입구2 회전 끝 ROT 270 | −493.5~1006.5 / −693.5~**6.5** | 같음 | **0** | 0.010 ×1, **0.966 ×1** | 2.000 ×1 |
| 오목 매트 안 모서리2 ROT 253 | −587.0~1052.1 / −670.6~437.4 | 같음 | **0** | 0.010 ×2 | 2.000 ×1 |
| 오목 매트 안 모서리1 ROT 135 정지 | −627.2~928.4 / −565.7~990.0 | 같음 | **0** | 0.010 ×3, 0.900 ×1 | 2.000 ×2 |

- 13점 모두 unchecked 0 · truncated false. 0.010은 얹힌 면의 면 조각 거리(매트 밑면 Z 0 ↔ 롤러 윗면 Z −0.0002)다.
- 수치 논리(모든 자세): 새 부품 최고점 Z −0.0002(새들 −2, 볼트 머리 −3) < 매트·테이프 모형 zmin 0.0(서명 표 148바디 전부), 매트 조인트는 Z 축 평면 운동뿐 → 어느 자세에서도 겹침 부피 0.
- **0.966 자세(디테일 V1)**: 모서리 회전 끝에서 매트 끝이 Y 6.5에 온다. +Y 줄 롤러의 꼭대기 선(Y 11)이 매트 밖이라, 바퀴 접지선(Y 0) 밑 받침이 −Y 줄 꼭대기 선(Y −11) 하나뿐이다. 걷어 낸 띠(Y ±25 평면)는 이 자세에서 매트 끝까지 받쳤다.

### 이웃 유닛 U4 (CAD 없이 서명 bbox)

- U4 움직이는 유닛(U4_PRESS·U4_XCAR·U4_WHEEL·U4_STOP) 가운데 X < −217에 있는 바디는 모두 zmin ≥ 40이다. J_U4_X(−X로 0~95)와 J_U4_PRESS(축 X 회전 −4.11~13.006°, 바퀴 밑 최저 Z 1.57)로 움직여도 Z ≤ 0인 새 부품(X −1847~−317)에 닿지 못한다. 고정 원판 `P_M02_DISK`(X −300~−50)·`_BASE`·`_HSG`는 REST 검사 against에 넣었고 3.0 안에 없다(끝 클램프 X −319 ↔ 원판 −300 = 19).

## 4. 새 볼트·묶임·판금

### `CB5-20_RX11` ×8 (같은 서명 한 묶음, E-19 — 8개 모두 bbox로 보고 대표는 모델링부 저장본 프로브)

| 항목(M-01) | 값 | 판정 |
|---|---|---|
| 삽입 경로·렌치 | 프로브 Ø8.5 × 30(머리 윗면 Z −3 → 27) bbox를 서명 3,224바디와 대조: 8개 모두 닿는 것은 자기 새들(카운터보어 안)과 로딩 자리 매트·테이프 모형뿐. 롤러 끝(새들 면에서 1.0)·축(Y 8~14)은 머리(Y ±4.25)에서 3.75. 모델링부 저장본 CLI 프로브(볼트 1·4·8, `model/savecheck_out.json`)도 기계 부품과 겹침 0 | 합격 |
| 상대·물림 | 클램프 M5 관통 탭(R 2.1, Z −31~−16.5), 볼트 끝 Z −28 → 11.5 ≥ 1.5d 7.5 | 합격 |
| 빈 구멍·중복 | 볼트 X −1838 + 216k 8자리에 새들 8 · 클램프 8, 같은 자리 중복 0 | 합격 |
| 방향 | 위에서 −Z, 탭 방향과 같음 | 합격 |
| 묶임(E-11) | `joint.list`: floating **0** · 충돌 0 · 오류 0 · 조인트 587 · 링크 35. 새 부품은 U2_TABLE(고정) 자식 — U5·매트를 움직인 22자세 내내 새 부품 ↔ 판 맞닿음 그대로 | 합격 |

- 간이 형상(LITE): 새로 넣은 것 없음. 공압 포트: 없음.
- 판금(M-04): 새 판금 없음. 기존 평판 W2·E2(SUS304 t4, 굽힘 없음)에 긴 홈 폭 46 추가 — 홈 ↔ 볼 구멍 살 9.0 ≥ 2t 8, 홈 ↔ 접시 구멍 21.8, E2 홈 닫힌 끝 ↔ 원판 따냄 12(설계 `body_topology` 값). 위반 없음.

## 5. 완료 판정

| 항목 | 만족 | 근거 |
|---|---|---|
| ① U5 행정 전 구간 받침 이어짐 | 예 | 3절: 0·25·50·75·100 % + 틈 가운데 3점, 틈 16 < 트레드 25 |
| ② 롤러 윗면 Z 0 ± 0.1 | 예 | −0.0002(14/14), 볼 0.000 |
| ③ 과제 범위 간섭 0 | 예 | 2·3절 겹침 0(REST 606쌍, U5 9점, 매트 13점) |
| ④ 롤러 처짐·베어링 | 예 | 검도 다시 셈: I = π(20⁴ − 12⁴)/64 = 6,836 mm⁴, δ = FL³/48EI(L 195) = 0.0051 mm(46.54 N) · 0.0143 mm(130 N) ≤ 0.1. 696ZZ C0r 670 N(임시, D-200) → 14.4 · 5.15 ≥ 3 · 2(M-09). 과사양 선(9)을 넘지만 `RORLM20`의 가장 작은 축 구멍이라 줄일 형번 없음(설계 보고) |
| ⑤ 시간·SF ≥ 1 | 예 | 검도 다시 셈(have = 0.4 × (40 × 0.1 + 40 × d₂), need = 볼 + 원판 0.048 + 노루발 0.096 + 바퀴 밑 롤러 + 바퀴 밖 롤러 + (I_매트 + 0.0217 + I_롤러) × 4θ/t²): L 4.5 s 17.6 / 14.337 = **1.228**, G1 바닥 0.8 s 1.281, V 입구1 3.0 s **1.146**, V 꼭짓점 1.5 s 1.175 — 설계 표와 같음. `machine.json _timing` 값 L 4.5 · G2 3.0 · G1 0.8 ×9 · V 3.0 / 1.5 ×4·1.0 / 1.9 확인 |
| ⑥ 잔재 0 · BOM · 자료대기 | 모델 예 / 문서 대기 | 앱 설계의 바디 876 · 피처 3,687 · 서명 3,224에 'DC205' 0. BOM·D-97·D-200 '쓰는 곳'·FUNC-01 ②·⑥·⑦은 문서 담당 차례(지금 BOM에 RX11 행 없음, D-200 임시값 미기재) |

등급 M: 맞음(한 유닛, 구매품 2종·가공품 2종 교체, 조인트 변화 없음).

판정 기억·원장: `paircache.py judge` 2건 — `8e0419a06748e6b29829`(클램프 ↔ 볼트 나사 물림) · `07b7b0d71dd51eb1df08`(새들 ↔ 축 선 접촉), `tools/out/judged.json` 227건. `ledger.py commit --date 2026-11-13`: 부품 3,224 · 통과 항목 84. `sigcheck` reuse.

## 6. 문제 목록

| 번호 | kind | 무엇 | 수치 | 고치는 방법 | 외부 |
|---|---|---|---|---|---|
| RX-11-V1 | 디테일 | 모서리 회전 끝(큰 매트 90°, 오목 매트 ROT 270 등)에서 매트 끝이 Y 6.5 — +Y 줄 롤러 꼭대기 선(Y 11)이 매트 밖이라 바퀴(Y 0, 46.54 N) 밑 받침이 −Y 줄(Y −11) 한 줄. 매트 끝이 처지면 +Y 롤러 옆면에 닿음 | 매트 끝 ↔ +Y 롤러 0.966, 닿을 때까지 끝 처짐 최대 1.07(= 10 − √(100 − 4.5²)), 바퀴 밑에서 약 0.67 | 요구서 7절에 '모서리 끝 가장자리 자세에서 매트 끝 처짐·자국·바퀴 접지' 시제품 확인 줄을 더한다. 문제면 롤러 2줄 가운데를 Y 0 → −6으로 옮겨(꼭대기 선 Y −17 · +5, 판 홈 Y −29~+17) 두 선이 모두 매트(끝 6.5) 밑에 오게 — 판 홈·새들·클램프·볼 틈이 바뀌므로 구동 후보(C-45 '두 롤러 사이' 배치는 유지) | 아니오 |
| RX-11-V2 | 디테일 | `STEP대기_RORLM20-6-L200` ×14 · `STEP대기_SFJ6-213` ×14 임시 형상(외경 공차·베어링 정격 C0r 670 N은 기억 값) | — | STEP 수령 뒤 바디 교체, 카탈로그 정격으로 ④ 다시 확인(D-200) | 예 |
| RX-11-V3 | 디테일 | 판 살 처짐 어림(설계): 받침 합 46.54 N 0.031~0.059 mm(≤ 0.1), 130 N 0.087~0.164 mm. 130 N은 매트 없이 내린 힘이고 그 자세에서 바퀴가 롤러에 0.859 떠 실리지 않음(실측). FEA 못 함 — 환경 없음(D-16) | 0.164(실리지 않는 하중) | 해석 환경이 생기면 판 W2 긴 홈 살 처짐 FEA(임시 STEP `tools/out/mech_RX-11/stepout/`) | 아니오 |

- 모델링부 디테일 RX-11-D1~D6(카운터보어 살 2.25, 클램프 SF 1.69, E2 홈 끝 살 12, 새들 ↔ 볼 테 1.52, 축 들림 막이 없음, 가로대 홈 밑 살 1.5)은 그대로 둔다 — 실측 1.521·2.025·0.500·1.000이 그 값과 맞는다.
- 동작 문제 0. 예외 요청 없음.

## 7. 시간 (E-23)

| 항목 | 값 |
|---|---|
| 통로 | MCP(앱), 설계 파일 새로 열기 0(앱에 v2.17.0이 열려 있었음), open_s 0 |
| CAD 호출 | 57(확인 2 · 측정/REST/U5/매트 43 · 원복·다시 재기 6 · 토폴로지 3 · 단독 3) |
| 긴 호출 | REST 56 × 주변 83(skip_within 없이) 124 s, 56바디끼리 39 s, `inspect.interference` 클램프 ↔ 볼트 16 s. `joint.drive` 2~3 s/묶음 |
| 앱 막힘 | 없음 |
| 브라우저 | 0 |

원본: `tools/out/mech_RX-11/verify/` — `plan.py` · `c10.json` · `r10.json` · `r10_analysis.txt` · `r10_summary.json`(REST 첫 호출·U5 9점·매트 13점) · `c11.json` · `r11.json` · `r11_summary.json`(원복·REST 다시) · `r12.json`(토폴로지) · `bolt_bbox_check.json` · `plan_info.json`.

## 워크플로우 메모

1. **`inspect.clearance`의 `skip_within: "component"`가 한 유닛 안 쌍을 모두 뺀다.** 안내서 '동작 검사'·'간섭'의 과제 안 검사 예시가 이 인자를 쓰는데, 새 부품과 주변이 같은 최상위 유닛(U2_TABLE) 자식이면 pairs 0 · overlaps 0으로 돌아와 '겹침 없음'으로 읽힐 수 있다(이번 첫 호출: 56바디끼리 0쌍, × 볼 167 0쌍). 인자를 빼니 232 · 191쌍이 검사됐다. 안내서에 "바뀐 부품과 주변이 같은 유닛이면 `skip_within`을 빼고, `pairs_checked`가 0이면 검사한 것이 아니다"를 적으면 좋겠다.
2. **`edit.restore_checkpoint`는 `checkpoint` id가 꼭 있어야 한다**(없이 부르면 거부). 안내서 '원복'에 id를 넘기는 모양을 적으면 한 번을 줄인다.
3. `ledger.py scope`의 neighbors에 작업 대상 모형이 로딩 자리 bbox로만 들어온다(MAT_S 없음). 작업 대상 길에 닿는 부품이 바뀐 과제는 매트 전부와 상태 값(machine.json states)을 검도가 직접 골라야 했다.
