hyeunung/FSAP/docs/reports/mechanism/mech_RX-11_verify1.md

# 구동 RX-11 검도·체결 (수정 1회차) — 새들 볼트 조임 0.6 N·m 지정 확인

## 요약

- 판정: **합격(동작 문제 0)**. 대상 `3D_Modeling/FSAP_v2.17.1.sc`(앱에 열려 있던 것, dirty false, 저장 안 함). 통로 MCP(앱), 설계 파일 새로 열기 0회.
- 지난 문제(3 N·m에서 새들 항복, SF 0.78~0.84) **없어짐**: 저장본의 `CB5-20_RX11` 부품 속성에 조임 0.6 N·m(예압 약 600 N) + 중강도 나사 고정제 + '3 N·m·표준 토크 금지'가 들어 있다. 0.6 N·m 다시 셈: 새들 위 압축 49.9 MPa → **SF 3.91**(유리한 받침 4.22), 클램프 SF 7.66, 볼트 좌면 11.55 · 암나사 13.21, 축 자리 내려앉음 0.012 mm.
- 형상 변화 0: RX-11 새·바뀐 56바디 bbox·부피 = 서명 표(다른 것 0), `ledger.py scope` 바뀜 0, `sigcheck` reuse(문서·해시 같음).
- REST 정적(기준선 없이): 56바디끼리 231쌍 · 주변 177쌍 · 볼 191쌍 — **겹침 0**, truncated false. 수치는 수정 전(v2.17.0) 검도와 같다.
- U5 조인트 점 5개(J_U5_X 0·610·690·1380, LIFT −10 / 30) · 매트 상태 5점(L·G·V·W 2): **겹침 0**, 트레드 ↔ 롤러 0.859, 매트 ↔ 롤러 0.010, 매트 ↔ 새들 2.000.
- 새 볼트 M-01: 자리·길이 그대로(물림 11.5 ≥ 7.5, 삽입·렌치 길 기계 부품 0은 앞 회차 값 그대로). 조인트 587 · floating 0 · 오류 0.
- 디테일 2건(수정 회차 안 씀): V1-1 토크 계수 흩어짐에서 새들 SF 2.84~2.93(기준 3에 2~5 % 모자람), V1-2 0.6 N·m에서 손 100 N 축 방향 밀림 SF 0.9~1.8(해석 RX-11-F3 그대로). 앞 회차 V1~V3은 그대로.
- 남은 것: BOM·설계검토서·자료대기 D-97·D-200 문구(문서 담당 차례, 아직 안 고쳐짐).
- 원장 갱신(부품 3,224 · 통과 84). 새 판정 기억 0건. 끝 상태: `edit.restore_checkpoint {checkpoint: 71}` restored true → dirty false, 피처 3,687, 대기 자세.

## 근거 규칙 (원문)

- E-03: "동작·간섭이 최우선이다". E-17(과제 안 검사): "대상은 `ledger.py scope`의 새로·바뀜·없어짐 바디와 그 주변 … 전체 사이클은 라운드 끝 전체 회귀가 한 번".
- E-02: 강도 여유·정밀 체인·렌치 접근·판금은 "디테일로 기록만 하고 수정 회차를 쓰지 않는다".
- M-01: "삽입 경로 — 머리 쪽 축 방향으로 볼트 길이 + 5 mm 동안 다른 부품과 겹침 0", "상대 — 물림 ≥ 1.5d".
- M-09: "필요 SF — 일반 3, 오조작 하중 2". E-18: 체결만 바뀐 자리는 손계산.
- E-08·안내서 '원복': 읽기 부서는 저장하지 않고 끝나면 동작 상태를 되돌린다.

## 1. 범위·통로

| 항목 | 값 |
|---|---|
| 범위(`ledger.py scope`) | 전체 검사 아니오, 바뀜 0 · 새로 0 · 없어짐 0 · 이웃 0(이번 회차는 부품 속성만 바뀜, 모델링부가 저장 뒤 sigpatch). 그래서 검사 대상은 앞 회차 범위(새·바뀐 56 + 주변 87 + 볼 167 + 매트·테이프 8 + U5 낮은 18)를 그대로 쓰고 점 수만 줄였다 |
| 통로 | MCP(앱 --control 27878). `running` 빈 목록 → 열린 문서 `FSAP_v2.17.1`(경로 3D_Modeling/FSAP_v2.17.1.sc) · dirty false · 피처 3,687 · 오류 0 · 경고 53 · 숨긴 바디 98. 큰 응답은 `tools/out/mech_RX-11/verify1/vrun.py`로 파일에 받음 |
| 원복 | 자세 변경 전 `edit.checkpoint`(71) → 끝에 `edit.restore_checkpoint {checkpoint: 71}` restored true. 뒤 확인: dirty false, 피처 3,687, 트레드 X −1812.5~−1787.5 · Z 40~160, MAT_W·L bbox = REST 값 |
| 못 본 것 | 전체 사이클(라운드 끝 전체 회귀 몫). U5 점 345·1035·178·1258과 매트 상태 8점은 앞 회차(v2.17.0, 형상 같음) 결과를 그대로 씀. FEA 못 함 — 환경 없음(D-16) |

## 2. 지난 문제 확인 — 새들 항복

| 확인 | 결과 |
|---|---|
| 저장본 부품 속성(`component.metadata CB5-20_RX11`) | description에 "tightening torque 0.6 N*m (preload approx 600 N; NOT 3 N*m or standard torque - saddle yields), medium-strength threadlocker (Loctite 243 equiv.)", properties 조임토크·나사고정제·근거 3개. '(3 N.m)' 문구 없음 |
| 예압 | T = K·d·F, K 0.2 · d 5 → 0.6 N·m에서 F = 600 N |
| 새들 굽힘(다시 셈) | 3점 굽힘, 받침 Y 24.75(불리) · 단면 Y 7.9 포켓 끝(I 999.18 mm⁴, c_top 9.86): M = 300 × 16.85 = 5,055 N·mm, σ = 5,055 × 9.86 / 999.18 = **49.9 MPa** → SF 195 / 49.9 = **3.91** ≥ 3. 3 N·m는 같은 식으로 249.4 MPa → 0.78(지적 재현) |
| 겹친 하중 | 운전 누름 46.54 N 겹침 SF 3.63, 오설정 130 N 겹침 3.21(기준 2) |
| 클램프 | 굽힘 25.4 MPa → SF 7.66 |
| 볼트·탭 | 조임 볼트 응력 SF 23.4, 좌면 11.55, 암나사 전단 13.21. 물림 11.5 = 2.3d |
| 낮은 예압의 동작 영향 | 바퀴 누름은 새들을 판 쪽으로 누르는 방향이라 분리 없음. 운전 중 축 방향 끌림 23.6 N에 미끄럼 버팀 90 N(귀 2면 μ 0.15) → SF 3.81. 풀림은 나사 고정제로 막음 |

근거 파일: `fea/results/mech_RX-11_handcalc.json`('새들·클램프(볼트 예압)' 조임 0.60 N·m), `tools/out/mech_RX-11/model1/fix1calc.json`, `tools/out/mech_RX-11/verify1/r00.json`.

## 3. 형상 변화 0

- 새·바뀐 56바디 `measure` ↔ 서명 표: bbox 차 > 0.01 또는 부피 차 > 0.5 mm³ 인 것 **0**.
- 롤러 윗면 Z −0.0002(14/14) — 완료 판정 ② 그대로.
- `ledger.py sigcheck`: reuse(문서·해시 같음, 부품 3,224). `tools/machine.json`·`tools/config.json` doc = v2.17.1.

## 4. REST 정적 (`inspect.clearance` 틈 3.0, skip_within occurrence)

| 대상 × against | 쌍(가지치기) | overlaps | unchecked | 가장 가까운 것 |
|---|---|---|---|---|
| 새·바뀐 56바디끼리 | 231(1,308) | **0** | 36 | 맞닿음 0.000: 판 ↔ 새들 8 · 판 ↔ 클램프 8 · 새들 ↔ 볼트 좌면 8 · 롤러 ↔ 축 14. 새들 ↔ 클램프 0.500, 롤러 끝 ↔ 새들·클램프 1.000, 롤러 ↔ 판 홈 2.000 |
| 56 × 주변 87 + 매트·테이프 8 | 177(5,133) | **0** | 22 | 형재·브래킷 ↔ 판·가로대 0.000(기존 맞닿음) |
| 56 × 볼 167 | 191(9,161) | **0** | 0 | 볼 ↔ 판 0.000(얹힘), 볼 ↔ 새들 1.521, 볼 ↔ 클램프 2.025 |

unchecked 36 = 새들 ↔ 축 28(축 자리 맞닿음, 면이 붙어 계산 못 함) + 클램프 ↔ 볼트 8(탭 물림, M-08 정상 겹침). 22 = 판 ↔ 접시머리 볼트 SFB5-10(기존). 모두 앞 회차와 같은 쌍이다.

주의: 앞 회차 계획 파일의 `skip_within: "component"`를 그대로 쓰면 U2_TABLE 안 쌍이 모두 빠져 0쌍이 된다. 이번 표는 `"occurrence"`로 다시 잰 값이다(`verify1/r12.json`). 움직이는 점 검사(U5·매트 ↔ 새 부품)는 컴포넌트가 달라 영향 없음.

## 5. 조인트 점 (LIFT 30 → X → FLOAT → LIFT 순)

| 점 | overlaps | truncated | 가장 가까운 것 |
|---|---|---|---|
| J_U5_X 0 · LIFT −10 | 0 | false | 트레드 ↔ 롤러 0.859 ×2 |
| J_U5_X 610(나눔 틈 가운데) · LIFT −10 | 0 | false | 트레드 ↔ 롤러 0.859 ×4, 트레드 ↔ 새들 2.000, 볼트 머리 3.000 |
| J_U5_X 690 · LIFT −10 | 0 | false | 트레드 ↔ 롤러 0.859 ×2 |
| J_U5_X 1380 · LIFT −10 | 0 | false | 트레드 ↔ 롤러 0.859 ×2 |
| J_U5_X 1380 · LIFT 30(든 자세) | 0 | false | 3.0 안 없음 |
| 큰 매트 볼록 모서리 끝 90° | 0 | false | 매트 ↔ 롤러 0.010, 매트 ↔ 새들 2.000 |
| 홈 매트 홈 바닥 꺾임 가운데 | 0 | false | 매트 ↔ 롤러 0.010 |
| V홈 매트 꼭짓점 ROT −35 | 0 | false | 매트 ↔ 롤러 0.010 |
| 오목 매트 입구2 회전 끝 ROT 270 | 0 | false | 매트 ↔ 롤러 0.010 |
| 오목 매트 안 모서리2 ROT 253(X 최대 1052.1) | 0 | false | 매트 ↔ 롤러 0.010, 매트 ↔ 새들 2.000 |

## 6. 볼트·묶음

- `CB5-20_RX11` ×8: bbox X −1842.25~−1833.75 · Z −28~−3(1번, 서명 표와 같음). 자리·길이 그대로라 M-01(물림 11.5, 삽입·렌치 길 Ø8.5 × 30에 기계 부품 0)은 앞 회차 판정 그대로.
- `joint.list`: 조인트 587 · 링크 35 · floating 0 · 오류 0 · 충돌 0.
- 판금·공압 포트·LITE 형상: 해당 없음.

## 7. 완료 판정

| 항목 | 결과 |
|---|---|
| ① 받침 이어짐 | 만족(틈 16 < 트레드 25, 틈 가운데 610에서 양쪽 롤러 4개에 0.859) |
| ② 롤러 윗면 Z 0 ± 0.1 | 만족(−0.0002, 14/14) |
| ③ 과제 범위 간섭 0 | 만족(4·5절) |
| ④ 처짐·베어링 | 만족(앞 회차·해석 값 그대로: 처짐 0.005 / 0.014 mm, 696ZZ SF 14.4 / 5.15). 새들 예압 강도는 0.6 N·m에서 SF 3.91 |
| ⑤ 시간 키 SF | 만족(이번 회차 변화 없음, 최저 1.146) |
| ⑥ 잔재 0 · BOM · D-97 · D-200 | 모델 잔재 0. BOM에 `CB5-20_RX11` 행(0.6 N·m + 나사 고정제)·설계검토서 조립 순서·D-97·D-200 문구는 문서 담당 차례 |

## 8. 문제

| id | kind | 무엇 | 어디 | 수치 | 고치는 법 |
|---|---|---|---|---|---|
| RX-11-V1-1 | 디테일 | 토크·마찰 흩어짐에서 새들 SF가 기준 3에 조금 모자람 | `P_RX11_SADDLE` ×8 축 홈 포켓 Y 7.9 | 토크 +30 %(0.78 N·m) + 운전 누름 SF 2.84, 토크 계수 K 0.15(예압 800 N) SF 2.93. 항복(SF 1)과는 멀다 | 기록. 토크 드라이버 0.6 N·m 지정(BOM 비고·조립 순서). 디테일링에서 포켓 바닥 살 +1 mm 또는 지정 0.5 N·m 검토 |
| RX-11-V1-2 | 디테일 | 0.6 N·m에서 손이 롤러를 축 방향 100 N으로 밀 때 새들 X 미끄럼(해석 RX-11-F3 그대로) | 새들 귀 ↔ 판 윗면 | SF 0.9(귀만) ~ 1.8(귀 + 클램프 기둥), 운전 23.6 N에는 3.81 ~ 7.62. 밀려도 롤러 끝 틈 1.0 · 홈 끝 틈 2.0에서 멈춤 | 기록. 디테일링에서 새들 위치 핀 Ø3 ×1 또는 새들 귀를 판 홈 끝에 맞대는 턱 |

앞 회차 디테일 V1(모서리 끝 자세에서 매트 끝이 +Y 롤러 받침선 밖)·V2(STEP 대기 2종, 외부)·V3(판 살 처짐 어림)은 그대로 남는다(`mech_RX-11_verify.md`).

## 9. 등급

M 그대로. 이번 회차는 부품 속성만 바뀌었고 새 구매품·조인트 변화 없음.

## 워크플로우 메모

- 앞 회차 검사 계획(`verify/plan.py`)의 `skip_within: "component"`는 새 부품이 모두 한 유닛 컴포넌트(U2_TABLE) 안에 있을 때 정적 쌍을 통째로 뺀다(pairs_checked 0 · pruned 0으로 조용히 통과). 유닛 안 정적 검사는 `"occurrence"`로 주어야 한다. pairs_checked 0이면 통과로 보지 않는 확인이 있으면 좋겠다.
- `edit.restore_checkpoint`는 이 버전에서 `checkpoint` id가 꼭 있어야 한다(빈 인자 거부).
- 걸린 시간 약 7분(예상 M 30분). CAD 호출 34, 파일 열기 0.
