hyeunung/FSAP/docs/reports/mechanism/mech_RX-12_measure.md

# 구동 RX-12 측정 — 시험 매트 '긴 매트 + 넓은 오목'(매트가 바늘 +X로 넘어가는 경우, C-47)

## 요약

- 대상 `3D_Modeling/FSAP_v2.15.2.sc`(config.json doc, 앱에 열려 있던 것 그대로 MCP로 잼, 읽기만·저장 0회). 측정 표 `sigcheck` **reuse**(3,188바디).
- **이미 됨 아님(already_ok false).** 새 매트 모형·모형용 조인트 3개·한 사이클 연구가 모델에 없다(매트 바디 `MAT_L·S·G·V` 4개, `J_WP_*` 12개, 사이클 연구 5개뿐). 완료 판정 ①·⑤는 잴 대상이 없다.
- **0-8-5 "매트는 늘 바늘의 −X 쪽"은 지금 모델에서도 이미 틀리다.** 기존 연구 키로 계산: `CYCLE_G1` 홈 바닥에서 홈 매트 X 최대 **929.4**, X > 6.5 넓이 **1,095,000 mm²**(매트의 76 %). `CYCLE_V`는 914.7 · 935,308 mm². CAD 확인: `MAT_G`를 그 자세(X 912.5 · Y 762.5 · ROT −90°)에 놓으면 bbox X −281.0~**919.0**, 겹침 0, +X 기둥까지 231.0.
- **+X 쪽 테이블은 L자다.** 볼은 X ≤ 350 줄만 Y ±1450 전폭이고, X 450~850 줄은 **Y −150~1450에만** 있다. 패널도 X > 400에서는 Y ≥ −300뿐. 즉 **X > 400 · Y < −300(볼은 Y < −200)은 볼·패널이 없는 포켓**(작업자 자리, D-107 "포켓 X 400~1160 Y ≤ −250")이다.
- **임시 형상 어림(CAD 아님, 평면 강체 계산)**: 1500×700, 오목 500×300 가운데 → X 최대 **1052.1**, +X 넓이 최대 **550,000 mm²**, **볼 받침 밖 323,536 mm²**, 그 가운데 **포켓 위 282,556 mm²**(오목 입구 볼록 모서리 회전 ~ 오목 벽 봉제 구간), X > 975(패널 끝 밖) 22,050 mm². 작은 형상(1000×500, 오목 330×200)도 포켓 위 58,493 mm². 오목이 한쪽으로 치우치면(다리 폭 300 / 700) X 최대 1244.8로 **+X 기둥(X 1150~1230 · Y 120~320)과 11,300 mm² 겹친다.**
- 매트 높이 층(Z 0.5~18)에 서 있는 고정 바디는 U1 기둥 2(±X)·라이트커튼 4·그 기둥 3과 바늘 둘레(바인더 Z 13, 슈)뿐. X 146~1150 · Y −300~1560은 Z 125(윗헤드 밑)까지 비어 있다. 매트 판(Z 0~10)을 X −448~1052에 놓은 틈 검사: 겹침은 `TL_FEED` 75 mm³(기준선)뿐, 바인더 3.0 · 카세트 판 10.0.
- 구상·설계가 쓸 자료: `tools/out/mech_RX-12/`(구매품 표 `parts_table.csv`, 볼 자리 `ball_centers.json`, 범위 계산 `envelope_*.json`·`phases_base.json`, 틈 검사 `probe_slab_v2152.json`).
- 미완: 새 매트 한 사이클 간섭 검사는 모형이 없어 못 함(모델링 뒤 검도). 오목 치수는 실물 없음(D-01·D-02 임시).

## 1. 대상 문서·통로·원복

| 항목 | 값 |
|---|---|
| 문서 | `3D_Modeling/FSAP_v2.15.2.sc`(tools/config.json doc), 5,632,607 B, sha1 `1aa0397a928ba8bd…`(측정 전후 같음) |
| 앱 상태(처음) | `running` 빈 목록. 열린 설계 name `FSAP_v2.15.2`, path 같음, **dirty false**, 타임라인 3,709(오류 0 · 경고 54), 바디 정의 879. 같은 경로라 `open`은 다시 부르지 않았다(안내서 '원복': "같은 경로를 다시 `open`해도 디스크에서 다시 읽지 않는다") |
| 측정 표(E-17) | `ledger.py sigcheck` → `{"mode": "reuse", "reason": "문서·해시가 같다", "parts": 3188}`. bbox·부피·재질은 `tools/out/signatures.json` 그대로 씀 |
| 통로 | MCP(혼자 도는 읽기 부서, 실행 규칙 2). MCP 호출 15(조회 10 · 측정 묶음 2 · 원복 3), 파일 열기 0, 브라우저 0 |
| 원복(E-08) | `edit.checkpoint` 62 · 63 → 모형 조인트만 `joint.drive`(J_WP_L_X, J_WP_G_X·Y·ROT, J_WP_S_X·Y·ROT) → 0으로 되돌림 → `edit.restore_checkpoint` restored true → `motion.play REST 0` **moved false**, 바디 3,188. 끝 `inspect_design`: dirty false · 타임라인 3,709 · 프로브 바디 0. 바디를 만들지 않았다(기존 매트를 판 프로브로 씀) |
| 기계 정의 | `tools/machine.json`의 `doc`는 `FSAP_v2.15.0.sc`로 남아 있다(config.json은 v2.15.2). 조인트·연구 정의는 설계의 `motion.list`와 같다(연구 9개, 단계 수 일치) |

## 2. 과제에 걸린 현재 부품·구동 요소

### 2-1. 작업 대상 모형(지금 있는 것)

| 컴포넌트 | 바디 | REST bbox X · Y · Z | 부피 mm³ | 모형용 조인트(원점 = 회전 중심) | 연구(단계) |
|---|---|---|---|---|---|
| `WP_MAT_L` | `MAT_L` 1500×1500×10 | −1493.5~6.5 · −1050~450 · 0~10 | 22,500,000 | `J_WP_L_X·Y·ROT` (−743.5, −300) | `CYCLE_L` 716 |
| `WP_MAT_S` | `MAT_S` 300×200×10 | −293.5~6.5 · −400~−200 · 0~10 | 600,000 | `J_WP_S_X·Y·ROT` (−143.5, −300) | `CYCLE_S` 450 |
| `WP_MAT_G` | `MAT_G` 1200×1200×10, U홈 25×150 R12.5(홈 가운데 Y −600) | −1193.5~6.5 · −900~300 · 0~10 | 14,363,172 | `J_WP_G_X·Y·ROT` (−593.5, −300) | `CYCLE_G1` 514 · `CYCLE_G2` 630 |
| `WP_MAT_V` | `MAT_V` 1200×1200×10, V 30° R_b 2 깊이 150 | −1193.5~6.5 · −900~300 · 0~10 | 14,339,811 | `J_WP_V_X·Y·ROT` (−593.5, −300) | `CYCLE_V` 486 |
| `WP_TAPE_<M>` 아래 `WP_TP_<M>_nn` | 테이프 조각 L 43 · S 7 · G 35 · V 35 + `SEAM_<M>` | Z 0~11(이음매 11~12) | — | `J_TP_*` 124개(0 붙음) | 위 연구 키 |

- 재질은 모두 `Default`(모형). 긴 매트 가운데 넓은 오목은 없다.
- 조인트 사슬: `J_WP_<M>_X` 슬라이드 → `_Y` 슬라이드 → `_ROT` 회전(±3000 mm, −360~720°, `model_only`). 매트 중심 = 대기 중심 + (X, Y), 회전은 그 중심. **CAD로 확인**: `MAT_G` (912.5, 762.5, −90°) → bbox X −281.0~919.0 · Y −137.5~1062.5, `MAT_S` (100, 50, 90°) → X −143.5~56.5 · Y −400~−100. 둘 다 계산값과 같다.
- 매트 4장은 대기 자리에서 서로 겹쳐 있고(숨김) 기준선으로 뺀다(`machine.json baseline_overlaps`: "매트 3장이 로딩 자리에 겹쳐 있다. 연구마다 한 장만 검사"). 새 매트도 같은 방식이면 기준선 줄에 넣어야 한다.
- 떨어지는 조각 없음(`workpiece_stages.fragments`). 로딩은 시작점에서 −Y 300 자리에 올려 +Y로 밀어 맞춤, 배출은 끝 자세에서 −Y 300(D-106).

### 2-2. 구동 요소(연구에 키를 넣을 조인트, machine.json)

| 조인트 | 종류 | 대기 | 범위 | 뜻 |
|---|---|---|---|---|
| `J_U3_PRESSER` | 슬라이드 | 20 | −4~20 | 노루발. 0 = 발바닥 Z 12 |
| `J_U3_NEEDLE` | 슬라이드 | 0 | −36~0 | 바늘. −30 = 꽂음(회전 구간) |
| `J_U4_PRESS` | 회전 | 13.006° | −4.11~13.006 | 바늘 옆 바퀴 그네. 0 = 두께 10 내림, 13.006 = 들림 |
| `J_U4_X` | 슬라이드 | 0 | 0~95 | d₁ = 100 + 값(셋업, 손) |
| `J_U4_STOP` | 슬라이드 | 0 | 0~20 | 중간 높이 스토퍼(20 = 살짝 띄움) |
| `J_U5_X` | 슬라이드 | 0 | 0~1380 | 먼 쪽 대차. d₂ = 1800 − 값(420~1800) |
| `J_U5_LIFT` · `J_U5_FLOAT` | 슬라이드 | 30 · 0 | −10~30 · 0~20 | 먼 쪽 바퀴 승강(−10 = 내림) |
| `J_U6_SHIFT` · `J_U6_PRESS` | 슬라이드 | −60 · 4.5 | −60~0 · −5~4.5 | 슈 비킴·누름(봉제 0 · −0.4) |
| `J_U7_HGT` | 슬라이드 | 0 | −4~6 | 카세트 높이(매트 두께 − 10, 손 조정) |
| `J_U4_WHEEL_ROT` · `J_U5_WHEEL_ROT` | 회전 | 0 | ±72000 | 바퀴 회전(값 = 바퀴 밑 매트 점 Y 변위 ÷ r 60) |

- 연구 9개: `REST` 1 · `CYCLE_S` 450 · `CYCLE_L` 716 · `CYCLE_G1` 514 · `CYCLE_G2` 630 · `MAINT_HEAD` 1 · `SEAM_U7` 32 · `MAINT_U7` 13 · `CYCLE_V` 486(`motion.list` 원본 `tools/out/mech_RX-12/motion_list.json`). 1,000단계 표본 상한 때문에 G는 둘로 나눠 두었다(WF-126).
- 앞 과제의 약속: 새 매트 조인트를 만들면 **다른 연구에도 그 조인트 0 키를 넣었다**(VGR-01 `_keys_WP_V`: "연구 전환 때 V 매트 상태가 남지 않게"). 완료 판정 ⑤ "기존 연구 5개 키 변화 0"과 부딪히지 않게, 설계가 '기존 키 값은 그대로, 새 조인트 0 키만 더함'으로 읽을지 정해야 한다.

### 2-3. +X 쪽 우리 부품(REST, 서명)

| 부품·유닛 | X | Y | Z | 매트 높이 층과의 관계 |
|---|---|---|---|---|
| `P_M05_BINDER`(U7_TAPE) | −11~45.5 | −95~−9 | 13~60 | 매트 윗면 10에서 **3.0**(CAD), 테이프 11에서 2, 이음매 12에서 1 |
| `P_M05_CST_PLATE`(U7_CASSETTE) | 50~58 | −200~−40 | 20~328 | 매트 윗면에서 **10.0**(CAD) |
| U7_CASSETTE 전체(9바디) | 38~146 | −266~−40 | 20~536 | 위 |
| U7_TAPE 전체(96바디) | −80~141 | −291~−9 | 13~747.5 | 가장 낮은 것이 바인더 |
| U7_ROLL_MOUNT(31바디) | 20~820 | −150~130 | 551~900 | 위(매트와 무관) |
| `TL_FEED`(U7_TAPE_LINE) | −2.5~7.5 | −9~−1.5 | −1~11 | 매트와 75 mm³ 겹침 = 기준선(SIM-01) |
| `STEP대기_867-392342_UPPER` | −80~500 | −90~90 | 125~560 | 암 밑 125 |
| `STEP대기_867-392342_NOSE` | −11~11 | −10~15 | 46~125 | 매트 윗면에서 36.0(CAD) |
| `STEP대기_867-392342_LOWER` | −40~40 | −60~60 | −200~0 | 윗면 Z 0(매트 밑면 맞닿음) |
| `P_M06_SHOE`(U6_PRESS, REST) | −82~−59 | −205~−115 | 17~54.5 | REST에서 7.0(CAD). 봉제 때는 매트 윗면을 누름 |
| `P_M08_HMI_PLATE_SM` · `U8_HMI_PANEL` | 1163~1442 | −522~−400 | 343~557 | 위(매트 높이 아님) |
| `HFS8-4080-570_M08_HMI` · `P_M08_HMI_MOUNT_ML` | 1160~1225 | −460~120 | 340~540 | 위 |
| U1 기둥 +X `HFS8-80160-1090_M07:2` + `HFS8-4080-1090_M07_PX` | **1150~1230** | **120~320** | −840~250 | **매트 높이에 서 있음** |
| `P_M07_BEAM` | −2380~1230 | 120~320 | 250~650 | 위 |
| `P_M07_SEAT_PX` | 1050~1150 | 130~310 | 150~250 | 위 |
| U8 라이트커튼 `F3SG-4RA0800-14_M08_1R` + 기둥 `HFS8-4080-1175_M08_FR` | 325~400 | −1640~−1560 | −370~818 | 매트 높이에 서 있음(앞쪽) |

### 2-4. 구매품 표(WF-127·WF-128)

- `tools/out/mech_RX-12/parts_table.csv`: X > 300 · Y ±1700 · Z −200~900에 걸친 구매품 345줄(bbox·부피·질량·재질).
- 길이 확인(bbox만 믿지 않음, 부피 ÷ 단면): HFS8-4080 단면 1,115.4 mm², HFS8-80160 3,902.5 mm². `HFS8-4080-430_M04` ×2(430), `-1090_M07_PX`(1090), `-1175_M08_FR`(1175), `-570_M08_HMI`(570), `-1255`·`-1260_M04`는 bbox 길이 = 형번 길이.
- **bbox가 형번 길이와 다른 것**(매트 길 밖, Z ≤ −12): `HFS8-4080-1720_M04` ×2 bbox 2850(부피로 본 길이 1,728), `HFS8-4080-2555_M04` ×5 bbox 3030(2,567), `HFS8-4080-3150_M04` ×5 bbox 3625(3,165). 한 바디가 떨어진 덩어리 여럿인 것으로 보인다(LITE 묶음). +X 테이블을 고치는 과제가 생기면 그때 끝면 프로브로 다시 잰다.

## 3. 비어 있는 공간(통로)과 막는 부품

### 3-1. 테이블 받침 영역(서명 v2.15.2, REST)

| 것 | 범위 | 비고 |
|---|---|---|
| 볼 827개(`STEP대기_BALL_D25_M04`, 윗끝 Z 0, 피치 100) | 중심 X −2050~350 줄: Y −1450~1450(원판 둘레 X −250~50 · Y ±150 빼고). **중심 X 450~850 줄: Y −150~1450만**(줄마다 17개) | 자리 `tools/out/mech_RX-12/ball_centers.json`. 볼 바깥 끝 X 872 |
| 패널(Z −12~−8, 매트 밑면에서 8.0) | `W1~W3` X −2175~−400, `E1` X −400~**400** · Y −1555~−300, `E2` X −410~**975** · Y −300~300, `E3` X −400~975 · Y 300~1560 | E1이 X 400에서 끝난다 |
| 원판 `P_M02_DISK` Ø250 | 중심 (−175, 0), 윗면 Z 0 | 자유 회전 |
| 띠 `P_DC205_STRIP` | X −1826~−391 · Y ±25, 윗면 Z 0 | RX-11이 롤러 2줄로 바꿀 자리 |
| **포켓(볼·패널 없음)** | **X > 400 · Y < −300**(볼은 Y < −200부터 없음), X 400~1160 | 작업자 자리(D-107). 이 자리 Z −92~700에는 바디 없음. 밑에 가로대 `HFS8-4080-1720_M04`(Z −172~−92) |
| 테이블 +X 끝 | 볼 중심 850(반 피치 더하면 900), 패널·프레임 975 | 그 밖 X 975~1150 · Y −300~1560 · Z −100~125에는 +X 기둥(Y 120~320)뿐 |

이 보고서의 넓이 계산에 쓴 정의(`tools/out/mech_RX-12/rx12_common.py`): 볼 받침 = 볼 중심 + 반 피치 50 → (X −2100~400 · Y ±1500) ∪ (X 400~900 · Y −200~1500). 패널 = (X −2175~400 · Y −1555~1560) ∪ (X 400~975 · Y −300~1560). 받침을 어디까지로 볼지(볼 끝·반 피치·패널)는 설계가 정한다 — 세 값을 다 냈다.

### 3-2. 매트 높이 층에 서 있는 바디

매트 두께 6~16 + 이음매 2(D-04 임시)라 Z 0.5~18 층에 bbox가 걸치는 기계 바디 전부(`tools/out/mech_RX-12/slab_bodies.json`, 14개):

| 바디 | X | Y | 판정 |
|---|---|---|---|
| U1 기둥 +X(2바디) | 1150~1230 | 120~320 | 매트가 X 1150을 넘으면 막힘 |
| U1 기둥 −X(2바디) | −2380~−2300 | 120~320 | 기존 L 매트 X 최소 −2112.1, 여유 188 |
| 라이트커튼 `1R` + 기둥 `FR` | 325~400 | −1640~−1560 | 포켓 앞 모서리 |
| 라이트커튼 `1E` + 기둥 `FL` | −2300~−2225 | −1640~−1560 | −X 앞 |
| 라이트커튼 `2E` · `2R` + 기둥 `R` | −2340~−2295 | −1555~−1520 · 5~120 | −X 옆 |
| `P_M05_BINDER`(Z 13~) · `P_M06_SHOE`(Z 17~, REST) · `TL_FEED` | 바늘 둘레 | | 2-3 표 |

X 146~1150 · Y −1560~1560에서 Z 0.5~130에 걸치는 바디는 윗헤드(Z 125~) 하나뿐이다.

### 3-3. CAD 틈 검사(E-17 과제 범위, 한 세션)

기존 `MAT_L`(1500×1500×10)을 `J_WP_L_X` 1045.6으로 밀어 **X −447.9~1052.1 · Y −1050~450 · Z 0~10**을 덮는 판으로 쓰고(나머지 REST) `inspect.clearance {bodies:[MAT_L], against: 42바디, clearance: 30}`. against는 서명에서 그 자리 Z −1~40에 걸치는 볼 아닌 바디 전부 + 기둥·노즈·패널.

| 결과 | 값 |
|---|---|
| 검사 쌍 | 39(3쌍은 상자가 멀어 뺌: +X 기둥 2 · 노즈), truncated false, unchecked 0, 0.86 s |
| 겹침 | `MAT_L` ↔ `TL_FEED` 75.0 mm³(X 6.5~7.5 · Y −9~−1.5) = 기준선(`baseline_overlaps` "TL_FEED ↔ WP_MAT_* 회전·피벗 중") |
| 맞닿음 0.0 | `P_DC205_STRIP` · `STEP대기_867-392342_LOWER` · `P_M02_DISK`(밑면 Z 0, 기준선) |
| 가까운 것(mm) | 원판 볼트 `CB5-16_M02_19~21` 0.5(아래) · **바인더 3.0** · 슈 7.0(REST) · 패널 8.0(아래) · 바늘 9.0(REST) · **카세트 판 10.0** · `CB3-10_M06` 10.75 · `P_M06_CARR` 11.0 · 바인더 브래킷 15.0 · 카세트 이음·관 19.9~22.1 · `P_M05_GUIDE` 28.0 |

원본 `tools/out/mech_RX-12/probe_slab_v2152.json`. 매트가 +X 쪽 테이블 위(X ≤ 1052)를 지나는 것 자체는 고정 부품과 겹치지 않는다. 걸리는 것은 받침(3-1)과 +X 기둥(3-2)이다.

## 4. 작업 대상의 범위

### 4-1. 기존 매트가 기존 연구에서 휘두르는 범위

연구 키(`motion_list.json`)를 선형 보간해 계산(단계 사이 4등분, 외곽 사각형 — 홈·모서리 R 무시라 넉넉한 쪽). `tools/out/mech_RX-12/envelope_existing.json`.

| 연구 | X 최대 | 그 자세 | +X 넓이(X > 6.5) mm² | 볼 받침 밖 mm² | 패널 밖 · 포켓 mm² | X 최소 | Y 범위 |
|---|---|---|---|---|---|---|---|
| `CYCLE_L` | 9.2 | 모서리 회전 44.5° | 7.5 | 147.1 | 0 · 0 | −2112.1 | ±1493.5 |
| `CYCLE_S` | 9.2 | 모서리 회전 | 7.3 | 0 | 0 · 0 | −351.5 | −400~293.6 |
| `CYCLE_G1` | **929.4** | 단계 381.25, ROT −81.25° | **1,095,000**(단계 390, ROT −90°) | 22,800(X > 900, 단계 390) | 0 · 0 | −1483.4 | −1235.4~1506.3 |
| `CYCLE_G2` | 9.2 | 모서리 회전 | 7.4 | 0 | 0 · 0 | −1687.9 | ±1195 |
| `CYCLE_V` | **914.7** | 단계 390, ROT −75° | **935,308** | 517.2 | 0 · 0 | −1468.0 | −1242.4~1522.4 |

- 홈 매트는 홈 바닥을 돌고 나면 몸통 대부분이 +X에 있다. 그래도 포켓 위로는 가지 않는다 — 홈이 끝에서 300 안이라 −Y 쪽으로 가는 조각이 폭 287.5뿐이다.
- 이 값은 계산이고, 한 점을 CAD로 맞춰 봤다(2-1). 전 구간 CAD 간섭은 라운드 끝 회귀가 본다(E-03 "라운드 끝 = 전체 사이클 간섭 0").

### 4-2. '긴 매트 + 넓은 오목' 임시 형상 어림

실물·도면이 없어 치수는 모두 임시다(D-01·D-02). 사진 `docs/images/r375x/decisions/q3_test_mat.png`의 비례는 길이 : 깊이 약 2.3 : 1, 오목 폭 약 길이의 1/3, 오목 깊이 약 매트 깊이의 0.45다.

계산 약속(`envelope_new_mat.py`): 바깥 L×H, 긴 변에 오목 W×D(왼쪽 다리 폭 a), 모서리 R 0. 땀 선(외곽 안쪽 6.5)을 시계 방향으로 돌고, 땀 점 = 바늘(원점), 진행 = 세계 −Y, 몸통 = −X, 모서리는 바늘 중심 회전(볼록 +90°, 오목 −90°). 이송 25 mm · 회전 1° 간격. 로딩·배출 자세는 넣지 않았다. **CAD 검사가 아니다.**

| L×H | 오목 W×D | 다리 a | X 최대 | +X 넓이 최대 mm² | 볼 받침 밖 mm² | 패널 밖 mm² | 포켓 위 mm² | +X 기둥 겹침 mm² |
|---|---|---|---|---|---|---|---|---|
| 1500×700 | 500×300 | 500(가운데) | **1052.1** | 550,000 | **323,536** | 282,556 | **282,556** | 0 |
| 1500×700 | 300×300 | 600 | 956.9 | 540,000 | 263,380 | 216,249 | 216,249 | 0 |
| 1500×700 | 700×300 | 400 | 1148.1 | 560,000 | 362,642 | 320,021 | 317,178 | 0(X 최대 1148.1, 기둥 X 1150까지 1.9) |
| 1500×700 | 500×200 | 500 | 1027.4 | 600,000 | 327,320 | 282,967 | 282,967 | 0 |
| 1500×700 | 500×400 | 500 | 1085.5 | 552,814 | 322,645 | 282,556 | 282,556 | 0 |
| 1500×1000 | 500×300 | 500 | 1052.1 | 850,000 | 493,292 | 430,263 | 420,608 | 0 |
| 1500×1500 | 500×300 | 500 | 1052.1 | 1,350,000 | 796,542 | 733,513 | 723,858 | 0(라이트커튼 1R 6,000) |
| 1500×700 | 500×300 | 300(치우침) | **1244.8** | 690,000 | 256,458 | 165,095 | 160,604 | **11,300** |
| 1500×700 | 500×300 | 700(치우침) | **1244.8** | 690,000 | 463,536 | 422,556 | 422,556 | **10,537** |
| 1300×570 | 430×250 | 435 | 908.4 | 385,550 | 199,684 | 160,940 | 160,940 | 0 |
| 1200×600 | 400×250 | 400 | 846.3 | 380,000 | 170,041 | 133,081 | 133,081 | 0 |
| 1000×500 | 330×200 | 335 | 702.5 | 266,500 | 82,565 | 58,493 | 58,493 | 0 |

읽는 법: 오목 벽을 박을 때 X 최대 ≈ (L − 지금 박는 다리 폭) + 6.5, 오목 안 모서리 회전에서 조금 더 간다. 포켓 위 넓이는 오목 폭보다 **매트 깊이 H와 건너편 길이**가 정한다.

### 4-3. 기준 임시 형상(1500×700, 오목 500×300 가운데)의 구간별 최댓값

`tools/out/mech_RX-12/phases_base.json`. 봉제 순서대로.

| 구간 | 매트 회전 | X 최대 | +X 넓이 mm² | 볼 받침 밖 mm² | 패널 밖 mm² | 포켓 위 mm² |
|---|---|---|---|---|---|---|
| 뒤 긴 변·옆 변·다리2 끝 변(직선·볼록 모서리) | — | 6.5~9.2 | ≤ 7.2 | 0 | 0 | 0 |
| 회전: 오목 입구2(볼록 +90°) | 90 → 180° | 1006.5 | 550,000 | **323,536** | 282,556 | **282,556** |
| 직선: 오목 벽2(입구 → 안 모서리) | −180° | 1006.5 | 550,000 | 311,342 | 248,313 | 238,658 |
| 회전: 오목 안 모서리2(오목 −90°) | −180 → 90° | **1052.1** | 550,000 | 275,909 | 234,804 | 234,804 |
| 직선: 오목 바닥 | 90° | 306.5 | 300,000 | 0 | 0 | 0 |
| 회전: 오목 안 모서리1(오목 −90°) | 90 → 0° | **1052.1** | 550,000 | 116,458 | 25,095 | 3,250 |
| 직선: 오목 벽1(안 모서리 → 입구) | 0° | 1006.5 | 550,000 | 116,458 | 25,095 | 3,250 |
| 회전: 오목 입구1(볼록 +90°) | 0 → 90° | 1006.5 | 550,000 | 74,550 | 22,050 | 0 |
| 다리1 끝 변·옆 변 | — | 6.5~9.2 | ≤ 7.2 | 0 | 0 | 0 |

- 먼저 들어가는 벽(벽2) 쪽에서는 몸통이 **+X · −Y(포켓)** 로 가고, 나오는 벽(벽1) 쪽에서는 +X · +Y(볼 있는 쪽, X > 900만 밖)로 간다. 진행 방향이 고정이라(헤드 이송 +Y, 몸통 −X) 이 치우침은 형상을 뒤집어도 같다.
- 오목 바닥을 박을 때는 양쪽 다리가 +X로 오목 깊이만큼(X ≤ 306.5) 나오고 받침 안이다.
- 바늘 옆 바퀴(U4, X −100~−195 · Y 0)와 먼 쪽 바퀴(U5, X −420~−1800 · Y 0)가 오목 빈 곳 위에 오는 구간은 이 계산에 넣지 않았다. 설계가 연구 키(바퀴 들기)를 잡을 때 본다(0-8-2 ② "바늘 옆 바퀴가 홈 빈 공간 위에 오면 든다").

## 5. 요구서·결정로그의 관련 결정과 기각 이유

| 근거 | 내용 | 이 과제에서 지킬 것 |
|---|---|---|
| C-47 · 요구서 5절 RX-12 | "오목·홈을 박을 때, 그리고 좁은 홈·V홈 바닥에서 돌 때 매트의 큰 부분이 +X로 넘어간다." 사용자 "확인해야해" | 새 매트를 넣어 +X 넓이·부품 간섭을 잰다. 0-8-5 문장을 결과로 고친다 |
| 과제 지시 | "테이블이 모자라거나 부품과 겹치면 이 과제에서 구조를 고치지 않고 구동 후보(좌표·넓이·겹침량)로 올린다" | 포켓·+X 끝·기둥은 고치지 않고 수치로 올린다 |
| 실행 규칙 14 | "옆·뒤 커버, 가드 판넬, 외장 판금, 정비 문은 구동 과제·구동 후보로 만들지 않는다" | R375X의 절곡 덮개를 따라 덮개를 만들지 않는다. 우리 테이프는 위로 지나간다(0-8-2 ④). 다만 매트를 받치는 테이블 면(받침·안내)은 구동이다(같은 규칙 "구동 유닛, 그 받침·안내") |
| E-15 · 실행 규칙 20 | "기계의 모든 움직임은 CAD 조인트(슬라이드·회전)…로 정의한다", 매트 조인트는 "모형용, 기계 축 아님" | 새 매트도 `J_WP_<새>_X·Y·ROT`(model_only)로. 부품 이름으로 옮기지 않는다 |
| 요구서 6-4 | "이송 행정(X·Y) 25 mm, 원판 회전 5°, 바늘 둘레 반경 50 mm 안·홈 안·모서리 회전 구간은 5 mm·1°" | 연구 단계 간격. 1,000단계를 넘으면 G처럼 둘로 나눈다(WF-126) |
| C-03 · 요구서 7절 | 영구 눌림자국 금지. 매트의 유연한 거동(처짐·주름)은 모델로 판정하지 않는다 | 포켓 위로 나간 매트의 처짐은 판정하지 않고 7절에 기록만. 넓이·자리는 수치로 낸다 |
| C-48 · C-49 | RX-03 보류, RX-09 취소 | 접촉식 가장자리 감지·취소 과제를 이 과제에 끌어오지 않는다 |
| SIM-01 범위 | 테이프 조각(`J_TP_*`)은 이 과제에서 만들지 않아도 된다 | 필요하면 구동 후보로 |
| 실행 규칙 6 | "경쟁 기계 사양을 우리 사양처럼 쓰지 않는다" | 오목 치수는 R375X 사진 비례를 임시값의 근거로만 쓰고 D-01·D-02 '쓰는 곳'에 적는다 |

## 6. 이미 되는지 판정

**already_ok = false.**

| 완료 판정 | 지금 모델 | 근거 |
|---|---|---|
| ① 새 매트 한 사이클 전 구간 간섭 0 | 잴 수 없음 | 새 매트 바디·컴포넌트 없음(매트 바디 4개), 연구 없음(9개 가운데 사이클 5개는 L·S·G1·G2·V) |
| ② 매트 뒷면이 전 구간 볼·롤러·원판 위 | 임시 형상으로는 **안 됨(어림)** | 기준 형상에서 볼 받침 밖 323,536 mm², 포켓 위 282,556 mm², 패널 끝 밖(X > 975) 22,050 mm². 가장 작은 예(1000×500)도 포켓 위 58,493 mm² → 구동 후보로 올릴 자리 |
| ③ +X로 넘어가는 최대 넓이를 결정로그에 | 없음 | 기존 매트 값(G 929.4 · 1,095,000 mm², V 914.7 · 935,308 mm²)도 결정로그에 없다 |
| ④ 0-8-5 문장 고칠 안 | 없음 | 0-8-5는 "매트는 늘 바늘의 −X 쪽" 그대로 |
| ⑤ machine.json에 새 매트 | 없음 | joints 158(매트용 12), studies 9, units `WP_L·S·G·V` |

구상·설계·모델링을 건너뛰지 않는다.

## 7. 구동 후보로 올라갈 것으로 보이는 자리(수치)

이 과제에서 고치지 않는다. 설계·검도가 새 매트로 CAD에서 다시 재서 올린다.

| 자리 | 좌표 | 임시 형상에서 걸리는 양 | 지금 있는 것 |
|---|---|---|---|
| +X · −Y 포켓 | X 400~1160 · Y < −300(볼은 Y < −200) | 매트 58,493~723,858 mm²가 받침 없는 자리 위(기준 형상 282,556) | 작업자 자리, 볼·패널 없음, 밑 가로대 Z −172~−92 |
| 테이블 +X 끝 | 볼 중심 850(받침 900), 패널 975 | X 최대 702.5~1244.8, X > 975 넓이 0~92,050 mm²(기준 형상 22,050) | X 975~1150은 빈자리 |
| +X 기둥 | X 1150~1230 · Y 120~320 · Z −840~250 | 오목이 가운데면 겹침 0(오목 폭 700에서 기둥 X 1150까지 1.9), 치우치면 10,537~11,300 mm² | U1 기둥 `HFS8-80160-1090_M07:2` + `HFS8-4080-1090_M07_PX` |
| 바인더 밑 | X −11~45.5 · Y −95~−9 · Z 13 | 매트 윗면 10에서 3.0(테이프 11에서 2, 이음매 12에서 1). 지금도 홈 매트가 지나는 자리 | 겹침 0 |

## 8. 임시값(실행 규칙 6)

| 값 | 쓴 곳 | 근거 | 자료대기 |
|---|---|---|---|
| 오목 W·D·다리 a, 매트 L·H 조합 12가지 | 4-2 어림 | 사진 `q3_test_mat.png` 비례(길이 : 깊이 2.3 : 1, 오목 폭 1/3, 깊이 0.45). 실물 없음 | D-01·D-02 '쓰는 곳'에 더할 것(설계가 정한 한 형상으로) |
| 모서리 R 0 | 4-1·4-2 | 넉넉한 쪽. 실제는 둥글다(D-03 임시 볼록 R30) | D-03 |
| 매트 두께 10(범위 6~16), 테이프 +1, 이음매 +2 | 3-2 층 Z 0.5~18 | D-04 임시 | D-04 |
| 받침 = 볼 중심 + 반 피치 50 | 4절 넓이 | 볼 피치 100(D-96 임시). 정의는 설계가 정한다 | D-96 |

## 9. 미완

- 새 매트의 한 사이클 CAD 간섭 검사: 모형·연구가 없어 못 함(모델링 뒤 검도가 한다).
- 4-2·4-3은 평면 강체 계산이다. 매트 처짐·바퀴 누름·바인더 둘레의 테이프 굽음은 들어 있지 않다(요구서 7절).
- 로딩·배출 자세에서 새 매트가 포켓·라이트커튼(앞쪽 Y −1560 아래)과 만나는지는 시작 변이 정해져야 잴 수 있다.
- 긴 프레임 3종(`HFS8-4080-1720`·`-2555`·`-3150`)의 bbox ≠ 형번 길이는 원인을 끝면 프로브로 확인하지 않았다(매트 길 밖).

## 워크플로우 메모

- `inspect_design {measure:false, sketches:false, joints:false}`가 1.3 MB라 MCP 응답 한도를 넘는다(RX-06-C2 검도와 같은 지적). 파일로 떨어진 것을 읽어 dirty만 봤다. dirty·피처 수만 주는 가벼운 조회가 필요하다.
- `motion.play`는 `quiet: true`여도 키 조인트 값 전부(REST 153개)를 돌려준다. 원복 한 번에 응답 약 1,900줄.
- `motion.list`가 연구 키 전부를 준다(523 KB). 매트 조인트 키만 뽑으면 CAD 구동 없이 매트 범위를 계산할 수 있어, 측정부가 사이클을 돌리지 않고도 범위를 낼 수 있었다.
- `machine.json`의 `doc`가 v2.15.0으로 남아 있다(config.json은 v2.15.2).
- 과제 지시의 문서 기준(v2.13.0)과 실제 최신(v2.15.2)이 다르다. config.json doc를 따랐다.

## 파일

| 파일 | 내용 |
|---|---|
| `tools/out/mech_RX-12/parts_table.csv` | +X 쪽 구매품 bbox·부피 표(345줄) |
| `tools/out/mech_RX-12/slab_bodies.json` | 매트 높이 층(Z 0.5~18)에 걸치는 기계 바디 14 |
| `tools/out/mech_RX-12/ball_centers.json` | 볼 827개 중심 (X, Y) |
| `tools/out/mech_RX-12/motion_list.json` | `motion.list` 원본(연구 9, 키) |
| `tools/out/mech_RX-12/envelope_existing.json` · `.py` | 기존 매트 범위 |
| `tools/out/mech_RX-12/envelope_new_mat.json` · `.py`, `phases_base.json` · `.py`, `rx12_common.py` | 임시 형상 어림 |
| `tools/out/mech_RX-12/probe_slab_v2152.json` | CAD 틈 검사 2건 + 조인트 운동 확인 |
| `tools/out/mech_RX-12/inspect_design.json` | 처음 `inspect_design` 원본 |
| `tools/out/mech_RX-12/against_slab.json` | 틈 검사 against 이름 |
