hyeunung/FSAP/docs/reports/mechanism/mech_RX-12_verify.md

# 구동 RX-12 검도·체결 — 시험 매트 '긴 매트 + 넓은 오목'(WP_W, CYCLE_W1·W2) v2.16.0

## 요약

- **판정: 합격(동작 문제 0).** 대상 `3D_Modeling/FSAP_v2.16.0.sc`(앱에 열려 있던 저장본, dirty false). 바뀐 부품은 `MAT_W` 하나, 기계 부품·볼트·구매품 변경 0.
- **검도가 직접 잰 것(앱 세션 MCP, 읽기만)**: 기계 조인트 8개 + 매트 조인트 3개를 연구 자세 값으로 놓은 **22자세**(W1·W2의 0·25·50·75·100 % + 가장 불리한 자세 W1 420·439·466·469·488·516·517, W2 16·19·66·67·112·500)에서 `inspect.clearance {MAT_W ↔ 88바디, 30 mm}`. truncated 0, unchecked 0, **기준선 밖 새 겹침 0**.
- 겹침은 기준선 2종뿐: `U3_NEEDLE_PIN` **20.1 mm³**(바늘 −30인 15자세 전부), `TL_FEED` 2.6~**75.0 mm³**. 딱딱한 부품 최소 틈: 바인더 `P_M05_BINDER` **3.0**, 카세트 판 `P_M05_CST_PLATE` **10.0**, 노루발 2.0(발바닥 Z 12).
- `MAT_W` bbox 22자세 모두 평면 계산과 차 0.0 mm. **+X 최대 X 1052.1**(W1 488) 확인. X > 975 넓이 22,050 mm²(W1 439) 독립 계산 일치.
- 기존 연구 9개: 기존 키(조인트 줄 537개, 점 6,087개) 변화 0, 더한 것은 `J_WP_W_*` 0 키 27개뿐(앱 `motion.list` ↔ v2.15.2 대조).
- 모델링부의 전 구간 결과 파일을 다시 읽어 확인: 움직이는 유닛 4묶음 `motion.interference` W1 584·W2 586표본 **truncated false**, 서 있는 유닛·매트 높이 층 1,013자세 빠진 것 0.
- 완료 판정 ①~⑤ 충족(②는 받침 밖 넓이가 0이 아니어서 판정문대로 구동 후보 RX-12-C1·C2, 결정로그에 있음). 설계검토서·요구서 0-8-5·7절 기재는 문서 담당 차례.
- 디테일 1건: 기준선 문구 `TL_FEED ↔ WP_MAT_* (회전·피벗 중)`가 실제 겹치는 단계보다 좁다(문서 담당이 문구만 넓힘).
- 원복: `edit.restore_checkpoint 79` → 조인트 대기 값·`MAT_W` REST bbox·dirty false 확인. 원장 commit, 판정 기억 2건.

## 1. 범위·통로

- 범위(E-17 "검증 원장과 바뀐 범위로 검사 범위를 정한다"): `ledger.py scope --joints-changed` → 전체 검사 예, 새로 1(`WP_MAT_W/MAT_W`), 바뀜 0, 이웃 205, 이동 유닛 `WP_W`.
- 통로: 이 시각에 CAD를 쓰는 부서가 하나라 앱 세션(MCP). 앱에 v2.16.0이 이미 열려 있어(`inspect_design` path·name `FSAP_v2.16.0`, dirty false, 피처 3,712, 타임라인 error 0) 다시 열지 않았다(파일 열기 0). 저장 안 함.
- 타임라인 warning 54건은 모두 `Boolean retry: tool displacement …`로 v2.15.2(피처 3,709)에도 같은 54건이 있다 — 이번 과제로 생긴 것 0.
- 결과가 큰 호출은 모델링부 도구(`tools/out/mech_RX-12/model/mcp_send.py`)와 같은 방식의 `verify/run2.py`로 보내 파일에만 남겼다(E-20).
- 전체 사이클은 돌지 않았다(E-03 과제 안 검사, 라운드 끝 전체 회귀 몫). 스크린샷은 찍지 않았다.

## 2. 과제 범위 동작 검사(E-03·E-17)

### 2-1. 방법

- 자세마다 `joint.drive`로 `J_U3_PRESSER`·`J_U3_NEEDLE`·`J_U4_PRESS`·`J_U5_X`·`J_U5_LIFT`·`J_U5_FLOAT`·`J_U6_SHIFT`·`J_U6_PRESS`·`J_WP_W_X`·`J_WP_W_Y`·`J_WP_W_ROT`를 `cycle_w.json` 자세 값(= 연구 키)으로 놓았다(E-15 "움직임은 기계 정의의 조인트로만"). 바퀴 회전(`J_U4_WHEEL_ROT`·`J_U5_WHEEL_ROT`)은 형상이 바뀌지 않는 회전이라 뺐다(machine.json 메모).
- against 88바디 = 서명(REST bbox)에서 고른 매트 높이 층: 서 있는 유닛(U1·U2·U8)은 Z −5~15에 걸치는 바디 20, 내려오는 유닛(U3~U7)은 밑 Z ≤ 60인 바디 65(행정 최대 40 + 여유), 볼 대표 3(바늘 옆·+X 끝·−X 끝, E-19 "같은 것은 묶어 가장 불리한 하나만" — 볼 827개 윗면 Z 0.0으로 같음). 다른 시험 매트(WP_*)는 기준선(로딩 자리에 겹쳐 있음)이라 뺐다. 목록 `verify/against.json`.
- 이 층 밖 +X 쪽 부품(`U7_ROLL_MOUNT` Z 551~, 윗헤드 암 밑 Z 125, HMI 판 Z 343~, 보)은 Z 0~10 평판인 매트와 높이가 겹치지 않는다. 카세트(`U7_CASSETTE` Z 20~)·`U7_TAPE`의 낮은 바디는 against에 들어 있다.
- 검사 간격(요구서 6-4 "이송 행정(X·Y) 25 mm, 원판 회전 5°, 바늘 둘레 반경 50 mm 안·홈 안·모서리 회전 구간은 5 mm·1°"): 연구 단계를 `cycle_w.json`으로 셌다 — 직선 단계 이동 최대 25.0 mm(5 mm 단계 80개가 모서리 앞뒤), 회전 단계 720개 모두 1.0°. 모델링부 전 구간 검사는 단계마다 한 표본(584·586)이다.

### 2-2. 결과(22자세)

| 연구·단계 | 구간 | MAT_W X 최대 | 겹침(mm³) | 바인더 틈 | 카세트 판 틈 |
|---|---|---|---|---|---|
| W1 0 | 대기·로딩 | 6.5 | 없음 | 3.0 | 30 밖 |
| W1 146 | 볼록 A 회전 | 9.2 | 바늘 20.1 · TL_FEED 10.28 | 3.0 | 30 밖 |
| W1 292 | 볼록 B 회전 | 8.6 | 바늘 20.1 | 3.0 | 30 밖 |
| W1 420 | 오목 입구2 회전(받침 밖 최대 근처) | 953.8 | 바늘 20.1 | 3.0 | 30 밖 |
| W1 437 | 같음(75 %) | 1006.1 | 바늘 20.1 | 3.0 | 30 밖 |
| W1 439 | 같음 끝(+X 넓이 최대) | 1006.5 | 바늘 20.1 | 3.0 | 30 밖 |
| W1 466 | 오목 벽2 직선(안 모서리 앞 20) | 1006.5 | TL_FEED 5.0 | 3.0 | 10.0 |
| W1 469 | 오목 벽2 직선 끝 | 1006.5 | TL_FEED 75.0 | 3.0 | 10.0 |
| W1 488 | 안 모서리2 회전(**X 최대**) | **1052.1** | 바늘 20.1 · TL_FEED 75.0 | 3.0 | 10.0 |
| W1 516 | 안 모서리2 회전 ROT 225 | 928.4 | 바늘 20.1 · TL_FEED 75.0 | 3.0 | 10.0 |
| W1 517 | 정지·먼 쪽 바퀴 들기 | 928.4 | 바늘 20.1 · TL_FEED 75.0 | 3.0 | 10.0 |
| W1 583 | 오목 바닥 앞 반 끝 | 306.5 | 없음 | 3.0 | 30 밖 |
| W2 16 | 오목 바닥 뒤 반(안 모서리 앞 20) | 306.5 | TL_FEED 5.0 | 3.0 | 10.0 |
| W2 19 | 같음 끝 | 306.5 | TL_FEED 75.0 | 3.0 | 10.0 |
| W2 66 | 안 모서리1 회전 ROT 135 | 928.4 | 바늘 20.1 · TL_FEED 75.0 | 3.0 | 10.0 |
| W2 67 | 정지·먼 쪽 바퀴 내림 | 928.4 | 바늘 20.1 · TL_FEED 75.0 | 3.0 | 10.0 |
| W2 112 | 안 모서리1 회전 끝 | 1006.5 | 바늘 20.1 · TL_FEED 50.0 | 3.0 | 30 밖 |
| W2 146 | 오목 입구1 회전(25 %) | 1006.1 | 바늘 20.1 · TL_FEED 6.67 | 3.79 | 30 밖 |
| W2 293 | 볼록 C 회전(50 %) | 8.7 | 바늘 20.1 · TL_FEED 22.28 | 3.0 | 30 밖 |
| W2 439 | 볼록 D 회전(75 %) | 9.1 | 바늘 20.1 · TL_FEED 2.6 | 3.0 | 30 밖 |
| W2 500 | 정지·먼 쪽 바퀴 들기 | 6.5 | 없음 | 3.0 | 30 밖 |
| W2 585 | 배출 | 6.5 | 없음 | 3.0 | 30 밖 |

- 모든 자세: `truncated` false, `unchecked` 0, 88쌍(검사 + bbox로 가름). `MAT_W` bbox는 평면 계산(오목 다각형을 조인트 값으로 옮긴 것)과 차 0.0 mm.
- 맞닿음(0.0, 부피 0): `P_DC205_STRIP`·`STEP대기_867-392342_LOWER`·`P_M02_DISK`·볼(밑면 Z 0), 내린 자세에서 `P_M02_WHEEL_TREAD`·`P_M03_WHEEL_TREAD`(윗면 Z 10) — 기준선 "볼 윗면 = 바늘판 윗면 = 원판 윗면 Z 0에 매트 밑면이 얹힘", "바퀴 내림 = 매트 윗면 Z 10 맞닿음". W1 517(먼 쪽 바퀴 든 자세)에서는 `P_M03_WHEEL_TREAD` 맞닿음이 없어진다(들림 확인).
- 그 밖 가까운 것: `P_M01_FOOT` 2.0(노루발 0 = 발바닥 Z 12), `P_M02_DISK_SHAFT` 2.0·`CB5-16_M02_19~21` 0.5~1.5(매트 아래).
- +X 기둥(`HFS8-80160-1090_M07` X 1150~)·라이트커튼은 전 자세 30 mm 밖. 매트 X 최대 1052.1이라 X만으로 97.9 이상 떨어진다(설계 보고서 104.1).
- 원본 `tools/out/mech_RX-12/verify/r10.json`·`r11.json`, 표 `summary.json`.

### 2-3. 겹침 판정

| 쌍 | 실측 | 판정 | 근거 |
|---|---|---|---|
| `U3_NEEDLE_PIN` ↔ `MAT_W` | 20.1 mm³(15자세), 전 구간 20.10·깊이 5.0 | 허용(기준선) | M-08 "의도된 겹침은 기준선으로 따로 적어 두고 뺀다", machine.json "U3_NEEDLE ↔ WP_* 바늘이 매트를 꿰뚫는 의도된 겹침 … MAT 20.1" |
| `TL_FEED` ↔ `MAT_W` | 2.6~75.0 mm³(13자세), 전 구간 최대 75.0(조각 225 mm³의 1/3 = 매트 두께 안 부분 통째) | 허용(기준선) | machine.json "TL_FEED ↔ WP_MAT_* … 실제는 바인더 출구에서 테이프가 굽는 곳(요구서 7절, 모델 판정 아님). 단계별 부피 기록만". 프로젝트 규칙 6 "매트·테이프의 유연한 거동은 모델로 판정하지 않고 요구서 7절에 기록만" |

- `TL_FEED`는 테이프 조각 모형(유연한 것)이고, 딱딱한 바인더는 전 자세 3.0 위에 있다. 다만 겹치는 단계가 기준선 문구 '회전·피벗 중'보다 넓다: 오목 안 모서리 앞 직선 4단계(W1 466~469, W2 16~19 — 검도 실측 5.0 → 75.0)와 바늘 빼기 단계. → 디테일 RX-12-D1(문구만).
- 두 쌍을 판정 기억에 남겼다(`paircache.py judge`, 키 `6ad8f995e448c7d74993`·`13dfdd0e1ca7f0ac824d`, `tools/out/judged.json` 225건).

### 2-4. 모델링부 전 구간 결과 다시 읽기

| 파일 | 확인한 것 |
|---|---|
| `model/cli/mi3_summary.json`, `res_mi3_CYCLE_W1·W2.json` | 8건(W1·W2 × A1·A2a·A2b·A3) 모두 `truncated` false, 표본 584·586 = 단계 + 1. 충돌 쌍은 `U3_NEEDLE:1`(20.10)·`U7_TAPE_FEED:1`(55.0, 가장 깊은 단계)뿐, U5 두 묶음 clear true |
| `model/cli/sweep_summary.json` | 1,013 / 1,013자세, held 0 · unchecked 0 · truncated 0 · missing [], 겹침은 `TL_FEED`뿐(560자세, 최대 75.0) |

- 검도 22자세의 값(바늘 20.1, TL_FEED 5.0·6.67·10.28·22.28·50.0·75.0, 바인더 3.0, 카세트 판 10.0)이 그 결과와 같은 단계에서 같다.
- 한계 그대로: U1·U2·U8은 `motion.interference`가 아니라 자세 훑기(`inspect.clearance`)로 봤다(`too many bodies for a contact sweep`, 209바디 받음·275바디 거부). 겹침 유무 판정에는 같은 값이므로 완료 판정 ①에 쓸 수 있다고 본다.

## 3. 완료 판정 대조

| 항목 | 판정 | 근거 |
|---|---|---|
| ① 새 매트 한 사이클 전 구간 과제 범위 간섭 0(truncated false, 간격 6-4) | 충족 | 2-2(22자세 새 겹침 0), 2-4(전 구간 truncated false, 1,013자세), 간격 2-1 |
| ② 매트 뒷면이 전 구간 받침 위, 아니면 넓이·자리를 구동 후보로 | 충족(구동 후보 쪽) | 받침 밖 0이 아님. 결정로그 RX-12-C1(포켓 X 400~1026 · Y −1146~−200, 최대 282,556·323,536 mm²)·C2(X 최대 1052.1, X > 975 22,050 mm², X 900~1052 · Y −200~805). 검도 독립 계산: X > 975 22,050(W1 439) 일치, 볼만 센 받침 밖(볼 중심 ±50, 4 mm 격자) W1 425에서 366,176 — 원판·바늘판·띠 받침 약 4만~6만을 빼면 설계 323,536과 같은 크기 |
| ③ +X 최대(X 좌표·넓이)를 결정로그에 | 충족 | 결정로그 RX-12-S1: X 1052.1(W1 488), +X 넓이 550,000 mm²(X > 6.5 기준, W1 439). CAD 실측 X 1052.1. 참고: 바늘 선 X > 0 기준으로는 554,550 mm² |
| ④ 0-8-5 문장 고칠 안을 설계검토서·결정로그에 | 결정로그 충족, 설계검토서는 문서 담당 | 결정로그 RX-12-S4(수치 포함). 설계검토서·요구서 0-8-5·7절 반영은 이 뒤 문서 단계 |
| ⑤ machine.json에 새 매트, 기존 연구 키 변화 0 | 충족 | machine.json: joints 161(`J_WP_W_X·Y·ROT`), units `WP_W`, studies `CYCLE_W1` 583·`CYCLE_W2` 585, states 44, workpiece_stages `WP_W`, doc v2.16.0. 앱 `motion.list` 11개 ↔ v2.15.2 9개: 기존 조인트 줄 537개·점 6,087개 차 0, 더한 줄 27개는 모두 `J_WP_W_*` 값 0. 과제문 '기존 연구 5개'는 지금 9개(결정로그 RX-12-S5) |

## 4. 체결·묶임·판금

- 새로 넣거나 옮긴 볼트 0 → M-01 대상 없음. 공압 포트(M-06)·판금(M-04)·간이 형상 `LITE_` 대상 없음.
- 안 묶인 부품(E-11): `joint.list` floating [] · conflicts [] · errors [](조인트 587). `MAT_W`는 `WP_MAT_W` → `J_WP_W_ROT` → `WP_W_Y` → `J_WP_W_Y` → `WP_W_X` → `J_WP_W_X` → `U1_FRAME`으로 이어지고, 조인트 3개를 몰았을 때 bbox가 계산과 같이 움직였다.

## 5. 문제

| id | kind | 무엇 | 어디 | 수치 | 고치는 방법 |
|---|---|---|---|---|---|
| RX-12-D1 | 디테일 | 기준선 문구가 실제 겹치는 단계보다 좁다 | `tools/machine.json` baseline_overlaps "TL_FEED(U7_TAPE_FEED) ↔ WP_MAT_* (회전·피벗 중)" | 회전 밖 단계 W1 466~469 · 563~564, W2 16~19 · 113~114에서 5.0~75.0 mm³ | 문구를 "(회전·피벗 중, R 0 오목 안 모서리 앞 직선 20 mm·바늘 빼기 단계 포함, 최대 75.0 mm³)"로. 형상 변경 없음. 요구서 7절에 'R 0 오목 안 모서리에서 테이프 굽음' 기록 |

동작 문제 0. 외부 조건으로 못 한 것 없음. 규칙 예외 요청 없음.

## 6. 등급

L 그대로 맞다(E-18): 새 작업 대상 모형 + 새 조인트 3 + 새 연구 2. 새 구매품·강도 항목 없음.

## 7. 원복·원장

- 포즈 변경 전 `edit.checkpoint`(79) → 끝에 `edit.restore_checkpoint {checkpoint: 79}`(안내서 '원복' ①). 뒤 확인: dirty false, 피처 3,712, `MAT_W` bbox X −693.5~6.5 · Y −1050~450, 조인트 대기 값(`J_U3_PRESSER` 20 · `J_U4_PRESS` 13.006 · `J_U5_X` 0 · `J_U5_LIFT` 30 · `J_U6_SHIFT` −60 · `J_U6_PRESS` 4.5 · `J_WP_W_*` 0) = REST 0단계 값. 그래서 `motion.play REST 0`은 따로 부르지 않았다(재생 한 번이 수 분).
- `ledger.py commit --date 2026-11-13`: 부품 3,189, 통과 항목 84. `sigcheck` reuse(문서·해시 같음).

## 워크플로우 메모

- `joint.drive J_U6_PRESS`(4.5 ↔ −0.4) 한 번이 약 **8~10분**(500 s, 620 s) 걸렸다. 다른 조인트는 0.3~2.7 s. 모델링부가 본 "`motion.play`가 봉제 자세로 갈 때 약 9분"의 원인이 이 조인트로 보인다. 자세 순서를 이 값이 두 번만 바뀌게 다시 잡았다(−0.4 묶음 → 4.5 묶음). 호출 상한 8분을 넘겨 MCP 호출이 시간 초과로 돌아왔고, 다시 보내지 않고 `running`이 빌 때까지 기다렸다. 원인(슈 누름 조인트 둘레의 풀이)은 따로 볼 만하다.
- 첫 묶음이 그 시간 초과로 끊겨 'W1 85' 기록은 기계만 85단계 자세이고 매트는 시작 자리였다(사이클에 없는 조합). 22자세에서 뺐다. W1 85는 모델링부가 `motion.play`로 본 자세다.
- `joint.drive` 결과 본문이 호출마다 약 94 KB라 직접 MCP 도구로 받으면 화면 한도를 넘는다 — 파일로 받는 도우미가 필요했다.

## 시간(E-23)

- 걸린 시간 약 29분(예상 검도 L 60분 안). 통로 MCP. CAD 호출 약 150(조인트 몰기 약 95, 측정·틈 46, 그 밖). 파일 열기 0(앱에 이미 열림), 가장 긴 열기 0 s, 앱 다시 켬 0, 브라우저 0.

## 파일

- `tools/out/mech_RX-12/verify/`: `plan.py`·`plan2.py`(자세·against), `run2.py`(보내기), `c00~c12.json`·`r00~r12.json`(호출·결과), `against.json`, `poses_meta.json`, `analyze.py`·`summary.json`, `sighash.txt`
- `tools/out/judged.json`(+2), `tools/out/ledger.json`, `tools/out/scope.json`
