hyeunung/FSAP/docs/reports/mechanism/mech_RX-06R_measure.md

# RX-06R 측정 — U4 X축에서 볼나사·손잡이 빼기, 레일 + 블록 + 고정만 (측정부, 2026-11-13)

요약(10줄 안):
- 대상 `3D_Modeling/FSAP_v2.14.0.sc`(config.json doc). 앱에 이미 열려 있었고(이름 FSAP_v2.14.0, 경로 같음, **dirty false**, 타임라인 3,717 오류 0·경고 55) 다시 열지 않고 MCP로 쟀다. 저장 0. 프로브 상자 14개는 `edit.checkpoint 10` → `restore`로 지움(끝: dirty false, 바디 정의 882, PRB 0, `motion.play REST 0` moved false).
- 서명 `sigcheck` **reuse**(3,195부품) → bbox·부피·질량은 서명 표 그대로. 새로 잰 것: 기준선 겹침, 후보 자리 프로브 14개, 조인트·링크·컴포넌트 구조(저장본 `document.json`), 관 경로, 레일 STEP 구멍.
- **이미 됨? 아니오.** 걷어 낼 바디 **15개**(690,010 mm³, 모델 질량 1.096 kg)와 조인트 `J_U4_XSCREW`(98014)·motion link(index 35, 18°/mm)가 그대로 있고, 레일 ↔ 블록 겹침 **178.87·178.99·178.87·178.99 mm³**(레일이 그린 상자), 잠금 부품 없음.
- 걷어 낸 뒤 남는 것: 레일 2(그린 상자 210) · 블록 4 · 끝 멈춤 2 · 캐리지(웹 Z 250~565 가운데 Z 482.5 위는 너트 자리). 볼나사 띠(X −495~−94 · Y 42~120 · Z 482.5~577.5)는 걷어 낼 것 + 캐리지 윗부분(130,143 mm³) 말고는 **빔**(관·다른 부품 0, 못 잰 쌍 0).
- 잠금 자리 후보(프로브 겹침 0·못 잰 쌍 0): ① 레일 사이 판 뒤 **X −335~−115 · Y 107~120(깊이 13) · Z 280~426** ② 위 블록 위 판 뒤 Y 107~120 · Z 454~482 ③ 캐리지 윗끝 위 Z 565~600. 판 앞(Y 45~95)은 관 6줄이 지난다(X −161·−169 세움, Z 381·391·430·440 가로).
- 레일 실물 STEP(SSEB13-570): 단면 12 × 7.5, 구멍 Ø3.5 + 카운터보어 Ø6, **피치 25·끝 10**(월드 X −325 + 25k). 220으로 자르면 X −335~−115·구멍 9개 — +X 연장 자리(X −125~−115) 프로브 겹침 0. 지금 210(끝 X −125)은 구멍 자리가 레일 끝에 걸린다. 블록 탭 M3 ×4(중심 ±7.5 · ±10).
- 행정: 블록 끝 X −332.95~−127.05(J 0~95), 멈춤 A·B와 틈 0.05. J 95에서 캐리지 −X 면 X −335 ↔ U5 아이들러 브래킷·U5 레일 끝 X −340 **5.0**, 클램프 L_6 X −344 **9.0**.
- 주의: U8 쪽 고정 관 `TU0604_M08P_U4_A2`·`_U4_B`(X −161, 발 장공 X −165~−157 통과)는 J_U4_X를 안 따라간다(RX-06 디테일 7). bbox 계산으로 J 약 1~39 사이에서는 캐리지 발·BASE 살이 이 관 자리(X −164~−158)를 지난다 — 0·47.5·95 세 점만 보면 안 걸린다.
- 미완: J_U4_X를 구동한 자세 검사는 하지 않았다(앱에서 `joint.drive J_U4_X` 한 번 6~8분 실측, 이미 됨 판정이 ①에서 갈려 필요 없음). 움직이는 묶음 무게중심은 서명 bbox 가운데 어림.

## 0. 측정 표·통로·시간

| 항목 | 값 |
|---|---|
| sigcheck | `{"mode": "reuse", "reason": "문서·해시가 같다", "parts": 3195}` (처음·끝 같음) |
| 통로 | MCP(앱 127.0.0.1:27878). `running` 빈 목록 확인 뒤 시작. 저장본 열기 0번(이미 열려 있음, 같은 경로 다시 `open`은 디스크를 읽지 않으므로 하지 않음). CLI 0번 |
| CAD 없이 읽은 것 | 저장본 zip 안 `document.json`(occurrence·component·feature·스케치), `tools/out/signatures.json`·`bolts.json`, `purchased-step/SSEB13-570/SSEB13-570.stp` 글자 분석 |
| 앱에서 잰 것 | `inspect_design` 2(처음·끝), `joint.list` 1, `inspect.interference` 1(11바디 4.7 s), 프로브 `batch` 1(상자 14개 4.4 s), `inspect.clearance` 1(프로브 14 × 영역 109바디, **559.5 s**, truncated false), `motion.play REST 0` 1 |
| 원복(E-08) | `edit.checkpoint 10` → 프로브 → `edit.restore_checkpoint 10` restored true. `measure PRB_Z1` unknown body, `inspect_design` dirty false·바디 882·타임라인 3,717·PRB 0. 조인트는 구동하지 않음, `motion.play REST 0` moved false |
| 숨김(E-11) | 숨긴 바디 97개(document.json `hidden_bodies`, 전과 같음), 숨긴 occurrence 0. 과제 영역 바디는 모두 보임 |

규칙 근거: E-17 "측정 전에 `ledger.py sigcheck`로 지금 문서와 맞는지 보고, 맞으면 그대로 쓰고", E-04 "그 시각에 CAD를 쓰는 부서가 하나뿐이면 … 앱 세션에서 저장본을 한 번 열고 이어서 잰다", E-16 "판정은 수치로만", 안내서 '간섭' "`against`에 모델 전체를 주지 않는다".

## 1. 과제에 걸린 부품·구동 요소 (REST: J_U4_X 0 · J_U4_PRESS 13.006 · J_U4_STOP 0)

### 1-1. 걷어 낼 것 (15바디, 690,010 mm³, 모델 질량 1,096 g)

| 바디 | 컴포넌트(occurrence id) | X / Y / Z (mm) | 부피 mm³ | 질량 g · 재질 | 묶인 곳 |
|---|---|---|---|---|---|
| BSS2020-1100_RX06_SHAFT | BSS2020-1100_RX06:1 (97910) | −445~−94 / 60~80 / 520~540 | 110,251.6 | 142.2 Default | J_U4_XSCREW 자식 |
| STEP대기_HANDLE_D50 | STEP대기_HANDLE_D50:1 (97914) | −495~−445 / 45~95 / 505~555 | 42,660.7 | 55.0 Default | 축에 강체(98012) |
| BSS2020-1100_RX06_NUT | BSS2020-1100_RX06_NUT:1 (97912) | −217.5~−147.5 / 47~93 / 497~563 | 105,803.0 | 136.5 Default | U4_XCAR에 강체(97999) |
| BSW20_RX06_BODY · COLLAR_1 ×2 · LOCKNUT | BSW20_RX06:1 (97904) | −402~−339 / 42~100 / 482.5~577.5 | 184,378.8 · 1,943.7 ×2 · 6,873.5 | 237.8 · 2.5 ×2 · 8.9 | U1_FRAME에 강체(97992) |
| BUN20_RX06_BODY · RING | BUN20_RX06:1 (97908) | −120~−94 / 42~100 / 482.5~577.5 | 83,950.0 · 179.5 | 108.3 · 0.2 | U1_FRAME에 강체(97993) |
| P_RX06_SPACER_F | U4_XAXIS:1 (97891) 안 | −392~−340 / 100~120 / 482.5~577.5 | 98,800 | 264.8 A5052 | U4_XAXIS 바디 |
| P_RX06_SPACER_S | U4_XAXIS:1 안 | −120~−94 / 100~120 / 482.5~577.5 | 49,400 | 132.4 A5052 | U4_XAXIS 바디 |
| CB6-20_M03_CAR :5~:8 (너트 볼트) | CB6-20_M03_CAR:5~8 (97906·97981~97983), 컴포넌트 8723은 U5 대차 볼트 :1~:4와 공유 | −174~−148 / 50.3~60.3·79.7~89.7 / 499.5~509.5·550.5~560.5 | 956.4 ×4 | 1.2 ×4 | U4_XCAR에 강체(98000~98003) |

- 길이 확인(WF-128): 축 110,251.6 ÷ (π·10²) = **350.9** mm = bbox 351(그린 Ø20 원통 `Cylinder1385`, STEP 아님). 손잡이는 Ø50×20 + Ø12×30 임시 형상.
- 이 바디를 만든 피처: `RX06_SCREW_PARTS`(97905, `rx06_screw_parts.sc` 넣기 — BUN·BSW·너트 7바디 한 피처) → BodyTransfer578~580(97915~97917), 축 `Cylinder1385`(97918)·BodyTransfer581, 손잡이 `Cylinder1386·1387`(97920·97921)·BodyTransfer582, 스페이서 `Box338·339`(97942·97943)·BodyTransfer585·586.
- 걷어 내면 비는 컴포넌트(빈 컴포넌트를 남기지 않을 대상): `BSW20_RX06`(97903), `BUN20_RX06`(97907), `BSS2020-1100_RX06`(97909), `BSS2020-1100_RX06_NUT`(97911), `STEP대기_HANDLE_D50`(97913) — 모두 루트 아래, 하위 컴포넌트 없음. `CB6-20_M03_CAR`(8723)은 :1~:4(U5_CAR)가 남으므로 occurrence :5~:8만.
- 볼트: BSW20·BUN20·스페이서를 보에 무는 볼트는 모델에 없다(RX-06-D3). `bolts.json`에서 이 묶음에 걸린 것은 너트 볼트 4개뿐.

### 1-2. 남길 것

| 바디 | 컴포넌트 | X / Y / Z | 부피 · 질량 · 재질 | 비고 |
|---|---|---|---|---|
| SSEB13-570_RX06_RAIL ×2 | RAIL_SSEB13-570:1·:2 (97897·97987, SSEB13-570_RX06:1 아래) | −335~−125 / 112.5~120 / 260~272 · 434~446 | 18,900 ×2 · 24.4 g Default | **그린 상자**(`Box335` 97924 + BodyTransfer583). 18,900 ÷ (12 × 7.5) = 210.0 mm. U1_FRAME에 강체(97990·97991) |
| SSEB13-570_RX06_BLOCK ×4 | BLOCK_SSEB13-570:1~:4 (97899·97984~97986, U4_XCAR 아래) | −237.95~−204.05 · −160.95~−127.05 / 107~117 / 252.5~279.5 · 426.5~453.5 | 7,226.4 ×4 · 9.3 g | 실물 STEP(`SSEB13-570_RX06_R1` 97900). 33.9 × 10 × 27 |
| P_RX06_STOP_A · _B | U4_XAXIS:1 안 | −335~−333 · −127~−125 / 108~112.5 / 260~272 | 108 ×2 · 0.86 g SUS304 | 아래 레일 윗면에만. 블록 끝과 틈 0.05(J 95·J 0) |
| P_RX06_CARRIAGE | U4_XCAR:1 (97893) | −240~−125 / 45~107 / 250~565 | 514,612.3 · 1,379.2 g A5052 | 아래 형상 |
| CB5-16_M02_1~4 · _1:2 · _1:3 (캐리지 발 볼트 6) | 루트 | X −232·−215·−150 (Y 50), −215·−180·−150 (Y 85) / Z 246~267 | 4.36 g ×6 | 위에서, P_M02_BASE M5 탭 물림 4(RX-06-D2). U4_XCAR에 강체(98004~98009) |

캐리지 형상(`SK_RX06_CARRIAGE` 97926 → `EX_RX06_CARRIAGE` 115, 피처 97927~97940·98100):

| 부분 | X | Y | Z | 비고 |
|---|---|---|---|---|
| 웹(세운 판 t12) | −240~−125 | 95~107 | 262~565 | 뒷면 Y 107 = 블록 윗면, 보 앞면 Y 120과 13 |
| 발(t12) | −240~−125 | 45~107 | 250~262 | 밑면 Z 250 = P_M02_BASE 윗면. M5 통과 Ø5.5 ×6, 관 장공 X −174~−157 · Y 66~84 |
| 너트 귀(`Box336`) | −174.5~−162.5 | 47~95.5 | 497~563 | Ø47 구멍(축선 Y 70 · Z 530) + Ø5 ×4 — 볼나사 너트 자리. 걷어 내면 쓸 곳 없음 |
| 위 블록 윗끝 | | | 453.5 | 웹 Z 453.5~565(111.5 mm)는 너트 귀만 받친다. PRB_Z1 ↔ 캐리지 130,143 mm³가 Z 482.5 위 부분 |

- 블록 체결 볼트·레일 볼트는 모델에 없다(RX-06-D1). 캐리지 웹에 블록 구멍도 없다.

### 1-3. 조인트·링크·묶음 (`joint.list`: 조인트 587 · 링크 36 · floating 0 · conflicts 0 · errors 0)

| 이름(id) | 종류 | a → b | 값·한계 | 비고 |
|---|---|---|---|---|
| J_U4_X (98013) | slider, 축 −X, 원점 (−180, 107, 353) | U4_XAXIS:1 (97891) → U4_XCAR:1 (97893) | 0, 0~95 | d₁ = 100 + J. 연구 키 없음(REST에도 없음, RX-06-D8) |
| J_U4_XSCREW (98014) | revolute, 축 +X, 원점 (−270, 70, 530) | U4_XAXIS:1 → BSS2020-1100_RX06:1 (97910) | 0, ±1800 | **지울 것** |
| motion link index 35 | a 98013 → b 98014 | ratio 18°/mm, offset 0 | | **지울 것**. 이 링크 때문에 `joint.drive J_U4_X`가 한 번 6~8분(mech_M02R_verify.md 113줄) |
| 강체 97988 | U1_FRAME:1 (2, 바닥 고정) ↔ U4_XAXIS:1 | | | 스페이서 2를 빼도 U4_XAXIS에는 멈춤 2가 남는다 |
| 강체 97989~97993 | U1_FRAME ↔ SSEB13-570_RX06:1 · RAIL:1 · RAIL:2 · BSW20_RX06:1 · BUN20_RX06:1 | | | 97992·97993은 없어짐 |
| 강체 97994~98009 | U4_XCAR ↔ U4_WHEEL_N:1 (10) · BLOCK ×4 · NUT(97999) · CB6-20 ×4(98000~98003) · 발 볼트 6 | | | 97999·98000~98003은 없어짐 |
| 강체 98012 | BSS2020-1100_RX06:1 ↔ STEP대기_HANDLE_D50:1 | | | 없어짐 |
| J_U4_PRESS (270) | revolute | U4_WHEEL_N:1 → U4_PRESS:1 | 13.006, −4.11~13.006 | 그대로 |
| J_U4_STOP (98121) | slider | CDQ2A25 몸 → U4_STOP:1 | 0, 0~20 | 그대로 |

- J_U4_X로 같이 움직이는 묶음(조인트 그래프에서 98013을 끊고 U4_XCAR에 이어진 것): occurrence **77개**(`xcar_group.json`) — U4_XCAR·블록 4·너트·너트 볼트 4·발 볼트 6·U4_WHEEL_N(BASE·피벗 브래킷·스토퍼 브래킷·RX08 U4 쪽 관 2·U6 관 브래킷)·U4_PRESS(그네·모터·감속기)·U4_WHEEL·U4S_CYL·U4S_ROD·U4_STOP. 원판 받침 묶음(U4_DISK_BASE, 테이블 고정)은 빠짐.
- 걷어 낸 뒤 움직이는 묶음 질량(서명 합, 109바디): **13.54 kg**. bbox X −356~−87.5 · Y −114.4~266 · Z 38.8~565. 무게중심은 bbox 가운데 어림 (−208, 51, 182) — 참고: RX-06 해석이 쓴 값은 매달린 묶음 10.815 kg CG (−215.6, 33.6, 156.6) + 캐리지 1.51 kg(mech_RX-06_fea.md 1절, RX-08 스토퍼 부품이 더해지기 전).
- `machine.json`: `J_U4_XSCREW` 항목, 유닛 `U4_XAXIS`의 parts(BSW20·BUN20·SHAFT·HANDLE·SPACER), `U4_XCAR`의 parts(NUT·CB6-20), `J_U4_X` _note(수동 손잡이·볼나사 문구)가 고칠 자리. `machine.json` doc 줄은 아직 v2.12.2.

## 2. 구매품 실물 — 레일 SSEB13 (완료 판정 ⑤ 자료)

`stepcheck.py`: SSEB13-570 **있음**(`purchased-step/SSEB13-570/SSEB13-570.stp`, 322 KB), SSEB13-220 없음(같은 계열 570을 잘라 씀 — 실행 규칙 18 "길이는 자르면 되는거", 결정로그 RX-06-E1). BSW20·BUN20·BSS2020-1100은 있음(이번에 걷어 냄).

STEP 글자 분석(`sseb13_step_parse.json`, STEP 좌표 → 월드: X = x − 325, Y = 120 − y, Z = 266(또는 440) − z, 지금 조립의 변환):

| 항목 | STEP 값 | 월드 자리 |
|---|---|---|
| 레일 길이 | x −10~560(570) | X −335~235(자르기 전) |
| 레일 단면 | 폭 12(z ±6) × 높이 7.5 | Z 260~272 · 434~446, Y 112.5~120(밑면이 보 앞면) |
| 레일 구멍 | Ø3.5 관통 + Ø6 카운터보어, 23개, **피치 25**, 첫 구멍이 끝에서 10 | X −325 + 25k (−325, −300, …, −125, −100, …), 축 Y |
| 220으로 자르면 | 구멍 9개(X −325~−125), 양 끝 10 | **X −335~−115** |
| 210(지금 그린 길이) | 끝 X −125가 구멍 중심에 걸림 | 표준 길이 아님(25 간격: 195·220) |
| 블록 | 길이 33.9(x ±16.95) × 폭 27(z ±13.5), 윗면 y 13 | 윗면 Y 107 |
| 블록 탭 | r 1.2295(M3 밑구멍) ×4, x ±7.5 · z ±10 | 블록 중심 X −221·−144, Z 266·440 → 탭 X −228.5·−213.5·−151.5·−136.5, Z 256·276·430·450, 축 Y |
| STEP 원본 레일 바디 | `Chamfer2` 44,563 mm³(570), `Remove86`(97923)이 지움 | 되살려 자르는 법: mech_RX-06_model1.md 3절, 결정로그 RX-06-E4(활성 컴포넌트에서 `solid.box` corner는 월드 점 (−115, 130, 280)) |

- 기준선: `inspect.interference`(레일 2·블록 4·멈춤 2·캐리지·너트·축 11바디, truncated false, unchecked 0) → 레일 ↔ 블록 **178.873 · 178.990 · 178.873 · 178.990 mm³**, 그 밖 0(축 ↔ 너트도 0). 그린 상자 레일에 홈이 없어 블록 볼 길과 겹치는 것이다.
- +X 연장 자리 프로브(PRB_Z5a·b, X −125~−115 · Y 107~120 · Z 252~280 · 426~454): 겹침 0, 못 잰 쌍 0 → 220 레일이 들어간다. 멈춤 B(X −127~−125, Y 108~112.5)는 레일 윗면 위라 레일이 길어져도 그대로다.

## 3. 비어 있는 공간 — 프로브 14개 (REST, `probes_v2140.json`)

`inspect.clearance {bodies: 프로브, against: 영역 109바디(X −520~−60 · Y −20~200 · Z 200~620에 bbox가 걸린 것 전부), clearance 0}` — pairs_checked 126, pruned 1,400, truncated false, 559.5 s.

| 프로브 | X / Y / Z | 겹친 것(mm³) | 못 잰 쌍 | 걷어 낸 뒤 |
|---|---|---|---|---|
| Z1 볼나사 띠 | −495~−94 / 42~120 / 482.5~577.5 | 걷어 낼 15바디 전부(위 1-1 부피 그대로, CB6-20은 956.4 ×4) + 캐리지 130,143.5 | 0 | **캐리지 윗부분만 남음**. 관·다른 부품 0 |
| Z2 레일 사이·판 뒤 | −335~−115 / 107~120 / 280~426 | 없음 | 0 | **빔** (220 × 13 × 146) |
| Z3 판 앞(작업자 쪽) | −340~−115 / 45~95 / 280~480 | 관 U4_A2 5,636.5 · RX08_B 2,489.5 · RX08_A_U4 1,718.9 · RX08_B_U4 1,725.1 | 관 U4_B · RX08_A(불리언 실패 — 4절 경로로는 지나감) | 관 6줄 |
| Z3b 판 앞 더 앞 | −340~−115 / 0~45 / 262~480 | 관 U6 3,185.1(Y 32 · Z 262) · CB4-12_M02_CLV 285.3(허공 볼트 M02R-D8) · P_M08_TUBE_BRKT_U6 1,480(X −340~−330 · Z 262~272) | 0 | Z 272 위는 CLV 볼트(X −164.5~−157.5 · Y 9.5~25.5 · Z 322~329)만 |
| Z4 위 블록 위 | −335~−115 / 95~120 / 454~482 | 캐리지 38,640(웹 115 × 12 × 28) | 0 | 판 뒤 Y 107~120 **빔** |
| Z5a·Z5b 레일 +X 연장 | −125~−115 / 107~120 / 252~280 · 426~454 | 없음 | 0 | 빔 |
| Z6a·Z6b 레일 위 블록 사이 | −204~−161 / 107~120 / 252.5~279.5 · 426.5~453.5 | 레일 3,870 ×1씩(43 × 7.5 × 12) | 0 | 레일 말고 빔(캐리지와 같이 움직이는 자리) |
| Z8 행정 밖 −X | −345~−335 / 45~120 / 250~480 | P_M03_IDLER_BRKT 4,080 · U5 풀리 HUB 368.6 · SV2RL28 레일 1,458.8 · 클램프 L_6 542.8 · 벨트 WRAP_I 1,862.8 | 풀리 FLANGE1·2 | X −340 밖은 U5 것. X −340~−335는 빔 |
| Z9 행정 밖 +X | −125~−80 / 45~120 / 250~480 | 관 U4_A2 1,725.4 · 클램프 F_5 18,209.9 · L_5 11,230.2 · 관 RX08_A 1,484.1 | 관 U4_B · U6 · RX08_B, CB5-16_M08_PY:18·19·28·29 | 클램프(X −112~−88)·관 꺾임 자리 |
| Z11 캐리지 윗끝 위 | −335~−94 / 45~120 / 565~600 | P_RX06_SPACER_S 6,500 | BUN20_RX06_BODY(걷어 낼 것) | 빔 |
| S1 캐리지 웹 길(J 0→95) | −335~−240 / 95~107 / 262~480 | 없음 | 0 | 빔 |
| S2 캐리지 발 길 | −335~−240 / 45~95 / 250~262 | 없음 | 0 | 빔 |

틈(상자 모양 바디라 bbox 값이 정확):

| 무엇 ↔ 무엇 | 틈 mm | 자세 |
|---|---|---|
| 캐리지 웹 뒷면 Y 107 ↔ 보 앞면 Y 120 | 13.0 | 전 행정 |
| 블록 끝 ↔ 멈춤 B / 멈춤 A | 0.05 / 0.05 | J 0 / J 95 |
| 캐리지 −X 면 ↔ U5 아이들러 브래킷(X −440~−340 · Y 90~120 · Z 314~466), U5 레일 끝(X −340 · Z 290~310) | 5.0 | J 95(캐리지 X −335~−220) |
| 캐리지 −X 면 ↔ 클램프 L_6(X −368~−344 · Z 252~284) | 9.0 | J 95 |
| 캐리지 +X 면 X −125 ↔ 클램프 L_5·F_5(X −112) / 헤드 임시 상자(X −80 · Y ±90 · Z 125~560) | 13.0 / 45.0 | J 0 |
| 레일 ↔ 클램프 L_5 / L_6 | 13.0 / 9.0 | mech_RX-08_model2.md(그대로) |
| 보 P_M07_BEAM | 각관 400 × 200 × t8(STKR400), 앞면 Y 120 · Z 250~650 | 탭은 벽 t8에 |

## 4. 관 경로 (Ø6, 저장본 스케치에서, `tube_paths.json`)

| 관 | 묶인 곳 | 영역 안 중심선 |
|---|---|---|
| TU0604_M08P_U4_B | U8_PNEU(고정) | 보 앞 (Y 110, Z 430)을 따라 +X에서 X −69 → 꺾어 (Y 70, Z 430) X −99~−146 → **세움 X −161 · Y 70 · Z 415~239** → BASE 밑(Z 223) |
| TU0604_M08P_U4_A2 | U8_PNEU(고정) | (Y 110, Z 440) → (Y 79, Z 440) X −99~−146 → **세움 X −161 · Y 79 · Z 425~208.5** |
| TU0604_M08P_U6 | U8_PNEU(고정) | (Y 108, Z 262) X −69까지 → X −84에서 Y 93~47 → **(Y 32, Z 262) X −99~−332** → X −347 · Y 17~−100 |
| TU0604_M08P_RX08_A_U4 / _B_U4 | U4_WHEEL_N(J_U4_X 따라감) | 세움 X −169 · Y 79→88 / 70→61 · Z 223~340 / 249~340 (발 장공 X −174~−164.9 통과) |
| TU0604_M08P_RX08_A / _B | U8_PNEU(고정) | X −169 · Z 340~376 / 340~366 → 가로 Z 391(Y 88) / Z 381(Y 61) X −154~−110 → Y 110 |
| TU0604_M08P_U5_A2 · U5_B | U8_PNEU | 영역 안 구간 없음(bbox만 걸림) |

- 캐리지 웹 앞(Y < 95)에서 관이 없는 곳: J 0 기준 X −240~−175(세움 관 −X 쪽), Z 262~480. 가로 관은 Z 381·391·430·440에서 X −154보다 +X 쪽.
- **주의(유연 관, RX-06 디테일 7·RX-08-M5):** 고정 관 U4_A2·U4_B 세움(X −164~−158)은 J 0에서만 발·BASE 장공(X −165~−157) 안이다. 캐리지 발 살(X −157−J ~ −125−J)이 이 자리를 지나는 구간은 J ≈ 1~39(bbox 계산). J 47.5에서는 발 +X 끝이 X −172.5라 8.5 떨어지고, J 95는 110 떨어진다. 과제 지시가 "U4_A2·U4_B·U6 관은 건드리지 않는다"이므로 d₁ 조절 범위·검사 점을 정할 때 이 사실만 넘긴다(관은 휘는 것, 요구서 7절·디테일).

## 5. 이웃 가동 유닛 점유 (서명 bbox + machine.json 조인트)

| 유닛 | 조인트·범위 | 대기 bbox X / Y / Z | U4 X축 쪽으로 가장 가까울 때 |
|---|---|---|---|
| U5 대차 U5_CAR | J_U5_X 0~1380(+X) | −2045~−1825 / 38~275 / 160~848 | J_U5_X 1380: X −665~**−445**. 지금 손잡이(X −495~−445)와 맞닿는 자리였음 — 걷어 내면 다음 고정물은 X −402(지금 BSW20) 안쪽. 잠금 부품은 X > −445에 |
| U5 승강·바퀴 U5_FLOAT·U5_LIFT·U5_WHEEL | J_U5_X, J_U5_LIFT −10~30, J_U5_FLOAT 0~20 | −1990~−1787.5 / −95~78 / 50~266 | J_U5_X 1380: X −610~−407.5(Z 266 아래). J_U4_X 95의 U4 묶음(X −451까지)과 X가 겹친다 — 기존 연동 조건 d₂ ≥ d₁ + 240(mech_RX-06_verify1.md), 상태 `SETUP_D1_195` |
| U5 고정쪽(아이들러·레일·벨트) | 없음 | 아이들러 브래킷 −440~−340 / 90~120 / 314~466, 레일 ~−340 / 104.5~120 / 290~310, 벨트 Z 339.6~342.8 · 437.3~440.5(X ≤ −390) | 보 앞면 X ≤ −340은 U5 것 |
| U3 헤드 임시 상자 | (고정) | −80~500 / −90~90 / 125~560 | X −80 |
| U6 슈·센서 | J_U6_SHIFT −60~0, J_U6_PRESS −5~4.5 | −350~−22 / −204.5~−90 / 20.8~218 | Y −90 아래·Z 218 아래 — X축 자리(Y 45~120 · Z 250 위)와 안 겹침 |
| U4 그네 | J_U4_PRESS −4.11~13.006 | P_M02S_SWING −322~−160 / 28.3~141.8 / 110~232(들림) | Z 242 아래(BASE 밑) — X축 부품(Z 250 위)과 BASE로 갈림 |

상태 목록(machine.json states 32개)에서 J_U4_X가 0이 아닌 것은 `SETUP_D1_195`뿐이고, 동작 연구 9개에는 J_U4_X 키가 없다(셋업 축).

## 6. 잠금(고정부) 손계산에 쓸 하중 입력 — 기존 보고서 값(판정은 설계·해석 몫)

| 항목 | 값 | 출처 |
|---|---|---|
| 바퀴 누름 N | 0.2 MPa(IR1000 상한) **71.5 N**(두께 16), 0.5 MPa 전부 **134.9 N** | mech_M02R_fea.md 50·51줄 |
| X 방향 마찰(잠금이 받는 힘) | 운전 μ 0.4 × 71.5 = **28.6 N**, 오조작 μ 0.5 × 134.9 = **67.5 N** | 같음(μ 임시) |
| 손 오조작 | 100 N(D-79 임시) | mech_RX-06_fea.md |
| 바퀴 구동 반력(접선 Y) | 18 N(U-09 제약) | mech_RX-06_fea.md 1절 |
| 스토퍼 받침 반력(Z, 묶음 안에서 닫힘 → 레일로) | 1 g·0.2 MPa 204.3 N, 운전 3 g 373.3 N, 오조작 553.1 N, 받침점 (X −170, Y 70) | mech_RX-08_fea1.md·fea2.md |
| 레일 블록 하중(X 위치와 무관) | 블록 P 최대 운전 349.2 N(SF 5.73), 오조작 549.9 N(SF 3.64, C0 2 kN 임시) | mech_RX-06_fea.md 1절 |
| 볼나사가 하던 일 | X 힘을 너트(Y 70 · Z 530)가 받음, 리드 20이라 역구동 — "잠금 필요 ≥ 0.35 N·m" 디테일이 있었음 | mech_RX-06_fea.md 3절 |
| 매달린 질량 | 13.54 kg(걷어 낸 뒤, 서명 합) | 1-3절 |

- 누름·스토퍼·무게는 Y·Z 힘과 모멘트라 레일 블록 4개가 받고, 잠금이 받는 것은 X 힘이다(레일이 X로 자유). 잠금 볼트를 Y로 조이는 방식이면 웹 뒷면–보 앞면 13 mm 틈을 메우는 받침 없이 조일 때 블록에 Y 하중이 실린다(블록 C0 임시 2 kN).

## 7. 작업 대상

| 모형 | X / Y / Z | 비고 |
|---|---|---|
| MAT_L(1500 × 1500) | −1493.5~6.5 / −1050~450 / 0~10 | 요구서 0-2·C-16 큰 쪽 |
| MAT_S(300 × 200) | −293.5~6.5 / −400~−200 / 0~10 | 작은 쪽 |
| MAT_G · MAT_V(좁은 홈·V홈) | −1193.5~6.5 / −900~300 / 0~10 | 가장 좁은 홈 |

- 매트는 Z 0~10(두께 임시 6~16), X축 부품은 Z 250 위·보 앞면이라 매트 길과 240 mm 떨어져 있다. 과제가 바꾸는 바디는 작업 대상 길에 닿지 않는다(E-17 '작업 대상 길에 닿는 부품' 아님). 매트와 닿는 것은 바퀴 트레드뿐이고 d₁(= 100 + J)에 따라 X가 바뀐다 — 바퀴가 원판 Ø250(X −300~−50) 위에 있으려면 d₁ 62.5~287.5, +X 쪽은 헤드 임시 상자와 트레드 틈 7.5(mech_RX-06_measure.md).
- 떨어지는 조각 없음(machine.json workpiece_stages). 0-3 사이클에서 J_U4_X는 움직이지 않는다(셋업 때만).

## 8. 관련 결정·기각 이유 (같은 실수 막기)

| 근거 | 내용 |
|---|---|
| C-46 (사용자 2026-11-13 "응") | "RX-06 U4 X축에서 볼나사·손잡이를 빼고 레일 블록 + 고정만 남긴다" — 볼나사·레일 2줄은 헤드 위 대차 쪽으로 이어짐, "근거 없는 구동부를 두면 부품·간섭만 는다(U-06)" |
| RX-06-E1·E4 | 레일은 STEP을 잘라 **SSEB13-220**(X −335~−115, 구멍 9). 새 STEP을 RAIL 컴포넌트에 넣으면 변환이 두 번 걸리고 이름이 겹친다(28분 + 삭제 22분 헛일). `Remove86`을 지워(또는 대상에서 `Chamfer2`를 빼) 원본을 되살린 뒤 활성 컴포넌트에서 월드 corner로 cut |
| RX-06-E5 ② 기각 | 받은 STEP에 없는 끝 가공을 그리지 않는다(U-07 "절대적으로 step파일로 해야해 … 추정해서 부품 넣지말고") — 잠금 구매품도 같은 원칙 |
| RX-06-D4 | 끝 멈춤 2 × 4.5 × 12 고정법 미정, 블록 엔드캡(수지)이 받음(mech_RX-06_fea.md 3절) — 남는 부품이라 그대로 디테일 |
| RX-06-D6 | 너트 볼트가 U5 대차 볼트 컴포넌트(CB6-20_M03_CAR)를 공유 — 지울 때 occurrence :5~:8만, 컴포넌트·:1~:4는 남긴다 |
| RX-08-M6 | 스토퍼 관 U4 쪽(`_A_U4`·`_B_U4`)은 U4_WHEEL_N에 강체 → J_U4_X를 따라감. 발 장공 X −174~−164.9을 지남 — 발·장공을 건드리면 같이 본다 |
| M02R 검도 메모 | `joint.drive J_U4_X` 6~8분/회(볼나사 링크 추정), 여러 점을 한 batch에 넣어 30분 넘겨 앱을 다시 켠 일 1회. 링크를 지운 뒤에는 빨라질 수 있음(확인 필요) |
| 소멸 대상 | E5(BSW15·BUN15 교체), D-190(손잡이 STEP), D-191(축 끝 가공) — 볼나사가 없어지면 소멸. RX-06-D3(지지 유닛 볼트)도 같음 |
| M02R-D6 | 탭 볼트 `CB5-12_M02S_BASE_7·_8` 끝 Z 250이 캐리지 밑면에 맞닿음(거리 0) — 캐리지 발을 고치면 같이 본다 |

## 9. 이미 되는가 (E-17 과제 안 판정)

| 완료 판정 | 지금(v2.14.0) | 만족 |
|---|---|---|
| ① 걷어 낸 부품 잔재 0 | 바디 15개(690,010 mm³) · 컴포넌트 5개 · J_U4_XSCREW(98014) · motion link(index 35) 모두 있음 | **아니오** |
| ② 전 범위 × 누름·스토퍼 자세 간섭 0 | 재지 않음(①에서 갈림). 참고: v2.14.0 J_U4_X 0·47.5·95(REST) 과제 범위 겹침 0(mech_M02R_verify.md 41~43줄), v2.11.1 J 95 × 13.006·0·−4.11 기준선만(mech_RX-06_verify1.md) | — |
| ③ 고정부 손계산 | 잠금 부품 없음(볼나사 너트가 X를 받고 있음) | 아니오 |
| ④ RX-08 U4 쪽 관 따라감 | 지금 그대로(강체 U4_WHEEL_N) | 유지 대상 |
| ⑤ 레일 실물 STEP · 기준선 0 | 레일 = 그린 상자, 겹침 178.87 · 178.99 · 178.87 · 178.99 mm³ | **아니오** |
| ⑥ machine.json · BOM | J_U4_XSCREW·U4_XAXIS·U4_XCAR 항목과 BOM 6행(BSS2020-1100·BSW20·BUN20·HDLC-D50·SPACER_F·S)이 그대로 | 아니오 |

**already_ok = false.**

## 10. 파일 (`tools/out/mech_RX-06R/`)

| 파일 | 내용 |
|---|---|
| `parts_table.csv` | 구상용 표: 영역 109바디 bbox·부피·질량·재질·유닛, J_U4_X 기준 분류(remove 15 · moving 43 · fixed 51) |
| `probes_v2140.json` | 기준선 겹침·프로브 14개 결과(겹침 mm³, 못 잰 쌍) |
| `space_bbox.py` · `space_bbox.json` | 서명 bbox로 본 후보 자리·J_U4_X 쓸림(보수적, 관 bbox는 크게 나옴) |
| `tube_paths.json` | 관 9줄 중심선(스케치 wire) |
| `sseb13_step_parse.json` | 레일 STEP 원통면(구멍·탭) 자리·범위 |
| `xcar_group.json` | J_U4_X로 같이 움직이는 occurrence 77개 |
| `joint_list.json` · `inspect_design.json` · `against_names.json` | 원본(조인트 587·링크 36, 타임라인 3,717) |

## 워크플로우 메모

- 저장본 `.sc`는 zip이고 안의 `document.json`에 occurrence·component·feature·조인트·스케치가 다 있다. 구조(누가 누구에 강체인지, 어느 피처가 어느 바디를 만들었는지, 관 중심선)는 CAD 호출 없이 여기서 읽는 편이 빨랐다(앱의 `joint.list`·`inspect_design`은 0.5~1.3 MB를 돌려준다). 측정부 절차에 '구조는 저장본 document.json에서' 한 줄이 있으면 좋겠다.
- 상자 프로브 14개 × 영역 109바디 `inspect.clearance`가 559.5 s였다(대부분 긴 관 바디와의 불리언, 관 쌍 9개는 "boolean Intersect … no result"로 못 잼). 관은 중심선(스케치)으로 보고 프로브 against에서 빼면 수십 초일 것이다.
- `motion.play`·`joint.list`·`inspect_design` 응답이 1 MB 안팎이라 MCP 결과가 파일로만 온다. 요약만 돌려주는 인자(quiet 같은 것)가 있으면 읽기 부서가 가벼워진다.
- 과제 폴더에 다른 부서 파일(`catalog.md`)이 측정 중에 생겼다 — 건드리지 않았다.
