hyeunung/FSAP/docs/reports/mechanism/mech_RX-06R_verify1.md

# RX-06R 검도·체결 보고 — 수정 1회차 (검도·체결부, 2026-11-13)

요약(10줄 안):
- **판정: 합격(동작 문제 0).** 대상 `3D_Modeling/FSAP_v2.15.0.sc`(읽기만, 저장 안 함). 지난 미완 "24자세 가운데 14자세 못 봄"은 없어졌다 — 원본 결과 파일 5개를 다시 읽어 23자세(+ 앱 1자세)가 모두 쌍 27 · unchecked 0 · truncated false · 새 겹침 0임을 확인.
- 검도가 따로 잰 것(저장본 CLI 1번 + 앱 MCP 읽기): J_U4_X 95 × (PRESS −4.11 · STOP 20, PRESS 13.006 · STOP 0)에서 대상 11바디 × 이웃 **88바디**(모델링부 81 + 긴 고정 관 7줄) 겹침 **0**, 쌍 50(가지치기 918), unchecked 0, truncated false.
- 완료 판정 ⑤: 레일 2 × 블록 4 `inspect.interference` 겹침 **0**(4쌍 불리언, 앱·저장본 둘 다). ④: RX-08 U4 쪽 관 2줄은 캐리지 쪽 강체 묶음(74 occurrence) 안, 끝 자세 겹침 0. ①: 바디·조인트·링크·빈 컴포넌트 잔재 0.
- 모델 전체 3,188부품 bbox 쓸림 검사(J_U4_X 0~95, J_U5_X 0~1380): 모델링부 목록 밖 부품 가운데 가장 가까운 것은 X로 44.4 mm, U5 대차 쪽은 110 mm — 목록 빠짐 없음.
- 볼트 6개 M-01 합격(물림 2.06d · 1.6d, 렌치 길 프로브 겹침 0, 빈 구멍 0), 리지드 누락 0 · floating 0, 판금 M-04 10항목 합격, 손계산 재현(잠금 SF 8.81 / 3.25, 볼트 ok true).
- 디테일 4건(기록만): 고정 관 U4_A2 · U4_B가 J 1~39에서 캐리지 발 자리와 겹치는 강체 모형(RX-06 디테일 7 그대로), 날 뿌리 굽힘 SF 2.49(틈 공차 끝), 조임 토크 지정, 레일 +X 끝 10 돌출.
- 원장 `ledger.py commit` 함(부품 3,188), 판정 기억 7건 추가(216 → 223). 등급 M 맞음. 규칙 예외 요청 없음.
- 완료 판정 ⑥의 BOM · 결정로그는 문서 담당 단계 몫으로 아직 안 고쳐짐(machine.json은 고쳐져 있음).

## 0. 범위 (E-17 "측정은 바뀐 만큼만 다시 잰다")

`ledger.py scope --joints-changed`: 전체 검사 예(조인트·행정·배치가 바뀜 / 이동 유닛 부품이 바뀜: U4_XCAR / 여러 유닛에 걸친 변경: U4_XAXIS · U4_XCAR), 바뀜 1 · 새로 10 · 없어짐 17 · 이웃 29, 유닛 U4_XAXIS · U4_XCAR, 근처 유닛 U1_FRAME · U4_WHEEL_N · U8_PNEU.

| 묶음 | 내용 |
|---|---|
| 대상 A(11) | `P_RX06_CARRIAGE`, `P_RX06R_LOCK_BLADE_판금`, `P_RX06R_LOCK_CLAMP_레이저`, `CB5-16_RX06R_LOCK_1·_2`, `CB5-12_RX06R_BLADE_1~4`, `SSEB13-220_RX06_RAIL` ×2 |
| 이웃 B(81) | 모델링부 `tools/out/mech_RX-06R/model/check_lists.json` 그대로(블록 4, 멈춤 2, U5 아이들러 묶음, U5 레일, 관 클램프 3과 볼트, `P_M02_BASE`, 발 볼트, U4_WHEEL_N 묶음, RX-08 U4 쪽 관 2, 헤드 임시 상자) |
| 검도가 더한 것(7) | scope 이웃인데 B에 없던 긴 고정 관 `TU0604_M08P_RX08_A · RX08_B · U4_A2 · U4_B · U5_A2 · U5_B · U6` |
| 뺀 것 | `P_M07_BEAM` — 고정끼리(날 · 날 볼트 · 레일 ↔ 보)는 조인트와 무관하고 모델링부가 한 번 쟀다(겹침 0, 705.9 s, unchecked 4 = 날 볼트 나사 물림). 움직이는 A는 Y ≤ 107(잠금 볼트 끝 105.3)이라 보 앞면 Y 120과 12.7 이상 떨어진다 |

작업 대상 모형(매트 · 테이프): A의 가장 낮은 Z가 250(캐리지 밑면)이고 매트 길은 Z 0~약 26이라 닿지 않는다 — 넣지 않음.

## 1. 지난 문제가 없어졌나 — 24자세 (E-21 "이전 결과 파일부터 읽고 남은 것만")

모델링부 원본을 검도가 다시 읽어 자세 값 · 쌍 수 · truncated를 대조했다(요약 파일이 아니라 `*_out.json` 원본).

| 파일 | 자세 | A × B 결과 |
|---|---|---|
| `model/gridx_47_5_out.json` | J_U4_X 47.5 × PRESS 13.006 · 3.751 · 0 · −4.11 × STOP 0 · 20 = 8 | 8자세 모두 overlaps 0, 쌍 27(가지치기 864), unchecked 0, truncated false. 구동 응답 값 = 요청 값, errors 0 · conflicts 0 |
| `model/gridx_95_out.json` | J_U4_X 95 × 같은 8 | 같음(overlaps 0) |
| `model/grid1_out.json` · `grid2_out.json` | J_U4_X 0 × 7(PRESS 13.006 · STOP 20 ~ PRESS −4.11 · STOP 20) | 7자세 모두 overlaps 1 = `P_M02_BASE` ↔ `P_RX06_CARRIAGE` 0.027615 mm³(아래 판정), 쌍 27, unchecked 0, truncated false |
| 앱(모델링 보고 4절) | J_U4_X 0 × PRESS 13.006 · STOP 0 | 같은 0.0276 mm³ 하나 |
| `model1/gridx_q_out.json` | J_U4_X 23.75 · 71.25 × 양 끝 4자세 | overlaps 0, 쌍 27, truncated false |

- 지난 문제(14자세 못 봄): **없어짐.** 24자세 = 23(파일) + 1(앱), 새 겹침 0.
- PRESS · STOP을 바꾼 뒤 `pairs_reused 27`인 것은 가지치기 뒤 남은 27쌍에 PRESS · STOP으로 움직이는 바디가 없다는 뜻이다(그네 윗끝 Z 232.2 < A의 가장 낮은 Z 250, bbox가 안 닿아 가지치기됨).

## 2. 검도가 따로 잰 것

### 2-1. 저장본 CLI 한 번 (`tools/out/mech_RX-06R/verify1/v_x95.json` → `v_x95_out.json`, 저장 안 함)

통로를 CLI로 한 이유: `joint.drive J_U4_X`가 한 번에 466 s(앱은 10~13분, MCP 호출 300 s 상한) — 프로젝트 규칙 2 "오래 걸리는 … 앱(MCP)에서 돌리지 않는다". 열기 약 791 s + 스크립트 704.9 s.

| 단계 | 자세 | 명령 | 결과 |
|---|---|---|---|
| 0 | REST | `inspect.interference` 레일 2 + 블록 4 | count **0**, 후보 4쌍 모두 불리언(pairs_intersected 4), not_checked 0, truncated false |
| 1 | REST | `inspect.clearance` A × 긴 고정 관 7 (clearance 0) | overlaps **0**, 쌍 29(가지치기 48), unchecked 0, truncated false, 187.2 s |
| 5 | J_U4_X 95 · PRESS −4.11 · STOP 20 | A × (B + 관 7 = 88) (clearance 0.3) | overlaps **0**, 쌍 50(가지치기 918 = 968 − 50), unchecked 0, truncated false. 0.3 안 = 맞닿음 0.0뿐(블록 ↔ 레일 · 캐리지, 멈춤 ↔ 레일, 발 볼트 · `CB5-12_M02S_BASE_7·_8` 끝(M02R-D6) · `CB5-16_RX08_TOP` ↔ 캐리지, `P_M02_BASE` ↔ 캐리지) |
| 6 | 같은 자세 | A × A (clearance 0) | overlaps **0**, 쌍 13, unchecked 2 = 캐리지 ↔ 잠금 볼트 2(나사 물림), truncated false |
| 9 | J_U4_X 95 · PRESS 13.006 · STOP 0 | A × 88 (clearance 0) | overlaps **0**, 쌍 50, unchecked 0, truncated false |
| 10 | — | `joint.list` | 조인트 584 · 링크 35 · floating **0** · errors 0 · conflicts 0, `J_U4_XSCREW` 없음 |

구동 확인: `joint.drive` 응답 J_U4_X 95.0 · PRESS −4.11 → 13.006 · STOP 20 → 0, 모두 moved true, errors 0 · conflicts 0(E-15 "움직임은 … 조인트로만").

### 2-2. 앱(MCP) 읽기 — REST, 구동 · 편집 · 저장 없음

`running` 빈 목록 → `document.metadata`(설명 "RX-06R mechanism: …" = v2.15.0 문서) · `joint.inspect J_U4_X`(값 0, 한계 0~95, links 빈 목록, errors 0).

| 잰 것 | 결과 |
|---|---|
| 레일 2 × 블록 4 `inspect.interference` | count **0**, 4쌍 불리언, truncated false, 2.6 s |
| 새 부품끼리 틈(`inspect.clearance` 0.75) | 날 ↔ 누름 판 **0.20**, 날 ↔ 잠금 볼트 **0.25**(긴 구멍 5.5 ↔ Ø5), 날 ↔ 캐리지 웹 **0.50**, 날 ↔ 날 볼트 · 누름 판 ↔ 잠금 볼트 0.0(머리 좌면). overlaps 0, unchecked 2(캐리지 ↔ 잠금 볼트 나사 물림) — 모델링부 값과 같음 |
| A(날 · 누름 판 · 잠금 볼트 2 · 날 볼트 1 · 4 · 캐리지) × 긴 고정 관 7, clearance 12 | overlaps **0**, 쌍 23, unchecked 0, truncated false, 204.7 s. 12 안: 캐리지 ↔ `U4_B` **0.89**, ↔ `U4_A2` **1.01**(발 장공 X −165~−157 안의 세움 관), ↔ `RX08_A` 3.93, ↔ `U6` 10.0. **새 부품(날 · 누름 판 · 볼트)은 12 안에 관 없음** |

### 2-3. 모델 전체 bbox 쓸림 검사 (CAD 없이 `out/signatures.json` 3,188부품, E-19·안내서 '간섭' "bbox가 닿는 바디만")

- 방법: A의 bbox를 J_U4_X 0~95로 늘리고(움직이는 A만), U5_CAR · U5_LIFT · U5_FLOAT · U5_WHEEL 부품은 J_U5_X 0~1380으로 늘려, Y · Z가 겹치는 모든 부품과의 X 틈을 셈.
- 결과: Y · Z가 겹치는 쌍 454 가운데 모델링부 목록(A · B · 관 7 · 보) **밖** 부품의 가장 작은 X 틈은 **44.4 mm**(`TU0604_M08P_U7_6_A` ↔ 위 레일) — bbox가 닿는 목록 밖 부품 0.
- 이웃 유닛 조인트(지시 2): U5 대차 묶음이 J_U5_X 1380(d₂ 420)까지 와도 A와 X 틈 **110 mm**(`P_M03_CAR_PLATE` 끝 X −445 ↔ 캐리지 J 95의 X −335). 사슬 팔 `P_M03_CHAIN_ARM`은 X −530까지 → 날(X −335)과 195. J_U5_LIFT · J_U5_FLOAT는 Z 운동이라 X 틈이 그대로다. J_U6_SHIFT · J_U7_HGT · 헤드 쪽은 Y · Z가 겹치는 부품이 없거나 X로 122 이상(`P_M01_HANGER`).

## 3. 완료 판정 대조

| # | 항목 | 판정 | 근거 |
|---|---|---|---|
| ① | 걷어 낸 부품 잔재 0 | **만족** | 저장본 바디 이름 879개 · 서명 3,188개에 BSS2020 · BSW20 · BUN20 · HANDLE · RX06_SPACER · SSEB13-570_RX06_RAIL 0. `CB6-20_M03_CAR`는 U5_CAR의 4개만(:5~:8 없음). 저장본 `joint.list`(검도 CLI): `J_U4_XSCREW` 없음, 링크 35(36 − 1), `J_U4_X`의 links 빈 목록. 빈 컴포넌트 20개는 모두 작업 전부터 있던 것(U7_TAPE · WP_* 8 · CB5-12_M02_1(M02R-D9) · STEP 하위 노드 8 · U7_CST_STAGE · SS5Y3-20-06_M08), RX-06 것 0 — 이 목록은 모델링부 `component_list_after.json`(걷어 낸 뒤 · 저장 전)에서 읽었고, 저장본 쪽은 바디 · occurrence · 조인트 이름으로 확인함 |
| ② | J_U4_X 0 · 47.5 · 95 × PRESS 4 × STOP 2 과제 범위 간섭 0 | **만족** | 1절 24자세 + 2-1절 검도 2자세(이웃 88로 넓힘). 새 겹침 0, truncated false. J_U4_X 0의 0.0276 mm³는 기준선(4절) |
| ③ | 고정부가 누름 반력 · 바퀴 구동 반력을 받음, SF ≥ 기준 | **만족** | 5절 |
| ④ | RX-08 U4 쪽 관이 J_U4_X를 따라감, 끝 자세 겹침 0 | **만족** | 저장본 조인트 그래프(J_U4_X를 끊고 U4_XCAR:1에서 이어진 것) 74 occurrence 안에 `TU0604_M08P_RX08_A_U4`(98190) · `_B_U4`(98198). J 95 두 자세에서 A × 88 겹침 0(관 2줄은 B에 있음) |
| ⑤ | 레일이 실물 STEP 바디, 레일 ↔ 블록 겹침 0 | **만족** | `SSEB13-220_RX06_RAIL` ×2 각 17,180.227 mm³(상자 220 × 7.5 × 12 = 19,800이 아님 — 구멍 9개 · 모따기 있는 STEP 형상, 면 53), 겹침 0(앱 · 저장본) |
| ⑥ | machine.json 조인트 · BOM 고침, 근거를 결정로그에 | machine.json **만족**, BOM · 결정로그는 **문서 담당 단계** | `machine.json`: `J_U4_XSCREW` 없음(이력 줄에만 남음), `J_U4_X` 메모 · 기준선 1줄 · `_history` 있음. BOM · 설계검토서 · 결정로그 · 자료대기(E5 · D-190 · D-191 소멸)는 모델링 보고 8절 수치로 문서 담당이 쓴다 |

## 4. 겹침 판정 (M-08 "정상 겹침: 볼트 나사부의 탭 물림 …")

| 쌍 | 값 | 판정 | 판정 기억 키 |
|---|---|---|---|
| `P_M02_BASE` ↔ `P_RX06_CARRIAGE` | 0.0276 mm³(넓이 103 mm², 두께 0.0005 mm), J_U4_X 0에서만. J 95에서는 거리 0.0 | 허용 — 맞닿는 면의 수치 잔차. v2.14.0 저장본에도 0.027612 mm³로 같고(`model/base_sliver_out.json`) 이번에 안 건드린 자리 | c6abcde9b2e5c1982d9f |
| `P_RX06_CARRIAGE` ↔ `CB5-16_RX06R_LOCK_1·_2` | unchecked(boolean no result). 손셈 π(2.5² − 2.1²) × 10.3 = 59.5 mm³ | 허용 — 나사 물림, 같은 강체 묶음 | a82e30df…, e553bdc6… |
| `P_M07_BEAM` ↔ `CB5-12_RX06R_BLADE_1~4` | unchecked(boolean no result). π(2.5² − 2.1²) × 8 = 46.2 mm³ | 허용 — 나사 물림, 둘 다 고정 | e9207d81…, 473144fc…, 6921814b…, 9c6f8b84… |

`paircache.py judge` 7건(216 → 223). `machine.json` 기준선에는 나사 물림 줄이 이미 있다.

## 5. 체결 · 강도 (지시 3, 완료 판정 ③)

### 볼트 6개 (M-01 "머리 쪽 축 방향으로 볼트 길이 + 5 mm 동안 다른 부품과 겹침 0 … 물림 ≥ 1.5d")

| 항목 | CB5-16 잠금 ×2 | CB5-12 날 고정 ×4 |
|---|---|---|
| 자리 · 방향 | (X −225 · −140, Z 468), +Y로 박음. 머리 Y 84.3~89.3 | (X −315 · −255 · −195 · −135, Z 562), +Y. 머리 Y 113~118 |
| 쌓임 | 누름 판 t3(89.3~92.3) → 틈 0.2 → 날 t2(92.5~94.5) → 틈 0.5 → 웹 탭 t12(95~107) | 날 t2(118~120) → 보 앞벽 탭 t8(120~128), 끝 Y 130 |
| 물림 | 105.3 − 95 = **10.3 = 2.06d** | 128 − 120 = **8 = 1.6d** |
| 삽입 · 렌치 길 | 프로브 Ø8.5 × 30(−Y) + J 0~95 쓸림 상자: 겹침 0(모델링부 저장본 CLI, 96바디). 검도 bbox 검사: 30 · 100 mm 길 상자에 bbox가 닿는 것은 캐리지 · 관 U5_B · U4_A2뿐이고 셋 다 그 96바디 안 | 프로브 겹침 0. 100 mm 길 상자에 닿는 bbox는 관 U5_B · U5_A2 · 날뿐(96바디 안). 캐리지 윗끝 Z 482 < 볼트 Z 557.75라 J_U4_X 어디서도 캐리지가 안 가림 |
| 상대 탭 | 캐리지 웹 Ø4.2 ×2(원통 면 8) | 보 앞벽 Ø4.2 ×4(보 −440.0 mm³, 원통 면 +4) |
| 빈 구멍 · 중복 | 긴 구멍 1 + 통과 2 + 탭 2에 볼트 2 | 통과 4 + 탭 4에 볼트 4. 빈 구멍 0 · 중복 0 |
| 긴 구멍 끝 여유 | 구멍 X −324.25~−135.75(전개 13.5~196.5 ± 2.75), 볼트 겉 J 0 −137.5 · J 95 −322.5 → 양 끝 1.75 | — |
| 손계산(`handcalc.py` 검도 재실행) | 3 N·m: 예압 3,000 N, 볼트 응력 SF 4.69 · 좌면 2.31 · 암나사 전단 2.37, ok true, near_limit 없음 | 4 N·m: 예압 4,000 N, 볼트 응력 3.51 · 좌면 4.04 · 암나사 전단 1.73, ok true |

- 리지드(E-11 · M-07 "볼트는 자기가 물린 부품과 같은 리지드 그룹"): 잠금 볼트 98273 · 98274 = U4_XCAR:1(캐리지 쪽 74 안), 날 볼트 98275~98278 = U4_XAXIS:1(고정 쪽 511). floating 0. 누름 판은 U4_XCAR 바디, 날은 U4_XAXIS 바디.
- 공압 포트(M-06): 새 포트 없음. 새 LITE 간이 형상 없음.

### 잠금 · 날 (M-09 "필요 SF: 일반 3, 오조작 하중 2")

| 항목 | 값 | 기준 | 판정 |
|---|---|---|---|
| 잠금 유지력 | 면 2 × μ 0.15 × 2개 × 3,000 = 1,800 N(날을 웹에 붙이는 힘 최대 155.9 N을 빼도 1,777 N) | — | — |
| 스토퍼 받침 반력 204.3 N을 통째로 X로 본 경우 | SF 8.81(8.70) | 3 | 합격 |
| 오조작 553.1 N을 X로 | SF 3.25(3.21) | 2 | 합격 |
| 바퀴 축 방향 마찰 28.6 N(운전) · 손 100 N | SF 62.9 · 18.0 | 3 · 2 | 합격(과사양 메모는 설계 4절 — M5 아래로 못 내림) |
| 바퀴 구동 반력 18 N(Y) · 누름 반력(Y · Z) | 레일 블록이 받음. 블록 SF 5.15(운전) · 3.40(오조작), C0 임시 2 kN | 3 · 2 | 합격 |
| 날 고정 볼트 미끄럼 | 600 N/개 ÷ 138.3 N/개 = SF 4.34 | 3 | 합격 |
| 날 뿌리 굽힘(강제 변위) | 3Etδ/(2L²) = 3 × 193,000 × 2 × 0.5 / (2 × 75²) = 51.5 MPa → SF 3.98. 틈 0.8(공차 끝)이면 82.3 MPa → **SF 2.49** | 3 | 기준 틈에서 합격, 공차 끝은 디테일 D2 |

- 해석: 못 함 — 환경 없음(자료대기 D-16). 날은 두께/길이 2/75 = 0.027 < 0.1(E-18 "얇은 판 … 보 공식을 먼저 본다").

## 6. 판금 (M-04, `model/blade_flat_pattern.json` — t 2, R 2, K 0.44)

| 항목(M-04 표) | 값 | 합격 기준 | 판정 |
|---|---|---|---|
| 판금으로 그림 | `sheet.flange` contour, 전개 142.55 × 213, 굽힘 2 | 전개됨 | 합격 |
| 두께 | 2.0 일정 | 같음 | 합격 |
| 굽힘 R · 각 | R 2, 90° ×2(위 · 아래 반대 방향 Z자) | R ≥ t, 90° 이하 | 합격 |
| 최소 플랜지 | 위 날개 30.0, 아래 다리 84.0 | ≥ 4t = 8 | 합격 |
| 굽힘 사이 | 54.02 − 34.52 = 19.5 | ≥ 4t = 8 | 합격 |
| 릴리프 | 굽힘 2줄 모두 판 끝에서 끝까지(213) | 판 안에서 끝날 때만 필요 | 해당 없음 |
| 구멍–굽힘 | 원 4(중심 15, r 2.75): 겉 17.75 ↔ 굽힘 띠 30 = 12.25. 긴 구멍 128.8 ↔ 굽힘 띠 58.55 = 70.25 | ≥ 2t + R = 6 | 합격 |
| 구멍 크기 · 판 끝 · 사이 | Ø5.5 · 폭 5.5. 판 끝까지 원 12.25 · 10.25, 긴 구멍 8.25 · 10.75. 원 사이 60 | ≥ t, ≥ 1.5t = 3, ≥ 2t = 4 | 합격 |
| 탭 | 판에 탭 없음(상대 탭 = 보 · 캐리지) | — | 합격 |
| 크기 | 142.55 × 213 | 요구서 2-1 판 크기 미정 — 어느 판에도 들어감 | 합격 |
| 정밀 | 날–웹 틈 0.5는 굽힘 2개를 건넌 치수(±0.3) | 굽힘 너머에 정밀을 맡기지 않는다 | 날이 0.5~0.8 휘어 붙는 설계라 기능은 성립, 심 맞춤은 디테일 D2 |

누름 판 `P_RX06R_LOCK_CLAMP_레이저`는 평판 t3 110 × 20, 구멍 Ø5.5 ×2 — 굽힘 없음.

## 7. 문제 목록

동작 문제: **0**.

| kind | 무엇 | 어디 | 수치 | 고치는 방법 | 외부 |
|---|---|---|---|---|---|
| 디테일 D1 | 고정 관 `TU0604_M08P_U4_A2` · `_U4_B` 세움(X −161)이 J_U4_X를 안 따라가는 강체 모형 — J ≈ 1~39에서 캐리지 발 · `P_M02_BASE` 살이 관 자리를 지남(RX-06 디테일 7 · RX-08-M5 그대로, 과제 지시 "U4_A2·U4_B·U6 관은 건드리지 않는다") | 발 장공 X −165~−157 · Y 70~79 · Z 208~425 | REST 틈 0.89 · 1.01 mm(검도 실측). J 0 · 47.5 · 95에서 겹침 0, J 1~39는 bbox 계산(측정 보고 149줄) | 디테일링에서 세움 구간을 U4 쪽 관(캐리지 강체, RX-08 A_U4 · B_U4와 같은 방식)과 U8 쪽 관으로 나누고 이음 사이 여유 고리 ≥ 95 + R15 × 2 ≈ 150 mm | 아니오 |
| 디테일 D2 | 날 뿌리 굽힘 SF가 틈 공차 끝(0.8)에서 2.49 < 3. 틈 0.5는 굽힘 너머 치수(±0.3) | `P_RX06R_LOCK_BLADE_판금` 선반 굽힘(Y 94.5~120, Z 543) | 51.5 MPa(틈 0.5, SF 3.98) · 82.3 MPa(0.8, SF 2.49), 항복 205 | 날 고정 볼트 자리에 심 0.1 · 0.2로 틈 ≤ 0.65(SF ≥ 3.06)에 맞추거나 다리 길이 75 → 82(0.8에서 68.9 MPa, SF 2.98 ≈ 3) | 아니오 |
| 디테일 D3 | 조임 토크가 도면 · 설계검토서에 지정돼야 손계산이 성립(잠금 3 N·m, 날 고정 4 N·m). 날 고정 볼트 조임 암나사 전단 SF 1.73 | `CB5-16_RX06R_LOCK_1·_2`, `CB5-12_RX06R_BLADE_1~4` | handcalc ok true, 잠금은 1.02 N·m 이상이면 운전 SF 3 | 설계검토서 조임 표에 3 · 4 N·m, 날 고정은 3 N·m으로 낮추면 암나사 전단 SF 2.31 · 미끄럼 SF 3.25 | 아니오 |
| 디테일 D4 | 레일 +X 끝이 끝 멈춤 `P_RX06_STOP_B`(X −127~−125) 밖으로 10 나옴(레일 X −115) | `SSEB13-220_RX06_RAIL` ×2 +X 끝 | 구멍 9 피치 25 끝 10을 살리려 220으로 자름 | 그대로 두거나(겹침 0) 멈춤을 X −117~−115로 옮김. RX-06-D1(레일 · 블록 볼트) · D4(끝 멈춤 고정)와 같이 디테일링 | 아니오 |

## 8. 등급 · 예외 · 원복

- 등급 M: 맞음. 새 구매품 0(볼트 6은 보유 STEP), 조인트는 `J_U4_XSCREW` 하나 없어짐, 새 구동 유닛 · 새 연구 없음(E-18).
- 규칙 예외 요청: 없음(E-14).
- 원복(E-08): 앱에는 읽기 명령만 보냈다(`running` · `document.metadata` · `joint.inspect` · `inspect.interference` · `inspect.clearance`). 구동 · 편집 · 저장 0 — J_U4_X 0 그대로. CLI는 저장본을 읽기만 했다(`--save` 없음).
- 원장: `ledger.py commit --date 2026-11-13` → 부품 3,188, 문서 v2.15.0.

## 9. 시간 (E-23)

| 항목 | 값 |
|---|---|
| 통로 | MCP + CLI(긴 구동 자세만 CLI) |
| CAD 호출 | MCP 5(`running` 2 · `list_commands` 1 · `batch` 2), CLI 1. 걸린 시간 약 29분(어림 30분) |
| 파일 열기 | 1(CLI). 앱은 이미 열린 v2.15.0을 그대로 읽음 |
| 가장 긴 열기 | 약 791 s(10:44:25 → 11:09:21 = 1,496 s − 스크립트 704.9 s) — 상한 240 s 초과(E-04 '모델 무게', LITE는 두 번 했으므로 다시 넣지 않음) |
| 앱 막힘 · 재시작 | 없음 |

## 워크플로우 메모

1. 모델링부의 이웃 목록이 scope `neighbors`보다 좁았다(긴 고정 관 7줄 빠짐 — 이유는 적혀 있었으나 중심선 어림). 검도가 bbox 쓸림 검사로 목록 빠짐을 CAD 없이 확인했다(3,188부품 1초). `ledger.py scope`가 조인트 행정으로 늘린 bbox 기준 이웃을 내주면 부서마다 목록을 따로 만들지 않아도 된다.
2. 긴 관(스윕 바디)이 against에 들면 `inspect.clearance`가 23~29쌍에 187~205 s다. 관은 중심선 + 반지름으로 틈을 셈하는 도구가 있으면 빠르다.
3. `component.list`는 compact로도 MCP 응답이 커서 검도가 앱에서 빈 컴포넌트를 직접 읽지 못했다(저장본 쪽은 바디 · occurrence · 조인트 이름으로 대신 확인). 빈 컴포넌트만 돌려주는 선택 인자가 있으면 좋다.
