hyeunung/FSAP/docs/reports/mechanism/mech_RX-08_measure.md

# RX-08 측정 — U4 중간 높이 스토퍼 실린더 자리 재기 (측정부, 2026-11-12)

요약(10줄 안):
- 대상 `3D_Modeling/FSAP_v2.11.1.sc`(config.json doc, 커밋 9f9a013). 앱(PID 38080)에 이미 열려 있었다: 이름 FSAP_v2.11.1, 경로가 config doc와 같고 **dirty false**, 타임라인 3,681. 다시 열지 않고 그 세션에서 MCP로 쟀다. 저장 0. 프로브 상자 19개는 `edit.checkpoint 77` → `restore_checkpoint`로 지웠다(복원 뒤 3,166바디·PRB 0개). 조인트는 한 번도 움직이지 않았다(REST 그대로, 트레드 Z 38.80~158.80).
- 서명: sigcheck `full`(v2.11.0 서명) → MCP `measure {}` 한 번으로 3,166바디 전수 → `signatures.json` 다시 씀 + `sigpatch` → **reuse 3,166**. 새 바디 1개는 `Chamfer2`(아래 ⚠).
- **이미 됨? 아니오.** 스토퍼 실린더·멈춤 블록·관·밸브가 하나도 없다. 그네가 실린더 나옴 끝 J_U4_PRESS −4.11까지 그냥 내려간다(바퀴 밑 Z 1.58).
- **빈 자리(모든 그네 각 13.006·3.751·1.422·0·−4.11에서 겹침 0, 정확 clearance):** ① **PF 그네 윗판 밑** X −300~−180 · Y 62~103 · Z 90~128(그네까지 최소 7.81 = 피벗 보스. 윗판 밑면까지는 각에 따라 13~16), ② **PC 바퀴 위 +X 끝** X −140~−85 · Y 40~120 · Z 160~250(관 클램프 L_5 2.0, 레일 블록 2.5), ③ **PA 바퀴 +Y 옆** X −140~−85 · Y 62~120 · Z 40~160(θ ≥ 0이면 트레드와 2.0, **−4.11에서는 트레드 2,195 mm³** — 바퀴가 Y 64.7까지 옴).
- 닿을 면 후보: 그네 `P_M02S_SWING` 윗판 밑면(θ0 Z 141, Y 37~120, 평면 한 장 9,864 mm²). 누를 때 Y 62 점은 **1.01 mm/°**, 바퀴 밑은 **2.09 mm/°**로 내려간다(바퀴가 2.07배 더 움직임).
- 띄움 목표 각: 두께 10 매트 위 1·2·3 mm = θ **0.476·0.95·1.422°**(윗판 밑 Y 62에서 Z 141.48·141.96·142.44). 두께 6~16 전부 덮으려면 θ −1.44~4.21 — 한 행정 실린더로는 안 되고 **멈춤 높이 조절(볼트·심)이 필요**.
- 스토퍼 반력(바퀴 누름 N × 팔 / 스토퍼 팔): 설정 0.102 MPa에서 Y 62 받침 **99~109 N**, IR1000 상한 0.2 MPa에서 **143~153 N**, 공기 0이어도 무게로 53~63 N. 받침점이 피벗에 가까울수록 커진다(Y 103이면 0.2 MPa 489~523 N).
- ⚠ 과제 밖이지만 눈에 보이는 문제: **보이는 바디 `Chamfer2`(RX-06 레일 STEP 원본, X −335~**235**, Y 112.5~120, Z 260~272)가 그린 레일 위에 겹쳐 +X로 360 mm 더 나가 있고, 관 클램프 `P_M08_TUBE_CLAMP_L_5`와 **1,871.3 mm³** 겹친다.** 결정로그 RX-06-E4 Remove86 정리가 아직 안 된 흔적. 사용자가 앱에서 보는 '튀어나온 레일'이 이것일 수 있다.
- 미완: 회로(밸브 매니폴드 SS5Y3-20-07은 7스테이션 7밸브가 다 쓰여 빈 스테이션 0 → 스토퍼용 8번째가 없다), 실린더 형번 없음(D-163), 관 길.

## 0. 측정 표·통로·시간

| 항목 | 값 |
|---|---|
| sigcheck(처음) | `{"mode": "full", "reason": "다른 문서의 서명(…FSAP_v2.11.0.sc)"}` |
| 앱 상태 | `running` 빈 목록. 열린 문서 FSAP_v2.11.1, 경로 `…/3D_Modeling/FSAP_v2.11.1.sc`, dirty false, undo 200, 타임라인 3,681(마지막 Pipe118·BodyTransfer593 = RX-06 수정 1회차) |
| 서명 | `measure {}` 1회(3,166바디, 약 50 s) → `tools/out/mech_RX-08/build_sig.py`(RX-06 것과 같은 방법) → `ledger.py sigpatch` → sigcheck **reuse 3,166**. 바뀜 0·없어짐 0·새로 1(`Chamfer2`, unit UNKNOWN). bolts.json 1,208 그대로 |
| 통로 | MCP(그 시각 CAD 부서는 나 하나, 실행 규칙 2 "혼자 도는 읽기 부서도 MCP로 잰다"). 저장 0 |
| 각별 검사 방법 | 조인트를 움직이지 않았다(앱에서 J_U4_PRESS 구동 batch가 11분+ 걸린 기록, mech_RX-06_measure.md). 대신 **프로브를 반대로 돌렸다**: 그네 묶음은 피벗 (Y 120, Z 140) 축 X 둘레로 강체 회전하므로, 각 θ에서 고정 프로브와 그네의 겹침 = REST 그네와 (θ−13.006)만큼 +X 축으로 돌린 프로브의 겹침. `solid.move`(이동 −120·−140 → 회전 → 되돌림)로 돌린 프로브 12개를 만들고 `inspect.clearance`로 정확히 쟀다. 부호 확인: PRBR_F_T0 bbox Y 최소 52.24 = 손계산 52.24 |
| 원복(E-08) | `edit.checkpoint 77` → 프로브 19개·이동 피처 → `edit.restore_checkpoint 77`(restored true). 이름 목록 3,166바디·PRB 0. 조인트 구동 0이라 `motion.play REST 0`은 하지 않았다(처음과 같은 REST, 트레드 Z 38.80~158.80) |
| 근거 | E-17 원문 "측정 표는 서명을 다시 쓴다", E-16 "판정은 수치로만", E-04 "설계 파일은 부서마다 한 번 열고"(이미 열려 있어 0회) |

## 1. 과제에 걸린 부품·구동 요소 (v2.11.1, REST = J_U4_PRESS 13.006 들림, J_U4_X 0)

전체 표(137행, bbox·부피·질량·재질): `tools/out/mech_RX-08/parts_table.csv`.

### 1-1. 구동 요소 (machine.json)

| 조인트 | 종류 | 축·원점 | 범위·대기 | 비고 |
|---|---|---|---|---|
| J_U4_PRESS | 회전 | 축 [−1,0,0], (−240, 120, 140) | −4.11~13.006, 대기 13.006(들림) | + = 들림. 0 = 봉제(바퀴 밑 Z 10 = 두께 10 매트 윗면). 바퀴 밑 z = 140 + 138.924·sin(atan2(−70,−120) − θ) − 60 |
| J_U4S_ROD | 슬라이더(따라감) | (−240, 177.93, 223) [0,−1,0] | 0~25 | 보 고정 실린더 STEP대기_CDQ2YA20-25DMZ, 0 = 후퇴 = 들림 끝 스토퍼, 나옴 = 누름. J_U4_PRESS에 선형 링크 −1.4535 mm/° |
| J_U4_X | 슬라이더 | [−1,0,0] | 0~95(d₁ 100~195) | 셋업 축(수동). U4_WHEEL_N 묶음 전체가 −X로 움직임 → **스토퍼는 U4_WHEEL_N 안(고정부)에 달아야 같이 간다** |
| J_U4_WHEEL_ROT | 회전 | 바퀴 축 X | — | 형상 안 바뀜 |

### 1-2. 그네와 같이 도는 것(U4_PRESS·U4_WHEEL, 47바디) — REST bbox

| 부품 | 재질 | bbox X / Y / Z | 비고 |
|---|---|---|---|
| P_M02S_SWING | A5052 | −322~−160 / 28.3~141.8 / 110.1~232.2 | θ0: 세운 판 Y 37~45·Z 92~153, **윗판 Y 37~120·Z 141~153**, 보스 Ø26 축 (120,140), 텅 X −245~−235 |
| P_M02_ARM_SIDE_P / _N | SUS304 | −320~−120 / 10.8~37.3 · −55.5~−28.9 / 61~168 | |
| P_M02_FRONT | SUS304 | −132~−120 / −51.9~26.5 / 52.9~144.8 | |
| P_M02_WHEEL + _TREAD | A6061·우레탄 | −119~−87.5 / −72.7~47.3 / 38.8~158.8 | Ø120×25, θ0 중심 (Y 0, Z 70) |
| HG-KR23_M02 + PGX62 감속기 | 구매품 | −287.6~−125 / −49~24 / 57.7~135.4 | |
| STEP대기_AUT12-45_1·2_BOT | SUS304 | −301~−289 · −191~−179 / 50.7~68 / 170.3~201.9 | 스프링 아래 고리 |
| MPFZ12-10_M02_N·_P | 구매품 | −325~−315 · −167~−157 / 107.5~132.5 / 127.5~152.5 | 피벗 부시 |

### 1-3. 고정부(U4_WHEEL_N, J_U4_X와 같이 움직임)

| 부품 | 재질 | bbox X / Y / Z | 비고 |
|---|---|---|---|
| P_M02_BASE | SUS304 t8 | −330~−140 / −60~266 / 242~250 | 윗판, 캐리지 밑에 매달림 |
| P_M02S_PIVOT_BRKT_A / _B | SUS304 | −330~−300 · −180~−152 / 103~133 / 128~242 | 피벗 '벽'. 안쪽 면 X −300·−180 |
| STEP대기_PSFJ12-200 | S45C | −342~−142 / 114~126 / 134~146 | 피벗 축 Ø12. 길이 확인(WF-128): bbox 200, 부피 22,615.7 ÷ (π·6²) = 200.0 |
| STEP대기_PSCS12-10_1·_2 | S45C | −340~−330 · −152~−142 / 108~132 / 128~152 | 축 칼라 |
| P_M02S_SPRING_TAB_1·_2 + AUT12-45_TOP | SUS304 | −307~−283 · −197~−173 / 40~60 / 204~242 | 스프링 위 고리 |
| U4S_CYL: P_M02S_CYL_BRKT, STEP대기_CDQ2YA20-25DMZ | SUS304·Al | −265~−215 / 177.9~262 / 205~242 | 누름 실린더(보 쪽) |
| U4S_ROD: _ROD, Y-020B, _PIN | | −253~−227.5 / 121.9~205.9 / 213~233 | 링크로 따라감 |

### 1-4. 이웃(고정)

| 부품 | bbox X / Y / Z | 스토퍼 자리와의 관계 |
|---|---|---|
| STEP대기_867-392342_UPPER(헤드) | −80~500 / −90~90 / 125~560 | PA·PC +X 끝 X −85에서 5 |
| P_M08_TUBE_CLAMP_L_5 | −112~−88 / 102~120 / 252~284 | PC 위 2.0 |
| SSEB13-570_RX06_BLOCK ×2(Z 252.5~279.5) | −160.95~−127.05 / 107~117 | PC 위 2.5 |
| TU0604_M08P_U4_A2·U4_B·U6(관) | bbox가 커서 bbox로는 못 봄 → 정확 clearance로 PA·PC·PF 겹침 0 확인. PE(윗판 위 +Y)에는 A2 945.9 mm³ |
| U6 슈·센서 | Y ≤ −90 | 스토퍼 자리(Y > 37)와 떨어짐 |

### 1-5. 구상이 쓸 구매품 bbox·부피 (`parts_table.csv`에서)

| 형번 | 이름 | bbox 크기 X×Y×Z | 부피 mm³ | 상태 |
|---|---|---|---|---|
| CDQ2YA20-25DMZ | STEP대기_CDQ2YA20-25DMZ(+_ROD) | 36 × 44.5 × 36 | 54,467.9(+3,769.3) | 임시(D-188) |
| Y-020B | STEP대기_Y-020B(+_PIN) | 22 × 36 × 20 | 10,250.4 | 임시 |
| PSFJ12-200 | STEP대기_PSFJ12-200 | 200 × 12 × 12 | 22,615.7 | 임시 |
| AUT12-45 | STEP대기_AUT12-45_1·2_TOP/_BOT | 12 × 12 × 31 / 12 × 17.3 × 31.6 | 2,653.3 / 2,873.2 | 임시 |
| KQ2L06-M5A | KQ2L06-M5A_M02S_HEAD·_ROD | 21.7 × 10.4 × 18.5 | 1,290.5 | 실물 |
| SY3120-5LZD-M5 ×7 | U8 밸브 | 11.6 × 28.5 × 81.8 | — | 실물(스테이션 7개 다 씀) |
| SS5Y3-20-07 | STEP대기_SS5Y3-20-07_M08 | 92.5 × 20 × 49 | — | 임시(D-166), X 1035~1127.5 |

## 2. 비어 있는 공간(통로)

### 2-1. REST(13.006)에서 고정·그네 전부와 (정확 clearance, 틈 3 mm 안 보고)

| 프로브 | X / Y / Z | 겹침 | 가까운 것(틈 mm) |
|---|---|---|---|
| PA 바퀴 +Y 옆(M02R PRB5) | −140~−85 / 62~120 / 40~160 | **0** | PSCS12-10_2 2.0, PSFJ12-200 2.0 |
| PB 브래킷 B ~ 윗판 끝 | −152~−140 / 62~133 / 128~242 | PSFJ12-200 1,130.8 · PSCS12-10_2 3,392.7(축 끝이 이 칸을 지남) | BASE·BRKT_B 0(면 닿음) |
| PC 바퀴 위 +X 끝 | −140~−85 / 40~120 / 160~250 | **0** | 클램프 L_5 2.0, 레일 블록 2.5 |
| PD −X 끝(브래킷 A 바깥) | −356~−330 / 40~133 / 128~242 | PSFJ12-200 1,357.0 · PSCS12-10_1 3,392.7 | |
| PE 윗판 위 +Y | −300~−192 / 62~103 / 160~242 | 그네 10,617.6 · AUT12-45_1_BOT 646.6 · 관 U4_A2 945.9 | 관 U4_B는 불 연산 실패(unchecked) |
| PF 윗판 밑 +Y(브래킷 사이) | −300~−180 / 62~103 / 90~128 | **0** | 그네 보스 7.81 |
| PG 팔 옆판 P 바깥 | −320~−140 / 37.5~60 / 40~150 | 그네 세운 판 20,927.0 | 옆판 P 0.37 |

### 2-2. 그네 각마다(돌린 프로브, 그네 묶음 47바디와만)

| 프로브 | θ 13.006 | 3.751 | 1.422 | 0 | −4.11 |
|---|---|---|---|---|---|
| PA | 0 | 0(트레드 6.32) | 0 | 0(트레드 **2.00**) | **트레드 2,195.5 mm³** |
| PC | 0 | 0(그네 21.07) | 0 | 0(그네 21.19) | 0 |
| PF | 0(그네 7.81) | 0(7.81) | 0(7.81) | 0(7.81) | 0(7.81) |

PF 위 7.81은 피벗 보스(Ø26, 축에서 13)까지라 각과 무관하다. 윗판 밑면까지 높이는 3절 표.

U4S_ROD(링크로 따라가는 로드·너클)는 강체 회전이 아니라 이 검사에 넣지 않았다. REST에서 Y 121.9~205.9 · Z 213~233이라 PF·PA와 떨어져 있다.

### 2-3. 정리 — 스토퍼를 넣을 수 있는 길

1. **윗판 밑(PF) 받침**: 그네 윗판 밑면(θ0 Z 141)이 PF 바로 위에 있다. 이 칸에 멈춤 블록을 올리면 그네가 내려오다 블록에 얹힌다. 블록을 X로 밀어 넣고 빼는 가로 실린더가 피벗 브래킷 A·B 안쪽 면(X −300·−180, 다만 면은 Y 103~133뿐)이나 PB·PC로 내려온 걸이에 붙으면 사진(D-163 "벽에서 가로로 나와 매달린 묶음 옆을 향한다")과 맞는다. 스프링 사이 X −289~−191, Y 45~62도 윗판 밑에서 비어 있다(세운 판 Y ≤ 45.3) — 받침점을 Y 46까지 −Y로 옮기면 팔이 길어져 반력이 줄어든다(3절).
2. **바퀴 +X 쪽(PA+PC)**: X −140~−85에 걸이를 BASE +X 끝면(X −140)에서 내릴 수 있다. 헤드까지 5, 클램프 L_5까지 2. PA 하단은 θ −4.11에서 트레드가 Y 64.7까지 오므로 실린더·걸이는 Y ≥ 66.
3. PB·PD는 피벗 축 PSFJ12-200 끝·칼라가 지나간다. PE는 관 U4_A2와 그네가 있다. PG는 그네 세운 판 자리.

## 3. 그네 각·높이 표 (손계산 `tools/out/mech_RX-08/stop_calc.json`)

| θ (°) | 바퀴 밑 Z | 접지 Y | 윗판 밑 Z @Y 46 | @Y 62 | @Y 80 | @Y 103 | 뜻 |
|---|---|---|---|---|---|---|---|
| 13.006 | 38.80 | −12.67 | 157.63 | 154.03 | 149.98 | 144.80 | 대기·들림 |
| 4.211 | 19.00 | −4.82 | 146.43 | 145.26 | 143.93 | 142.25 | 두께 16 + 3 |
| 3.751 | 18.00 | −4.32 | 145.84 | 144.79 | 143.61 | 142.11 | 두께 16 + 2(THICK_16 상태) |
| 2.825 | 16.00 | −3.30 | 144.65 | 143.86 | 142.97 | 141.84 | 두께 16 닿음 |
| 1.422 | 13.00 | −1.70 | 142.84 | 142.44 | 141.99 | 141.42 | 두께 10 + 3 |
| 0.95 | 12.00 | −1.14 | 142.23 | 141.96 | 141.66 | 141.28 | 두께 10 + 2 |
| 0.476 | 11.00 | −0.58 | 141.61 | 141.48 | 141.33 | 141.14 | 두께 10 + 1 |
| 0 | 10.00 | 0 | 141.00 | 141.00 | 141.00 | 141.00 | 봉제(두께 10) |
| −0.96 | 8.00 | 1.19 | 139.76 | 140.03 | 140.33 | 140.72 | 두께 6 + 2 |
| −3.349 | 3.11 | 4.29 | 136.68 | 137.61 | 138.66 | 140.01 | 정비 내림 |
| −4.11 | 1.58 | 5.33 | 135.69 | 136.84 | 138.13 | 139.78 | 조인트 끝 |

(윗판 밑 좌표는 그 점의 Z. Y도 조금 움직인다 — Y 62 점은 θ 13.006에서 Y 63.71.)

- 민감도(θ0 근처): 바퀴 밑 **2.094 mm/°**, 윗판 밑 Y 46 1.292 · Y 62 **1.012** · Y 80 0.698 · Y 103 0.297 mm/°. 스토퍼 높이 0.5 mm 오차는 Y 62 받침에서 바퀴 1.03 mm, Y 103 받침에서 3.5 mm가 된다.
- 띄움 목표 각(매트 두께 D-04 6~16 임시): 두께 6 + 1~3 = θ −1.443~−0.479, 두께 10 + 1~3 = 0.476~1.422, 두께 16 + 1~3 = 3.289~4.211. 한 높이로는 6~16을 다 못 덮는다 → 멈춤 블록 높이 조절(조절 볼트·심, 범위 Y 62에서 Z 139.6~145.3 = 5.7 mm) 또는 두께별 셋업.
- 바퀴 기울기: 그네 축과 바퀴 축이 모두 X라 그네가 기울어도 **바퀴 면은 기울지 않는다(0°)**. 접지점만 Y로 옮겨 간다(띄움 각 0.476~4.211°에서 접지 Y −0.58~−4.82). 떠 있는 동안은 닿지 않으니 회전 SF·자국 영향 없음. 닿을 때(두께가 목표보다 두꺼운 매트)는 M02R 손계산의 dY 영향(두께 16 dY 4.32에서 rot_SF 1.079, mark_SF 1.013)과 같다.

## 4. 스토퍼 반력·실린더 힘 (손계산, `stop_calc.json`)

가정: 스토퍼가 받는 토크 = 바퀴가 받았을 수직 누름 N × 바퀴 접지 팔(피벗 Y 120 − 접지 Y). N = N_free + N_per_MPa·p(M02R 3회차 손계산 `tools/out/mech_M02R/model5/swing5.json`). 받침은 윗판 밑면 수직, 받침 팔 = 120 − Y. 마찰·관성 없음.

| 자세 · 압력 | N 바퀴(N) | T (N·m) | 받침 Y 46 | Y 62 | Y 80 | Y 103 |
|---|---|---|---|---|---|---|
| θ0(두께 10) · 0 MPa(무게만) | 25.8 | 3.10 | 41.8 | 53.4 | 77.4 | 182.1 |
| θ0 · 0.102(설정) | 48.0 | 5.76 | 77.8 | **99.2** | 143.9 | 338.6 |
| θ0 · 0.2(IR1000 상한) | 69.3 | 8.31 | 112.3 | **143.3** | 207.8 | 488.9 |
| 3.751(두께 16) · 0.102 | 50.9 | 6.33 | 85.6 | 109.2 | 158.4 | 372.6 |
| 3.751 · 0.2 | 71.5 | 8.89 | 120.1 | **153.3** | 222.2 | 522.9 |

실린더 추력(참고, 0.5 MPa 공급 = 요구서 0-6 / 0.4 MPa): Ø10 39.3/31.4 N, Ø12 56.5/45.2, Ø16 100.5/80.4, Ø20 157.1/125.7 N.

- 받침면이 실린더 축에 **수직**(실린더가 축 방향으로 받음)이면 '실린더 힘 ≥ 반력 × SF'가 그대로 걸린다: Y 62 받침·0.2 MPa 153 N × 1.5 = 230 N → 0.5 MPa에서 Ø25 이상. 0.102 MPa 설정(109 N × 1.5 = 164 N)이면 Ø20(157 N)도 모자란다.
- 받침이 실린더 축에 **나란한 면 위에 얹히는**(가로 로드 위로 그네가 내려앉는) 방식이면 축 힘은 0이고, 로드·안내가 옆 하중(위 표 값)을 받는다. 그때 실린더 힘은 짐을 진 채 빼고 넣을 마찰(μ·F)만 이기면 된다. 어느 쪽인지는 구상이 정한다.
- 압력을 낮춰 F4 ≤ 18 N(C-39, U4 혼자 회전)로 쓰는 것과 스토퍼로 띄우는 것은 다른 방법이다 — 스토퍼로 띄우면 바퀴 힘 0(이송력 없음).

## 5. 작업 대상

| 항목 | 값 | 출처 |
|---|---|---|
| 크기 범위 | 300×200 ~ 1500×1500(D-01). 모형 MAT_L·MAT_S·MAT_G(+V홈) 두께 10 | 요구서 0-2, machine.json temp_values |
| 두께 | 6~16 임시(D-04). 모형 10(테이블 Z 0, 윗면 Z 10) | |
| 바퀴가 닿는 자리 | 접지 Y 0(θ0), X −112.5~−87.5(J_U4_X 0) ~ −207.5~−182.5(J_U4_X 95) | |
| 스토퍼 자리와 매트 | PA 바닥 Z 40, PF 바닥 Z 90 — 매트 윗면 Z ≤ 16 + 테이프 1보다 24 이상 위 | |
| 사이클 단계(바퀴) | 대기·로딩·배출 13.006 / 봉제 0(·0.477) / 정비 −3.349 / THICK_6 −0.96 · THICK_16 3.751. 'U4 혼자' 구간: CYCLE_S 전부(J_U5_LIFT 30), CYCLE_G1 390·467, CYCLE_V 322 | machine.json states |
| 가공 뒤 형상 | TAPE_*(두께 1·날개 10), SEAM_* 겹침 30 | workpiece_stages |
| 떨어지는 조각 | 없음(절단은 바인더 앞 한 번, 실 끝은 헤드 사절) | machine.json fragments |

## 6. 관련 기각·주의 (같은 실수 막기)

| 근거 | 내용 | RX-08에 주는 뜻 |
|---|---|---|
| C-41(요구서 5절 M02R) | 모터 위 X축 누운 실린더 + 크랭크는 사진 오독으로 걷어 냄. 실린더는 고정부에 둔다 — "실린더가 고정부에 있으면 움직이는 질량이 줄고 관이 움직이지 않는다" | 스토퍼 실린더도 그네(U4_PRESS)가 아니라 고정부(U4_WHEEL_N)에. 관이 그네 각을 따라 휘지 않게 |
| D-163 / benchmark.md 4번·D-163 행 | 용도 추정 '중간~낮음' 신뢰, 후보 ① 든 자세 잠금 ② 중간 높이 스토퍼 ③ 슈 비킴 | 근거 사진 번호(benchmark 표 4번, 사용자 사진)를 보고서에 남긴다. 확인되면 고친다(C-42) |
| RX-06-F1(결정로그) | 루트에 만든 cut/join 피처가 J_U4_X 이동 때 제자리에 남아 조각이 됨 | 새 부품·구멍 피처는 **U4_WHEEL_N(또는 U4_PRESS) 컴포넌트를 활성화하고** 만든다 |
| M02-M2·M02R 3회차 | 닫힌 고리(pin_slot) 구동은 앱에서 안 끝남 → 선형 링크 | 스토퍼 로드도 연구 키 없이 따라가게 하면 고리 대신 링크 |
| M02R-E03 | 빈 컴포넌트를 '잔재 0'으로 치지 않음, 앱 component.delete 60분+ | 지울 것 만들지 않기 |
| U-07(E-10) | STEP 없으면 지어내지 말고 `STEP대기_<형번>` | 소형 실린더 STEP은 PartsLibrary → 미스미/SMC, 없으면 임시 |
| 실행 규칙 19 | 저장 전 조인트·스케치 숨김 | |
| C-39 | U4 혼자 회전 구간 바퀴 힘 F4 ≤ 18 N(제어 제약) | 스토퍼 띄움은 이 구간과 겹친다 — 띄울 구간을 요구서 동작 순서 제약에 적어야 함 |

## 7. 이미 되는가 (E-17 과제 안 판정)

| 완료 판정 항목 | 지금 | 판정 |
|---|---|---|
| 스토퍼 각도·바퀴 띄움 높이 근거 | 스토퍼 없음. 그네는 −4.11(바퀴 밑 1.58)까지 막힘 없이 내려감 | 안 됨 |
| 실린더 힘 ≥ 누름 반력 × SF | 실린더 없음(반력은 4절: 0.2 MPa에서 Y 62 받침 143~153 N) | 안 됨 |
| 과제 범위 간섭 0 | 자리(PA·PC·PF)는 비어 있음(겹침 0) — 넣을 부품 없음 | 해당 없음 |
| 회로 빈 포트 0 | 매니폴드 SS5Y3-20-07 7스테이션 = 밸브 SY3120 7개 다 씀. 스토퍼용 밸브·스테이션 없음 | 안 됨(8스테이션 또는 다른 공급 필요) |

**already_ok = false.**

## 8. 그 밖에 본 것

- ⚠ **`Chamfer2`(feature 97900, 보임 true)**: RX-06 레일 STEP(SSEB13-570) 원본 바디. bbox X −335~235 · Y 112.5~120 · Z 260~272, 부피 44,562.8 mm³. 그린 레일 `SSEB13-570_RX06_RAIL`(X −335~−125, 18,900 mm³)과 같은 자리에 겹쳐 있고(불 연산 실패로 겹침량 못 잼), +X로 360 mm 더 나가 헤드 앞(Y 112.5~120)을 지난다. **관 클램프 `P_M08_TUBE_CLAMP_L_5`와 겹침 1,871.3 mm³**, 볼트 CB5-16_M08_PY:28·:29와 틈 0.50, 끝 멈춤 STOP_B·블록·보와 닿음 0. 결정로그 RX-06-E4는 Remove86을 지우고 X −115에서 자르라고 했는데, v2.11.1에는 잘리지 않은 570 길이 바디가 보이는 채 남아 있다. RX-06 다음 회차(E4) 또는 PM 판단이 필요하다. 사용자 메시지 "이거 안보이냐고"가 무엇을 가리키는지는 지시문에 없어 확정하지 못했다 — 모델에서 눈에 띄는 이상은 이것뿐이었다.
- 바퀴 +Y 옆 PA는 M02R이 '스토퍼 자리'로 남긴 칸이지만, 그네 쪽에서 이 칸 근처로 오는 면은 트레드뿐이다(그네 20.0). PA에 실린더를 두면 닿을 면을 그네·팔에 새로 만들어야 한다.

## 9. 파일

- `tools/out/mech_RX-08/`: `measure_full_v2111.json`(전수), `build_sig.py`, `signatures_before.json`·`bolts_before.json`(되돌리기용), `region_parts_raw.txt`, `parts_table.csv`(구상용 bbox·부피 표), `against_names.json`, `rot_probe_cmds.json`(돌린 프로브 명령), `pose_probe.py`·`pose_probe.json`(bbox 보수 계산, 참고), `stop_calc.py`·`stop_calc.json`(각·높이·반력 손계산)
- 정확 clearance 결과는 이 보고서 2절 표가 원본(MCP 응답).

## 워크플로우 메모

- 측정부에서 각마다 조인트를 구동하지 않고 '프로브를 반대로 돌려' 강체 회전 묶음과 겹침을 재는 방법이 빨랐다(상자 19개 + 이동 9개 약 11 s, clearance 수십 ms~4분). 앱 조인트 구동(11분+) 대신 쓸 만하다 — 엔진 개선후보 감(회고가 `engine-candidates.md`에 판단).
- `measure {}` 전수는 약 50 s로 끝났고, 응답 2.7 MB는 파일로 받아 썼다.
