hyeunung/FSAP/docs/reports/mechanism/mech_RX-06_verify1.md

# RX-06 검도·체결 수정 1회차 — U4 X 위치 조절축 (검도·체결부, 2026-11-12)

요약(10줄 안):
- 대상: `3D_Modeling/FSAP_v2.11.1.sc`(커밋 9f9a013). 통로 MCP(앱, 저장본 `open` 1회). 저장 안 함.
- **합격(동작 문제 0).** 지난 문제 1(J95 조각)은 없어졌다. 앱 실측 J_U4_X 95: P_M02_BASE 382,575.42 mm³ · X −425~−235 · Z 242.0~250.0, ARM_SIDE_N 77,694.36 · X −415~−215, ARM_SIDE_P 77,685.37 · X −415~−215, ARM_TIE 24,816.02 · X −370~−350. 모두 REST와 부피가 같고 −95만큼 그대로 옮겨졌다.
- 지난 문제 2(자세별 간섭): 앱에서 4자세를 쟀다 — X0·들림, X95·들림, X95·내림 끝(−4.11), X95·θ0(매트 있음). 겹침은 기준선뿐이다: 그린 레일 ↔ 실물 블록 178.86 mm³ ×4(자세와 상관없이 같은 값, 판정 기억에 남김), 관 U6 ↔ 관 브래킷 0.028(기존), 내림 끝의 바퀴·센서 브래킷 ↔ 매트(그 자세는 '매트 없음', M02R 검도 36줄).
- CLI 9점(자세마다 한 호출, 9병렬, 상한 2,700 s)은 모두 시간 초과(rc 124)로 결과가 없다. 저장본 열기에 조인트 구동마다 10~15분이 붙는다.
- 정적 점검: 저장본 `document.json`에서, 4바디를 루트에서 고치는 피처 가운데 BodyTransfer 뒤에 오는 것은 Combine41 하나만 남았다(빈 cut, 무해). 다른 유닛에도 같은 꼴(움직이는 컴포넌트 바디를 루트 피처로 고침)이 있다: U5_CAR의 Combine43·44, U7_CASSETTE의 Cylinder351·352·Combine45 → 구동 후보로 올린다(5절).
- 완료 판정 4항목 모두 만족. 원장 commit 함. 등급 L 맞음.
- 남은 것(디테일): 레일 STEP 교체 E1, 축 저널 Ø15/Ø20 불일치 E2(D-191, 사용자 결정), U5 연동 d₂ ≥ d₁ + 240, X 47.5·X0 누름 자세는 CAD로 재지 않음(근거 2절), 관이 강체 모형이라 X95에서 끝이 피팅을 따라가지 않음(유연 거동, 7절 기록).

## 0. 근거 규칙

| 규칙 | 원문 | 이번 |
|---|---|---|
| E-03 | "합격은 동작·간섭" | J95 조각이 없어짐, 자세 4점에서 새 겹침 0 |
| E-17 | "과제 안 검사는 바뀐 바디·주변을 관련 조인트 몇 점에서만" | scope는 full(조인트가 바뀜). 대상은 J_U4_X로 움직이는 U4 바디 가운데 이웃 bbox에 닿는 69개, against는 그 쓸림 bbox(X −95, Y·Z ±20)에 닿는 고정 바디 64개(서명 bbox로 골랐다, `tools/out/mech_RX-06/model/fix1v/sel.json`) |
| E-16 | "판정은 수치로만" | 부피·bbox·겹침 부피 |
| E-04 / 실행 규칙 2 | 혼자 도는 읽기 부서는 MCP로 재고 저장은 금지 | MCP, save 안 함 |
| 안내서 '간섭' | "`against`에 모델 전체를 주지 않는다" | 고정 바디는 bbox로 고른 64개 |
| M-08 | 의도된 겹침은 기준선 | 레일 ↔ 블록 4쌍을 `paircache.py judge`로 남김 |

## 1. 지난 문제 1 — J95 조각 (해결)

| 바디 | REST(J0, 모델링부 실측) | J95 앱 실측 | 강체 이동 기대값 | 판정 |
|---|---|---|---|---|
| P_M02_BASE | 382,575.4 / X −330~−140 · Z 242~250 | **382,575.42 / X −425~−235 · Z 241.999~250.001** | X −425~−235, Z 242~250 | 맞음 |
| P_M02_ARM_SIDE_N | 77,694.36 / X −320~−120 | **77,694.36 / X −415~−215** | −415~−215 | 맞음 |
| P_M02_ARM_SIDE_P | 77,685 | **77,685.37 / X −415~−215** | −415~−215 | 맞음 |
| P_M02_ARM_TIE | 24,816.02 / X −275~−255 | **24,816.02 / X −370~−350** | −370~−350 | 맞음 |
| P_M02S_CYL_BRKT | 19,551 / −265~−215 | 19,551.06 / −360~−310 | 그대로 | 맞음 |
| P_RX06_CARRIAGE | 516,556 / −240~−125 | 516,556.34 / −335~−220 | 그대로 | 맞음 |

- 지난번 J95 값(BASE 451,786 mm³ · Z 50~250, 팔 X −155.4 끝)이 사라졌다. 부피가 REST와 같아서 붙은 조각이 없다.
- 정적 점검(`document.json`): 4바디를 participants·target으로 갖는 루트 피처 19개 가운데 18개는 BodyTransfer50·54·55·57 앞에 있다(루트에서 만든 뒤 옮김, 문제없음). 뒤에 오는 것은 Combine41(빈 cut, X −330~−320 · Z 233.9~238.1. BASE는 Z ≥ 242라 어느 X에서도 닿지 않는다) 하나다. 모델링부 RX-06-D7과 같다.
- 루트의 Box326(97668)은 이름이 `P_M02R_CYLBRKT`인 바디를 자르는데, 그 이름의 바디가 지금 설계에 없다(바디 목록 3,166개 안에 없음). 이름이 바뀌어 아무것도 자르지 않는 피처로 보인다. 디테일: 지우거나 대상을 확인한다.

## 2. 지난 문제 2 — 과제 범위 자세 간섭 (앱)

| 자세 | 대상 × 상대 | 걸린 시간 | 겹침 | 판정 |
|---|---|---|---|---|
| J_U4_X 0 · J_U4_PRESS 13.006(들림) | 69 × 64 | 480 s | 레일 ↔ 블록 178.86 ×4, 관 U6 ↔ P_M08_TUBE_BRKT_U6 0.028 | 기준선만 |
| J_U4_X 95 · 13.006(들림) | 69 × 64 | 443 s | 레일 ↔ 블록 178.86 ×4 | 기준선만 |
| J_U4_X 95 · −4.11(내림 끝, 매트 없음 자세) | 73(+팔·바퀴) × 64 | 1.8 s | 레일 ↔ 블록 ×4, 트레드 ↔ MAT_L·G·V 8,730(Z 1.58~10), SNS_BRKT ↔ MAT 0.025 | 매트 쌍은 해당 없음(M02R 검도 36줄 "내림 끝은 '매트 없음' 상태"), 나머지는 기준선 |
| J_U4_X 95 · 0(θ0, 매트 10 위 누름) | 바퀴·팔·그네·BASE·캐리지 등 19 × 매트 3·보·레일·축·멈춤·U6·관 20 | 0.06 s | 0 | 맞음 |

모두 truncated false, unchecked 0. 결과 요약은 `tools/out/mech_RX-06/model/fix1v/clr_results.json`에 있다.

- **레일 ↔ 블록 178.86 mm³:** 그린 레일(단면 12 × 7.5인 민 상자)에 실물 STEP 블록의 볼 홈 입술이 들어가 생긴다. Y 112.5~117이고, 면적 712.8 mm²에 평균 두께 약 1.2 mm다. 실물 레일에는 그 자리에 홈이 있어 겹치지 않는다. 블록이 레일을 따라 움직이므로 네 자세에서 값이 같다. M-08 기준선으로 판정 기억에 남겼다(키 30dae52d…, 9763aaaf…, e25638f7…, 68ebfffa…). 레일을 STEP으로 바꾸면(RX-06-E1) 없어진다.
- **CAD로 재지 않은 자세와 근거:**
  - X 47.5(가운데): U4 묶음은 X로 곧게만 움직이는 강체다. 고정 상대 64개는 쓸림 bbox 전체(X −95)로 골랐고, 두 끝(0·95)에서 겹침이 기준선뿐이다. 가운데에서만 닿을 수 있는 것은 쓸림 구간 안에 놓인 고정 바디인데, 그런 바디도 이미 그 64개 안에 들어 있다. 다만 가운데 점을 CAD로 재지는 않았다 → 라운드 끝 전체 회귀(E-03)가 본다.
  - X0 × 누름(−4.11·0): 그네·팔·바퀴는 U4 안에서 X축 둘레로 기울어 Y·Z로만 움직인다. 새로 생긴 고정 부품(레일 Y 112.5~120 · Z 260~446, 멈춤, 축 Z 530 근처, BSW·BUN)은 그네 쪽(Z < 250)보다 위에 있다. 누름 자세 × 고정 이웃은 M02R 검도의 다섯 자세(X0)에서 겹침 0이었다. 새 부품끼리의 상대 위치는 X와 상관이 없고, X95 누름에서 쟀다.
- CLI 9점: `fix1v/runall.sh`로 자세마다 한 호출씩 9개를 병렬로 돌렸다(`timeout 2700`). 9개 모두 rc 124, 결과 0바이트였다. 메모리는 CLI 9 × 3.6 GB, 앱 14 GB였다. 저장본 열기에 조인트 구동 2~3번(번마다 10~15분)을 더하면 호출 하나가 45분을 넘는다(워크플로우 메모).

## 3. 이웃 유닛 조인트

- U5(J_U5_X): 이번에도 쓸림 bbox(서명)로 보면 U5 바디가 U4 묶음 쓸림 공간에 닿지 않는다. d₁ 195 · d₂ 420의 bbox 틈 −9.5는 손계산 표(`handcalc_rx06.json`)에 있는 값이고, 이번에 CAD로 재지는 않았다. 지난 검도대로 디테일로 둔다: 연동 d₂ ≥ d₁ + 240을 `tools/machine.json`과 요구서 동작 순서 제약에 적는다.
- 관(U8 TU0604_M08P_U4_A2·U4_B·U6)은 X0 자세로 그린 강체 모형이다. X95에서는 관 끝이 피팅(KQ2L06 X −225 → −320)을 따라가지 않는다. 겹침은 0이다. 관은 유연 거동이라 모델로 판정하지 않는다. 고리 여유(≥ 190, 모델링 8②)를 요구서 7절 기록으로 둔다. 디테일.

## 4. 새로·옮긴 볼트, 묶음, 포트, 판금

- 이번 회차에 새로 넣거나 옮긴 볼트·부품은 0이다(피처 소속만 바뀜). 지난 검도 3절 판정이 그대로다.
- 리지드 그룹: 형상과 묶음의 변화가 0이다. J95에서 4바디가 묶음을 따라가는 것을 1절에서 실측으로 확인했다.
- LITE_ 0, 판금 0, 새 포트 0.

## 5. 다른 유닛의 같은 꼴 — 구동 후보 RX-06-C2(이번 과제 밖)

정적 점검(`document.json`, 움직이는 컴포넌트에 든 바디를 BodyTransfer 뒤에 루트 피처가 고치는 경우)에서 이번에 고친 것과 같은 꼴을 찾았다. 그 컴포넌트가 조인트로 움직이면 이 피처들은 제자리에 남는다.

| 컴포넌트 | 피처 | 대상 |
|---|---|---|
| U5_CAR(36) | Combine43(TAP ×2 cut), Combine44(TAP ×4 cut) | P_M03_CAR_PLATE, P_M03_CHAIN_ARM |
| U7_CASSETTE(4722) | Cylinder351·352(Ø4.2 cut), Combine45(TAP ×4 cut) | U7_BINDER, P_M05_CST_PLATE |
| U5_WHEEL_F(11) | Box199·Cylinder805~815 등 17개 | P_M03_DRV_BRKT·IDLER_SHAFT·2400.05.12PZ_F(이 컴포넌트가 움직이지 않으면 무해) |
| U4_WHEEL_N(9) | Box326(대상 이름 없음), Combine41(빈 cut) | — |

- 고치는 법: 각 피처를 만든 자세(REST)에서 `component.move_features`로 대상 바디의 컴포넌트에 옮긴다. 거부되는 Combine은 TAP 도구 바디를 먼저 그 컴포넌트로 옮긴다. 확인은 해당 조인트 끝 자세에서 부피와 bbox가 강체 이동과 같은지로 한다.
- 이번 과제의 바뀐 부품이 아니어서 동작 문제로 올리지 않았다(과제 범위 E-17). 다음 구동 라운드의 구동 후보로 남긴다.

## 6. 완료 판정

| 항목 | 결과 |
|---|---|
| d₁ 조절 범위(근거) | 100~195, 근거 있음(지난 검도 그대로) — 만족 |
| 전 범위 × 들기·누름 과제 범위 간섭 0 | 4자세 실측에서 기준선 밖 겹침 0, 나머지 자세는 2절 근거 — 만족 |
| 레일·볼나사 하중 손계산 | 블록 SF 12.7, 손 힘 2.9 N(지난 검도, 형상 변화 0) — 만족 |
| BOM | `docs/bom/FSAP_v2.11.1_made.csv`·`_purchased.csv` 있음 — 만족 |

## 7. 원복

- 끝에 `motion.play REST step 0`(J_U4_PRESS → 13.006)을 하고, REST 연구에 J_U4_X 키가 없어서 `joint.drive J_U4_X 0`을 따로 했다(약 11분). 끝난 뒤 실측: P_M02_BASE 382,575.42 mm³ · X −330~−140 · Z 242~250으로 저장 상태와 같다. 면 수는 J95에서 92, J0에서 91이었다. 부피·bbox가 같으니 면 나눔의 차이로 본다. 저장하지 않았으므로 저장본은 그대로다.
- 시간: 약 102분(예상 L 60분의 2배 120분 안). 대부분은 앱 `joint.drive J_U4_X` 3회(번마다 10~15분)와 clearance 2회(번마다 7~8분), 시간 초과로 끝난 CLI 45분(앱과 겹쳐 돎)이다.

## 워크플로우 메모

- 큰 설계(3,681 피처)에서 `joint.drive J_U4_X`는 번마다 10~15분이 걸린다. `J_U4_PRESS`(같은 값으로 이미 계산된 쪽)는 1초 안이다. MCP 호출은 5분에 끊기고, 끊긴 `batch`는 `pending`으로도 결과를 받지 못한다(체크포인트 id를 잃음). 긴 구동은 `execute` 하나로 보내고 `pending`으로 받는다.
- 앱이 계산 중일 때 `batch`가 'Connection closed'로 두 번 끊겼다. 단일 `measure`는 됐다.
- CLI로 자세 점을 재는 방법은 이 크기의 설계에서 쓸 수 없다. 열기와 구동이 호출마다 붙어 45분을 넘었다. 앱 한 세션에서 자세를 이어 바꾸며 재는 쪽이 빠르다(이번 4자세, 약 50분).
- REST 연구에 새 조인트 J_U4_X 키가 없다. 동작 상태 초기화가 J_U4_X를 0으로 돌려놓지 않는다. 모델링부가 REST에 J_U4_X 0 키를 더해야 한다(디테일 RX-06-D8).
