hyeunung/FSAP/docs/reports/mechanism/mech_RX-06_verify.md

# RX-06 검도·체결 — U4 X 위치 조절축 (검도·체결부, 2026-11-12)

요약(10줄 안):
- 대상: `3D_Modeling/FSAP_v2.11.0.sc`(커밋 38b4de1). 통로 MCP(앱에 이미 열린 v2.11.0 세션, 다시 열지 않음). 저장 안 함.
- **불합격(동작 문제 1).** J_U4_X 95(d₁ 195)에서 기존 가공품 4개가 U4 묶음을 따라가지 않고 조각이 남는다: P_M02_BASE 부피 382,575 → 451,786 mm³(+69,211, 셸 6), bbox X −425~−145·Z 50~250(강체 이동이면 X −425~−235·Z 242~250). P_M02_ARM_SIDE_N·_P X −415~−155.4(기대 −415~−215, 셸 3), P_M02_ARM_TIE X −370~−257.85(기대 −370~−350, 셸 3). 모델링 보고 7-1 '못 한 것'과 같은 내용을 마지막 저장본에서 다시 잼.
- 고쳐진 것 확인: P_M02S_PIVOT_BRKT_B(−95 그대로 이동, 부피 같음), P_M02S_CYL_BRKT, P_RX06_CARRIAGE(X −335~−220).
- 9점(J_U4_X 0·47.5·95 × J_U4_PRESS 들기·0·누름) CLI 검사(`cli_verify.json`)는 50분 제한에 걸려 결과 0줄 — 누름·들기 자세의 과제 범위 간섭은 아무도 못 잼.
- 손계산(모델링부 값 검토): 블록 SF 12.7, 손 힘 2.9 N, 발 볼트 SF 23, 웹 SF 36 — 완료 판정 항목 만족. BOM v2.11.0 만듦·구매 행 있음.
- d₁ 범위 100~195 근거(0-8-2.3, 원판 한계 62.5~287.5, 재질 한계 281) 있음. 단 d₁ 195·d₂ 420에서 U5와 bbox 틈 −9.5(손계산 표) — 연동 조건 d₂ ≥ d₁ + 240을 machine.json·동작 순서에 넣어야 함(디테일).
- 원장 commit 안 함(불합격). 등급 L 맞음.

## 0. 근거 규칙

| 규칙 | 원문 | 이번 |
|---|---|---|
| E-03 | "합격은 동작·간섭" — 행정을 다 가고 겹치지 않고 조각이 안 남아야 | J95에서 조각 남음 → 불합격 |
| E-17 | "과제 안 검사는 바뀐 바디·주변을 관련 조인트 몇 점에서만" | scope: 조인트 바뀜 → 전체(바뀜 136·새로 63·없어짐 30·이웃 218, `tools/out/scope.json`). 조각 문제로 바디 형상부터 틀려 간섭 수치가 의미 없음 → 형상 확인까지만 |
| E-16 | "판정은 수치로만" | bbox·부피·셸 수 |
| E-04 / 실행 규칙 2 | 혼자 도는 읽기 부서는 MCP, 저장 금지 | MCP, save 안 함 |

## 1. 과제 범위 동작 검사 (앱, 마지막 저장본)

J_U4_X 0 기준값: `tools/out/mech_RX-06/model/measure_full_v2110.json`. J_U4_X 95: 이번에 앱에서 `joint.drive J_U4_X 95` 뒤 `inspect.measure`.

| 바디 | J0 bbox X / Z | J0 부피 | J95 bbox X / Z | J95 부피 | 강체 이동이면 | 판정 |
|---|---|---|---|---|---|---|
| P_M02_BASE | −330~−140 / 242~250 | 382,575 | −425~−145 / **50~250** | **451,786** (셸 6) | X −425~−235, Z 242~250, 382,575 | **조각 남음** |
| P_M02_ARM_SIDE_N | −320~−120 / 61~168 | 77,694 | −415~**−155.4** | 77,694 (셸 3) | −415~−215 | **조각 남음** |
| P_M02_ARM_SIDE_P | −320~−120 / 61~152 | 77,685 | −415~**−155.4** | 77,691 (셸 3) | −415~−215 | **조각 남음** |
| P_M02_ARM_TIE | −275~−255 / 109~155 | 24,816 | −370~**−257.85** | 24,816 (셸 3) | −370~−350 | **조각 남음** |
| P_M02S_PIVOT_BRKT_B | −180~−152 | 15,910 | −275~−247 | 15,910 | 그대로 | 맞음 |
| P_M02S_CYL_BRKT | −265~−215 | 19,551 | −360~−310 | 19,551 | 그대로 | 맞음 |
| P_RX06_CARRIAGE | −240~−125 | 516,556 | −335~−220 | 516,556 | 그대로 | 맞음 |

원인(모델링 보고 7-1): M02·MOT-01·M02R 때 루트에서 만든 cut/join 피처(도구 바디가 루트 좌표)가 U4_WHEEL_N·U4_PRESS가 J_U4_X로 움직일 때 제자리에 남는다. RX-06 전에는 U4 묶음이 틀에 고정이라 드러나지 않았다.

- 대상 통로·작업 대상: 남은 조각은 BASE Z 50~250(보 밑 공간)과 팔 X −215~−155 자리 — 실물에는 없는 형상이라 그 자리 간섭 수치(관·센서·U5)는 판정할 수 없다.
- 9점 CLI(`tools/out/mech_RX-06/model/cli_verify.json`, 10:30~11:20): `timeout 3000`으로 끝, `cli_verify_out.json` 0바이트·오류 0바이트. 결과 없음. 이 스크립트는 U6 관 고치기 전 첫 저장본에 대고 돌았다.
- 모델링부 앱 검사(그대로 인용): J95·REST 새 부품 16 × 이웃 69, 겹침은 그 뒤 옮긴 관 U6·클램프 L_6뿐. J0 관 3 × 63 → U6 ↔ P_M08_TUBE_BRKT_U6 0.028 mm³(구멍 벽 맞닿음). 누름(J_U4_PRESS −4.11)·들기 자세 × J95는 아무도 못 잼.

## 2. 이웃 유닛 조인트 점

- U5(J_U5_X) × U4 X: 손계산 bbox 틈(`handcalc_rx06.json` rail_screw.d1.gap_U5_bbox) d₁ 195·d₂ 420에서 −9.5, d₂ 440에서 10.5. 0-8-2.3 규칙(d₂ ≥ 2d₁ + w = 415)으로는 d₂ 420이 허용인데 bbox로는 겹칠 수 있다. bbox라 실제 겹침은 아님 — 고친 뒤 d₁ 195·d₂ 420 자세에서 inspect.clearance로 실측 필요.

## 3. 새로·옮긴 볼트 (M-01), 묶음 (E-11)

| 볼트 | 물림 | 렌치 접근 | 판정 |
|---|---|---|---|
| CB5-16 ×6 캐리지 발 → P_M02_BASE 탭 | 4(0.8d) | 위에서, 머리 Z 262~267 위 웹 Y 95~107 밖(Y 50·85) | 물림 4 디테일(모델링 D2, CB5-20 검토) |
| CB6-20 ×4 너트 플랜지 → 캐리지 귀 | 11.5 | −X 쪽에서, 귀 X −174.5 | 맞음. 컴포넌트를 U3 CB6-20_M03_CAR와 공유(D6, 디테일) |
| CB5-12_M02S_BEAM_1·2, BASE_4, PY:30·31 | 옮김 | 기존 자리와 같은 방향 | 맞음 |
| 레일 M3·블록 체결·BSW20·BUN20 볼트 | 없음 | — | 디테일(D1·D3), 모델에 볼트 없음 |

- 리지드 그룹: 모델링 보고 3절대로 새 occurrence 모두 강체/조인트에 묶임, 떠 있는 것은 옛 U4_CYL·U4_ROD 빈 컴포넌트 2(M02R 잔재). 이번 과제 것 아님.
- 공압 포트(M-06): 새 포트 없음. 관 U6·U4_A2·U4_B 다시 냄 — 굽힘 R 15~30.
- LITE 간이 형상: 새 LITE_ 없음. STEP대기_HANDLE_D50(D-190)은 STEP 대기(외부).
- 판금(M-04): 새 판금 없음(P_M02_BASE 연장은 가공품 t6).

## 4. 완료 판정 항목

| 항목 | 결과 |
|---|---|
| d₁ 조절 범위(근거) | 100~195, 근거 있음 — 만족 |
| 전 범위 × 들기·누름 과제 범위 간섭 0 | **미달** — J95에서 형상 조각, 누름·들기 × J95 미측정 |
| 레일·볼나사 하중 손계산 | 만족(블록 SF 12.7, 손 힘 2.9 N, 역구동 0.059 N·m) |
| BOM | 만족(`docs/bom/FSAP_v2.11.0_made.csv`·`_purchased.csv`) |

## 5. 고치는 법

1. J_U4_X 0, J_U4_PRESS를 각 피처를 만든 자세(REST 13.006)에 두고 P_M02_BASE·P_M02_ARM_SIDE_N·_P·P_M02_ARM_TIE를 고치는 루트 피처(모델링 보고 7-1: M02R 97671~97693, ARM 97613·97678~97681 등)를 `component.move_features`로 바디가 든 컴포넌트(U4_WHEEL_N / U4_PRESS)에 옮긴다.
2. 확인값(J95): BASE X −425~−235·Z 242~250(보 밑 연장 Y 199~266 포함)·부피 382,575·셸 1, ARM_SIDE_N·P X −415~−215·부피 77,694/77,685, ARM_TIE X −370~−350.
3. 그 뒤 과제 범위 검사: J_U4_X 0·47.5·95 × J_U4_PRESS 13.006·0·−4.11, 바뀐 바디 × 이웃(앱 1자세 약 10분이라 CLI 묶음 4~5개 병렬, 묶음마다 8분 안).
4. d₁ 195·d₂ 420 실측, 겹치면 연동 d₂ ≥ d₁ + 240을 `tools/machine.json`·요구서 동작 순서 제약에 적는다.

## 6. 원복

마지막에 `joint.drive J_U4_X 0` + `motion.play REST step 0`(앱에서 약 10분). 끝난 뒤 실측: P_M02_BASE 부피 382,575·셸 1·X −330~−140, 캐리지 X −240~−125 — 저장 상태와 같음. 체크포인트 id를 잃어 `edit.restore_checkpoint`는 못 함. 저장하지 않았으므로 저장본은 그대로.

## 워크플로우 메모
- MCP 도구 호출 시간 제한보다 앱 `joint.drive`(옛 피처 다시 계산, 약 10분)가 길어 응답이 끊기고 batch 결과(체크포인트 id 포함)를 잃음. 긴 자세 바꾸기 전에는 체크포인트를 따로 한 호출로 받아 둘 것.
- 모델링부가 백그라운드로 돌린 9점 CLI가 50분 제한에 결과 없이 끝남 — 저장본 열기 13분 + 자세 9 × 약 10분이라 한 호출에 담을 수 없는 크기. 자세별로 나눠야 함(regrun 상한 규칙과 같은 문제).
