hyeunung/FSAP/docs/reports/mechanism/mech_RX-06_measure.md

# RX-06 측정 — U4 X 위치 조절축(레일 + 볼나사) 자리 재기 (측정부, 2026-11-12)

요약(10줄 안):
- 대상 `3D_Modeling/FSAP_v2.10.4.sc`(config.json doc, 커밋 931962c). 앱에 이미 열려 있음(dirty true·undo 21, 타임라인 3,598 피처 오류 0 — SIM-01 저장 뒤 자세 변경 흔적으로 보이고 형상 피처 끝은 M02R 것). **버리지 않고**(안내서 '문서 확인') 그 세션에서 읽기만 함. 저장 0, 끝에 REST step 0(바퀴 트레드 bbox가 처음과 같음 Z 38.80~158.80).
- 서명 sigcheck `full`(v2.10.2 서명) → MCP `measure {}` 한 번으로 **3,139바디 전수** 다시 씀 + `sigpatch`(문서·해시) → sigcheck `reuse`. 바뀜 45·새로 37·없어짐 30(모두 M02R U4). bolts.json 1,192 → 1,200(없어진 볼트 뺌, 새 볼트 18 bbox 기준 추가).
- **이미 됨? 아니오.** machine.json에 U4 X 조인트가 없다(U4 조인트 = J_U4_PRESS·WHEEL_ROT·DISK·U4S_ROD·U4S_SLOT). d₁은 100 고정(바퀴 트레드 X −112.5~−87.5).
- d₁을 줄이는 쪽(+X): 헤드 임시 상자 `STEP대기_867-392342_UPPER`(X −80, Z ≥ 125)가 막는다 — 들림·θ0 자세에서 트레드 X 틈 **7.5**(bbox), −4.11 자세는 트레드 윗끝 Z 121.6이라 상자를 지나 다음이 노즈·바인더 **76.5**·노루발 77.5(정확). DC2-06 머리판 길(d₁ 100 유지 조건)도 있다.
- d₁을 늘리는 쪽(−X): 매다는 묶음은 U5 대차가 막는다 — d₂ 420(J_U5_X 1380) **85.5**, d₂ 440(V) **105.5**(bbox, 그네 ↔ U5 트레드). 바퀴가 원판 Ø250(X −300~−50, 테이블 고정) 위에 있으려면 d₁ 62.5~287.5.
- 보 밑(Z 242~250)은 U4 윗판이 보에 바로 붙어 **레일 넣을 높이 0**. 보 앞면(Y 120)은 X > −340에서 비어 있음(U5 레일 끝 X −340·Z 290~310, U5 아이들러 X −440~−340·Z 314~466). 앞면 Z 252~284에 관 클램프 L_5(X −112~−88)·L_6(X −262~−238), Y 101.6~111.2·Z 259~265에 관 U6.
- 실린더 브래킷 `P_M02S_CYL_BRKT`는 **보에 직접**(CB5-12_M02S_BEAM_1·2) 붙어 있어 X축을 넣으면 슬라이드 판으로 옮겨야 한다. U6 관 브래킷 `P_M08_TUBE_BRKT_U6`은 U4 윗판에 붙어 있다.
- 매달린 무게(X로 같이 움직일 것, 원판 묶음 제외) **10.81 kg = 106 N**, 무게중심 (−215.6, 33.6, 156.6) REST. 원판 묶음 6.25 kg은 테이블 고정.
- 미완·주의: M02R은 아직 '일부'(v2.11.0 대기, 결정로그 M02R-E01·E03). RX-06은 "M02R이 끝난 뒤"(요구서 5절 RX-06 행)라 같은 부품을 고치는 순서가 걸린다.

## 0. 측정 표·통로·시간

| 항목 | 값 |
|---|---|
| sigcheck(처음) | `{"mode": "full", "reason": "다른 문서의 서명(…FSAP_v2.10.2.sc)"}` |
| 앱 상태 | `running` 빈 목록. 열린 문서 FSAP_v2.10.4(경로 config doc와 같음), **dirty true, undo 21, revision 50**, 타임라인 3,598, error 0(warning 55는 예전부터 — 6004ZZ 볼 가져오기·불리언 재시도 등). 메타 설명 "SIM-01 mechanism: show L-cycle mat …(no geometry change)" |
| dirty 처리 | 안내서 '문서 확인' "dirty면 … 버리지 않는다"를 따라 버리지 않고 다시 열지도 않음. 측정은 형상을 바꾸지 않으므로 그 세션에서 읽기만 함. 처음 `motion.play REST 0`은 moved false(이미 REST). 마지막 피처가 M02R 관(Pipe114·BodyTransfer575)이라 형상은 저장본과 같다고 봄(확인 필요: dirty 내용 — 앱에 변경 목록 명령 없음) |
| 서명 | `measure {}` 1회(3,139바디, material·mass 포함) → `build_sig.py` → `ledger.py sigpatch`(--parts 없이, 전수 뒤 찍기) → sigcheck **reuse 3,139** |
| 통로 | MCP(그 시각 CAD 부서 하나, 실행 규칙 2). 저장 0 |
| MCP 이상 | ① 바디 이름을 한글로 넣은 `batch`(inspect.measure 82개, 18개) 두 번 "connection closed" — MCP 서버(solidcraft-cli)가 다시 떴다(PID 32764 → 38928). 앱(PID 38080)은 살아 있었다. ② ASCII `batch`(joint.drive J_U4_PRESS 0·−4.11 + measure 18) 앱 응답 끊김(os error 10060), 실제로는 약 11분 돌고 끝남. ③ `motion.play REST 0` 300 s 넘어 pending으로 받음(moved true). 앱 재시작 0 |
| 원복(E-08) | 형상 편집 0. `edit.checkpoint` 24(복원 안 함 — 편집이 없어서). 끝에 `motion.play REST 0` → 트레드 bbox Z 38.80~158.80(처음과 같음). dirty는 처음부터 true였고 그대로 둠 |
| 근거 | E-17 "측정 표는 서명을 다시 쓴다", E-16 "판정은 수치로만", E-15 "부품 이름 목록으로 위치를 직접 옮기지 않는다"(그래서 X 이동은 조인트 없이 bbox 계산으로만 봄) |

## 1. 과제에 걸린 부품·구동 요소 (v2.10.4, REST = J_U4_PRESS 13.006 들림, 서명 값)

### 1-1. 고정 쪽(보·헤드·이웃)

| 부품 | X | Y | Z | 재질 | 메모 |
|---|---|---|---|---|---|
| P_M07_BEAM | −2380~1230 | 120~320 | 250~650 | Steel | 앞면 Y 120, 밑면 Z 250 |
| STEP대기_867-392342_UPPER | −80~500 | ±90 | 125~560 | (임시 상자, D-10) | U4 +X 쪽 벽 |
| STEP대기_867-392342_LOWER | −40~40 | ±60 | −200~0 | | 테이블 밑 |
| STEP대기_867-392342_NOSE / P_M01_FOOT / P_M05_BINDER | X 끝 −11 / −10 / −11 | | | | 바늘 둘레 |
| SV2RL28-1800_RAIL(U5) | −2140~**−340** | 104.5~120 | 290~310 | Steel | 보 앞면. U4 쪽 끝 −340 |
| P_M03_IDLER_BRKT(U5) | −440~−340 | 90~120 | 314~466 | SUS304 | 보 앞면, 벨트 풀리 |
| P_M08_TUBE_CLAMP_L_5 / L_6 | −112~−88 / −262~−238 | 102~120 | 252~284 | A5052 | 보 앞면 관 클램프(CB5-16_M08_PY 4개) |
| P_M08_TUBE_CLAMP_F_5 | −112~−88 | 102~120 | 420~470 | A5052 | 보 앞면 |
| TU0604_M08P_U6 | −350~1074 | −133~111.2 | 210~331 | 관 | 보 앞 Y 101.6~111.2·Z 259~265 가로. U4 윗판과 틈 9.0 |
| U6: P_M06_BASE / P_M06_CARR / CJ2B16-60SZ_M06 | −142~−22 / −120~−42 / −280~−134 | −172~−90 / −185~−100 / −139~−121 | 120~195 / 21~156 / 127~145 | | U4 −Y 옆 |
| P_M02_DISK(+DISK_BASE·HSG·SHAFT, 6004ZZ) | −300~−50 | ±125 | −12~0 | A5052 | **테이블에 고정**(U4_WHEEL_N 유닛이지만 X로 같이 안 감). 묶음 6.25 kg |

### 1-2. X로 같이 옮길 매다는 묶음(U4_WHEEL_N 고정부 + U4_PRESS·U4_WHEEL 회전부)

| 부품 | X | Y | Z | 질량 g | 재질 | 메모 |
|---|---|---|---|---|---|---|
| P_M02_BASE(윗판) | −330~−140 | −60~200 | 242~250 | 3,062 | SUS304 | 보 밑면에 CB5-16_M02_1~4((−310,140)·(−310,180)·(−160,140)·(−160,180)). 슬라이드 판이 될 자리 |
| P_M02S_PIVOT_BRKT_A / B | −330~−300 / −180~−152 | 103~133 | 128~242 | 128 / 126 | SUS304 | 피벗 축 X (Y 120, Z 140) |
| STEP대기_PSFJ12-200(피벗 축) | −342~−142 | 114~126 | 134~146 | 178 | S45C | |
| P_M02S_SPRING_TAB_1·2 / AUT12-45 TOP | −307~−173 | 40~60 | 204~242 | | | 윗판 밑 스프링 |
| **P_M02S_CYL_BRKT** | −265~−215 | 222.4~262 | 205~250 | 180 | SUS304 | **보 밑면에 직접**(CB5-12_M02S_BEAM_1·2, (−255, 248)·(−225, 248)) |
| STEP대기_CDQ2YA20-25DMZ / _ROD / Y-020B | −258~−222 | 121.9~222.4 | 205~241 | 147 / 30 / 80 | | 로드 −Y 나옴(J_U4S_ROD 0~25) |
| P_M02S_SWING(그네) | −322~−160 | 28.3~141.8 | 110.1~232.2 | 749 | A5052 | J_U4_PRESS로 돎 |
| HG-KR23_M02 / PGX62-H-10_M02_CASE | −287.6~−181 / −170~−125 | −48~24 | 58~135 | 2,012 / 1,067 | | 서보·감속기 |
| P_M02_WHEEL / _TREAD | −119~−87.5 / −112.5~−87.5 | 트레드 −72.7~47.3 | 38.8~158.8 | 534 / 104 | A6061 / Urethane_A70 | 트레드 r 60, 폭 25, **중심 X −100 = d₁ 100** |
| P_M02_SNS_BRKT + E32-D36P1_2M_M02 | −132~−110.5 | −114.4~−43.1 | 68.5~131.9 | | | 매트 유무 센서 |
| P_M08_TUBE_BRKT_U6 | −356~−330 | ±16 | 222~272 | 51 | A5052 | **U6 관을 잡는 브래킷이 U4 윗판에 있음** |
| TU0604_M08P_U4_A2 / _B | 세움 (−161, 70/94) | | 189~466 | 48 / 59 | 관 | U4 실린더 관, 윗판 구멍으로 올라가 보 앞을 지나 +X로 |
| 합계(원판 묶음 제외, 관 제외) | | | | **10,815** | | 무게중심 (−215.6, 33.6, 156.6) REST |

구동 요소: J_U4_PRESS 회전 축 (−1,0,0) 원점 (−240, 120, 140), 13.006(들림 끝·REST) / 0(θ0 봉제, 바퀴 밑 Z 10) / −4.11(나옴 끝 근처), 실린더 STEP대기_CDQ2YA20-25DMZ(임시, D-188) 행정 25. 트레드 중심 = (Y 120 + 138.924 cos φ, Z 140 + 138.924 sin φ), φ = atan2(−70, −120) − θ — −4.11에서 계산 (5.3, 61.6), 앱 실측 bbox Y −54.67~65.32·Z 1.58~121.58로 맞음.

구매품 bbox·부피 표: `tools/out/mech_RX-06/region_sig_v2104.json`(과제 영역 234바디), 전수 `tools/out/mech_RX-06/measure_full_v2104.json`. 이번 과제에 새 구매품은 아직 없음(레일·볼나사 형번은 구상이 정함).

## 2. 비어 있는 공간·X 자유 이동

### 2-1. 묶음을 X로 옮길 때 막는 것 (bbox 계산, 보수적 — 실제 틈 ≥ 이 값)

계산 `tools/out/mech_RX-06/xtravel_pose.py` → `xtravel_pose.json`. 회전부는 J_U4_PRESS 축으로 돌린 bbox 꼭짓점(트레드·바퀴는 원통식), U4S_ROD는 Y −25 늘림, U5 대차 묶음(U5_CAR·LIFT·WHEEL·FLOAT)은 J_U5_X만큼 옮기고 승강 −40까지 합침. 원판 묶음·U4 관은 뺌.

| 자세 | +X(d₁ 줄임) 첫 막힘 | 다음 | −X(d₁ 늘림), d₂ 420 / 440 / 800 / 1000 |
|---|---|---|---|
| 들림 13.006 | 트레드 ↔ UPPER **7.5** | SNS_BRKT ↔ UPPER 35, ARM_SIDE_N ↔ UPPER 40 | 그네 ↔ U5 트레드 **85.5 / 105.5 / 665.5 / 465.5** |
| θ0 0 | 트레드 ↔ UPPER **7.5**(트레드 윗끝 Z 130 > 125) | ARM_SIDE ↔ UPPER 40, SNS_BRKT ↔ U6 CB3-10_M06 54.8 | 같음 |
| −4.11 | ARM_SIDE_P ↔ UPPER 40(bbox 꼭짓점 과대) | BASE ↔ UPPER 60, 트레드 ↔ 바인더·노즈 76.5 | 같음 |

U5 REST(d₂ 1800)에서는 −X 쪽에 매다는 묶음을 막는 것이 보 앞면 U5 부품(X ≤ −340, Z ≥ 290)뿐이다. 윗판(Z 242~250)은 그 밑이라 −X로 막힘 없음.

### 2-2. 정확한 틈 (MCP `inspect.clearance`, J_U4_PRESS −4.11, 10 × 14바디, 6.1 s, 겹침 0, truncated false)

`tools/out/mech_RX-06/clearance_m411.json`

| 쌍 | 틈 mm | 방향 |
|---|---|---|
| 트레드 ↔ P_M02_DISK | 1.58 | Z(누름 끝 근처, X 이동과 무관 — 원판 위에 있어야 함) |
| 트레드 ↔ UPPER | 8.24 | 대각(트레드 윗끝 121.6, 상자 밑 125) |
| 바퀴 허브 ↔ UPPER | 15.37 | 대각 |
| 윗판 ↔ TU0604_M08P_U6 | 9.0 | Z(관이 윗판 위 Z 259) |
| E32 센서 ↔ P_M06_CARR / SNS_BRKT ↔ P_M06_CARR | 22.4 / 24.4 | 주로 Y |
| 트레드 ↔ 노즈·바인더 | 76.5 | 순수 X |
| 바퀴 ↔ 노루발 P_M01_FOOT | 77.5 | 순수 X |
| 윗판 ↔ UPPER | 60.0 | 순수 X(Z 242) |
| ARM_SIDE_N ↔ P_M06_BASE | 61.1 | 대각 |

### 2-3. 레일·볼나사 후보 자리 (bbox 프로브, `probes_bbox.json`)

| 후보 | 상자 X·Y·Z | 막는 것 |
|---|---|---|
| A 보 밑면(윗판과 보 사이) | −400~−90 · 120~320 · 230~250 | **윗판 P_M02_BASE가 보 밑면에 바로 닿음(틈 0)** — 레일+블록 높이만큼 묶음을 내려야 하는데 그 밑 Z 204~242에 스프링 탭·AUT12 고리·실린더(윗끝 241)·그네 윗끝 232.2가 있다. 실린더 브래킷·CB5-12_M02S_BEAM_1·2도 이 띠 |
| B 보 앞면 아래(Y 60~120, Z 250~330) | −400~−90 | 관 클램프 L_5(X −112~−88)·L_6(X −262~−238) Z 252~284 + 볼트 CB5-16_M08_PY 4개, 관 U6(Y 101.6~111.2, Z 259~265 가로), U4 관 세움 2개(X −161), U5 레일 끝(X ≤ −340, Z 290~310), CB5-16_M03_7(X −359~−351) |
| C 보 앞면 가운데(Z 330~450) | −400~−90 | U5 아이들러·풀리·벨트(X ≤ −339.6), 클램프 F_5(X −112~−88, Z 420~470), 관 U5_A·U5_B·U4 관(bbox 큼 — 실제 길은 보 앞 Y 91~111 근처) |
| D 바퀴 +X 쪽 | −87.5~−60 · −75~50 · 30~160 | UPPER(Z ≥ 125)만 |
| E 묶음 뒤(−X) | −430~−330 · −60~200 · 30~250 | 묶음 자신(피벗 축 끝 −342, U6 관 브래킷 −356)과 관 U6뿐 |

## 3. 작업 대상

| 매트(0-2 양 끝 포함) | X | Y | Z | 메모 |
|---|---|---|---|---|
| MAT_L 1500(큰 끝) | −1493.5~6.5 | −1050~450 | 0~10 | 보임 |
| MAT_S 300×200(작은 끝) | −293.5~6.5 | −400~−200 | 0~10 | 숨김(L과 겹치는 대안) |
| MAT_G 1200 U홈 / MAT_V 1200 V홈 | −1193.5~6.5 | −900~300 | 0~10 | 숨김 |
| 테이프 조각(대기) | 예 TP_G_28a~31a·TP_V_27a~30a | 290~301 | 0~11 | 바늘 앞 X −573~7.5 |

- 바퀴는 봉제 중 늘 매트 위(바늘을 지나는 X선, 매트 윗면 Z 10). d₁을 바꾸면 접지점이 X로 옮겨 가므로 **작은 매트 S(바늘에서 −X로 300)** 에서는 트레드가 매트 안에 있어야 한다: d₁ + 12.5 ≤ 293.5 → d₁ ≤ 281. 홈 매트에서는 바퀴가 홈 위면 든다(0-8-2 ②).
- 사이클 단계(machine.json states, 6-4): 로딩 끝(J_U4_PRESS 13.006) → 바퀴 내림(0) → 직선·모서리·이음매(0~0.477) → 배출(13.006), 정비 MAINT_HEAD(−3.349), 두께 THICK_6(−0.96)·THICK_16(3.751). U5는 L d₂ 1000(J 800), G d₂ 800(J 1000), V d₂ 440(J 1360), S는 내리지 않음.
- 떨어진 조각·빠져나갈 길: 이 과제는 바늘 −X 쪽 위 구조라 매트 배출 길(−Y, J_WP_*_Y 30)·조각 길과 만나지 않는다. U4 묶음은 매트 위 Z ≥ 38.8(들림)·접지만 닿음.

## 4. 같은 실수를 막을 것(요구서·결정로그)

| 근거 | 내용 | RX-06에 주는 것 |
|---|---|---|
| C-41(M02R 행) | 모터 위 X축 누운 실린더+크랭크는 사진 오독, 보 고정 사각 실린더 + 축 X 그네가 맞다 | 실린더를 보에서 떼어 슬라이드 판에 다시 달아도 '보 쪽 고정·로드 −Y·그네' 구조는 그대로 |
| 요구서 5절 RX-06 | "M02R이 끝난 뒤(같은 부품을 고침)" | M02R은 아직 '일부'(v2.11.0: 빈 컴포넌트 21개·스프링 고리–탭 볼트 겹침, M02R-E01·E03). 그 저장본 위에서 RX-06을 해야 번호·잔재가 꼬이지 않는다 |
| DC2-06 | U4 마운트를 헤드 −X 면에서 약 60 띄움, d₁ 100 유지, 정비 MAINT_HEAD 머리판 통로 틈 1.14 | d₁ < 100이면 머리판 길을 다시 봐야 함. 거꾸로 X축으로 정비 때 묶음을 −X로 빼는 쓰임도 있음 |
| DC-01 (가)·DC-03 (나) | U4 혼자 회전 SF를 위해 d₁ ≥ 175·≥ 193 안이 나왔으나 C-37·C-38로 d₁ 100 유지(구름 0.02 판정선, 7절 실측) | d₁ 조절 범위 위쪽 근거 후보(약 175~200). 7절 실측 c > c_max면 d₁을 늘려 푸는 길(요구서 7절 DC-03 줄 "U4 누름·d₁을 다시 따진다") |
| 0-8-2 ③ | 먼 쪽 바퀴 내림 조건 d₂ ≥ 2·d₁ + 바퀴 묶음 폭(임시) | d₁을 늘리면 V(d₂ 440)·최소 d₂ 420과 부딪힘 — 2-1 표 −X 85.5·105.5 |
| M00-D05 | d₂ 300이면 U4·U5 서보 묶음 겹침 → d₂ 최소 420 | 같은 이유로 d₁ 위쪽 상한 |
| C-03·요구서 1-1 | 영구 눌림자국 금지, 누름 ≤ 51.6 N | X 이동 중 바퀴를 누른 채 끌지 않게(봉제 중 바꿀지 판단할 때) |
| 실행 규칙 14 | 커버·외장은 구동 아님 | 볼나사 덮개 같은 것은 외장 단계로 |
| D-181·D-184(신뢰 낮음~중간) | 빨간 블록 = X 가이드 블록, 보 앞 볼나사가 U4를 옮긴다는 것은 추정 | 근거 사진 번호(사진1 ④·⑤, 사진2 ②·③)를 결정로그에 |

## 5. 이미 되는지

**아니오(already_ok false).**
- 완료 판정 "d₁ 조절 범위(근거), 전 범위 × 들기·누름 자세 간섭 0, 레일·볼나사 하중 손계산, BOM" 중 아무것도 모델에 없다: machine.json U4 조인트에 X 슬라이드가 없고(J_U4_PRESS·J_U4_WHEEL_ROT·J_U4_DISK·J_U4S_ROD·J_U4S_SLOT), 레일·볼나사 바디 0, 윗판은 보에 볼트로 고정(CB5-16_M02_1~4), 실린더 브래킷도 보에 고정.
- 지금 d₁ 100 한 점에서 들림·−4.11 자세 과제 범위 겹침 0(2-2, 겹침 0)은 맞지만 '전 범위'가 없다.

## 6. 구상에 넘길 하중 입력(손계산은 구상·모델링이)

| 항목 | 값 | 근거 |
|---|---|---|
| 매다는 무게 W | 10.81 kg → 106 N(관 0.11 kg 별도) | 이번 전수 측정 |
| 무게중심(REST) | (−215.6, 33.6, 156.6) | 같음. 윗판 아랫면 Z 242에서 −85, 윗판 가운데 (−235, 70)에서 X +19·Y −36 |
| 바퀴 누름 반력 | 40 N(설정), 상한 51.6 N(자국), 위로 → 들림 때는 W 전부, 누름 때 W − F | M02R 결과(C-39·C-03) |
| 접선 힘(Y) | ≤ 18 N, 접지 Z 10 → 윗판 Z 242까지 팔 232 → Mx ≈ 4.2 N·m | M02R-D2 수정 2 |
| X 힘(볼나사 축 방향) | ≤ μ0.4 × 51.6 = 20.6 N(누른 채 옮기면), 들고 옮기면 관성만 | D-95 μ 0.4 |
| d₁ 범위 경계(bbox) | 아래 92.5(헤드 상자 7.5, D-10 임시) · 원판 62.5 / 위 185(d₂ 420)·205(d₂ 440)·281(S 매트)·287.5(원판) | 2-1·3절 |

## 결과 파일

- `tools/out/signatures.json`(3,139, doc v2.10.4·해시 찍음), `tools/out/bolts.json`(1,200)
- `tools/out/mech_RX-06/`: `measure_full_v2104.json`(전수), `measure_all_v2104.json`(요약), `doc_inspect_v2104.json`, `region_sig_v2104.json`, `sig_diff.json`, `sig_rebuild_log.json`, `build_sig.py`, `xtravel.py`·`xtravel_bbox_rest.json`, `xtravel_pose.py`·`xtravel_pose.json`, `probes_bbox.py`·`probes_bbox.json`, `clearance_m411.json`, `signatures_before.json`·`bolts_before.json`(되돌리기용)

## 워크플로우 메모

- 한글 바디 이름을 넣은 MCP `batch`(inspect.measure 18~82단계)가 두 번 MCP 서버를 끊었다(앱은 살아 있음). 같은 이름 `execute inspect.clearance`는 됐다. `measure {}` 전수 1회(3,139바디, 2.7 MB)가 서명 전수 측정에 가장 빨랐다(수십 초) — 안내서 '서명'에 이 길을 적으면 full 서명이 싸진다.
- `joint.drive` 2번 + measure 18 ASCII `batch`가 약 11분(닫힌 고리 J_U4S_ROD), `motion.play REST 0`이 5분 넘음. 큰 설계에서 자세 바꾸기는 분 단위라 측정부는 계산식(트레드 원통식)으로 대신하고 한 자세만 앱에서 확인했다.
- 지시 (a)의 '앱에 남은 변경은 멈춘 실행의 잔재이니 버린다'는 v2.10.2 때 문구로 지금 열린 v2.10.4와 맞지 않아 안내서 '문서 확인'(버리지 않음)을 따랐다.
