hyeunung/FSAP/docs/reports/mechanism/mech_M02R_measure.md

# M02R 측정 (3차) — v2.10.2에서 보 고정 사각 실린더 + 그네식 스윙(C-41) 자리 재기 (측정부, 2026-11-11 3차)

요약(10줄 안):
- 대상 `3D_Modeling/FSAP_v2.10.2.sc`(config.json doc, 커밋 5bfc23e). 앱 문서가 dirty(undo 200, 멈춘 실행 잔재)라 지시 (a)대로 `new_design` → `open v2.10.2`(1,030 s, 피처 3,453, 오류 0). 끝에 dirty false·피처 3,453 확인. 저장 0.
- 서명 sigcheck `reuse`(3,132부품) → bbox·부피·질량 그대로 씀. 과제 영역 바디 표 `tools/out/mech_M02R/region_sig_v2102.json`(149바디), 프로브 결과 `probes_v2102.json`, 기하 표 `swing_geom.json`.
- **보 P_M07_BEAM X −2380~1230 · Y 120~320 · Z 250~650**(STKR400 400×200×8). U4 마운트 P_M02_BASE 윗판(Z 242~250, Y −60~200)이 보 밑면에 CB5-16 ×4로 매달려 있다.
- 비어 있는 곳(프로브 겹침 0): ① 보 밑 base 바깥 X −330~−140 · Y 200~320 · Z 40~250 ② 바퀴 +Y 옆 X −140~−85 · Y 62~120 · Z 40~160(D-163 스토퍼 자리) ③ 바퀴 위 X −140~−80 · Y ±60 · Z 162~250. ④ base 윗판 밑 +Y 쪽(X −330~−140 · Y 40~200 · Z 50~242)과 모터 위 띠(Z 160~242)는 걷어 낼 부품과 관 세움 2개(U4_B·U4_A2, (−161, 70/94))만 막는다.
- 막는 것: −Y 쪽은 base 세운 다리(X −325~−280 · Y −60~−52, 68,078 mm³)와 U6(P_M06_BASE Y −120~−97, P_M06_CARR Y ≤ −100, CJ2B16-60SZ_M06 Y −139~−121). 보 앞 Z 250 위는 Y 101.6~120 띠에 관 U6·클램프 L_6.
- 걸린 무게: 서보·감속기·바퀴·암 묶음 **5.76 kg = 56.5 N, 무게중심 (−192, −0.4, 88)**. 축 X 피벗이면 무게중심과 접지가 같은 Y(≈0)라 **바퀴에 무게 56.5 N이 거의 다 실린다 — 설정 40 N·자국 상한 51.6 N보다 크다.** 실린더는 '누름'이 아니라 '덜어 줌(들기 쪽 힘 ≥ 16.5 N 상당)'을 늘 내야 하고, 공기 빠지면 56.5 N(자국 SF 0.91). 구상이 반드시 다룰 것.
- 이미 됨? **아니오** — 모터 위 누운 CDM2C20 묶음·크랭크·J_U4_CYL_PIN/ROD/ROD_PIN이 그대로 있고, 피벗 J_U4_PRESS는 (−300, 0, 70) 축 Y(C-41이 요구하는 축 X 아님).
- 잔재 주의: 걷어 낼 목록에 없는 옛 클레비스 핀 `P_M02_CLEVIS_PIN`·`_WASHER`(축 (−161.006, y, 225))와 base의 Ø5.5 ×4·관 구멍 Ø8 ×2·ARM_TIE M5 탭 ×2도 같이 정리해야 '잔재 0'.

## 0. 측정 표·통로·시간

| 항목 | 값 |
|---|---|
| sigcheck | `{"mode": "reuse", "reason": "문서·해시가 같다", "parts": 3132}` (서명 doc = v2.10.2, pose REST step 0) |
| 앱 상태(처음) | `running` 빈 목록, 열린 문서 FSAP_v2.10.2 **dirty true, undo 200, revision 492**(멈춘 실행 잔재 — 지시 (a) "버리고 다시 연다") |
| 다시 열기 | 같은 경로 open은 디스크를 다시 읽지 않으므로(안내서 '원복') `new_design` → `open {path: v2.10.2}`. 앞서 줄 서 있던 다른 연결의 `inspect.clearance`(18바디, 805 s)가 끝난 뒤 열림 → open 약 1,030 s, features 3,453, errors 0 |
| 통로 | MCP(그 시각 CAD 부서 하나, 실행 규칙 2 "혼자 도는 읽기 부서도 MCP로 잰다"). 저장 0 |
| 프로브 | 상자 7개(솔리드 상자) + `inspect.clearance` against 90바디, 306 s |
| 원복(E-08) | `edit.checkpoint` 41이 batch 뒤 없어져(복원 거부 "no checkpoint 41") 안내서 '원복' ②대로 undo 7 → `inspect_design` **dirty false, 피처 3,453**(연 때와 같음), `motion.play REST 0` moved false |
| 근거 | E-17 "측정 표는 서명을 다시 쓴다", E-16 "판정은 수치로만", E-21 "이전 결과 파일부터" |

## 1. 과제에 걸린 부품·구동 요소 (v2.10.2, REST, 서명 값)
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
