hyeunung/FSAP/docs/reports/mechanism/mech_SIM-01_measure.md

# SIM-01 측정 — 검도 앞 확인 (측정부, 2026-11-11 3차 실행)

요약(10줄 안):
- sigcheck `reuse`(문서·해시 같음, 3,132부품) → bbox·부피·질량은 `tools/out/signatures.json` 그대로. CAD 열기 0(아래 1절 이유).
- **검도 기준 파일이 아직 없다.** 지시는 "M02R이 U4를 바꾸므로 M02R 저장본에 대고 검도한다"인데 M02R(C-41 보 고정 사각 실린더 + 그네)은 모델링 전이다: 최신 저장본은 `FSAP_v2.10.2.sc`(C-40, 사용자가 틀렸다고 정정한 모터 위 누운 실린더), M02R 완료 판정 확인 3회차는 **불합격 1항목**(회전 SF, `mech_M02R_donecheck2.md`), 새 번호 .sc 없음.
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
