hyeunung/FSAP/purchased-step/PGX62-H-10/PGX62-H-1_drawing.pdf

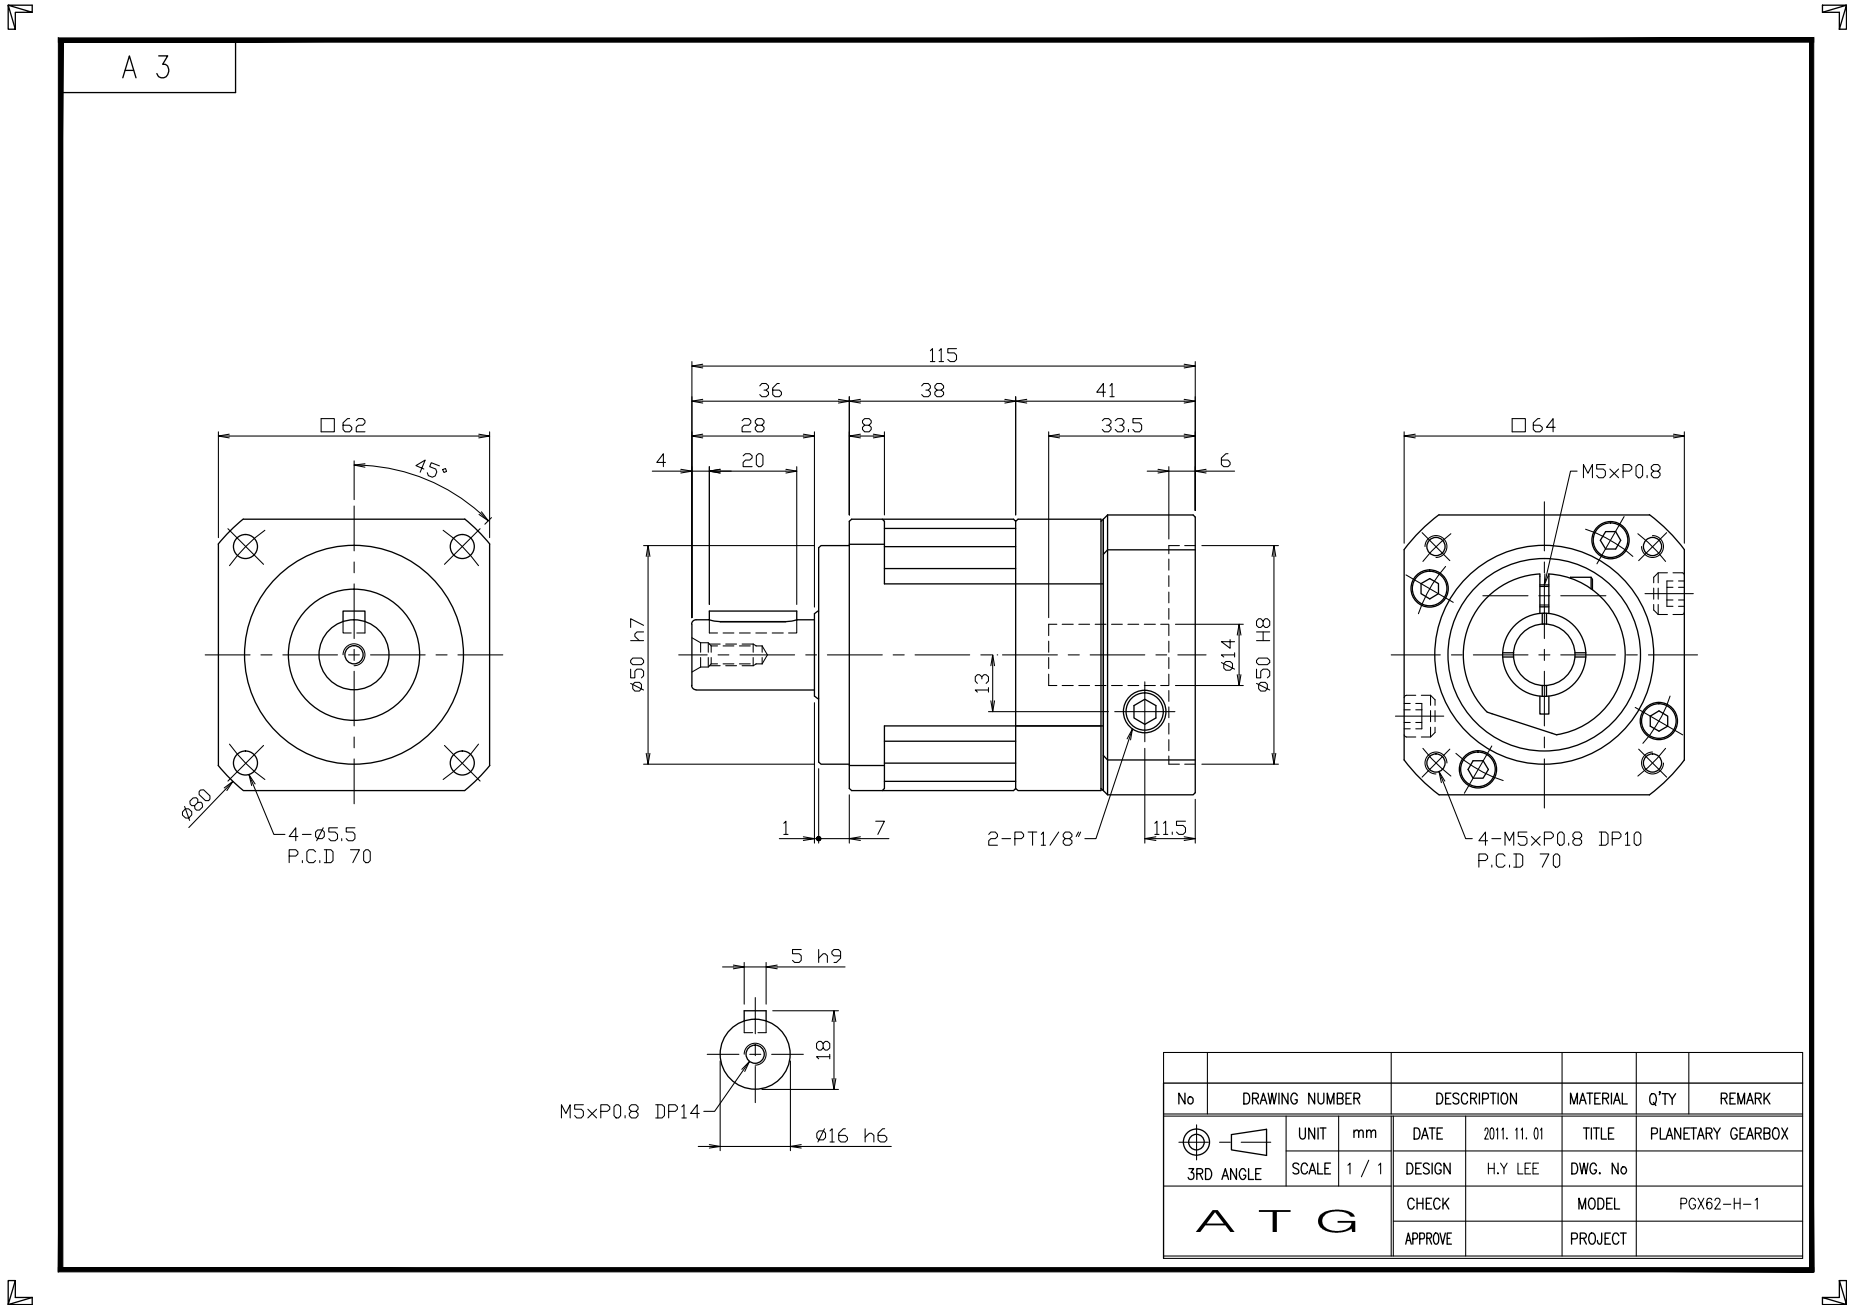
[picture p89: page 1]
