hyeunung/FSAP/(commit log)

2026-10-29 저장소를 MAT-RS-001 기구 개발 폴더로 바꿈
    FSAP에서 AI 부서를 만들려다 멈춘 6단계 구조를 정리하고, 기구 모델링 엔진
    MechDesign_Engine의 기본 배치로 바꿨다(결정로그 C-07).
    - 6단계 폴더(01_Planning~06_Business), DECISIONS.md, ADR 틀 삭제. ADR-004는 Superseded
    - README·CLAUDE.md를 기구 개발용으로 다시 씀(한글)
    - 설계 요구서 초안(과제 T01~T07), 결정로그(C-01~C-08), 자료대기(D-01~D-15),
    벤치마크·특허 조사(R375X, 만료 특허 7건) 추가
    - 엔진 배치 폴더 추가: docs/reports, tools, purchased-step, fea, deliverables
2026-10-29 v0.0.0: CAD SolidCraft로 정하고 빈 설계에서 시작
    - 결정로그 C-09: CAD는 SolidCraft
    - 빈 설계 cad/MAT-RS-001_v0.0.0.sc(단위 mm), tools/config.json(cad·doc)
    - 요구서 8-2(파일 이름·버전), 8-5(버전이 바뀔 때만 커밋·푸시), 8-6(CAD)
    - 자료대기 D-15 해결, D-16(이 컴퓨터 실행 준비) 추가
    - 엔진 폴더는 읽기만 한다는 규칙을 CLAUDE.md에
2026-10-29 v0.0.0: 사용자가 만든 3D_Modeling/FSAP_v0.0.0.sc를 시작 설계로
    - 따로 만든 cad/MAT-RS-001_v0.0.0.sc를 지우고 사용자의 파일·폴더·이름 규칙을 따른다
    - SolidCraft 잠금 파일(.~*.lock)을 깃에서 빼고 .gitignore에 추가
    - config.json doc, 요구서 8-2, README 폴더 표 수정
2026-10-29 v0.1.0: 동작 검사 준비물(고정부·조인트·동작 연구·작업 대상 모형)
    - 3D_Modeling/FSAP_v0.1.0.sc: BASE 고정, 조인트 6개(J_MAT_X·J_MAT_Y·J_MAT_ROT·J_HEAD_ROT·J_PRESSER·J_NEEDLE),
    동작 연구 대기·사이클 3개(큰·작은·홈 매트, 0-3 1~5단계)·꺾임 정밀 3개
    - 작업 대상 모형 3종 + 가공 뒤 형상 + 떨어진 조각(임시값, 자료대기 D-01~D-07·D-10·D-13 쓰는 곳 갱신)
    - 기계 부품은 없음(골격 컴포넌트만). 결정로그 P-01~P-06
    - tools/config.json doc → FSAP_v0.1.0.sc, tools/gen_motion_prep.py, tools/motion_states.json
    - 보고서 mech_prep_check.md, mech_prep.md
    - 요구서 3-2(미스미 STEP 다운로드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
2026-10-29 v0.2.0: T01 매트 잡기·회전 유닛(진공 원판 + 링1·링2, DGM200R 회전, X·Y 레일)
    - 선정 T01-C1 수정안(mech_T01_select.md 3절)대로 그림. 구매품은 STEP대기_ 임시 형상(E-10, D-17)
    - 새 컴포넌트 RING1·RING2, 조인트 J_RING1·J_RING2(slider, -60~0), J_MAT_X·J_MAT_Y 한계 변경
    - 동작 연구 7개에 링 키 추가, 새 연구 되감기
    - 전 연구 간섭: 새 겹침 0(정상 겹침: 로드-실린더 3,534 mm3, 기준선 링1-작은 매트 5,061 mm3)
    - 보고서 mech_T01_model.md, 결정로그 T01-M01~M05, 지난 구상·측정·선정·회고 문서 포함
2026-10-29 v0.2.1: T01 수정 1회차(동작 연구 회전 키 deg, 링2 t3 -> t5)
    - 생성기 gen_t01_mech.py: motion.list(rad) -> motion.study(deg) 회전 조인트 값 math.degrees (검증 A1)
    - P_T01_RING2 A5052 t3 -> t5(Z -7~-2), 띠 Z -12~-7, 링2 샤프트·로드 윗끝 -12 (해석 3절)
    - 연구 8개 motion.interference 새 겹침 0(truncated false), 빈 공간 프로브 J_MAT_Y -860/0/+40 겹침 0
    - 함께 넣음: T01 검증·해석 보고서, 손계산, 결정로그 T01-X01~X04·T01-M06~M08, 자료대기
2026-10-29 구동 T01: 매트 잡기·회전 유닛 해결(v0.2.1), BOM·설계검토서·결정로그·자료대기 D-18~D-29
2026-10-29 v0.3.0: T02 봉제 헤드 묶음 홈 진입(헤드 임시 형상, 침판·노루발 r8.5 노즈, SLA 바인더, 헤드 받침)
    - 선정 지시서(mech_T02_select.md 6절) 좌표 그대로 HEAD·PRESSER·NEEDLE·BASE에 12바디
    - 8개 동작 연구 전 구간 새 겹침 0(바늘 관통은 T02-X01 기준선 안, 최대 10.738 mm3)
    - BOM v0.3.0, 결정로그 T02-M01~M04, 자료대기 D-02·D-10·D-16·D-27·D-30·D-31
    - T02 측정·구상·선정 보고서 함께
2026-10-29 여기까지 정리: T02 해석 결과, 이어가기 메모·워크플로우 인자
    워크플로우를 T02 검증 도중에 멈추고 다른 컴퓨터에서 이어가도록 정리했다.
    - T02 해석 보고서·계산(통과, 동작 문제 0) 추가, 자료대기 갱신
    - docs/HANDOFF.md: 어디까지 했나, 이어가는 법, 사용자 결정 대기 5건
    - tools/workflow-args.json: 다음 실행 인자(T02~T07, 이번 실행에서 찾은 함정·규칙 포함)
    - README 지금 상태, CLAUDE.md 읽는 순서에 HANDOFF
2026-10-30 v0.3.1: 미스미 실물 STEP으로 구매품 22개 교체
    - HFS8-4080-1300·460·1900·580 형재 10, LHFR16 6, PSFJ16-150 6을 실물 STEP 하위 컴포넌트로 바꾸고 STEP대기 임시 형상 삭제
    - LHFR16 플랜지 밑면을 스파이더 윗면 Z -85에 얹음, 나머지는 임시 형상과 같은 자리
    - 전수 간섭: 새 부품이 낀 간섭 0, 조인트 17 정상
    - STEP 9종 purchased-step/, 생성기 tools/gen_v031_step.py
    - 결정로그 V031-01~05·C-10, 자료대기 D-17~D-31 갱신(SV2R20·ZH10DS 형번 없음, DGM200R·CJ2B16 미스미 CAD 없음)
2026-10-30 v0.3.2: T04 가장자리 센서 배치(노루발 안 영역형 반사 화이버 주머니·슬릿·통로)
    - P_T02_FOOT에 주머니 12.0x3.15x8, 검출 슬릿 11.0x1.0(바닥 관통), 화이버 통로 Ø2.6(+X 옆면 출구)을 깎음
    - 부피 15,887.24 -> 15,481.37 mm3, 검출 ③ 2,348/2,348, 간섭 v0.3.1 기준선과 같음(새 쌍 0)
    - 화이버 머리는 형번 미정(D-32)이라 그리지 않음. BOM v0.3.2, 결정로그 T04-S01~S07·M01~M04
    - T03 확인·T04 측정·구상·선정 보고서 함께
2026-10-30 구동 T04: 가장자리 센서 배치 해결(v0.3.2) — 설계검토서·결정로그·요구서·검도·손계산 해석
2026-10-30 v0.4.0: T05 테이프 공급·장력 유닛(끌려 나가는 롤 + CJ2B10-15 마찰 패드)
    - HEAD 아래 T05(평판 SUS304 t3, PET-CF 홀더·허브·캡·안내 블록, STEP대기 PSFJ16-100·CJ2B10-15),
    T05_PAD(패드·로드, J_T05_PAD 직선 Z -13.5~0, 저장 -12.5), 외피 T05_TAPE(MAT_TAPE_ROLL·PATH)
    - 6개 연구 2,443단계 겹침 0(truncated 0), 정적 겹침 0, 스윕 받침면 스토퍼 -13.49
    - 지시와 다르게 정한 곳 5개(경간 회전 부호·막대 축, 내려오는 테이프 양끝, 로드 길이, -X 옆벽, 캡 클램프): 결정로그 T05-M02~M06
    - BOM v0.4.0, 결정로그 T05-S01~S08·M01~M08, 자료대기 D-06·D-10·D-33·D-34, T05 측정·구상·선정·모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
2026-10-30 v0.4.1: T05 수정 1회차 — 테이프 유닛 평판 t3 → t5
    - P_T05_PLATE SUS304 t3 → t5(X -80~-75): 혀 뿌리 오조작 SF 0.80·0.81 → 2.16·2.23(손계산)
    - 맞대는 P_T05_HOLDER 플랜지·P_T05_GUIDE 등판 +X 끝 -78 → -80(t10 → t8). 테이프 길·롤·실린더 그대로
    - 동적 6개 연구 2,443단계 겹침 0, motion.interference clear(truncated false)
    - BOM v0.4.1(평판 뿌리 CB5-12 → CB5-14 ×2), 결정로그 T05-M09~M12, 보고서 mech_T05_model1.md
    - 함께: v0.4.0 T05 검증·해석(손계산) 보고서
2026-10-30 구동 T05: 테이프 공급·장력 유닛 해결(v0.4.1) — 설계검토서·결정로그·요구서·검도·손계산 해석 수정 1회차
2026-10-30 v0.4.2: S01 구매품 실물 STEP 교체·형재 마감캡
    - 임시 형상 28바디 → 실물 STEP: SV2RL28-1800·-1300 ×2씩(옛 SV2R20), DGM200R-AZAC(출력 테이블 MAT_ROT),
    CJ2B16-60SZ ×6, CJ2B10-15Z, PSFJ16-100, 새로 ZH10DSA-06-06-08 ×2
    - 마감캡 HFC8-4080-B ×14(드러난 끝면 전부, 빠진 끝면 0)
    - 레일 조립 높이 −14: P_S01_XSPACER ×4(t14), Y판 14 내림 + 창, P_S01_DGSPACER(U자 t50)
    - 스파이더 웹 −98.5~−95.5·보스 구멍 Ø10.5, LHFR16 −10.5, 링2 띠 자리, 안내 블록 위판 t4
    - 남은 STEP대기는 재봉 헤드 4(D-10). 결정로그 S01-M01~M10, 자료대기·BOM·보고서 갱신
    - 함께: S01 측정·구상·선정 보고서, 구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
2026-10-30 구동 S01: 구매품 실물 STEP 교체·형재 마감캡 해결(v0.4.2) — 설계검토서·결정로그·요구서·긴 동작 연구 전 단계 간섭 확인
2026-10-30 v0.5.0: T06 시작·끝 이음매와 절단 — 겹쳐 박기 + CJ2B16 단동 가위칼
    - 새 묶음 T06(P_T06_BRACKET SUS304 ㄴ t4, LHFR16_T06, STEP대기_CJ2B16-30SZ)과 T06_KNIFE(P_T06_ARM SUS304 ㄱ t3, P_T06_KNIFE SK85 t1.5, PSFJ16-100_T06, STEP대기_CJ2B16-30SZ_ROD), 조인트 J_T06_KNIFE 직선 Z -30~0
    - 침판 칼 받이 관통 홈 2x22 + C0.5, MAT_*_SCRAP -> MAT_*_SEAM·TAIL
    - 사이클 3개 ④-0~④-7 43단계, 전 단계 새 겹침 0(바디 단위)
    - BOM v0.5.0, 결정로그 T06-M01~M10, 자료대기 D-07·D-10·D-37, 보고서 mech_T06_*
2026-10-31 구동 T06: 시작·끝 이음매와 절단 해결(v0.5.0) — 설계검토서·결정로그·요구서·자료대기·BOM 비고·검도·손계산 해석
2026-10-31 v0.5.1: T06-X03 이음매 겹 층 SEAM 단면 수정(SEAM ↔ BOUND 겹침 0) — T07 측정·구상·선정 보고서·결정로그·자료대기 함께
2026-10-31 v0.6.0: T07 로딩·배출 — 작업자 쪽 고정 가드틀(형재 8·마감캡 4·SUS304 t2 평판 3), 커튼·자동 배출 자리 검사 상자
    새 조인트 0, 동작 연구 변경 0, 8개 연구 새 겹침 0. 설계검토서·BOM·결정로그 T07-M02~M07·자료대기 D-13·D-38~D-41.
2026-10-31 구동 T07: 로딩·배출 결과(v0.6.0 pass) — 설계검토서·결정로그·요구서·자료대기·검도·손계산
2026-10-31 v0.6.1: S02 STEP 대기 마무리 — 1580 임시 상자 끝 캡 끼움 8 비움(갈래 B)
    - 구매부가 CJ2B16-30SZ·HFS8-4080-2850·-680·-1580 STEP을 또 못 받음(미스미 로그인 풀림) → STEP대기 유지
    - STEP대기_HFS8-4080-1580_PL/PR Z −680~900 → −672~892(S02-S03), 캡 4쌍 맞닿음 0.0·판정 불가 0
    - 조인트·동작 연구 변경 0, 정적 전수·8개 연구 겹침 0
    - S02 측정·구상·선정·모델링 보고서, 설계검토서 v0.6.1, BOM v0.6.1, 결정로그 S02, 자료대기 D-37·D-41
2026-10-31 구동 S02: 결과 기록 — 1580 상자 축소만 적용, 4종 STEP 미수령(login: false)으로 일부 해결
2026-10-31 회고: mech_2026-10-31_S01-T06-T07-S02 — 개선후보 신규 WF-084~091, 반복 WF-080·082·083
2026-10-31 실행 기록: mech_2026-10-31_S01-T06-T07-S02
2026-10-31 v0.6.2: 디테일링 DP-1 헤드 둘레 — T06 칼 팔 절삭 L·체결 16품·노루발 A6061-T6
    - P_T06_ARM 판금 L t3 → SUS304 절삭 L(가로 t5·세로 t3), 축 자리 Ø16 깊이 2 + 축 볼트 + 맞춤핀 Ø3 구멍(D-43)
    - 체결: 실물 CB5-12 ×5, STEP대기 CB4-16 ×4·LBNR4 ×4·LBNR5 ×2·NTJ-015C 1
    - PSFJ16-100_T06 → STEP대기_PSFJT16-100-M5(끝 Ø4.2×12 + 핀 Ø3×6)
    - 30SZ 로드 Z49~99 + 임시 튜브 Ø5.4(T06-D01), 헤드 M5 기초 구멍 ×2(D-10)
    - P_T02_FOOT Rigid 10K → A6061-T6, 통로 입구 모따기, 안 모서리 R0.5
    - STEP대기 구매품 part_number 묶음(P-02), BOM v0.6.2(가공법 칸, 같은 형번 한 행), 설계검토서 v0.6.2
    - 함께: 디테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
2026-10-31 v0.6.4: 디테일링 DP-1 수정 1회차 — 맞춤핀 MS3-8(STEP 대기)·노루발 모따기 0.05 턱 없앰
    - v0.6.3: 미스미 MS3-8 형번 확인, STEP대기_MS3-8_T06(Ø3×8) 넣어 빈 핀 구멍 0
    - v0.6.4: P_T02_FOOT 통로 입구 모따기 시작을 주머니 끝벽 면에 맞춤(턱 면 0.05 → 같은 면)
    - 면 법선 살 두께 최소 1.018 ≥ 1.0, 8개 연구(홈매트 2분할) 새 쌍 0, truncated false
    - 조인트·행정·배치 변경 0. STEP 대기 그대로(미스미 로그인 풀림)
2026-10-31 v0.6.5: 디테일링 DP-1 수정 2회차 — 맞춤핀 MS3-8 카탈로그 외형(R=D·15°)·SUJ2, 칼 행정 sweep 잎 분할
    - STEP대기_MS3-8_T06: 미스미 외형도대로 한끝 R3, 다른 끝 15° ℓ1 1.0, 재질 SUJ2(58HRC~) — D-43 재질 확인
    - joint.sweep J_T06_KNIFE를 잎 컴포넌트로 나눠 헤드·T05·T06 잎 전부 멈춤 없음(DL-D31)
    - E-03 9개 연구 새 겹침 0, truncated false
    - STEP 대기 7종은 미스미 로그인 풀림(login: false)으로 그대로
2026-10-31 디테일링 DP-1: v0.6.5 최종 통과 — 맞춤핀 지압·놀음 기록, 볼트 지름 정리(M5 기본, 예외 M4·M6·M10)
2026-10-31 v0.6.6: 디테일링 DP-2 T01 회전 묶음 — 허브 t8·스파이더 A5052 판금 모자형·링/원판 매트 면 R1·링–축·LHFR16·기둥·원판 체결
    - 허브 SUS304 t6 → t8(Z −241~−233), DG 테이블 Ø6.6 ×6·발 M5 탭 ×12·기둥 M5 탭 ×3
    - 스파이더 1~3 A5052 t3 판금 모자형(바깥 발 22, 안 R3, sheet.convert 전개, 구멍–굽힘 최소 8.25)
    - 기둥 2 짧게 + 밑·위 플랜지 일체, 원판 R1 + MBIS5-6.5-8 ×3, 링1·링2 매트 면 R1·축 체결 자리
    - 체결: 실물 CB5-12 ×15·CB5-16 ×9, E-10 CB4-16·LBNR4 ×24, CB6-18 ×6, PSFJT16-150-M5 ×6
    - LHFR16 구멍 대각(45°·−15°·+15°, DL-D36), NTJ 이름 A·B
    - E-03 9연구 새 겹침 0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
2026-10-31 v0.6.7: 디테일링 DP-2 수정 1회차 — LBNR4 24 → 웹 밑 M4 탭 너트판 6(물림 6), 스파이더 발 누름판 t6 + CB5-18(STEP 대기), 기둥 밑 플랜지 t12·카운터보어
2026-10-31 디테일링 DP-2: v0.6.7 최종 통과 — 너트판 M4 탭(물림 6)·발 누름판·기둥 t12, 조임 CB5-18 5 N·m·CB4-16 2.0 N·m
2026-10-31 v0.6.8: 디테일링 DP-3 T05 테이프 공급 — 체결 16자리 실물 STEP(CB5-16 ×8·CB5-20 ×2·MBIS5-6.5-8 ×4), 홀더 Ø11·귀 Z229, 패드 Z63 NTJ T홈, 안내 블록 앞벽 t9.2·R3·R1
2026-10-31 v0.6.9: 디테일링 DP-3 수정 1회차 — T05 허브 렌치 구멍 Ø9 ×4
    - P_T05_HUB +X 면에 렌치 구멍 Ø9 ×4 깊이 10(홀더 CB5-16 ×4와 같은 축, r 28.28)
    - HD_1~4 렌치 프로브 Ø8.5×30 겹침 0(M-01), 살 5.22·15.63(M-03)
    - 동작 연구 9개 충돌 0·truncated false, 조인트·행정·배치 변경 0
    - BOM v0.6.9(정비 비고), DP-3 검증·해석 보고서와 손계산 함께 올림
2026-10-31 v0.6.10: 디테일링 DP-3 수정 2회차 — T05 허브 구멍 위상 표시 홈 ×4, 허브 심 손계산, 검토서 정비
    - P_T05_HUB 플랜지 테두리 홈 폭 1.2 × 깊이 0.8 ×4(0°·90°·180°·270°, 홀더 위 클램프 틈에 맞춤)
    - 허브 심 손계산(해석 못 함 — D-16): 오조작 전단 SF 2.47, 비틀림 9.95
    - 설계검토서 v0.6.10 정비 절 선기재, BOM v0.6.10
    - 동작 연구 9개 충돌 0·truncated false
2026-10-31 디테일링 DP-3: v0.6.10 최종 통과 — T05 체결 16자리 M5, 허브 렌치 구멍, 귀 클램프 1.2 N·m
2026-10-31 v0.6.11: 구동 T08 — X 블록 장착 통판, 460 +Y 43, 받침 4 지움, CB5-16·CB5-20 ×8
    - HFS8-4080-460_F·_B(캡 포함) +Y 43, P_S01_XSPACER_1~4 지움
    - P_T08_XPLATE_F·_B A5052 460×87×14(블록 위·460 밑 카운터보어)
    - 실물 CB5-16_T08_XB ×8, CB5-20_T08_XN ×8, STEP대기_HNTT8-5_T08 ×8(D-41)
    - 렌치 프로브 16자리 이웃 겹침 0, 동작 연구 8 + 분할 2 충돌 0
    - 결정로그 T08-M01~M08, BOM·설계검토서 v0.6.11, 자료대기 D-41
2026-10-31 구동 T08: 검도 pass·손계산 반영 — 블록 8 = BOM, 렌치 결함 0, 간섭 0, X 블록 롤 SF 1.75 디테일
    - 결정로그 '구동 T08 결과'(T08-R01~R06, 디테일 과제 4건)
    - 설계검토서 v0.6.11 검도·강도·못 한 것 갱신, 요구서 T08 해결
    - 자료대기 D-41, BOM 비고, 해석 케이스·결과
2026-10-31 v0.6.12: 구동 T09 칼 팔 축 배치 — LM 가이드 SSE2BZ12-120, 실린더 X 24 동축, GBASE·ARM 절삭 한 바디
    - 축 PSFJT16-100-M5·LHFR16·MS3-8·판금 브래킷·옛 팔과 체결 11개 지움
    - P_T09_GBASE(A5052)·P_T09_ARM(SUS304), 실린더·로드·NTJ (24, -89.5)
    - CB5-16 x3(GB3는 칼 내림 중 충돌로 Z 125), STEP대기 CB3-8 x8·CB3-10 x5(D-44)
    - 침판 칼 홈 +X 벽 24.90
    - 칼 행정 31자세·이음매 11단계 새 겹침 0, floating 0, matcheck 0
    - 결정로그 T09-M01~M09, 자료대기 D-37·D-44, 보고서 mech_T09_*
2026-11-01 v0.6.13: 구동 T09 수정 1회차 — J_T06_KNIFE 원점 (24,-62.5,45), GBASE·ARM 모서리 R1/C0.5 스케치 띠 마감
2026-11-01 구동 T09: 칼 팔 LM 가이드·실린더 X 24 동축 결과 문서 — T09 해결(v0.6.13), 맞날 틈 0.097·오조작 SF 2.26, 모서리 마감 3건 디테일링으로
2026-11-01 v0.6.14: 구동 T10 — T05 실린더·패드 X +4.10(패드 중심 -126.90, 테이프 중심 차 0.0025), 위판 구멍 이동, 외피 끝 자름, T15 SNJ 스패너 자리 과제 추가
2026-11-01 구동 T10: T05 패드 테이프 중심 맞춤 해결(차 0.0025, 동작 연구 8개 간섭 0) — BOM·설계검토서 v0.6.14, 결정로그 결과
2026-11-01 v0.6.15: 구동 T11 링 실린더 배관 길 — 기둥 장공 ×3, 스파이더·Y판 결속 구멍, KQ2L04-M5A 임시 형상 ×6, J_MAT_ROT 한계 -360~0
    정적 겹침 0, 동작 연구 4개 clear(truncated false), floating 0, matcheck 불일치 0.
    330도 장공은 기둥 속 조각 면 때문에 Ø40.2 다시 깎은 뒤 냄(DEV-2).
2026-11-01 구동 T11: 링2 포트 배관 길 해결(v0.6.15) — BOM·설계검토서, 결정로그 결과, 자료대기 D-45~47
2026-11-01 v0.7.0: 구동 T12 옆·뒤 커버 — 형재 16(STEP 대기)·캡 4·SUS304 t2 판 10·판금 정비 문, J_T12_DOOR 0~100도
    정적 겹침 0, 7개 연구 clear(truncated false), 문 sweep 최소 틈 1.22, floating 0, matcheck 불일치 0.
    기존 부품·동작 연구 키 변경 0. 형재 6길이는 미스미 로그인 풀림으로 E-10 상자.
2026-11-01 구동 T12: 옆·뒤 커버 해결(v0.7.0) — BOM·설계검토서, 결정로그 결과, 자료대기 D-48·D-49
2026-11-01 v0.7.1: T12 옆·뒤 커버를 구동에서 뺌 — v0.6.15와 같은 형상
    커버는 기구 동작과 무관한 외장이라 구동 과제에서 뺐다(사용자 2026-11-01).
    요구서 T12·자료대기 D-48·D-49 보류, 결정로그 V071-01~04, 실행 규칙 14.
    엔진 v3.3.0으로 다시 시작하기 전 기준 버전.
2026-11-01 v0.7.2: T07 고정 가드틀을 뺌 — 기구 동작과 무관한 외장
    컴포넌트 T07(형재 8·캡 4·스커트 판 3)을 SolidCraft MCP로 지웠다.
    BOM v0.7.2, motion_states t07_zones 지움, 요구서 T07 비고, 자료대기 D-41 보류,
    결정로그 V072-01~03. 남은 바디 대조 결과 외장은 더 없다.
2026-11-01 v0.8.0: 구동 T18 X·Y 볼나사 이송 유닛 — 유닛·커플링·형재 실물 STEP, 축·서보 STEP 대기, SUS 브래킷 6
    - 볼나사 길이 실측으로 BSS2020-1240·BSS2520-1443(STEP 대기), BSW20 4구멍 때문에 받침판 t15(X 축선 -555)
    - 커플링 SCXW46(GCPW39 형번 없음), 리지드 4묶음 + STEP 하위 16, floating 0, 새 조인트 0
    - 연구 S18_XY·S18_Y·S18_X 새 겹침 0, 렌치 프로브 46 겹침 0
2026-11-01 구동 T18: X·Y 볼나사 이송 결과 문서 — BOM·설계검토서 v0.8.0, 결정로그 T18-R01~R05·디테일 14, 자료대기 D-55·D-56
    - 행정 그대로, 전 연구 간섭 0, 위험 속도 SF @280 2.05·2.02(D-52 사용자 결정)
    - 남음: 오조작 2364 N에서 YNB·XNP 항복(T18-X04 기각), STEP대기_ 6형번 → 요구서 T18 일부
2026-11-01 v0.8.1: 구동 T15 T05 SNJ 스패너 자리 — 안내 블록 천장 Z76.5~80.5 + 너트 틈 Z80.5~85.5, 패드 C2 ×2
    - P_T05_GUIDE 103,027.8 mm³(bbox 그대로), P_T05_PAD 9,624.6 mm³. 새 부품·볼트·조인트 0
    - 스패너 21×4 0°·±15/30/45° 겹침 0, 포트 0.5, 패드 틈 0.3/0.3/0.0, T05 간섭 0
    - 앞벽 오조작B 두 변 SF 3.80(손계산), 결정로그 T15-M01~M03, 자료대기 D-57
    - 함께: T13·T15 측정·구상·선정 보고서, 구매품 STEP(T18 받은 것), 문서 변경
2026-11-01 구동 T15: v0.8.1 결과 문서 — BOM·설계검토서, 결정로그 T15-R01~R03, 요구서 T15 일부
2026-11-01 v0.8.2: 구동 T14 회전부 높이 사슬 — Y판 t15→t10, DG 받침 50→55
    - P_T01_YPLATE Z −370~−360(t10), M5 탭 관통(탭 관통 + 상자 자르기, offset_face 두께 0 막 회피)
    - P_S01_DGSPACER Z −360~−305(H55), 매트 밑면 Z 0·진공 면·DG 테이블 그대로
    - 정적 겹침 0, 동작 연구 7개 새 겹침 0(truncated false), 손계산 SF 6.21/3.29
    - 결정로그 T14-S01~S06·T14-M01~M04, BOM v0.8.2, 생성기 tools/gen_t14_mech.py
2026-11-01 구동 T14: v0.8.2 결과 문서 — BOM·설계검토서, 결정로그 T14 결과·디테일 3, 요구서 T14 해결
2026-11-02 v0.8.3: STEPSWAP HNTT8-5 실물 교체 — T08 T너트 STEP대기 ×8 → 미스미 STEP
    - STEP대기_HNTT8-5_T08_1~8 지움, HNTT8-5_T08_1~8(MAT_X, 460 밑 홈 Z −555.5~−546.5) 넣음
    - 새 겹침 0, J_MAT_X ±620 따라 움직임, floating 0, CB5-20 물림 8.5 ≥ 7.5
    - 루트 이름 FSAP_v0.6.15 → FSAP_v0.8.3, config doc v0.8.3
    - BOM v0.8.3, 자료대기 D-41, 결정로그 STEPSWAP-M01·M02, 보고서 mech_STEPSWAP_model.md
    - 함께: 멈춘 실행의 문서(T17 측정·구상, 실행 규칙, 엔진 후보, 시간 실측)
2026-11-02 구동 STEPSWAP: v0.8.3 결과 문서 — 설계검토서, 결정로그 결과, 요구서 STEPSWAP 해결
2026-11-02 v0.8.4: 구동 T18-X04 X·Y 너트 하중 경로 강화 — YNB·XNP A6061 절삭, 너트 볼트 고리 탭
    - P_T18_YNB: SUS304 판금 L t8 → A6061-T6 절삭 cap + 고리(t12, Ø48, M5 탭 x4)
    - P_T18_XNP: SUS304 평판 t8 → A6061-T6 절삭 옆판 + 밑판 + 고리(t17, Ø54, M8 탭 x4), +X 면 178 그대로
    - Y 너트 CB5-20 x4·X 너트 STEP대기_CB8-25 x4 뒤집음(물림 11.5·17), YNB→Y판 CB5-16 x2 옮김 + CB5-20 x2
    - XNP 옆판 CB5-20 + HNTT8-5 4 → 14조, Y판 옛 탭 피처 지움·새 구멍 4
    - 새 겹침 0(J_MAT_X·J_MAT_Y 13자세), 렌치 프로브 26 겹침 0, 끝 틈 X 13·6 / Y 117·70.5, floating 0
    - 루트 이름 FSAP_v0.8.4, config doc v0.8.4, BOM v0.8.4, 결정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
2026-11-02 구동 T18: v0.8.4 결과 문서 — 설계검토서, 결정로그 T18 결과·디테일 7, 요구서 T18-X04 해결, 손계산 케이스
2026-11-02 v0.8.5: 구동 T17 진공 배관 회전부 건너기 — 이젝터 MAT_Y 이동, 관 클램프·기둥 안내·원판/링1 포트
    - 이젝터 ZH10DSA x2(실물 STEP) X축 180도 뒤집어 DG 받침 ±X 면, BASE -> MAT_Y
    - Y판 Ø10 x2·M5 관통 탭 x4(±54, 사각 창 실측으로 옮김), DG 받침 M3 탭 x4
    - 기둥 벽 Ø8·안내 갈래 C 2·θ270 리브 + 연속 C홈(한 바디), 원판 MBIS 자리 + Ø3, 링1 M5 탭 + Ø3
    - 새 P_T17_TCLAMP_1/_2(PET-CF), CB5-12 x4, MBIS5-6.5-8, STEP대기_KQ2H06-M5A x2
    - 관 경로 상자 t17_routes, 조인트·행정·연구 변경 0, 과제 안 검사 새 겹침 0
    - T17 측정·구상·선정 문서와 결정로그·요구서 7절·CHANGELOG
    Co-Au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
2026-11-02 v0.8.6: 구동 T17 수정 1 — 기둥 리브 뿌리 R2 형상으로 직접, 자료대기 D-58~D-61, BOM v0.8.6
2026-11-02 구동 T17: v0.8.6 결과 문서 — 설계검토서, 결정로그 T17 결과·디테일 T17-V1, 요구서 T17 해결
2026-11-02 v0.9.1: 구동 T16 X·Y 이송 배관·케이블 캐리어 — 밸브 매니폴드 MAT_Y, 분기 받침, Y·X 캐리어(STEP대기) 받침·홈통·미끄럼판
2026-11-02 구동 T16: v0.9.1 결과 문서 — 설계검토서, BOM v0.9.1, 결정로그 T16 결과·디테일 T16-V1~V8, 요구서 T16 일부, 자료대기 D-62~D-74
2026-11-02 v0.10.0: 구동 T19 바닥틀 다리·조절발 — 다리 HFS8-4080-138(STEP대기) 8, HBLFSN8 18, SUS304 받침판 8, M16 레벨링 마운트(STEP대기) 8, 작업 높이 900 임시
2026-11-02 구동 T19: v0.10.0 결과 문서 — 설계검토서, BOM v0.10.0, 결정로그 T19 결과·디테일, 요구서 T19 일부(렌치 결함 18 → 구동 후보 T19-K1), 자료대기 D-75 정격 12.6 kN·D-56 보탬
2026-11-02 v0.10.1: 구동 T13 헤드 받침 비틀림 상자 — P_T13_SLEEVE(SUS304 t2 판금, 치마), P_T13_REAR, P_T13_FBL_T1/T2, CB5-12·HNTT8-5 각 30(실물 STEP)
    정적·9자세 겹침 0, 렌치 프로브 결함 0, floating 0, 흔들림 보수 0.290 ≤ 0.657(D-08 임시)
2026-11-02 구동 T13: v0.10.1 결과 문서 — 설계검토서, BOM v0.10.1, 결정로그 T13 결과·디테일 T13-F1/F2, 요구서 T13 해결, 손계산
2026-11-02 엔진 v3.6.0 반영: 요구서 0-8 전체 구동 개념(초안·미확립), CLAUDE.md 시작 순서 줄, 과제 ↔ 유닛 연결
2026-11-02 실행 규칙 10: 구매품 STEP은 공용 창고 PartsLibrary 먼저 찾고, 새로 받으면 창고에도 넣기
2026-11-02 v1.0 개념 재수립 문서: 구동 개념 대화 기록·사진·행정 계산, 요구서 0-8 초안(벤치마크 우선), 결정로그 C-12~C-24, 자료대기 v1.0 임시값, 벤치마크 2차 조사, 전체 회귀 상한 규칙 16, 엔진 요청문
2026-11-02 엔진 v3.7.0 맞춤: 0-8-3 유닛 표 벤치마크 두 칸 형식, 6-4 전체 회귀 상한, 실행 규칙 16은 엔진 regrun으로, WF-153 반영 표시
2026-11-02 v1.0 시작 준비: 요구서 0-8 확립(사용자 동의), v0.x를 archive_v0로 동결, 과제 N00~N08, 실행 규칙 17, full_run 인자
2026-11-02 v1.0.0 준비부: 빈 설계에서 동작 검사 준비물(고정부·조인트 5·매트 모형 3장·가공 뒤 형상·동작 연구 6·기계 정의)
    - 3D_Modeling/FSAP_v1.0.0.sc 새로(new_design, 문서 이름 FSAP_v1.0.0, MCP)
    - 조인트 J_U4_X·J_U4_Y·J_U3_ROT·J_U1_PRESSER·J_U1_NEEDLE(유닛 컴포넌트는 빈 상태, 형상은 N00부터)
    - 매트 1500x1500·300x200·1200x1200 U홈 25x150 R12.5, 테이프 띠·이음매 겹
    - 연구 REST·CYCLE_L·CYCLE_S·CYCLE_G1·CYCLE_G2·REWIND_EMPTY, 원판 행정 0-8-5와 ±0.4 %
    - tools/machine.json(상태 19), tools/gen_v1_prep.py, 자료대기 쓰는 곳·D-78
2026-11-02 v1.0.1 구동 N00 전체 골격: 유닛 차지 공간 상자 26개(U1~U9), 고정 7컴포넌트 REF_GROUND 리지드, U5 에어 테이블을 U4_X와 리지드
    - 정적 겹침 기계끼리 0, 연구 5개 motion.interference 기준선만(truncated 0), floating 0
    - 정한 치수: 기계 3150x3115x1580, 브리지 Z 125, 원판 r60·중심–바늘 최소 100, 작업면 900(D-79)
    - 생성기 tools/gen_v1_n00.py, machine.json 유닛·기준선, 결정로그 N00-S01~S08·N00-M01
    - N00 구상·측정·선정·STEP 대기 보고서 함께
2026-11-02 구동 N00: 전체 골격 v1.0.1 문서(BOM·설계검토서·결정로그 결과·요구서 N00 해결·자료대기 D-80)
2026-11-02 N00 구동부 최종 보고(엔진 v3.7.1)와 요구서 5절 구동 후보 DC-01~DC-06
2026-11-02 회고: mech_2026-11-03_N00 워크플로우 개선 후보 WF-170~173
2026-11-02 실행 기록: mech_2026-11-03_N00
2026-11-02 v1.0.2 구동 N01 U1 헤드 개조 + 좁은 홈 묶음(N01-C3 수정안)
    - STEP대기_867-392342_UPPER·NOSE·LOWER(D-10), 노루발 P_N01_FOOT(S45C 밀링), 카세트 X ±11
    - CYCLE_G1 528단계(홈 바닥 땀 피벗 10×18°), CYCLE_G2 그대로
    - 정적·9자세·연구 38자세 새 겹침 0, 묶음 폭 22 < 25
    - 생성기 tools/gen_v1_n01.py, machine.json, 결정로그 N01-M01~M03, 자료대기 D-80
    - 1라운드 남은 문서(N01 구상·측정·선정, drive_check, regression) 함께
2026-11-02 구동 N01: v1.0.2 결과 문서(BOM·설계검토서·결정로그·요구서 N01 해결·자료대기 D-81·검도·손계산)
2026-11-02 v1.0.3 구동 DC-05 아랫유닛 구동 자리 이동(DC-05-C1-R)
    - 옛 U1_LOWER_DRIVE 상자 지움 → U1_LOWER_LINK 각관 90x60 t4(X 30~650), U1_LOWER_STAND 받침, U1_LOWER_DRIVE 끝판 t4, STEP대기_MHMF042L1U2M(D-81 임시)
    - U5_TABLE 두 홈 -X 끝 40 연장, U4_X_BEAM +X 면 10 깎음
    - J_U4_X -200~1250(Y 0)·J_U4_Y -400~1200(X 0) 스윕 접촉 0(최소 10), 사이클 23자세 새 바디 겹침 0
    - machine.json U1_HEAD parts·xy_forbidden(N03 소프트 리밋), 생성기 tools/gen_v1_dc05.py
    - DC-05 구상·측정·선정·모델링 보고서, 결정로그 DC-05-S·M, 자료대기 D-81
2026-11-02 v1.0.4 구동 DC-05 수정 1회차: 테이블 홈·X 빔 자르기를 컴포넌트에 넣기 전 피처로 옮김
    - v1.0.3 Box51~53(움직이는 컴포넌트 안 자르기, 월드 고정) 지움
    - N00 Box30(빔 X -1050~-760)·Box33(바늘 홈 -1292.5)·Box34(기둥 홈 -762.5) 치수 고침
    - J_U4_X -200~1250 부피 일정, 1250에서 틈 10, 스윕·사이클 25자세 겹침 0
    - DC-05 검증·해석(손계산) 보고서 함께
2026-11-02 구동 DC-05: v1.0.4 결과 문서(BOM·설계검토서·결정로그·요구서 DC-05 해결·자료대기 D-81)
2026-11-02 v1.0.5 구동 DC-04 정비 면·카세트 인출 안내(DC-04-C3 고친 안)
    - U2_BASE +X 정비 포켓 X 500~975·Y 60~700 (바닥틀 U자)
    - 새 U8_GUIDE: P_DC04_HANGER(SUS304 t3 판금), STEP대기_SSEB13-560 레일, STEP대기_IXP-M8, CB5-12 x3(실물 STEP)
    - U8_CASSETTE에 블록·P_DC04_CARRIER(SUS304 t4 판금), 리지드 대신 J_U8_PULL(slide +X 0~511, 손)
    - 연구 MAINT·REST 키, machine.json 상태 MAINT·MAINT_CAS, N01 월드 고정 자르기 정리
    - 새 바디 겹침 0(과제 범위 자세), MAINT 서는 자리·팔 길·카세트 길 0, 스윕 0~511 접촉 0
2026-11-02 구동 DC-04: v1.0.5 결과 문서(BOM·설계검토서·결정로그·요구서 DC-04 해결·자료대기 D-84·검도·손계산)
2026-11-02 v1.0.6 구동 N02 U3 진공 원판 + 회전 조향(N02-C3 고친 안)
    - U3_PLATE·U3_COLUMN·U3_DRIVE 지움, 원판·축·칼라·하우징·누름 링·씰 슬리브·판금 틀·모터 받침 새로
    - STEP대기_ 7형번(AZM66AC-PS25·CRBH5013·HTPA60/20S5M150·HTBN635S5M-150·KQ2H06-M5A·JIS P25), ZH10DSA·CB5 실물 STEP
    - J_U4_X 한계 1217.5, machine.json 유닛 부품·기준선, 자료대기 D-85
    - 과제 범위 10자세 겹침 0, J_U4_X 스윕 접촉 0(최소 16.0)
2026-11-02 v1.0.7 구동 N02 수정 1회차: 진공 관 길(벽 구멍 X -855·Z -170, KQ2L06 엘보, 관 TU0604 R15)
2026-11-02 구동 N02: v1.0.7 결과 문서(BOM·설계검토서·결정로그·요구서 N02·DC-02·DC-06 해결·자료대기 D-86·검도·손계산)
2026-11-02 구동 DC-02: 이미 해결 확인
2026-11-02 구동 DC-06: 이미 해결 확인
2026-11-03 v1.0.8 구동 N03 U4 X·Y 따라가기 받침(N03-C1 고친 안)
    - U4_RAIL_A·B 지움, SV2RL28-1800 ×4 실물 STEP(X·Y 레일·블록), U4_X_BEAM 리브 보, U5_POST 밑 -288
    - X·Y 벨트 서보 STEP대기_ 6형번(MHMF082·MHMF042·HTPA28·HTPA25·S5M 오픈 벨트 2), 판금 브래킷·물림
    - CB5-20 x136·CB5-16 x2·CB5-12 x2 실물 STEP, J_U4_Y 한계 -355~1155, machine.json 유닛·기준선·xy_forbidden
    - 과제 범위 5자세 겹침 0, J_U4_X·J_U4_Y 전 행정 스윕 접촉 0
2026-11-03 구동 N03: v1.0.8 결과 문서(BOM·설계검토서·결정로그·요구서 N03 해결·자료대기 D-87·검도·손계산)
2026-11-03 v1.0.9 구동 DC-03 X·Y 케이블 베어 자리(DC-03-S, C3 고친 안)
    - U4_FIX: X 홈통 P_DC03_XTROUGH(SUS304 t2 판금) + STEP대기_E4.56.10.150.0(눕힌 고리 차지 띠) + CB5-12 x6
    - U4_X: P_DC03_XMOV(SUS304 t3 U) + P_DC03_YTRAY(SUS304 t2, 걸이 탭 일체) + STEP대기_2400.05.075.0 + CB5-12 x6
    - U4_Y: P_DC03_YMOV(SUS304 t3) + CB5-12 x2, U2_BASE·보·대차 M5 탭 14
    - 새 조인트 0, 리지드 3묶음, floating 0. 8자세 과제 범위 겹침 0, REST 유닛 안 겹침 0
    - 자료대기 D-88, machine.json 유닛, 생성기 tools/gen_dc03.py
2026-11-03 v1.0.10 구동 DC-03 수정 1회차: YMOV 다리 ㄷ 보강
    - P_DC03_YMOV 다리 양 옆 -X 15 옆판(Z -230 위) + 다리 릴리프 메움·보강 플랜지 모서리 용접
    - 오조작 SF 0.69 -> 3.98(손계산), 8자세 clearance 겹침 0
    - DC-03 검증·해석 보고서와 손계산 함께 넣음
2026-11-03 v1.0.11 구동 DC-03 수정 2회차: YMOV 옆판을 다리 아래 끝 Z -258까지
2026-11-03 구동 DC-03: v1.0.11 결과 문서(BOM·설계검토서·결정로그·요구서 DC-03 해결·자료대기 D-88·검도·손계산)
2026-11-03 v1.0.12 구동 N04: U5 에어 테이블(허니컴 판·사슬 보관·꼬리 멈춤·안장·꼬리판·블로어)
    - U5_TABLE·U5_POST_1~4 지움 → P_N04_PANEL(Al 허니컴, 홈 3·턱·솔 주머니)·목 인서트·STEP대기_HFS8-4080-248 ×4·사슬 보관 3·STEP대기_CDJ2B16 ×3·받침 3·멈춤 블록 4·송풍 입구
    - U4_Y 안장·감개 2, U1_HEAD 꼬리판·받침, 바닥 STEP대기_VB-004-E2·받침판
    - 매트 받침 4개 연구 안 받친 단계 0, 과제 범위 20자세 겹침 0(제어 금지 1자세 제외), 스윕 stopped_at null
    - 결정로그 N04-M01~M05, 자료대기 D-89, machine.json xy_forbidden 추가, 생성기 tools/gen_v1_n04.py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
2026-11-03 v1.0.14 구동 N04 수정 1회차: 사슬 앞끝·꼬리 멈춤 슬라이더, 보관 넓힘, A 통로, 받침 보강
    - 검도 P1 보관 안내 P/N 바깥 X -970~-830(안쪽 137), P2 판 A 꺾임 통로 + 보관 A X -1272.5까지(Y 케이블 베어 자리 따냄)
    - 해석 받침: CYLBKT_P/N SUS304 t4, CYLBKT_A 통 블록 t8 + 받침판 60, 안장 다리 폭 100
    - PM 예외 판정 N04-E01·E03: 앞끝 바디 3 + J_N04_CH_P/N/A, 로드·패드 + J_N04_STOP_P/N/A, 연구 7개 키 다시 씀(gen_N04_chain_keys.py)
    - 고정 프로브 tools/gen_N04_chain_probe.py(N04-E02): 보관 길이 부족 33자세 발견 -> 다음 구동 후보(N04-F06)
    - 20자세 겹침 0(금지 구역 1자세 제외), cov_hy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
2026-11-03 v1.0.15 구동 N04 수정 2회차: 보관 U턴 2층·꼬리 멈춤 옆 이전, 안쪽 끝 막대 슬라이더
    - 바깥 사슬 보관 P/N U턴 2층(위층 턱 Y ±1430~1528.5 없앰, 끝벽, +X 옆벽 꼬리 러그 홈): 프로브 보관 넘침 33자세 → 0 (N04-F06·F07)
    - 꼬리 멈춤 CDJ2B16-110 P/N을 보관 밖 옆(X -828~-808, Y ±779~919)으로, J_N04_STOP_P/N ±Y로 다시 만듦, 받침 t4 L (N04-F08)
    - 열림 앞끝 ±57 → ±55(행정 110) (N04-F09)
    - 안쪽 끝 막대 NP/PN 바디 + U5_BAR_NP/PN + J_N04_BAR_NP/PN, 판 +X 벽 홈 2에 물려 멈춤 (PM 판정 N04-E05·E07, N04-F10)
    - 바깥 앞끝 L_f 76.5, 연구 7개 키 다시 씀 (N04-F11)
    - 29자세·꺾임 128단계 겹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
2026-11-03 구동 N04: v1.0.15 결과 문서(BOM·설계검토서·결정로그 N04-R·디테일·요구서 N04 해결·자료대기 D-90·손계산)
2026-11-03 구동 DC-01: 이미 해결 확인
2026-11-03 v1.0.16 회귀 수정: 안쪽 끝 막대 멈춤을 판 −830 면 이로 바꿈, 루트 홈 피처 끔
    - 원인: 판·목 홈 Box252·253이 루트 피처라 자세마다 자리가 바뀌어 REST 밖에서 막대 끝이 판·목과 겹침, 막대 끝 −829가 J_U4_X 800에서 LOWER·꼬리판과 겹침
    - NP·PN 막대 +X 끝 −830.5, PN 러그 X −832.5~−830.5, PIN_3/4 X 1폭, 판 멈춤 이 2(컴포넌트 안 피처)
    - 회귀 문제 자세 14개 겹침 0, J 800 막대-LOWER 0.5, CLI 재확인
2026-11-03 구동 전체 회귀 수정: v1.0.16 BOM·설계검토서·결정로그 RF-04~07, 다시 돌린 회귀 본 범위 새 겹침 0
2026-11-03 회고: mech_2026-11-03_N01-DC-05-DC-04-N02-DC-02-DC-06-N03-DC-03-N04-DC-01 최종 보고서와 개선후보 WF-174·175
2026-11-03 실행 기록: mech_2026-11-03_N01-DC-05-DC-04-N02-DC-02-DC-06-N03-DC-03-N04-DC-01
2026-11-03 v1.0.17 구동 DC-07: X 블록 간격 190, 레일 A 한 몸 턱 + M5 멈춤나사 ×6
    - X 블록 4개 중심 −935·−865 → −1000·−810, CB5-20_N03XB ×8 → X −993.5·−816.5(카운터보어 피처 자리 고침)
    - U4_X_BEAM 밑면 레일 A 블록 자리마다 안쪽 기준 턱·바깥 누름 턱(Z −365~−352), M5 탭 6
    - 새 구매품 STEP대기_MSSF5-10_1~6(멈춤나사, 자료대기 D-91)
    - 과제 범위 J_U4_X −200~1217.5 25 mm 58자세 겹침 0, 결정로그 DC-07-M01~M04
    - 함께 넣음: DC-07 측정·구상·선정 보고서, 앞 단계 문서 변경
2026-11-03 구동 DC-07: v1.0.17 BOM·설계검토서·결정로그 결과, 요구서 DC-07 해결, 손계산·검도 보고서
2026-11-03 v1.0.18 구동 DC-08: 송풍 입구를 베어 축 (−1185, 1143)으로, 플랜지 니플 한 몸
    - P_N04_INLET: 끼움 턱 Ø46×1 + 플랜지 Ø70×5 + 니플 Ø38×40 C1, 관통 Ø34 한 덩어리 회전체(PA12 출력, 24,444 mm³)
    - P_N04_PANEL: 밑 표피 Ø46 구멍 피처 중심만 (−1023, 1040) → (−1185, 1143), 부피 변화 0
    - 호스·밴드 형번 미정이라 바디 없음(N04-S07, D-89). 호스 R150, X 거리 155/153/195
    - 과제 범위 J_U4_X −200~1217.5 25 mm 58자세 INLET·PANEL 겹침 0, 결정로그 DC-08-M01~M03
    - 함께 넣음: DC-08 측정·구상·선정 보고서, 앞 단계 문서 변경
2026-11-03 v2.0 시작 준비: 요구서 0-8 v2 확립(R375X 사진 그대로 — 볼 테이블·서보 바퀴 2개·매단 헤드), v1.0.x를 archive_v1로 동결, 과제 M00~M08, 결정로그 C-25~C-30, 자료대기 D-92~D-103, 실행 규칙 20
2026-11-03 v2.0 시작 준비(이어서): 앞 커밋에 빠진 문서 변경 — 요구서 0-8 v2·5절 M00~M08·4-1·7절, 결정로그 C-25~C-30, 자료대기 D-10·D-92~D-103, 실행 규칙 20, config doc v2.0.0, 실행 인자, HANDOFF·README·CHANGELOG, archive_v1 README·v1 과제 목록, v2.0 개념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
2026-11-03 v2.0.0 준비부: 빈 설계 골격 — 고정부·조인트 16·바퀴 2·매트 모형 3장·가공 뒤 형상, 동작 연구 REST·CYCLE_L/S/G1/G2, machine.json, 자료대기 D-104~D-106
2026-11-03 v2.0.1 M00 전체 골격: 유닛 차지 공간 상자 32개(U1~U8)·J_U5_X 0~1380
    - FSAP_v2.0.1.sc: 보·기둥·바닥틀, 볼 테이블(윗면 Z 0), 윗헤드·아랫유닛·노루발·바늘, 바늘 옆 바퀴 자리·원판 Ø250, 먼 쪽 대차 레일·체인·대차·승강, 슈·센서, 바인더·테이프 길·롤, 공압·안전 자리. 새 컴포넌트 0(E-05 마지막 자리 +1)
    - J_U5_X 한계 0~1500 → 0~1380(d2 420~1800, M00-D05). 과제 범위 간섭 0
    - machine.json·config doc v2.0.1, 생성기 gen_v2_m00.py, 설계검토서 FSAP_v2.0.1_review.md(M00-Q1~Q3)
    - 결정로그 M00-D01~D10·M00-M01~M03, 자료대기 D-105 고침·D-107, 보고서 mech_M00_measure·design·model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
2026-11-03 구동 M00: 전체 골격 결과 문서 — BOM 머리줄·설계검토서 변경 표·결정로그 결과·디테일 M00-X6·요구서 M00 해결
2026-11-03 M00 라운드 최종 보고, 요구서 5절 구동 후보 DC2-01~06
2026-11-03 회고: mech_2026-11-03_M00 개선후보 WF-176·177 추가, WF-170·172 반복
2026-11-03 실행 기록: mech_2026-11-03_M00
2026-11-03 v2.0.2 M01 U3 헤드 개조 + 좁은 홈 묶음: 867 임시 형상(UPPER·NOSE·LOWER)·노루발 P_M01_FOOT·매달기 P_M01_HANGER(SUS304 t8)·CB5-16 ×10·바인더·슈 모양 고침
    과제 범위 간섭 0(홈 매트 G1 17자세 + G2 574, 노루발×바늘 9자세). 앞 부서 보고서·결정로그·자료대기 변경 함께.
2026-11-03 구동 M01: 결과 문서 — BOM v2.0.2(노루발·매달기·CB5-16 ×10·867·서보 STEP대기), 설계검토서, 결정로그 결과·디테일 6, 요구서 M01·DC2-01 해결, 자료대기 D-109·D-110
2026-11-03 구동 동시 과제 : 합친 과제 없음, DC2-03 다음 라운드 직렬로 기록
2026-11-03 v2.1.0 M02 U4 바늘 옆 바퀴: 핀 스윙 레버·CM2 실린더 닫힌 고리·서보 바퀴·자유 원판
    - U4 차지 상자 6개를 지우고 가공품 13바디(BASE·CYLBRKT·옆판·앞판·막대·바퀴·센서 브래킷·원판 묶음), 임시 형상 서보·감속기, 실물 STEP CDM2C20-25Z·I-020B·6004ZZ·E32-D36P1·볼트 27
    - J_U4_PRESS 회전(-1.867~8.626°) + 실린더 고리, J_U4_DISK, 동작 연구 접촉 추종 키(0.306·0.611)
    - 매트 3장 4연구 전 단계 U4 충돌 0, 다시 실행 일치, 서명 sigpatch
    - 앞 부서 M02 설계·측정·감사 보고서와 DC2-03 생성기, 받은 구매품 STEP 함께
2026-11-03 구동 M02: 결과 문서 — BOM·설계검토서 v2.1.0, 결정로그 결과·디테일 11, 요구서 M02 해결, 자료대기 D-112·D-113, 검도·해석 보고서
2026-11-03 v2.1.1 DC2-06 바늘 옆 바퀴 ↔ 머리판 탈착 길: 정비 상태 MAINT_HEAD
    - 형상·부품·볼트·조인트 변경 없음. 동작 연구 MAINT_HEAD(step 1 = J_U4_PRESS -1.867 실린더 전진 끝)와 machine.json 상태 "정비: 머리판 탈착"을 더함
    - step 1에서 U4 가동 17바디 대 전체 겹침 0, 머리판 통로 X -140~-80 · Y ±90 · Z 125~560 겹침 0(트레드 틈 1.14), 바퀴 밑 Z 3.11, d1 100 유지
    - 저장본 105바디가 v2.1.0과 bbox·부피 같음, 서명 sigpatch(바뀜 0)
    - 앞 부서 DC2-06 설계·측정·완료 확인 보고서와 결정로그 설계안 함께
2026-11-03 구동 DC2-06: 결과 문서 — BOM·설계검토서 v2.1.1, 결정로그 결과·디테일 2, 요구서 DC2-06 해결, 자료대기 D-10
2026-11-03 v2.1.2 M03 U5 먼 쪽 바퀴 대차: LM 레일·벨트 서보 대차·MGP 승강·서보 바퀴·케이블 체인
    - U5 차지 상자 6개 삭제, 가공품 14·임시 형상 14·실물 STEP 구매품(레일·풀리·체인·센서·인서트·볼트 38)
    - J_U5_LIFT −10~30, 연구 CYCLE_L·G1·G2 테이프 위 1.0 구간
    - 과제 범위 간섭 0, 4연구 U5 ↔ 매트·테이프 clear
2026-11-03 구동 M03: 결과 문서 — BOM·설계검토서 v2.1.2, 결정로그 결과·디테일 7, 요구서 M03 해결, 자료대기 D-114·D-115
2026-11-03 v2.1.3 M04 U2 볼 테이블: 센터판·타공 패널 6·HFS8-4080 틀·마감캡·브래킷·T너트·레벨러 (볼 바디 미포함, 예외 요청)
2026-11-03 v2.1.4 M04 수정 1회차: 볼 트랜스퍼 2,624 occurrence(먼 쪽 바퀴 줄 고하중 28)·센터판 Y ±315 CB8-20 ×8 체결
2026-11-03 v2.1.5 M04 수정 2회차: T너트 316 홈 겉면 쪽 3.0(침목 너트 90° 돌림)·센터판 볼트 CB8-20 → CB8-15
2026-11-03 구동 M04: 결과 문서 — BOM·설계검토서 v2.1.5, 결정로그 결과·디테일 6, 요구서 M04 해결, 자료대기 D-116~D-119
2026-11-04 v2.2.0 합치기: DC2-05 먼 쪽 바퀴 받침(띠·누름판·CB5-12 ×8) + M05 U7 테이프 툴 카세트
    - 두 과제 기록을 v2.1.5에 차례로 다시 실행, 바뀐 바디 이름·부피·bbox가 후보와 일치
    - 발자국 경계 간섭 0, 측정 표 sigpatch(바뀜 88·없어짐 30)
    - 과제 보고서·손계산·생성기 함께
2026-11-04 구동 동시 과제 DC2-05, M05: v2.2.0 결과 문서 — BOM·설계검토서, 결정로그 결과·합치기 절, 요구서 해결, 자료대기 D-97 갱신·D-120~D-122
2026-11-04 v2.3.0 M06: U6 슈·가장자리 센서(J_U6_SHIFT 비킴 실린더 CJ2B16-60SZ) + U7 롤 걸이·안내 롤러·테이프 길
    - 새 컴포넌트 U6_SHOE·U7_ROLL_MOUNT, 차지 상자 U6_SHOE_SENSOR·U7_ROLL·U7_PATH_H 지움
    - 연구 8개 J_U6_SHIFT 키, machine.json(M05 조인트·연구 들임)
    - 과제 범위 겹침 0, 센서 시야 직선·모서리 뒤·홈 입구·홈 바닥 뒤 가장자리 잡음
    - 생성기 tools/gen_v2_m06.py, 보고서 mech_M06_model.md
2026-11-04 구동 M06: v2.3.0 결과 문서 — BOM·설계검토서, 결정로그 M06 결과·디테일 M06-D1~D4, 요구서 M06 해결, 자료대기 D-126(CB3-10)
2026-11-04 v2.3.1 DC2-04: 매트 두께 높이 사슬(두께 6~16, h = 두께 − 10)
    - P_M06_BASE·P_M05_HOLDER 볼트 구멍 → 세로 장공, 새 손 조정 조인트 J_U6_HGT·J_U7_HGT(+Z −4~6, 값 0)
    - 장공 볼트 CB5-12 ×4 U3_HEAD로, J_U3_PRESSER 하한 −4, 바늘 +6·J_U3_NEEDLE −36~0
    - machine.json THICK_6·THICK_16 상태·U4 높이 식 키 표·기준선 정리(M00-X6)
    - 과제 범위 겹침 0, 두께 6·16 띠에서 두 바퀴·노루발 접촉, 슈 0.5·바인더 1.0
    - 생성기 tools/gen_v2_dc204.py, 보고서 mech_DC2-04_design/measure/donecheck/model.md
2026-11-04 v2.3.2 DC2-04 수정 1: U7 걸이 장공 미는 볼트 M4 x2·받침 블록·M5 와셔
    - P_M05_HOLDER 날개 A 장공 Z 미끄럼(손 오조작 짝힘 SF 1.18) 고침: 받침 블록 P_DC204_PUSH_BLK(SUS304, UPPER -Y 면 CB5-12 x2) + 미는 볼트 M4x25 x2·잠금 너트
    - 장공 볼트 CB5-12_M05_11·12 밑 평 와셔 M5 SUS t1
    - 자료대기 D-127(멈춤나사·너트·와셔 STEP 대기), 결정로그 DC2-04-F1, 검증·해석 보고서
2026-11-04 구동 DC2-04: v2.3.2 결과 문서 — BOM·설계검토서, 결정로그 결과·디테일 DC2-04-T1~T6, 요구서 해결, 해석 2회차 손계산
2026-11-04 v2.3.3 M07: U1 프레임 + 보 — STKR400 400x200x8 각관 보, HFS8 기둥, 받침 L·뒤 이음판, HFS8-4080 받침틀
    - U1_BEAM -> P_M07_BEAM(각관 R12/R4, 기존 탭 그대로, 새 M5 탭 16·공구 구멍 4)
    - 차지 상자 U1_COL_NX·PX·U1_BASE 지움, 기둥 STEP대기 80160 + 4080, 받침틀 21개·브래킷 55·풋 15·캡 10
    - 과제 범위 겹침 0, 새 조인트 0. 자료대기 D-128. 생성기 tools/gen_v2_m07.py
2026-11-04 v2.3.4 M07 수정 1: 보를 기둥 위에 얹음(L3610·끝판), 기둥 L1090, T너트 볼트 CB5-20/16
    - 보 P_M07_BEAM X -2380~1230, 끝 80이 기둥 윗면 Z 250에 얹힘(양의 받침), 끝판 t8 x2, 270.46 kg
    - 기둥 80160(STEP대기)·4080 L1482 -> L1090(Z -840~250), 기둥 위 캡 4 지움
    - 뒤 이음판 L꼴 t6로 다시 그림(4080 쪽 구멍 Z 175·220)
    - 받침 세로 다리 CB5-12 x12 -> CB5-20(물림 8.5), 이음판 CB5-12 x8 -> CB5-16(물림 7.5)
    - 과제 범위 겹침 0, 빼는 길 겹침 0, floating 0. 손계산 fea/results/mech_M07_fix1_handcalc.json
    - 받침틀 HBLFSN8 볼트는 M07-E01대로 구동 후보 M07-K1
    - 앞 부서 문서(M07 검증·해석 보고서, 손계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
2026-11-04 구동 M07: v2.3.4 결과 문서 — BOM·설계검토서, 결정로그 결과·디테일, 요구서 M07 해결, D-128 갱신, 해석 2회차 손계산
2026-11-04 v2.4.0 M04R: U2 볼 테이블 사진대로 — 볼 827(피치 100), 사각 센터판 뺌, 가로대 HFS8-4080-560 x3
    - 볼 STEP대기_BALL_D25_M04 2,596 -> 827(반 칸 격자, D-96 임시), 매트 모형 9바디 기본 숨김
    - 패널 6장 다시: E2 X -410~975(원판 구멍 r130·아랫유닛 구멍), W2 끝 -410·띠 보스 구멍 8
    - 받침: CM1·CM_A·CM_B + HBLFSN8 x6 + CB8-16 x12(실물 STEP) + T너트, 받침판 2, DISK_BASE CB5-20 x4
    - 지움: P_M04_INSERT, CB8-15 x8, PZ 너트 8, 판 끝 접시 12, CB5-16_M02_15~18, 캡 2, D25H 잔재 1
    - 과제 범위 겹침 0(REST, J_U4_PRESS -1.867·0, J_U5_X 1380 LIFT -10), 손계산 볼 SF 2.0(정격 200 N 임시)
    - 앞 부서 문서(M04R 측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
2026-11-04 구동 M04R: v2.4.0 결과 문서 — BOM·설계검토서, 결정로그 결과·디테일, 요구서 M04R 해결, D-117·D-118 갱신, 해석 손계산
2026-11-04 v2.5.0 M08: U8 공압·안전 자리 — 레귤레이터 IR1000 ×3, 밸브 SS5Y3 6스테이션, 라이트 커튼 2쌍·기둥, 경광등, HMI 팔, 관 17줄
    - 차지 상자 U8_REG·LC_L·LC_R·LAMP·HMI 지움, 새 컴포넌트 53(가운데 자리, E-05)
    - 구매품 실물 STEP: KQ2L06-M5A ×11, HFS8-4080-1900(2370 늘임 포함) ×3, HFC8-4080-B ×6, HFS8-4080-580(570), CB5-12/16, HNTT8-5
    - STEP대기 임시 형상: IR1000-01BG, KQ2L08-01AS, SS5Y3-20-06, SY3120-5LZD-M5, F3SG-4RA1520-14, LR6-302WJBW-RYG, KDM10-06, CB4-20
    - 관은 3D 스케치 + pipe(굽힘 호). 4자세 과제 범위 새 겹침은 나사 물림·관 끝 끼움뿐
    - 보고서 docs/reports/mechanism/mech_M08_model.md, 생성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
2026-11-04 v2.5.1 M08 수정 1: 미완 6건 — U4·U5 포트 이음 KQ2L06-01AS·관 끝, 카세트 관 U7C 6줄, 커튼 기본 금구, 경광등·커넥터 볼트·관 빗, 판금 10개 sheet.convert
2026-11-04 v2.5.2 M08 수정 2: 움직인 자세 측정 — U4 누름 4점·U7 작동 4점·카세트 뺌 6점 새 겹침 0(형상 변경 없음)
2026-11-04 구동 M08: v2.5.2 결과 문서 — BOM·설계검토서, 결정로그 결과·디테일 M08-X1~X7, 요구서 M08 해결, 자료대기 D-132~D-141
2026-11-05 v2.5.3 M07-K1: 받침틀 브래킷 HBLFSN8 149 → 판금 L SUS304 t6 + CB5-16·HNTT8-5(렌치 길)
    - M07 55·M04 88·M04R 6 브래킷을 판금 L(S 45×45 30/30, T 75×45 60/30, C 45×45 20/30)로 교체
    - CB5-12 110·CB8-16 188 → CB5-16 298, HNTT8-5 110·HNTT8-8 188 → HNTT8-5 298(실물 STEP)
    - 저장본 검사: 새 바디 겹침 0, 빼는 길 프로브 298 겹침 0, floating 0, 물림 7.5 = 1.5d, 손계산 SF ≥ 2.31
    - 레일 다리 위 홈은 볼 몸통이 렌치 길을 막아 아래 홈(Z -72)으로. M-04 구멍-굽힘(C형 80) 예외 요청
2026-11-05 구동 M07-K1: v2.5.3 결과 문서 — BOM·설계검토서, 결정로그 결과·디테일 M07K-D1~D5, 요구서 M07 행, 자료대기 D-54·D-116
2026-11-05 v2.5.4 DC2-03: 아랫유닛 북 교체 길 — LOWER 북 문 자리, 받이 판 SUS304 t1.5 + CB5-12, 포켓 바닥틀 비움(앞 레일 2토막·가로대 730·L브래킷 7)
    - STEP대기_867-392342_LOWER 북 문 자리 X ±15·Y −60~−10·Z −41~−12(임시 D-10)
    - P_DC203_TRAY X −38~378·Y −276~−40(떨어뜨림 길 D1 겹침으로 +Y −64 → −40) + CB5-12·HNTT8-5 ×2
    - 앞 레일 HFS8-4080-3450_M07:1 → 2680 + 165 + 끝캡 2, :7·:8 → 1740 ×2, 새 가로대 730, S형 L브래킷 7 + CB5-16·HNTT8-5 각 14
    - 저장본 확인: 프로브 11 + 렌치 길 14 + 새 바디 48 ↔ 이웃 234 겹침 0, floating 0
2026-11-05 v2.5.5 DC2-03 수정 1: 북 받이 판 -X 끝 받침 — HFS8-4080-300(아래 레일 :3 위) + LBRKT 2 + 끝캡 2, 받이 판 CB5-12 ×2 추가(외팔 378 → 양끝 받침)
    검증 동작 문제(손 100 N SF 1.10) 고침. 과제 범위 실물 겹침 0. 앞 단계 검증·해석 문서 함께.
2026-11-05 구동 DC2-03: v2.5.5 결과 문서 — BOM·설계검토서, 결정로그 결과·디테일 DC203-D1~D6, 요구서 DC2-03 해결, 자료대기 D-82·D-108
2026-11-05 회고: mech_2026-11-04_M04R-M08-M07-K1-DC2-03-STEPWAIT 최종 보고서와 워크플로우 개선 후보 WF-178
2026-11-05 실행 기록: mech_2026-11-04_M04R-M08-M07-K1-DC2-03-STEPWAIT
2026-11-05 v2.5.6 STEPSWAP: STEP대기 16형번 실물 STEP 교체
    풀리 N16·6200ZZ·벨트 HTBO-S5M150-792·MGPM25-40Z(가운데 +20, 대차판·승강판 구멍 다시)·CB6-20·SFB5-10 ×102·MSTH6-20·CB3-10·기둥 HFS8-80160-1090·KQ2L08·SS5Y3·SY3120·LR6·CB4-20.
    공압 피팅·관 17줄 실물 포트에 맞춰 다시. 새 STEP대기 CB6-16 ×2·CB4-25 ×4, KDM10-06 남음(구동 후보).
    BOM FSAP_v2.5.6, 결정로그 SW-R1~R7·SW-D1~D5, 자료대기 갱신, 보고서 mech_STEPSWAP_model.md.
2026-11-05 v2.5.7 STEPSWAP 수정 1: KDM10-06 실물 교체·관 12줄·벨트 가닥 자름
    - KDM10-06 실물 STEP: 소켓(U8, 받침판 P_M08_KDM_BRKT + CB3-10 ×4), 플러그(U7_CASSETTE), 짝 방향 +X = CST_X
    - U7 관 12줄 다시(TU0604_M08K_U7_1~6, _U7C_1~6)
    - 벨트 HTBO 곧은 가닥 X -2220~-390으로 자름(v2.5.6에서 X 1740까지 뻗어 보 앞 공압과 겹침)
    - 사본 125개 겹침 수치 확인, BOM v2.5.7, 결정로그 SW-R8~R10·SW-D6·D7, 자료대기 D-137
2026-11-05 구동 STEPSWAP: 17형번 STEP대기 실물 교체 해결(v2.5.7) — 설계검토서·결정로그·요구서 갱신
2026-11-05 구동 DC2-07: 이미 해결 확인
2026-11-05 v2.5.8 회귀 수정 REG-01-X1: CYCLE_G1 J_U5_LIFT 319·320단계 1 mm 띄움
    먼 쪽 바퀴 트레드가 320단계에 테이프 윗면 0.4 mm 들어가던 것을 고침. 형상 변경 없음, 318~321 겹침 0.
2026-11-05 최종 보고: 2026-11-04 구동 라운드(STEPSWAP·DC2-07·REG-01)
2026-11-05 회고: mech_2026-11-04_STEPWAIT-DC2-07-REG-01 워크플로우 개선 후보 WF-178 반복·WF-181 추가
2026-11-05 실행 기록: mech_2026-11-04_STEPWAIT-DC2-07-REG-01
2026-11-05 v2.5.9 STEPSWAP r2: CB6-16 ×2·CB4-25 ×4 미스미 실물 STEP으로 교체
    - STEP대기_CB6-16_M03_1·_2 → CB6-16_M03_LIFT:1·:2 (U5 승강판 → MGP 끝판, 같은 자리)
    - STEP대기_CB4-25_M08 ×4 → CB4-25_M08:1~4 (SS5Y3 베이스 → 보 앞벽, 같은 자리)
    - 과제 안 검사 새 겹침 0, floating 0, 저장본 다시 열기 실패 0(Remove41 정리)
    - BOM FSAP_v2.5.9_*, 자료대기 D-115·D-129, 결정로그 SW2-01, 보고서 mech_STEPSWAP_model.md
    - 함께: 앞 부서 보고서·purchased-step(CB4-25·CB6-16·F3SG-4RA0800-14)·v2.5.8 검토서
2026-11-05 구동 STEPSWAP: r2 CB6-16·CB4-25 실물 교체 해결(v2.5.9), 디테일 2건 기록
2026-11-05 v2.6.0 M08R: 라이트 커튼 F3SG-4RA0800-14 실물 STEP, 기둥 1650·1175로 줄임
    - 임시 F3SG-4RA1520-14 ×4 → Omron F3SG-4RA0800-14 실물 STEP 2세트(앞·옆), Z −45~818
    - 기둥 HFS8-4080 2370 → 1650(FL), 1900 → 1175(FR·R), 위 캡 내림
    - 위 금구·LC2F 판·CB5-12 ×4·HNTT8-5 ×4 Z −700, 2E 금구 볼트 → STEP대기_CB5-6
    - 금구 8 → STEP대기_F39-LSGF(이름·형번), 금구 4 컴포넌트 U8 리지드
    - 과제 안 새 겹침 0, 컴포넌트 생김·없어짐으로 가운데 자리(E-05), 중간 파일 v2.5.10
2026-11-05 구동 M08R: v2.6.0 BOM·설계검토서·결정로그 결과·요구서 M08R 해결
2026-11-05 v2.6.1 DC2-08: KDM10 소켓 받침을 U7_FIXED로 옮겨 J_U7_HGT 따라가게
    - P_M08_KDM_BRKT 새 형상(앞판+기둥+발, A5052), P_M05_HOLDER 날개 C M5 탭 2
    - CB5-12_M08_NZ_KDM x2 지움, CB5-12_M08_PZ_KDM x2(미스미 STEP) 새로
    - 소켓·CB3-10 x4·받침·새 볼트를 U7_FIXED 리지드로, machine.json 소속 갱신
    - HGT -4/0/+6 x CST_X 0/25 짝 축 차 0, 과제 범위 겹침 0
2026-11-05 v2.6.2 DC2-08 수정 1회차: 소켓 ↔ 밸브 쪽 관 J_U7_HGT −4·+6 CAD 실측 겹침 0
    형상 변경 없음(문서 이름·설명만). 보고서 mech_DC2-08_model1.md
2026-11-05 구동 DC2-08: KDM10 소켓·받침을 U7_FIXED로 옮겨 J_U7_HGT −4·0·+6 짝 축 어긋남 0, BOM·설계검토서 v2.6.2
2026-11-05 회고: mech_2026-11-04_STEPWAIT-M08R-DC2-08 워크플로우 개선 후보 WF-182
2026-11-05 실행 기록: mech_2026-11-04_STEPWAIT-M08R-DC2-08
2026-11-05 v2.6.3 REG-01: 동작 연구에 U7 조인트 키(대기값 0)를 넣어 연구 전환 때 U7 상태 넘어옴 0, 회귀 CYCLE_L 282단계 겹침 0
    형상·조인트 정의 변경 없음. 못 본 범위는 보고서 mech_REG-01_model.md 6절.
2026-11-05 구동 REG-01: 연구 U7 키로 넘어옴 0, CYCLE_L 593단계 겹침 0, 못 본 범위는 다음 회귀로(BOM·설계검토서 v2.6.3)
2026-11-05 회고: mech_2026-11-04_STEPWAIT-REG-01 워크플로우 개선 후보 WF-183
2026-11-05 실행 기록: mech_2026-11-04_STEPWAIT-REG-01
2026-11-05 v2.6.4 STEPSWAP r3: STEP대기 CB5-6 ×2를 미스미 실물 STEP으로 교체
    2E 금구 볼트 STEP대기_CB5-6_M08_PY_LC2F:1·:2 → CB5-6_M08_PY_LC2F(같은 자리·bbox, U8 리지드).
    조인트·행정 변화 없음. 과제 안 새 겹침 0(나사 물림 unchecked 2는 M-08 의도).
    BOM v2.6.4, 자료대기 D-135, 보고서 mech_STEPSWAP_model.md. 앞 실행의 문서 변경 함께.
2026-11-05 구동 STEPSWAP: r3 CB5-6 ×2 실물 교체 문서 정리(설계검토서 v2.6.4·결정로그·요구서 5절 해결)
2026-11-06 최종 보고: STEPSWAP r3·REG-01 라운드(v2.6.4, 본 범위 겹침 0, 못 본 범위 다음 회귀로)
2026-11-06 회고: mech_2026-11-04_STEPWAIT-REG-01 워크플로우 개선 후보 WF-184, WF-178 반복
2026-11-06 최종 보고: STEP 대기 재시도·REG-01 회귀 3차(v2.6.4, 본 범위 겹침 0, 못 본 범위 다음 회귀로)
2026-11-06 회고: mech_2026-11-04_STEPWAIT-REG-01 워크플로우 개선 후보 WF-185, WF-186 추가
2026-11-06 전체 최종 보고: 구동 라운드 1~6 (미완, REG-01·STEPWAIT 진전 없음, 미스미 로그인 풀림)
2026-11-06 v2.6.5 LITE: 보·띠 피처 이력 바꿔 열기 242 s → 100 s
    - P_M07_BEAM: Box16 제 길이·폭, 구멍 묶음 앞으로, 외곽 깎기·끝 늘이기 지우고 R12 fillet, 속 IN X -2381·3612
    - P_DC205_STRIP: Hole1~8 → 스케치 cut 한 번 + cosmetic 나사 M5 x8
    - 형상·BOM(125행/2,457)·바디 2,649 자리 같음, 과제 범위 새 겹침 0
    - 앱 문서 dirty라 CLI run --save. 생성기 gen_v2_m07·fix1·gen_dc2_05 고침
    - 보고서 docs/reports/mechanism/mech_LITE_model.md
2026-11-06 구동 LITE: v2.6.5 문서 정리(BOM·설계검토서·결정로그·과제 해결, 열기 242 → 약 100 s)
2026-11-06 최종 보고: 구동 라운드 LITE·STEPWAIT·REG-01 (미완, POSE 8 사용자 결정 대기, REG-02 추가)
2026-11-06 회고: mech_2026-11-06_LITE-STEPWAIT-REG-01 워크플로우 개선 후보 WF-197~200 추가, WF-186 반복
2026-11-06 실행 기록: mech_2026-11-06_LITE-STEPWAIT-REG-01
2026-11-06 최종 보고: 구동 라운드 REG-01 (미완, F_STATES 못 본 범위·REG-02 사용자 결정 대기)
2026-11-06 회고: mech_2026-11-06_REG-01 개선 후보 WF-201~203 추가, WF-197·WF-178 반복
2026-11-06 실행 기록: mech_2026-11-06_REG-01
2026-11-06 최종 보고: 구동 라운드 REG-01 v3.9.3 재시작 (미완, 못 본 범위 남음)
2026-11-06 회고: mech_2026-11-06_REG-01 재시작 개선 후보 WF-204 추가, WF-201~203 반복
2026-11-06 최종 보고: 구동 라운드 REG-01 v3.9.3 (미완, 못 본 범위 남음)
2026-11-06 회고: mech_2026-11-06_REG-01 WF-201·203·204 반복
2026-11-06 최종 보고: 전체 2026-11-06 (미완, REG-01 진전 없음)
2026-11-08 REG-02 모델: U6·U7 높이 조정 하나로 묶기 (v2.6.6)
    - J_U6_HGT 지움, U6_SENSOR를 U7_FIXED에 리지드(J_U6_ON_U7FIX) — 조정은 J_U7_HGT 하나(-4~+6)
    - 공통 높이 판 P_REG02_HGT_PLATE(SUS304 t5) + 압입 스터드·너트 x4(STEP대기, D-142)
    - 장공 볼트 CB5-12 x4 -> CB5-16_REG02_1~4(실물 STEP), 오류 피처 Move15·16 지움
    - 회귀 자세 183 -> 181점(옛 POSE 8·9 뺌, tools/gen_v2_poses.py), machine.json 갱신
    - 과제 범위 겹침 0, KDM10 짝 축 0. 미완: GUIDE-CARR 틈 2.0 < 10 (예외 요청)
2026-11-08 REG-02 수정 1회차: 장공 볼트 CB5-20·4번 볼트 X 33 (v2.6.7)
    - 장공 볼트 CB5-16_REG02_1~4 -> CB5-20_REG02_1~4 + 와셔 M5 같은 쌓임(UPPER 물림 10, 조임 암나사 전단 SF 1.15 -> 1.92), UPPER 탭 3·4 깊이 12
    - 4번 볼트 자리 X 36 -> 33(판·날개 A 장공, 탭, 와셔): 렌치 길이 카세트 핀에서 0.75 비킴
    - 과제 범위 J_U7_HGT -4~+6 다섯 점 겹침 0, 렌치 프로브 0. 조인트·행정 그대로
    - REG-02 검도·해석 보고서, 결정로그 REG02-E01~E03·F01 함께
2026-11-08 구동 REG-02: U6·U7 높이 조정 하나로 묶기 결과 문서(v2.6.7 BOM·설계검토서·결정로그)
2026-11-08 최종 보고: 구동 2026-11-08 (REG-02 완료, REG-01 확인, 회귀 못 본 범위 남음)
2026-11-08 회고: mech_2026-11-08_STEPWAIT-REG-02-REG-01 개선 후보 추가 3·반복 4
2026-11-08 실행 기록: mech_2026-11-08_STEPWAIT-REG-02-REG-01
2026-11-08 구동 RGSEE: 이미 해결 확인
2026-11-08 최종 보고: 구동 2026-11-08 RGSEE (이미 해결 확인, 전체 회귀 미실행)
2026-11-08 회고: mech_2026-11-08_RGSEE 개선 후보 추가 1·반복 1
2026-11-08 실행 기록: mech_2026-11-08_RGSEE
2026-11-08 STEPSWAP r4 v2.6.8: IR1000-01BG 레귤레이터 실물 STEP 교체
    - STEP대기_IR1000-01BG_M08_N/F/S(+_BRKT) -> SMC 실물 IR1000-01BG_M08:1~3
    - 포트 Z 511 -> 482(손잡이 윗면 Z 565 유지), 브래킷 뒷면 = 보 앞면 Y 120
    - 브래킷 볼트 CB5-12 x6 -> CB4-12 x6(열쇠 구멍 M4), 이음 KQ2L08 x6·관 TU0805 6줄 다시
    - 과제 안 새 겹침 0, 조인트·행정 변화 없음. BOM v2.6.8, 자료대기 D-132 해결
2026-11-08 구동 STEPSWAP: IR1000-01BG 실물 교체 문서(설계검토서 v2.6.8·결정로그·요구서 행)
2026-11-08 최종 보고: 구동 2026-11-08 STEPWAIT (v2.6.8, 회귀 14 부분, 미스미 로그인 됨)
2026-11-08 회고: mech_2026-11-08_STEPWAIT 개선 후보 반복 1(WF-178)
2026-11-08 실행 기록: mech_2026-11-08_STEPWAIT
2026-11-08 구동 MOT-01 v2.7.0: 서보·감속기 C-36 실물 교체(HG-KR23 ×3·HG-KR43·PGX62-H-10 ×3)와 체결
    - STEP대기_MHMF022L1U2M·VRXF-PB-60-10 6바디 → 실물 STEP, U3 아랫축 묶음(HG-KR43 + P_U3_LDRV_BRKT + STEP대기_SCXW46-14-15)
    - 체결 CB5-16 ×32·CB5-12 ×4·CB4-12 ×4·SFB5-12·HNTT8-5 ×4·MPFZ12-10 ×2, 핀·와셔 가공품 11, 옛 CB5-20 ×12 지움
    - 앞판 Ø50 H8 관통·M5 탭, 옆판 홈, 허브 키홈, 옆면 볼트 Z ±19(MT-03), 루트 특징을 컴포넌트로 옮김(MT-07)
    - BOM v2.7.0, 결정로그 MT-01~07, 보고서 mech_MOT-01_model.md
2026-11-08 구동 MOT-01: 검도·해석 결과와 설계검토서 v2.7.0, 요구서 MOT-01 일부(디테일 2)
2026-11-09 구동 FUNC-01 v2.8.0: U5 플로트(LHFR16·PSFJ16-150·받침 스프링, J_U5_FLOAT), 접는 바인더 P_M05_BINDER, 바늘판 홈, IR1000 F 묶음 지움
2026-11-09 구동 FUNC-01 수정 1회차 v2.8.1: U5 플로트 옆판 N·P 축 여유 구멍 Ø16.5 Z 115~130(축↔웹 겹침 해소), 검도·해석 보고서
2026-11-09 구동 FUNC-01: 기능 ①~⑦ 성립(불성립 0), BOM·설계검토서 v2.8.1, 결정로그 결과·디테일 F01-D1~D8, 자료대기 D-147~D-149
2026-11-09 구동 COLOR-01 v2.8.2: 모델 색 통일(색표 13칸, 체결 #b4b9bf 흑색 0, 형상 변화 0), 설계·측정·모델링 보고서
2026-11-09 구동 COLOR-01: 색표 적용 해결(색표 밖 0, 체결 흑색 0, 형상 변화 0), BOM·설계검토서 v2.8.2, 결정로그 결과·디테일 COLOR-D1
2026-11-09 최종 보고: 구동 라운드 MOT-01·FUNC-01·COLOR-01 (v2.8.2, 회귀 못 본 범위·REG-02 C-34 다음 할 일)
2026-11-09 회고: mech_2026-11-08_MOT-01-FUNC-01-COLOR-01 개선후보 WF-209 추가, WF-172·175·176 반복
2026-11-09 실행 기록: mech_2026-11-08_MOT-01-FUNC-01-COLOR-01
2026-11-09 최종 보고: STEPWAIT·REG-01 (v2.8.2, 회귀 16 본 범위 13점, 새 겹침 0)
2026-11-09 회고: mech_2026-11-08_STEPWAIT 개선후보 WF-210 추가
2026-11-09 최종 보고: STEPWAIT·REG-01 재실행 (v2.8.2, 회귀 17 본 범위 184점, 새 겹침 0, 미스미 로그인 풀림)
2026-11-09 회고: mech_2026-11-08_STEPWAIT 개선후보 WF-210 반복 2
2026-11-09 최종 보고: STEPWAIT·REG-02·REG-01 (v2.8.2, 새 겹침 0, 미스미 로그인 확인 못 함)
2026-11-09 회고: mech_2026-11-08_STEPWAIT 개선후보 WF-211 신규, WF-210·WF-203 반복
2026-11-09 최종 보고: 2026-11-08 전체 실행 (미완 — STEPWAIT 진전 없음, 미스미 로그인 풀림)
2026-11-09 F01-C1 v2.8.3: 작업 대상 모형 땀–가장자리 거리 e 0 → 6.5
    - J_WP_L/S/G_X a 원점 +6.5 X → 매트·테이프·이음매 모형 사슬 전체 +6.5 X(REST 가장자리 X 6.5, 중심 −743.5/−143.5/−593.5)
    - CYCLE_L·S·G1·G2 J_WP_k_X·Y 피벗 단계 키 갱신(최대 6.5, 단계 수·다른 키 그대로), SEAM_U7 그대로
    - 19자세 과제 범위 검사 새 겹침 0(바늘 기준선만 MAT 20.1·TAPE 22.1·SEAM 1.01 mm³)
    - machine.json 원점·states·기준선, D-78 갱신, gen_v2_prep.py E_EDGE 6.5
    - 저장 전 조인트·스케치 숨김(실행 규칙 19), v2.8.2도 스케치 숨김 저장본
    - 함께: 앞 실행의 문서·보고서 변경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
2026-11-09 구동 F01-C1: 문서 — 매트 가장자리 바늘 +X 6.5, BOM·설계검토서 v2.8.3, 스케치 숨김 확인
2026-11-09 최종 보고: 2026-11-09 구동 라운드 (F01-C1 완료, VGR-01 개념 재검토 — 사용자 결정 D-154)
2026-11-09 회고: mech_2026-11-09_F01-C1-VGR-01-STEPWAIT 워크플로우 개선 후보 WF-212
2026-11-09 실행 기록: mech_2026-11-09_F01-C1-VGR-01-STEPWAIT
2026-11-09 전체 최종 보고: 2026-11-09 (구동 개념 재검토 — VGR-01, D-154)
2026-11-09 구동 VGR-01: v2.8.4 — 좁은 V홈 시험 매트 WP_V·J_WP_V_X/Y/ROT·연구 CYCLE_V
    - 새 작업 대상 모형 WP_V(MAT_V·TAPE_V·SEAM_V, D-150 V 30°·R_b 2·깊이 150), 컴포넌트 WP_V_X·WP_V_Y·WP_MAT_V·WP_TAPE_V
    - 연구 CYCLE_V 486단계(d₂ 440, U5 ROT -35 정지 들기·-30 정지 내림, U4 누름 전 구간 0), 다른 연구 8개에 J_WP_V_* 0 키
    - 30자세 과제 범위 새 겹침 0, 바늘–홈 벽 틈 최소 5.7, C-37 U4 혼자 8.0·9.0 s SF ≥ 1.028
    - machine.json·config.json·결정로그 VGR-01-M1~M4·설계검토서 v2.8.4(ⓐ~ⓔ)·BOM 복사·CHANGELOG
    - 앞 부서(설계·측정·완료 점검) 보고서·문서 변경 함께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
2026-11-09 구동 VGR-01 수정 1회차: v2.8.5 — U5 밑 띠 저항 넣은 CYCLE_V 시간 키
    - 형상 변경 없음(2,763바디 부피·bbox 차 0). 문서 설명·joints/sketches 숨김만.
    - machine.json _timing CYCLE_V: U5 밑 PTFE 띠 미끄럼 μs 0.30(D-97) 기준
    입구1 2.5→4.1 s, 꼭짓점 25° 1.2→2.0 s x4, 10° 1.0→1.3 s, 입구2 30° 1.5→2.6 s,
    입구2 U4 혼자 9.0→9.5 s(원판 끌림). 최저 SF 1.009.
    - 요구서 VGR-01·DC-01, 자료대기 D-154·D-96·D-97, 결정로그 VGR-01-M5, 설계검토서 v2.8.5.
    - 함께: VGR-01 검도·해석 보고서와 손계산(v2.8.4 대상).
2026-11-09 구동 VGR-01: 완료 판정 — C-37(다) U4 혼자 SF ≥ 1.044, CYCLE_V 간섭 0, 해결(v2.8.5)
2026-11-09 구동 PNEU-01 모델링(일부): v2.8.6 — 공압 관 26줄 접선 원호 굽힘, 이음·막음·스페이서, CST_O 빗판
    - 옛 관 25줄(직각 꺾기) 지우고 routes.json 26줄을 최소 R 16/40 원호로 다시 그림(바디 35)
    - 밸브 1·3 -Y 10 + SY30M 스페이서 STEP대기, 레귤 OUT KQ2L06-01AS 실물 STEP
    - KQ2E08·KQ2T08·KQ2H08·AN110·TPH-01·M-5P·KQ2P-06·AS2201F STEP대기, P_M08_AIR_IN_BRKT, P_M08_TUBE_BRKT_CST_O
    - 미완: U5 체인·체인 안 관, 고정품 29·볼트 62, 움직이는 축 행정 검사
2026-11-09 PNEU-01 모델링 보고서: 저장 확인 결과
2026-11-09 구동 PNEU-01 수정 1회차: v2.8.7 — 관 고정품 30·CB5-16 57, U5 체인 23링크 행정 모형·체인 안 관 2줄
    - 고정품 30개(빗·클램프·브래킷, A5052, 관 통구멍) + M5 탭, 관 26줄 자유 구간 최대 300.0
    - U5 체인 2400.05.075.0 23링크 표시 모형(슬라이더 35 + J_U5_X motion link), 체인 안 관 1,078.4·1,040.7 mm
    - 체인 고정 끝 STEP대기 관 통로, CST_O SPCC·볼트, AIR_IN_BRKT 볼트
    - BOM v2.8.7, 자료대기 D-155~D-161
2026-11-09 PNEU-01 모델링 수정 1회차 보고서
2026-11-10 구동 PNEU-01 수정 2회차: v2.8.8 — F_5·SO_1·KDM 빗을 관 곧은 구간으로, U7 B관 Z781 R20, AIR 볼트, CST_V 띠 폭 30
    검도 1회차 문제 6건. 관-고정품 겹침 0, 고정 간격 26줄 300 이하, CST_V 오조작 SF 1.53.
    보 Z262 탭 메움 실패로 SO_1은 옛 볼트 자리 + REG1_OUT 멍에(결정로그 PNEU-01-M6~M12).
2026-11-10 구동 PNEU-01: v2.8.8 결과 문서 — 일부(관–구멍 벽 겹침 2쌍 남음), 설계검토서·결정로그·자료대기 D-162
2026-11-10 구동 DC-01: v2.8.9 — CYCLE_G1 바닥 U4 혼자 20 s 확인(SF 1.057), U4+U5 피벗 1.2 s, FUNC-01 ⑥·⑦·D-96·요구서 DC-01
    형상 변경 없음(문서 설명·조인트·스케치 숨김). C-37 (다) 적용 확인, 과제 범위 5점 새 겹침 0.
2026-11-10 구동 DC-01: v2.8.9 문서 — 설계검토서·BOM 복사·결정로그 결과 절, D-96 필요 구름 0.0276/0.0215로 고쳐 적음
2026-11-10 구동 라운드 최종 보고 2026-11-10 — VGR-01·PNEU-01·DC-01, 구동 후보 DC-02·DC-03·PNEU-01R 요구서 5절
2026-11-10 회고: mech_2026-11-10_VGR-01-PNEU-01-DC-01-STEPWAIT — 개선후보 WF-213~215 신규, 6건 반복
2026-11-10 실행 기록: mech_2026-11-10_VGR-01-PNEU-01-DC-01-STEPWAIT
2026-11-10 LITE: v2.8.10 모델 무게 줄이기 — 열기 844 → 397 s, 형상 변경 0
    P_M07_BEAM 탭을 Box16 뒤 스케치 cut 3번과 끝 Combine 하나로 바꾸고,
    앞판 X 구멍 메움·다시 뚫기를 지웠다(timeline.delete 63).
    lite_check: 바디 2,969·BOM 179행/2,616·bbox 차 0.
    앱 문서가 dirty라 CLI run --save로 저장했다.
2026-11-10 구동 LITE: v2.8.10 문서 — BOM 복사·설계검토서·결정로그 결과 절, 열기 844 → 397 s
2026-11-10 구동 DC-02: L 모서리 U4+U5 7.5 s·G 4.5 s 시간 키로 U5 밑 띠 미끄럼 반영(SF 1.014·1.045), 형상 변경 없음
2026-11-10 구동 PNEU-01R: v2.8.11 공압 관 구멍 2개 r 3.25 → 3.5 — 관–빗 벽 겹침 2쌍 0
    COMB_U5_2 (-1235.5,190,661)·RISER_COMB_1 (1049.75,53) 구멍만 키움. 부피 -84.8·-42.4 mm3, 최소 거리 0.370·0.109 mm, 이웃 살 7.67·7.75. 관 경로·조인트 변화 없음.
2026-11-10 구동 PNEU-01R 수정 1회차: v2.8.12 체인 고정 끝 관 통로 r 3.25 → 3.75 — 12PZ_F ↔ 관 U5_A 겹침 0
    - STEP대기_2400.05.12PZ_F 관 통로 (Y 250, Z 661) 축 X만 Ø6.5 → Ø7.5, 부피 −87.96 mm³
    - 검도 문제 3.648 mm³ → 0, 최소 0.217 mm, 이웃 통로 살 5.0
    - 관·조인트·볼트 변화 없음, 결정로그 PNEU-01-M15
2026-11-10 구동 PNEU-01R: v2.8.12 문서 — 관–구멍 겹침 3쌍 0, BOM·설계검토서·결정로그 결과 절, 과제 해결
2026-11-10 구동 라운드 최종 보고 2026-11-10: DC-03 개념 재검토, 구동 후보 DC-04 추가
2026-11-10 회고: mech_2026-11-10_LITE-DC-03-DC-02-PNEU-01R-STEPWAIT 개선후보 WF-216 추가, WF-209 반복
2026-11-10 실행 기록: mech_2026-11-10_LITE-DC-03-DC-02-PNEU-01R-STEPWAIT
2026-11-10 전체 최종 보고 2026-11-10: 구동 개념 재검토 DC-03
2026-11-10 구동 DC-04: v2.8.13 회전 중 노루발 낮은 누름 — 연구 키 5개, 바늘 옆힘 ≤ 9.8 N, F4 ≤ 15.9 N, SF ≥ 1.009
2026-11-10 구동 라운드 최종 보고 2026-11-10 2차: DC-04·DC-03·STEPWAIT, 구동 후보 0
2026-11-10 회고: mech_2026-11-10_DC-04-DC-03-STEPWAIT 개선후보 WF-217·WF-218 추가, WF-186·WF-088·WF-204 반복
2026-11-10 실행 기록: mech_2026-11-10_DC-04-DC-03-STEPWAIT
2026-11-10 U6S 모델링: v2.9.0 U6 슈 세로 누름·들기(J_U6_PRESS)
    - 세운 CJ2B10-15Z_M06P + 판금 브래킷 P_M06_PCYL_BRKT + 턱 칼라 2, 슈 벽 Z 50·판금 윗날개·장공 7.1x17.1
    - 새 조인트 J_U6_PRESS(-5.0~+4.5, 대기 +4.5)와 연구 9개 키, machine.json
    - 관 U6P_A·_B(움직이는 쪽), 7번 밸브, STEP대기_SS5Y3-20-07_M08
    - IR1000:3 0.18 MPa -> 8.71~21.59 N, 여유율 1.344, 자국 SF 2.09, 회전 SF 1.009~1.047, 과제 범위 겹침 0
    - 미완: 고정 쪽 관·고리·U8 회로 다시 잇기
2026-11-10 구동 U6S: v2.9.0 슈 세로 누름·들기 문서 — BOM·설계검토서·결과, 일부(디테일 9)
2026-11-11 SIM-01 모델링: v2.10.0 테이프 줄·붙은 테이프 조각·연구 키
    U7_TAPE_LINE·U7_TAPE_FEED 새로, U7_TAPEWAY_H·V 지움, P_M05_GUIDE 출구 R3.
    TAPE_L·S·G·V → WP_TP_* 조각 118 + SEAM 4, J_TP_* 122, CYCLE_*·REST 키.
    전 단계 간섭(CLI) 테이프 줄·조각 ↔ U3~U6 겹침 0, 사이클 영상 10개.
2026-11-11 M02R 모델링: v2.10.2 U4 누운 실린더 + 핀 축 크랭크(C-40)
    - CDM2C20-25Z·I-020B·엘보를 모터 위에 눕힘(고정 핀 (-161.006, 225), 크랭크 핀 θ0 (-347.8, 203.6))
    - 새 P_M02R_CYLBRKT·CRANK·CRANK_PIN·CRANK_WASHER, CB5-16 x4·CB5-20 x2·CB4-12 x2, 옛 브래킷·너클 핀 묶음 지움
    - J_U4_CYL_PIN·J_U4_CYL_ROD(0 내림 끝 ~ 24.97 들림)·J_U4_ROD_PIN 다시, 고리 오차 0
    - U8: IN 엘보 KQ2L06-01AS, STEP대기_KQ2R06-08A_2, 관 U4_A1·A2·B·REG1_SUP·U4C_A·B, 클램프 F_6, L_2 구멍 r3.25
    - 40 N = 0.0768 MPa, 모터 위 최고 Z 336 -> 255, 과제 범위 3자세 겹침 0
    - 함께: v2.10.1(SIM-01 뒤 저장본), 앞 부서 문서 변경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
2026-11-11 최종 보고: 2026-11-11 3차 M02R·SIM-01·STEPWAIT (저장본 변경 없음)
2026-11-11 회고: mech_2026-11-11_M02R-SIM-01-STEPWAIT 워크플로우 개선 후보(WF-215 반복, WF-219·220 신규)
2026-11-11 실행 기록: mech_2026-11-11_M02R-SIM-01-STEPWAIT
2026-11-11 M02R 3회차 모델링: v2.10.3 보 고정 사각 실린더 + 축 X 그네 브래킷(C-41), 패킹 마찰 넣은 스프링·IR1000
    - 옛 모터 위 크랭크 U4 바디·조인트 3개 지움(빈 컴포넌트 21 남음)
    - P_M02S_SWING·CYL_BRKT·PIVOT_BRKT·SPRING_TAB, STEP대기 실린더(CDQ2YA20-25DMZ 임시, D-188)·너클·축·칼라·스프링(D-189)
    - J_U4_PRESS 축 X, J_U4S_ROD 선형 링크, 연구 키 환산, 관 U4_A2·U4_B 끝 다시
    - 회전 SF 1.013~1.079, 자국 SF 최소 1.013, IR1000 0.102 MPa
2026-11-11 구동 M02R: v2.10.3 그네 누름 문서화(일부 — 스프링 고리 겹침·빈 컴포넌트 21 남음, 다음 v2.11.0)
2026-11-11 SIM-01 2회차: v2.10.4 L 매트·테이프 보이게 저장, U4 묶음 간섭 0·영상 5연구
2026-11-11 구동 SIM-01: v2.10.4 테이프 보임·U4 묶음 간섭 0·영상 5연구로 해결, 검토서·BOM·결정로그
2026-11-12 구동 RX-06 모델링: v2.11.0 U4 X 위치 조절축(레일 2줄·볼나사·수동 손잡이), J_U4_X 0~95
    - 새 컴포넌트 U4_XAXIS·U4_XCAR·U4_DISK_BASE, 캐리지·스페이서·끝 멈춤, SSEB13·BSS2020·BSW20·BUN20, STEP대기_HANDLE_D50
    - 윗판 연장·단, 실린더 브래킷 윗날개 Z 236~242, 볼트 옮김, 관 U6·U4_A2·U4_B 다시, 클램프 L_6 -106
    - 남은 것: 옛 BASE·ARM 피처가 X 이동 때 따라오지 않음, 9점 CLI 검사 진행 중
2026-11-12 구동 RX-06 수정 1회차: v2.11.1 U4 옛 루트 피처 34개를 U4_WHEEL_N·U4_PRESS로 옮김(J_U4_X 조각 원인), 레일·축 예외는 미완 보고
2026-11-12 구동 RX-06: v2.11.1 U4 X 조절축 결과 문서화(검토서·BOM·결정로그, 레일·축 E4·E5 다음 회차)
2026-11-12 구동 RX-08 모델링: v2.12.0 U4 중간 높이 스토퍼(실린더·멈춤 블록·조절 볼트, J_U4_STOP 0~20), 매니폴드 08·8번 밸브, 관 2줄
2026-11-12 구동 RX-08 수정 1회차: v2.12.1 스토퍼 관 A·B를 U4 쪽(U4_WHEEL_N 강체, J_U4_X 따라감)·U8 쪽으로 나눔
    - 세움 X -169 Z 340에서 끊어 TU0604_M08P_RX08_A_U4·_B_U4 새 컴포넌트
    - J_U4_X 95, J_U4_PRESS 4점 x J_U4_STOP 0, 13.006·0.95 x J_U4_STOP 20 실제 구동 검사 겹침 0
    - joint.sweep 멈춤 0.932도(설계 0.95도), 0.95도에서 머리-그네 0.0147 mm
    - machine.json U4_WHEEL_N 부품, 결정로그 RX-08-M6, 보고서 mech_RX-08_model1.md
2026-11-12 구동 RX-08 수정 2회차: v2.12.2 Remove86 대상을 Chamfer2로 고쳐 남아 보이던 STEP 원본 레일 지움(클램프 L_4·L_5 겹침 해소)
2026-11-12 구동 RX-08: v2.12.2 U4 중간 높이 스토퍼 결과 문서화(BOM·설계검토서·결정로그, 디테일 4, STEP대기 D-192~194)
2026-11-12 구동 RX-07: 이미 해결 확인
    v2.13.0 측정으로 완료 판정 ①~⑤ 만족 확인(형상 변경 없음). 결정로그 RX-07-C1~C7, 요구서 5절 RX-07 행 갱신.
2026-11-12 구동 M02R: v2.14.0 U4 그네 잔재 정리 문서화(스프링 탭 볼트 s±12·빈 컴포넌트 22개 지움·팔 셸 1, BOM·설계검토서·결정로그, 판정 해결, 디테일 M02R-D5~D14)
2026-11-13 구동 RX-06R: v2.15.0 U4 X축 볼나사·손잡이 빼고 레일 + 블록 + 볼트 잠금(잠금 날·누름 판·CB5-16 ×2, d₁ 100~195 그대로, 레일 실물 STEP SSEB13-220, 24자세 겹침 0, BOM·설계검토서·결정로그, 판정 해결, 디테일 RX-06R-D1~D8)
2026-11-13 구동 RX-06-C2: v2.15.2 움직이는 컴포넌트 바디를 고치는 루트 피처를 그 컴포넌트로 옮김(U5_CAR·U7_CASSETTE·U7_FIXED·U6_SENSOR, 빈 피처 Box326·Combine41 지움, 형상 값 변화 0, 끝 자세에서 탭 구멍 따라감), 관 브래킷 볼트 CB5-16 ×2 → CB5-12(HOLDER 벽 겹침 해소), BOM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
2026-11-13 구동 RX-12: v2.16.0 시험 매트 '긴 매트 + 넓은 오목' MAT_W 1500×700(오목 500×300, 임시) + 모형용 조인트 J_WP_W_X·Y·ROT + 연구 CYCLE_W1·W2 추가(기계 부품·볼트·구매품 변경 0, 기존 연구 키 변화 0), 전 구간 간섭 0(truncated false), +X 최대 X 1052.1 · 550,0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
2026-11-13 구동 RX-11: v2.17.1 U5 먼 쪽 바퀴 밑 받침을 X축 자유 롤러 2줄로(C-45) — 띠 묶음 17바디 걷고 RORLM20-6-L200 7개 × 2줄(Ø20 × 200, Y ±11, 윗면 Z 0) + SFJ6-213 ×14 + 새들·클램프 ×8 + CB5-20_RX11 ×8, 판 W2·E2 긴 홈·가로대 통과 홈(v2.17.0), 새들 볼트 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
2026-11-13 구동 RX-10: v2.17.2 U6 슈 바닥 Y 90 → 130(C-43, 판정 일부) — P_M06_SHOE −Y 끝으로 40(Y −245~−115, X 폭 23 그대로, 닿는 면 1,506.6 → 2,266.6 mm²), 누름 실린더 CJ2B10-15Z_M06P 축 Y −152 → −166 · 포트 +Y, 브래킷·벽 볼트·인서트 자리 Y −177, 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
