hyeunung/FSAP/(notices)

Notices in the files:
purchased-step/CJ2B16-60SZ/CJ2B16-60SZ.stp:
author */ ('License CC BY-ND 4.0'),
purchased-step/ORP25/ORP25.stp:
FILE_NAME('ORP25_20261103201450317.step','2026-11-03T11:14:51',('ksdm'),('Copyright @ MISUMI Group Inc. All Rights Reserved.'),'Spatial InterOp 3D',' ',' ');
